Seongwonp/Simplelay/housing/README.md

# 키오스크 하우징 (2안 · 쐐기형 박스)

**10/23 실물 피드백:** 맞춤 시험편의 모니터 크기·두께는 맞지만 커넥터 간섭과 방향별 핀 끼움 차이가 있다. [수정·다음 출력 정리](PRINT-FEEDBACK-2026-10-23.md)를 먼저 읽는다. 새 [핀 공차 시험편 STL](stl/dowel_calibration.stl)은 기존 Ø3.8 핀으로 Ø4.0~4.4 수직·수평 구멍을 비교한다. 뒤쪽 고정은 별도 [패널 고리](stl/panel_clip.stl) 1개를 먼저 시험한다. 커넥터 간섭 위치 확인 전에는 대형 몸통 재출력을 보류한다.

15.8형 터치 패널, RPi5, DHT22 온습도 센서를 상자 하나에 넣는 3D 프린터 분할 출력용 모델이다. 구조와 근거는 2026-10-16 하우징 구조안(1안·2안 비교)을 따르고, 2026-10-18 [하우징 검토](../docs/archive/하우징-검토-2026-10-18.md)의 우선순위 1~11 중 실측 없이 할 수 있는 것을 반영했다.

- **모델:** [`simplelay_box.scad`](simplelay_box.scad). 무료 프로그램 OpenSCAD로 연다. 숫자를 바꾸면 전체가 다시 계산된다.
- **크기(1차안):** 폭 약 396 × 깊이 170 × 높이 약 260 mm. 앞면은 20° 뒤로 기울었다(10/18: 오른쪽 여유 `side_room` 8 → 16 mm라 폭이 8 mm 늘었다).
- **프린터 가정:** 220 × 220 × 250 mm. 모든 조각이 그 안에 들어간다. 가장 큰 조각은 198 × 170 × 130 mm다(렌더할 때 조각별 크기가 echo로 나온다). 메이커스페이스 프린터 기준으로는 **몸통·뒤판 8조각은 Bambu Lab A1(256³)에서만**, 작은 조각은 A1 mini(180³)에서도 뽑을 수 있다(아래 [어느 프린터로](#어느-프린터로)).
- **분할면 맞춤 핀(10/18):** 몸통 4조각과 뒤판 사이 분할면에 Ø4 구멍 + 출력 핀 Ø3.8 × 20. HW 담당이 같은 프린터로 레일 조각을 이을 때 쓴 방법이다 — [맞춤 핀](#분할면-맞춤-핀다월).

## 조각 (파일 위쪽 `part` 값을 바꿔 하나씩 렌더 F6 → STL 내보내기)

| `part` | 개수 | 내용 |
|---|---|---|
| `shell_LB`·`shell_RB`·`shell_LT`·`shell_RT` | 각 1 | 몸통 4조각(왼쪽·오른쪽 × 아래·위). 화면 창, 위판 배기 슬롯, 센서 칸, 버튼 구멍, 받침 턱·멈춤 턱·고리 받침, 뒤판 나사 받침, 이음 덧살, 분할면 맞춤 핀 구멍(덩어리)이 들어 있다. **위 조각(LT·RT)은 위판이 판에 닿게 뒤집힌 방향으로 나온다**(서포트 줄이기) |
| `back_LB`·`back_RB`·`back_LT`·`back_RT` | 각 1 | 뒤판 4조각. 몸통 뒤 테두리 안쪽에 끼운다. 아래 흡기 슬롯, 전원 입구, RPi5 고정 구멍(M2.5 — 모두 RT 조각)이 있다. **바깥면을 판에 대고 눕혀 나온다**(10/18 — LB·RB·LT 안쪽의 맞춤 핀 덩어리가 위로 선다, 높이 12.5) |
| `sensor_lid` | 1 | 센서 칸 뚜껑(뒤 가장자리 선 홈 6 × 3) |
| `panel_clip` | 4 | 패널 누름 L자 고리 — 경사면 안쪽 고리 받침(인서트)에 M3로 조인다 |
| `fit_test` | 1 | **먼저 뽑는 맞춤 시험 조각**(67 × 69 × 99, 약 1시간) — 앞판 왼쪽 아래 모서리(화면 창 모서리·받침 턱·멈춤 턱·센서 칸·플러그 여유). 실제 패널을 대 보고 확인한 뒤 큰 조각을 뽑는다 |
| `dowel_pin` | 16(+예비 4) | 분할면 맞춤 핀 Ø3.8 × 20, 양 끝 0.4 모따기. 몸통 12 + 뒤판 4 |
| `vesa_plate` | (선택) | VESA 75 × 75 누름판. `panel_hold = "vesa"`일 때만. 패널 뒤 구멍 위치·나사·상자에 잇는 방법이 실측 전이라 기본은 고리 |
| `splice` | (선택) | 옛 평판 보강판(접착). `seam = "splice"`일 때만 쓴다 |
| `assembly`·`cutaway` | — | 전체 조립 모습·안쪽 단면 확인용(출력하지 않음) |

## 준비물

| 무엇 | 개수 | 어디 |
|---|---|---|
| M3 열 인서트 | 16 | 뒤판 나사 받침 12 + 고리 받침 4 |
| M3 × 8 나사 | 16 | 뒤판 12 + 고리 4 |
| M3 × 12 볼트 + 너트 | 10 | 이음 덧살(바닥 3 · 앞 턱 1 · 위판 2 · 옆벽 2 × 2) |
| 고무발 Ø 12 | 4 | 바닥 네 모서리 홈(Ø 12 × 1) |
| 맞춤 핀 `dowel_pin`(출력) | 16 + 예비 4 | 몸통 분할면 12 + 뒤판 4 |
| 순간접착제(CA) | 조금 | 맞춤 핀을 한쪽 구멍에 고정, 경사면 띠 접착 |
| Ø4 드릴 날 | 1 | 핀이 빡빡하면 구멍을 손으로 다듬는다(가로로 누운 구멍은 위쪽이 조금 처진다) |
| 폼 테이프 0.5~1 mm | 조금 | 창 뒤(유리 가장자리), 고리와 패널 뒤 사이 |

## 조립 순서

1. 몸통 아래 두 조각(LB·RB)의 분할면 구멍에 맞춤 핀 3개를 꽂는다 — 핀을 LB 쪽 구멍에만 순간접착제로 붙이고 RB는 그냥 끼운다. 맞대고 덧살끼리 M3 볼트 + 너트로 조인다(바닥 3·앞 턱 1). 위 두 조각(LT·RT)도 같은 방법(핀 3, 위판 볼트 2). 그다음 아래 반쪽 위판 쪽 옆벽 구멍에 핀 6개(양쪽 3개씩)를 세워 꽂고 위 반쪽을 위에서 내려 끼운 뒤 옆벽 덧살 볼트(양쪽 2개씩)로 조인다. 경사면 띠(창 위·아래·좌·우)는 패널이 바로 붙어 덧살 자리가 없으니 접착한다 — 핀이 먼저 위치를 잡아 주므로 접착 전에 볼트까지 조여 맞춘 상태에서 붙인다.
2. 뒤판 나사 받침 12곳과 고리 받침 4곳에 M3 열 인서트를 넣는다(납땜인두로 눌러 넣는다).
3. 패널을 넣는다: **아래 모서리를 받침 턱(좌우 멈춤 턱 사이)에 먼저 걸고, 위쪽을 앞으로 세워** 경사면 안쪽에 붙인다. 뒤에서 곧장 밀어 넣지 않는다. 창 뒤에 얇은 폼을 두고, `panel_clip` 4개를 고리 받침에 M3로 조인다 — 빠지지 않을 만큼만(세게 누르면 가장자리 헛터치 우려).
4. 패널 왼쪽 옆면에 **세 가닥**을 꽂는다: 영상(HDMI — 패널 쪽 단자가 mini HDMI일 수 있음, 실측)·터치(RPi5 USB-A ↔ 패널 USB-C 데이터)·전원(PD 어댑터 → 패널 USB-C 전원). HDMI만 꽂으면 터치가 안 된다. 오른쪽 옆면 OSD 버튼은 여유가 16 mm라 손가락이 닿지 않는다 — 전원 연결 시 저절로 켜지는지 먼저 보고, 안 켜지면 누름 막대를 구멍에 넣는다.
5. DHT22를 앞 아래 센서 칸에 눕혀 넣고(격자 면이 앞 슬롯 쪽), 3선을 `sensor_lid` 뒤 선 홈으로 뺀다. 뚜껑은 앞쪽을 받침 턱 밑으로 밀어 넣은 뒤 뒤쪽을 내려 칸 안쪽 받침 턱에 얹는다. 칸은 옆·뒤 칸막이와 뚜껑으로 본체 안 공기와 나뉘고 앞 턱·바닥 슬롯으로 바깥 공기를 받는다(선 홈으로 본체 안과 조금 통한다). 패널을 넣기 전에 해도 된다(손이 더 잘 들어간다).
6. RPi5를 뒤판 RT 조각에 고정하고(M2.5, 스탠드오프 필요, 쿨러는 안쪽) 선을 연결한다. 뒤판 LB·RB·LT는 맞춤 핀 4개(LB–RB 2 · LB–LT 2)로 먼저 ㄱ자로 이어(핀은 LB 쪽에 접착) 한 덩어리로 뒤 테두리에 끼운다. 그다음 RT를 끼우고 뒤판 4조각을 M3 나사로 닫는다(조각마다 3개). RT 조각이 정비 문이라 RT와 맞닿는 이음에는 핀이 없다.
7. 바닥 네 모서리 홈에 고무발을 붙인다(바닥 슬롯으로 센서 칸에 공기가 들도록 바닥이 떠 있어야 한다).

## 분할면 맞춤 핀(다월)

**방법(출처):** HW 담당이 같은 메이커스페이스 프린터(Bambu Lab A1 / A1 mini)로 레일 조각을 이을 때 써서 맞은 방법을 그대로 쓴다 — 구멍 Ø4.0, 한쪽 깊이 10~11 mm, 출력 핀 Ø3.8 × 20 mm(지름 간격 0.2). 이 상자에서는 한쪽 깊이 `dowel_depth` = 10.5(양쪽 합 21 = 핀 20 + 1 mm 여유)로 했다. 핀은 **위치 맞춤만** 한다 — 조이는 힘은 덧살 볼트, 경사면 띠는 접착이 받는다.

**자리:** 벽(3 mm)은 Ø4 구멍에 너무 얇고, 이음 덧살은 분할면 한쪽 4 mm라 깊이 10.5가 안 나온다. 그래서 분할면을 걸치는 덩어리(단면 9 × 9, 분할면에 수직 길이 24)를 벽 안쪽에 덧붙이고 거기에 구멍을 냈다. 구멍은 분할면에 수직이고 양쪽 조각에 반씩(조각마다 Ø4 막힌 구멍, 깊이 10.5)이다. 구멍 둘레 살은 최소 1.2 mm(위판 덩어리 아래쪽), 나머지는 2.5 mm다.

| 이음 | 핀 | 자리 | 구멍 ~ 바깥면 |
|---|---|---|---|
| 세로 분할 아래(LB–RB) | 3 | 앞 턱 안쪽 z 24(창 아래 띠 바로 밑) · 바닥 y 55·115(덧살 볼트 25·85·145 사이) | 6 |
| 세로 분할 위(LT–RT) | 3 | 경사면 위 끝(창 위 띠 ~ 위판 모서리) · 위판 y 133·162(볼트 114·152 사이·뒤 테두리) | 경사면 6 · 위판 4.7 |
| 가로 분할 왼쪽(LB–LT) | 3 | 옆벽 안쪽 y 95·128·162(볼트 78·152 피함, 뒤판 받침 z 110·150 사이), 위아래 45° 모따기 | 6 |
| 가로 분할 오른쪽(RB–RT) | 3 | 왼쪽과 같은 자리 | 6 |
| 뒤판 LB–RB | 2 | 뒤판 안쪽 z 82·112(흡기 슬롯 z 20~70 위) | 6 |
| 뒤판 LB–LT | 2 | 뒤판 안쪽 x 60·140 | 6 |
| **합계** | **16** | 예비 4개를 더해 20개 출력 | |

**넣지 않은 곳과 까닭**

- **경사면 띠의 가로 분할(창 왼쪽·오른쪽):** 왼쪽 띠 안쪽은 플러그 여유(`plug_room`), 오른쪽 띠 안쪽은 OSD 버튼 구멍에서 패널 옆면까지 누름 막대가 지나는 길이다. 덩어리를 둘 수 없어 기존대로 접착한다. 그 대신 바로 뒤 옆벽 y 95에 핀이 있다.
- **창 왼쪽·오른쪽 모서리 근처:** 위와 같은 까닭으로 창 네 모서리에 바로 붙여 두지는 못했다. 창에 가장 가까운 핀은 세로 분할의 창 아래(앞 턱)·창 위(경사면 위 끝) 두 개다.
- **뒤판 RT와 맞닿는 이음(LT–RT · RB–RT):** 핀이 판과 나란히 누워 RT(정비 문)를 뒤로 뺄 수 없게 된다. RT는 뒤 테두리와 나사 3개로만 맞춘다.
- **위판 쪽 구멍 ~ 바깥면 4.7 mm(목표 6 미달):** 패널을 뒤에서 곧장 밀어 넣는 길(아래 [패널 넣는 길 다시 확인하기](#패널-넣는-길-다시-확인하기))에서 패널 위 앞 모서리가 z 249.8로 뒤까지 지나가므로 위판 덩어리를 그보다 0.5 위에 두었다. 위판 3 mm + 살 1.7 mm라 겉으로 드러나지는 않는다.

**출력:** 핀은 세워서(둥글게) 뽑는다. 몸통 세로 분할 구멍과 뒤판 구멍은 출력할 때 가로로 눕는 구멍이라 위쪽이 0.1~0.2 mm 처질 수 있다 — 핀이 안 들어가면 Ø4 드릴 날로 손으로 다듬는다. 큰 조각을 뽑기 전에 핀 몇 개와 구멍을 먼저 대 본다.

## 어느 프린터로

| 조각 | 출력 방향 크기(mm) | 220×220×250 | A1 (256³) | A1 mini (180³) |
|---|---|---|---|---|
| `shell_LB`·`shell_RB` | 198 × 170 × 130.1 | 안 | 안 | **초과** |
| `shell_LT`·`shell_RT` | 198 × 133.6 × 130.1 | 안 | 안 | **초과** |
| `back_LB`·`back_RB`·`back_LT` | 194.7 × 126.8 × 12.5 | 안 | 안 | **초과** |
| `back_RT` | 194.7 × 126.8 × 3 | 안 | 안 | **초과** |
| `fit_test` | 67 × 69 × 99 | 안 | 안 | 안 |
| `sensor_lid`·`panel_clip`·`splice`·`dowel_pin` | 59.4 × 54.4 × 2 이하 | 안 | 안 | 안 |

몸통·뒤판 8조각은 폭이 198·194.7이라 A1 mini에 안 들어간다(대각으로 눕혀도 안 됨). **큰 조각은 A1, 맞춤 시험 조각·뚜껑·고리·핀은 A1 mini**로 나눠 뽑으면 된다.

## 실측 뒤 고칠 숫자

| 값 | 지금 | 무엇을 재나 |
|---|---|---|
| `screen_up` | 10(추측) | 패널 아래 끝 → 표시 영역 아래 끝. 틀리면 키오스크 맨 아래 줄이 가려진다. 좌우 테두리도 재서 표시 영역이 가운데인지 본다 |
| `plug_room` | 20(추측) | 패널 왼쪽 옆면 세 플러그(영상·터치·전원)의 ㄱ자 몸체 길이 + 5. 포트 위치(옆면 아래에서 몇 mm)도 잰다 |
| `stop_zs`·`clip_zs` | 아래·위 끝 / 35·190 | 왼쪽 멈춤 턱·고리 받침이 포트·플러그를 피하는지(포트 위치 실측 뒤 옮긴다) |
| OSD 버튼 구멍 | 패널 높이 25% 지점, 60 mm | 패널 오른쪽 옆면 OSD 버튼의 위치와 길이, 저절로 켜지는지 |
| 스피커 그릴 | 없음 | 패널 스피커 구멍 위치(음성 안내가 패널 스피커로 나온다면 그 앞에 그릴) |
| `vesa_hole_d`·VESA 위치 | 4.5(M4 가정)·패널 가운데 가정 | VESA 구멍이 커버 없이 쓰이는지, 나사 규격 |
| `clip_step`·`clip_foam` | 0 · 1 | 고리 자리의 패널 뒤 두께(4.7 / 9.6) |
| `insert_d` | 4.0 | 산 열 인서트 데이터시트의 권장 구멍 지름·깊이 |
| `foot_d` | 12 | 산 고무발 지름 |
| `tilt` | 20 | 책상에서 터치하기 편한 기울기(실물로 결정) |
| `rpi_center` | 뒤판의 62% 지점 | 선 길이, 쿨러·스탠드오프 높이, 쿨러 바람 방향 |
| 센서 칸 | 60 × 55, 뚜껑 아래 높이 24 | DHT22 몸체(눕혀서)와 선. 상자 닫고 30분·60분 기준 온도계와 차이 |

## 렌더 확인(2026-10-18, OpenSCAD 2021.01)

- **조각 STL 13개를 다시 뽑았다**([`stl/`](stl/): 몸통 4 · 뒤판 4 · `sensor_lid` · `panel_clip` · `fit_test` · `splice` · `dowel_pin`). 맞춤 핀을 넣으며 같은 날 앞 STL을 덮어썼다.
  - 모든 조각이 한 덩어리다(CGAL `Volumes: 2`, `dowel_pin`은 CSG가 없어 따로 차 연산을 걸어 확인), 경고·오류 없음.
  - 모두 220 × 220 × 250 안이다: 몸통 198 × 170(위 조각 133.6) × 130.1, 뒤판 194.7 × 126.8 × 12.5(RT는 3), 뚜껑 59.4 × 54.4 × 2, 고리 19.3 × 10 × 3, `fit_test` 67 × 69 × 99, 핀 3.8 × 3.8 × 20. A1·A1 mini 구분은 위 [어느 프린터로](#어느-프린터로).
  - echo 확인: 뒤판 나사 LB/RB/LT/RT = 3/3/3/3, 받침 가장자리 ~ 분할선 최소 15 mm, 가운데·위 줄 받침 ~ 패널 옆 최소 4 mm(패널 폭 밖), RPi5 구멍 4개 RT 조각, 배기 28개 7,560 mm²(흡기 3,500 mm²), 센서 칸 앞 504 + 바닥 1,204 mm²(이전 앞 336). 맞춤 핀 세로 아래 3 · 위 3 · 가로 왼쪽 3 · 오른쪽 3 · 뒤판 4 = 16.
  - 맞춤 핀 구멍 둘레 살: 구멍마다 Ø(4 + 2 × 1.15) 둘레 원통 − 몸통(뒤판) = 비어 있음(구멍 둘레·바닥 1.15 mm 넘게 모두 살). 덩어리가 뒤판 받침·고리 받침 인서트 구멍, 덧살 볼트·너트 자리(Ø7), 배기 슬롯을 메우는지도 확인 — 비어 있음. 최종 자리 패널을 경사면 따라 1 mm 길게 해도 덩어리와 겹치지 않는다.
- **패널 넣는 길 간섭(검토 §3-3): 비어 있음.** 세워 넣기(받침 턱 모서리를 축으로 2°~60°)와 곧장 밀어 넣기(뒤로 0~120 mm) 둘 다 뒤판 받침·이음 덧살·고리 받침·맞춤 핀 덩어리와 겹치지 않는다. 최종 자리의 패널은 받침 턱 윗면과 면으로만 닿는다(겹침 부피 없음).
- 렌더 사진(10/18 맞춤 핀 반영): [정면](renders/front.png) · [단면(왼쪽 일부를 잘라 안쪽을 본 모습)](renders/cutaway.png) · [맞춤 시험 조각](renders/fit_test.png)
- 숫자를 고쳤으면 STL을 다시 뽑는다(`housing` 폴더에서).
  ```
  openscad -o stl/shell_LB.stl -D 'part="shell_LB"' simplelay_box.scad
  ```

### 패널 넣는 길 다시 확인하기

`housing` 폴더에 아래 내용으로 확인 파일을 임시로 만들어(저장소에 넣지 않는다) `openscad -o out.stl -D 'part="none"' 확인파일.scad`. "Current top level object is empty"가 나오면 간섭 없음.

```
include <simplelay_box.scad>
module pl() translate([panel_x0, wall, panel_up]) cube([panel_w, panel_t, panel_h]);
module rot(a) face_frame() translate([0, wall, panel_up]) rotate([-a, 0, 0]) translate([0, -wall, -panel_up]) pl();
intersection() {
    insert_obstacles();   // 뒤판 받침 · 이음 덧살 · 고리 받침 · 맞춤 핀 덩어리
    union() {
        for (a = [2 : 2 : 60]) rot(a);                                  // 아래 모서리를 받침 턱에 걸고 세우기
        for (d = [0 : 4 : 120]) translate([0, d, 0]) face_frame() pl(); // 뒤에서 곧장 밀어 넣기
    }
}
```

플러그 몸체는 이 확인에 들어 있지 않다. 플러그를 꽂은 채 세워 넣으려면 실측한 플러그 크기를 `pl()`에 더해 다시 돌린다(왼쪽 고리 받침·옆벽 덧살과 겹칠 수 있다).

**검증 수준:** OpenSCAD 렌더(형상, 한 덩어리, 조각 크기, 패널 넣는 길 간섭, 맞춤 핀 구멍 둘레 살)까지 확인했다. 맞춤 핀 치수는 HW 담당의 레일 출력에서 맞은 값이지만 이 상자 조각에서 핀이 맞는지는 아직 뽑아 보지 않았다. 슬라이서 오버행·서포트(앞 턱 핀 덩어리 아랫면 9.5 mm 오버행 포함), 3D 출력, 패널·RPi5·플러그 맞춤, 실물 조립, 열(RPi5 온도·센서 오차)은 아직 확인하지 않았다.
