Seongwonp/Simplelay/docs/실측-기록표.md

# 실측 기록표 (원가 · 설치 시간 · 대안 비교 · 성공률 · 정지 지연 · CT 조리 판정)

작성 2026-09-14. **빈 표와 측정 방법만 둔다.** 실측하지 않은 숫자는 채우지 않는다 —
발표·질의응답에 쓰는 숫자는 이 표에 기록된 측정에서만 가져온다.

측정 순서와 원시 데이터 수집 도구는 [하드웨어 연결 설계](하드웨어-연결-설계.md) §6을 따른다.

## 공통 규칙

- 칸마다 **측정일·측정자·조건**이 추적돼야 한다. 조건이 바뀌면 새 행으로 쓴다.
- 원시 데이터(CSV·영상)는 저장소에 올리지 않는다. 이 문서에는 **요약 수치와 원시 파일 이름**만 적는다.
  - 센서 원시값: `python -m rpi.bench.raw_recorder` → `data/bench/` (git 무시 경로)
  - 실행 이력: 서버의 실행 이력 CSV 내보내기(작업 ID·결과·버튼별 시도 수·정지 지연)
- 추정·조사값은 실측과 섞지 않는다. 쓸 때는 비고에 `추정` 또는 `조사(출처)`를 붙인다.
- 빈칸은 "아직 모름"이다. 0이나 "-"로 메우지 않는다.

---

## 1. 원가 (BOM)

> **2026-10-14: 현행 구성(ESP32 두 개·솔레노이드·콘센트 모듈) 기준의 BOM 표는 [제출 전 검증 과업](archive/제출전-검증-과업.md) §3-1에 적는다.**
> 아래 표는 9/14 구성(ESP32 브릿지·가전 노드 등) 기준의 당시 기록이라 채우지 않는다.

**측정 방법:** 실제 구매 영수증·주문 내역 기준 단가. 지급품·기존 보유품은 구분해 적고,
시연 1대 원가와 반복 제작 가정 원가를 따로 합산한다.

| 구분 | 품목 | 수량 | 단가(원) | 소계(원) | 조달 | 근거(영수증·주문) | 비고 |
|---|---|---|---|---|---|---|---|
| 연산 | RPi5 |  |  |  |  |  |  |
| 연산 | RPi4 |  |  |  |  |  |  |
| 통신 | ESP32 (브릿지) |  |  |  |  |  |  |
| 통신 | ESP32 (가전 노드) |  |  |  |  |  |  |
| 구동 | X/Y 모터 |  |  |  |  |  |  |
| 구동 | 모터 드라이버 |  |  |  |  |  |  |
| 구동 | 모터 제어 MCU |  |  |  |  |  |  |
| 구동 | Z축 누름 장치 |  |  |  |  |  |  |
| 구동 | 프레임·벨트·풀리 |  |  |  |  |  |  |
| 안전 | 홈·리밋 스위치 |  |  |  |  |  |  |
| 안전 | 비상정지 버튼·차단 회로 |  |  |  |  |  |  |
| 센서 | 전류 센서 + ADC |  |  |  |  |  |  |
| 센서 | 마이크 |  |  |  |  |  |  |
| 화면 | 15인치 터치 패널 |  |  |  |  |  |  |
| 화면 | 15인치 패널 전원(어댑터·케이블) |  |  |  |  |  | 별도 전원 필요 여부 확인 필요 |
| 전원 | 어댑터·강압·퓨즈 |  |  |  |  |  |  |
| 기타 | 하우징·배선 |  |  |  |  |  |  |

| 합계 | 금액(원) | 포함 범위 |
|---|---|---|
| 시연 1대 (지급품 포함) |  |  |
| 시연 1대 (지급품 제외) |  |  |
| 가전 1대 추가 시 증분 |  |  |

---

## 2. 설치 시간

**측정 방법:** 가전이 놓인 상태에서 스톱워치로 단계별 시간을 잰다. 팀원 설치와
**처음 해 보는 사람**의 설치를 따로 기록한다. 막힌 지점은 비고에 적는다.
단계 경계는 아래 정의를 따른다.

| 단계 | 시작 | 끝 |
|---|---|---|
| ① 부착 | 장치를 가전 앞에 놓기 시작 | 고정 완료 |
| ② 원점·홈 | 전원 인가 | 홈 완료 표시 |
| ③ 버튼 좌표 보정 | 보정 시작 | 보정 프로필 저장 |
| ④ 준비 확인 | 준비 판정 조회 | 조작 가능 표시 |
| ⑤ 첫 실행 | 첫 명령 | 첫 누름 확인(사람 판정) |

| 측정일 | 설치자(팀원/처음) | 가전 | ① | ② | ③ | ④ | ⑤ | 합계 | 비고 |
|---|---|---|---|---|---|---|---|---|---|
|  |  |  |  |  |  |  |  |  |  |

---

## 3. 대안 비교

**측정·조사 방법:** 같은 가전(구형 버튼식 전자레인지 기준)에 적용한다고 가정하고
항목별로 확인한다. 직접 해 본 것은 `실측`, 제품 사양·문서로 확인한 것은 `조사(출처)`로
구분한다. 확인 전 칸은 비워 둔다.

> 2026-10-14: 상용 제품 행은 **공개 사양(제품 페이지·설명서)에 적힌 기능만** `조사(출처, 확인 날짜)`로 채운다. 사양에 없다고 "기능 없음"으로 단정하지 않고 "확인하지 못함"으로 적는다.
> 우리 장치에서 동작 확인 기능을 끈 비교 조건 실험은 상용 제품 시험이 아니므로 이 표가 아니라 [제출 전 검증 과업](archive/제출전-검증-과업.md) §1에 적는다.
>
> **출처(2026-10-14 확인, 상용 제품 행은 모두 `조사`):**
> - S1 SwitchBot Bot 공식 제품 페이지 — <https://www.switch-bot.com/products/switchbot-bot>. 부착 방식(3M 스티커·공구 없음), 대상 스위치, 크기 43×37×24 mm·42 g, 배터리 최대 600일(일반 사용), 앱(블루투스 범위)·허브 경유 원격·음성 비서·앱 타이머, 가격 표시.
> - S2 SwitchBot 공식 API 문서(OpenWonderLabs/SwitchBotAPI) Bot — <https://github.com/OpenWonderLabs/SwitchBotAPI/blob/main/devices/others/bot.md>. 명령 `turnOn`·`turnOff`·`press`, 상태 `power`("ON/OFF state", 웹훅 설명에 스위치 모드에서만 유효), `deviceMode`(누름·스위치·사용자 정의).
> - S3 Adaprox Fingerbot Plus 공식 제품 페이지 — <https://www.adaprox.io/products/fingerbot-plus>. 호환 스위치, 누름 힘 10 N, 크기·무게, 블루투스/ZigBee(허브 필요), 앱·음성·터치·타이머.
> - SwitchBot 지원 문서(사용 설명서·누름 시간·모드 설명)는 이번 조회에서 열리지 않아(403) **확인하지 못함** — 누름 시간 설정 등은 표에 넣지 않았다. 설치 시간은 두 제품 모두 사양에서 찾지 못했다.

| 방식 | 구형 버튼 가전 적용 | 가전 개조 필요 | 여러 버튼 순서 조작 | 누름 확인(폐루프) | 설치 시간 | 원가 | 근거 |
|---|---|---|---|---|---|---|---|
| SimpleLay |  |  |  |  |  |  |  |
| IR 리모컨 학습기 |  |  |  |  |  |  |  |
| 스마트 플러그(전원 on/off) |  |  |  |  |  |  |  |
| 기성 단일 버튼 누름 장치 — SwitchBot Bot | 조사(S1): "대부분의 로커 스위치와 단방향 버튼"에 쓴다고 적힘. 우리 전자레인지 버튼에 맞는지는 확인하지 못함 | 조사(S1): 개조 없이 3M 스티커로 버튼 옆에 부착, 공구 없음 | 조사(S1·S2): 장치 하나가 버튼 하나를 누르는 구조. 한 장치로 여러 버튼 순서 조작은 확인하지 못함 | 조사(S2): 상태 `power`(ON/OFF)는 스위치 모드에서만 유효. 누름·가전 동작 확인 기능은 확인하지 못함 | 확인하지 못함 | 조사(S1): 1개 US$29.99(미국 공식 판매가 표시, 국내가 아님, 허브 별도) | S1·S2 |
| 기성 단일 버튼 누름 장치 — Adaprox Fingerbot Plus | 조사(S3): 로커·누름 버튼·토글 스위치 호환이라고 적힘 | 조사(S3): 부착형(42×34.5×34.5 mm, 36 g), 개조 언급 없음 | 확인하지 못함(장치 하나가 붙인 버튼을 누르는 구조) | 확인하지 못함(사양에 누름·상태 확인 언급 없음) | 확인하지 못함 | 확인하지 못함 | S3 |
| 스마트 가전으로 교체 |  |  |  |  |  |  |  |

---

## 4. 성공률

**측정 방법**

- 대상: 전자레인지 버튼 3개부터. 버튼마다 목표 반복 수를 정하고 시작 전에 적는다.
- **사람 판정이 기준이다.** 가전 표시창 변화·버튼음을 영상으로 남기고, 누름이 실제로
  들어갔는지 사람이 판정한다. 센서 판정은 사람 판정과 비교하는 대상이다.
- 실패 주입(리허설 기능)을 쓴 시도는 따로 표시하고 자연 성공률 합산에서 뺀다.
- mock 모션 실행은 기록하지 않는다(실행 이력의 실행 모드로 확인).

**시도 기록** (한 행 = 한 버튼 누름)

| 측정일 | 가전 | 버튼 | 시도 번호 | 실패 주입 | 첫 시도 누름(사람) | 최종 누름(사람) | 재시도 수 | 센서 판정 | 소요 시간(초) | 작업 ID | 원시 파일 | 비고 |
|---|---|---|---|---|---|---|---|---|---|---|---|---|
|  |  |  |  |  |  |  |  |  |  |  |  |  |

**요약** (정의를 바꾸지 않는다)

| 지표 | 정의 | 값 | 표본 수 |
|---|---|---|---|
| 첫 시도 성공률 | 재시도 없이 사람 판정 누름 / 전체 시도 |  |  |
| 최종 성공률 | 재시도 포함 사람 판정 누름 / 전체 시도 |  |  |
| 센서 판정 일치율 | 센서 판정 = 사람 판정 / 전체 시도 |  |  |
| 센서 오탐 | 센서 누름 · 사람 안 눌림 |  |  |
| 센서 미탐 | 센서 안 눌림 · 사람 누름 |  |  |
| 버튼당 시간 p50 / p95 | 명령 시작 ~ 버튼 확인 |  |  |

---

## 4-1. 판정·상태 기준값 (2026-09-15 추가 기능, 전부 추측)

**측정 방법:** 아래 값은 코드 기본값일 뿐 실측이 아니다. 하드웨어 연결 후 원시 데이터를
보고 정한다. 정하기 전까지 발표·문서에서 사실로 쓰지 않는다.

| 항목 | 현재 기본값(추측) | 정하는 방법 | 실측값 |
|---|---|---|---|
| L3 전력 상승 판정 — 최소 상승(W)·배율·유지 시간 | `rpi/verifier/power.py` PowerConfig | 가전 3종을 켜고 끄며 기준선과 상승 구간 기록 |  |
| L3 기준선 창(초) | 2.0 | 대기 전력이 안정되는 시간 관찰 |  |
| 좌표 보정 허용 오차 — RMS·한 점 | 1.0 mm · 2.0 mm | 기준점 촬영·검출 반복 오차 분포 |  |
| 공간 상태 거리 히스테리시스·체류 시간 | `rpi/services/presence_state.py` 기본값 | 레이더 부착 후 접근·이탈 반복 측정 |  |
| 노드 전원 상태 미감지 강등 시간 | 같은 파일 | 실사용 중 오작동 빈도로 조정 |  |

## 5. 정지 지연

정지는 세 시각으로 나눠 잰다. 명칭과 보장 범위는 [하드웨어 연결 설계](하드웨어-연결-설계.md) §5.

| 시각 | 뜻 | 측정 방법 |
|---|---|---|
| **t0 누름** | 사람이 정지 버튼을 누른 순간 | 영상 프레임(화면·버튼과 장치를 한 화면에) |
| **① 요청 접수** | 서버가 정지를 접수 | 실행 이력의 `stop_requested_at` |
| **② 루프 종료** | 실행 루프가 끝남 | 실행 이력의 종료 시각. `stop_latency_seconds` = ① → ② |
| **③ 물리 정지** | 모터가 실제로 멈춤 | 엔코더 속도 0 시각, 없으면 고속 촬영 프레임 |

- 영상과 서버 시각을 맞추려면 촬영 시작 때 화면에 서버 시각을 띄우거나 기록기의
  marker를 찍는다. 시각 맞춤 오차를 비고에 적는다.
- 정지 경로(키오스크·폰·물리 버튼)와 정지 시점(이동 중·누름 중·재시도 대기 중)을
  행마다 적는다. 경계에서만 반영되는 현재 구조에서는 시점에 따라 값이 크게 다를 수 있다.

| 측정일 | 경로 | 정지 시점 | t0 → ① (ms) | ① → ② (ms) | ② → ③ (ms) | t0 → ③ (ms) | 노드 미확인 | 작업 ID | 영상·원시 파일 | 비고 |
|---|---|---|---|---|---|---|---|---|---|---|
|  |  |  |  |  |  |  |  |  |  |  |

| 요약 | 경로 | 표본 수 | t0 → ③ p50 (ms) | t0 → ③ 최대 (ms) |
|---|---|---|---|---|
|  |  |  |  |  |

### 5-1. 모션 보드 정지 응답 — 시험대 실측(10/13~14)

**조건:** 벨트·솔레노이드를 달지 않은 시험대(모터 축·엔코더만). 위 표의 t0(사람이 누른 순간)·③(캐리지 물리 정지)는
아직 재지 않았다 — 아래는 **소프트웨어가 정지를 보낸 뒤** 모션 보드가 답한 시간과 엔코더로 멈춤을 확인한 시간이다.
원기록: [10/13 보드 날](devlog/devlog_2026-10-13-desktop-board.md) §2, [10/14 마감](devlog/devlog_2026-10-14-desktop-close.md).

| 구간 | 경로·조건 | 표본 | 값 |
|---|---|---|---|
| A. 보냄 → 모션 보드 응답(`mcu_ack`) | 개발자 경로, 5 mm 조그 시작 약 88 ms 뒤 정지 | n=10 | 중앙 **10.95 ms** |
| B. 보냄 → 멈춤 확인(`verified`, 엔코더 두 번) | 같은 조건 | n=10 | 중앙 **160 ms** |
| A | 폰 실행 상태 화면 정지(일반 실행 중) | 1 | 16.7 ms(화면 "모션 보드 응답 18 ms") |
| A | 폰 정지 — 이동 중(`move` 34 ms 뒤) | 1 | 10.1 ms, MCU 이동 `error: stopped` |
| A·B | 루틴 실제 경로 이동 중 정지(0.2 s 뒤, 10/14) | 1 | `verified`, 응답 18 ms, 누름 없음 |
| A·B | 누르는 도중 정지(`press_start` 70 ms 뒤, 10/14) | 1 | `verified`, 응답 15 ms |

- 화면의 ms는 기록 간격보다 0~1.3 ms 크다(측정 지점 차이).
- 이 값은 **정지까지 걸린 시간이 아니다.** 캐리지 물리 정지(③)는 벨트 장착 뒤 영상·엔코더로 위 표에 적는다(측정 필요).

## 6. CT 가열 판정 (전자레인지 가열 시작·가열 종료 감지, 2026-10-13 추가 — 종료 감지는 조리 완료가 아닐 수 있음)

[시연 계획 v4](본선-시연-계획-v4.md) 선행 조건 ②. 가열 종료 감지 → 공기청정기 자동 실행의 조건이 이 판정이라,
**가열이 아직 진행 중인데(전력 감소·팬만 도는 구간) 종료로 잡지 않는지**(B·D)가 핵심이다. 버튼 누름 완료는 가열 종료로 치지 않는다.
아직 한 번도 재지 않았다.

> **정책(10/14 사용자 확정, 3차 평가 L1):** 가열 종료가 감지되면 취소·문 열림이어도 제안·자동 실행이 일어날 수 있다 — 공기청정기 풍량 변경은 낮은 위험 동작이라 허용하고, 화면·문서에 '조리 완료가 아닐 수 있음'을 명시한다. 그래서 **C1·C2는 실패 판정이 아니라
> 가열 종료 감지·제안·자동 실행이 일어났는지와 그 지연을 기록**한다. 문구 정책이지 취소 판별이 생긴 것이 아니다.

> **지금 판정의 한계(2026-10-14 코드 확인):** `rpi/verifier/cycle_end.py`는 'CT 전력이 운전(≥ `run_min_w`)을 `min_run_s` 넘게
> 지난 뒤 대기(≤ `standby_max_w`)로 `settle_s` 머묾'만 본다. **취소 버튼이나 문 열림으로 가열이 끝나도 전력 모양이 같아서
> 정상 종료와 구분하지 못한다.** 그래서 화면·카드·기록은 '가열 종료 감지(조리 완료가 아닐 수 있음)'라고만 말한다.
> 아래 C1·C2에서 구분 근거(예: 종료음·남은 시간·문 스위치)를 찾기 전까지 이 표현을 올리지 않는다.

> **전자레인지 판정값(2026-11-02, 실제 1대 100 ms 기록, 220 V 가정 추정치):** 대기 0 W, 시작 순간 약 3,550 W, 가열 중 약 1,000 W,
> 종료 뒤 약 5초 안에 0 W, 문 여닫을 때 약 1초의 튐(최고 약 1,950 W 상당). 이 기록으로 **100 W 이상 5초 유지 = 가동,
> 15 W 이하 3초 유지 = 끝**으로 정했다(`min_run_s` 5·`settle_s` 3·`hold_run`·`max_gap_s` 1, 기록은 2026-11-02 devlog).
> 낮은 출력 가동(마그네트론이 쉬는 구간)과 다른 모델은 아직 재지 않았다.

시각은 영상(조작부·표시창·종료음이 함께 보이게)과 실행 이력·콘센트 모듈 원시 기록을 맞춰 적는다.

| 시각 | 뜻 | 측정 방법 |
|---|---|---|
| **실제 시작** | 마그네트론·조명·팬이 켜진 순간 | 영상 프레임 |
| **시작 판정** | 서버가 가열 시작(L3 `operation_confirmed`)을 낸 시각 | 실행 이력 |
| **실제 종료** | 표시창 0·종료음 | 영상 프레임·마이크 |
| **완료 판정** | 서버가 가열 종료(`heat_complete`)를 낸 시각 | 실행 이력 |

경우(각 3회 이상):

- **A 정상 짧은 가열** — 30초 가열 그대로 끝까지.
- **B 가열 중 전력 감소** — 출력 단계를 낮추거나 출력이 주기적으로 꺼졌다 켜지는 구간. 이 감소를 완료로 잡으면 실패.
- **C1 중간 취소(취소 버튼)** — 가열 중 취소 버튼. 정책상 **실패가 아니다** — 가열 종료 감지가 났는지, 카드·자동 실행이 일어났는지,
  취소 → 감지 → 실행까지의 지연을 기록한다. 지금 판정으로는 **정상 종료와 같게 나올 것으로 예상**(위 한계) — 구분 근거(취소 때와 정상 종료 때의
  전력·종료음 차이)가 보이면 함께 적는다. 화면·기록이 '조리 완료가 아닐 수 있음'을 밝혔는지도 본다.
- **C2 중간 문 열림** — 가열 중 문을 연다(가열이 멈추고 조명은 켜질 수 있다). C1과 같은 기록(실패 아님). 문을 연 채 둘 때와 바로 닫을 때를 나눠 적는다.
- **D 종료 후 팬 동작** — 가열이 끝난 뒤 냉각 팬만 도는 구간. 팬 전력을 가열로 보거나 팬이 멈출 때까지 완료가 끌려가는지 본다.

| 측정일 | 경우 | 회차 | 설정 시간(초) | 출력 단계 | CT 채널 | 대기 전력(W) | 가열 중 전력 범위(W) | 팬만 전력(W) | 실제 시작 | 시작 판정 | 실제 종료 | 완료 판정 | 판정 결과(가열 종료/없음/확인 불가) | 오판(B·D만) / 자동 실행 발생·지연(C1·C2) | 작업 ID | 원시 파일 | 비고 |
|---|---|---|---|---|---|---|---|---|---|---|---|---|---|---|---|---|---|
|  | A |  | 30 |  |  |  |  |  |  |  |  |  |  |  |  |  |  |
|  | B |  |  |  |  |  |  |  |  |  |  |  |  |  |  |  |  |
|  | C1 |  |  |  |  |  |  |  |  |  |  |  |  |  |  |  |  |
|  | C2 |  |  |  |  |  |  |  |  |  |  |  |  |  |  |  |  |
|  | D |  |  |  |  |  |  |  |  |  |  |  |  |  |  |  |  |

| 요약 | 값 | 표본 수 |
|---|---|---|
| 시작 판정 지연(실제 시작 → 시작 판정) p50 / 최대 |  |  |
| 완료 판정 지연(실제 종료 → 완료 판정) p50 / 최대 |  |  |
| B에서 가열 중인데 종료로 오판한 수(실패) |  |  |
| C1(취소 버튼): 가열 종료 감지·카드·자동 실행 발생 수 / 취소 → 실행 지연(기록, 실패 아님) |  |  |
| C2(문 열림): 가열 종료 감지·카드·자동 실행 발생 수 / 문 열림 → 실행 지연(기록, 실패 아님) |  |  |
| C1·C2와 정상 종료를 가를 근거(있으면 무엇, 없으면 '없음') |  |  |
| D에서 완료가 팬 정지까지 늦어진 수 |  |  |

B·D에서 오판이 하나라도 나오면 자동 실행 조건을 다시 설계한다(기준값 `SIMPLELAY_CYCLE_*` 조정만으로 끝내지 않고 조건 자체를 검토).
C1·C2의 발생은 정책상 허용이다 — 기록만 하고, 정책을 바꿀지는 사용자가 기록을 보고 정한다.
