Seongwonp/Simplelay/docs/reuse-boundary.md

# 재사용 경계 (Reuse Boundary)

> 목적: SimpleLay가 어디까지 기존 자산(Touch Bridge)을 재사용하고, 어디부터 본 대회를 위한
> 신규 구현인지를 **처음부터 명확히 기록**한다.
> 이 문서는 임베디드SW경진대회 개발완료보고서의 "기존 자산 vs 신규 구현" 구분 근거가 된다.

---

## 왜 이 문서가 필요한가

임베디드SW경진대회를 포함한 다수 공모전은 **다른 대회에서 이미 진행·수상한 유사 프로젝트의
재사용을 감점 또는 평가 제외** 대상으로 본다. Touch Bridge는 ICT 한이음 드림업 프로젝트이므로,
SimpleLay가 그 하드웨어를 공유한다면 **"무엇이 재사용이고 무엇이 신규인지"를 스스로 투명하게
구분**해 두는 것이 정당성을 지키는 방법이다.

핵심 입장 (2026-10-10 재정정, 팀원 확인):

> **구동 계층은 Touch Bridge와 공유한다.** CoreXY 갠트리(기구부)와 ESP32 모션 펌웨어는 팀원의 Touch Bridge와
> **같은 것**이다. 기구는 같은 CoreXY 갠트리이고(피니언/렉 레일을 버리고 CoreXY로 바꾼 사유·구조는
> [docs/actuator-design.md](actuator-design.md)), 모션 펌웨어 [`firmware-motion-corexy/`](../firmware-motion-corexy/)는
> 팀원의 **Touch Bridge CoreXY 펌웨어 v3**(2026-10-10 수령)을 옮겨 고친 것이다. 제어 핵심(PID·CoreXY 기구학·사다리꼴
> 궤적·스톨 원점 복귀·추종 오차 감시·솔레노이드 구동·단일 동작 큐)은 원작 그대로다
> ([devlog](devlog/devlog_2026-10-10-motion-firmware-merge.md)). 이전 판의 "CoreXY는 따로 설계했다", "기구 설계·펌웨어·코드는
> 공유하지 않는다/독립"이라는 문장은 **틀렸으므로 철회한다.**
>
> **두 프로젝트의 차이는 그 위 계층에 있다.** Touch Bridge는 폰 → ESP32(BLE)로 바로 명령해 누르고 끝난다.
> SimpleLay는 폰·키오스크 → RPi5 → RPi4 → ESP32(USB 시리얼 줄 단위 JSON)로 가며, 다음을 이 저장소에서 새로 만들었다.
> - 승인 결속(명령 지문) — 승인한 그 명령만 실행
> - L1~L3 층별 폐루프 확인과 재시도·안전 정지 정책
> - 사용 습관 기반 선제 제안
> - 키오스크·폰 제품 UI
> - ESP32 콘센트 모듈(CT 전력 확인·비상정지 래치)
> - 호스트 안전 규약(워치독·명령 기한·자동 재전송 금지·재누름 차단) — 펌웨어 쪽 규약 계층(`firmware-motion-corexy/src/host_protocol.*`) 포함
> - RPi4 운동학(`rpi/controller/kinematics.py`, 표준 CoreXY 식)·모션 어댑터(`rpi/controller/serial_motion.py`)·가짜 MCU
>
> 즉 선은 "누가 무엇을 판단하고 확인하느냐"에 긋는다. 누르는 몸(기구·모션 펌웨어)은 공유하고, 무엇을 누를지
> 승인받고 눌렸는지 확인하는 계층이 SimpleLay의 것이다. 참고 펌웨어 `firmware-motion/`(채택하지 않은 SimpleLay 작성
> 대안)은 규약 기준으로 남긴다. 원 프로젝트 전체와 대조하지 않았으므로 재사용 비율은 확정하지 않는다.

---

## 경계 표

| 구성요소 | 재사용 / 신규 | 출처 | 비고 |
| --- | --- | --- | --- |
| **CoreXY 갠트리 (기구부)** | **재사용(공유)** | Touch Bridge (팀원) | Touch Bridge와 같은 CoreXY 갠트리(팀원 확인 2026-10-10). 피니언/렉 레일을 버리고 CoreXY로 바꾼 사유·구조는 actuator-design.md |
| **모션 제어 펌웨어** (`firmware-motion-corexy/`) | **재사용(수정)** | Touch Bridge CoreXY 펌웨어 v3 (팀원 서예솔, 2026-10-10 수령) | 제어 핵심(PID·기구학·궤적·스톨 원점·추종 오차·솔레노이드 구동·단일 동작 큐)은 원작 그대로. BLE·앱 JSON v2·인증·G-code·이름을 빼고, RPi4 USB 시리얼 줄 단위 JSON 규약·호스트 워치독·명령 기한·알람 순서·원점 기준 버리기·솔레노이드 상한/냉각·MCU 태스크 워치독을 더함. 파일 머리말에 원작 표기. 시험대 빌드로 모터 축 구동·정지 실물 확인(10/12–14), 지정 좌표 이동 확인(11/2). 실제 버튼 누름 정확도·복귀는 개선 중 |
| 참고 모션 펌웨어 (`firmware-motion/`) | 신규(미채택) | SimpleLay | 규약 기준으로 먼저 작성한 대안 구현. 시연 펌웨어로 쓰지 않는다. 규약 계층(`protocol.cpp`)은 위 펌웨어로 옮겨 씀 |
| **Z축 버튼 누름** | **SwitchBot Bot (HW 담당 결정, 10/21~)** | Touch Bridge CoreXY 펌웨어 v3 + 팀원 BLE 클라이언트 | 처음에는 솔레노이드(SparkFun ROB-11015)였고 선택 빌드로 남아 있다. 현행 누름은 SwitchBot Bot을 BLE로 구동한다. 실제 버튼 누름 정확도는 개선 중 |
| ESP32 브릿지 (BLE ↔ Wi-Fi) — `firmware/` | **재사용(확장), 현행 경로 아님** | Touch Bridge | (2026-10-14 정정) 옛 설계의 폰↔RPi5 브릿지다. 현행 구성은 폰이 RPi5에 HTTP로 바로 붙고 BLE 브릿지를 쓰지 않는다 — `firmware/`는 예비 경로로만 남았다(README 폴더 표). 원 코드 비율은 확인하지 않았다 |
| Flutter 앱 골격 | **재사용(확장)** | Touch Bridge | SimpleLay 상태/검증 UI는 신규 |
| 의도 해석 외부 연동 | **재사용(확장), 선택 계층** | Touch Bridge (`prompts.py`) | (2026-10-14 정정) 원래 특정 모델 직접 연동이었고, 지금은 특정 벤더에 묶이지 않는 호환 엔드포인트 방식의 **선택 기능**이다. 기본 해석은 규칙 기반이고 v4 시연 흐름은 이 연동에 기대지 않는다. 습관 제안 연계는 신규 |
| **라즈베리파이 검증 모듈 (verifier)** | **★ 신규** | SimpleLay | 전류·전력(CT)·음향 판정 → 실행 검증. CT 가열 작동·종료 판정은 실물 확인(11/2–3, 사람이 시작한 1분 가열 4회 중 4회) |
| **폐루프 컨트롤러 (controller)** | **★ 신규** | SimpleLay | 명령 → 검증 → 실패 시 재시도 |
| **사용 로그·시간대 패턴 감지 (intent)** | **★ 신규** | SimpleLay | 설정형 임계값·시간대, 주입식 시계 |
| **선제 제안·1회 승인 게이트 (intent)** | **★ 신규** | SimpleLay | 승인 전 실행 금지, 승인 후 기존 폐루프 연계 |
| **콘센트 모듈 (`firmware-outlet/`, CT·릴레이·비상정지 래치)** | **★ 신규** | SimpleLay | (2026-10-14 정정 — 옛 줄 "전류·음향 센서 하드웨어 ★신규"를 대신함) 펌웨어·호스트 경로는 이 저장소에서 작성. CT 계측 모듈(ESP32 + DFRobot SEN0211)을 만들어 실제 전자레인지로 확인했다(10/30, 11/2–3). 릴레이·물리 비상정지 버튼과 L1 누름 전류 센서·마이크는 달지 않았다 |
| **RPi4 ↔ 액추에이터 폐루프 연동** | **★ 신규** | SimpleLay | 결과 피드백 기반 확인·안전 정지 (GRBL 아님 — 현재 기준: XY FIT0482 ×2, 모션 MCU는 ESP32 + `firmware-motion-corexy/`(위 재사용 줄), Z는 SwitchBot Bot). RPi4 쪽 어댑터·규약은 이 저장소에서 작성. 10/12–14 모터 축 실물 연결, 11/2 지정 좌표 이동 확인 |
| **자동 실행 허용 규칙·ThinQ 공식 SDK 연동** | **★ 신규** | SimpleLay | 10/13~16 작성. 가열 종료 사건 → 허용한 조건의 공기청정기 풍량 변경(모의 끝-끝), 정해진 시각 → 공기청정기 전원 켜기·끄기(10/16 실제 공기청정기로 22:00 카드 없이 켜기 `state_confirmed`) |
| **가전 등록·버튼맵 에디터 (app)** | **★ 신규** | SimpleLay | 사용자가 앱에서 새 가전을 직접 등록·조작 |

---

## 한 문장 설명 (심사·발표용)

> "SimpleLay의 구동부, 즉 CoreXY 갠트리와 ESP32 모션 펌웨어는 팀원의 Touch Bridge와 같은 것을 씁니다.
> SimpleLay가 새로 만든 것은 그 위 계층입니다. 승인한 명령만 실행하도록 묶고, 누름 장치 전류(L1)부터 대상 CT 전력(L3)까지
> 눌렸는지 확인해 재시도하거나 안전 정지하며, 사용 습관으로 먼저 제안합니다."
>
> 실물 검증 범위는 이 문장에 넣지 않고 [README](../README.md) 실측 결과 표를 따른다 — 11/3 기준 지정 좌표 이동과 CT 가열 종료 판정까지 실물, 실제 버튼 누름 정확도·복귀는 개선 중.

---

## 갱신 규칙

- 새 기능을 구현할 때마다 이 표에 **재사용/신규를 즉시 기록**한다.
- 재사용 자산을 SimpleLay에 맞게 수정한 경우, "재사용(확장)"으로 표기하고 무엇을 바꿨는지 남긴다.
- 개발완료보고서 작성 시 이 표를 그대로 근거 자료로 사용한다.
- 2026-10-10: 모션 제어 펌웨어를 팀원의 Touch Bridge CoreXY 펌웨어 v3에서 가져와 `firmware-motion-corexy/`로 옮기면서
  "기구·모션 구현은 독립" 주장을 철회했다. 같은 날 팀원 확인으로 CoreXY 갠트리도 Touch Bridge와 공유임을 확정해
  경계 표의 갠트리 줄을 재사용(공유)으로 고쳤다. 원작 코드의 라이선스·공개 범위는 팀원과 확인한다(제출 체크리스트 G6).
