Seongwonp/Simplelay/docs/하드웨어-복귀-날-절차.md

# 하드웨어 복귀 날 절차 — ESP32 모션 보드가 돌아오는 날 (2026-10-19 작성)

> **적용 범위:** 아래는 10/19 당시 배포·시험 절차다. 현재는 HW 담당 원본과 `touchbridge-v2` 어댑터를 먼저 대조하고 [10/28 복귀·연결 수리 계획](결선전-복귀결함과-첫연결-수리계획-2026-10-28.md)을 따른다. 아래 §1 펌웨어 업로드·§2 환경 되돌리기를 그대로 실행하지 않는다. HW 코드 수정·업로드는 HW 담당 범위이며, 현재 좌표·매핑·정지 정책을 과거 설정으로 덮어쓰지 않는다. 현장 배포 상태는 이 문서 작성 당시 상태와 다를 수 있다.

HW 담당이 모터·레일을 다시 고정했고, Z축은 스프링 복귀 의존성이 없는 SwitchBot Bot으로 정했다. ESP32 모션 보드가 돌아오면 이 문서를 **위에서 아래로** 따라간다. 솔레노이드 절은 되돌리기용 변형으로 남긴다.
지금 RPi4는 모의 모션이다(`SIMPLELAY_MOTION_MODE=mock`, `SIMPLELAY_MOTION_PORT` 줄 주석, 백업 `env.bak-20261016-no-esp32` — [10/16 devlog](devlog/devlog_2026-10-16-desktop-home.md)).

**규칙**

- 각 단계에서 이상하면 **멈추고 기록한 뒤** 다음으로 넘어가지 않는다. 앞 단계를 건너뛰고 뒤 단계(누름·리허설·촬영)를 하지 않는다.
- 사람 둘: 한 사람은 **전원 차단 담당**(모터와 선택한 Z 전원 차단 수단에 손), 한 사람은 기록 담당. 소프트웨어 정지가 안 먹으면 응답을 기다리지 않고 끊는다.
- 실제 가전 대신 **골판지 더미 패널**에서 시작하고, 전자레인지는 5단계 이후 사람 입회로만.
- 이 문서의 수치 칸 중 **실측하지 않은 값은 모두 `측정 필요`** 다. 설계값(펌웨어 `config.h`, 추측 상수)을 측정값으로 옮겨 적지 않는다.
- 원본 기록(시리얼 로그·엔코더·영상)은 저장소 밖에 두고, 문서에는 파일 이름만 적는다. 기기 주소·키·개인 PC 경로를 문서·커밋에 넣지 않는다.
- 기준 문서: [모션 펌웨어 README](../firmware-motion-corexy/README.md) · [솔레노이드 안전 전달표](솔레노이드-안전-전달표-2026-10-16.md) · [PS-1](안전계약-적용-보고-2026-10-15.md) §3 · [실측 기록표](실측-기록표.md) · [운영 런북](결선-운영-런북.md) · [시연 계획 v4](본선-시연-계획-v4.md) · [실물 장면 촬영 대본](촬영-대본-실물-장면.md).

## 순서 한눈에

| # | 단계 | 끝났다고 보는 조건 | 기록 위치 |
|---|---|---|---|
| 0 | HW 담당에게 받을 것 | 아래 표가 다 찼다(모르면 '모름'으로) | 이 문서 §0 표 |
| 0-1 | 배선 흔들기 점검 | 커넥터를 흔들어도 엔코더 계수가 끊기지 않는다 | 이 문서 §0-1 표 |
| 1 | 펌웨어 올리기 | `ready` 배너의 `fw`·`protocol`이 맞다 | §1 표 |
| 2 | RPi4 env 되돌리기·재시작 | RPi5 `/health/detail`의 `act_mode`가 `uart` | §2 |
| 3 | 원점·소프트 리밋 | 원점 복귀 성공, 리밋 밖 이동이 거절된다 | 실측 기록표 §4 앞 '기구' 메모 |
| 4 | mm 환산(기어비) 재측정 | 10 mm·50 mm 명령 대비 자로 잰 이동 오차 | 실측 기록표 |
| 5 | Z 단발 누름 | 선택한 솔레노이드 또는 SwitchBot 변형의 단발·정지·실패 시험 | 이 문서 §5 |
| 6 | 전자레인지 버튼 매핑·자리 확인 | 버튼마다 캐리지가 위에 서고 한 번씩 눌린다 | 실측 기록표 §4 |
| 7 | PS-1 정지 안전(S4·S5·엔코더 뽑기) | 정지 뒤 전송·수락 동작 0 | PS-1 §3-5 양식 → 실측 기록표 |
| 8 | 누름 성공률 n/N (N ≥ 30) | 버튼별 첫 시도·최종 성공률 | 실측 기록표 §4 |
| 9 | CT 콘센트 모듈(있으면 — 10/28 뒤, 결선 목표) | 시작·종료 판정 지연 | 실측 기록표 §6 |
| 10 | v4 시연 전체 리허설 ×10 | 표 10줄 | §10 표 → 런북 §6 |
| 11 | 실물 장면 촬영 | 촬영 대본 §0 선행 조건 통과 뒤 | 촬영 대본 |
| 12 | 되돌리기 | 언제든 모의로 돌아갈 수 있다 | §12 |

---

## 0. HW 담당에게 묻고 받을 것

**10/21 Z축은 SwitchBot Bot으로 변경됐다.** 모터 핀·기구는 그대로지만 **모터를 다시 달았으므로 방향·mm 환산은 새로 잰다**(§4).
아래는 확인만 받는다 — 바뀐 것이 있으면 그 줄을 고쳐 적고 §1에서 해당 빌드를 쓴다.

| 항목 | 저장소 기준(펌웨어 README·`config.h`) | HW 담당 답 |
|---|---|---|
| 펌웨어 변경 여부 | `esp32dev_switchbot` 선택 빌드 추가(10/21) | 확인 |
| 지금 보드에 올라간 펌웨어 | 10/15 HW 시험용 펌웨어 | 확인 |
| 모터 드라이버 핀(PWMA·AIN1·AIN2 / PWMB·BIN1·BIN2 / STBY) | 25·26·27 / 32·33·13 / 4 | 확인 |
| 엔코더 핀(A: A·B / B: A·B) | 16·17 / 18·19 | 확인 |
| 모터·엔코더 방향(`MOTOR_x_INVERT`·`ENC_x_INVERT`) | 원작 기본값 | 다시 단 모터 쪽이 바뀌었는지 **측정 필요**(§1-2) |
| 기어비·엔코더 분해능(`COUNTS_PER_REV`) | 28 × 50 = 1400(x4) | 모터 모델 그대로인지 확인 |
| 풀리 잇수·벨트 피치 | 20 · 2 mm | 확인 |
| PID 게인 | 원작 기본값 | 바꿨으면 값 |
| 솔레노이드 구동 핀 | GPIO23 | 확인 |
| 스위칭 소자 | N-MOSFET 로우사이드(부품명·정격) | 부품명 |
| 게이트 풀다운 저항, STBY 풀다운 | 외부 풀다운 필요 | 값·있음/없음 |
| 플라이백 다이오드 | 필요 | 부품명·극성 사진 |
| 누름 시간 | 펌웨어 상한: 구동 500 ms, 합계 800 ms, 냉각 최소 300 ms·통전의 3배 | 쓸 값 **측정 필요** |
| 솔레노이드 스프링 복귀형인지 | — | 예/아니오 |
| 전원 | 모터 VM 6 V(물리 E-STOP 경유), 솔레노이드 전원 | 어댑터 정격, 차단 스위치가 실제로 끊는 회로 |
| 리밋 스위치 사용 | `USE_LIMIT_SWITCHES=false`(스톨 원점) | 확인 |
| SwitchBot Bot | BLE press, notify `0x01`만 성공 | 전원·press 모드·장착 위치 확인 |

### 0-1. 배선 흔들기 점검 (첫 단계, 모터 전원 끈 채로)

10/14에 **B 드라이버 전원 선**과 **엔코더 A 단자**가 빠져 있었다([10/14 마감](devlog/devlog_2026-10-14-desktop-close.md) '보드' 절). 그래서 맨 먼저 본다.

1. 모터 전원(VM)을 끈다. 로직(USB)만 켠다. §1의 bring-up 빌드에서는 `P`로 엔코더 값을 본다(시연 빌드면 `status`의 `a`·`b`).
2. 모터 축(또는 캐리지)을 손으로 천천히 돌리며 `a`·`b`가 **끊김 없이** 바뀌는지 본다.
3. 손으로 돌리는 채로 커넥터를 하나씩 **살짝 흔든다**: 엔코더 6핀 두 개, 드라이버 전원 단자(VM·GND), 드라이버 로직 전원, ESP32 USB, 솔레노이드 단자.
   흔들 때 계수가 멈추거나 튀거나, 드라이버 전원 LED가 깜빡이면 그 커넥터를 고정한 뒤 다시 한다.
4. 다시 단 모터의 고정 나사가 조여 있는지, 풀리 고정 나사가 축의 평면 쪽에 물렸는지 손으로 확인한다.

| 커넥터 | 흔들 때 계수 끊김 | 전원 LED | 조치 | 판정 |
|---|---|---|---|---|
| 엔코더 A(모터 A) | 측정 필요 | — | | |
| 엔코더 B(모터 B) | 측정 필요 | — | | |
| 드라이버 A 전원 | — | 측정 필요 | | |
| 드라이버 B 전원 | — | 측정 필요 | | |
| ESP32 USB | 측정 필요 | — | | |
| 솔레노이드 단자 | — | — | | |

## 1. 펌웨어 올리기 (RPi4에서 esptool)

10/14와 같은 방식이다 — **USB를 옮기지 않고 RPi4에서 올린다.** 빌드는 PC에서 하고([펌웨어 README '빌드'](../firmware-motion-corexy/README.md)), 결과 바이너리만 RPi4로 옮긴다.

| 빌드 | 쓰는 때 | 배너 `fw` |
|---|---|---|
| `esp32dev_bringup` | §0-1·§1-2(방향·부호), 솔레노이드 `T` 단발 | `firmware-motion-corexy-bringup` |
| `esp32dev` | §2부터 전부(시연 보드) | `firmware-motion-corexy` |
| `esp32dev_switchbot` | §2부터 SwitchBot Bot을 Z로 쓸 때 | `firmware-motion-corexy` |
| `esp32dev_benchhome` | **쓰지 않는다** — `home`이 움직이지 않는 시험대 전용 | `firmware-motion-corexy-benchhome` |

1. 올리기 전 커밋 SHA를 적는다(`git rev-parse --short HEAD`). 바이너리는 그 커밋에서 빌드한다.
2. RPi4에서 실행기를 멈춘다 — 포트를 실행기가 잡고 있으면 올릴 수 없다: `docker stop simplelay-act`.
   (보드를 끌 때는 컨테이너를 멈추지 않는다는 규칙과 별개다. 이 단계가 끝나면 §2에서 다시 세운다.)
3. 장치 이름을 확인한다: `ls -l /dev/serial/by-id/`.
4. esptool로 올린다(업로드 속도는 `platformio.ini`와 같이 115200 — CH340 보드는 고속에서 실패했다):
   `esptool.py --chip esp32 --port /dev/serial/by-id/<장치> --baud 115200 write_flash <주소> <바이너리>`
   — 앱 영역만 올릴지, 부트로더·파티션까지 올릴지와 각 주소는 10/14에 쓴 명령과 같은지 **확인 필요**(그날 기록은 저장소 밖 작업 기록).
5. 리셋 뒤 배너를 본다. 시리얼 모니터 대신 같은 이미지로 일회용 컨테이너를 띄워 jog 도구를 쓴다
   (`docker run --rm -it --device <장치> simplelay-backend python -m rpi.tools.jog --port <장치> --baud 115200 -c status`; 실행기는 멈춘 상태).

| 날짜 | 커밋 SHA | 빌드 | `fw` | `protocol` | `z_mode` | `z_on_max_ms` | 판정 |
|---|---|---|---|---|---|---|---|
| | | | 기대: 위 표 | 기대: `line-json/v0` | 기대: 선택 빌드와 같음 | SwitchBot은 `null`, 솔레노이드는 800 | |

### 1-2. 방향·부호 (bring-up 빌드, 모터를 다시 달았으므로 필수)

[펌웨어 README '처음 켤 때 순서'](../firmware-motion-corexy/README.md) 1~5를 그대로 한다. 요점만:

- `M 0.3 0 500` → A 계수 **증가**, `M 0 0.3 500` → B 계수 증가. 아니면 `ENC_x_INVERT`.
- 벨트를 건 뒤 `M 0.3 0.3 300` → 캐리지 **+X(오른쪽)**, `M 0.3 -0.3 300` → **+Y**. 반대면 `MOTOR_x_INVERT`와 `ENC_x_INVERT`를 **같이** 바꾼다(하나만 바꾸면 폭주).
- 가운데에서 `Z` → `G 20 0` → `G 20 20` → `G 0 0`. 진동하면 `K`로 게인 조정 → 정한 값은 `config.h`에 옮겨 적는다(**펌웨어 변경이 생기면 커밋하고 시연 빌드를 다시 올린다**).
- 끝나면 선택한 시연 빌드(현재 `esp32dev_switchbot`)를 다시 올리고 배너를 다시 확인한다.

## 2. RPi4 env 되돌리기와 재시작

env는 `/mnt/rawdata/simplelay-act/env`(`deploy/run_act.sh`의 `DATA_DIR/env`).

1. **백업 먼저** — 이름 규칙 `env.bak-날짜-이유`: `cp env env.bak-YYYYMMDD-esp32-return`.
2. 두 줄을 되돌린다:
   - `SIMPLELAY_MOTION_MODE=mock` → `SIMPLELAY_MOTION_MODE=serial`
   - `#ESP32없음-20261016#SIMPLELAY_MOTION_PORT=…` → 앞의 주석 표시를 지운다. 값은 `/dev/serial/by-id/…` 경로를 쓴다(USB 재열거 뒤 다시 열기 — `run_act.sh`가 by-id면 `/dev`를 잇는다).
3. 기구 값이 [펌웨어 README 'RPi4 설정과 맞출 값'](../firmware-motion-corexy/README.md) 표와 같은지 본다(`R_OUT`·`DECODING_MULTIPLIER`·`PULLEY_TEETH`·`BELT_PITCH_MM`·`A_SIGN`·`B_SIGN`·`X/Y_MIN/MAX_MM`·`HOME_TIMEOUT_S` > 70·`BAUD=115200`). 솔레노이드는 `PRESS_MODE=duration`·`PRESS_DRIVE_MS`가 필요하고, SwitchBot은 누름 시간 env를 두지 않는다. 기구 값이 다르면 `move`가 `bad_args`로 거절된다.
4. `SIMPLELAY_MOTION_AUTO_HOME` 값을 확인해 적는다(아래 §3 원점 규칙).
5. 다시 세운다: `sh /mnt/rawdata/run_act.sh`. "장치가 없어 실행기를 세우지 않았어요"가 나오면 USB·경로를 고친다. `docker logs simplelay-act`로 시작 거절 이유(링크 키 등)를 본다.
6. RPi5에서 키를 넣어 `GET /health/detail`을 본다:

| 확인 | 기대 | 결과 |
|---|---|---|
| `act_mode` | `uart`(RPi4 실연결) — `local`이면 RPi5가 모의 | |
| `actuator_ready` | **원점 전에는 `false`가 정상**(아래 규칙) → §3 원점 뒤 `true` | |
| 폰·키오스크 화면 | 실물 실행에 '연습' 띠·배지 없음 | |
| 실행기 로그 | 모션 포트 열림, `ready` 수신 | |

**원점 규칙(10/19, 커밋 `d321218c`):** 실행기 시작·모션 포트 재연결 뒤에는 모션 보드가 `homed`라고 보고해도 **믿지 않는다** — 성공한 `home`을 한 번 해야 준비된다.
그사이 손으로 캐리지를 옮겼을 수 있기 때문이다. 그래서 재시작마다 §3의 원점 잡기를 다시 한다.

## 3. 원점과 소프트 리밋

1. 전원 차단 담당이 스위치에 손을 올린다. 캐리지를 가운데쯤에 둔다.
2. 원점 잡기 — 둘 중 하나:
   - 폰 **개발자 도구 '원점'**(`SIMPLELAY_DEV_MODE`·`SIMPLELAY_DEV_REAL_MOTION`이 켜져 있고 RPi4가 실물 링크일 때만 실제 장치. 화면에 '실제 장치'/'모의'가 보인다). 이 경로는 실행기 안에서 `home`을 하므로 위 원점 규칙을 푼다.
   - `SIMPLELAY_MOTION_AUTO_HOME=true`면 새로 승인된 첫 실행이 원점부터 잡는다.
   - (jog CLI의 `home`은 실행기를 멈춘 별도 프로세스라, 실행기를 다시 세우면 원점 규칙 때문에 다시 잡아야 한다.)
3. 원점 방향(좌하단, X-·Y- 벽)으로 가는지 눈으로 본다. 벽을 너무 세게 밀면 멈추고 `HOMING_PWM_LIMIT`·`STALL_ERR_MM`(펌웨어)을 낮춘다.
4. 소프트 리밋: 개발자 조그(한 번 최대 1 mm)로 `X_MIN_MM`·`Y_MIN_MM` 아래, `X_MAX_MM`·`Y_MAX_MM` 위로 보내 `soft_limit`으로 **움직이기 전에** 거절되는지 본다.
   `X_MIN_MM`·`Y_MIN_MM`은 3 이상 권장(0이면 벽을 민다). 실제 이동 가능 범위(자로)는 **측정 필요**.

| 항목 | 값 | 비고 |
|---|---|---|
| 원점 복귀 시간(s) | 측정 필요 | `HOME_MAX_MS` 70 s 설계값 |
| 원점 반복 오차(같은 자리 5회, mm) | 측정 필요 | |
| 실제 X·Y 이동 범위(mm) | 측정 필요 | env `X/Y_MAX_MM`에 반영 |
| 리밋 밖 거절 | 측정 필요 | `soft_limit`, `moved:false` |

## 4. mm 환산(기어비) 재측정

모터를 다시 달았으므로 10/14 이전 값을 쓰지 않는다. 설계 환산은 1400 카운트/회전(28 × 50 × 4 계산), 풀리 20잇 × 2 mm = 40 mm/회전 — **실제 기어비 50이 맞는지부터 측정 필요**.

1. 원점 뒤 캐리지에 바늘이나 펜 끝 같은 기준점을 붙이고, 프레임에 자(또는 모눈종이)를 고정한다.
2. 개발자 조그로 X +10 mm, 그다음 +50 mm(1 mm씩 반복 또는 jog CLI `goto`) → 자로 잰 실제 이동과 `status`의 `a`·`b` 계수를 적는다. Y도 같게. 각 3회.
3. 오차가 크면 `SIMPLELAY_MOTION_R_OUT`(카운트/회전)을 `명령 mm / 실제 mm` 비율로 고치고 **펌웨어 `COUNTS_PER_REV`도 같게** 맞춘다(둘이 다르면 `bad_args`). 고친 뒤 2를 다시 한다.
4. 결과는 [실측 기록표](실측-기록표.md)에 '기구 환산' 메모로 적고(§4 앞), RPi4 env를 바꿨으면 백업 이름 규칙을 지킨다.

| 축 | 명령(mm) | 회차 | 실제(mm) | 카운트 a | 카운트 b | 오차(mm) |
|---|---|---|---|---|---|---|
| X | 10 | 1~3 | 측정 필요 | | | |
| X | 50 | 1~3 | 측정 필요 | | | |
| Y | 10 | 1~3 | 측정 필요 | | | |
| Y | 50 | 1~3 | 측정 필요 | | | |

## 5. Z 단발 누름 (솔레노이드 / SwitchBot 중 하나)

실제로 올린 펌웨어 배너의 `z_mode`와 아래 변형이 같아야 한다. 다른 변형 절차를 섞지 않는다.

### 5-A. 솔레노이드 변형 (안전 먼저)

[솔레노이드 안전 전달표](솔레노이드-안전-전달표-2026-10-16.md) §2의 '전원 넣기 전 HW 확인'이 비어 있으면 **누름을 하지 않는다**.

1. 누를 곳 없이 공중에서 **단발 한 번**(bring-up 빌드 `T 100`, 또는 시연 빌드에서 개발자 도구 '누르기'). 냉각 시간 안의 연속 누름은 `z_cooldown`으로 거절되는 것이 정상이다.
2. 더미 패널 위로 옮겨 가장 짧은 시간부터 단발. 시간을 늘릴 때는 한 단계씩, 펌웨어 상한(구동 500 ms·합계 800 ms) 안에서.
3. 누름 유지 중 각각 한 번씩: **소프트웨어 정지**, **전원 차단(E-STOP)**, **ESP32 리셋**. 플런저가 풀리는 시간과 남은 누름을 본다.
4. 10회 반복 뒤 코일·MOSFET 온도를 손등이나 온도계로 본다(뜨거우면 중단).
5. 결과는 전달표 §3 기록 표에 적는다. 정한 누름 시간은 RPi4 `SIMPLELAY_MOTION_PRESS_DRIVE_MS`·`PRESS_DWELL_MS`에.

| 항목 | 값 |
|---|---|
| 정한 구동/유지 시간(ms) | 측정 필요 |
| 더미 패널에서 눌림 확인 최소 시간(ms) | 측정 필요 |
| OFF 요청 → 플런저 복귀(ms) | 측정 필요 |
| E-STOP → 복귀(ms) | 측정 필요 |
| ESP32 리셋 중 예기치 않은 누름 | 측정 필요 |
| 10회 뒤 온도 | 측정 필요 |

### 5-B. SwitchBot Bot 변형

1. `esp32dev_switchbot`을 올리고 `ready`·`status`가 `z_mode:"switchbot"`, `z_on_max_ms:null`인지 본다. 앱용 BLE 서버는 없고 호스트·정지는 계속 USB 줄 JSON이다.
2. 더미 패널에서 개발자 도구로 단발 한 번만 요청한다. MCU가 Bot notify `0x01`을 받은 때만 press reply가 `ok:true`여야 한다.
3. Bot을 꺼 두거나 범위 밖에 두어 연결 실패를 한 번 만든다. `switchbot_connect_failed`와 `press_outcome:"not_pressed"`인지 확인하고 자동 재누름이 없는지 본다.
4. write 뒤 notify를 받지 못하는 시험은 `switchbot_ack_timeout`과 `press_outcome:"unknown"`이어야 한다. 이 경우 실제로 눌렸을 수 있으므로 가전을 직접 확인하기 전 다시 누르지 않는다.
5. press 대기 중 소프트웨어 정지를 한 번 보낸다. XY 정지 응답은 즉시 와야 하며, BLE press를 이미 보냈다면 `switchbot_press_sent_cannot_recall`과 `unknown`으로 남아야 한다. 이미 보낸 Bot 명령은 회수할 수 없다.
6. Bot 응답 `0x02`·`0x03`·`0x05`·`0x06`·`0x07`·`0x09`를 성공으로 기록하지 않는지 가짜 MCU 회귀 시험 결과와 원시 줄 기록으로 확인한다.
7. 더미 패널에서 10회 단발 뒤 실제 눌림을 사람이 판정한다. 실제 가전 시험은 §6의 입회·빈 상태 가열 금지 규칙을 그대로 따른다.

| 항목 | 값 |
|---|---|
| 정상 notify `0x01` 단발 성공 | 측정 필요 |
| 연결 실패가 `not_pressed`로 보고됨 | 측정 필요 |
| ACK 시간 초과가 `unknown`으로 보고됨 | 측정 필요 |
| press 전송 뒤 stop의 회수 불가 보고 | 측정 필요 |
| 더미 패널 10회 성공 n/10 | 측정 필요 |

## 6. 전자레인지 버튼 매핑과 자리 확인

시연 가전은 **기본 가전 `microwave`(전자레인지)**, 시연 작업은 **'30초 → 시작'**(`BT-02` 30초 → `BT-05` 시작).
기본 버튼 목록은 `rpi/services/appliance_registry.py`의 `BUILTIN_MICROWAVE`(=[button-maps/microwave.json](button-maps/microwave.json), 4×3 격자 이름만 — **mm 좌표 없음**).

**지금 좌표가 정해지는 방식**

- 기본 가전에는 mm 좌표가 없다. 좌표 없이 누르려 하면 RPi4가 "좌표가 없어 누르지 않습니다 — 보정 먼저"로 거절한다.
- 폰에서 위치를 맞추면 RPi5가 기본 가전 위에 **보정 덮어쓰기**(DB의 `calibration:microwave`, 버튼 mm·판 번호)와 **정지·기다리는 자리**(`stop_park`)를 저장한다(`apply_calibration`). 기본 목록 자체는 바뀌지 않는다.
- 계산은 RPi5 `rpi/api/mapping_router.py`(`PUT /appliances/microwave/mapping`, 미리보기는 `…/mapping/preview`)와 `rpi/services/panel_mapping.py`. 사진 파일은 보내지 않고 **사진 크기와 짚은 좌표(px)만** 보낸다.
- 판(프레임) 크기는 요청값, 없으면 RPi5 env `SIMPLELAY_FRAME_W_MM`·`_H_MM`. 판 왼쪽 위와 갠트리 원점이 다르면 `SIMPLELAY_FRAME_ORIGIN_X_MM`·`_Y_MM`.
- 누름 장치가 어느 기본 가전 위에 있는지는 RPi5 env **`SIMPLELAY_GANTRY_APPLIANCES`**(기본 `microwave`). 여기 없는 기본 가전(인덕션)은 '설정이 필요해요'로 보이고 실행·자리 확인을 거절한다.
- 개발자 도구에는 지금 기본 가전도 보인다(조그·누르기로 버튼 자리를 직접 찾을 때 쓴다).
- 10/14 이전에 저장된 보정이 있어도 **모터를 다시 달고 §4 환산을 바꿨으면 그대로 믿지 않고 다시 맞춘다.**

**맞추는 순서(폰 '위치 맞추기' 5단계 — `app/lib/screens/add_appliance_wizard_screen.dart`)**

1. **조작부 사진** — 갠트리를 단 상태로 정면에서, 판 네 귀퉁이가 다 들어오게.
2. **버튼판 네 귀퉁이 고르기** — 왼쪽 위 → 오른쪽 위 → 오른쪽 아래 → 왼쪽 아래. 판 안쪽 가로·세로(mm)는 자로 재서 넣는다(**측정 필요**).
3. **버튼 고르고 이름 붙이기** — 최소 `30초`·`시작`·`취소`. 버튼 중심을 짚는다.
4. **정지 버튼과 기다리는 자리** — 정지 버튼은 `취소`(BT-06), 누름 횟수 기본 1. 기다리는 자리는 버튼을 가리지 않고 문 여닫이에 걸리지 않는 곳.
5. **자리 확인** — Z 누름 명령 없이 버튼 위를 한 번씩 지나간다(`POST /appliances/microwave/verify-pass`). 다른 실행 중이면 거절된다.
   '모든 위치에 도착했다고 응답했어요'는 **모션 보드 응답**이지 버튼 위였다는 증거가 아니다 — 사람이 눈으로 본다. 화면이 '연습으로만 자리 확인했어요'면 모의다.

**버튼마다 누름 확인(자리 확인 뒤)**

- 개발자 도구에서 그 버튼 자리로 간 뒤 '누르기' 한 번씩(30초·시작·취소 순서. 전자레인지는 **빈 상태 가열 금지** — 물컵을 넣고, 시작을 누른 뒤에는 바로 취소).
- 나중에 등록 가전에서 '자리 확인'만 다시 할 때는 가전 설정 카드의 **'자리 확인'** 버튼.

| 버튼 | 짚은 사진 px | 저장된 mm (x, y) | 자리 확인(눈) | 단발 누름(사람 판정) | 비고 |
|---|---|---|---|---|---|
| BT-02 30초 | | 측정 필요 | | | |
| BT-05 시작 | | 측정 필요 | | | |
| BT-06 취소(정지) | | 측정 필요 | | | |
| 기다리는 자리 | | 측정 필요 | — | — | |

같은 표의 결과를 [실측 기록표](실측-기록표.md) §4 시도 기록에도 옮긴다.

**버튼을 빗나갔을 때**

1. 몇 mm, 어느 방향인지 자로 잰다. 모든 버튼이 같은 방향으로 밀렸으면 판 원점(`SIMPLELAY_FRAME_ORIGIN_*`)이나 §4 환산 문제다 — 버튼 하나씩 고치지 말고 그쪽을 먼저.
2. 한두 버튼만이면 폰 '위치 맞추기'로 **다시 맞춘다**(사진을 다시 찍거나 같은 사진에서 버튼 점만 다시 짚기) → 자리 확인.
3. 개발자 조그(1 mm씩)로 실제 버튼 중심을 찾아 그 좌표를 기록하고, 위치 맞추기에서 그 자리에 오도록 다시 짚는다. 좌표를 손으로 DB에 넣지 않는다.
4. 가장자리를 스치는 정도면 재시도 오프셋 `SIMPLELAY_MOTION_RETRY_XY_OFFSETS_MM`(RPi4)이 자동 재시도 때 조금 옮겨 누른다 — **처음부터 빗나가는 것을 이것으로 덮지 않는다**. 토글 버튼(시작·취소)의 자동 재누름은 R1 정책 대상이다([안전 보고](안전계약-적용-보고-2026-10-15.md) §2-0).

## 7. PS-1 정지 안전 — S4·S5·엔코더 뽑기

[PS-1](안전계약-적용-보고-2026-10-15.md) §3을 따른다. 기록 양식은 §3-5(한 줄 = 한 회), 합격 기준은 §3-6. 모든 회차에 **같은 커밋·같은 펌웨어 SHA**.
RPi4·RPi5가 **같은 커밋**인지 먼저 확인한다(옛 RPi4면 정지 보고가 '보냄'에 머문다).

| 시험 | 주입 | 반복 | 볼 것 |
|---|---|---|---|
| S4 전송 시작 전 정지 | 승인 직후 0.2 s 안 정지 | 10 | 정지 뒤 호스트 전송 동작 줄 **0**, MCU 수락 동작 **0**(G2 수리 확인) |
| S5 실행 중 연결 끊김 | ① RPi4 Wi-Fi 끄기 ② 모션 USB 뽑기 | 각 5 | RPi4가 스스로 멈추는지("stopping by myself", 제한 3 s는 추측값), MCU 워치독 2 s(`host_timeout`), 화면 '미확인/끊김' — '완료·성공' 0회, 다시 이은 뒤 알림 한 건, 원점 다시 요구 |
| 엔코더 뽑기 | 이동 중 엔코더 커넥터 하나 뽑기 | 3 | `stall` 뒤 재시도 없이 정지, 정지 단계가 `verified`로 올라가지 **않음**(G11) |
| S1 이동 중 정지(캐리지) | 첫 이동 중간 | 10 | 정지 거리(mm) — 10/13~14 값은 모터 축이라 다시 잰다 |
| S2 누름 중 정지 | 선택한 Z 누름 응답 대기 중 | 10 | SwitchBot은 이미 보낸 press 회수 불가·결과 `unknown`, XY 정지는 즉시 응답 |
| S8 E-STOP vs 소프트 정지 | 같은 이동에서 두 방법 | 각 5 | 정지 거리 비교(E-STOP이 더 미끄러질 수 있음 — 추정) |

| 항목 | 값 |
|---|---|
| t2−t1(보냄 → 모션 보드 응답) 중앙/최대(ms) | 측정 필요 |
| t3−t1(보냄 → 엔코더 멈춤) 중앙/최대(ms) | 측정 필요 |
| 캐리지 정지 거리 중앙/최대(mm) | 측정 필요 |
| S5 끊김 → 스스로 멈춤(s) | 측정 필요 |

결과는 [실측 기록표](실측-기록표.md) §5(정지 지연)에 옮긴다. 실패 회는 숨기지 않고 G 번호와 함께 적는다.

## 8. 누름 성공률 n/N (N ≥ 30)

1. 버튼마다(`30초`·`시작`·`취소`) **N을 먼저 정해 적는다**(30 이상). 중간에 N을 바꾸지 않는다.
2. 한 회 = 앱에서 그 버튼 한 번 실행. 판정은 **사람**(표시창 변화·버튼음, 영상으로 남김). 첫 시도 눌림과 재시도 포함 최종 눌림을 따로.
3. 실패 주입(`POST /demo/inject-failure`)을 쓴 회는 표시하고 자연 성공률에서 뺀다. 모의 실행은 세지 않는다.
4. 기록 뽑기: RPi5 `GET /history.csv?limit=500`(허용 목록 열만 나간다 — 실행 모드·재시도·소요 시간·정지 지연). 원시 시리얼은 RPi4 `SIMPLELAY_MOTION_LOG_PATH`, 링크 기록은 RPi5 `SIMPLELAY_SESSION_LOG_PATH`를 켜 두고 저장소 밖에 보관.
5. CSV의 작업 ID와 사람 판정 줄을 맞춰 [실측 기록표](실측-기록표.md) §4 시도 기록·요약에 적는다.

| 버튼 | N | 첫 시도 성공 n/N | 최종 성공 n/N | 재시도 수 합 | 버튼당 시간 p50/p95(s) |
|---|---|---|---|---|---|
| 30초 | | 측정 필요 | 측정 필요 | | 측정 필요 |
| 시작 | | 측정 필요 | 측정 필요 | | 측정 필요 |
| 취소 | | 측정 필요 | 측정 필요 | | 측정 필요 |

## 9. CT 콘센트 모듈 (준비됐을 때만)

**10/19 사용자 결정:** 모션 보드가 돌아오면 §5~§8(실제 버튼 누름)을 먼저 하고, 이 단계는 10/28 제출 뒤로 미룬다. 10/28 영상은 CT 없이 찍는다([v4 §0-A](본선-시연-계획-v4.md), [실물 장면 대본](촬영-대본-실물-장면.md) §4-A). 결선(11/6) 전에 끝내는 것이 목표다.
만드는 방법·부품·펌웨어 핀 대응은 [콘센트 모듈 제작 안내](콘센트-모듈-제작-안내.md).

[콘센트 펌웨어](../firmware-outlet/README.md)는 컴파일까지만 확인했고 회로는 제작 중이다. 모듈이 없으면 이 단계를 건너뛰고 시연은 'CT 콘센트 모듈은 설계·펌웨어 완료, 실측 전'으로 말하고 가열 종료 장면은 연습으로 보인다.

0. **전자레인지 전원선은 자르거나 벗기지 않는다.** 전원선 안의 두 가닥을 함께 감싸면 전류가 서로 지워져 0에 가깝게 읽힌다 — CT는 한 가닥만 감싸야 한다. 방법은 둘이다. (가) 콘센트 모듈을 '중간 멀티탭'처럼 만들어 벽 콘센트 → 모듈 상자 → 상자 콘센트에 전자레인지 플러그를 그대로 꽂고, 선 가르기·CT·릴레이는 닫힌 상자 안에서만 한다(퓨즈, 릴레이·단자·선은 10 A 이상 권장 — 전자레인지 소비 전류는 제품 표기로 확인, 220 V 배선은 경험 있는 분 확인을 받는다). (나) 상자가 준비되기 전 측정은 시중 라인 스플리터(클램프 측정용 중간 연장선, 220 V 정격 확인)에 CT를 건다. CT 출력 형식(전압 출력형/전류 출력형 — 전류형은 부하 저항 필요)은 모델명으로 확인해 ESP32 입력 범위에 맞춘다.
1. 모듈 펌웨어의 핀·CT 보정·전압·역률·릴레이 극성은 전부 자리표시자다 — HW 담당과 실측해 채운 뒤 올린다.
2. RPi4 env 백업 → `SIMPLELAY_OUTLET_PORT`(by-id), 채널 설정, `SIMPLELAY_L3_MODE=real`(모듈이 없으면 실행기가 시작을 거절한다). 비상정지 래치가 풀려 있는지 확인.
3. [실측 기록표](실측-기록표.md) §6의 경우 A(정상 30초)·B(출력 감소)·C1(취소)·C2(문 열림)·D(팬만)를 각 3회 이상. 영상에 조작부·표시창·종료음이 같이 들어오게.
4. 종료 감지는 '가열 종료 감지(조리 완료가 아닐 수 있음)'로만 말한다.

| 항목 | 값 |
|---|---|
| 실제 시작 → 시작 판정 p50/최대(s) | 측정 필요 |
| 실제 종료 → 종료 판정 p50/최대(s) | 측정 필요 |
| B·D 오판 수 | 측정 필요 |

## 10. v4 시연 전체 리허설 ×10

[시연 계획 v4](본선-시연-계획-v4.md) 장면 ①~⑤를 끊지 않고 10번. 시작 전 매번: 허브 재시작 → `/health/detail` 준비 확인 → 원점 → 실행·정지 확인([런북](결선-운영-런북.md) §5-2). 준비 전에는 실행하지 않는다.
판정은 [런북](결선-운영-런북.md) §4의 장면별 진행/중단 기준. 실패하면 그 회를 그대로 적고 다음 회로(고친 뒤 회차 번호를 이어 쓴다).

| 회 | 날짜·시각 | 커밋/펌웨어 | ① 제안 거절 | ② 승인→누름→가열 시작→종료 감지→공기청정기 | ③ 같은 조건 재실행 | ④ 기록·자동 실행 끄기 | ⑤ 정지·일부 실패 | 걸린 곳 | 총 시간 |
|---|---|---|---|---|---|---|---|---|---|
| 1 | | | | | | | | | |
| 2 | | | | | | | | | |
| 3 | | | | | | | | | |
| 4 | | | | | | | | | |
| 5 | | | | | | | | | |
| 6 | | | | | | | | | |
| 7 | | | | | | | | | |
| 8 | | | | | | | | | |
| 9 | | | | | | | | | |
| 10 | | | | | | | | | |

요약(성공 회수 n/10, 장면별 실패 원인)을 [런북](결선-운영-런북.md) §6 리허설 기록에 한 줄로 옮긴다.

## 11. 실물 장면 촬영

[실물 장면 촬영 대본](촬영-대본-실물-장면.md) §0의 선행 조건(§3~§9가 이 문서와 대응)이 모두 통과한 뒤에만 찍는다. 10/28 영상(갈래 A, CT 없음)은 §3~§8까지, 결선 영상(갈래 B)은 §9까지. 측정이 먼저, 촬영이 나중이다.
자막의 숫자는 실측 기록표에서 가져오고 영상에서 따로 세지 않는다. '연습 띠 없음' 대조 컷과 기록 화면 동시 촬영은 대본 §2·§3대로.
노트북 화면 컷에 기기 주소·키·파일 경로가 보이면 그 컷은 쓰지 않는다.

## 12. 되돌리기 (언제든)

**모의로 되돌리기(RPi4)**

1. 지금 env를 `env.bak-YYYYMMDD-이유`로 백업.
2. `cp env.bak-20261016-no-esp32 env`(모의 모션: `SIMPLELAY_MOTION_MODE=mock`, 포트 줄 주석) — 또는 두 줄만 손으로 되돌린다. CT를 켰다면 `SIMPLELAY_L3_MODE`도 되돌린다.
3. `sh /mnt/rawdata/run_act.sh` → RPi5 `/health/detail` 확인. 화면에 '연습' 띠가 다시 보이는 것이 정상이다.

**이미지 되돌리기(RPi5·RPi4 둘 다 같은 태그로)**

- 직전 이미지 태그는 그날 배포 직전에 붙인 날짜 태그(10/19 기준 최신 `simplelay-backend:1019d`, 그 전 `1019c`·`1019b`·`1018c`). 새로 배포하기 전에 지금 이미지에 날짜 태그를 붙여 둔다.
- 실행 스크립트는 태그 없는 `simplelay-backend`를 쓴다: `docker tag simplelay-backend:<날짜 태그> simplelay-backend` → RPi5 `deploy/run_backend.sh`, RPi4 `run_act.sh`. 두 보드는 **같은 커밋**이어야 한다.

**펌웨어 되돌리기**

- 시연 빌드에 문제가 있으면 직전에 올렸던 바이너리(SHA 적어 둔 것)를 §1 방법으로 다시 올린다. 시험대 빌드(`benchhome`)는 시연 보드에 올리지 않는다.

**시연 중이면** 다시 시도하지 않고 전부 모의로 내린다([런북](결선-운영-런북.md) §5-4).

**끝낼 때:** 보드는 컨테이너를 멈추지 않고 `sync; poweroff`만. RPi4 재부팅 뒤에는 `systemctl start docker`가 필요하다. 평가 전에는 개발자 실물 조작 env를 끈다.
