Seongwonp/Simplelay/docs/인계-2026-10-18-노트북-검토.md

# 인계 2026-10-18 — 노트북 세션의 데스크톱 작업 검토

데스크톱 작업(`6859848`부터 10/18 15:30 `평가 16차`까지, 커밋 약 80개)을 노트북에서 읽고 시험한 결과다. **데스크톱 세션은 이 문서를 읽고 아래 '방향 조정'을 반영한다.** 이 문서는 새 파일이라 CLAUDE.md는 고치지 않았다(동시 작업 충돌 방지) — CLAUDE.md 현행화는 데스크톱에서 한다.

## 1. 품질 확인 (노트북, 그 시점 origin/main)

- 백엔드+rpi4 **3,555 통과**(exit 0), 키오스크 **1,035 통과**·골든 **76 통과**, 키오스크 analyze 1건(기존 info로 보임).
- 폰은 노트북 Flutter 캐시 문제(셰이더 형식 버전 불일치)로 이 PC에서 돌리지 못했다 — 데스크톱 결과 기준.
- 교수 의견(AI 느낌·엔지니어 말투) 대응 — 쉬운 말 사전, 폰·키오스크·서버 문구 통일, 글자·간격 토큰, 탭 4개 — 은 좋은 방향이다.

## 2. 방향 조정 (사용자 동의 10/18)

1. **UI 동결.** 80개 중 거의 전부가 '평가 N차' UI 수정(16차)이다. 같은 평가자 반복이라 그 평가자 취향에 맞춰지는 효과가 커서 90점 도달이 빨랐던 것으로 본다(사용자도 같은 판단). 이제부터 UI는 **실패널·실사용자 시험·처음 보는 평가자**(새 세션, 이전 평가 내역 없이)에서 나온 문제만 고친다.
2. **제출 문서 맞추기(최우선).** 이 80개 동안 `docs/submission/`·`README.md`·`docs/본선-시연-계획-v4.md` 변경이 0이다. 문구·화면이 많이 바뀌었으니 제출 초안의 화면 설명·그림 대응·검증 수준 표를 현재와 맞춘다.
   - README와 제출 초안이 서로 다르게 말하는 곳: 보드 배포됨(단 RPi4는 모의 모션), 실패널 설치, 07:00 자동 끄기 실물(`state_confirmed`), 시험 수.
   - 제출 초안 【기입】 약 41곳 목록화.
   - 촬영 목표 10/20, 제출 10/28 14:00.
3. **CLAUDE.md 현행화.** 머리 날짜 10/16, '노트북에서 다룬다(데스크톱 인계 없음)', 'R1 방향 미정'(1ed0c21로 끝남), '다음 보드 날' 10/14 기준, 미검증 줄의 'ThinQ를 RPi5 허브에서'·'키오스크 새 문구 실패널' 등 낡은 줄 정리. 집 사설 주소는 일반 표현으로(CLAUDE.md·10/16 desktop-home devlog).

## 3. 결선 전 보강 (우선순위 낮음)

- **정지 경로:** `rpi/api/service.py`의 정지 처리(10/18 기준 1283줄 근처) — `_stoppable_nodes()`가 예외를 내면 `_stop_sticky` 설정과 ThinQ 보내기 전 취소를 건너뛴다. 순서를 바꾸거나 try로 감싼다. 노드 컨트롤러 생성(약 230 ms) 동안 서비스 잠금을 쥐는 것도 같이 본다.
- **시각 규칙 자동 실행의 시계:** 벽시계만 믿는다(RPi5는 RTC 배터리 없음). 시계 동기 전에는 자동 실행 대신 카드로 묻거나, 문서에 조건을 적는다(추측 시나리오 — 인터넷 없이 부팅).
- 평가 전 끌 것: `/docs`·`/openapi.json`·`/redoc`, `SIMPLELAY_DEV_MODE`.
- R1의 시간 버튼(10초·30초·1분·5분)은 'idempotent'로 분류됐지만 누를 때마다 시간이 더해진다 — 문서에 솔직히 적혀 있다. 질의응답 "1분 버튼이 두 번 눌리면?" 답을 준비한다.

## 4. 하우징 (이번 커밋에 포함)

- [하우징 검토](하우징-검토-2026-10-18.md) §0의 #1~#11을 `housing/simplelay_box.scad`에 반영했다. 렌더·STL 12개(`sensor_lid` 새로)·사진 3장을 다시 만들었다. 자세한 것은 [하우징 README](../housing/README.md).
- **확인 수준:** OpenSCAD 2021.01 렌더 — 모든 조각 한 덩어리(`Volumes: 2`)·경고 없음·220 × 220 × 250 안, 패널 넣는 길 간섭 확인 "empty". 3D 출력·실물 맞춤·온도는 아직이다.
- 검토에 없던 수정: 뒤판이 몸통 뒤 테두리와 같은 자리를 차지해 끼울 수 없던 것(`back_gap`), 옆벽 받침 연결판이 바깥으로 1.5 mm 튀어나온 것.
- **실물에서 먼저 볼 것:** 왼쪽 멈춤 턱·고리 받침과 패널 포트·플러그 간섭(포트 실측 뒤 `stop_zs`·`clip_zs` 이동 후 간섭 확인 다시), 받침 턱 아래 오버행(슬라이서), 센서 칸 높이 24 mm(DHT22 눕혀야), 위 뒤판 조각의 안쪽 모서리 들뜸, 덧살 볼트 공구 여유, `screen_up`·`plug_room` 실측 → `fit_test` 먼저.

## 5. 이번 주 순서 제안

1. 제출 초안·README·CLAUDE.md 정합
2. 하드웨어 없이 찍을 수 있는 시연 장면(ThinQ·루틴·정지 화면) 촬영 준비
3. ESP32·솔레노이드가 오면 실제 누름·PS-1 정지 시험 영상
