Seongwonp/Simplelay/docs/하우징-검토-2026-10-18.md

# 키오스크 하우징 검토 (2026-10-18)

대상: [`housing/simplelay_box.scad`](../housing/simplelay_box.scad)(2안 · 쐐기형 박스, 10/16 커밋)와 [하우징 README](../housing/README.md), 렌더 사진 3장.
노트북에서 3D 모델을 다시 손볼 때 쓰는 **수정 기록**이다. scad 파일은 이 검토에서 고치지 않았다.

**확인 수준:** 코드 읽기 + 렌더 사진 + OpenSCAD 2021.01로 간섭만 따로 계산(아래 §3-3, 확인용 스크립트는 저장소에 넣지 않음). 3D 출력·실물 맞춤·온도는 확인하지 않았다.
무게·넘어짐·공기 흐름 숫자는 **모두 계산 추정**이고, 패널 테두리·포트·버튼 위치는 **실측 필요**다. 패널 값은 하드웨어 연결 설계 §0-1의 제품 사양표(2026-09-14 확인) 값을 쓴다. 제품 공개 사양을 웹에서 다시 찾지는 않았다(제품 이름을 공개 문서에 적지 않으므로 사양표 값을 기준으로 둔다).

줄 번호는 10/16 커밋 기준 `simplelay_box.scad` 줄이다.

---

## 0. 바로 고칠 것 (우선순위)

| # | 무엇 | 왜 | scad 위치 | 제안 값 | 실측 필요 |
|---|---|---|---|---|---|
| 1 | **패널 좌우 위치를 잡는 턱이 없다** | 패널은 받침 턱(83줄)에 올라앉고 고리로 눌릴 뿐, 좌우로 막는 것이 없다. 왼쪽에 플러그 여유 20 mm가 비어 있어 패널이 옆으로 밀리면 화면 창(73줄)과 표시 영역이 어긋난다 | 83줄 받침 턱 옆에 새로 | 패널 왼쪽·오른쪽 끝에 멈춤 턱(경사면 안쪽, 폭 3 × 높이 8 × 패널 두께만큼). 패널 폭 + 0.5 mm 간격 | 패널 실제 폭(사양 354) |
| 2 | **화면 창이 표시 영역과 똑같은 크기, 아래 위치는 추측** | 창 = 349.632 × 196.668(73~74줄)이라 좌우는 패널 자체 테두리 2.18 mm 위에 여유 0으로 걸친다. 출력 오차(±0.3 mm 안팎, 추정)나 1번 어긋남이 그대로 화면 가림이 된다. 세로는 `screen_up = 10`(25줄)이 추측이라 틀리면 키오스크 맨 아래 줄(세로는 1080 px를 꽉 채움)이 가려진다 | 25, 73~74줄 | 창 = 표시 영역 + 사방 0.5 mm. 창 바깥 모서리 45° × 2 mm 모따기(가장자리 터치 쉽게). `screen_up`은 실측값 | **패널 위·아래·좌·우 테두리 폭**(표시 영역이 가운데인지) |
| 3 | **뒤에서 곧장 밀어 넣으면 나사 받침 3개와 부딪힌다** | OpenSCAD 간섭 계산(§3-3): 패널을 최종 자리에서 뒤로 곧장 밀면 받침 `(split_x+10, H−12)`·`(W−12, H−12)`·`(W−12, split_z)`와 겹친다. 아래 모서리를 받침 턱에 걸고 세워 넣는 경로도 기울기 +40° 근처에서 `(W−12, split_z)`와 x 5.5 mm 겹친다 | 92~93줄 `boss_points`, 32줄 `side_room` | 오른쪽 받침이 패널 폭(x 23~377) 밖에 오도록 `side_room` 8 → 16(전체 폭 396, 반쪽 198 — 프린터 안). 위 가운데 받침은 x를 패널 밖으로 빼거나 없애고 다른 줄에 하나 더. 고친 뒤 §3-3 확인을 다시 돌린다 | 아니오(형상 문제) |
| 4 | **가운데 줄 나사 받침이 분할선 위에 있다** | `[12, split_z]`·`[W−12, split_z]`(93줄)가 몸통 위·아래 분할선(z 130.1)에 걸려 받침과 뒤판 구멍(122~123줄)이 반쪽씩 나뉜다. 그 결과 뒤판 RB·LT 조각은 **온전한 나사 1개 + 반쪽 구멍**으로만 붙는다 | 92~93줄 | 가운데 줄을 `split_z − 25` 정도로 내리고, 뒤판 4조각이 각각 온전한 나사 3개 이상이 되게 재배치(분할선에서 15 mm 이상) | 아니오 |
| 5 | **센서 칸은 '막힌 칸'이 아니다** | 칸막이는 옆·뒤 세 면뿐(85~87줄)이고 위(z 30)는 본체 안 공기와 통한다. 바로 위 5~8 mm에 패널 아래쪽(가장 두꺼운 9.6 mm 부분 — 회로가 있을 가능성, 추측)이 있다. 4줄 주석·README 조립 5단계의 '막힌 칸' 표현과 다르다 | 4, 50, 78, 85~87줄 | 칸 위에 뚜껑(선 지나갈 홈 3 × 6)을 달고, 앞 통풍 슬롯(78줄, 지금 6개 × 4 × 14 = 336 mm²)을 아래·옆으로 늘린다. 가능하면 센서를 상자 **밖**(앞 턱 아래 또는 왼쪽 옆면 바깥 주머니)으로 | 상자 닫고 30분 켠 뒤 기준 온도계와 차이 |
| 6 | **배기 슬롯이 패널 뒤 윗부분을 비우고, 이음선에 살 1.8 mm만 남긴다** | 위판 슬롯(76줄)은 y 108.8~153.8, x 135.8~255.8뿐이다. 패널 뒤 더운 공기는 경사면을 따라 위판 앞 모서리(y 84~108)로 모이는데 그곳에 구멍이 없다. 6번째 슬롯이 x 195.8에서 시작해 분할선(x 194)과 1.8 mm 거리 | 76줄 | 슬롯 시작 y = `top_front_y + 8`, x 범위를 패널 폭 전체로(분할선 ±10 mm는 비움). 배기 면적 2,700 → 5,000 mm² 이상(흡기 3,500보다 크게) | RPi5 온도·스로틀(§2) |
| 7 | **이음 보강판 나사를 받을 곳이 없다** | `splice`(137~143줄)는 평판에 d 3.2 구멍뿐. 몸통에는 받는 구멍이 없고 벽이 3 mm라 M3 자체 탭 나사는 바깥면을 뚫고 나온다. 사실상 접착만으로 붙는다. 평판이라 모서리(바닥↔옆벽)도 못 감싼다 | 137~143줄, 128~135줄 `quad` | 이음선 안쪽에 덧살(높이 6 × 두께 4, 분할면을 따라)을 붙이고 M3 볼트 + 너트로 덧살끼리 조인다(접착 없이 풀 수 있어 운반·수리에 유리). 또는 접착 + d 3 맞춤 핀 구멍 | 아니오 |
| 8 | **패널 누름 고리: 위치가 정해져 있지 않고, 접착하면 패널을 뺄 수 없다** | `panel_clip`(145~151줄)은 홈 10.2 mm짜리 U자 토막이라 패널 위쪽 얇은 부분(4.7 mm)에서는 5 mm 헐겁다. 어디에 붙일지 모델에 없다 | 145~151줄 | 패널 뒤 VESA 75 × 75 구멍(사양표)을 쓰는 누름판, 또는 경사면 안쪽 나사 받침에 조이는 L자 고리 + 1~2 mm 폼. 위치를 모델에 넣는다 | VESA 구멍이 커버 없이도 있는지·나사 규격 |
| 9 | **미끄럼 방지 발이 없다** | 위쪽 화면을 누를 때 PLA 바닥이 책상에서 밀린다(§3-2: 마찰계수 0.3 가정 시 약 7 N에서 밀림, 추정) | 58줄 바닥(새로) | 바닥 네 모서리 안쪽에 고무발 자리(Ø 12 × 깊이 1 mm 홈) | 사용할 고무발 지름 |
| 10 | **출력 방향: 위 조각은 위판이 천장이 된다** | `shell_LT/RT`(191~192줄)는 아래로 옮기기만 해서 STL 그대로 뽑으면 위판(86 × 194 mm)이 공중 천장이라 전부 서포트가 필요하다. 받침 턱(83줄) 아래면은 약 70° 오버행 | 83, 191~192줄 | 위 조각은 위판을 판에 대고 뒤집어 출력(`rotate([180,0,0])` 또는 슬라이서에서 뒤집기). 받침 턱 아래에 45° 받침살 | 아니오 |
| 11 | **열 인서트 구멍과 받침 지름** | 구멍 4.2(106줄)는 인서트 제품마다 권장값이 다르다. 받침 지름 9(103줄)면 구멍 둘레 살이 2.4 mm로 얇다 | 103, 106줄 | 산 인서트의 권장 구멍(대개 4.0~4.2 수준, 제품 확인)으로. 받침 지름 10 이상 | 인서트 제품 사양 |
| 12 | **포트 종류와 플러그 여유** | 사양표 '동봉 케이블 HDMI–mini HDMI'로 보아 패널 영상 입력이 mini HDMI일 수 있다(하드웨어 연결 설계 §0-1은 '표준 HDMI'로도 적음 — 서로 다름). 패널 옆면에는 영상·터치(USB-C 데이터)·전원(USB-C PD) **세 가닥**이 꽂히는데 README 4단계는 둘만 적는다 | 31줄 `plug_room` | 세 플러그의 실제 ㄱ자 몸체 길이 + 5 mm로 `plug_room` 결정 | **포트 종류·위치, 플러그 길이** |

1~4번은 출력 전에 고쳐야 다시 뽑지 않는다. 5·6번은 열 실측 뒤 다시 손볼 수 있지만 위판·센서 칸 조각이 바뀌므로 함께 고치는 편이 싸다. 2·12번은 `fit_test` 조각으로 실측한 다음 고친다.

---

## 1. 패널 맞춤·창·터치

**사양(제품 사양표, 2026-09-14 확인 — 실측 아님):** 외형 354 × 225 mm, 두께 4.7 / 9.6 mm(가장 두꺼운 곳), 표시 영역 349.632 × 196.668 mm, 1090 g(커버 포함), VESA 75 × 75. scad 20~24줄이 이 값과 같다.

- **좌우 테두리:** (354 − 349.632) / 2 = 2.18 mm. 패널 자체 테두리가 이만큼밖에 없어 창 테두리가 걸칠 자리도 2.18 mm다. 지금 창은 표시 영역과 정확히 같은 폭이라 걸침이 0이 아니라 **'표시 영역 경계와 딱 맞음'** 이다. 키오스크는 가로로 좌우 60 px(약 10.9 mm, 하드웨어 연결 설계 §0-1 계산)를 비워 두므로 가로 1~2 mm 가림은 화면 내용에는 큰 문제가 아니다. 문제는 세로다 — 세로는 1080 px를 꽉 채운다.
- **세로 테두리:** 225 − 196.668 = 28.33 mm를 위아래가 나눠 가진다. 두께가 아래쪽이 두꺼운 것으로 보아 아래 테두리가 더 넓을 수 있다(추측). `screen_up = 10`(25줄)이 틀리면 창이 그만큼 화면을 가리거나 패널 테두리를 드러낸다. 지금 값이면 창 위쪽에서 패널 위 끝까지 18.3 mm.
- **받침 턱:** 경사면 기준 z′ 6~10, 깊이 12.6 mm(83줄) — 패널 두께 9.6 + 3. 최종 자리에서 패널 아래면과 면 접촉만 하는 것을 OpenSCAD로 확인했다(겹침 부피 없음).
- **두께 차이:** 고리·받침이 모두 9.6 기준이다. 위쪽 4.7 mm 부분은 5 mm 떠 있어 누를 것이 없다 → 우선순위 8번.
- **터치 오작동:** 패널은 경사면 안쪽 면(y′ = 3)에 바로 붙고 창 테두리가 유리 가장자리를 직접 누른다. 고리로 세게 누르면 정전식 터치가 가장자리에서 헛터치할 수 있다(일반적 주의, 이 패널로 확인한 적 없음). 창 뒤에 0.5~1 mm 폼 테이프를 두고, 고리는 '빠지지 않을 만큼'만 누르게 한다. 키오스크를 상자에 넣은 뒤 **네 모서리·네 변 터치 좌표**를 다시 확인한다(실기기 확인 항목).
- **창 모서리 높이:** 벽 3 mm가 화면보다 3 mm 앞에 솟아 있어 맨 아래·맨 위 버튼을 누를 때 손가락이 턱에 걸린다. 바깥 모서리 모따기(우선순위 2번)로 줄인다.
- **OSD 버튼 구멍:** 오른쪽 옆벽 14 × 60(80줄), 높이는 패널 높이 25% 지점(추측). 패널 오른쪽 끝과 옆벽 안쪽 사이가 8 mm라 손가락이 버튼에 닿지 않는다(벽 3 + 틈 8). 패널이 전원 연결 시 저절로 켜지는지 먼저 확인하고, 안 켜지면 출력한 누름 막대(구멍에 끼우는 막대)를 둔다. **버튼 위치·저절로 켜짐 실측 필요.**
- **스피커:** 사양표에 스피커 2 W + 2 W가 있다. 키오스크 음성 안내가 패널 스피커로 나온다면 상자 안에 갇혀 작아진다. 스피커 구멍 위치를 재고 그 앞에 그릴을 낸다. **실측 필요.**

## 2. 열 (RPi5·패널·DHT22)

**모델의 공기 길:** 뒤판 아래 흡기 14개 × 5 × 50 = **3,500 mm²**(114줄, z 20~70) → 상자 안을 올라가 → 위판 배기 10개 × 6 × 45 = **2,700 mm²**(76줄). 센서 칸 앞 슬롯 336 mm²(78줄).

- **열원(추정):** 패널 소비전력 8.5 W(사양표). RPi5는 키오스크 부하에서 수 W~10 W 안팎(추정, 측정 필요 — 전력버짓 표). 합쳐 10~18 W가 상자 안에 갇힌다.
- **자연 대류 대략 계산(추정):** 흡기 중심(z 45)~배기(z 260) 굴뚝 높이 0.215 m, 흡·배기 직렬 유효 면적 약 2,140 mm², 유출계수 0.6 가정. 안팎 공기 온도차 10 K일 때 약 6 W만 내보낸다. 15 W를 공기로만 내보내려면 온도차가 **약 19 K**가 된다(벽으로 빠지는 열 무시). 실제로는 벽 방열이 있어 이보다 낮겠지만, 상자 안이 실내보다 10 K 이상 따뜻해질 수 있다고 보고 설계한다. **측정 필요.**
- **배기 위치:** 패널 뒤 공기는 경사면을 타고 위판 앞쪽 모서리(y 84~108)에 모이는데 배기 슬롯은 y 108.8부터 시작한다 → 우선순위 6번. 슬롯을 넓히면 배기가 흡기보다 커져 굴뚝 효과가 앞 센서 슬롯으로도 바깥 공기를 끌어들인다(센서에 유리 — 실측으로 확인).
- **RPi5 자리:** 중심 (240.6, 161.3)(47줄), 보드 z 118.6~203.6 — 상자 안에서 가장 더운 윗부분이다. 흡기 → RPi5 → 배기 길에는 있으므로 바람이 지나가긴 한다. 판정 기준: 상자를 닫고 키오스크를 30분 이상 켠 뒤 `vcgencmd measure_temp`와 `vcgencmd get_throttled`로 스로틀이 없는지(공개 문서 기준 RPi5는 80 °C 부근부터 속도를 낮춤). 스로틀이 생기면 RPi5를 흡기 쪽(아래)으로 내리거나 작은 팬을 배기 쪽에 단다.
- **쿨러 방향:** README는 '쿨러는 안쪽'. 쿨러가 바람을 내보내는 쪽이 위(배기 쪽)를 향하도록 보드를 돌려 단다. 쿨러 높이·바람 방향 **실측 필요**. 모델의 RPi5 상자(56 × 20 × 85, 163~164줄)는 스탠드오프를 포함하지 않은 대략값이다.
- **DHT22(실내 온습도 오차):** RPi5 백엔드가 읽는 실내 온습도 센서다(`SIMPLELAY_DHT22_GPIO`). 에어컨·제습기 제안의 주 조건이라(본선 실행 계획) 상자 열이 들어가면 '덥다' 제안이 잘못 뜰 수 있다. 지금 자리는 RPi5에서는 멀다(x 52~67 vs RPi5 x 212~269 — 좋음). 그러나 ① 칸 위가 본체 안과 통하고 ② 패널 두꺼운 아래쪽 바로 밑이다 → 우선순위 5번. 칸을 닫든 밖으로 빼든, **기준 온도계를 옆에 두고 상자 닫은 상태 30분·60분 값 차이**를 실측 기록표에 남긴 뒤에만 '실내 온도'라고 말한다.

## 3. 구조

### 3-1. 벽·분할·이음

- **벽 3 mm**(28줄): 전체 크기(388 × 170 × 260)에 비해 무난하다. 약한 곳은 창 둘레 띠다 — 오른쪽 띠 13.2 mm(벽 3 + 여유 8 + 패널 테두리 2.18), 왼쪽 25.2 mm, 아래 20 mm, 위 28.3 mm(경사면 따라).
- **분할**(42~43줄): x 194, z 130.1. 세로 분할은 창 위·아래 띠를, 가로 분할은 창 왼쪽·오른쪽 띠를 자른다. 가로 이음은 옆벽(분할 높이에서 길이 약 134 mm)이 힘을 받고, 세로 이음은 바닥·앞 턱·위판이 받는다. 경사면 띠 이음은 패널 뒤라 보강판을 댈 자리가 없다(패널이 경사면 안쪽에 바로 붙음) → 접착 + 옆 구조에 맡기고, 보강은 바닥·위판·옆벽·앞 턱에 한다.
- **보강판**(137~143줄): 우선순위 7번. 덧살 + 볼트·너트 방식이면 대회장에서 풀어 고칠 수 있다.
- **뒤판 4조각:** 조각끼리 서로 잇는 것이 없고 몸통 받침에만 나사로 붙는다. 현재 조각별 나사(우선순위 4번 반영 전): LB 2 + 반쪽, RB 1 + 반쪽, LT 1 + 반쪽, RT 2 + 반쪽. RPi5 구멍 4개는 모두 **RT 조각**에 있다(x 211.6~269.6, z 136.8~185.8) — RT 조각을 **정비 문**으로 쓰면 좋다(나사만 풀면 RPi5가 같이 나옴, 선 여유 필요). 뒤판은 한 장(194 × 260)으로 뽑을 수 없다(판 220 × 220, 높이 250 넘음) → 조각 이음에 3 mm 계단 겹침을 주는 것도 방법.

### 3-2. 무게중심·넘어짐·밀림 (계산 추정)

가정: 벽 면적 약 307,500 mm² × 3 mm = 922 cm³, PLA 1.24 g/cm³, 채움 70~90% → 상자 0.8~1.0 kg. 패널 1.09 kg(커버 포함 사양값), RPi5 0.1 kg. 전체 약 2.0~2.2 kg, 무게중심은 앞에서 약 80~84 mm, 높이 약 130 mm.

- **뒤로 넘어짐:** 창 맨 위를 화면에 수직으로 누르면 뒤 아래 모서리를 축으로 넘어간다. 약 **9~10 N**(약 1 kgf)에서 넘어지기 시작한다. 창 맨 아래를 누를 때는 170 N 이상이라 문제없다. 손가락 터치 힘이 보통 몇 N 이하(추정)라 2~3배 여유다. 넘어짐을 더 막으려면 뒤쪽 바닥을 10~20 mm 뒤로 늘리거나 바닥 뒤쪽에 무게를 둔다.
- **앞으로 넘어짐:** 무게중심이 바닥 안쪽이고 경사면이 뒤로 누워 있어 걱정 없다.
- **밀림:** 마찰계수 0.3(PLA↔책상, 추정)이면 위쪽을 약 7 N으로 밀 때 넘어지기 전에 미끄러진다. 고무발(0.6 가정)이면 16 N까지 버텨 넘어짐(9~10 N)이 먼저 온다 → 고무발은 꼭 단다(우선순위 9번).

### 3-3. 패널 넣는 길 (OpenSCAD 간섭 계산)

README 조립 3단계는 '패널을 뒤쪽에서 넣어'라고만 적는다. 원본 scad를 `include`해서 몸통과 패널 이동 궤적의 겹침을 계산했다.

- **곧장 밀어 넣기**(최종 자리에서 뒤로 120 mm 평행 이동한 궤적): 받침 `(204, 248.2)`·`(376, 248.2)`·`(376, 130.1)` 세 곳과 겹친다(겹친 범위 x 199.5~377, y 157~167, z 125.6~249.8). 패널 위 끝이 z 249.8까지 오는데 위 줄 받침은 z 243.7부터 있다.
- **아래 모서리를 받침 턱에 걸고 세우기**(경사를 20°에서 2°씩 최대 +60°까지 더 눕힌 자세들): 위 줄 받침과는 겹치지 않고, +40° 근처 한 자세에서만 `(376, 130.1)` 받침과 x 371.5~377(5.5 mm) 겹친다. 패널을 왼쪽(플러그 여유 쪽)으로 조금 비켜 세우면 지나갈 수도 있으나, 플러그를 꽂은 채면 여유가 없다.
- **결론:** `side_room`을 늘려 오른쪽 받침을 패널 폭 밖으로 빼면 '세우기' 경로가 깨끗해진다. README 3단계에 '아래 모서리를 받침 턱에 먼저 걸고 앞으로 세운다'를 적는다.
- **다시 확인하는 법:** 같은 폴더에 아래 내용의 확인 파일을 만들어 `openscad -o out.stl -D 'part="none"' 확인파일.scad`. "Current top level object is empty"가 나오면 간섭 없음.
  ```
  include <simplelay_box.scad>
  module pl() translate([panel_x0, wall, panel_up]) cube([panel_w, panel_t, panel_h]);
  module rot(a) face_frame() translate([0, wall, panel_up]) rotate([-a, 0, 0]) translate([0, -wall, -panel_up]) pl();
  intersection() { union() { for (p = boss_points()) boss(p); } union() { for (a = [2:2:60]) rot(a); } }
  ```

### 3-4. 나사 받침·열 인서트

- 받침 8곳, 지름 9 · 길이 10 · 구멍 4.2(97~107줄), 뒤판 구멍 3.4(123줄). M3 통과 구멍 3.4는 적절하다.
- 인서트 구멍은 산 제품의 권장 구멍 지름·깊이를 따른다(우선순위 11번). 인서트 바깥지름이 4.5~5 mm대(제품마다 다름)면 받침 지름 10 이상이 안전하다.
- 받침이 가까운 벽에 6 × 10 × 2 판으로 hull 연결된다(104줄). 가운데 줄은 옆벽으로 수평으로 뻗은 외팔이라 인서트를 인두로 누를 때 휠 수 있다 → 받침살을 삼각형으로 두껍게.
- RPi5 구멍 d 2.7, 간격 58 × 49(46줄)는 RPi5 고정 구멍 간격과 맞다. 보드 밑면 부품 때문에 스탠드오프(높이 실측)가 필요한데 모델에 없다.

## 4. 배선·정비

- **패널 쪽 세 가닥:** 영상(HDMI, 패널 쪽 단자 종류 확인 — 우선순위 12번)·터치(RPi5 USB-A ↔ 패널 USB-C 데이터)·전원(PD 어댑터 → 패널 USB-C 전원). 사양표상 HDMI만 꽂으면 터치가 안 된다. `plug_room = 20`(31줄)은 추측 — ㄱ자 플러그 몸체를 재서 정한다. 플러그를 꽂은 채 패널을 세워 넣어야 하므로(§3-3) 플러그가 뒤쪽으로 꺾이는 방향인지도 본다.
- **전원 입구:** 뒤판 오른쪽 아래 36 × 14(116줄), USB-C 두 가닥(RPi5 전원·패널 PD). 어댑터 두 개는 상자 **밖**에 둔다. 선을 당기면 RPi5·패널 단자가 바로 당겨지므로 입구 안쪽에 케이블 타이 고리(당김 방지)를 단다.
- **케이블 정리:** 시판 선(1 m 안팎)은 상자 안 거리(RPi5 → 패널 왼쪽 약 0.3 m, 추정)보다 길어 남는 선이 쌓인다. 짧은 선(0.3~0.5 m)을 쓰거나 바닥·옆벽에 타이 고리 3~4개를 둔다. 남는 선이 흡기 슬롯·RPi5 쿨러를 막지 않게 한다.
- **DHT22 선:** RPi5 GPIO에서 센서까지 직선 거리 약 0.3 m(추정). 칸 뚜껑에 선 홈(우선순위 5번).
- **RPi5 정비:** 보드가 뒤판에 평행하게 붙어 SD 카드·전원 버튼·USB·이더넷이 모두 보드 가장자리를 향한다 — 밖에서는 손이 닿지 않는다. 정비는 RT 뒤판 조각(정비 문)을 열어서 한다. 평소 켜고 끄기는 전원 입구에서 선을 뽑았다 꽂는 것으로 하고, 결선 전에 이 방식으로 키오스크가 자동으로 다시 뜨는지 확인한다(부팅 자동 실행은 실물 확인됨 — 상자 안에서 다시 확인).
- **뒤판 열기:** 나사 8개(인서트) — 운반 뒤 현장에서 열 수 있다. 1·4번을 고치면 뒤판 조각별로 따로 열 수 있다.

## 5. 출력성 (220 × 220 × 250 가정)

- **크기:** 조각 최대 194 × 170 × 130.1(scad echo로 확인). `side_room`을 16으로 늘려도 198 × 170 × 130 — 판 안에 든다.
- **아래 조각(LB·RB):** 바닥을 판에 댄다. 경사면은 수직에서 20° 기운 벽이라 서포트 없이 된다. 받침 턱(83줄) 아랫면이 수평에서 약 20°(오버행 70°)라 서포트가 생긴다 → 45° 받침살.
- **위 조각(LT·RT):** 지금 STL 방향(분할면이 판)으로 뽑으면 위판 전체가 천장이다 → **뒤집어서**(위판이 판, 분할면이 위) 뽑는다. 그러면 창 위쪽 띠도 위판에서 자라 올라가 서포트가 필요 없다. 배기 슬롯도 판에 붙어 깨끗하다.
- **나사 받침 구멍:** 수평 축 원통이라 구멍 위쪽이 살짝 처진다. d 4.2 정도는 대개 괜찮지만 인서트 넣기 전에 드릴로 다듬는다.
- **뒤판:** 눕혀 출력(154~156줄), 문제없음.
- **시간(추정, 슬라이서로 확인):** 몸통 한 조각이 10시간 안팎, 전체 40~70시간대가 될 수 있다. **하우징은 본선(11/6)에서만 보인다(사용자 결정 10/18)** — 10/28 제출 시연 영상은 하우징 없이 찍으므로 출력 마감은 11/6 설치 전이다. 그래도 **fit_test → 몸통 → 뒤판** 순서로 날짜를 거꾸로 계산해 둔다.
- **재료:** 상자 안이 따뜻해질 수 있어(§2) PLA는 패널 뒤·RPi5 근처에서 열 변형 여유가 크지 않다(PLA는 대개 50~60 °C 근처에서 물러짐 — 일반값). 온도 실측에서 상자 안이 45 °C를 넘으면 PETG를 검토한다.

## 6. 결선 시연 맥락

- **책상:** 150 × 55 cm 두 개. 상자 바닥 388 × 170 mm라 자리를 거의 안 차지한다. 갠트리·가전과 같은 책상이면 키오스크를 앞쪽 모서리에서 15 cm 이상 안쪽에 둔다(넘어짐·밀림).
- **설치 30분:** 상자는 한 덩어리로 옮기고 현장에서는 전원 두 가닥만 꽂는다. 패널·RPi5는 상자 안에 둔 채 운반한다. 현장 점검은 런북대로 허브 재시작 → 준비 확인 → 키오스크 터치 네 모서리.
- **운반 파손:** 약한 곳은 오른쪽 창 띠(13.2 mm)와 위판 슬롯 사이 살, 분할 이음. 상자를 스펀지로 감싸 상자째(박스에 넣어) 운반한다. 패널 유리는 벽보다 3 mm 안쪽이라 평면에 눌릴 때는 보호된다. 보강판을 볼트식으로 바꾸면(우선순위 7번) 현장에서 금 간 이음을 다시 조일 수 있다.
- **1~2 m 시야:** 화면 중심 높이는 책상 위 약 142 mm(계산). 1.5 m 떨어져 선 심사위원 눈은 화면에서 내려다보는 각이 25° 안팎(추정)이고 화면이 20° 위를 향하므로 거의 정면에 가깝다. 사양 시야각 170°. 시연장 조명 반사는 실물로 본다. 글자 크기(설계 20 px ≈ 8.2 mm)는 하드웨어 연결 설계 §0-1 계산을 따른다.
- **기울기 `tilt = 20`**(29줄): 앉아서 터치하기·서서 보기 둘 다 무난한 값이지만 실물로 정한다(README 표 그대로).

## 7. 상자에 들어가는 것 / 들어가지 않는 것

| 들어감 | 들어가지 않음(따로 둠) |
|---|---|
| 15.8형 터치 패널 | **RPi4 실행기** — 가전·갠트리 쪽에 둔다. RPi5와는 Wi-Fi 링크라 이 상자와 선이 없다 |
| RPi5 허브(+ 액티브 쿨러) | **ESP32 모션 보드** — CoreXY 갠트리 쪽, RPi4와 USB |
| DHT22 온습도 센서(앞 아래 칸 — 밖으로 빼는 안 검토, §2) | **ESP32 콘센트 모듈**(CT·릴레이·비상정지 래치) — 가전 전원 쪽. 상용 전원이 지나가므로 이 상자에 넣지 않는다 |
| 상자 안 선(영상·터치·센서) | 전원 어댑터 2개(RPi5·패널 PD), 모터·솔레노이드 전원, 폰 |

정하지 않은 것: 키오스크 쪽 **마이크**(음성 경로 미검증 — 키오스크에 마이크를 붙인다면 자리 필요), 상자에 **실물 정지 버튼**을 둘지(지금 정지는 화면·폰 버튼과 콘센트 모듈 래치). 둘 다 넣기로 하면 앞 턱이나 오른쪽 옆면에 자리를 낸다.

---

## 8. 노트북에서 3D 작업 순서 (체크리스트)

**A. 출력 전 실측 (패널·부품 손에 들고)**

- [ ] 패널 외형 폭·높이·두께(위·아래), 표시 영역의 위·아래·좌·우 테두리 폭 → `screen_up`, 창 위치
- [ ] 패널 포트 종류(영상 단자가 HDMI인지 mini HDMI인지)·위치(옆면 아래에서 몇 mm), 세 플러그의 ㄱ자 몸체 길이 → `plug_room`
- [ ] OSD 버튼 위치·길이, 전원 연결 시 저절로 켜지는지 → 80줄 버튼 구멍
- [ ] 스피커 구멍 위치, VESA 구멍이 커버 없이 쓰이는지·나사 규격 → 누름판
- [ ] RPi5 + 쿨러 + 스탠드오프 높이, 쿨러 바람 방향
- [ ] 산 열 인서트 규격(권장 구멍·길이), 고무발 지름

**B. scad 수정 (위 표 순서)**

- [ ] 1 패널 좌우 멈춤 턱 추가
- [ ] 2 창 = 표시 영역 + 사방 0.5, 바깥 모따기, `screen_up` 실측값
- [ ] 3·4 `side_room` 16, `boss_points` 재배치(분할선에서 15 mm 이상, 뒤판 조각마다 온전한 나사 3개 이상, 패널 폭 밖)
- [ ] 5 센서 칸 뚜껑·선 홈·통풍 슬롯 확장(또는 바깥 주머니)
- [ ] 6 배기 슬롯 앞으로·넓게, 분할선 ±10 mm 비움
- [ ] 7 이음 덧살 + M3 볼트·너트(또는 맞춤 핀)
- [ ] 8 누름판/고리 위치를 모델에 넣기(나사식)
- [ ] 9 바닥 고무발 자리
- [ ] 10 받침 턱 아래 45° 받침살, 위 조각 뒤집기(`rotate([180,0,0])`)
- [ ] 11 인서트 구멍·받침 지름
- [ ] 4줄 주석·README의 '막힌 칸' 표현을 실제 형상에 맞게 고치기, README 조립 3단계(세워 넣기)·4단계(세 가닥)

**C. 확인**

- [ ] `part="assembly"`로 전체 보기, `cutaway`로 안쪽 보기
- [ ] §3-3 간섭 확인 파일로 패널 넣는 길이 비었는지("empty")
- [ ] 조각별 크기가 220 × 220 × 250 안인지(echo), 한 덩어리인지(`Volumes: 2`)
- [ ] STL 10개 다시 뽑기(README 명령), 렌더 사진 갱신

**D. 출력·실물**

- [ ] `fit_test` 먼저 출력 → 실제 패널 대고 창 모서리·받침 턱·플러그 여유 확인 → 숫자 고치고 다시
- [ ] 몸통 4조각 → 뒤판 4조각 → 이음·인서트·패널·RPi5 조립
- [ ] 터치 네 모서리·네 변 좌표, 키오스크 맨 아래 줄 보이는지
- [ ] 상자 닫고 30분·60분: RPi5 온도·스로틀, 상자 안 온도, DHT22 vs 기준 온도계 → [실측 기록표](실측-기록표.md)에 조건과 함께
- [ ] 위쪽 화면 눌러 밀림·넘어짐 확인(고무발 단 뒤)
- [ ] 운반 상자에 넣어 옮겨 본 뒤 이음 점검

확인한 것과 확인하지 않은 것은 devlog에 나눠 적는다. 출력·실물 전에는 '하우징 완료'라고 쓰지 않는다.
