Seongwonp/Simplelay/docs/README.md

# docs — 문서 입구

SimpleLay 설계·시연·실측·제출 문서. 현재 확인 범위는 저장소 [README](../README.md)의 검증 수준 표에서 시작한다.
날짜가 붙은 계획·검토·인계는 작성 당시의 기록이며, 최상위에 있다는 이유만으로 현행 구현이나 배포 완료를 뜻하지 않는다. 날짜별 작업 기록은 [devlog/](devlog/), 지난 인계·폐기 문서는 [archive/](archive/)에 있다.

## 지금 볼 문서 (2026-10-28)

- [제출 시연 영상](https://www.youtube.com/watch?v=duf_ZUxTOUo) — 10/28 제출본. 이후 결선 리허설과 구분한다.
- [복귀 결함·첫 연결 수리 계획](archive/결선전-복귀결함과-첫연결-수리계획-2026-10-28.md) — 누름 뒤 좌표 초기화·복귀 차단·결과 표시의 원인 확인과 최소 수리 순서.
- [모션 진단·단독 누름 작업 기록](devlog/devlog_2026-10-28-motion-diagnostics.md) — 개발자 통신 기록, 좌표 응답 수리, 단독 누름, 다음 장치 점검 순서.
- [공개 점검 기록](공개-점검-2026-10-28.md) — 현재 텍스트의 점검 범위, 빌드 이름 예외와 과거 이력 등 미해결 항목.
- [개발 도구 사용 고지 초안](submission/개발도구-사용-고지-초안.md) — 코드·시험·문서에 사용한 도구와 미확인 사항.

## 처음 볼 문서

| 문서 | 내용 |
| --- | --- |
| [복귀 결함·첫 연결 수리 계획](archive/결선전-복귀결함과-첫연결-수리계획-2026-10-28.md) | 우선 작업: 누름 뒤 좌표·복귀·결과 표시, 첫 연결 안내. 기능 추가 없이 원인 확인 후 수리 |
| [UI 전면 재설계 계획 2026-10-23](archive/UI-전면-재설계-계획-2026-10-23.md) · [키오스크 시안 B](시안/키오스크-시안-2026-10-24.html) | 10/23~24 UI 방향·구현 기록. 현재는 새 개편보다 기존 흐름의 결함 수리가 우선 |
| [코드 구조](코드-구조.md) | 보드별 모듈 지도·안전 계약이 사는 곳·요청 흐름·보드 사이 규약·구조 부채(10/15 기준) |
| [본선 시연 계획 v4](본선-시연-계획-v4.md) | 결선 시연 기준 — 실제 성공한 장면과 검증 대기 장면을 나눠 적음 |
| [결선 전 SW 보완 피드백](결선전-SW-보완-피드백.md) | 결선 전 예외 처리·실물 통합 기록·자동 실행 상태·복구 UX 우선순위 |
| [UI 참고 자료와 적용 기준](UI-참고자료와-적용기준.md) | Material 3·Flutter·W3C·Apple 공식 UI 원칙과 SimpleLay 적용 체크리스트 |
| [UI 제품 앱·공개 레퍼런스](ui-product-app-references.md) | ThinQ·SmartThings·Toss·My Hyundai와 공개 UI·GitHub·Figma·Dribbble 참고 |
| [허브·가전 화면 레퍼런스 2026-10-18](archive/허브-화면-레퍼런스-2026-10-18.md) | 스탠바이미·화면 냉장고·Family Hub·Nest Hub·Echo Show·Apple 홈의 대기 화면·루틴·상태·접근성 조사와 키오스크·폰 바로 적용 목록 |
| [음성 의도 해석 조사 2026-10-19](음성-의도-해석-조사-2026-10-19.md) | 인터넷 없이 본체에서 음성 명령을 닫힌 동작 목록 중 하나·'모름'으로 해석 — 규칙·퍼지·임베딩·소형 LLM 비교, 확인 대화·안전 근거, 권하는 보강(별칭 사전·자모 퍼지 후보)과 시험 문장 20개 |
| [UI 개편안 2026-10-17](archive/UI-개편안-2026-10-17.md) | 당시 쉬운 말·화면 구조 검토. 이후 UI 결정은 10/23~24 계획·기록과 대조 |
| [하드웨어 방향 확정](하드웨어-방향-확정-2026-09-30.md) | 보드 역할·CoreXY·Z 누름·콘센트 모듈 결정과 이후 변경 |
| [재사용 경계](reuse-boundary.md) | 팀원 Touch Bridge에서 가져온 것(갠트리·모션 펌웨어)과 SimpleLay 신규의 경계 |
| [제출 전 검증 과업](archive/제출전-검증-과업.md) | 제출 전에 계획했던 비교·사용성·원가·설치 시간 과업. 실제 수행 여부는 결과 기록으로 확인 |
| [환경 변수](환경변수.md) | 코드가 읽는 `SIMPLELAY_*` 이름·보드·기본·읽는 곳(값은 적지 않음) |

예선·컨설팅 의견별 대응은 [전문가 의견 대응표](전문가의견-대응-2026-09-29.md) — 본문은 9/29 당시 기록이라 머리의 '현재 기준' 표부터 읽는다.

## 시연

| 문서 | 내용 |
| --- | --- |
| [본선 시연 계획 v4](본선-시연-계획-v4.md) | 10/26 개정안과 10/28 확인 범위. 제출 영상과 결선 리허설은 구분 |
| [결선 운영 런북](결선-운영-런북.md) | 결선 당일 설치·리허설·장애 대응·안전 체크리스트 |
| [촬영 대본 — 하드웨어 없이](archive/촬영-대본-2026-10-20-하드웨어-없이.md) | 10/20 당시 촬영안이며 최종 제출 영상 자체를 뜻하지 않음 |
| [하드웨어 복귀 날 절차](archive/하드웨어-복귀-날-절차.md) | 과거 펌웨어·환경 복원 절차 포함. 현재 원본·어댑터를 확인하고 10/28 수리 계획을 먼저 적용 |
| [촬영 대본 — 실물 장면](archive/촬영-대본-실물-장면.md) | 갈래 A(10/28 영상, CT 없음: 승인→누름→누름 장치 확인, 공기청정기는 따로) · 갈래 B(11/6 결선, CT 있으면: 승인→누름→CT→공기청정기) 원테이크, '연습 띠 없음'·기록 화면 동시 촬영 |
| [질의응답 대비](질의응답-대비.md) | 심사위원이 반드시 물을 질문(실물 성공 장면·재사용과 새로 만든 하드웨어·버튼 로봇·ThinQ ON·가열 종료 오판·빈 가열·정밀도·당사자 시험과 원가·설치 시간)의 1분 답변과 하면 안 되는 말 |
| [브라우저 시뮬레이터 실행](브라우저-시뮬레이터-실행.md) | 하드웨어 없이 노트북에서 모의 실행 |
| [장애 복구 결과표](장애-복구-결과표.md) | 끊김·재시작·정지 상황별 결과(모의) |
| [시연 v3 구현 갭](archive/시연-v3-구현-갭.md) | v3 기준으로 적은 남은 구현(기록, v3 본문은 [archive](archive/본선-시연-시나리오-v3.md)) |
| [A/B 비교 실험](AB-비교-실험.md) · [사용자 의견 계획](archive/사용자-의견-계획.md) | 비교 실험 설계 원본·개인정보 원칙과 동의서(제출 전 최소 과업은 [제출 전 검증 과업](archive/제출전-검증-과업.md)) |

## 하드웨어·실측

| 문서 | 내용 |
| --- | --- |
| [하드웨어 연결 설계](하드웨어-연결-설계.md) | 모션 어댑터 계약·센서 캡처·정지 명칭·수령 직후 검증 순서 |
| [protocol.md](protocol.md) | RPi5↔RPi4 줄 단위 JSON 규약·링크 인증 |
| [actuator-design.md](actuator-design.md) · [FIT0482 사양](FIT0482-사용자제공-사양.md) · [JMOD-MOTOR-1 제어 검토](JMOD-MOTOR-1-제어-검토.md) | 구동부(CoreXY) 기구·모터·드라이버 |
| [closed-loop-design.md](closed-loop-design.md) · [sensor-spec.md](sensor-spec.md) | 폐루프 확인(L1~L3) 설계·센서 명세 |
| [정지 확인 계획](archive/계획-정지-확인-2026-10-12.md) | 정지 단계(보냄·모션 보드 확인·멈춤 확인) |
| [실측 계획](archive/실측-계획-결선.md) · [실측 기록표](실측-기록표.md) | 결선 전 실측 항목과 기록 양식(CT 조리 판정 §6 포함) |
| [솔레노이드 안전 전달표](archive/솔레노이드-안전-전달표-2026-10-16.md) | HW 담당용: 코드 확인 사실·전원 투입 전 확인·미측정 기록 칸 |
| [콘센트 모듈 제작 안내](콘센트-모듈-제작-안내.md) | HW 담당용: 벽 콘센트 → 자른 1구 연장선 → 닫힌 상자(퓨즈·릴레이·CT 한 가닥·래치 비상정지·절연 5 V) → 상자 콘센트, 펌웨어 핀 대응·글 배선도·전등부터 시험·부품 표(10/28 뒤 결선 목표) |
| [전력버짓](전력버짓.md) | 전력 예산 |
| [하우징 검토](archive/하우징-검토-2026-10-18.md) | 과거 하우징 검토·모델([housing/](../housing/README.md)). 10/26 결정은 별도 하우징을 제작하지 않고 거치대 뒤에 보드를 부착하는 방식 |
| [button-maps/](button-maps/) | 가전별 버튼 격자(코드·시험이 읽음) |

## ThinQ

| 문서 | 내용 |
| --- | --- |
| [ThinQ 실물 확인 절차](ThinQ-실물-확인-절차.md) | 최초 노트북 확인과 이후 RPi5 기록을 구분. 실제 계정·기기 식별값은 저장소 밖 보관 |
| [키오스크 문구·화면 개선 계획](archive/키오스크-문구-개선-계획-2026-10-15.md) | 처음 쓰는 사람 검토 두 건 → 원칙·용어표·화면별 변경·열린 문제 R1(두 번 눌림). 구현 기록은 devlog 10/15 kiosk-wording |
| [안전 계약 적용 보고](안전계약-적용-보고-2026-10-15.md) | Touch Bridge 안전 계약 3종을 SimpleLay에 대 본 결과 — 빈칸 G1~G11, 공통 실물 정지 시험 PS-1, 재사용 경계 정정 제안 |
| [ThinQ 연동 검토](ThinQ-연동-검토-2026-09-22.md) · [U1-a 명령·결과·승인 계약](ThinQ-U1a-명령-결과-승인-계약-2026-09-22.md) | 연동 범위 검토와 명령 계약(9/22, 코드 주석이 근거로 인용) |

## 설계·화면

| 문서 | 내용 |
| --- | --- |
| [architecture.md](architecture.md) · [inference-boundary.md](inference-boundary.md) | 보드 책임과 추론 경계. 실제 어댑터·배포 판은 현재 설정과 대조하며 10/19 설계를 현장 완료 증거로 사용하지 않음 |
| [개발현황](개발현황.md) | 9/29 기준 기능 현황·환경 변수 기록(현재 기준 아님 — 검증 수준은 README 표) |
| [UI 확정](archive/UI-확정-2026-09-30.md) · [design-system.md](design-system.md) · [용어와 화면 문구](용어와-화면문구.md) | 이전 기준 포함. 10/23 재설계 승인과 충돌하면 이후 결정 우선. 말투는 [10/22 적용안](archive/한국어-UI-말투-조사와-적용안-2026-10-22.md) 참고 |
| [사용자 편의 가이드 체크리스트](사용자편의-가이드-체크리스트.md) | 접근성 기준(국가표준 매핑) |
| [앱 개선 백로그](archive/앱-개선-백로그.md) · [roadmap.md](roadmap.md) | 화면별 백로그·마일스톤 |
| [본선 실행 계획](archive/본선-실행계획-2026-09-30.md) | 결선 공식 일정(§0)·지도교수 미팅·배점 안내 |
| [design/](design/brand/README.md) · [ui-review/](ui-review/2026-10-12/README.md) | 브랜드 자산·UI 시안, 10/12 화면 지적 대응 캡처 |

## 제출 자료 (10/28 제출 완료 — 사용자 보고)

| 문서 | 내용 |
| --- | --- |
| [제출 체크리스트](submission/제출-체크리스트.md) | 제출물·마감·확인 항목 |
| [개발완료보고서 초안](submission/개발완료보고서-초안.md) · [작품소개서 초안](submission/작품소개서-초안.md) | 저장소의 작성용 초안. 저장소 밖 최종 제출 파일과 동일하다고 가정하지 않음 |
| [개발 도구 사용 고지 초안](submission/개발도구-사용-고지-초안.md) | AI 코딩 도구 사용 범위 고지 문안·사무국 질문 목록(규정 확인 뒤 확정) |
| [그림 대응표](submission/그림-대응표.md) · [피드백 전후](submission/피드백-전후.md) | 보고서 그림 근거·심사 의견 반영 전후 |
| [활용성 숫자 기록지](submission/활용성-숫자-기록지.md) | 원가 BOM·설치 시간·팀 밖 사용성 점검을 현장에서 채우는 빈 기록지(방법은 [제출 전 검증 과업](archive/제출전-검증-과업.md)) |
| [가산점 증거 대장](가산점-증거-대장.md) | 가산점 항목별 증거와 미측정 칸 |

## 작업 기록과 보관

- [devlog/](devlog/) — 날짜별 작업 기록 `devlog_YYYY-MM-DD*.md`. 무엇을 바꿨고 무엇을 어떤 수준으로 확인했는지(수정 전 실패 확인·시험 수·실물 여부)가 여기 있다. 10/27 노트북 인계는 [인계 문서](archive/인계-2026-10-27-노트북.md), 10/28 이후 우선 작업은 [복귀·연결 수리 계획](archive/결선전-복귀결함과-첫연결-수리계획-2026-10-28.md)을 따른다.
- [archive/](archive/) — 지난 인계, 폐기된 시연 시나리오(v1~v3), 이미 반영한 옛 평가·계획, 개편 전 캡처. 2026-10-13 정리 때 삭제하지 않고 `git mv`로 옮겼다(이력은 `git log --follow`). 현행 기준으로 읽지 않는다.
