Seongwonp/Simplelay/docs/ui-review/2026-10-12/README.md

# 실제 화면 캡처 — 2026-10-12 밤 (UI 지적 대응용)

"폰 UI가 AI 같다", "쓰기 불편하다"는 지적에 대응하려고, **고치기 전** 화면을 실제 기기 구성에서 캡처했다.

- 폰: 안드로이드 에뮬레이터, 앱 `bd09528`+`534558a` 빌드
- 연결: 실제 RPi5 백엔드(`3d26afc`), RPi4는 Wi-Fi 연결
- 키오스크: RPi5 실패널 화면 캡처
- 데이터: 그동안 시험하며 쌓인 가전·기록 그대로다. 가전 이름은 시험용이고 개인정보는 없다.
- 가린 곳: 설정 화면의 외부 가전 서비스 연결 줄은 저장소 규칙에 따라 회색으로 가렸다.

| 파일 | 화면 |
|---|---|
| p01-home / p02-home-bottom | 홈(위·아래) |
| p03-routines / p08-routines-suggest | 루틴(내 루틴·추천) |
| p09-routine-detail | 루틴 편집(아침 데우기) |
| p04-history | 기록 |
| p05-settings / p06-settings-bottom | 설정(위·아래) |
| p07-appliance-detail | 가전 상세(전자레인지) |
| p10-add-appliance | 가전 추가 1단계 |
| p11-voice | 음성 명령 |
| k01-idle | 키오스크 평소 화면 |

## 캡처를 보며 찾은 것 (근거가 화면에 있는 것만)

**바로 고칠 결함 (문구·노출)**

1. **내부 코드명이 사용자에게 보인다.** 루틴 목록에 `가전 알림 'wash_complete'이 오면`이 나온다(p03). 사람의 말로 바꾼다. 예: "세탁이 끝나면".
2. **시스템 용어가 그대로 보인다.** 기록에 "실행 환경 미확인", "확인 근거 없음", "모의 실행기 응답", "물리 버튼"이 나온다(p04). 사용자가 알 말로 바꾼다. 예: "눌렀는지 확인 못 했어요". 모의라는 표시는 유지하되 짧게 쓴다.
3. **기록의 같은 실패가 두 줄로 반복된다**(p04 오늘 21:28 두 건). 같은 일인지 확인하고, 반복이면 묶는다.

**구조 (AI 같다, 불편하다)**

4. **홈 첫 자리를 설정 독촉 카드가 차지한다**(p01). "설정이 남은 가전 5개 … 외 2개"가 크게 있고, 매일 쓰는 것(루틴 실행)은 홈에 없다. 홈 첫 자리에는 오늘 할 일(루틴·제안·지금 실행)을 둔다.
5. **"지금 확인할 제안이 없어요."가 맨 위 문장이다**(p01). 빈 상태를 첫 줄에 말하지 않는다.
6. **같은 모양의 타일이 반복된다**(p01 가전 7개가 같은 크기의 흰 카드). 위계가 없어 "템플릿처럼" 보인다. 자주 쓰는 가전이나 지금 동작 중인 가전에 위계를 준다.
7. **설정에 가전 목록이 두 번 나온다**(p05 "내 가전", p06 "가전마다 버튼을 눌러 줄 장치"). 한 목록으로 합치고 장치 연결은 가전 안으로 옮긴다.
8. **루틴 편집이 폼처럼 보인다**(p09). 언제·무엇을·그다음 칩과 긴 안내문, "단계나 실행 방식을 바꾸면 … 다시 확인해야 해요" 같은 시스템 문장이 있다. 문장을 한 줄로 줄이고, 지금 실행과 저장의 위계를 정리한다.
9. **가전 추가 1단계의 설명이 길다**(p10, 3줄). 사진 찍기 버튼 하나와 짧은 한 줄이면 된다. 칩 7개(전자레인지·에어컨…)는 사진을 찍은 뒤에 고르게 해도 된다.

**데이터 (코드가 아님, 캡처·시연 전에 정리)**

10. 전자레인지가 4개("전자레인지" ×2, "Phone-MW", "시험용 전자레인지")다(p01·k01). 시연용 데이터로 정리한다. 예: 주방 전자레인지, 세탁기, 인터폰.
11. 하단 탭에 **개발자** 탭이 보인다(p01). 시연이나 캡처 때는 끈다.

**잘 된 것 (유지)**

- 음성 명령 화면(p11)은 한 가지 일만 하고 예시가 짧다. 이 정도 밀도가 기준이다.
- 키오스크 평소 화면(k01)은 시계·날씨·가전만 있어 여백이 충분하다. 가전 이름이 잘리는 점("시험용 전자레…")은 데이터 정리(10)로 대부분 해결된다.

## 다음

[10/13 노트북 인계](../../archive/인계-2026-10-13-노트북.md) B절의 순서를 따른다. 1~3을 먼저 고치고(문구), 4~9는 하나씩 캡처 전후를 남기며 고친다.
