Seongwonp/Simplelay/docs/결선-운영-런북.md

# 결선 운영 런북 — 11/6 본선과 모든 리허설용

2026-10-28 운영 안내 갱신. 장면·대사는 [본선 시연 계획 v4](본선-시연-계획-v4.md), 복귀 결함과 설치 동선 수리는 [10/28 계획](archive/결선전-복귀결함과-첫연결-수리계획-2026-10-28.md)을 먼저 따른다. 아래 날짜별 측정과 과거 설치 절차는 현재 보드 구성·원본과 대조한다.

- **주 시연:** 사람 감지·음성 요청과 확인·실제 공기청정기 결과·습관 근거·맡기기·끄기를 중심으로 한다. 실제 버튼 누름은 복귀 수리와 리허설 통과 후 선택한다. 과거 CT 가열 종료 → 공기청정기 흐름을 현행 필수 장면으로 사용하지 않는다.
- **공기청정기 켜기 제안:** 사용자의 말에서 만든 제안과 센서 판독으로 만든 제안을 구분한다. 전자는 제출 영상에 포함됐고, 센서 판독은 클라우드 반영과 허브 판독 주기 때문에 지연될 수 있다([10/15 기록](devlog/devlog_2026-10-15-air-off-power.md) §0). 두 경로의 시간을 같은 수치로 설명하지 않는다.
- **일정:** [본선 실행 계획](archive/본선-실행계획-2026-09-30.md) §0. 서류 제출 10/28 14:00, 발표 11/6.
- **배포:** 작업 규칙과 [10/27 인계](archive/인계-2026-10-27-노트북.md)를 확인하고 RPi5·RPi4·폰·키오스크의 실제 설치 SHA를 각각 기록한다. 모션 보드 원본·프로토콜은 HW 담당에게 확인한다. 과거 기록을 근거로 임의의 펌웨어를 다시 올리거나 좌표·환경 설정을 덮어쓰지 않는다. HW 코드 변경·업로드는 HW 담당 범위다.
- **영상·제출:** 촬영 목록 §9, [제출 체크리스트](submission/제출-체크리스트.md). 서류 초안 본문은 별도 갱신 작업이다.

**검증 수준:** ThinQ는 노트북 최초 확인 이후 RPi5 실물 기록도 있다. 키오스크 역시 패널 설치 기록이 있으나 모든 실패·큰 글씨·접근성 상태를 실기기에서 확인한 것은 아니다. 현재 누름 뒤 복귀 결함과 CT 미검증이 남으며 [README 검증 표](../README.md#6-무엇이-실물이고-무엇이-아직인가)를 기준으로 확인한다. 과거 모터 축 응답 시간을 현재 기구의 정지 성능으로 사용하지 않는다.

**【HW 확인 필요】** 현재 누름 작동기는 SwitchBot Bot이며 원본 어댑터는 `touchbridge-v2`다. 누름·복귀·현재 기구 정지, CT 콘센트 모듈 회로·릴레이·비상정지의 실물 확인을 구분한다. [솔레노이드 안전 전달표](archive/솔레노이드-안전-전달표-2026-10-16.md)는 해당 작동기를 사용하는 경우의 참고 자료다.
**【미확인】** 표시는 코드는 있지만 실기기에서 아직 해 보지 않은 절차다.

---

## 0. 당일 시간표 (11/6 금, DMC타워 3층, B조)

| 시각 | 할 일 |
|---|---|
| 14:40 | 도착하고 출석 서명(설치 10분 전) |
| 14:50~15:20 | **설치 30분** — §3 체크리스트 |
| 15:20~15:40 | 대기. 5분 간격으로 §3-8 "직전 확인"을 다시 본다. 전원은 켜 둔다 |
| **15:40~16:00** | **평가** — 시연·발표 10분과 질의 10분 |
| 16:00~ | §7 철수 |

책상은 150×55cm 두 개다. v4 §6 기준으로 전자레인지·갠트리·콘센트 모듈·키오스크와 실제 공기청정기·폰 미러링 자리를 나누고 치수를 확인한다.

---

## 1. 챙길 것

### 1-1. 장비 목록

| 분류 | 항목 | 수량 | 비고 |
|---|---|---|---|
| 보드 | RPi5(서버·키오스크) | 1 | SD 카드 장착, 기기 env 파일 확인 |
| 보드 | RPi4(실행기, 안내문 예시의 RPi Zero 자리 — 확정) | 1 | SD 카드 장착 |
| 보드 | ESP32(콘센트 모듈: CT·릴레이·비상 버튼) | 1 | 【HW 대기】 펌웨어 컴파일까지, 플래시·회로 조립 전. 절연 케이스 |
| 센서 | 분할형 CT | 2 | 【HW 대기】 1개 보유, **2개째 구매 중**. 전자레인지(채널 0, 릴레이 뒤)와 세탁기(채널 1, 릴레이 없음)를 동시에 재기 위한 것. ch0 전자레인지·ch1 세탁기. 2채널 펌웨어는 컴파일·가짜 모듈 시험까지 확인했고 배선·보정은 미검증(§8 #3) |
| 센서 | 비상정지 버튼(NC 접점 가정) | 1 + 예비 | 【HW 대기】 발표자 손 닿는 곳(§1-3) |
| 보드 | ESP32 모션 보드 | 1 | 콘센트 모듈 보드와 별개. SimpleLay 모션 펌웨어·배선 라벨 확인 |
| 보드 전원 | RPi5 전용 USB-C 어댑터, RPi4 USB-C 어댑터 | 각 1 + 예비 1 | 저전력 경고가 나지 않는 정격으로 |
| 패널 | 15.8형 키오스크 패널 | 1 | 받침대 포함 |
| 패널 케이블 | **micro-HDMI ↔ HDMI**(RPi5 쪽은 micro-HDMI다) | 1 + 예비 1 | 영상과 음성 |
| 패널 케이블 | **USB-C 데이터 케이블**(패널 Type-C 데이터 포트 ↔ RPi5 USB) | 1 + 예비 1 | **터치가 이 선으로 간다. HDMI만 꽂으면 터치가 안 된다** |
| 패널 케이블 | **USB-C PD 어댑터와 케이블**(패널 전원) | 1 | 사양 8.5 W |
| 네트워크 | 전용 공유기(시연장 Wi-Fi를 믿지 않는다) | 1 | 미리 설정해 둔 것(§2) |
| 네트워크 | LAN 케이블 1~2 m | 4 | RPi5·RPi4·운영 노트북, 예비 1 |
| 네트워크 | 인터넷 회선(휴대폰 테더링 등) | 1 | v4 실제 ThinQ 제어와 날씨에 필요. 없으면 ThinQ는 명시한 모의 클라우드/녹화 영상으로 전환 |
| 전원 | 멀티탭(개별 스위치, 3 m 이상) | 2 | 가전 1, 보드 1로 나눈다. **갠트리 전원은 개별 스위치에** — 모션 이상 때 끄는 마지막 수단(§5-4) |
| 전원 | 연장선(3 m 이상) | 2 | 책상 두 개에 걸친 배치와 시연장 콘센트 위치가 미확인이라 넉넉히. 전자레인지는 연장선 정격을 확인한다 |
| 전원 | 갠트리 어댑터 | 1 + 예비 | 실제 모터·솔레노이드·드라이버 정격과 전원 구성을 HW 담당이 확인. 미확인 전압을 고정하지 않음 |
| 기구 | CoreXY 갠트리, Z 누름 장치 | 1 | 【HW 대기】 전자레인지용 1대를 먼저 마무리한다(10/6 결정). 운반 중 벨트 장력을 확인한다 |
| 가전 | 전자레인지(중고, 고정해 둔 것) | 1 | 햇반 실제 가열은 **§3-7 체크리스트를 모두 통과한 경우에만** 한다. 플러그는 콘센트 모듈(CT·릴레이)을 거친다. 안전 체크리스트 §3-7 |
| 가전 | 공기청정기 | 1 | v4 주 시연. 출발 전 켜짐·약풍 및 실제 클라우드 상태 확인 |
| 가전 | 인터폰·세탁기 조작부 모형 | 선택 | 보조 시연에만 사용. 모형·주입 표시, 주 시연 필수 아님 |
| 소모품 | 햇반 | 리허설 횟수 + 본선 2 + 예비 2 | 한 번 데운 것은 다시 쓰지 않는다. 포장 표기 시간을 확인해 둔다 |
| 소모품 | 내열 물컵 | 2 | 햇반 없이 리허설할 때 **빈 상태 가열을 막는 부하**. 물을 채워 넣는다 |
| 소모품 | 행주·키친타월, 내열 장갑 | 각 1 | 데운 햇반과 물컵을 꺼낼 때 |
| 고정 | 강력 양면테이프, 케이블 타이, 절연 테이프, 멀티 드라이버 | — | 지도교수 지적: 프레임이 흔들리면 기기가 넘어진다 |
| 노트북 | 운영 노트북(충전기 포함) | 1 | 상태 확인·SSH·백업 영상·독립 모의 서버. 모의 사건으로 실가전을 제어하지 않음 |
| 폰 | 시연 폰(릴리스 APK, 충전 100%) + 미러링 수단 | 1 | 개발자 모드 탭이 안 보이는지 확인 |
| 예비 | **SD 카드 예비 이미지**(RPi5용, RPi4용 각각) | 각 1 | §1-2 |
| 예비 | 백업 영상 파일(노트북 로컬과 USB 메모리) | 2부 | 시연 영상 URL과 같은 것 |
| 예비 | 인쇄물: 런북 §3·§4·§5, v4 §1·§8 | 1 | 최신 대사와 검증 수준으로 준비 |

### 1-2. 예비 SD 이미지

- 본선 1주 전(10/30 전후) 리허설을 통과한 상태로 RPi5·RPi4 SD 카드를 통째로 복제한다. 라벨에 날짜와 커밋을 적는다.
- 기기 env 파일(API 키 등 비밀)이 이미지에 들어 있다. **예비 SD는 저장소나 공용 저장소에 올리지 않는다.**
- 복제한 카드로 한 번 부팅해 §3-2~§3-4를 통과하는지 확인한다. 확인하지 않은 예비는 예비가 아니다.

### 1-3. 무대 배치 (150×55cm ×2)

리허설 때 실측해 이 칸에 그림을 붙인다. 【리허설 때 기입】

v4 §6 기준: 책상 1은 전자레인지·갠트리·콘센트 모듈·키오스크, 다른 자리는 공기청정기와 폰 미러링. 보조 모형은 주 시연 동선을 가리지 않게 둔다.

- 키오스크 패널은 관객 쪽으로 세운다. 패널 가장자리에 손이 닿지 않게 둔다(§5-1).
- 갠트리는 관객 쪽 3/4 각도로 둔다. Z 누름이 옆에서 보이게 한다.
- 콘센트 모듈 비상 버튼은 발표자 손이 닿는 곳에 둔다. 【HW 대기】 회로 미조립.
- 콘센트 모듈 릴레이 뒤에는 **전자레인지 플러그만** 둔다. 세탁기는 CT만 통과시키고 릴레이 뒤에 두지 않는다(10/6 결정 — 무대에서는 세탁기를 돌리지 않으므로 세탁기 CT 배선은 실측 때만).
- 전자레인지 주변(특히 환기구 쪽)에 케이블·종이를 두지 않는다. 문 앞에 햇반을 꺼낼 자리를 비워 둔다.
- 조작부 모형에는 "모형" 표시를 붙인다. 실제 공기청정기는 v4 ②③에서 쓴다. RPi5·대회장 인터넷 조건에서 확인 전에는 실물 장면 완료로 쓰지 않는다.

---

## 2. 네트워크 계획

시연장 Wi-Fi는 쓰지 않는다. 전용 공유기 하나에 모든 것을 붙이고 **고정 IP**를 준다. 공유기의 DHCP 예약으로 고정한다.

| 장치 | 연결 | 주소(예시 — 실제 값은 공유기 설정과 기기 env에만) | 쓰는 포트 |
|---|---|---|---|
| 전용 공유기 | — | `<GW>` (예: 192.168.50.1) | — |
| RPi5 | LAN | `<RPi5>` (예: .10) | 8000(백엔드) |
| RPi4 | Wi-Fi 또는 검증된 LAN | `<RPi4>` (예: .11) | 7000(실행기 링크, 허용 주소 제한) |
| 운영 노트북 | LAN | `<OPS>` (예: .20) | — |
| 시연 폰 | Wi-Fi | `<PHONE>` (예: .30) | — |
| ESP32 콘센트 모듈 | **RPi4 USB 시리얼**(네트워크 아님) | — | RPi4 env `SIMPLELAY_OUTLET_PORT`·`_BAUD`. 【HW 대기】 |

- **주소를 바꾸면 네 곳을 확인한다:** RPi5 링크 주소, RPi4 `SIMPLELAY_LINK_ALLOW_FROM`, 폰 허브 주소, 짝짓기 주소.
  1. RPi5 env의 `SIMPLELAY_UART_PORT=socket://<RPi4>:7000`(LAN 배선일 때만)
  2. 폰 허브 주소
  3. 여러 네트워크에 붙은 허브라면 `SIMPLELAY_PAIR_HOST=http://<RPi5>:8000`
- 집에서 쓰는 주소와 시연 주소가 다르면 리허설 한 번을 반드시 시연 주소로 한다.
- 현재 운영 경로는 RPi5↔RPi4 네트워크 링크다. 문서의 UART는 프로토콜 명칭이며 GPIO 직결 배포를 전제로 하지 않는다.
- 공유기 SSID와 비밀번호는 시연용으로 새로 만든다. 다른 사람의 단말이 붙지 않게 한다. `SIMPLELAY_ALLOW_UNAUTHENTICATED=1`은 시연에서 **절대 쓰지 않는다**(인증 정책).
- 실제 ThinQ에는 인터넷이 필요하다. PAT는 설치 때 허브의 저장소 밖 파일에 두고, 파일 경로·권한·컨테이너 전달과 시각 동기화를 확인한다. 인터넷이 없으면 로컬 폰↔허브 통신과 별개로 ThinQ가 실패할 수 있으므로 v4 §7 백업으로 전환한다.

---

## 3. 설치 30분 체크리스트 (순서대로)

운영 노트북에서 상태를 확인한다. 기기 셸에는 `curl`이 없을 수 있다(BusyBox). PowerShell 예시는 이렇다.

```powershell
$B = "http://<RPi5>:8000"; $H = @{ "X-API-Key" = "<키 — 기기 env에서 읽음, 문서에 적지 않음>" }
Invoke-RestMethod "$B/health/detail" -Headers $H   # 공개 /health는 ok·version만(2026-10-14)
```

### 3-1. 배치와 전원 (0~8분)

- [ ] 책상 두 개를 배치하고 가전·갠트리·패널을 고정한다(양면테이프).
- [ ] 멀티탭을 나눈다(가전용, 보드·패널용).
- [ ] 공유기 전원을 켜고, LAN을 RPi5·RPi4·노트북에 꽂는다.
- [ ] 패널 케이블 세 개를 꽂는다: micro-HDMI(영상), **USB-C 데이터(터치)**, PD(전원).
- [ ] RPi4 → RPi5 순서로 전원을 넣는다(§3-4 참고).

### 3-2. RPi5 백엔드 (8~12분)

RPi5는 전원만 넣으면 백엔드 컨테이너가 뜬다(`--restart always` — 10/18 아침 손으로 `docker stop` 해 둔 컨테이너가 재부팅 뒤 안 떠 키오스크가 안 나온 일 뒤로 always로 바꿈. 보드를 끌 때는 컨테이너를 멈추지 말고 `sync; poweroff`만).

- [ ] `GET /health/detail`(키 필요)에서 `ok: true`를 본다. `act_mode`는 등급별로 다르다.
  - 실물·부분 실물: `uart`
  - 전부 모의: 시뮬레이터 서버
- [ ] `GET /status`에서 `developer_mode: false`를 본다(시연 날 기본값, 실행계획 §3-8).
- [ ] 응답이 없으면 운영 노트북에서 SSH로 `docker ps`와 `docker logs --tail 50 simplelay-backend`를 본다.
  - 기동 로그의 "API 인증: …" 줄로 키가 설정됐는지 확인한다.
  - `qrcode` import 실패면 이미지가 낡은 것이다(`3528fc9` 이전). 이미지를 다시 만든다.
- [ ] **페이싱을 확인한다.** `deploy/run_backend.sh`는 이제 기기 env 파일(`/mnt/rawdata/simplelay/env`)의 `SIMPLELAY_DEMO_PACING`을 따르고, 없으면 **꺼짐**이다(2026-10-06 갭 S9). 스크립트 끝의 `== 시연 페이싱: on|off ==` 줄로 확인한다.
  - 실물·부분 실물: 페이싱은 꺼짐. 실제 가열 시간·CT 판정 지연은 실측 기준으로 대본에 반영한다.
  - 전부 모의 리허설(보드 백엔드로 모의 실행): RPi5에서 `echo 'SIMPLELAY_DEMO_PACING=1' >> /mnt/rawdata/simplelay/env` → `sh run_backend.sh`. 끝나면 그 줄을 지우고(`sed -i '/^SIMPLELAY_DEMO_PACING=/d' /mnt/rawdata/simplelay/env`) 다시 `sh run_backend.sh`. 버튼 사이 쉼은 `SIMPLELAY_DEMO_PACING_SECONDS`(기본 1.2).
  - 노트북 시뮬레이터(`rpi.simulator_main`)는 이 스크립트와 무관하다 — 셸에서 `SIMPLELAY_DEMO_PACING=1`을 직접 준다.
- [ ] **하루에 묻는 횟수 상한을 끈다(10/26 사용자 결정).** 상한(기본 3)이 켜져 있으면 시연 전에 이미 물은 카드 때문에 시연 카드가 안 뜰 수 있다. RPi5 env에 `SIMPLELAY_DAILY_ASK_LIMIT=off` 한 줄(백업 뒤) → `sh run_backend.sh`. 시연이 끝나면 줄을 지우고 다시 실행.

### 3-3. 키오스크 앱 (12~15분)

- [ ] 부팅 뒤 15초 안팎에 키오스크가 패널에 뜨는지 본다. 감시 컨테이너(`deploy/run_kiosk_watchdog.sh`)가 플랫폼 앱 관리자에게 상태를 묻고, 꺼져 있으면 시작한다.
- [ ] 뜨지 않으면 다음 순서로 원격 시작한다.
  1. 운영 노트북에서 RPi5에 SSH로 들어간다.
  2. 감시 로그를 본다: `docker logs --tail 20 simplelay-kiosk-watchdog`.
  3. 앱 관리자 호출이 실패하면 감시 컨테이너를 다시 시작한다: `docker restart simplelay-kiosk-watchdog`.
  4. 그래도 안 되면 플랫폼 앱 관리자의 시작 명령을 직접 보낸다. 명령과 앱 ID는 **비공개 로컬 메모**에 있다. 저장소에는 없다.
- [ ] 빌드 산출물과 실제 설치된 키오스크의 SHA·버전이 일치하는지 확인한다. 과거 설치 기록만으로 현재 변경까지 배포됐다고 판단하지 않는다.
- [ ] 화면 위쪽에 실행 환경 표시가 보이는지 확인한다. 모의면 "모의 실행 · 실제 조작 아님"이 보여야 한다. 모의 표시를 가리지 않는다.
- [ ] 터치를 확인한다. 화면 가운데 버튼 하나를 누른다. 반응이 없으면 USB-C 데이터 선부터 본다.
- [ ] 연결 아이콘 세 개(와이파이, 누름 장치, 플러그)의 상태를 본다. 콘센트 모듈이 없으면 플러그는 "설치 안 됨"이 정상이다. 【HW 대기】
- [ ] 화면 위쪽에 **비상정지 띠가 없는지** 본다. 있으면 §3-7의 래치 해제부터 한다.

### 3-4. RPi4 실행기와 RPi5→RPi4 연결 (15~19분)

- [ ] **RPi4는 루트 파일시스템이 읽기 전용이다.** 그래서 도커 자동 기동을 설정할 수 없다. 부팅 뒤 SSH로 `systemctl start docker`를 먼저 하고, `docker ps`에서 `simplelay-act`가 `Up`인지 본다.
  - 없으면 `sh <데이터 경로>/run_act.sh`를 실행한다(`deploy/run_act.sh`. LAN 배선이 기본이고, UART 선이면 `LINK=uart`).
- [ ] RPi5를 RPi4보다 먼저 띄웠다면 RPi4 연결이 엇갈릴 수 있다. 이때는 `simplelay-act`가 스스로 재시작한 뒤 RPi5 쪽 `docker restart simplelay-backend`를 한 번 더 한다(LAN 배포 로그 §3).
- [ ] **연결을 확인한다.**
  1. `GET /connections`의 누름 장치 항목이 정상(회색)인지 본다.
  2. `docker logs --tail 20 simplelay-act`에 연결 로그가 있는지 본다.
- [ ] **전부 모의·LAN 모의 모션:** 안전한 시험 가전으로 `POST /execute`를 한 번 한다.
  - `/status`가 `succeeded / success / mock / physical / reported`면 통과다(9/30 실기기 확인 형태).
- [ ] **부분 실물:** 【HW 대기】 실행 전에 확인할 것이 있다.
  - RPi4 env에 `SIMPLELAY_MOTION_MODE=serial`과 `SIMPLELAY_MOTION_PORT`가 있는지 본다.
  - **`SIMPLELAY_MOTION_PORT`는 `/dev/serial/by-id/usb-…-if00` 경로로 쓴다**(`ls -l /dev/serial/by-id/`로 ESP32 줄을 찾는다). `/dev/ttyACM0`처럼 쓰면 모터 전원을 넣을 때 저전압으로 USB가 다시 잡혀 `ttyACM1`이 되고, 실행기가 사라진 포트를 붙잡는다(10/13 보드 날 발견 1). 실행기는 끊긴 포트를 닫고 **같은 설정 경로로** 다시 열기 때문에(10/14), by-id여야 다시 붙는다. 시작 로그에 by-id 경고가 나오면 env를 고친다.
  - RPi4 전원(5 V 3 A)과 모터 전원이 분리돼 있는지 본다. 모터 배터리를 꽂을 때 `dmesg`에 `Undervoltage detected`가 나오면 전원부터 고친다.
  - 기구 값 `SIMPLELAY_MOTION_*`이 있는지 본다. 없으면 누름을 거절한다(시끄러운 실패).
  - 원점 복귀를 확인한다.
  - 원시 기록기 `SIMPLELAY_RECORDER_PATH`에 파일이 생기는지 본다.
- [ ] **콘센트 모듈(실물 등급):** 【HW 대기】 RPi4 env `SIMPLELAY_L3_MODE=real`·`SIMPLELAY_OUTLET_PORT`가 있는지, `docker logs`에 콘센트 `ready`가 있는지 본다. 릴레이 부팅 기본은 꺼짐이다 — `SIMPLELAY_OUTLET_RELAY_ON_START=1`이 아니면 사람이 켜고, **전자레인지 표시창이 켜졌는지 눈으로** 본다(콘센트 모듈 절차는 실제 배선 확인 후 진행).
- [ ] `GET /status`의 `estop_latched`가 `false`인지 본다. `null`이면 실행기가 래치를 보고하지 않는 것이다(옛 코드 — 재배포). `true`면 §3-7.

### 3-5. 폰 (19~22분)

- [ ] 릴리스 APK인지, 폰 "데모 모드"가 꺼졌는지 확인한다(실제 APK와 서버 모드를 함께 확인).
- [ ] 허브 연결과 API 키를 확인한다. 둘 중 한 방법을 쓴다.
  - **짝짓기:** 키오스크 설정 → 폰 연결하기. 5분짜리 6자리 코드와 QR이 뜬다. 폰 설정 → 허브 → 코드로 폰 연결하기 → 키오스크에서 승인한다. 【미확인】 QR 카메라 인식과 두 기기 LAN 연결은 실기기에서 확인하지 않았다.
  - **직접 입력:** 폰 설정 → 허브에서 주소 `http://<RPi5>:8000`과 키를 넣는다. 9/30 에뮬레이터에서 확인한 방법이다.
- [ ] 홈 상단 칩이 "허브 연결됨"이고 연결 경고가 없는지 본다. 401이면 키가 다른 것이다.
- [ ] 개발자 탭이 보이지 않는지 본다(`developer_mode: false`).

### 3-6. 등록 가전과 루틴 (22~24분)

v4는 실제 등록된 전자레인지와 공기청정기, 확인한 루틴·자동 규칙으로 진행한다. 이름만 보고 대상 ID를 추정하지 않는다.

- [ ] `GET /appliances`·`GET /routines`로 주 시연 전자레인지 ID와 '아침 데우기'의 대상·버튼 순서를 대조한다. 내장 `microwave`를 쓸지 등록 `home_mw`를 쓸지는 실제 보정·CT 결속과 맞춘다. 서로 대신 쓰지 않는다.
- [ ] `SIMPLELAY_LOCAL_APPLIANCES`, RPi4 `SIMPLELAY_OUTLET_CHANNELS`·`SIMPLELAY_OUTLET_PRESS_APPLIANCE`가 그 ID를 가리키는지 확인한다. [env 예시](../deploy/act-v3.env.example)는 형식 참고용이며 예전 시연의 ID를 그대로 복사하지 않는다.
  - 등록 ID가 `home_mw`·`washer`·`intercom`이고 CT 배선도 일치하는 설치의 예: `SIMPLELAY_OUTLET_CHANNELS=home_mw:0,washer:1`, `SIMPLELAY_OUTLET_PRESS_APPLIANCE=home_mw`, `SIMPLELAY_L3_NONE_TARGETS=intercom`. 인터폰은 CT 판정 없음으로 남긴다. 주 시연이 다른 ID를 쓰면 그 결속을 별도 확인한다.
- [ ] `GET /readiness/<실제 ID>`가 허용하는지, 아니면 `reasons`가 무엇인지 확인한다. CT·모션 보정 전에는 실물 실행하지 않는다.
- [ ] 주 시연 루틴과 공기청정기 자동 규칙의 조건·대상·값을 확인한다. ① 거절 장면 전 자동 규칙은 꺼져 있어야 한다. 중복 데이터는 ID·참조·보존 목록을 확인한 별도 승인 절차로만 정리한다.
- [ ] 시연 직전에는 루틴을 고치지 않는다. 떠 있는 카드와 현재 루틴 내용이 달라지면 승인이 거절될 수 있다.
- [ ] **ThinQ는 v4 ②③에 필요하다.** 실제 클라우드와 공기청정기는 10/15 노트북에서 확인했다. RPi5의 PAT 파일 권한·시각·인터넷·프로필을 [실물 절차](ThinQ-실물-확인-절차.md)로 확인한다. 전원 켜짐·약풍의 사전 상태를 직접 읽고, 이미 목표값이면 변경 명령 없이 상태 확인으로 표시되는 것을 구분한다.
- [ ] 모의 대안은 별도 시험 설정에서 `fake_cloud`/`mock` 표시를 확인한다. 모의 가열 사건으로 실가전을 제어하지 않는다. 공기청정기 켜기 제안은 보조 영상/모의로만 보인다.

### 3-7. 시연 데이터 정리, 래치 해제, 가열 안전 확인 (24~27분)

- [ ] `DELETE /demo/inject-failure` → `{"ok":true}`(남은 주입 제거, 모의 리허설에서 썼을 때만)
- [ ] **비상정지 래치.** `GET /status`의 `estop_latched`가 `false`. `true`면 콘센트 모듈 버튼이 풀렸는지 보고 `POST /stop/ack` → `ok true, latched false`. 버튼이 눌린 채면 `ok false`가 정상이다(자동 해제 없음). 모의 리허설에서 `POST /demo/outlet-estop`을 썼다면 `DELETE /demo/outlet-estop` 뒤 ack. 키오스크 띠·폰 배너가 사라졌는지 본다.
- [ ] `GET /wellness-pause` → `paused:false`. 아니면 `DELETE`
- [ ] `GET /presence` → 부재가 남아 있지 않은지 본다. 필요하면 `POST /presence {"present":true}`
- [ ] `GET /suggestions` → 앞 리허설의 카드가 남았으면 `POST /suggestions/<id>/reject {"mute":false}`로 치운다.
  - 주의: 치우는 것도 이벤트 기록에 남는다. 기록을 비우려면 시연 전용 DB로 시작한다. 방법은 【결정 대기 §8】
- [ ] `POST /demo/alert {"kind":"danger_sound","raised":false}` → 위험 경보 해제(모의·시뮬레이터 모드 전용, uart면 404)
- [ ] **전자레인지 가열 안전 체크리스트**(10/6 결정 — 실제로 데운다). 하나라도 못 채우면 ①은 가열하지 않고 **전원을 분리한 조작부·모형에서 누름만** 보인다(전원이 들어온 전자레인지에서 '시작'을 누르면 가열이 시작된다).
  1. **빈 상태 가열 금지.** 안에 새 햇반(또는 리허설이면 물을 채운 내열 컵)이 들어 있다. 빈 전자레인지로는 시작하지 않는다.
  2. **조리 시간 상한.** 등록한 '즉석밥' 메뉴의 조리 시간이 햇반 포장 표기 시간 안이다. 실제 시간은 리허설에서 재서 여기 적는다 【리허설 때 기입】. 그보다 오래 돌면 비상 버튼을 누른다. 소프트웨어가 가열 시간을 따로 끊는 기능은 없다.
  3. **비상정지 동작 확인.** 설치 때 한 번, 전자레인지를 돌리지 않은 상태에서 비상 버튼 → 릴레이 차단(표시창 꺼짐) → 래치(`estop_latched true`) → 버튼 풀고 `POST /stop/ack` → 릴레이를 다시 켜 표시창이 돌아오는지까지 해 본다(해제 뒤 릴레이를 켜는 실제 절차는 회로 조립 뒤 확인 【미확인】). 【HW 대기】 회로 미조립 — 회로가 없으면 가열하지 않는다.
  4. 문은 닫혀 있고, 환기구 주변이 비었고, 지난 햇반은 꺼냈다. 데운 뒤에는 내열 장갑으로 꺼낸다.
- [ ] 키오스크가 평소 화면으로 돌아왔는지 본다.

### 3-8. 직전 확인 (27~30분, 대기 중 5분마다 반복)

- [ ] `/health` ok, `/status`에 `running:false`가 보이고 마지막 결과가 이상하지 않다.
- [ ] 이번 판 전에 백엔드를 다시 켰다면 §5-2의 '재시작 → 준비 확인(`/health/detail`) → 실행·정지 확인'을 마쳤다. 준비 확인 전에는 실행을 시작하지 않는다.
- [ ] 키오스크가 평소 화면이다. 비상정지 띠가 없다. 연결 아이콘에 "!"가 없다(콘센트 모듈 없는 등급의 플러그 "설치 안 됨"은 예외).
- [ ] 전자레인지 안에 새 햇반이 있다(가열하는 등급일 때). 지난 판의 햇반이 남아 있지 않다.
- [ ] 폰 "허브 연결됨"
- [ ] 운영 노트북에 트윈(`/simulator/twin`, 전부 모의일 때)과 백업 영상이 열려 있다.
- [ ] 이번 판의 등급(실물/부분 실물/전부 모의)을 정하고 발표자에게 알린다. 마무리 문장의 대괄호를 그에 맞게 고른다.

---

## 4. 장면별 진행/중단 판정

장면별 검증 수준은 [v4](본선-시연-계획-v4.md) §2를 따른다. 실제 누름·CT·ThinQ를 한 흐름으로 확인하기 전에는 장면 전체를 실물 성공으로 말하지 않는다.

장면 ①~⑨의 진행 조건과 미충족 시 대체(실물/연출/녹화/말로만)는 [v4](본선-시연-계획-v4.md) §0 장면표를 따른다. 특히 ⑧(누름·가열)은 리허설 통과와 §3-7 가열 안전을 채운 때만 실물이고, 아니면 녹화로 대신하거나 뺀다. 버튼 완료로 가열 종료를 대신하지 않고, 모의 사건을 실가전에 보내지 않으며, 미확인 결과는 재전송하지 않는다.

- 설치 끝에 조건을 못 채우면 사전 녹화 또는 명확히 표시한 모의로 전환한다. 촬영한 실물 영상은 촬영 날짜·환경을, 모의는 모의를 표시한다.
- 물리 비상정지·정지 후 동작은 [안전 보고 §2-1](안전계약-적용-보고-2026-10-15.md)과 PS-1을 따른다. 모터 전원과 콘센트 릴레이 차단 범위를 혼동하지 않는다.
- 키오스크는 색뿐 아니라 결과 문장·근거·연습 표시를 실제 응답과 대조한다. 과거 색 규격을 최신 화면의 고정 기준으로 쓰지 않는다. 비상 hold는 팔의 취소 누름을 약속하지 않고 직접 확인을 안내한다. 설치된 ipk의 SHA와 실패·정지 화면은 리허설에서 확인한다.

---

## 5. 대체 스위치와 복구 절차

### 5-0. 대체 스위치

| 무엇을 | 어떻게 | 효과 |
|---|---|---|
| 물리 실행 → 모의 모션 | RPi4 env `SIMPLELAY_MOTION_MODE=mock` → `docker restart simplelay-act` | 갠트리가 움직이지 않고 실행기는 모의 결과를 보고한다. 화면 실행 환경 표시를 확인한다 |
| 전체 → 시뮬레이터 | 노트북: `SIMPLELAY_PRESENCE_GATING=true SIMPLELAY_LOCAL_APPLIANCES=home_mw,washer,intercom .venv/Scripts/python.exe -m rpi.simulator_main --host 0.0.0.0 --port 8775` (+ `SIMPLELAY_API_KEY`). ThinQ 모의 장면이면 `SIMPLELAY_THINQ_MODE=mock`도 | DB·센서·노드가 꺼진 독립 서버다. 트윈 `/simulator/twin`이 있다. v4에 필요한 가전·루틴·모의 공기청정기를 별도 준비한다 |
| 보조: 세탁 완료 주입 | 시뮬레이터의 `/demo/appliance-done` 사용 | 주 시연 밖. 주입 표시 유지, 실물 판정으로 말하지 않음 |
| 보조: 리허설 비상 버튼 | 모의 서버의 `/demo/outlet-estop`·해제 확인 | 실제 릴레이 차단 시험이 아님. 실제 장치 설정을 완화해 주입하지 않음 |
| 부재 철회 켜기 | `SIMPLELAY_PRESENCE_GATING=true` | 선택 보조 장면. 끝나면 `present:true` |
| ThinQ 장애 연출(모의 보조) | 모의 서버에서만 장애 주입하고 끝나면 정상으로 복원 | v4 ⑤는 사전 녹화·준비 기록 우선. 장애 주입을 실제 장애라고 말하지 않음 |
| 페이싱 | RPi5 env 파일에 `SIMPLELAY_DEMO_PACING=1` 넣기/지우기 → `sh run_backend.sh`(없으면 꺼짐, §3-2) | 실물에서 켜 두면 이중으로 느려진다 |

### 5-1. 가장자리 스와이프로 키오스크가 닫혔을 때

- **원인.** 창 관리자가 화면 가장자리에서 시작한 터치를 스와이프로 읽어 앱을 닫는다. 최신 화면은 가장자리 약 140/48px 여백을 유지한다([디자인 규격](archive/키오스크-디자인-규격-계획-2026-10-15.md) §4·§5). 실제 패널에서 확인해야 한다.
- **복구.**
  1. 감시 컨테이너가 확인 간격(`SIMPLELAY_KIOSK_CHECK_S`, 기본 10초) 안에 다시 시작한다. **10~15초 기다린다.** 그동안 발표자는 폰이나 트윈으로 말을 잇는다.
  2. 20초가 지나도 안 뜨면 §3-3의 원격 시작 순서를 따른다.
- **예방.** 패널 테두리를 손이 덜 닿게 두고, 발표자는 화면 가운데만 누른다.

### 5-2. 백엔드를 다시 시작할 때

1. RPi5에서 `docker restart simplelay-backend`를 하고 약 5초 기다린다.
2. 노트북에서 `/health`를 확인한다. `/health` 200은 **살아 있다는 것만**이다 — 준비 판정으로 쓰지 않는다.
   - **시연 전 점검 순서: 허브 재시작 → 준비 확인 → 실행·정지 확인.** 준비 확인은 `GET /health/detail`(키 필요)이 응답하고 `ok: true`, 실물·부분 실물 등급이면 `actuator_ready: true`(RPi4 링크 붙음)까지다. `/health/detail`은 재시작 직후 최초 초기화(제안·실행 서비스 생성, DB 읽기)가 끝나야 응답한다 — 늦으면 기다린다.
   - **초기화가 끝나기 전(위 준비 확인 전)에는 실행(제안 승인·루틴·자동 실행 허용)을 시작하지 않는다.** 그다음 안전한 실행 한 번 → 정지(키오스크 정지 또는 `POST /stop`) → `/status`의 `running: false`로 실행·정지를 확인한다. 소프트웨어 정지가 최초 초기화의 DB 대기에 막히지 않는 것은 개발 PC 시험 조건에서만 확인했다([기록](devlog/devlog_2026-10-14-startup-init.md)). 물리 비상정지가 최종 권한이다.
3. RPi4 실행기가 가상 시리얼 끊김으로 스스로 재시작한다(설계). 그 뒤 §3-4 연결 확인을 다시 한다. 엇갈리면 백엔드를 한 번 더 재시작한다.
4. **재시작하면 휘발성 상태가 사라진다.** 실패 주입, ThinQ 장애, 부재, 짝짓기 창, 노드 준비 상태가 모두 초기화된다. 비상정지 래치는 RPi4·콘센트 모듈 쪽에 남는다(재부팅에도 유지) — `/status.estop_latched`를 다시 본다. §3-6과 §3-7을 다시 한다.
5. 폰이 "허브에 닿지 않아요"면 앱을 다시 열고 연결 칩을 본다.

### 5-3. RPi4 연결이 끊겼을 때

- **증상.** 키오스크 누름 장치 아이콘에 "!"가 붙는다. 실행이 실패하거나 확인 불가로 끝난다. **결과를 잃으면 확인 불가로 두고 자동 재실행하지 않는다**(설계). 그대로 보여 주고 이유를 말한다.
- **복구.**
  1. LAN 케이블과 공유기 링크 LED를 본다.
  2. RPi4에 SSH로 들어가 `docker ps`를 본다. 도커가 없으면 `systemctl start docker`, 그다음 `run_act.sh`를 실행한다.
  3. 컨테이너가 떠 있으면 `docker restart simplelay-act`를 하고, RPi5 백엔드를 한 번 재시작한다.
  4. §3-4 연결 확인을 다시 한다.
- **2분 안에 안 되면** 전부 모의로 내린다(§4).
- **모션 보드(ESP32) USB만 끊겼을 때(10/14):** 폰·키오스크에 "누름 장치 연결이 끊겨 멈췄어요"·준비 안 됨이 뜬다. 실행기는 끊긴 포트를 닫고 0.5→1→2→4→8초 간격으로 **설정 경로**를 다시 연 뒤 연결을 확인한다 — 실행기를 다시 띄울 필요가 없다(`docker logs simplelay-act`에 `motion port reopened`·`reconnected`). 다시 붙어도 원점 전이면 누르지 않는다 — 원점 복귀를 한 번 한다. `SIMPLELAY_MOTION_PORT`가 `/dev/ttyACM0` 같은 이름이면 다시 붙지 않을 수 있다(§3-4).

### 5-4. 모션 이상 (탈조·벨트 헛돎·원점 상실·이상 소음) 【HW 대기】

1. **즉시 정지.** 키오스크 정지를 누르거나 `POST /stop`을 보낸다.
2. 움직임이 멈추지 않으면 **갠트리 전원 멀티탭 스위치를 끈다.**
   - 콘센트 모듈 비상 버튼의 릴레이는 **전자레인지 전원**을 끊는다. 갠트리 전원은 끊지 않는다. 게다가 회로는 아직 조립 전이다(펌웨어 컴파일까지).
   - `/stop` 응답의 ACK는 물리 정지의 증명이 아니다(증거 대장).
3. 화면의 정지 요청·응답·멈춤 확인 수준을 구분해 읽는다. MCU 확인을 실제 가전 정지 확인으로 말하지 않는다. hold의 일반 정지는 가전 취소 누름일 수 있지만 drive·비상정지는 추가 누름을 하지 않는다([안전 보고](안전계약-적용-보고-2026-10-15.md) §2-1).
4. 다시 하려면 갠트리 전원을 넣고, 원점 복귀를 한 뒤 시험 누름 1회를 한다. 시연 중이면 **다시 하지 않고** 전부 모의로 내린다. 하드웨어는 무대에 두고 "오늘은 모의로 보입니다"라고 먼저 말한다.
5. 벨트 헛돎은 엔코더 값과 실제 위치를 어긋나게 한다(10/5 메모). 리허설에서 누름 성공률을 실측해 진행 조건(§4)을 다시 정한다.

### 5-5. Wi-Fi가 끊겼을 때

- **폰만 끊긴 경우.** 키오스크만으로 진행하고, 루틴 '지금 실행'은 운영 노트북에서 `POST /routines/{id}/trigger`로 띄운다(화면에서 같은 승인 절차를 거침). 정지는 키오스크나 콘센트 모듈 버튼으로 한다.
- **공유기 전체가 죽은 경우.**
  1. 공유기 전원을 다시 넣는다(약 1~2분).
  2. 그동안 RPi5 키오스크는 같은 기기 루프백이라 계속 동작한다.
  3. RPi4 LAN 배선이면 실행 경로도 끊긴다. 실제 UART 선이면 실행 경로는 유지된다. 【HW 대기】
- **인터넷만 끊긴 경우.** 날씨 대체 문구와 별개로 v4 ThinQ 실제 제어도 실패할 수 있다. 재전송을 반복하지 않고 실제 결과를 보인 뒤, 사전 영상 또는 표시된 모의 클라우드 장면으로 전환한다. 인터넷 복구를 성공으로 대신하지 않는다.

#### 5-5-1. 재부팅 뒤 인터넷 안 될 때 (RPi5, 2026-10-26)

- **증상:** Wi-Fi는 붙었는데 날씨·ThinQ가 안 됨. `ip route`에 `default dev vethXXXX`·`default dev eth0` 줄이 보이고 `ip route get 8.8.8.8`이 wlan0이 아님(connman이 도커 가상 연결·유선 링크 로컬을 유선 서비스로 보고 기본 경로를 넣는다). 또는 경로는 맞는데 백엔드 컨테이너만 이름 풀이가 안 됨(보드 `/etc/resolv.conf`가 끊어진 링크).
- **자동 수리:** `deploy/run_netfix.sh`로 세운 `simplelay-netfix` 컨테이너(재시작 always)가 15초마다 보고, wlan0에 게이트웨이가 있는데 길이 wlan0이 아니면 wlan0 기본 경로만 metric 0으로 다시 넣고 로그 한 줄을 남긴다(`docker logs simplelay-netfix`). DNS는 `deploy/run_backend.sh`가 보드의 로컬 스텁(`--dns 127.0.0.53`)을 넘긴다 — 이 줄이 들어간 뒤 백엔드를 한 번 다시 세워야 적용된다.
- **손 명령(자동 수리가 없을 때):**
  1. `ip route get 8.8.8.8` → wlan0이 아니면 `ip route show dev wlan0`에서 `default via <게이트웨이>`를 보고 `ip route replace default via <게이트웨이> dev wlan0 metric 0`.
  2. **`default dev ...` 줄을 한꺼번에 지우지 않는다** — connman이 Wi-Fi를 끊었다. 끊겼으면 `connmanctl services`로 Wi-Fi 서비스 이름을 보고 `connmanctl connect <서비스>`.
  3. 백엔드 이름 풀이만 안 되면 `docker exec simplelay-backend sh -c 'echo nameserver 127.0.0.53 > /etc/resolv.conf'`(컨테이너를 다시 만들면 사라짐 — 근본 수리는 `run_backend.sh` 재실행).

### 5-6. 그 밖에

| 증상 | 확인 |
|---|---|
| 카드는 보이는데 "지금 실행"이 잠김, 승인하면 412 | `GET /readiness/<id>`의 `reasons`. "아직 기기와 연결되지 않았어요"면 `SIMPLELAY_LOCAL_APPLIANCES`(§3-6) |
| 모든 실행이 412 "비상정지가 걸려 있어요" | 래치가 남음. 버튼을 풀고 `POST /stop/ack`(§3-7) |
| 루틴 '지금 실행'이 409 | "꺼져 있는 루틴" → `enabled`. "자리에 안 계셔서" → `POST /presence {"present":true}` |
| 세탁 완료 알림이 여러 번 옴 | 루틴 중복 저장. `GET /routines`로 세어 지운다 |
| `/demo/appliance-done`이 404 | UART 서버에서 `SIMPLELAY_UART_REHEARSAL=1`을 안 켰거나 보드가 옛 코드다(409면 RPi4가 실물 모드). 세탁 알림 보조 장면은 표시된 모의 서버나 영상으로 대체한다(§4) |
| 첫 실행부터 재시도나 안전 정지 | 남은 실패 주입. `DELETE /demo/inject-failure` |
| 폰 401 | 키 불일치. §3-5 |
| 한글 본문 curl에서 422 | 파일 본문이나 PowerShell을 쓴다(UTF-8 JSON 파일을 명시해 전송) |

---

## 6. 리허설 기록

리허설마다 한 줄씩 남긴다. 원시 로그와 설정은 저장소에 넣지 않는다.

| 날짜 | 장소 | 등급 | 설치 소요 | 장면별 결과 ①~⑨ | 걸린 곳 | 이 문서에 고친 곳 |
|---|---|---|---|---|---|---|
| 【기입】 | | | | | | |

**목표.**
- 10/27까지 설치 30분 이내를 3회 연속 달성한다.
- 시연 주소(§2)로 1회 이상 리허설한다.
- 예비 SD로 1회 이상 리허설한다.

---

## 7. 철수와 종료

1. `DELETE /demo/inject-failure`, ThinQ 장애 `normal`(썼다면), `present:true`로 상태를 되돌리고, 비상정지 래치가 걸려 있으면 버튼을 풀고 `POST /stop/ack`. 다음 리허설에 남지 않게 한다.
2. 전자레인지 안의 햇반·물컵을 꺼내고(내열 장갑), 가전 멀티탭을 끈다.
3. 갠트리 전원 스위치를 끈다. Z가 올라간 상태인지 본다. 【HW 대기】
4. RPi4와 RPi5를 SSH로 `poweroff`해 정상 종료한다. SD 손상을 막으려고 **전원을 바로 뽑지 않는다.** LED가 꺼진 뒤 전원을 뺀다.
5. 패널과 공유기 전원을 끈다. 케이블은 묶어서 회수한다.
6. 가전·모형 고정 테이프를 떼고 운반한다(벨트 장력 확인).
7. 운영 노트북의 리허설 로그와 원시 기록은 로컬에만 둔다.

---

## 8. 결정·확인 대기 (v4 기준)

| 항목 | 다음 확인 |
| --- | --- |
| 실제 누름·CT | 원점·좌표·가열 상한·CT 종료 판정, §3-7 통과 전 가열 금지 |
| ThinQ | 노트북 실가전 확인과 RPi5 확인을 구분. 대회장과 같은 망·PAT·시각·호출 지연 확인 |
| 배포 | 두 보드·폰·키오스크 같은 SHA, 모션 ESP32 펌웨어 확인. 최신 안전 수리는 시험 조건만 |
| UI | 최신 패널·실폰·화면 읽기·큰 글자·실패 뒤 복귀 확인 |
| 자동 실행 | 허용 규칙·쉬기·조용한 시간·같은 사건 재실행 차단. 시연용 데이터 삭제는 별도 승인 |
| 켜기 제안 | 주 시연 제외 확정. 녹화/모의 보조. 클라우드 수 분 지연과 켜기 뒤 강풍 재알림 제한 명시 |
| 보조 모형·두 번째 CT | 세탁기·인터폰은 선택 보조. 실제 준비 상태를 확인해 반입 목록 확정 |
| 미결 안전 | R1·G6·G8, G5 재접속 지연과 PS-1 실물 시험. [안전 보고](안전계약-적용-보고-2026-10-15.md) 참조 |

---

## 9. 시연 영상 촬영 목록 — 사용 장면 중심 (2026-10-10)

외부 조언에 따라 다시 짰다. 화면이 예쁜지보다 아래 네 가지를 먼저 보인다.
1. 장치가 가전 어디에 붙는지
2. 사람이 폰·키오스크로 어떻게 쓰는지
3. 실패했을 때 어떻게 다시 하는지
4. 비상정지

목표 길이·촬영 마감·자막 규칙·점검은 [제출 체크리스트](submission/제출-체크리스트.md) §3에 있다. 이 절은 컷 목록만 다룬다.
장면 순서는 [v4](본선-시연-계획-v4.md) §0 장면표 ①~⑨(10/26 개정)를 따른다. 켜기 제안은 보조 영상/모의만 쓴다.

**찍는 원칙.**
- 한 컷에 한 가지만 설명한다. 손·화면·장치가 한 화면에 같이 보이게 찍는다(사람이 누르고 → 화면이 바뀌고 → 장치가 움직이는 순서).
- 장면마다 첫 자막으로 등급(실물/부분 실물/전부 모의)을 밝힌다. 모형이면 "모형"이라고 적는다.
- 주입한 것도 자막으로 밝힌다. 실패는 "일부러 넣은 실패", 세탁 완료는 "시연 주입"이다.
- 화면의 "모의" 표시를 가리지 않는다.
- 갠트리가 없으면 그 컷은 디지털 트윈과 "개념 모션" 자막으로 대신한다. 실물인 척하지 않는다.
- 가열은 §3-7 체크리스트를 통과했을 때만 찍는다. 회로가 없으면 전원을 분리한 조작부·모형에서 누름만 찍는다.
- 사람(가족·지인)을 찍으면 손과 화면만 찍는다. 얼굴이나 개인 물건이 나오면 그 컷은 쓰지 않는다.

| 컷 | 무엇을 보이나 | 핵심 표시·조건 |
| --- | --- | --- |
| 0~1 | 사용자 과업·장치 부착 위치 | 기구·콘센트 모듈의 실제 위치, 준비 안 됐으면 설계도 표시 |
| 2 | 폰 등록·루틴과 최신 승인 화면 | 사용자 확인 전 실행하지 않음. 실제 가전·모의 여부 표시 |
| 3 | v4 ①②: 거절 후 미실행 → 승인·실제 누름·CT 가열 종료 → 강풍·자동 허용 | 실제 누름·CT는 실측 뒤 촬영. 가열 종료가 조리 완료를 보장하지 않음 |
| 4 | v4 ③: 다음 사건에서 허용된 자동 실행 | 허용 조건과 사건이 실제인지 밝힘. 공기가 깨끗해졌다고 말하지 않음 |
| 5 | v4 ④: 기록·자동 실행 끄기 | 실제 기록의 확인 수준과 꺼짐 표시 |
| 6 | v4 ⑤: 일부 실패 기록/영상 | 미확인은 실패 단정·자동 재전송 없음 |
| 7 | 정지·비상정지 | 팔 정지와 가전 취소·릴레이 차단 구분. 해제 뒤 자동 재개 없음. 모의면 표시 |
| 8 | 선택 보조: 공기질 켜기·인터폰·세탁 알림 | 켜기는 녹화 또는 명시한 모의. 센서→클라우드 수 분 지연을 숨기지 않음 |
| 9 | 실측 그래프 | 아래 표, 실측 데이터만 |
| 10~11 | 한계·마무리 | ThinQ 노트북 확인/RPi5 미확인 등 촬영일 기준, 공개 링크 |

**컷 9 그래프 자리.** 측정 방법·횟수·합격선은 [실측 계획](archive/실측-계획-결선.md)(작성 중)을 따른다. 영상에는 실측 데이터로 만든 그림만 넣는다. "예시(합성 데이터)" 워터마크가 붙은 그림은 영상과 제출물에 쓰지 않는다. 실측 전이면 그 자리는 "측정 계획" 한 줄 화면으로 대신하고, 말로도 "아직 측정 전"이라고 한다.

| 자리 | 그래프 | 들어갈 곳 | 상태 |
|---|---|---|---|
| G1 | 목표 좌표 대비 실제 누른 위치 오차(버튼별 산점도) | 컷 9-1, 보고서 §6-3 | 【실측 후 삽입】 |
| G2 | 버튼별 누름 성공률(첫 시도·재시도 포함) | 컷 9-2, 보고서 §6-3 | 【실측 후 삽입】 |
| G3 | 정지 요청 → 모터 정지 지연 분포(요청·ACK·실제 정지 구분) | 컷 9-3(컷 7 뒤에 붙여도 된다), 보고서 §6-3 | 【실측 후 삽입】 |
| G4 | 전자레인지 1회 CT 전력 파형 위 "시작 확인" 판정 시점 | 컷 9-4(컷 3 뒤에 붙여도 된다), 보고서 §6-3 | 【실측 후 삽입】 |

---

## 10. 제출 초안을 로컬에서 PDF로 뽑기 (멘토 의견용)

`docs/submission/개발완료보고서-초안.md`·`작품소개서-초안.md`를 멘토에게 보낼 때 쓴다. 최종 제출 양식(한글/워드)은 따로 편집한다. 아래는 검토용 사본을 만드는 방법이다.

**PDF는 커밋하지 않는다.**
- 저장소 밖 폴더(예: 바탕화면)에 만든다.
- `rpi/tests/test_repo_guard.py`가 추적 중인 `.pdf`를 막는다.
- 보내기 전에 PDF를 열어 개인정보·내부 주소가 없는지 본다.

**방법 1 — VS Code(가장 쉬움).**
1. 초안 파일을 열고 미리보기(`Ctrl+Shift+V`)를 띄운다. 그림은 `img/` 상대 경로로 보인다.
2. 다음 중 하나로 PDF를 만든다.
   - 확장 "Markdown PDF"의 `Markdown PDF: Export (pdf)`를 실행한다. 출력 위치를 저장소 밖으로 바꾼다.
   - 미리보기를 브라우저로 열어 인쇄(`Ctrl+P`) → "PDF로 저장"을 고른다.

**방법 2 — pandoc.** pandoc과 PDF 엔진이 설치돼 있을 때 쓴다. 그림 경로 때문에 `docs/submission`에서 실행한다.

```powershell
cd docs\submission
pandoc 개발완료보고서-초안.md -o "$env:USERPROFILE\Desktop\개발완료보고서-초안.pdf" --pdf-engine=xelatex -V mainfont="Malgun Gothic" -V geometry:margin=20mm
pandoc 작품소개서-초안.md -o "$env:USERPROFILE\Desktop\작품소개서-초안.pdf" --pdf-engine=xelatex -V mainfont="Malgun Gothic" -V geometry:margin=20mm
```

- xelatex가 없으면 HTML로 뽑은 뒤 브라우저에서 PDF로 인쇄한다.
  - `pandoc 개발완료보고서-초안.md -s --resource-path=. -o "$env:USERPROFILE\Desktop\report.html"`
  - HTML을 저장소 밖에 만들면 그림 경로가 끊긴다. 그때는 `--embed-resources`(pandoc 3 이상)를 붙인다.
- SVG 그림은 PDF 엔진에 따라 빠질 수 있다. 빠졌으면 방법 1을 쓴다.
- 쪽수는 최종 양식에서 다시 확인한다. 검토용 PDF의 쪽수는 기준이 아니다.
# 시연 전 준비

키오스크 **메뉴 → 설정 → 준비 상태**에서 모두 확인하고, 필요하면 **새로고침**한다.
