Seongwonp/Simplelay/docs/본선-시연-계획-v4.md

# 본선 시연 계획 v4 — 생활 · 조율 · 책임 (2026-10-26 개정)

## 10/28 제출 후 확인

- [제출 영상](https://www.youtube.com/watch?v=duf_ZUxTOUo)은 3분 29초 소개·시연 편집본이다. 아래 10분 현장 장면표 전체를 리허설한 결과와 구분한다.
- 사용자는 실제 누름 뒤 좌표가 0,0이 되고 복귀하지 못하며 실패로 표시되는 결함을 보고했다. 물리 장면은 [복귀·첫 연결 수리 계획](archive/결선전-복귀결함과-첫연결-수리계획-2026-10-28.md)의 원인 확인·수리·반복 검증 뒤 채택한다. CT 계측은 실물 미검증이다.
- 언어 모델의 최신 기록은 [보드 평가 §13](발표/언어모델-평가-2026-10-26.md)을 따른다. 새 42문장 38/42, 목록 밖·부정 오수락 0/17, 애매한 말 오수락 1/5, 모델 호출 31건 중앙값 9.8초다. 전체 발화의 오수락 0건으로 말하지 않는다.
- 아래 10/26 상태 설명은 당시 기록이다. 제출 후 확인되지 않은 항목을 완료로 바꾸지 않으며, 장면의 실물·연출·모의 여부는 당일 조건으로 다시 판정한다.

> **이 문서가 본선 시연 운영 기준이다.** 장면 순서·시간·말은 [결선 발표 대본](발표/결선-발표-대본.md)이 정하고, 이 문서는 장면마다 **무엇이 실물이고 무엇이 연출·모의·연습인지**, 설치·리허설·대체 방법을 적는다.
> 방향은 팀 작업 규칙 '2026-10-25 사용자 확정': 중심은 사람을 이해해 일상을 자동화하는 것(LG 공감지능), 누름 장치는 버튼만 있는 옛 가전을 이 흐름에 넣는 **수단**이다.
> 2026-10-13~10-19 판(가열 종료 감지 → 공기청정기 '다음부터 자동으로', 다섯 장면)은 git 기록에 있다. 그 흐름은 이제 주 시연이 아니다 — §5에 남은 쓰임만 적는다. 더 옛 판은 [v3](archive/본선-시연-시나리오-v3.md).
>
> **지금 상태를 먼저 적는다(10/26):** 장면 단위로 결선 조건에서 처음부터 끝까지 리허설한 장면은 아직 없다.
> 실물로 확인한 조각: 본체 카메라 사람 있음/없음(부팅 자동 시작), 본체 안 언어 모델 말 알아듣기(고정 50문장+새 12문장으로 잼, 가운데값 약 10초·90%는 14초 안, 규칙 거르기 뒤 맞힘 77%·잘못 고름 6% — 규칙을 만든 문장 기준, 새 문장 12개는 4/5·0/7, 실행은 늘 '네'), 실제 공기청정기 켜기·바람 세기·상태 재조회, 정해진 시각 자동 켜기·끄기(10/16~17 각 1회), 15.8형 실패널 키오스크.
> 실제 사용 기록은 10/25부터 모으는 중이라 **실제 기록에서 습관 카드가 뜨는지는 결선 전 확인**이다. 누름 장치의 캐리지 이동·실제 버튼 누름, 콘센트 모듈 전력 판정은 아직이다.
>
> 일정: 서류 제출 10/28(수) 14:00, 발표 11/6(금) 평가 15:40~16:00(시연·발표 10분 + 질의 10분, 시연 중심) — [본선 실행 계획 §0](archive/본선-실행계획-2026-09-30.md).

## 0. 장면표 — 대본과 같은 순서 (9:30 + 여유 0:30)

표시: **실물** = 그날 실제 기록·실제 가전으로 / **연출** = 기능은 실물이지만 시연을 위해 조건을 맞춘 것 / **모의** = 모의 클라우드·모의 실행 / **연습** = 화면에 '연습'·'제안 · 시연 데이터' 표시가 붙는 장면 / **녹화** = 미리 찍은 영상. 실물이 아닌 장면은 **들어가기 전에 먼저 말한다**.

| # | 시각 | 장면 | 기둥 | 기본 | 안 되면 | 먼저 말할 것 |
|---|---|---|---|---|---|---|
| — | 0:00–1:20 | 문제·세 기둥(슬라이드 1·2) | — | — | — | — |
| ① | 1:20–1:50 | 다가가면 화면이 깸 | 조율·책임 | **실물**(본체 카메라). 자리 비움 시간을 시험값으로 줄여 두었으면 **연출** | 카메라가 안 잡으면 말로만, 키오스크 처음 화면에서 시작 | (시간을 줄였으면) "시연을 위해 기다리는 시간을 줄였습니다" |
| ② | 1:50–2:50 | "공기가 텁텁하네" → '공기청정기를 켤까요?' → '네' | 생활·책임 | **실물**(음성 입력 + 공기 불평 규칙, 실제 공기청정기). 이 문장은 언어 모델이 선택한 사례가 아님 | 인터넷·LG 연결이 안 되면 **모의** 클라우드. 요청을 이해하지 못하면 그대로 안내하고 다시 한 번만 | "오늘은 모의 클라우드입니다"(모의일 때) |
| ③ | 2:50–4:00 | 실제 기록에서 나온 습관 카드(쓴 날·'왜 지금' 칩) | 생활·조율 | **실물**(10/25부터 쌓은 기록, 결선장 시각에 맞는 습관이 있을 때) | 기록이 모자라거나 시각이 안 맞으면 '알게 된 것'의 '학습 중'·다른 시간대 습관을 보이고, 카드는 **연습**(`POST /demo/suggest`, '제안 · 시연 데이터' 표시) | "아직 학습 중입니다. 이 카드는 연습 화면입니다" |
| ④ | 4:00–4:50 | 맡기기 — 확인 칸(언제·무엇을·하지 않는 경우·끄는 곳)을 읽고 누름 | 책임 | **실물**(화면·저장). 맡긴 뒤 다음 날 알아서 하는 것은 시연 안에서 보이지 않는다 | ③이 연습이면 ④도 **연습** | (연습 카드면) "연습 카드로 맡기는 화면만 보여 드립니다" |
| ⑤ | 4:50–5:30 | 본체가 '알게 된 것' — 평소 시각·근거·상태, 숨기기 | 생활·책임 | **실물** 화면. 생활 요약 두 문장은 밤사이 검사를 통과한 것이 있을 때만 | 요약이 없으면 고정 문장 그대로, 읽지 않음 | — |
| ⑥ | 5:30–6:20 | '이미 했어요' → 그날 다시 묻지 않음 | 조율·책임 | **실물** 동작(카드가 있을 때) | 카드가 없으면 말로만 | 연속 두 번 거절·무반응 → 7일 쉼은 **재현하지 않고 말로만** |
| ⑦ | 6:20–6:35 | 환기 조언 — 말로 한 줄(카드가 떠 있으면 가리킴) | 조율 | 한 줄만 | 뺀다(대본 §2 자르는 순서 1번) | — |
| ⑧ | 6:35–6:50 | 열 나는 가전은 매번 '네' — 한 문장 | 책임 | 한 문장. 누름 성공 기록(20번 누름 n/N)이 생기고 리허설에서 통과했을 때만 실제로 눌러 보인다 | 뺀다 | — |
| ⑨ | 6:50–7:30 | 맡긴 자동 실행 끄기(폰 루틴 탭) · 사람 감지 카메라 끄기(키오스크 설정) | 책임 | **실물** | — | — |
| — | 7:30–8:50 | 한계와 다음 단계 · 맺음 | — | — | — | — |

시간이 밀리면 대본 §2 순서로 자른다(⑦ → ⑤ → ⑧). ②·③·④·⑨와 한계 슬라이드는 자르지 않는다.

## 1. 장면별 운영 메모

### ① 다가가면 화면이 깸

- 시작 전 키오스크가 자리 비움 시계 화면이어야 한다. 사람 감지는 '언제 말을 걸지'에만 쓴다 — 실행·승인의 근거가 아니다. 오래 비웠다 온 인사는 3시간이 넘어야 나와서 결선장에서는 보이지 않는다(말로만).
- 지금 RPi5 env에 촬영용 시험값(사람 감지 5·10·30초)이 있다. 결선 때 둘지 되돌릴지는 사용자 결정 — 둔다면 위 표대로 연출이라고 말한다.
- 심사위원이 카메라 앞을 지나가도 화면이 깬다. 관객 쪽을 덜 보도록 각도를 리허설에서 맞춘다.

### ② 말 알아듣기

- 키오스크 본체 마이크 또는 폰에서 말하고, 규칙이 먼저 처리한다. 규칙으로 처리하지 못한 표현만 본체 언어 모델이 정해진 동작 목록에서 고른다. 실행은 사람이 '네'를 눌러야 한다. 폰 음성 인식의 오프라인 여부를 본체 음성 인식과 동일하게 보장하지 않는다.
- 말로는 "모델까지 가면 약 10초, 실행은 늘 확인 뒤"까지만. 숫자는 질의에서 [보드 평가 §13](발표/언어모델-평가-2026-10-26.md)의 표본·규칙 포함 여부·애매한 발화 한계와 함께 설명한다. 모델 호출 시간은 녹음부터 가전 실행까지 걸린 전체 시간이 아니다.
- 공기청정기는 상태를 다시 읽어 바뀐 것을 확인한 뒤에만 '됐어요'다(§4). 장면 뒤 서예솔이 공기청정기를 꺼서 ③을 위해 되돌린다.

### ③④ 습관 카드와 맡기기

- 습관은 같은 시간대에 서로 다른 날 사흘 이상, 세 번 이상 쓴 실제 기록에서만 나온다. 평일·주말 습관은 그날 종류에만 묻는다. 가짜 기록으로 습관을 만들지 않는다.
- 연습 카드를 쓰면 화면의 '제안 · 시연 데이터' 표시를 가리지 않는다. 연습 카드를 맡겨 생긴 루틴은 시연 뒤 지운다(§9 절차).
- 맡기기 확인 칸은 화면 글자 그대로 읽는다. "자주 '네'를 눌러도 저절로 맡기지 않습니다"를 꼭 말한다.

### ⑥ 거절

- '이미 했어요'는 그날 다시 묻지 않고 거절로 세지 않는다. 연달아 두 번 거절하거나 답이 없으면 7일 쉰다. 아예 받지 않겠다고 하면 다시 묻지 않는다. 묻는 때에 아무도 없으면 평소 시각 +30분까지 기다렸다 한 번 묻고, 지나면 그날은 건너뛴다(거절로 세지 않음).
- 시연용으로 거절 기록을 미리 만들지 않는다.

### ⑧ 열 나는 가전

- 열 나는 가전(전자레인지·인덕션)은 맡길 수 없고 매번 '네' 확인이다. 화면 결과 글자를 그대로 읽는다 — 누름 장치가 눌렀다는 것과 가전이 가열했다는 것은 다르다.
- 누름 장치 설명은 서예솔이 한 줄로 끝낸다. 갠트리 기계는 같은 팀 HW 담당의 다른 프로젝트와 함께 쓴다([재사용 경계](reuse-boundary.md)) — 질의에서 물으면 자세히.
- 가열 여부·콘센트 모듈 갈래는 §5.

## 2. 실제로 확인한 것 / 아직인 것

### 2-1. 실물로 확인한 것

| 무엇 | 언제·어디서 | 쓰는 장면 | 근거 |
|---|---|---|---|
| 본체 카메라 사람 있음/없음, 부팅 자동 시작 | 10/25~26, RPi5 | ① | [10/26 devlog](devlog/devlog_2026-10-26-desktop-empathy.md) §1 |
| 본체 안 언어 모델 말 알아듣기, 인터넷 없이 — 고정 50문장+새 12문장으로 잼, 가운데값 약 10초·90%는 14초 안, 규칙 거르기 뒤 맞힘 77%·잘못 고름 6% — 규칙을 만든 문장 기준, 새 문장 12개는 4/5·0/7, 실행은 늘 '네' | 10/26, RPi5 | ② | 같은 devlog §2·§6 |
| 실제 공기청정기 찾기·추가·켜기·바람 세기·상태 재조회 | 10/15 노트북 허브, 10/16 RPi5 허브 | ② | [thinq-real](devlog/devlog_2026-10-15-thinq-real.md) · [desktop-home](devlog/devlog_2026-10-16-desktop-home.md) §4 |
| 정해진 시각 22:00 켜기·07:00 끄기를 카드 없이(상태 재조회 확인) | 10/16~17, RPi5 허브, 각 1회 | ④ 맡긴 뒤의 모습(말로) | 같은 기록 §14·§17 |
| 모터 축 구동·엔코더 계수, 정지 단계(보냄 → 모션 보드 응답 → 멈춤 확인) | 10/12~14, 시험대(벨트·솔레노이드 없이) | ⑧의 앞 단계 | [motion-bringup](devlog/devlog_2026-10-12-motion-bringup.md) · [desktop-close](devlog/devlog_2026-10-14-desktop-close.md) |
| 키오스크 15.8형 실패널 | 9/30~10/26 여러 차례 | 전 장면 | [10/18](devlog/devlog_2026-10-18-professor-ui.md) §5 · 10/26 devlog §1 |

### 2-2. 결선 전 확인할 것

| 장면 | 필요한 것 | 지금 |
|---|---|---|
| ③ | 실제 기록에서 습관 카드, 결선장 시각에 맞는 습관 | 10/25부터 기록 모으는 중 |
| ③ | LG 앱·리모컨으로 바꾼 공기청정기 전원이 직접 사용으로 남는지 | 시험(모의) 12건만, 실물 확인 전([기록](devlog/devlog_2026-10-26-thinq-manual-use.md)) |
| ④ | 습관 카드에서 맡긴 뒤 다음 날 알아서 하기 | 실물 확인 전 |
| ⑤ | 밤사이 생활 요약이 검사를 통과해 보이는지 | 배포, 실물 확인 전 |
| ⑦ | 여러 신호 제안·조언 카드가 실제 조건에서 뜨는지 | 배포, 실물 조건 미확인 |
| ⑧ | 캐리지 이동·원점·실제 버튼 누름 | 모터 B 엔코더 수리 뒤 [하드웨어 복귀 날 절차](archive/하드웨어-복귀-날-절차.md) |
| ②⑨ | 결선장 인터넷·LG 클라우드 | 미확인 — 여행용 공유기 + 핫스팟 |

## 3. 정지·실패 리허설 (주 시연 리허설마다 함께)

정지와 실패는 무대에서 처음 해 보는 장면이 되면 안 된다. 결과는 [실측 기록표](실측-기록표.md)에 적는다(값은 측정 뒤 기입).

| 리허설 | 방법 | 통과 기준 |
|---|---|---|
| 이동 중 정지(무대 기구) | 실행 직후 키오스크 정지. 폰 정지·`POST /stop`도 한 번씩 | 정지 화면의 말이 `/status` 정지 단계와 맞다(`verified`일 때만 '멈췄어요'). 정지 뒤 추가 누름 없음 |
| 쉬는 중 정지 | 움직이지 않을 때 정지 | `mcu_ack`는 보드 응답으로 표시하고 물리 멈춤 검증으로 부풀리지 않는다 |
| 물리 비상정지 | 런북 §3-7·안전 보고 PS-1 | 릴레이 차단·래치, `POST /stop/ack` 전에는 다시 실행되지 않음 |
| 누름 실패(모의 보드) | `POST /demo/inject-failure`(1회용) → 실행 → `DELETE /demo/inject-failure` | 재시도·안전 정지 화면, 남은 주입이 다음 판에 없다 |
| 공기청정기 결과 미확인 | 런북의 모의 서버 ThinQ 장애 주입, 끝나면 정상으로 | 결과를 확인하지 못했다고 안내하고 다시 보내지 않는다 |
| 언어 모델 응답 | ②의 문장과 해당 없는 문장 하나씩 | 고른 동작이 확인 카드로만 나오고, 해당 없으면 아무것도 실행하지 않는다. 걸린 시간 기록 |

주입·모의로 만든 실패는 무대에서 실제 장애라고 말하지 않는다.

## 4. 결과 문구 원칙

**결과 문구를 대본에 고정하지 않는다.** 그날 실제 얻은 근거대로 읽는다.

| 상황 | 표시(폰 결과 배지 — 근거 줄) |
|---|---|
| 보내기 전에 연결 불가 | '못 했어요' — '보내지 않았어요' |
| 접수됐지만 상태를 확인하지 못함 | 상태 미확인으로 안내하고 가전을 직접 확인하도록 설명. 성공·실패 어느 쪽으로도 단정하지 않음 |
| 상태 재조회로 바뀐 것을 확인 | '됐어요' — '상태를 확인했어요' |
| 보내기 전 조회에서 이미 그 설정 | '이미 그 설정이라 보내지 않았어요' |

- 미확인 안내는 ‘확인하지 못했어요’로 쓴다. 폰·키오스크의 실제 문장은 배포한 화면에서 확인하며 과거 대본의 문구를 그대로 요구하지 않는다.
- 확인하지 못하면 자동으로 다시 보내지 않는다. 서버가 보고하지 않은 성공을 말로 만들지 않는다.
- 정지는 실제 멈춤 근거가 있을 때만 확인했다고 말한다. 현재 `touchbridge-v2`의 보드 응답만으로 과거 엔코더 `verified` 측정을 재현했다고 주장하지 않는다. 정지 미확인은 그대로 안내하며 자동 복귀하지 않는다.
- 연습 표시(폰 배지 '연습', 키오스크 띠 '연습이에요. 실제 가전은 그대로예요', 카드 '제안 · 시연 데이터')를 가리지 않는다.

## 5. 장면 ⑧ — 누름 장치·콘센트 모듈 갈래

### 5-1. 갈래

| | **10/28 영상** | **11/6 결선(콘센트 모듈 준비됨)** | **11/6 결선(준비 안 됨)** |
|---|---|---|---|
| 누름 | 실제로 찍은 것만 | 리허설 통과 때 실물 | 리허설 통과 때 실물, 아니면 녹화·뺌 |
| 가열 | **하지 않는다**(전원 분리한 조작부에서 누름만) | [런북](결선-운영-런북.md) §3-7 체크리스트 통과 뒤 짧게(30초) | **하지 않는다** — 비상 차단 없이 가열 금지 |
| 가전 결과 | "가전이 가열했는지는 이 영상에서 확인하지 않습니다" 자막 | 전력으로 본 것만 말한다. 끝은 '가열 종료 감지(조리 완료가 아닐 수 있음)' | 누름 장치 쪽 확인까지만 |
| 콘센트 모듈을 말하는 문장 | "설계·펌웨어 완료, 회로 제작 중입니다." | "열 나는 가전은 실행 중 전력을 지켜봅니다. 자동 실행의 근거로는 쓰지 않습니다. 비상정지는 이 콘센트를 끊습니다." | "설계·펌웨어 완료, 실측 전입니다." |
| 대본 | [실물 장면 대본](archive/촬영-대본-실물-장면.md) · [하드웨어 없이 대본](archive/촬영-대본-2026-10-20-하드웨어-없이.md) | 결선 발표 대본 장면 ⑧ | 같음 |

- 콘센트 모듈 준비 여부는 결선 전 리허설([하드웨어 복귀 날 절차](archive/하드웨어-복귀-날-절차.md) §9·§10)에서 정한다. 판정 실측은 [실측 기록표](실측-기록표.md) §6, 제작은 [콘센트 모듈 제작 안내](콘센트-모듈-제작-안내.md).
- CT 판정은 취소·문 열림으로 끝난 것과 정상 종료를 **구분하지 못한다**(코드 확인). '조리 완료'라고 말하지 않는다.

### 5-2. 옛 주 시연(가열 종료 → 공기청정기 자동)의 남은 쓰임

- 10/13~19 판의 '가열 종료 감지 → 공기청정기 바람 세게 → 다음부터 자동으로'는 **주 시연에서 뺐다**. 규칙(`cook_done_air`)은 모의 끝-끝까지 구현·시험돼 있고([devlog](devlog/devlog_2026-10-13-auto-rule.md)), 결선 전 정리 때 '가열 종료 → 공기청정기' 규칙은 **꺼짐**으로 둔다.
- 질의에서 "옛 가전과 LG 가전을 잇는 장면은?"을 물으면 말로 설명하고, 콘센트 모듈이 준비됐으면 질의 시간에만 보인다. 준비 안 됐으면 **모의**(가열 종료 주입)로, '연습' 표시를 가리지 않고 보인다.

## 6. 무대 배치

- 책상 150×55cm ×2: 키오스크와 공기청정기를 관객이 함께 볼 수 있게, 전자레인지 + 누름 장치(+ 콘센트 모듈)는 다른 책상. 본체 카메라는 발표자가 다가가는 길을 보게.
- 키오스크 패널과 폰 화면(미러링)이 관객 쪽을 향하게. 기구 카메라는 조작부 근접.
- 여행용 공유기 + 핫스팟(LG 클라우드·날씨용), RPi5·RPi4 같은 망.
- 녹화 영상(⑧·백업)과 노트북 모의 서버를 1분 안에 전환할 수 있게.

## 7. 백업

| 상황 | 대신하는 것 |
|---|---|
| 실제 기록에서 습관 카드가 안 뜸 | '학습 중' 화면 + **연습** 카드, 먼저 말한다 |
| 언어 모델이 느리거나 안 됨 | 한 번 더 기다리고, 안 되면 규칙으로 알아듣는 말('공기청정기 켜줘')로 같은 확인 카드를 보인다 |
| 결선장 인터넷·LG 클라우드 불가 | **모의** 클라우드, "오늘은 모의 클라우드입니다" |
| 사람 감지가 안 잡힘 | 장면 ①을 말로, 카메라 끄기(⑨)는 설정 화면만 |
| 누름 장치가 안 됨 | 장면 ⑧을 **녹화**로 하거나 빼고 한 문장으로 |
| 시간 초과 | 대본 §2 순서로 자른다 |

## 8. 말해도 되는 문장 / 말하면 안 되는 문장

| ○ 말해도 된다 | ✕ 말하면 안 된다 |
|---|---|
| "실제로 쓴 기록에서 같은 시간대에 사흘 이상, 세 번 이상 되풀이한 일을 알아챕니다. 학습이 아니라 설명할 수 있는 규칙입니다." | "AI가 습관을 학습합니다" / "사람을 이해합니다" |
| "사람 감지는 언제 말을 걸지 고르는 데만 씁니다. 사진은 남기지 않습니다." | "사람이 있을 때만 움직입니다" |
| "자주 '네'를 눌러도 저절로 맡기지 않습니다. 사람이 확인 칸을 보고 눌러야 합니다." | "자주 승인하셔서 자동으로 바꿨습니다" |
| "열 나는 가전은 맡길 수 없고 매번 '네' 확인을 받습니다." | "알아서 요리를 시작합니다" |
| "연달아 두 번 거절하거나 답이 없으면 7일 쉬고, '이미 했어요'는 그날 다시 묻지 않습니다." | "거절하면 물러섭니다"(한 번 거절에 바로 물러서는 것처럼) |
| "모델까지 가면 약 10초, 실행은 늘 '네'입니다."(숫자는 질의에서 단서와 함께) | "8개 중 8개 정확합니다" / "정확도 100%" |
| "누름 장치가 눌렀다는 것까지 확인했습니다." | (전력 근거 없이) "가열을 확인했습니다" / "조리가 끝났습니다" |
| "기구와 모션 제어 핵심은 같은 팀 HW 담당의 다른 프로젝트와 함께 씁니다." | "기구까지 전부 이번에 새로 만들었습니다" |
| "멈춘 것을 엔코더로 봤을 때만 '멈췄어요'라고 합니다." | "정지 버튼을 누르면 무조건 멈춥니다" |
| "이 부분은 연출입니다 / 모의입니다 / 연습입니다." | 연습 화면을 가리키며 "이게 실제입니다" / 습관이 생기는 며칠을 10분 안에 재현하기 |

## 9. 깨끗한 시연 준비 점검표 (설치 14:50~15:20 마지막 10분)

> 심사위원이 보는 화면에는 오늘 보일 가전·규칙·기록만 있어야 한다. 설치 순서는 [결선 운영 런북](결선-운영-런북.md) §3. 한 사람이 읽고 다른 사람이 화면으로 확인한다.

**먼저 볼 셋**
- [ ] **습관 기록:** '알게 된 것'에서 실제 기록으로 생긴 습관과 결선장 시각에 맞는 것이 있는지 → 장면 ③을 실물로 할지 연습으로 할지 정한다.
- [ ] **카메라 켜짐:** 키오스크 설정 '사람 감지 카메라' 켜짐, 자리 비움 화면으로 들어가는지 한 번 본다.
- [ ] **자동 실행 꺼짐:** 장면 ④에서 맡길 루틴이 이미 맡겨진 채가 아니다. '가열 종료 → 공기청정기' 규칙 꺼짐.

**가전·규칙·기록**
- [ ] 가전 목록은 오늘 시연하는 것만 — 공기청정기, 전자레인지. 미설정·시험 가전이 없다. 연습 기기가 남아 있으면 '연습' 표시가 보이게 둔다.
- [ ] 개발자 모드 꺼짐. 개발자 모드를 끄면 내장 전자레인지가 목록에서 숨는 문제는 결정한 방식대로 확인.
- [ ] 시각 규칙(22:00 켜기·07:00 끄기)이 평가 시간에 울리지 않는다.
- [ ] **하루 묻는 횟수 상한 끔**(런북 — `SIMPLELAY_DAILY_ASK_LIMIT=off`, 백업 뒤). 시연 뒤 되돌린다.
- [ ] 기록 탭 맨 위가 오늘과 상관없는 연습·실패 기록이 아니다. 실물 근거 기록(`state_confirmed` 등)은 지우지 않는다.
- [ ] 조용한 시간·방해 금지가 평가 시간(15:40~16:00)에 걸려 있지 않다 — 걸리면 카드·자동 실행이 막힌다.

**연습 기록 지우기 — 팀 둘 다 승인 + DB 백업이 있을 때만.** 하나라도 빠지면 지우지 않고 "연습 기록입니다"라고 말한다.
1. 박성원·서예솔 둘 다 승인, 무엇을 지울지 말로 정한다. 실물 근거 기록은 지우지 않는다.
2. 본체 DB 백업을 먼저 — `simplelay-backup-YYYY-MM-DD-before-<이유>.db`, 크기가 0이 아닌지 확인.
3. 앱 화면의 삭제로 지운다. DB를 직접 고치지 않는다.
4. `/health/detail` 준비 확인 → 키오스크·폰 반영 확인.
5. 지운 것과 백업 이름을 그날 기록에 남긴다.

**날씨·시간·폰**
- [ ] 본체 시각이 맞다(RPi5는 RTC 배터리 없음 — 인터넷에 붙었는지, 아니면 노트북 시각으로).
- [ ] 날씨·바깥 공기가 대회장 기준 실제 값이거나, 없으면 대체 문구 그대로. 오래된 경보 알림은 닫는다(지우지 않는다).
- [ ] 시연 폰: 개인 알림 끔, 충전, 릴리스 APK, 미러링.
- [ ] 본체 env 개발자 실물 조작 끔, API 문서 페이지 닫힘(팀 작업 규칙 '평가 전에 끌 것').
- [ ] 마지막: 키오스크 첫 화면(또는 장면 ①을 위해 자리 비움 화면), 실행 중·정지 대기·비상 대기 표시 없음.

## 출처

- [결선 발표 대본](발표/결선-발표-대본.md) · [슬라이드 구성](발표/슬라이드-구성.md) · [공감지능 근거 자료](발표/공감지능-근거-자료-2026-10-25.md) · [질의응답 대비](질의응답-대비.md)
- [10/25 devlog](devlog/devlog_2026-10-25-presence-handover.md) · [10/26 devlog](devlog/devlog_2026-10-26-desktop-empathy.md) · [인계 2026-10-26 모터·매핑·촬영](archive/인계-2026-10-26-모터-매핑-촬영.md)
- 지난 판: [v3](archive/본선-시연-시나리오-v3.md) · [시연 v3 구현 갭](archive/시연-v3-구현-갭.md) · [전문가 의견 대응표](전문가의견-대응-2026-09-29.md)
- 하드웨어 근거: [motion-bringup](devlog/devlog_2026-10-12-motion-bringup.md) · [thinq-sdk](devlog/devlog_2026-10-13-thinq-sdk.md) · [outlet-module](devlog/devlog_2026-10-05-outlet-module.md) · [솔레노이드 안전 전달표](archive/솔레노이드-안전-전달표-2026-10-16.md)
