Seongwonp/Simplelay/docs/안전계약-적용-보고-2026-10-15.md

# Touch Bridge 안전 계약 → SimpleLay 적용 보고 (2026-10-15, 보고서 — 코드 수정 전)

같은 팀의 한이음 프로젝트 **Touch Bridge**(시각장애인용 가전 입력 대행)의 안전 계약 논문이 ACK 2026 포스터로 게재 확정됐다
(게재가, 심사 8점 — "안전 계약 구조화는 우수하나, 물리적 제어를 다루면서 실물 하드웨어 검증이 없다").
SimpleLay와 갠트리·모터·모션 펌웨어 제어 핵심을 같이 쓰므로, 세 계약을 SimpleLay 코드에 대 보고 두 프로젝트 공통의 첫 실물 정지 시험을 설계했다.

- 방법: SimpleLay 코드 읽기 + 저장소 밖 재현 스크립트 1회(실제 서비스 객체에 가짜 실행기). Touch Bridge 쪽은 문서·작업 기록·블로그를 읽기만 했다.
- **이 문서의 '빠짐·일부만' 판정은 코드·재현 기준이다. 실물로 확인한 정지는 모터 축 시험대(벨트·솔레노이드 없음)의 이동 중·누름 중 단일 정지뿐이다**
  ([10/13](devlog/devlog_2026-10-13-desktop-board.md) 10회, [10/14](devlog/devlog_2026-10-14-desktop-board.md)). 다단계 시퀀스 중간 정지·루틴 정지·Wi-Fi 끊김·보내기 전 정지는 **실물 미검증**이다.
- **배포 갱신(10/16 밤):** 아래 G1~G11·R1 수리는 모두 `845569e`에 들어 있고 RPi4·RPi5에 같은 이미지로 배포했다. 실물 확인(§3 PS-1)은 ESP32 모션 보드가 돌아온 뒤 한다(지금 RPi4는 모의 모션). 아래 '보드 미배포'는 작성 당시 기록이다.
- 코드 수정은 이 보고를 확인받은 뒤에 한다. **G2·G1·G11은 수리했다(10/15, 브랜치 `fix/g2-g1-g11`, 보드 미배포)** — [수리 devlog](devlog/devlog_2026-10-15-safety-g2-g1-g11.md), 아래 §2 표.
  **G3·G7도 수리했다(10/16, 브랜치 `fix/g3-g7`, 보드 미배포)** — [수리 devlog](devlog/devlog_2026-10-16-safety-g3-g7.md).

## 0. 요약

| 계약 | SimpleLay 상태 | 가장 큰 빈칸 |
|---|---|---|
| ① 확인 기반 피드백 | 정지 단계(보냄·모션 보드 응답·멈춤 확인)와 엄격한 짝짓기는 **이미 지킴** | 승인·루틴 경로에서 링크가 끊기면 **결과 안내 없이 조용히 끝남**(G1). 일부 화면 문구가 확인 없이 '멈췄어요/눌림 확인'을 씀(G6) |
| ② 정지 전파 | 정지 우선 경로·MCU 큐 비우기·정지 뒤 재홈/재누름 금지는 **이미 지킴**. 토큰 대신 **공유 플래그를 매번 다시 읽는 구조** | **접수 뒤·보내기 전 정지가 사라져 전 시퀀스가 실행되고 '성공'**(G2, 재현). 루틴 구간 사이 정지가 다음 구간으로 이어짐(G3) |
| ③ 보수적 해석 | 규칙은 전체 일치만(이미 지킴), 승인 카드가 많은 경로를 대신 막음 | **텍스트·홈 음성의 "멈춰"·"그만"이 전자레인지 '취소' 버튼 누름으로 해석됨**(G7) — 정지어 우선 판정이 서버에 없다 |

논문의 결함 유형 (a)누름 중 정지·(b)버튼 사이 정지·(c)전송 시작 전 정지·(d)실행 중 끊김이 SimpleLay에서도 **(a)는 실물로 막힘을 확인, (b)(c)(d)는 구조적 빈칸이 있음**(아래 G2·G3·G1·G5).

## 1. 계약별 대조

### 1-1. 계약 ① 확인 기반 피드백

| 하위 규칙 | 상태 | 근거 | 시험 |
|---|---|---|---|
| 정지 결과를 보냄/응답/확인으로 나눔 | 이미 지킴 | `rpi/controller/serial_motion.py:665-670`(sent<mcu_ack<verified), `rpi/services/stop_confirm.py:19-32`(모르는 값은 sent로 낮춤), `rpi/api/router.py:997-1001` | `test_stop_confirm.py` 14건, `test_stop_report_rpi5.py` — **실물 10/13·10/14** |
| 실행 결과를 수신/확인으로 나눔 | 일부만 | `rpi/commands/physical.py`(receipt_of·confirmation_of) | 직접 실행 경로에서 링크 끊김을 `failed`·"완료하지 못했어요"로 단정(`rpi/api/service.py:624, 652-654`) — 실제로는 RPi4가 다 눌렀을 수 있어 '미확인'이어야 함(G5) |
| '확인' = 제어기 응답(가전 완료 아님) | 이미 지킴 | `stop_confirm.py:4-6, 37-43` — 멈춤은 엔코더 확인(`verified`)일 때만 | 키오스크가 `mcu_ack`에 확인색 ✓(→ [키오스크 계획](archive/키오스크-문구-개선-계획-2026-10-15.md)에서 수정 예정) |
| 정지 응답은 정확한 형식만(TEMP_OK류 배제) | 이미 지킴 | MCU 응답은 보낸 정지 id·`ok:true`일 때만(`serial_motion.py:1160-1178`), 사건 줄은 확인으로 세지 않음(`:1201-1210, 1403-1414`), RPi5↔RPi4는 `stop_id` 짝·필드 허용 목록·서명 프레임(`rpi/services/act_client.py:892-896, 1088-1104, 852-858`) | `test_stop_confirm.py::test_ack_of_an_older_stop_does_not_confirm_a_newer_one` 외 4건 |
| 완료 문구는 확인됐을 때만 | 일부만 | 서버 문장은 보수적. 클라이언트: 폰 수동 조작이 `succeeded`만 보고 "눌림을 확인했어요"(`app/lib/screens/manual_control_screen.dart:114, 330`), "실행을 멈췄어요" 머리말이 `sent`에도 붙음(`app/lib/models/command_result.dart:224-225`, 키오스크 음성 `kiosk_screen.dart:1179-1180`) | 수동 조작 조건은 시험 없음 |
| 결과·실패·정지 안내가 늘 사용자에게 감 | **빠짐(경로별)** | G1(승인 경로 끊김 무음), 폰 실행 중 정지 결과가 다음 폴링에 덮임(`app/lib/providers/execution_status_provider.dart:250`), 키오스크 실행 화면 정지가 HTTP 실패·시간 초과를 삼킴(`rpi5-touchscreen-app/lib/services/kiosk_api_service.dart:778-780`) | 없음 |

### 1-2. 계약 ② 실행 토큰 기반 정지 전파

| 하위 규칙 | 상태 | 근거 | 시험 |
|---|---|---|---|
| 시작 토큰을 최하위 함수까지 인자로 | **빠짐(구조가 다름)** | 층마다 **공유 플래그를 다시 읽음**: RPi5 `_stop_requested_this_run`·`_stop_sticky`(`service.py:303`, `service_commands.py:170`), RPi4 `_stop_requested`(`rpi/controller/closed_loop.py:129`), 어댑터 `_stop`(`serial_motion.py:1009`). `_run_generation`은 정지 **보고**를 실행에 묶는 데만 씀 | — |
| 매 전송 전·매 대기 뒤 비교 | 일부만 | 버튼 전·재시도 경계·누름 직전(`closed_loop.py:220, 332, 350, 371`), 이동·누름 전(`serial_motion.py:959, 985`), 시나리오 단계 사이(`service_commands.py:384-400`), 루틴 구간 사이(`rpi/routines/runner.py:426, 434, 466`) | `test_closed_loop.py::test_emergency_stop_between_buttons` 외. 빈칸: RPi5 보내기 직전(G2), 어댑터 잠금 대기 뒤(G4, 10/16 실제 쓰기 잠금 안 재확인으로 수리·보드 미배포), 루틴 대기 뒤(G3) |
| 정지 뒤 남은 명령·복구 이동 미전송 | 일부만 | MCU `cmd_stop`이 큐를 비우고 진행 중 명령을 `stopped`로(`firmware-motion-corexy/src/main.cpp:615-635`), 정지 뒤 재홈·재누름 없음(`serial_motion.py:970-975, 1334`) | `test_serial_motion.py::test_uncertain_press_never_rehomes_or_represses_in_same_run`. **설계상 예외:** 정지 버튼 위 대기(hold) 중 정지는 '가전 정지 버튼 누름'이라는 이동·누름을 일으킨다(G10) |
| 정지는 일반 큐 우회·즉시 | 이미 지킴 | RPi5 정지 전용 실행기(`rpi/api/stop_lane.py:32-41`), abort는 대기 요청과 무관(`act_client.py:568-579`), 어댑터 정지는 동작 잠금을 거치지 않음(`serial_motion.py:1002-1031`), 펌웨어 stop은 큐 앞에서 처리 | `test_eval_recheck2_stop.py` 외 — 10/16 G9 수리: hold 해제 대기는 별도 task, 수신 루프 abort 지연 재현 후 제거(시험 조건만·보드 미배포) |
| 한 번 누름 정지 | 이미 지킴(화면 일부 빠짐) | 폰 `app_shell.dart:155-156`, 키오스크 `executing_view.dart:180-203` | 폰 수동 조작 화면·승인 요청 진행 중(최대 8 s)은 정지 버튼 없음 |
| 실행별 '정지 요청' 기록을 보내기 직전 확인 | 일부만 | RPi5 기록 있음(`service.py:1194-1212`), 시나리오 단계는 확인. **직접 실행 경로는 보내기 전 확인 안 함**(`service.py:866-870`). RPi4는 실행 시작 전 abort를 'idle'로 버림(`rpi4/services/act_executor.py:1080-1081`) | 로컬 폐루프만 시험 있음 |
| 사용자 정지와 끊김 구분 | 일부만 | 이력 `STOPPED_BY_USER`/`MOTION_ABORTED`(`service.py:788-802`), 직접 경로 끊김 문장 | 승인 경로는 끊김을 기록조차 안 함(G1) |
| 끊기면 제어기가 원점·누름 허가 해제 | 일부만 | MCU 호스트 워치독 2 s: 동작 중이면 알람+원점 버림(`main.cpp:482-485`), **쉬는 중이면 출력만 내리고 원점 유지**(`:491-492`). 누름은 위치 기준·허용 오차를 다시 봄(`:597-605`) | `test_serial_motion.py::test_timeout_sends_stop_and_requires_rehome`. Touch Bridge 규약 v2는 "끊기면 언제나 homed=false"로 더 엄격 |

### 1-3. 계약 ③ 보수적 명령 해석

| 하위 규칙 | 상태 | 근거 |
|---|---|---|
| 비상 정지어를 가장 먼저 | **빠짐(서버)** / 일부만(폰) | 서버 해석기에 정지어 단계가 없어 **"멈춰"·"그만"·"정지해줘"가 전자레인지 '취소' 버튼 누름**이 됨(`rpi/intent/rules.py:38, 71-76`) — 시험 `test_rules.py::test_default_aliases_resolve_to_canonical_sequence`가 이 동작을 **고정**. 폰 정지 듣기는 실행 중일 때만 `/stop`(`app/lib/providers/voice_stop_provider.dart:20-47`) |
| 부정문은 규칙으로 실행하지 않음 | 일부만(부수 효과) | 부정 처리 코드는 없고 규칙이 전체 일치라 걸러질 뿐. 벡터 검색(임계 0.75)·LLM에서는 실행될 수 있음(추정) |
| 규칙은 전체 일치, 나머지는 AI | 이미 지킴 | `rules.py:17, 92`, ThinQ 목적도 전체 일치 |
| 상한 초과는 줄이고 되묻기 | 빠짐(거절로 대체) | 범위 밖은 거절(`rpi/commands/args.py:36-44`) — 보수적이긴 함 |
| 인식 신뢰도 낮으면 확인 | 일부만 | 신뢰도는 안 쓰지만 들은 문장을 보여 주고 '이대로 실행'을 눌러야 보냄(`app/lib/screens/voice_screen.dart:141-149`) |
| AI 응답 검증 | 일부만 | LLM 출력 형식·어휘 검사(`rpi/intent/llm.py:20-38, 62-83`), 그러나 서버 실행용 LLM은 버튼 어휘 제약 없이 생성(`rpi/api/deps.py:203-205`) |

승인 카드는 '보여 준 명령 = 실행할 명령'만 보장한다. 해석이 맞는지는 보장하지 않으며, 카드를 거치지 않는 경로(`/execute`, `/execute-buttons`, `/thinq/command`, 허용된 자동 실행)가 있다.

## 2. 빈칸 — 안전 영향 순 (수리 후보 — G1·G2·G11·G3·G7·G5는 수리(커밋), G4·G9는 10/16 수리, G10은 동작 유지·문서화)

수리한 행의 '수리 방향' 칸 끝에 상태를 적었다. **수리(커밋)는 시험 조건(가짜 실행기·가짜 MCU)에서 확인한 것이고 실물 미검증이다** — RPi5·RPi4를 같은 커밋으로 다시 배포한 뒤 §3 PS-1(S4·S5·S6, 엔코더 선 뺀 정지)로 확인한다.

| # | 영향 | 논문 유형 | 내용 | 수리 방향(제안) |
|---|---|---|---|---|
| **G1** | 높음 | (d) + 거짓 성공 | 승인 카드·루틴·시나리오의 물리 단계에서 링크가 끊기면 예외가 로그로만 남고 **결과·이력·보호자 알림 없이 끝난다**. `/status`에는 이 job 번호에 **직전 실행의 결과**가 붙는다(`service_commands.py:371-377, 502-508`). 시연의 '첫 조리 승인'이 이 경로다. **재현함** | 물리 단계 예외를 '수신 불명·미확인' 결과로 바꿔 기록·안내·보호자 알림까지 보낸다 · **수리(커밋 `fbb8ea9`)** — 수신 unknown·`unconfirmed`·"연결이 끊겨 눌렸는지 확인하지 못했어요 …", 이력·보호자 알림·완료 이벤트·이 job의 `/status`, 남은 단계 미전송. 직접 경로도 같은 분류·문장(G5 문구 부분만) |
| **G2** | 높음 | (c) | 접수 뒤·보내기 전에 온 정지가 사라진다 — RPi5는 abort만 보내고 기록만 세우고, RPi4는 아직 쉬는 중이라 abort를 버리며, 뒤이어 온 실행 요청을 **전부 실행하고 '성공'**. **재현함**(정지 뒤 버튼 3개 전송, succeeded) | RPi5가 실행 요청을 보내기 직전에 정지 기록을 확인하고, RPi4는 실행 시작 전에 받은 abort를 다음 실행 요청과 짝지어 거절 · **수리(커밋 `01590aa`·`fdf0272`)** — RPi5 보내기 직전 확인 + 링크 이벤트 루프 안 재확인(`stopped`·`not_dispatched`), RPi4는 실행 표지 `run_ref`로 같은 실행의 execute를 누르지 않음(하위 호환 규약 확장) |
| **G3** | 중상 | (b) | 루틴 구간 사이 정지가 다음 구간으로 이어질 수 있다 — `/stop`이 루틴 취소를 맨 마지막에 세우고(`router.py:978-986`), 루틴은 대기 뒤 다시 보지 않으며(`runner.py:446-455`), 다음 실행 시작이 정지 기록을 지운다(`service.py:688-692`) | `/stop`에서 루틴 취소를 먼저, 대기 뒤 재확인, 실행 시작 리셋이 루틴 정지를 지우지 않게 · **수리(커밋 `fdc21f6`)** — `/stop` 맨 앞에서 루틴 정지 표시(메모리, 입출력 없음), 다른 명령을 기다린 뒤 재확인, 다음 구간의 실행 시작 게이트(서비스 잠금 안)에서 루틴 정지 표시를 보고 시작 거절. 구간 결과에 정지 표시가 있으면 버튼을 다 눌렀어도 루틴은 `stopped`·기존 정지 문장("…으로 남은 단계를 보내지 않았어요"). RPi4·규약 변경 없음 |
| **G4** | 중 | (a) | 정지 확인 뒤 동작/쓰기 잠금 대기 중 정지가 끝나도 home·move·press가 뒤늦게 전송됨 — 메모리 시리얼·가짜 MCU로 재현 | **수리(10/16, 작업 트리·보드 미배포):** 실제 쓰기 잠금 안에서 동작 전송 직전 정지 재확인. 정지 뒤 status는 유지. 수정 전 10건 실패, 정상 경로 1건 통과. MCU 유휴 원점 정책(G8)은 변경 없음. [기록](devlog/devlog_2026-10-16-safety-g4-g9-g10.md) |
| **G5** | 중 | (d) 변형 | Wi-Fi가 조용히 끊기면 RPi4가 남은 버튼을 계속 누를 수 있고(연결 감지까지 약 11 s 추정), RPi5는 '완료하지 못했어요'로 단정. **추정** | 실행 중 RPi5→RPi4 생존 신호, 끊기면 RPi4가 스스로 정지. RPi5 문구는 '미확인' · **수리(이번 커밋)** — RPi4가 `act_info.heartbeat_protocol`을 알리면 RPi5가 `execute`에 `heartbeat_s`(기본 1 s)를 싣고 결과까지 `heartbeat`를 보낸다(링크 이벤트 루프 작업 — 정지 경로·공용 스레드 풀과 무관). RPi4는 그 실행에서 인증된 줄이 `max(3 s, 주기×3)` 넘게 없으면 받은 정지와 같은 길(`request_stop` → MCU 정지, 재홈·재누름 없음)로 멈추고 `safety_stop`·`abort_reason: motion_link_lost`, 다시 이은 뒤 `act_info.last_link_stop` 한 번 → RPi5 보호자 알림. RPi5는 그 결과도 끊김과 같은 '눌렸는지 모름'(G1 문장), 링크 소켓에 `TCP_USER_TIMEOUT` 11 s. 주기·제한 시간은 추측값(측정 필요). 하위 호환이지만 **RPi4·RPi5 같은 커밋 배포** — [devlog](devlog/devlog_2026-10-16-safety-g5.md) |
| G6 | 중 | ① | 정지 결과가 사용자에게 가지 않는 화면(폰 실행 중 정지 결과, 키오스크 정지 실패, 폰 수동 조작 확인 문구) | 키오스크 계획과 묶어서 |
| **G7** | 중 | ③ | 텍스트·홈 음성 "멈춰"가 '취소' 버튼 누름. 쉬는 중이면 실제로 누른다 | 서버 해석 맨 앞에 정지어 판정 → `/stop` 의미로. 고정 시험 수정 · **수리(커밋 `fdc21f6`)** — `/execute`·`/execute-for-appliance`가 해석 전에 **발화 전체**가 정지어(폰 실행 중 음성 정지와 같은 목록·판정, `rpi/intent/stop_words.py`)인지 보고, 정지어면 `/stop`과 같은 일을 한 뒤 `status: "stopped"`+`stop`을 돌려준다(버튼 누름·새 job 없음). 서비스 목적 실행도 정지어를 거절(두 번째 방어), 규칙 별칭에서 정지어 삭제(벡터 예시에서도 빠짐). '취소'·'취소해줘'는 그대로 '취소' 버튼. 폰 홈 음성도 정지어면 `/execute` 대신 정지 버튼과 같은 정지를 보내고, 서버의 `stopped` 응답은 따라가지 않는다(devlog §3) |
| G8 | 낮음~중 | ② | 쉬는 중 끊김에 MCU 원점 유지, RPi4 재시작 뒤 그대로 믿음(추정) | 재시작 뒤 원점 재확인 요구 검토 |
| G9 | 중 | ② | 실제 수신 루프가 새 execute의 이전 hold 해제/join을 기다려 뒤의 abort 수신이 지연됨 — 실제 hold·어댑터·가짜 MCU로 재현 | **수리(10/16, 작업 트리·보드 미배포):** 준비부터 실행 자리를 예약하고 별도 task로 대기. 수신 루프는 정지를 계속 읽고, 준비 중 정지가 오면 새 실행은 버튼 0개 stopped. 중복 execute는 busy. [기록](devlog/devlog_2026-10-16-safety-g4-g9-g10.md) |
| G10 | 기록 | ② | 실행 중 정지는 구동부 중단, hold의 일반 정지는 가전 취소 버튼 누름, drive·비상정지는 누르지 않음 | **동작 유지·의미 문서화(10/16):** 아래 §2-1과 회귀 시험 6건. G4·G9 수리 전에도 6건 통과. 실물 판정 아님 |
| **G11** | 중상 | ① | **엔코더가 죽어도 '멈춤 확인(verified)'이 뜬다** — 10/13 발견 6: 엔코더 선 접촉 불량으로 0만 읽는 상태에서도 "멈춘 것을 확인"이 떴다. '값이 안 변함'만으로 멈춤을 판정하기 때문(하드웨어 검토 10/15 지적) | 정지 전 이동 구간에서 엔코더가 실제로 변했는지(살아 있음)를 확인한 경우에만 `verified`, 아니면 `mcu_ack`에 머문다. 엔코더 단선 감지 시 '확인 불가' · **수리(커밋 `5777350`)** — 이번 실행에 이동을 명령한 축마다 엔코더 값이 바뀐 것을 본 경우에만 `verified`, 아니면 `mcu_ack`+"엔코더 움직임을 확인할 수 없어 멈춤은 확인하지 못했어요". 이동 없는 쉬는 중 정지도 `mcu_ack`(결정) |

**수리 순서 제안:** G2·G1(시연 경로) → G3 → G7 → G4·G5 → 나머지. 각 수리는 **고치기 전 재현 시험이 실패하는 것을 먼저 확인**한다.

### 2-0. R1 — 버튼 성질별 자동 재누름 (2026-10-16)

**수리: `16ea5ac` 위 이번 작업 트리, 시험 조건만·보드 미배포.** [수리 기록](devlog/devlog_2026-10-16-r1-docs.md).

| 분류 | 내장 버튼 | 미확인 때 |
|---|---|---|
| toggle | 전자레인지 시작·취소, 인덕션 전원·시작·취소 | 첫 시도 뒤 L1 보정·L2 재입력 0회, 뒤 단계 중단·미확인 안내 |
| idempotent(재누름 허용) | 전자레인지 10초·30초·1분·5분 | 기존 폐루프 재시도 유지. 시간 누적 위험은 실측 전이며 무해함을 보장하지 않음 |
| unknown | 전자레인지 라면·해동·즉석밥·냉동식품, 나머지 인덕션 버튼, 성질 누락·잘못된 값 | toggle과 같음 |

공유 폐루프에서 L1·L2를 막고 서비스→링크→RPi4 실행기까지 선택 필드를 전달한다. 미확인은 실패 단정 없이 기록·상태·완료 이벤트로 전달한다.
RPi4·RPi5 **같은 커밋 배포 필수**([규약](protocol.md)). L2의 운영 센서 연결은 별도 미완료이며 이번 검증은 합성 L2 판정이다.
사람이 전체 순서를 새로 실행하면 앞에서 성공한 토글도 다시 누를 수 있다. 확인 창·재실행 동작은 이번 범위 밖이라 바꾸지 않았다.

### 2-1. G10 — 정지 대상과 실제 동작 (10/16)

| 상황 | 요청/사건 | 팔 동작 | 확인 범위·다음 행동 |
| --- | --- | --- | --- |
| 실행 중 | 일반 정지·drive 정지 | 진행 동작 중단, 남은 버튼 미전송. 가전 취소 버튼을 새로 누르지 않음 | sent/mcu_ack/verified는 구동부 근거. 가전 상태는 별도 확인 |
| 가전 정지 버튼 위 대기(hold) | 일반 정지 | 등록된 취소 버튼 횟수만큼 누르고 결과 관찰; 전력 하강 확인 시 보관 이동 | 이 경로는 '정지 뒤 이동·누름 없음' 계약의 의도된 예외. 연속 요청으로 누름 횟수를 더하지 않음 |
| hold | drive 정지 | 구동부 중단·잠금. 취소 누름·자동 보관 없음 | 가전을 직접 확인해야 함 |
| 실행/hold | 콘센트 모듈 비상정지 사건 | 구동부 정지·래치. 취소 누름 없음 | 콘센트 릴레이 차단과 모터 전원 차단은 별개. 실제 전원 차단 범위는 회로로 확인 |
| 다음 실행을 위해 hold를 해제하는 중 | 일반 정지·drive 정지 | 이전 hold의 구동부 정지, 대기 중 새 실행도 시작하지 않음 | 새 실행은 버튼 0개 stopped. 사람이 새로 요청하기 전 자동 재개 없음 |

근거: `rpi4/services/act_executor.py`의 `_abort`·`handle_outlet_estop`·`_prepare_and_execute`, `rpi4/services/stop_hold.py`의 `drive_stop`·`_run`.
시험: `rpi4/tests/test_safety_g10_stop_meaning.py`(6건, 기존 동작 고정), G9 준비 중 정지는 `test_safety_g9_hold_dispatch.py`.
G6·G8과 R1의 사람이 새로 실행하는 경로는 열려 있다. R1 자동 재누름은 아래 정책으로 수리했다(시험 조건만·보드 미배포). **RPi4 실행 코드가 바뀌므로 RPi5·RPi4 같은 커밋 배포 뒤 PS-1 확인 필요.**
솔레노이드 장착 전에는 [HW 전달표](archive/솔레노이드-안전-전달표-2026-10-16.md)를 먼저 확인한다.

## 3. 두 프로젝트 공통 첫 실물 정지 시험 (PS-1)

논문 결론의 향후 과제("실제 제어기에 같은 정지 시나리오를 주입하여 대기 명령의 폐기 여부와 모터 정지까지의 응답 시간을 측정")와 심사평의 '실물 미검증'에 바로 답하는 시험이다.
**같은 기계·같은 판정 기준, 전송 경로는 각자.**

### 3-1. 전제와 차이

| 항목 | SimpleLay | Touch Bridge |
|---|---|---|
| 전송 | 폰·키오스크 → RPi5(HTTP) → RPi4(Wi-Fi) → USB 시리얼, 줄 단위 JSON | 폰 → BLE → ESP32, 규약 v2 JSON(또는 레거시 G-code) |
| 펌웨어·보드 | `firmware-motion-corexy`(원작 제어 핵심 + SimpleLay 규약, BLE·v2 제거)를 올린 **SimpleLay용 ESP32** | 원작 펌웨어 v3를 올린 **Touch Bridge용 ESP32** — 갠트리·모터는 같은 1대이고 **ESP32만 프로젝트별로 다르다**(사용자 확인 10/15). 펌웨어를 바꿔 올릴 필요 없이 **보드만 바꿔 끼워** 같은 기계에서 두 시험을 한다 |
| 정지 응답 | 진행 중 명령 `{"id":n,"ok":false,"error":"stopped"}` + 정지 `{"id":s,"ok":true}` | 같은 commandId의 `STOPPED`(규약 v2: 1초 안) |
| 정지 뒤 원점 | 동작 중일 때만 버림 | 규약 v2: 언제나 버림 |
| 끊김 | 호스트 워치독 2 s(동작 중이면 원점 버림) | 규약 v2: homed=false(펌웨어 구현 여부 확인 필요) |

**안전 준비:** 벨트 장착 전에는 모터 축만(1단계), 장착 뒤 캐리지·솔레노이드(2단계). 실제 가전 대신 **골판지 더미 패널**. 손이 닿는 곳에 전원 차단(물리 E-STOP 또는 전원 스위치) — 소프트웨어 정지가 실패하면 바로 끊는다. 한 사람은 기록, 한 사람은 차단 담당.

### 3-2. 기록 장치

- **호스트 쪽 전송 기록:** SimpleLay는 RPi4 어댑터가 시리얼로 쓴 줄과 받은 줄을 시각과 함께 남긴다(세션 기록 `SIMPLELAY_SESSION_LOG_PATH` + 어댑터 송수신 기록). Touch Bridge는 앱의 BLE 쓰기 기록(논문의 가상 전송 계층 자리에 실제 전송 기록).
- **제어기 쪽 수신:** MCU가 정지 뒤 받아들인 동작 명령 수 — 정지 뒤 이동·누름 요청에 대한 MCU 응답(`ok`/거절)으로 센다. 가능하면 펌웨어 시험 빌드에 '받은 명령 카운터'를 상태에 싣는다(시험 전용, 결정 필요).
- **엔코더:** 위치 사건(a·b 카운트)을 10 Hz 이상으로 기록. **멈춤 = 0.1 s 간격 두 번 연속 a·b 변화 없음**(SimpleLay `verified`와 같은 정의).
- **영상:** 폰 카메라 고속 촬영(가능하면 240 fps)으로 갠트리와 화면을 한 프레임에. 사람이 정지 뒤 움직임 유무를 판정하는 근거.
- **시계:** 구간 시간은 **같은 기기 시계** 안에서만 잰다(RPi4: 정지 전송~MCU 응답~엔코더 정지). 폰·RPi5가 끼는 구간은 SimpleLay 시계 기준점(`clock_ref`)으로 환산하고 환산했다고 적는다.

### 3-3. 시각 정의

| 기호 | 뜻 | 측정 기기 |
|---|---|---|
| t0 | 사용자가 정지를 누름(앱·키오스크 기록) | 폰·키오스크 |
| t1 | 정지가 제어기로 나감(시리얼 쓰기 / BLE 쓰기) | RPi4 / 폰 |
| t2 | 제어기 정지 응답 받음 | RPi4 / 폰 |
| t3 | 엔코더 멈춤 첫 확인 시각 | RPi4(엔코더 사건) |
| t4 | 화면·음성에 결과 표시 | 폰·키오스크 |

보고 값: **응답 t2−t1**, **정지 시간 t3−t1**, **전체 t4−t0**(환산 표시), **정지 뒤 호스트 전송 줄 수**, **정지 뒤 MCU가 받아들인 동작 수**, **사람 관찰 정지 뒤 움직임**.

### 3-4. 시나리오

| # | 시나리오 | 논문 대응 | 주입 방법 | 반복 | 비고 |
|---|---|---|---|---|---|
| S1 | 이동 중 정지 | — | 버튼 3개 시퀀스, 첫 이동 중간 | 10 | SimpleLay 모터 축은 10/13 확인 — 캐리지로 다시 |
| S2 | 누름 중 정지 | (a) | 솔레노이드 켜진 동안(2단계) | 10 | 1단계는 누름 신호만 |
| S3 | 버튼 사이 대기 중 정지 | (b) | 첫 버튼 끝난 직후 대기 구간 | 10 | 다음 버튼 이동·누름 0이어야 |
| S4 | 전송 시작 전 정지 | (c) | 승인 직후 첫 명령이 나가기 전(SimpleLay: 승인 → 0.2 s 안 정지) | 10 | **SimpleLay 현재 코드는 실패 예상(G2)** — 수리 전 기준선으로 기록 |
| S5 | 실행 중 연결 끊김(정지 없음) | (d) | SimpleLay: RPi4 Wi-Fi 끄기 / USB 뽑기, Touch Bridge: BLE 끊기 | 5 | 제어기가 워치독 안에 멈추는지, 화면이 '미확인/끊김'인지. **G5 수리 뒤(시험 조건만):** RPi4가 마지막 줄 뒤 제한 시간(3 s, 추측값) 안에 스스로 멈추는지(실행기 로그 "stopping by myself"), 다시 이은 뒤 보호자 알림 한 건 — 끊김 뒤 남은 누름 수·멈출 때까지 시간을 잰다 |
| S6 | 루틴 구간 사이 정지 | (b) 변형 | SimpleLay 전용: 두 장치 루틴 첫 구간 끝 직후 | 5 | **실패 예상(G3)** → 10/16 수리(시험 조건만, 보드 미배포) — 배포 뒤 '다음 구간 전송 0·루틴 `stopped`' 확인 |
| S7 | 쉬는 중 정지 뒤 새 명령 | — | 정지 → 바로 이동 명령 | 5 | 원점 처리 차이(G4·G8) 관찰 |

**하드웨어 검토(10/15)로 더한 시나리오:**

| # | 시나리오 | 왜 |
|---|---|---|
| S0 | 보드 교체 직후 점검 — 축마다 방향, 10 mm 이동 카운트(보드별 환산 계수), 부팅·정지 직후 브레이크/풀림(손으로) | 핀·엔코더 배율·STBY 처리가 펌웨어마다 다를 수 있음 |
| S8 | **물리 E-STOP(전원 차단) vs 소프트웨어 정지의 정지 거리** | TB6612는 전원이 살아 있으면 쇼트 브레이크, 끊으면 브레이크 없이 미끄러질 수 있어 **최후 수단이 더 늦게 멈출 수 있음**(추정) |
| S9 | 원점 복귀(스톨 홈) 중 정지 | — |
| S10 | 큐가 찬 상태에서 정지 → 큐가 비워지는지(Touch Bridge 32칸) | 큐 크기 차이 |
| S11 | 연속 정지, 정지 직후 다시 실행 | — |

**측정 보강:** 엔코더 A/B를 **로직 분석기**에 분기해 두 보드에 같은 장비로(시험 대상 보드가 스스로 '멈춤'을 보고하는 것에 의존하지 않음 — G11). 정지를 받는 순간 ESP32가 **LED/GPIO 토글** → 240 fps 영상 한 프레임에 LED와 캐리지를 함께 찍어 같은 시계로 비교. 회차마다 **모터 전원 전압** 기록, 두 보드는 같은 날 같은 전원으로 연달아. 두 펌웨어의 PID·가속도 값 표를 결과에 같이 싣는다.

**합격 기준은 시간보다 정지 거리(mm)를 우선:** 예 — 정지 뒤 캐리지 이동 < 버튼 최소 간격의 절반, 정지 뒤 솔레노이드 작동 0회. 시간 기준은 캐리지를 단 상태 10회의 최대값에 여유를 두어 확정(규약 v2의 1 s는 위쪽 한계로만).

**순서:** 1단계(모터 축) S0·S1·S3·S4·S5·S7 → 벨트·솔레노이드 장착 뒤 2단계 전체 + S8~S11.

**솔레노이드 단 뒤 먼저 볼 것(공통 기구 — 한 번 재면 두 프로젝트 공통 사실):**
누름 유지 중 정지·전원 차단·ESP32 리셋(플래시·브라운아웃) 때 플런저가 풀리는 시간과 최대 켜짐 시간 — 최대 켜짐 시간이 가전의 '길게 누름' 기준보다 짧아야 한다. HW 확인: MOSFET 게이트 **풀다운 저항**, **플라이백 다이오드**, 솔레노이드가 **스프링 복귀형**인지, 솔레노이드 돌입 때 로직 전압 최소값(브라운아웃).
세로 설치 시 쉬는 중 출력 해제로 캐리지가 **중력으로 처지는지**도 실측(원점 유지 정책 G8과 연결). 각 시나리오는 **같은 펌웨어·같은 커밋**으로 묶어 실행하고 SHA를 적는다.

### 3-5. 기록 양식 (한 줄 = 한 회)

| 날짜·시각 | 프로젝트 | 커밋/펌웨어 | 시나리오·회차 | 주입 시점 | t2−t1(ms) | t3−t1(ms) | t4−t0(ms, 환산) | 정지 뒤 호스트 전송 줄 | 정지 뒤 MCU 수락 동작 | 영상상 정지 뒤 움직임 | 화면 문구 | 단계(sent/mcu_ack/verified) | 원점 상태 | 비고 |
|---|---|---|---|---|---|---|---|---|---|---|---|---|---|---|

원본 기록(시리얼·BLE·엔코더·영상)은 저장소 밖에 두고 파일 이름만 적는다. 기존 [실측 기록표](실측-기록표.md)에 PS-1 절로 옮긴다.

### 3-6. 합격 기준 (값은 실측 후 확정)

| 항목 | 기준 |
|---|---|
| 정지 뒤 호스트 전송 동작 줄 | **0** (모든 회) — 계약 정의 |
| 정지 뒤 MCU가 받아들인 동작 | **0** (모든 회) — 계약 정의 |
| 영상상 정지 뒤 새 움직임 | **0회** (감속 중 관성 이동은 별도 기록) |
| 정지 응답 t2−t1 | 중앙값 ≤ [실측 후 확정] ms, 최대 ≤ [실측 후 확정] ms (Touch Bridge 규약 v2 상한 1 s 참고) |
| 정지 시간 t3−t1 | 중앙값 ≤ [실측 후 확정] ms, 최대 ≤ [실측 후 확정] ms |
| 화면 문구 | 실제 단계와 **100% 일치**(보냄을 멈춤으로 말한 회 0) |
| 끊김(S5) | 제어기 스스로 멈춤 ≤ [실측 후 확정] s(워치독 2 s 설계값), 화면은 '미확인/끊김' — '완료·성공' 0회 |

**보고 방식:** 표는 회차 전부. 실패 회는 숨기지 않고 원인(G 번호)과 함께. "앱 쪽 0줄"과 "제어기 쪽 0줄"과 "영상상 정지"를 따로 말한다 — 논문이 구분한 것과 같다.

### 3-7. 논문·포스터에 쓸 때

**SimpleLay 실측 인용 범위(하드웨어 검토 10/15):** "같은 갠트리·모터·드라이버·엔코더를 쓰는 연계 프로젝트에서, 다른 ESP32·펌웨어로 모터 축 시험대(벨트·캐리지·솔레노이드 미장착)에서 이동 중 정지 10회 — 모션 보드 응답 6~18 ms, 정지 명령 → 엔코더 멈춤 확인 중앙값 약 160 ms"까지. 단서: 개발자 조그 경로·5 mm 이동 시작 88 ms 뒤 정지·무부하, 10/14은 시험대 빌드, 엔코더 판정은 단선 시 거짓 확인 가능(G11).
**쓰면 안 되는 말:** "Touch Bridge 정지가 실물 검증됨", "정지 후 0줄이 실물에서도 확인됨", "심사평 지적 해소", 조건 없는 "정지 응답 약 10 ms".

- 진행: 같은 갠트리에 **SimpleLay ESP32 → Touch Bridge ESP32 순서로 보드만 바꿔 끼우고** 같은 시나리오를 돈다. 보드를 바꿀 때마다 배선·엔코더 방향 확인(S0: 원점·짧은 이동 1회)부터.
- Touch Bridge 포스터에 쓰려면 **Touch Bridge 보드·펌웨어·앱 경로(BLE)로 잰 회차만** Touch Bridge 결과로 말할 수 있다. SimpleLay 경로 결과는 '같은 기계에서 다른 전송 경로' 결과로 따로 적는다.
- 포스터에 넣을 수 있는 최소 결과: S1·S3·S4를 Touch Bridge 경로로 각 10회 → 정지 뒤 수락 0·정지 시간 분포. 발표일 전에 못 하면 "계획"으로만 적는다.

## 4. 재사용 경계 대조 ([reuse-boundary](reuse-boundary.md)와 실제)

### 4-1. 실제로 같이 쓰는 것

| 항목 | 판정 | 근거 |
|---|---|---|
| 기구(CoreXY 프레임·레일·벨트) | **공유** — HW 담당(서예솔)이 Touch Bridge용으로 만든 것 | [10/12 수령 기록](devlog/devlog_2026-10-12-motion-bringup.md) "하드웨어(갠트리·모터·…·ESP32)를 받아", Touch Bridge 9/7 개발보고서에 이미 CoreXY·V홈 레일 |
| Z·누름 | 펌웨어는 솔레노이드(GPIO23). Touch Bridge 문서는 아직 '스위치봇' | Touch Bridge 규약 v2·계획 문서가 10/5 솔레노이드 전환 전 상태 |
| 모터·드라이버·엔코더 | **공유** | 같은 FIT0482×2, TB6612 |
| 모션 보드(ESP32) | **프로젝트별로 따로**(사용자 확인 10/15). 같은 계열 DevKit — 10/12 첫 보드 불량으로 팀원 보드로 교체한 기록이 있어, 지금 SimpleLay에 꽂힌 보드가 어느 것인지 라벨로 구분해 둔다 | 10/12 기록 |
| 펌웨어 제어 핵심 | **파생** — 원작에 STBY·원점 버리기·PWM 채널 고정·큐 32→4 등을 SimpleLay가 수정 | 펌웨어 각 파일 머리말 |
| 펌웨어 규약 계층(줄 단위 JSON) | **SimpleLay 전용** | `host_protocol.h:1-4` |
| 원작에서 뺀 것 | BLE, 규약 v2(commandId·positionToken), 인증, G-code, `!` 즉시 정지 | `main.cpp:19-24` |
| 통신 규약 | **별개**(의미만 일부 옮김: 1회용 위치 토큰 → 위치 기준·허용 오차 검사) | — |

### 4-2. 어긋나는 문장과 교체 제안 (적용하지 않음)

| # | 지금 | 문제 | 제안 문장 |
|---|---|---|---|
| B-1 | Touch Bridge 블로그 05: "CoreXY 기구… 엔코더 모션 펌웨어… SimpleLay에서 새로 설계했다" | 근거는 반대(펌웨어 출처, 10/10·10/12 수령, Touch Bridge 9/7 보고서). 단 "줄 단위 JSON 규약·좌표 변환은 SimpleLay 신규"는 맞음 | "CoreXY 갠트리(같은 기계 1대)와 ESP32 모션 펌웨어의 제어 핵심은 HW 담당이 Touch Bridge용으로 만든 것을 SimpleLay가 함께 쓴다. 모션 보드(ESP32)는 프로젝트마다 따로 둔다. SimpleLay가 새로 만든 것은 그 위의 줄 단위 JSON 모션 규약, RPi4 좌표 변환, 호스트 안전 규약이다." (그림에 '갠트리·모션 펌웨어 핵심 → 공유' 화살표 추가) |
| B-2 | 팀 작업 규칙·README·개발완료보고서·작품소개서·개발 도구 고지: "팀원(HW)의 이전 작품 Touch Bridge" | Touch Bridge는 10/30까지 **진행 중**이고 SW 담당도 같은 사람 — '팀원 혼자의 이전 작품'이 아님 | "갠트리와 모션 펌웨어의 제어 핵심은 같은 팀 HW 담당이 한이음 Touch Bridge(2026, 10월 말까지 진행)용으로 만든 것을 공유한다." |
| B-3 | reuse-boundary·펌웨어 README: "제어 핵심은 원작 그대로" | 실제로 PWM 채널 고정·큐 크기 32→4 등 수정 | "PID·기구학·궤적·스톨 원점·추종 오차 알고리즘은 원작 그대로이고, STBY 제어·원점 기준 버리기·PWM 채널 고정·큐 크기(32→4)는 SimpleLay가 고쳤다." `Tb6612Motor.h` 머리말 "원작 그대로" → "원작 기반 — 2026-10-12 PWM 채널 고정 수정" |
| B-4 | 펌웨어 README: "컴파일만 확인… 실물 검증 0건" | 10/12~14 실물 기록과 다름 | "10/12~14 시험대(벨트·솔레노이드 없음)에서 모터 축 개루프·폐루프 구동, 엔코더 계수, 정지를 실물로 확인했다. 캐리지 이동·스톨 원점·솔레노이드 누름은 아직 하지 않았다." |
| B-5 | [하드웨어 연결 설계](하드웨어-연결-설계.md): "모션 미착수", "모션 정지 명령 없음" | 9/13 상태 그대로 | 머리에 "9/13 기록 — 현재 기준은 protocol.md·devlog 10/13" 한 줄 |

### 4-3. 확인해 주셔야 할 것

1. ~~갠트리가 실물 1대인가 2대인가~~ → **답(10/15): 갠트리·모터는 같은 1대, ESP32만 프로젝트별로 다르다.** 그래서 4-2의 "공유" 문장은 '같은 기계를 함께 쓴다'로 쓰고, 모션 보드는 '각자'로 적는다.
2. 프레임·레일·풀리·벨트를 누가 만들었나(10/12 "모터 톱니를 벨트를 잘라 만들어서"의 작업자 포함).
3. Touch Bridge 최종 결과물(10/30)이 이 CoreXY·솔레노이드·펌웨어 v3를 쓰는가 — 쓰면 Touch Bridge 규약·계획 문서의 '스위치봇'도 갱신.
4. **대회 규정:** 진행 중인 다른 공모전(한이음) 결과물과 하드웨어·펌웨어를 공유하는 것을 어떻게 적을지, 게재 확정 논문을 관련 연구로 적어도 되는지.
5. 원작 공개·라이선스 동의(제출 체크리스트 G6), 원작 작성의 AI 사용 여부(개발 도구 고지).

## 5. 다음 단계 (확인 뒤)

1. §4-3 답 → §4-2 문장 적용(문서만, 한 커밋).
2. G2·G1 재현 시험 작성(수정 전 실패 확인) → 수리 → G3 → G7.
3. PS-1 1단계(모터 축)를 학교 보드 날에 — S4·S6은 수리 전 기준선, 수리 뒤 다시.
4. Touch Bridge 경로 PS-1은 Touch Bridge 펌웨어 확인 뒤 별도 일정.
