Seongwonp/Simplelay/docs/UX-문구-기준-2026-10-19.md

# UX 문구 기준과 화면 문구 점검 (2026-10-19)

> 이 문서는 조사와 점검만 담았다. 코드는 아직 바꾸지 않았다.
> 사용자 지적: 폰 앱(`app/lib`)과 키오스크(`rpi5-touchscreen-app/lib`)의 화면 문구 중에 영어를 그대로 옮긴 것 같은 어색한 말이 많다.
> 그래서 이 문서는 세 부분으로 나뉜다. ① 공개 자료 조사 ② SimpleLay 문구 기준 ③ 바꿀 문구 표와 '잠시 쉬기 → 방해 금지' 이름 바꾸기 목록.
> 함께 볼 문서: [화면 용어와 문구](용어와-화면문구.md), [UI 제품 앱·공개 레퍼런스](ui-product-app-references.md), [사용자 편의 가이드 체크리스트](사용자편의-가이드-체크리스트.md)(쉬운 용어 항목: "DND → 방해 금지 순화 점검"), [키오스크 문구 개선 계획](archive/키오스크-문구-개선-계획-2026-10-15.md).

> **2026-10-23 현행 적용:** 사용자 결정에 따라 미확인 결과는 ‘확인하지 못했어요’로 쓴다. 아래 과거 점검표의 ‘몰라요’·‘부탁이 닿다’ 수정 후보는 현행 지시가 아니다. [한국어 조사·적용안](archive/한국어-UI-말투-조사와-적용안-2026-10-22.md)과 [촬영 전 수정 기록](devlog/devlog_2026-10-23-ui-filming.md)을 우선한다.

## 1. 공개 자료 조사 (확인 2026-10-19)

인용은 짧게 줄였다. 원문을 직접 확인하지 못한 것은 **미확인**으로 적었다.

| 출처 | 날짜 | 이 문서에 가져온 점 |
|---|---|---|
| [앱인토스 UI/UX 가이드](https://developers-apps-in-toss.toss.im/design/consumer-ux-guide.md)(토스 공식 파트너 가이드) | 날짜 표기 없음 | 모든 문구에 해요체를 쓴다("상황, 맥락을 불문하고"). 되도록 능동문으로 쓴다(됐어요 → 했어요). 피동은 끝남·결과 설명·안심시킬 때만 쓴다. '되어요'는 '돼요'로 줄인다. 한자어 명사 나열은 동사로 푼다. 대화창 왼쪽 버튼은 '닫기'로 쓴다. '취소'는 하던 일이 취소되는 것으로 오해할 수 있다. 주 버튼은 다음에 무슨 일이 일어날지 알려야 한다. |
| [토스의 8가지 라이팅 원칙](https://toss.tech/article/8-writing-principles-of-toss) | 2022-11-15 | 다음 화면을 예상할 수 있는 문장, 군더더기·빈 문장 빼기, 소리 내어 읽기 쉬운 말, 강요하지 않고 제안하기, 누구나 아는 말 |
| [좋은 에러 메시지를 만드는 6가지 원칙](https://toss.tech/article/how-to-write-error-message) | 2022-09-21 | 사용자가 스스로 고치는 방법을 알려 준다. 제공자 말이 아니라 사용자 말로 쓴다. 고치는 비용을 줄인다(버튼 하나로). 부정적인 느낌을 줄인다(~해야 해요 → ~할 수 있어요). |
| [토스 UX 라이터 인터뷰](https://toss.im/tossfeed/article/uxwriter-interview) | 2021-02-18 | 한 사람이 말하는 것처럼 쓴다. 버튼 하나는 '~하기', 버튼 둘은 '취소' 대신 '닫기'·'다음에' |
| [Samsung Design System — UX Writing](https://developer.samsung.com/design-system/cs) | 날짜 없음 | 짧은 문장이 읽기 쉽다. 어려운 말은 읽기를 방해한다. 기기나 서비스가 아니라 사용자가 먼저다. 상황과 사용자 마음 상태에 맞춰 말투를 조절한다. 한국어 고유 규칙은 없다. |
| [KRDS 디자인 원칙](https://www.krds.go.kr/html/site/utility/utility_02.html) · [도움 패턴](https://www.krds.go.kr/html/site/global/global_02.html) | ©2023 · 2025-01-15 | 낯선 용어와 설명은 실수를 부른다. 사용자가 오류를 스스로 알아차리고 고칠 단서를 준다. 같은 버튼과 제목에는 늘 같은 말을 쓴다. 오류·확인 패턴의 본문은 열지 못했다(**미확인**). |
| 갤럭시 [방해 금지 모드 설정 방법](https://www.samsungsvc.co.kr/solution/40676)(삼성전자서비스) | 2025-01-01 | 메뉴 이름이 **'방해 금지'**(띄어 씀)다. 그림 설명 하나에는 '방해금지'로 붙여 쓰여 있다. |
| [iPhone 사용 설명서(한국어)](https://support.apple.com/ko-kr/guide/iphone/iphea1c2fe48/ios) | 확인 2026-10-19 | '집중 모드' 안의 **'방해금지'**(붙여 씀)다. 목차에서만 확인했다. |

- **이중 피동(~되어지다):** 국립국어원이 틀린 표현으로 본다는 내용은 2차 기사와 요약글에서만 확인했다(**원문 미확인**).
- **에 의해 → 으로:** 국립국어원 책자 『한눈에 알아보는 공공언어 바로 쓰기』(2014)를 인용한 2차 자료가 있다. 같은 자료는 이런 표현이 모두 번역투는 아니라고도 단서를 단다.
- **공개 문구 지침을 찾지 못한 곳:** LG ThinQ 앱, 카카오, SmartThings 한국어. 지침 문서 대신 실제 앱 화면을 보고 확인해야 한다(**미확인**).
- **빈 화면 문구:** 위 자료 어디에서도 직접 다룬 내용을 찾지 못했다. 아래 기준 R8은 오류 문구 원칙을 넓혀 적용한 것이다.

## 2. SimpleLay 문구 기준

조사 결과를 SimpleLay에 맞게 고쳐 적용한다. 주 사용자는 고령층과 저시력 사용자다. 실물 증거가 없으면 성공이라고 말하지 않는다는 안전 계약을 지킨다. 다른 회사 문구를 그대로 가져오지 않고 원칙만 따른다.

1. **R1 해요체 하나로.** 화면·소리·화면 읽기 모두 해요체로 쓴다. 합쇼체('~습니다'·'~되었습니다')는 개발자 화면에만 남긴다. 무거운 높임('~시겠어요')은 쓰지 않는다.
2. **R2 설명 문장의 상태는 동사로.** 본문·안내·소리에서는 '~하는 중', '~중입니다'를 '~하고 있어요'로 쓰고 명사로 끝내지 않는다('등록됨', '남음', '건너뜀' → '등록했어요', '남았어요', '건너뛰었어요'). 자리가 좁은 상태 표시(칩·배지·결과 머리·상태 띠·짧은 상태 이름)는 R2가 아니라 R12의 짧은 명사를 쓴다. 한 상태에는 자리마다 이름 하나만 둔다 — 상태 표시는 '멈추는 중', 그 아래 설명은 '멈추고 있어요'처럼 역할로 나누고, 같은 자리에서 두 꼴을 섞지 않는다.
3. **R3 번역투를 피한다.** '되어지다' 같은 이중 피동, '~의 ~의' 겹침, '것의', '해당', '진행', '수행', '시도', '~에 대해', '~를 통해', '~하게 돼요'를 피하고 그 자리에 무엇을 하는지 동사로 쓴다. 한자어 명사를 잇지 않는다('멈추기 실패', '실행 실패', '연결 확인 필요').
4. **R4 버튼은 짧은 동사.** '~하기'로 쓰고, 누르면 무엇이 일어나는지 이름만 보고 알 수 있어야 한다('허락' → '허락하기', '삭제' → '지우기'). 창을 닫기만 하는 버튼은 '닫기'다. '확인'은 뜻이 두 가지라 버튼 이름으로 쓰지 않는다(아래 R7).
5. **R5 오류 문구는 세 가지를 차례로.** 생긴 일 → 알면 이유 → 지금 할 일([화면 용어와 문구](용어와-화면문구.md)와 같다). '연결을 봐 주세요'만으로 끝내지 말고 무엇을 볼지 말한다(예: '폰과 본체가 같은 와이파이인지 보고 다시 눌러 주세요'). 이유를 모르면 짐작해서 쓰지 않는다.
6. **R6 미확인 결과는 '확인하지 못했어요'.** 눌렸는지, 켜졌는지, 정지가 전달됐는지 확인하지 못한 범위를 구체적으로 쓴다. 사용자 결정(2026-10-22)에 따른다. 반대로 모르는 것을 '했어요'·'실패했어요'로 바꾸지도 않는다. 가전 쪽 끝은 '가열 종료 감지'라고만 말하고 '조리 완료'로 쓰지 않는다. 응답이 온 것만으로 '멈춰요'·'눌렀어요'라고 단정하지 않는다('멈추라고 보내요'). 정지를 요청하는 말은 '정지'와 '멈추기'만 쓰고, 음성 듣기를 끝내는 일처럼 다른 동작에는 쓰지 않는다.
7. **R7 '확인'을 두 뜻으로 쓰지 않는다.** 본체가 확인한 결과는 '~한 걸 봤어요'·'~을 확인했어요'로 쓴다. 사용자가 할 일은 '~을 봐 주세요'로 쓰되, **무엇을 볼지 붙인다**('가전 화면이나 불빛이 바뀌었는지 봐 주세요', '가전이 아직 작동하고 있는지 봐 주세요', '휴대폰과 본체가 같은 와이파이인지 보고 다시 눌러 주세요'). '가전을 봐 주세요', '연결을 봐 주세요'만으로 끝내지 않는다. '확인 필요', '켜짐 확인'처럼 명사로 끝난 꼬리표는 결과인지 할 일인지 알 수 없다.
8. **R8 빈 화면은 이유와 다음 행동.** 왜 비었는지와 무엇을 하면 채워지는지를 한 줄씩 쓴다(예: '아직 등록한 가전이 없어요. 아래 \'가전 추가하기\'를 눌러 주세요').
9. **R9 같은 것은 같은 이름.** 폰·키오스크·소리·서버 문구가 같은 말을 쓴다. 이번에 하나로 정할 이름:

   | 정할 이름 | 지금 섞여 쓰이는 말 |
   |---|---|
   | 버튼판 | 조작부 |
   | 버튼 자리 맞추기 | 위치 맞추기 |
   | 새로 보기 | 새로고침·다시 받기·다시 불러오기 |
   | 지우기 | 삭제 |
   | 풀기 | 해제 |
   | 루틴 · 자동 실행 (2026-10-25 사용자 승인으로 바꿈 — 기능 이름은 이 둘만) | 자동으로 하기·자동 규칙·자동 루틴·저장된/저장한 동작 |
   | 와이파이 | Wi-Fi |
   | 말로 하기 | 음성 명령 |
   | 휴대폰(키오스크 쪽) | 폰 |
   | 지금 하기(제안 버튼) | 소리 안내의 '시작' |
   | 자동으로 할게요(맡긴 일을 약속하는 말) | 알아서 할게요·묻지 않고 할게요 |
   | 처음 화면(키오스크) | 홈 화면 |

   제안을 '알림'이라고 부르지 않는다. '보호자 알림'과 헷갈린다.
10. **R10 쉬운 말.** 모드, 세션, 카드, 탭, 코드, 학습, 경로, 초기화, 반영, 고대비, 파워, ms 같은 말은 풀어 쓴다. 다만 LG 앱이 가전 기능 이름으로 쓰는 말(예: '파워' 바람)은 처음 한 번 괄호에 함께 적어 LG 앱 화면과 맞춰 볼 수 있게 한다.
11. **R11 화면 읽기.** '1/3'은 '3장 중 1장'으로, '$n분 남음'은 '$n분 남았어요'로 소리 내어 자연스럽게 읽히게 쓴다.
12. **R12 상태 표시는 짧은 명사, 설명은 자연스러운 해요체.** 상태 표시(칩·배지·결과 머리·상태 띠·짧은 상태 이름)는 짧은 명사로 쓴다 — 완료 · 실패 · 멈춤 · 스스로 멈춤 · 확인 못 함 · 보냄 · 연결됨 · 끊김 · 준비 중 · 끝남. 설명 문장은 평소 말하듯 해요체로 쓴다. '됐어요', '안 돼요', '못 했어요'처럼 일상에서 쓰는 줄인 꼴은 써도 된다 — '되지 않았어요', '할 수 없어요'만 되풀이하면 관공서 말투가 된다. 다만 반말처럼 들리는 끝('됨', '함')은 설명 문장에 쓰지 않는다. 명사로 줄여도 증거 수준은 그대로다 — 초록 '완료'는 상태를 다시 읽거나 누름을 확인한 것에만 쓰고, '설정을 바꿨어요'도 상태를 확인한 곳에서만 쓴다(전 값을 모르면 '설정을 확인했어요'). 폰·키오스크·서버 문구가 같은 말을 쓴다.

## 3. 바꿀 문구 표

**표를 만든 방법:** `grep -n`으로 줄 번호를 확인했다(2026-10-19, `84dd837a` 기준).

**미리 알아 둘 것**
- **줄 번호가 밀린다.** 이후 커밋이 쌓이면 줄 번호가 달라지므로 실제로 고칠 때는 지금 문구로 다시 찾는다.
- **시험 기대값도 함께 고친다.** 문구를 바꾸면 시험의 기대 문자열과 골든 이미지도 바꿔야 한다.
- **우선순위:** **안전** = 정지·성공 의미에 닿는다 → **처음** = 처음 쓰는 사람이 보는 화면 → **일반**.
- **점검 범위:** 개발자 화면(`developer_*`)은 범위 밖이다. 남은 합쇼체 6건은 모두 개발자 화면에 있다.

### 3-1. 안전 의미에 닿는 것 (먼저)

| file:line | 지금 | 바꿀 말 | 이유 |
|---|---|---|---|
| app/lib/widgets/voice_stop_indicator.dart:102 | '멈춰'라고 말하면 멈춰요 | '멈춰'라고 말하면 정지를 보내요 | 근거 없이 멈춘다고 단정한다. 같은 위젯의 화면 읽기 라벨(87줄 '정지를 요청해요')과도 다르다(R6) |
| app/lib/screens/voice_screen.dart:843 | 음성 인식 정지 / 음성 명령 시작 | 듣기 멈추기 / 말하기 시작 | 듣기만 끝내는 동작이 가전 '정지'로 읽힌다(R6) |
| rpi5-touchscreen-app/lib/screens/kiosk_screen.dart:1603·1604 | …화면에서 시작을 눌러 주세요. | …화면에서 '지금 하기'를 눌러 주세요. | 화면 버튼 이름은 '지금 하기'(suggestion_view:409)다. 소리 안내의 '시작'은 가전의 '시작' 버튼과 겹친다(R9) |
| rpi5-touchscreen-app/lib/widgets/kiosk/hold_view.dart:190 | 작동 끝 | 기다림이 끝났어요 | 가전 작동이 끝났다는 뜻(조리 완료)으로 읽힌다. 실제로는 누름 장치의 정지 대기가 끝난 상태다 |
| rpi5-touchscreen-app/lib/widgets/kiosk/hold_view.dart:175 | 멈추기 실패 / 누름 장치 문제 | 정지가 안 닿았어요 / 누름 장치에 문제가 있어요 | 명사를 쌓았다. 본문 281줄 '정지가 닿지 않았어요'와 맞춘다. 멈췄는지는 단정하지 않는다 |
| rpi5-touchscreen-app/lib/widgets/kiosk/hold_view.dart:312-313 | 정지 버튼이 눌렸는지 확인이 안 됐어요 | 정지 버튼이 눌렸는지 몰라요 | R6. 뜻은 그대로다 |
| app/lib/screens/history_screen.dart:508·510·511·512·517·518 | 상태 확인 / 켜짐 확인 / 꺼짐 확인 / 바뀐 상태 확인 / 동작 확인 / 눌림 확인 | 상태를 봤어요 / 켜진 걸 봤어요 / 꺼진 걸 봤어요 / 바뀐 걸 봤어요 / 전기 쓰는 걸 봤어요 / 눌린 걸 봤어요 | 확인을 마친 결과 꼬리표인데 '확인하세요'(할 일)로도 읽힌다(R7) |
| app/lib/models/display_status.dart:478 · app/lib/screens/appliance_detail_screen.dart:458 | 화면에서 골라 누름 / 직접 누름 | 화면에서 직접 골랐어요 / 직접 고른 버튼 | 누가 시켰는지 알려 주는 표시인데 '눌렸다'는 결과로 읽힌다 |
| app/lib/models/command_result.dart:188 · rpi5-touchscreen-app/lib/widgets/kiosk/done_view.dart:1665 | …다시 시도하지 마세요. 같은 버튼을 또 누르게 돼요 | …다시 누르지 마세요. 같은 버튼이 한 번 더 눌려요 | '시도'와 '~하게 돼요'는 번역투다(R3). 같은 버튼을 두 번 누르는 위험(R1 빈칸)은 그대로 알린다 |
| app/lib/providers/execution_status_provider.dart:906 | 연습 연결이라 실제로 보낸 정지는 없어요. | 연습 연결이라 실제로는 정지를 보내지 않았어요. | 명사로 옮긴 번역투다. 사실은 그대로다 |
| rpi5-touchscreen-app/lib/models/estop.dart:83·87·89·91 | …돌려서 푼 뒤 다시 풀어 주세요 / 푸는 사이 다시 걸렸어요 / 본체에서 걸린 것을 찾지 못해… | …버튼을 돌려 올린 뒤 화면의 '풀기'를 다시 눌러 주세요 / 푸는 사이 비상 정지가 다시 걸렸어요… / 본체에 걸린 비상 정지가 없어 풀지 않았어요… | '풀다'가 빨간 버튼과 화면 버튼 둘 다를 가리킨다. 무엇이 걸렸는지도 빠져 있다 |
| app/lib/widgets/estop_banner.dart:94·108·120 | 해제하는 중… / 비상정지 해제 / 해제 | 풀고 있어요… / 비상정지 풀기 / 풀기 | `kEstopAckLabel` '봤어요, 풀기'와 맞춘다(R9) |
| rpi5-touchscreen-app/lib/widgets/kiosk/help_guide.dart:35 | …휴대폰 앱의 실행 화면에서도 정지를 누를 수 있어요. | …휴대폰 앱에서 정지를 누르거나 '멈춰'라고 말해도 돼요. | 정지어(G7)는 이미 배포됐는데 도움말에는 없다. 파일 머리말 20줄과도 맞지 않는다 |

### 3-2. 키오스크 사용 방법(도움말)과 첫 화면

| file:line | 지금 | 바꿀 말 | 이유 |
|---|---|---|---|
| rpi5-touchscreen-app/lib/widgets/kiosk/help_guide.dart:25 | …누르기 전에 물어봐요. 자동으로 하도록 허락한 일만 묻지 않아요. | …누르기 전에 먼저 물어봐요. '자동으로 하기'를 허락한 일만 묻지 않고 해요. | '~만 묻지 않아요'는 거꾸로 읽히기 쉽다. 화면에 나오는 기능 이름을 쓴다 |
| help_guide.dart:30 | …켜고 끌 수 있어요. 바뀌었는지는 가전을 보고 알려 주세요. | …켜고 끌 수 있어요. 본체가 바뀐 걸 보면 알려 드려요. 모를 때는 가전을 직접 봐 주세요. | 본체가 상태를 다시 읽어 확인한다(`state_confirmed`). 늘 사람이 봐야 하는 것처럼 읽히면 안 된다 |
| help_guide.dart:86·92 | 사용 방법 ${i+1}/${n} | 사용 방법 ${n}장 중 ${i+1}장 | 화면 읽기가 '/'를 이상하게 읽는다(R11) |
| rpi5-touchscreen-app/lib/widgets/kiosk/suggestion_view.dart:429 | 누르지 않으면 하지 않아요 | '지금 하기'를 누르지 않으면 아무것도 안 해요 | 무엇을 누르는지가 빠져 있다 |
| suggestion_view.dart:432 | 이 가전을 찾지 못해 할 수 없어요 | …할 수 없어요. 휴대폰 앱에서 가전을 봐 주세요 | 할 일이 없다(R5) |
| suggestion_view.dart:677 | 경로 모름 | 어떻게 할지 몰라요 | '경로'는 시스템이 쓰는 말이다(R10) |
| rpi5-touchscreen-app/lib/screens/kiosk_screen.dart:1888 | 가전이 아직 조작할 준비가 되지 않았어요. | 가전을 아직 쓸 수 없어요. 휴대폰 앱에서 가전 설정을 봐 주세요. | 번역투이고 할 일이 없다 |
| kiosk_screen.dart:1651 | $who. 아직 준비가 안 됐어요 | $who. 아직 쓸 수 없어요. 휴대폰 앱에서 봐 주세요 | R5 |
| kiosk_screen.dart:1782 | 가전을 바꾸지 못했어요. 화면을 봐 주세요. | 가전을 바꾸지 못했어요. 가전 연결을 봐 주세요. | 어느 '화면'인지 모호하다(done_view:1068과 맞춘다) |
| rpi5-touchscreen-app/lib/widgets/kiosk/status_band.dart:11 (done:529·1144, hold:182) | 확인 필요 | 봐 주세요 | R7 |
| rpi5-touchscreen-app/lib/widgets/kiosk/idle_top.dart:87 | 연결 확인 필요 $n | 연결 $n곳을 봐 주세요 | 명사를 쌓았다 |
| rpi5-touchscreen-app/lib/widgets/kiosk/idle_view.dart:1779 | 와이파이와 누름 장치 연결 상태 | 와이파이·누름 장치가 잘 연결됐는지 봐요 | 명사를 쌓았다 |
| rpi5-touchscreen-app/lib/widgets/kiosk/connection_status.dart:299 | 연결해 보는 중 | 연결해 보고 있어요 | R2 |
| rpi5-touchscreen-app/lib/widgets/kiosk/pairing_view.dart:151 | …폰 카메라로 QR을 열어 주세요. | …휴대폰 카메라로 이 QR 코드를 비춰 주세요. | QR은 '여는' 것이 아니다. '휴대폰'으로 맞춘다 |
| pairing_view.dart:72 | 연결 시간이 지났어요. 새 코드를 받아 주세요. | 연결할 수 있는 시간이 지났어요. '새 코드 받기'를 눌러 주세요. | 누를 버튼 이름을 쓴다 |
| pairing_view.dart:179 | 이 폰 연결을 닫았어요. | 이 휴대폰은 연결하지 않았어요. | '연결을 닫다'는 번역투다 |
| pairing_view.dart:145 · settings_overlay.dart:193 · idle_view.dart:1767 | 폰 연결하기 / 폰 연결 | 휴대폰 연결하기 | 키오스크에 '폰' 약 11곳, '휴대폰' 9곳이 섞여 있다(R9) |
| rpi5-touchscreen-app/lib/widgets/kiosk/settings_overlay.dart:275 · idle_view.dart:1767 | 고대비 | 또렷하게 보기 | 한자 전문어다. 부제는 이미 '더 또렷하게'로 풀어 썼다 |
| settings_overlay.dart:468 | 등록됨 | 등록했어요 | R2 |
| rpi5-touchscreen-app/lib/widgets/kiosk/past_result_line.dart:99 | 확인 | 닫기 | 하는 일은 닫기다(R4) |

### 3-3. 키오스크 실행·결과 화면

| file:line | 지금 | 바꿀 말 | 이유 |
|---|---|---|---|
| rpi5-touchscreen-app/lib/widgets/kiosk/executing_view.dart:177 | 준비 중 | 준비하고 있어요 | R2 |
| executing_view.dart:181·186 | 다시 누르는 연습 중 / 자리를 맞춰 다시 누르는 중 / 누르는 연습 중 | 연습으로 다시 누르고 있어요 / 자리를 맞춰 다시 누르고 있어요 / 연습으로 누르고 있어요 | 바로 옆 '누르고 있어요'(414)와 말투가 다르다 |
| executing_view.dart:205·440 | ${n}번째 시도 | ${n}번째 누르기 / ${n}번째로 누르고 있어요 | '시도'(R3). 바로 앞의 '몰라서'는 그대로 둔다 |
| executing_view.dart:408 | 다음 차례를 기다리는 중 | 다음 차례를 기다리고 있어요 | R2 |
| executing_view.dart:236·351 | 실행 중 | 하고 있어요 | '실행'은 시스템이 쓰는 말이다 |
| rpi5-touchscreen-app/lib/widgets/kiosk/appliance_strip.dart:656·659 | 바꾸는 중 / 작동 중 / 작동 중 아님 | 바꾸고 있어요 / 작동하고 있어요 / 지금 누르고 있지 않아요 | '~아님'은 영어식 부정 명사형이다. 가전이 꺼졌다고 단정하지 않는다 |
| rpi5-touchscreen-app/lib/widgets/kiosk/done_view.dart:1587·1588·1856·1857·1863·1864 | …바뀌었는지 확인 / 가족에게 물어보기 / …있는지 확인 / …손으로 누르기 / …다시 멈추기 | …봐 주세요 / 물어봐 주세요 / 눌러 주세요 / '다시 멈추기'를 눌러 주세요 | 같은 목록 안에 '봐 주세요'와 명사형이 섞여 있다. 명사형은 버튼 이름과 구별하기 어렵다 |
| done_view.dart:1032 | 연습 누르기를 끝내지 못했어요 | 연습으로 누르다가 끝내지 못했어요 | 명사를 이어 붙였다 |
| done_view.dart:1643·1798 | 가전이 설정이 안 바뀌었다고 알려 주셨어요 | 가전 설정이 안 바뀌었다고 알려 주셨어요 | 주어가 겹친다 |
| rpi5-touchscreen-app/lib/models/thinq_run.dart:232 · 183 · done_view.dart:1037 | $name에 전해졌는지 몰라요 / 연습이 전해졌는지 몰라요 | $name이(가) 받았는지 몰라요 / 연습 부탁이 닿았는지 몰라요 | command_result:140 '가전이 받았는지 몰라요'와 맞춘다. 모른다는 뜻은 그대로다 |
| rpi5-touchscreen-app/lib/models/command_result.dart:60-63 | 성공 / 실패 / 멈춤 / 스스로 멈춤 | 됐어요 / 못 했어요 / 멈췄어요 / 스스로 멈췄어요 | 바로 옆 '몰라요'(64)와 말투를 맞춘다 |
| rpi5-touchscreen-app/lib/services/kiosk_api_service.dart:191 | 제안한 실행 | 제안한 일 | R10 |
| rpi5-touchscreen-app/lib/widgets/kiosk/thinq_panel.dart:357·669 | 지금 상태를 보는 중… / 가전에 전하는 중… | 지금 상태를 보고 있어요 / 가전에 보내고 있어요 | R2. '보내다'로 맞춘다 |
| thinq_panel.dart:369 | 지금 상태를 못 봤어요. ${failure} | …뒤에 '본체 연결을 봐 주세요' 덧붙이기 | R5 |
| thinq_panel.dart:453 · models/thinq.dart:131 | 종합은 가전이 매긴 등급이에요 | 종합 등급은 공기청정기가 정한 거예요 | '종합은'이 혼자 떠 있다 |
| models/thinq.dart:102 | 실내 공기 종합 나쁨 | 실내 공기가 나빠요(종합) | 명사 네 개를 쌓았다 |
| models/thinq.dart:184·186·434 | 잘 때 모드 / 파워 / $name 모드 바꾸기 | 잘 때 운전 / 가장 세게(파워) / $name 운전 방식 바꾸기 | R10. LG 앱 이름은 괄호에 남긴다 |
| models/thinq.dart:197 | 오류 | 문제가 생겼어요. LG 앱에서 봐 주세요 | R5 |
| models/thinq.dart:403 | 본체가 이 화면을 받지 않았어요. 본체 설정을 봐 주세요. | 본체가 이 화면에서 바꾸지 못하게 막아 두었어요. 가족에게 본체 설정을 부탁해 주세요. | 뜻이 통하지 않는다. 고령 사용자가 직접 할 수 없는 일을 시킨다 |
| models/thinq.dart:408 | 본체가 지금은 이 조작을 받지 않았어요. | 지금은 바꿀 수 없어요. 잠시 뒤 다시 눌러 주세요. | R3·R5 |
| rpi5-touchscreen-app/lib/widgets/learning_status_dialog.dart:64·71·80·81 | 학습할 실제 사용 기록 / 가전 모름 / 습관 확인 / 습관을 알아가는 중 | 습관으로 기억할 사용 기록 / 어느 가전인지 몰라요 / 습관으로 기억했어요 / 습관을 알아 가고 있어요 | 학습(R10), 명사형(R2) |
| learning_status_dialog.dart:109 | 새로고침 | 새로 보기 | thinq_panel:502와 맞춘다(R9) |

### 3-4. 폰 앱 — 처음 연결·홈

| file:line | 지금 | 바꿀 말 | 이유 |
|---|---|---|---|
| app/lib/screens/onboarding_screen.dart:74 | SimpleLay에 오신 것을\n환영해요 | 반가워요.\nSimpleLay예요 | "Welcome to"를 그대로 옮겼다 |
| app/lib/screens/pairing_screen.dart:77 | 본체 화면의 QR 연결 주소를 봐 주세요. | 본체 연결용 QR이 아니에요. 본체 화면의 QR을 다시 찍어 주세요. | 무엇이 틀렸는지와 할 일이 없다 |
| pairing_screen.dart:96·264 | 여섯 자리 코드 | 여섯 자리 숫자 | R10 |
| pairing_screen.dart:252 | QR을 찍을 수 없나요? 주소와 6자리 코드 입력 | QR 없이 주소와 숫자로 연결하기 | 버튼이 질문과 명사로 되어 있다(R4) |
| pairing_screen.dart:232 | 본체 화면에서 설정, 폰 연결하기를 열어 주세요. | 본체 화면에서 '설정' → '휴대폰 연결하기'를 눌러 주세요. | 쉼표로는 메뉴 순서가 읽히지 않는다 |
| app/lib/screens/settings/hub_screen.dart:71 | 코드로 폰 연결하기 | QR로 폰 연결하기 | 실제로는 QR을 쓴다 |
| app/lib/screens/home_screen.dart:1933·1940 | 본체 찾는 중… / 같은 Wi-Fi인지 | 본체를 찾고 있어요 / 같은 와이파이인지 | R2·R9 |
| home_screen.dart:2026 | 연결 | 블루투스 켜기 | 버튼이 명사다(R4) |
| home_screen.dart:1711 | 알림과 기록이 멈췄어요 | 알림과 기록을 못 받고 있어요 | '멈췄어요'가 정지와 헷갈린다 |
| home_screen.dart:1431 | 작동 중 아님 (화면 읽기) | 지금 누르고 있지 않아요 | 키오스크와 같은 문제다 |
| home_screen.dart:1833·1835 | $h시간 $m분 남음 / $n분 남음 | …남았어요 | R2·R11 |
| home_screen.dart:1635 | 본체의 가전 목록을 불러오는 중이에요. | 본체에서 가전 목록을 불러오고 있어요. | R2 |
| home_screen.dart:1655 · add_appliance_wizard_screen.dart:50·843 · widgets/appliance_panel.dart:43 | 조작부 사진 | 버튼판 사진 | R9 |
| appliance_editor_screen.dart:626·778·779 · widgets/appliance_setup_card.dart:106 | 위치 맞추기 / 조작부 사진에서 버튼 위치를… | 버튼 자리 맞추기 / 버튼판 사진에서 버튼 자리를… | 가전 추가 마법사(696)는 이미 '버튼 자리 맞추기'다 |

### 3-5. 폰 앱 — 실행 상태·제안·루틴

| file:line | 지금 | 바꿀 말 | 이유 |
|---|---|---|---|
| app/lib/providers/execution_status_provider.dart:136·155·565·567·568·590·639·783 · screens/status_screen.dart:756·760·768 · screens/app_shell.dart:107 | 하는 중이에요 / 보내는 중이에요 / 다시 해 보는 중이에요 / $segment번째 차례를 하는 중이에요 / 누르는 중 | 하고 있어요 / 보내고 있어요 / 한 번 더 해 보고 있어요 / …하고 있어요 / 누르고 있어요 | R2(전역 59줄 중 첫 화면 위주) |
| execution_status_provider.dart:156 | 아까 보낸 것의 답을 기다리는 중이에요. | 아까 보낸 일의 답을 기다리고 있어요. | '것의'(R3) |
| execution_status_provider.dart:463·729·736 | 아까 맡긴 일을 다시 보는 중이에요… / 새로 보는 중이에요… | 아까 맡긴 일이 어떻게 됐는지 알아보고 있어요… / 다시 알아보고 있어요… | 무엇을 보는지 알 수 없다 |
| app/lib/screens/status_screen.dart:743 | $attempt번째 시도 | $attempt번째 누르기 | R3 |
| status_screen.dart:749 | 실행하면 여기서 진행을 볼 수 있어요. | 가전에 일을 시키면 여기서 어디까지 했는지 볼 수 있어요. | 빈 화면(R8), 실행·진행 |
| status_screen.dart:821·825 (command_result 183·259·260, display_status 673·727·828·848, history 147) | …확인이 필요해요 | …봐 주세요 | R7 |
| status_screen.dart:351 | 확인 | 닫기 | R4·R7 |
| app/lib/models/command_result.dart:172 | 멈춘 것을 확인했어요 (누름 장치 응답 $ackMs ms) | 멈춘 것을 확인했어요 (ms는 '자세히'로) | R10 |
| app/lib/screens/history_screen.dart:54·505 | 확인 필요 / 이미 그 상태 | 봐 주세요 / 이미 그 설정이었어요 | R2·R7 |
| app/lib/screens/care_events_screen.dart:231·236·241·252·257 | 위험 신호음 / 실행 실패 / 정지 / 루틴 멈춤 | 위험 소리 / 못 한 일 / 멈춘 일 / 멈춘 루틴 | 홈 요약(home 384~387)과 맞춘다. '정지' 하나만 있으면 버튼으로 읽힌다 |
| app/lib/screens/suggestion_screen.dart:86 | 쉬기를 본체에 알리지 못했어요. 연결을 봐 주세요. | '30분 동안 묻지 않기'를 본체에 알리지 못했어요. 다시 눌러 주세요. | 버튼 이름(647)과 다르다. **방해 금지와 다른 기능**(제안 하나 미루기)이라 '쉬기'를 쓰면 헷갈린다 |
| suggestion_screen.dart:285·394·895 | 이 알림을 찾을 수 없어요 / 연습용으로 만든 알림이에요 | 이 물음을 찾을 수 없어요. 홈으로 돌아가 주세요 / 연습용으로 만든 물음이에요 | 제안을 '알림'이라 부르면 보호자 알림과 헷갈린다(R9) |
| app/lib/widgets/routine_run.dart:41·76·75·70 | 카드를 만들지 못했어요. 연결을 봐 주세요 / 가전이 아직 준비되지 않았어요 / 목록을 새로 고쳐 주세요 | 물어보는 화면을 띄우지 못했어요. 본체 연결을 보고 다시 눌러 주세요 / …가전 화면에서 남은 설정을 봐 주세요 / 아래로 당겨 목록을 새로 봐 주세요 | '카드'(R10), 할 일이 없다(R5) |
| app/lib/screens/routine_editor_screen.dart:242·583 | 떠 있는 카드… / 떠 있던 카드도 내려가요 | 지금 물어보던 것… / 지금 물어보던 것도 사라져요 | R10 |
| app/lib/widgets/auto_rule_confirm_sheet.dart:18·52 | 이번에 실행하고\n다음부터 자동으로 할까요? / 루틴 탭에서… | 이번에 하고,\n다음부터는 묻지 않고 할까요? / 루틴 화면에서… | '자동'이 어디까지인지 모호하다. '탭' |
| app/lib/screens/routines_screen.dart:124·137·300·1346 | 자동 규칙 / 자동 루틴 | 자동으로 하기 | R9 |
| routines_screen.dart:140·682 | 시각 루틴의 자동은 '내 루틴' 줄의 '자동'을… / 다음 표지는…, 자동 표지는… | 정해진 시각 루틴은 '내 루틴'에서 '자동'을 눌러 켜고 꺼요 / '다음'은 곧 할 루틴, '자동'은 묻지 않고 하는 루틴이에요 | 조사가 줄줄이 이어진다. '표지'는 어려운 말이다 |
| routines_screen.dart:1010·1267·464 | 꺼 둠 / 허락 / 사용 기록으로 만든 루틴 초안 | 꺼짐 / 허락하기 / 자주 하신 일로 만든 루틴(아직 저장 안 했어요) | R9·R4·R10 |
| routine_editor_screen.dart:131·773 | 직접 실행으로 정하기 / 직접 실행 | 필요할 때 하기로 정하기 / 필요할 때 | routines 636과 맞춘다 |
| routines_screen.dart:614·616 · routine_editor_screen.dart:376 · widgets/thinq_state_card.dart:45·400·452·535·572 | 모드 / $name 조작 / LG 가전 조작 | 운전 방식 / $name 설정 바꾸기 / LG 가전 설정 바꾸기 | R10 |
| widgets/thinq_state_card.dart:313·330·338·350 | 지금은 이걸 바꿀 수 없어요 / 조용 / 파워 / 오류 | …가전이 켜져 있는지 보고 다시 해 주세요 / 조용히 / 가장 세게(파워) / 가전에 문제가 있어요. LG 앱에서 봐 주세요 | R5·R10 |
| widgets/thinq_state_card.dart:66 · thinq_discovered_section.dart:56·136 | 불러오는 중… / 찾는 중이에요… / 추가 중 | 불러오고 있어요… / 찾고 있어요… / 추가하고 있어요 | R2 |

### 3-6. 폰 앱 — 가전·설정·말로 하기

| file:line | 지금 | 바꿀 말 | 이유 |
|---|---|---|---|
| app/lib/screens/appliance_detail_screen.dart:203·204·217 | '이름' 삭제 / …함께 삭제돼요. 삭제할까요? / 삭제 | '이름'을 지울까요? / 등록한 버튼 자리와 사진도 함께 지워져요. / 지우기 | 같은 화면 92는 '지우기'다(R9). 지우면 되돌릴 수 없는 일이라 결과를 알려 준다 |
| appliance_detail_screen.dart:228·431 | …다시 시도할게요 / 오늘 사용 | …다음에 연결될 때 다시 지울게요 / 오늘 쓴 기록 | R3·R2 |
| app/lib/screens/appliance_editor_screen.dart:130·133·537 | 외부 인식 서비스 / …보내져요 | 인터넷 사진 읽기 서비스 / …보내요 | 전문 용어이고 피동형이다 |
| appliance_editor_screen.dart:739 · add_appliance_wizard_screen.dart:874 | 선택 / 방 (선택, 예: 주방) | 안 해도 돼요 / 방 (안 적어도 돼요, 예: 주방) | 'optional'을 그대로 옮겼다. '고르세요'로 읽힌다 |
| appliance_editor_screen.dart:235·515·545 | 버튼 수정 / 사진 제거 / 버튼 배치 | 버튼 고치기 / 사진 지우기 / 버튼 자리 | R9·R10 |
| app/lib/services/panel_scan_fill.dart:64·69 | '…'은(는) | 받침에 따라 조사를 고른다 | '(는)'은 기계가 붙인 표기로 보인다 |
| app/lib/screens/settings/appliance_section.dart:9 | 본체 화면에 반영하기 | 본체에도 똑같이 맞추기 | R10 |
| settings/connection_section.dart:19·266 · settings_screen.dart:353 | 확인하는 중이에요 / 기본값으로 초기화 | 알아보고 있어요 / 처음 값으로 되돌리기 | R2·R10 |
| settings_screen.dart:276 | (부제) 보기 | 자주 하신 일 | 뜻이 없는 부제다 |
| settings/node_section.dart:199·261 | 연결을 풀지 못했어요 / 연결됨 | …본체 연결을 보고 다시 눌러 주세요 / 연결됐어요 | R5·R2 |
| settings/notification_section.dart:336·372 · widgets/learning_status_dialog.dart:100 | 다시 받기 / 다시 불러오기 / 새로고침 | 새로 보기 | `kRefreshLabel`과 맞춘다(R9) |
| widgets/learning_status_dialog.dart:63·75 | 아직 학습할 실제 사용 기록이 없어요 / 습관을 알아가는 중 | 아직 알아 둘 사용 기록이 없어요 / 습관인지 보고 있어요 | R10·R2 |
| settings/nav_rows.dart:293 | 200%까지 화면이 잘리지 않게 만들었어요. | 200%까지 키워도 글자가 잘리지 않아요. | 개발자 입장에서 쓴 말투다 |
| settings/hub_screen.dart:214 | 현재 위치로 설정 | 지금 있는 곳으로 정하기 | R4 |
| app/lib/widgets/input_guard.dart:6·9 | 입력한 내용을 남겨 두세요 / 닫기 | 저장하지 않고 나갈까요? / 계속 고치기 | 제목과 버튼의 뜻이 엇갈린다 |
| app/lib/screens/voice_screen.dart:422·435·464·500·601 | 음성 명령 / 이대로 실행할까요? / 이대로 실행 | 말로 하기 / 이대로 할까요? / 이대로 하기 | 홈 입구(home 1131·1144)와 맞춘다 |
| voice_screen.dart:122·703 | 말을 알아듣지 못했어요. / 이 기기에서 음성 인식을 쓸 수 없어요 | …다시 말해 주세요. / 이 폰에서는 말로 하기를 쓸 수 없어요. 버튼으로 해 주세요 | R5 |
| app/lib/services/voice_service.dart:12·13·18·19 | …다시 시도해 주세요 / 네트워크 문제로 음성 인식이 중단됐어요 / 아직 준비 중이에요 / 중단됐어요 | …다시 말해 주세요 / 인터넷이 끊겨 말을 듣지 못했어요. 버튼으로 해 주세요 / 아직 들을 준비가 안 됐어요. 조금 뒤 다시 눌러 주세요 / 듣기가 끊겼어요. 다시 말해 주세요 | 시도·중단·네트워크(R3·R10) |
| app/lib/models/appliance.dart:417 · models/suggestion.dart:165 | 바람세기 | 바람 세기 | 다른 곳의 띄어쓰기와 맞춘다 |
| server: rpi/api/routines_router.py:122 | 조용한 시간이라 건너뜀 | 조용한 시간이라 건너뛰었어요 | R2(이름은 그대로) |

**일부러 그대로 둘 것:** '눌렸는지 몰라요', '됐는지 몰라요', '조리 완료가 아닐 수 있어요', '누름 장치가 눌렀어요'(command_result:132, 10/18 평가 뒤 정한 문구), '정지' 버튼, '다시 멈추기'.
위 표의 '바꿀 말' 가운데 성공을 새로 주장하는 것은 없다. '몰라요'도 모두 '몰라요'로 둔다.

## 4. '잠시 쉬기' → '방해 금지' (사용자 결정 10/19)

### 4-1. 정할 것

- **이름:** **방해 금지.** 갤럭시처럼 띄어 쓴다. iOS는 '방해금지'로 붙여 쓰지만 우리 사용자는 갤럭시가 많다고 보고 갤럭시 표기를 따른다.
- **설명:** 이름 아래에 늘 보이는 부제로 다음 문장을 쓴다.
  - '새 제안과 자동으로 하는 일을 잠시 쉬어요. 직접 누르기와 정지는 그대로 돼요.'
  - 업데이트 전에 켜 둔 방해 금지를 이어받은 경우(`suggestions_only`)에는 '새 제안만 쉬어요. 자동으로 하는 일은 그대로 해요'로 쓴다.
- **바꾸지 않는 것:** **조용한 시간**(매일 정한 시간대)은 이름을 그대로 둔다. 두 기능을 같은 칩이나 같은 문장에 묶지 않는다.
- **켜진 상태:** '쉬는 중' 대신 '방해 금지 켜짐'을 쓴다. 칩처럼 짧아야 하면 '방해 금지 · $n분 남았어요'로 쓴다.
- **끄는 버튼:** '그만 쉬기'·'쉬기 끝내기' 대신 **'방해 금지 끄기'**로 쓴다.
- **이력(주의):** 10/15에 '방해 금지'를 '잠시 쉬기'로 바꾼 적이 있다. 사람들이 '방해 금지'를 "제안만 멈춘다"는 뜻으로 오해했기 때문이다(근거: 키오스크 `dnd_overlay.dart` 머리 주석, `idle_view.dart:1084` 주석). 이번에 이름을 되돌리므로, **범위 문장(부제)을 빼거나 줄임표로 자르지 않는 것**을 조건으로 둔다. 실패널에서 부제가 잘리지 않는지 확인한다.
- **바꾸는 범위:** 서버 키(`suggestion_pause`)와 API 이름(`/dnd`)은 그대로 둔다. 화면에 보이는 말만 바꾼다.
- **다른 기능의 '쉬기'는 바꾸지 않는다:**
  - '집 비우는 날'의 안부 확인 쉬기: `care_events_screen.dart:83`, `notification_section.dart:239`
  - 제안 하나를 30분 미루기: `suggestion_screen.dart:86` — 3-5 표처럼 '30분 동안 묻지 않기'로 바꾼다
  - 서버 주석의 '쉬는 중'(누름 장치가 쉬고 있다는 뜻)

### 4-2. 화면에 보이는 곳 — 바꿀 대상

| file:line | 지금 | 바꿀 말 |
|---|---|---|
| app/lib/providers/rpi_api_provider.dart:397 | 잠시 쉬기를 보내지 못했어요. 연결을 확인하고 다시 눌러 주세요. | 방해 금지를 켜지 못했어요. 폰과 본체가 같은 와이파이인지 보고 다시 눌러 주세요. |
| rpi_api_provider.dart:398 | 그만 쉬기를 보내지 못했어요. … | 방해 금지를 끄지 못했어요. …(위와 같음) |
| app/lib/screens/home_screen.dart:1853 | 잠시 쉬는 중. …까지, … | 방해 금지 켜짐. …까지, …남았어요 |
| home_screen.dart:1864 | 그만 쉬기 | 방해 금지 끄기 |
| app/lib/screens/settings_screen.dart:233 | 잠시 쉬기 | 방해 금지 (부제: 위 범위 문장) |
| app/lib/screens/settings/notification_section.dart:31 | 잠시 쉬기 | 방해 금지 |
| notification_section.dart:57 | 그만 쉬기 | 방해 금지 끄기 |
| notification_section.dart:151 | 묻는 알림과 안내 소리만 쉬어요. 직접 하기와 정지는 그대로예요. | 서버 `scope` 문장을 그대로 쓰고, 기본 문장은 위 범위 문장으로 맞춘다 |
| app/lib/widgets/dnd_bottom_sheet.dart:101·114 | 잠시 쉬기 / 쉬는 중 | 방해 금지 / 켜져 있어요 |
| dnd_bottom_sheet.dart:190·191 | 그만 쉬기 / 지금은 쉬고 있지 않아요 | 방해 금지 끄기 / 지금은 방해 금지가 꺼져 있어요 |
| app/lib/widgets/learning_status_dialog.dart:78 | 잠시 쉬는 중이라 묻지 않아요. | 방해 금지가 켜져 있어 묻지 않아요. |
| rpi5-touchscreen-app/lib/screens/kiosk_screen.dart:46 | 잠시 쉬기를 보내지 못했어요. … | 방해 금지를 켜지 못했어요. … |
| rpi5-touchscreen-app/lib/widgets/kiosk/dnd_overlay.dart:70 | 잠시 쉬기 | 방해 금지 |
| dnd_overlay.dart:88·90·91 | 새 제안과 자동으로 하는 일을 잠시 쉬어요 / …까지 새 제안만 쉬어요… / …까지 새 제안과 자동으로 하는 일을 쉬어요 | 문장은 그대로 쓰고, 끝에 '직접 누르기와 정지는 그대로 돼요'를 더한다 |
| dnd_overlay.dart:126 | 쉬기 끝내기 | 방해 금지 끄기 |
| dnd_overlay.dart:110 | …조용한 시간이에요. 폰 설정에서 바꿔요 | …조용한 시간이에요. 휴대폰 앱 설정에서 바꿀 수 있어요 |
| rpi5-touchscreen-app/lib/widgets/kiosk/idle_top.dart:450 | 메뉴. 잠시 쉬기, 설정, 연결, 사용 방법 | 메뉴. 방해 금지, 설정, 연결, 사용 방법 |
| rpi5-touchscreen-app/lib/widgets/kiosk/idle_view.dart:1085 | 쉬는 중 (칩 제목, 조용한 시간이 아닐 때) | 방해 금지 |
| idle_view.dart:1092·1093 | 잠시 쉬는 중, $remaining 남음. 끝내려면 누르세요 / 잠시 쉬기 | 방해 금지 켜짐, $remaining 남았어요. 끄려면 누르세요 / 방해 금지 |
| idle_view.dart:1115 | 쉬기 (아이콘 아래 글자) | 방해 금지 (네 글자 — 실패널에서 폭 확인) |
| idle_view.dart:1736·1740·1756 | 쉬는 중이에요. … 남음 / 새 제안과 자동으로 하는 일을 잠시 쉬어요 / 잠시 쉬기 | 방해 금지 켜짐. … 남았어요 / (범위 문장) / 방해 금지 |
| rpi5-touchscreen-app/lib/widgets/kiosk/settings_overlay.dart:207 | 잠시 쉬기 | 방해 금지 |
| rpi5-touchscreen-app/lib/widgets/learning_status_dialog.dart:86 | 잠시 쉬는 중이에요. 새 제안을 쉬고 있어요. | 방해 금지가 켜져 있어요. 새 제안을 묻지 않아요. (자동으로 하는 일까지 쉬는지는 `scope`에 따라 말한다) |
| rpi/services/quiet_hours.py:32 `CARRIED_PAUSE_SCOPE_TEXT` | 업데이트 전에 켠 잠시 쉬기라… | 업데이트 전에 켠 방해 금지라… |
| rpi/routines/engine.py:662 | 지금은 제안을 쉬는 중이거나 이 제안을 그만 받기로 하셨어요 | 방해 금지나 조용한 시간이라 지금은 묻지 않아요. 또는 이 제안을 그만 받기로 하셨어요 |

- **이름만 바꾸는 범위 밖:**
  - `rpi/services/quiet_hours.py:30` `SCOPE_TEXT`는 두 기능이 함께 쓰는 문장이라 '쉬어요'를 그대로 둔다.
  - 위 표에 넣지 않은 '잠시 쉬기'·'쉬는 중'은 주석이나 docstring에만 있다. 두 에이전트 점검 목록 기준으로 폰 약 40곳, 키오스크 약 45곳, 서버 약 50곳이다. 화면에 보이지 않으므로 이번 이름 바꾸기에서 꼭 고치지 않아도 된다.
  - `docs/`의 '잠시 쉬기' 언급은 이름을 바꿀 때 `grep`으로 함께 고친다.

### 4-3. '조용한 시간'이 화면에 보이는 곳 (이름 그대로, 확인용)

- **폰**
  - `app/lib/models/quiet_hours.dart:50·78·88`
  - `models/routine.dart:441`
  - `screens/settings/notification_section.dart:109·112·130`
  - `screens/settings_screen.dart:240`
- **키오스크**
  - `rpi5-touchscreen-app/lib/models/ambient.dart:270·280`
  - `widgets/kiosk/dnd_overlay.dart:110`
  - `widgets/kiosk/idle_view.dart:1085·1090·1738`
- **서버**
  - `rpi/services/quiet_hours.py:29` `SKIP_REASON`
  - `rpi/routines/auto_rules.py:132·133`
  - `rpi/api/routines_router.py:122`

**주의:** `idle_view.dart:1090`(조용한 시간 화면 읽기 문장 '…일반 안내 소리를 쉬어요')도 '쉬어요'를 쓴다. 이름을 바꾼 뒤 두 기능의 문장이 다시 섞이지 않는지 같이 본다.

## 5. 점검 요약

- **바꿀 문구로 표시한 것:** 표의 줄 기준으로 약 120곳이다. 키오스크 약 55곳, 폰 약 65곳, 서버 2곳이다. 방해 금지 이름 바꾸기 대상은 따로 25곳이다(폰 11, 키오스크 12, 서버 2).
- **자주 나온 문제**
  1. **'~하는 중'처럼 명사로 끝나는 상태말:** 폰 59줄, 키오스크 약 20건.
  2. **'확인'을 두 가지 뜻으로 씀:** 확인 필요·켜짐 확인·확인이 필요해요 등 약 30곳. 결과인지 사용자가 할 일인지 구별되지 않는다.
  3. **같은 것을 다른 이름으로 부름:** 10쌍 이상(위 R9 목록).
  4. **할 일이 없는 오류 문구:** 키오스크 약 8건. 폰은 '연결을 봐 주세요'로만 끝나는 문구가 41줄이다.
  5. **번역투·전문어:** 시도·모드·카드·코드·학습·실행 등.
- **좋은 점:** 합쇼체와 '~되어지다'는 사용자 화면에 거의 없다. '몰라요'로 솔직하게 말하는 원칙도 대부분 지켜지고 있다.
- **고칠 순서(제안):** 3-1(안전) → 키오스크 도움말·첫 화면(3-2) → 방해 금지 이름 바꾸기(4) → R2(상태말)·R9(같은 이름)를 한 번에 일괄 수정 → 나머지.
