Seongwonp/Simplelay/docs/가산점-증거-대장.md

# 가산점 증거 대장

2026-10-01. 데스크톱 실측 전 빈 양식이다. **아래 행은 성공 증거가 아니다.**
기준은 [본선 실행계획 §6](archive/본선-실행계획-2026-09-30.md#6-결선-배점과-보드-역할-2026-09-30-부문-세부-안내사항-v6)에 정리한 공식 안내다.
완성도 60·독창성 20·활용성 20, 가산점은 각 5점·최대 10점이다.

| 공식 가산점 문구(실행계획 §6 기준) | 대응 증거 | 미결 조건 |
|---|---|---|
| (1) LG 제공 임베디드 SW 플랫폼 기반으로 하드웨어 3종 연동 | 보드별 앱 계정의 API 최소 호출 + 실제 시연 흐름에서 세 보드 연동 | **대체 근거(팀 확정, 2026-10-05):** 안내 예시의 RPi Zero 자리를 RPi4가 맡는다(역할 매핑은 아래). **실제 3종 연동 증거:** 현재 모의·미측정 — RPi5↔RPi4는 LAN 위 모의 모션까지, ESP32 콘센트 모듈은 펌웨어 컴파일까지이며 세 보드가 한 흐름에서 함께 동작한 기록은 없다. 남은 조건은 보드별 최소 호출과 실제 시연 연동 기록 |
| (2) 멀티모달 확장성: 음성·영상·조도 등 다중 센서를 융합해 상황 인지 정확도를 높인다 | 입력별 최소 호출 + 복수 입력이 하나의 상황 판단·제안에 기여하는 시연 | 센서가 존재하거나 API 한 번 성공한 것만으로 융합 효과를 입증하지 않음 |

보드 수를 늘린 것만으로 가산점 인정을 확정하지 않는다. 역할은 RPi5(해석·제안·키오스크),
RPi4(실행 관리·검증), ESP32(CT 전력·릴레이 비상정지), 모션 MCU(Uno 또는 ESP32 — 팀원 코드 수령 후 확정, CoreXY A/B·시간 기반 Z)로 구분한다.
API 최소 호출 성공과 실제 시연 사용은 **별개의 증거**다. root 호출 성공은 앱 계정 권한 증거가 아니다.

- **대체 근거(역할 매핑, 팀 확정):** 안내 예시의 RPi Zero 자리 = RPi4(실행 관리·검증·정지, RPi5에서 실행을 위임받고 모션 MCU·ESP32 콘센트 모듈과 연결). 이것은 보드 구성의 설명이지 연동 증거가 아니다.
- **실제 3종 연동 증거(현재 모의/미측정):** RPi5↔RPi4 LAN 통신과 폰(에뮬레이터)→RPi5→RPi4 실행은 **모의 모션**으로만 확인했다. ESP32 콘센트 모듈은 펌웨어 컴파일까지이고 실물 연결·CT 측정은 없다. 아래 표의 (1) 행이 채워지기 전에는 3종 연동을 확인했다고 쓰지 않는다.

## 실측 기록 — 실행 전 빈칸 유지

**2026-10-06 보드 점검(읽기 전용 기본 모드) 메모 — 위 표의 성공 증거가 아니다.**
- 점검은 RPi5 백엔드 컨테이너와 RPi4 실행기 컨테이너에서 돌렸다. 둘 다 실제로 root로 돈다. 이 결과는 앱 계정 권한 증거로 쓰지 않는다.
- 키오스크 앱 계정과 같은 UID로 다시 돌렸다.
  - 파이썬 모듈과 로컬 웹 호출은 앱 권한까지 성공했다.
  - 플랫폼 시스템 서비스 최소 호출은 접근 거절이었다. 실행한 프로세스에 앱 보안 레이블이 없었으니(`unconfined`) 실제 앱의 권한과 같은 조건이 아니다. 그래서 **앱 계정 권한은 미검증**으로 둔다.
- 플랫폼 기능 서비스(해석·제안, 음성, 영상 등)의 최소 호출은 이번 점검 대상이 아니었다. 계속 미측정이다.

**2026-10-07 보드 점검 메모(앱 계정 재실행) — 플랫폼 시스템 서비스 최소 호출 1건 성공, 조건부.**
- RPi5에서 키오스크 앱 계정과 같은 UID로 플랫폼 시스템 서비스(시간 정보) **읽기 메서드 1건을 호출했고 성공**했다(2026-10-07 12:22 UTC). 결과 파일은 로컬 비공개 사본에만 둔다.
  - 한계 ①: 호출한 프로세스의 보안 레이블은 실제 앱과 달랐다(`unconfined`). 확인 범위는 같은 UID의 별도 프로세스에서 특정 공개 읽기 메서드 호출 1건 성공(조건부)이며, 실제 앱 문맥 호출은 미검증이다.
  - 한계 ②: 앱 계정에 허용되지 않은 다른 시스템 서비스 2건은 접근 거절이었다(정상 동작).
- 앱을 다시 설치하면 앱 계정 UID가 바뀐다(10/7 확인). 점검 설정의 계정은 설치할 때마다 다시 확인한다.
- ~~RPi4에는 우리 앱이 설치되지 않았고 실행기는 root 컨테이너로 돈다. 그래서 RPi4 앱 계정 증거는 없다.~~ → **2026-10-08 갱신:** RPi4에도 우리 앱 패키지를 설치해 앱 계정을 만들고, 그 계정 UID로 같은 플랫폼 시스템 서비스 읽기 호출 1건을 성공시켰다(2026-10-08 05:56 UTC). 조건은 RPi5와 같다 — 보안 레이블은 실제 앱과 다르고, 이 메서드는 기본 정책이 모든 계정에 허용한다. 실행기 자체는 여전히 root 컨테이너로 돈다.
- 플랫폼 **음성 인식** 서비스는 앱이 쓸 수 있는 것을 찾지 못했다. 음성 "멈춰" 정지는 폰 음성 인식으로 정했다. 따라서 이 기능은 가산점 (1)·(2)의 플랫폼 증거가 아니다.
- 이 기록은 "같은 UID의 별도 프로세스에서 특정 공개 읽기 메서드 호출 1건 성공(조건부), 실제 앱 문맥 호출은 미검증"으로 한정한다. "플랫폼 기능을 시연 흐름에 썼다"는 증거가 아니다. 위 표의 (1) 행들은 여전히 미측정이다.

| 항목 | 근거 종류(API 최소 호출 성공 / 실제 시연 흐름에서 사용) | 보드 | 측정 시각 | 결과 파일(로컬 경로만, 내용 비공개) | 상태 |
|---|---|---|---|---|---|
| (1) 해석·제안 기능 서비스 | API 최소 호출 성공 | RPi5 | — | — | 미측정 |
| (1) 실행·검증 기능 서비스 | API 최소 호출 성공 | RPi4 | — | — | 미측정 |
| (1) 전력 계측·콘센트 통신 | API 최소 호출 성공 | ESP32 ↔ RPi4 | — | — | 미측정 |
| (1) 제안→승인→실행→CT 검증 | 실제 시연 흐름에서 사용 | RPi5 ↔ RPi4 ↔ ESP32 | — | — | 미시연 |
| (1) 모션 링크 status/ping/limits/stop | API 최소 호출 성공 | RPi4 ↔ 모션 MCU | — | — | 미측정 |
| (1) 승인한 좌표 이동·시간 기반 누름·검증 | 실제 시연 흐름에서 사용 | RPi4 ↔ 모션 MCU, ESP32 | — | — | 미시연 |
| (2) 음성 인식 서비스 | API 최소 호출 성공 | RPi5 | — | — | 미측정 |
| (2) 영상 입력 서비스 | API 최소 호출 성공 | RPi5 | — | — | 미측정 |
| (2) 조도·주변 상황 입력 | API 최소 호출 성공 | 담당 보드 확정 후 기록 | — | — | 미측정 |
| (2) 다중 입력 융합과 단일 입력 비교 | 실제 시연 흐름에서 사용 | RPi5, 입력 담당 보드 | — | — | 미시연 |
| (2) 불일치·센서 누락 시 사용자 확인 | 실제 시연 흐름에서 사용 | RPi5 ↔ RPi4 | — | — | 미시연 |
| (2) 세탁 완료: 전력+비프음 융합 vs 단일 입력(CT 전력 하강 + 마이크 종료음 → done_confirmed / *_only 비교, 10/6 결정 D2) | 실제 시연 흐름에서 사용 | ESP32 → RPi4 → RPi5 | — | — | 미측정(코드는 가짜 모듈·합성 음 시험까지, 무대는 "시연 주입") |

원본 대장은 비공개 로컬 사본으로 운영한다. 측정 시각은 UTC와 현지 offset을 함께 남기고,
결과 파일 칸에는 그 PC/보드의 로컬 경로만 쓴다. 원시 응답·설정·서비스 식별자·객체 경로·스크린샷을
이 공개 문서에 붙이지 않는다. 공개 반영 시에도 경로에 내부 식별자가 있으면 일반 자리표시자로 바꾼다.
상태는 미측정/실패/최소 호출 성공/시연 사용 확인으로 구분하고, 모의 결과에는 반드시 “모의”를 붙인다.
기록은 측정 시점의 사실이며 현재 readiness나 실행 허가에 재사용하지 않는다.

## 장애 극복·로컬 정지 — 플랫폼 기능과 독립된 별도 증거

아래 항목은 완성도·장애 극복의 근거다. 플랫폼 API 성공 건수에 합산하지 않는다.

| 항목 | 근거 종류(API 최소 호출 성공 / 실제 시연 흐름에서 사용) | 보드 | 측정 시각 | 결과 파일(로컬 경로만, 내용 비공개) | 상태 |
|---|---|---|---|---|---|
| 통신 단절 후 실행 실패·자동 재개 금지 | 실제 시연 흐름에서 사용 | RPi5 ↔ RPi4 | — | — | 미측정 |
| MCU 링크 두절·host watchdog·원점 무효화 | 실제 시연 흐름에서 사용 | RPi4 ↔ 모션 MCU | — | — | 미측정 |
| 서비스 재시작 후 재연결 시간·live 재점검 | 실제 시연 흐름에서 사용 | RPi5 / RPi4 | 2026-10-06 | 로컬 기록(비공개) | **모의 모션에서 확인** — RPi4 실행기 재시작 뒤 RPi5가 백엔드 재시작 없이 다시 붙고 다음 모의 실행 성공. 재연결 시간은 미측정 |
| 로컬 stop 명령 전달·출력 차단 시간 | API 최소 호출 성공 | RPi4 ↔ 모션 MCU | — | — | 미측정 |
| 플랫폼 서비스 없이 로컬 정지 유지 | 실제 시연 흐름에서 사용 | RPi4 ↔ 모션 MCU | — | — | 미측정 |
| 물리 비상정지·릴레이 차단·재부팅 중 출력 비활성 | 실제 시연 흐름에서 사용 | ESP32 / 모션 MCU | — | — | 미측정 |
| 과거 성공 기록만 남고 현재 연결 실패 시 실행 거절 | 실제 시연 흐름에서 사용 | RPi5 ↔ RPi4 | — | — | 미측정 |

정지 ACK는 물리 정지의 증명이 아니다. 로컬 비공개 기록에는 요청·ACK·PWM/STBY 또는 릴레이 변화·
실제 움직임 정지·안전 상태 복귀 시각을 구분한다. 재연결 성공도 이전 동작의 재개 권한이 아니다.

## 공감 로직 독립성

습관 학습, 제안 거절 처리, 제안 이유 설명, 사용자의 승인·정지·수정 권한은 플랫폼 추론 없이도 동작해야 한다.
플랫폼 추론은 선택적 보조이며 꺼짐·오류·응답 지연이 사용자 통제나 로컬 정지 경로를 막아서는 안 된다.

| 항목 | 근거 종류(API 최소 호출 성공 / 실제 시연 흐름에서 사용) | 보드 | 측정 시각 | 결과 파일(로컬 경로만, 내용 비공개) | 상태 |
|---|---|---|---|---|---|
| 추론 OFF에서 습관 기반 제안·이유 설명 | 실제 시연 흐름에서 사용 | RPi5 | — | — | 미시연 |
| 거절·잠시 쉬기·제안 수정 반영 | 실제 시연 흐름에서 사용 | RPi5 | — | — | 미시연 |
| 사용자 승인 전 실행 없음·정지 우선 | 실제 시연 흐름에서 사용 | RPi5 ↔ RPi4 ↔ 모션 MCU | — | — | 미시연 |
