Seongwonp/Simplelay/docs/질의응답-대비.md

# 결선 질의응답 대비 — 생활 · 조율 · 책임 (2026-10-26 개정)

결선 평가는 시연·발표 10분, 질의 10분이다. 이 문서는 **심사위원이 물을 질문**에 20초, 되물으면 1분 안에 답하는 기준이다.
발표의 중심은 [결선 발표 대본](발표/결선-발표-대본.md)의 세 기둥(생활 · 조율 · 책임)이고, 누름 장치는 버튼만 있는 옛 가전을 이 흐름에 넣는 **수단**이다. 질문도 그 순서로 묶었다.
질문 목록은 10/16·10/19 외부 평가가 꼽은 것에, 10/26 심사위원 관점 평가([10/26 devlog](devlog/devlog_2026-10-26-desktop-empathy.md) §7)의 공격받을 곳 다섯(타이머와 차이 · 누구의 습관 · 공기청정기 하나 · 거절 · 언어 모델 표본·속도)을 더했다. 근거는 [공감지능 근거 자료](발표/공감지능-근거-자료-2026-10-25.md).

**말할 때 쓰지 않는 말:** 팀 내부 점검 번호(G…·R…·PS-…)와 커밋 해시는 입으로 말하지 않는다. 심사위원에게는 **무엇이 되는지**로 말한다.

**원칙**
- 실측하지 않은 수치는 말하지 않는다. "측정 필요"라고 말하고, 실측표에 값이 생기면 그 값만 쓴다([실측 기록표](실측-기록표.md)). 숫자는 조건·표본과 함께("보드 실측 고정 50문장, 가운데값 10초").
- 상용 제품과는 **설계 차이**로만 비교한다. 성능·가격 우위를 주장하지 않는다. 상용품 기능은 공개 자료로만, 출처·확인 날짜와 함께.
- 모르는 것은 "아직 확인하지 않았습니다"라고 말한다. 확인하지 않은 것을 확인했다고 말하는 것이 가장 큰 감점이다.
- "AI가 학습한다", "사람을 이해한다"고 단정하지 않는다 — "실제로 쓴 기록을 세는 규칙"이다.

질문을 받으면 **20초 답을 먼저** 말하고(문장 4~5개 — 리허설에서 잰다), 되물으면 '되물으면'이나 아래 '질문별 1분 답변'으로 넘어간다.

## 1. 생활 — 일상을 알아채는가

**1-1. "같은 시각에 세 번 눌렀다고 습관이면, 타이머와 무엇이 다릅니까?"**
> "맡긴 뒤의 모습은 타이머와 비슷한 게 맞습니다. 다른 것은 거기까지 가는 길입니다. 타이머는 사람이 시각을 정해 넣지만, 저희는 실제로 쓴 기록에서 시각을 찾고, 바로 실행하지 않고 사람이 있을 때 평소 시각 10분 전에 묻습니다. 거절이 이어지면 쉬고, 사람이 확인 칸을 보고 맡겨야만 알아서 합니다."
- 되물으면: 시각이 가까운 것끼리 묶고 들쭉날쭉하면 '이맘때'로 조심스럽게 말한다. 실제로 '네'를 누른 시각 쪽으로 평소 시각을 조금씩(±30분 안) 옮긴다. 평일 습관은 평일에만 묻는다. 하루 묻는 횟수에 상한이 있다(기본 3). 맡긴 뒤에도 조용한 시간·비상정지 중엔 하지 않고, '알게 된 것'에서 보고 끈다.
- 인정할 것: 규칙 자체는 단순하다(학습 아님). "평일만인가요?"를 한 번 묻고 기억하는 것은 다음 단계.
- 하면 안 되는 말: "타이머와 완전히 다릅니다", "생활 패턴을 학습합니다".

**1-2. "누구의 습관입니까? 가족이 여럿이면요?"**
> "가구 단위입니다. 이 집에서 쓴 기록을 하나로 보고, 사람을 구분하지 않습니다 — 얼굴 식별은 일부러 하지 않습니다. 그래서 카드도 '누구 님의 습관'이 아니라 '이 집에서 이 시간대에 쓴 날'로 말합니다. 가족과 맞지 않으면 맡기지 않으면 되고, '알게 된 것'에서 숨길 수 있습니다."
- 인정할 것: 사람마다 다른 습관을 나눠 알지는 못한다. 부르는 이름(인사)은 폰에서 정한 한 이름뿐이다.
- 하면 안 되는 말: "누가 했는지 압니다", "가족 구성원별로 학습합니다".

**1-3. "결국 공기청정기 하나만 이해하는 것 아닙니까?"**
> "실제로 연결된 LG 가전이 공기청정기 하나라 실물 시연은 그것이 중심입니다. 습관 규칙은 공기청정기 전용이 아니라 직접 쓴 기록을 세는 공통 규칙이고, 버튼만 있는 전자레인지도 누름 장치로 같은 흐름에 들어옵니다. 또 실내·바깥 공기, 날씨, 방 밝기, 사람 있음을 엮어 제안하거나, 환기처럼 가전을 움직이지 않는 조언만 합니다. 두 번째 LG 기기는 다음 단계입니다."
- 되물으면: 불을 끄면 수면 모드, 오래 비웠다 돌아오면 공기, 황사 특보가 새로 나면 대비 — 카드 이유에 쓴 신호만 적고 늘 사람 확인. 없는 기기는 권하지 않는다(제습기가 없으면 에어컨 제습, 그것도 없으면 카드 없음). 이 제안들은 본체에 배포했고 **실물 조건에서는 아직 확인하지 않았다**.
- 하면 안 되는 말: "모든 가전을 이해합니다", 확인하지 않은 기기 연동.

**1-4. "언어 모델이 느리지 않습니까? 정확합니까?"**
> "정확하지 않습니다. 보드에서 인터넷 없이 고정 50문장으로 재 보니, 알아들어야 할 말 30개 중 16개를 맞혔고(돌려 말한 말은 20개 중 8개), 골라선 안 될 말 16개 중 9개에도 공기청정기 동작을 골랐습니다. 그래서 목록에 없는 기기('에어컨 켜 줘')·이미 한 일('방금 켰어')은 모델에 보내기 전에 규칙이 거르고, 모델이 말과 반대로 고르면 버리게 했습니다. 같은 50문장으로 다시 재니 30개 중 23개(77%)를 맞혔고(돌려 말한 말 20개 중 13개), 골라선 안 될 말 16개 중 1개(6%)에만 동작을 골랐습니다 — 다만 규칙을 만든 문장 기준이라 좋게 나오는 쪽이고, 새로 쓴 문장 12개에서는 4/5 맞힘·0/7 잘못 고름이었습니다. 모델까지 가면 가운데값 10초, 90%가 14초 안이고 그동안 '생각하고 있어요'가 뜹니다. 그래서 모델은 정해진 목록에서 고르기만 하고 실행하지 않습니다 — 고른 것은 질문으로만 보이고 사람이 '네'를 눌러야 실행되며, '켜지 마' 같은 말은 모델에 보내기 전에 규칙이 막습니다."
- 되물으면: 규칙으로 알아듣는 말('공기청정기 켜줘')은 기다림 없이 바로다. 공개 모델을 그대로 쓰고 학습하지 않았다. 본체 마이크로 음성 인식까지 하면 한 문장 15~19초라 음성 인식은 폰에서 한다(10/25 실측). 자세한 표와 틀린 문장은 [언어 모델 평가](발표/언어모델-평가-2026-10-26.md). 다음 단계는 새 문장을 더 늘려 다시 재는 것.
- 하면 안 되는 말: "8개 중 8개 정확", "정확도 100%", "잘 알아듣습니다", "빠릅니다".

**1-5. "AI는 어디에 썼습니까?"**
> "새로 학습한 모델은 없습니다. 공개 사전학습 모델 둘을 본체 안에서 그대로 씁니다 — 사람이 있는지 없는지만 보는 검출 모델, 돌려 말한 말을 정해진 동작 하나로 고르는 언어 모델입니다. 습관 판단은 학습이 아니라 실제 쓴 기록을 세는 규칙이고, 실행·승인·정지는 모두 정해진 규칙과 사람 확인입니다. 개발 과정에서 AI 개발 도구를 쓴 사실은 제출 서류에 밝혔습니다."
- 밤사이 생활 요약 두 문장도 본체 안 언어 모델이 만들지만, 검사(영어 금지·기록에 없는 숫자 금지·120자)를 통과한 것만 보이고 아니면 고정 문장이다.
- 플랫폼 AI 에이전트와는 무엇을 나누나: "사람 수만 플랫폼 AI 에이전트와 나눕니다 — 보드에서 동작을 확인했고, 화면에는 보이지 않습니다." 영상은 본체 밖으로 나가지 않는다.
- 왜 클라우드 언어 모델이 아닌가: 플랫폼 클라우드 에이전트는 결선장에서 접속되지 않았고(10/25 재시험), 집 안 말을 밖으로 보내지 않는 쪽이 맞다.

**1-6. "습관 카드가 실제 사용 기록으로 뜬 겁니까?"** (자세히 Q10)
> "10월 25일부터 매일 같은 시간대에 실제로 썼고, 카드에는 쓴 날이 그대로 나옵니다. 가짜 기록으로 습관을 만들지 않습니다. 기록이 모자라면 '학습 중'을 그대로 보이고, 카드는 연습이라고 먼저 말씀드렸습니다."

## 2. 조율 — 때와 기기를 맞추는가

**2-1. "거절하면 어떻게 됩니까?"**
> "연달아 두 번 거절하거나 답이 없으면 그 습관은 7일 쉽니다. '이미 했어요'는 거절로 세지 않고, 그날은 다시 묻지 않습니다. 아예 받지 않겠다고 하면 다시 묻지 않습니다. 물을 때 아무도 없으면 평소 시각 30분 뒤까지 기다렸다 한 번만 묻고, 그래도 없으면 그날은 건너뜁니다 — 거절로 세지 않습니다. 알아서 한 일은 5분 안에 '되돌리기'를 누르면 되돌리고, 그 일은 다시 묻습니다."
- 인정할 것: 한 번 거절로는 바로 물러서지 않는다. 거절 이유를 그 이상 알지는 못한다.
- 하면 안 되는 말: "거절하면 물러섭니다"(한 번에 물러서는 것처럼), "거절 이유를 이해합니다".

**2-2. "카메라가 집 안을 찍는 것 아닙니까? 사생활은요?"**
> "카메라는 사람이 있는지 없는지만 봅니다. 사진은 저장하지 않고, 본체 밖으로 보내지 않습니다. 이 판단은 말을 거는 때를 고르는 데에만 씁니다 — 자리를 비우면 화면을 쉬고, 다가가면 깨우고, 오래 비웠다 오면 인사합니다. 실행의 근거로는 쓰지 않고, 설정에서 끌 수 있습니다. 꺼도 집은 그대로 쓰입니다."
- 되물으면: 판단 결과 파일에는 사람 수만 남는다. 방 밝기도 같은 카메라로 16×12 흑백 한 장만 덮어써 평균만 본다(얼굴을 알아볼 수 없는 크기). 얼굴 식별·감정 추정은 하지 않는다.
- 하면 안 되는 말: "사람이 있을 때만 움직입니다", "누가 있는지 압니다".

**2-3. "상용 서비스도 습관 제안을 합니다. 차이가 뭡니까?"** (자세히 Q3)
> "상용 서비스는 앱 알림으로 제안합니다. 저희는 실제 기록에서 사흘 이상, 세 번 이상 되풀이한 것만, 집에 사람이 있을 때 묻고, 사람이 맡긴 것만 자동으로 합니다. 열 나는 가전은 맡길 수 없고, 판단은 집 안 본체에서 합니다. 버튼만 있는 옛 가전도 같은 흐름에 넣습니다. 성능 비교가 아니라 설계 차이로 말씀드립니다."
- **발표 전 재확인:** 상용 쪽 사실(예: 묻는 것이 기본이고 묻지 않고 하려면 따로 켜는 방식, 앱 탭에서 조용히 제안)은 공개 자료 기준이고 날짜를 다시 확인한다 — [외부 조사](발표/공감지능-외부조사-2026-10-26.md). 확인 전에는 제품 이름을 들어 단정하지 않는다.
- 인정할 것: 맡기는 구조(따로 허락해야 자동)는 상용 서비스와 비슷한 곳도 있다. 차이는 묻는 때·근거 표시·열 나는 가전·기기 안 판단·옛 가전이다.
- 하면 안 되는 말: "ThinQ보다 똑똑하다", 상용품 성능·정확도 비교.

**2-4. "인터넷·LG 클라우드가 끊기면요?"**
> "LG 가전 제어만 클라우드가 필요합니다. 습관 판단·사람 감지·말 알아듣기의 언어 모델, 버튼식 가전 누름·승인·정지는 집 안 본체와 실행기에서 돕니다. 클라우드가 안 되면 보내기 전이면 '못 했어요', 보냈는데 상태를 못 읽으면 '몰라요'로 말하고 다시 보내지 않습니다. 오늘 대회장 인터넷이 안 되면 '모의 클라우드입니다'라고 먼저 말씀드립니다."

## 3. 책임 — 맡긴 것만 하는가

**3-1. "전자레인지 같은 열 나는 가전도 자동으로 합니까?"**
> "하지 않습니다. 열 나는 가전은 맡길 수 없고, 매번 '네' 확인을 받습니다. 자주 승인해도 마찬가지입니다. 맡길 수 있는 것은 위험이 낮은 LG 가전 동작뿐입니다. 콘센트 전력은 자동 실행의 근거가 아니라, 실행 중에 지켜보고 비상정지로 끊는 안전장치로 씁니다."
- 인정할 것: 콘센트 모듈 회로는 제작 중이다(그날 사실대로). 열 안 나는 물리 가전(선풍기·가습기·조명) 맡기기는 아직 만들지 않았다.
- 하면 안 되는 말: "알아서 요리를 시작합니다", "사람이 있으면 자동으로 데웁니다".

**3-2. "자주 '네'를 누르면 알아서 맡겨집니까?"**
> "아닙니다. 사용자가 확인 칸 — 언제, 무엇을, 하지 않는 경우, 끄는 곳 — 을 보고 직접 눌러야 맡겨집니다. 맡긴 뒤에도 조용한 시간과 비상정지 중엔 하지 않고, 결과를 알리며, 언제든 끌 수 있습니다."

**3-3. "언어 모델이 잘못 알아들으면요?"**
> "목록 가운데 하나를 고를 뿐 실행하지 않습니다. 확인 카드에서 사람이 '네'를 눌러야 실행하고, 모르면 '잘 모르겠어요'로 아무것도 하지 않습니다."

**3-4. "비상정지는 무엇을 끊습니까?"** (자세히 Q5·짧은 질문 '물리 비상정지')
> "콘센트 모듈의 비상정지 버튼은 전자레인지 콘센트 릴레이를 끊고 래치합니다. 누름 장치 모터 전원은 이 버튼이 끊지 않습니다. 모터는 정지 명령으로 멈추고, 실행 중 생존 신호가 끊기면 실행기가 스스로 멈추며, 솔레노이드는 켜짐 시간 상한과 냉각을 펌웨어가 지킵니다."
- 그날 사실대로: 콘센트 모듈이 아직 없으면 "콘센트 비상정지는 제작 중이라 오늘은 가열하지 않습니다", 모터 전원 스위치를 달았으면 그 사실. 하면 안 되는 말: "비상정지를 누르면 전부 꺼집니다".

## 4. 수단 — 누름 장치와 하드웨어

**4-1. "Touch Bridge와 같은 기계 아닙니까?"** (자세히 Q1·Q7)
> "맞습니다. 갠트리·모터·드라이버·엔코더와 모션 펌웨어의 제어 핵심은 같은 팀 HW 담당이 Touch Bridge용으로 만든 기계 1대를 함께 씁니다. 모션 보드는 따로입니다. 이번 출품의 중심은 그 위의 생활·조율·책임 흐름 — 습관 알아채기, 묻는 때, 맡기기 — 이고, 누름 쪽에서는 승인 결속·결과 확인·정지 안전 계층과 콘센트 모듈이 새로 만든 것입니다. 경계는 처음부터 표로 밝혔습니다."

**4-2. "조작판마다 갠트리를 달면 너무 크지 않습니까? (확장성)"**
> "큽니다. 지금 갠트리는 버튼이 많은 조작판을 위한 시제품이라 상용 버튼 누름 장치보다 크고 설치도 어렵습니다. 대신 하나가 조작부의 여러 버튼을 순서대로 누릅니다. 핵심은 갠트리가 아니라 그 위의 흐름이라, 작동기는 갈아 끼우는 부품으로 설계했습니다 — 버튼 하나짜리는 작은 누름 장치, 다이얼은 돌리는 장치가 다음 단계입니다. 설치 시간은 아직 재지 않았습니다."
- 하면 안 되는 말: "작게 만들 수 있습니다"(설계 없음), 설치 몇 분(측정 전), 제조사와 협의했다.

**4-3. "CT로는 정상 완료와 취소·문 열림을 구분 못 하지 않습니까?"** (자세히 Q4)
> "구분 못 합니다. 그래서 '조리 완료'라고 하지 않고 '가열 종료 감지, 조리 완료가 아닐 수 있음'이라고만 말합니다. 그리고 지금은 그 신호를 자동 실행의 근거로 쓰지 않고, 열 나는 가전을 지켜보는 안전장치로만 씁니다. 구분할 근거(종료음·남은 시간 표시·문 스위치)는 측정으로 찾을 계획이고, 지금은 없습니다."

**4-4. "그냥 상용 버튼 누름 로봇을 사면 되지 않습니까?"** (자세히 Q2)
> "설치 간편함과 가격은 상용품이 낫습니다. 저희 이야기의 중심은 누르는 장치가 아니라, 버튼만 있는 가전의 사용도 기록하고 같은 습관·묻기·맡기기 흐름에 넣는 것입니다. 장치 쪽 설계 차이는 하나가 여러 버튼을 순서대로 누르고, 누른 결과를 보낸 길과 다른 근거로 확인한다는 것입니다. 상용품을 시험한 것은 아닙니다."

## 질문별 1분 답변

### Q0. "그래서 지금, 처음부터 끝까지 실물로 된 장면이 있습니까?" (가장 날카로운 질문)

**답(10/26 기준 — 그날 사실대로 바꾼다):** 결선 조건에서 처음부터 끝까지 리허설한 장면은 아직 없습니다. 실물인 부분을 나눠 말씀드리겠습니다.

- **실물로 됩니다:** 본체 카메라로 사람 있음/없음(부팅 때 자동 시작), 본체 안 언어 모델로 돌려 말한 말 알아듣기(인터넷 없이 가운데값 10초, 고정 50문장에서 모델만으로 맞힘 53%·잘못 고름 56%, 규칙 거르기를 더한 뒤 같은 문장 77%·6% — 그래도 늘 '네' 확인, [평가](발표/언어모델-평가-2026-10-26.md)), 실제 공기청정기 찾기·추가·켜기·바람 세기를 상태를 다시 읽어 확인, 정해진 시각에 카드 없이 켜고 끄기(밤 10시·다음 날 아침 7시, 각 1회), 모터 축 구동·엔코더 계수·정지 세 단계(시험대), 15.8형 패널 키오스크.
- **아직 아닙니다:** 실제 기록에서 습관 카드가 뜨는 것(10/25부터 기록 모으는 중), 습관 카드에서 맡긴 뒤 다음 날 알아서 하는 것, LG 앱으로 바꾼 것이 실제로 기록되는 것(시험만), 갠트리 캐리지 이동과 실제 버튼 누름, 콘센트 전력 판정.
- **그래서 어떻게 하나:** 준비되지 않은 장면은 시연에서 **먼저 "연습입니다 / 연출입니다 / 모의입니다"라고 말하고** 보여 드립니다.

**한 줄:** "측정 전인 것을 측정했다고 말하지 않겠습니다."
**근거:** [시연 계획 §0·§2](본선-시연-계획-v4.md), 개발완료보고서 '장면별 실물 / 모의' 표.
**하면 안 되는 말:** "거의 다 됐습니다", "되는데 오늘만 안 됩니다", 연습 화면을 가리키며 "이게 실제입니다".

### Q1. "갠트리와 모션 펌웨어는 팀원의 이전 작품(Touch Bridge) 것 아닙니까?"

**답:** 맞습니다. 누르는 몸(CoreXY 갠트리)과 모션 제어 핵심(PID·기구학·궤적)은 팀원의 이전 작품과 공유합니다. 보고서 첫머리에 재사용 경계를 표로 밝혔습니다. 이번 대회에서 새로 만든 것은 그 위 계층입니다.
- 직접 사용 기록 → 습관 알아채기 → 사람이 있을 때 묻기 → 맡기기 → 알아서 하고 알리기(본체), 사람 감지·말 알아듣기 연결(공개 모델, 학습 없음)
- 무엇을 누를지 **승인받은 그 명령만** 실행하는 승인 결속(명령 지문), 눌렸는지를 층별로 확인하고 모르면 다시 누르지 않는 정책
- RPi5 본체·RPi4 실행기·ESP32 모션의 3단 경로와 정지 확인 단계(보냄 → 모션 보드 응답 → 멈춤 확인)
- 콘센트 전력(CT)·릴레이·비상정지 모듈
- 키오스크 앱 전체, 폰 앱의 상태·승인·기록·루틴·LG 가전 화면(폰 앱 **골격**은 이전 작품을 확장했다 — 경계 표에 있다)

**"그럼 하드웨어는 뭘 만들었습니까?"로 되물으면**

| 함께 쓰는 하드웨어 | 이번에 만든 하드웨어 |
|---|---|
| CoreXY 갠트리 프레임·벨트·레일, XY 엔코더 모터 2개·드라이버·엔코더 — **기계 1대를 두 프로젝트가 함께 씁니다** | **ESP32 콘센트 모듈** — 콘센트 전력 계측, 전자레인지 릴레이, 비상정지 버튼과 걸림 회로(펌웨어·호스트 경로 완성, **회로는 제작 중**) |
| | **ESP32 모션 보드는 프로젝트마다 따로** 씁니다 |
| | 본체 거치(케이스 모양 패널 거치대 뒤에 RPi5·온습도 센서·웹캠 — 하우징은 만들지 않음, 10/26 결정) |

**한 줄:** "몸은 공유하고, 사람을 알아채고 묻고 맡기는 흐름을 새로 만들었습니다."
**근거:** [재사용 경계](reuse-boundary.md) 경계 표, 개발완료보고서 §3-1.
**하면 안 되는 말:** "기구는 따로 설계했다", "펌웨어는 독립"(10/10에 철회한 문장), "하드웨어도 전부 새로 만들었다".

### Q2. "SwitchBot 같은 버튼 누름 로봇 몇 개 사면 되지 않습니까?"

**답(설계 차이만):**
- 버튼 로봇은 **버튼 하나에 장치 하나**를 붙입니다. 저희 누름 장치는 **하나가 패널의 여러 버튼**을 순서대로 누릅니다(전자레인지 '30초 → 시작' 같은 순서).
- 버튼 로봇은 눌렀다는 사실까지입니다. 저희는 확인하지 못하면 같은 버튼을 다시 누르지 않게 만들었습니다(이중 조리 방지). 실제 버튼 누름은 리허설에서 통과했을 때만 보여 드립니다 — 누름 성공률은 아직 재지 않았습니다. 콘센트 전류로 가열 시작·끝을 확인하는 것은 다음 단계입니다.
- LG 가전과 오래된 버튼식 가전을 **같은 기록·습관·맡기기 흐름**으로 묶습니다. 열 나는 버튼식 가전은 매번 확인입니다.

**인정할 것:** 설치 간편함과 가격은 상용 버튼 로봇이 낫습니다. 저희 원가와 설치 시간은 아직 측정하지 않았습니다.
**하면 안 되는 말:** 가격·속도·정확도 비교 수치(실측·출처 없음).

### Q3. "LG ThinQ도 사용 패턴으로 추천합니다. 차이가 뭡니까?"

**답:** 스마트 가전끼리는 제조사 플랫폼이 이미 잘 합니다. 저희는 같은 공감지능 방향을 이렇게 설계했습니다.
- **먼저 묻고, 맡긴 것만:** 실제 기록에서 사흘 이상, 세 번 이상 되풀이한 것을, 사람이 있을 때 평소 시각 10분 전에 묻습니다. 자동은 사람이 확인 칸을 보고 맡긴 것만, 위험이 낮은 LG 가전 동작만 합니다.
- **근거를 보입니다:** 카드에 쓴 날과 '왜 지금' 신호를, '알게 된 것'에 본체가 아는 것을 그대로 보이고 숨길 수 있습니다.
- **기기 안에서:** 습관 판단·사람 감지·말 알아듣기는 집 안 본체에서 합니다.
- **그 바깥까지:** 통신이 없는 버튼식 가전도 누름 장치로 같은 흐름에 넣습니다. 열 나는 가전은 매번 확인입니다.

**발표 전 재확인:** LG 쪽 방식은 공개 자료 기준([외부 조사](발표/공감지능-외부조사-2026-10-26.md), [근거 자료 §2](발표/공감지능-근거-자료-2026-10-25.md)).
**하면 안 되는 말:** "ThinQ보다 똑똑하다", "AI가 학습한다".

### Q4. "CT로는 취소나 문 열림과 정상 종료를 구분 못 하는데, 그걸 '확인'이라 부릅니까?"

**답:** 구분하지 못합니다. 그래서 '조리 완료'라고 부르지 않고 **'가열 종료 감지(조리 완료가 아닐 수 있음)'**라고만 말합니다. '확인'이라는 말은 **누른 버튼에 가전이 반응했는지(가열 시작)**에만 씁니다.
지금 발표에서는 이 신호로 다른 가전을 자동으로 움직이지 않습니다 — 콘센트 전력은 열 나는 가전을 지켜보는 안전장치입니다. 예전 시연안의 '가열 종료 → 공기청정기' 규칙은 모의로만 만들어 두었고 꺼 둡니다.

**"오판하면 어떻게 됩니까?"로 이어지면**
- **잘못 잡으면 실패로 보는 두 경우:** 출력을 조절해 가열 중에 전력이 잠깐 내려가는 구간, 가열이 끝난 뒤 팬만 도는 구간. 측정에서 이것부터 봅니다.
- **구분 근거:** 종료음, 남은 시간 표시, 문 스위치를 후보로 두고 측정에서 찾습니다. 지금은 **없습니다.**

**인정할 것:** 판정 임계값과 오판 여부는 **모두 측정 전**이고, 콘센트 모듈 회로는 제작 중입니다.
**근거:** [실측 기록표](실측-기록표.md) §6, [시연 계획 §5](본선-시연-계획-v4.md).

### Q5. "전자레인지 빈 가열이나 오작동이 나면 누가 책임집니까?"

**답:** 그래서 **열 나는 가전은 맡길 수 없고, 매번 사람이 '네'를 눌러야 누릅니다.**
- 승인한 그 명령만 누릅니다(명령 지문이 다르면 거절).
- 눌렀는지 확인하지 못하면 다시 누르지 않고 사람에게 확인을 부탁합니다.
- 정지는 화면 어디서나 누를 수 있고, 모션 보드 응답과 멈춤 확인까지 단계로 보여 줍니다.
- 솔레노이드는 펌웨어가 한 번에 켜 둘 수 있는 시간과 냉각 시간을 제한합니다.
- 비상 차단이 준비되지 않았으면 시연에서 가열하지 않습니다.

**인정할 것:** 콘센트 차단 릴레이(비상정지 래치)는 펌웨어·호스트 경로까지 만들었고 회로는 제작 중입니다. 솔레노이드 차단 시간·발열은 측정 전입니다.
**근거:** [솔레노이드 안전 전달표](archive/솔레노이드-안전-전달표-2026-10-16.md), [정지 확인 단계 devlog](devlog/devlog_2026-10-13-stop-confirm.md).

### Q6. "버튼 위치가 1~2 mm 어긋나면 어떻게 됩니까? 성공률은요?"

**답:** 누름 성공률은 **아직 측정하지 않았습니다**. 측정 계획과 기록표는 준비돼 있습니다([실측 기록표](실측-기록표.md)).
- 확인하지 못하면 '확인 못 함'으로 끝내고 **다시 누르지 않습니다**. 잘못 눌러 두 번 동작하는 것보다 멈추는 것을 택했습니다.
- 버튼 좌표는 조작부 사진에서 가전마다 맞춥니다.
- 모터가 걸리면(스톨) 재시도 없이 멈추고 알립니다. 실물로 확인했습니다(10/12~14).

**하면 안 되는 말:** 정밀도·성공률 숫자(실측 전).

### Q7. "Touch Bridge는 지금도 진행 중인데, 같은 기계로 두 대회에 내는 것 아닙니까?"

**답:** 갠트리·모터·드라이버·엔코더는 같은 팀 HW 담당이 만든 **기계 1대를 두 프로젝트가 함께 씁니다.** 모션 보드(ESP32)는 프로젝트마다 따로입니다.
이 대회의 출품 대상은 사람을 알아채고 묻고 맡기는 흐름과, 그 위의 승인 결속·결과 확인·정지 계층·콘센트 모듈·키오스크이고, 경계 표로 처음부터 밝혔습니다.

**제출 전 할 일(미완):** 대회 규정의 재사용·중복 출품 조항을 확인하고, 애매하면 사무국에 문의해 답을 받아 둔다. 확인 전에는 "규정상 문제없다"고 단정하지 않는다.
**근거:** [재사용 경계](reuse-boundary.md).

### Q8. "폰 앱도 이전 작품 골격 아닙니까?"

**답:** 폰 앱 **골격**(프로젝트 구조·일부 화면 틀)은 이전 작품을 확장했습니다. 상태·승인·기록·루틴·LG 가전·말로 하기 화면과 키오스크 앱은 이번에 만들었습니다. "앱은 전부 새로 만들었다"고 말하지 않습니다.

### Q9. "갠트리를 조작부에 어떻게 붙입니까? 다른 전자레인지로 옮기면요?"

**답 방향:** 부착 방식(고정 위치·조작부만 덮는 범위), 문 여닫기와의 간섭, 다른 가전으로 옮길 때의 절차(조작부 사진을 찍고 버튼 자리를 맞춤)와 **걸린 시간**을 말한다.
**지금 상태:** 부착 구조는 HW 담당 작업 중이고, 설치 시간은 측정 전이다([실측 기록표](실측-기록표.md) §2). 측정 전에는 "몇 분이면 된다"고 말하지 않는다.

### Q10. "공감지능이라면서, 습관 제안이 실제 사용 기록으로 뜬 적이 있습니까?"

**답:** 10월 25일부터 매일 같은 시간대에 실제로 써서 기록을 모으고 있습니다. 가짜 기록으로 습관을 만들지 않습니다.
- 규칙: 같은 시간대에 서로 다른 날 사흘 이상, 세 번 이상 쓰면 습관 후보가 됩니다. 시각이 가까운 것끼리 묶고, 카드에 쓴 날과 '왜 지금' 신호를 그대로 보입니다. LG 앱·리모컨으로 공기청정기를 켜고 끈 것도 직접 사용으로 기록합니다(이것은 시험까지, 실물 확인 전).
- 결선 날 실제 카드가 떴으면 그 날짜와 쓴 날을 말한다. 안 떴으면 "아직 학습 중입니다"라고 말하고 '학습 중' 화면을 보인 뒤, 카드는 **연습**('제안 · 시연 데이터' 표시)으로 보인다.

**하면 안 되는 말:** 연습 카드를 실제 기록처럼 읽기, "며칠 만에 습관을 배웠습니다"(시연에서 재현하기).

### Q11. "고령자·저시력 당사자에게 시험해 봤습니까? 원가는요? 설치는 몇 분입니까?"

세 개가 한 질문으로 옵니다. **세 개 모두 아직 없습니다**(그날 사실대로). 없다고 말하고, 무엇을 어떻게 할지 말씀드립니다.

| 물음 | 지금 | 제출 전에 하는 것 |
|---|---|---|
| 당사자 시험 | **하지 않았습니다.** 고령자·시각장애인이 참여한 평가는 없습니다 | 팀 밖 **1~2명**에게 화면 과업(제안 이해·맡기기·거절·정지·끄기)을 도움 없이 해 보게 하고, 도움을 청한 지점과 고친 것을 적습니다. 이것은 **초기 사용성 점검**이고 당사자 평가도, 접근성 인증도 아닙니다 |
| 원가 | **측정 전.** 지급품과 구매품이 섞여 있어 숫자를 말할 수 없습니다 | 시연 1대 기준 **실제 구매가 BOM**(지급품 구분, 영수증 근거) |
| 설치 시간 | **측정 전** | 처음 붙이기·다시 붙이기·**처음 해 보는 사람** 각 1회를 재서 분으로 적습니다 |

**접근성에 대해 말할 수 있는 것:** 큰 글씨, 넓은 터치 영역, 한 행에 할 일 하나, 문구와 아이콘을 함께 쓰는 기준으로 만들었고, 큰 글꼴 2배에서도 승인 화면의 할 일이 첫 화면에 보이게 고쳤습니다.
**인정할 것:** 그것은 **기준을 참고해 만든 것**이고, 당사자가 써 본 결과가 아닙니다. 실제 화면 낭독(TalkBack)과 3 m 거리 가독성도 확인하지 않았습니다.
**하면 안 되는 말:** "고령자도 쉽게 쓸 수 있습니다", "접근성을 검증했습니다", "설치는 5분이면 됩니다", 원가 숫자.
**근거:** [제출 전 검증 과업](archive/제출전-검증-과업.md), [사용자 편의 기준](사용자편의-가이드-체크리스트.md).

## 짧은 질문

| 질문 | 답 |
|---|---|
| "집 밖에서는요?" | 지금은 집 안(같은 공유기)에서만 본체에 연결하고 본체를 인터넷에 열지 않습니다 — 집 안 기록·사람 감지 정보가 밖으로 나가지 않습니다. 밖에서 LG 가전은 LG 앱으로 그대로 조작됩니다. 원격 확장은 개인 VPN으로 낮은 위험 동작만 여는 계획이고 미구현입니다. |
| "음성은 왜 폰으로만요?" | 본체 마이크로 기기 안 음성 인식을 재 보니 정확한 모델은 한 문장 15~19초, 빠른 모델은 5개 중 2개만 맞았습니다(10/25). 그래서 음성 인식은 폰, 알아듣기는 본체 안 언어 모델로 나눴습니다. |
| "왜 라즈베리파이를 두 개 씁니까?" | ① **고장 격리** — 화면·판단(본체)과 모터·센서 실행(실행기)을 나눠, 한쪽이 멈춰도 다른 쪽이 정지하고 알린다(실행 중 생존 신호가 끊기면 실행기가 스스로 멈춘다). ② **배선 거리** — 실행기는 가전 앞, 본체는 사람 앞. ③ **확장** — 실행기만 다른 가전 앞에 하나 더 두는 구조. 양산이라면 실행기를 더 작은 보드로 바꿀 수 있다(검토 단계). |
| "안전 수리가 시연 빌드에 들어갔습니까?" | 들어갔습니다 — 정지 경계 보강과 같은 버튼 재누름 금지는 본체·실행기에 **같은 이미지로** 올렸습니다. 다만 **실제 모션 보드로 그 상황을 만들어 보는 시험은 아직**입니다. 시험 통과와 실물 확인을 섞어 말하지 않습니다. |
| "물리 비상정지는요?" | 소프트웨어 정지는 시험대에서 모션 보드 응답 중앙 약 11 ms, 엔코더 멈춤 확인 중앙 약 160 ms를 쟀습니다(n=10, 벨트 없는 시험대). 전원을 끊는 물리 스위치·콘센트 차단 회로는 아직 없습니다(그날 사실대로). |
| "누가 승인했는지 압니까?" | 모릅니다. 사람을 구분하지 않고 가구 단위로 기록만 말합니다(1-2). |
| "가전을 안 쓰면 이상 신호로 알립니까?" | 아닙니다. 안 쓴 것을 건강 이상으로 해석하지 않습니다 — 그 근거가 없습니다. |
