Seongwonp/Simplelay/docs/코드-구조.md

# 코드 구조

SimpleLay 코드가 **어느 보드에서 어떤 파일로 돌고**, 안전 약속이 **어느 함수에 있고 어느 시험이 지키는지**, 요청이 **어떤 순서로 지나가는지**를 한 장에 모은 문서다.
심사위원·팀원이 코드를 처음 열 때 읽는다.

## 현재 코드에서 먼저 볼 곳 (2026-10-28)

- 원본 모션 규약: `rpi/controller/touchbridge_motion.py`의 `TouchBridgeMotionClient`. `home()`의 현재 위치 원점 설정과 `move_to()`의 좌표 이동을 구분한다. 현장 빌드는 HW 담당 원본과 대조한다.
- 실행·결과: `rpi4/services/act_executor.py`의 `_execute_and_report()` → RPi5 결과 전달 → 폰·키오스크 표시. 누름 응답과 가전 반응·복귀 성공은 같은 근거가 아니다.
- 정지 대기·복귀: `rpi4/services/stop_hold.py`의 `StopHoldSession`. 모든 실행이 이 경로를 거친다고 가정하지 않는다.
- 본체에서 실행기 연결: `rpi/services/controller_factory.py`가 설정된 `SIMPLELAY_UART_PORT`를 사용한다. 가전 사진 매핑과 RPi4 설치 연결은 다른 단계다.
- 현재 결함과 실물 확인 순서는 [복귀·첫 연결 수리 계획](archive/결선전-복귀결함과-첫연결-수리계획-2026-10-28.md)을 따른다. 아래 모듈 지도·참조 횟수·줄 번호는 별도 날짜의 구조 기록이다.

## 0. 읽는 법

- **기준 커밋:** `55d2a06`(2026-10-15). 아래 `파일:줄`은 이 커밋 기준이다. 코드가 바뀌면 줄 번호는 어긋난다 — 함수 이름으로 다시 찾는다.
- **검증 수준:** 이 문서는 코드가 **어떻게 짜여 있는지**만 말한다. 무엇이 실물로 확인됐는지는 저장소 [README](../README.md)의 검증 수준 표가 기준이다.
  여기서 "실물"은 실제 보드·기기에서 본 것, "모의"는 가짜 장치·모의 클라우드·시험 코드로만 본 것이다.
- **폴더 이름의 역사:** `rpi/`는 보드 하나로 설계하던 시절의 이름이다. 지금 `rpi/`의 대부분은 **RPi5 허브**에서 돌지만,
  `rpi/controller`·`rpi/verifier`·`rpi/tools/fake_*`는 **RPi4 실행기도 import하는 공용 라이브러리**다 —
  `rpi4/` 운영 코드(시험 제외)가 `rpi.controller`를 25번, `rpi.verifier`를 29번 import한다(시험 포함 86·55번).
  그 밖에 `rpi.services.link_auth`·`demo_failure`·`act_client`, `rpi.tools.jog`·`fake_outlet`도 RPi4가 쓴다.
  모션 보드 어댑터(`rpi/controller/serial_motion.py`)와 센서 판정(`rpi/verifier/`)은 이름과 달리 **RPi4에서 돈다.**
- 환경 변수는 [환경 변수](환경변수.md), 시험 지도는 [rpi/tests/README](../rpi/tests/README.md), 배포는 [deploy/README](../deploy/README.md).

## 1. 모듈 지도

| 보드 | 폴더 | 진입점 | 핵심 파일 |
| --- | --- | --- | --- |
| **RPi5 허브** | [`rpi/`](../rpi/README.md) | `rpi/main.py`(FastAPI 앱 조립·기동·종료) | `rpi/api/deps.py`(싱글턴 조립) · 라우터 `rpi/api/router.py`·`thinq_router.py`·`routines_router.py`·`mapping_router.py`·`ambient_router.py`·`dev_router.py`·`pairing.py` · 서비스 `rpi/api/service.py`(`SimpleLayService`) + `rpi/api/service_commands.py`(`CommandExecutionMixin`) · 인증 `rpi/api/auth.py` · 정지 줄 `rpi/api/stop_lane.py` |
| **RPi4 실행기** | [`rpi4/`](../rpi4/README.md) | `rpi4/act_main.py`(`_run` — 실행기 조립) | `rpi4/services/act_executor.py`(프레임 처리) · `stop_hold.py`(가전 정지 버튼 위 대기) · `target_binding.py`(실행 대상 ↔ CT 채널) · `outlet_watch.py`(콘센트 모듈 감시) · `appliance_done_watch.py`(가열·세탁 끝 판정) |
| 공용(주로 RPi4) | `rpi/controller/` · `rpi/verifier/` · `rpi/tools/` | — | `closed_loop.py`(폐루프) · `serial_motion.py`(모션 보드 어댑터·`StopReport`) · `kinematics.py`(CoreXY) · `power_operation.py`(L3) · `verifier/outlet.py`(콘센트 링크) · `cycle_end.py`·`done_fusion.py`·`end_beep.py` · `tools/fake_mcu.py`·`fake_outlet.py` |
| 도메인(RPi5) | `rpi/commands/` · `rpi/intent/` · `rpi/routines/` · `rpi/scenarios/` · `rpi/services/thinq/` | — | 명령·승인 값 객체([commands](../rpi/commands/README.md)) · 해석·습관·제안(`intent/suggestions.py`·`patterns.py`·`rules.py`) · 루틴·자동 실행 허용 규칙([routines](../rpi/routines/README.md)) · 시나리오 정의·트리거 · ThinQ 실행기(`thinq/controller.py`) |
| 허브 서비스 | [`rpi/services/`](../rpi/services/README.md) | — | 링크 클라이언트 `act_client.py`·`act_client_controller.py`·`link_auth.py` · 정지 문장 `stop_confirm.py` · 제어권 `control_arbiter.py` · 공기질 `air_quality.py` · 날씨 `weather/` |
| 폰 | [`app/`](../app/README.md) | `app/lib/main.dart` | `lib/screens/`(홈·제안·상태·루틴·가전 추가·개발자 콘솔) · `lib/providers/`(`rpi_api_provider.dart`·`execution_status_provider.dart`) · `lib/services/rpi_api_service.dart` · `lib/models/command_result.dart` |
| 키오스크 | [`rpi5-touchscreen-app/`](../rpi5-touchscreen-app/README.md) | `lib/main.dart` | `lib/screens/kiosk_screen.dart`(화면 상태 전부) · `lib/widgets/kiosk/*_view.dart` · `lib/services/kiosk_api_service.dart`·`kiosk_event_stream.dart` · `lib/models/command_result.dart` |
| 공용 Dart | [`packages/`](../packages/README.md) | — | `routine_rehearsal/`(시뮬레이터 전용 루틴 리허설 화면) |
| ESP32 모션 | [`firmware-motion-corexy/`](../firmware-motion-corexy/README.md) | `src/main.cpp` | `src/host_protocol.cpp`(RPi4 줄 단위 JSON) — 제어 핵심은 Touch Bridge 원작([재사용 경계](reuse-boundary.md)) |
| ESP32 콘센트 | [`firmware-outlet/`](../firmware-outlet/README.md) | `src/main.cpp` | `src/ct.cpp`(CT 전력) · `outlet.cpp`(릴레이·비상정지 래치) · `protocol.cpp` |
| 배포 | [`deploy/`](../deploy/README.md) | `run_backend.sh` · `run_act.sh` | `build_on_device.sh` · `backend.Dockerfile` · `kiosk_watchdog.py` |
| **레거시(현행 아님)** | [`firmware/`](../firmware/README.md) · [`firmware-node/`](../firmware-node/README.md) · `rpi4/main.py` · [`rpi/touchscreen/`](../rpi/touchscreen/README.md) `index.html`·`kiosk.sh` · [`scripts/`](../scripts/README.md) systemd 파일 | — | 옛 BLE 브리지·가전별 노드 펌웨어, 옛 ESP32↔허브 UART 중계 진입점(`rpi4/main.py` — 이름과 달리 RPi5용, 현행 RPi4 진입점은 `act_main.py`), 옛 HTML 키오스크, 옛 systemd 배포. 시험이 참조해 남겨 둔다 |
| 미채택 참고 구현 | [`firmware-motion/`](../firmware-motion/README.md) | — | 펌웨어는 쓰지 않지만 **모션 규약 기준표 `protocol_table.json`이 여기 있다**(§4) |

## 2. 안전 계약이 사는 곳

| 계약 | 코드 | 시험 |
| --- | --- | --- |
| **승인 결속** — 사용자가 본 명령만 실행, 승인 뒤 다시 해석하지 않음 | `ApprovedCommand.matches`(`rpi/commands/models.py:340`) → `Command.same_content` · 지문 `fingerprint_of`(`rpi/commands/args.py:136`) · 명령 경로 대조 `CommandExecutionMixin._prepare`(`rpi/api/service_commands.py:244`)·`submit_approved`(`:305`) · 목적 경로 대조 `_check_approved`(`rpi/api/service.py:122`) · 1회용 승인 게이트 `ProactiveSuggestionService.approve`(`rpi/intent/suggestions.py:762`)·`approve_submit`(`:790`) · 루틴 승인 `Routine.steps_fingerprint`(`rpi/routines/model.py:330`) | `test_command_models.py` · `test_command_args.py` · `test_suggestion_lifecycle.py` · `test_suggestion_race.py` · `test_execution_target_gate.py` · `test_routines.py` |
| **확인 수준** — 받음과 확인을 나눔, 확인한 만큼만 말함 | 물리 `receipt_of`(`rpi/commands/physical.py:98`)·`confirmation_of`(`:109`) · ThinQ `ThinqController._execute`(`rpi/services/thinq/controller.py:308`) — 이미 목표값이면 보내지 않음(`:390`), 상태 재조회로 `state_confirmed` | `test_command_physical.py` · `test_thinq_u1.py` · `test_thinq_already_at_target.py` |
| **정지 3단계** — 보냄(`sent`) → 모션 보드 응답(`mcu_ack`) → 멈춤 확인(`verified`) | `StopReport`(`rpi/controller/serial_motion.py:683`, 단계 상수 `:665-670`) · `SerialMotionClient.request_stop`(`:1002`)·`confirm_stop`(`:1076`) · RPi5 읽기 `rpi/services/stop_confirm.py`(`read_stop_level :19`·`stop_level_confirmed :31`·`stop_sentence :35`) · 화면 문구 `app/lib/models/command_result.dart`·`rpi5-touchscreen-app/lib/models/command_result.dart` | `test_stop_confirm.py` · `test_stop_report_rpi5.py` · `rpi4/test_act_main_motion.py` · 두 앱의 `stop_level_test.dart` |
| **정지 전용 줄** — 공유 스레드 풀·DB 대기와 분리 | `run_on_stop_lane`(`rpi/api/stop_lane.py:37`)·`resolve_without_shared_pool`(`:44`) · `/stop` 라우터(`rpi/api/router.py:953`) | `test_eval_recheck_stop.py` · `test_eval_recheck2_stop.py` · `test_startup_init_stop.py` · `test_stop_endpoint.py` |
| **비상정지 래치** — 콘센트 모듈 버튼 → 모든 실행 거절, 사람이 확인해야 풀림 | RPi4 `ActExecutor.handle_outlet_estop`(`rpi4/services/act_executor.py:841`) · RPi5 `service.estop_status`·`_require_ready` · `/stop/ack`(`rpi/api/router.py:925`) | `test_estop_latch_api.py` · `test_thinq_estop_direct.py` · `rpi4/test_eval_fixes_outlet.py` · `rpi4/test_outlet_l3.py` |
| **제어권** — 일반 실행과 개발자 세션이 같은 기계를 동시에 잡지 않음 | `ControlArbiter`(`rpi/services/control_arbiter.py:54`) · 반환은 `DeveloperSessionManager._maybe_release_locked`(`rpi/services/developer_session.py:914`) 한 곳 | `test_control_arbiter.py` · `test_developer_session.py` |
| **링크 인증** — 짝 키 + 프레임마다 HMAC + 재전송 막기 | `rpi/services/link_auth.py`(`LinkSession.seal :131`·`accept :137`, RPi4 `ServerAuth.open :176`) · 키 없으면 기동 거절 | `rpi4/test_link_auth.py` · `rpi4/test_link_key_required.py` |
| **자동 실행 경계** — 허용한 낮은 위험 ThinQ 동작만, 같은 사건 한 번 | `rpi/routines/auto_rules.py`(`LOW_RISK_ACTIONS`·`AutoRuleEngine.on_appliance_done :666`·`_try_run :699`·`_submit :770`) | `test_auto_rules.py` · `test_auto_rule_boundary.py` · `test_auto_rule_e2e.py` · `test_auto_rule_eval4.py` |
| **준비 판정** — 등록됐다고 조작할 수 있는 것이 아님 | `readiness_view`(`rpi/api/readiness_view.py:14`) · `rpi/services/readiness.py` | `test_appliance_readiness.py` · `test_readiness_list_parity.py` |
| **API 인증** — 모든 경로가 키 검사, 의도적 공개만 예외 | `require_api_key`(`rpi/api/auth.py`) · 라우터 붙이기 `rpi/main.py:208` 이하 | `test_auth.py` · `test_loopback_origin.py` · `test_route_auth_coverage.py` |
| **비공개 자료 가드** — 플랫폼 고유 명칭·문서·비밀 파일 공개 차단 | — | `test_repo_guard.py` |

### '확인됨'의 수준이 두 곳에서 다르다 — 의도한 차이

| 어디 | '확인'으로 치는 단계 | 근거 |
| --- | --- | --- |
| 서버 `stop_level_confirmed`(`rpi/services/stop_confirm.py:31`) → `/stop` 응답 `stop_confirmed`(`rpi/api/router.py:1000`) | `mcu_ack` 이상 | 안전 계약 ①의 '확인' = **제어기(모션 보드) 응답**. 가전이 멈췄다는 뜻이 아니다 |
| 폰 `stopLevelConfirmed`(`app/lib/models/command_result.dart:204`) — 개발자 콘솔(`developer_console_screen.dart:394-405`)이 문제 표시에 씀 | `mcu_ack` 이상 | 개발자가 링크·보드 응답을 보는 화면이라 서버 정의를 따른다. 일반 화면은 단계별 문장만 쓴다 |
| 키오스크 `stopLevelConfirmed`(`rpi5-touchscreen-app/lib/models/command_result.dart:164`) → 완료 화면 ✓(`done_view.dart:210`) | **`verified`만** | [키오스크 문구 개선 계획](archive/키오스크-문구-개선-계획-2026-10-15.md) §2-1 — 매일 쓰는 사람에게 ✓와 "누름 장치가 멈췄어요"는 **엔코더로 멈춤을 확인했을 때만** 보인다. `mcu_ack`는 "정지 신호를 받았어요 — 멈췄는지는 확인 못 했어요"와 ? 아이콘 |

서버가 `stop_confirmed=true`를 줘도 키오스크는 `stop_level`을 다시 읽어 ✓를 정한다. 셋을 하나로 맞추지 않는 것은 **보는 사람이 다르기 때문**이다(개발자: 보드가 받았나 / 당사자: 멈췄나).
단, `verified`도 "값이 안 변함"으로 판정하므로 엔코더가 죽어 있으면 거짓 확인이 될 수 있다(G11, 아래).

### 열린 빈칸

[안전 계약 적용 보고](안전계약-적용-보고-2026-10-15.md) §2가 기준이다 — G1~G11과 키오스크 두 번 누름 **R1**.
**수리(시험 조건만, 보드 미배포):** **G1** 승인·루틴 경로 링크 끊김 → '눌렸는지 모름' 기록, **G2** 접수 뒤·보내기 전 정지, **G11** 죽은 엔코더의 '멈춤 확인'
([10/15 devlog](devlog/devlog_2026-10-15-safety-g2-g1-g11.md)), **G3** 루틴 구간 사이 정지(`/stop` 맨 앞 루틴 정지 표시·기다림 뒤 재확인·다음 구간 실행 시작 게이트),
**G7** 텍스트·홈 음성 "멈춰"가 '취소' 버튼 누름 → 해석 맨 앞 정지어 판정(`rpi/intent/stop_words.py`)으로 `/stop`의 뜻, 폰 홈 음성도 정지어면 정지를 보냄
([10/16 devlog](devlog/devlog_2026-10-16-safety-g3-g7.md)), **G5** 조용한 Wi-Fi 끊김 → 실행 중 RPi5→RPi4 생존 신호(`rpi/services/link_heartbeat.py`, 주기 1 s·제한 3 s 추측값),
끊기면 RPi4가 받은 정지와 같은 길로 스스로 멈추고(`ActExecutor.check_link_watchdog`) RPi5는 '눌렸는지 모름'으로 남김([G5 devlog](devlog/devlog_2026-10-16-safety-g5.md) — RPi4·RPi5 같은 커밋 배포 필수).
**10/16 추가 수리(시험 조건만·보드 미배포):** G4 실제 쓰기 잠금 안의 정지 재확인, G9 hold 해제 대기를 수신 루프 밖 실행 task로 옮김. G10은 정지 대상별 의미를 문서화하고 기존 동작 시험만 추가했다([기록](devlog/devlog_2026-10-16-safety-g4-g9-g10.md)). RPi4 실행 코드 변경이므로 RPi5·RPi4 같은 커밋 배포 필요.
**R1 자동 재누름 수리(10/16, 시험 조건만·보드 미배포):** 버튼 정의 `behavior` → 서비스 실행 스냅샷 → `execute.button_behaviors` → RPi4 공유 폐루프. toggle·unknown의 L1/L2 재누름을 막고 미확인으로 기록한다. idempotent만 기존 재시도를 유지한다([기록](devlog/devlog_2026-10-16-r1-docs.md), [규약](protocol.md)).
**남음:** G6·G8, R1 사람의 전체 재실행·버튼 분류 실측. G5 socat 재접속 지연·실물 PS-1도 별도 확인이 필요하다.
이 문서의 흐름 설명 일부는 수리 전 코드 기준이다.

## 3. 요청 흐름

`→`는 호출 순서, 괄호는 `파일:줄`. RPi5↔RPi4 사이는 줄 단위 JSON 프레임(서명됨, [protocol.md](protocol.md)).

### 3-1. 승인 → 실행 → RPi4 → 모션 보드

```text
[폰·키오스크] POST /suggestions/{id}/approve
 → router.approve_suggestion                        (rpi/api/router.py:1063)   스레드로 넘기고 job_id 즉시 반환
 → ProactiveSuggestionService.approve_submit        (rpi/intent/suggestions.py:790)
     _claim_for_approval: 대기 → 승인 1회용 게이트(두 번째 승인은 짐)
 → _approve_commands                                (rpi/intent/suggestions.py:575)   ApprovedCommand(보여 준 문장·만료) 만듦
 → SimpleLayService.submit_approved                 (rpi/api/service_commands.py:305)
 → _prepare                                         (rpi/api/service_commands.py:238)
     만료 확인, approved.matches(command) (:244) — 지문이 다르면 ApprovalMismatchError, 실행 안 함
 → _start_plan → _begin_run                         (service_commands.py:347 → rpi/api/service.py:662)
     실행 가능 확인·제어권 획득·job_id 기록 (service.py:695), 실행 스레드 시작
 → _run_plan → _run_physical_step → _run_buttons    (service_commands.py:379 → :497 → service.py:839)
 → ActClientController.execute                      (rpi/services/act_client_controller.py:85)
 → ActClient.execute → _send                        (rpi/services/act_client.py:465 → :969)   LinkSession.seal로 서명
 ══ Wi-Fi(TCP 7000 → 가상 시리얼) ══
 → ActExecutor.run_once → _authentic → _dispatch    (rpi4/services/act_executor.py:380 → :1227 → :466)
 → ActExecutor._on_execute                          (act_executor.py:499)
     바쁨·비상정지 래치·콘센트 끊김·모션 미준비면 거절, TargetBinder.bind (:524)로 CT 채널 결속
 → _execute_and_report → ClosedLoopController.execute   (act_executor.py:652 → rpi/controller/closed_loop.py:199)
 → SerialMotionClient.press                         (rpi/controller/serial_motion.py:957)
     정지·원점·범위 확인 → move → press, 요청 id 짝이 맞는 ok만 성공
 ══ USB 시리얼 ══ ESP32 모션(firmware-motion-corexy/src/host_protocol.cpp)
 ← result 프레임(서명) → ActClient._handle_line   (act_client.py:839, 결과 :909)   sequence_id 짝 확인
 ← command_result_from_execution                   (rpi/commands/physical.py:235)  receipt·confirmation
 ← _end_run: last_job_id = 이번 job                 (rpi/api/service.py:713)  → GET /status 로 클라이언트가 대조
```

### 3-2. 정지 (그리고 비상정지 래치)

```text
POST /stop → router.emergency_stop                  (rpi/api/router.py:953)
     자동 실행 세대 올림 → 정지 전용 줄에서 동시에: 서비스 정지 · 개발자 세션 정지 · 자동 실행 규칙 끄기 → 루틴 취소
 → SimpleLayService.emergency_stop_report           (rpi/api/service.py:1174)   정지 기록, request_stop, ThinQ 취소
 → ActClient.abort_with_report                      (rpi/services/act_client.py:585)   abort{stop_id}, 보고 1.5초 대기
 ══ RPi4 ══
 → ActExecutor._on_abort → _abort                   (rpi4/services/act_executor.py:1035 → :1049)   실행·개발자·가전 동작 중 대기 구분
 → ClosedLoopController.request_stop → SerialMotionClient.request_stop
                                                    (closed_loop.py:175 → serial_motion.py:1002)   stop 줄을 잠금 없이 바로 씀
 → SerialMotionClient.confirm_stop                  (serial_motion.py:1076)   ok 응답 = mcu_ack, 엔코더 두 번 같음 = verified
 ← stop_report{stop_id, stop_level, ack_ms}        → act_client.py:892 → stop_confirm.read_stop_level (:19)
 ← StopResponse.stop_confirmed = stop_level_confirmed (router.py:1000), /status의 last_stop_level

비상정지 래치: 콘센트 모듈 버튼(릴레이를 모듈이 직접 끊음)
 → RPi4 ActExecutor.handle_outlet_estop             (rpi4/services/act_executor.py:841)   래치·실행 중이면 정지·estop_state 프레임
 → RPi5 ActClient._note_estop → service.estop_status → 물리·ThinQ·자동 실행 모두 거절
 → POST /stop/ack → router.acknowledge_estop        (rpi/api/router.py:925) → ActClient.estop_ack (act_client.py:645)
 → RPi4 _on_estop_ack (act_executor.py:953)          버튼이 눌린 채면 풀지 않음, 그 사이 다시 걸리면 estop_retriggered
```

### 3-3. ThinQ 명령

```text
POST /thinq/command → thinq_router.thinq_command    (rpi/api/thinq_router.py:197)   Command.thinq 만들고 job_id 반환
 → SimpleLayService.submit_command → _prepare       (rpi/api/service_commands.py:291 → :238)
     ThinqController.readiness (rpi/services/thinq/controller.py:163), 비상정지 래치면 거절
 → _run_thinq_step                                   (service_commands.py:434)   실행 직전 래치 재확인(_with_estop_guard :422)
 → ThinqController.execute_command → _execute        (controller.py:290 → :308)
     프로필(쓸 수 있는 속성·값) → 상태 미리 읽기 → 이미 목표값이면 보내지 않음(:390)
     → client.post_control (:406) → 상태 재조회로 목표값 확인 → state_confirmed / 시간 안에 못 보면 unconfirmed
 → 클라이언트: sdk_client.py(공식 SDK) · mock_client.py(모의)
```

### 3-4. 자동 실행 규칙 (가열 종료 → 공기청정기)

```text
[RPi4] PowerCycleFeeder → ApplianceDoneWatch.feed_power   (rpi4/services/appliance_done_watch.py:200 → :125)
 → appliance_done 프레임(서명)                       (rpi4/services/act_executor.py:433)
 ══ RPi5 ══
 → ActClient._handle_line (appliance_done)           (rpi/services/act_client.py:947)
 → deps.receive_appliance_done                       (rpi/api/deps.py:240)   사건 시계로 허브 시각 부여·기록·루틴 엔진
 → AutoRuleEngine.on_appliance_done                  (rpi/routines/auto_rules.py:666)   같은 사건 한 번
 → _try_run                                          (auto_rules.py:699)   조용한 시간·신선도·허용 시점·지문·비상정지·실물/모의 확인
 → _submit                                           (auto_rules.py:770)   ApprovedCommand("auto-rule:…") + 전송 직전 재판정
 → SimpleLayService.submit_approved                  (rpi/api/service_commands.py:305) → 3-3의 ThinQ 경로
 같은 사건의 제안 카드: ScenarioEngine.on_appliance_done (rpi/scenarios/engine.py:76) → create_scenario_suggestion (rpi/intent/suggestions.py:480)
```

### 3-5. 제안 (습관·공기질)

```text
습관: rpi/main.py lifespan → _suggestion_refresh_loop (rpi/main.py:34, 60초마다, 이벤트 루프 밖 스레드)
 → ProactiveSuggestionService.create_suggestions     (rpi/intent/suggestions.py:271)
     PatternDetector.candidates (rpi/intent/patterns.py:34) → 조용한 시간·존재·숨김·이미 함·중복 확인 → 제안 생성(실행 없음)

공기질(10/15): start_air_quality_poller             (rpi/api/air_quality_wiring.py:114)   ThinQ 꺼져 있으면 띄우지 않음
 → AirQualityPoller → AirQualityMonitor.check_once   (rpi/services/air_quality.py:174)   실행 중·호출 한도면 건너뜀
 → ScenarioEngine.on_air_quality                     (rpi/scenarios/engine.py:106) → create_scenario_suggestion

GET /suggestions → svc.pending + 자동 실행 허용 제안  → 사용자가 승인하면 3-1(물리) 또는 3-3(ThinQ)
```

## 4. 보드 사이 규약

- **RPi5 ↔ RPi4:** [protocol.md](protocol.md)의 'UART 프로토콜 (RPi5 ↔ RPi4)' 절 — 링크 인증(10/12), RPi5 → RPi4(execute·abort·estop_ack·dev_motion 등), RPi4 → RPi5(result·stop_report·estop_state·appliance_done 등)와 '추가 프레임' 절.
  선은 Wi-Fi 위 TCP 7000이고 RPi4 컨테이너 안에서 가상 시리얼로 바뀐다([deploy/README](../deploy/README.md)).
- **RPi4 ↔ 모션 보드:** protocol.md '모션 MCU 링크' 절. **기준표는 미채택 폴더에 있는 [`firmware-motion/protocol_table.json`](../firmware-motion/protocol_table.json)이다** —
  어댑터·가짜 모션 보드·현행 펌웨어가 이 표를 따르는지 `test_motion_protocol_table.py`가 본다. 폴더를 옮기거나 지울 때 이 표를 먼저 옮긴다.
- **RPi4 ↔ 콘센트 모듈:** protocol.md '콘센트 모듈 링크' 절(컴파일·가짜 출력 수준).
- **가짜 장치:** `rpi/tools/fake_mcu.py`(모션 보드)·`rpi/tools/fake_outlet.py`(콘센트 모듈)·`rpi/tools/fake_thinq_cloud.py` — 하드웨어 없이 같은 규약으로 시험한다.
- **HTTP:** 폰·키오스크 ↔ RPi5. `/status`의 마지막 칸 필드·ThinQ 결과 네 경우는 protocol.md 뒤쪽 절.

## 5. 설정

모든 실기기 의존은 `SIMPLELAY_*` 환경 변수로 켜고, 기본은 모의다(개발 PC에서 전 기능이 돈다). 목록·기본·읽는 곳은 [환경 변수](환경변수.md).

## 6. 시험

영역별 시험 파일, 이력 이름 시험의 뜻, 부하에 민감한 시험은 [rpi/tests/README](../rpi/tests/README.md). 10/15 기준(골든 제외) 백엔드+RPi4 3,189 · 폰 886 · 키오스크 400.

## 7. 알려진 구조 부채와 결선 뒤 계획

| 부채 | 지금 | 결선 뒤 계획 |
| --- | --- | --- |
| 큰 라우터 | `rpi/api/router.py` 약 1,850줄(실행·상태·정지·제안·가전·설정·데모) | 영역별 라우터로 나눔(정지·상태는 따로) |
| 큰 모션 어댑터 | `rpi/controller/serial_motion.py` 약 1,540줄(전송·설정·정지 확인·누름) | 전송·설정·정지 확인 모듈로 나눔 |
| 서비스 mixin | `SimpleLayService(CommandExecutionMixin, …)` — 상태를 공유하는 두 파일 | mixin → 합성(명령 실행기를 별도 객체로) |
| 실행기 조립 | `rpi4/act_main.py` 약 1,120줄에 조립과 진입점이 섞임 | 조립(`build_*`)을 별도 모듈로 |
| 키오스크 화면 상태 | `kiosk_screen.dart` 약 1,650줄 | 상태·서버 대조를 `KioskController`로 분리 |
| Dart 모델 중복 | 폰·키오스크가 같은 서버 응답 모델(`command_result.dart` 등)을 따로 가짐 | 공용 모델 패키지(`packages/`) |
| 레거시 | `firmware/`·`firmware-node/`·`rpi4/main.py`·`rpi/touchscreen/index.html`·`scripts/` systemd 파일이 현행 폴더 옆에 있음 | 보관 폴더로 이동(시험 참조 정리 뒤, `protocol_table.json`은 먼저 옮김) |

**10/28 제출 전에는 하지 않는다.** 이유:

1. **시험이 조용히 약해진다.** 시험 다수가 모듈 속성을 직접 바꿔 끼운다(`monkeypatch.setattr(모듈, …)` 약 180곳). 코드를 다른 모듈로 옮기면 바꿔 끼운 자리가 실제 코드에서 쓰이지 않게 되는데도
   시험은 실패하지 않고 통과할 수 있다 — 안전 시험이 아무것도 지키지 않는 상태가 된다. 옮길 때마다 수정 전 실패 확인을 다시 해야 한다.
2. **열린 수리와 겹친다.** G1·G2·G11 수리가 `service.py`·`service_commands.py`·`act_client*`·`act_executor.py`·`serial_motion.py`를 고치는 중이다. 같은 파일을 동시에 나누면 충돌하고 수리 검증이 흐려진다.
3. **보드 배포와 맞물린다.** RPi5·RPi4는 같은 커밋으로 배포해야 한다. 구조 변경은 보드 날 검증을 한 번 더 요구한다.

그 대신 지금은 이 문서·패키지 README·[환경 변수](환경변수.md)·[시험 지도](../rpi/tests/README.md)로 구조를 드러내고, 새 경로의 인증 누락은 `test_route_auth_coverage.py`로 막는다.
