Seongwonp/Simplelay/docs/UI-남은-손볼점-2026-10-18.md

# UI 후속 점검 항목 (2026-10-18)

교수 의견을 참고한 내부 반복 검토 뒤에도 남은 항목이다. AI 도구가 제시한 90점대 참고 점수는 교수의 직접 채점이나 사용자 검증 결과가 아니다. 위험·실물 미확인·구조 부채를 결선(11/6) 전에 정리하려고 적었다.
평가 경과는 [10/18 devlog](devlog/devlog_2026-10-18-professor-ui.md)에 있다.

## 1. 결선 전에 꼭 할 것 (안전·정직)

| 무엇 | 왜 | 어떻게 확인 |
|---|---|---|
| 실제 버튼 누름·캐리지 이동을 실물로 | 화면이 아무리 좋아도 시연 핵심 장면(버튼 누름 장치(CoreXY 갠트리 + 솔레노이드)가 누름)이 아직 실물 성공 기록이 없다 | ESP32 모션 보드 복귀 → 솔레노이드·레일 장착 → 루틴 한 장면 실물 `verified` |
| '멈췄는지 몰라요' 화면의 다음 행동 | 15차에서 이 상태에 '누름 장치로 골라 누르기'가 권해지던 것을 찾았다(안전 계약과 어긋남). 비슷한 '모름' 상태가 다른 화면에도 있는지 한 번에 훑어야 한다 | 정지 미확인·눌렸는지 모름·LG 가전 확인 못 함 세 상태에서 '다시 누르게 하는 단추'가 없는지 시험으로 고정 |
| 같은 버튼 두 번 누름(R1) | 토글 버튼(켜기/끄기가 한 버튼)은 재시도하면 도로 꺼진다. 화면 안내만 더했고 정책은 그대로다 | 토글 버튼만 자동 재누름 금지안 결정 → 구현 → 실물 |
| 평가 전 끌 것 | 개발자 실물 조작 env, API 문서 페이지(`/docs`·`/openapi.json`·`/redoc`)가 키 없이 열린다 | CLAUDE.md '평가 전에 끌 것' 목록대로, 끈 뒤 키 없이 열리지 않는지 확인 |
| 시각 미동기 때 시각 루틴 보류 | RPi5는 RTC 배터리가 없어 인터넷 없이 켜면 시각이 멈춘다 — 22:00/07:00 자동 루틴이 엉뚱한 때 돌 수 있다 | 시각 동기 여부를 `/health/detail`에 싣고, 미확인이면 시각 루틴 보류 + 키오스크 표시 |

## 2. 실물로 아직 안 본 것 (시험·골든 조건만)

- 키오스크 새 화면들의 실패널 표시: 조용한 시간 어둡게(막 짙기 0.5는 추측), 고대비, 지난 일 한 줄, 복구 순서 안내, LG 가전 보내는 중·결과(폰에서 시작해 이어받은 실행은 실패널에서 봄, 키오스크에서 직접 시작한 실행은 못 봄).
- 1~2 m 거리 가독: 회색 굵은 '오늘은 건너뛰기', 예보 칸 둘째 줄 강수확률, 큰 글씨에서 시계 하한(44).
- 패널 마우스 화살표: 실행 옵션에 커서 숨김을 넣었지만 패널에 여전히 보인다 — 원격 시험 흔적이 화면 관리 쪽에 남은 것으로 보임. 재부팅 뒤 사라지는지 확인.
- 실폰: 에뮬레이터로만 봤다. 실제 폰 글꼴·노치·제스처 영역에서 홈·루틴 줄바꿈 확인.

## 3. 구조 부채 (평가가 다시 지적할 가능성)

- **결과 화면 틀:** 띠 → 큰 제목 → 부제 → 번호 안내가 같은 뜻을 되풀이하기 쉬운 틀이다. 15차까지 줄여 왔지만, 결과 종류(성공·확인 못 함·실패·멈춤·연습)마다 '한 번만 말한다'는 규칙을 표로 고정하는 편이 낫다.
- **자동 규칙과 루틴 연결:** 폰이 시각 규칙과 루틴을 이름·시각으로 잇는다. 서버 규칙 목록에 `routine_id`를 실으면 확실해진다(서버 수정).
- **기록의 출처:** '지금 하기'·'정해진 시각'·'폰에서'·'본체 화면에서'를 가를 필드가 기록에 없다. 지금은 '바로 실행'·'화면에서 골라 누름' 같은 중립어로 버틴다(서버에 `origin` 필드).
- **지난 일 한 줄은 키오스크 안 기억:** 키오스크를 재시작하면 사라진다. 서버에 '확인함' 상태를 두면 기기 사이에도 맞출 수 있다.
- **두 기기 낱말 표:** 본체·누름 장치·루틴·자동 루틴·확인 필요·버튼(단추 아님) 등 쓰는 말을 한 표로 두고 두 앱의 시험이 그 표를 읽게 하면 다음 개편 때 어긋나지 않는다.

## 4. 운영

- 재부팅 뒤 자동 기동: 컨테이너 재시작 정책을 `always`로 바꿨다(10/18). RPi4는 시스템 영역이 읽기 전용이라 도커 자동 시작을 켤 수 없다 — 재부팅 뒤 `systemctl start docker` 한 줄이 필요하다(런북).
- 보드 저장 공간: 빌드마다 이름 없는 이미지가 쌓여 RPi5가 100% 찼다(10/18). 배포 스크립트 끝에 이름 없는 이미지 정리를 넣는 것을 검토.
- 키오스크 설치 도구는 터미널(TTY)이 없으면 실패하고 옛 앱이 남는다 — 설치 응답의 성공 문구를 확인하는 절차를 런북에.

## 5. 하우징

본선(11/6)에서만 보인다(사용자 결정). 고칠 점은 [하우징 검토](하우징-검토-2026-10-18.md).

## 6. 별도 세션의 UI 검토 (10/18 16:00, 이전 점수·문서 없이 캡처만)

**내부 참고 점수: 폰 81 · 키오스크 87 · 종합 84.** AI 도구의 같은 세션 반복 검토(17차 92.25)보다 낮았다. 같은 기준으로 측정한 개선율이나 사용자 선호 차이가 아니며, 반복 검토가 특정 판단에 맞춰졌을 가능성을 보여 주는 참고 기록이다. 실제 사용성 판단은 사용자 과업으로 확인해야 한다.

- **좋은 점(평가자):** 확인 수준대로 나뉜 정직한 결과 문구, 실행 화면(누를 순서·버튼판·큰 정지), 다음 행동이 붙은 사람 말.
- **처음 보는 사람이 막히는 곳(효과 큰 순):**
  1. '오늘은 건너뛰기'가 단추로 안 보이고 상태 문구로 읽힌다 — **사용자 결정(작은 회색 굵은 글자)과 부딪힌다.** 모양은 두고, 실사용자 시험에서 같은 오해가 나오면 다시 정한다.
  2. 할 일이 끝났거나 팔이 제자리인데 큰 빨간 '정지'가 남아 무엇을 멈추는지 모른다(연습 마침·정지 미확인·제자리). 안전 규칙(정지 자리·이름 불변)과 같이 봐야 한다 — 대상 표기('누름 장치 멈추기') 정도가 후보.
  3. 큰 글씨에서 이유·행동 줄이 빠진다(제안 이유, 공기 할 일, 연습 대기 버튼판).
  4. 큰 글씨인데 상단 문제 칩 글자가 작다.
  5. '연결 확인 필요 1'의 숫자가 계기판 말 같다 — '해결 방법 보기'만 남기는 안.
  6. 지난 일 줄에 날짜가 없고 '확인' 단추 뜻이 애매하다 → '봤어요'/'닫기'.
  7. 알림 수가 홈(그 밖에 4건)·설정(7건)에서 다르게 보인다.
  8. 성공 제목 '가전이 켜졌어요'가 막연하다 → 가전 이름·실제 상태.
  9. 자동 규칙 탭이 비어 보이고 규칙이 어디서 생기는지 모른다 → 안내 한 줄, '바람 강으로'.
  10. '다시 눌러도 눌렸는지 몰라요' 어색, 본체가 끊겼는데 보호자 알림 '새 알림이 없어요'(모르는 상태를 없다고 함 — 정직성).
- **AI 느낌:** 문구보다 부품·배치 — 폰은 기본 부품(분할 탭·스위치·알약 단추) 그대로, 키오스크 처음 화면 카드 4장 + 날씨 4칸은 흔한 대시보드 틀, 버튼 누름 장치로 누르는 가전과 LG 가전이 겉모습으로 거의 구별 안 됨, 결과·대기 화면 가운데가 빔.
