Seongwonp/Simplelay/docs/UI-독립평가-2026-10-23.md

# 폰·키오스크 UI 검토 (2026-10-23)

검토 대상: `62d2feb2` 위의 [촬영 전 UI 수정](devlog/devlog_2026-10-23-ui-filming.md) 작업 트리. AI 도구의 별도 세션으로 폰과 키오스크를 읽기 전용 검토했다. 폰 골든 12장·키오스크 골든 15장을 열고 코드를 추적했다. 새 사용자 시험·실폰 조작·실패널·TalkBack 낭독·실제 하드웨어 시험을 한 것은 아니다. 아래 점수는 내부 검토의 주관적 참고값이며 공식 심사·사용성 측정값이 아니다.

사용자가 전달한 실제 사람의 ‘폰 앱이 너무 복잡하다’는 피드백을 검토의 출발점으로 삼았다. 그 피드백의 표본·과업·측정 시간은 확인하지 않았으며 정량 연구 결과로 쓰지 않는다.

## 검토 결과와 참고 점수

- **폰 73/100:** 미감은 일관되지만 처음 사용자가 실행할 곳·자동 실행을 끌 곳을 찾는 비용이 크다. 말투 개선만으로 복잡도가 해결된 것은 아니다.
- **키오스크 79/100:** 실행·결과·정지의 위계는 분명하다. 연습과 실제 문맥을 공유하는 안내, 관찰 질문의 중복이 남아 있다.
- ‘AI스럽다’는 인상은 디자인 판단이다. 새 장식보다 정보 우선순위·같은 상태의 설명 반복을 줄이는 편이 우선이다.

## 폰: 발견 사항

줄 번호는 평가 작업 트리 기준이다. 이미지와 코드에서 확인한 사실과 사용자 혼란의 추정을 구분했다.

| 심각도 | 파일:줄 / 골든 | 문제와 근거 | 최소 수정 방향 |
|---|---|---|---|
| MEDIUM | `app/lib/screens/home_screen.dart:167` / `home_full_light.png`, `home_full_large.png` | 환경·다음 예약·설정 안내·가전을 지나야 내 루틴이 나온다. 200%에서 첫 화면에 실행 루틴이 보이지 않는 것은 이미지 관찰. 원하는 실행보다 관리 정보가 우선한다는 것은 UX 판단. | 제안 우선은 유지. 제안이 없으면 루틴을 가전 목록 앞으로 두고 예약 강조를 낮추는 안 검토. 연결·실패 경고 우선순위 유지. |
| MEDIUM | `app/lib/screens/routines_screen.dart:121`, `:675`, `:1102` / `routines_light.png`, `routines_rules_light.png` | 내 루틴의 자동 실행과 별도 자동으로 하기의 차이를 설명문으로 배워야 한다. 범례·배지·스위치·켜짐·실행 단추가 누적된다. 실제 이해 실패를 측정하지는 않았다. | 4탭·데이터 구조 유지. 중복 범례부터 줄이기. 내부 구획 이름을 시각/직접 실행과 상황 조건으로 구분하는 안은 사용자 결정 후 적용. |
| MEDIUM | `app/lib/screens/appliance_detail_screen.dart:130` / `lt_detail_photo.png`, `detail_photo_dark.png` | 기본 크기에서도 ‘아직 루틴이 없/어요’가 갈라진다. 오른쪽 저장 단추가 제목 폭을 줄이는 현상은 이미지에서 확인. | 해당 카드의 제목 위·저장 단추 아래 배치. 큰 글씨일 때만 세로로 바꾸는 조건 재검토. |
| MEDIUM | `app/lib/screens/suggestion_screen.dart:403`, `:444`, `:628` / `suggestion_long_large.png` | 200%에서 긴 가전 이름·설명과 고정 하단의 같은 대상/버튼 수가 반복된다. 스크롤은 가능하므로 잘림 결함으로 단정하지 않는다. | 대상은 상단과 화면 읽기에 유지하며 하단 재확인 문구와 상단 조작 설명의 중복 축소. 승인·제한·모의 표시 유지. |
| MEDIUM | `app/lib/screens/history_screen.dart:54`, `:591` / `lt_history.png`, `history_large.png` | 긴 경고 본문과 ‘봐 주세요’ 칩이 같은 상태를 반복한다. 200%에서 첫 기록이 화면 대부분을 차지한다. | 짧은 상태명과 결과/다음 행동의 역할을 나눠 반복 축소. 미확인을 성공으로 바꾸지 않기. |
| LOW | `app/lib/screens/settings_screen.dart:114`, `:144` / `settings_large.png` | 공통 연결 실패와 각 행의 조회 실패가 연속된다. 상태는 정직하지만 메뉴보다 오류 문구의 비중이 커진다. | 공통 원인은 상단, 각 행은 제목/값 위계 조정. 값을 숨기거나 꺼짐으로 바꾸지 않기. |
| LOW | `app/lib/screens/appliance_detail_screen.dart:116`, `:187` / `lt_detail_photo.png` | 사진 조작과 버튼판 조작이 별도 경로다. 경로 존재는 코드 사실, 혼란은 추정. | 사진을 주 경로, 버튼판은 보조 영역으로 두는 안 검토. 접근성 대체 경로 삭제 금지. |

## 키오스크: 발견 사항

아래 파일은 `rpi5-touchscreen-app/` 기준이다.

| 심각도 | 파일:줄 / 골든 | 문제와 근거 | 최소 수정 방향 |
|---|---|---|---|
| MEDIUM | `lib/models/estop.dart:123`, `lib/widgets/kiosk/estop_banner.dart:60` / `hold_estop_confirm.png` | 연습 비상정지 본문은 실제 가전을 조작하지 않았다고 고쳤지만 상단 해제 확인에는 여전히 ‘가전 전원은 직접 켜 주세요’가 남는다. 이미지·코드 확인. | 상단 공통 안내도 연습/실제로 구분. 해제·정지 정책은 그대로. 이번 본문 수리만으로 전체 문맥 수리가 끝났다고 하지 않기. |
| MEDIUM | `lib/widgets/kiosk/done_view.dart:432`, `:740` / `kiosk15_done.png`, `done_large.png` | 전자레인지에 ‘가전이 움직이는지’라 하고 아래에서 다시 화면·불빛·소리를 묻는다. 관찰 대상이 모호하다는 것은 UX 판단이며 실사용 시험은 아님. | 실제로 확인할 대상에 맞는 질문 하나로 정리. 가열/켜짐을 코드가 확인했다고 새로 주장하지 않기. |
| LOW | `lib/widgets/kiosk/hold_view.dart:245` / `kiosk15_hold_estop.png` | 직접 취소·해제 절차에 정지 재사용 설명까지 누적된다. | 지금 행동 우선. 정지 재사용 설명을 해제 안내에 모으는 안 검토. |
| LOW | `lib/widgets/kiosk/appliance_strip.dart:450`, `:502` / `kiosk15_idle.png` | 흐린 꺼짐 타일도 누를 수 있다. 비활성으로 오해할 가능성은 추정. 밝기 규칙은 기존 사용자 결정. | 임의 색 변경 대신 실제 첫 사용자에게 선택 가능한지 확인. |
| LOW | `lib/widgets/kiosk/suggestion_view.dart:431` / `suggestion_long_large.png` | 큰 질문·선택지에 미실행 안내·닫힘 시간·연장이 함께 보인다. 잘림은 보이지 않지만 정보가 분산된다는 판단. | 정책·버튼 유지하며 하단 반복 설명만 축소 검토. |

이번 시각·코드 검토에서는 새 HIGH 실행 결함을 확정하지 못했다. 실행 안전에 HIGH가 없다는 보증이 아니다.

## 촬영 전 우선순위

1. 연습 비상 해제의 상단 전원 지시를 문맥에 맞추기. 실제/연습 위젯과 골든으로 고정.
2. 폰 상세 카드의 기본 글씨 줄바꿈 수리. 작은 변경으로 관찰 가능한 결함을 해소.
3. 홈에서 실행할 루틴을 빨리 찾도록 정보 순서 조정안을 확인. 제안 우선·경고·4탭은 유지.
4. 루틴의 오늘만 건너뛰기와 앞으로 자동 실행 끄기를 팀 밖 한 사람이 설명 없이 찾는지 확인. 실패하면 구획 이름/중복 표시부터 조정.
5. 실패널과 실폰에서 제안 → 실행 → 결과 미확인 → 정지 → 비상 해제를 촬영 거리·큰 글씨로 확인.

이 문서는 당시의 검토 기록이다. 위 발견 사항의 추가 수리를 완료했다는 보고가 아니다. 새 기능·팔레트 전면 교체·4탭 개편은 권고하지 않는다.

후속 조사: [국내 앱 7개 비교와 적용안](국내앱-UI-비교와-SimpleLay-적용안-2026-10-23.md). 실제 공개 화면에서 관찰한 구성, 가져오지 않을 부분, 처음 사용자 과업을 구분했다.
