Seongwonp/Simplelay/docs/고도화-계획-2026-10-26.md

# 고도화 계획 (2026-10-26)

> 기준: [CLAUDE.md](../CLAUDE.md) 10/25 방향 — 공감지능·일상 자동화가 먼저, 하드웨어는 수단. 실제 기록만 쓴다.
> 근거: [외부 조사](발표/공감지능-외부조사-2026-10-26.md) §5 고도화 후보.
> 작업 방식: AI 도구의 별도 세션에서 구현하고, 통합 세션에서 검토·커밋·배포한다. 아래 점수는 내부 검토 참고값이며 공식 심사 결과가 아니다. 이 문서는 10/26 당시 계획이다.

## 1. 일정 (10/26 오후 재검토 뒤 조정)

> 내부 검토 참고값: 78점(책임 24·조율 20·생활 18·증거 16). 검토 의견은 기능 추가보다 **실물 증거와 문서·코드 일치**를 우선하자는 것이었다. 수치는 당시 판단 기록으로 보존한다.

### 끝난 것 (10/26)

LG 앱·리모컨 조작 기록, 평일·주말 버그, 발표 문서 세 기둥, 플랫폼 AI 에이전트에 사람 수(보드에서 확인), 언어 모델 50+12문장 평가와 규칙 보강(예시 문장은 효과 없어 넣지 않음), 되돌리기 5분·미루기·7일 쉼(모의 시험), 확인 카드 동안 메뉴바 숨김, 재부팅 뒤 인터넷 자동 복구(재부팅 시험 통과), 제출 영상 콘티.

### 10/28 14시 제출까지 — 증거 만들기

| 순서 | 할 일 | 노력 | 상태 |
|---|---|---|---|
| A | 문서 과장·낡은 문장 정리, README를 세 기둥으로 | S | 진행 중 |
| B | 시연 문장이 매번 같게(언어 모델 결정적 설정) + 시연 문장 20번 반복 실측 | S | 진행 중 |
| C | **실물 한 바퀴:** 공기청정기 자동 실행(2분 뒤) → 실행됨 → '되돌리기' → 상태 다시 읽기. 그리고 LG 앱으로 켜서 직접 사용 기록이 실제로 생기는지 | S~M | 사람 있을 때 |
| D | **실제 기록에서 나온 습관 카드 찍기:** 실제 기록에 이미 3일 넘은 습관이 있다(밤 10시쯤 켜기 3일, 점심 1시쯤 켜기 3일). 카드가 뜨는 때를 계산해 영상에 담는다 | S | 확인 중 |
| E | 영상 촬영(콘티대로) → 편집 → 제출 | M | 10/27~28 |

### 11/6 결선까지

| 순서 | 할 일 | 노력 |
|---|---|---|
| F | 누름 장치: 납땜 → Z→G → 매핑 → **20번 눌러 n/N 기록**. 못 채우면 장면 ⑧은 한 문장으로 | L |
| G | 결선 시각(15:40) 습관: 매일 15:50쯤 실제 사용 → 11/6에 그 시각 카드 | S(매일) |
| H | 팀 밖 1~2명 사용 시험(카드 이해·맡기기·거절·멈추기·카메라 끄기), 막힌 곳 기록 | S |
| I | 자동 실행 직후 사람이 반대로 바꾸면(LG 앱 등) '거절'로 센다 — 지금은 '우리 변경'으로 보고 버림 | M |
| J | 결선장 네트워크에서 재부팅 리허설, 시연 전 점검표(하루 묻는 상한·자동 실행 상태) | S |
| K | §2 동의 기반 플랫폼 기능(비전 → 집의 기억 → 화자 구분), 여력 있을 때만 | M~L |
| L | 언어 모델 LoRA 미세조정(데스크톱 RTX 3050 QLoRA → GGUF), 규칙으로도 모자랄 때만, 평가 세트와 분리 | L |
| M | 열 안 나는 가전 맡기기(CT 상태 + 사람 있음 + 사용자 허락), CT 연결 | M |
| N | 키오스크 🎤 말하기 단추(누르고 말하기 → 본체 음성 인식 한국어 → 지금 '말 알아듣기'로). 여력 있을 때만. **'레이야' 부르기(웨이크워드)는 결선 뒤** — 감지 모델·지연(음성 인식+언어 모델 약 15초)·결선장 소음 위험 | M |

**발표에서 뺄 것:** 플랫폼 AI 에이전트 연동은 질의응답에서만, 조언 장면은 한 줄, CT·콘센트는 '다음 단계' 한 줄.

## 2. 동의 기반 플랫폼 기능 (사용자 동의 10/26)

플랫폼 기능 가운데 카메라·목소리를 다루는 것은 **사용자 동의**를 받고 앱 단위로 써야 한다.
그래서 동의는 **키오스크 앱**이 받고, 백엔드는 결과만 쓴다. (세부 확인 내용은 저장소 밖에 둔다.)

### 2-0. 공통: 동의 흐름 (먼저, S)

1. 키오스크 설정에 **'본체 AI 기능' 화면**을 둔다. 기능마다 무엇을 보고·무엇을 남기지 않는지 한 줄, 켜기 단추.
2. 켜기를 누르면 키오스크가 플랫폼 동의 창을 띄우고, 결과를 받는다.
3. 동의 결과를 백엔드 설정에 적는다(기능별 켜짐/꺼짐, 동의한 때). 끄면 바로 멈추고 저장한 것을 지운다.
4. **먼저 확인할 것:** 키오스크 앱 이름으로 동의 요청이 실제로 되는지 한 번 시험(새 키오스크 설치 필요).
   안 되면 이 절 전체를 '앞으로 할 일'로 돌리고 지금 방식(우리 사람 감지, 카메라 끄기 단추)을 유지한다.

### 2-1. 플랫폼 비전으로 사람 감지 (M)

- 지금: 우리 감지기가 본체 온디바이스 AI 추론 위에서 사람 수를 센다.
- 바꿀 것: 동의를 받으면 **플랫폼 비전 기능**으로 사람 수를 받는다. 얼굴은 쓰지 않고 **있음/없음·사람 수만** 쓴다.
- 안 되면 지금 감지기로 돌아간다(같은 `presence_cam.json` 모양).

### 2-2. 목소리로 '누구의 습관인가' (M~L, 11/6엔 시범만)

- 심사 공격 '누구의 습관인가'의 답. 지금은 가구 단위로만 답한다.
- 하는 것: 동의한 가족만 키오스크에서 **목소리를 한 번 등록**(문장 3개). 키오스크에서 말로 시킬 때 등록된 목소리면 사용 기록에 그 사람을 붙인다.
- 습관은 사람별로 따로 센다. 모르는 목소리·등록 안 한 사람은 지금처럼 가구 기록.
- 남기지 않는 것: 녹음 원본(등록 때 특징값만 본체에 저장, 지우기 단추).
- 말 알아듣기는 지금처럼 **폰 글자**로 하고, 키오스크 마이크는 누가 말했는지 구분에만 쓴다.
- 11/6: 두 사람 등록 → "성원님 습관 / 예솔님 습관"이 나뉘어 보이는 것까지만. 안 되면 '앞으로 할 일'.

### 2-3. '집의 기억' (M)

- 하는 것: 매일 밤 만든 생활 요약 문장과 맡긴 습관·거절 기록을 본체 안 검색 저장소에 넣는다.
- 쓰는 곳: 폰에서 "지난주에 공기청정기 언제 켰지?", "왜 이걸 물어봐?" 같은 질문에 본체 안에서 찾아 근거와 함께 답한다.
- 개인 정보: 사용 기록 문장만(사진·목소리 없음), 본체 밖으로 안 나감, '알게 된 것'에서 지우면 같이 지운다.
- 동의: 사용 기록은 이미 본체 안에 있으므로 별도 동의 없이 설정에서 끄기 단추만.

## 3. 맡기기 신뢰 강화 (외부 조사 §5)

| 순서 | 할 일 | 노력 |
|---|---|---|
| 1 | 자동 실행 뒤 몇 분 '되돌리기' — 누르면 원래대로 + 그 습관 맡기기 끔 | S — **10/26 시험 조건 완료**(5분, [devlog](devlog/devlog_2026-10-26-trust.md)) |
| 2 | 연속 2번 거절·무반응이면 그 습관 7일 쉼 | S — **10/26 시험 조건 완료** |
| 3 | 최근 14일로 평소 시각 다시 계산, 계속 안 쓰면 '확인 필요' | S~M |
| 4 | 평소 시각 10분 전에 아무도 없으면 +30분까지 기다렸다 한 번 묻기 | S — **10/26 시험 조건 완료** |
| 5 | 위험도 높은 가전은 근거 날 수를 더 요구 | S |
| 6 | 여러 사람 충돌(같은 가전 켜고 끄기 반복) — 2-2가 되면 사람별로, 아니면 '앞으로 할 일' | — |

## 4. 하지 않는 것

- 플랫폼 알림을 백엔드에서 바로 띄우기 — 키오스크 화면 안 알림으로 대신한다.
- 얼굴 인식, 사람 이름을 카메라로 알아내기.
- 플랫폼 기기 연동(Matter 등) — 아직 쓸 수 있는 통로가 없다.
