Seongwonp/Simplelay/docs/제출전-검증-과업.md

# 제출 전 검증 과업 — 비교 · 사용자 · 원가와 설치 시간 (2026-10-14)

10/28(수) 14:00 서류 제출 전에 **실제로 수행할 최소 과업**으로 정한 당시 계획이다. AI 도구로 진행한 심사 관점 내부 검토(10/14, 저장소 밖 로컬 메모)에서
지적된 공백은 "상용 버튼 푸셔와 무엇이 다른지를 보인 숫자", "누가 써 봤는지", "원가·설치 시간"이었다. 계획표만으로는 증거가 되지 않으므로
과업마다 횟수·지표·하드웨어 전제·담당·목표일을 정한다.

- 결과는 이 문서 끝 §4 표와 [실측 기록표](실측-기록표.md)에 적고, 제출 서류([개발완료보고서](submission/개발완료보고서-초안.md) §5,
  [작품소개서](submission/작품소개서-초안.md) 2쪽)의 【기입】 칸으로 옮긴다.
- **수행하지 못한 과업은 결과 칸을 비워 두고 "수행하지 못함 — 이유"로 적는다.** 모의로 대신 채우지 않는다.
- 담당: **HW** = 서예솔(갠트리·솔레노이드·콘센트 모듈 회로·배선), **SW** = 박성원(보드 배포·설정·기록 도구·화면). 목표일은 팀이 확정한다.

## 검증 과업 우선순위 (10/16 당시 계획)

당시 내부 참고 점수는 하드웨어 완성을 가정한 80점, 목표 85점이었다. 소프트웨어 상한 81~82라는 의견과 아래 예상 가점도 AI 도구의 추정이며 공식 배점·수상 예측·성능 측정이 아니다. 점수 상승을 보장하는 계획으로 읽지 않고, 실제 증거를 확보할 과업 순서로 사용한다.

| 순서 | 할 일 | 예상 | 어디에 적나 |
|---|---|---|---|
| 1 | **장면 ②③ 실물 처음부터 끝까지 1회** — '30초 데우기'(30초 → 시작) 실제 누름 → CT 가열 시작·종료 → 공기청정기 카드/자동 실행, **30초 영상** | +2 | README 사진·영상 칸, 보고서 §6, [시연 계획 v4](본선-시연-계획-v4.md) |
| 2 | 누름 성공률 버튼 3개 × n≥10(가능하면 n≥20), 첫 시도/재시도 구분 | +1 | [실측 기록표](실측-기록표.md) §4 |
| 3 | CT A·B·D 각 3회(정상·가열 중 전력 감소·종료 뒤 팬), C1·C2 발생 여부 | +0.5 | 실측 기록표 §6 |
| 4 | 캐리지 이동 중 물리 정지 지연(t0→③), PS-1 S4·S5·엔코더 뽑기 | +0.5 | 실측 기록표 §5, [안전 계약 보고](안전계약-적용-보고-2026-10-15.md) §3 |
| 5 | 대회 규정의 재사용·중복 출품 조항 확인 → 애매하면 사무국 문의(같은 기계 공유) | 감점 방지 | [질의응답 대비](질의응답-대비.md) Q7 |
| 6 | 원가 BOM·설치 시간 1회, 팀 밖 1~2명 사용성 | +0.5~1 | 이 문서 §2·§3·§4 |
| 7 | 손 닿는 물리 전원 차단 스위치 | 질의 방어 | 하드웨어 연결 설계 |
| 8 | 평가 전에 끌 것: `SIMPLELAY_DEV_MODE`(폰 '개발자' 탭)·`/docs`·`/openapi.json`·`/redoc` | 감점 방지 | [결선 운영 런북](결선-운영-런북.md) |

## 0. 공통 전제 — 하드웨어 준비 순서

과업 (a)·(c)는 아래 H1~H3이 끝나야 시작할 수 있다. (b)는 하드웨어 없이 모의 화면으로 한다.

| # | 전제 | 지금(10/14) | 담당 | 목표일 |
|---|---|---|---|---|
| H1 | 벨트·레일 조정 → 캐리지 이동 → `G` 폐루프 → `H` 원점 | 모터 축 구동·정지만 확인(벨트 없음) | HW(조립) · SW(시험 명령·기록) | 10/16 |
| H2 | 솔레노이드로 전자레인지 버튼 실제 누름(30초·시작) | 누름 **신호**만 확인(솔레노이드 없음) | HW | 10/17 |
| H3 | 콘센트 모듈 회로(CT ch0) 배선 → 전자레인지 가열 시작·종료 판정 실측([실측 기록표](실측-기록표.md) §6 A·B·D) | 판정 코드·가짜 모듈 시험만, 회로 미제작 | HW(회로) · SW(기록·판정 확인) | 10/18 |
| H4 | (선택) L1 누름 전류 센서(ADS1115) 배선 | 미배선 — 없으면 RPi4 L1은 모의 판정기라 **SimpleLay의 누름 확인은 L3(CT)만으로 동작한다** | HW | 미정 |

- H4가 없으면 아래 (a)의 SimpleLay 군은 "누름 확인(L1) 없이 가열 확인(L3)만"이다. 결과표와 서류에 그대로 적는다.
- L2(가전 수락음)는 RPi4 운영 경로에 연결되지 않았다. 어느 과업에서도 L2를 켰다고 말하지 않는다.
- 전자레인지 가열은 [결선 운영 런북](결선-운영-런북.md) §3-7 안전 체크리스트(빈 상태 가열 금지·시간 상한·사람 입회)를 통과했을 때만 한다.

## 1. (a) 비교 과업 — 사람 / 동작 확인 기능을 끈 비교 조건 / SimpleLay

**질문:** 같은 장치에서 **동작 확인 기능을 끈 비교 조건**(누르기만 하고 눌림·가열을 확인하지 않음)과 SimpleLay는 **실패가 끼었을 때** 무엇이 다른가 —
잘못된 상태로 끝나는 횟수와, 사용자가 그 사실을 알게 되는 시간. 정상 조건에서 셋이 비슷한 것은 예상 범위다.
설계 원본은 [A/B 비교 실험](AB-비교-실험.md)이고, 여기서는 제출 전에 끝낼 수 있는 최소 횟수로 줄였다.

> **상용 제품 실험이 아니다.** ②는 상용 버튼 푸셔를 사서 시험한 것이 아니라 **우리 장치에서 확인 기능만 끈 조건**이다.
> 그래서 이 결과로 "상용 제품보다 낫다"고 말하지 않는다. 상용품과의 비교는 두 가지로 나눠 적는다.
> - **기능 비교(조사):** 공개 사양(제조사 제품 페이지·설명서)에 적힌 기능만, 출처와 확인 날짜를 붙여 표로 적는다([실측 기록표](실측-기록표.md) §3, `조사(출처)`). 사양에 없는 기능을 "없다"고 단정하지 않는다.
> - **비교 조건 실험(실측):** 이 절의 ①②③. "확인을 끄면 실패를 언제·어떻게 알게 되는가"만 보여 준다.

**과업:** 전자레인지 "30초 → 시작"(30초 버튼 다음 시작 버튼 — 시연 '30초 데우기'와 같은 과업, 10/18 결정). 셋 모두 같은 전자레인지·같은 내용물(물을 채운 내열 컵 또는 즉석밥 — 빈 상태 가열 금지)·같은 위치에서 한다.

### 1-1. 조건표 — 반복 수·성공 기준·오류 검출 기준 (먼저 확정, 2026-10-14)

총 횟수보다 이 표가 먼저다. **성공 여부(정답)는 SimpleLay의 판정으로 정하지 않는다** — 영상 또는 별도 관찰 기록지에 **사람이** 적은 판정이 정답이고,
SimpleLay·비교 조건의 화면 보고는 그 정답과 맞춰 보는 대상이다.

| 조건 | 넣는 방법 | 반복 ① 사람 / ② 비교 조건 / ③ SimpleLay | 정답(사람 판정으로 기대하는 것) | 과업 성공 기준(사람·영상) | 오류 검출 기준(시스템 보고) |
|---|---|---|---|---|---|
| C0 정상 | 없음 | 5 / 5 / 5 | 가열 중 | 명령(①은 첫 손 접촉) 뒤 **30초 안에** 30초 설정으로 가열 시작 — 회전판·램프·표시창 카운트다운 중 둘 이상이 영상에 보임 | 해당 없음(오류 없음). 시스템이 실패·확인 못 함을 보이면 **오경보**로 센다 |
| C1 누름이 안 들어감 | "시작" 좌표를 버튼 가장자리 밖으로 옮김(실제로 안 눌리는 거리를 C0 보정 뒤 먼저 확인해 기록) | — / 5 / 5 | 가열 안 됨 | 같은 기준으로 판정 → 정답은 "실패" | **검출** = 과업 끝 보고(또는 그 뒤 60초 안)에 폰·키오스크가 실패·"확인하지 못했어요"를 보임. **놓침** = 성공처럼 보이거나 "보냈어요"만 보이고 60초 안에 실패 알림 없음 |
| C3a 문 열림 — **시작 전** | 과업 시작 전에 문을 살짝 열어 둠(버튼은 눌리지만 가전이 시작을 거부) | 5 / 5 / 5 | 가열 안 됨 | 위와 같음 → 정답은 "실패" | C1과 같음 |
| C3b 문 열림 — **가열 중** (선택) | C0처럼 시작해 가열 시작을 사람이 확인한 뒤 10초에 문을 엶(가전이 가열을 멈춤) | — / 3 / 3 | 가열이 시작됐다가 중단 | 시작은 성공, **중단 시각**을 영상 시각으로 기록 | **검출** = 중단 뒤 60초 안에 '가열 종료 감지(조리 완료가 아닐 수 있음)'·중단 알림을 보임. **놓침** = 알림 없음. '조리 완료'라고 보이면 **잘못된 보고**로 따로 센다 |

- 필수 합계 ① 10 · ② 15 · ③ 15 = **40회**, 선택 C3b ② 3 · ③ 3. C3a와 C3b는 다른 조건이다 — 결과를 합치지 않는다.
- **조건 순서:** ②↔③ 전환은 RPi4 재시작이 필요해(1-3) 군 단위 블록으로 하고(② → ③ → ② → ③ 식으로 번갈아), 블록 안에서 조건 순서를 섞는다. 실제 순서를 기록한다. 매번 가전을 대기 상태로 되돌린다.
- C1은 H4(L1)가 없으면 ③도 누름 실패를 직접 보지 못하고 L3(가열 없음)로만 알아챈다 — 그렇게 나오면 그대로 적는다.
- C3b를 ③에서 하려면 RPi4에 가열 종료 감지(`SIMPLELAY_DONE_WATCH=microwave:outlet`)가 켜져 있어야 한다. 기준값(`SIMPLELAY_CYCLE_*`)은 측정 전이라 C3b 결과는 "초기 설정값 기준"으로 적는다.
- 시간이 남으면 [A/B 비교 실험](AB-비교-실험.md)의 C2(누름 시간 부족)와 조건별 10회로 늘린다.

### 1-2. 정답 기록 — 영상 또는 관찰 기록지(사람)

- 모든 회차를 **전자레인지 표시창·회전판이 보이게** 영상으로 남긴다(손·장치만, 얼굴 없음). 영상이 없거나 끊긴 회차는 관찰자 1명이 아래 기록지에 그 자리에서 적고 "영상 없음"으로 표시한다.
- 관찰자는 그 회차의 군·조건을 알아도 되지만 **시스템 화면을 보고 판정하지 않는다**(가전만 보고 적은 뒤 화면 보고를 옮겨 적는다).
- 시각은 영상 시각과 실행 기록(`/status`·RPi4 기록기) 시각을 회차 시작 때 한 번 맞춘다(화면 시계 촬영).

| 회차 | 순서 | 군 | 조건 | 사람 판정(가열 중/안 됨/중단) | 판정 근거(영상 파일·시각 또는 관찰자) | 시스템이 보인 문구 | 알림 시각 | 사람이 실패를 안 시각 | 비고 |
|---|---|---|---|---|---|---|---|---|---|
|  |  |  |  |  |  |  |  |  |  |

### 1-3. ② 동작 확인 기능을 끈 비교 조건 — 설정만 바꾼다 (코드로 확인, 코드 수정 없음)

**결론: 분리 가능.** RPi4 실행기의 동작 확인(L3 전력 판정·가열 종료 감지)은 env로 끌 수 있고, 비상정지·걸림 감지·이동 한계·호스트 워치독은 그 env를 읽지 않는다(2026-10-14 `rpi4/act_main.py`·`rpi4/services/target_binding.py`·`rpi/controller/power_operation.py`·`rpi/controller/serial_motion.py`·`rpi/controller/kinematics.py`를 읽고 확인, 실물 미검증).

| RPi4 env | ③ SimpleLay | ② 비교 조건 | 바꾸면 꺼지는 것 |
|---|---|---|---|
| `SIMPLELAY_L3_MODE` | `real` | **`off`** | L3 판정기 없음 → 결과의 `operation_confirmed`가 null(판정 안 함), 실패·재전송 판단에 전력을 쓰지 않음 |
| `SIMPLELAY_DONE_WATCH` | `microwave:outlet`(C3b를 할 때) | **비움** | 가열 종료 감지(`appliance_done`) 없음 |
| `SIMPLELAY_SENSORS_ENABLED` | H4 있으면 `true`, 없으면 `false` | `false` | L1은 모의 판정기(`MockVerifier`, 늘 통과·재시도 없음). **H4가 없으면 ③도 `false`** — 이때 L1 기록은 근거가 아니므로 지표에 쓰지 않는다 |
| `SIMPLELAY_OUTLET_PORT`·`_BAUD`·`_CHANNELS`, `SIMPLELAY_MOTION_*`, `SIMPLELAY_MOTION_HEARTBEAT_MS` | 그대로 | **그대로(바꾸지 않음)** | — |

코드 근거(바꾸지 않아도 남는 안전 기능):
- **비상정지:** 콘센트 모듈 링크는 `SIMPLELAY_OUTLET_PORT`만 보고 연다(`_build_outlet`). 모션이 `serial`이면 L3가 꺼져도 전자레인지 CT 채널의 소비자가 남아(`_press_reads_outlet`) 링크·릴레이·채널 검사가 그대로이고, 링크가 있으면 비상정지 래치(`_wire_outlet_estop` → `handle_outlet_estop`, 해제는 RPi5 `POST /stop/ack`)가 L3 모드와 무관하게 연결된다. RPi5의 정지 버튼·`/stop` 경로도 이 env를 읽지 않는다.
- **정지 확인:** L3가 `off`여도 대상의 CT 채널 결속은 유지된다(`TargetBinder._build`가 `off`에서도 채널을 넘김) — 정지 보고 단계(보냄 → 모션 보드 응답 → 멈춤 확인)는 모션 어댑터를 읽는다.
- **걸림 감지:** 모션 MCU의 `alarm`(stall·limit 등)을 `MotionAlarm`으로 받아 재시도 없이 멈춘다(`serial_motion.py`). L3·센서 env와 무관.
- **이동 한계:** XY 소프트 리밋(`kinematics.check_soft_limits`, `SIMPLELAY_MOTION_*`의 `x/y_min/max_mm` 필수)과 펌웨어 쪽 한계. L3·센서 env와 무관.
- `SIMPLELAY_L3_MODE`·`SIMPLELAY_SENSORS_ENABLED`·`SIMPLELAY_DONE_WATCH`를 읽는 곳은 위 검증·기록 경로, 화면용 상태(RPi5 `ambient_router`·`connections`), PC 시뮬레이터뿐이다(`git grep`으로 확인).

절차와 주의:
1. ③ 설정의 RPi4 env 파일을 백업하고, ②로 바꿀 때 위 표의 굵은 칸만 고친 뒤 RPi4 실행기를 재시작한다(env는 시작 때 읽는다). 바꾼 줄과 시각을 기록한다.
2. **측정 전 1회:** ②에서 비상정지 버튼 → 모터 멈춤 → `/stop/ack` 해제, 그리고 걸림 알람(엔코더 선 빼기, 10/14와 같은 방법)이 그대로인지 확인하고 기록한다. 하나라도 다르면 ②를 하지 않고 "분리 불가 — 보고"로 바꾼다.
3. ②의 폰·키오스크는 `operation_confirmed` null을 '동작 확인 모름'처럼 보일 수 있다. 그 문구를 측정 전에 한 번 보고 적되, **지표는 화면이 아니라 1-2의 사람 판정과 실행 기록으로만 센다.**
4. 끝나면 백업으로 되돌리고 되돌린 것을 기록한다. RPi5 `SIMPLELAY_ROUTINE_DONE_SENSORS`는 루틴 끝 기다림에만 쓰이므로 이 단순 실행 비교에서는 바꾸지 않는다.

- (참고) [A/B 비교 실험](AB-비교-실험.md) §7의 비교 실험 모드(env 두 개 게이트·배지·성공률 집계 제외)는 동결 중이라 만들지 않는다. 위 설정 전환으로 충분하다.

**지표(정의는 [A/B 비교 실험](AB-비교-실험.md) §5와 같다).**

| 지표 | 정의 |
|---|---|
| 과업 성공 | 1-2의 사람 판정으로 30초 설정 가열 중(C3b는 시작 성공) |
| 잘못된 상태로 끝남 | 사람 판정은 "가열 안 됨·중단·다른 모드"인데 시스템(①은 사람)은 끝났다고 했고 60초 안에 실패 알림이 없음 |
| 오류 검출 | 1-1의 오류 검출 기준을 만족한 회차 수 / 실패 조건 회차 수. 오경보(정답 성공인데 실패 보고)는 따로 센다 |
| 알아챈 시간 | 과업 끝 → 사용자가 실패를 안 순간(초). 알림이 있으면 알림 시각, 없으면 사람이 가전을 보고 안 시각. 60초 안에 모르면 "모름(>60 s)" |
| 소요 시간 | 명령 → 시스템 종료 보고(①은 첫 손 접촉 → 마지막 손 뗌) |

**하드웨어 전제:** H1·H2·H3 필수, H4 선택. **담당:** HW — 갠트리 고정·C1 좌표·C3 문 조건 준비, ① 수행자 / SW — ②·③ 설정 전환과 되돌림, 실행 기록 내보내기, 시각 맞춤, 기록표.
**목표일:** 10/19~10/21(10/20 영상 촬영 때 C1·C3 장면을 함께 찍는다).

**말해도 되는 것(결과가 생긴 뒤):** "같은 장치에서 동작 확인 기능을 끈 비교 조건과 비교했더니, 실패 조건 N회 중 잘못된 상태로 끝난 것이 ② a회·③ b회였습니다."
**말하면 안 되는 것:** "상용 제품보다 정확합니다", "상용 버튼 푸셔는 실패를 모릅니다"(상용 제품을 시험하지 않았다 — ②는 우리 장치의 비교 조건이다).

## 2. (b) 초기 사용성 점검 — 팀 밖 1~2명

**질문:** 팀 밖의 사람이 **도움 없이** 제안을 이해하고, 승인·거절하고, 실행을 멈추고, 제안을 잠시 쉬게 할 수 있는가.
가능하면 고령 가족 1명을 포함한다. 결과는 익명 요약만 저장소에 넣는다.

> **이름은 '초기 사용성 점검'이다.** 사용자 평가·접근성 검증이 아니다. 고령자·시각장애인이 참여하지 않았다면
> 그 사용자를 위한 접근성을 검증했다고 말하지 않는다. 참여했더라도 1~2명의 결과로 일반화하지 않는다.

- **개인정보:** [사용자 의견 계획](사용자-의견-계획.md) §1 원칙을 그대로 따른다 — 이름·연락처·나이·장애 정보·얼굴·음성 원본·동의서는 저장소에 넣지 않는다.
  참여자는 `U1`·`U2`, 특성은 "70대" 같은 넓은 범주로만. 동의는 같은 문서 §3 동의서로 받는다.
- **역할 구분:** 가전 등록(사진·모서리·버튼 위치)은 설치자·보호자의 일로 보고 **이 과업에서 빼고**, 일상 사용 화면만 본다.
- **화면:** 모의 서버(실제 가전은 움직이지 않음) + 폰 앱 + 키오스크(15.8형 패널, 없으면 노트북 브라우저). "모의" 표시를 가리지 않는다.

| # | 과업(진행자가 그대로 읽음) | 성공 기준 | 보는 것 |
|---|---|---|---|
| U-1 제안 이해 | "화면에 뜬 카드를 읽고, 이 기계가 무엇을 하려는지 말씀해 주세요." | 대상 가전과 동작을 맞게 말함 | 카드 문장·글자 크기를 이해하는지 |
| U-2 승인 | "이 일을 하도록 허락해 주세요." | 승인해 실행 완료 화면을 봄 | 승인 전에 누를 순서를 읽는지 |
| U-3 거절 | "다음 카드는 이번에는 하지 않겠다고 해 주세요." | **'이번엔 안 할게요'**로 넘김 | 승인과 거절을 헷갈리지 않는지 |
| U-4 정지 | "실행 중에 멈추고 싶어졌습니다. 멈춰 보세요." | 정지를 요청하고 멈춘 결과 문장을 봄 | 정지 버튼을 바로 찾는지 |
| U-5 잠시 쉬기 | "한동안 제안을 받고 싶지 않습니다. 잠시 쉬게 해 주세요." | **'잠시 쉬기'**(지금부터 정한 시간)를 켜고 남은 시간을 확인, 다시 풀 수 있음. 매일 정한 시간대의 **'조용한 시간'**과는 다른 기능이다 | 설정 위치를 찾는지·풀 수 있는지 |

**기록 항목(참여자·과업마다 한 줄, 익명):**

| 참여자 | 과업 | 도움 없이 완료(예/아니오/도움 받아) | 잘못 누른 횟수 | 도움을 요청한 지점(화면·문구) | 소요 시간 | 한 줄 의견 |
|---|---|---|---|---|---|---|
| U1 | U-1 |  |  |  |  |  |

- 참여자 특성은 "팀 밖 성인", "70대" 같은 넓은 범주로만 적는다. 이름·연락처·장애 정보·얼굴·음성 원본은 어디에도 남기지 않는다.
- 한 과업이 5분을 넘으면 도움을 주고 "도움 받아"로 센다. 진행자는 버튼 이름·위치를 알려 주지 않는다. 10초 넘게 멈춘 곳은 도움 요청 지점 칸에 함께 적는다.
- 막힌 곳은 [사용자 의견 계획](사용자-의견-계획.md) §7 표로 "발견 → 조치 → 다시 확인"까지 잇는다. 고치지 않기로 한 것도 이유를 적는다.
- **결과를 일반화하지 않는다.** 서류·발표 문장은 "초기 사용성 점검으로 팀 밖 N명이 모의 화면 과업 5개 중 k개를 도움 없이 끝냈고, 막힌 곳 j개를 고쳤습니다"까지.

**하드웨어 전제:** 없음(모의 서버). 키오스크 실패널이 있으면 쓴다. **담당:** SW — 모의 서버·폰·키오스크 준비와 참여자마다 상태 초기화 / 팀 — 모집·진행(진행자 1, 기록자 1).
**목표일:** 10/17~10/19(주말). 고친 것은 10/22까지 반영하고 한 명이라도 다시 확인한다.

## 3. (c) 원가(BOM)와 설치 시간

### 3-1. 원가 — 실제 구매가로만

시연 1대(전자레인지 조작부 하나) 기준. 금액은 **영수증·주문 내역**으로만 채우고, 지급품·기존 보유품은 조달 칸에 구분한다.
조사가(쇼핑몰 표시가)를 쓰면 비고에 `조사(날짜)`를 붙이고 실제 구매가와 섞어 합산하지 않는다. 빈칸은 "아직 모름"이다.

| 구분 | 품목 | 수량 | 실제 구매가(원) | 조달(구매/지급/보유) | 근거(영수증·주문) | 비고 |
|---|---|---|---|---|---|---|
| 허브 | RPi5 + 전원·저장장치 | 1 |  |  |  | 허브·키오스크 |
| 실행기 | RPi4 + 전원·저장장치 | 1 |  |  |  | 계획서 RPi Zero 자리 |
| 화면 | 15.8형 터치 패널 + 케이블·PD 전원 | 1 |  |  |  |  |
| 모션 | ESP32(모션) | 1 |  |  |  |  |
| 모션 | FIT0482 엔코더 모터 | 2 |  |  |  |  |
| 모션 | 모터 드라이버(JMOD-MOTOR-1) | 1 |  |  |  |  |
| 모션 | 프레임·레일(3D 출력)·베어링·2GT 벨트·풀리 | 1식 |  |  |  | 출력 재료비 포함 여부 비고 |
| 누름 | 솔레노이드 + MOSFET·다이오드 | 1식 |  |  |  |  |
| 콘센트 | ESP32(콘센트 모듈) | 1 |  |  |  |  |
| 콘센트 | CT 센서 + ADS1115 | 1~2 |  |  |  | 시연은 ch0만 |
| 콘센트 | 릴레이·비상정지 버튼·퓨즈·콘센트 함 | 1식 |  |  |  | 회로 제작 뒤 확정 |
| 전원 | 12 V 어댑터·감압 모듈·배선 | 1식 |  |  |  |  |
| (선택) | L1 전류 센서 배선 | 1식 |  |  |  | H4를 할 때만 |

| 합계 | 금액(원) | 포함 범위 |
|---|---|---|
| 시연 1대(지급품 포함) |  |  |
| 시연 1대(지급품 제외) |  |  |
| 조작부 하나 더 붙일 때 늘어나는 것 |  | 갠트리·누름·(CT 채널) — 허브·화면은 공유 |

- 공기청정기(ThinQ 가전)는 시연 대상 가전이라 원가에 넣지 않고 따로 적는다.
- **담당:** HW — 부품 영수증·주문 내역 모으기 / SW — 표 정리. **목표일:** 10/22.

### 3-2. 설치 시간 — 처음 해 보는 사람 포함

단계 정의는 [실측 기록표](실측-기록표.md) §2(① 부착 → ② 원점 → ③ 버튼 좌표 보정 → ④ 준비 확인 → ⑤ 첫 누름 확인)를 그대로 쓴다.

| 회차 | 설치자 | 하는 일 | 기록 |
|---|---|---|---|
| 1 | 팀원(HW) | 전자레인지에 처음 붙이기 | 단계별 시간·막힌 곳 |
| 2 | 팀원(HW) | 떼었다 다시 붙이기(재부착) | 단계별 시간 + 재부착 뒤 버튼 위치 오차(30초·시작, mm 또는 "눌림/안 눌림") |
| 3 | **처음 해 보는 사람**(팀 밖 또는 SW 담당) | 안내 문서·폰 가전 추가 5단계만 보고 설치 | 단계별 시간·도움 요청 횟수·막힌 곳 |

- 스톱워치와 영상(손·장치만)으로 잰다. 3회차 참여자가 팀 밖이면 §2와 같은 개인정보 원칙을 따른다.
- **하드웨어 전제:** H1·H2(③⑤ 단계), 콘센트 모듈 없이도 ①~④는 잴 수 있다. **담당:** HW — 부착 기구·1·2회차 / SW — 폰 보정 단계·시간 기록·3회차 진행. **목표일:** 10/22.
- 결과는 [실측 기록표](실측-기록표.md) §2 표에 적는다. 1회의 기록을 "누구나 N분"으로 일반화하지 않는다.

## 4. 결과 요약(제출 서류로 옮길 칸)

| 과업 | 수행일 | 표본 | 결과 | 근거(기록 위치) |
|---|---|---|---|---|
| (a) 비교 — 실패 조건에서 잘못된 상태로 끝남·오류 검출 ② / ③ |  | 실패 조건 C1·C3a ②10·③10 (C3b 선택 ②3·③3 따로) | 【기입】 |  |
| (a) 비교 — 알아챈 시간 p50 ② / ③ |  |  | 【기입】 |  |
| (a) 비교 — 정상 조건 성공 ① / ② / ③ |  | 각 5 | 【기입】 |  |
| (b) 초기 사용성 점검 — 도움 없이 끝낸 과업 수 · 잘못 누른 횟수 |  | N명 × 5과업 | 【기입】 |  |
| (b) 초기 사용성 점검 — 도움 요청 지점 / 고친 것 |  |  | 【기입】 |  |
| (c) 원가 — 시연 1대(지급품 포함/제외) |  |  | 【기입】 |  |
| (c) 설치 시간 — 처음 / 재부착 / 처음 해 보는 사람 |  | 3회 | 【기입】 |  |

- 모의로 돌린 행은 이 표에 넣지 않는다(형식 확인용 모의 실행은 [A/B 비교 실험](AB-비교-실험.md) §6처럼 `모의`로 따로 둔다).
- 이 표가 비어 있는 상태로 제출하게 되면, 서류에는 "제출 전 수행 계획"과 "수행하지 못한 이유"를 적고 발표에서는 결선 당일까지의 결과를 말로 덧붙인다.

## 5. 서류 【기입】 칸 일정표 (2026-10-14, 일정 관리용)

[개발완료보고서](submission/개발완료보고서-초안.md)·[작품소개서](submission/작품소개서-초안.md)의 【기입】 칸을 모두 적고, 각각을 닫을 과업·담당·목표일을 붙였다.
목표일은 위 H1~H3·(a)~(c)의 목표일에서 가져온 **제안**이고 팀이 확정한다. 닫지 못한 칸은 서류에서 문장째 지우고 이 표에 "수행하지 못함 — 이유"를 적는다.

| # | 서류·위치 | 【기입】 칸 | 닫을 과업 | 담당 | 목표일 | 결과·상태 |
|---|---|---|---|---|---|---|
| K1 | 보고서 §5-2 잰 값과 잴 값 | 캐리지 이동·원점 | §0 H1(벨트·레일 → `G` 폐루프 → `H` 원점) | HW(조립) · SW(시험 명령·기록) | 10/16 |  |
| K2 | 보고서 §5-2 잰 값과 잴 값 | 솔레노이드 실제 누름 — 첫 시도 성공률 · 재시도 포함 | §0 H2 + [실측 기록표](실측-기록표.md) §4 성공률(사람 판정) | HW(솔레노이드) · SW(기록) | 10/17~18 |  |
| K3 | 보고서 §5-2 잰 값과 잴 값 | CT 가열 판정 — 시작 판정 지연 · 종료 판정 지연 · B·D 오판 | §0 H3 + [실측 기록표](실측-기록표.md) §6 A·B·C1·C2·D | HW(회로) · SW(판정 확인) | 10/18~19 |  |
| K4 | 보고서 §5-2 잰 값과 잴 값 | 캐리지 이동 중 정지(보냄 → 멈춤 확인) | H1 뒤 이동 중 정지 실측(모터 축 10/13 방식을 캐리지로) | SW · HW | 10/17 |  |
| K5 | 보고서 §5-2 잰 값과 잴 값 | ThinQ 공기청정기 실가전(핫스팟 조건 왕복 지연) | [ThinQ 실물 확인 절차](ThinQ-실물-확인-절차.md) | SW | 가전 도착 다음 날(도착일 팀 확정) | **일부 닫음(10/15):** 실가전 찾기·추가·상태·풍량 변경 `state_confirmed`(집 Wi-Fi, 허브는 노트북, [기록](devlog/devlog_2026-10-15-thinq-real.md)). 남은 것: 핫스팟 조건 왕복 지연 측정, RPi5 허브에서 |
| K6 | 보고서 §5-3 비교 조건 실험 · 소개서 2쪽 | 잘못된 상태로 끝남 ②/③ · 알아챈 시간 p50 ②/③ · 정상 조건 성공 ①/②/③ | §1(1-1 조건표·1-2 사람 판정 기록·1-3 ② 설정) | HW(C1·C3 준비·① 수행) · SW(②③ 전환·기록) | 10/19~21(10/20 영상 촬영과 함께) |  |
| K7 | 보고서 초기 사용성 점검 · 소개서 2쪽 | 도움 없이 완료 · 잘못 누른 횟수 · 도움 요청 지점과 고친 것 | §2 | 팀(모집·진행) · SW(모의 서버·초기화) | 10/17~19, 고친 것 10/22 |  |
| K8 | 보고서 원가 · 소개서 2쪽 | 시연 1대 실제 구매가(원) | §3-1 | HW(영수증) · SW(표) | 10/22 |  |
| K9 | 보고서 설치 시간 · 소개서 2쪽 | 처음 붙이기·재부착·처음 해 보는 사람 / 처음 해 보는 사람 설치 시간(분) | §3-2 | HW(1·2회차) · SW(3회차 진행) | 10/22 |  |
| K10 | 소개서 2쪽 '되는 것 / 아직인 것' | 캐리지·실제 누름·CT 판정·ThinQ 실가전 결과 한 줄 | K1~K5 요약 | SW | 10/23 |  |
| K11 | 두 서류 전체 | 남은 【기입】 정리(채우거나 문장째 지움)·숫자 대조 | K1~K10 결과를 서류로 옮기고 이 표·§4와 맞춤 | SW · 팀 검토 | 10/26 |  |

- 같은 서류의 【확인】 칸(개발 도구 사용 고지: 규정 조항, 원작 펌웨어 AI 사용 여부, 보드 명령 입회 여부)은 실측이 아니라 사람 확인이다 — 담당 **사용자(팀장 확인 포함)**, 목표일 10/21(제안). [고지 초안](submission/개발도구-사용-고지-초안.md) §3.
- 저장소 점검 칸(제출 체크리스트 G1~G11의 【기입】)은 서류 칸이 아니라 공개 저장소 점검이다 — 담당 SW, 목표일 10/27(제출 커밋 고정 전). [제출 체크리스트](submission/제출-체크리스트.md).
- 제출: 10/28(수) 14:00 구글폼, 제출은 사용자가 한다.
