Seongwonp/Simplelay/docs/인계-2026-10-26-노트북.md

# 인계 2026-10-26 노트북 — 공감지능 고도화 이어 하기

데스크톱(10/25 밤~10/26)에서 한 일과 노트북에서 이어 할 것. 자세한 기록은 [10/26 devlog](devlog/devlog_2026-10-26-desktop-empathy.md), 발표 근거는 [공감지능 근거 자료](발표/공감지능-근거-자료-2026-10-25.md)·[외부 조사](발표/공감지능-외부조사-2026-10-26.md). 모터·매핑·촬영은 [10/26 인계](인계-2026-10-26-모터-매핑-촬영.md).

## 1. 지금 보드에 올라가 있는 것 (RPi5 = main `803aa9cd` 이후, 키오스크·폰 에뮬레이터 같은 판)

- **말 알아듣기:** 폰 '말로 하기' → 기존 규칙이 모르면 본체 안 언어 모델(LG 공개 모델 2.4B, 부팅 자동 시작 `deploy/run_llm.sh`)이 정해진 동작 중 하나만 고름 → "공기청정기를 켤까요?" → 사람 '네'. 모델까지 가면 가운데값 약 10초·90%는 14초 안([평가](발표/언어모델-평가-2026-10-26.md)). 폰에서 말한 카드는 키오스크에도 60초 함께 뜸(먼저 정한 쪽만 실행).
- **습관 판단:** 시각이 가까운 것끼리 묶기, '오후 10시쯤'/'이맘때', 평일/주말·공휴일(천문연) 스스로 판단, 두 번 연속 거절·무반응 → 7일 쉼(10/26 저녁 변경, 예전 3일·하루 건너뜀), 아무도 없으면 +30분까지 기다렸다 한 번, '이미 했어요', 하루 묻는 횟수 상한 3.
- **알게 된 것 화면(폰·키오스크):** 습관별 평소 시각·근거·상태, 숨기기/다시 보이기, 밤 3시 언어 모델 생활 요약(검사 통과만).
- **여러 신호 제안·조언:** 불 끄면 수면 모드, 돌아왔을 때 공기, 황사 특보 대비, 환기 권유·창문 닫기 조언('알겠어요/괜찮아요', 가전 안 움직임). 없는 기기는 권하지 않음(에어컨 카드 문제 수리). 카드마다 '왜 지금' 칩(집에 계심·평소 오후 10시쯤·최근 28일 중 5일·평일 습관…). 읽어 주는 말은 이유+질문.
- **공공 데이터:** 기상청 예보(+바깥 습도)·특보, 에어코리아(가까운 측정소 실시간·예보), 천문연 공휴일·해 뜨고 짐, 생활기상지수 자외선. 모두 같은 공공데이터포털 키, 활용신청 완료.
- **사람 감지·방 밝기:** 부팅 자동 시작(`deploy/run_presence.sh`), 10분 쉬기/1시간 자리 비움(시험값 되돌림), 인사는 3시간+ 비웠을 때만 + 날씨 한 줄. 키오스크 화면 '밝게/어둡게/자동'(방 밝기, 불 끈 방 실측 4·모니터 빛 100~120·불 켬 130~170).
- RPi5 env 추가: `SIMPLELAY_LLM_URL`, `SIMPLELAY_ROOM_LIGHT_FILE`(백업 `env.bak-20261026-*`). RPi4는 꺼 둠 — 다음 배포 때 **같은 이미지**.

## 2. 정해 줄 것 / 남은 것

- 시연 날 묻는 횟수 상한 끄기 → [결선 운영 런북](결선-운영-런북.md) §3-2에 적음.
- 환기 기준값(실내 습도 70%·바깥과 10%p·3도·바깥 10도 이상)과 경기·강원 권역 나눔은 추측 — 실측으로 맞출 것.
- 심사위원 관점 평가(68점) 이후 반영: 신호 칩·거절 세분·평일 판단·상한·물러서기·바깥 공기·조언. **다시 평가 받기**가 다음 할 일.
- 남은 고도화 후보: LG 앱으로 직접 바꾼 상태 변화도 습관에 넣기, 연달아 하는 일 묶기, 발표 자료의 과장 표현 정리(devlog §7).

## 3. 크레딧 절약 규칙 (같은 계정 — 노트북에서도 그대로)

- 메인 세션은 **판단·검토·커밋·배포만**. 구현은 서브에이전트(Opus), 자료조사는 서브에이전트(Sonnet). 에이전트끼리는 **영어**, 보고는 결과만 짧게.
- 서브에이전트 지시문은 한 번에 자세히(파일·계약·게이트·금지 사항) — 다시 묻는 왕복을 줄인다. 서로 다른 폴더만 건드리는 일만 동시에.
- 기다리는 동안 상태를 들여다보지 않는다(끝나면 알림). 배포는 묶어서 한 번에.
- 큰 출력 금지: 시험은 `| tail -1`(단, analyze·시험 게이트는 실제 'All tests passed'·error 0을 확인), 로그는 grep으로 필요한 줄만.
- **Codex CLI(사용자 크레딧이 남아 있을 때):** `codex exec -m gpt-5.6-sol -s workspace-write`(격리 모드, 0.164 이상), 보드 접속이 필요하면 `-c sandbox_workspace_write.network_access=true`, 백그라운드면 **표준 입력을 닫는다**(`< /dev/null` — 안 그러면 입력을 기다리며 멈춘다). 격리를 끄는 `danger-full-access`는 우리 쪽 안전 설정이 막는다 — 필요하면 사용자가 Codex 데스크톱에서 직접.

## 4. 키오스크 빌드·확인 (노트북에도 빌드 환경이 있다고 함)

- 키오스크 설치 파일은 **저장소 밖 로컬 빌드 환경(도커)**에서 만든다 — 명령은 그 PC의 로컬 메모를 따른다(플랫폼 이름을 저장소에 쓰지 않는다).
- **빌드 도구는 실패해도 성공처럼 끝난다.** 빌드 뒤 로그에 'Build error'가 없는지, 설치 파일 시각이 방금인지 꼭 본다. 보드 빌드 환경 Flutter가 옛 판이라 새 API(예: `Switch.activeThumbColor`)는 거기서만 깨진다 — `WidgetStateProperty` 쓰기.
- **키오스크 화면 캡처:** `ssh root@<RPi5 주소> "sh /mnt/rawdata/simplelay/capture.sh" > panel.png` — 설치 뒤 꼭 캡처로 확인(노란 밑줄, 잘림, 옛 판이 그대로인지).
- 화면 선을 뺐다 꽂으면 키오스크가 화면에 안 나오고 HDMI 소리도 사라질 수 있다 — 앱 다시 시작, 안 되면 화면 선을 꽂은 채 재부팅.
- RPi5 공간이 좁다(언어 모델 1.6GB). 배포 때 `docker image prune -f`, 옛 날짜 태그 이미지는 바로 전 판만 남긴다.
