Seongwonp/Simplelay/docs/국내앱-UI-비교와-SimpleLay-적용안-2026-10-23.md

# 국내 앱 UI 비교와 SimpleLay 적용안

확인일: 2026-10-23. 대상: 폰·키오스크 정보 구조와 조작의 발견 가능성. 코드 수정 없이 조사했다.

## 먼저 적용할 결론

1. 홈에서는 관리 정보보다 지금 실행할 일을 먼저 찾게 한다. 실행 중 정지·차단 경고·제안의 우선순위는 유지한다.
2. 루틴은 설명문을 늘리기보다 실행·편집·자동 실행 설정의 차이를 배치와 행동 이름으로 드러낸다.
3. 같은 상태를 긴 본문·칩·보조 줄에서 반복하지 않는다. 미확인이라는 사실과 다음 행동은 남긴다.
4. 누르는 곳과 읽기만 하는 상태 표시를 구별한다. 작은 ‘편집’ 글씨나 버튼처럼 보이는 상태 칩을 피한다.
5. 아래 앱의 겉모양을 복제하지 말고, 팀 밖 사람이 설명 없이 과업을 끝내는지 확인한 뒤 적용한다.

## 조사 범위와 한계

- 국내에서 서비스하는 실제 앱 7개를 조사했다. 공공 가이드·논문 대신 운영사의 공개 안내, 앱스토어 공개 화면, 실무자의 사용자 관찰을 중심으로 봤다.
- **공개 화면을 브라우저에서 확인한 것과 설치된 앱을 직접 사용한 것은 다르다.** 로그인·송금·주문·기기 제어는 하지 않았다. 앱스토어 화면은 홍보용 예시이며 최신 배포 앱 전체를 대표하지 않는다.
- KB 자료는 2023년, ThinQ 개편 자료는 2025년 자료다. 현재 화면과 완전히 같다고 주장하지 않는다. SmartThings는 공식 기능 설명만 확인했으므로 세부 화면 배치를 관찰했다고 쓰지 않는다.
- ‘쉬워 보임’, ‘복잡해 보임’은 디자인 판단이다. 유명 앱이라는 이유로 고령자·저시력 사용자에게 쉽다고 결론 내리지 않는다. 시각장애인의 화면 읽기 경험은 이미지로 검증할 수 없다.
- SimpleLay의 현재 문제 근거는 [독립 UI 평가](UI-독립평가-2026-10-23.md)다. 아래 제안은 추가 수리를 마쳤다는 보고가 아니다.

## 실제 앱별 관찰과 가져올 것

| 앱·확인 자료 | 확인한 구성 | 가져올 원칙과 SimpleLay 적용 | 가져오지 않을 것 |
|---|---|---|---|
| **LG ThinQ** — [공식 홈 개편 안내](https://www.lge.co.kr/support/software-SW20250311463001), [공식 홈 이미지](https://static.lge.co.kr/kr/support/images/software/ThinQ/Notice/0311_tab/tab1.png), 2025-03-07 | 공개 이미지에서 집 지도, 즐겨 찾는 제품, 스마트 루틴과 하단 홈·디바이스 구획을 확인. 안내는 자주 쓰는 제품과 전체 기기 관리를 구분한다. | 일상 사용과 등록·관리를 나눈다. 우리 홈에서도 설정 안내·전체 가전보다 현재 제안과 실행할 루틴을 먼저 보이는 안을 검토한다. | 큰 집 지도, 서비스 모음, 작은 아이콘 전원 조작을 복제하지 않는다. 즐겨찾기 기능 신설도 이번 범위가 아니다. |
| **토스** — [한국 앱스토어 공개 화면](https://apps.apple.com/kr/app/토스/id839333328) | 공개 홈 예시에서 계좌 정보와 해당 계좌의 ‘송금’ 행동을 같은 행에서 찾을 수 있다. 서비스별 묶음이 나뉜다. | 루틴 행도 이름·조건과 해당 루틴의 ‘실행하기’를 연결한다. 편집은 구별되는 보조 행동으로 둔다. | 금융·쇼핑 서비스가 이어지는 슈퍼앱 구성, 작은 글씨·빽빽한 행을 복제하지 않는다. 토스 전체가 단순하다는 뜻이 아니다. |
| **당근** — [한국 앱스토어 공개 화면](https://apps.apple.com/kr/app/당근/id1018769995), [공식 서비스 설명](https://about.daangn.com/service/) | 앱스토어 홈 예시에서 사진·제목·가격 중심 세로 목록과 눈에 띄는 ‘+ 글쓰기’를 확인했다. 주변 서비스는 다른 구획에 있다. | 목록의 정보와 핵심 행동을 구별한다. 우리 루틴 목록은 행마다 같은 배지·범례·설명을 쌓기보다 이름·조건·실행을 우선한다. | 주황색 버튼이나 떠 있는 추가 버튼을 그대로 도입하지 않는다. 우리 앱의 주 과업은 글쓰기나 추가가 아니라 기존 루틴 실행이다. |
| **카카오 T** — [공식 활용 가이드](https://www.kakaomobility.com/kakaot/index.html), [공식 이동수단 비교 이미지](https://t1.kakaocdn.net/kakaomobility/company_website/contents/alpha/10-home-sub-7.png) | 공식 안내는 홈에서 목적지 입력으로 출발하도록 설명한다. 직접 연 이미지는 홈 전체가 아닌 이동수단 비교 화면이며, 같은 목적지에 시간·비용·수단을 묶어 보여 준다. | 시스템 기능 이름보다 사용자 목적을 앞세운다. ‘아침 데우기’ 아래 실행할 가전·동작을 붙여, 내부 제어 방식부터 배우지 않아도 되게 한다. | 새 검색창·교통수단식 아이콘 격자를 만들지 않는다. 화면 이미지에서 보이지 않은 호출 완료 흐름까지 평가하지 않는다. |
| **KB스타뱅킹 간편홈** — [공식 개편 안내](https://obank.kbstar.com/quics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), [공식 간편홈 이미지](https://oimg1.kbstar.com/img/ocommon/news/2023/0724_home_04.jpg), 2023-07-26 | 대표 계좌와 ‘이체’를 위에 두고, 아래에 자주 찾는 메뉴를 세로 행으로 배치한 공개 화면을 확인했다. 명칭은 ‘간편홈’이다. | 자주 하는 과업을 위로 올리고 설명보다 행동 이름을 쓴다. 키오스크도 현재 질문·선택·필요한 다음 행동을 먼저 보인다. | 간편 모드 전환이나 별도 홈을 새로 만들지 않는다. 메뉴 수를 줄인 것만으로 사용성이 검증됐다고 말하지 않는다. |
| **배달의민족** — [운영사 앱 광고·서비스 영역 안내](https://ceo.baemin.com/guide/12983) | 공개 홈 이미지에서 위치·검색, 쿠폰 안내, 음식배달·픽업 등 서비스 구획, 음식 분류를 확인했다. 안내는 첫 탭이 사용자별로 달라질 수 있다고 명시한다. | 사용자의 목적별 구획을 구별하는 방식만 참고한다. 우리 루틴도 직접 실행과 조건 자동 실행의 차이를 내부 구현 용어 없이 보여야 한다. | 쿠폰 배너·다수 분류·가로로 넘기는 서비스 메뉴는 우리 홈에 부적합하다. 이 앱은 ‘따라 하면 쉬운 UI’가 아니라 복잡성을 경계할 비교 사례이기도 하다. |
| **SmartThings** — [국내 공식 앱 안내](https://www.samsung.com/sec/smartthings/app/) | 공식 설명에서 집 상황과 추천을 다루는 홈 인사이트, 직접 조작인 빠른 리모컨, 자동화 루틴을 구분한다. 상세 화면의 시각적 배치는 이번 조사에서 검증하지 않았다. | 상태 보기·지금 직접 실행·앞으로의 자동 실행 허용을 다른 의도로 다룬다. 같은 ‘켜짐’ 표현만으로 이 세 가지를 설명하지 않는다. | 지도·새 센서 추론·새 자동화 기능을 추가하지 않는다. 운영사의 AI 소개를 우리 개인화 성능 근거로 인용하지 않는다. |

## 실제 국내 서비스의 사용자 관찰도 함께 볼 것

[토스: 시니어 사용자가 어려워하는 UX 5가지](https://toss.tech/article/senior-usability-research), 박서현, 2024-12-23.

운영사 UX 리서처가 대면 사용성 점검에서 관찰한 사례다. 글씨·화살표를 누를 수 있는지 모르는 경우, 태그를 버튼으로 오인하는 경우, 예시 내용을 실제 정보로 받아들이는 경우, 설명을 질문으로 읽는 경우, 아래 내용이 있다는 것을 모르고 스크롤하지 않는 경우를 다룬다. 글의 ‘시니어’는 50대 이상이며, 이를 우리 대상 사용자 전체의 결과로 일반화하지 않는다.

SimpleLay에 적용할 판단:

- ‘봐 주세요’ 칩이 행동이면 실제 버튼이어야 하고, 상태면 버튼처럼 보이지 않아야 한다.
- 화면 아래에 루틴이 있다는 사실을 모른다면 스크롤 기능이 있어도 충분하지 않다. 홈의 순서를 먼저 고친다.
- 연습 화면은 실제 실행과 구분되게 표시한다. 예시 가전과 실제 등록 가전도 혼동시키지 않는다.
- 실제 승인 질문은 유지한다. 도움말 진입점까지 질문형으로 만들 필요는 없다. ‘근거 전체 보기’처럼 행동을 명시한다.

## SimpleLay 화면별 최소 적용안

관련 줄 번호는 [독립 UI 평가](UI-독립평가-2026-10-23.md)의 평가 시점 기준이다. 변경 직전 다시 확인한다.

| 우선순위·화면 | 구체적인 배치·문구 방향 | 근거 사례 | 관련 코드 | 확인할 것 |
|---|---|---|---|---|
| 1 · 폰 홈 | 실행 중 상태·정지는 최우선. 평상시 제안이 있으면 먼저, 없으면 기존 실행 가능 루틴을 가전 목록보다 앞에 둔다. 환경·예약·설정 안내의 반복을 줄인다. 새 추천 순위는 만들지 않는다. | ThinQ의 사용/관리 구분, KB의 대표 과업 우선 | `app/lib/screens/home_screen.dart` | 일반 높이와 200%에서 실행할 루틴을 찾는가. 연결 실패·차단 경고가 밀리지 않는가. |
| 2 · 폰 루틴 | 이름 → 조건 → 해당 루틴 실행 순서. 편집은 보조 행동. 범례·배지·스위치 옆 같은 뜻의 문구가 겹치는지 정리한다. 내부 구획 이름 변경은 먼저 이해도를 확인한다. | 토스의 대상/행동 연결, 당근의 목록 위계 | `app/lib/screens/routines_screen.dart` | ‘오늘만 실행하지 않기’와 ‘앞으로 자동 실행 끄기’를 구별하는가. 두 개념을 합치지 않는다. |
| 3 · 가전 상세 | 빈 루틴 안내와 저장 버튼을 세로로 배치해 ‘없/어요’ 줄바꿈을 없앤다. 사진 조작을 주 경로, 버튼판을 보조로 구분하되 접근성 대체 경로는 유지한다. | KB의 세로 메뉴, 토스 관찰의 클릭 가능성 | `app/lib/screens/appliance_detail_screen.dart` | 200%에서 이름·실행·저장이 읽히고, 보조 경로도 찾을 수 있는가. |
| 4 · 승인·기록 | 같은 대상·실행 설명의 반복을 줄인다. 기록은 무엇을 함 → 결과 → 필요한 다음 행동. ‘확인하지 못했어요’를 실패나 성공으로 바꾸지 않는다. | 토스의 정보 묶음, 카카오 T의 목적 중심 묶음 | `app/lib/screens/suggestion_screen.dart`, `app/lib/screens/history_screen.dart` | 사용자에게 ‘실제로 됐다는 뜻인가요?’를 물어 확인 수준을 오해하지 않는지 본다. |
| 5 · 키오스크 결과·비상 안내 | 지금 해야 할 행동 하나를 먼저 보여 준다. 본문과 상단 공통 띠 모두 연습/실제를 구분한다. 전자레인지에 모호한 ‘움직이는지’ 대신 실제 확인 대상에 맞는 문구를 쓴다. | KB의 과업 우선, 토스의 예시/실제 혼동 관찰 | `rpi5-touchscreen-app/lib/widgets/kiosk/done_view.dart`, `estop_banner.dart`, `hold_view.dart` | 촬영 거리에서 결과와 다음 행동을 읽는가. 실제 결과를 확인했다고 과장하지 않는가. |
| 6 · 폰 설정 | 공통 연결 문제와 각 메뉴의 같은 오류 설명이 반복되지 않도록 위계를 정리한다. 모르는 값을 ‘꺼짐’으로 바꾸지는 않는다. | ThinQ의 관리 분리 | `app/lib/screens/settings_screen.dart` | 공통 오류가 있어도 설정 메뉴를 찾는가. 인증 실패와 미설정을 혼동하지 않는가. |

위 내용은 정보 구조·배치·문구 정리다. 4탭과 기존 팔레트, 승인·정지 정책을 유지한다. 새 즐겨찾기·검색·간편 모드·푸시·알람은 추가하지 않는다. 승인이나 중요한 제한을 ‘더 보기’에 숨겨 탭 수만 줄이지 않는다.

## 앱을 참고한 뒤 실제 사람에게 확인할 최소 과업

팀 밖 처음 쓰는 사람 3~5명의 짧은 점검을 권한다. 가능하면 고령 사용자를 포함하되, 이 인원으로 전체 사용자에 대한 성능을 주장하지 않는다. 먼저 정답 경로나 메뉴 이름을 알려 주지 않는다.

| 과업으로 말할 것 | 기록할 관찰 | 통과 판단 방향 |
|---|---|---|
| ‘즉석밥을 데우려고 해요. 시작해 주세요.’ | 첫 누름, 되돌아감, 도움 요청, 승인 대상 설명 | 스스로 루틴을 찾아 무엇이 실행되는지 설명하고 승인하는가. |
| ‘방금 시작한 작업을 멈추고 싶어요.’ | 정지 위치 발견, 잘못 누름, 정지 결과 해석 | 정지를 찾고 ‘요청’과 ‘멈춤 확인’을 구별하는가. 모의로만 진행하며 실제 시간 보장은 별도다. |
| ‘오늘은 하지 않고 싶어요. 내일부터는 계속되면 좋겠어요.’ / 별도로 ‘앞으로도 자동으로 하지 않았으면 해요.’ | 두 과업에서 고른 조작, 범위에 대한 설명 | 일시 건너뛰기와 자동 실행 끄기를 혼동하지 않는가. 실제 제공되는 경로로 점검하고 없는 기능은 만들지 않는다. |
| ‘어제 한 일이 제대로 됐는지 알아봐 주세요.’ | 기록 찾기, 결과 읽기, 미확인 해석 | 버튼 조작과 실제 가전 반응을 구별하는가. |

처음 시도 뒤에만 ‘무엇을 누를 수 있다고 생각했나요?’, ‘이 결과가 무슨 뜻인가요?’를 묻는다. 전후 비교 시 과업·데이터·화면 크기를 맞추고 학습 효과를 기록한다. 팀원이 설명해서 성공한 경우를 독립 성공으로 세지 않는다.

골든은 배치 회귀를 잡는 도구다. 위 과업 성공·실폰 터치·TalkBack 낭독·실패널 가독성을 대신하지 않는다. 키오스크는 별도로 실제 촬영 거리에서 관찰한다.

## 출처와 확인 수준 목록

1. [LG ThinQ 홈 개편 공지](https://www.lge.co.kr/support/software-SW20250311463001) — 안내와 [홈 공개 이미지](https://static.lge.co.kr/kr/support/images/software/ThinQ/Notice/0311_tab/tab1.png) 확인.
2. [토스 한국 앱스토어](https://apps.apple.com/kr/app/토스/id839333328) — 공개 스크린샷 확인. 설치 앱 사용 아님.
3. [당근 한국 앱스토어](https://apps.apple.com/kr/app/당근/id1018769995) — 공개 스크린샷 확인. [당근 서비스 소개](https://about.daangn.com/service/)는 서비스 설명 보조 자료이며 생활 사진을 앱 화면으로 판정하지 않았다.
4. [카카오 T 활용 가이드](https://www.kakaomobility.com/kakaot/index.html) — 설명과 [이동수단 비교 공개 이미지](https://t1.kakaocdn.net/kakaomobility/company_website/contents/alpha/10-home-sub-7.png) 확인.
5. [KB스타뱅킹 홈 개편 안내](https://obank.kbstar.com/quics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) — 2023년 자료. [간편홈 공개 이미지](https://oimg1.kbstar.com/img/ocommon/news/2023/0724_home_04.jpg) 확인.
6. [배달의민족 앱 광고·서비스 영역 안내](https://ceo.baemin.com/guide/12983) — 운영사 설명과 페이지의 공개 홈 이미지 확인.
7. [SmartThings 국내 공식 앱 안내](https://www.samsung.com/sec/smartthings/app/) — 기능 구분 설명 확인. 세부 화면의 직접 시각 검토는 하지 않음. [국내 서비스 소개](https://www.samsung.com/sec/smartthings/)는 보조 설명.
8. [토스: 시니어 사용자가 어려워하는 UX 5가지](https://toss.tech/article/senior-usability-research) — 운영사 실무 관찰, 2024-12-23. 학술 논문·우리 사용자 시험 결과가 아님.

본문의 각 앱 사실은 해당 출처 범위로 제한했다. SimpleLay 적용안과 우선순위는 이 조사와 기존 독립 평가를 바탕으로 한 설계 판단이며 사용자 검증 결과가 아니다.
