Seongwonp/Simplelay/docs/UI-마감-수정계획-2026-10-22.md

# 폰·키오스크 UI 마감 수정 계획 (2026-10-22)

상태: **계획만 작성. 화면·코드 변경 및 구현 시험은 아직 하지 않았다.** 시험 종료 후 이 문서의 1단계부터 이어서 작업한다.

**2026-10-23 재개:** 아래는 최초 계획이다. 기록 조회 상태 구분, 실제 가전 안내, 자동 조건과 시각 루틴 위치 안내, 미확인 말투 정리를 구현 중이다. 실행·정지·안전 정책은 변경하지 않는다. [실제 변경·시험·미검증 범위](devlog/devlog_2026-10-23-ui-filming.md)를 함께 본다. 실패널·실폰·사용자 과업을 완료했다는 뜻은 아니다.

말투 작업은 [한국어 UI 말투 조사와 적용안](한국어-UI-말투-조사와-적용안-2026-10-22.md)을 함께 전달한다. 한국어 공식 실무 자료 4건과 국내 논문 3편, 실제 문자열별 교체 후보, 기존 말투 정책과 충돌하는 부분을 구분해 정리했다. 논문은 공개 초록 범위이며 본문 검토로 주장하지 않는다.

## 1. 목표와 판단 범위

- 기준 트리: `adcbfbf2`. 작업을 재개할 때 HEAD와 미커밋 변경을 확인하고, 아래 파일·문구가 그대로인지 다시 찾는다. 줄 번호는 기준 트리에서 확인한 위치이며 이후 달라질 수 있다.
- 목표: 처음 쓰는 사람이 **어디를 눌러야 하는지, 무엇이 자동인지, 무엇을 확인했는지** 혼동하지 않게 한다. 팔레트 전면 교체·4탭 변경·새 기능 추가는 하지 않는다.
- 제출 마감: **10/28 14:00**. 하드웨어 통합·실제 누름·시연 촬영 시간을 먼저 확보한다. UI는 아래 필수 항목을 작게 고친 뒤 사용자 확인으로 마감한다.
- 이번 평가는 10/19~20 저장소 캡처와 최신 골든 18장, 관련 코드에 근거한다. 폰 캡처는 실제 허브에 연결한 **에뮬레이터**이고, 키오스크 캡처는 실제 패널에서 얻은 화면이다. 이번 검토자가 직접 터치·거리별 가독·TalkBack 낭독을 시험한 것은 아니다.
- 폰 78점·키오스크 84점은 화면 검토자의 주관적 평가다. 전체 작품 점수나 사용자 시험 결과로 인용하지 않는다. ‘AI스럽다’는 인상의 원인은 확정된 사실이 아니라 **설명 중복·조작 위계 혼동이 남았다는 디자인 판단**이다.

## 2. 작업 시작 전 읽기

1. [작업 규칙](../CLAUDE.md): 현재 상태·검증 한계·수정 전 실패 확인·검사 게이트.
2. [UX 문구 기준](UX-문구-기준-2026-10-19.md): 특히 R6(모르는 사실), R7(확인 의미), R9(같은 이름), R12(상태와 설명 말투).
3. [결선 전 SW 보완 기준](결선전-SW-보완-피드백.md), [UI 적용 기준](UI-참고자료와-적용기준.md), [사용자 편의 체크리스트](사용자편의-가이드-체크리스트.md).
4. [키오스크 디자인 규격](키오스크-디자인-규격-계획-2026-10-15.md), [남은 UI 문제](UI-남은-손볼점-2026-10-18.md), [제품 레퍼런스](ui-product-app-references.md).
5. [시연 v4](본선-시연-계획-v4.md), [제출 그림 대응표](submission/그림-대응표.md): 모의·실물·에뮬레이터·골든을 혼동하지 않는다.

## 3. 우선순위와 구현안

### 1단계 — 기록 없음과 조회 실패 구분 (필수, S~M)

**확인한 사실:** 가전 상세의 `_TodayUse`는 `historyProvider.valueOrNull ?? []`로 로딩·오류를 빈 목록과 합친다. 빈 목록에는 ‘오늘은 아직 사용하지 않았어요’라고 표시한다. 가전 자체에서 직접 한 조작까지 추적한다는 근거도 없다.

- 코드: [appliance_detail_screen.dart](../app/lib/screens/appliance_detail_screen.dart), 기준 418·434~435줄.
- 시험: [appliance_detail_test.dart](../app/test/screens/appliance_detail_test.dart).
- 변경: 로딩 / 조회 실패 / 정상 조회했지만 해당 기록 없음 / 기록 있음의 네 상태를 나눈다. 재조회 중에는 이전 기록이 유효한지와 최신 조회 실패 여부를 구분하고, 오류를 ‘사용 없음’으로 바꾸지 않는다.
- 문구 후보: 로딩 ‘기록을 불러오고 있어요’, 오류 ‘기록을 불러오지 못했어요’, 정상 빈 목록 ‘오늘 SimpleLay에 남은 기록이 없어요’. 최신 제품 용어와 길이를 확인해 확정한다.
- ‘새로 보기’가 필요하면 기존 조회 갱신 경로를 사용한다. 서버 계약·기록 보관 범위는 바꾸지 않는다.
- **수정 전 실패 확인:** 조회 오류·로딩에서 ‘오늘은 아직 사용하지 않았어요’가 나오지 않아야 한다는 위젯 시험을 먼저 쓴다. 현재 코드에서 실패함을 기록한 뒤 수정한다.
- 완료 조건: 네 상태가 구별되고 가전별 필터가 유지된다. SimpleLay 밖의 조작을 ‘안 했다’고 단정하지 않는다.

### 2단계 — 키오스크에서 화면 그림과 실제 가전 구분 (필수, M)

**확인한 사실:** 정지 미확인 골든은 ‘취소 버튼을 손으로 눌러 주세요’ 옆에 실제 조작부와 닮은 노란 취소 칸을 보여 준다. 캡션은 ‘직접 누를 버튼이에요’다. 사용자가 그 그림을 누를 수 있다고 생각할 가능성은 **사용성 추정**이며 아직 사람에게 시험하지 않았다.

- 코드: [hold_view.dart](../rpi5-touchscreen-app/lib/widgets/kiosk/hold_view.dart), 기준 221·418줄. 공통 그림은 [panel_picture.dart](../rpi5-touchscreen-app/lib/widgets/kiosk/panel_picture.dart).
- 시험 출발점: [kiosk_redesign_panel_test.dart](../rpi5-touchscreen-app/test/kiosk_redesign_panel_test.dart). 기존 hold·비상정지 시험도 찾아 관련 경우를 추가한다.
- 변경: 사람이 취소를 눌러야 하는 상태에만 ‘실제 전자레인지에서 취소를 눌러 주세요’처럼 **대상과 장소**를 명시한다. 이름을 코드에 고정하지 않고 현재 대상 가전 이름·실제 취소 버튼 이름으로 만든다. 버튼 정보가 없으면 이름을 지어내지 않는다.
- 그림은 위치 설명용으로 유지하되 실제 화면 조작과 시각적으로 구분한다. 캡션·비대화형 Semantics를 우선 확인하고, 터치 가능한 단추처럼 보이는 강조는 골든과 사용자 확인으로 조정한다.
- **정지 버튼의 자리·크기·처리 경로는 유지한다.** 미확인 상태에서 정지를 숨기거나 비활성화하지 않는다. 서버가 모르는 정지 결과를 화면만으로 성공 처리하지 않는다.
- **수정 전 실패 확인:** 해당 상태에서 ‘실제 가전’ 안내가 있고 버튼판의 각 칸이 실행 가능한 버튼으로 접근성 트리에 노출되지 않는지 시험한다. 기존에 만족하는 조건은 ‘기존 통과’, 새 안내가 없어 실패하는 조건은 ‘수정 전 실패’로 구분한다.
- 완료 조건: 정지 미확인·비상정지·일반 실행·연습 각각에서 안내가 실제 동작과 맞는다. 1~2m 거리와 큰 글씨에서도 핵심 행동·정지가 보인다.

### 3단계 — 루틴에서 자동 실행을 찾는 비용 줄이기 (필수 검토, M)

**확인한 사실:** ‘내 루틴’ 안의 시각 루틴에도 자동 스위치가 있고 별도 ‘자동으로 하기’ 탭도 있다. 후자는 독립 규칙 목록이다. 둘의 차이를 사용자가 이해할지는 **미검증**이다.

- 코드: [routines_screen.dart](../app/lib/screens/routines_screen.dart), 기준 118~147·677~678줄. 다음 회차 조작은 [skip_next_control.dart](../app/lib/widgets/skip_next_control.dart).
- 시험: [routines_screen_test.dart](../app/test/screens/routines_screen_test.dart), [skip_next_test.dart](../app/test/screens/skip_next_test.dart).
- 먼저 팀 밖 사람에게 ‘매일 저녁 켜지는 공기청정기를 오늘만 건너뛰기’와 ‘계속 자동으로 켜지지 않게 하기’를 시킨다. 서로 다른 동작임을 이해하는지 기록한다.
- 최소 변경안: 현재 목록·분류·서버 연결은 유지한다. 시각 루틴과 상황 조건 규칙이 어느 목록에 있는지 **각 목록에서 짧게 설명**한다. 범례를 더 늘리는 해결은 피한다.
- 행은 ‘이름 → 언제 → 자동 여부 → 지금 하기’ 순서로 읽히게 한다. 같은 정보를 배지·스위치·범례가 반복하는 곳만 줄인다. ‘다음’은 다음 예정 표시라는 뜻을 보존한다.
- ‘자동’ 스위치와 루틴 전체 켜기 스위치가 같은 역할처럼 읽히지 않도록 실제 스위치 대상에 맞는 화면 읽기 이름을 유지한다.
- 탭 이름 변경·자동 목록 통합은 **사용자 결정이 필요한 후속안**이다. 이번 승인으로 구조 개편까지 확정된 것은 아니다. 짧은 안내로 혼동이 풀리면 현 구조를 유지한다.
- 회귀 시험: 예약·자동 켜짐·자동 꺼짐·오늘만 건너뜀·연결 실패·독립 규칙 없음·큰 글씨. 실행은 기존 승인 경로를 거치고, 표시 정리로 API 호출 수가 늘지 않는다.
- 완료 조건: 네 과업 중 ‘자동 실행 끄기’를 설명 없이 찾고, ‘오늘만 건너뛰기’와 구분한다. 사람 시험 전에는 성공으로 적지 않는다.

### 4단계 — 문구 중복 정리 (여유 있을 때, S)

| 현재/문제 | 수정 방향 | 코드 |
|---|---|---|
| ‘LG 가전이라 누를 버튼이 없어요’ | 실제 가전에 버튼이 없다는 뜻으로 읽힐 수 있다. ‘누름 장치 없이 여기서 조작해요’ 계열로 기능을 설명한다. 같은 안내가 수동 화면에도 있는지 확인한다. | [가전 상세](../app/lib/screens/appliance_detail_screen.dart), 기준 108줄 · [수동 조작](../app/lib/screens/manual_control_screen.dart), 기준 332줄 |
| ‘바뀐 걸 봤어요’ 반복 | 기존 결과별 데이터 매핑을 유지하고 실제 속성·값을 아는 경우에만 짧게 표현한다. 전 값을 모르면 ‘바꿨어요’로 올리지 않는다. | [폰 결과 표시](../app/lib/models/display_status.dart) · [키오스크 결과](../rpi5-touchscreen-app/lib/models/thinq_run.dart) |
| ‘오늘은 건너뛰기’가 상태 문구처럼 보임 | 기존 사용자 결정은 작은 회색 글자다. 우선 누르는 자리·화면 읽기·사용자 발견 여부를 확인한다. 테두리·밑줄 등 시각 변경은 사용자와 결정한다. | [대기 화면](../rpi5-touchscreen-app/lib/widgets/kiosk/idle_view.dart), 기준 952줄 |
| 제목·띠·부제가 같은 결과 반복 | 결과 한 줄과 다음 행동 한 줄을 우선한다. 확인 수준·모의 표시는 빼지 않는다. | [결과 화면](../rpi5-touchscreen-app/lib/widgets/kiosk/done_view.dart) |

이전 구두 평가의 ‘버튼 눌림 미확인’은 **짧은 상태 배지의 후보**다. 일반 설명 문장 전체를 기술 명사로 바꾸는 지시가 아니다. 기존 R12와 맞춰 설명은 자연스러운 해요체로 유지한다. **사용자 결정(2026-10-22): 미확인 결과의 ‘몰라요’는 ‘확인하지 못했어요’로 바꾼다.** 폰·키오스크·음성 안내·화면 읽기를 함께 점검하며, 기존 문구 기준 R6보다 이 결정을 우선한다. 미확인을 ‘실패’로 바꾸지는 않는다. 승인·정지·모의·실제 구분은 문구 간소화보다 우선한다.

### 5단계 — 대기 화면의 날씨·시계 비중 (이번에는 보류)

큰 시계·날씨를 일괄 축소하지 않는다. 대기 중 생활 정보가 중심인 것은 제품 선택으로 성립한다. 제안·실행·위험이 생기면 그 과업이 우선하고, 자동 실행 결과 한 줄이 정지나 주요 안내를 가리지 않는지만 확인한다. 캡처의 빈 공간 자체를 결함으로 간주해 카드를 추가하지 않는다.

## 4. 검증 순서와 실제 사용자 과업

### 코드·화면 검사

1. 관련 시험을 먼저 추가하고 수정 전 실패를 확인한다. 이미 통과하는 경우는 결함을 발견했다고 쓰지 않는다. 실패 확인을 위해 사용자 변경을 지우거나 stash하지 않는다.
2. 폰 **360×780dp**, 글씨 1.0·2.0에서 홈·루틴·가전 상세·승인·결과를 확인한다. 큰 글씨에서 세로 스크롤은 허용하되 고정 영역이 본문·행동 버튼을 가리면 안 된다.
3. 키오스크 기준 해상도와 큰 글씨 골든에서 정지 미확인·비상정지·실행·연습·결과를 확인한다. 정지 위치와 크기를 바꾸지 않는다.
4. TalkBack은 읽는 이름·순서·선택 상태·실행 중 정지·화면 닫은 뒤 초점을 실제로 확인한다. Semantics 위젯 시험 통과를 실제 낭독 확인으로 적지 않는다.
5. 폰 조작 대상은 **48dp 이상**을 기준으로 확인한다. 키오스크는 실제 패널의 물리적 크기와 1~2m 가독을 별도로 확인한다. 폰 dp와 키오스크 캔버스 픽셀을 같은 기준으로 취급하지 않는다.
6. 변경한 골든은 **눈으로 먼저 확인한 뒤** 갱신한다. 화면 읽기·동작 시험과 골든 비교는 서로 대신하지 않는다.

### 팀 밖 사람에게 시킬 네 과업

| 과업 | 성공 기준 | 기록할 것 |
|---|---|---|
| ‘30초 데우기’를 실행해 보세요 | 홈/루틴 → 승인 → 실행을 찾는다. 시험은 안전한 모의 환경 또는 준비된 감독 환경에서 한다. | 첫 선택·도움 횟수·잘못 누른 곳·완료 시간 |
| 실행 도중 멈춰 보세요 | 정지를 찾고 정지 요청과 확인 결과를 구분한다. | 정지 발견 시간·누른 위치·결과 해석 |
| 저녁 공기청정기가 계속 자동으로 켜지지 않게 해 보세요 | 자동 실행을 끈다. 오늘 한 번만 건너뛰기와 구별한다. | 탭 왕복·스위치 선택·설명 필요 여부 |
| 어제 실패한 실행을 찾아 무슨 일이었는지 알려 주세요 | 해당 기록과 다음 행동을 이해한다. | 오해한 단어·성공/미확인 혼동·도움 여부 |

- 처음 1~2명은 **형성적 사용성 점검**이다. 고령자·시각장애인 전체의 사용성 검증이나 통계적 성능 비교로 주장하지 않는다.
- 가능한 경우 ‘실제 가전에서 취소를 누르세요’ 화면도 별도 보여 주고 **화면과 실제 가전 중 어디를 누를지** 물어본다. 화면의 버튼판을 누르면 혼동 사례로 기록한다.
- 목표는 도움 없이 핵심 과업을 끝내고 위험한 대상을 혼동하지 않는 것이다. 참가자가 막힌 곳을 먼저 고치고 주관적 점수를 반복해서 올리는 작업은 멈춘다.

### 구현 뒤 실행할 검사 (아직 미실행)

- 폰 수정 시: `app/`에서 `flutter test --exclude-tags screenshot`, `flutter analyze`(error·warning 0), 골든 비교.
- 키오스크 수정 시: `rpi5-touchscreen-app/`에서 같은 검사. 변경 골든 갱신 후 다시 비교한다.
- 루트: `rpi/tests/test_repo_guard.py`, `rpi/tests/test_doc_links.py`. Windows는 `PYTHONUTF8=1`, ASCII 임시 경로를 사용한다.
- 서버 계약을 바꾸지 않는 범위다. 서버 변경이 필요하면 UI 작업에 섞지 말고 이유·범위를 먼저 보고한다.
- 작업 기록에는 수정 전 실패, 최종 통과 수(골든 포함 여부), 종료 코드, 직접 연 화면, 미검증 항목을 구분한다. 배포 후 실제 빌드 SHA를 기록한다.

## 5. 참고 링크와 적용할 부분

외부 지침은 설계 참고이며 접근성 인증이나 사용성 성능의 증거가 아니다. 확인일 2026-10-22.

| 자료 | 이번에 참고할 부분 |
|---|---|
| [Android: 접근성 있는 앱 만들기](https://developer.android.com/guide/topics/ui/accessibility/views/apps-views) | 조작 대상의 최소 48×48dp 권장. 작은 편집·더 보기·건너뛰기에서 실제 포커스/터치 영역 확인 |
| [WCAG 2.2: Target Size (Minimum)](https://www.w3.org/WAI/WCAG22/Understanding/target-size-minimum) | 웹 기준 최소 24×24 CSS px와 예외·간격 규칙. Android 48dp와 같은 수치라고 혼동하지 않기 |
| [WCAG 2.2: Status Messages](https://www.w3.org/WAI/WCAG22/Understanding/status-messages.html) | 상태 변화를 시각 표시뿐 아니라 보조기술에도 전달하는 원칙. Flutter Semantics·실제 낭독 점검에 참고 |
| [Apple HIG: Writing](https://developer.apple.com/design/human-interface-guidelines/writing) | 중요한 정보 우선, 쉬운 말, 행동을 예상할 수 있는 버튼, 여러 단계에서 일관된 표현 |
| [Apple HIG: Design principles](https://developer.apple.com/design/human-interface-guidelines/design-principles/) | 짧은 표현·명확한 위계·알아볼 수 있는 조작 요소. 정보를 숨기는 것과 단순화를 혼동하지 않기 |
| [기존 한국어 문구 조사](UX-문구-기준-2026-10-19.md) | 토스·국내 디자인 지침 링크. 기존 제품 말투와 충돌하지 않게 적용 |
| [허브 화면 레퍼런스](허브-화면-레퍼런스-2026-10-18.md) | 대기 화면의 시계·생활 정보와 적극적인 조작 화면을 나누는 이유 |

## 6. 재개할 때 전달할 지시문

> 이 문서와 최신 CLAUDE.md를 먼저 읽고 현재 HEAD·작업 트리를 확인한다. 1단계(기록 로딩/실패/없음 구분) → 2단계(실제 가전 버튼 안내) → 3단계(루틴 자동 실행 발견성)의 순서로 작게 진행한다. 코드 변경은 이번 문서 작성에 포함되지 않았다. 수정 전 실패 확인 뒤 구현하고, 기존 승인·정지·자동 실행 정책과 팔레트·4탭을 유지한다. 탭 이름 변경과 ‘오늘은 건너뛰기’의 시각 변경은 기존 사용자 결정을 확인한 뒤 제안한다. 범위를 넓히지 말고 하드웨어·촬영 시간을 우선한다. 커밋·push 여부는 재개 시 사용자 지시를 따른다.
