Seongwonp/Simplelay/docs/환경변수.md

# 환경 변수 (`SIMPLELAY_*`)

코드가 읽는 `SIMPLELAY_*` 환경 변수의 **이름·보드·기본·읽는 곳** 목록이다(2026-10-15, 기준 커밋 `55d2a06`).
**값은 적지 않는다** — 키·토큰·주소 같은 실제 값은 보드의 env 파일(저장소 밖)에만 둔다.

- **세는 법:** `rpi/`·`rpi4/`·`deploy/`의 추적 중인 코드(시험 제외)에서 이름을 모았다. 구체 이름 **192개**(기준 커밋 189개 + 10/15 저녁
  `SIMPLELAY_THINQ_MOCK_AIR_SENSOR_ALWAYS` + 10/16 G5 생존 신호 `SIMPLELAY_LINK_HEARTBEAT_S`·`SIMPLELAY_LINK_HEARTBEAT_TIMEOUT_S`) + 이름을 조립하는 형식 4개
  (`SIMPLELAY_CYCLE_<가전>_<항목>` 등). 그중 **52개**는 이 문서 말고는 어떤 추적 문서(md)에도 이름이 나오지 않는다(표의 '다른 문서' 칸 **없음**).
  대부분 센서 판정 기준값·모션 기구값·D-Bus 이름·키오스크 감시처럼 코드 머리말에만 설명이 있는 것이다.
- **보드:** RPi5 = 허브 백엔드(`rpi/main.py`), RPi4 = 실행기(`rpi4/act_main.py`), 양쪽 = 두 보드 env에 같이 둔다.
  `rpi/controller`·`rpi/verifier`의 값은 폴더가 `rpi/`여도 **RPi4 실행기가 읽는다**([코드 구조](코드-구조.md) §0).
- **기본:** 코드에 적힌 기본값. `—`는 고정 기본이 없다는 뜻이다 — 비우면 그 기능이 꺼지거나(모의·기록 안 함), 실물 경로가 필요한 값이면
  그 동작을 거절한다(예: 모션 기구값은 전부 `None`으로 시작해 실측 전에는 이동·누름을 거절). 정확한 처리는 '읽는 곳'의 코드를 본다.
- **읽는 곳:** 값을 읽는 줄 또는 이름 상수를 정의한 줄(`파일:줄`, 기준 커밋). 줄 번호는 코드가 바뀌면 어긋난다 — 이름으로 다시 찾는다.
- **배포:** env 파일 위치·백업 규칙은 [deploy/README](../deploy/README.md)와 [결선 운영 런북](결선-운영-런북.md).
  운영 주의(키 없음 → LAN 401, 링크 키 없음 → 기동 거절, `SIMPLELAY_L3_MODE=real`은 콘센트 모듈 필요)는 작업 규칙 문서와 같다.
- **측정 필요:** 센서 판정 기준(§ 센서 판정 기준)과 모션 기구값의 기본은 **설계 초기값**이고 실측값이 아니다.

이 표는 손으로 만든 목록이라 코드와 어긋날 수 있다. 다시 만들 때는 `rpi/`·`rpi4/`·`deploy/`에서
`SIMPLELAY_[A-Z0-9_]+`를 찾아 시험 폴더를 빼고 대조한다.

### 인증·폰 연결·화면 출처

| 변수 | 보드 | 기본 | 읽는 곳 | 다른 문서 |
| --- | --- | --- | --- | --- |
| `SIMPLELAY_API_KEY` | RPi5 | 없음 → 루프백만 | `rpi/api/auth.py:48` | 있음 |
| `SIMPLELAY_ALLOW_UNAUTHENTICATED` | RPi5 | 꺼짐 | `rpi/api/auth.py:49` | 있음 |
| `SIMPLELAY_KIOSK_ORIGINS` | RPi5 | localhost·127.0.0.1·[::1]의 8000 | `rpi/api/auth.py:62` | 있음 |
| `SIMPLELAY_PAIR_HOST` | RPi5 | — | `rpi/api/pairing.py:36` | 있음 |
| `SIMPLELAY_KIOSK_WEB_DIR` | RPi5 | 저장소 옆 kiosk-web/ | `rpi/main.py:240` | **없음** |

### 개발자 API(/dev)

| 변수 | 보드 | 기본 | 읽는 곳 | 다른 문서 |
| --- | --- | --- | --- | --- |
| `SIMPLELAY_DEV_MODE` | RPi5 | 꺼짐(/dev 전부 404) | `rpi/api/deps.py:553` | 있음 |
| `SIMPLELAY_DEV_TOKEN` | RPi5 | 없음 → 닫힘 | `rpi/api/dev_router.py:71` | 있음 |
| `SIMPLELAY_DEV_REAL_MOTION` | RPi5 | 꺼짐(모의) | `rpi/services/dev_real_motion.py:34` | 있음 |
| `SIMPLELAY_DEV_REAL_MAX_STEP_MM` | RPi5 | 1 | `rpi/services/dev_real_motion.py:35` | 있음 |

### RPi5↔RPi4 링크·세션 기록·사건 시계

| 변수 | 보드 | 기본 | 읽는 곳 | 다른 문서 |
| --- | --- | --- | --- | --- |
| `SIMPLELAY_ACT_MODE` | RPi5 | local | `rpi/services/controller_factory.py:48` | 있음 |
| `SIMPLELAY_UART_PORT` | 양쪽 | /dev/ttyAMA0 | `rpi/services/controller_factory.py:53` | 있음 |
| `SIMPLELAY_UART_BAUD` | 양쪽 | 115200 | `rpi/services/controller_factory.py:54` | 있음 |
| `SIMPLELAY_UART_BASE_TIMEOUT` | RPi5 | 30 | `rpi/services/act_client.py:136` | 있음 |
| `SIMPLELAY_UART_PER_BUTTON_TIMEOUT` | RPi5 | 6 | `rpi/services/act_client.py:107` | **없음** |
| `SIMPLELAY_UART_REHEARSAL` | RPi5 | — | `rpi/api/router.py:1659` | 있음 |
| `SIMPLELAY_LINK_KEY` | 양쪽 | 없음 → uart 허브·실행기 기동 거절 | `rpi/services/link_auth.py:36` | 있음 |
| `SIMPLELAY_LINK_AUTH` | 양쪽 | 켬(off_for_mock은 모의 전용) | `rpi/services/link_auth.py:56` | 있음 |
| `SIMPLELAY_LINK_ALLOW_FROM` | RPi4 | — | `deploy/run_act.sh:69` | 있음 |
| `SIMPLELAY_LINK_HEARTBEAT_S` | RPi5 | 1(0.2~5, 끌 수 없음 — 추측값, 측정 필요) | `rpi/services/link_heartbeat.py:32` | 있음 |
| `SIMPLELAY_LINK_HEARTBEAT_TIMEOUT_S` | RPi4 | 3(1~30, 적어도 주기×3 — 추측값, 측정 필요) | `rpi/services/link_heartbeat.py:36` | 있음 |
| `SIMPLELAY_ACT_DEVICES` | RPi4 | — | `deploy/run_act.sh:48` | 있음 |
| `SIMPLELAY_SESSION_LOG_PATH` | RPi5 | 없음 → 기록 안 함 | `rpi/services/link_tap.py:43` | 있음 |
| `SIMPLELAY_SESSION_LOG_MAX_BYTES` | RPi5 | 20 MiB | `rpi/services/link_tap.py:44` | 있음 |
| `SIMPLELAY_SESSION_LOG_BACKUPS` | RPi5 | 5 | `rpi/services/link_tap.py:45` | 있음 |
| `SIMPLELAY_TWIN_REPLAY_DIR` | RPi5 | — | `rpi/services/link_tap.py:46` | 있음 |
| `SIMPLELAY_EVENT_CLOCK_REF_MAX_AGE_S` | RPi5 | 600 | `rpi/services/event_clock.py:50` | 있음 |
| `SIMPLELAY_EVENT_CLOCK_DRIFT_PPM` | RPi5 | 500 | `rpi/services/event_clock.py:51` | 있음 |
| `SIMPLELAY_EVENT_CLOCK_MAX_UNCERTAINTY_S` | RPi5 | 1 | `rpi/services/event_clock.py:52` | 있음 |
| `SIMPLELAY_EVENT_CLOCK_REFRESH_S` | RPi5 | 60 | `rpi/services/event_clock.py:53` | 있음 |

### 허브 저장·실행 일반

| 변수 | 보드 | 기본 | 읽는 곳 | 다른 문서 |
| --- | --- | --- | --- | --- |
| `SIMPLELAY_DB_PATH` | RPi5 | 없음 → 메모리(배포는 /data 아래) | `rpi/api/deps.py:177` | 있음 |
| `SIMPLELAY_LOCAL_APPLIANCES` | RPi5 | — | `rpi/api/deps.py:518` | 있음 |
| `SIMPLELAY_DEMO_PACING` | RPi5 | 꺼짐 | `rpi/services/controller_factory.py:71` | 있음 |
| `SIMPLELAY_DEMO_PACING_SECONDS` | RPi5 | 1.2 | `rpi/services/controller_factory.py:74` | 있음 |
| `SIMPLELAY_PAUSE_CARRYOVER_UNTIL` | RPi5 | — | `rpi/api/deps.py:859` | **없음** |
| `SIMPLELAY_PRESENCE_GATING` | RPi5 | 꺼짐 | `rpi/api/deps.py:751` | 있음 |
| `SIMPLELAY_V2_SCENARIOS` | RPi5 | — | `rpi/scenarios/catalog.py:160` | 있음 |
| `SIMPLELAY_GPIO_ENABLED` | RPi5 | false | `rpi/api/config.py:48` | 있음 |
| `SIMPLELAY_DHT22_GPIO` | RPi5 | 4 | `rpi/api/config.py:43` | **없음** |
| `SIMPLELAY_HOME_X_GPIO` | RPi5 | 17 | `rpi/api/config.py:44` | **없음** |
| `SIMPLELAY_HOME_Y_GPIO` | RPi5 | 27 | `rpi/api/config.py:45` | **없음** |
| `SIMPLELAY_HOME_Z_GPIO` | RPi5 | — | `rpi/api/config.py:46` | **없음** |
| `SIMPLELAY_PROBE_HISTORY_DIR` | RPi5 | — | `rpi/services/probe_history.py:10` | 있음 |

### 루틴·자동 실행

| 변수 | 보드 | 기본 | 읽는 곳 | 다른 문서 |
| --- | --- | --- | --- | --- |
| `SIMPLELAY_ROUTINE_DONE_SENSORS` | RPi5 | — | `rpi/routines/runner.py:63` | 있음 |
| `SIMPLELAY_ROUTINE_DONE_TIMEOUT_S` | RPi5 | 가전별(전자레인지 900·세탁기 10800·그 밖 1200) | `rpi/routines/runner.py:65` | 있음 |
| `SIMPLELAY_ROUTINE_DONE_TIMEOUT_<가전>_S` (형식) | RPi5 | 가전별 기본 | `rpi/routines/runner.py:85` | 있음 |
| `SIMPLELAY_AUTO_RULE_MAX_EVENT_AGE_S` | RPi5 | 120 | `rpi/routines/auto_rules.py:64` | 있음 |

### 가전 추가(사진 매핑)·사진 인식

| 변수 | 보드 | 기본 | 읽는 곳 | 다른 문서 |
| --- | --- | --- | --- | --- |
| `SIMPLELAY_FRAME_W_MM` | RPi5 | — | `rpi/services/panel_mapping.py:79` | 있음 |
| `SIMPLELAY_FRAME_H_MM` | RPi5 | — | `rpi/services/panel_mapping.py:79` | **없음** |
| `SIMPLELAY_FRAME_ORIGIN_X_MM` | RPi5 | 0 | `rpi/services/panel_mapping.py:75` | 있음 |
| `SIMPLELAY_FRAME_ORIGIN_Y_MM` | RPi5 | 0 | `rpi/services/panel_mapping.py:76` | **없음** |
| `SIMPLELAY_VISION_BASE_URL` | RPi5 | — | `rpi/api/deps.py:481` | 있음 |
| `SIMPLELAY_VISION_API_KEY` | RPi5 | — | `rpi/api/deps.py:482` | **없음** |
| `SIMPLELAY_VISION_MODEL` | RPi5 | — | `rpi/api/deps.py:483` | **없음** |
| `SIMPLELAY_VISION_TIMEOUT_SECONDS` | RPi5 | 60 | `rpi/api/deps.py:487` | 있음 |
| `SIMPLELAY_VISION_MAX_PER_HOUR` | RPi5 | — | `rpi/api/router.py:660` | 있음 |

### ThinQ·공기질 제안

| 변수 | 보드 | 기본 | 읽는 곳 | 다른 문서 |
| --- | --- | --- | --- | --- |
| `SIMPLELAY_THINQ_MODE` | RPi5 | off | `rpi/services/thinq/config.py:37` | 있음 |
| `SIMPLELAY_THINQ_PAT` | RPi5 | — | `rpi/services/thinq/config.py:38` | 있음 |
| `SIMPLELAY_THINQ_PAT_FILE` | RPi5 | — | `rpi/services/thinq/config.py:39` | 있음 |
| `SIMPLELAY_THINQ_CLIENT_ID` | RPi5 | — | `rpi/services/thinq/config.py:40` | **없음** |
| `SIMPLELAY_THINQ_CLIENT_ID_FILE` | RPi5 | 홈 폴더 .simplelay/thinq_client_id | `rpi/services/thinq/config.py:41` | 있음 |
| `SIMPLELAY_THINQ_COUNTRY` | RPi5 | KR | `rpi/services/thinq/config.py:42` | 있음 |
| `SIMPLELAY_THINQ_CONFIRM_SECONDS` | RPi5 | 3 | `rpi/services/thinq/config.py:43` | 있음 |
| `SIMPLELAY_THINQ_FAKE_CLOUD_URL` | RPi5 | — | `rpi/services/thinq/config.py:44` | 있음 |
| `SIMPLELAY_THINQ_MAX_CALLS_PER_MINUTE` | RPi5 | 30 | `rpi/services/thinq/config.py:45` | 있음 |
| `SIMPLELAY_THINQ_DEVICE_AIR_PURIFIER` | RPi5 | — | `rpi/services/thinq/config.py:46` | 있음 |
| `SIMPLELAY_THINQ_DEVICE_WASHER` | RPi5 | — | `rpi/services/thinq/config.py:46` | 있음 |
| `SIMPLELAY_THINQ_DEVICE_<기기>` (형식) | RPi5 | — | `rpi/services/thinq/config.py:46` | 있음 |
| `SIMPLELAY_AIR_POLL_SECONDS` | RPi5 | 120(최소 60) | `rpi/services/air_quality.py:59` | 있음 |
| `SIMPLELAY_THINQ_MOCK_AIR_SENSOR_ALWAYS` | RPi5 | 꺼짐(모의 공기청정기 센서는 켜져 있을 때만 — ThinQ 앱 공기질 센서 '운전 중에만' 흉내). 켜면 꺼져 있어도 실림('항상' 흉내), mock 모드만 | `rpi/services/thinq/mock_client.py:78` | 있음 |

### 날씨(평소 화면)

| 변수 | 보드 | 기본 | 읽는 곳 | 다른 문서 |
| --- | --- | --- | --- | --- |
| `SIMPLELAY_WEATHER_MODE` | RPi5 | off | `rpi/services/weather/config.py:75` | 있음 |
| `SIMPLELAY_KMA_SERVICE_KEY` | RPi5 | — | `rpi/services/weather/config.py:79` | 있음 |
| `SIMPLELAY_WEATHER_NX` | RPi5 | — | `rpi/services/weather/config.py:81` | 있음 |
| `SIMPLELAY_WEATHER_NY` | RPi5 | — | `rpi/services/weather/config.py:81` | 있음 |
| `SIMPLELAY_WEATHER_LAT` | RPi5 | — | `rpi/services/weather/config.py:83` | 있음 |
| `SIMPLELAY_WEATHER_LON` | RPi5 | — | `rpi/services/weather/config.py:84` | 있음 |
| `SIMPLELAY_WEATHER_STALE_HOURS` | RPi5 | 6 | `rpi/services/weather/config.py:107` | 있음 |
| `SIMPLELAY_WEATHER_RETRY_MINUTES` | RPi5 | 10 | `rpi/services/weather/config.py:108` | 있음 |
| `SIMPLELAY_WEATHER_TIMEOUT_SECONDS` | RPi5 | 5 | `rpi/services/weather/config.py:109` | 있음 |
| `SIMPLELAY_WEATHER_HEAT_C` | RPi5 | 33 | `rpi/services/weather/config.py:110` | 있음 |
| `SIMPLELAY_WEATHER_COLD_C` | RPi5 | -5 | `rpi/services/weather/config.py:111` | 있음 |
| `SIMPLELAY_WEATHER_RAIN_POP` | RPi5 | 60 | `rpi/services/weather/config.py:112` | 있음 |
| `SIMPLELAY_WEATHER_TIP_HOURS` | RPi5 | 12 | `rpi/services/weather/config.py:113` | 있음 |

### 의도 해석 계층(D-Bus·LLM·유사도)·예비 노드 경로

| 변수 | 보드 | 기본 | 읽는 곳 | 다른 문서 |
| --- | --- | --- | --- | --- |
| `SIMPLELAY_LLM_MODE` | RPi5 | — | `rpi/api/deps.py:113` | 있음 |
| `SIMPLELAY_LLM_BASE_URL` | RPi5 | — | `rpi/api/deps.py:117` | 있음 |
| `SIMPLELAY_LLM_API_KEY` | RPi5 | — | `rpi/api/deps.py:123` | **없음** |
| `SIMPLELAY_LLM_MODEL` | RPi5 | — | `rpi/api/deps.py:124` | **없음** |
| `SIMPLELAY_DBUS_TRANSPORT` | RPi5 | — | `rpi/api/deps.py:69` | 있음 |
| `SIMPLELAY_DBUS_CLI` | RPi5 | — | `rpi/dbus_env.py:18` | 있음 |
| `SIMPLELAY_DBUS_AGENT_SERVICE` | RPi5 | — | `rpi/dbus_env.py:20` | **없음** |
| `SIMPLELAY_DBUS_VECTORDB_SERVICE` | RPi5 | — | `rpi/dbus_env.py:21` | **없음** |
| `SIMPLELAY_DBUS_PERIPHERAL_SERVICE` | RPi5 | — | `rpi/dbus_env.py:22` | **없음** |
| `SIMPLELAY_VECTORDB_SEED` | RPi5 | — | `rpi/main.py:65` | 있음 |
| `SIMPLELAY_NODE_TRANSPORT` | RPi5 | — | `rpi/api/deps.py:330` | 있음 |
| `SIMPLELAY_GATEWAY_PORT` | RPi5 | — | `rpi/api/deps.py:331` | 있음 |
| `SIMPLELAY_GATEWAY_BAUD` | RPi5 | — | `rpi/api/deps.py:332` | **없음** |

### 키오스크 감시(deploy/kiosk_watchdog.py)

| 변수 | 보드 | 기본 | 읽는 곳 | 다른 문서 |
| --- | --- | --- | --- | --- |
| `SIMPLELAY_KIOSK_BUS_NAME` | RPi5 | — | `deploy/kiosk_watchdog.py:48` | **없음** |
| `SIMPLELAY_KIOSK_BUS_PATH` | RPi5 | — | `deploy/kiosk_watchdog.py:49` | **없음** |
| `SIMPLELAY_KIOSK_BUS_IFACE` | RPi5 | — | `deploy/kiosk_watchdog.py:50` | **없음** |
| `SIMPLELAY_KIOSK_APP_ID` | RPi5 | — | `deploy/kiosk_watchdog.py:51` | **없음** |
| `SIMPLELAY_KIOSK_CHECK_S` | RPi5 | 10 | `deploy/kiosk_watchdog.py:52` | 있음 |
| `SIMPLELAY_KIOSK_START_DELAY_S` | RPi5 | 15 | `deploy/kiosk_watchdog.py:53` | **없음** |

### 모션 보드(rpi/controller — RPi4 실행기·조그 도구가 읽음)

| 변수 | 보드 | 기본 | 읽는 곳 | 다른 문서 |
| --- | --- | --- | --- | --- |
| `SIMPLELAY_MOTION_MODE` | RPi4 | mock | `rpi4/act_main.py:351` | 있음 |
| `SIMPLELAY_MOTION_PROTOCOL` | RPi4 | line-json/v0 | `rpi4/act_main.py` | [Touch Bridge 연결](../rpi4/README.md) |
| `SIMPLELAY_TOUCHBRIDGE_TOLERANCE_MM` | RPi4 | 0.7 | `rpi/controller/touchbridge_motion.py` | [Touch Bridge 연결](../rpi4/README.md) |
| `SIMPLELAY_MOTION_PORT` | RPi4 | — | `rpi4/act_main.py:370` | 있음 |
| `SIMPLELAY_MOTION_BAUD` | RPi4 | — | `rpi4/act_main.py:371` | 있음 |
| `SIMPLELAY_MOTION_LOG_PATH` | RPi4 | — | `rpi4/act_main.py:311` | 있음 |
| `SIMPLELAY_MOTION_AUTO_HOME` | RPi4 | 꺼짐 | `rpi/controller/serial_motion.py:454` | 있음 |
| `SIMPLELAY_MOTION_HEARTBEAT_MS` | RPi4 | 500 | `rpi/controller/serial_motion.py:455` | 있음 |
| `SIMPLELAY_MOTION_CONNECT_TIMEOUT_S` | RPi4 | 5 | `rpi/controller/serial_motion.py:456` | 있음 |
| `SIMPLELAY_MOTION_STATUS_TIMEOUT_S` | RPi4 | — | `rpi/controller/serial_motion.py:450` | 있음 |
| `SIMPLELAY_MOTION_HOME_TIMEOUT_S` | RPi4 | — | `rpi/controller/serial_motion.py:451` | 있음 |
| `SIMPLELAY_MOTION_MOVE_TIMEOUT_S` | RPi4 | — | `rpi/controller/serial_motion.py:452` | **없음** |
| `SIMPLELAY_MOTION_PRESS_TIMEOUT_S` | RPi4 | — | `rpi/controller/serial_motion.py:453` | **없음** |
| `SIMPLELAY_MOTION_POSITION_TOLERANCE_COUNTS` | RPi4 | — | `rpi/controller/serial_motion.py:457` | 있음 |
| `SIMPLELAY_MOTION_PRESS_MODE` | RPi4 | — | `rpi/controller/serial_motion.py:441` | 있음 |
| `SIMPLELAY_MOTION_PRESS_DEPTH_COUNTS` | RPi4 | — | `rpi/controller/serial_motion.py:442` | 있음 |
| `SIMPLELAY_MOTION_PRESS_DEPTH_STEP_COUNTS` | RPi4 | — | `rpi/controller/serial_motion.py:443` | **없음** |
| `SIMPLELAY_MOTION_PRESS_DEPTH_MAX_COUNTS` | RPi4 | — | `rpi/controller/serial_motion.py:444` | **없음** |
| `SIMPLELAY_MOTION_PRESS_DRIVE_MS` | RPi4 | — | `rpi/controller/serial_motion.py:445` | 있음 |
| `SIMPLELAY_MOTION_PRESS_DRIVE_STEP_MS` | RPi4 | — | `rpi/controller/serial_motion.py:446` | **없음** |
| `SIMPLELAY_MOTION_PRESS_DRIVE_MAX_MS` | RPi4 | — | `rpi/controller/serial_motion.py:447` | **없음** |
| `SIMPLELAY_MOTION_PRESS_DWELL_MS` | RPi4 | — | `rpi/controller/serial_motion.py:448` | 있음 |
| `SIMPLELAY_MOTION_RETRY_XY_OFFSETS_MM` | RPi4 | — | `rpi/controller/serial_motion.py:449` | 있음 |
| `SIMPLELAY_MOTION_Z_COOLDOWN_BACKOFF_MS` | RPi4 | — | `rpi/controller/serial_motion.py:458` | 있음 |
| `SIMPLELAY_MOTION_R_OUT` | RPi4 | — | `rpi/controller/kinematics.py:56` | 있음 |
| `SIMPLELAY_MOTION_PULLEY_TEETH` | RPi4 | — | `rpi/controller/kinematics.py:57` | 있음 |
| `SIMPLELAY_MOTION_BELT_PITCH_MM` | RPi4 | — | `rpi/controller/kinematics.py:58` | 있음 |
| `SIMPLELAY_MOTION_X_MIN_MM` | RPi4 | — | `rpi/controller/kinematics.py:59` | 있음 |
| `SIMPLELAY_MOTION_X_MAX_MM` | RPi4 | — | `rpi/controller/kinematics.py:60` | **없음** |
| `SIMPLELAY_MOTION_Y_MIN_MM` | RPi4 | — | `rpi/controller/kinematics.py:61` | **없음** |
| `SIMPLELAY_MOTION_Y_MAX_MM` | RPi4 | — | `rpi/controller/kinematics.py:62` | **없음** |
| `SIMPLELAY_MOTION_A_SIGN` | RPi4 | — | `rpi/controller/kinematics.py:63` | 있음 |
| `SIMPLELAY_MOTION_B_SIGN` | RPi4 | — | `rpi/controller/kinematics.py:64` | **없음** |
| `SIMPLELAY_MOTION_DECODING_MULTIPLIER` | RPi4 | — | `rpi/controller/kinematics.py:65` | 있음 |
| `SIMPLELAY_MOTION_MAX_RPM` | RPi4 | — | `rpi/controller/kinematics.py:66` | **없음** |
| `SIMPLELAY_MOTION_STOP_MODE` | RPi4 | — | `rpi/controller/kinematics.py:67` | **없음** |

### 콘센트 모듈·L3 전력 확인

| 변수 | 보드 | 기본 | 읽는 곳 | 다른 문서 |
| --- | --- | --- | --- | --- |
| `SIMPLELAY_L3_MODE` | 양쪽 | off | `rpi4/act_main.py:490 · rpi/api/ambient_router.py:270` | 있음 |
| `SIMPLELAY_L3_MOCK_OUTCOME` | RPi4 | confirmed | `rpi/controller/power_operation.py:349` | 있음 |
| `SIMPLELAY_L3_NONE_TARGETS` | RPi4 | — | `rpi4/services/target_binding.py:33` | 있음 |
| `SIMPLELAY_OUTLET_PORT` | RPi4 | — | `rpi4/act_main.py:552` | 있음 |
| `SIMPLELAY_OUTLET_BAUD` | RPi4 | — | `rpi4/act_main.py:575` | 있음 |
| `SIMPLELAY_OUTLET_CHANNELS` | RPi4 | — | `rpi/verifier/outlet.py:87` | 있음 |
| `SIMPLELAY_OUTLET_PRESS_APPLIANCE` | RPi4 | 코드 상수 | `rpi4/act_main.py:524` | 있음 |
| `SIMPLELAY_OUTLET_RELAY_ON_START` | RPi4 | — | `rpi4/act_main.py:595` | 있음 |
| `SIMPLELAY_OUTLET_STALE_MS` | RPi4 | 1000 | `rpi/verifier/outlet.py:282` | 있음 |
| `SIMPLELAY_OUTLET_HEARTBEAT_MS` | RPi4 | 1000 | `rpi/verifier/outlet.py:293` | 있음 |
| `SIMPLELAY_OUTLET_OFFLINE_MS` | RPi4 | 3000 | `rpi/verifier/outlet.py:283` | 있음 |
| `SIMPLELAY_OUTLET_STATUS_POLL_MS` | RPi4 | 2000 | `rpi/verifier/outlet.py:296` | 있음 |
| `SIMPLELAY_OUTLET_MIN_SAMPLES` | RPi4 | 20 | `rpi/verifier/outlet.py:284` | 있음 |
| `SIMPLELAY_OUTLET_MAX_ERR_RATIO` | RPi4 | 0.1 | `rpi/verifier/outlet.py:285` | 있음 |
| `SIMPLELAY_FAKE_OUTLET_RELAY_CH` | RPi4 | 0 | `rpi4/act_main.py:568` | 있음 |
| `SIMPLELAY_FAKE_OUTLET_CHANNELS` | RPi4 | 대응의 가장 큰 채널 + 1 | `rpi4/act_main.py:567` | **없음** |

### 실행기 동작·정지 대기

| 변수 | 보드 | 기본 | 읽는 곳 | 다른 문서 |
| --- | --- | --- | --- | --- |
| `SIMPLELAY_ACT_PROGRESS` | RPi4 | 켬('0'이면 끔) | `rpi4/services/act_executor.py:114` | 있음 |
| `SIMPLELAY_SENSORS_ENABLED` | RPi4 | 꺼짐(모의 검증기) | `rpi4/act_main.py:163` | 있음 |
| `SIMPLELAY_DANGER_SOUND_ENABLED` | RPi4 | 꺼짐 | `rpi4/act_main.py:1000` | 있음 |
| `SIMPLELAY_DONE_WATCH` | RPi4 | — | `rpi4/act_main.py:501` | 있음 |
| `SIMPLELAY_HOLD_STOP_CONFIRM_S` | RPi4 | 5 | `rpi4/services/stop_hold.py:257` | 있음 |
| `SIMPLELAY_HOLD_PRESS_GAP_S` | RPi4 | 0.6 | `rpi4/services/stop_hold.py:259` | 있음 |
| `SIMPLELAY_HOLD_MAX_S` | RPi4 | 1800 | `rpi4/services/stop_hold.py:258` | 있음 |
| `SIMPLELAY_HOLD_MOCK_STOP` | RPi4 | honor | `rpi4/services/stop_hold.py:278` | 있음 |
| `SIMPLELAY_HOLD_MOCK_RUN_S` | RPi4 | 30 | `rpi/services/simulator_controller.py:153` | 있음 |

### 센서 판정 기준(전부 측정 필요)·기록

| 변수 | 보드 | 기본 | 읽는 곳 | 다른 문서 |
| --- | --- | --- | --- | --- |
| `SIMPLELAY_CURRENT_ZERO_V` | RPi4 | 2.5 | `rpi/verifier/config.py:84` | 있음 |
| `SIMPLELAY_CURRENT_ADC_GAIN` | RPi4 | 2 | `rpi/verifier/config.py:85` | 있음 |
| `SIMPLELAY_RECORDER_PATH` | RPi4 | — | `rpi4/act_main.py:443` | 있음 |
| `SIMPLELAY_RECORDER_PRE_S` | RPi4 | — | `rpi4/act_main.py:450` | 있음 |
| `SIMPLELAY_RECORDER_POST_S` | RPi4 | — | `rpi4/act_main.py:451` | 있음 |
| `SIMPLELAY_RECORDER_ADC_GAIN` | RPi4 | — | `rpi4/act_main.py:458` | 있음 |
| `SIMPLELAY_RECORDER_ADC_CHANNEL` | RPi4 | 0 | `rpi4/act_main.py:452` | 있음 |
| `SIMPLELAY_RECORDER_AUDIO` | RPi4 | — | `rpi4/act_main.py:460` | 있음 |
| `SIMPLELAY_CYCLE_RUN_MIN_W` | RPi4 | 100.0 | `rpi/verifier/cycle_end.py:38` | 있음 |
| `SIMPLELAY_CYCLE_MIN_RUN_S` | RPi4 | 300.0 | `rpi/verifier/cycle_end.py:39` | **없음** |
| `SIMPLELAY_CYCLE_STANDBY_MAX_W` | RPi4 | 15.0 | `rpi/verifier/cycle_end.py:40` | 있음 |
| `SIMPLELAY_CYCLE_SETTLE_S` | RPi4 | 180.0 | `rpi/verifier/cycle_end.py:41` | **없음** |
| `SIMPLELAY_CYCLE_MAX_GAP_S` | RPi4 | 5.0 | `rpi/verifier/cycle_end.py:42` | **없음** |
| `SIMPLELAY_CYCLE_<가전>_<항목>` (형식) | RPi4 | 가전별 설계 초기값 | `rpi/verifier/cycle_end.py:88` | 있음 |
| `SIMPLELAY_BEEP_FREQ_LOW_HZ` | RPi4 | 1800 | `rpi/verifier/end_beep.py:29` | 있음 |
| `SIMPLELAY_BEEP_FREQ_HIGH_HZ` | RPi4 | 4200 | `rpi/verifier/end_beep.py:30` | **없음** |
| `SIMPLELAY_BEEP_BAND_THRESHOLD` | RPi4 | 0.35 | `rpi/verifier/end_beep.py:31` | **없음** |
| `SIMPLELAY_BEEP_MIN_COUNT` | RPi4 | 3 | `rpi/verifier/end_beep.py:32` | 있음 |
| `SIMPLELAY_BEEP_MAX_COUNT` | RPi4 | 12 | `rpi/verifier/end_beep.py:33` | **없음** |
| `SIMPLELAY_BEEP_MIN_PERIOD_S` | RPi4 | 0.2 | `rpi/verifier/end_beep.py:34` | **없음** |
| `SIMPLELAY_BEEP_MAX_PERIOD_S` | RPi4 | 1.5 | `rpi/verifier/end_beep.py:35` | **없음** |
| `SIMPLELAY_BEEP_SILENCE_S` | RPi4 | 3.0 | `rpi/verifier/end_beep.py:36` | **없음** |
| `SIMPLELAY_BEEP_MAX_REL_STDDEV` | RPi4 | 0.25 | `rpi/verifier/end_beep.py:37` | **없음** |
| `SIMPLELAY_DONE_FUSION_WINDOW_S` | RPi4 | 120.0 | `rpi/verifier/done_fusion.py:51` | 있음 |
| `SIMPLELAY_DONE_FUSION_WAIT_S` | RPi4 | 300.0 | `rpi/verifier/done_fusion.py:52` | 있음 |
| `SIMPLELAY_DONE_COOLDOWN_S` | RPi4 | 900.0 | `rpi/verifier/done_fusion.py:53` | 있음 |
| `SIMPLELAY_DONE_<가전>_<항목>` (형식) | RPi4 | 가전별 설계 초기값 | `rpi/verifier/done_fusion.py:92` | 있음 |
| `SIMPLELAY_TAIL_OFF_MAX_W` | RPi4 | 30.0 | `rpi/verifier/power_tail.py:38` | 있음 |
| `SIMPLELAY_TAIL_OFF_CONFIRM_S` | RPi4 | 2.0 | `rpi/verifier/power_tail.py:39` | **없음** |
| `SIMPLELAY_TAIL_BAND_W` | RPi4 | 5.0 | `rpi/verifier/power_tail.py:40` | **없음** |
| `SIMPLELAY_TAIL_BAND_RATIO` | RPi4 | 0.5 | `rpi/verifier/power_tail.py:41` | **없음** |
| `SIMPLELAY_TAIL_SETTLE_S` | RPi4 | 3.0 | `rpi/verifier/power_tail.py:42` | **없음** |
| `SIMPLELAY_TAIL_MAX_WAIT_S` | RPi4 | 120.0 | `rpi/verifier/power_tail.py:43` | **없음** |
| `SIMPLELAY_TAIL_MAX_RUN_S` | RPi4 | 3600.0 | `rpi/verifier/power_tail.py:44` | **없음** |

### 점검 도구(rpi/tools/board_probe)

| 변수 | 보드 | 기본 | 읽는 곳 | 다른 문서 |
| --- | --- | --- | --- | --- |
| `SIMPLELAY_PROBE_CONFIG` | 개발 PC·보드 | — | `rpi/tools/board_probe/__main__.py:17` | 있음 |
| `SIMPLELAY_PROBE_OUT` | 개발 PC·보드 | 홈 폴더 simplelay-probe | `rpi/tools/board_probe/__main__.py:16` | 있음 |

## 이 목록에 넣지 않은 것

- 시험 코드만 읽는 이름, 펌웨어 빌드 비밀(`firmware-node/secrets.ini`, 추적 안 함).
- 컨테이너 안에서만 쓰는 비-`SIMPLELAY_` 변수(예: `deploy/run_act.sh`의 `LINK_ALLOW_FROM` — `SIMPLELAY_LINK_ALLOW_FROM`에서 옮겨 담는다).
- 폰·키오스크 앱 설정(앱 안 저장소에 둔다 — 허브 주소·API 키는 폰 연결(`/pair`)로 받는다).
