Seongwonp/Simplelay/docs/촬영-대본-실물-장면.md

# 촬영 대본 — 실물 장면 (ESP32 모션 보드가 돌아온 뒤 · 콘센트 모듈은 갈래 B)

실물 장면을 **끊지 않고 한 번에** 찍는 대본이다. 10/19 사용자 결정으로 두 갈래로 나눈다([v4 §0-A](본선-시연-계획-v4.md)).

| 갈래 | 언제 | 실물 장면 | 결과 확인 |
|---|---|---|---|
| **A. 10/28 영상 (CT 없음)** | 모션 보드 복귀·누름 측정 뒤, 10/27까지 | 승인 → 갠트리 이동 → 솔레노이드 '30초 → 시작' 누름 → 누름 장치 확인. 공기청정기는 **따로 승인한 명령 또는 시각 루틴** | 누름 장치 쪽(엔코더·누름 응답) + 실제 공기청정기 상태 재조회(LG 클라우드) |
| **B. 11/6 결선 (CT 있으면)** | 콘센트 모듈 완성·CT 실측 뒤 | 승인 → 누름 → CT 가열 시작·종료 감지 → 공기청정기 | 위 + CT 전력 |

갈래 A에서는 '가열 종료 감지(조리 완료가 아닐 수 있음)'를 쓰지 않는다 — 가열 종료를 보이지 않기 때문이다. CT를 말할 때는 "CT 콘센트 모듈은 설계·펌웨어 완료, 회로 제작 중입니다"만 말한다.
하드웨어 없이 먼저 찍는 장면은 [10/20 대본](촬영-대본-2026-10-20-하드웨어-없이.md)에 있다. 컷 목록 기준은 [운영 런북 §9](결선-운영-런북.md), 자막·점검 규칙은 [제출 체크리스트 §3](submission/제출-체크리스트.md), 말하면 안 되는 문장은 [v4 §8](본선-시연-계획-v4.md)이다.

## 0. 찍기 전에 끝나 있어야 하는 것

**이 순서를 건너뛰고 찍지 않는다.** 촬영은 측정이 아니다 — 측정이 먼저다.

| # | 선행 조건 | 어디에 적나 |
|---|---|---|
| 1 | 벨트·레일 조정, 폐루프 이동과 원점이 된다 | [실측 기록표](실측-기록표.md) §4 |
| 2 | 솔레노이드 안전 조건 확인(켜짐 상한·냉각·발열) | [솔레노이드 안전 전달표](솔레노이드-안전-전달표-2026-10-16.md) |
| 3 | **버튼별 누름 성공률 측정**(첫 시도·재시도 포함, n/N) | 실측 기록표 §4 |
| 4 | **(갈래 B만)** 콘센트 모듈 회로 제작([제작 안내](콘센트-모듈-제작-안내.md)), CT 보정, 가열 시작·종료 판정 측정(정상·출력 감소·취소·문 열림·팬만) | 실측 기록표 §6 |
| 5 | 캐리지가 움직이는 중·누르는 중의 정지를 실제 모션 보드로 확인 | 실측 기록표, 정지 거리·시간 |
| 6 | **(갈래 B만)** 전자레인지 가열 안전 체크리스트 통과(빈 상태 가열 금지·짧은 시간·사람 입회·비상정지 확인). 갈래 A는 가열하지 않는다 — **전자레인지 플러그를 뽑은 채** 조작부만 누른다(콘센트 모듈 비상 차단이 없으면 가열 금지) | [런북 §3-7](결선-운영-런북.md) |

측정값이 나오면 그 값을 [개발완료보고서](submission/개발완료보고서-초안.md) §5-2와 [체크리스트 §5-1](submission/제출-체크리스트.md)의 칸에 먼저 적는다. **영상 자막의 숫자는 그 표에서 가져온다 — 영상에서 센 횟수를 따로 쓰지 않는다.**

## 1. 무대와 카메라

책상 150×55cm 두 개를 결선과 같게 놓고 찍는다(그래야 결선 당일 배치를 그대로 쓸 수 있다).

```
[책상 1] 전자레인지 + 갠트리(조작부 위) (+ 콘센트 모듈: 갈래 B)  [책상 2] 키오스크 패널 + 폰
                     ▲                                              ▲
                  카메라 1 (삼각대, 비스듬히)                    카메라 2 (삼각대, 정면)
                  — 손·조작부·갠트리·전자레인지 창                — 키오스크 화면 전체 + 폰
                                      공기청정기는 두 책상 사이, 카메라 1 프레임 끝에 들어오게
```

| 카메라 | 프레임에 반드시 들어올 것 | 비고 |
|---|---|---|
| 1 (주) | 사람 손 → 갠트리 → 전자레인지 조작부 → (프레임 끝) 공기청정기 | 갠트리가 움직이는 것과 버튼이 눌리는 것이 **같은 화면**에 보여야 한다. 손만 보이게(얼굴 금지) |
| 2 (보조) | 키오스크 화면 **전체**(위쪽 띠 자리까지) + 폰 화면 | 화면 위쪽을 자르지 않는다 — 띠가 없다는 것을 보이려면 띠 자리가 프레임에 있어야 한다 |

둘을 같은 시각에 돌리고 편집에서 분할 화면으로 붙인다. **시각을 맞추는 방법:** 녹화를 시작한 뒤 두 카메라가 모두 보이는 곳에서 손뼉을 한 번 친다(소리로 맞춘다).
그게 어려우면 키오스크의 큰 시계를 두 카메라에 모두 한 번 담는다.

## 2. '연습 띠 없음'을 보이는 방법

연습(모의) 실행이면 키오스크 위에 **'연습이에요. 실제 가전은 그대로예요'** 띠가 뜨고, 폰 기록에는 **'연습'** 배지가 붙는다.
실물 실행에서는 이것이 **없다.** 그 '없음'을 영상으로 증명하려면 이렇게 찍는다.

1. **대조 컷을 먼저 찍는다.** 같은 자리·같은 각도에서 **연습으로 한 번** 실행해 띠가 있는 화면을 3초 담는다. 자막 `연습일 때 — 띠가 있다`.
2. 이어서 **실물로 실행**하고 같은 각도에서 같은 자리를 3초 담는다. 자막 `실물일 때 — 띠가 없다`. 편집에서 두 컷을 나란히 붙인다.
3. 실행을 시작하기 전에 **화면 위쪽을 1~2초 멈춰 보인다.** 손이 띠 자리를 가리지 않게 한다.
4. 폰 기록 탭에서 그 줄에 **'연습' 배지가 없고** 결과 배지만 있는 것을 담는다.

띠가 없는 것을 말로만 "실물입니다"라고 하지 않는다 — 대조 컷이 근거다.

## 3. 로그 화면을 함께 찍는 방법

누름 성공률·판정 시각을 뒤에서 셀 수 있게, 화면 결과와 기록을 **같은 녹화 안에** 남긴다.

| 어떻게 | 무엇이 보이나 | 주의 |
|---|---|---|
| 폰 **기록 탭**을 카메라 2 프레임 안에 둔 채 실행 | 실행이 끝나는 대로 줄이 쌓인다. 결과 배지와 근거 줄이 사람이 읽을 수 있게 남는다 | 이것이 **기본**이다. 사람이 보는 말 그대로라서 자막과 어긋나지 않는다 |
| 노트북에 실행 기록 내보내기 화면을 띄워 보조 컷으로 | 누름 성공 n/N을 셀 수 있는 원자료 | **촬영 전에 화면을 점검한다** — 기기 주소·키·파일 경로가 보이면 그 컷은 쓰지 않는다. 가릴 수 없으면 찍지 않고 수치만 자막으로 쓴다 |
| (갈래 B만) 콘센트 모듈 CT 파형을 볼 화면 | 가열 시작·종료 판정 시점 | 실측 데이터로 만든 그림만 쓴다. 합성 파형은 영상·제출물에 넣지 않는다. 갈래 A 영상에는 넣지 않는다 |

원자료는 영상 밖에 따로 보관하고, 영상에는 **표와 같은 숫자**만 자막으로 넣는다.

## 4. 연속 한 번(원테이크) 대본

### 4-A. 10/28 영상 — CT 없음 (갈래 A)

길이는 약 1분. **전자레인지 플러그는 뽑혀 있다**(가열하지 않는다). 공기청정기는 누름과 **잇지 않고** 따로 보인다.
화면 글자는 촬영 전에 그날 빌드에서 확인해 아래 빈칸을 채운다 — CT 없이 끝난 누름 결과 문구는 아직 실물로 본 적이 없다(코드에는 '버튼은 다 눌렀어요. 가전이 움직였는지는 몰라요' 계열이 있다).

| 시각 | 카메라 | 무엇을 한다 / 무엇이 보이나 | 화면 글자(그대로) | 말할 것 |
|---|---|---|---|---|
| 0:00 | 2 | 녹화 시작. 키오스크 처음 화면과 띠 자리, 폰 기록 탭 | — | "지금부터 끊지 않고 한 번에 보여 드립니다." |
| 0:05 | 2 | 루틴 '30초 데우기' 호출 또는 제안 카드. 누를 순서가 보인다 | 거절 쪽 **'이번엔 안 할게요'** | "할 일과 누를 순서를 먼저 보여 주고, 승인해야 누릅니다." |
| 0:12 | 2 | 승인(손가락이 화면에 닿는 것이 보이게) | — | "승인했습니다." |
| 0:15 | 1 | **갠트리가 움직인다** — 첫 버튼 자리로 | (카메라 2: 버튼판과 누를 순서) | "승인한 그 명령인지 본체가 다시 대조한 다음에 움직입니다." |
| 0:22 | 1 | **솔레노이드가 '30초'를 누른다** | — | (말하지 않는다 — 소리와 움직임) |
| 0:26 | 1 | '시작'을 누른다 | — | "두 버튼을 순서대로 눌렀습니다. 버튼 하나에 장치 하나를 붙이는 방식이 아닙니다." |
| 0:32 | 2 | **누름 장치 확인** 결과 화면 | 【촬영 전 그날 화면에서 옮김】 | "누름 장치가 눌렀다는 것까지 확인했습니다. 오늘은 전자레인지 전원을 뺐습니다 — 가열 확인용 CT 콘센트 모듈은 설계·펌웨어 완료, 회로 제작 중입니다." |
| 0:40 | 2 | 폰 기록 탭의 그 줄 | 결과 배지·근거 줄 그대로 | "기록에도 확인한 만큼만 남습니다." |

이어서 **공기청정기 컷(따로 승인한 명령)** — 같은 녹화 안에서 해도 되지만 전자레인지와 잇는 말은 하지 않는다.

| 시각 | 카메라 | 무엇을 한다 | 화면 글자(그대로) | 말할 것 |
|---|---|---|---|---|
| +0:00 | 2 | LG 가전 공기청정기 '바람 세게'를 승인(카드 또는 직접 조작) | **'바람을 세게 바꾸고 있어요'** | "LG 가전도 같은 승인 흐름을 거칩니다." |
| +0:08 | 1+2 | **실제 공기청정기 바람이 세진다.** 화면은 상태를 다시 읽어 확인 | 확인된 결과 화면 | "상태를 다시 읽어 바뀐 것을 본 다음에만 됐다고 말합니다. 공기가 깨끗해졌다는 뜻은 아닙니다." |

'카드 없이 자동으로'는 [하드웨어 없이 대본](촬영-대본-2026-10-20-하드웨어-없이.md) 장면 A(시각 규칙으로 실제 공기청정기 켜기)를 쓴다. 가열 종료 → 공기청정기 카드·자동 허용 흐름을 넣고 싶으면 **연습(가열 종료 주입)** 으로 찍고 띠·자막 `연습 — 가열 종료를 일부러 넣음`을 가리지 않는다.

### 4-B. 11/6 결선 — CT 있으면 (갈래 B)

한 번에 가는 것이 핵심이다. 중간에 끊으면 "편집으로 이어 붙인 것 아닌가"를 묻게 된다. 길이는 약 1분 30초~2분.
**화면 글자는 2026-10-19 코드 기준이다.** 촬영 전에 `git log --oneline -- app rpi5-touchscreen-app`로 '문구' 커밋을 보고, 바뀌었으면 화면에 보이는 글자를 따라 읽는다.

| 시각 | 카메라 | 무엇을 한다 / 무엇이 보이나 | 화면 글자(그대로) | 말할 것 |
|---|---|---|---|---|
| 0:00 | 2 | 녹화 시작. 키오스크 처음 화면과 띠 자리를 보인다. 폰 기록 탭도 한 번 | — | "지금부터 끊지 않고 한 번에 보여 드립니다." |
| 0:05 | 2 | 제안 카드 또는 루틴 호출. 누를 순서가 보인다 | 거절 쪽 **'이번엔 안 할게요'** | "할 일과 누를 순서를 먼저 보여 주고, 승인해야 누릅니다." |
| 0:12 | 2 | 승인한다(손가락이 화면에 닿는 것이 보이게) | — | "승인했습니다." |
| 0:15 | 1 | **갠트리가 움직인다.** 조작부 위에서 첫 버튼 자리로 | (카메라 2: 버튼판과 누를 순서) | "승인한 그 명령인지 본체가 다시 대조한 다음에 움직입니다." |
| 0:22 | 1 | **솔레노이드가 첫 버튼('30초')을 누른다.** 누르는 순간이 보이게 | — | (말하지 않는다 — 소리와 움직임을 들려준다) |
| 0:26 | 1 | 두 번째 버튼('시작')을 누른다 | — | "두 버튼을 순서대로 눌렀습니다. 버튼 하나에 장치 하나를 붙이는 방식이 아닙니다." |
| 0:32 | 2 | **CT가 가열 시작을 잡는다** | 결과 근거 줄 **'전기를 쓰기 시작한 걸 확인했어요'** | "버튼을 눌렀다는 것과 가전이 실제로 움직였다는 것은 다릅니다. 콘센트 전력으로 확인했습니다." |
| 0:36 | 1 | 전자레인지 창 안에서 돌아가는 것 | — | "30초만 돌립니다." |
| 1:05 | 2 | **가열 종료를 감지한다** | 카드 근거 **'전자레인지가 멈춘 것 같아요. 조리 완료가 아닐 수 있어요.'** | "가열이 끝난 것을 전력으로 감지했습니다. 취소나 문 열림으로 끝난 것과는 **아직 구분하지 못합니다.**" |
| 1:10 | 2 | 공기청정기 카드가 뜬다 | 카드 **'공기청정기 바람을 세게 할까요?'** | "이 신호로 하는 일은 공기청정기 바람 세기 하나입니다." |
| 1:16 | 2 | '다음부터도 자동으로' → 확인 시트 | 시트 설명 **'가전이 전기를 덜 쓰면 가열이 끝났다고 봐요. 요리가 다 된 건 아닐 수 있어요.'** → **'허락하고 이번에도 하기'** | "조건과 동작을 보여 주고, 사용자가 허락할 때만 다음부터 자동으로 합니다." |
| 1:24 | 1+2 | **실제 공기청정기 바람이 세진다.** 화면은 상태를 다시 읽어 확인 | 확인된 결과 화면 | "상태를 다시 읽어 바뀐 것을 본 다음에만 됐다고 말합니다. 공기가 깨끗해졌다는 뜻은 아닙니다." |
| 1:32 | 2 | 녹화를 멈추지 않고 폰 기록 탭을 보인다 | 두 가전의 결과 줄 | "두 가전의 결과가 기록에 각각 남습니다." |

끝낸 뒤 **같은 녹화 안에서** 자동 실행을 끄는 것까지 이어 가면 좋다(루틴 탭 '자동 규칙'). 그러면 "끌 수 있다"는 말에 근거가 붙는다.

### 두 번째 테이크 — 같은 조건에서 다시 (추가 승인 없이, 갈래 B만)

1. 공기청정기를 약풍으로 되돌린다(이 준비 동작도 화면에 보인다).
2. 조리를 **다시 승인한다** — 버튼 누름은 매번 승인이다.
3. 가열 종료 감지 → **추가 승인 없이** 바람이 세진다. 이때 카메라 2가 **카드가 뜨지 않는 것**을 담아야 한다("카드 없이 바뀌었다"가 근거다).
4. 말할 것: "두 번째에는 묻지 않았습니다. 처음에 허락한 조건이기 때문입니다. 버튼 누름은 여전히 매번 승인합니다."

## 5. 정지·실패 장면 (실물로 다시 찍는다)

하드웨어 없이 찍은 연습 정지 컷을 실물 컷으로 바꿔 넣는다.

| 컷 | 무엇이 보이나 | 화면 글자(그대로) | 말할 것 |
|---|---|---|---|
| S-1 | 갠트리가 **움직이는 중에** 정지를 누른다. 손·화면·갠트리가 한 컷에 | 정지 결과 **'누름 장치가 멈췄어요'** | "엔코더로 멈춘 것을 본 때만 멈췄다고 말합니다." |
| S-2 | 멈춘 것을 확인하지 못한 경우(일으킬 수 있으면) | **'누름 장치가 멈췄는지 몰라요'** + 단추 **'다시 멈추기'** | "확인하지 못하면 모른다고 말하고, 다시 멈출 수 있게 둡니다." |
| S-3 | 누름을 확인하지 못해 멈춘 경우 | **'눌렸는지 몰라서 멈췄어요.'** | "눌렸는지 모르면 자동으로 다시 누르지 않습니다. 두 번 눌려 두 번 조리되는 것이 더 위험합니다." |
| S-4 | **(갈래 B만 — 콘센트 모듈이 있어야 한다)** 콘센트 모듈 비상정지 버튼을 누른다 | 비상 화면 | "비상 버튼은 본체를 기다리지 않고 전자레인지 전원을 끊고 걸어 둡니다. 사람이 확인해야 풀립니다." |
| S-5 | (카메라를 보고) 경계 | — | "콘센트 릴레이는 전자레인지 전원만 끊습니다. 갠트리의 마지막 수단은 따로 둔 모터 전원 스위치입니다." |

S-2는 일부러 만들기 어렵다. **만들 수 없으면 찍지 않고 넘긴다** — 연습 화면을 실물인 척 쓰지 않는다.

## 6. 실패했을 때

실물 촬영은 한 번에 되지 않을 수 있다. 미리 정해 둔다.

- **누름이 실패한 테이크도 버리지 않는다.** 실패를 그대로 보이고 화면이 '눌렸는지 몰라요'로 끝나는 것을 쓰면 더 설득력 있다. 자막 `실제 실패 — 일부러 넣은 것이 아님`.
- 다만 **성공한 테이크만 모아 붙여 성공률이 높은 것처럼 보이게 하지 않는다.** 자막의 성공률은 측정표의 n/N이고, 영상의 그 한 번은 예시라고 적는다.
- 전자레인지가 뜨거워지면 식을 때까지 쉰다. 솔레노이드도 연속으로 누르지 않는다(켜짐 상한·냉각).
- 한 시간 안에 원테이크가 되지 않으면 그날은 **컷을 나눠서** 찍고, "한 번에 가는 영상"은 다음 날로 넘긴다. 억지로 이어 붙이지 않는다.

## 7. 찍은 뒤

- [ ] 원본을 노트북과 USB 두 곳에 복사한다.
- [ ] 테이크마다 **빌드(커밋)와 모션 펌웨어 판**을 적는다. 뒤에 "어느 빌드로 찍었나"를 물으면 답해야 한다.
- [ ] 자막의 숫자가 실측 기록표의 값과 같은지 한 줄씩 대조한다.
- [ ] 자막의 검증 수준이 [개발완료보고서](submission/개발완료보고서-초안.md) §5-1 '장면별 실물 / 모의' 표와 같은지 대조하고, **이 촬영으로 실물이 된 칸은 그 표와 [README](../README.md) 검증 수준 표를 함께 고친다.**
- [ ] 화면에 내부 주소·키·기기 식별 정보가 찍힌 컷은 버린다.
