Seongwonp/Simplelay/docs/인계-2026-10-19-병행-작업.md

# 인계 2026-10-19 — 두 세션 병행 작업 나눔

결선(11/6)·서류 제출(10/28 14:00)까지 두 Claude 세션이 같은 저장소에서 동시에 일한다. **서로 같은 파일을 고치지 않는 것**이 첫째 규칙이다.
기준 평가: [심사위원 시각 평가](인계-2026-10-18-심사위원-평가.md), 10/19 결선 채점표 평가(54/110 — 실물 누름·CT가 갈림길), [정합 점검](submission/정합-점검-2026-10-18.md).

## 공통 규칙

- 시작 전 `git pull --rebase`, 커밋은 `git commit -- <자기 영역 경로>`만, push 전 `git pull --rebase`. 강제 푸시·`git stash` 금지.
- CLAUDE.md 규칙을 따른다(비공개 자료·플랫폼 고유 명칭·사설 IP·로컬 경로 금지, 커밋 메시지에 도구 이름·공동 작성자 줄 없음, 실측 전 수치는 '미측정').
- **새 기능 추가 금지(10/19 사용자 결정)** — 있는 기능의 사용성·정직성·완성도만.
- 커밋 전 `rpi/tests/test_repo_guard.py`·`rpi/tests/test_doc_links.py`.

## 세션 A (데스크톱, 보드·코드)

영역: `app/`, `rpi5-touchscreen-app/`, `rpi/`, `rpi4/`, `deploy/`, 보드 배포, `docs/devlog/`, `CLAUDE.md`, `docs/inference-boundary.md`.

1. 화면 수정 5개(채점표 평가 §4): 폰 실행 화면 버튼 이름 누락, LG 가전 정지 문구 정직하게, '눌렀어요, 확인 중이에요'는 모든 버튼 뒤에만, 건너뛰기 표시 한 줄, 처음 화면 '가전 N대'·실내 온습도 정리.
2. 음성 명령 고도화(규칙 계층): 말 다듬기·같은 뜻 사전·'혹시 이것인가요?' 후보, 못 알아들으면 동작 버튼과 '이렇게 말해 보세요' — [음성 의도 해석 조사](음성-의도-해석-조사-2026-10-19.md) 권고.
3. 시연 근거 화면: 전력(W)·감지 시각을 결과 화면 근거 줄에(실측 근거 있을 때만), 실행 로그 내보내기(누름 성공률 n/N 집계용).
4. 실물 시험 지원: ESP32·솔레노이드·콘센트 모듈이 오면 env 되돌리기, 펌웨어 올리기, PS-1·누름 성공률·CT 실측.

## 세션 B (두 번째 계정, 문서·발표)

영역: `docs/submission/`, `README.md`, `docs/본선-시연-계획-v4.md`, `docs/질의응답-대비.md`, 새로 만드는 발표·촬영 문서. **코드·`docs/devlog/`·`CLAUDE.md`는 고치지 않는다.**

1. **제출 문서 다이어트:** 보고서·소개서 본문에서 내부 용어(G1~G11·PS-1·R1·커밋 SHA)를 빼고 '장면별 실물/모의' 표 하나로. 부록은 GitHub 쪽 근거로만. 소개서 책자 2쪽은 '되는 것 / 아직인 것' 두 열.
2. **낡은 그림 정리:** `docs/submission/img/fig-concept.svg`('모션 MCU 미정'·'스위치봇') `fig-demo-scenes.svg`(v3) — 본문에서 쓰지 않으면 대응표에서 '쓰지 않음'으로, 필요하면 지금 구성으로 새로 그림(손으로 쓴 SVG, 흑백 인쇄 가능).
3. **재사용 경계 한 표:** 이번 대회에서 새로 만든 것(솔레노이드 Z·콘센트 모듈·안전 계층·승인 결속·확인 단계·앱 두 개) vs 함께 쓰는 것(갠트리·모터·드라이버·엔코더·모션 제어 원작) — [재사용 경계](reuse-boundary.md)를 근거로, 사진 자리 표시.
4. **촬영 대본(10/20 목표, 하드웨어 없이 찍을 장면부터):** 실제 공기청정기 시각 자동 실행(22:00·07:00 기록), LG 가전 실행 화면, 건너뛰기, 정지·실패 화면, 연습 장면 — 장면별 컷·화면·말·필요 장비(캠코더·삼각대).
5. **실물 장면 대본(ESP32 복귀 뒤):** 승인 → 갠트리 이동 → 솔레노이드 누름 → CT 시작·종료 감지 → 공기청정기, 한 번에 찍는 연속 영상 구성과 '연습 띠 없음'·로그 화면 동시 촬영 방법.
6. **질의응답 대비 갱신:** 채점표 평가 §5 다섯 질문(실물 성공 장면, Touch Bridge와 새로 만든 HW, 가열 종료 오판, 당사자 시험·원가·설치 시간, 스위치봇 비교)의 답 초안 — 확인된 사실과 미측정을 구분.
7. **활용성 숫자 준비:** BOM 원가표 틀(부품·수량·단가 출처), 설치 시간 측정 절차, 팀 밖 1~2명 사용성 점검 절차(과업 3개·관찰 기록지) — 값은 비워 두고 '측정 뒤 기입'.

## 서로 넘길 것

- 세션 A가 화면 문구를 바꾸면 커밋 메시지에 '문구'라고 적는다 — 세션 B는 `git log --oneline -- app rpi5-touchscreen-app`로 보고 문서의 화면 인용을 맞춘다.
- 세션 B가 문서에서 '화면이 이렇게 말해야 한다'를 찾으면 이 파일 끝 '요청' 절에 한 줄 적고 커밋한다(세션 A가 읽는다).

## 세션 B 진행 (2026-10-19)

1~7번을 끝냈다. 새로 만든 것: [촬영 대본 — 하드웨어 없이](촬영-대본-2026-10-20-하드웨어-없이.md) · [촬영 대본 — 실물 장면](촬영-대본-실물-장면.md) · [활용성 숫자 기록지](submission/활용성-숫자-기록지.md) · `submission/img/fig-demo-scenes-v4.svg`(보고서 그림 4).
고친 것: 보고서·소개서 본문에서 내부 점검 번호·커밋 해시를 빼고 **보고서 §3-3 '장면별 실물 / 모의' 표**와 **소개서 2쪽 '되는 것 / 아직인 것'** 두 열로 모았다. 보고서에 **§2-4 함께 쓰는 것 / 새로 만든 것** 표를 넣었다.
질의응답에 **Q0(실물로 성공한 장면이 있나)**·**Q11(당사자 시험·원가·설치 시간)**을 넣고, 입으로 말하는 답에서 내부 번호·해시를 뺐다.

## 요청 (세션 B → A)

**ㄱ. 보고서 §8에 적은 '남은 정지 경계 두 가지'가 맞는지 코드로 확인해 주세요.** 안전 계약 적용 보고 §2를 근거로 이렇게 풀어 적었다 —
① 일부 화면이 정지 결과를 사용자에게 제대로 돌려주지 않는 것, ② 실행기를 다시 켠 뒤 모션 보드의 원점을 다시 확인하지 않고 그대로 믿는 것.
①은 10/16~18 키오스크·폰 문구 작업으로 이미 일부 고쳐졌을 수 있다. 고쳐진 범위가 있으면 알려 주면 보고서 §6-2·§8을 그에 맞게 고친다.

**ㄴ. 폰과 키오스크가 같은 상황을 다르게 말한다 — 의도한 것인지 알려 주세요.** ThinQ 명령을 보냈지만 상태를 확인하지 못한 경우:
- 폰 `app/lib/models/command_result.dart` — '보냈지만 설정이 바뀌었는지 몰라요. **집에서 가전을 확인해야 해요.**'
- 키오스크 `rpi5-touchscreen-app/lib/models/command_result.dart` — '보냈지만 **됐는지** 몰라요. **가전을 봐 주세요.**'

폰은 집 밖에서 볼 수 있으니 '집에서', 키오스크는 집 안이니 '봐 주세요'가 맞는 것으로 보여 **문서에는 둘을 그대로 적고 다르다는 것을 밝혔다**([v4 §4](본선-시연-계획-v4.md)).
의도한 구분이면 그대로 두고, 아니면 한쪽으로 맞춰 주면 문서를 따라 고친다.

→ **답(사용자 결정 2026-10-19): 의도한 구분이다. 둘 다 그대로 둔다.** 폰은 집 밖에서 볼 수 있으므로 '집에서 가전을 확인해야 해요', 키오스크는 집 안이므로 '가전을 봐 주세요'. 문서도 두 문구를 그대로 인용하고 다르다는 것을 밝힌 채 둔다.

**ㄷ. 화면 문구를 고치면 커밋 메시지에 '문구'를 적어 주세요(공통 규칙 그대로).** 아래 문서들이 **2026-10-19 코드의 화면 글자를 그대로 인용**하고 있어서, 바뀌면 함께 고쳐야 한다.
- 촬영 대본 둘(장면마다 '화면 글자(그대로)' 칸) · 활용성 숫자 기록지 §3의 성공 기준 · [v4 §4](본선-시연-계획-v4.md) · 보고서 §3-2·§4-2
- 특히 세션 A 1번의 다섯 가지(폰 실행 화면 버튼 이름, LG 가전 정지 문구, '눌렀어요, 확인 중이에요', 건너뛰기 한 줄, 처음 화면 '가전 N대'·실내 온습도)는 **촬영 전에** 끝나면 좋겠다 — 10/20 촬영이 그 화면을 찍는다.

**ㄹ. 제출 직전 시험 수를 한 커밋에서 다시 세어 알려 주세요.** 지금 서류 네 곳에 **2026-10-18 오후** 수가 적혀 있다(백엔드+RPi4 3,565 · 폰 1,177 · 키오스크 1,046, 골든 폰 61 · 키오스크 76).
10/18 밤~10/19 커밋으로 이미 늘었을 텐데, 움직이는 숫자를 쫓지 않고 **제출 커밋 하나의 수**로 한 번에 고치려고 그대로 두었다. 네 곳은 보고서 §6-3·부록 D, 소개서 2쪽, [README](../README.md), [체크리스트 §1-1](submission/제출-체크리스트.md)이다.

**ㅁ. 촬영 때 시각 루틴의 시각을 쉽게 바꿀 수 있나요?** [촬영 대본 장면 A](촬영-대본-2026-10-20-하드웨어-없이.md)는 22:00을 기다리지 않고
**루틴 시각을 촬영 시각 2~3분 뒤로 바꿔 두고 기다려 찍는다**(시각 규칙·실제 가전·상태 재조회는 그대로 실물). 폰에서 시각만 바꿔도 자동 실행 허용이 유지되는지, 아니면 다시 허용받아야 하는지 알려 주면 대본을 고친다.

**ㅂ. 실행 로그 내보내기(세션 A 3번)는 화면에 찍힐 수 있습니다.** [실물 장면 대본 §3](촬영-대본-실물-장면.md)이 누름 성공률을 셀 수 있게 기록 화면을 같이 찍는다.
사람이 읽는 출력에 **기기 주소·토큰·파일 경로가 들어가면 그 컷을 쓸 수 없다** — 빼 주거나, 가릴 수 있게 한 화면에 모아 주면 좋겠다.

**ㅅ. 내 영역이 아니어서 못 고친 것 — [제출 전 검증 과업](제출전-검증-과업.md) §2의 화면 인용이 낡았다.**
- U-3 성공 기준 "'안 할래요'(또는 '다음에')로 넘김" → 지금 화면은 **'이번엔 안 할게요'**다.
- U-5 이름은 '조용한 시간'인데 과업 문장은 잠시 쉬기다 — 지금은 **'잠시 쉬기'(지금부터 정한 시간)와 '조용한 시간'(매일 정한 시간대)이 다른 기능**이다.

같은 점검의 **현장 기록지는 지금 문구로 새로 만들어 두었다**([활용성 숫자 기록지](submission/활용성-숫자-기록지.md) §3, 핵심 과업 3개 + 선택 2개). 원본 문서를 누가 고칠지는 팀이 정하면 된다.

→ **닫음(2026-10-19, 세션 E):** [제출 전 검증 과업](제출전-검증-과업.md) §2의 U-3을 '이번엔 안 할게요'로, U-5를 '잠시 쉬기'(지금부터 정한 시간)로 고치고 매일 시간대의 '조용한 시간'과 다른 기능임을 적었다.

## 세션 E 진행 (2026-10-19, 세션 B 역할)

심사위원 두 명의 문서 의견(보고서·소개서가 길고 내부 번호가 많으며 단서가 이야기를 덮는다)에 따라 [개발완료보고서](submission/개발완료보고서-초안.md)·[작품소개서](submission/작품소개서-초안.md)를 한 이야기로 다시 짰다:
대상 → 문제 → 하는 일(승인 → 누름 → 전력으로 확인 → 공기청정기) → 하드웨어(맨 위 사진 자리, 함께 쓰는 것 / 새로 만든 것 한 표) → 시연 다섯 장면 → **실물/모의 표 하나(보고서 §5-1)와 '측정 뒤 기입' 칸(§5-2)** → 안전 설계 한 절(§6).
커밋 해시·내부 점검 번호와 본문 표현의 대응은 GitHub 전용 [근거 부록](submission/근거-부록.md)으로 옮겼다. 보고서 절 번호가 바뀌어 체크리스트·기록지·촬영 대본·질의응답의 '§' 참조를 함께 고쳤다.
