Seongwonp/Simplelay/docs/음성-의도-해석-조사-2026-10-19.md

# 음성 의도 해석 조사 (2026-10-19)

**질문:** 폰 음성 → RPi5 본체가 '가전이 할 수 있는 동작 목록' 중 하나로 해석 → 확인 카드 → 실행. 지금 해석은 **정확 비교 + 띄어쓰기·끝 문장부호 무시**(`rpi/services/thinq/bindings.py`의 `command_for_purpose`, 10/19 실기기에서 '공기 청정기 켜 줘'가 거절되던 것을 고친 단계)다.
이것을 **인터넷 없이 본체 안에서, 새 AI 시스템 없이(지도교수 방침 'AI 고도화 금지', 사용자 결정 '기존 기능 고도화만')** 무엇으로, 얼마나 가볍게 보강할 수 있는지 웹 자료로 조사했다.

**전제(바꾸지 않는 것):** 해석 결과는 **닫힌 목록(가전별 등록 동작 수~수십 개) 중 하나 또는 '모름'**. 목록 밖 짐작 금지, 실행 전 사람 확인 필수. 외부 클라우드 해석은 기본 꺼짐 선택지로만.

**읽는 법:** 모든 출처는 2026-10-19 확인. 수치는 출처가 잰 조건의 값이며 SimpleLay 본체에서 잰 값이 아니다 — 본체 값은 모두 `추측/측정 필요`. 상용 비서는 공개 설계 지침만 인용하고 성능 비교는 하지 않는다. 본체 사양은 RPi5(Cortex-A76 4코어 2.4 GHz, RAM 1~16 GB 판매)이며 **우리 보드의 RAM 용량은 확인 필요**([Raspberry Pi 5 제품 페이지](https://www.raspberrypi.com/products/raspberry-pi-5/)).

---

## 1. 닫힌 명령 집합 의도 분류 — 가벼운 방법 비교

| 방법 | 정확도 경향 | RPi급 CPU 지연 | 메모리 | 오프라인 | 설명 가능성 | '모름' 처리 |
| --- | --- | --- | --- | --- | --- | --- |
| A. 규칙 + 정규화 + 별칭(동의어) 사전 | 사전에 있는 말은 확실, 없는 말은 전부 실패 | 마이크로초 수준(추측/측정 필요) | 무시할 수준 | 예 | 가장 높음 — "'공청기'는 '공기청정기'의 별칭" | 일치 없으면 그대로 '모름' |
| B. 퍼지 문자열 매칭(편집 거리, 한글 자모 분해) | 오타·STT 한두 글자 오류에 강함, 뜻이 다른 비슷한 말(켜/꺼)에 위험 | 수십 개 후보면 밀리초 미만(추측/측정 필요) | 수 MB 미만 | 예 | 높음 — 점수와 가장 가까운 후보를 보여 줄 수 있음 | 점수 하한(cutoff) 미만이면 '모름' |
| C. 문장 임베딩 최근접(다국어 소형 모델, ONNX/CPU) | 바꿔 말하기에 강함, 짧은 반대말 구분은 약할 수 있음 | 출처 측정: 인텔 노트북 CPU에서 문장당 약 49 ms — RPi5는 측정 필요 | 모델 약 1.2억 매개변수, int8 ONNX 있음(파일 수백 MB급, 추측/측정 필요) | 예 | 중간 — 유사도 값만 설명 근거 | 유사도 하한 + 1·2위 차이로 '모름' |
| D. 소형 분류기(few-shot, 예: 임베딩 + 분류 머리) | 예문 몇 개로도 쓸 만하다는 보고 | C와 비슷 | C와 비슷 | 예 | 낮음~중간 | 확률 하한(보정 필요) |
| E. 소형 LLM + 선택지 제한 문법(llama.cpp GBNF) | 문맥 이해 가장 넓음, 근거 설명 어려움 | 출처 측정: RPi5에서 1~1.5B 4비트 모델 생성 약 10~11.5 토큰/초(프롬프트 처리 별도) | 1.4~2.4 GB RAM | 예 | 낮음 | 문법에 '모름' 선택지를 넣어야 함, 확률 보정 어려움 |

근거:
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
