Seongwonp/Simplelay/docs/UI-개편안-2026-10-17.md

# UI 개편안 — 쉬운 말과 화면 구조 (2026-10-17)

지도교수 의견: "UI 구조가 별로고 AI가 만든 느낌이 난다. 말투가 엔지니어 설명 같다 — 전문용어를 모르는 사람은 어떻게 하나."
폰 문구·키오스크/서버 문구·화면 구조를 따로 감사한 결과를 한 장으로 묶었다(감사 원문은 저장소 밖 작업 기록).
기준 문서: [UI 제품 앱·공개 레퍼런스](ui-product-app-references.md), [UI 참고 자료와 적용 기준](UI-참고자료와-적용기준.md), [결선 전 SW 보완 피드백](결선전-SW-보완-피드백.md).

## 1. 왜 그렇게 보이나 (감사 요약)

**말투**
- 한 물건을 여러 이름으로 부른다. 본체 = 허브·서버·키오스크·SimpleLay 본체·기기, 누름 장치 = 작은 팔·작은 팔 장치·누름 장치·모션 보드·모터 보드·구동 장치·노드, 쉬기 = 방해 금지·제안 잠시 쉬기·조용한 시간.
  앱이 스스로 "키오스크에서는 'SimpleLay 본체'라고 불러요"라고 해명하는 것이 그 증거다.
- 문장이 **결과가 아니라 판정 근거**를 설명한다 — 전력, 상태 재조회, 접수, 변경 명령, 모션 보드 응답, mA·dB·ms.
- 방어 문장을 겹친다 — "~않아요. ~않아요. ~않아요.", '—'·'·'·괄호로 이어 붙인 문장(폰만 대시 36개·가운뎃점 약 50개), 같은 경고("다시 시도하지 마세요")가 한 화면에 2~3번.
- 평가 지적을 **문장을 더해서** 고쳐 왔다 — 화면이 읽는 문서가 됐다(조용한 시간 설명 6줄, 공기 줄 '종합은 가전이 매긴 등급').

**구조·디자인**
- 모든 화면이 '제목 + 회색 설명 + 테두리 버튼' 한 가지 문법이다. 그림·숫자·배지 대신 문장이 정보를 나른다.
- 스마트홈의 중심인 **가전 상태가 화면 맨 위에 없다**(공기청정기 카드에 켜짐/꺼짐도 공기질도 없다).
- 같은 모양 버튼이 반복된다(홈 '실행하기' 4개, 루틴 '편집/실행하기' 6쌍, 행마다 '지우기').
- 토큰은 있는데 코드가 따르지 않는다 — 폰 글자 크기 15종(11~34), 간격 14종. 아이콘은 Material 기본 혼용(루틴 개념에 아이콘 3개).
- 키오스크 제안·실행·결과의 배치가 모두 다르다. 이 제품만의 그림인 '실제 가전 버튼판'이 실행 중 화면에만 나온다.

## 2. 말투 규칙

1. **한 화면 = 결과 한 줄 + 할 일 한 줄.** 근거·원리 설명은 '자세히'로 접는다.
2. **사람이 주어, 가전이 주어.** 시스템 내부(본체가 보냈다, 상태를 다시 읽었다)를 말하지 않는다.
3. **세 가지 결과 말로 끝낸다:** 됐어요 · 몰라요(봐 주세요) · 못 했어요. 확인 못 한 것을 됐다고 하지 않는다(안전 계약 유지).
4. '—', 괄호, 가운뎃점으로 문장을 잇지 않는다. 두 문장이면 마침표.
5. 같은 경고는 화면에 한 번. "~않아요"를 두 번 넘게 잇지 않는다.
6. 숫자·단위(mA, dB, ms, %, IP, 포트, HTTP 코드, 예외 원문)는 일반 화면에 내지 않는다.
7. 해요체, 짧게. 한 줄에 들어가면 한 줄.
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
