Seongwonp/Simplelay/docs/design/brand/simplelay-wordmark-dark-on-light.png

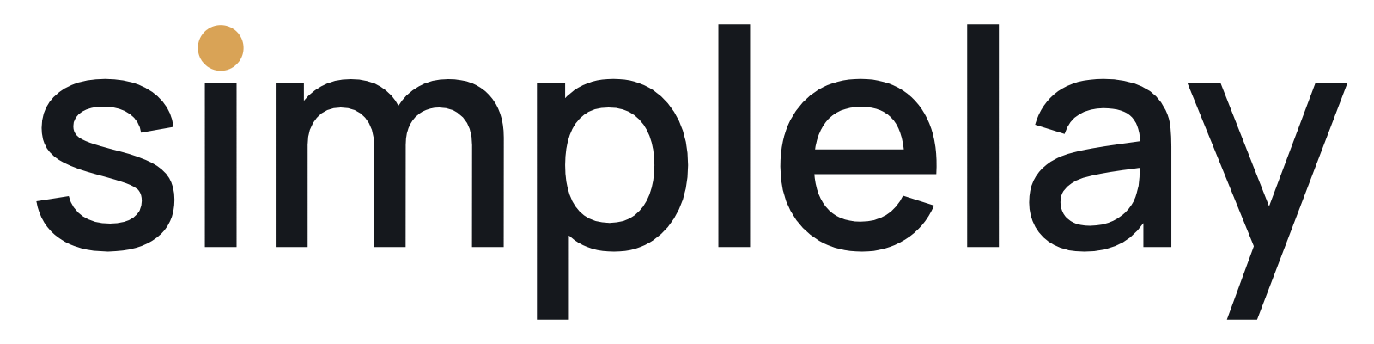
docs/design/brand/simplelay-wordmark-dark-on-light.png
