Seongwonp/Simplelay/docs/design/brand/simplelay-wordmark-light-on-dark.png

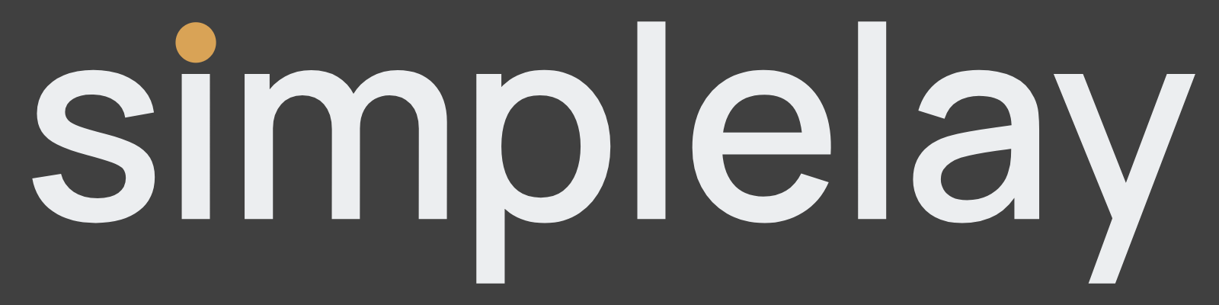
docs/design/brand/simplelay-wordmark-light-on-dark.png
