Seongwonp/Simplelay/docs/screenshots/app_home.png

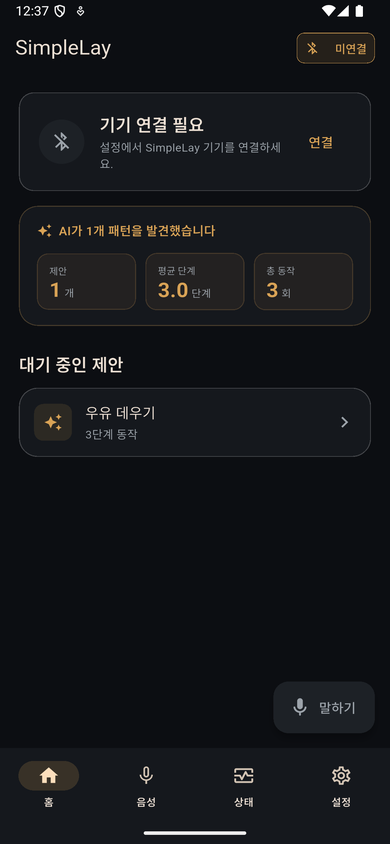
docs/screenshots/app_home.png
