Seongwonp/Simplelay/docs/screenshots/app_home_empty.png

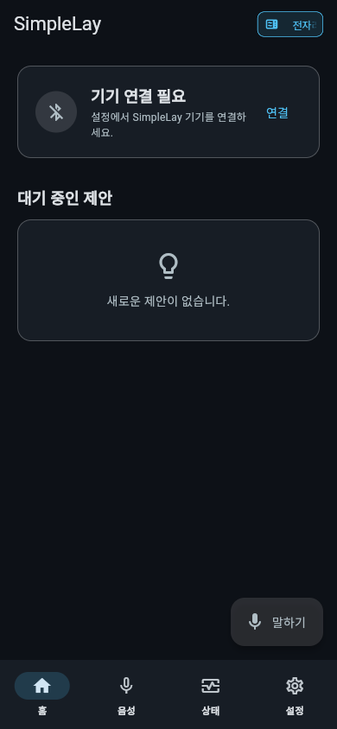
docs/screenshots/app_home_empty.png
