Seongwonp/Simplelay/docs/screenshots/app_home_light.png

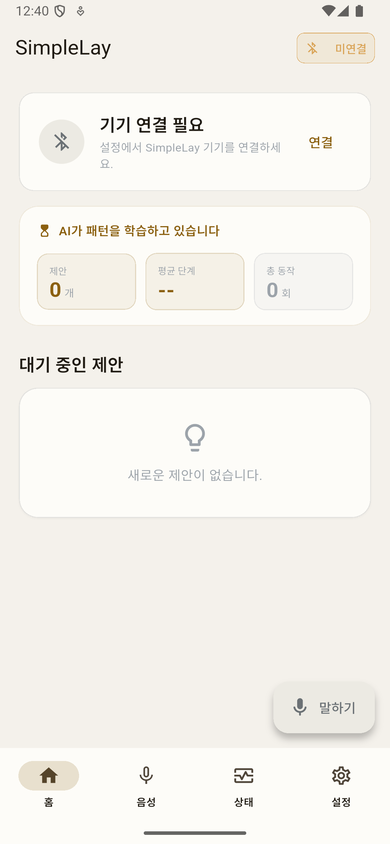
docs/screenshots/app_home_light.png
