Seongwonp/Simplelay/docs/screenshots/app_settings.png

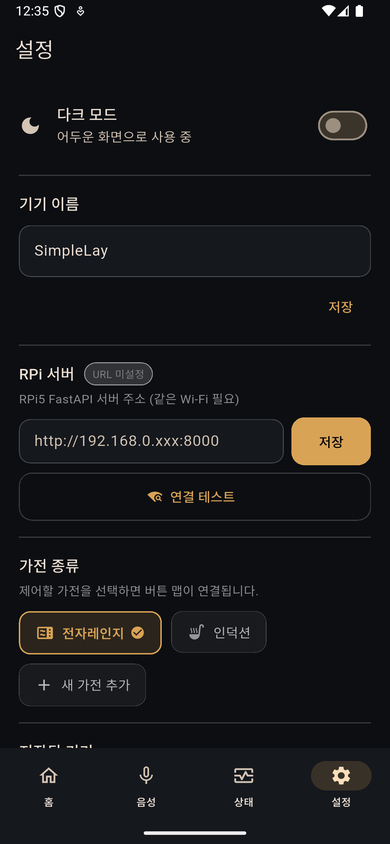
docs/screenshots/app_settings.png
