Seongwonp/Simplelay/docs/screenshots/app_status.png

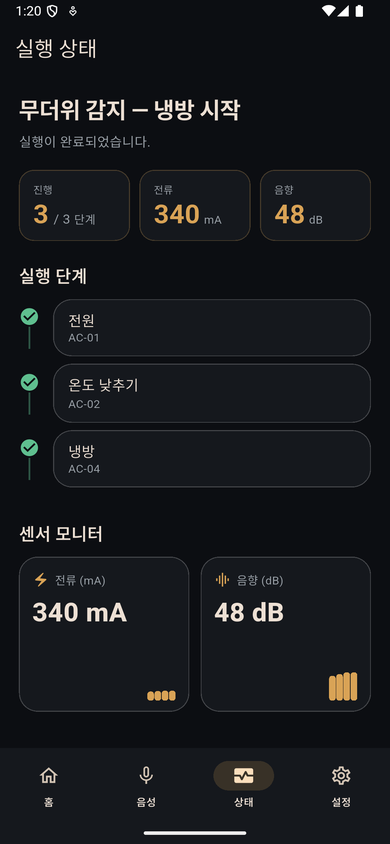
docs/screenshots/app_status.png
