Seongwonp/Simplelay/docs/screenshots/app_suggestion.png

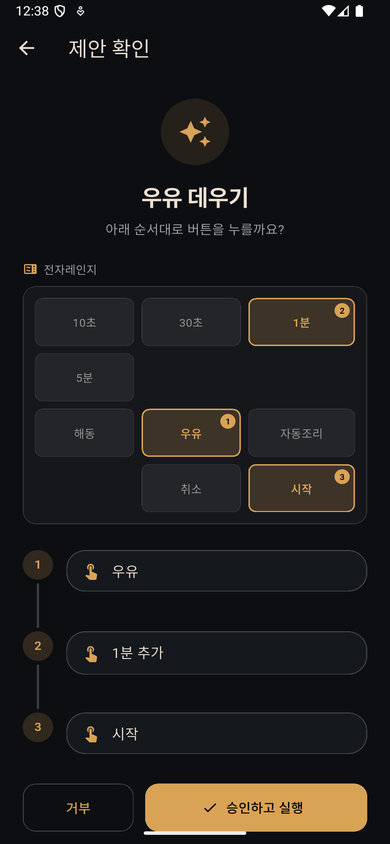
docs/screenshots/app_suggestion.png
