Seongwonp/Simplelay/docs/screenshots/touchscreen_done.png

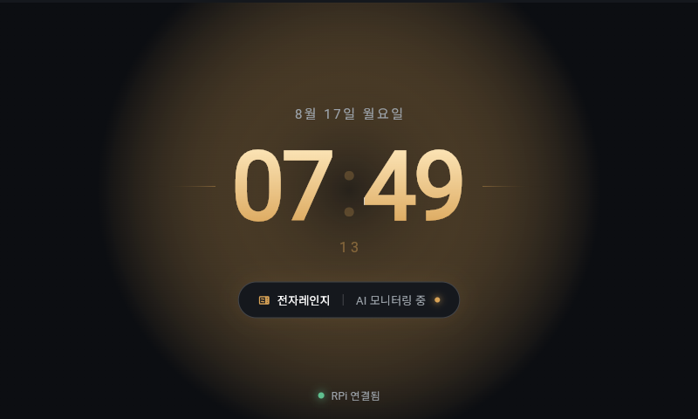
docs/screenshots/touchscreen_done.png
