Seongwonp/Simplelay/docs/screenshots/touchscreen_executing.png

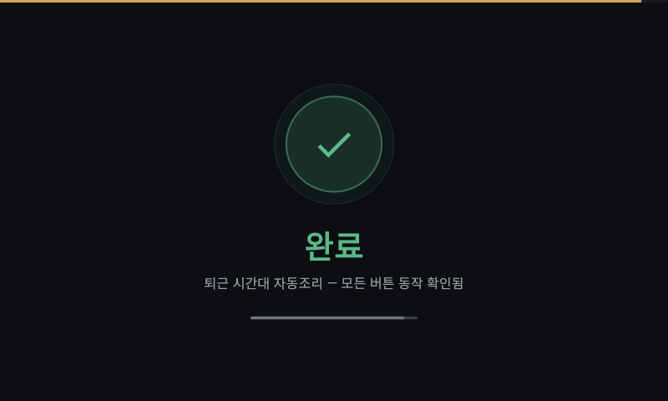
docs/screenshots/touchscreen_executing.png
