Seongwonp/Simplelay/docs/screenshots/touchscreen_idle.png

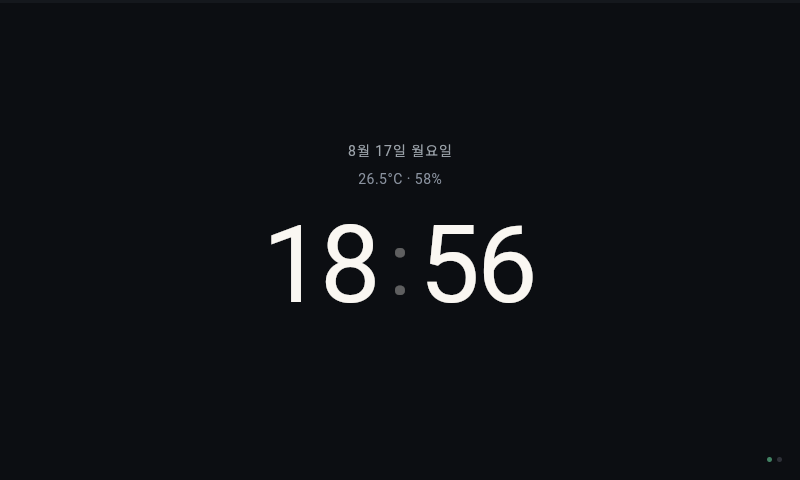
docs/screenshots/touchscreen_idle.png
