Seongwonp/Simplelay/docs/screenshots/touchscreen_suggestion.png

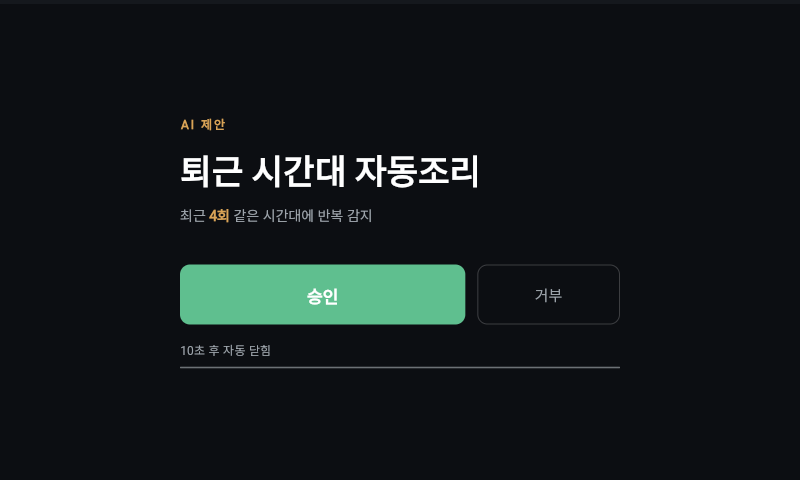
docs/screenshots/touchscreen_suggestion.png
