Seongwonp/Simplelay/docs/submission/img/kiosk-air-suggestion-real-2026-10-20.png

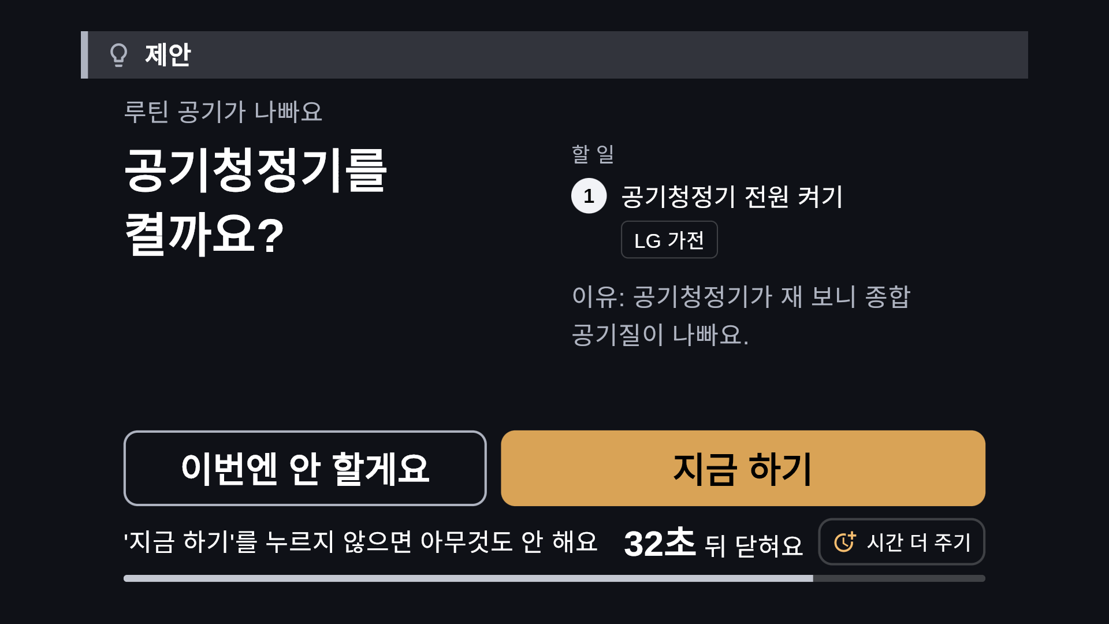
docs/submission/img/kiosk-air-suggestion-real-2026-10-20.png
