Seongwonp/Simplelay/docs/submission/img/kiosk-appliance-actions-render-2026-10-24.png

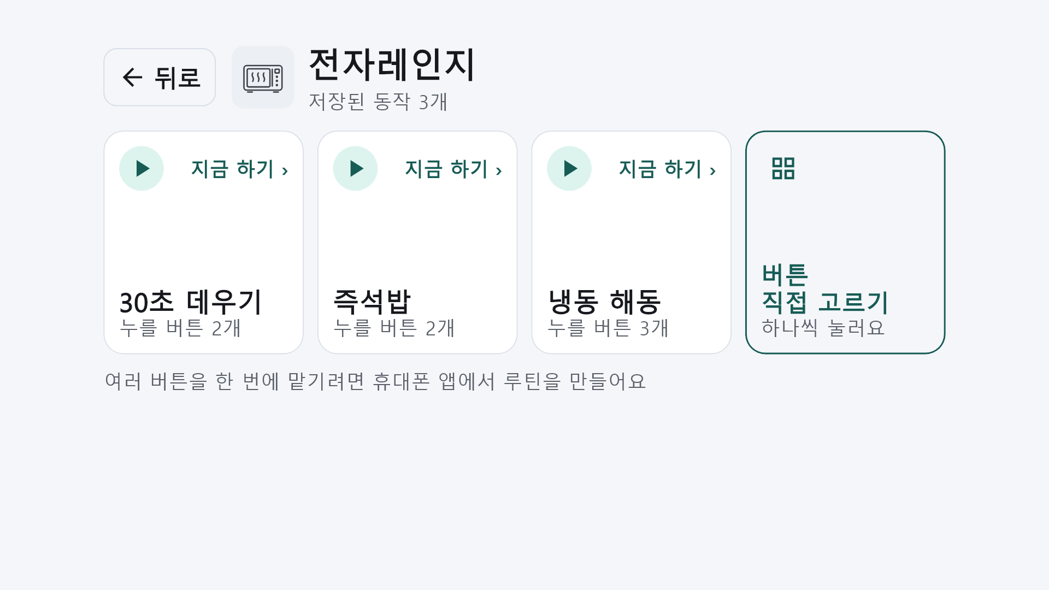
docs/submission/img/kiosk-appliance-actions-render-2026-10-24.png
