Seongwonp/Simplelay/docs/submission/img/kiosk-appliance-buttons-render-2026-10-24.png

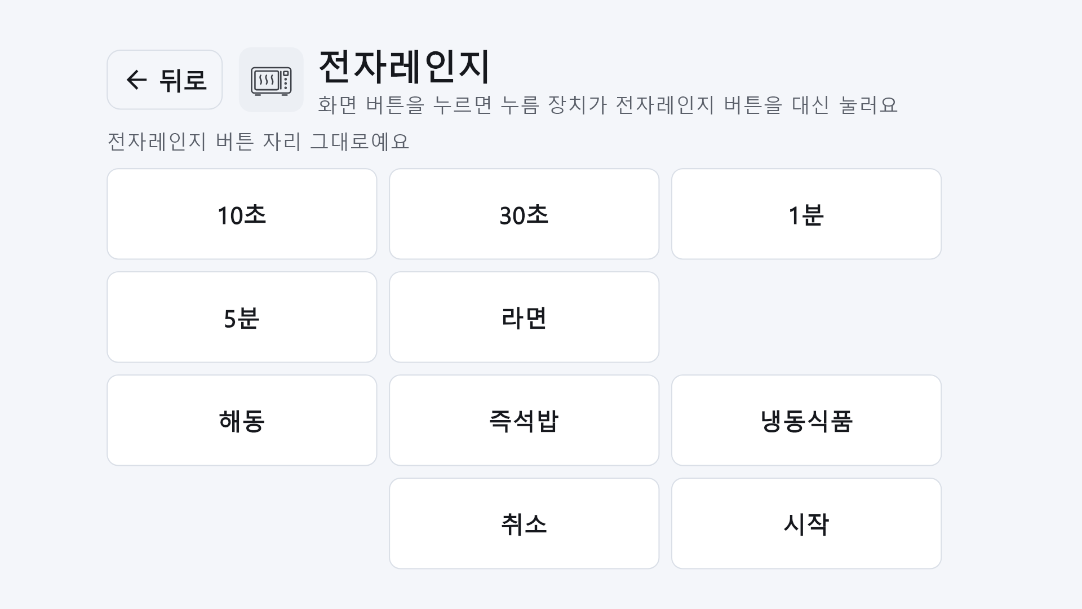
docs/submission/img/kiosk-appliance-buttons-render-2026-10-24.png
