Seongwonp/Simplelay/docs/submission/img/kiosk-approve-card-real-panel-2026-10-20.png

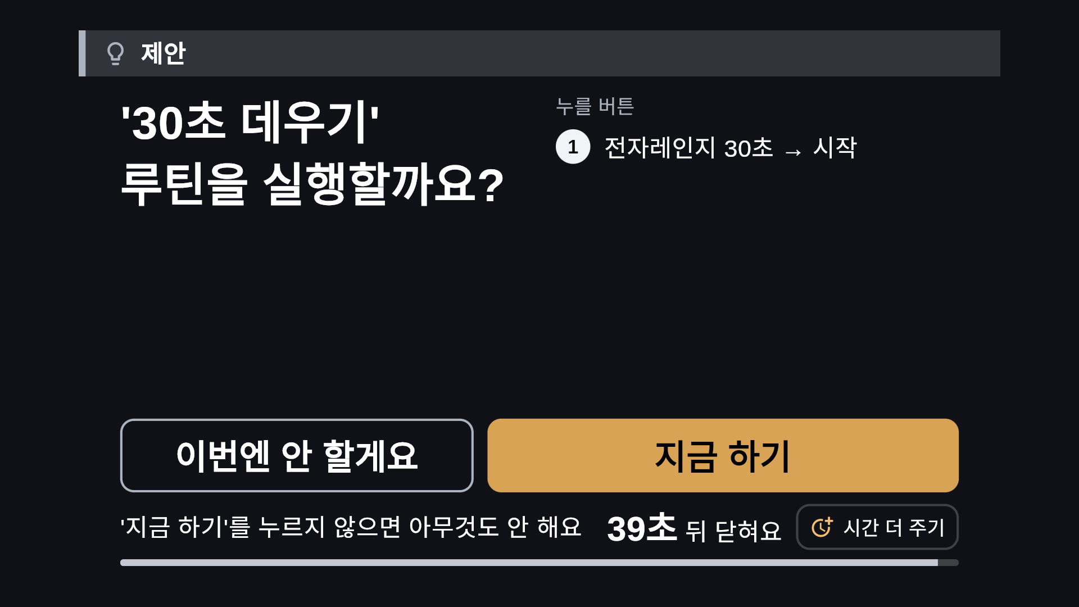
docs/submission/img/kiosk-approve-card-real-panel-2026-10-20.png
