Seongwonp/Simplelay/docs/submission/img/kiosk-approve-card-render-2026-10-24.png

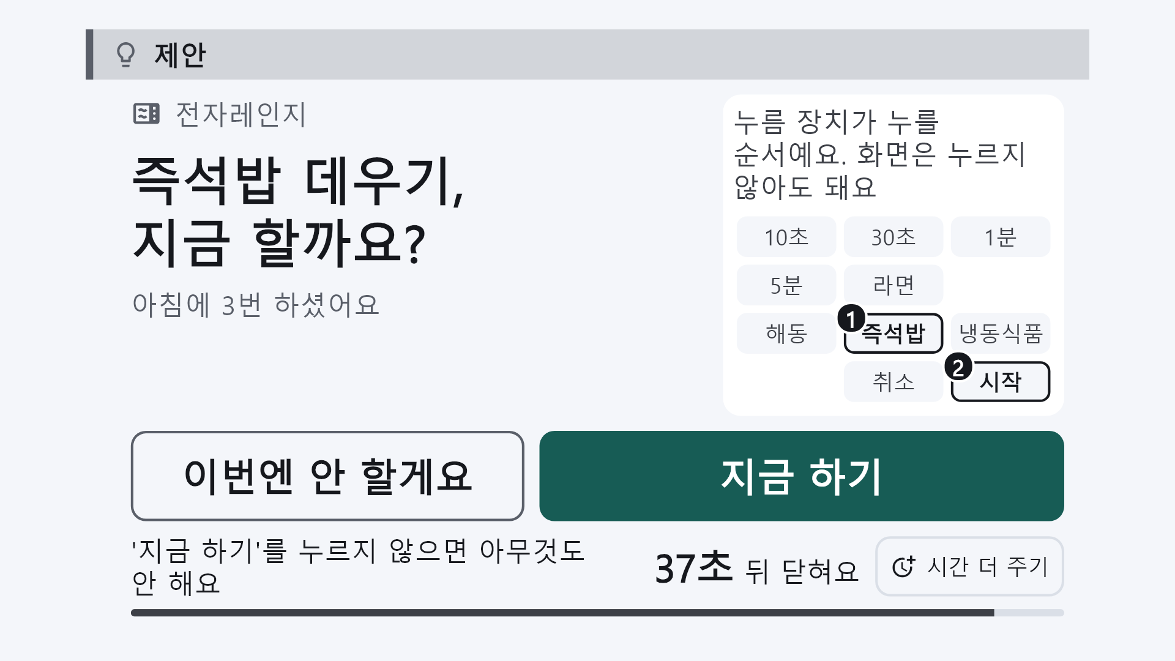
docs/submission/img/kiosk-approve-card-render-2026-10-24.png
