Seongwonp/Simplelay/docs/submission/img/kiosk-done-continue-render-2026-10-24.png

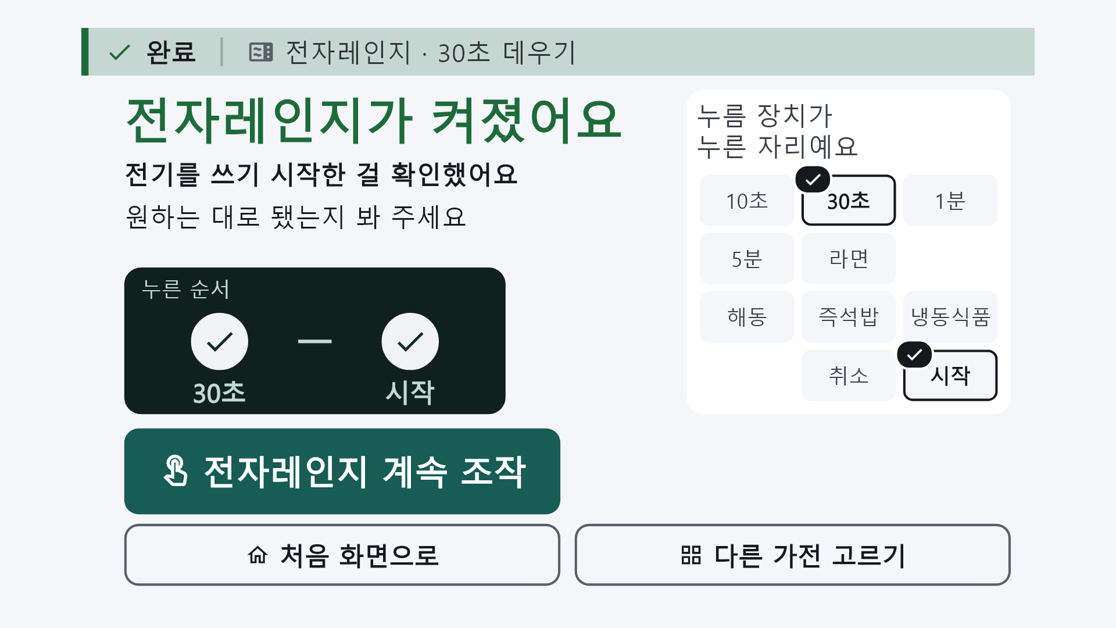
docs/submission/img/kiosk-done-continue-render-2026-10-24.png
