Seongwonp/Simplelay/docs/submission/img/kiosk-done-mock.png

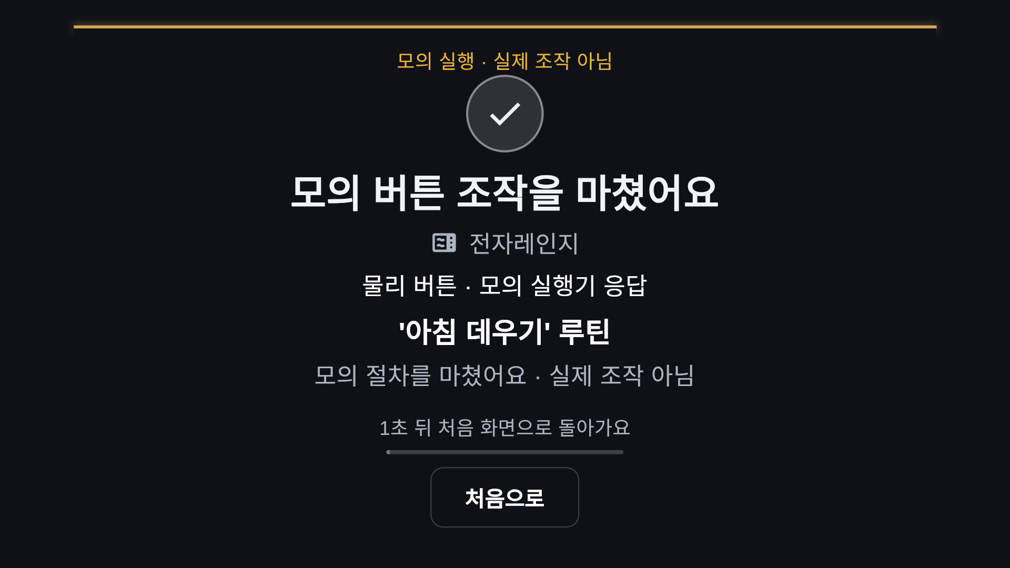
docs/submission/img/kiosk-done-mock.png
