Seongwonp/Simplelay/docs/submission/img/kiosk-estop-rehearsal.png

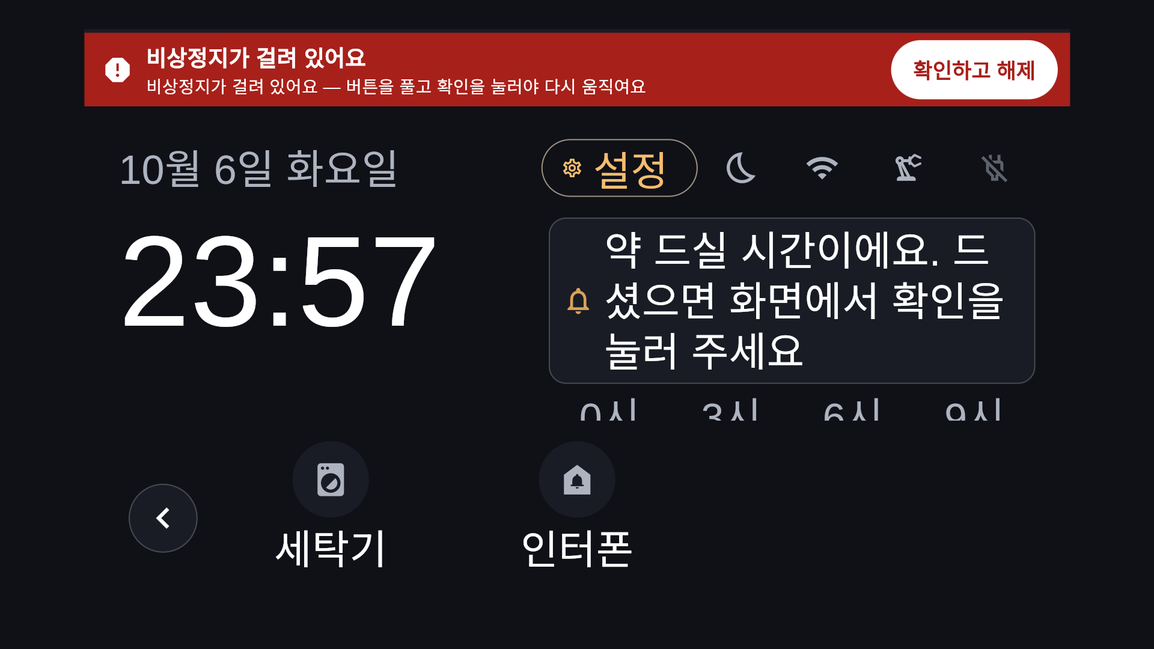
docs/submission/img/kiosk-estop-rehearsal.png
