Seongwonp/Simplelay/docs/submission/img/kiosk-idle-dark-render-2026-10-24.png

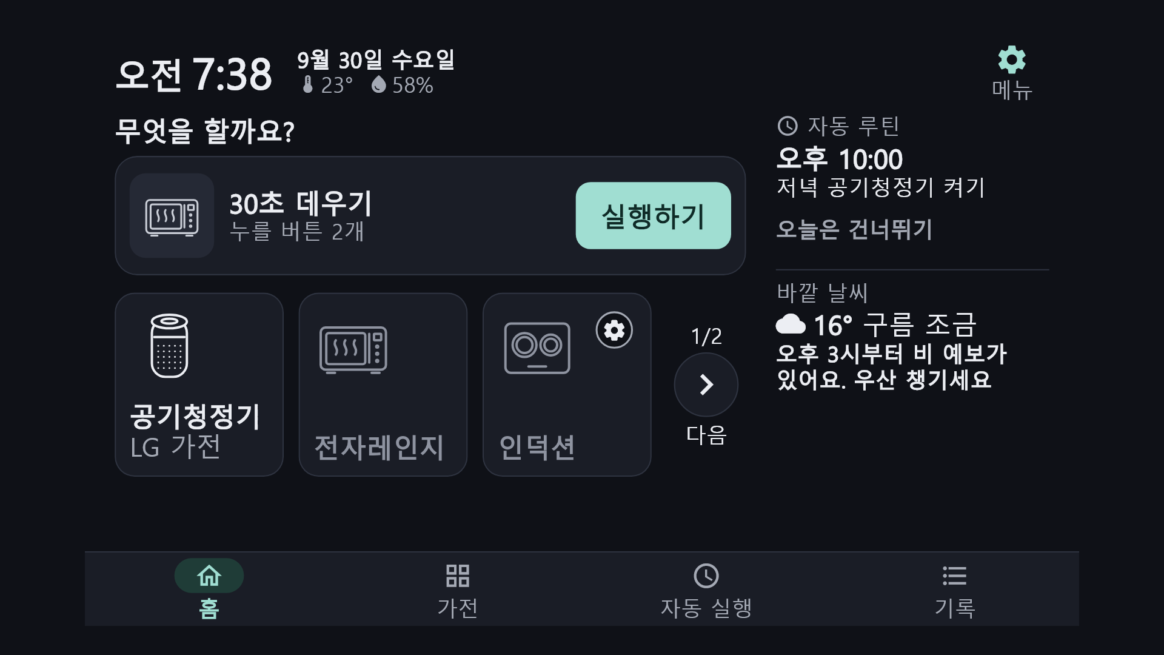
docs/submission/img/kiosk-idle-dark-render-2026-10-24.png
