Seongwonp/Simplelay/docs/submission/img/kiosk-idle-real-panel-2026-10-19.png

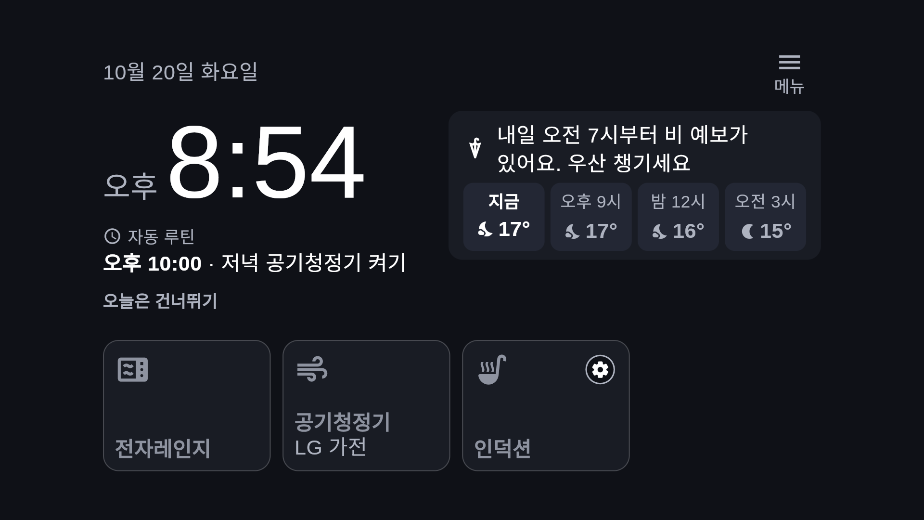
docs/submission/img/kiosk-idle-real-panel-2026-10-19.png
