Seongwonp/Simplelay/docs/submission/img/kiosk-idle-real-panel-2026-10-24.png

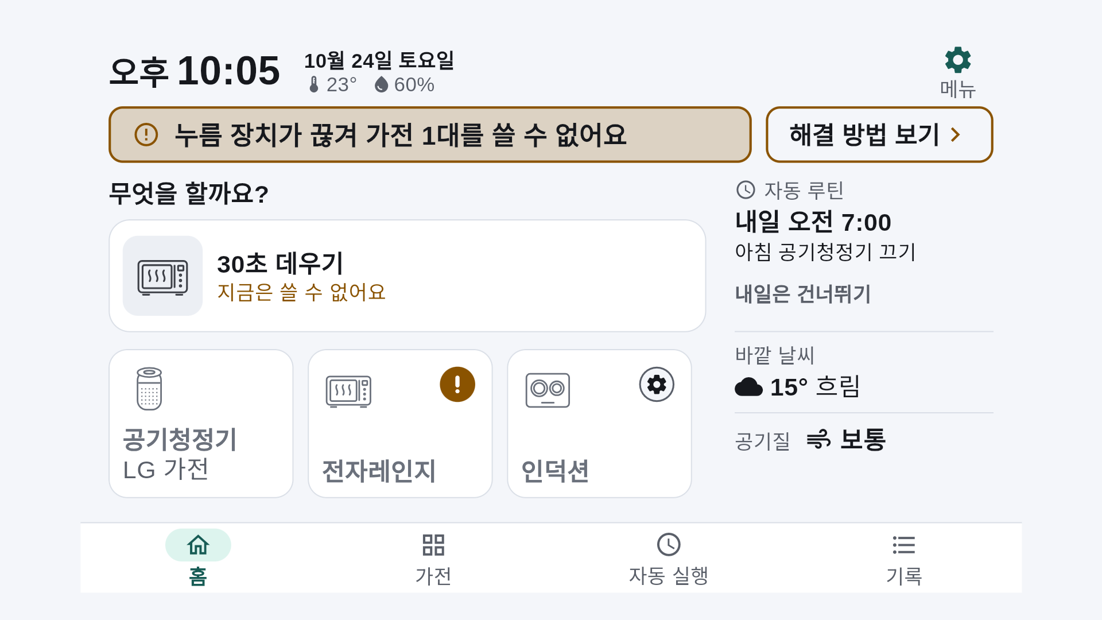
docs/submission/img/kiosk-idle-real-panel-2026-10-24.png
