Seongwonp/Simplelay/docs/submission/img/kiosk-idle.png

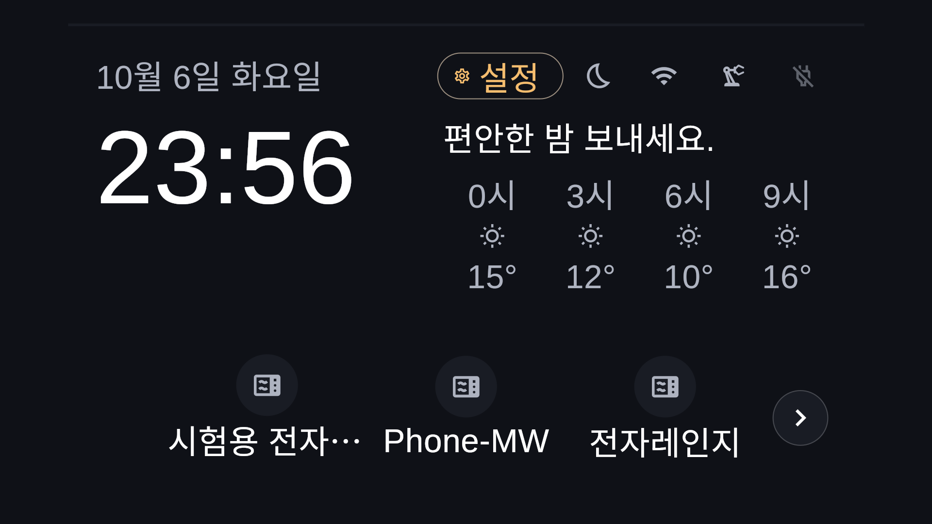
docs/submission/img/kiosk-idle.png
