Seongwonp/Simplelay/docs/submission/img/kiosk-my-appliances.png

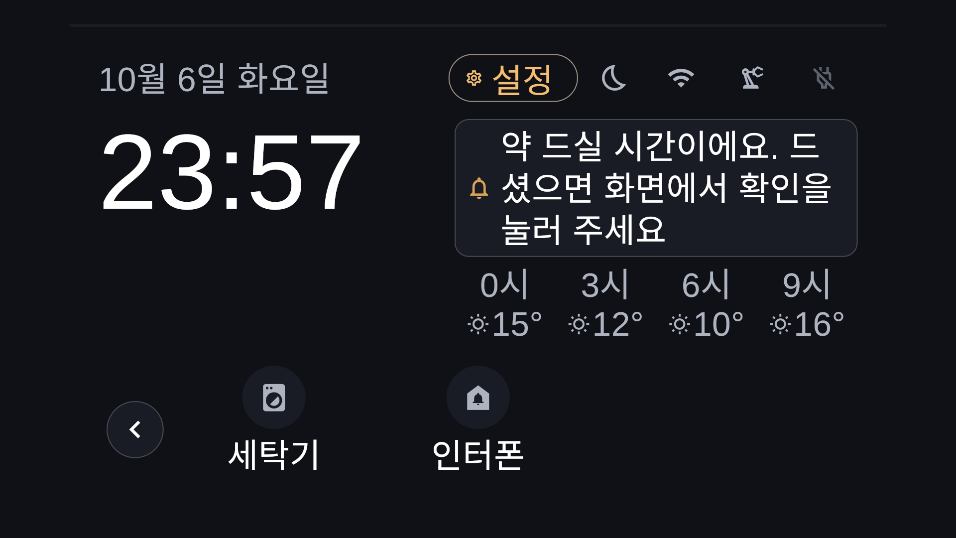
docs/submission/img/kiosk-my-appliances.png
