Seongwonp/Simplelay/docs/submission/img/kiosk-routine-card.png

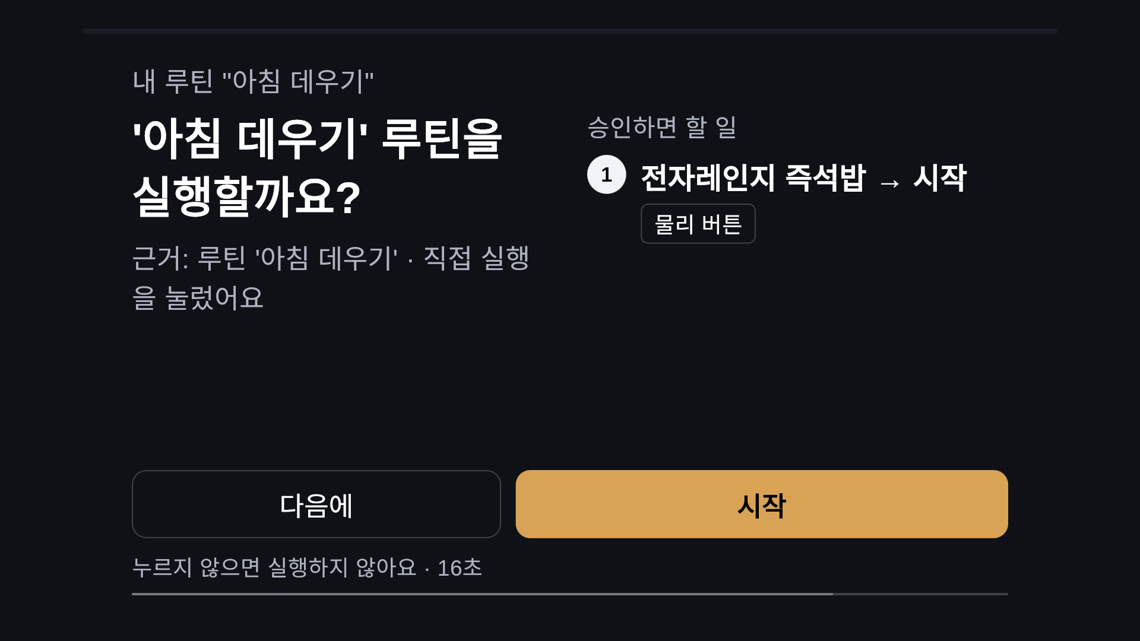
docs/submission/img/kiosk-routine-card.png
