Seongwonp/Simplelay/docs/submission/img/kiosk-running-real-panel-2026-10-20.png

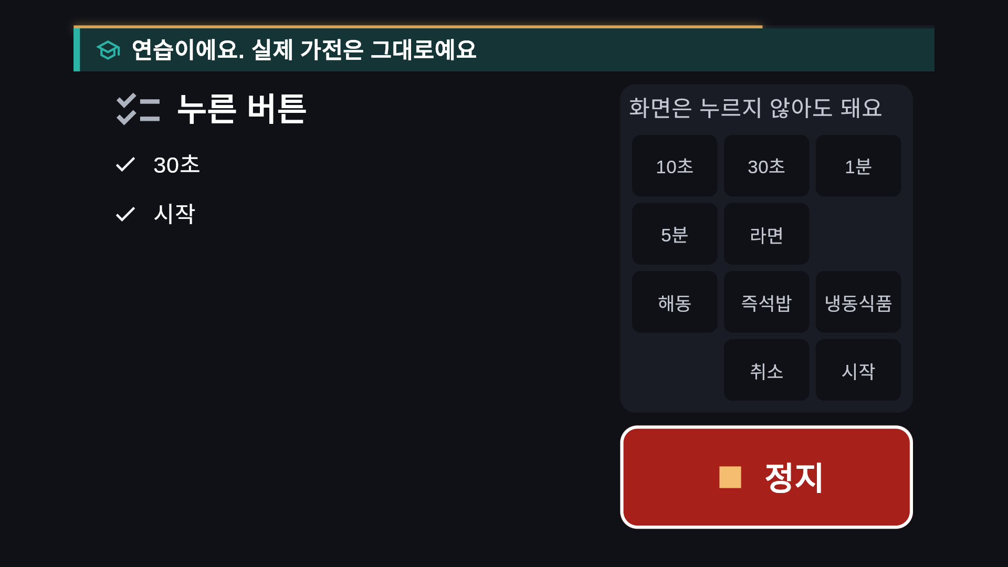
docs/submission/img/kiosk-running-real-panel-2026-10-20.png
