Seongwonp/Simplelay/docs/submission/img/kiosk-thinq-airquality-real-2026-10-20.png

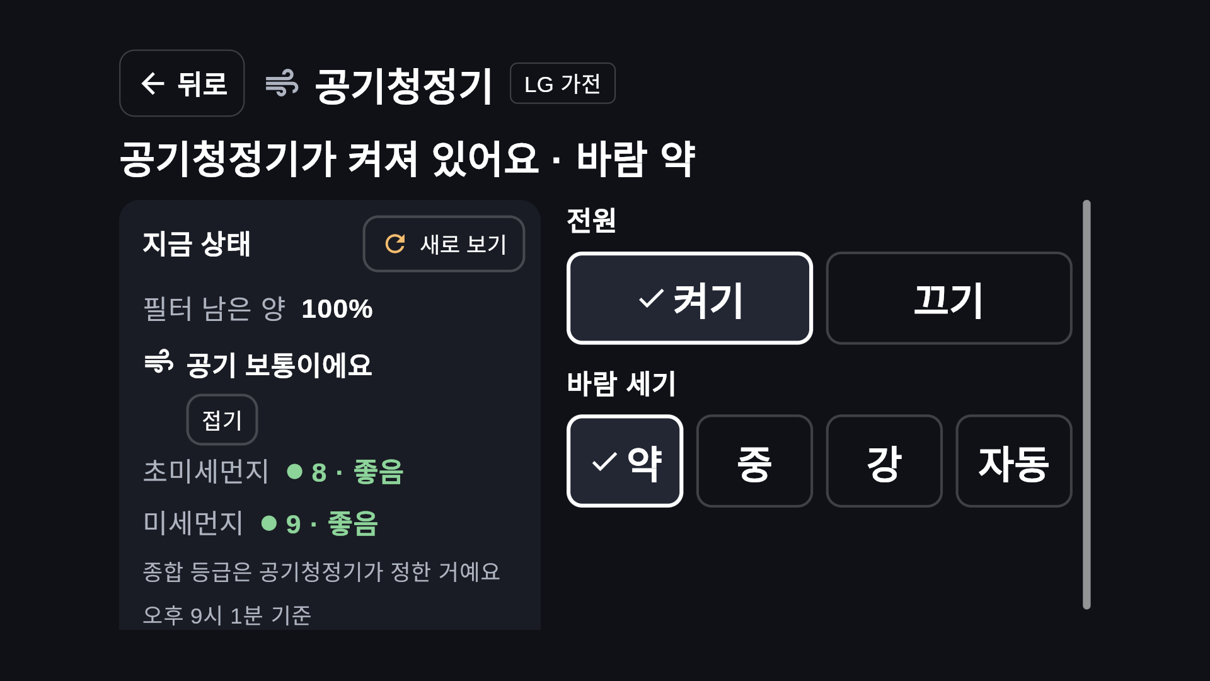
docs/submission/img/kiosk-thinq-airquality-real-2026-10-20.png
