Seongwonp/Simplelay/docs/submission/img/kiosk-thinq-detail-render-2026-10-24.png

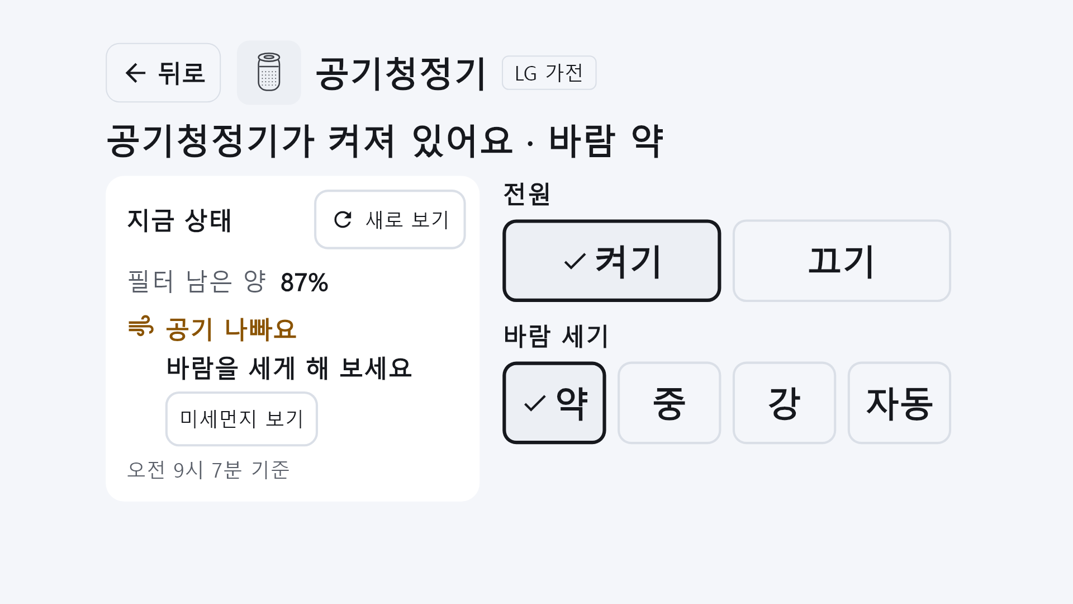
docs/submission/img/kiosk-thinq-detail-render-2026-10-24.png
