Seongwonp/Simplelay/docs/submission/img/kiosk-thinq-done-real-2026-10-20.png

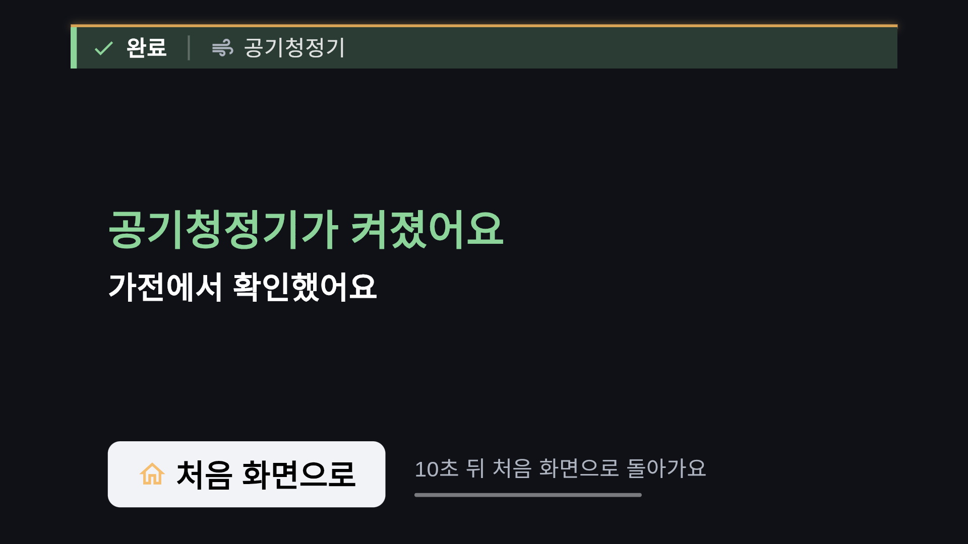
docs/submission/img/kiosk-thinq-done-real-2026-10-20.png
