Seongwonp/Simplelay/docs/submission/img/kiosk-wash-done-injected.png

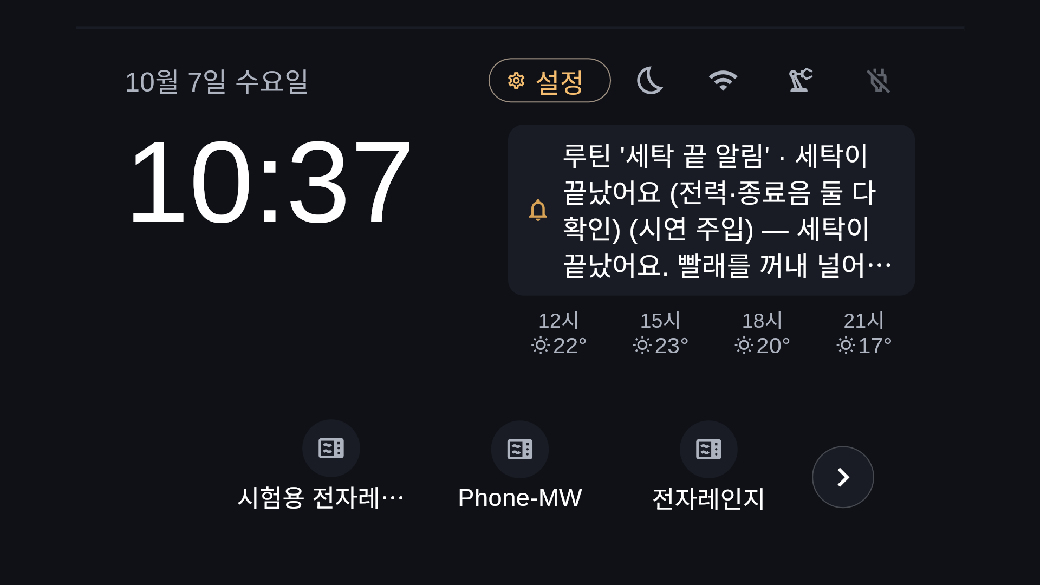
docs/submission/img/kiosk-wash-done-injected.png
