Seongwonp/Simplelay/docs/submission/img/phone-add-appliance-2026-10-24.png

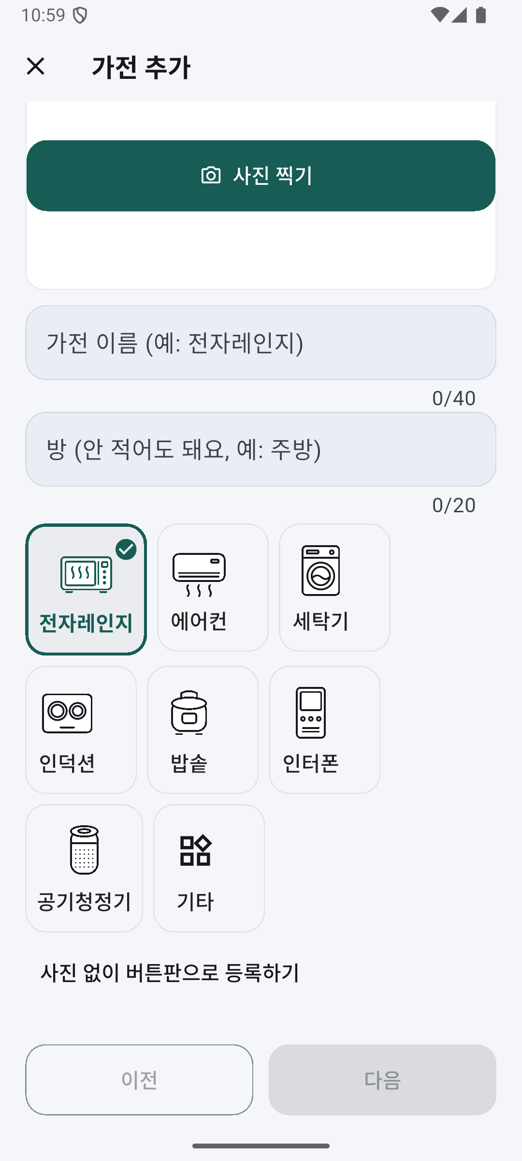
docs/submission/img/phone-add-appliance-2026-10-24.png
