Seongwonp/Simplelay/docs/submission/img/phone-add-appliance.png

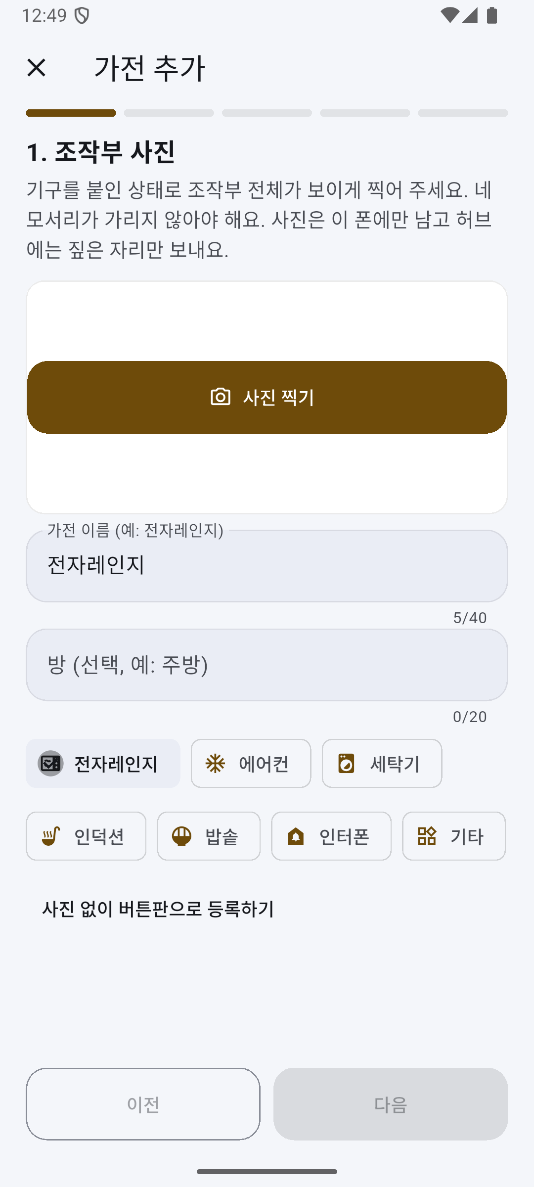
docs/submission/img/phone-add-appliance.png
