Seongwonp/Simplelay/docs/submission/img/phone-air-suggestion-real-2026-10-20.png

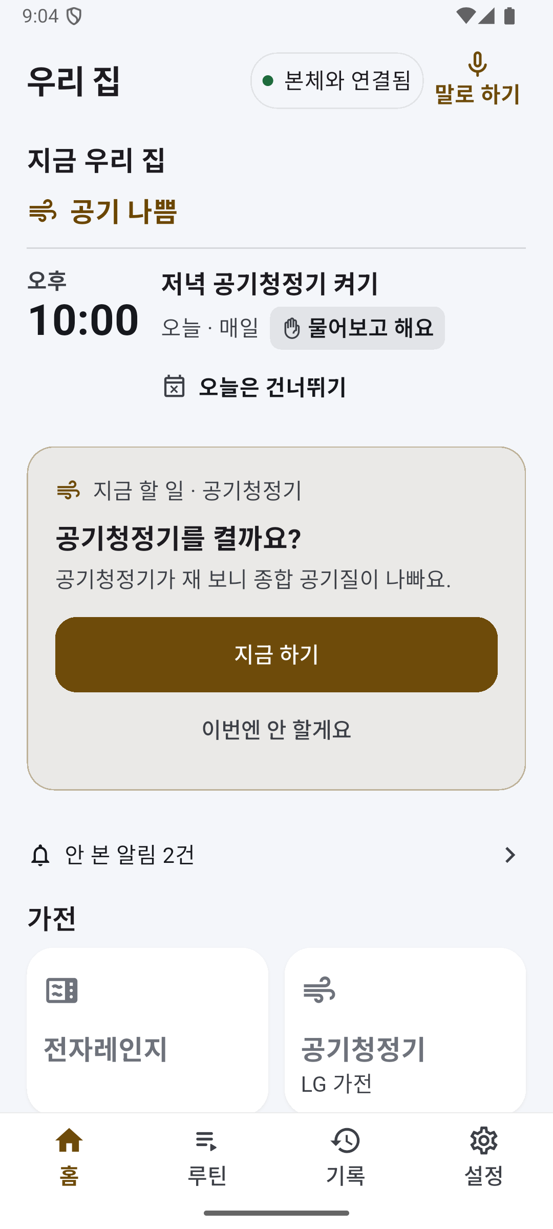
docs/submission/img/phone-air-suggestion-real-2026-10-20.png
