Seongwonp/Simplelay/docs/submission/img/phone-approve-blocked-2026-10-24.png

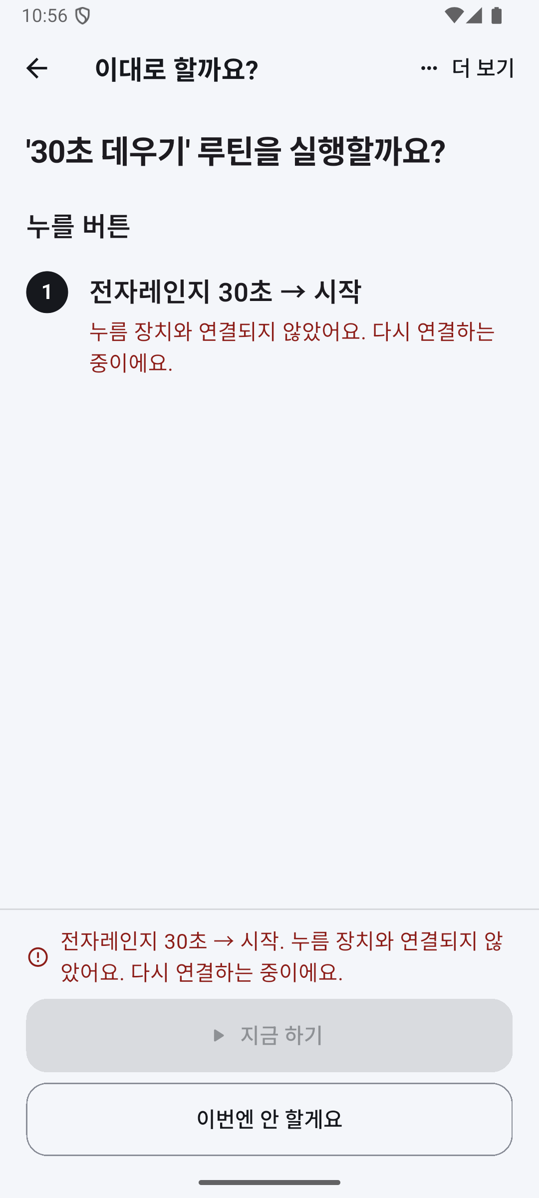
docs/submission/img/phone-approve-blocked-2026-10-24.png
