Seongwonp/Simplelay/docs/submission/img/phone-approve-confirm.png

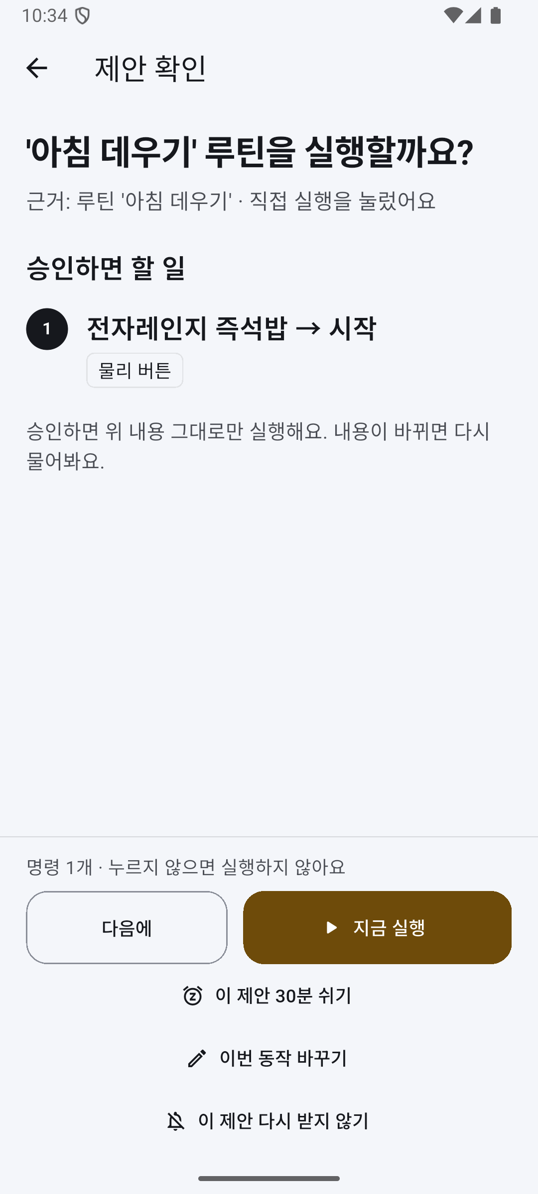
docs/submission/img/phone-approve-confirm.png
