Seongwonp/Simplelay/docs/submission/img/phone-approve-real-hub-2026-10-20.png

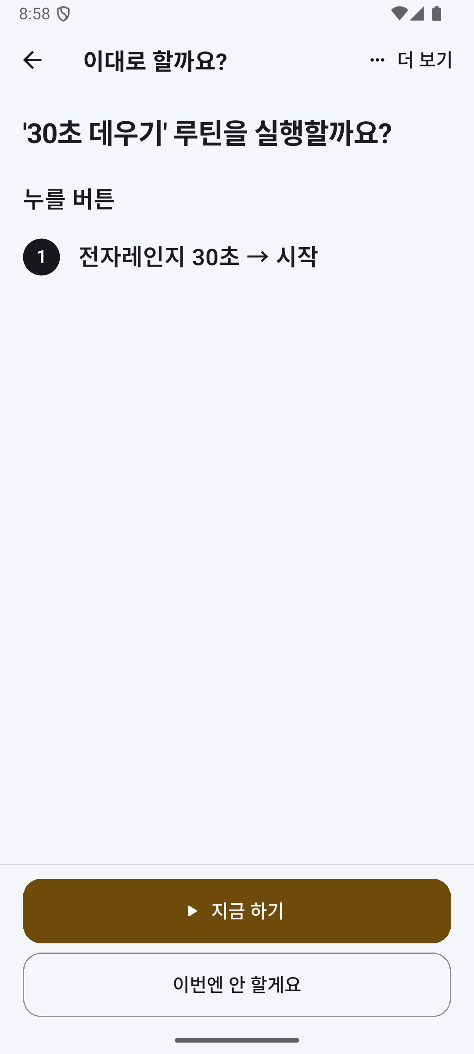
docs/submission/img/phone-approve-real-hub-2026-10-20.png
