Seongwonp/Simplelay/docs/submission/img/phone-auto-run-2026-10-24.png

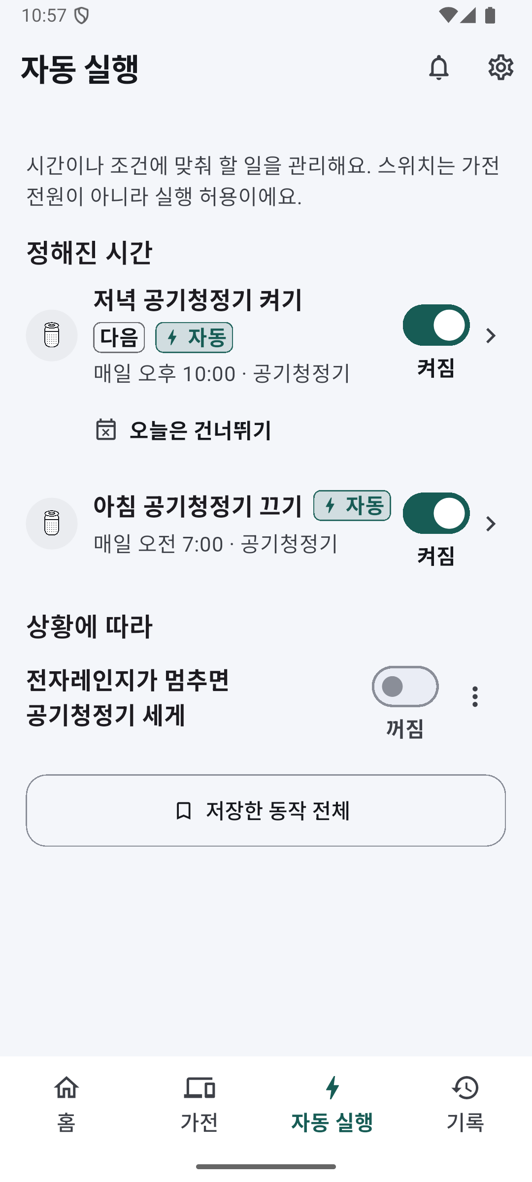
docs/submission/img/phone-auto-run-2026-10-24.png
