Seongwonp/Simplelay/docs/submission/img/phone-estop-refused.png

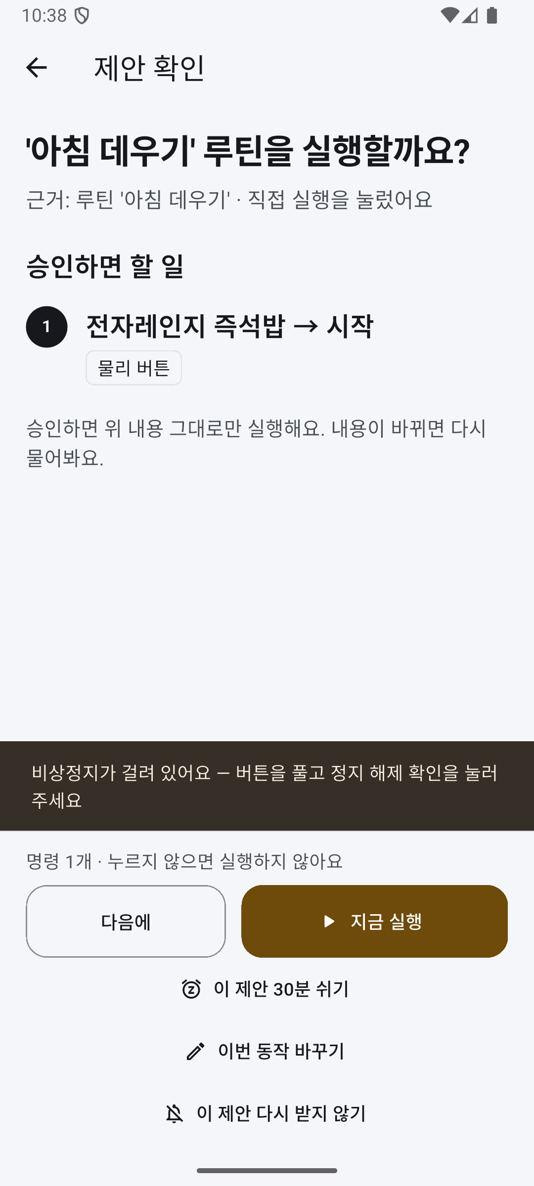
docs/submission/img/phone-estop-refused.png
