Seongwonp/Simplelay/docs/submission/img/phone-estop-rehearsal.png

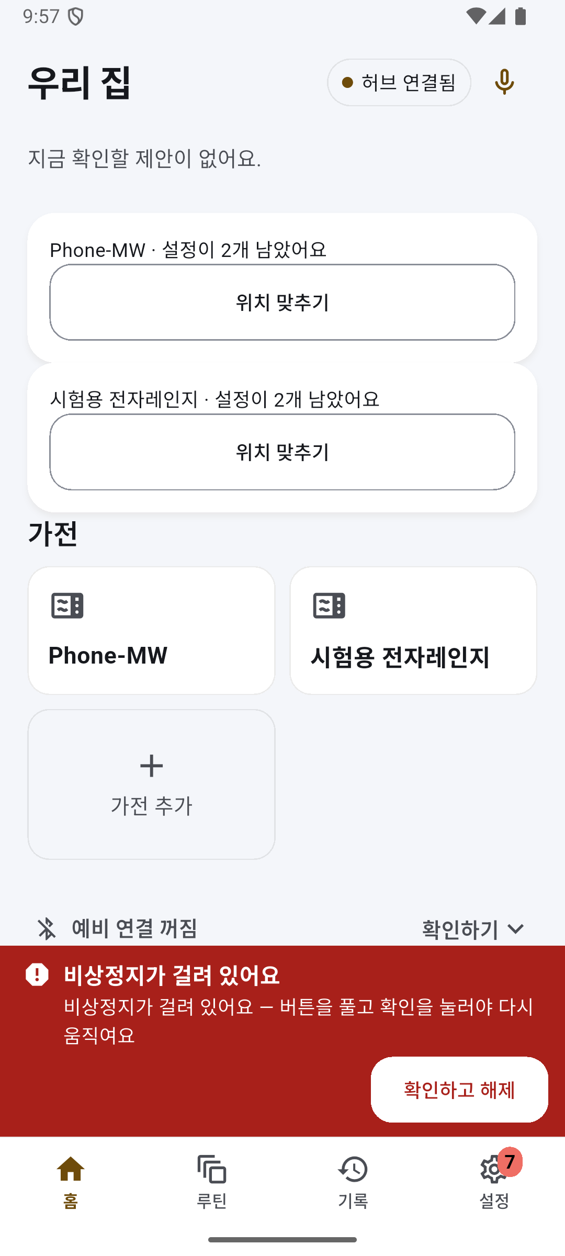
docs/submission/img/phone-estop-rehearsal.png
