Seongwonp/Simplelay/docs/submission/img/phone-home-dark-2026-10-24.png

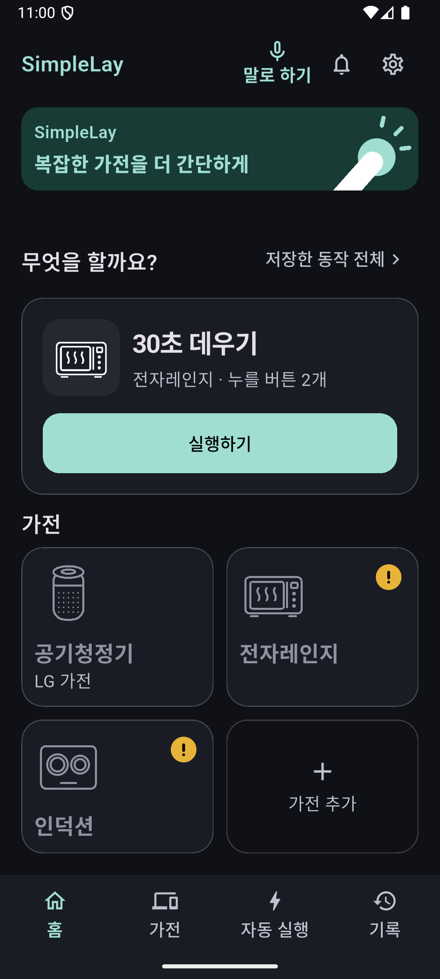
docs/submission/img/phone-home-dark-2026-10-24.png
