Seongwonp/Simplelay/docs/submission/img/phone-home-large-text-2026-10-24.png

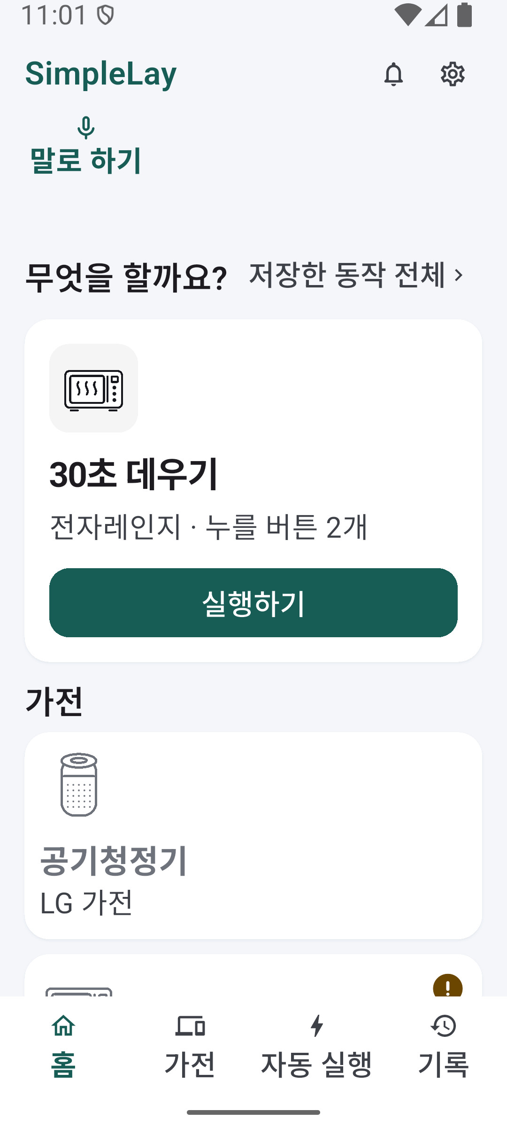
docs/submission/img/phone-home-large-text-2026-10-24.png
