Seongwonp/Simplelay/docs/submission/img/phone-home.png

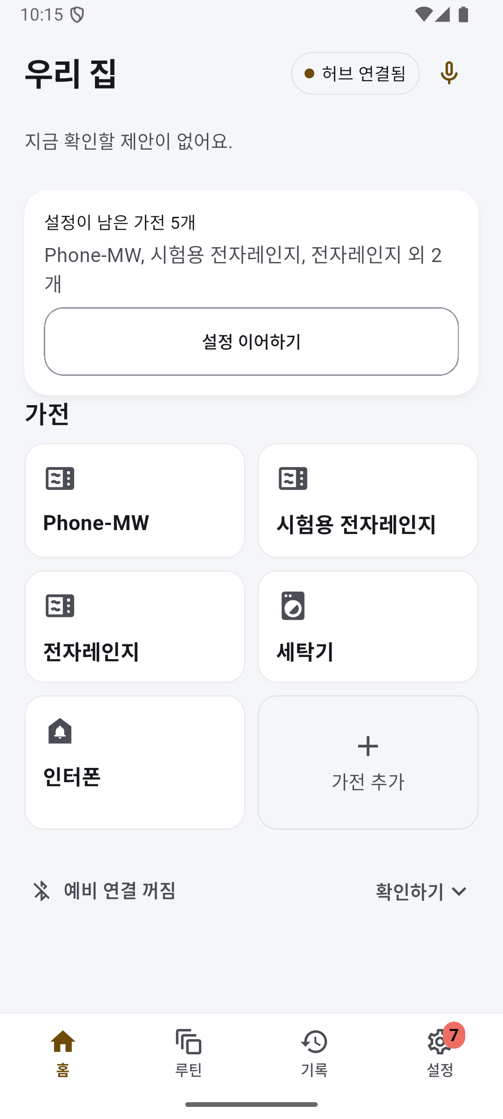
docs/submission/img/phone-home.png
