Seongwonp/Simplelay/docs/submission/img/phone-microwave-detail-2026-10-24.png

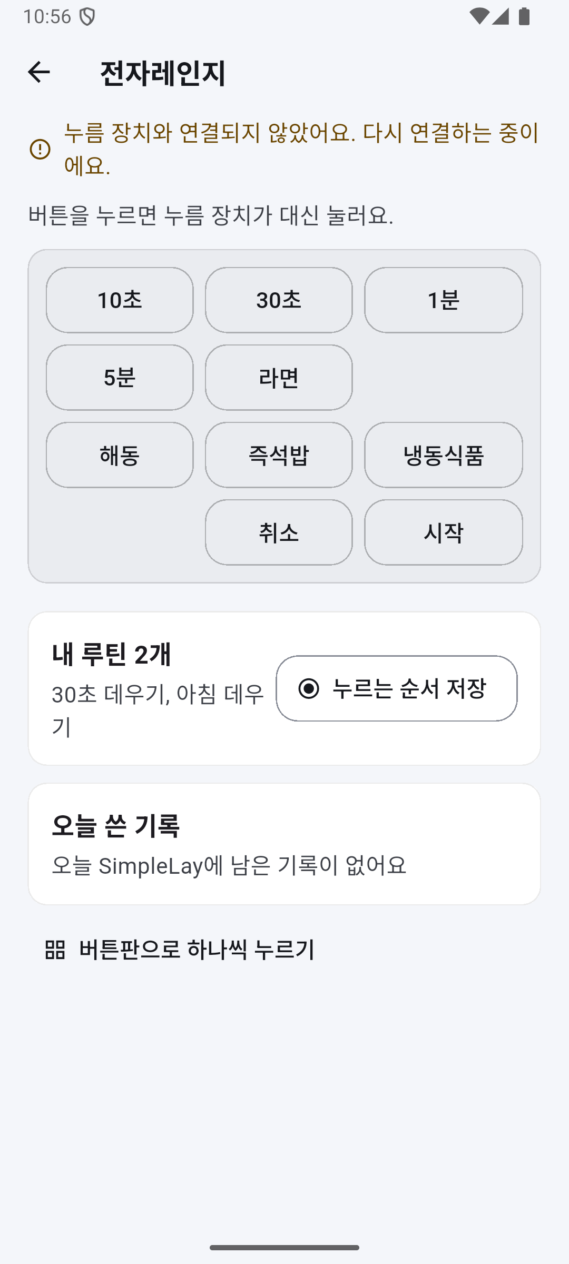
docs/submission/img/phone-microwave-detail-2026-10-24.png
