Seongwonp/Simplelay/docs/submission/img/phone-routine-editor-2026-10-24.png

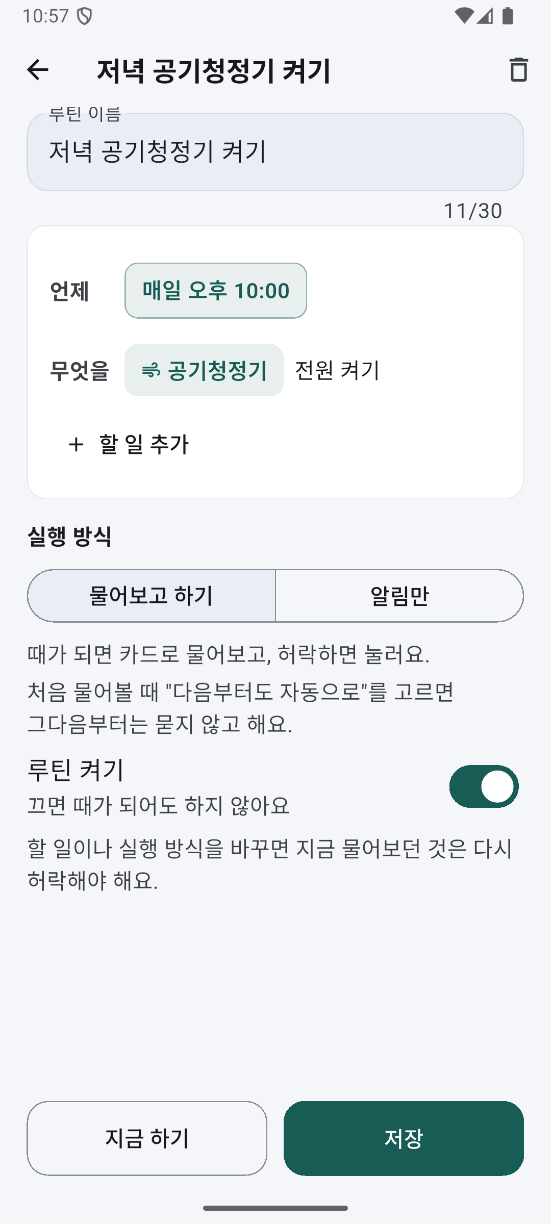
docs/submission/img/phone-routine-editor-2026-10-24.png
