Seongwonp/Simplelay/docs/submission/img/phone-routine-record.png

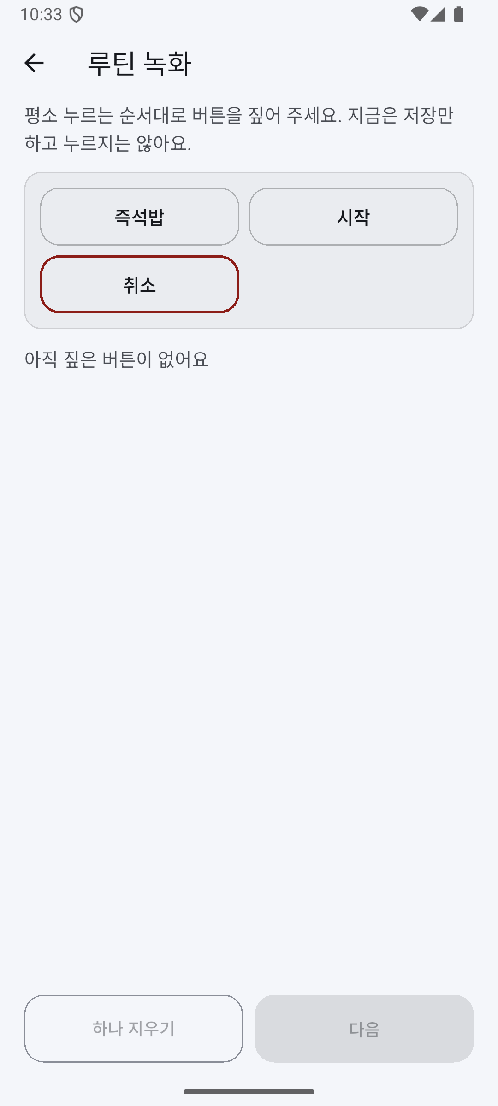
docs/submission/img/phone-routine-record.png
