Seongwonp/Simplelay/docs/submission/img/phone-routine-recorded.png

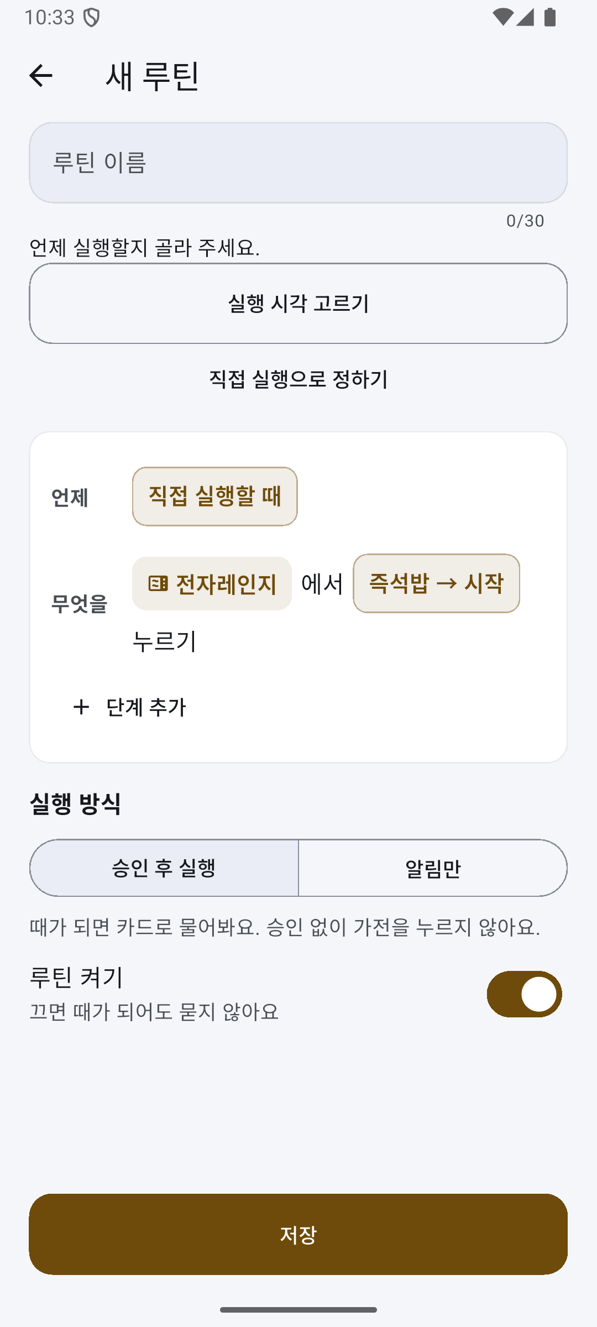
docs/submission/img/phone-routine-recorded.png
