Seongwonp/Simplelay/docs/submission/img/phone-routines-2026-10-24.png

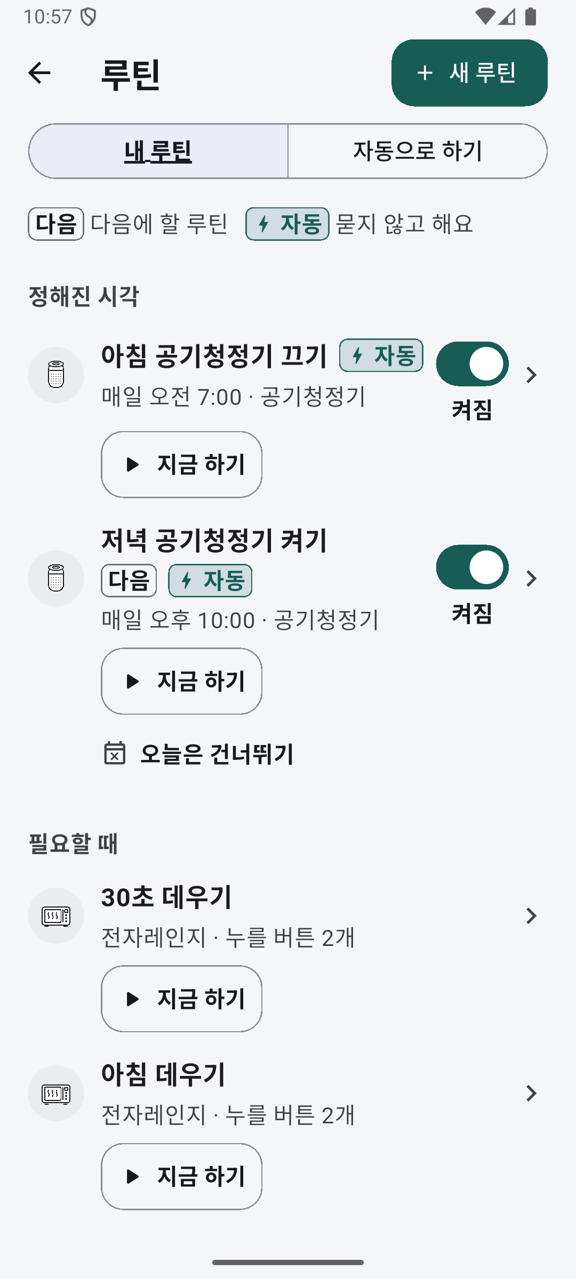
docs/submission/img/phone-routines-2026-10-24.png
