Seongwonp/Simplelay/docs/submission/img/phone-routines-real-hub-2026-10-19.png

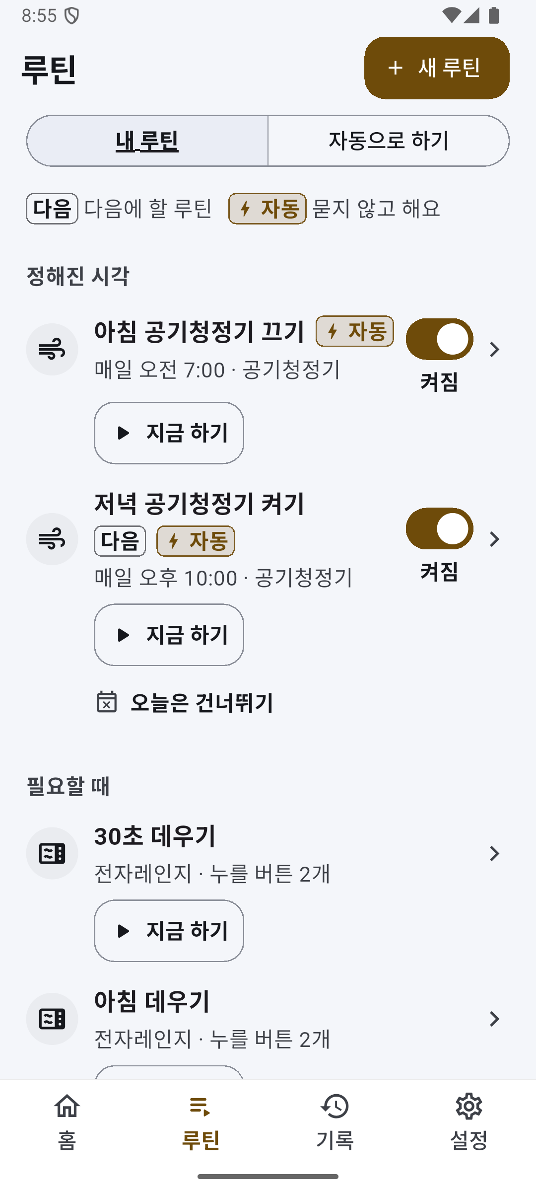
docs/submission/img/phone-routines-real-hub-2026-10-19.png
