Seongwonp/Simplelay/docs/submission/img/phone-routines.png

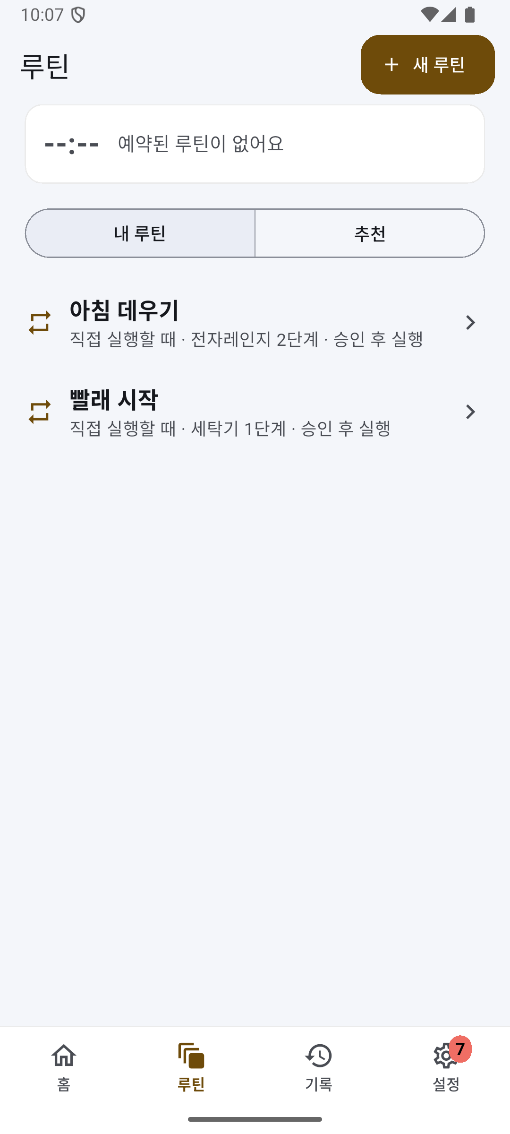
docs/submission/img/phone-routines.png
