Seongwonp/Simplelay/docs/submission/img/phone-run-confirm-2026-10-24.png

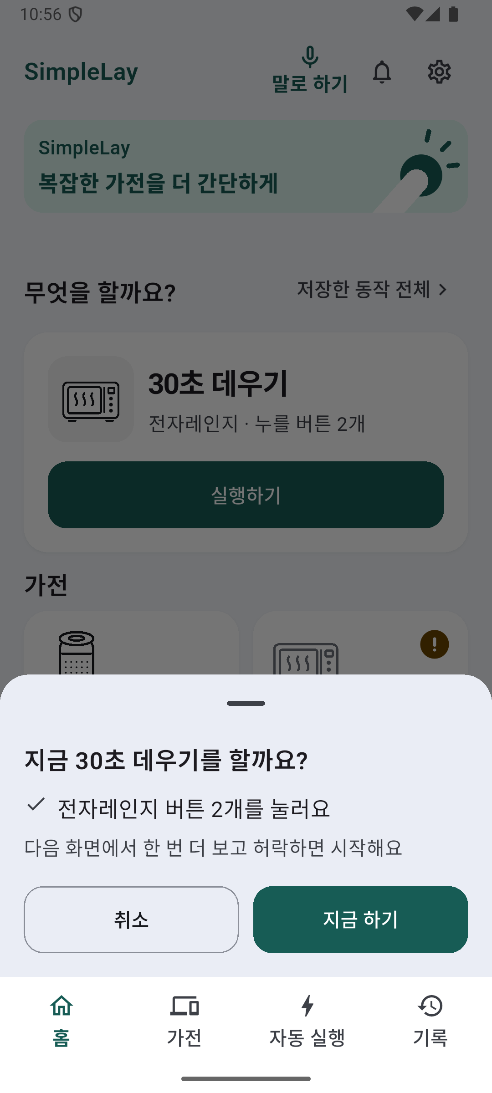
docs/submission/img/phone-run-confirm-2026-10-24.png
