Seongwonp/Simplelay/docs/submission/img/phone-run-confirm-real-hub-2026-10-20.png

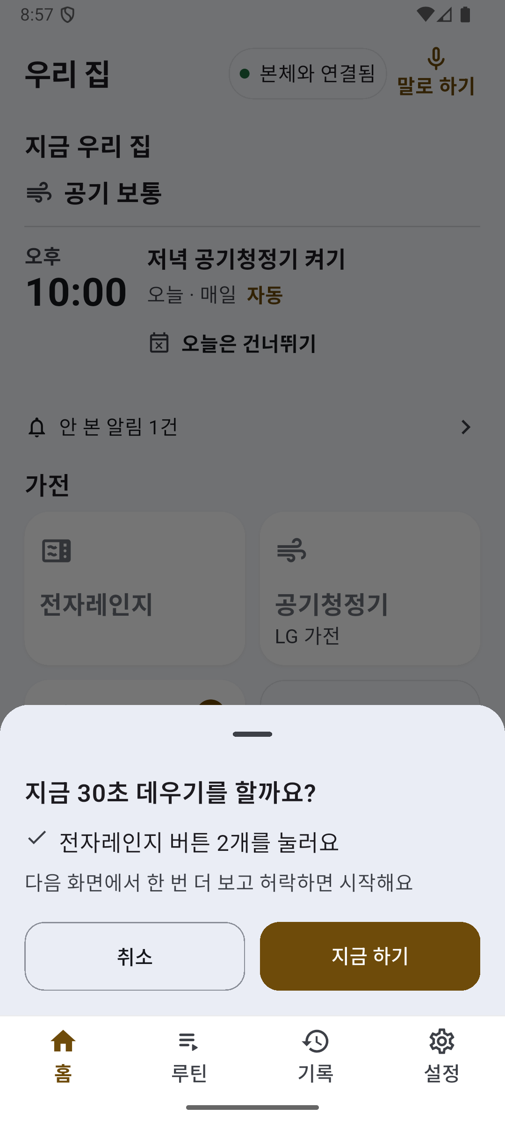
docs/submission/img/phone-run-confirm-real-hub-2026-10-20.png
