Seongwonp/Simplelay/docs/submission/img/phone-settings-2026-10-24.png

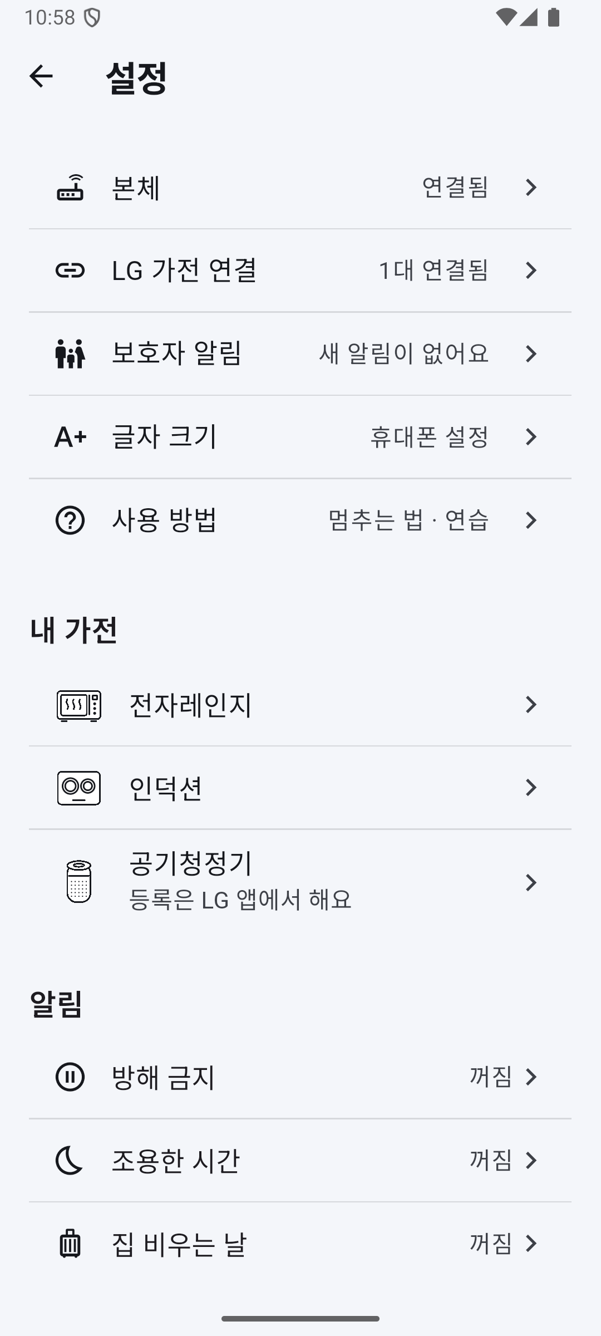
docs/submission/img/phone-settings-2026-10-24.png
