Seongwonp/Simplelay/docs/submission/img/phone-thinq-airquality-real-2026-10-20.png

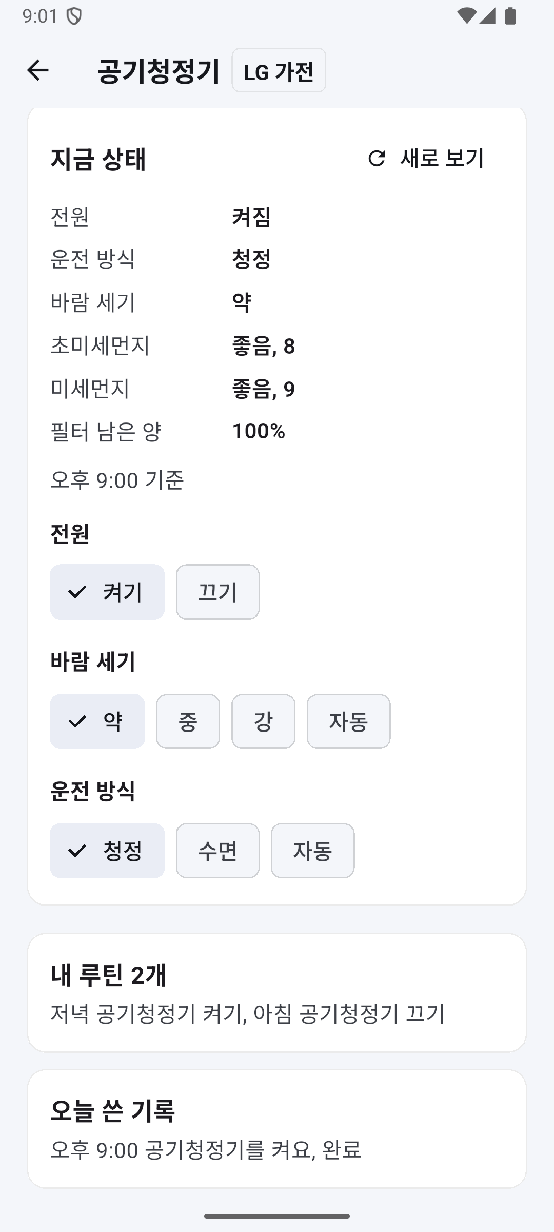
docs/submission/img/phone-thinq-airquality-real-2026-10-20.png
