Seongwonp/Simplelay/docs/submission/img/phone-thinq-confirm-2026-10-24.png

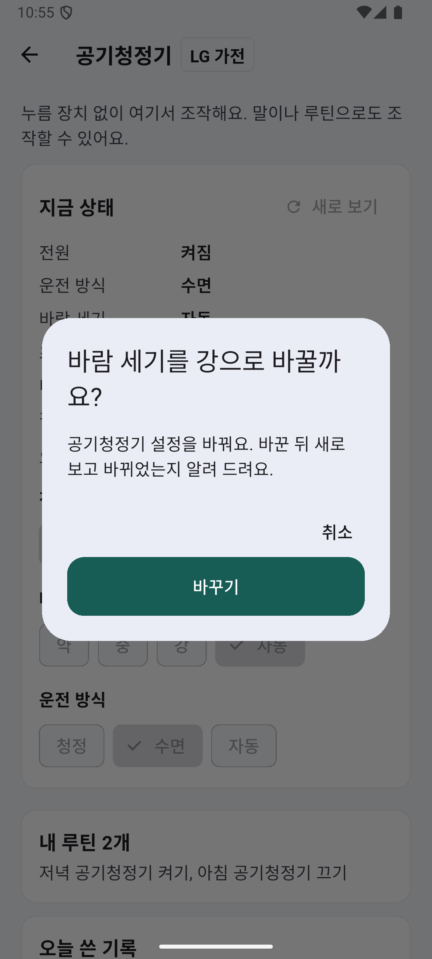
docs/submission/img/phone-thinq-confirm-2026-10-24.png
