Seongwonp/Simplelay/docs/submission/img/phone-thinq-confirm-real-2026-10-20.png

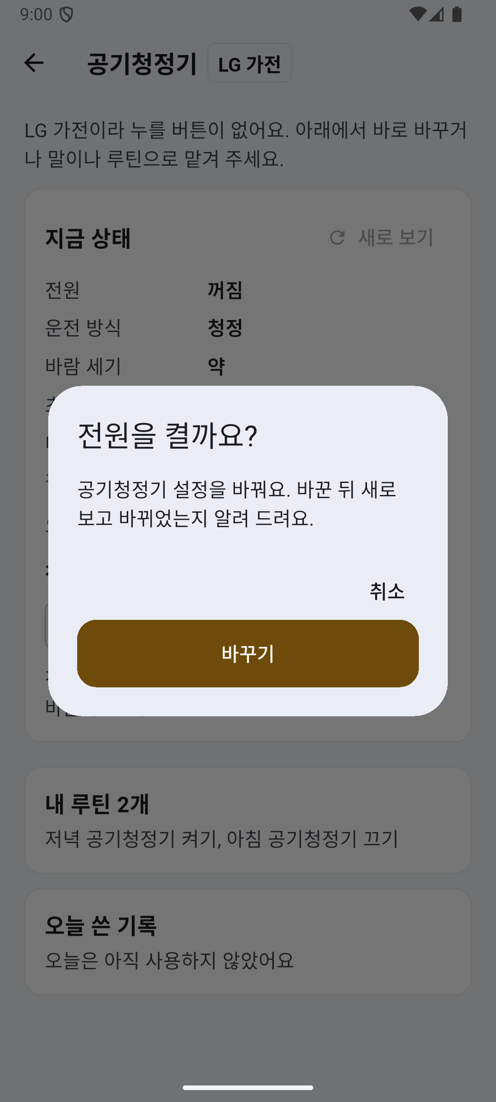
docs/submission/img/phone-thinq-confirm-real-2026-10-20.png
