Seongwonp/Simplelay/docs/submission/img/phone-thinq-done-real-2026-10-20.png

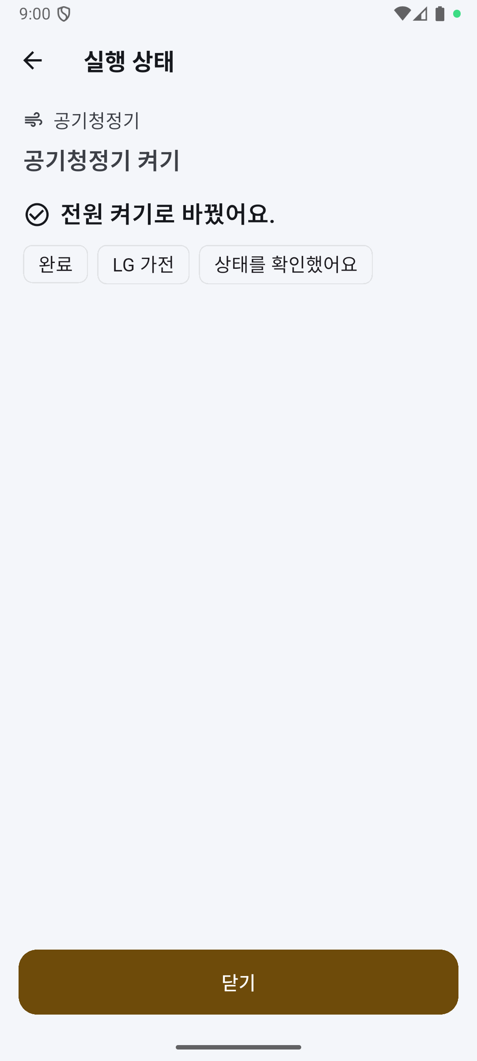
docs/submission/img/phone-thinq-done-real-2026-10-20.png
