Seongwonp/Simplelay/docs/submission/img/phone-thinq-state-2026-10-24.png

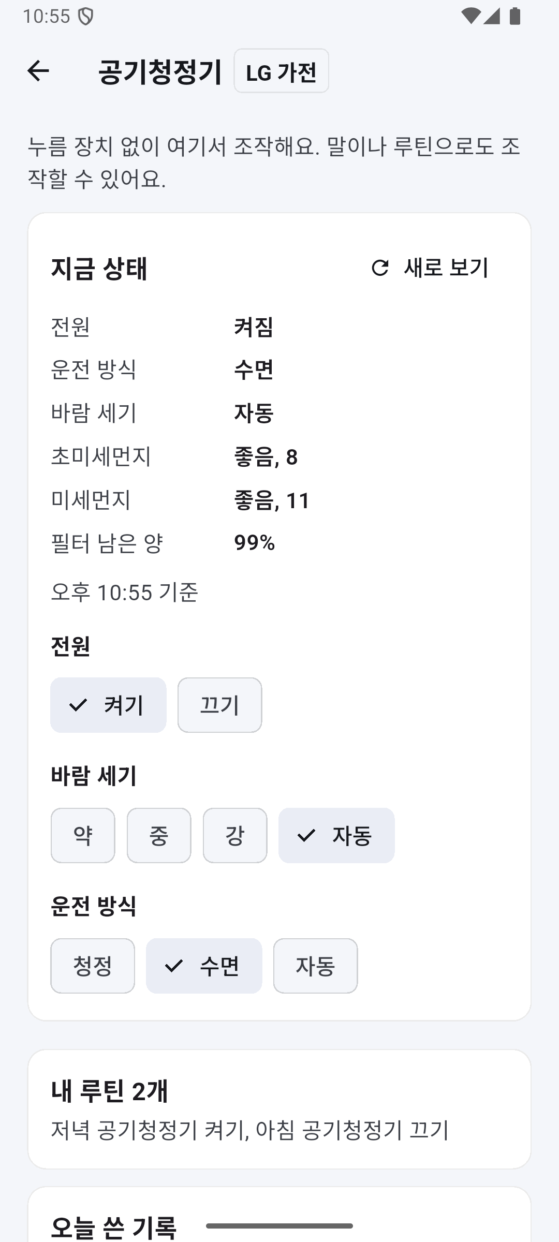
docs/submission/img/phone-thinq-state-2026-10-24.png
