Seongwonp/Simplelay/docs/ui-review/2026-10-12/k01-idle.png

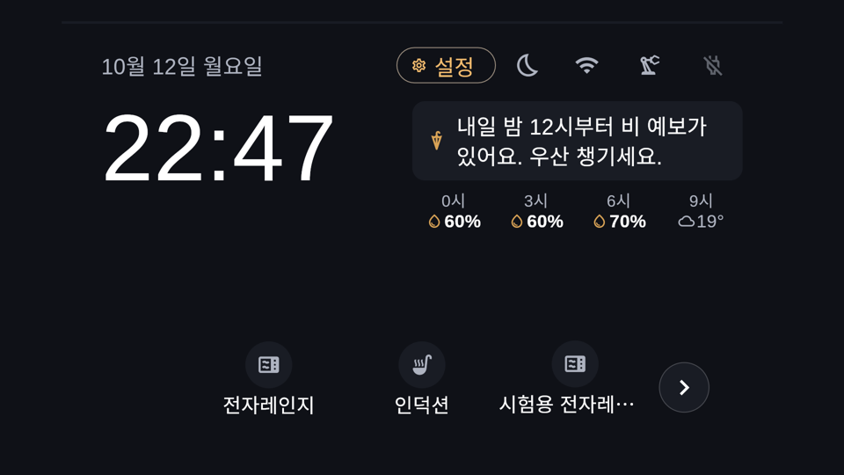
docs/ui-review/2026-10-12/k01-idle.png
