Seongwonp/Simplelay/docs/ui-review/2026-10-12/p01-home.png

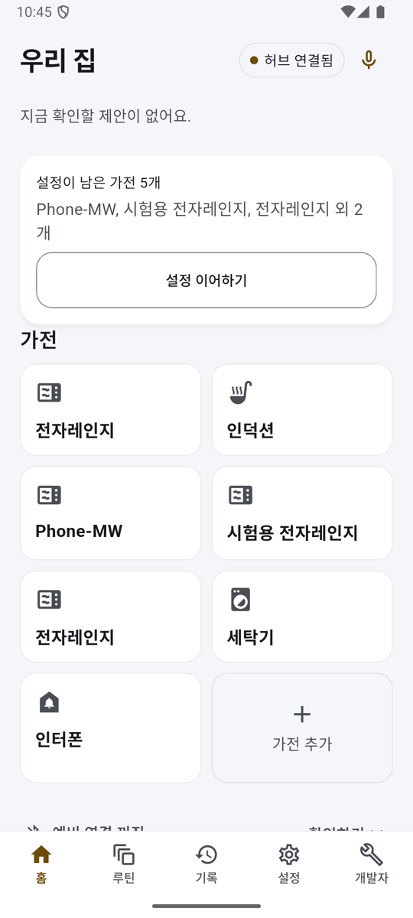
docs/ui-review/2026-10-12/p01-home.png
