Seongwonp/Simplelay/docs/ui-review/2026-10-12/p02-home-bottom.png

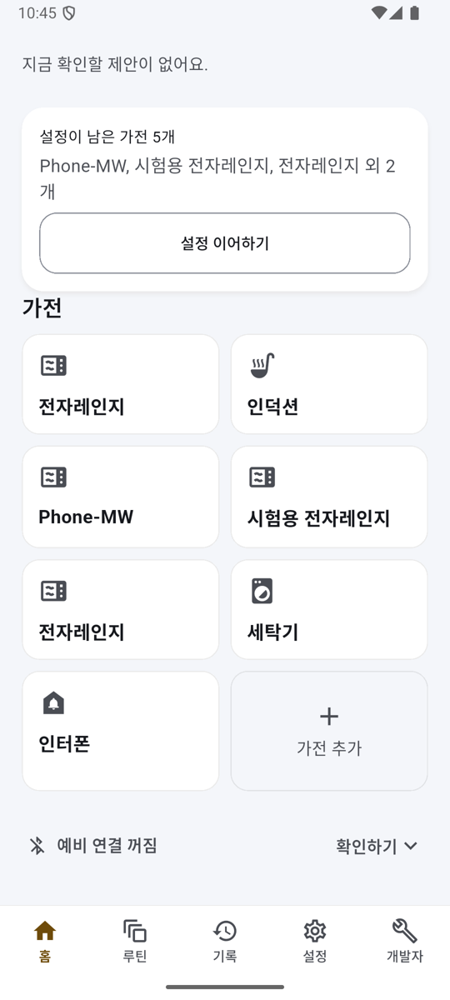
docs/ui-review/2026-10-12/p02-home-bottom.png
