Seongwonp/Simplelay/docs/ui-review/2026-10-12/p03-routines.png

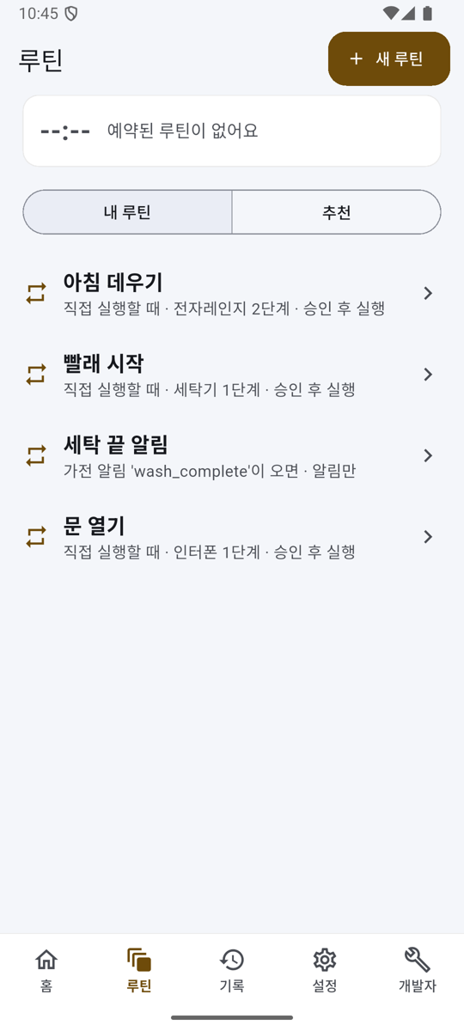
docs/ui-review/2026-10-12/p03-routines.png
