Seongwonp/Simplelay/docs/ui-review/2026-10-12/p05-settings.png

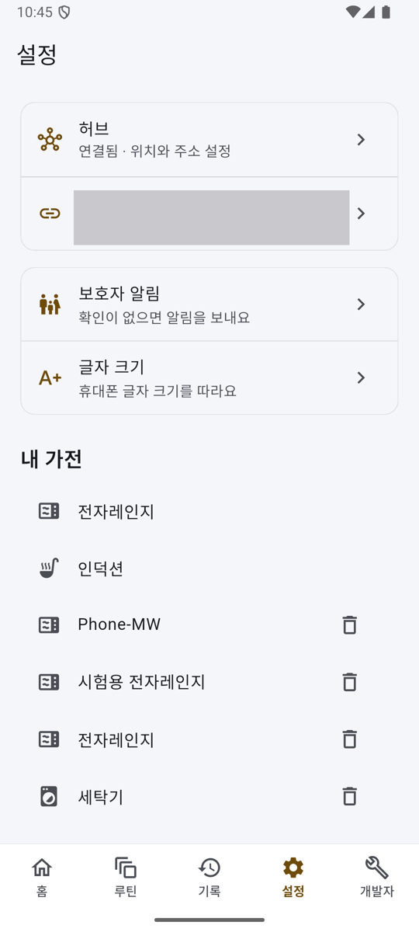
docs/ui-review/2026-10-12/p05-settings.png
