Seongwonp/Simplelay/docs/ui-review/2026-10-12/p06-settings-bottom.png

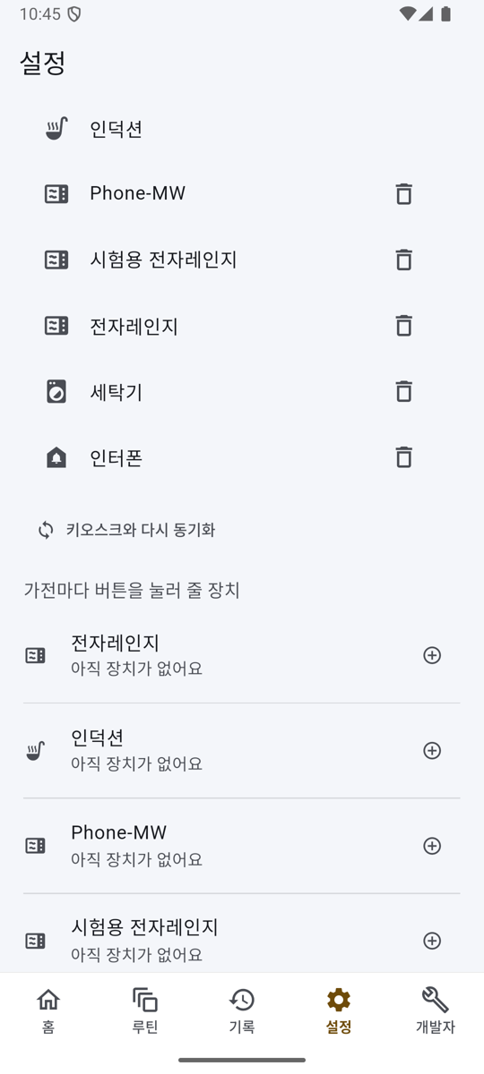
docs/ui-review/2026-10-12/p06-settings-bottom.png
