Seongwonp/Simplelay/docs/ui-review/2026-10-12/p07-appliance-detail.png

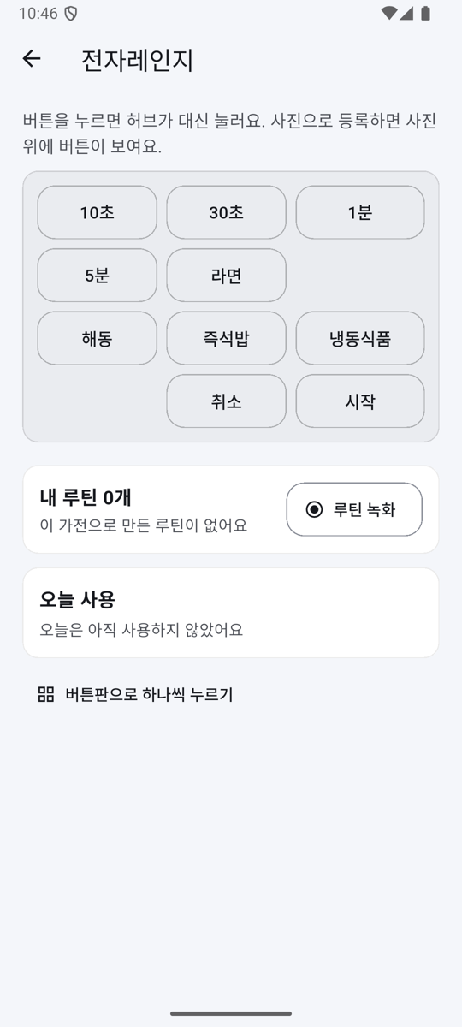
docs/ui-review/2026-10-12/p07-appliance-detail.png
