Seongwonp/Simplelay/docs/ui-review/2026-10-12/p08-routines-suggest.png

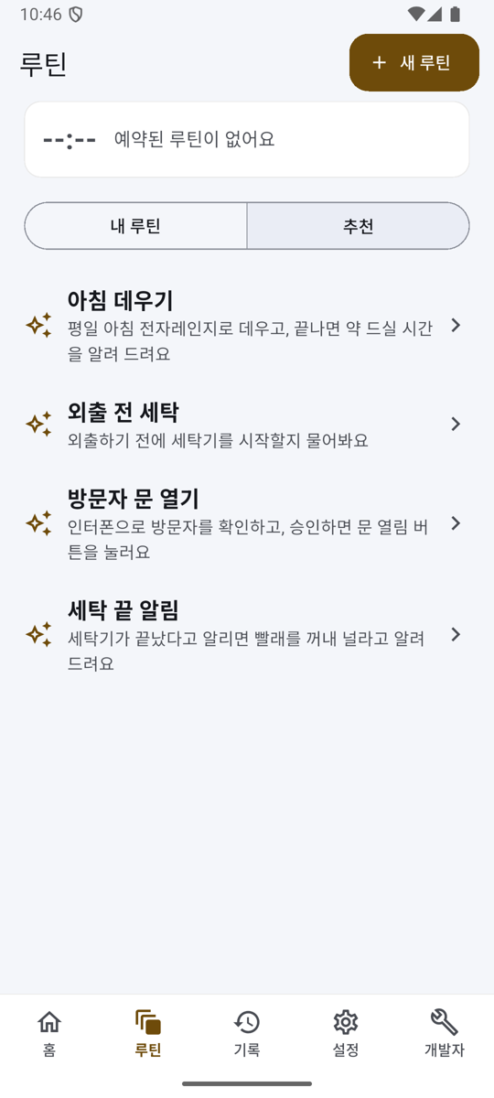
docs/ui-review/2026-10-12/p08-routines-suggest.png
