Seongwonp/Simplelay/docs/ui-review/2026-10-12/p09-routine-detail.png

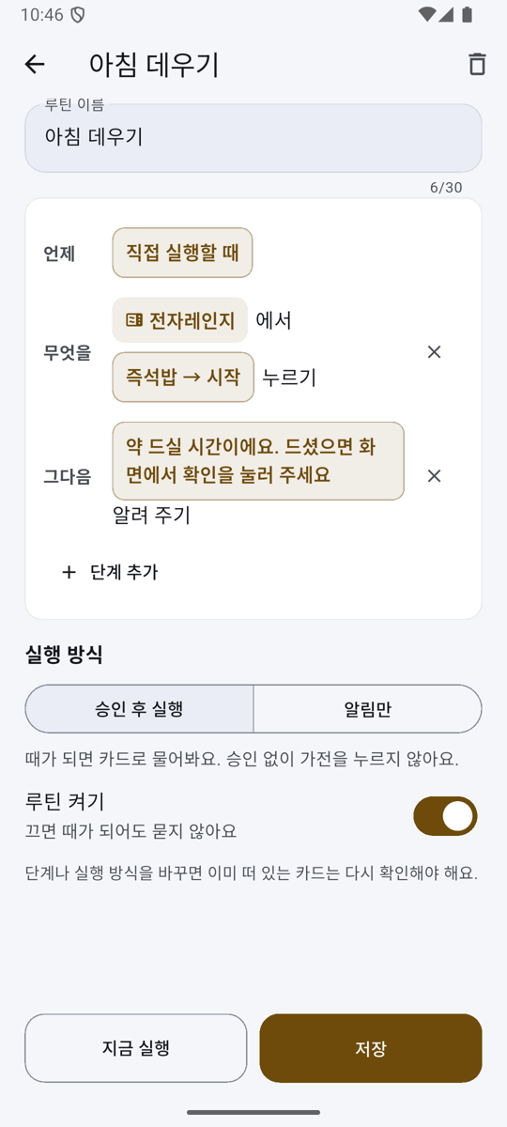
docs/ui-review/2026-10-12/p09-routine-detail.png
