Seongwonp/Simplelay/docs/ui-review/2026-10-12/p11-voice.png

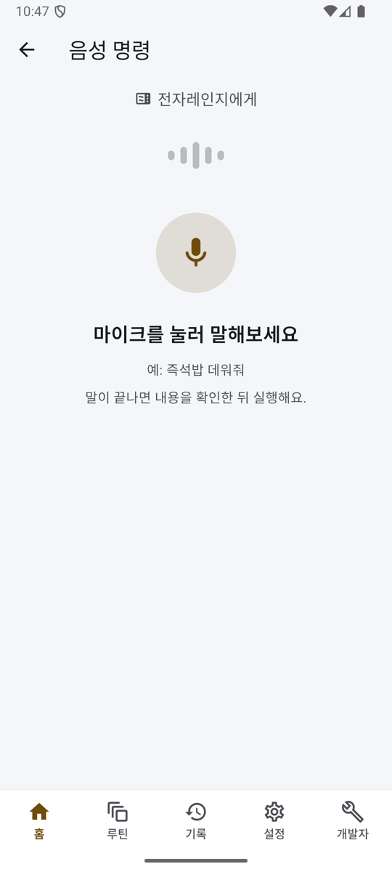
docs/ui-review/2026-10-12/p11-voice.png
