Seongwonp/Simplelay/docs/ui-review/2026-10-13/k02-kiosk-run-stop-sequence.png

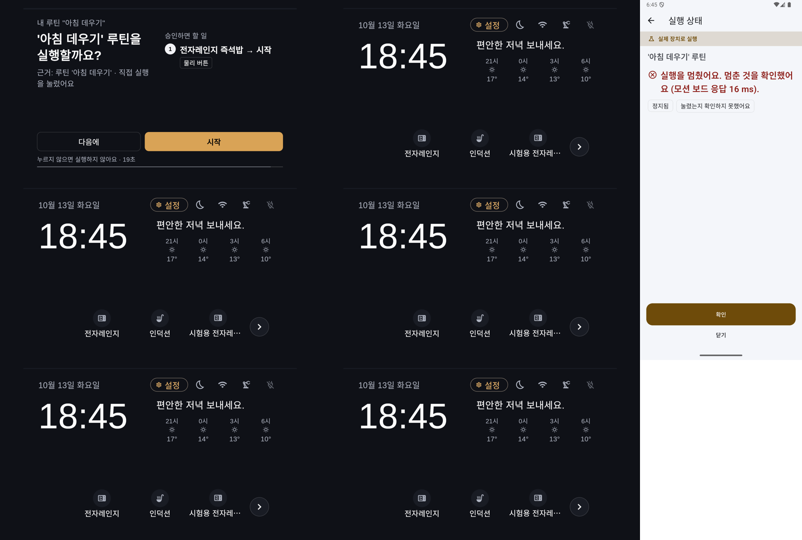
docs/ui-review/2026-10-13/k02-kiosk-run-stop-sequence.png
