Seongwonp/Simplelay/docs/ui-review/2026-10-13/p02-home-bottom.png

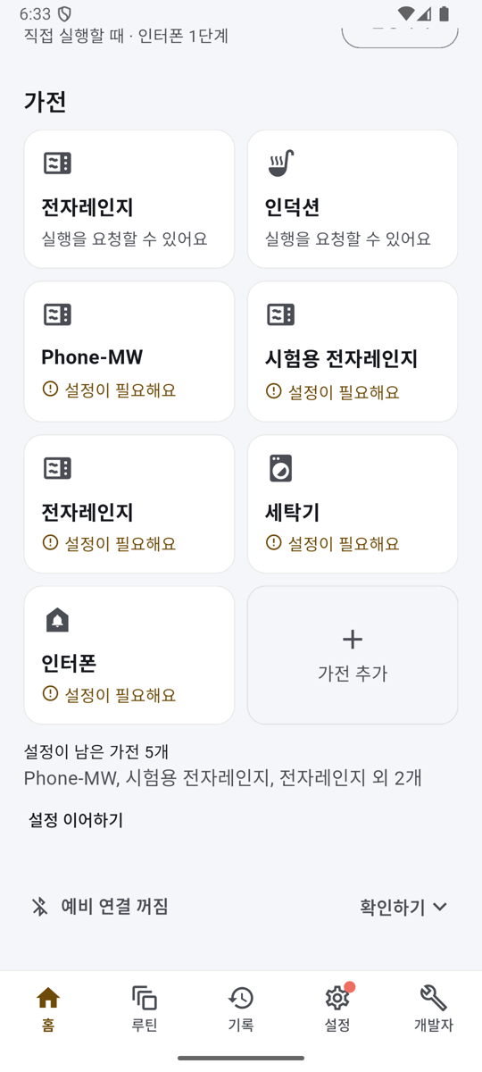
docs/ui-review/2026-10-13/p02-home-bottom.png
