Seongwonp/Simplelay/docs/ui-review/2026-10-13/p03-routines.png

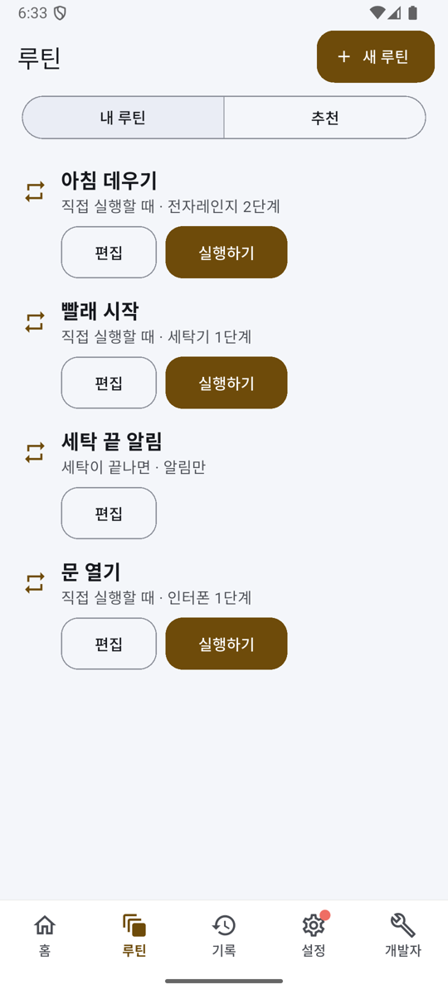
docs/ui-review/2026-10-13/p03-routines.png
