Seongwonp/Simplelay/docs/ui-review/2026-10-13/p05-settings.png

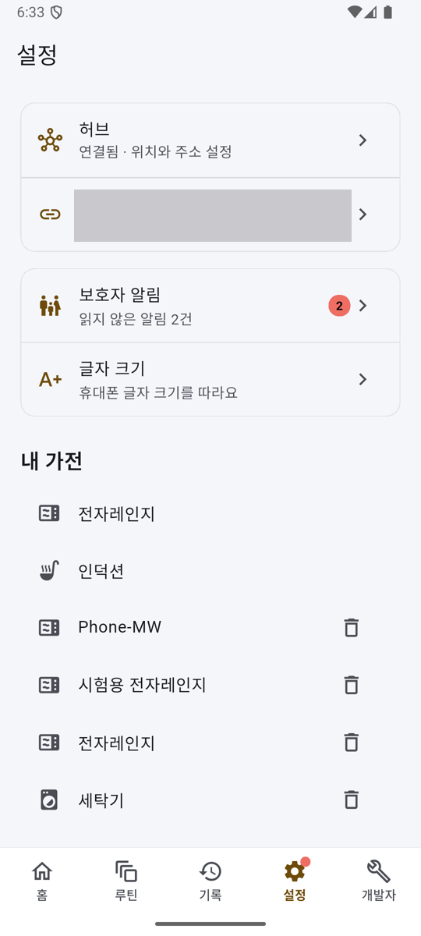
docs/ui-review/2026-10-13/p05-settings.png
