Seongwonp/Simplelay/docs/ui-review/2026-10-13/p12-status-stopped.png

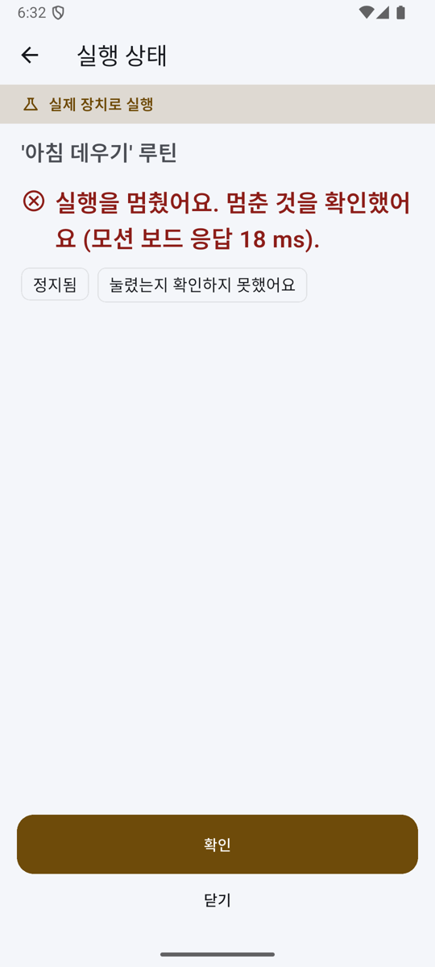
docs/ui-review/2026-10-13/p12-status-stopped.png
