Seongwonp/Simplelay/docs/ui-review/2026-10-13/s01-dev-idle-stop.png

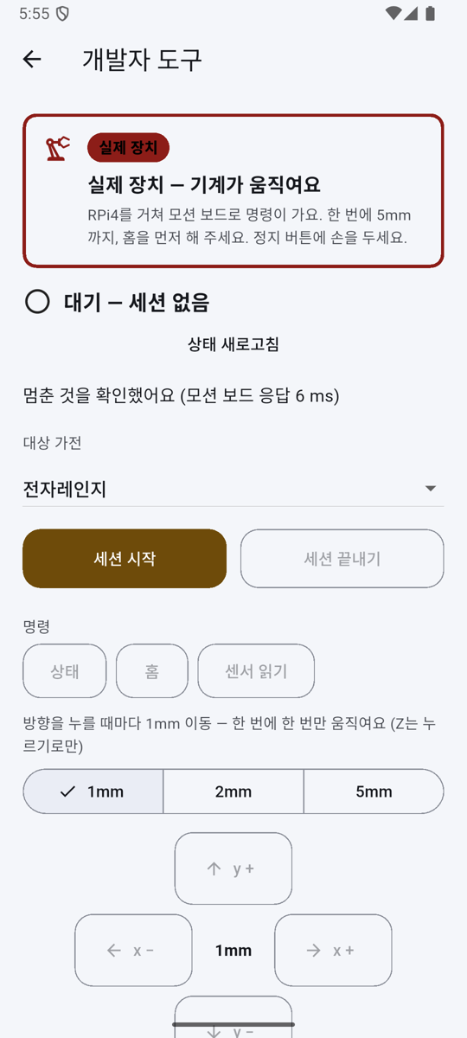
docs/ui-review/2026-10-13/s01-dev-idle-stop.png
