Seongwonp/Simplelay/docs/ui-review/2026-10-13/s02-dev-usb-lost.png

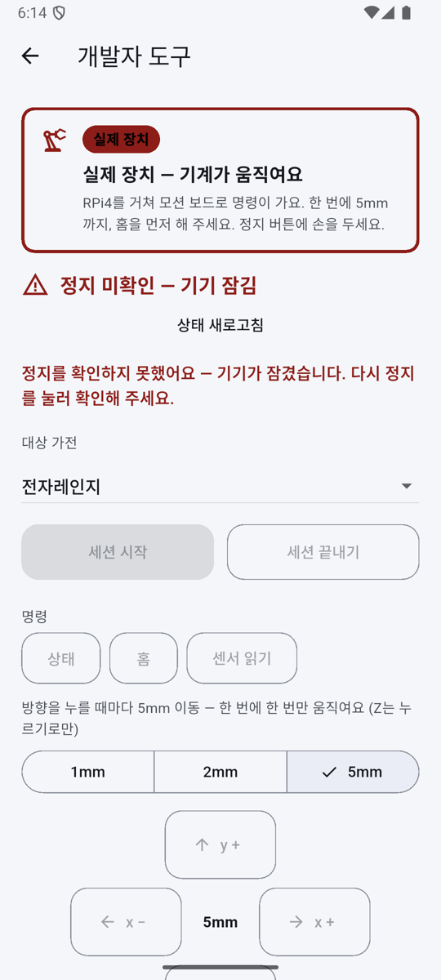
docs/ui-review/2026-10-13/s02-dev-usb-lost.png
