Seongwonp/Simplelay/docs/ui-review/2026-10-13/s05-dev-double-stop.png

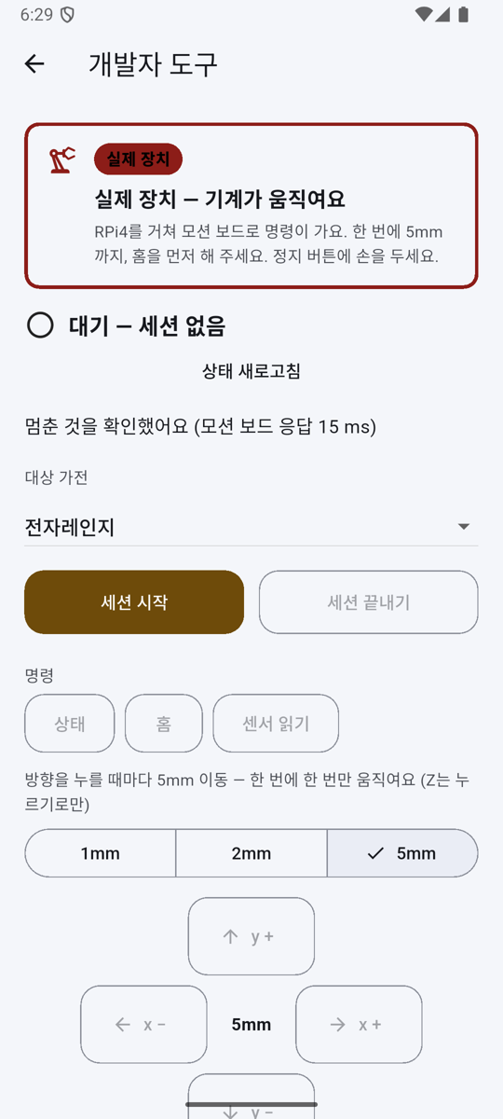
docs/ui-review/2026-10-13/s05-dev-double-stop.png
