Seongwonp/Simplelay/docs/ui-review/2026-10-13/x01-font2-home.png

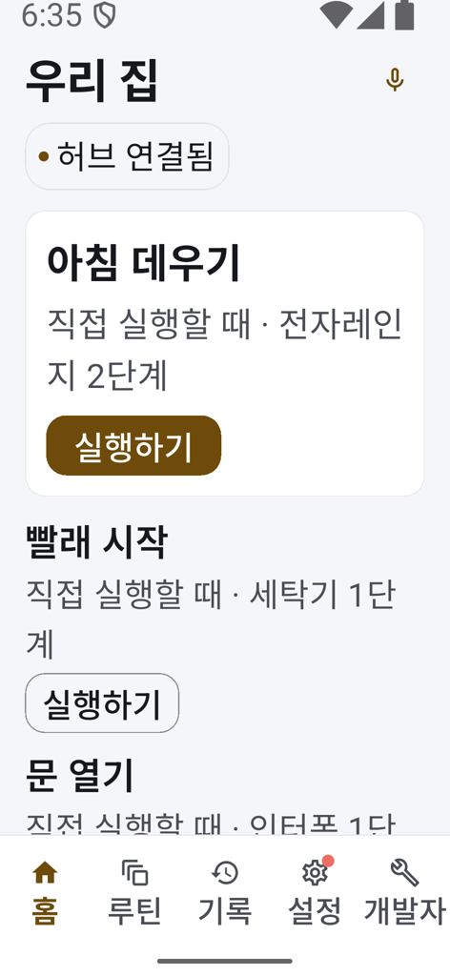
docs/ui-review/2026-10-13/x01-font2-home.png
