Seongwonp/Simplelay/docs/ui-review/2026-10-13/x02-font2-routines.png

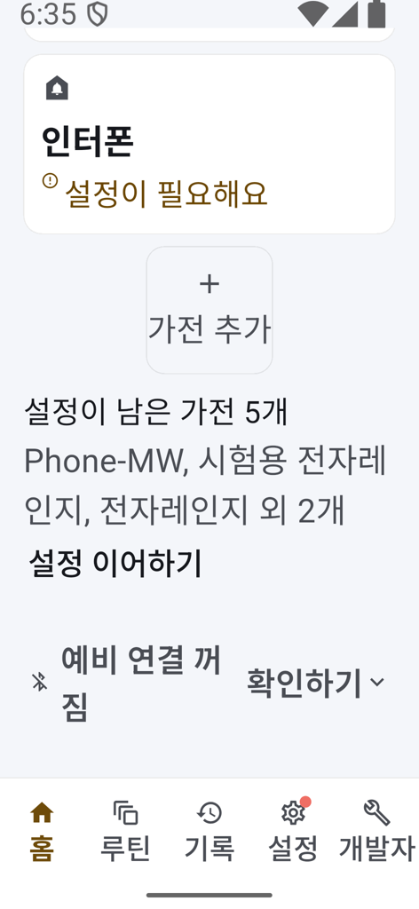
docs/ui-review/2026-10-13/x02-font2-routines.png
