Seongwonp/Simplelay/docs/ui-review/2026-10-13/x04-font2-approve.png

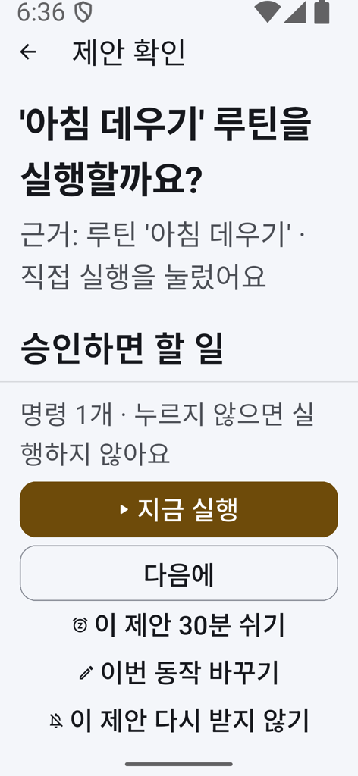
docs/ui-review/2026-10-13/x04-font2-approve.png
