Seongwonp/Simplelay/docs/ui-review/2026-10-14/k01-stall-kiosk-and-phone.png

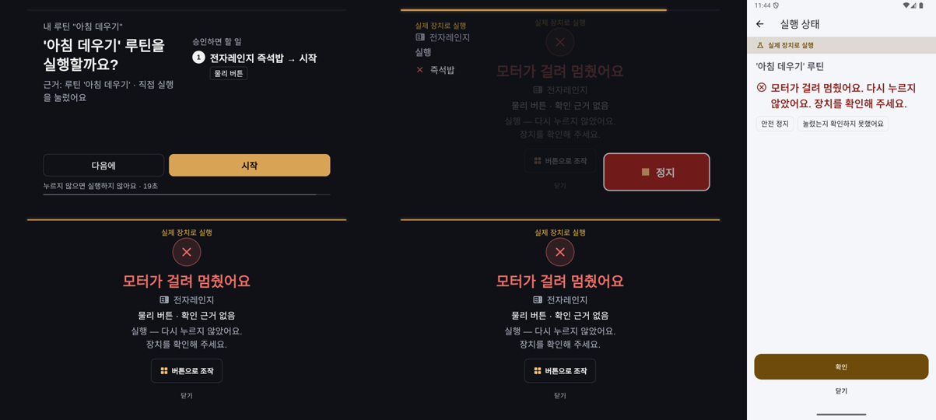
docs/ui-review/2026-10-14/k01-stall-kiosk-and-phone.png
