Seongwonp/Simplelay/docs/ui-review/2026-10-14/k02-short-run-stop-kiosk.png

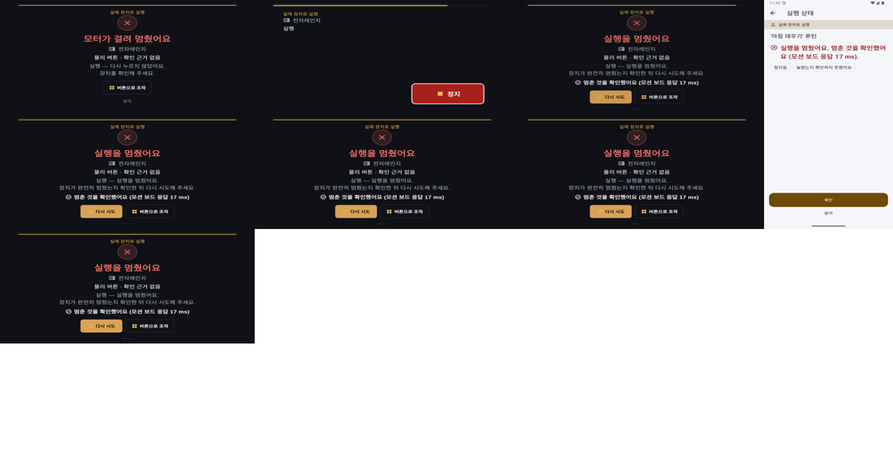
docs/ui-review/2026-10-14/k02-short-run-stop-kiosk.png
