Seongwonp/Simplelay/docs/ui-review/2026-10-14/p01-auto-offer.png

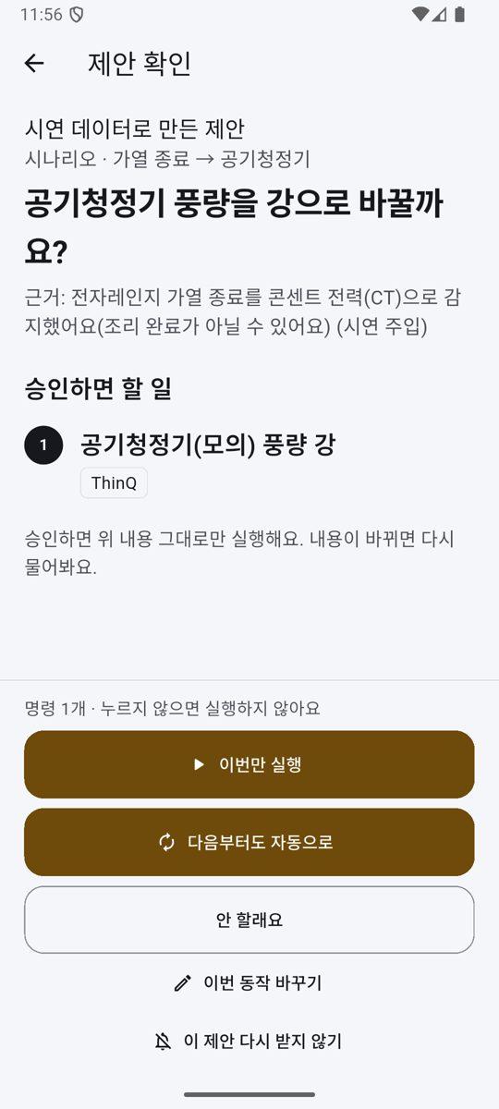
docs/ui-review/2026-10-14/p01-auto-offer.png
