Seongwonp/Simplelay/docs/ui-review/2026-10-14/p02-auto-allow-sheet.png

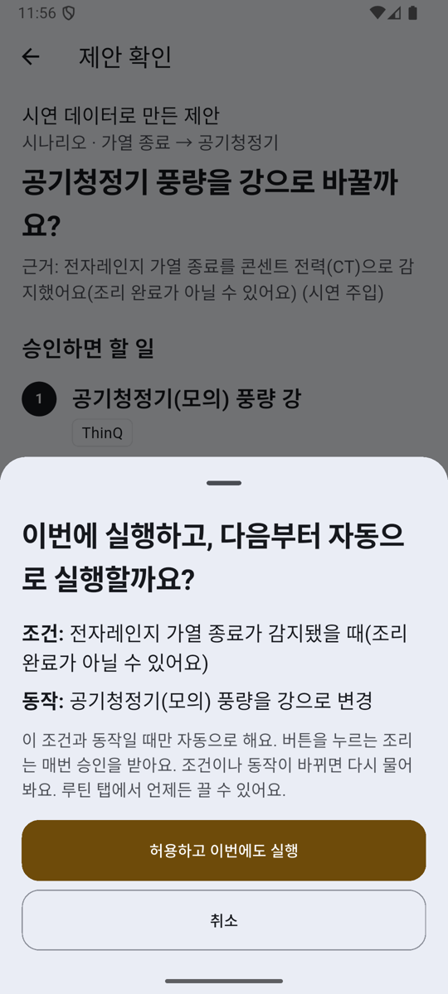
docs/ui-review/2026-10-14/p02-auto-allow-sheet.png
