Seongwonp/Simplelay/docs/ui-review/2026-10-14/x01-font2-home-approve.png

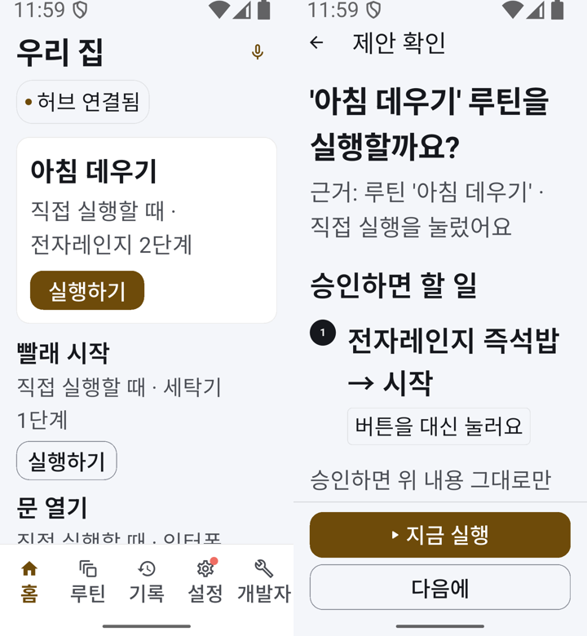
docs/ui-review/2026-10-14/x01-font2-home-approve.png
