Seongwonp/Simplelay/housing/renders/cutaway.png

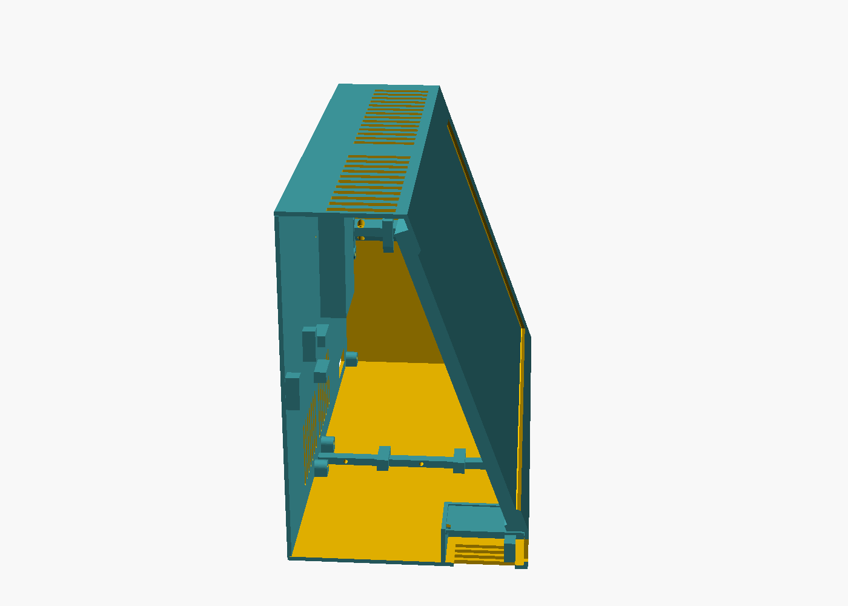
housing/renders/cutaway.png
