Seongwonp/Simplelay/housing/renders/front.png

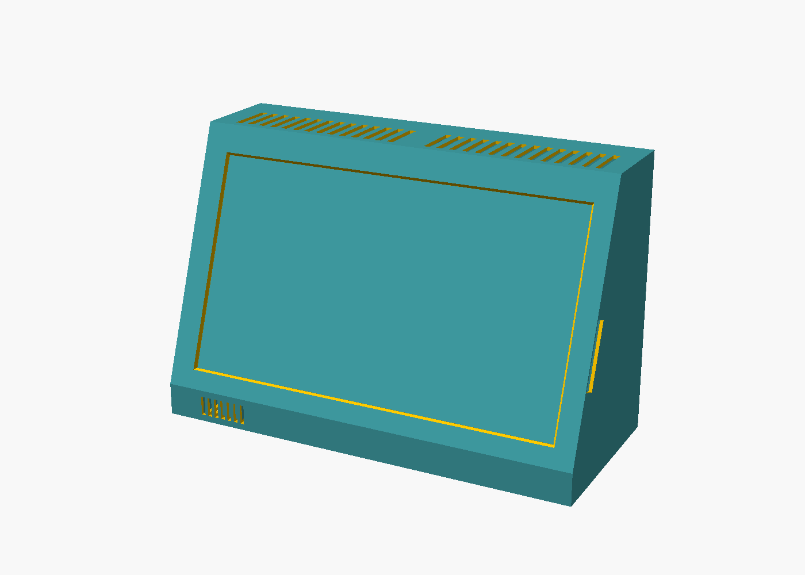
housing/renders/front.png
