Seongwonp/Simplelay/rpi5-touchscreen-app/test/goldens/kiosk15_done_reported.png

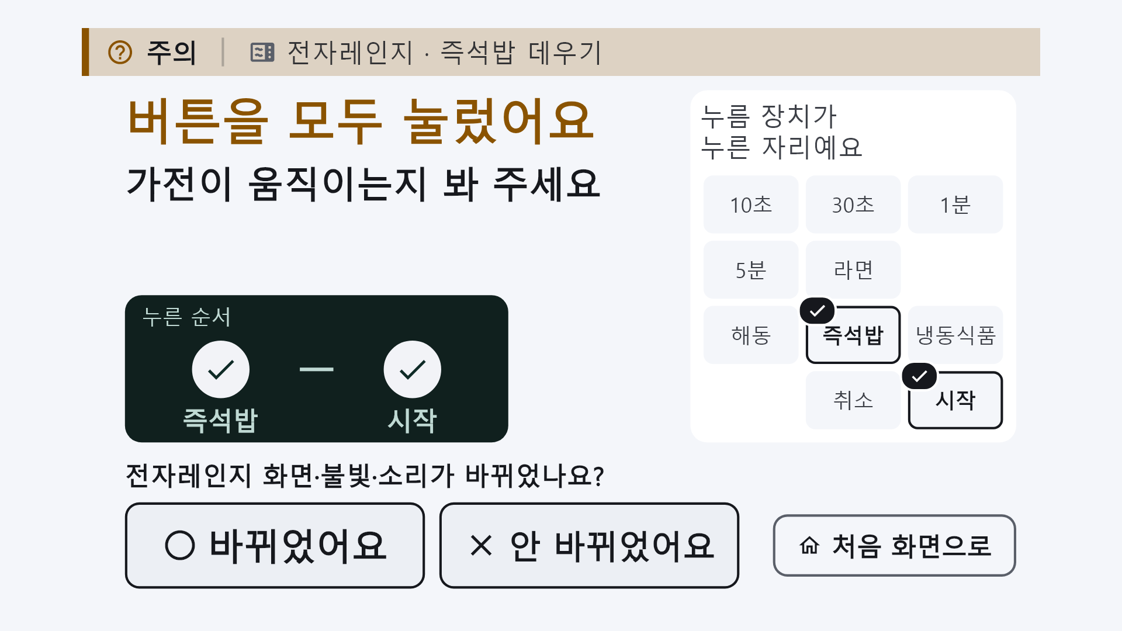
rpi5-touchscreen-app/test/goldens/kiosk15_done_reported.png
