Seongwonp/Simplelay/housing/print-order-r2/02_panel_clip.stl

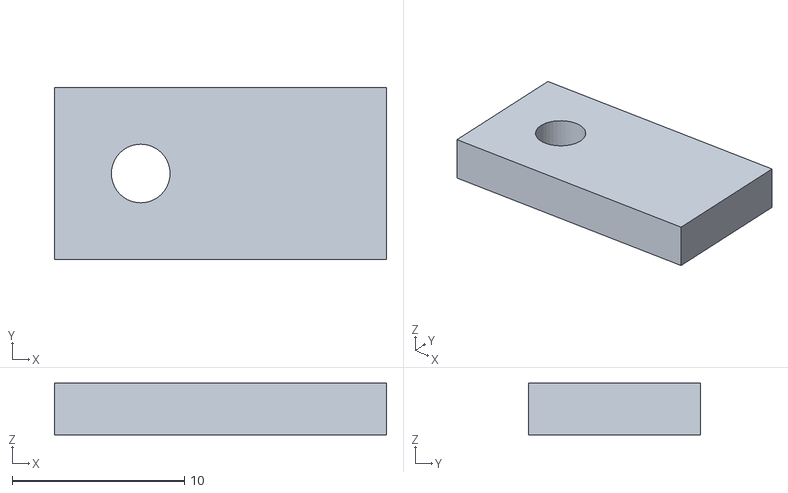
[picture p104: CAD file, 2026-10-23]
housing/print-order-r2/02_panel_clip.stl
19.2 x 10.0 x 3.00
