Seongwonp/Simplelay/housing/print-school-r2/sensor_lid.stl

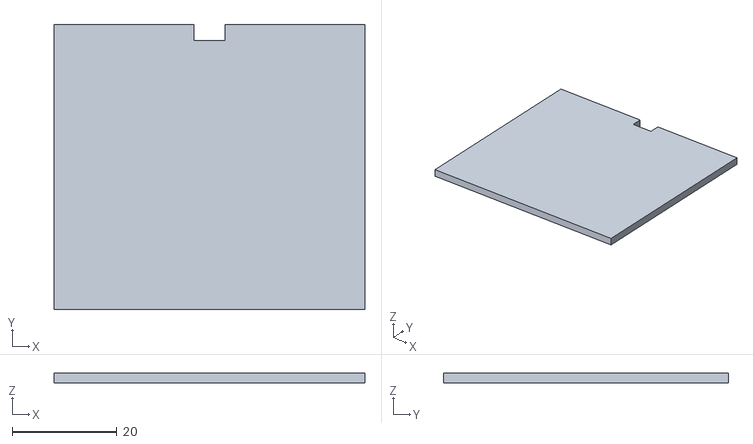
[picture p105: CAD file, 2026-10-24]
housing/print-school-r2/sensor_lid.stl
59.4 x 54.4 x 2.00
