Seongwonp/Simplelay/housing/print-school-r2/test/dowel_calibration.stl

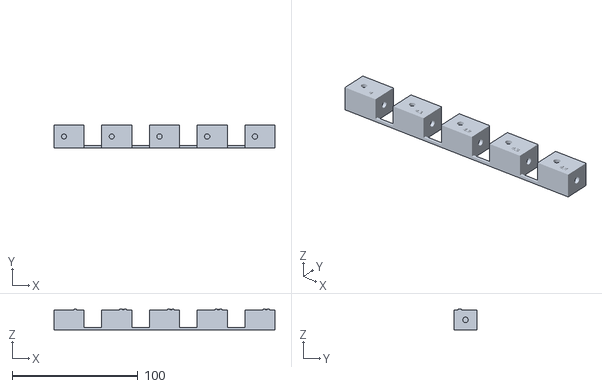
[picture p106: CAD file, 2026-10-24]
housing/print-school-r2/test/dowel_calibration.stl
176.0 x 18.0 x 16.6
