Seongwonp/Simplelay/housing/stl/vendor_shell_left_r2.stl

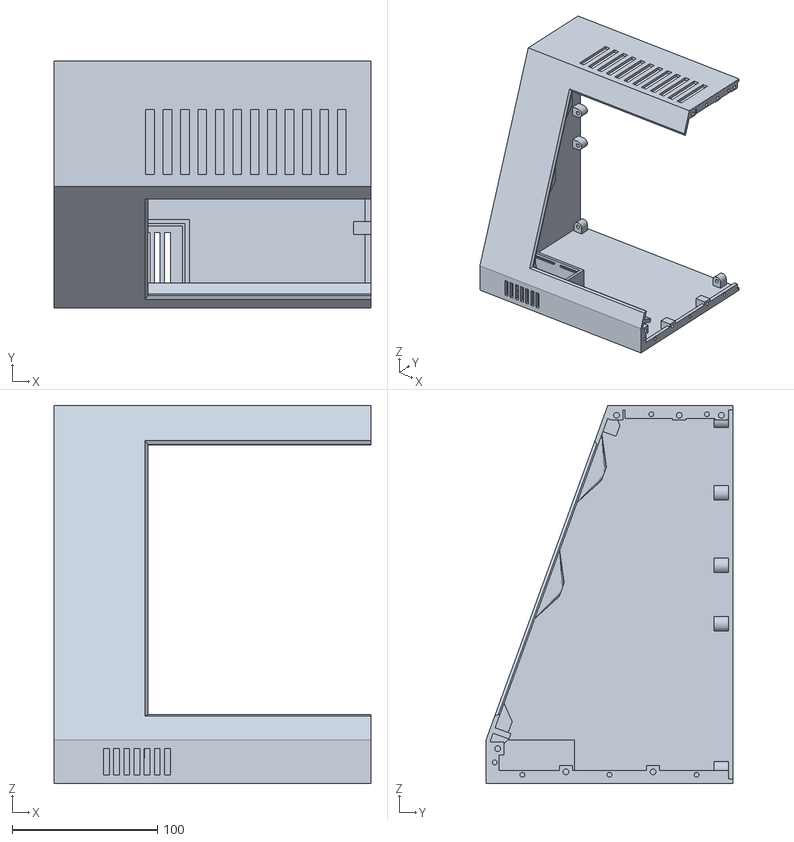
[picture p107: CAD file, 2026-10-23]
housing/stl/vendor_shell_left_r2.stl
218.0 x 170.0 x 260.2
