Seongwonp/Simplelay/housing/print-school-r2/dowel_pin.stl

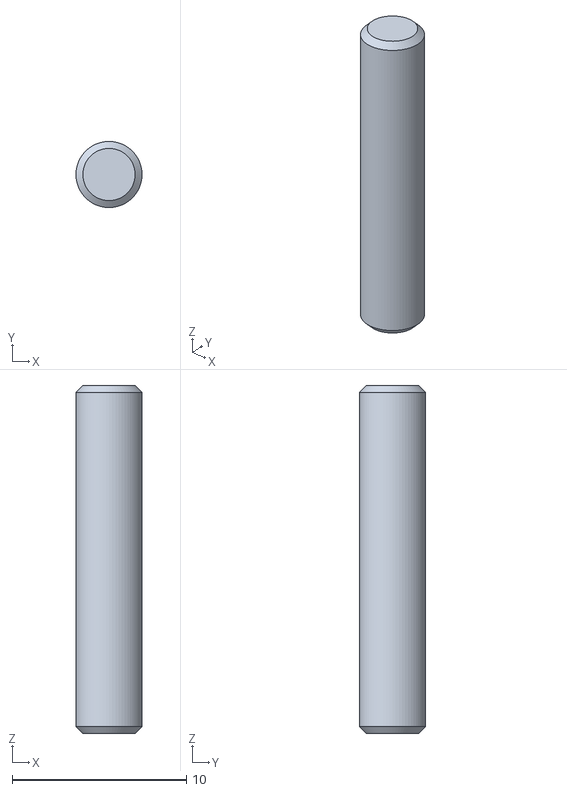
[picture p108: CAD file, 2026-10-24]
housing/print-school-r2/dowel_pin.stl
3.80 x 3.80 x 20.0
