Seongwonp/Simplelay/housing/print-school-r2/test/fit_test_r2.stl

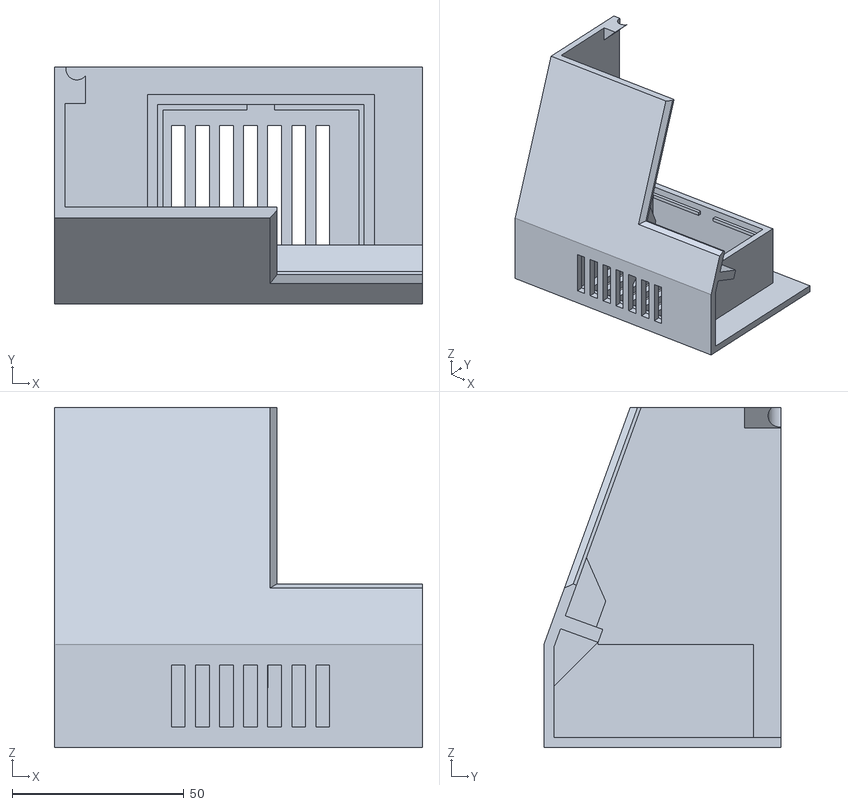
[picture p109: CAD file, 2026-10-24]
housing/print-school-r2/test/fit_test_r2.stl
107.0 x 69.0 x 99.0
