Seongwonp/Simplelay/housing/print-school-r2/rpi5_case_tray.stl

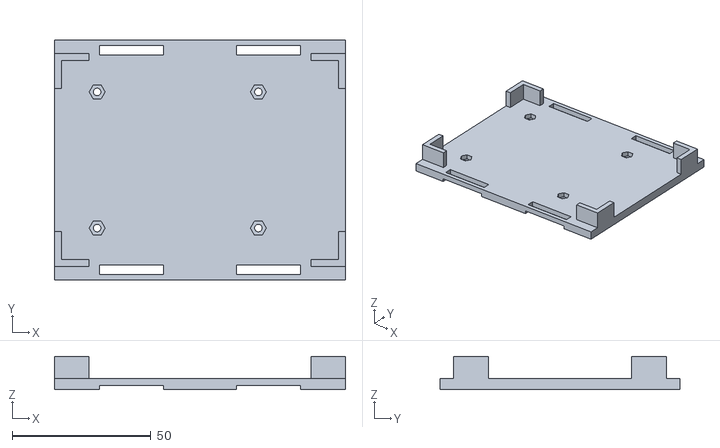
[picture p110: CAD file, 2026-10-24]
housing/print-school-r2/rpi5_case_tray.stl
104.7 x 86.5 x 12.0
