Seongwonp/Simplelay/housing/stl/splice.stl

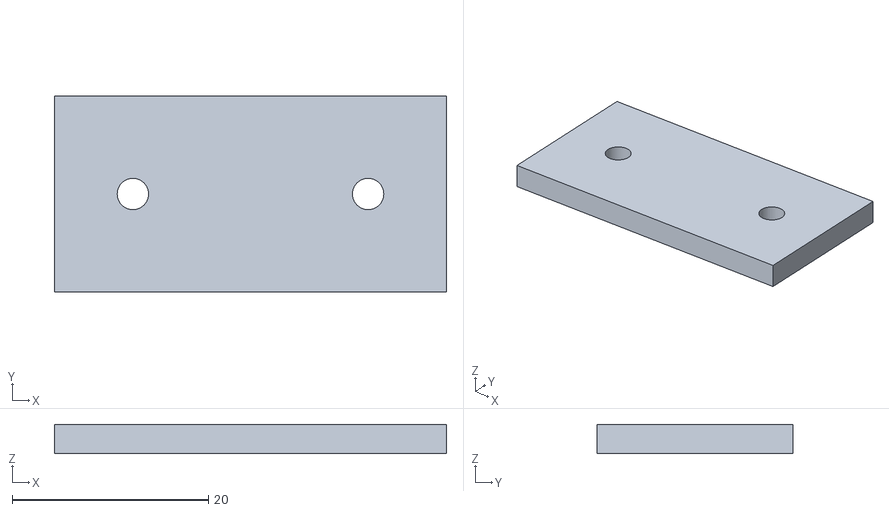
[picture p111: CAD file, 2026-10-18]
housing/stl/splice.stl
40.0 x 20.0 x 3.00
