Seongwonp/Simplelay/housing/print-school-r2/shell_RB.stl

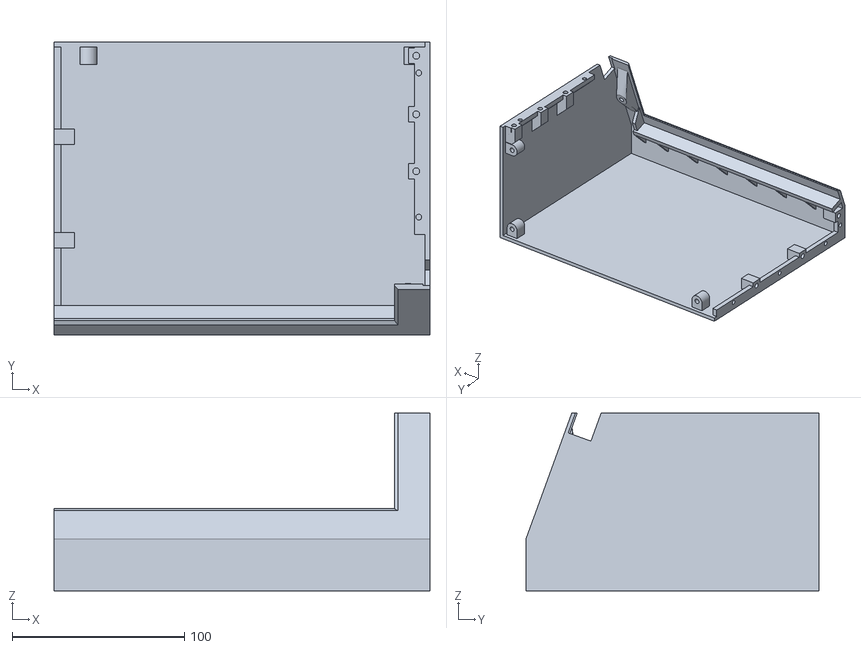
[picture p112: CAD file, 2026-10-24]
housing/print-school-r2/shell_RB.stl
218.0 x 170.0 x 103.0
