Seongwonp/Simplelay/housing/print-school-r2/back_LB.stl

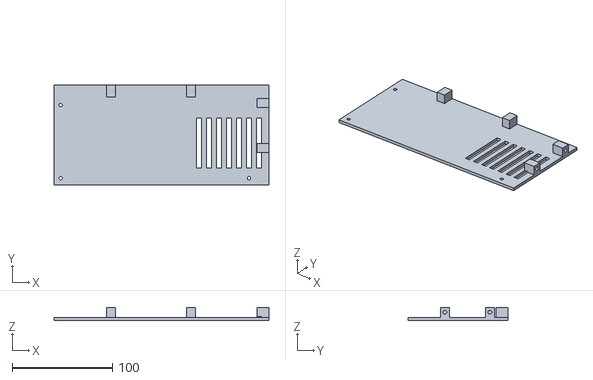
[picture p114: CAD file, 2026-10-24]
housing/print-school-r2/back_LB.stl
214.7 x 99.7 x 12.5
