Seongwonp/Simplelay/housing/print-school-r2/back_RB.stl

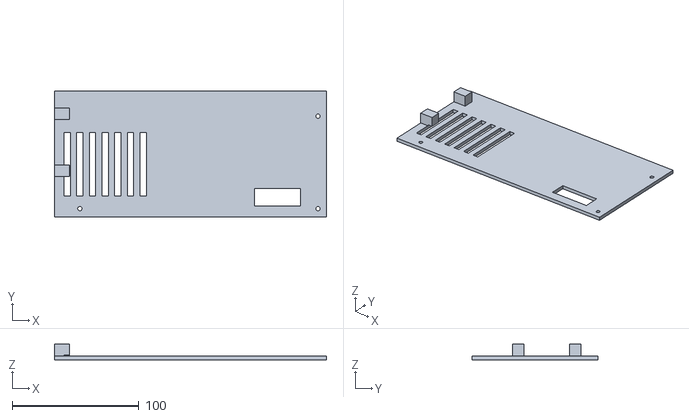
[picture p115: CAD file, 2026-10-24]
housing/print-school-r2/back_RB.stl
214.7 x 99.7 x 12.5
