Seongwonp/Simplelay/housing/print-school-r2/back_LT.stl

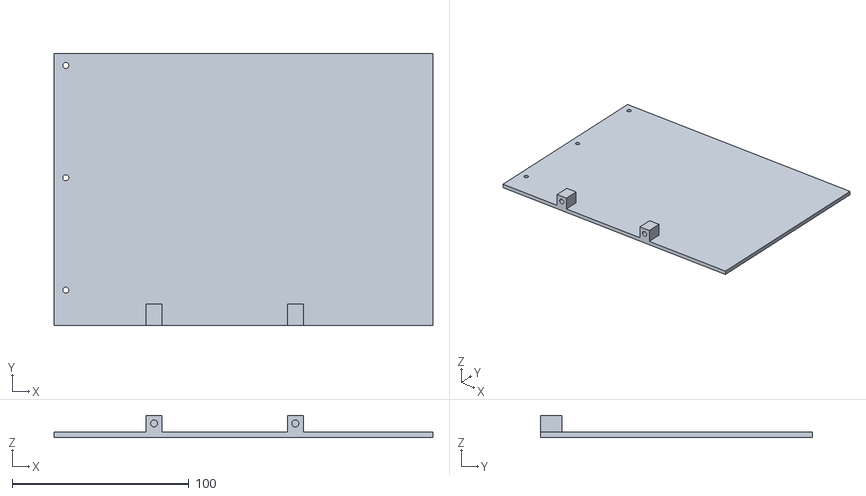
[picture p116: CAD file, 2026-10-24]
housing/print-school-r2/back_LT.stl
214.7 x 153.9 x 12.5
