Seongwonp/Simplelay/housing/stl/fit_test.stl

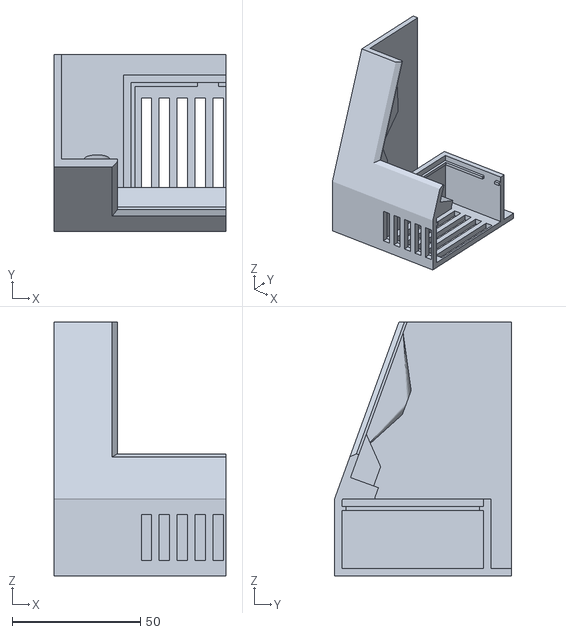
[picture p117: CAD file, 2026-10-18]
housing/stl/fit_test.stl
67.0 x 69.0 x 99.0
