Seongwonp/Simplelay/housing/print-school-r2/back_RT.stl

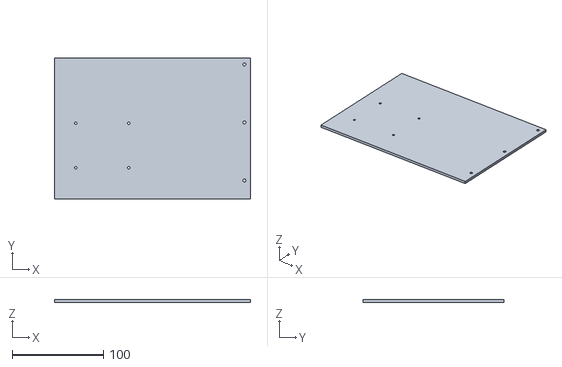
[picture p118: CAD file, 2026-10-24]
housing/print-school-r2/back_RT.stl
214.7 x 153.9 x 3.00
