Seongwonp/Simplelay/housing/print-school-r2/shell_LB.stl

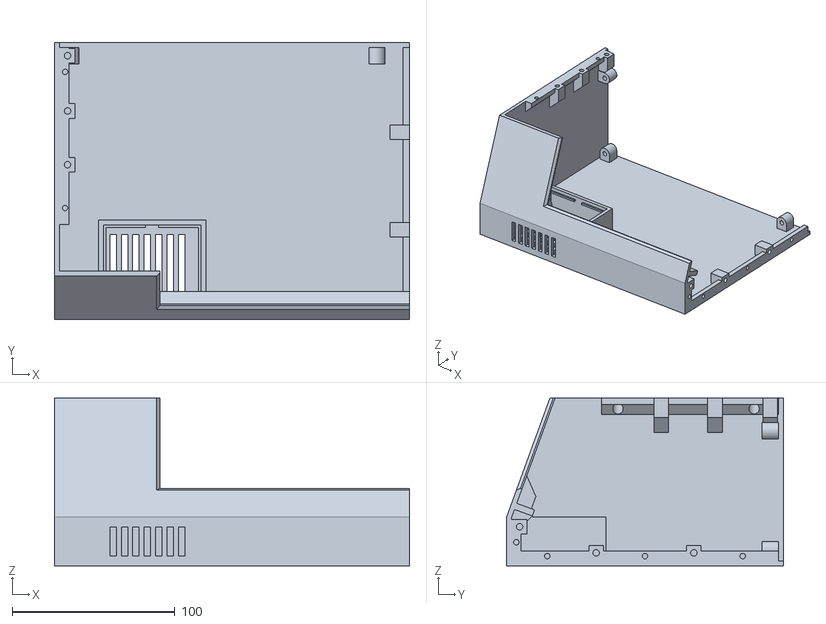
[picture p119: CAD file, 2026-10-24]
housing/print-school-r2/shell_LB.stl
218.0 x 170.0 x 103.0
