Seongwonp/Simplelay/housing/print-school-r2/shell_LT.stl

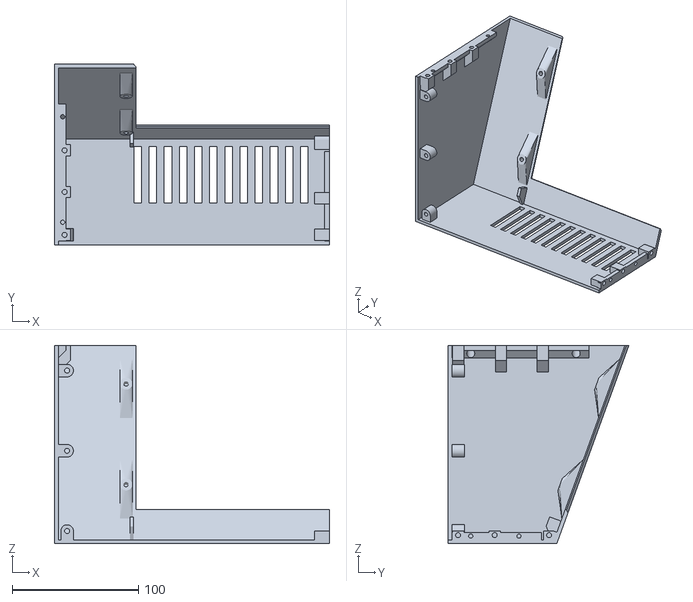
[picture p120: CAD file, 2026-10-24]
housing/print-school-r2/shell_LT.stl
218.0 x 143.4 x 157.2
