Seongwonp/Simplelay/(list of files, cad)

Other CAD files:
housing/print-school-r2/test/panel_clip_x1.stl
housing/stl/panel_clip.stl
housing/stl/back_LB.stl
housing/stl/back_LT.stl
housing/stl/back_RB.stl
housing/stl/back_RT.stl
housing/stl/sensor_lid.stl
housing/stl/shell_LB.stl
housing/stl/shell_LT.stl
housing/stl/shell_RB.stl
housing/stl/shell_RT.stl
