Seongwonp/Simplelay/housing/print-school-r2/README.md

# 학교 FDM(Bambu Lab A1)용 R2 하우징 — 위·아래 분할

업체용 R2 왼쪽 몸통(218 × 170 × 260)은 A1(256 mm)에 어느 방향으로도 들어가지 않는다.
이 묶음은 **같은 R2 치수**(전체 폭 436, 왼쪽 포트 여유 60, 왼쪽 고리 받침 105·190)를 유지하고
몸통을 다시 위·아래로 나눈 판이다. 원본은 [`../school-a1-r2.scad`](../school-a1-r2.scad)이며,
[`../simplelay_box.scad`](../simplelay_box.scad)를 같은 폴더에 두고 연다.

## 출력 목록

| 파일 | 개수 | 크기(mm) | 비고 |
|---|---|---|---|
| `shell_LB.stl`·`shell_RB.stl` | 각 1 | 218 × 170 × 103 | 몸통 아래 좌·우 |
| `shell_LT.stl`·`shell_RT.stl` | 각 1 | 218 × 170 × 157.2 | 몸통 위 좌·우, 위판이 판에 닿게 뒤집힌 방향 |
| `back_LB`·`back_RB`·`back_LT`·`back_RT` | 각 1 | 최대 214.7 × 153.9 × 12.5 | 뒤판, 바깥면을 판에 |
| `sensor_lid.stl` | 1 | 59.4 × 54.4 × 2 | 센서 칸 뚜껑 |
| `panel_clip.stl` | 4 | 19.25 × 10 × 3 | 모니터 뒤 고정 고리 |
| `dowel_pin.stl` | 16 + 예비 4 | Ø3.8 × 20 | 분할면 맞춤 핀 |
| `rpi5_case_tray.stl` | 1 | 104.7 × 86.5 × 12 | **새 부품** — RPi5 정품 케이스 받침(아래 절) |

모니터 받침은 따로 뽑지 않는다. 패널 아래 끝을 거는 **받침 턱·좌우 멈춤 턱·45° 받침살**이 몸통 아래 조각
(`shell_LB`·`shell_RB`)에 붙어 있고, 뒤쪽은 `panel_clip` 4개가 잡는다.

## 출력 순서

1. **시험 출력(`test/`, 합쳐 약 2~3시간):** `fit_test_r2.stl`(앞 왼쪽 아래 모서리 — 창·받침 턱·멈춤 턱·포트 여유 60),
   `dowel_calibration.stl`(핀 구멍 Ø4.0~4.4 수직·수평), `panel_clip_x1.stl`(고리 1개), `rpi5_case_tray.stl`.
   실제 모니터·핀·RPi5 케이스·플러그로 맞춰 본다.
2. 시험 결과로 필요한 값만 고친다(핀 구멍 지름, `clip_step`, `tray_fit`, `case_*`). 원본은 `../school-a1-r2.scad`.
3. **완성본:** 몸통 4 → 뒤판 4 → 작은 부품. 큰 조각은 각 수 시간 이상 걸린다.

## RPi5 정품 케이스 받침

- 뒤판 RT 안쪽 면에 붙는다. 뒤판의 기존 M2.5 구멍 4개(58 × 49)를 그대로 쓰므로 **뒤판은 바꾸지 않았다.**
  바깥에서 M2.5 × 8 나사를 넣고, 받침 윗면의 육각 홈에 M2.5 너트 4개를 끼워 조인다.
- 케이스(정품 외형 약 98.5 × 70.3 × 33 — 제조사 참고 치수, 실측 필요)는 네 모서리 턱(높이 8, 길이 10)이 자리를 잡는다.
  턱을 짧게 해 긴 변의 USB-C·micro HDMI를 막지 않게 했다. 뒤판이 세워져 있어 케이스가 미끄러지지 않도록
  **찍찍이 끈(폭 20, 약 30 cm) 2줄**을 끈 구멍으로 넣어 받침 아래 홈을 지나 케이스 위로 감는다.
- 받침 중심은 RPi 구멍 중심보다 8 mm 오른쪽(뒤판 RT 가장자리 여유 7.7 mm). 케이스와 둘레 10 mm 케이블 여유가
  몸통(경사면·고리 받침·위판)과 겹치지 않는 것을 CAD 교집합으로 확인했다(빈 결과).
- **미검증:** 실제 케이스 크기·바닥 고무발 유무, 포트 높이(턱 8 mm 아래인지), 케이블 굽힘, 케이스 팬 공기 흐름.

모든 조각이 A1(256³)에 들어간다(A1 mini 180³에는 몸통·뒤판이 안 들어간다). 배율 100%, 자동 축소 금지.

## 업체용 R2와 다른 점

- **가로 분할 높이 z = 103**(기본은 높이의 절반 약 130). 기본 높이는 R2에서 옮긴 왼쪽 아래 고리 받침(세계 z 약 110~161)을
  가로질러 나사 받침이 두 조각으로 갈라진다. 오른쪽 아래 고리 받침(약 44~95)과 사이로 내렸다. 최소 여유 6.9 mm.
- 뒤판 세로 이음 핀 높이를 [82, 112] → [40, 85]로 내려 아래 조각 안에 두었다(분할면까지 6 mm).
- 위·아래 이음(옆벽 덧살 볼트·맞춤 핀)은 기본 설계를 그대로 쓴다. 조립 순서는 [하우징 README](../README.md)와 같다.

## 준비물(추가분)

| 무엇 | 개수 |
|---|---|
| M2.5 × 8 나사 + 너트 | 4 (케이스 받침) |
| 찍찍이 끈 폭 20 mm | 약 30 cm × 2 |
| 나머지(M3 인서트·나사·볼트, 고무발, 폼 테이프) | [하우징 README](../README.md) 준비물 표 |

## 확인한 것 / 안 한 것

- OpenSCAD 렌더: 몸통·뒤판 8조각 모두 Simple = yes. 원본의 assert(고리 받침·뒤판 핀이 분할면에 걸치지 않음,
  RPi5 구멍 4개가 RT 조각, 뒤판 나사 받침 분할선에서 15 mm 이상, 8조각이 A1 안)를 통과.
- **미검증(실물 전):** 핀 끼움 공차(Ø4 구멍/Ø3.8 핀 방향별 차이 — [공차 시험편](../stl/dowel_calibration.stl) 먼저 권장),
  실제 플러그 크기 대비 포트 여유 60 mm, 고리 두께(`clip_step`), 화면 창 위치(`screen_up` 추측),
  RPi5 케이스 받침의 실물 맞춤(위 절), 출력 시간·서포트.
- 경사면의 가로 이음은 화면 창 좌우 띠를 지나므로 기본 설계처럼 접착한다.
