Seongwonp/Simplelay/app/test/goldens/lt_manual.png

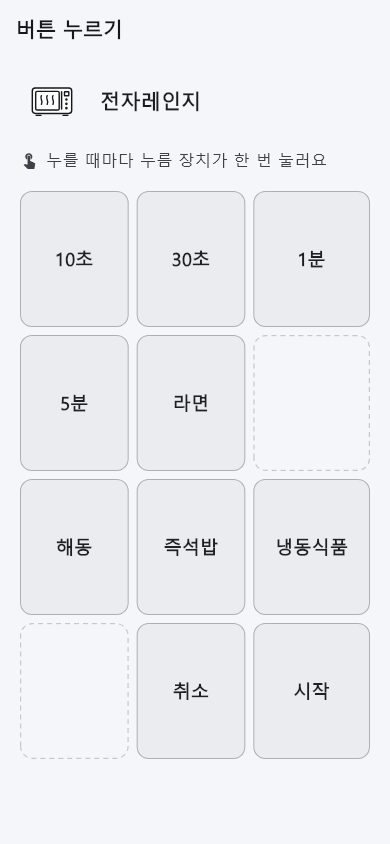
app/test/goldens/lt_manual.png
