Seongwonp/Simplelay/app/test/goldens/lt_manual_not_ready.png

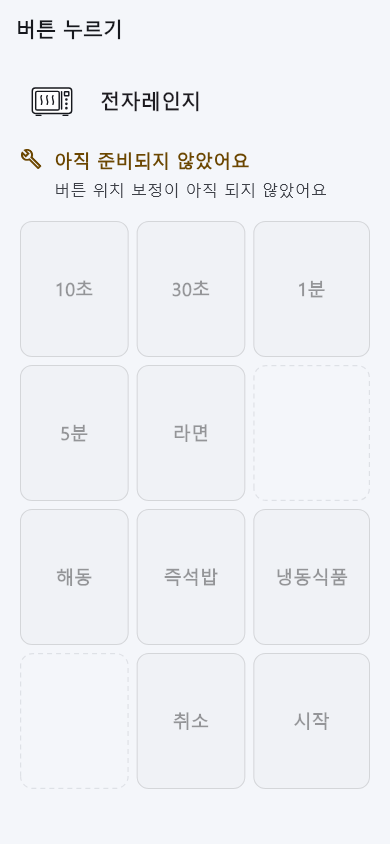
app/test/goldens/lt_manual_not_ready.png
