Seongwonp/Simplelay/app/test/goldens/manual_large.png

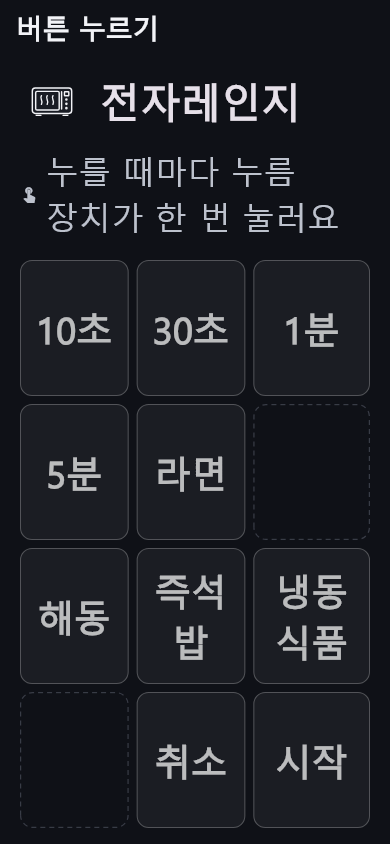
app/test/goldens/manual_large.png
