Seongwonp/Simplelay/housing/print-order-r2/preview_interior.png

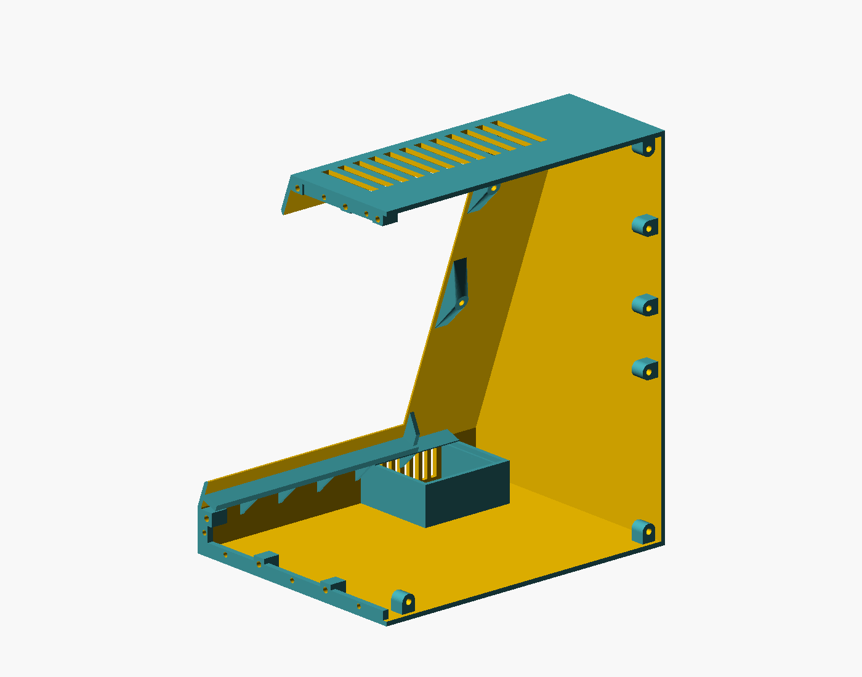
housing/print-order-r2/preview_interior.png
