Seongwonp/Simplelay/housing/print-school-r2/preview_assembly.png

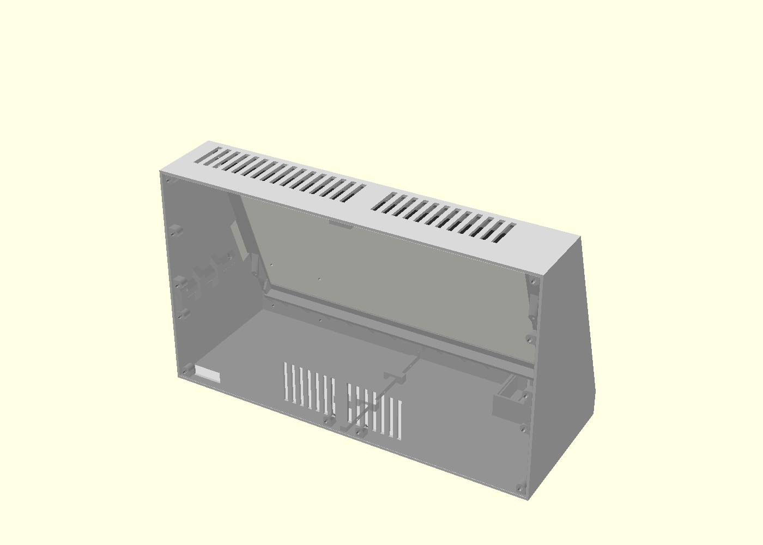
housing/print-school-r2/preview_assembly.png
