Seongwonp/Simplelay/housing/print-school-r2/preview_shell_LB.png

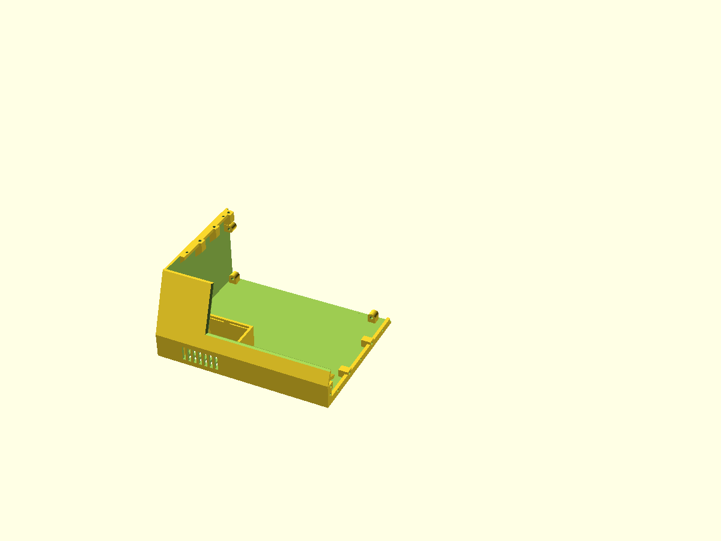
housing/print-school-r2/preview_shell_LB.png
