Seongwonp/Simplelay/housing/print-school-r2/preview_tray_part.png

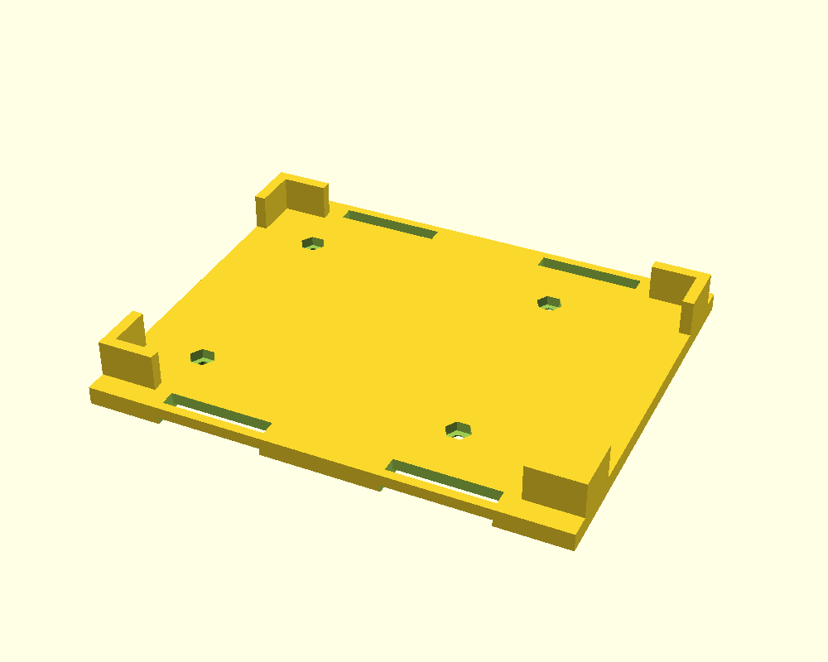
housing/print-school-r2/preview_tray_part.png
