Seongwonp/Simplelay/rpi5-touchscreen-app/test/goldens/manual.png

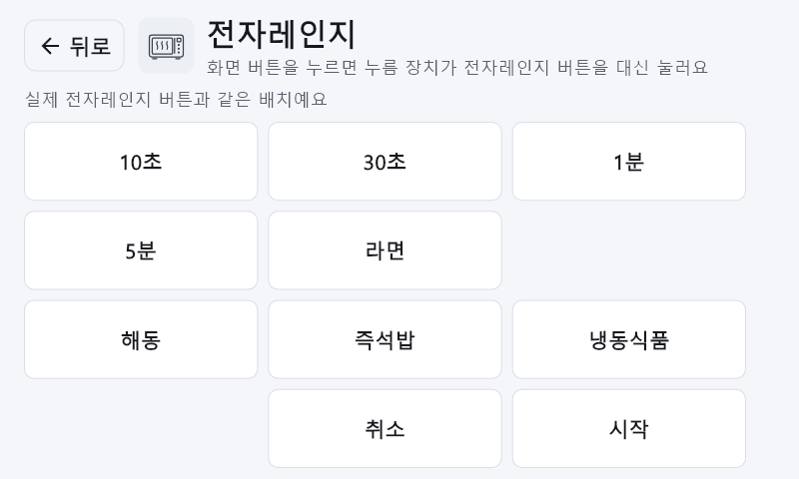
rpi5-touchscreen-app/test/goldens/manual.png
