Seongwonp/Simplelay/rpi5-touchscreen-app/test/goldens/manual_large.png

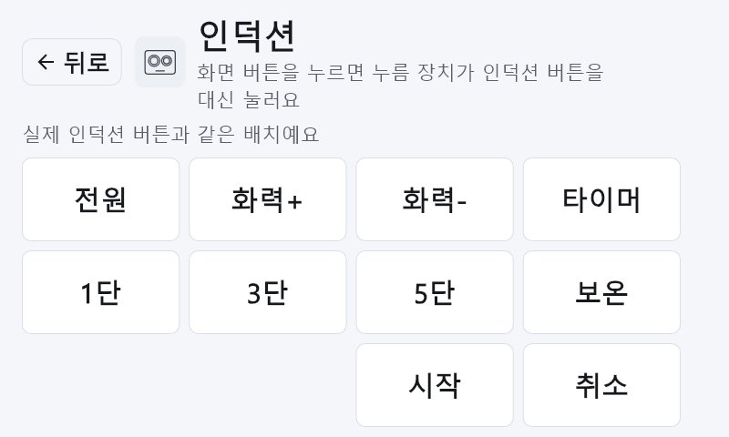
rpi5-touchscreen-app/test/goldens/manual_large.png
