Seongwonp/Simplelay/rpi5-touchscreen-app/test/goldens/manual_not_ready.png

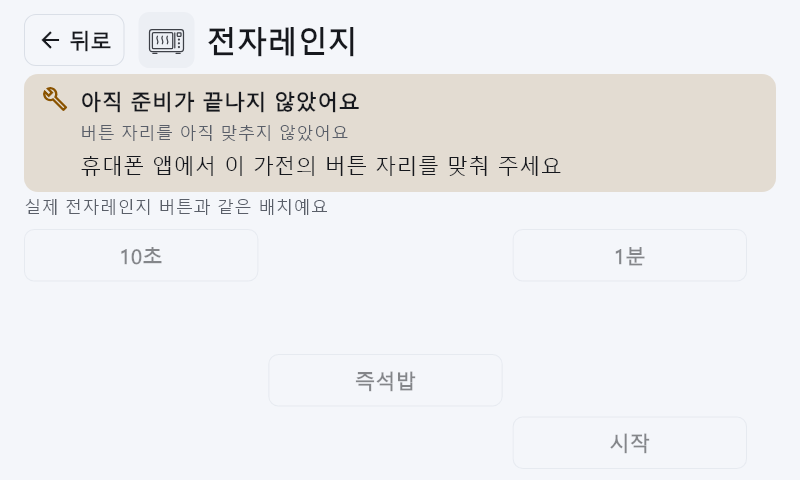
rpi5-touchscreen-app/test/goldens/manual_not_ready.png
