Seongwonp/Simplelay/app/test/goldens/detail_photo_dark.png

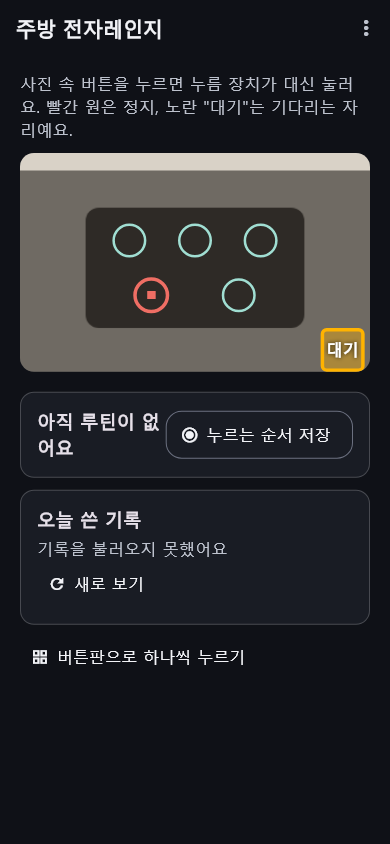
app/test/goldens/detail_photo_dark.png
