Seongwonp/Simplelay/app/test/goldens/editor_large.png

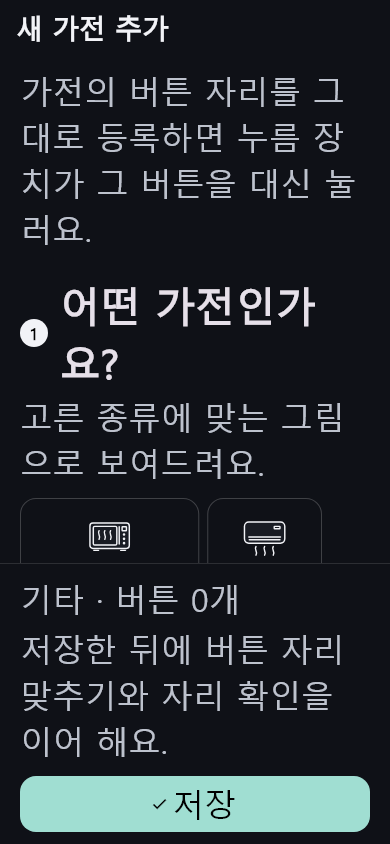
app/test/goldens/editor_large.png
