Seongwonp/Simplelay/app/test/goldens/help_large.png

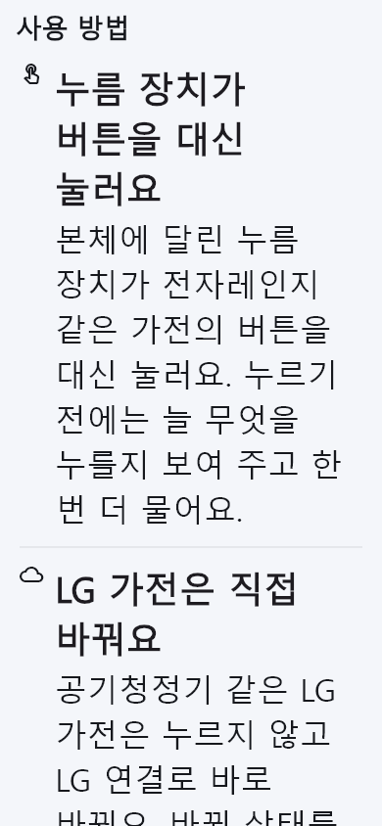
app/test/goldens/help_large.png
