Seongwonp/Simplelay/app/test/goldens/home_dark.png

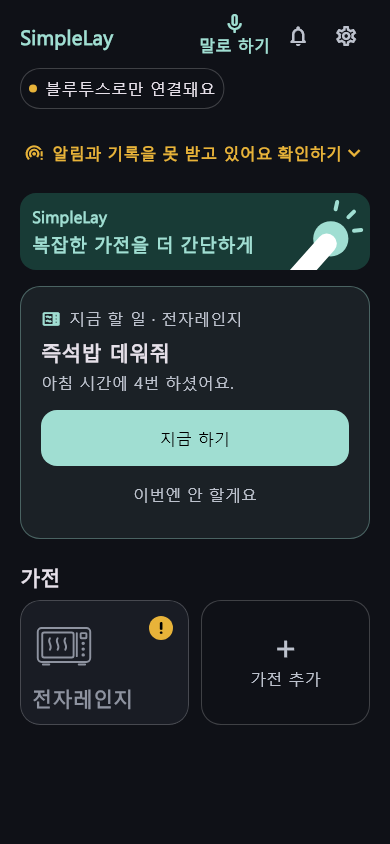
app/test/goldens/home_dark.png
