Seongwonp/Simplelay/app/test/goldens/home_demo.png

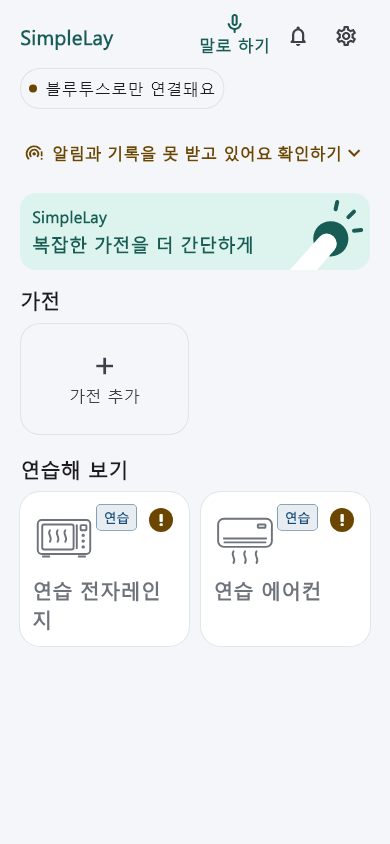
app/test/goldens/home_demo.png
