Seongwonp/Simplelay/app/test/goldens/home_empty.png

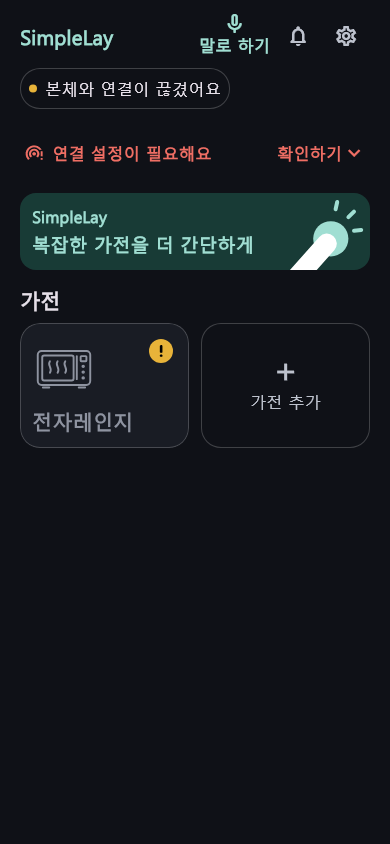
app/test/goldens/home_empty.png
