Seongwonp/Simplelay/app/test/goldens/home_full_dark.png

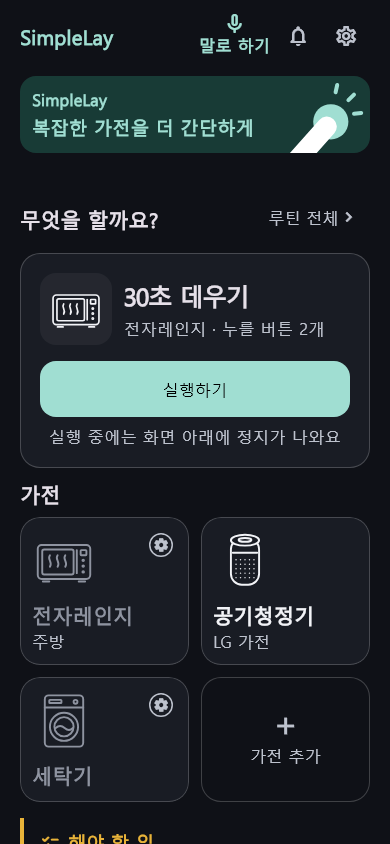
app/test/goldens/home_full_dark.png
