Seongwonp/Simplelay/app/test/goldens/home_full_large.png

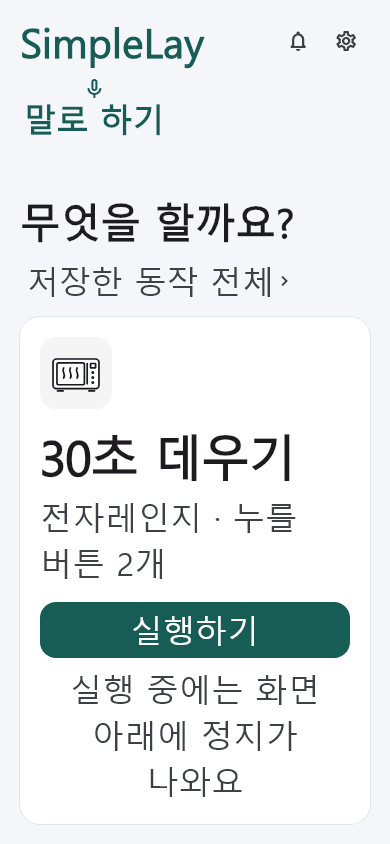
app/test/goldens/home_full_large.png
