Seongwonp/Simplelay/app/test/goldens/home_full_light.png

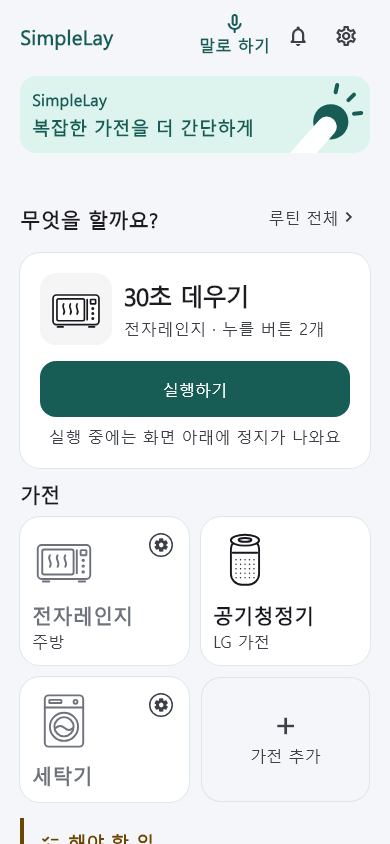
app/test/goldens/home_full_light.png
