Seongwonp/Simplelay/app/test/goldens/home_large.png

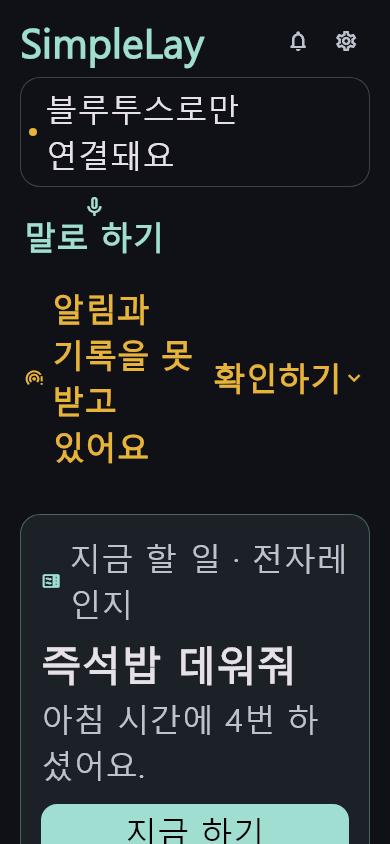
app/test/goldens/home_large.png
