Seongwonp/Simplelay/app/test/goldens/home_light.png

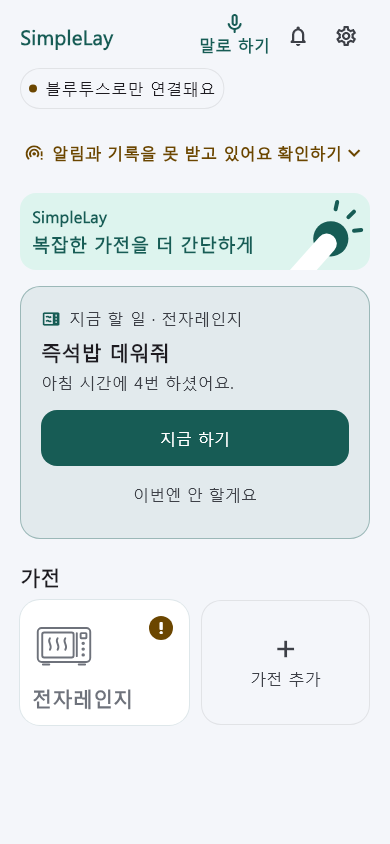
app/test/goldens/home_light.png
