Seongwonp/Simplelay/app/test/goldens/home_no_appliance.png

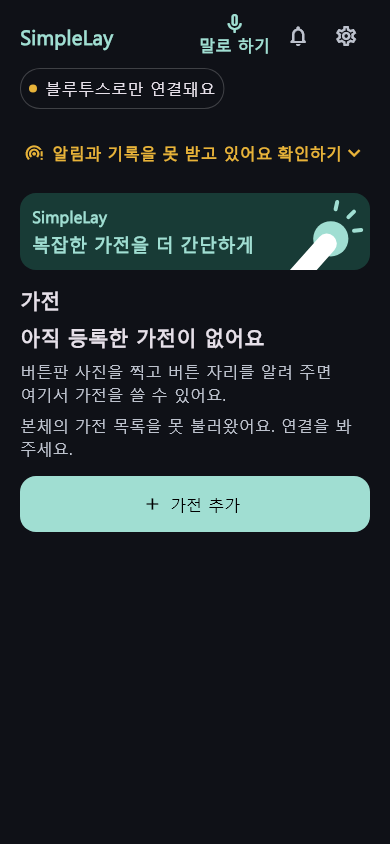
app/test/goldens/home_no_appliance.png
