Seongwonp/Simplelay/app/test/goldens/home_no_appliance_large.png

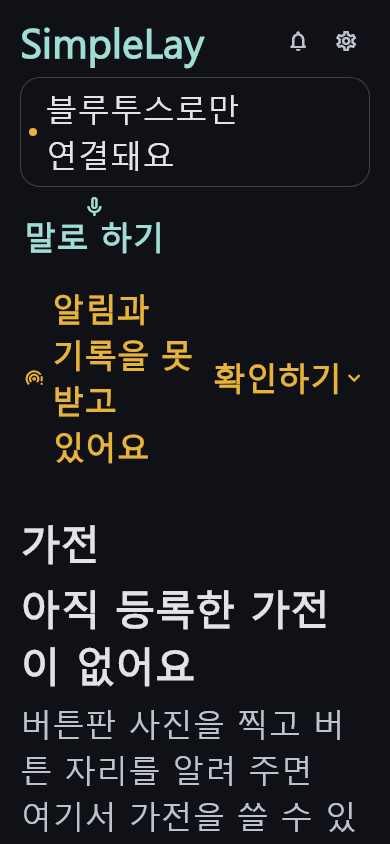
app/test/goldens/home_no_appliance_large.png
