Seongwonp/Simplelay/app/test/goldens/home_photo_dark.png

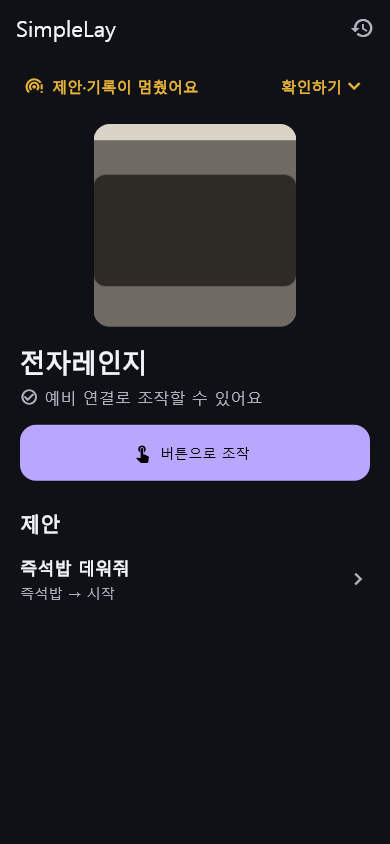
app/test/goldens/home_photo_dark.png
