Seongwonp/Simplelay/app/test/goldens/home_two_appliances.png

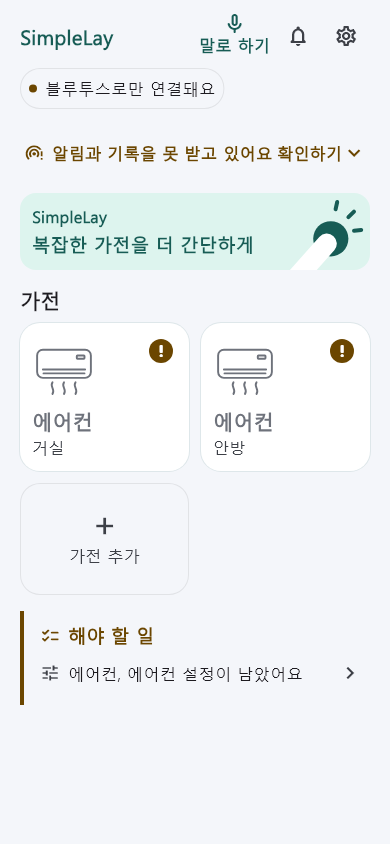
app/test/goldens/home_two_appliances.png
