Seongwonp/Simplelay/app/test/goldens/home_unknown_category.png

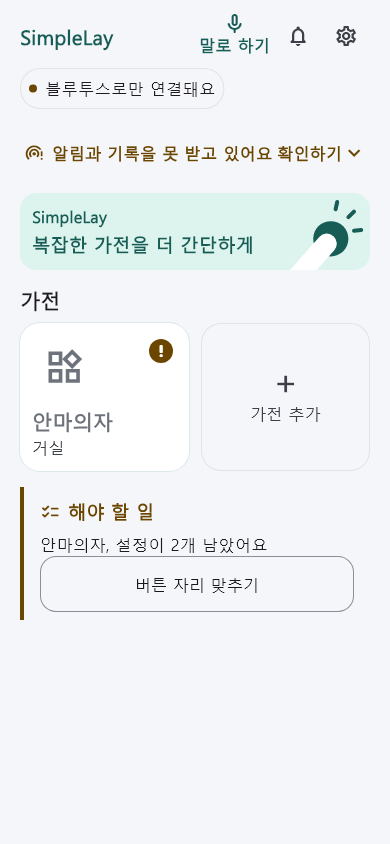
app/test/goldens/home_unknown_category.png
