Seongwonp/Simplelay/app/test/goldens/learning_1.0.png

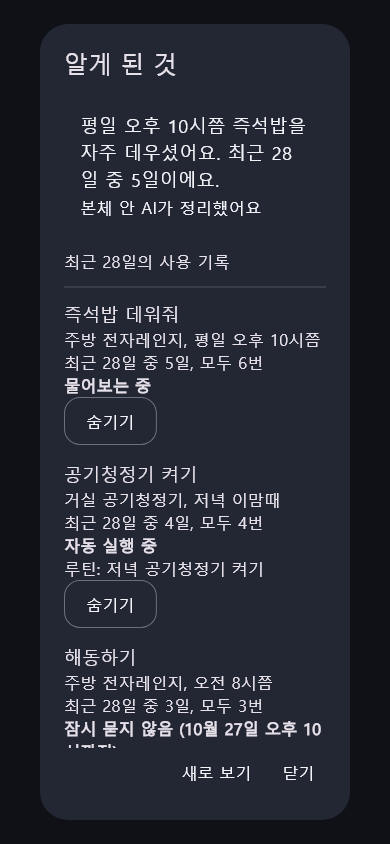
app/test/goldens/learning_1.0.png
