Seongwonp/Simplelay/app/test/goldens/learning_1.6.png

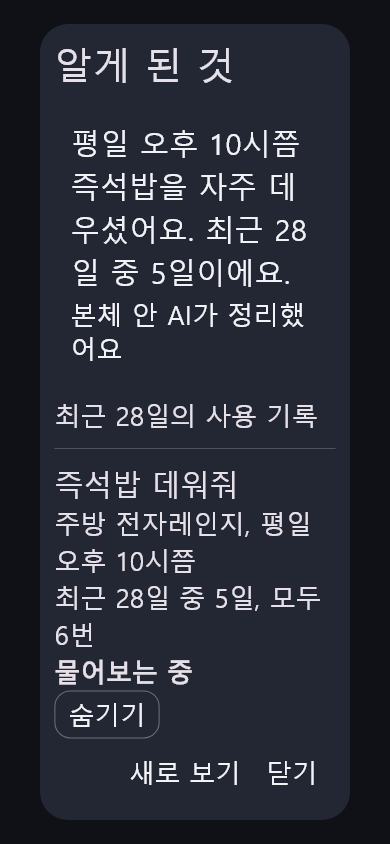
app/test/goldens/learning_1.6.png
