Seongwonp/Simplelay/app/test/goldens/lt_detail_photo.png

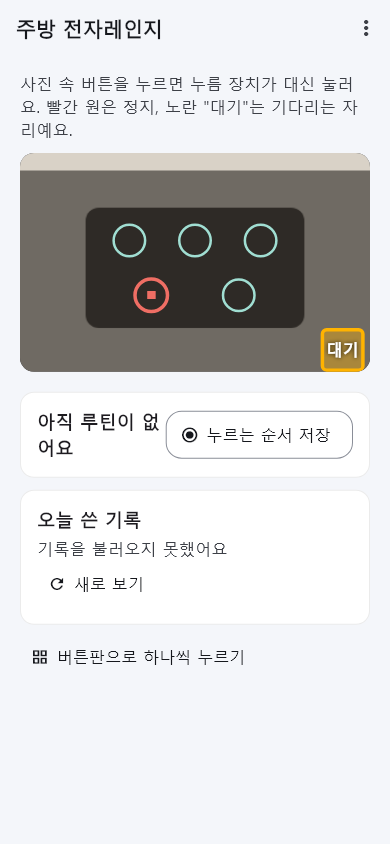
app/test/goldens/lt_detail_photo.png
