Seongwonp/Simplelay/app/test/goldens/lt_editor.png

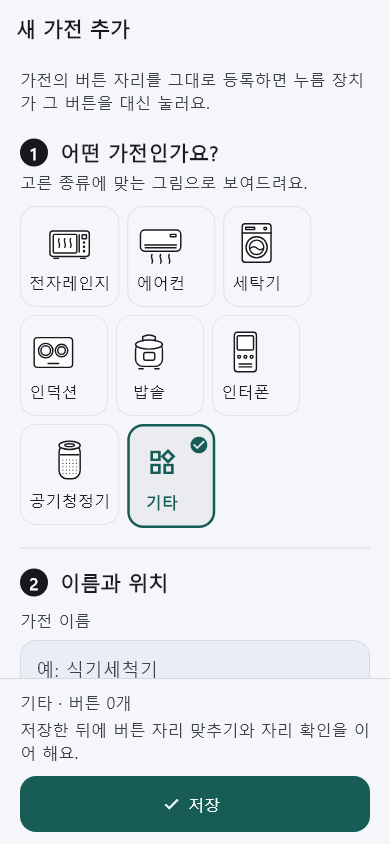
app/test/goldens/lt_editor.png
