Seongwonp/Simplelay/app/test/goldens/lt_help.png

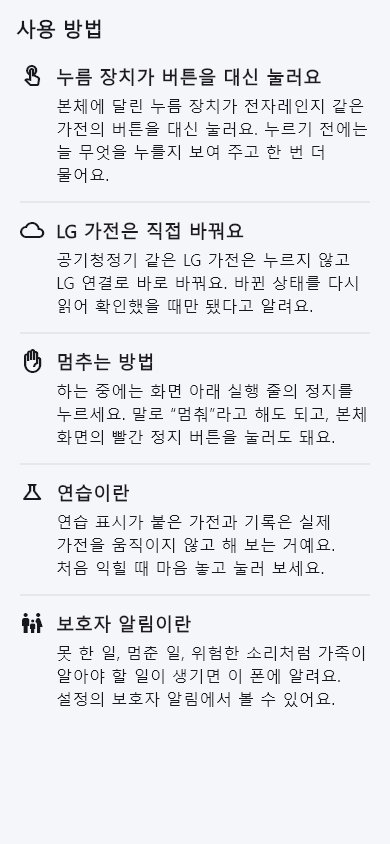
app/test/goldens/lt_help.png
