Seongwonp/Simplelay/app/test/goldens/lt_home_empty.png

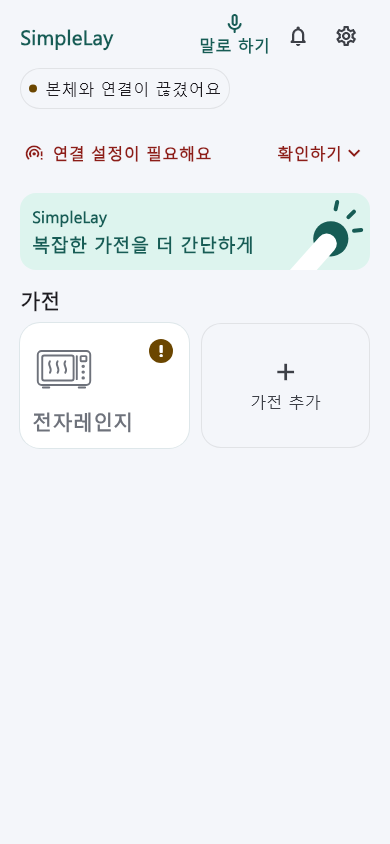
app/test/goldens/lt_home_empty.png
