Seongwonp/Simplelay/app/test/goldens/lt_home_no_appliance.png

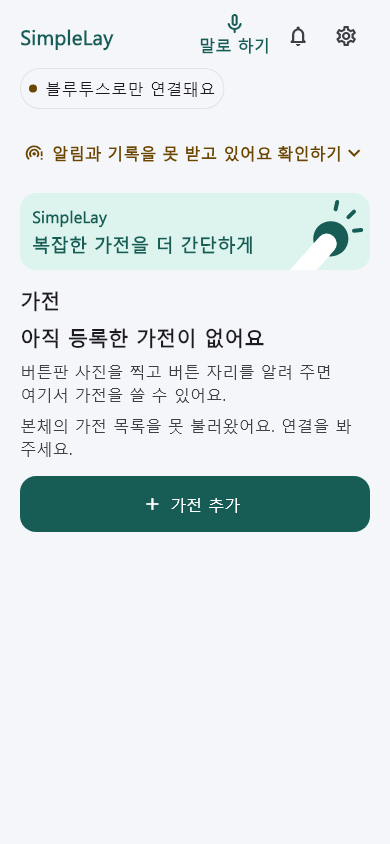
app/test/goldens/lt_home_no_appliance.png
