Seongwonp/Simplelay/app/test/goldens/lt_home_photo.png

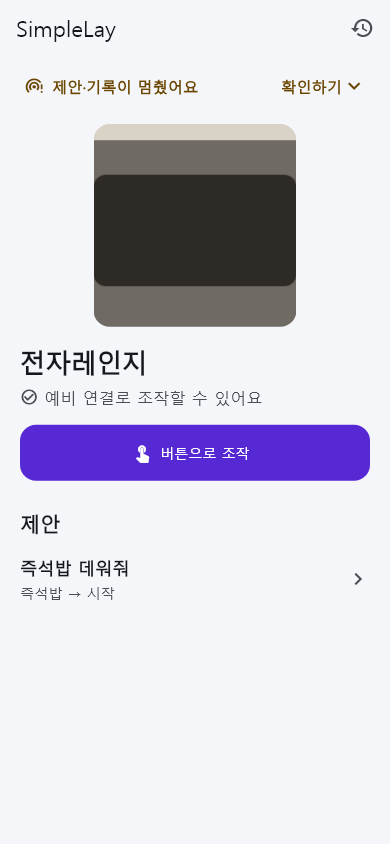
app/test/goldens/lt_home_photo.png
