Seongwonp/Simplelay/app/test/goldens/lt_home_practice_washer.png

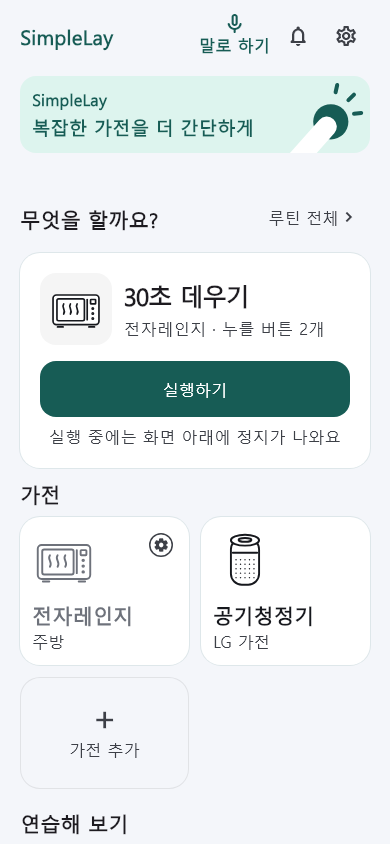
app/test/goldens/lt_home_practice_washer.png
