Seongwonp/Simplelay/app/test/goldens/lt_routine_confirm.png

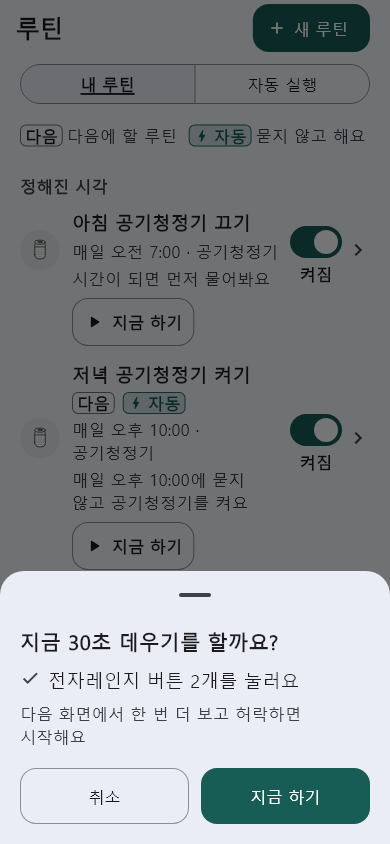
app/test/goldens/lt_routine_confirm.png
