Seongwonp/Simplelay/app/test/goldens/lt_routine_editor.png

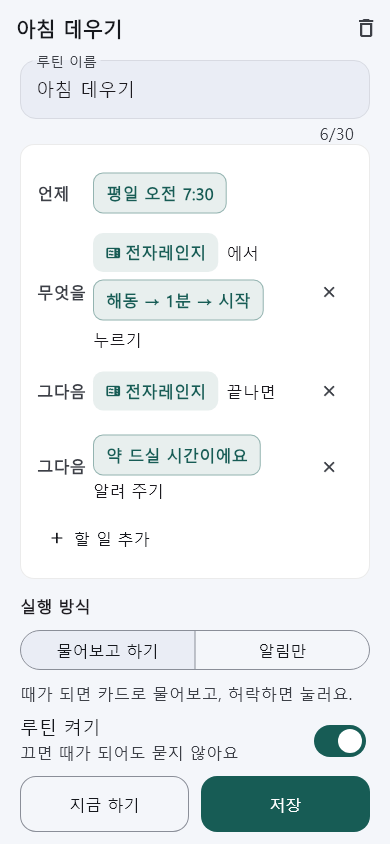
app/test/goldens/lt_routine_editor.png
