Seongwonp/Simplelay/app/test/goldens/lt_settings.png

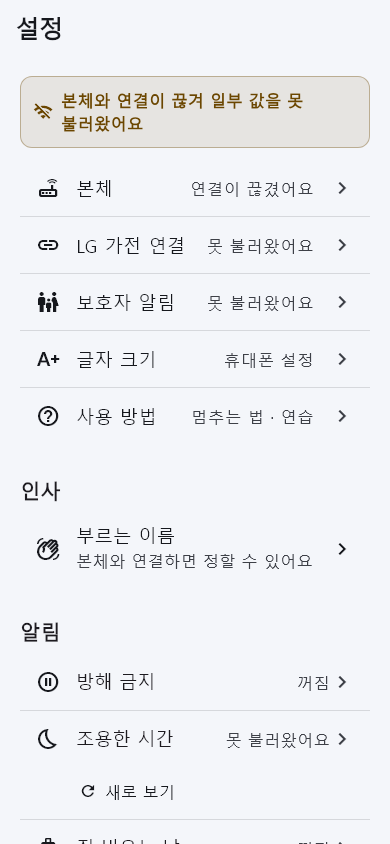
app/test/goldens/lt_settings.png
