Seongwonp/Simplelay/app/test/goldens/lt_status.png

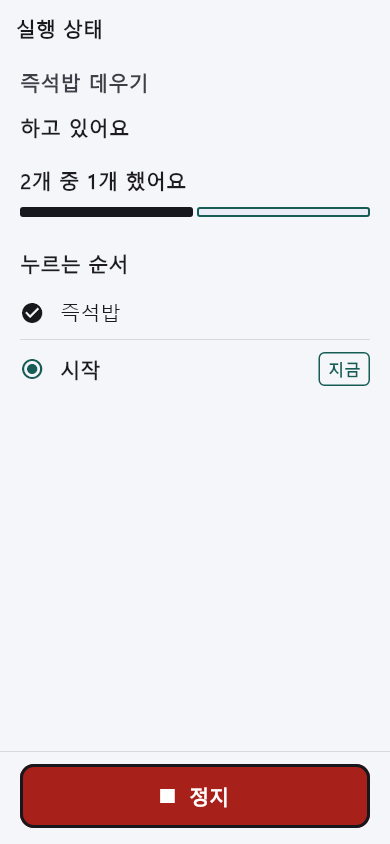
app/test/goldens/lt_status.png
