Seongwonp/Simplelay/app/test/goldens/lt_status_closed_loop.png

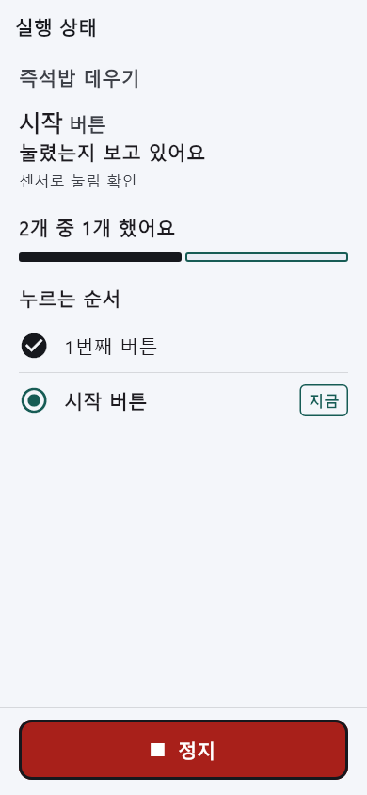
app/test/goldens/lt_status_closed_loop.png
