Seongwonp/Simplelay/app/test/goldens/lt_status_completed.png

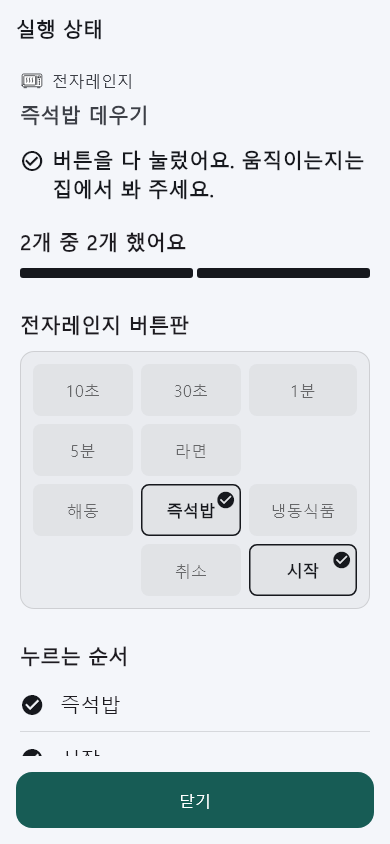
app/test/goldens/lt_status_completed.png
