Seongwonp/Simplelay/app/test/goldens/lt_status_retrying.png

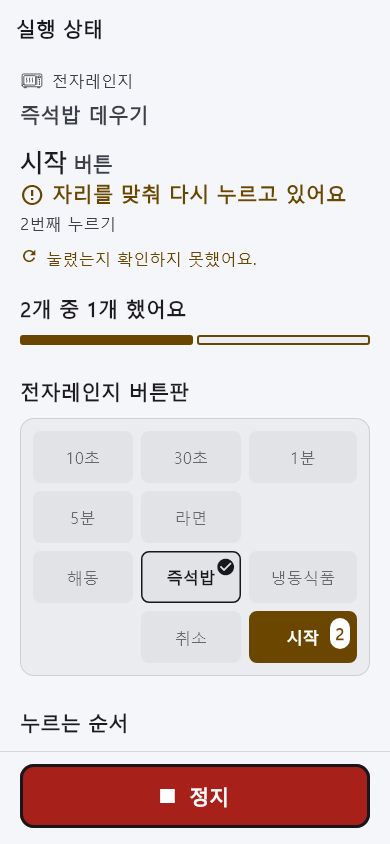
app/test/goldens/lt_status_retrying.png
