Seongwonp/Simplelay/app/test/goldens/lt_status_unknown.png

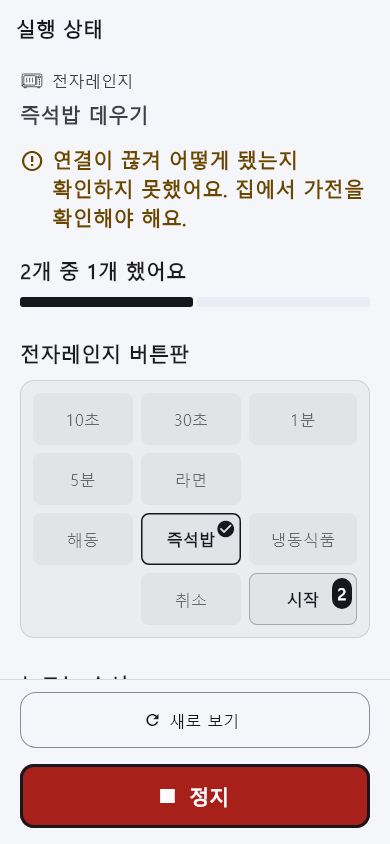
app/test/goldens/lt_status_unknown.png
