Seongwonp/Simplelay/app/test/goldens/lt_suggestion.png

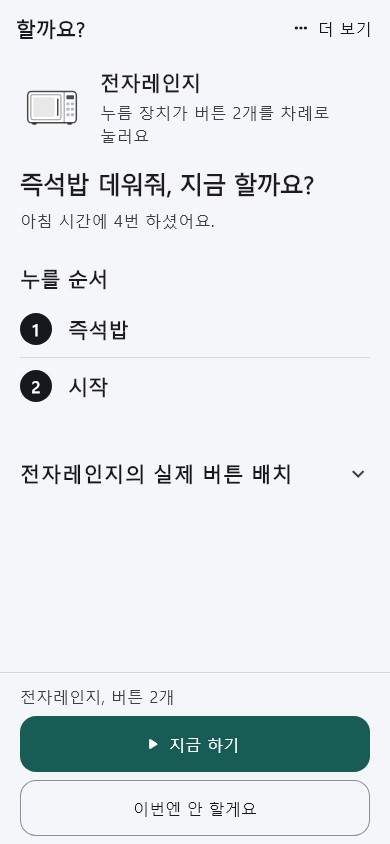
app/test/goldens/lt_suggestion.png
