Seongwonp/Simplelay/app/test/goldens/lt_thinq_washer_practice.png

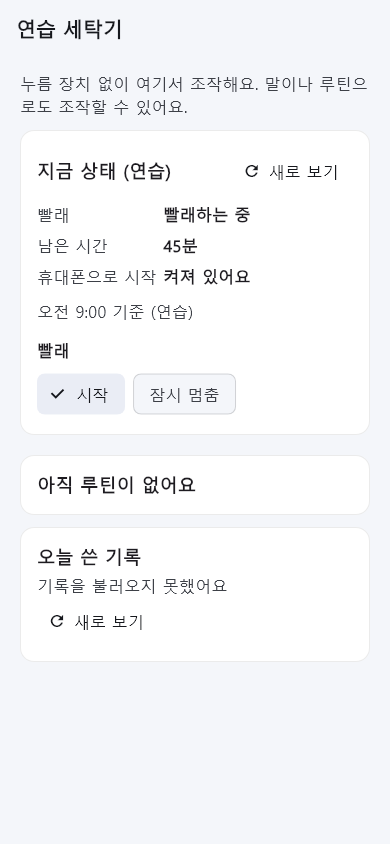
app/test/goldens/lt_thinq_washer_practice.png
