Seongwonp/Simplelay/app/test/goldens/lt_voice_confirm.png

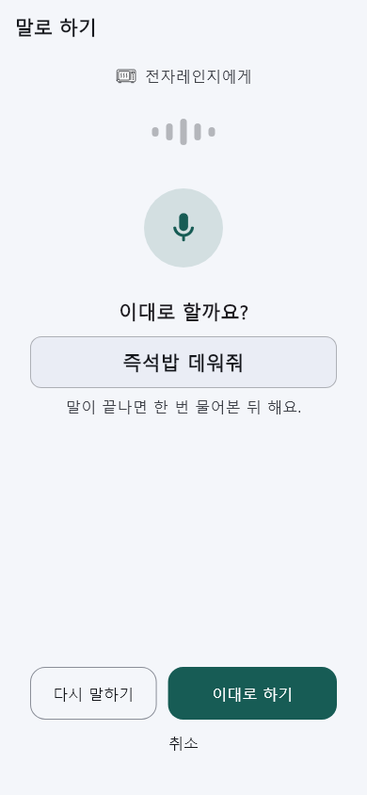
app/test/goldens/lt_voice_confirm.png
