Seongwonp/Simplelay/app/test/goldens/lt_voice_idle.png

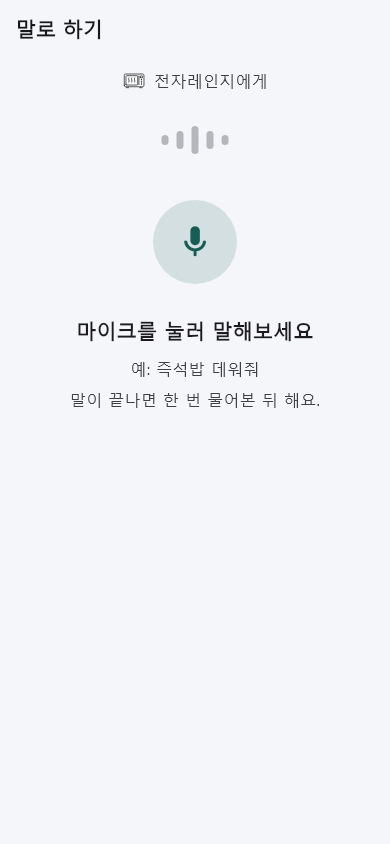
app/test/goldens/lt_voice_idle.png
