Seongwonp/Simplelay/app/test/goldens/lt_voice_listening.png

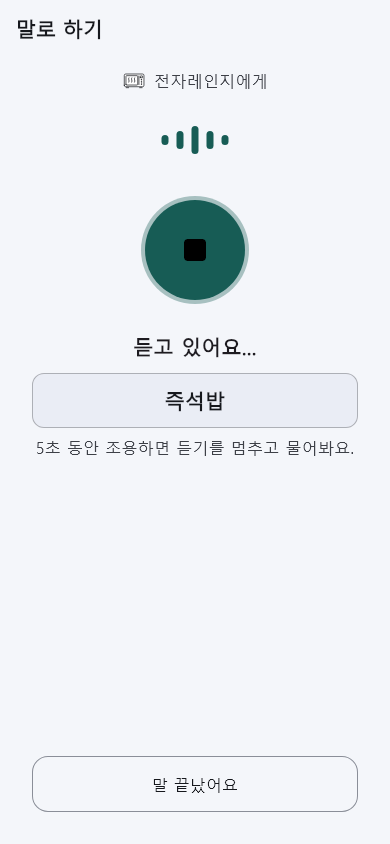
app/test/goldens/lt_voice_listening.png
