Seongwonp/Simplelay/app/test/goldens/lt_voice_unavailable.png

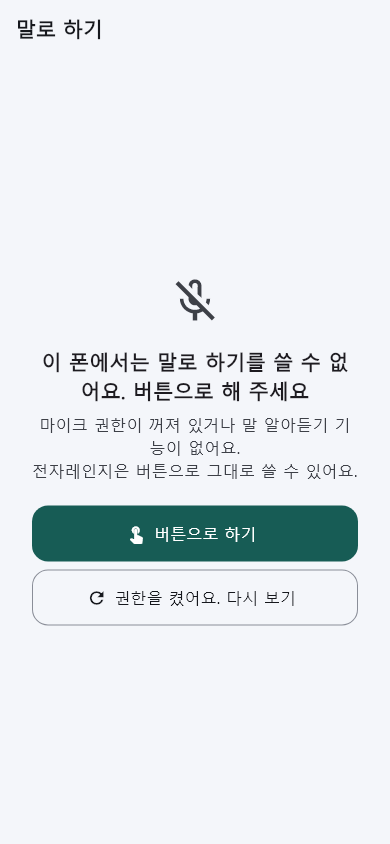
app/test/goldens/lt_voice_unavailable.png
