Seongwonp/Simplelay/app/test/goldens/routines_large.png

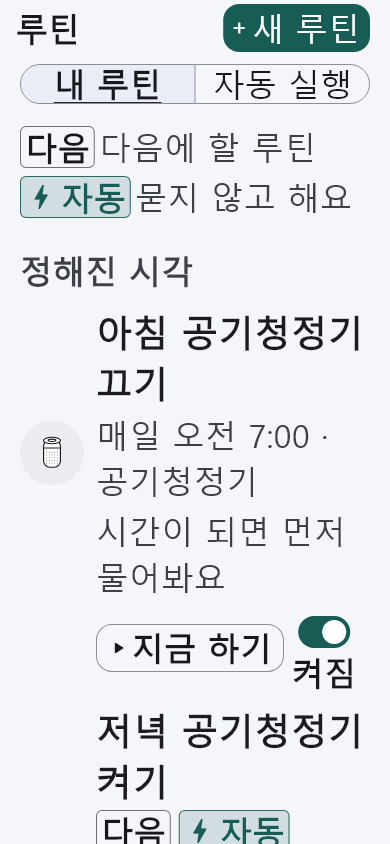
app/test/goldens/routines_large.png
