Seongwonp/Simplelay/app/test/goldens/routines_light.png

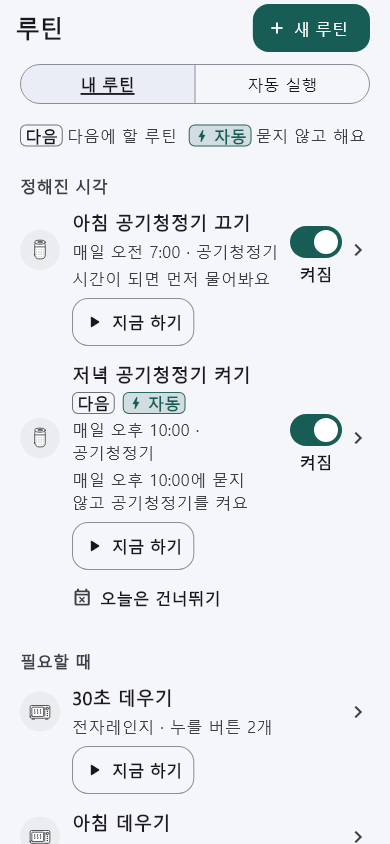
app/test/goldens/routines_light.png
