Seongwonp/Simplelay/app/test/goldens/routines_rules_light.png

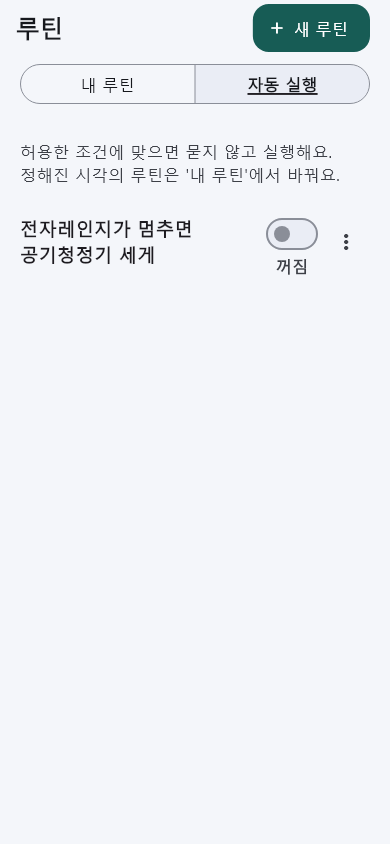
app/test/goldens/routines_rules_light.png
