Seongwonp/Simplelay/app/test/goldens/settings.png

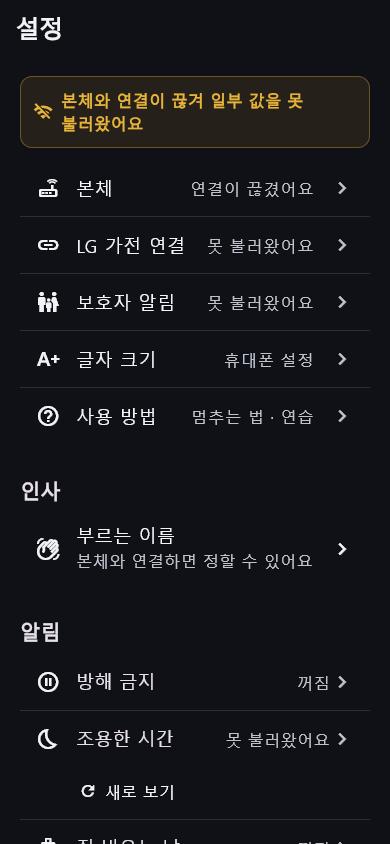
app/test/goldens/settings.png
