Seongwonp/Simplelay/app/test/goldens/settings_large.png

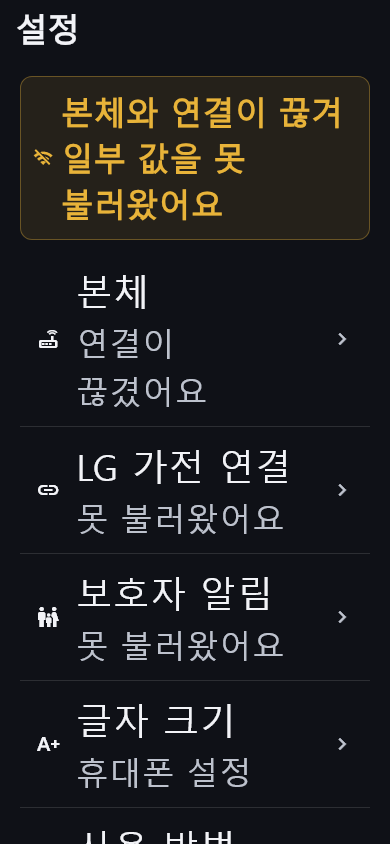
app/test/goldens/settings_large.png
