Seongwonp/Simplelay/app/test/goldens/shell_dark.png

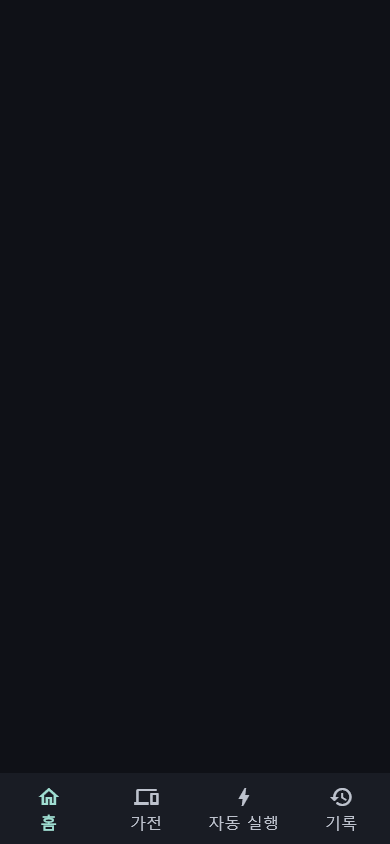
app/test/goldens/shell_dark.png
