Seongwonp/Simplelay/app/test/goldens/shell_estop.png

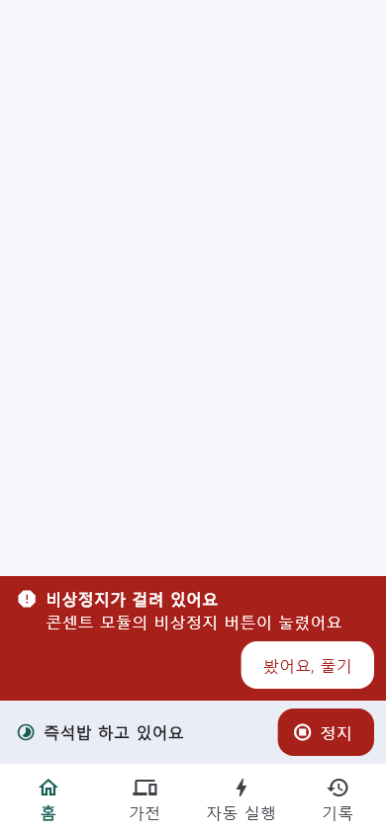
app/test/goldens/shell_estop.png
