Seongwonp/Simplelay/app/test/goldens/shell_light.png

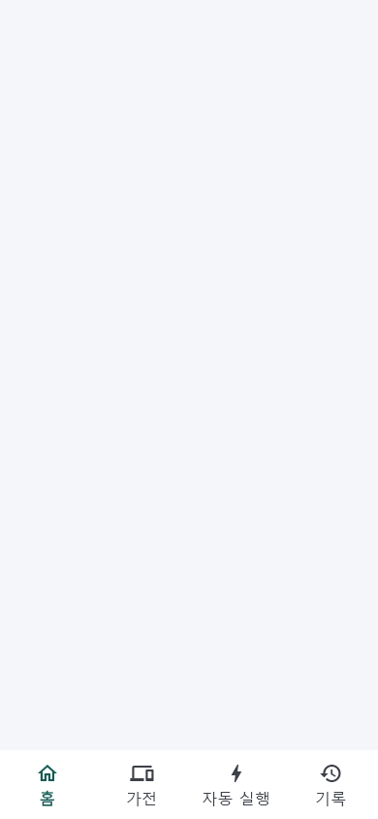
app/test/goldens/shell_light.png
