Seongwonp/Simplelay/app/test/goldens/status.png

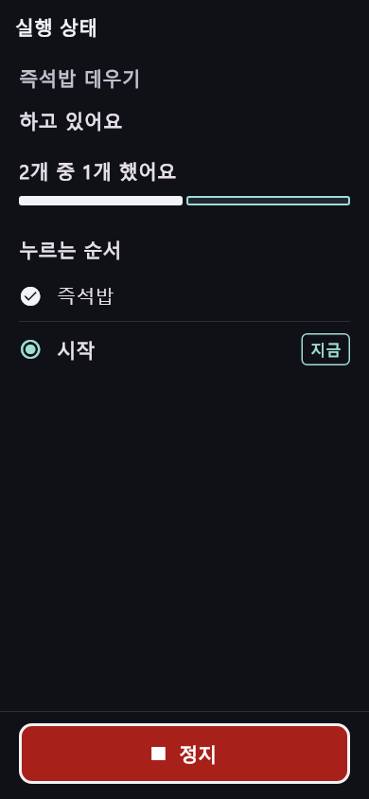
app/test/goldens/status.png
