Seongwonp/Simplelay/app/test/goldens/status_closed_loop.png

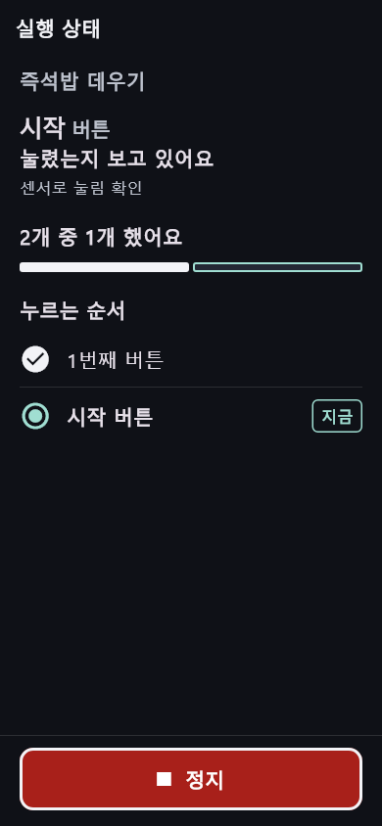
app/test/goldens/status_closed_loop.png
