Seongwonp/Simplelay/app/test/goldens/status_large.png

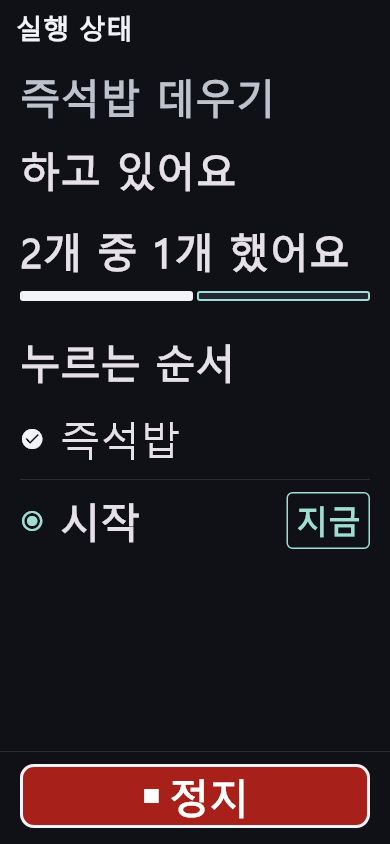
app/test/goldens/status_large.png
