Seongwonp/Simplelay/app/test/goldens/status_unknown_large.png

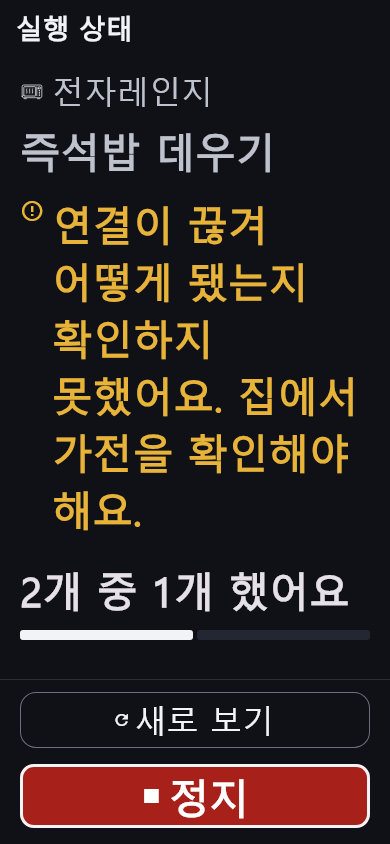
app/test/goldens/status_unknown_large.png
