Seongwonp/Simplelay/app/test/goldens/submission_status_done.png

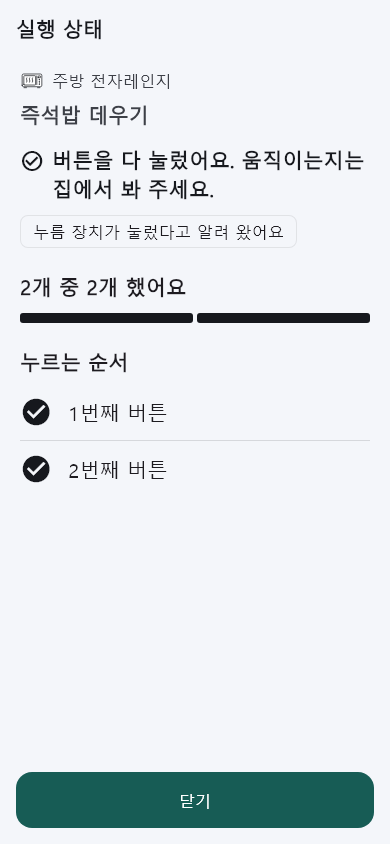
app/test/goldens/submission_status_done.png
