Seongwonp/Simplelay/app/test/goldens/submission_status_running.png

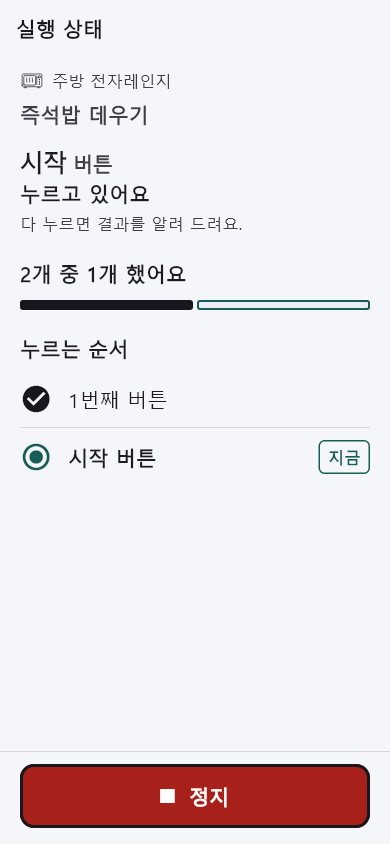
app/test/goldens/submission_status_running.png
