Seongwonp/Simplelay/app/test/goldens/suggestion.png

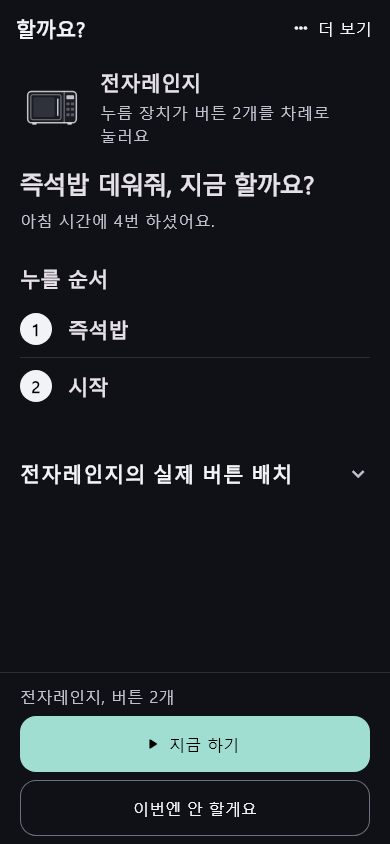
app/test/goldens/suggestion.png
