Seongwonp/Simplelay/app/test/goldens/suggestion_large.png

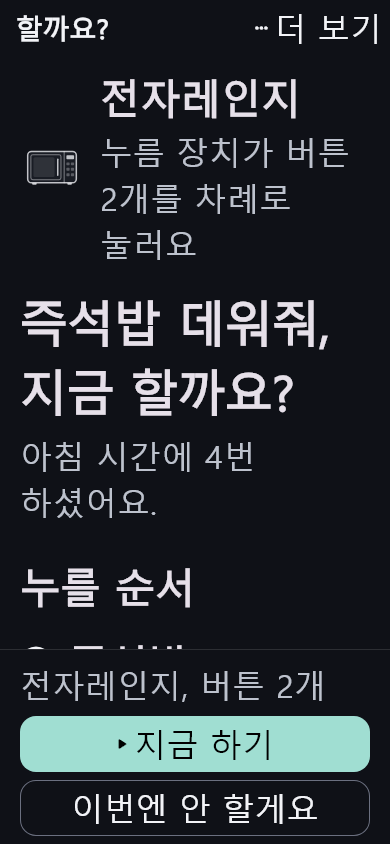
app/test/goldens/suggestion_large.png
