Seongwonp/Simplelay/app/test/goldens/suggestion_long.png

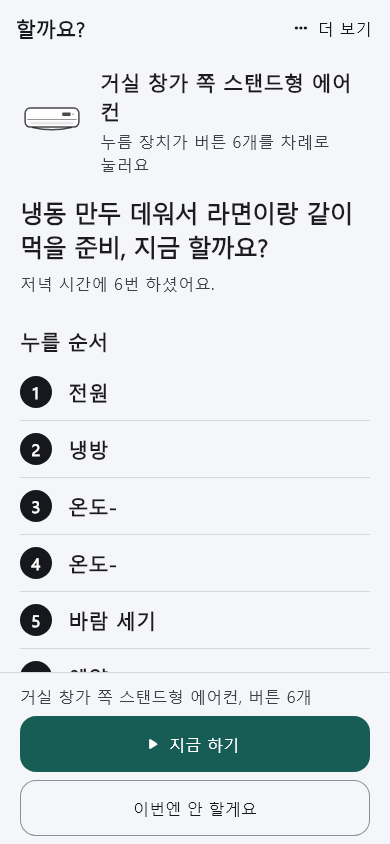
app/test/goldens/suggestion_long.png
