Seongwonp/Simplelay/app/test/goldens/suggestion_long_large.png

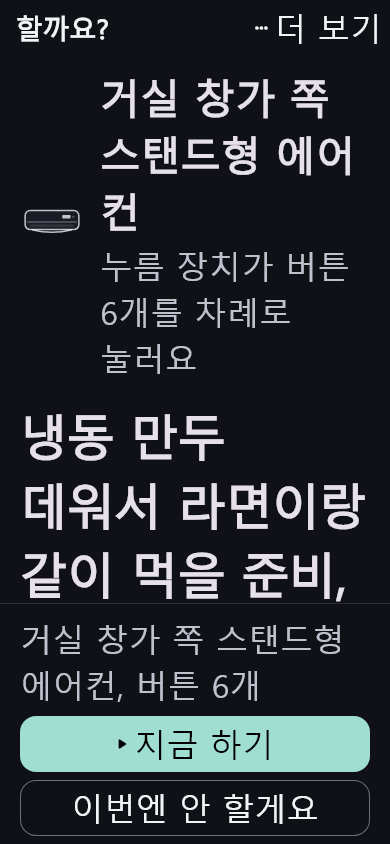
app/test/goldens/suggestion_long_large.png
