Seongwonp/Simplelay/app/test/goldens/task_appliances_dark.png

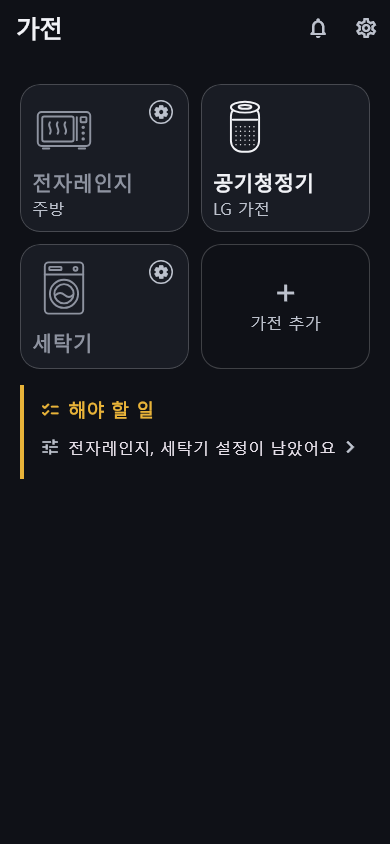
app/test/goldens/task_appliances_dark.png
