Seongwonp/Simplelay/app/test/goldens/task_appliances_large.png

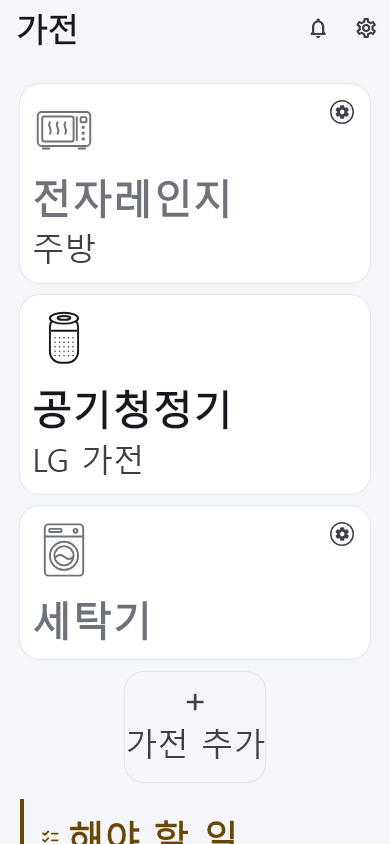
app/test/goldens/task_appliances_large.png
