Seongwonp/Simplelay/app/test/goldens/task_appliances_light.png

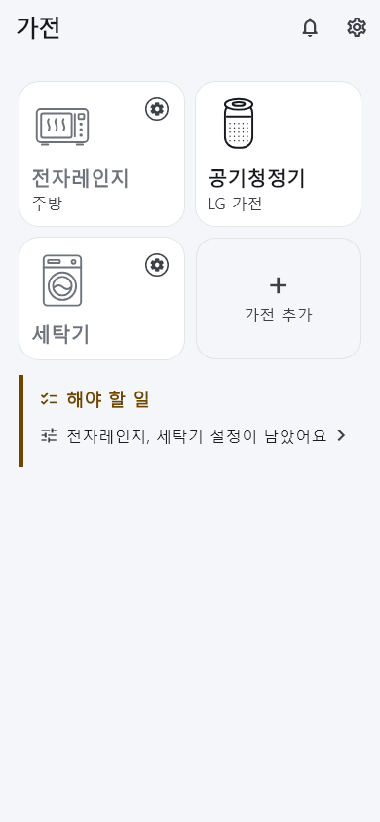
app/test/goldens/task_appliances_light.png
