Seongwonp/Simplelay/app/test/goldens/task_automation_dark.png

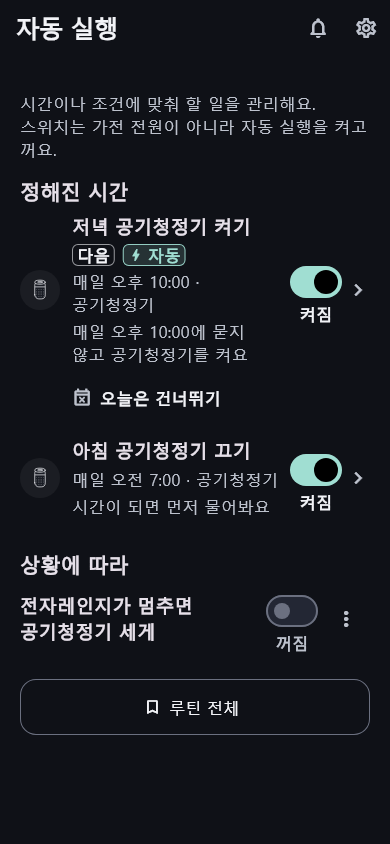
app/test/goldens/task_automation_dark.png
