Seongwonp/Simplelay/app/test/goldens/task_automation_large.png

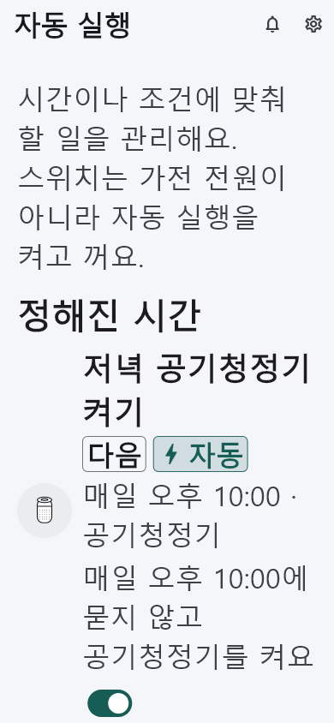
app/test/goldens/task_automation_large.png
