Seongwonp/Simplelay/app/test/goldens/task_automation_light.png

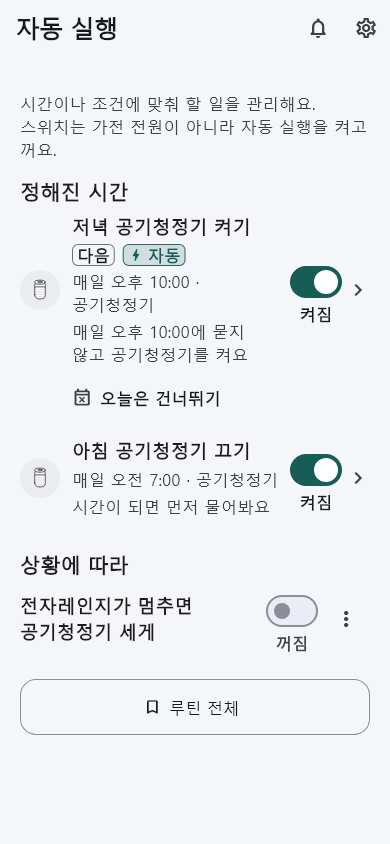
app/test/goldens/task_automation_light.png
