Seongwonp/Simplelay/app/test/goldens/task_home_light.png

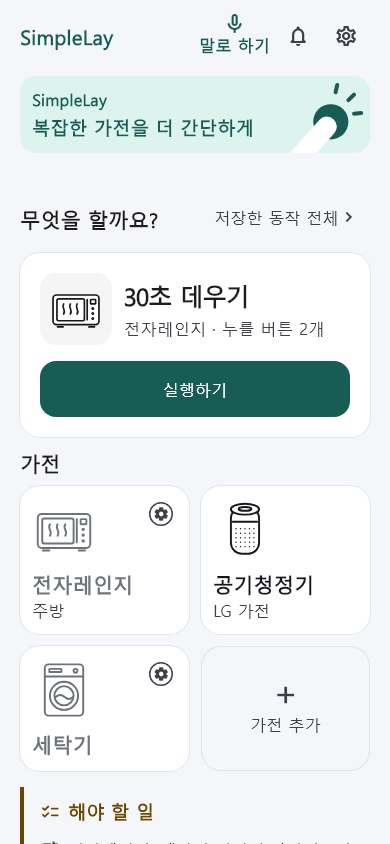
app/test/goldens/task_home_light.png
