Seongwonp/Simplelay/app/test/goldens/voice_confirm_large.png

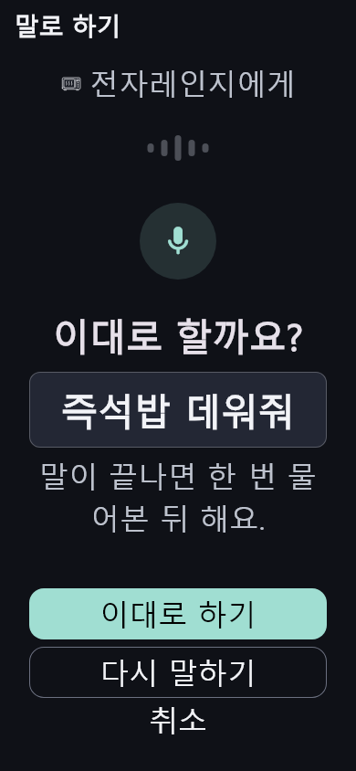
app/test/goldens/voice_confirm_large.png
