Seongwonp/Simplelay/app/test/goldens/voice_idle.png

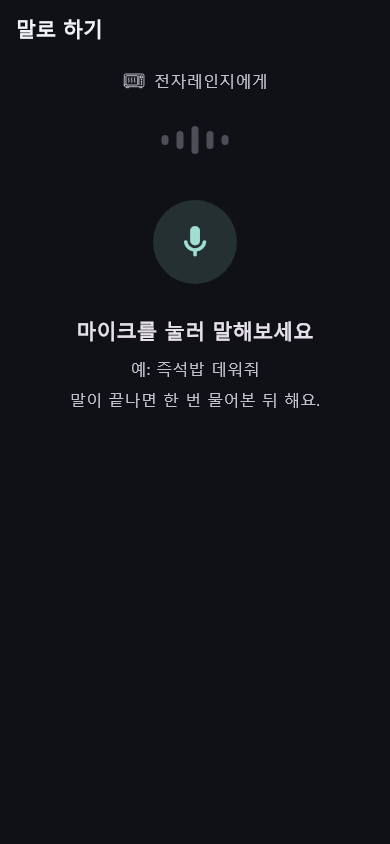
app/test/goldens/voice_idle.png
