Seongwonp/Simplelay/docs/submission/img/phone-result-practice-real-hub-2026-10-20.png

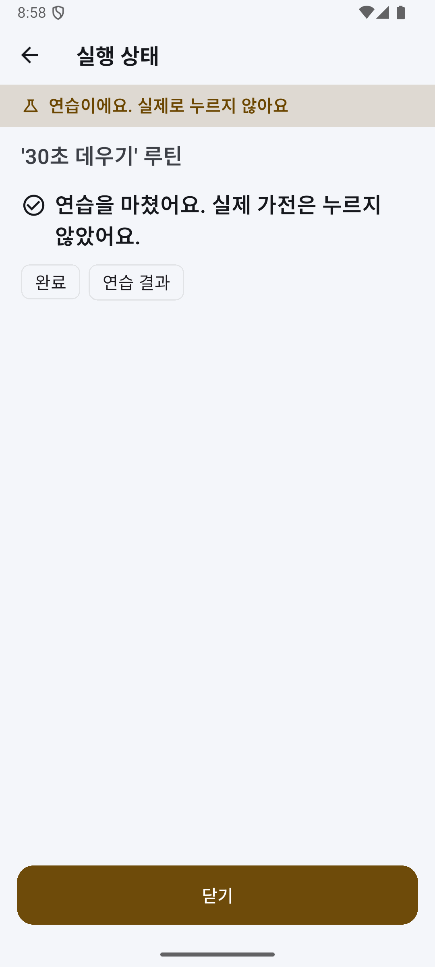
docs/submission/img/phone-result-practice-real-hub-2026-10-20.png
