Seongwonp/Simplelay/docs/submission/img/phone-result-retry-success.png

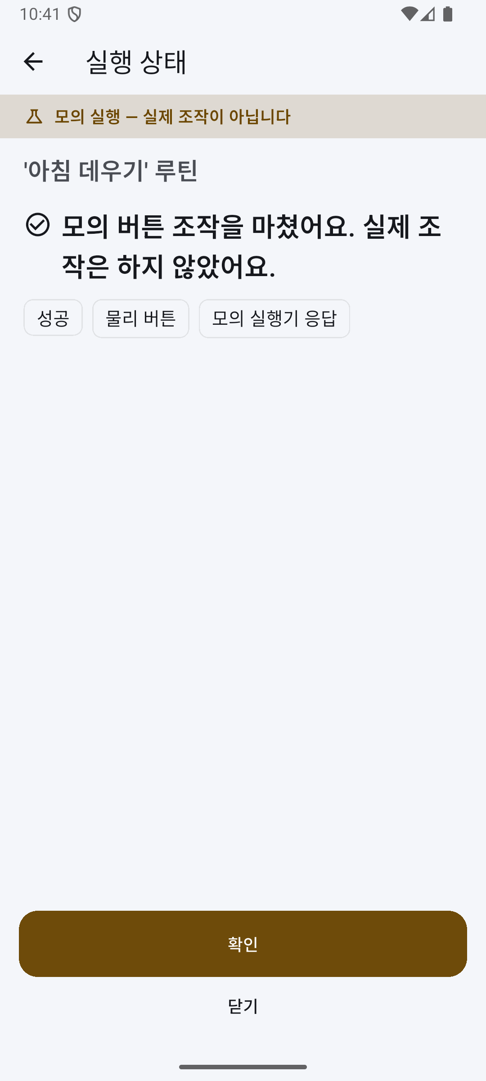
docs/submission/img/phone-result-retry-success.png
