Seongwonp/Simplelay/docs/submission/img/phone-result-safety-stop.png

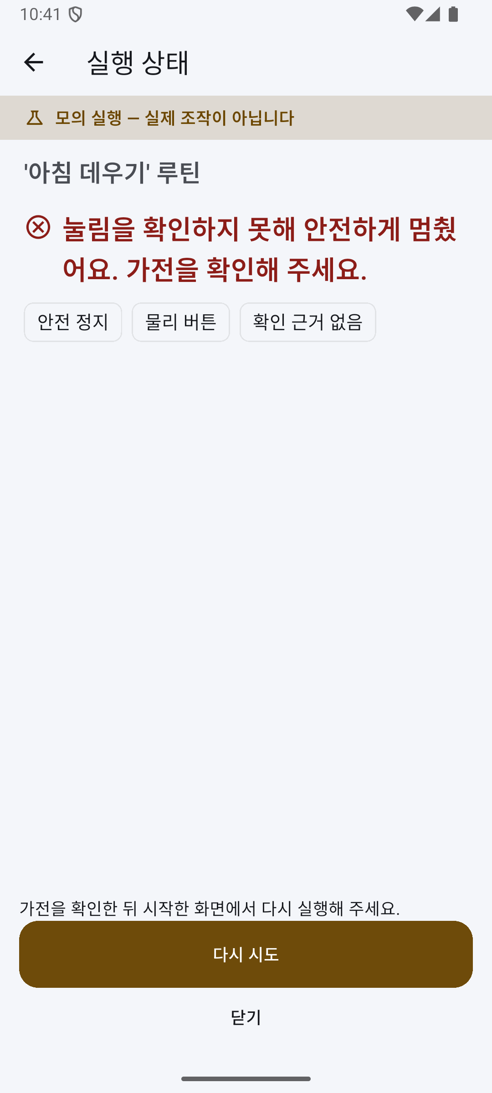
docs/submission/img/phone-result-safety-stop.png
