Seongwonp/Simplelay/docs/ui-review/2026-10-13/k01-kiosk-result-after-stall.png

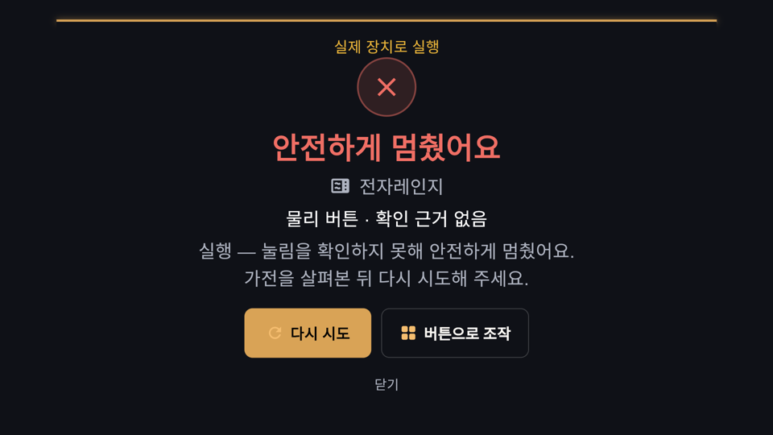
docs/ui-review/2026-10-13/k01-kiosk-result-after-stall.png
