Seongwonp/Simplelay/housing/renders/fit_test.png

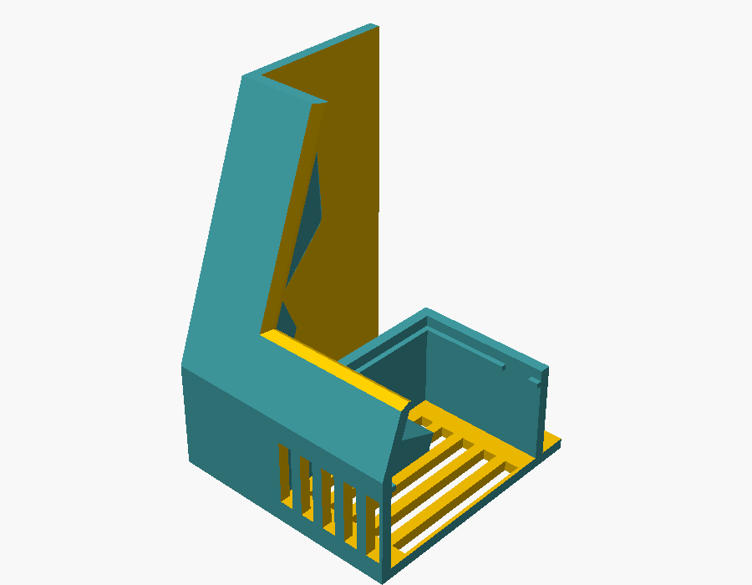
housing/renders/fit_test.png
