Seongwonp/Simplelay/rpi5-touchscreen-app/test/goldens/appliance_select.png

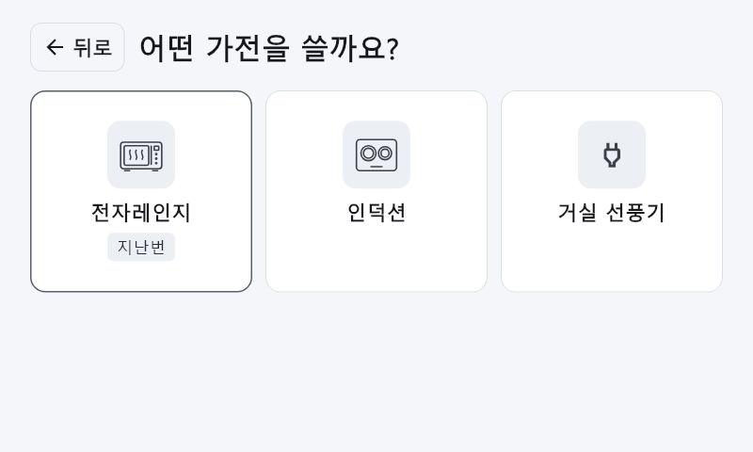
rpi5-touchscreen-app/test/goldens/appliance_select.png
