Seongwonp/Simplelay/rpi5-touchscreen-app/test/goldens/connection_modal.png

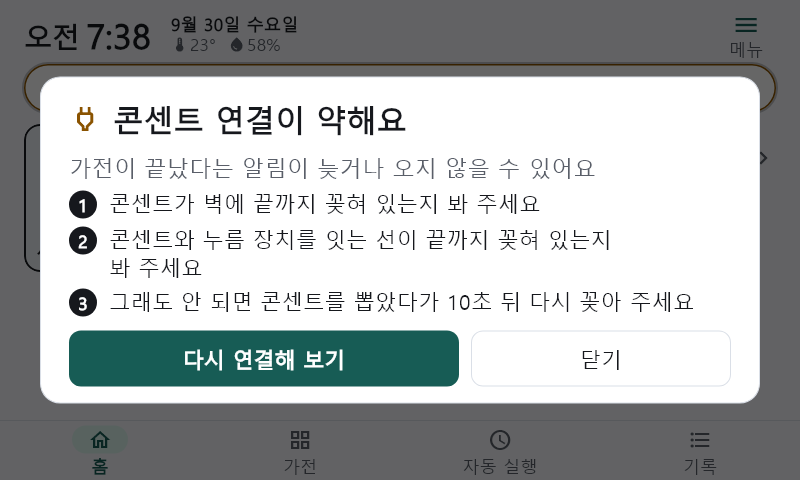
rpi5-touchscreen-app/test/goldens/connection_modal.png
