Seongwonp/Simplelay/rpi5-touchscreen-app/test/goldens/connection_modal_large.png

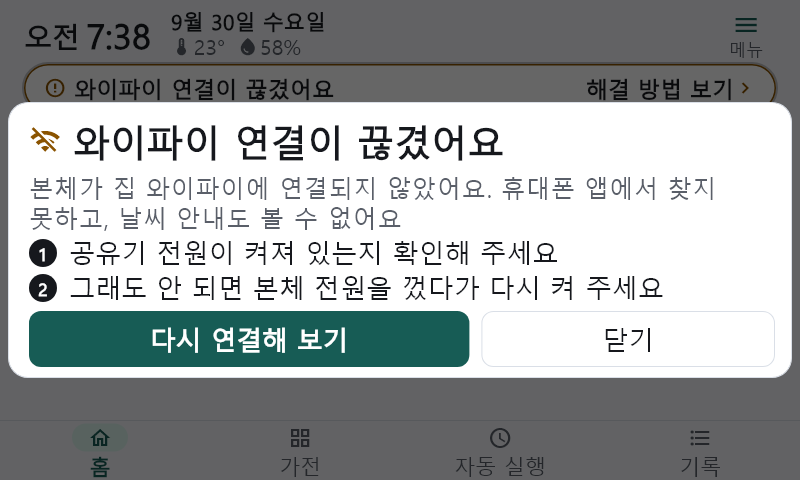
rpi5-touchscreen-app/test/goldens/connection_modal_large.png
