Seongwonp/Simplelay/rpi5-touchscreen-app/test/goldens/dnd_large.png

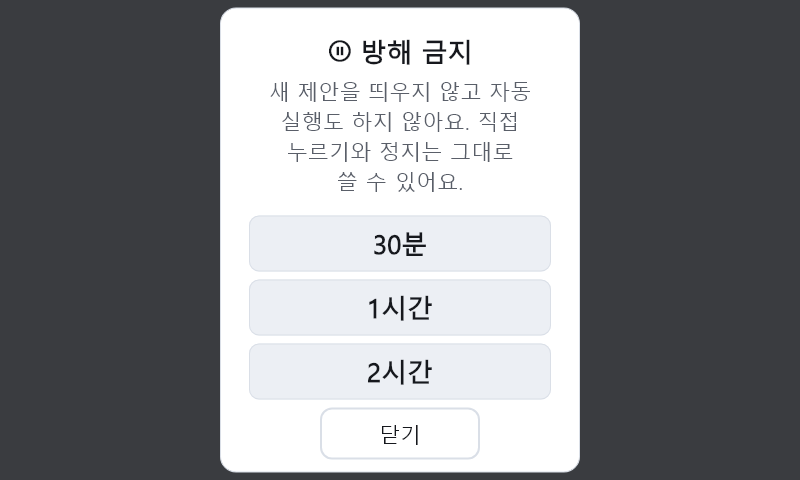
rpi5-touchscreen-app/test/goldens/dnd_large.png
