Seongwonp/Simplelay/rpi5-touchscreen-app/test/goldens/done.png

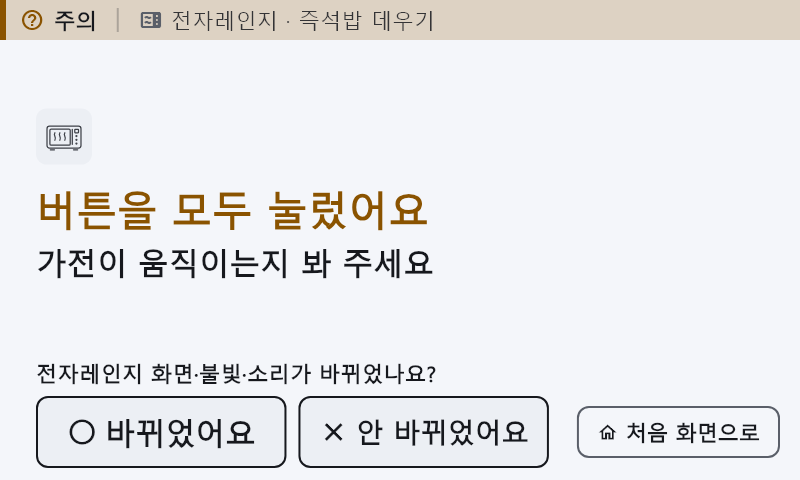
rpi5-touchscreen-app/test/goldens/done.png
