Seongwonp/Simplelay/rpi5-touchscreen-app/test/goldens/done_failed.png

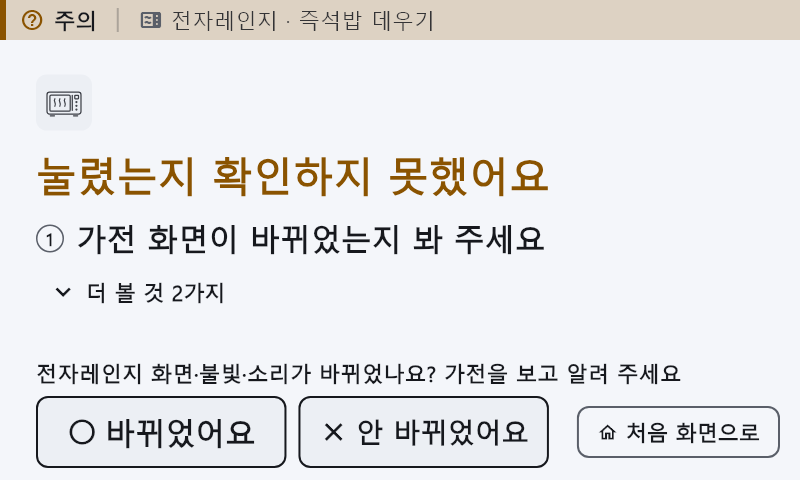
rpi5-touchscreen-app/test/goldens/done_failed.png
