Seongwonp/Simplelay/rpi5-touchscreen-app/test/goldens/done_large.png

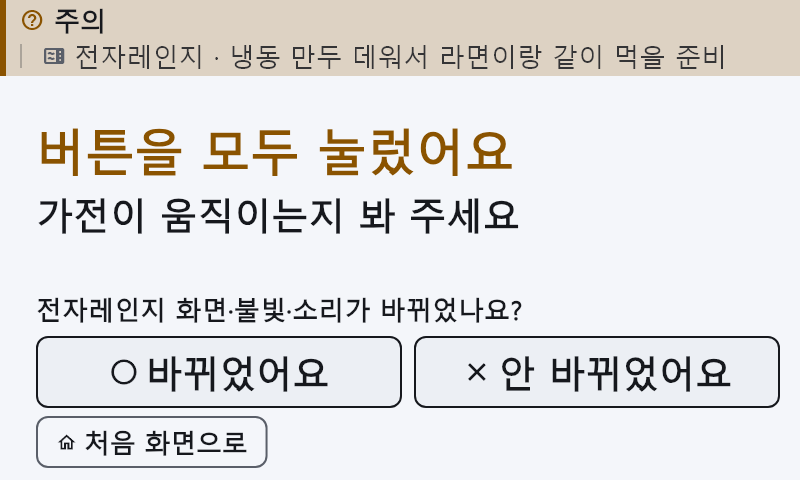
rpi5-touchscreen-app/test/goldens/done_large.png
