Seongwonp/Simplelay/rpi5-touchscreen-app/test/goldens/done_power.png

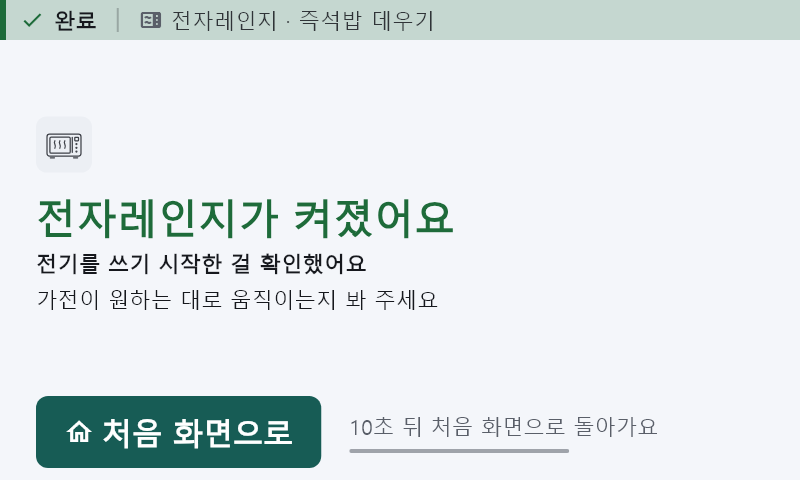
rpi5-touchscreen-app/test/goldens/done_power.png
