Seongwonp/Simplelay/rpi5-touchscreen-app/test/goldens/done_user_stop.png

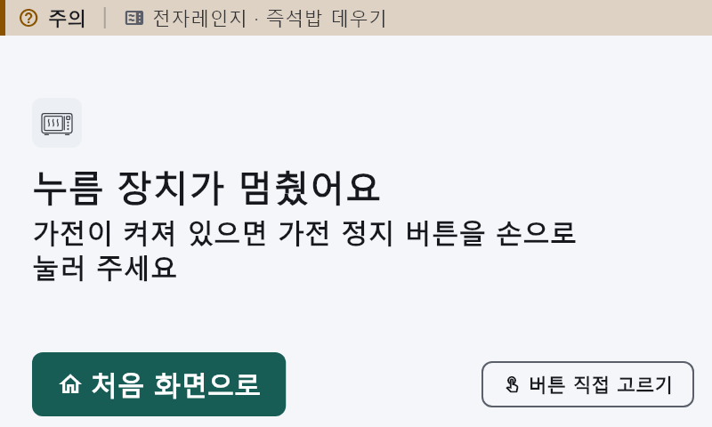
rpi5-touchscreen-app/test/goldens/done_user_stop.png
