Seongwonp/Simplelay/rpi5-touchscreen-app/test/goldens/done_user_stop_large.png

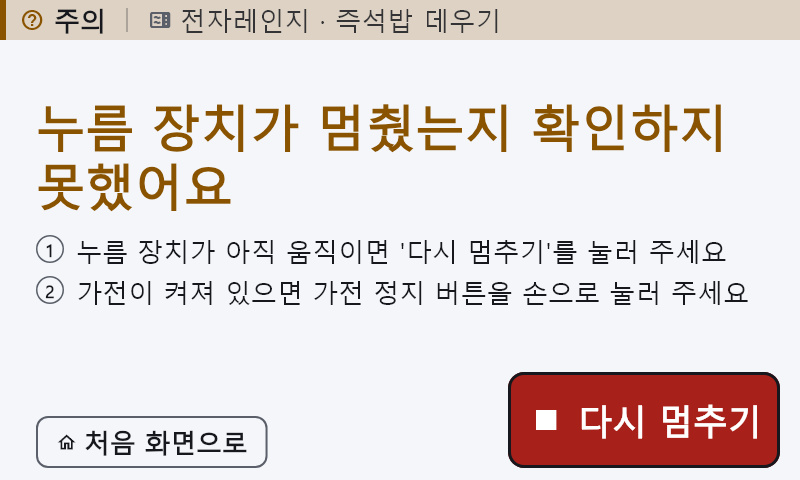
rpi5-touchscreen-app/test/goldens/done_user_stop_large.png
