Seongwonp/Simplelay/rpi5-touchscreen-app/test/goldens/executing.png

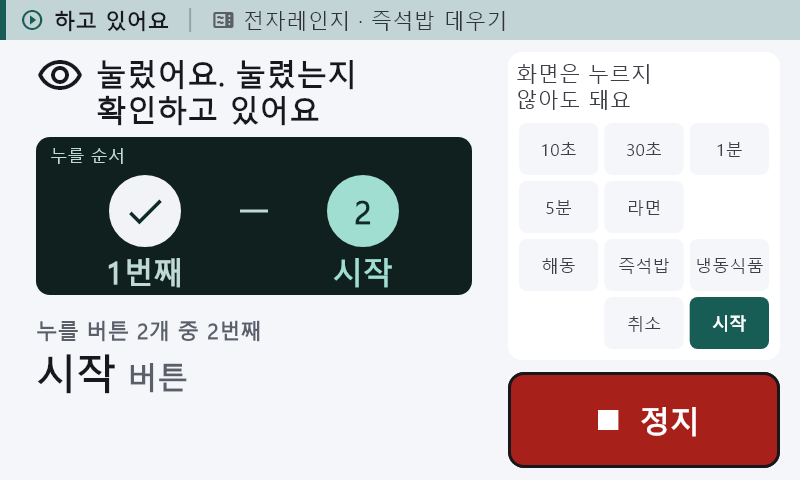
rpi5-touchscreen-app/test/goldens/executing.png
