Seongwonp/Simplelay/rpi5-touchscreen-app/test/goldens/executing_large.png

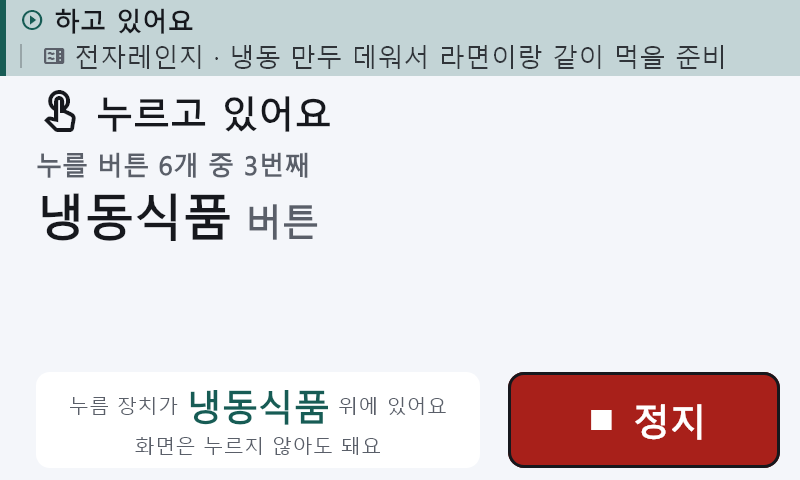
rpi5-touchscreen-app/test/goldens/executing_large.png
