Seongwonp/Simplelay/rpi5-touchscreen-app/test/goldens/executing_retry.png

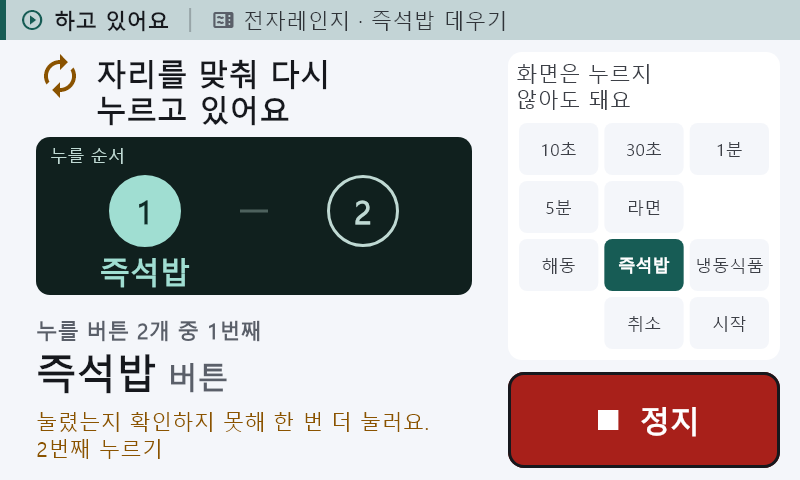
rpi5-touchscreen-app/test/goldens/executing_retry.png
