Seongwonp/Simplelay/rpi5-touchscreen-app/test/goldens/hold.png

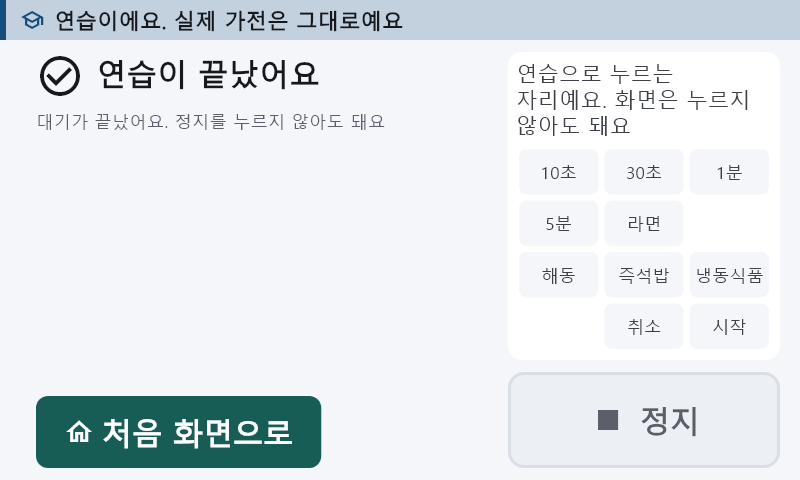
rpi5-touchscreen-app/test/goldens/hold.png
