Seongwonp/Simplelay/rpi5-touchscreen-app/test/goldens/hold_estop.png

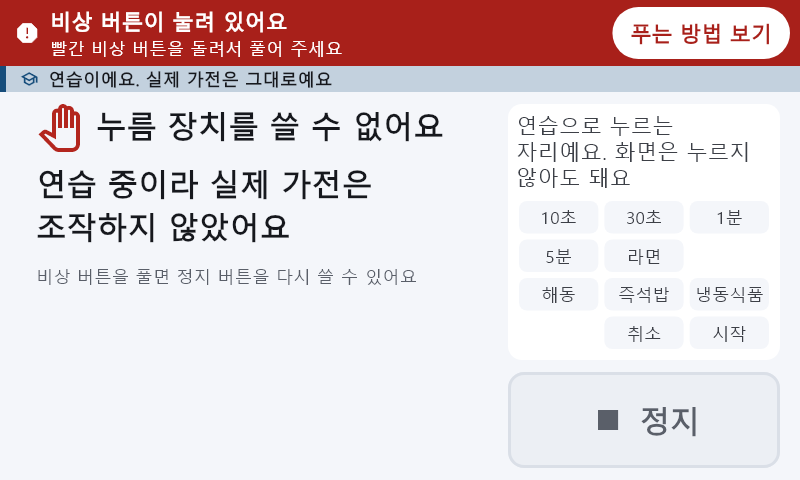
rpi5-touchscreen-app/test/goldens/hold_estop.png
