Seongwonp/Simplelay/rpi5-touchscreen-app/test/goldens/hold_estop_confirm.png

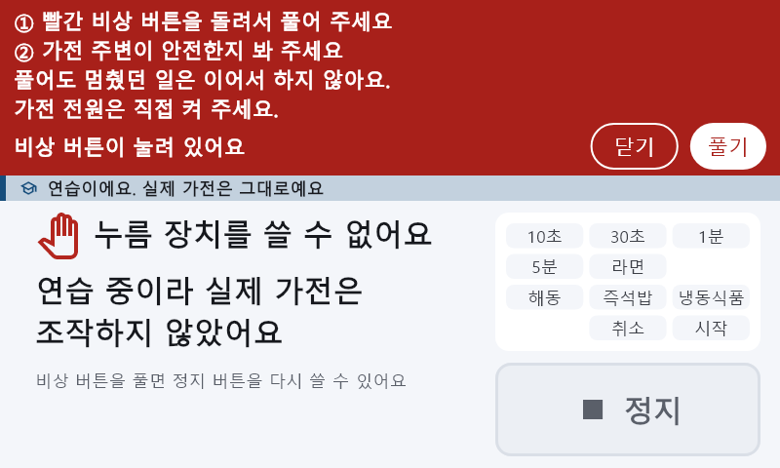
rpi5-touchscreen-app/test/goldens/hold_estop_confirm.png
