Seongwonp/Simplelay/rpi5-touchscreen-app/test/goldens/hold_large.png

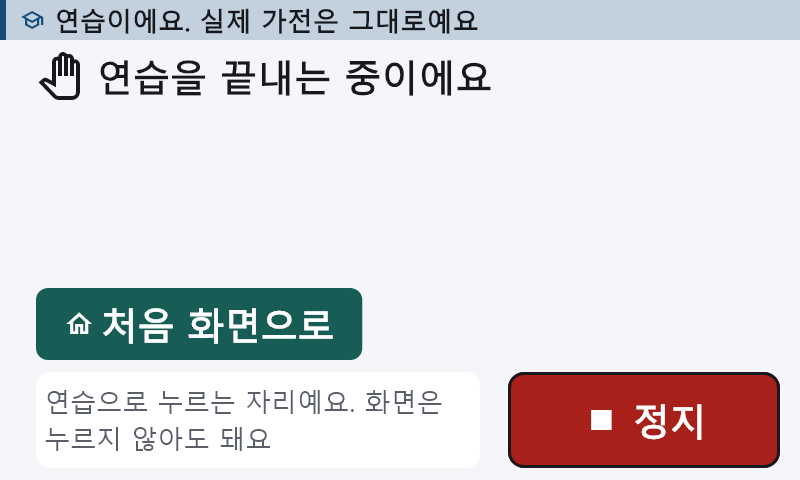
rpi5-touchscreen-app/test/goldens/hold_large.png
