Seongwonp/Simplelay/rpi5-touchscreen-app/test/goldens/hold_unconfirmed.png

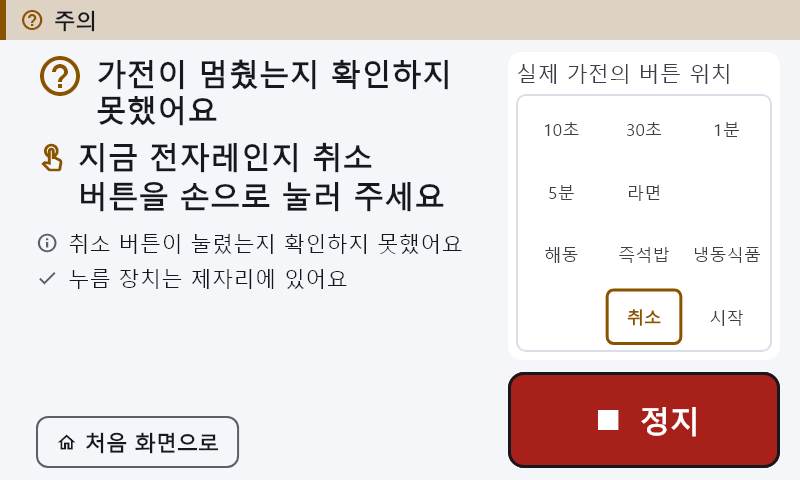
rpi5-touchscreen-app/test/goldens/hold_unconfirmed.png
