Seongwonp/Simplelay/rpi5-touchscreen-app/test/goldens/idle.png

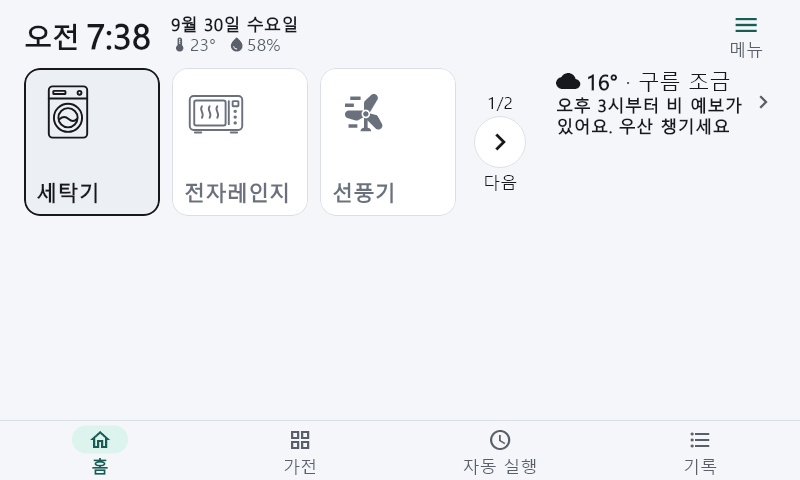
rpi5-touchscreen-app/test/goldens/idle.png
