Seongwonp/Simplelay/rpi5-touchscreen-app/test/goldens/idle_air_large.png

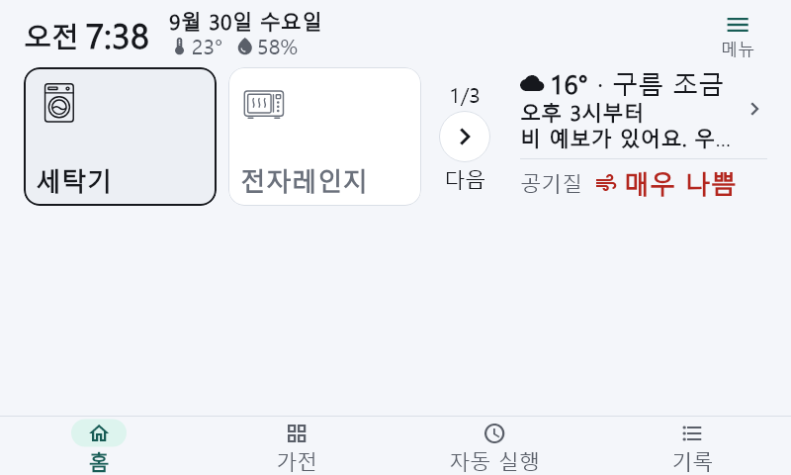
rpi5-touchscreen-app/test/goldens/idle_air_large.png
