Seongwonp/Simplelay/rpi5-touchscreen-app/test/goldens/idle_disconnected.png

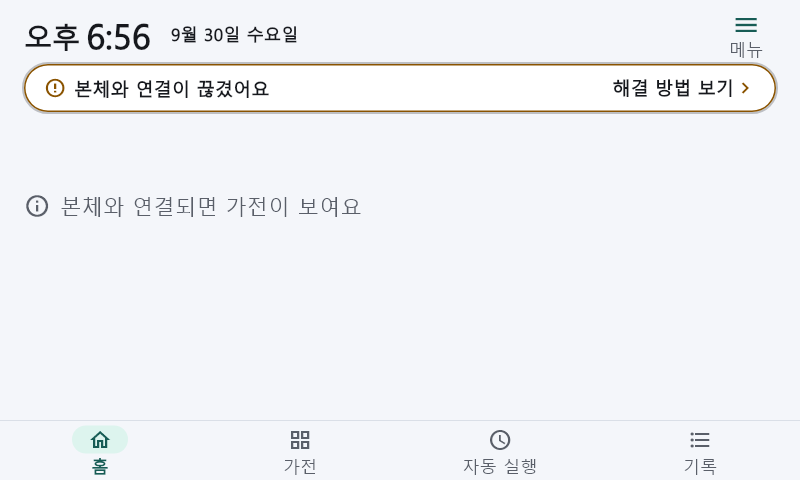
rpi5-touchscreen-app/test/goldens/idle_disconnected.png
