Seongwonp/Simplelay/rpi5-touchscreen-app/test/goldens/idle_empty.png

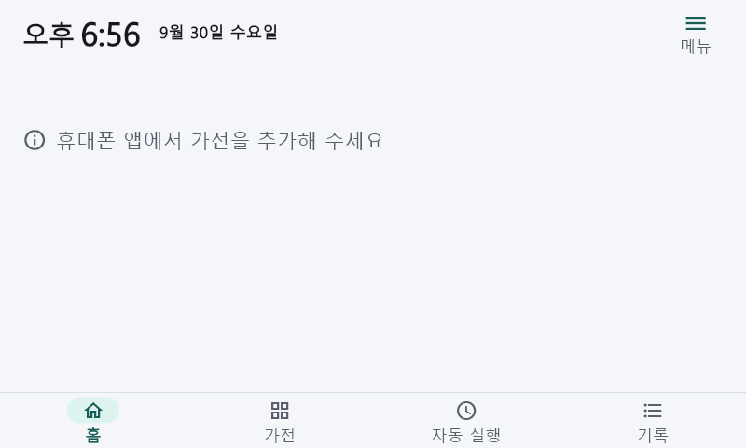
rpi5-touchscreen-app/test/goldens/idle_empty.png
