Seongwonp/Simplelay/rpi5-touchscreen-app/test/goldens/idle_not_ready.png

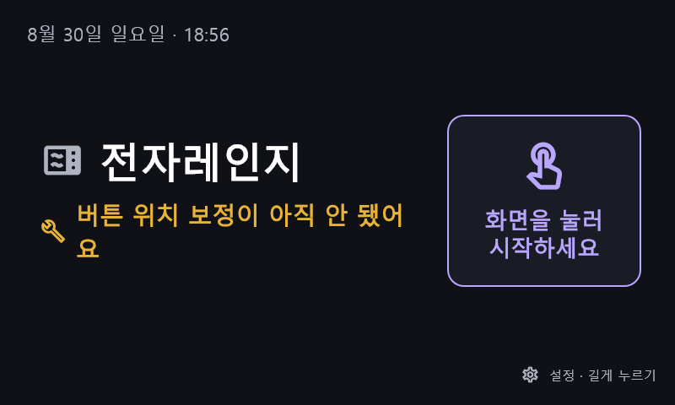
rpi5-touchscreen-app/test/goldens/idle_not_ready.png
