Seongwonp/Simplelay/rpi5-touchscreen-app/test/goldens/kiosk15_appliance_select.png

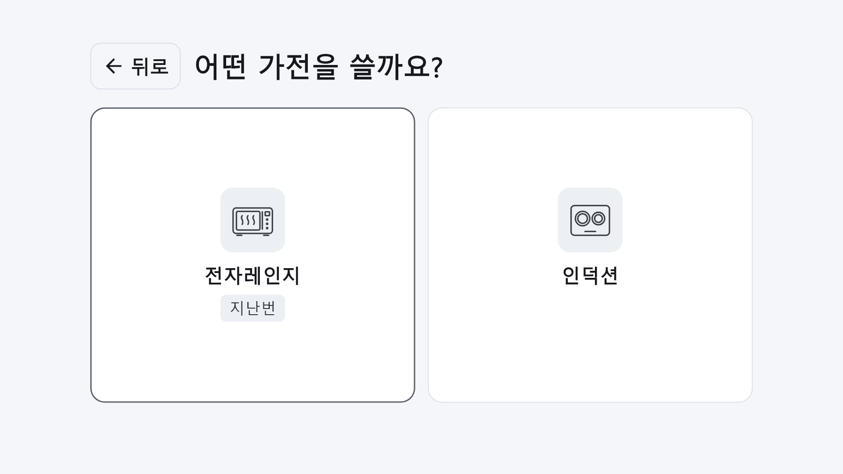
rpi5-touchscreen-app/test/goldens/kiosk15_appliance_select.png
