Seongwonp/Simplelay/rpi5-touchscreen-app/test/goldens/kiosk15_connection_modal.png

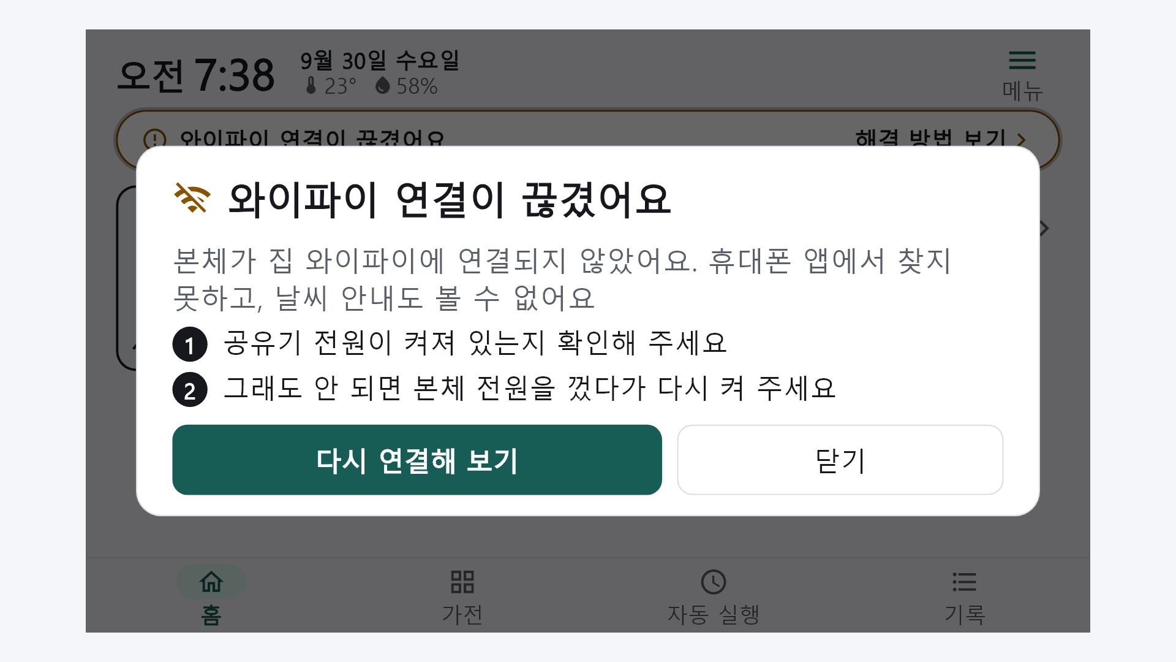
rpi5-touchscreen-app/test/goldens/kiosk15_connection_modal.png
