Seongwonp/Simplelay/rpi5-touchscreen-app/test/goldens/kiosk15_danger.png

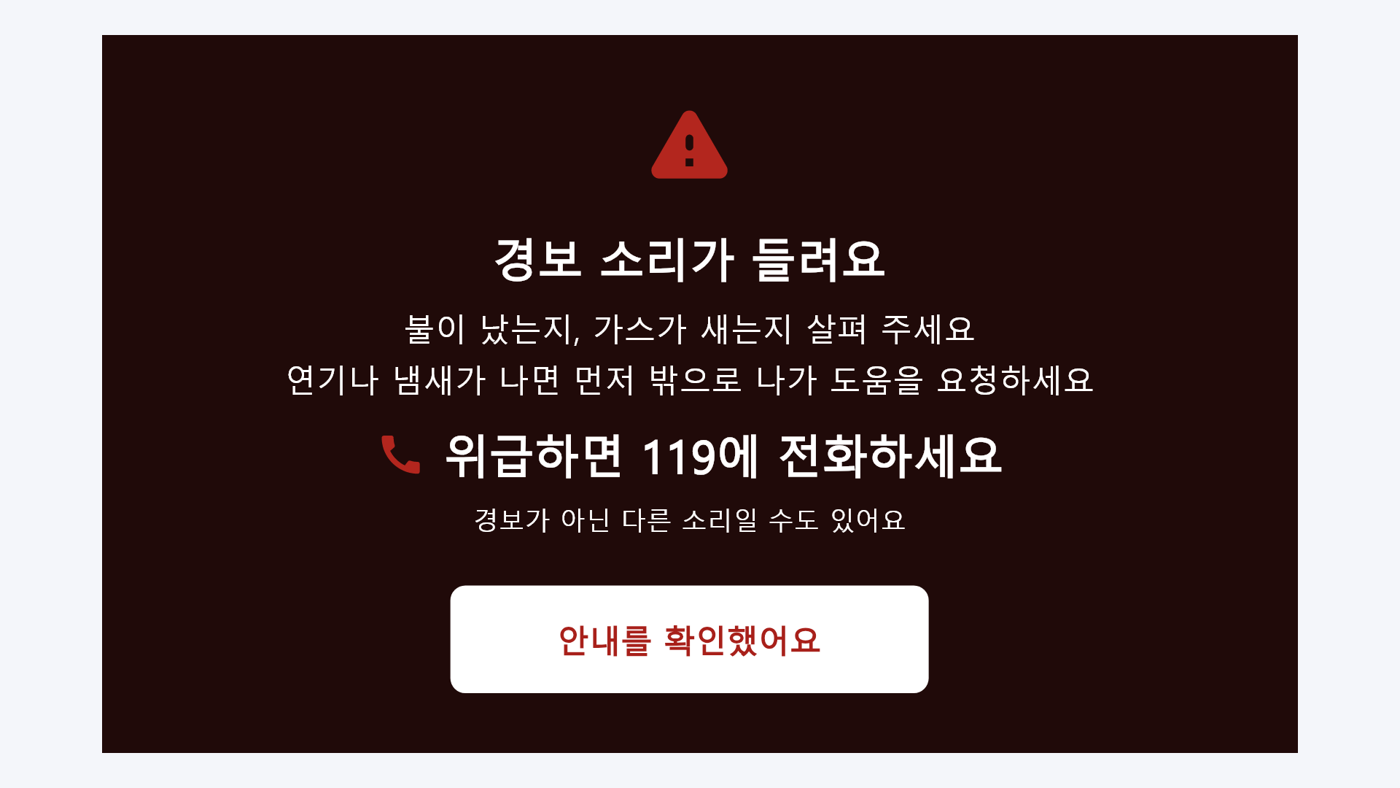
rpi5-touchscreen-app/test/goldens/kiosk15_danger.png
