Seongwonp/Simplelay/rpi5-touchscreen-app/test/goldens/kiosk15_dnd.png

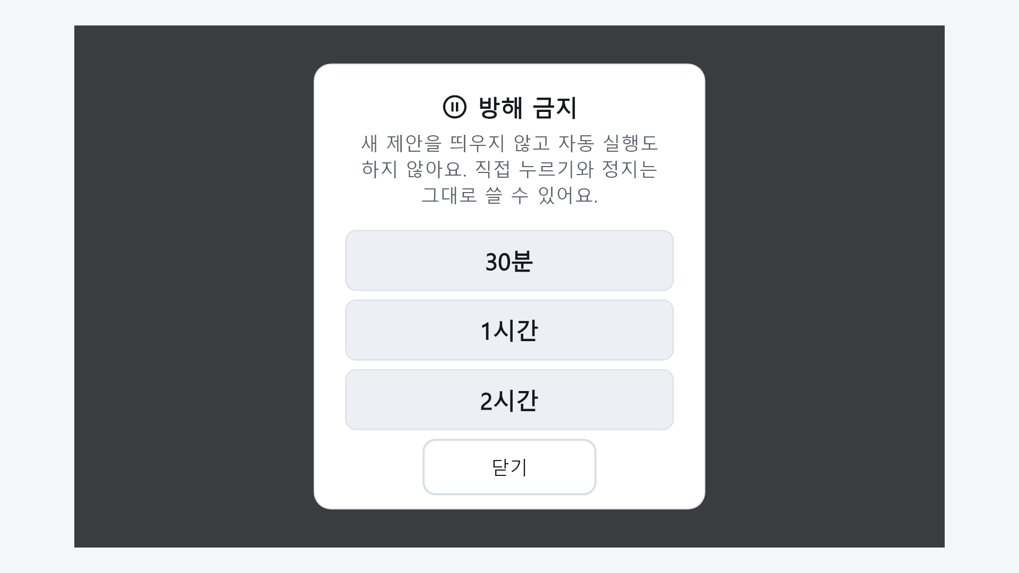
rpi5-touchscreen-app/test/goldens/kiosk15_dnd.png
