Seongwonp/Simplelay/rpi5-touchscreen-app/test/goldens/kiosk15_done.png

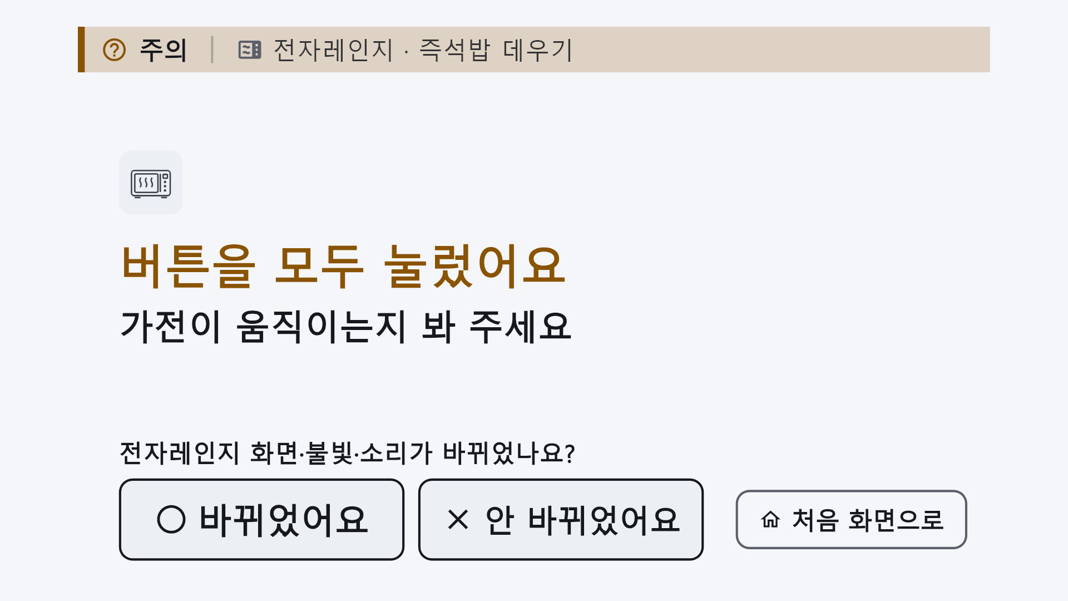
rpi5-touchscreen-app/test/goldens/kiosk15_done.png
