Seongwonp/Simplelay/rpi5-touchscreen-app/test/goldens/kiosk15_done_check_no.png

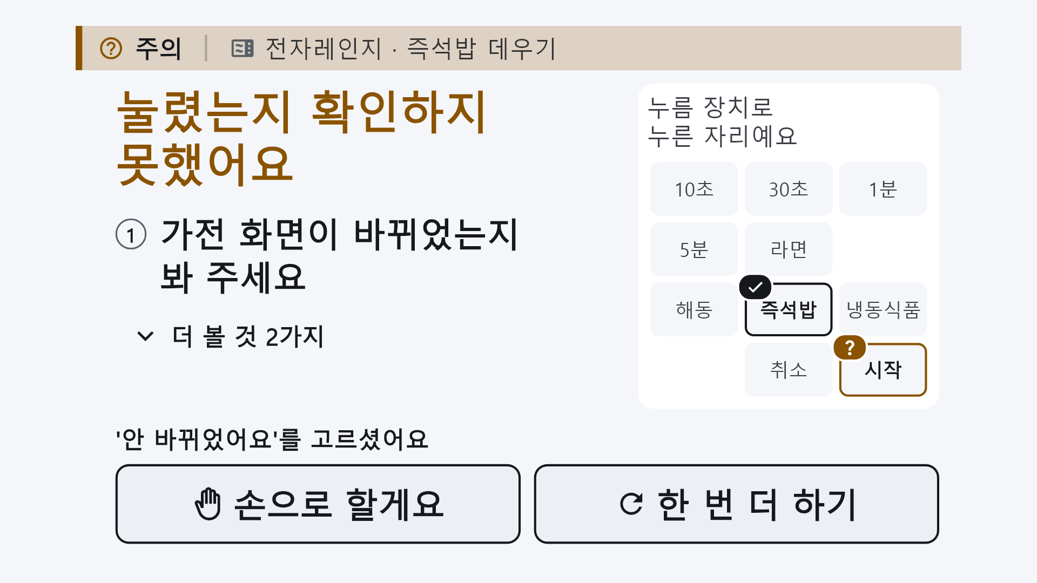
rpi5-touchscreen-app/test/goldens/kiosk15_done_check_no.png
