Seongwonp/Simplelay/rpi5-touchscreen-app/test/goldens/kiosk15_done_continue.png

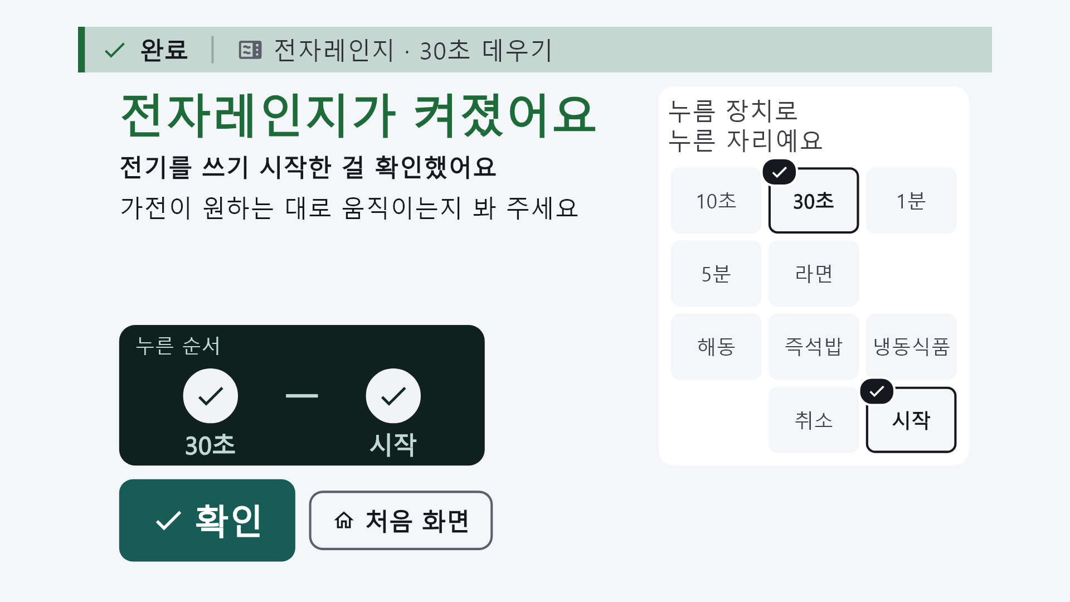
rpi5-touchscreen-app/test/goldens/kiosk15_done_continue.png
