Seongwonp/Simplelay/rpi5-touchscreen-app/test/goldens/kiosk15_done_failed.png

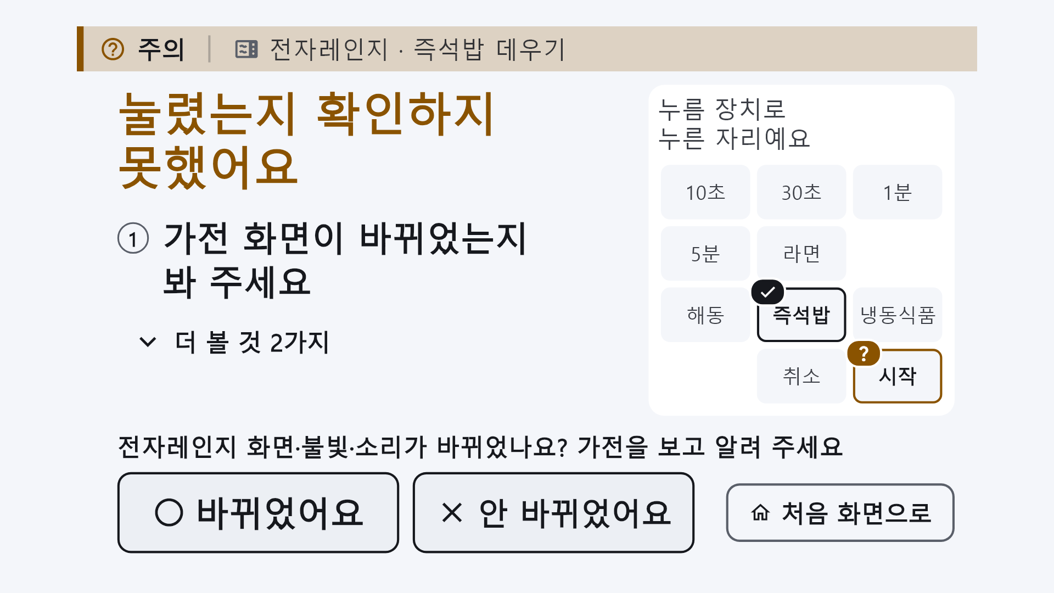
rpi5-touchscreen-app/test/goldens/kiosk15_done_failed.png
