Seongwonp/Simplelay/rpi5-touchscreen-app/test/goldens/kiosk15_done_failed_practice.png

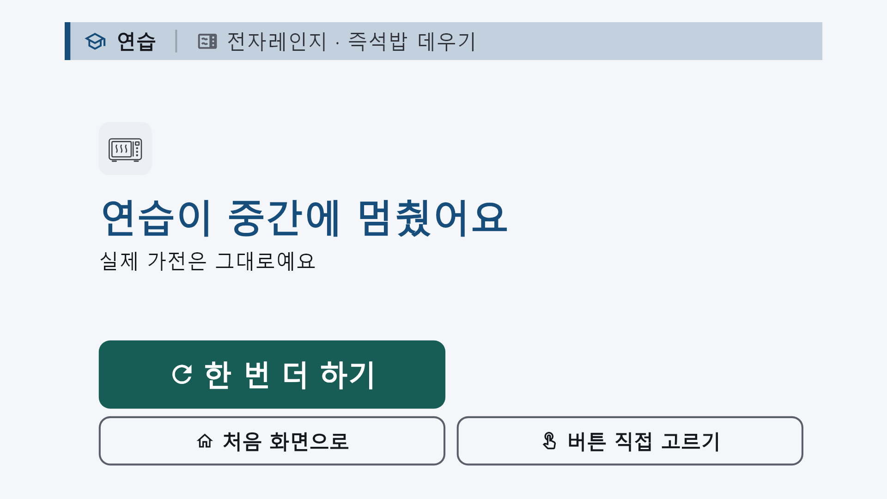
rpi5-touchscreen-app/test/goldens/kiosk15_done_failed_practice.png
