Seongwonp/Simplelay/rpi5-touchscreen-app/test/goldens/kiosk15_done_stop_pending.png

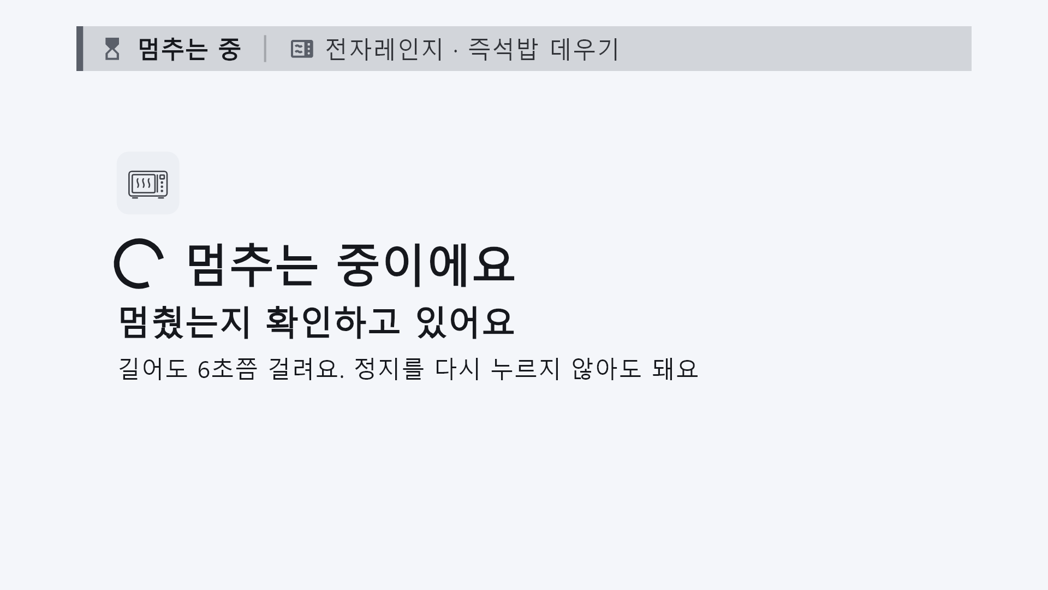
rpi5-touchscreen-app/test/goldens/kiosk15_done_stop_pending.png
