Seongwonp/Simplelay/rpi5-touchscreen-app/test/goldens/kiosk15_done_user_stop.png

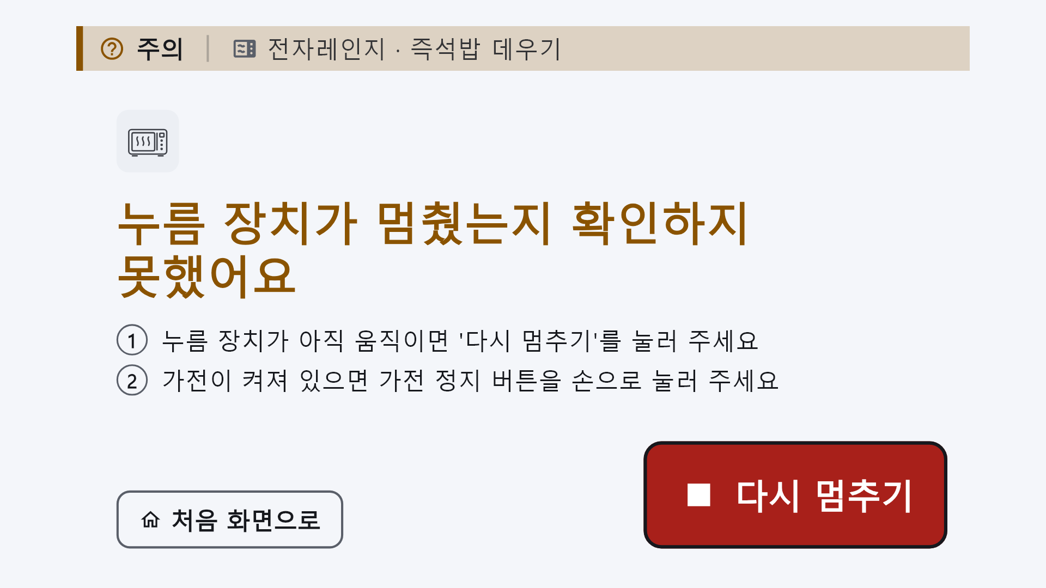
rpi5-touchscreen-app/test/goldens/kiosk15_done_user_stop.png
