Seongwonp/Simplelay/rpi5-touchscreen-app/test/goldens/kiosk15_done_verified.png

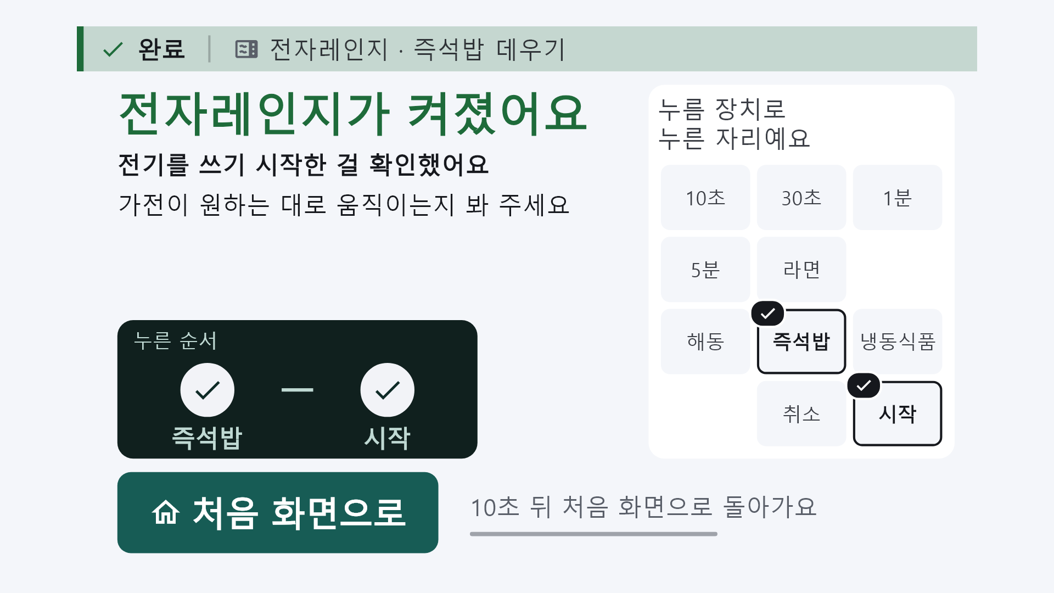
rpi5-touchscreen-app/test/goldens/kiosk15_done_verified.png
