Seongwonp/Simplelay/rpi5-touchscreen-app/test/goldens/kiosk15_executing.png

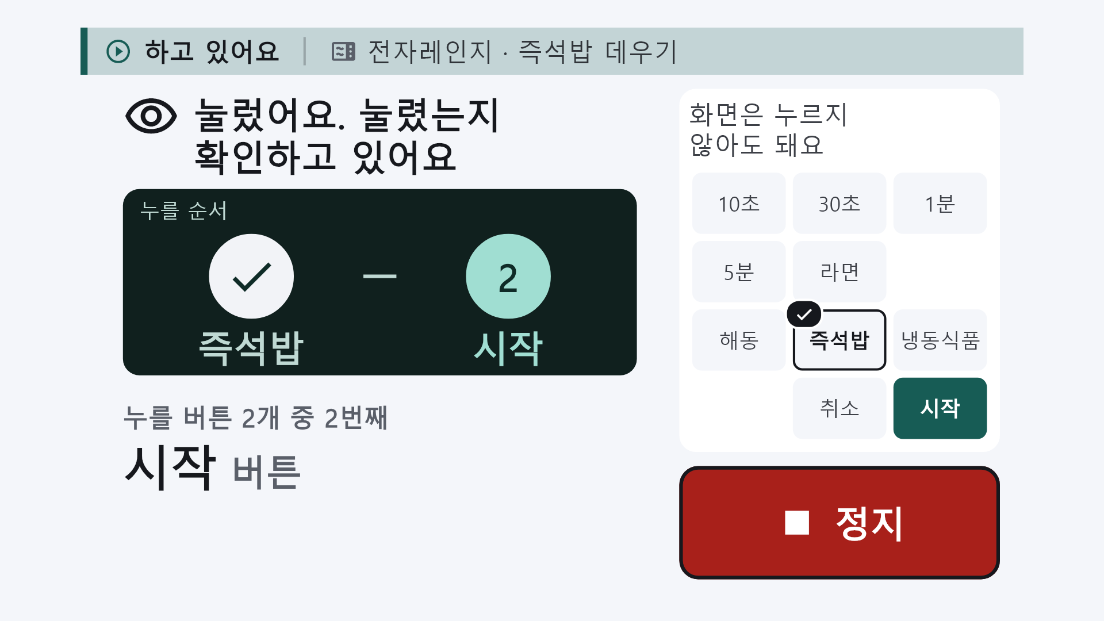
rpi5-touchscreen-app/test/goldens/kiosk15_executing.png
