Seongwonp/Simplelay/rpi5-touchscreen-app/test/goldens/kiosk15_executing_practice.png

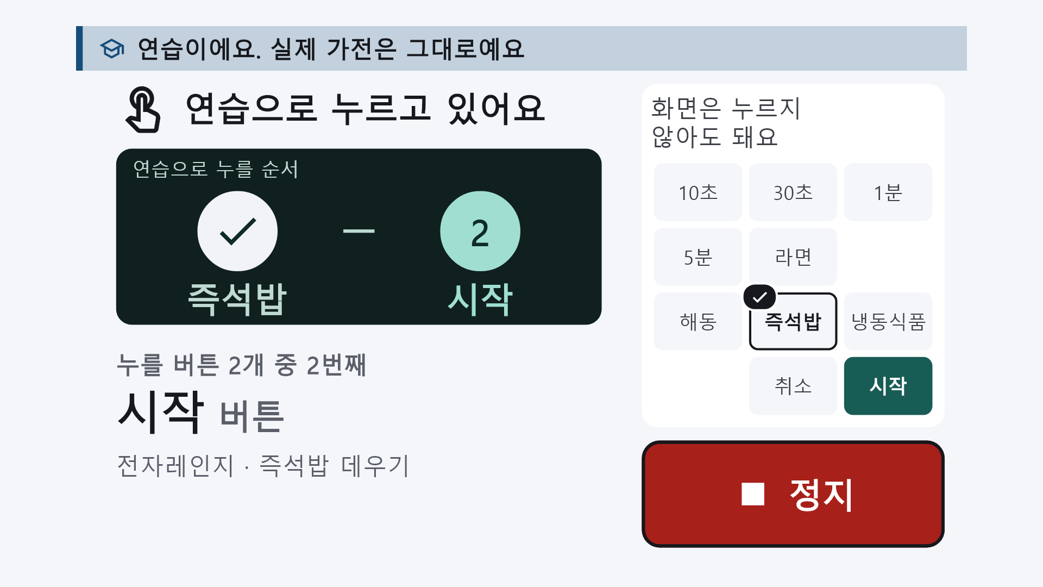
rpi5-touchscreen-app/test/goldens/kiosk15_executing_practice.png
