Seongwonp/Simplelay/rpi5-touchscreen-app/test/goldens/kiosk15_hold.png

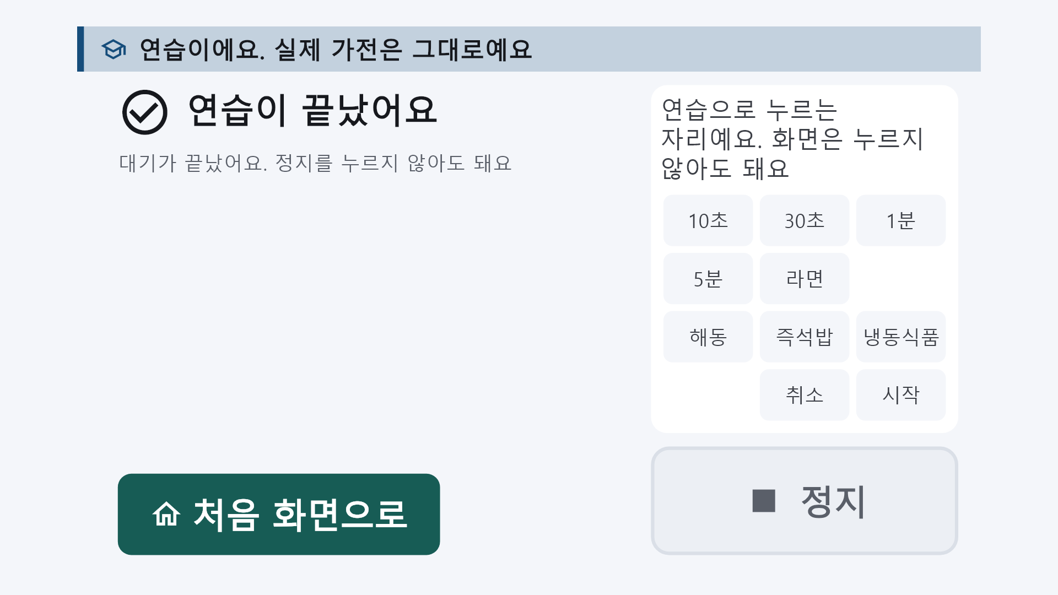
rpi5-touchscreen-app/test/goldens/kiosk15_hold.png
