Seongwonp/Simplelay/rpi5-touchscreen-app/test/goldens/kiosk15_hold_unconfirmed.png

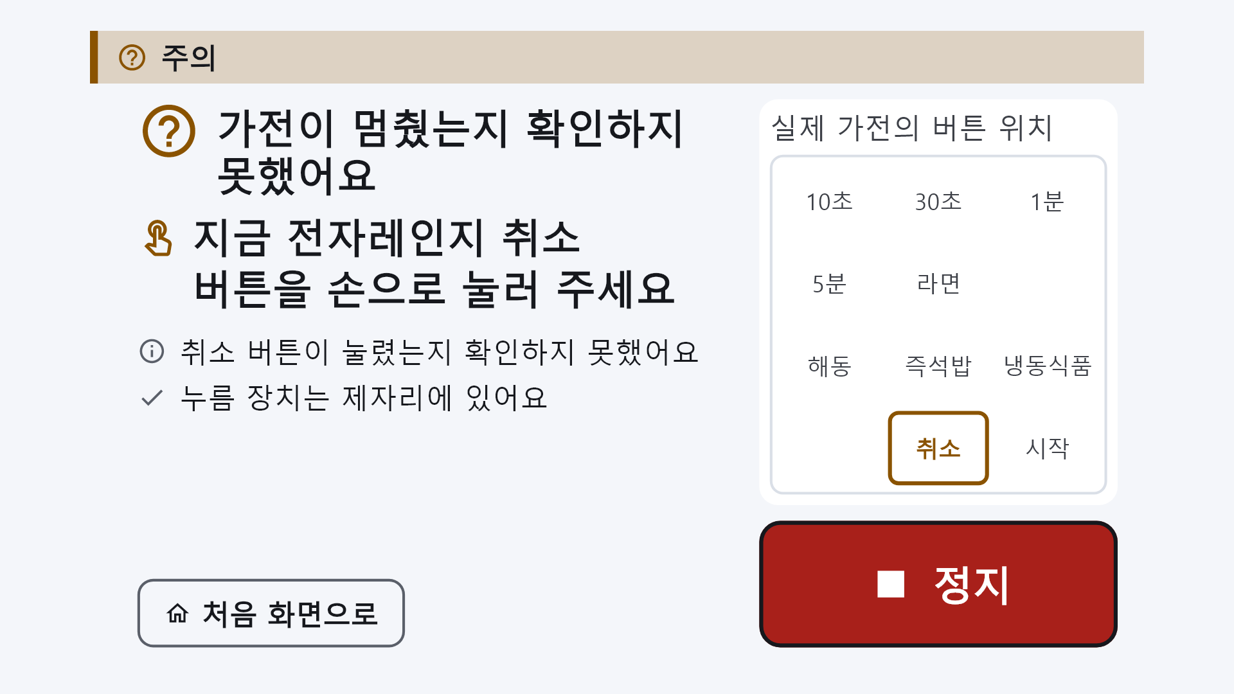
rpi5-touchscreen-app/test/goldens/kiosk15_hold_unconfirmed.png
