Seongwonp/Simplelay/rpi5-touchscreen-app/test/goldens/kiosk15_idle.png

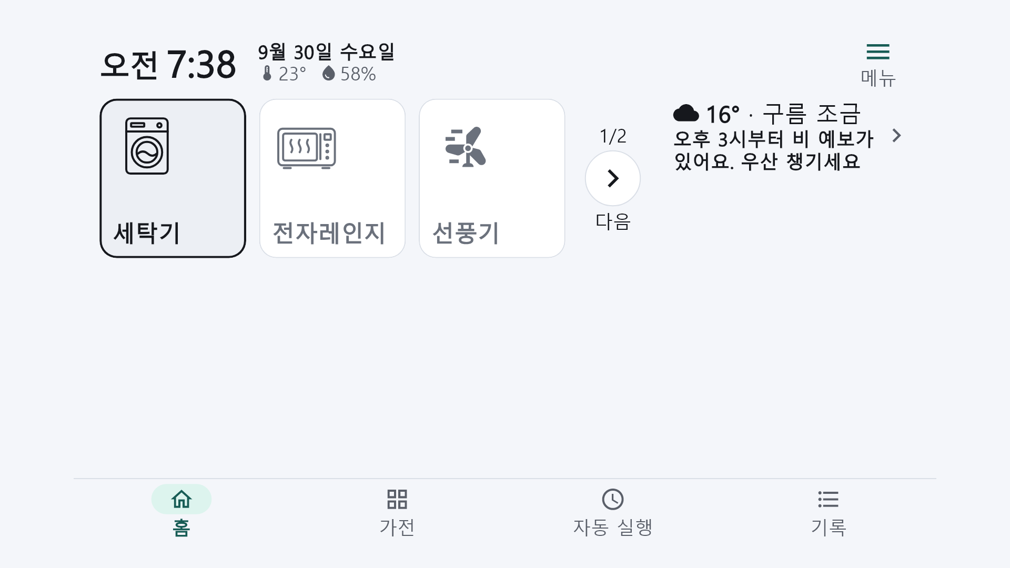
rpi5-touchscreen-app/test/goldens/kiosk15_idle.png
