Seongwonp/Simplelay/rpi5-touchscreen-app/test/goldens/kiosk15_idle_estop.png

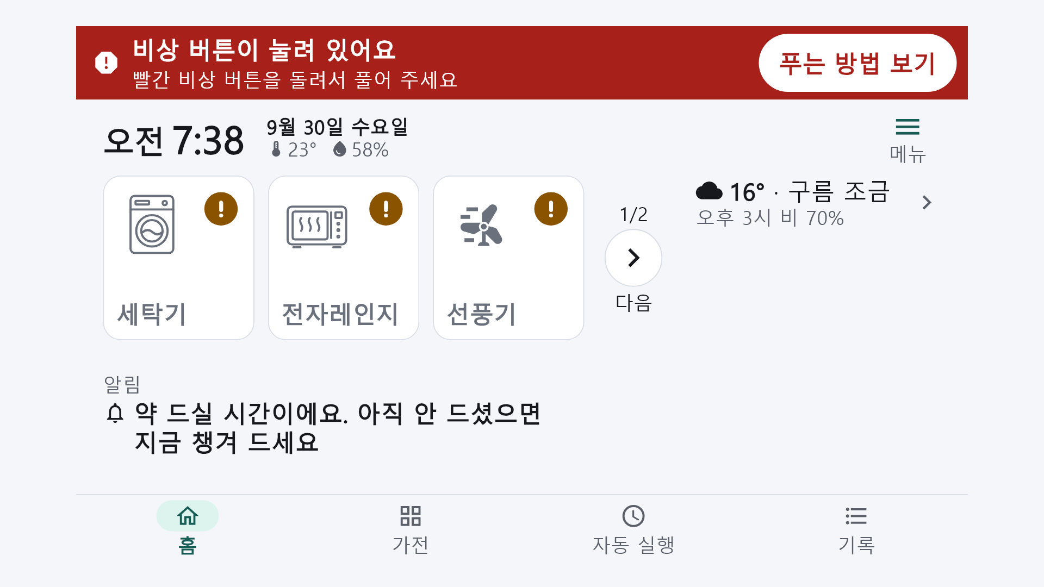
rpi5-touchscreen-app/test/goldens/kiosk15_idle_estop.png
