Seongwonp/Simplelay/rpi5-touchscreen-app/test/goldens/kiosk15_idle_featured.png

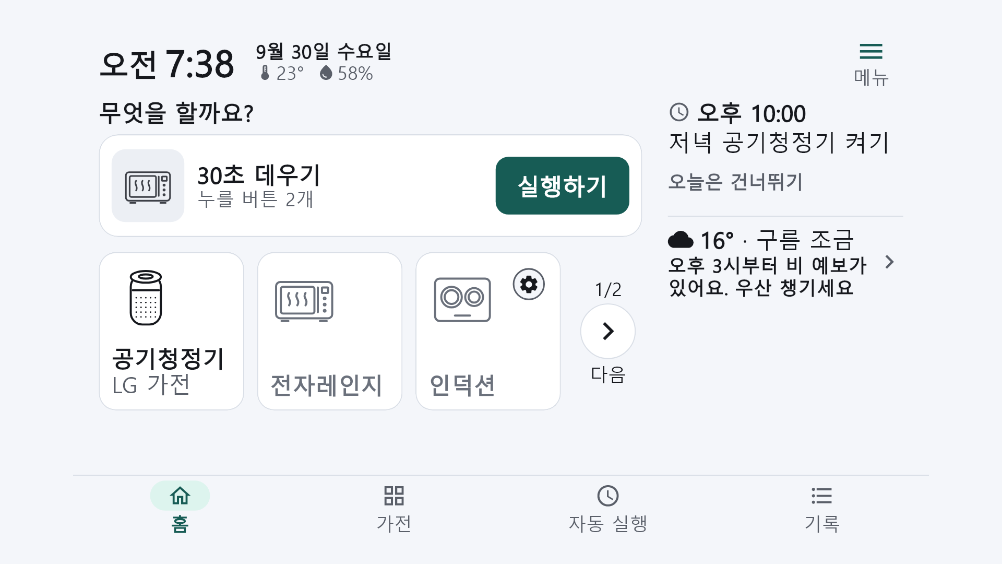
rpi5-touchscreen-app/test/goldens/kiosk15_idle_featured.png
