Seongwonp/Simplelay/rpi5-touchscreen-app/test/goldens/kiosk15_idle_next.png

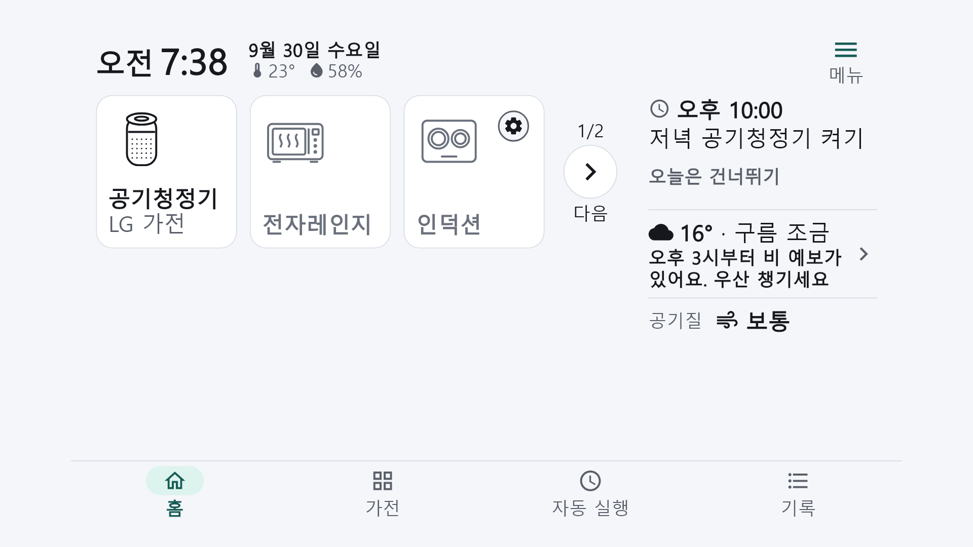
rpi5-touchscreen-app/test/goldens/kiosk15_idle_next.png
