Seongwonp/Simplelay/rpi5-touchscreen-app/test/goldens/kiosk15_idle_practice_washer.png

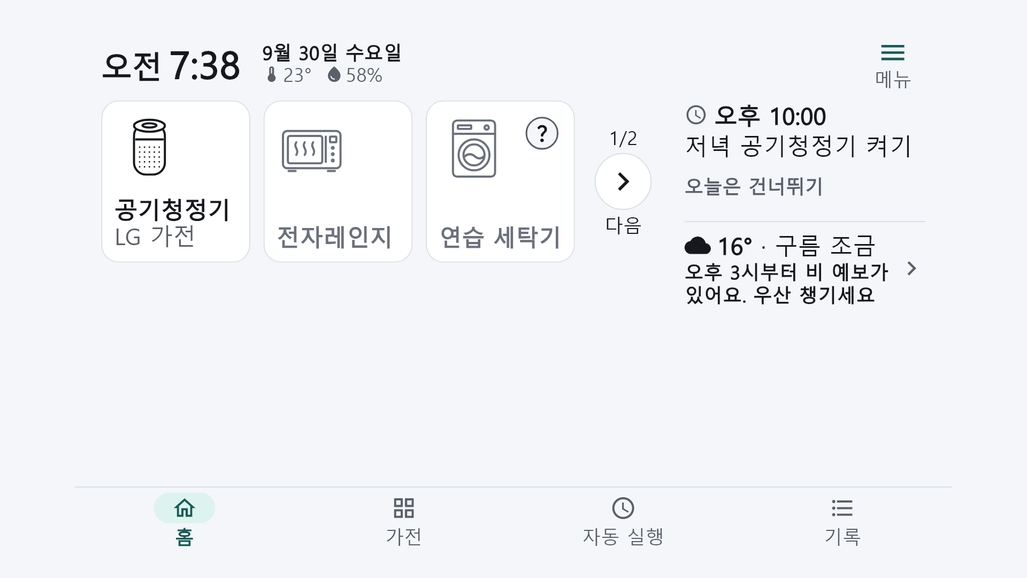
rpi5-touchscreen-app/test/goldens/kiosk15_idle_practice_washer.png
