Seongwonp/Simplelay/rpi5-touchscreen-app/test/goldens/kiosk15_idle_quiet.png

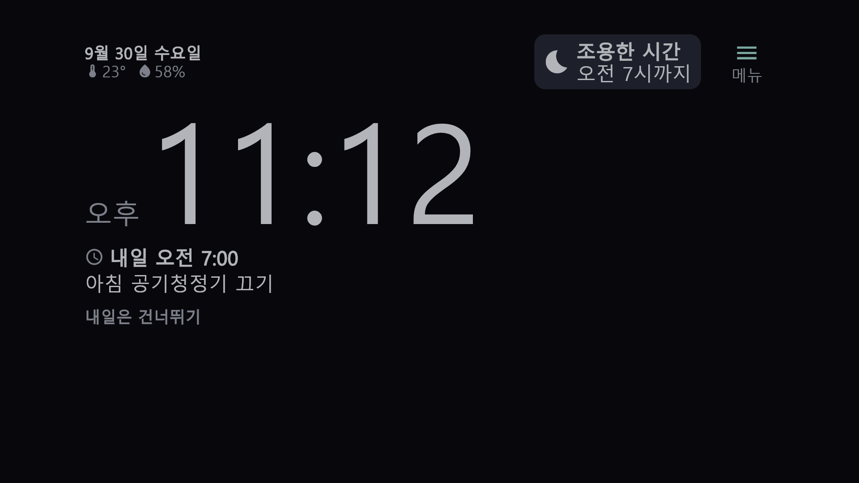
rpi5-touchscreen-app/test/goldens/kiosk15_idle_quiet.png
