Seongwonp/Simplelay/rpi5-touchscreen-app/test/goldens/kiosk15_my_appliance.png

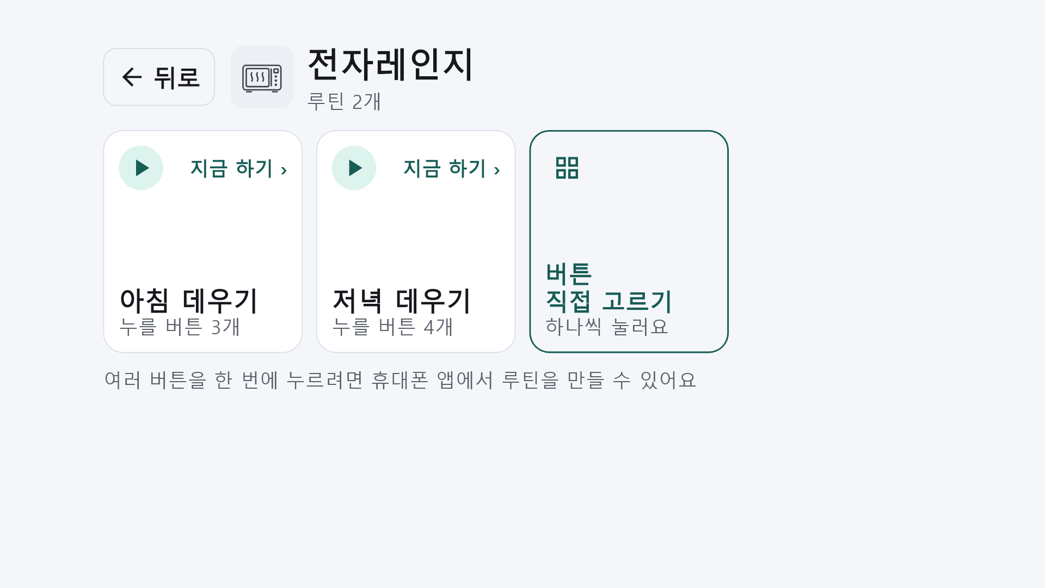
rpi5-touchscreen-app/test/goldens/kiosk15_my_appliance.png
