Seongwonp/Simplelay/rpi5-touchscreen-app/test/goldens/kiosk15_tab_auto.png

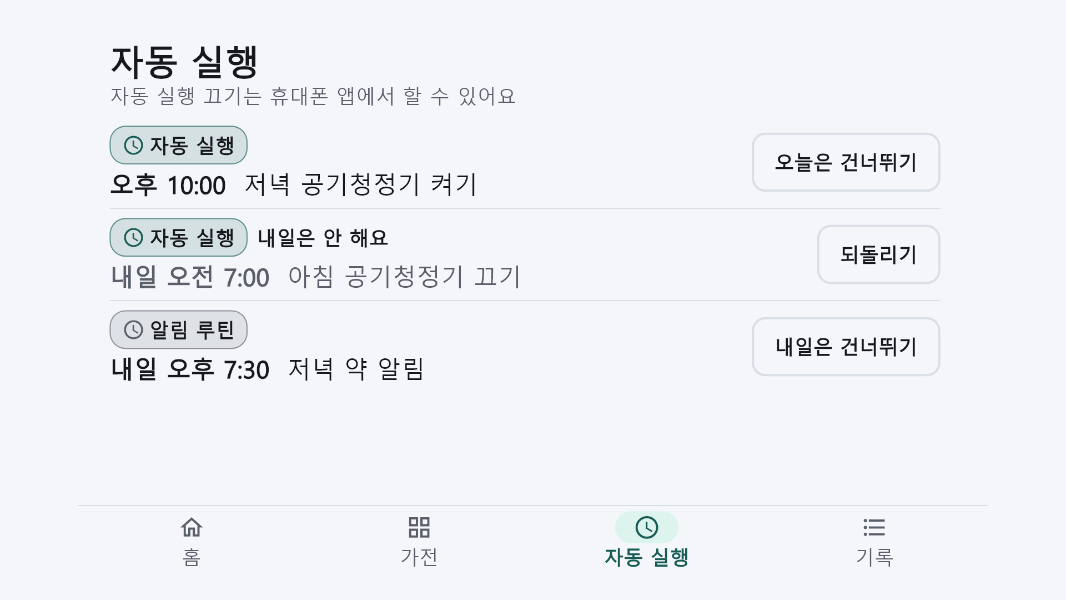
rpi5-touchscreen-app/test/goldens/kiosk15_tab_auto.png
