Seongwonp/Simplelay/rpi5-touchscreen-app/test/goldens/kiosk15_thinq_detail.png

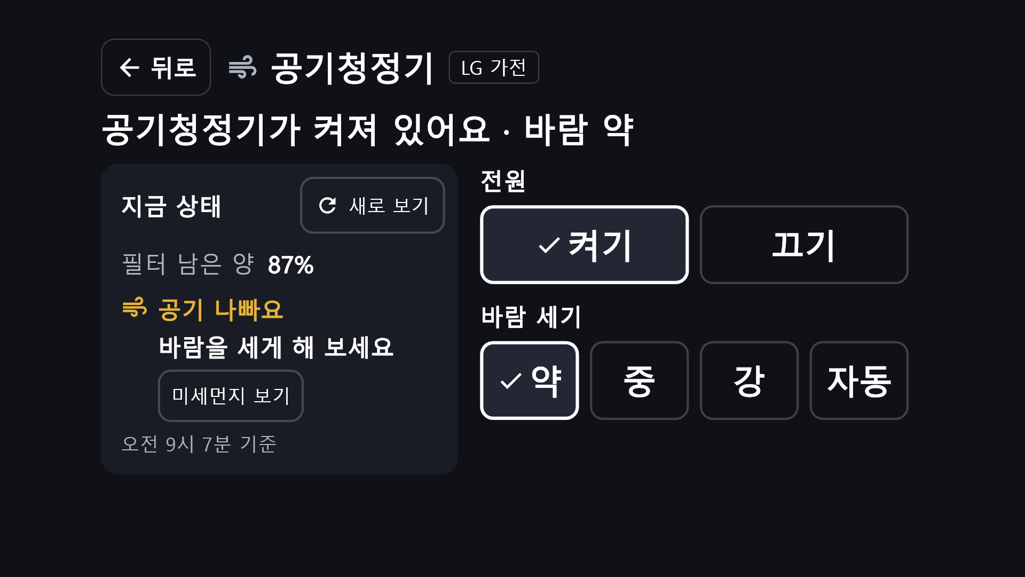
rpi5-touchscreen-app/test/goldens/kiosk15_thinq_detail.png
