Seongwonp/Simplelay/rpi5-touchscreen-app/test/goldens/kiosk15_thinq_result.png

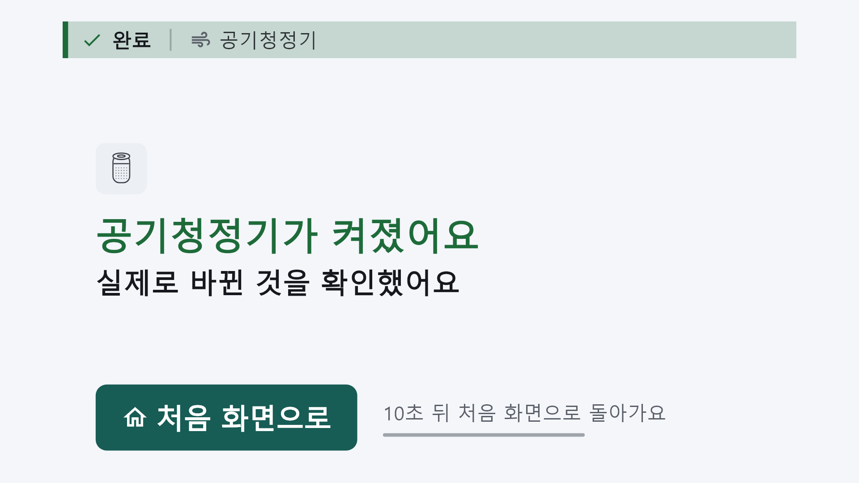
rpi5-touchscreen-app/test/goldens/kiosk15_thinq_result.png
