Seongwonp/Simplelay/rpi5-touchscreen-app/test/goldens/kiosk15_thinq_result_unconfirmed.png

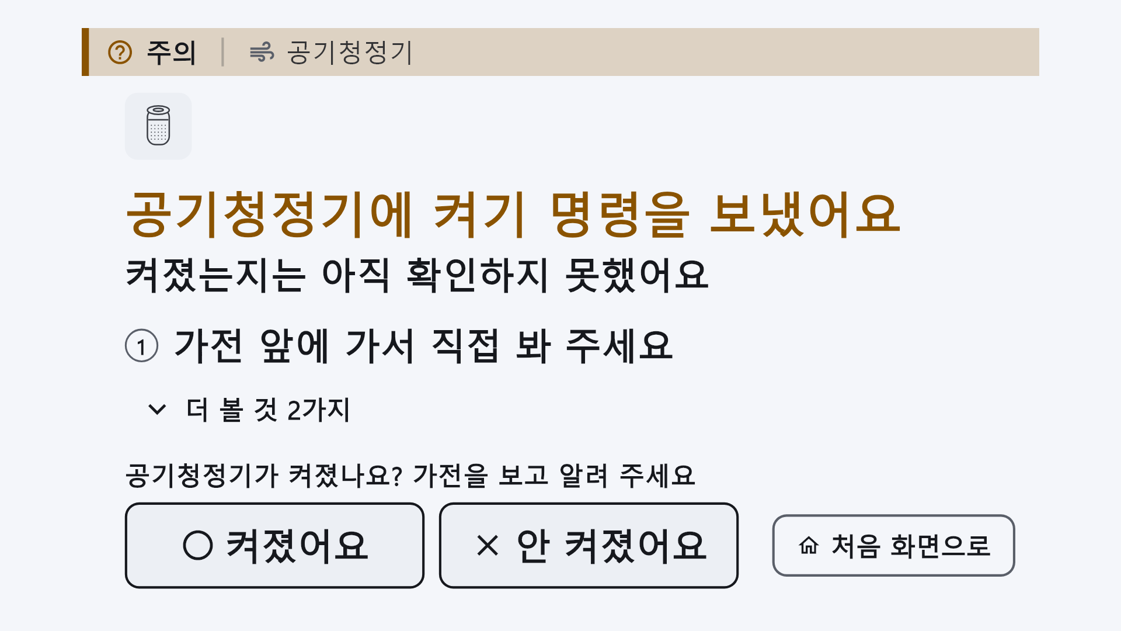
rpi5-touchscreen-app/test/goldens/kiosk15_thinq_result_unconfirmed.png
