Seongwonp/Simplelay/rpi5-touchscreen-app/test/goldens/kiosk15_thinq_sending.png

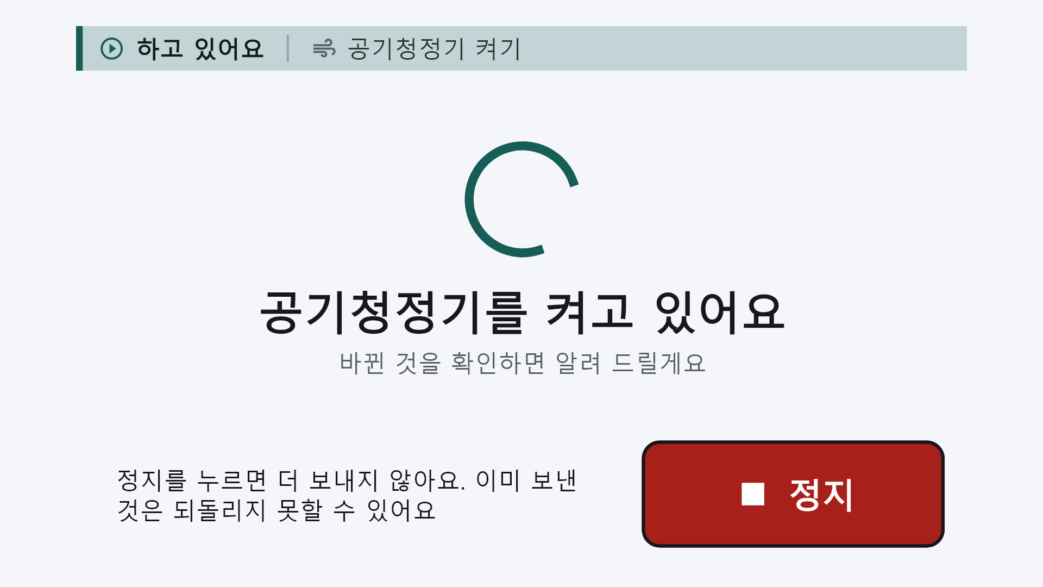
rpi5-touchscreen-app/test/goldens/kiosk15_thinq_sending.png
