Seongwonp/Simplelay/rpi5-touchscreen-app/test/goldens/kiosk15_thinq_washer_practice.png

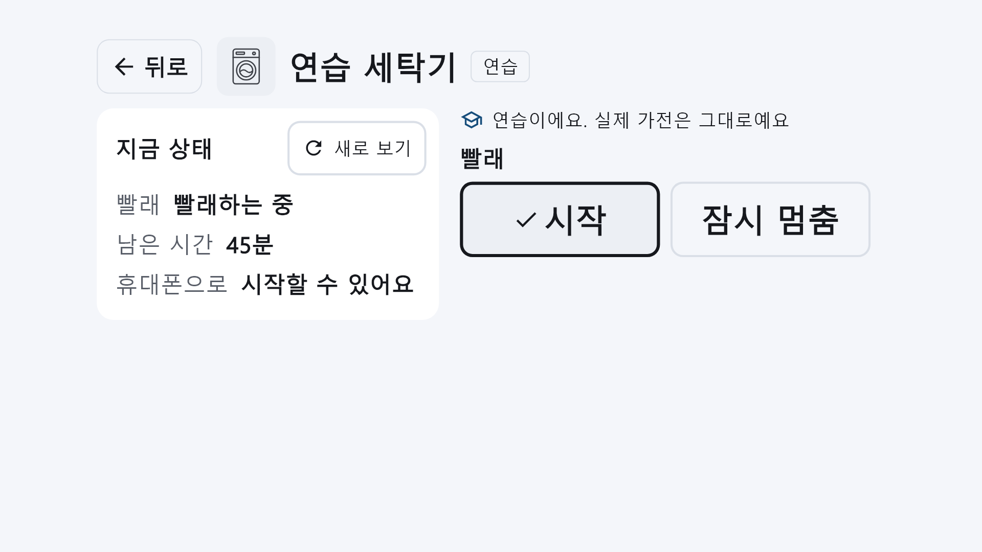
rpi5-touchscreen-app/test/goldens/kiosk15_thinq_washer_practice.png
