Seongwonp/Simplelay/rpi5-touchscreen-app/test/goldens/learning_1.6.png

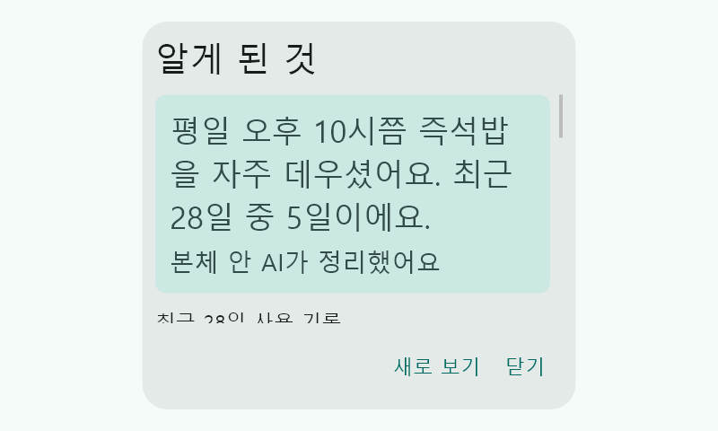
rpi5-touchscreen-app/test/goldens/learning_1.6.png
