Seongwonp/Simplelay/rpi5-touchscreen-app/test/goldens/my_appliance.png

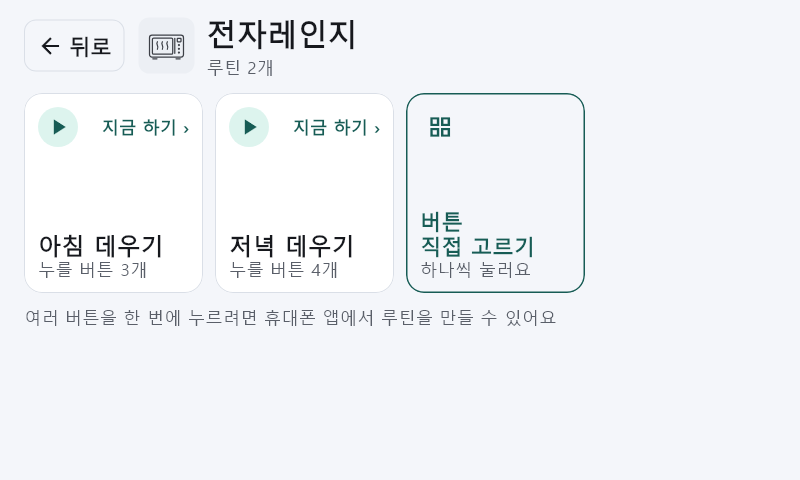
rpi5-touchscreen-app/test/goldens/my_appliance.png
