Seongwonp/Simplelay/rpi5-touchscreen-app/test/goldens/provenance_done_1.0.png

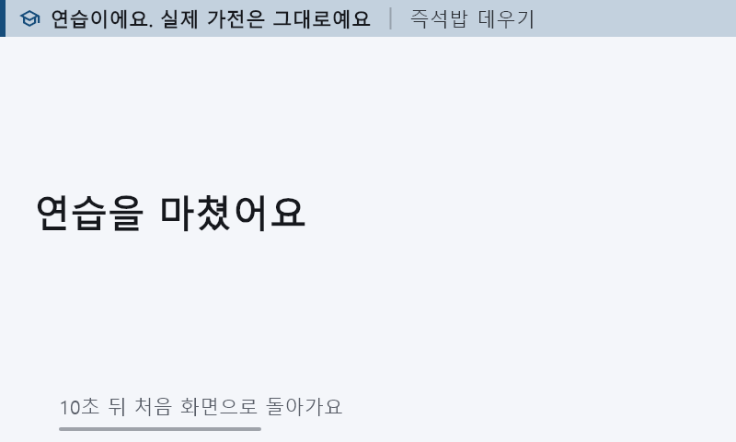
rpi5-touchscreen-app/test/goldens/provenance_done_1.0.png
