Seongwonp/Simplelay/rpi5-touchscreen-app/test/goldens/provenance_done_1.6.png

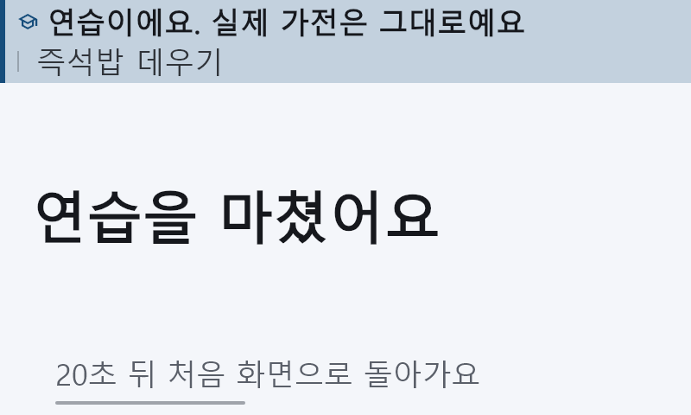
rpi5-touchscreen-app/test/goldens/provenance_done_1.6.png
