Seongwonp/Simplelay/rpi5-touchscreen-app/test/goldens/provenance_running_1.0.png

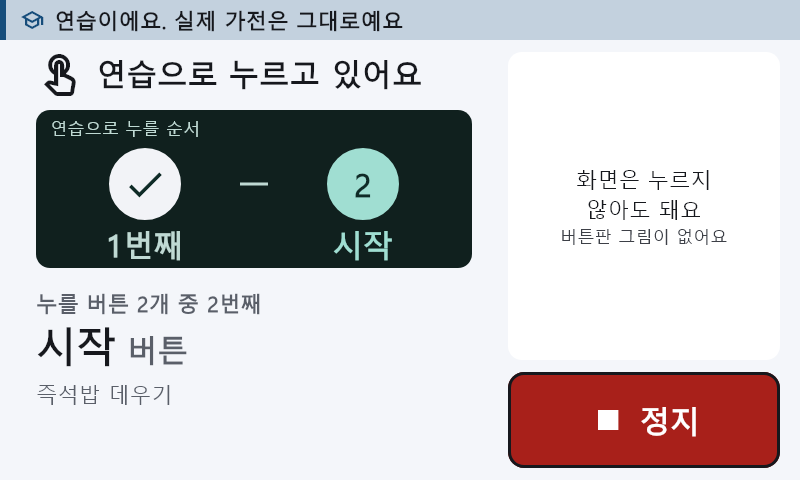
rpi5-touchscreen-app/test/goldens/provenance_running_1.0.png
