Seongwonp/Simplelay/rpi5-touchscreen-app/test/goldens/provenance_running_1.6.png

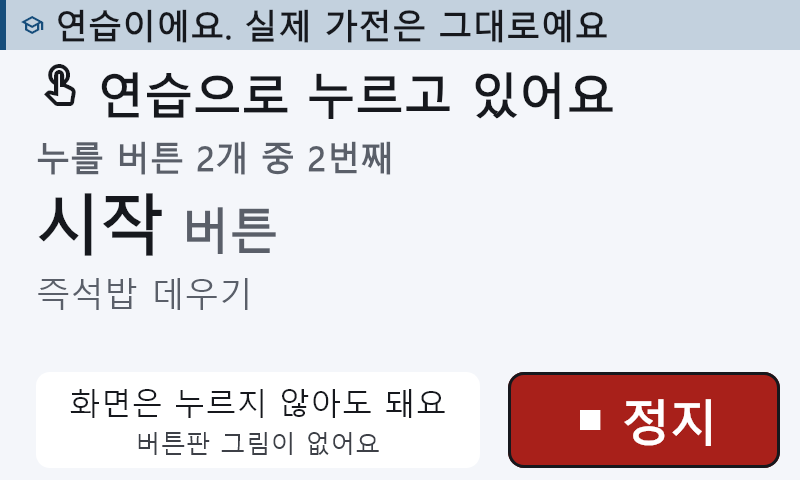
rpi5-touchscreen-app/test/goldens/provenance_running_1.6.png
