Seongwonp/Simplelay/rpi5-touchscreen-app/test/goldens/suggestion.png

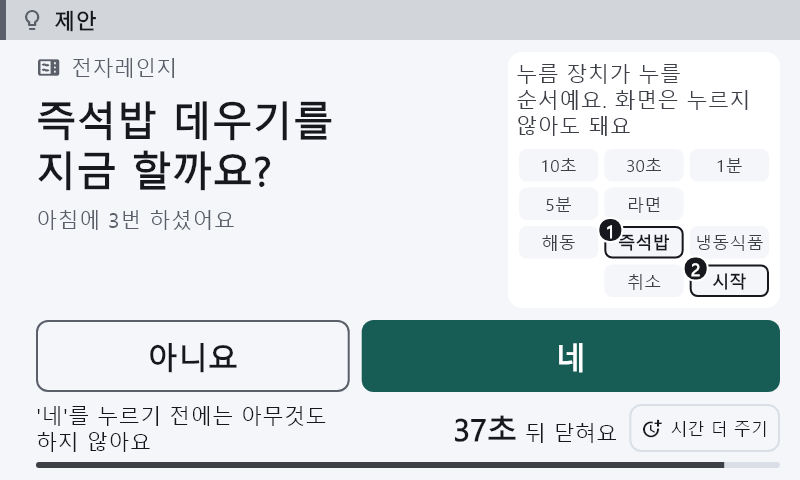
rpi5-touchscreen-app/test/goldens/suggestion.png
