Seongwonp/Simplelay/rpi5-touchscreen-app/test/goldens/suggestion_large.png

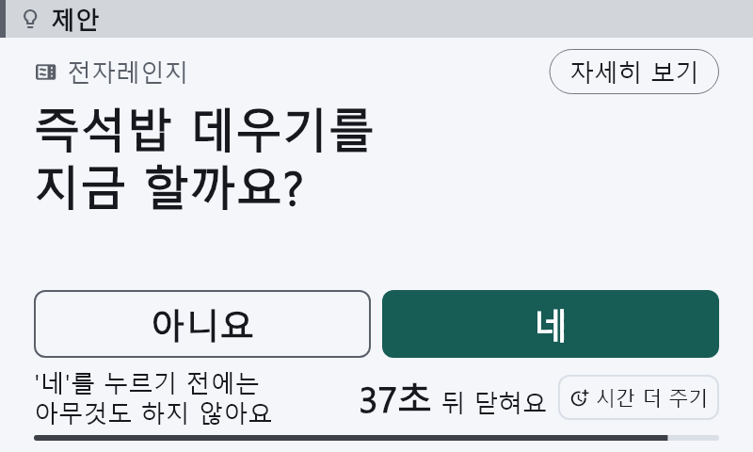
rpi5-touchscreen-app/test/goldens/suggestion_large.png
