Seongwonp/Simplelay/rpi5-touchscreen-app/test/goldens/suggestion_long_large.png

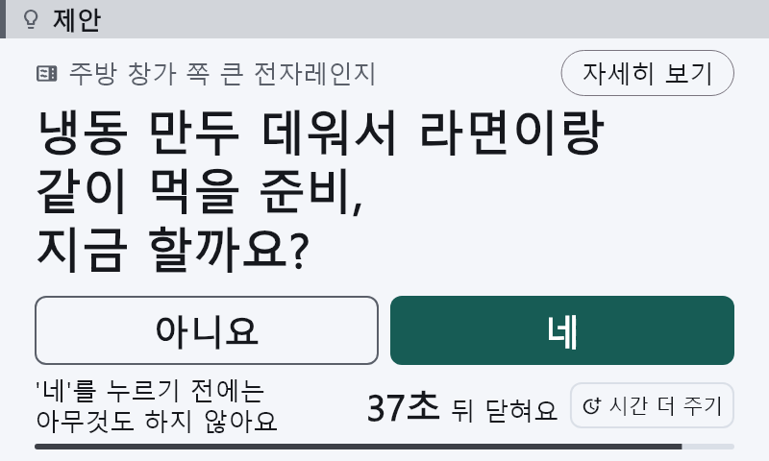
rpi5-touchscreen-app/test/goldens/suggestion_long_large.png
