Seongwonp/Simplelay/rpi5-touchscreen-app/test/goldens/thinq_detail_large.png

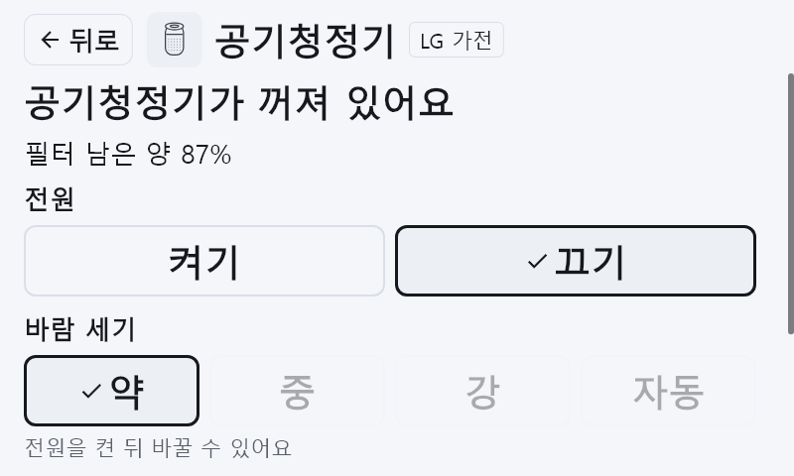
rpi5-touchscreen-app/test/goldens/thinq_detail_large.png
