Seongwonp/Simplelay/rpi5-touchscreen-app/test/goldens/thinq_result_large.png

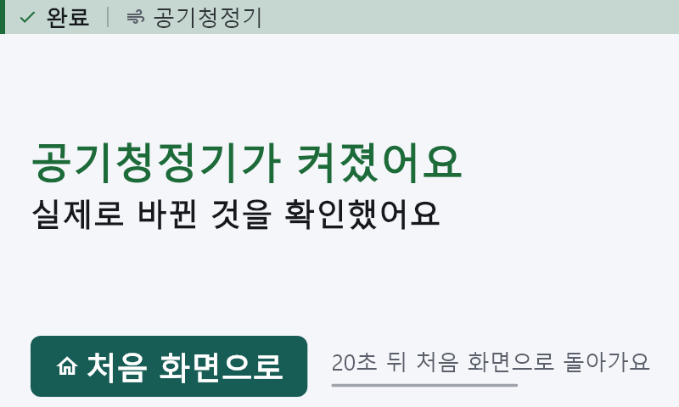
rpi5-touchscreen-app/test/goldens/thinq_result_large.png
