Seongwonp/Simplelay/rpi5-touchscreen-app/test/goldens/thinq_sending_large.png

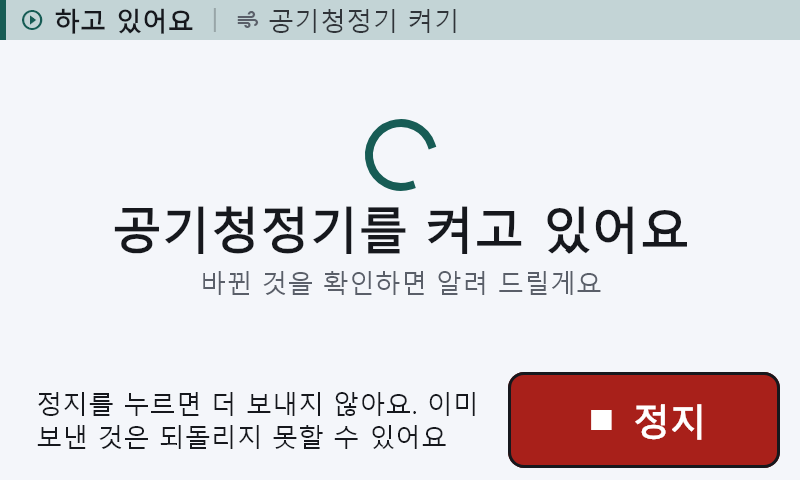
rpi5-touchscreen-app/test/goldens/thinq_sending_large.png
