Seongwonp/Simplelay/docs/devlog_2026-10-08-eval64-fix.md

# 2026-10-08 평가 결함 수리

Python·배포 설정·공개 문서만 변경했다. 아래 시험은 가짜 장치·합성 입력이며 실물 성능 증거가 아니다.

| 항목 | 수정 | 수정 전 실패를 실제 실행해 확인한 결과 |
|---|---|---|
| 1 기록기 | 관측 훅을 내부 모션 어댑터에 전달, 기존 어댑터도 지원 | 실제 모션 어댑터·Fake MCU·기록기 조합에서 관측 순서 3건 실패. 기록기 없음은 통과 |
| 2 ADC | join 후 생존, 마지막 표본 나이, 최소 표본 수, 관측 구간 공백 검사. 한계값은 CurrentSensorConfig, 실측 필요 | 생존·오래된 표본·부족·중간 공백 4건 실패. 별도로 운영 생성 경로+기록기에서 두 표본 뒤 ADC 읽기를 막으면 옛 코드가 succeeded를 반환함을 확인 |
| 3 UART | 쓰기·drain 오류도 링크 해제·래치 모름·동일 백오프 재연결. 실행 재전송 없음 | EOF 없는 쓰기·drain 고장 2건에서 link_up이 True로 남음 |
| 4 L3 | 관측 중 밀린 표본을 순서대로 판정, 다음 누름 전 누적 표본 처리. 버퍼 유실은 읽기 실패 | SerialPowerSensor로 0.2초 지연 통과, 4.5초 지연은 1,200W를 보고도 시간 초과 실패 |
| 5 프로토콜 | 광고 버전이 2 미만·잘못된 형식이면 실행 전 execute_protocol_v2_required. 운영 hello 경로는 광고 전에도 거절 | 버전 0·1·None·문자열 4건에서 실행이 전송되고 시간 초과 |
| 6 시연 결속 | home_mw:0,washer:1 및 intercom 판정 없음. 릴레이·기록기 대상은 SIMPLELAY_OUTLET_PRESS_APPLIANCE로 지정(미설정 기본값 유지). 시나리오·런북·env 예시 반영 | 기존 시나리오·런북의 결속 거절 및 env 예시 부재 확인. 추가 운영 생성 시험에서 내장 microwave 고정으로 기동 거절도 재현 후 수리. 수정 후 기동·준비 상태·세 대상 결속 통과 |
| 7 배포 | RPi4와 공용인 backend 이미지에 ADS1115·Blinka 의존성. 센서 활성화 기본값 유지 | 이미지 의존성 검사 실패 |
| 8 문구 | 기존 자산 일부 재사용, 기구·모션 범위 독립성, MCU·Z 미정·XY ×2, 조건부 호출 증거, L1/L3, 소프트웨어 정지·음성 범위, 관측 구간 갱신 | 문서 회귀 9건 실패 |

## 검증

- 항목별 수정 전 실패를 확인한 뒤 수정했다. 기대한 회귀 실패와 별도로 L3 시험 속성 이름 오타를 고쳐 실제 시간 초과를 재현했다.
- Windows 시계 해상도로 흔들린 UART 백오프 검사는 고해상도 시계·충분한 간격으로 조정했다. 기존 짧은 ADC 시험도 최소 표본 수를 확보하도록 관측 시간을 늘렸다.
- 첫 전체 시험: 2,532 통과·1 실패. 기존 정지 대기 시험의 6초 한도 중 단조 시계가 약 960초 뛰었다. 코드 변경 없이 해당 시험만 재실행해 통과했다.
- 두 번째 전체 시험 2,533 통과 후 v3 기동 경로 보완을 추가했다. **최종 전체 시험 2,534 통과**(저장소 가드 포함, 98.82초). `PYTHONUTF8=1`, `.venv/Scripts/python.exe -m pytest -q rpi rpi4 --basetemp C:\Temp\pt-f5-35c9a1`. 기존 라이브러리 폐기 예정·캐시 권한 경고 3건.

## 남은 것

- 실제 ADC·CT·모션·정지 지연 측정, 분압·gain·영점 및 수집 신선도/공백/개수 한계값 보정, MCU 실제 Z 시각 정렬.
- Docker 엔진이 실행 중이지 않아 이미지 빌드는 미검증. 장치 전달·권한 및 실보드 import/기동 확인 필요.
- Dart는 변경·실행하지 않았다. 음성 HTTP 실패 처리 등 앱 수리는 데스크톱 몫이다. 실폰·실물 검증은 하지 않았다.
