Seongwonp/Simplelay/docs/devlog_2026-08-29.md

# 개발 로그 — 2026-08-29

## ESP-NOW 전송 구현 + 교차 리뷰 치명 5건 수리

본선 데모용 ESP-NOW를 노드·게이트웨이·RPi5 세 쪽에 구현하고, 곧바로 교차 리뷰를
받아 치명 5건을 수리했다. 백엔드 테스트 **490 → 527**.

리뷰 결론이 정확했다: **"단편화 알고리즘보다 앞뒤 연결부에서 먼저 깨질 가능성이
크다."** 실제로 조각 분할·재조립 자체보다 그 바깥이 문제였다.

### 왜 게이트웨이가 필요했나

ESP-NOW는 ESP32 라디오끼리만 통한다. RPi5에는 그 라디오가 없다. 문서에는
"ESP-NOW (무선, RPi5 ↔ 노드의 ESP32)"라고 적혀 있었는데 **물리적으로 성립하지 않는
문장**이었다. 실제 경로는 이렇게 된다:

```
RPi5 --UART--> 게이트웨이 ESP32 --ESP-NOW--> 노드 ESP32 --UART--> RPi4
```

전용 보드를 추가하지 않고 **폰 BLE 폴백 브릿지가 겸하기로** 했다(팀 결정). 처음엔
"데모 조건에서 BLE와 ESP-NOW가 겹친다"고 반대했는데, 전용 공유기를 지참하는 계획이라
BLE 폴백은 그것마저 실패했을 때의 2차 방어다 — 겹칠 확률이 낮다는 지적이 맞았다.
되돌릴 수 있게 `ESPNOW_GATEWAY_ENABLED` 하나로 분리했다.

---

## 수리한 것

### 치명 — 한글을 글자 수로 세어 버퍼가 3배 모자랐다

`버튼 20개 × 라벨 40자 = 800`이라고 근거를 적어놓고 **바이트로 취급**했다. 한글은
UTF-8 3바이트라 실제 최악값은 약 2,500바이트다. 512바이트 UART와 1,280바이트 재조립
버퍼를 모두 넘긴다 — **분할·재조립을 만든 이유였던 그 요청이 정작 UART에서 먼저
잘리고 있었다.**

- `MAX_EXECUTE_PAYLOAD_BYTES`를 스키마에 단일 기준값으로 두고 **직렬화 바이트로** 검증
- 펌웨어 버퍼 4곳(양쪽 UART·양쪽 재조립)을 그 값에 맞춤
- 예산이 파이썬 1 + 펌웨어 4로 흩어져 있고 언어가 달라 상수를 공유할 수 없어서,
  **그 관계 자체를 회귀 테스트로 고정**했다(버퍼를 되돌리면 실패하는 것을 확인)

UART가 잘림을 조용히 넘기던 두 지점도 함께 막았다. 송신은 `measureJson()`으로 먼저 재고
안 들어가면 **자르지 않고 보내지 않으며** 실패를 반환한다(잘린 JSON은 받는 쪽이 버릴
뿐이라 "보낸 쪽은 성공으로 아는데 받는 쪽은 아무것도 못 받는" 상태가 된다). 수신은
overflow 상태를 두어 개행까지 통째로 버린다 — 잘린 JSON이 우연히 유효해 보이는 것이
최악이다.

### 치명 — 실행 중 긴급 정지가 자기 락에 막혀 있었다

`execute()`가 응답 대기 내내 락을 쥐고 `request_stop()`이 같은 락을 요구해서,
**실행 중에는 정지가 아예 나가지 않았다.** 실행이 끝나거나 타임아웃된 뒤에야 전송된다.
화면은 정지됐다는데 실물은 계속 누르는, 이 프로젝트에서 가장 위험한 실패 모드다.

정지를 확실히 보내려고 여기저기 배선해놓고 정작 그 정지를 자기 락으로 막고 있었다.
쓰기 락(한 줄 쓰는 동안만)과 실행 락(응답 대기 직렬화)을 분리하고, 정지는 실행 락을
건드리지 않게 했다.

기존 테스트가 못 잡은 이유도 같은 계열이다 — execute가 타임아웃으로 락을 놓은 *뒤에*
`node_stop`이 기록됐는지만 봤다. "정지가 언젠가 나갔다"는 확인했지만 "실행 중에
나갔다"는 확인하지 않았다. 실제 스레드로 실행을 띄우고 그 도중에 정지를 거는 테스트를
추가했다.

### 치명 — 신규 전송이 프로덕션에 배선돼 있지 않았다

`get_node_registry()`가 기본 HTTP 컨트롤러를 그대로 써서, 펌웨어에서 ESP-NOW를 켜고
MAC을 등록해도 RPi5는 그 MAC을 HTTP 주소로 취급했다. **단위 테스트에만 존재하고
프로덕션 요청은 지나가지 않는 상태.** `SIMPLELAY_NODE_TRANSPORT`로 명시 선택하게 했다
(주소 모양으로 자동 감지하지 않는다 — 오타 하나가 조용히 다른 전송을 타면 시연장에서
원인을 좁힐 수 없다).

### 중요 — 정지 플래그가 소거되지 않아 abort 무한 반복

`poll()`이 플래그를 보고 콜백만 부르고 지우지 않아서, 실행 중이 아닐 때 정지 프레임이
한 번 오면 매 loop마다 UART로 abort를 계속 보냈다. 확인과 소거를 하나의 연산으로 합쳤다.

정지 하나를 두고 **한쪽(실행 중)에서는 아예 안 나가고 다른 쪽(유휴)에서는 무한히
나가는** 두 결함이 동시에 있었다.

### 중요 — 게이트웨이가 pending을 전송 뒤에 세움

노드가 아주 빨리 응답하면 마지막 조각을 보내는 사이에 답이 도착하고, 수신 콜백이
`_pending == false`를 보고 그것을 버린 뒤 타임아웃까지 기다렸다. pending을 먼저 세우고
전송 실패 시 되돌린다.

---

## 이번에도 이음매였다

8/26에 "각 계층은 테스트되는데 둘을 잇는 경로를 지나는 테스트가 없다"는 교훈을 적었는데,
같은 패턴이 다시 나왔다.

- **테스트가 데이터 손실을 정답으로 고정**했다. 공유 UART에서 남의 줄을 "무시한다"고
  검증한 테스트가, 실은 그 줄을 **소비하고 버리는** 동작을 명세로 굳힌 것이었다
- **정지 테스트가 시점을 확인하지 않았다.** 결과만 보고 타이밍을 안 봤다
- **전송 배선이 없는데 단위 테스트는 전부 통과**했다. 조립 지점을 지나는 테스트가 없었다

테스트 개수(527개)는 정확성의 근거가 아니다. 이번 리뷰 프롬프트에 "테스트 통과 개수는
믿지 말고 조각 사이를 봐달라"고 적어 보낸 것이 그대로 값어치를 했다.

---

## 이어서 수리 — #4 공유 UART 디멀티플렉서, #6 요청↔응답 상관관계

보류했던 둘을 마저 했다. 두 지적이 사실은 **같은 결함의 양쪽 끝**이었다: 응답이 어느
요청의 것인지 아무도 확인하지 않는다는 것.

### #4 — 리더 스레드가 UART를 단독 소유

실행 대기 루프가 포트를 직접 읽으며 자기 것이 아닌 줄을 "건너뛰었다". 건너뛴 게 아니라
**소비하고 버린** 것이라, 게이트웨이가 BLE 브릿지를 겸하는 이상 실행 중에 도착한
제안·센서 줄이 그대로 사라졌다.

리더 스레드 하나가 모든 줄을 읽어 `sequence_id`로 대기 중인 실행에 전달하고, 임자 없는
줄은 `on_unclaimed_line` 콜백으로 넘긴다. 실행 락(`_exec_lock`)은 아예 없앴다 — 대기자
등록으로 동시성이 안전해졌고, 앱 수준 실행 락이 이미 겹침을 막으므로, 락을 남겨두면
정지가 다시 막히는 결함을 되살릴 여지만 생긴다.

부수로 **테스트의 가짜 포트를 요청-응답식으로 바꿨다.** 응답을 미리 큐에 넣어두는 방식은
리더가 대기자 등록 전에 읽어버려 실제와 다른 순서를 검증한다. 기본 타임아웃(30초+)을
그대로 쓰던 케이스도 짧게 잡아 **155초 → 5초**.

> 로드맵의 "UART 포트 공유"(두 프로세스가 같은 포트를 연다)는 별개다. 확인해보니
> `rpi4/main.py`는 배포 대상이 아니라(systemd 유닛은 `simplelay`·`simplelay-kiosk` 둘뿐)
> 프로세스 간 충돌은 **잠재 상태**다. 실기기 배선 때 다시 본다.

### #6 — rid로 상관관계 확인 (ACK·재전송은 의도적으로 제외)

게이트웨이는 발신 MAC과 "대기 중인가"만 보고 응답을 받아들였다. 포기한 요청의 지연
응답이 다음 요청의 결과로 둔갑할 수 있고, 그러면 **실패한 실행이 성공으로 보고된다** —
물리 버튼을 누르는 시스템에서 가장 나쁜 오보다.

- 실행 요청에 `rid`(= RPi5의 `sequence_id`)를 싣고, 노드가 모든 응답에 되돌려준다
- 대기 중인 rid와 다른 응답은 버리되 **대기는 유지**한다 — 진짜 답이 아직 올 수 있고,
  안 오면 마감이 알아서 실패로 끝낸다
- 요청 JSON 자체를 못 읽어 rid를 되돌릴 방법이 없는 오류 응답만 예외로 받는다
- 재조립 타임아웃은 이제 **곧바로 위로 실패를 올린다**. 노드는 재전송하지 않으니 남은
  마감까지 기다려봐야 얻을 게 없고, RPi5가 그만큼 빨리 정지를 보낸다

**ACK·재전송은 넣지 않기로 했다.** ESP-NOW가 링크 계층에서 이미 재시도하고, 그 위에
응용 계층 재전송을 얹으면 "같은 버튼을 두 번 누르는" 위험이 생긴다. 유실은 위층
타임아웃이 오류로 알려주고 정지까지 보내지만, **중복 실행은 아무도 모른다.** 유실률이
실측에서 문제가 되면 노드에 멱등성 키(rid 기반 중복 무시)를 먼저 넣고 나서 볼 것 —
근거는 `firmware/src/espnow_gateway.h` 주석에 남겼다.

백엔드 테스트 **527 → 529**.

---

## 마무리 — #5 동기화, #9 HTTP 정지 정책, #10 늦은 조각

리뷰 지적을 전부 닫았다. 백엔드 테스트 **529 → 540**.

### #9 — 정지를 생략하는 규칙을 뒤집었다

예전 규칙은 "400/500은 실행이 시작되지 않았으니 정지 불필요"였다. 그건 **노드 펌웨어가
지금 그렇게 짜여 있다는 것에 기댄 추론**이다 — 중간에 낀 프록시나 그 주소의 다른 기기가
답했거나, 펌웨어가 나중에 바뀌면 성립하지 않는다.

이제 정지를 생략하는 경우는 하나뿐이고, 그 근거는 자기충족적이다:
**요청이 닿지 못했다면 정지도 닿지 못한다.** 연결이 성립하지 않은 예외(ConnectError·
ConnectTimeout·PoolTimeout 등)에서만 생략하고 나머지는 전부 보낸다. 죽은 노드에 정지를
쏘느라 실패마다 2초를 더 붙잡을 이유가 없다는 실용적 이득도 같은 방향이다.

가장 큰 구멍은 **요청을 보낸 뒤 연결이 끊기는 갈래**였다(ReadError·WriteError·
RemoteProtocolError). 타임아웃과 완전히 같은 상황인데 정지를 보내지 않아서, 시연장
Wi-Fi가 한 번 끊기면 "화면은 실패, 실물은 계속 누름"이 그대로 재현된다.

200인데 본문이 JSON이 아니거나 객체가 아닌 경우도 막았다. 그전에는 raw
`JSONDecodeError`/`AttributeError`가 새어 나가 전송 문제처럼 보였다.

> 불필요한 정지가 무해하다는 근거는 확인하고 갔다 — rpi4 `act_executor`의
> "abort received while idle — nothing to cancel". 여기에 래치가 있었다면 이 규칙
> 자체가 다음 실행을 죽이는 결함이 된다.

### #5 — `volatile` 하나로 표현하던 코어 경계

수신 콜백은 **Wi-Fi 태스크**, `poll()`/dispatch는 **Arduino loop 태스크**에서 돈다.
ESP32는 듀얼코어라 둘이 다른 코어에서 동시에 돌 수 있는데 `volatile`은 원자성도 메모리
순서도 주지 않는다.

더 큰 문제는 **소유 구간**이었다. `_dispatchReady()`가 맨 앞에서 버퍼를 "비었다"고
표시한 뒤 실행 핸들러를 부르는데, 그 핸들러는 RPi4 응답을 최대 26초 기다린다. 그동안
수신부는 `_buffer`를 자유롭게 덮어썼고, **ArduinoJson은 비-const 버퍼를 zero-copy로
참조**한다 — 지금 누르고 있는 버튼 라벨이 실행 도중에 바뀔 수 있었다.

`RxState`(Idle/Assembling/Ready/Dispatching) + `portMUX` 스핀락으로 "지금 누가 버퍼를
만질 차례인가"를 명시했다. 처리가 완전히 끝나야 Idle로 돌아가고 그 전까지 수신부는 새
프레임을 버린다. **정지 프레임은 재조립을 거치지 않고 `_handleFrame` 맨 앞에서
처리**되므로 실행 중에도 그대로 통한다 — 이 구조에서 가장 중요한 성질이라 README
확인 항목의 1순위로 올렸다.

`takeStopRequest()`도 atomic exchange로 바꿨다. 읽고-쓰는 사이에 수신 콜백이 새 정지를
세우면 그 정지가 지워져 사라진다 — **놓친 긴급 정지**다. 8/29 오전에 "한쪽에서는 아예
안 나가고 다른 쪽에서는 무한히 나간다"고 적었던 그 정지 플래그에, 세 번째 결함이 더
있었던 셈이다.

### #10 — 늦은 조각이 진행 중인 재조립을 뒤엎던 문제

세 갈래로 나뉘어 있었다.

- **다른 msgId가 진행 중인 재조립을 뺏었다.** 두 메시지가 섞이면 서로를 계속 밀어내서
  둘 다 완성되지 못하고 타임아웃까지 갔다. 이제 시작한 메시지를 끝까지 붙든다
- **완성 판정에 프레임이 들고 온 `fragCount`를 썼다.** `fragCount=1`이라고 주장하는 옛
  프레임 하나가 10조각짜리 메시지를 "다 왔다"고 만들어 잘린 JSON을 처리하게 할 수
  있었다. 저장된 `_fragCount`로 판정한다
- **방금 끝낸 메시지의 뒤늦은 조각**이 새 재조립을 시작하면, 정작 진짜 새 메시지가
  "다른 msgId"로 밀려 버려진다 — 첫 번째 규칙의 뒷면이라 3초간 무시한다

버퍼를 벗어나는 조각도 이제 그 조각만 버린다(예전에는 재조립 전체를 리셋해서 엉뚱한
프레임 하나가 진행 중인 정상 메시지를 통째로 없앨 수 있었다).

---

## 남은 것

리뷰 지적은 전부 닫혔다. 남은 것은 **검증**이다.

- **펌웨어는 여전히 컴파일조차 못 해봤다.** 이 환경에 PlatformIO도 C++ 컴파일러도
  없다. 오늘 하루에만 펌웨어를 세 번 크게 고쳤고(버퍼 예산·rid 상관관계·동시성),
  지금 이 프로젝트에서 **가장 큰 미검증 표면**이다. 괄호 균형과 헤더 선언 대조는
  스크립트로 확인했지만 그 이상은 실기기 몫이다
- 확인 항목은 양쪽 README에 적어뒀다. 1순위는 **"실행이 블로킹하는 동안에도 정지가
  통하는가"** — 상태 기계가 정지까지 막으면 그게 가장 위험한 실패 모드다
- UART 포트 공유(두 프로세스가 같은 포트를 연다)는 `rpi4/main.py`가 배포 대상이 아니라
  잠재 상태다. 실기기 배선 때 다시 본다

## 여전히 미검증

실기기 확인 항목은 양쪽 README에 있고, 그중 핵심은 **BLE와 ESP-NOW가 실제로 동시에
도는지**(겸용의 유일한 진짜 위험)와 **조각 분할 왕복**, 그리고 **실행 중 정지**다.

---

# 2차 교차 리뷰 — 수리가 만든 결함

1차 수리 결과물(`30e2579..HEAD`)을 다시 리뷰받았다. **지적 7건이 전부 사실이었고,
그중 둘은 치명**이다. 백엔드 테스트 **540 → 549**.

리뷰 결론이 또 같았다: *"단편화 알고리즘보다 앞뒤 연결부에서 먼저 깨진다."* 이번에도
재조립 자체가 아니라 **정지 전달 순서, UART 소비자 배선, 메시지 수명 경계**였다.

## 내가 틀렸던 것 — ArduinoJson v7은 zero-copy가 아니다

1차 수리의 핵심 근거가 틀렸다. v6는 `char*` 입력에서 문자열을 버퍼에 남기고 포인터만
저장했지만, **v7은 그 모드를 없애고 문서 안으로 복사한다**(공식 문서로 확인). "실행
핸들러가 26초 블로킹하는 동안 버퍼를 지켜야 한다"는 근거가 성립하지 않았다.

상태 기계는 그대로 뒀다. 다만 진짜 이유로 주석을 고쳤다 — **이미 늦은 요청을 실행하지
않기 위해서**다. 실행 중에 새 요청을 받아 두면 위층이 포기한 뒤에 물리 버튼이 눌린다.
전보다 나은 근거다.

## 치명 1 — 승인 후 시작 전에 온 정지가 사라졌다

**오늘만 네 번째 정지 결함이다.**

마지막 조각이 도착해 Ready가 된 직후 정지 프레임이 오면, `poll()`이 그 정지를 먼저 꺼내
abort를 보내고(그런데 RPi4는 아직 유휴라 무시) 곧바로 실행을 시작했다. 화면은 정지인데
실물이 **그때부터** 눌리기 시작한다.

실행 도중의 정지는 대기 루프가 잡고, 유휴 중의 정지는 `_onStop`이 처리한다. 남은 구멍이
정확히 "승인과 시작 사이"였다 — 두 처리기 어느 쪽도 자기 구간이 아니라고 본 틈.

판정을 dispatch 안으로 옮겼다. `poll()` 시점에는 이 요청이 어느 rid인지 아직 모르므로
거기서 소비하면 대상 확인 자체가 불가능하다.

## 치명 2 — 하드웨어 비상정지가 소프트웨어 정지에 연결돼 있지 않았다

게이트웨이 보드의 **물리 E-STOP 버튼**은 UART로 `abort`를 보낸다. RPi5에는 그 줄을 읽는
코드가 **아예 없었다.**

1차 수리에서 "임자 없는 줄을 버리지 말고 콜백으로 넘긴다"고 해놓고, 정작
`_get_gateway_link()`는 콜백 없이 링크를 만들었다. 기본 동작은 debug 로그. 리더가 이미
소비했으므로 다른 누구도 받을 수 없다 — **이름만 바뀐 폐기**였다.

> 그리고 그걸 **테스트가 가려줬다.** 링크 단위 테스트는 `on_unclaimed_line=seen.append`를
> 직접 주입해서 검증한다. 프로덕션의 `None` 경로는 지나가지 않는다. 1차 리뷰에서 "테스트가
> 데이터 손실을 정답으로 고정했다"고 적었는데, 그 수리가 **같은 모양의 새 구멍**을 만든
> 셈이다. 이번엔 배선을 지나는 테스트를 넣고, 배선을 지우면 실제로 실패하는 것까지
> 확인했다.

## 나머지

- **리더 스레드가 죽으면 아무도 몰랐다.** 포트 예외는 로그만 남기고 스레드가 사라져서,
  대기 중인 실행은 마감(30초+)까지 매달리고 이후 모든 실행이 응답을 읽을 사람 없이 같은
  타임아웃을 반복했다. 게다가 `_route()`가 read loop의 try 밖이라 노드가 보낸
  `retry:"bad"` 한 줄로도 같은 상태가 됐다. 종료 상태를 두고 대기자 전부에 즉시 실패를
  알린다
- **last-done 필터가 MAC을 안 봤다.** 노드마다 송신 카운터를 1부터 시작하므로, 노드 A의
  첫 응답을 처리한 직후 3초 안에 온 노드 B의 첫 응답(역시 msgId=1)이 "이미 처리함"으로
  버려졌다. 여러 노드 구성에서 바로 터진다
- **식별자 없는 오류 응답을 현재 요청에 귀속했다.** 포기한 A의 늦은 파싱 오류가 대기 중인
  B의 실패로 둔갑하고, B의 진짜 응답은 그 뒤 버려졌다. 예외를 없앴다 — 요청 JSON은
  게이트웨이가 직접 만든 것이라 정상 운용에서 파싱 실패가 나올 이유가 없다
- **정지가 어느 실행을 취소하는지 밝히지 않았다.** 이제 rid를 싣는다. 사용자 긴급 정지만
  대상을 비워 무조건 멈춘다
- **조각 송신이 전달 완료와 무관했다.** `esp_now_send`는 큐에 넣기만 하는데 고정 2ms
  지연으로 띄우고 있었다. 송신 콜백 기반으로 바꿨다 — 부수 효과로 노드 전원이 꺼져 있는
  것을 25초 기다리지 않고 즉시 안다

## 이번 회차의 교훈

1차 리뷰에서 "이음매를 봐달라"고 했고 그게 값어치를 했다. 2차에서 나온 치명 둘 다
**1차 수리가 만든 것**이다 — 하나는 정지 처리기 사이의 새 틈, 하나는 콜백을 만들어놓고
프로덕션에 붙이지 않은 것.

수리는 새 이음매를 만든다. 그래서 "고쳤다"와 "그 경로가 프로덕션에서 실제로 지나간다"는
매번 따로 확인해야 한다.

## 그리고 드디어 컴파일했다

PlatformIO를 설치해 두 펌웨어를 처음으로 빌드했다. **양쪽 SUCCESS, 우리 소스 경고 0건.**

> 설치가 한 번 막혔다. `install.platformio.org`에 A/AAAA 레코드가 아예 없다 --
> 네트워크 문제로 보였지만 그 호스트가 죽은 것이었다. PyPI로 받았고, PlatformIO Core는
> Python 3.14를 아직 지원하지 않아 3.11 전용 venv를 썼다. 명령은 README에 적어뒀다.

첫 컴파일에서 오류 2종이 나왔고 **둘 다 오늘 고친 부분이 아니라 원래 있던 것**이다:

- `min(ESPNOW_MAX_PAYLOAD_BYTES, len - offset)` — 앞은 int 상수식, 뒤는 size_t라
  코어 3.x가 쓰는 `std::min`이 템플릿 인자를 추론하지 못한다. Arduino의 `min` 매크로가
  살아있던 시절 코드를 그대로 옮겨온 자리다. **양쪽 펌웨어에 똑같이 있었다**
- `doc["buttons"].as<JsonArray>()` — `onRpiMessage`가 받는 문서가 const라 가변
  `JsonArray`를 꺼낼 수 없다

둘 다 리뷰 두 번과 자체 정적 검사(괄호 균형·헤더 선언 대조·멤버 사용)를 전부 통과한
것들이다. 타입 오류는 그런 검사로는 안 잡힌다 -- **컴파일 없이 리뷰만 반복한 대가**였다.
설치가 10분이었는데 그걸 미룬 채 펌웨어를 다섯 번 고쳤다.

덤으로 README의 미해결 항목 하나가 닫혔다: 플랫폼은 **espressif32@7.0.1 =
Arduino-ESP32 코어 3.x**다. 수신 콜백은 `recv_info`를 받는 3.x 분기를 탄다.

## 여전히 미검증

컴파일이 되는 것과 도는 것은 다르다. 크로스코어 동기화·정지 전달 순서·조각 왕복은
전부 **실기기에서만** 확인된다. 확인 항목은 양쪽 README에 있고, 1순위는 여전히
"실행이 블로킹하는 동안에도 정지가 통하는가"다.
