Seongwonp/Simplelay/docs/devlog_2026-09-14u.md

# 개발 로그 — 2026-09-14 (15.8형 패널 사양 수령 · 15인치 테스트 확장)

기준 HEAD: `354dab6` → `1c4a415`(+ 이 기록).
패널의 **제품 사양표와 사용설명서**를 받아, 전날 보류했던 작업을 조건대로 열었다.
신규 기능·레이아웃 변경은 없다. 사양표 사진·설명서 원본은 저장소에 넣지 않았고
값만 옮겼다(제조사·호환 기기 명칭 제외).

## 사양으로 확정된 것

| 항목 | 값 | 비고 |
|---|---|---|
| 패널 | 15.8형 IPS, 표시 영역 349.632 x 196.668 mm, 픽셀 0.1821 mm | |
| 해상도 | 1920x1080 @60Hz, 16:9 | 픽셀 크기 x 화소 수 = 표시 영역 → 기본 해상도 |
| 터치 | 10점 | |
| 전원 | Type-C PD 전원 포트, 사양표 5 V 3 A / 9 V 2.2 A / 12 V 1.67 A, 소비전력 8.5 W | 설명서는 5~20 V 사용 가능 — 표기 차이 |
| 밝기·시야각 | 250 cd/m², 170°/170° | |
| 음성 | 스피커 2 W + 2 W, 3.5 mm 잭 | |
| 거치 | 1090 g, VESA 75 x 75 | |

코드의 1920x1080 가정은 사양과 맞았다. 이전 주석의 PPI 147은 15.0형 계산이었고
15.8형은 약 139.5다.

## 사용설명서에서 나온 연결 제약 (중요)

- **HDMI만 연결하면 터치가 되지 않는다.** 터치는 호스트 USB ↔ 모니터 Type-C **데이터**
  포트로 연결해야 한다.
- Type-C 포트가 둘이다: **PD 전원 포트**(영상·터치 없음)와 **데이터 포트**(영상·음성·터치).
  RPi5 USB-C는 영상을 내보내지 못하므로 영상은 HDMI로만 받는다.
- 동봉 HDMI 케이블은 **HDMI–mini HDMI**라 RPi5(micro-HDMI)에 맞지 않는다.
- 전원이 약하면 화면이 깜박이거나 꺼진다.

RPi5 연결 설계안: micro-HDMI↔HDMI(영상·음성) / USB-A↔Type-C 데이터(터치) / 제조사 PD
어댑터↔Type-C 전원. 데이터 포트 연결이 RPi5 쪽 전원에 주는 영향은 측정 필요.

## 커밋

| 커밋 | 내용 |
|---|---|
| `30d0800` | 15인치 테스트 확장. `kiosk_15inch_test` — 선택·실행·완료(성공/확인 못 함)·수동·방해 금지·경보가 글씨 1.0/1.22배에서 넘치지 않고 2.25배로 채움, 확대된 화면 좌표로 긴급 정지·카드·버튼 칸·왼쪽 위 돌아가기·처음으로·방해 금지·경보 확인이 닿음. 골든 6장 추가. 테스트 이름·주석을 사양 기준으로, PPI 정정 |
| `1c4a415` | 설계 §0-1(사양·설명서·실기기 구분, 연결 설계안, 설계 1 px ≈ 0.41 mm), 전력버짓 §2-3(사양 8.5 W와 실측 분리, PD 전용), 배포 체크리스트(케이블 세 가닥, 터치 불량 시 HDMI만 연결했는지, 음성 출력, 30분 이상 구동), 키오스크 README, 백로그 B6 |

## 검증

- 15인치 테스트가 헛돌지 않는지: `KioskCanvas`의 확대를 끄는 변형(`BoxFit.scaleDown`)에서
  15건 실패를 확인하고 되돌렸다.
- 키오스크: `flutter analyze` error·warning 0(기존 info 1), 테스트 **110** 통과(골든 제외,
  90 + 15인치 20), 골든 **26장** 갱신 없이 비교 통과. 기존 골든 20장은 해시가 그대로다.
- 백엔드·폰: 변경 없음, 재실행하지 않았다(직전 968 · 340).
- 새 골든 중 실행·수동·방해 금지·경보는 이미지를 직접 봤다 — 정지 버튼은 오른쪽 아래,
  돌아가기는 왼쪽 위에 그대로 확대되고 좌우 60 px 여백이 배경색으로 채워진다.

## 실기기로만 확인할 수 있는 것

RPi5 실제 출력 모드, 터치 인식(USB 연결)·실제 좌표·가장자리, 1.5~2 m 가독성, 큰 글씨,
밝기, 화면 포함 실제 전력과 PD 구성, 음성 안내의 HDMI 출력, 30분 이상 구동 중 깜박임.

## 다음

**micro-HDMI–HDMI 케이블부터 준비한다.** 그 뒤 체크리스트 1-2 순서로 실기기 확인.
배율·여백은 실물을 본 뒤 필요할 때만 고친다.
