Seongwonp/Simplelay/docs/devlog_2026-08-22.md

# 개발 로그 — 2026-08-22

## 오늘 한 일 — W3 소프트웨어 항목 선행 완료 (본가 체류, 실기기 없음)

라즈베리파이가 없는 상황이라 W3 중 실기기가 필요 없는 작업을 전부 앞당겨 완료. 커밋 5개:

| 커밋 | 내용 |
|---|---|
| `feat(intent)` | 규칙 7종 + 별칭 21종 + 발화 정규화(공백·문장부호 무시) — "우유 데워줘" 문자열 1개 의존 탈출. 테스트 13케이스 |
| `feat(rpi)` 영속화+배선 | SimpleLayDb(SQLite)·SqliteUsageLog·NodeRegistry(store) — 재시작에도 사용 이력·노드 등록 유지(SIMPLELAY_DB_PATH 게이트, systemd에 경로 추가). 3계층 의도해석(벡터DB→규칙→LLM)을 deps에 실배선 |
| `feat(security)` | SIMPLELAY_API_KEY 인증(상수시간 비교, 루프백 면제, /health 개방) + 폰 앱 키 설정·X-API-Key 헤더. 테스트 9개 |
| `fix(app)` BLE | 도달 불가였던 BLE 폴백을 실동작화(서버 무응답 → ESP32 릴레이 전송 + 안내) + 저장 기기 재연결 수리(실제 스캔 후 연결) |
| `fix(rpi)` | /sensors에 mocked 플래그 — mock 26.5°C를 실측인 척 반환하던 문제 |

검증: pytest **359** · flutter test **112** · analyze 신규 이슈 0.

## 실기기 체크리스트 (본가 복귀 후 몰아서)

- [ ] 릴리즈 APK 폰 설치 → RPi5 실행 확인 (mDNS 자동 해석 검증 포함)
- [ ] `sudo ./scripts/setup_rpi.sh` → 부팅 시 키오스크 자동 실행 + SQLite 영속화 확인
- [ ] Flutter(elinux) 키오스크 빌드 시도 → 성공 시 kiosk 유닛 ExecStart 교체
- [ ] ESP32 firmware-node 플래시 + HTTP↔UART 실통신 / DHT22·홈스위치 GPIO
- [ ] act_main.py SensorVerifier·DangerSoundMonitor 주입(코드 조립은 다음 코드 세션 가능, 캘리브레이션은 센서 필요)

## 남은 W3 코드 작업 (다음 세션)

- act_main.py에 SensorVerifier + DangerSoundMonitor 주입 (env 게이트로 mock 폴백 유지)

---

## (추가 세션) W3 코드 작업 완결 — act_main 배선

- `feat(rpi4)`: SIMPLELAY_SENSORS_ENABLED → SensorVerifier(전류+음향 퓨전), SIMPLELAY_DANGER_SOUND_ENABLED → DangerSoundMonitor 상시 태스크. 기본은 mock 유지(offline-first).
- **UART abort → `request_stop()` 배선** — "협조적 취소 훅 없음"이라 로그만 남기던 자리에 W0에서 만든 훅을 연결. 긴급 정지가 폰/키오스크 → RPi5 → UART → RPi4 폐루프까지 끝단 완결.
- pytest 360 passed. **이로써 W3 코드 항목 전부 완료** — 남은 W3는 실기기 검증뿐.

## 사용자 편의(UX) 방향 점검 메모

실패 시 친절함(에러 문구·자동 폴백·주소 입력)은 확보. 다음 보강 대상(LG OT 스크립트 확인 후 우선순위 확정):
- TTS 음성 안내 (W7 → 앞당길 후보 1순위, 타깃 사용자 직결)
- 터치 피드백/햅틱, 히트박스 확대, 큰 글씨 모드
- Semantics(스크린리더)

---

## (저녁 세션) LG OT·교수미팅 분석 + SW 선행 스프린트 계획 + S1 완료

- **두 스크립트 분석 완료** → 상세는 dev-docs 로컬 전용 문서(git 제외). 핵심: 심사 키워드 3종(공감지능·공간이해/초개인화·추론 경계), 스토리 리프레임 필요, 치명 리스크(플랫폼 이미지의 Python 구동 여부 — Slack 선질문 권장), RPi4 카메라 활용 검토, 협회 1차 방문 앞당김
- **SW 선행 스프린트 S1~S6 수립** (결선로드맵.md) — 실기기 없는 기간의 실행 축. 소화 후 LG 기술 평가 세션(데스크탑) → 실기기 검증일 순서
- **S1 리허설 실패 주입 완료** `feat(rpi)`: `POST /demo/inject-failure {button_index, attempts}` — 다음 실행의 지정 버튼 검증을 강제 실패. attempts 1~2 = 재시도 후 성공 장면, 3+ = 안전 정지 장면. verifier 래퍼(mock/실센서 공용), 1회용 자동 해제, DELETE로 해제. 테스트 10개, 전체 370 passed
- 데모 절차 메모: 무장 → 실행 → 키오스크에서 "시도 2회" 표시와 함께 성공. UART 모드는 RPi4 쪽 배선 필요(모듈 docstring에 명시)

### S2 TTS 음성 안내 완료 (커밋 2개)

- **키오스크**: espeak-ng 프로세스 호출(flutter_tts elinux 미지원 → CLI 직행, 러너 주입으로 테스트). 발화 3지점 — 제안 도착("우유 데워줘, 지금 실행할까요? 화면에서 승인해 주세요") / 완료·실패(서버 유실은 별도 문장) / 위험 경보(엣지 1회, DND보다 우선). 설정 오버레이 토글(세션 한정, 기본 켜짐). setup_rpi.sh에 espeak-ng 추가
- **폰**: flutter_tts(ko-KR), 실행 완료/실패/중단/무응답을 전이 시점 1회 발화(HTTP·BLE·타임아웃 3경로), 설정 '일반'에 토글(prefs, 기본 켜짐)
- 원칙: 음성은 보조 채널 — 어떤 실패도 기능을 막지 않음(전부 삼킴)
- 검증: 키오스크 9개 + 폰 114개 테스트 전부 통과. **espeak-ng 한국어 음질·볼륨은 실기기 확인 항목**(대안: pico2wave)
