Seongwonp/Simplelay/docs/devlog_2026-08-21.md

# 개발 로그 — 2026-08-21

## 오늘 한 일

### 1. 개발 PC 툴체인 구축 (처음으로 로컬 검증 가능해짐)

어제까지 이 PC에는 Python도 Flutter도 없어서 테스트를 돌릴 수 없었다. 오늘 전부 구축:

| 도구 | 버전 | 위치 |
|---|---|---|
| Python | 3.12.10 (winget) | 프로젝트 `.venv` (fastapi·uvicorn·pydantic·numpy·pytest·httpx) |
| Flutter | 3.47.1 stable | `<local-path>` (OneDrive 밖 — 동기화 금지) |
| OpenJDK | 17.0.20 (winget) | `C:\Program Files\Microsoft\jdk-17.0.20.8-hotspot` |
| Android SDK | cmdline-tools + platform-tools | `%LOCALAPPDATA%\Android\Sdk` (라이선스 수락 완료) |

**주의:** 리포 경로에 한글(OneDrive)이 있으면 Dart analysis server가 크래시한다.
`C:\dev-simplelay` → 리포로 가는 **정션(junction)** 을 만들어 우회했다.
Flutter 명령은 반드시 `C:\dev-simplelay` 경로에서 실행할 것.

```
flutter/pytest 실행법 (PowerShell — &&는 5.1에서 안 됨, ;로 연결):
  cd C:\dev-simplelay ; .\.venv\Scripts\python.exe -m pytest
  cd C:\dev-simplelay\app ; flutter test
```

### 2. W0 잔여 검증 완료

- 백엔드 pytest **336개 전부 통과** (어제 추가한 긴급 정지·제안 테스트 포함)

### 3. W1 — 비동기 job 모델 전환 (로드맵의 가장 레버리지 큰 수리) ✅

동기 블로킹 실행(실기기 30초+ vs 클라이언트 타임아웃 4~8초)의 구조적 파탄을 해소.

**백엔드** (`feat(rpi): 실행을 비동기 job 모델로 전환`):
- 실행 엔드포인트 4종(execute·execute-buttons·execute-for-appliance·approve)이
  의도 해석만 동기로 끝내고 물리 실행은 백그라운드 스레드로 제출 → `job_id` 즉시 반환
- `/status`에 `job_id`·`last_job_id`·`total_steps` 추가 — job_id 대조로 완료 판정
  (stale-result 레이스 원천 차단), total_steps로 실제 진행률 표시
- 실행 가드 check-and-set을 `threading.Lock`으로 원자화 (TOCTOU 제거)
- 백그라운드 예외는 `ExecutionStatus.FAILED`로 노출, 동기 메서드는 하위호환 유지

**폰 앱** (`feat(app+kiosk): 클라이언트를 job 모델로 전환`):
- `ExecutionStatusNotifier.beginHttpJob`: 1초 주기 /status 폴링 — **HTTP 실행 시
  상태 화면이 '영원히 대기 중'이던 치명 이슈 ⑦ 해소.** 재진입 가드, 30초 무응답 탈출
- 긴급 정지: HTTP 추적 중엔 서버 /stop 호출 후 폴링이 safety_stopped를 받아 표시
- 음성 화면: 접수 후 상태 화면 자동 이동, 에러를 사용자 언어로(422/409/503 구분)
- 디버그 가짜 센서 주입을 BLE 출처로 한정 — HTTP 실경로를 가짜 데이터가 못 덮게

**키오스크**:
- idle에서도 /status 폴링 — **폰이 시작한 실행을 키오스크가 이어받아 표시** (동기화 달성)
- 완료 판정 job_id 대조, 진행바 실데이터(completed/total), 30초 무응답 '서버 응답 없음' 탈출,
  폴링 오버랩 가드, 접수 실패 시 즉시 실패 화면(고착 제거), 정지는 실제 종료 확인 후 표시

### 4. Flutter 3.47 정합 수리

- `_SettingCard`: ListTile을 색 있는 DecoratedBox로 감싸면 3.4x부터 assertion —
  배경색을 Material로 이동 (설정 테스트 11개가 이것으로 깨졌었음)
- 제안 화면 `context.mounted` 가드, voice 테스트 타이머 정리 pump

### 5. 검증 결과

| 스위트 | 결과 |
|---|---|
| 백엔드 pytest | **336 passed** |
| 폰 앱 flutter test | **105 passed** (job 계약으로 갱신 포함) |
| 폰 앱 flutter analyze | 신규 이슈 0 (기존 info 6건 잔존) |
| 키오스크 analyze + test | **클린 + 통과** |
| 릴리즈 APK 빌드 | **성공** — `app/build/app/outputs/flutter-apk/app-release.apk` (52.0MB) |

## 다음 (W2, 9/1~)

키오스크 실기기 확정 — Flutter 키오스크 ipk 빌드 → RPi5 첫 구동, setup_rpi.sh 배포 일원화,
mDNS 의존 제거. 상세는 결선로드맵.md W2.

## 메모

- **릴리즈 APK 빌드 성공** (INTERNET 권한 수정 반영된 첫 릴리즈 빌드). 남은 건 폰에 설치해
  RPi5(또는 로컬 uvicorn `python -m rpi.main`)에 실제 HTTP 실행을 확인하는 것 — W0 완료 기준의
  마지막 조각. 참고: 현재 debug 서명이라 정식 배포 시 서명 키는 추후 결정
- 데모 트리거: `POST /demo/suggest` (body 없이 호출하면 "우유 데워줘" 제안 즉시 생성)
