Seongwonp/Simplelay/docs/devlog/devlog_2026-10-14-desktop-board.md

# 2026-10-14 데스크톱 — 다음 보드 날(인계 §8) 실행: 같은 커밋 배포, 걸림·짧은 정지·재열거·자동 실행 실물 확인

[인계 §8](../archive/인계-2026-10-13-데스크톱.md)의 순서대로 진행했다. 구성:
- 보드: RPi5, RPi4(Wi-Fi), ESP32(RPi4 USB, 시험대 펌웨어 `esp32dev_benchhome`), 모터 배터리
- **벨트·솔레노이드가 없어 모터 축과 누름 신호까지만 확인했다. 캐리지 이동과 실제 버튼 누름은 여전히 미검증이다.**

## 1. 같은 커밋 4종 배포 (`568f995`)

| 대상 | 커밋 | 확인 |
|---|---|---|
| RPi5 백엔드 | `568f995` | 이미지 `9f8b4136` |
| RPi4 실행기 | 같은 이미지 | `9f8b4136`, 페어링 키 "new session" |
| 폰 APK | `568f995` | 에뮬레이터 설치 |
| 키오스크 ipk | `568f995` | 실패널 `arc install` 성공(빌드 컨테이너가 다시 쓴 `pubspec.lock`은 되돌림) |

- 배포 뒤 `ce37b81`(run_act.sh)을 RPi4에 올렸다. 이 커밋은 배포 스크립트만 바꿨고 이미지는 그대로다.
- `d6b6041`(골든)은 시험 이미지만 바꿨다.

## 2. 실물 확인 (인계 §8 항목별)

| § | 항목 | 결과 |
|---|---|---|
| 1 | M1 시계 기준점 | 링크 기록(`SIMPLELAY_SESSION_LOG_PATH`를 켬)에 `clock_probe`→`clock_ref`가 **60 s마다** 오갔다. 왕복 5.6·24.8·6.3·9.2 ms |
| 1 | M1 자동 실행(두 보드 근거) | 설정: RPi4 리허설(모의 모션·콘센트 없음), RPi5 `SIMPLELAY_UART_REHEARSAL=1`·`SIMPLELAY_THINQ_MODE=mock`. 가열 종료 주입 → 카드 → 폰 "다음부터도 자동으로" → 확인 시트 → 규칙 생성(첫 실행은 모의 상태 확인 '성공'). 두 번째 주입 → 자동 실행 **`sent`**("허용한 조건이라 승인 없이 보냈어요"). 주입 응답 **`injected_in: rpi4_uart`**, 같은 때 링크 기록에 `clock_ref`가 있었다. 끝난 뒤 두 보드 설정을 원래대로 되돌렸다 |
| 2 | 걸림 알람 | 모터 A 엔코더 C1을 빼고 실행. 이동 **1회** 뒤 0.36 s에 `stall` → 정지 → 실행 끝(`retry: 0`). 재이동·재누름 없음. `/status`는 `last_abort_reason=motion_alarm: stall`, `last_retry_count=0`, 즉석밥 `attempts 1`. 폰은 "모터가 걸려 멈췄어요. 다시 누르지 않았어요. 장치를 확인해 주세요."(칩 '안전 정지'), 키오스크는 같은 문장에 '다시 시도' 없음(k01). 10/13 결함(걸림이 '눌림 확인 실패·3회'로 보임)이 실물에서 고쳐진 것을 확인했다 |
| 3 | 키오스크 짧은 실행·정지 | 키오스크를 걸림 결과 화면에 둔 채 폰에서 실행하고, 약 0.5 s 뒤 정지했다. 정지는 **누르는 도중**(`press_start` 뒤)에 들어갔고 누름은 `stopped`로 끝났다. 정지 응답은 15.3 ms. 키오스크는 결과 화면 → 실행 중(정지 버튼) → "실행을 멈췄어요"로 이어졌고, 정지 줄 **"멈춘 것을 확인했어요 (모션 보드 응답 17 ms)"**가 실패널에 처음 보였다(k02). 폰도 17 ms |
| 3 | 자동 실행 한 줄(C2) | 키오스크 평소 화면 위에 한 줄이 떴고, 실행 중 화면에는 그려지지 않았다(k03). **문구는 아래 발견 1** |
| 4 | USB 재열거 | 처음에는 다시 열기가 실패했다(발견 2 → `ce37b81`로 고침). 고친 뒤: USB를 뽑았다 꽂음(ttyACM1→0) → `motion port lost` → `motion port reopened` → MCU `ready` → `reconnected after port loss: homed=False`. **실행기를 재시작하지 않았다.** 끊김 순간의 정지는 '확인 못 함'(잠금)이었고, 다시 정지하자 `verified` 18 ms로 풀렸다. 오늘 `Undervoltage` 0건 |
| 5 | 폰 골든 10장 | 렌더를 눈으로 보고 갱신했다(`d6b6041`). '연결을 확인해 / 주세요', 큰 글씨 승인 화면 고정 영역 축소. 재비교 55 통과. 이 데스크톱 Flutter는 `C:\flutter\flutter`라 경로 문제가 없었다 |
| 6 | 데이터 정리 | 목록을 만들어 사용자 확인을 기다린다(아래 4절) |
| 7 | 큰 글꼴·낭독 | 360×780 dp·글꼴 2.0: 홈 "세탁기 / 1단계", 승인 화면에서 할 일이 첫 화면에 보임(x01). 접근성 트리: 루틴마다 '이름·설명 → 그 루틴의 실행하기'로 따로 읽힘. **실제 TalkBack 제스처 낭독은 여전히 미확인**(adb 스와이프가 제스처로 인식되지 않음) |

## 3. 고친 것

| 커밋 | 내용 |
|---|---|
| `ce37b81` | **by-id 포트를 `--device`로 넘기면 재열거 뒤 다시 열 수 없던 결함.** `--device`는 컨테이너를 띄운 순간의 장치 번호(166:0)에 고정된다. 그래서 by-id·by-path 경로면 `-v /dev:/dev`와 `--device-cgroup-rule`(ttyACM 166·ttyUSB 188)로 넘긴다. 시험 1건(수정 전 실패 확인) |
| `d6b6041` | 폰 골든 10장 갱신(눈 검토 뒤) |

## 4. 데이터 정리 후보 (사용자 확인 대기)

- **지울 후보:** 가전 `test_microwave`(시험용 전자레인지), `custom_1790777692424`(Phone-MW), 자동 실행 규칙 `ar-75b4bbcbf9`(오늘 리허설로 만듦, 지금은 꺼짐)
- **유지:**
  - 내장 `microwave`: v4 시나리오가 이 ID를 기다린다.
  - `induction`
  - 서버 설정 `home_mw`·`washer`·`intercom`
  - 루틴 4개
  - `home_mw`의 버튼 위치(10/13 시험용 좌표지만 인계 규칙상 보정은 건드리지 않는다)

## 5. 발견

1. **[중간] 키오스크 자동 실행 한 줄이 결과를 단정한다.** 서버 기록은 `unconfirmed`("명령을 보냈지만 바뀐 것을 확인하지 못했어요")인데, 키오스크는 "마지막 작업이 끝까지 되지 않았어요"라고 보였다. 실패로 단정하지 말고 '확인하지 못했어요'로 맞춘다.
2. **[높음, 고침] 재열거 뒤 다시 열기가 컨테이너에서 막힘.** `ce37b81`.
3. [낮음] 모의 공기청정기가 이미 '강'일 때 '강'으로 바꾸라는 자동 실행은 '바뀐 것을 확인하지 못함'으로 남는다. 이미 목표값이면 "이미 강이에요" 같은 구분이 필요한지 정한다.
4. [낮음] 걸림 결과 문장 아래 '물리 버튼 · 확인 근거 없음' 줄은 여전히 시스템 용어다(키오스크).
5. [낮음] 긴 제안 큰 글씨 골든에서 가전 이름이 '에어 / 컨'으로 갈린다.
6. [운영] RPi4 케이스 팬이 GPIO 5V에 안 꽂혀 돌지 않았다. 핀 4(5V)·6(GND)에 다시 꽂았다. 온도 50.1 ℃ → 43~45 ℃. 5V 핀이라 OS를 꺼도 어댑터가 꽂혀 있으면 돈다.
7. [운영] 전원 구성 권고(사용자 질문):
   - 12 V 어댑터 하나 → 5.1 V 5 A 감압(RPi4)과 6 V 감압(모터)으로 나눈다.
   - 솔레노이드는 12 V를 직접 쓴다.
   - GND는 한 점에 묶고, 비상정지는 모터·솔레노이드 줄에만 둔다.
   - 결선에서는 멀티탭에 어댑터 두 개를 쓰는 편이 가장 안전하다. 솔레노이드 전압과 모터 전류는 HW 담당에게 확인한다.

## 6. 보드 상태

- RPi4 env는 실제 모션(serial, by-id)이다. 리허설 중 백업은 `env.bak-20261014-real`이다.
- RPi5 env에 `SIMPLELAY_SESSION_LOG_PATH=/data/session-link-20261013.jsonl`(링크 기록)을 남겼다. 리허설·ThinQ 모의 줄은 지웠고, 백업은 `env.bak-20261014`이다.
- RPi4 `run_act.sh`는 `ce37b81` 판이다(/dev 연결).

캡처: [ui-review/2026-10-14](../ui-review/2026-10-14/)
