Seongwonp/Simplelay/docs/devlog/devlog_2026-10-29-motion-bringup-verification.md

# 실물 모션 조그 및 누름 인터록 검증

날짜: 2026-10-29. 시작 기준: `7e60fb59`. 실물 하드웨어(RPi5·RPi4·ESP32 CoreXY 모션 보드) 연동 시험이다.

## 검증 내용

1. **링크 및 통신 연동:**
   - 핫스팟 서브넷(172.20.10.0/28)에서 RPi5 본체(172.20.10.6:8000), RPi4 액추에이터(172.20.10.7), ESP32 시리얼(ttyACM0) 상호 인증 연결 수립.
   - `actuator_ready: true`, 실물 모션 어댑터 정상 인식 확인.

2. **$Y$축 미세 조그 및 원점 복귀:**
   - 명시적 원점 확정(`Z` set_origin) 후 `jog y + 5` 전송.
   - 목표 `(0.0, 5.0)`에 대해 실제 도달 `(-0.03, 4.94)` (오차 0.06mm, 소요 587ms) 확인. `state: COMPLETED`.
   - 복귀 `jog y - 5` 전송. 목표 `(0.0, 0.0)`에 대해 실제 도달 `(0.0, 0.0)` (소요 314ms) 확인. `state: COMPLETED`.

3. **$X$축 조그 및 정착 타임아웃 분석:**
   - `jog x + 5` 전송: 목표 `(5.0, 0.0)`에 대해 실제 도달 `(4.94, -0.03)` 확인. `state: COMPLETED`.
   - `jog x - 5` 복귀 전송: 캐리지가 물리적으로 시작 위치(중앙 원점) 근처로 복귀 완료.
   - 복귀 직후 1.25초 경과 시점에 ESP32 펌웨어의 `FAULT_SETTLE`(`SETTLE_TIMEOUT_S = 1.0s`) 발생으로 `state: ERROR_POSITION` 송출 확인.
   - RPi5 호스트 어댑터가 이를 감지하여 `_homed = False`, `_origin_unverified = True`로 전환하고 모터를 브레이크하여 미검증 좌표 누름 방지 인터록 정상 작동 확인.

4. **$Z$축 단독 누름(`press_here`) 실물 구동:**
   - 재설정 후 `jog y + 3`으로 위치 토큰(`positionToken`) 정상 획득.
   - `press_here` 명령 전송 $\rightarrow$ `state: PRESSING` 진입.
   - 솔레노이드 누름 핀의 물리적 1회 구동(타격 및 복귀) 확인.
