Seongwonp/Simplelay/docs/devlog/devlog_2026-10-21-motion-return.md

# devlog 2026-10-21 — 레일 작업 끝난 모션 하드웨어 복귀, 첫 구동

## 1. 받은 상태

- **기계:** HW 담당이 레일 작업을 마친 갠트리와 ESP32 모션 보드를 가져왔다. 같은 보드라 by-id 경로가 그대로다.
- **펌웨어:** ESP32에는 우리 `firmware-motion-corexy`가 아니라 **Touch Bridge CoreXY v4 펌웨어**가 올라가 있다.
  - Z 작동기는 SwitchBot Bot(BLE)이다. 배너에 `Z actuator: SwitchBot Bot …`가 찍힌다.
  - 명령은 `G x y [f]`·`GT`·`T [ms]`·`H`·`S/!`·`Z`·`P`·`M a b [ms]`·`K`와 G-code(`G0/G1`·`$H`·`STOP`·`BTN_n`·`SET_GRID`)다.
  - 우리 RPi4 어댑터는 `line-json/v0`를 쓰므로 지금은 서로 말이 통하지 않는다. `status`가 `ERR UNKNOWN` 뒤 시간 초과로 끝났다.
- **RPi4:** 그래서 모의 모션(`SIMPLELAY_MOTION_MODE=mock`)을 그대로 둔다. env는 바꾸지 않았다.

## 2. Z축 선택(진행 중 — HW 담당)

- **솔레노이드의 문제:** 뒤로 튀어나오지 않는 구조다. 끝까지 클릭하면 솔레노이드 힘이 아니라 스프링 장력으로 누르게 된다.
- **후보:** ① 솔레노이드 ② SwitchBot Bot(BLE 제어). HW 담당이 BLE 제어를 확인하는 중이고, 수정한 ESP32 코드를 다음 날 보내기로 했다. RPi4 쪽 작업은 그 코드를 받은 뒤 명령 형식을 맞춰서 한다(두 번 일하지 않게).
- **SwitchBot을 쓸 때의 정직성:** '눌렀다'는 신호가 BLE 응답뿐이다. 버튼이 실제로 눌렸는지는 가전 쪽 확인(CT·가전 상태)으로만 말한다.

## 3. 첫 구동(Touch Bridge 펌웨어 `M` 명령, 시간 기준 PWM)

- **전원:** 배터리를 연결하기 전에는 `OK`만 오고 엔코더가 그대로였다(모터 전원 없음).
- **배터리 연결 뒤:**

| 명령 | 엔코더(A, B) | 펌웨어 위치(mm) |
|---|---|---|
| 시작 | (2, 20) | (0.3, −0.3) |
| `M 0.5 0.5 500` | (927, 834) | (25.2, 1.3) |
| `M -0.5 -0.5 500` | (41, 273) | (4.5, −3.3) |

- **결과:** 두 모터와 엔코더는 양방향으로 돈다. 같은 힘·시간인데 가는 길 약 25 mm, 오는 길 약 20.7 mm였고, A·B 계수 차이로 Y가 약 4.6 mm 틀어졌다. 시간 기준 PWM이라 생기는 차이로 본다(추측/측정 필요). 위치 제어(`G`)로 보는 것이 다음이다.
- **아직 안 한 것:** 원점(`H`), `G` 위치 제어, 자로 잰 mm 환산. 실제 이동 거리는 자로 재지 않았다(측정 필요).
- **도구:** 실행기를 멈추고 같은 이미지에 pyserial을 쓰는 일회용 스크립트로 한 줄씩 보냈다(저장소 밖). 끝나면 실행기를 다시 세웠다.

## 4. 같은 날 앞선 작업(10/20 밤)

- 온습도 DHT22를 RPi5 GPIO17에 연결했다. lgpio 엣지 방식으로 읽는다(`2089f499`).
- 키오스크 날짜 옆에 실측 온습도를 띄운다(`ce789b0a`).
- 실보드 화면 캡처 20장을 남겼다.

## 5. SwitchBot Z 선택 확정과 우리 안전 규약 이식

- HW 담당이 Z축을 SwitchBot Bot으로 정했다. 솔레노이드는 스프링 장력 의존 때문에 기본 대안으로만 남긴다.
- `firmware-motion-corexy`에 BLE 클라이언트 전용 선택 빌드를 더했다. 호스트 링크와 정지는 계속 USB `line-json/v0`이고,
  BLE 연결·쓰기·notify 대기는 별도 저우선순위 작업에서 처리해 CoreXY 제어와 정지를 막지 않는다.
- Bot notify 첫 바이트 `0x01`만 성공이다. 연결 실패는 `not_pressed`, write 뒤 ACK 시간 초과와 알 수 없는 상태는
  `unknown`으로 보고한다. 전송 뒤 정지는 기다림을 끝내지만 이미 보낸 press를 회수했다고 말하지 않는다.
- RPi4 어댑터는 배너의 `z_mode:"switchbot"`을 받아 시간 기반 누름 env 없이 `mode:"switchbot"`을 보내며,
  실패 결과를 같은 실행에서 자동 재누름하지 않는다. 가짜 MCU도 Bot 상태 코드·연결 실패·ACK 시간 초과·전송 뒤 정지를 흉내 낸다.
- 수정 전 회귀 시험은 7건 실패했고, 펌웨어 정적 계약 시험은 3건 실패했다. 수정 뒤 백엔드 전체 시험은
  3,679건 통과·60건 건너뜀, 문서 링크 2건과 저장소 보호 6건도 통과했다.
- 펌웨어 네 빌드가 모두 성공했다. RAM/flash 바이트는 기본 28,320/298,295, SwitchBot 47,188/1,117,742,
  bring-up 28,320/307,399, bench-home 28,320/298,207이다. 실제 Bot 누름·캐리지 이동은 아직 측정 필요다.
