Seongwonp/Simplelay/docs/devlog_2026-10-13-phone-ui.md

# 2026-10-13 폰 UI B안 — "AI 같다·불편하다" 대응 (노트북, 정지 확인 A 뒤)

근거: 저장소 밖 조사·검토 보고서(폰 UI B안 검토 §3 타일 매핑·§4 홈 선택 규칙·§5 기록 문구), [ui-review/2026-10-12](ui-review/2026-10-12/README.md),
[인계 2026-10-13 노트북](인계-2026-10-13-노트북.md) B절. 정지 문구·계약은 [A 작업](devlog_2026-10-13-stop-confirm.md)을 그대로 썼다.
키오스크·팔레트·4탭은 바꾸지 않았다. 시작 HEAD `9686264`.

## 무엇을

| 단계 | 커밋 | 내용 |
|---|---|---|
| 0 서버 | `c2e71e4` | 가전 목록과 `GET /readiness/{id}`가 한 함수(`rpi/api/readiness_view.py`)로 state·can_execute·reasons를 낸다. 순서는 실행 경로와 같다(ThinQ → 서버 구성 실행기 → 노드 → 로컬 갠트리(걸림 확인) → 없음). 모의·로컬 정상 경로는 그대로 실행된다. |
| 1 판단 함수 | `4ac9917` | `app/lib/models/display_status.dart` — 타일 상태(버튼 조작 중/모의 버튼 조작 중/실행을 확인하고 있어요/실행을 기다리고 있어요, 허브 장애 우선, 설정이 필요해요, 준비가 필요해요+서버 이유, 실행을 요청할 수 있어요, 미확인·상충은 긍정 안 함), 기록 제목(purpose → 이름+버튼 라벨 → 실행 기록), 결과·다음 행동(executionMode·route·receipt·termination·confirmation별). 과거 operationConfirmed를 지금의 운전으로 쓰지 않는다. |
| 2 기록 | `63e49bc` | 날짜 → 제목 → 결과 → 시각 → 모의 여부 → 다음 행동 → 보조 정보(버튼별 결과·직접 조작 유지). "실행 환경 미확인"·"확인 근거 없음"·"모의 실행기 응답"·"물리 버튼"을 앞에 내지 않는다. "연습(모의) · 실제로 누르지 않았어요"는 mock 기록에만. jobId가 다르면 같은 시각도 두 행. |
| 3 루틴 | `1acc219` | 행마다 편집/실행하기(둘 다 48 이상, Wrap으로 큰 글씨에서 줄바꿈, 실행 탭이 편집을 열지 않음). 실행은 편집기 '지금 실행'과 같은 `widgets/routine_run.dart`(triggerRoutine → 제안 새로 고침 → 승인 화면), 누르는 중 다른 탭 무시, 409·404는 행 아래 사람 말로. 부제는 '승인 후 실행' 반복만 빼고 조건·대상·알림만·꺼짐 유지, wash_complete → "세탁이 끝나면". 예약 칸은 예약이 있을 때만. 추천 진입 유지. |
| 4 홈 | `e5ecbd2` | 제안이 있으면 제안이 큰 자리(현행). 없으면 서버가 준 루틴 순서의 첫 적격 루틴(id·템플릿 아님·켜짐·승인·가전 조작 단계)이 큰 카드, 나머지 적격 루틴은 간결한 행(4개까지, 넘으면 루틴 탭으로). 이름 하드코딩·"추천/자주" 없음. 빈 제안 문장 제거. 설정 독촉 카드는 가전 목록 아래 작은 안내(설정 이어하기 유지). 타일은 1단계 문구, Semantics 이름에 상태 포함. 루틴 0개(가전 있음)는 "새 루틴 만들기" 하나, 조회 실패는 "루틴을 불러오지 못했어요", 가전 0개·허브 실패는 기존 안내, 실행 중 정지 줄은 그대로. |
| 5 배지 | `82cc8bf` | 설정 탭은 숫자 대신 점. 접근성 이름 "설정, 읽지 않은 알림 N건" 유지, 설정 안 건수 유지, 조회 실패는 탭·설정 안에서 0건과 다르게 말한다. 실행하기 접근성 이름에 루틴 이름(3·4단계에 포함). |
| 6 | — | **하지 않았다**(설정의 가전 목록 중복 합치기, 가전 추가 1단계 사진 먼저). 남은 일. |

## 수정 전 실패 확인

- 0단계: 새 `rpi/tests/test_readiness_list_parity.py` 5건 중 3건이 라우터 수정 전 실패 — 로컬 내장 가전 `/readiness`가 `disconnected`인데 can_execute=true, 끊긴 노드가 붙은 내장 가전이 can_execute=true·빈 사유, 비상정지 걸림인데 `/readiness`는 사유 없음. 정상 경로 2건(노드 미확인 커스텀, 준비 완료 노드)은 수정 전에도 통과(보존 시험).
- 1단계: 새 순수 함수라 수정 전에는 컴파일 실패. 옛 동작과의 차이는 2·4단계 화면 시험이 옛 화면에서 실패하는 것으로 확인했다.
- 2단계: 옛 기록 화면에서 7건 실패(시각적 배치 순서 — Text의 Y좌표 비교이고 낭독 순서는 아니다, 빈 purpose 제목, 모의 표시, 시스템 용어 등). 단 "jobId가 다르면 두 행"은 옛 화면도 두 행을 그렸고 행 키(`history-<jobId>`)가 없어서 실패한 것이다.
- 3단계: 옛 루틴 화면에서 새 시험·바뀐 시험 12건 실패.
- 4단계: 새 홈 시험 7건이 옛 홈에서 모두 실패.
- 5단계: 새 배지 시험 5건 중 3건이 옛 코드에서 실패(숫자 표시, 실패 시 접근성 이름, 설정 안 실패 문구). 나머지 2건(0건이면 점 없음, 설정 안 건수)은 보존 시험.

## 시험 수

- 백엔드+rpi4: **2,715 통과**(2,710 + 5), 12 skipped. `PYTHONUTF8=1`, `--basetemp` ASCII. 서버 변경은 0단계뿐이다.
- 폰(골든 제외): **646 중 618 통과, 28 실패.** 실패 28건은 시작 HEAD `9686264`에서 뽑은 목록과 **이름까지 같다**(새 실패 0). 원인은 이 노트북 Flutter의 `ink_sparkle.frag` 판 불일치. 새 시험 파일 중 홈 시험은 테마를 `InkRipple`로 두어 이 문제를 피했다. `flutter analyze` error·warning 0(기존 info 4).
- 골든: 이 노트북에서 원래부터 깨진다(`screenshot_test.dart` setUpAll이 데스크톱 폰트 경로를 읽음). **갱신하지 않았다.** 홈·기록·루틴·탭바 화면이 바뀌었으므로 **데스크톱에서 골든 갱신과 다시 비교가 필요하다.**
- 키오스크: 바꾸지 않았다(재실행 안 함, 직전 262).

## 미검증

- 실제 폰 크기·200% 확대(위젯 시험의 200% 한 장면 말고는)·TalkBack 낭독 순서·전후 캡처는 데스크톱 날에 한다.
- "홈부터 실행 2회" 과업 탭 수, 설정 독촉을 아래로 내린 뒤의 발견성은 사용자 시험 전이다.
- 타일 상태는 이 폰이 추적하는 자기 job만 안다(다른 폰·키오스크 실행은 모른다) — 이번 범위의 새 기능으로 넣지 않았다.

## 남은 것·판단할 것

1. 6단계(설정 가전 목록 중복 합치기, 가전 추가 사진 먼저)는 하지 않았다.
2. (당시 기록 — 아래 '추가' 절 `2635fe5`·`bfcf52f`에서 처리) 위치를 맞췄지만 실제 확인 주행 전인 가전은 타일이 "실행을 요청할 수 있어요"이고 아래 설정 안내에만 남는다 — 타일에도 표시할지 정해야 한다.
3. 설정 탭 점은 설정 탭에만 있다(다른 탭 일관 표시는 정하지 않았다).
4. 데스크톱에서 폰 골든 갱신·비교, 에뮬레이터 캡처(전후)·TalkBack.

## 추가: 홈 가전 타일 '확인 주행' 보조 줄 (남은 것 2번, 표시만)

시작 HEAD `5feb11c`. 실행을 새로 막는 규칙은 넣지 않았다. 서버·키오스크·rpi는 바꾸지 않았다.

**조회 결과 구분.** 옛 `setupPassProvider`는 조회 실패도 `null`로 돌려 '안 함'과 '모름'이 같았다. 이제
`VerifyPassLookup`(`app/lib/models/hub.dart`) 세 가지로 돌려준다 — 결과 있음(found, pass 객체) /
서버가 기록 없음을 명시(noRecord) / 모름(unknown: 로딩·일반 404·다른 상태 코드·응답 해석 실패·예외·허브 없음).
조회는 `lookupVerifyPass`(`app/lib/widgets/appliance_setup_card.dart`).

- **서버가 '기록 없음'을 구분해 주는가:** 부분적으로. `GET /appliances/{id}/verify-pass`는 기록이 없을 때
  `404` + detail `"확인 주행 기록이 없어요"`를 보낸다(`rpi/api/mapping_router.py`). 별도 필드는 없다. 이 문장과
  정확히 같은 404만 noRecord로 보고, 그 밖의 404(옛 서버의 `Not Found` 등)는 모름이다. 서버 수정은 하지 않았다.
- **주의:** 서버는 확인 주행을 **메모리에만** 둔다(`rpi/services/verify_pass.py`). 그래서 '기록 없음'은 '이 서버가
  켜진 뒤 기록 없음'이고, 재시작 전에 했던 확인 주행도 "확인 주행 기록이 없어요"로 보인다. 설정 안내 카드도 같은 기준
  (기록 없으면 남은 설정 1개)이라 서로 어긋나지는 않는다. 기록을 남기려면 서버 저장이 필요하다(남은 일).
- detail 문장 일치는 문구가 바뀌면 조용히 모름으로 떨어진다(안전한 쪽). 서버 문장을 바꿀 때 함께 고쳐야 한다.

**표시 규칙**(`verifyPassTileNote`, `app/lib/models/display_status.dart`, 상태 줄과 별개의 보조 줄):

| 근거 | 보조 줄 |
|---|---|
| 실제(real) 확인 주행 완료 | 없음 |
| 모의 확인 주행 완료 | 모의 주행만 확인했어요 |
| 실제 확인 주행 실패 | 확인 주행을 마치지 못했어요 |
| 서버가 기록 없음을 명시 | 확인 주행 기록이 없어요 |
| 조회 실패·로딩·근거 불명 | 확인 주행 여부를 확인하지 못했어요 |

- 근거 불명에 넣은 것(판단): 진행 중(running), `execution_mode`가 없는 완료·실패(원격 주행이 모드를 말하기 전), 모의 실패.
  모의 실패는 실제로 움직인 근거도 실패한 근거도 아니므로 '마치지 못했어요'로 말하지 않았다.
- 붙이지 않는 타일: 확인 주행 개념이 없는 가전(서버 내장·ThinQ·데모), 위치 미설정("설정이 필요해요"),
  허브가 연결 상태가 아님(닿지 않음·키 필요·미설정·**확인 중** 포함), 가전 목록 조회 실패(상태 줄이 "연결을 확인해 주세요").
  확인 중을 뺀 것은 상태 줄이 이미 "확인하는 중이에요"라 '확인하지 못했어요'를 겹쳐 말하지 않기 위해서다.
  가전 목록 로딩 중(상태 줄 "확인하는 중이에요")은 허브 장애가 아니라 규칙대로 붙인다.
- 보조 줄을 붙일 타일만 확인 주행을 묻는다 — 위치 미설정 가전에 요청이 늘지 않는다(기존 시험 `verifyCalls` 유지).
- 타일 Semantics 이름에 보조 줄을 넣었다(`excludeSemantics`라 Text만으로는 안 읽힌다).

**수정 전 실패 확인.** 새 순수 함수·조회 시험(`test/models/verify_pass_note_test.dart` 15건)은 수정 전 컴파일 실패.
새 화면 시험(`test/screens/home_verify_note_test.dart` 6건)은 수정 전 4건 실패(보조 줄·접근성 이름·200% 화면), 2건은 보존 시험
(위치 미설정·허브 장애 타일에 보조 줄 없음)이라 수정 전에도 통과. 200% 시험은 360×780·`TextScaler.linear(2.0)`에서
넘침 없음, 보조 줄 타일과 가전 추가·실행하기가 겹치지 않음, 각 버튼 가운데 hitTest가 그 버튼에 닿음을 본다.
`ux_input_test.dart`의 provider 재정의만 새 형식으로 바꿨다.

**시험 수.** 폰(골든 제외) **667 중 639 통과, 28 실패**(646 + 새 21). 실패 28건은 수정 전 목록과 **이름·오류 첫 줄 원문이 모두 같다**
(전부 `Exception: Asset 'shaders/ink_sparkle.frag' manifest could not be decoded: INVALID_ARGUMENT:`, 이 노트북 셰이더 판 불일치).
`flutter analyze` error·warning 0(기존 info 4). 골든은 갱신하지 않았다 — 홈 타일이 바뀌었으니 데스크톱에서 갱신·비교가 필요하다.
백엔드·키오스크는 바꾸지 않아 재실행하지 않았다.

**남은 것.** 서버의 확인 주행 기록 저장(재시작하면 기록이 사라져 "확인 주행 기록이 없어요"로 보인다 — '확인 주행 전'(단정) 문구는 아래 `bfcf52f`에서 고쳤다), 기록 없음을 문장 대신 필드로 알리는 규약,
데스크톱 골든 갱신·TalkBack 낭독 확인.

### 문구 조정(같은 날, `bfcf52f`)

- 서버는 확인 주행을 메모리에만 두어 재시작하면 기록이 사라진다. 그래서 '확인 주행 전이에요'(안 했다고 단정)를 **'확인 주행 기록이 없어요'**(서버가 말한 사실 그대로)로 바꿨다. 분기 조건(정확한 서버 문장의 404만)은 그대로다.

## 추가 2: 외부 검토(폰 UI 구현) MEDIUM 4건 수리

근거: 저장소 밖 검토 보고서(폰 UI 구현 검토, 판정 '고칠 것 있음', HIGH 0·MEDIUM 4·LOW 2). 시작 HEAD `3a814ba`.
건마다 시험을 먼저 쓰고 수정 전 실패를 본 뒤 고쳤다. 서버(rpi/)는 바꾸지 않았다.

### M2 — 확인 주행 응답의 state 누락을 실패로 단정 (고침)

- 재현: `VerifyPass.fromJson`이 state가 없으면 `'failed'`를 넣었다. `GET /verify-pass`가 200 + `{"execution_mode":"real"}`이면
  found/failed/real → "확인 주행을 마치지 못했어요". 서버가 실패를 말한 것이 아니라 근거가 빠진 응답이다.
- 시험(`test/models/verify_pass_note_test.dart` +2): state 없음·null·`paused`·빈 문자열 → unknown과 "확인 주행 여부를 확인하지 못했어요",
  숫자 state(형 오류) → unknown, 모델이 state 누락을 `failed`로 읽지 않음. **수정 전 2건 실패**(found로 분류, `'failed'`).
- 수정: 누락 시 `unknown`(`VerifyPass.unknownState`), `lookupVerifyPass`는 state가 running·done·failed가 아니면 unknown.
  마법사의 폴링 종료(`!running`)는 그대로다.

### M4 — 설정 카드가 모의 실패·진행 중에도 '모의 주행을 확인했어요' (고침)

- 재현: `ApplianceSetupCard`가 `pass.isMock`만 보고 "모의 주행을 확인했어요. 실제 위치는 확인이 필요해요."를 붙였다.
  failed/mock·running/mock이면 같은 홈의 타일은 "확인 주행 여부를 확인하지 못했어요", 카드는 "확인했어요"였다.
- 시험(`test/screens/home_verify_note_test.dart` +3, 실제 HomeScreen): 모의 실패·모의 진행 중이면 화면 어디에도 "주행을 확인했어요"가 없고
  설정 카드에 타일과 같은 "확인 주행 여부를 확인하지 못했어요"가 있다(**수정 전 2건 실패**). done/mock은 카드 문구 유지(보존 시험, 수정 전에도 통과).
- 수정: 카드 문구는 done/mock에만. 위치를 맞춘 가전의 카드는 그 밖의 경우 타일과 같은 판단 함수(`verifyPassLookupNote`,
  `display_status.dart`로 분리)의 문장을 붙인다(기록 없음·마치지 못함·모름). 타일 함수는 이 함수를 그대로 부른다.

### M3 — 재연결 뒤 확인 주행 결과가 갱신되지 않음 (고침)

- 재현: `setupPassProvider`는 API 서비스만 들었다. 홈(설정 섹션)이 계속 구독하니 autoDispose되지 않고, 허브가 끊겼다 붙어도
  다시 묻지 않았다. 읽는 쪽은 `valueOrNull`이라 다시 묻는 중에도 예전 값을 썼다.
- 시험(새 `test/screens/home_freshness_test.dart` M3 3건, 실제 HomeScreen·연결 상태를 바꾸는 가짜 연결·응답을 바꾸는 가짜 허브):
  ① done/real(보조 줄·설정 카드 없음) → 끊김 → 서버가 "기록 없음" 404 → 재연결 → "확인 주행 기록이 없어요"와 설정 카드,
  ② 첫 조회 500(모름) → 재연결 → done/real이면 보조 줄·카드가 사라짐, ③ 재연결 뒤 응답이 오기 전에는 예전 done/real 대신 "확인하지 못했어요".
  **수정 전 3건 모두 실패**(다시 묻지 않음, verify 호출 수 그대로).
- 수정: provider가 "허브 연결됨" 여부를 듣고 연결이 아닐 때는 묻지 않고 모름, 다시 연결되면 새로 묻는다. 읽는 쪽은
  `setupPassLookupOf`(로딩·다시 묻는 중·오류는 모름)로 읽는다 — 홈 타일·설정 카드·설정 섹션 모두.
- 한계: 폰이 끊김을 보지 못할 만큼 짧은 서버 재시작은 여전히 모른다(연결 상태 말고 알릴 신호가 없다). 확인 주행 기록의 서버 저장은 남은 일 그대로.

### M1 — 상태가 바뀌어도 타일이 예전 '실행을 요청할 수 있어요'를 유지 (고침, 범위 한정)

- 재현: 가전 목록(준비 판정 포함)은 처음·서비스 변경·허브 재연결 때만 다시 받았다. 허브 연결을 유지한 채 로컬 갠트리에
  비상정지가 걸리면 `/status` 배너는 바뀌어도 타일은 옛 operable/true로 "실행을 요청할 수 있어요"였다. 서버 실행 거절(412)은 그대로라
  실제 실행 허용 결함은 아니고 표시 최신성 문제다.
- 시험(`test/screens/home_freshness_test.dart` M1 1건, 실제 HomeScreen·가짜 허브의 `/status`·`/appliances`): 로컬 가전 a·서버 구성 모의 가전 m이
  모두 실행 가능 → 연결 유지, 걸림 발생(목록 응답 2초 지연) → 다시 받는 동안 a에 예전 긍정 없음 → a "준비가 필요해요"+서버 사유,
  m은 그대로 "실행을 요청할 수 있어요"(폰이 일괄로 막지 않음) → 풀림 → a 다시 실행 가능. **수정 전 실패**(걸림 뒤에도 a가 긍정).
- 수정: `/status`의 로컬 실행 대상 신호(`estop_latched` 원래 값·`actuator_link_up`)를 `HubStatus.localGate`로 읽고 걸림 조회(`EstopState.localGate`,
  조회 실패·해제 직후에도 마지막 값 유지)에 담는다. 홈이 이 값의 **변화**를 들으면 가전 목록을 다시 받는다(받는 동안 loading → "확인하는 중이에요").
  어느 가전이 막히는지는 서버 `readiness_view`가 정한다. 서버는 바꾸지 않았다(이미 `/status`에 두 값이 있다).
- 처음엔 가전 목록 notifier가 듣게 했으나, 그러면 걸림 조회(5초 주기 타이머)가 모든 화면 시험에서 생겨 다른 화면 시험 23건이
  '남은 타이머'로 실패했다 — 홈에서 듣는 것으로 바꿨다(실제 앱에서는 AppShell의 비상정지 배너가 이미 이 provider를 띄운다).
- **남은 한계:** 원격 노드(ESP32 노드 등)의 준비 변화는 `/status`에 신호가 없어 연결이 유지되는 한 다시 받지 않는다(재연결·걸림/링크 변화 때만).
  주기적 목록 재조회는 이번 범위에서 넣지 않았다. 서버의 실행 거절은 그대로 최종 방어다.
- M3 커밋에 남은 시험 파일의 쓰지 않는 import(analyze warning 1)를 이 커밋에서 지웠다.

### LOW·문서 (고침)

- L1: 시험 이름을 실제 assertion에 맞춰 좁혔다 — 기록 "한 건의 시각적 배치 순서 …(낭독 순서 아님)"(`history_screen_test.dart`),
  홈 "설정 안내는 가전 목록 아래 배치(크기는 보지 않음) …"(`home_routines_test.dart`). 낭독 순서는 인계 §4 TalkBack 미검증 항목으로 남긴다.
- L2: 이 devlog 앞부분 '남은 것 2'를 당시 기록으로 표시(`2635fe5`·`bfcf52f`에서 처리), 보조 줄 절의 '확인 주행 전 오표시'를 현재 상태(기록 없음 표시, 저장은 남은 일)로,
  문구 조정 절에 `bfcf52f`를 적었다. 인계에는 `bfcf52f`와 이번 수리 커밋, 홈 360×780 시험의 범위(홈 일부 장면), 28건 비교 범위·위치를 적었다.

### 시험 수·재검증 한계

- 폰(골든 제외), 이 노트북·Flutter 3.41.6:
  - 정션 작업 폴더(`C:\dev-simplelay`): 수정 전 `3a814ba` **667 중 639 통과·28 실패**, 수리 후 **676 중 648 통과·28 실패**(+9: M2 2·M4 3·M3 3·M1 1).
    28건은 수정 전후 **이름과 오류 첫 줄 원문이 모두 같다**(전부 `Exception: Asset 'shaders/ink_sparkle.frag' manifest could not be decoded: INVALID_ARGUMENT:`).
    비교 범위는 이름·첫 줄까지이며 오류 전문·후속 assertion까지 같다는 뜻은 아니다. 목록 원본(JSON 결과)은 저장소 밖 임시 폴더에만 있다.
  - 같은 노트북의 ASCII 경로 worktree(`git worktree`, 작업 뒤 제거): `3a814ba` **667/667 통과**, 수리 후 **676/676 통과**. 28건 실패는 정션 폴더에서만
    난다 — 오류 둘째 줄이 "Unsupported runtime stages format version. Expected 1, got 2"라 그 폴더의 옛 빌드 산출물로 추정한다(지우거나 확인하지 않았다).
  - `flutter analyze` error·warning 0(기존 info 4). 골든은 갱신·실행하지 않았다.
- 백엔드+rpi4 2,715·키오스크 262는 **이전 개발자 기록**이다. 이번 수리는 서버·키오스크를 바꾸지 않아 다시 돌리지 않았고, 외부 검토도
  환경 문제(httpx 없음)로 재실행하지 못했다 — 이 두 수치는 이번에 재확인한 값이 아니다. 데스크톱에서 다시 돌려 적는다(인계 §1).
- 서버 `test_readiness_list_parity.py`의 첫 로컬 정상 시험은 완료 대기 뒤 완료 여부를 assert하지 않는다(검토 지적) — "실행 접수 보존"까지만 입증한다. 이번에는 서버를 바꾸지 않아 손대지 않았다.

### 남은 것(이번 수리 뒤)

- 원격 노드 준비 변화의 최신성(M1 한계), 폰이 끊김을 보지 못한 짧은 서버 재시작(M3 한계), 확인 주행 기록의 서버 저장.
- 인계 §1~§5(데스크톱 전체 시험·골든 눈 검토·일반 폰 높이 200%·TalkBack·전후 캡처), §6 보드 날 배포·정지 실물 확인, B 6단계.

## 에뮬레이터 확인(10/13)

노트북 에뮬레이터 + 모의 서버에서 B안 화면을 직접 써 봤다. 시작 HEAD `c2cebea`.

**확인한 것**

- 홈 '허브 연결됨' 콜드 스타트 수리(`c2cebea`) — 앱을 다시 열어도 '허브 확인 중'에 머물지 않는다.
- 200% 글자 크기에서 홈·루틴 행이 줄바꿈되고 버튼이 겹치지 않는다(눈으로 확인). **정정(외부 평가 72점 L2):** 당시 "캡처 없음"이라 적었으나
  저장소 밖 캡처 폴더의 `5-홈-200.png`·`6-루틴-200.png`가 이 확인의 캡처다 — 에뮬레이터 시스템 글꼴 크기 2.0, 앱은 `c2cebea` 빌드.
  이 캡처에서 숫자 '3'과 '단계'가 다른 줄로 떨어진 것은 아래 '외부 평가 72점 수리' L3에서 고쳤다.
- uiautomator 덤프의 노드 순서: 우리 집/허브 연결됨 → 말로 조작하기 → 아침 데우기 카드 →
  '아침 데우기 실행하기' → 가전 → '전자레인지, 실행을 요청할 수 있어요' … → 탭 '설정, 읽지 않은 알림 1건'.
  접근성 트리 순서일 뿐 **실제 TalkBack 낭독은 아니다**(TalkBack 확인은 남은 일).

**찾은 결함과 처리**

| # | 결함 | 처리 |
|---|---|---|
| 1 | 홈 '실행하기' → 승인 '지금 실행' → 실행 상태 '확인'이 이미 처리된 승인 화면("제안을 찾을 수 없어요.")으로 돌아가 갇힘 | `ecb90e9` — 승인 화면을 실행 상태 화면으로 바꿔 끼운다(`pushReplacement`). 홈·루틴 목록·편집기 '지금 실행'은 모두 `runRoutineNow`로 들어오므로 같은 수리로 출발한 곳에 돌아간다. 새 시험 2건(홈·루틴 목록 출발), 수정 전 2건 실패 — **대역 상태 화면 경로의 실패**다. 실제 StatusScreen 복귀 시험은 `d0f73ff`(아래 L1). |
| 2 | 실행이 끝난 뒤 기록 탭이 "아직 실행 기록이 없어요"(당겨야 보임) | `12f5b0f` — 기록 탭은 IndexedStack에 남아 처음 받은 목록을 썼다. AppShell이 실행 종료(완료·실패·확인 못 함)와 기록 탭 진입 때 기록을 다시 받는다(받는 동안 이전 목록 유지). 허브 연결이 없으면 '기록 없음' 대신 "기록을 불러오지 못했어요"(조회 오류는 이미 그렇게 말하고 있었다). 새 시험 3건, 수정 전 3건 실패. |
| 3 | 승인 화면 칩 "물리 버튼", 실행 상태 칩 "물리 버튼"·"모의 실행기 응답" | `cb6b80a` — 물리 경로는 "버튼을 대신 눌러요"(승인 화면·단계 줄). 실행 상태 결과 칩의 물리 경로는 결과 문장("버튼 조작을 마쳤어요"·"누름 장치가 응답했어요")과 겹쳐 뺐고 ThinQ 칩은 남겼다. 모의 보고는 "연습(모의) 결과", 근거 없음은 "눌렸는지 확인하지 못했어요"(모의면 앞에 "연습(모의) ·"). 모의 눌림·동작 확인, 실제 확인 수준 문구는 그대로. 정지 문구는 건드리지 않았다. 새 시험 6건 중 5건 수정 전 실패(ThinQ 칩 유지는 보존 시험), 기존 시험 기대 문구 3곳 갱신. |
| 4 | 첫 실행 직후 실행 상태 화면 위로 마이크 권한(음성 '멈춰')이 갑자기 뜸 | **`3bdcd11`에서 처리(아래 M3, 권한이 이미 있을 때만 듣는다).** 당시 기록: **남은 일(판단: 이번 범위 밖).** 권한 요청은 실행이 시작되는 순간 `VoiceStopController._start` → `initialize()`에서 난다. 결과를 가리지 않게 하려면 실행 전에 미리 묻는 자리(설정의 음성 정지 켜기, 또는 첫 '지금 실행' 전 설명 한 줄)나, 권한이 이미 있을 때만 듣고 없으면 묻지 않는 규칙이 필요한데 둘 다 새 화면·새 동작이라 정하지 않았다. 모의 실행은 짧아 대화상자가 결과를 가리기 쉽다. |

**시험 수(ASCII 경로 임시 worktree, Flutter `C:\src\flutter`)**: 폰(골든 제외) **688 통과**, 실패 0. `flutter analyze`
error·warning 0(기존 info 4). 골든은 갱신·실행하지 않았다 — 실행 상태·승인 화면 칩 문구가 바뀌었으니 데스크톱에서 갱신·비교가 필요하다.
백엔드·키오스크는 바꾸지 않아 재실행하지 않았다.

**한계**: 모의 서버라 세탁기·인터폰이 없어 그 화면·기록은 보지 못했다. 에뮬레이터 시간대가 UTC라 기록의 날짜 구획·시각은
실제(한국 시간)와 다르게 보였다(앱 결함 아님). 실폰·TalkBack 낭독은 미확인.

## 외부 평가(폰 UI·정지 확인, 72점) 수리 — 10/13 데스크톱

근거: 저장소 밖 외부 평가(72/100, HIGH 1·MEDIUM 5·LOW 3). 시작 HEAD `d228f9d`. 건마다 시험을 먼저 쓰고 수정 전 실패를 본 뒤
고쳤다. 정지 보고 결속(H1)·늦은 단계(M1)는 [정지 확인 devlog](devlog_2026-10-13-stop-confirm.md) 끝 절. 평가를 반박한 항목은 없다.

| 항목 | 커밋 | 처리 |
|---|---|---|
| H1 정지 보고 실행 결속 | `03ee1ae` | 정지 확인 devlog 참조(서버·폰) |
| M1 결과 먼저·단계 나중 | `29448a5` | 정지 확인 devlog 참조(폰·키오스크) |
| M5 실물 모션+모의 L3 | `32207d0` | 아래 |
| M4 실패를 '시작 못 함'+재시도로 단정 | `e3001d5`·`d471025` | 아래 |
| M2 같은 주소·키 허브 재시작 | `b6d1634` | 아래 |
| M3 실행 중 마이크 권한 창 | `3bdcd11` | 아래(결정 근거) |
| L1 복귀 시험의 대역 | `d0f73ff` | 아래 |
| L3 '단계' 말·줄바꿈 | `99adfcf` | 아래 |
| L2 ack_ms 문구·문서 | `c3ae6c9`·이 문서 커밋 | 아래, 정지 확인 devlog |

### M5 — 실물 모션 + 모의 L3를 "가전 동작도 확인했어요"로 (고침)

- 재현: `operationSentence`가 실행 모드가 mock이 아니면 L3 true를 모두 "가전 동작도 확인했어요"로 말했다. RPi4는 L3 입력의 mock 여부를
  모션 모드와 따로 보고한다(`L3_MODE=mock`). 같은 화면 아래 줄은 "모의 판정 — 실제 동작 근거는 아니에요"라 서로 모순이었고, 기존
  `operation_confirmed_test` 첫 시험이 바로 이 모순을 기대하고 있었다.
- 규칙(폰 실행 상태 화면·키오스크 완료 화면·키오스크 동작 중 화면): **출처 real만** "가전 동작도 확인했어요"(확인 아이콘·색),
  출처 mock이면 "가전 동작은 모의로 판정했어요 · 실제 확인 아님", 출처를 모르면 "가전 동작 판정의 근거를 몰라요 · 가전을 확인해 주세요",
  모의 실행이면 종전 "모의 동작 판정 · 실제 가전 아님". 키오스크 동작 중 화면은 출처를 모르는 true를 확인으로 말하던 것도 고쳤다.
- 시험: 기존 기대 문구를 정직한 규칙으로 고치고 출처(real·mock·모름) × 모션 모드(real·unknown·mock) 교차 9건(폰·키오스크 각각),
  키오스크 동작 중 화면 4건. 수정 전 폰 8건·키오스크 10건 실패.

### M4 — 실패한 실행을 "실행을 시작하지 못했어요"+다시 시도로 단정 (고침)

- 재현: `finishedMessage(failed)`가 receipt를 보지 않고 늘 "실행을 시작하지 못했어요. … 다시 시도해 주세요."였다. 접수된 뒤 일부 버튼을
  누르고 실패한 실행도 같은 문장이라, 이미 한 조작을 되풀이하게 할 수 있다. 실행 상태 화면 아래 버튼도 실패면 늘 '다시 시도'였다.
- 규칙: 미전송 근거(`receipt=not_dispatched`)가 있을 때만 "누름 장치에 보내지 못했어요. 연결 상태를 확인하고 다시 시도해 주세요."
  (ThinQ는 "명령을 보내지 않았어요. …")와 '다시 시도' 버튼. 접수됨·원인 불명은 기록 화면(`display_status.dart`)과 같은 근거 수준으로
  "끝까지 실행하지 못했어요. 가전 상태를 확인해 주세요."(ThinQ는 "가전이 명령을 실행하지 않았어요. …"), 버튼은 '확인'. 안전 정지는 종전대로.
- 시험: `failed_message_test.dart` 6건(접수 뒤 부분 실행을 실제 provider·가짜 /status로 1건 포함), `ux_result_test.dart` +4.
  수정 전 6건·3건 실패. BLE 실패·옛 서버 실패의 기존 기대 문구 2곳을 새 규칙으로 고쳤다. 골든 `status_failed` 장면 문장도 바꿨다(이미지는 데스크톱 갱신).

### M2 — 같은 주소·키로 허브가 꺼졌다 켜져도 연결 상태가 그대로 (고침)

- 재현: `RpiConnectionNotifier`는 처음·주소/키 변화·사용자 확인 때만 판정했다. 주기 `/status` 실패도 연결 상태를 바꾸지 않아, 허브가
  꺼졌다 켜져도 '연결됨'에 머물고 연결을 듣는 확인 주행 조회가 다시 묻지 않았다. 앞 절 M3 시험은 가짜 연결을 직접 바꿔 이 배선을 보지 못했다.
- 수정: 기존 5초 `/status` 조회(`estopProvider`, AppShell 배너가 늘 띄운다)의 통신 결과를 `reportHubPoll`로 넘긴다 — **연속 2번** 닿지 않으면
  '닿지 않음', 다시 닿으면 '연결됨'. 허브가 오류 코드·해석 불가로 답한 것은 닿은 것, 키 거절(401)은 연결 판정(`check`)에 맡긴다.
  확인 중·미설정·키 필요 상태는 건드리지 않는다. 새 화면·새 주기 조회 없음.
- 시험: `connection_poll_test.dart` 3건 — 실제 연결 provider·실제 걸림 조회·가짜 HTTP로 켜짐 → 꺼짐(닿지 않음, 확인 주행 모름) → 켜짐(연결됨,
  확인 주행 재조회), 한 번 실패는 그대로, 500은 닿지 않음 아님. 수정 전 첫 시험 실패(기한 초과). 고정 연결 대역(`FixedRpiConnection`)은
  주기 결과로 바뀌지 않게 했다.
- 한계: 폰이 실패를 두 번 보기 전에 돌아오는 짧은 재시작(약 10초 미만)은 여전히 모른다. 앱 복귀(resume) 때 재확인은 넣지 않았다(주기 조회가
  앱이 살아 있는 동안 돈다). 확인 주행 기록의 서버 저장은 남은 일 그대로.

### M3 — 첫 실행 중 마이크 권한 창이 실행·정지 화면을 가림 (고침, 기본 규칙)

- 결정(팀 결정 전 기본 규칙): **실행 중에는 OS 권한 창을 띄우지 않는다.** 실행 중 '멈춰' 듣기는 마이크 권한이 **이미** 있을 때만
  (`SpeechToText.hasPermission` — 묻지 않는 확인) 엔진을 열고, 없으면 그 실행은 조용히 건너뛴다. 화면 정지 버튼은 그대로다.
- 근거: ① 고령·저시력 사용자에게 실행 중 새 결정을 요구하지 않는다. ② 권한 창이 떠 있는 동안 앱의 정지 버튼에 손이 닿지 않는다 —
  정지 접근이 음성 정지보다 우선이다. ③ 권한 요청 자리는 이미 있다: '말로 조작하기' 화면의 마이크 버튼이 누를 때 `initialize()`로
  묻는다(`voice_screen.dart` `_toggle`). 거기서 허용하면 다음 실행부터 음성 정지가 듣는다. ④ 새 화면·설정(실행 전 안내, 설정 토글)은
  팀 결정 사항이라 넣지 않았다. 대가: 마이크 버튼을 한 번도 누르지 않은 사용자는 음성 정지를 못 쓴다 — 화면 정지·키오스크 정지는 그대로.
- 시험: `voice_stop_test.dart` 권한 3건 — 미허용(엔진 초기화 0회, 화면 정지 호출은 그대로), 거부 후 실행을 거듭해도 다시 묻지 않음,
  나중에 허용하면 다음 실행부터 듣고 "멈춰"가 정지로 간다. 수정 전 3건 실패. 실기기에서 권한 창이 실제로 뜨지 않는지는 미확인(에뮬레이터 날).

### L1 — 복귀 시험의 상태 화면이 대역 (고침)

- `run_return_origin_test.dart`에 실제 `StatusScreen`과 앱 라우터를 쓰는 6건을 더했다 — 홈·루틴 목록 출발 × 완료 뒤 '확인'·'닫기'·
  안드로이드 뒤로가기(`handlePopRoute`). 승인 화면을 바꿔 끼우지 않던 옛 동작(`push`)으로 되돌리면 6건 모두 실패한다. 위 표 1번의
  "수정 전 2건 실패"는 대역 경로 시험의 실패다. 편집기 출발은 같은 `runRoutineNow`라 따로 시험하지 않았다.

### L3 — '단계' 말의 혼동·숫자와 단위의 줄바꿈 (고침)

- 홈·루틴 목록 "전자레인지 3단계"는 루틴 단계 수, 실행 상태 화면 진행은 이 실행의 조작 진행(서버 `total_steps`)이다. 실행 화면 진행을
  "총 N단계 중 K단계" → **"조작 N개 중 K개"**로 바꿨다(낭독 이름은 "조작 N개 중 K개 마침"). 루틴 쪽은 그대로 '단계'.
- 숫자와 단위 사이에 단어 결합 문자(U+2060)를 넣었다. `step_wording_test.dart`가 TextPainter로 폭 600→60을 줄여 가며 숫자와 단위가 같은 줄인지
  본다 — 결합 문자가 없으면 폭 530에서 나뉨을 확인했다. 기존 기대 문구 7곳을 고쳤다. 실기기 200% 캡처는 다시 찍지 않았다(데스크톱 날).

### 시험 수(ASCII 경로 임시 worktree `C:\sl-test2`, Flutter `C:\src\flutter`)

- 폰(골든 제외) **729 통과**(688 → +41), 실패 0. `flutter analyze` error·warning 0(기존 info 4).
- 키오스크(골든 제외) **278 통과**(262 → +16), 실패 0. `flutter analyze` error·warning 0(기존 info 1).
- 백엔드+rpi4 **2,721 통과**, 10 skipped(`PYTHONUTF8=1`, `--basetemp C:\pt_tmp\…`). 첫 전체 실행에서 `test_outlet_protocol.py::test_sensor_reads_each_sample_in_order`가
  1번 실패했고 단독 3회·다음 전체 실행에서는 통과했다(부하 중 시간 의존으로 추정, 이번 변경과 무관한 콘센트 경로).
- 골든은 실행·갱신하지 않았다. 바뀌는 장면(데스크톱에서 눈 검토 뒤 갱신): 폰 `status_failed`(문장·버튼), 실행 상태 진행 줄이 있는 장면("조작 N개 중 K개"),
  루틴 부제가 보이는 홈·루틴 장면(결합 문자 — 보이는 글자는 같아야 한다). 키오스크 동작 중 장면은 모의/모의라 문구가 같다.

### 남은 것

- 키오스크 정지 줄의 "멈춘 것을 확인했어요 (n ms)"는 폰처럼 "모션 보드 응답 n ms"로 밝히지 않았다(키오스크 수정 범위 밖) — 다음에 맞춘다.
- M2 한계(짧은 재시작), 확인 주행 기록 서버 저장, 원격 노드 준비 변화 최신성, 실기기 권한 창·TalkBack·200% 재캡처, 골든 갱신, 보드 날 정지 실측.
