Seongwonp/Simplelay/docs/devlog_2026-09-13j.md

# 개발 로그 — 2026-09-13 (개발자 모드 Phase 1 · B10 · B11)

기준 HEAD: `d8a9714` → `e81e3e8`.
Phase 0 계약을 실행기에 연결하기 전에, 교차 리뷰가 지적한 **연결 방식 자체의
위험 4가지**를 먼저 보완했다. 전부 코드 대조로 실결함(설계 공백) 확인 —
오탐 없음. "Phase 0가 안전하니 연결만 하면 된다"는 낙관이 맞았다면 생겼을
결함들이다.

**검증**(이 기기, 세션 끝): 백엔드 **878** 통과 · 키오스크 **90** 통과(골든
20장 별도, 이번 변경은 골든이 찍는 상태의 픽셀을 바꾸지 않는 조건 분기라
갱신 없음) · 폰은 이번에 **건드리지 않았다**(마지막 확인 308). 키오스크
`flutter analyze` error·warning 0(기존 info 1건, exit 1은 baseline과 같다).

커밋: `32b8a29` (제어권 중재자) · `cc76714` (정지 경로 재작업) ·
`88d5349` (서버 배선) · `421c870` (B10 서버) · `effa323` (0초 duration) ·
`e81e3e8` (키오스크 B10·B11).

---

## Phase 1 — 연결 전에 보완한 계약 4가지

1. **락 역전 교착 (조회 → 획득).** Phase 0는 개발자 세션이 자기 락 안에서
   `execution_busy()`를, 실행기가 자기 락 안에서 `blocks_execution()`을
   부르는 구조였다 — 그대로 연결하면 두 락을 반대 순서로 잡는다.
   `ControlArbiter`(rpi/services/control_arbiter.py) 하나에서 확인과 점유를
   원자화했다. 중재자 락은 항상 최내곽(leaf)이고 콜백을 밖으로 부르지
   않으므로 역전이 불가능하다. 경합 테스트: 8스레드×200회 동시 보유 0,
   시작 경합 50회 반복 단독 승자.
2. **정지가 명령 처리를 기다리던 구조.** `submit()`이 상태 락을 잡은 채
   어댑터를 불렀다 — 즉시 반환하는 mock에서는 안 드러난다. **블로킹되는
   fake 어댑터**로 재현 테스트를 먼저 쓰고, 어댑터 모션 호출을 락 밖으로
   뺐다. 단순히 밖으로 옮기면 "정지 뒤에 늦은 명령이 나가는" 구멍이
   생기므로 epoch(정지마다 증가)로 감지해 즉시 재정지한다
   (`stop_after_late_command` — 어댑터 명령 흐름에서 그 명령보다 뒤라
   최종 상태는 멈춤). 어댑터 계약에 "stop은 병행 호출 가능"을 명시했다
   (실물 GRBL의 realtime stop 바이트가 이 성질이다).
3. **정지 실패 = 세션 폐기 ≠ 장치 사용 가능.** `adapter.stop()` 실패 시
   세션은 닫되 중재자에 fault(`stop_unconfirmed:*`)를 걸어 새 실행·새
   세션을 전부 409로 거절한다. 복구는 명시적 — **이후 긴급 정지가 실제로
   확인되면**(성공한 stop) 푼다. 세션 없이 실패한 정지는 잠그지 않는다
   (유휴 어댑터 단절로 시스템 전체가 잠기면 안 된다).
4. **만료·감시·배선 완성.** heartbeat 만료를 단조 시계로 판정(벽시계를
   하루 앞뒤로 틀어도 TTL 불변, 테스트로 고정), 자체 watchdog 스레드(외부
   tick 의존 제거), `close()`가 lifespan 종료 절차에서 감시 중지+열린 세션
   정지. `SIMPLELAY_DEV_MODE` 기본 OFF, 어댑터는 **무조건 mock**(실물은
   `allow_real_adapter=True` 명시 필요 — H 주차에 연다), 대상 검증을
   레지스트리에 배선(등록 가전만 세션, 등록 버튼만 press). `/stop`과
   게이트웨이 물리 E-STOP이 개발자 세션도 함께 멈춘다(개발자 쪽 정지
   실패는 fault로 잠근 뒤 삼켜 일반 정지 응답을 막지 않는다).

## B10·B11 (교차 리뷰 권고 수용)

- **B10**: 대상 없는 제안은 승인 자체를 409로 거절(카드는 pending 유지),
  `/demo/suggest`는 대상 기본값 microwave(등록 안 된 대상 404), 키오스크는
  실행 버튼을 잠그고 이유를 말한다. 리뷰 지적대로 실행 버튼이 대상 유무와
  무관하게 활성이었다.
- **B11**: `listAppliances()` 실패(null)/빈 목록([]) 분리 — 마지막 가전을
  폰에서 지워 빈 목록이 와도 이제 사실로 반영된다(선택 화면 빈 상태 +
  GridView 0열 크래시 수리). 리뷰 지적대로 `list.isEmpty` 조기 반환이
  조작판을 남겼다.
- **B12**: 키오스크 STT는 **보류 확정** — 백로그에 결정 기록.

## 지나가다 잡은 결함

`timedelta(0)`은 falsy다 — mock 실행이 시계 한 틱 안에 끝나면 0.0초
duration이 `/history`와 history.csv에서 결측(None/"")으로 둔갑했다
(`effa323`). 이번 세션 전체 실행에서 실제로 간헐 재현됐던 플레이크의
원인. 실측 표본에서 0초와 결측은 다른 데이터다.

## 완료의 경계

- **개발자 모드 API 경로·폰 화면 진입은 이번 단계에 없다.** API를 열 때는
  화면에서 숨기는 것이 아니라 **명시적 접근 제한이 선행 조건**이다(다음
  단계 Phase 2). 폰 진입 자리는 `settings/developer_section.dart` 그대로.
- 노드-가전 **대응** 검증은 "가전이 레지스트리에 있는가"까지다 — 노드 id가
  그 가전의 실제 노드인지는 실물 노드 프로토콜이 정해지는 H 주차에.
- jog 상한 5mm·heartbeat TTL 2초는 여전히 하드웨어 확인 전 임시값.
- fault는 메모리에만 산다 — 서버 재시작이 곧 해제다. mock 전용 단계라
  수용했고, 실물 어댑터를 열 때 영속화 여부를 다시 정한다.
- 긴급 정지의 **실제 기계 정지 지연**은 여전히 실기기 몫.

## 다음

**개발자 모드 Phase 2** — API 경로 + 명시적 접근 제한 + 폰
`developer_section` 진입(하드웨어가 오면 이보다 H0~H1이 먼저다).
B12는 보류 확정. H1은 하드웨어 대기.
