Seongwonp/Simplelay/docs/devlog_2026-09-13k.md

# 개발 로그 — 2026-09-13 (Phase 1.1 — 안전 경합 마감)

기준 HEAD: `dee5fb9` → `948cd00`.
Phase 1([j](devlog_2026-09-13j.md)) 직후의 재교차 확인이 남은 경합 3건을
지적했다. 전부 코드 대조로 실결함 확인(오탐 없음) — **"안전 기반 완성"이라던
직전 로그의 선언이 성급했다.** Phase 2는 이걸 닫은 다음이다.

**검증**(이 기기, 세션 끝): 백엔드 **882** 통과(+4). 폰·키오스크는 이번에
건드리지 않았다(직전 확인 308·90).

커밋: `948cd00`.

---

## 고친 것 3건

1. **정지 성공 ≠ 제어권 반납.** 이전 구현은 `adapter.stop()`이 성공하면
   즉시 DEVELOPER 제어권을 반납했다 — 그 순간 어댑터 안에서 이전 `press`가
   아직 진행 중일 수 있고, 새 일반 실행이 제어권을 얻은 뒤 그 press가
   늦게 동작하면 두 주체의 명령이 섞인다. 중재자는 소유권 중복을 막을 뿐
   **이미 진행 중인 호출을 없애 주지 않는다.** 이제 진행 중 명령이 있으면
   정지는 즉시 나가되 반납은 미룬다(stopping 상태 — holder가 DEVELOPER로
   남아 새 실행·새 세션이 409). 그 명령이 끝나는 지점(settle)이 재정지를
   확인한 **뒤에야** 반납한다.
2. **어댑터 예외도 settle을 지난다.** `_dispatch()` 예외는 inflight 정리·
   재정지 검사를 전부 건너뛰고 그대로 올라갔다 — "명령은 전달됐는데 응답
   대기 중 통신 예외"면 동작 여부 불명인데 정리가 빠졌다. 이제 정상
   반환·예외가 같은 종착점을 지난다: 예외로 끝난 명령은 정지로 정리하고
   (확인되면 세션 유지·재시도 가능), 그 정지도 실패하면 세션 폐기 + fault.
3. **start/close 원자화.** `_closed` 검사가 락 밖이라 close() 완료 직후의
   start()가 감시자 없는 세션을 만들 수 있었다. 종료 표시와 세션 생성
   판정을 같은 상태 락으로 직렬화했다. 경합 50회 반복 테스트.

## 테스트가 실제로 보장하는 범위 (문구 정정)

직전 로그의 "정지 후 다시 움직이지 않음"은 과했다. 정확히는:

- **mock 어댑터의 호출 순서 기준**으로, 정지와 경합한 명령이 있어도 어댑터에
  마지막으로 닿는 호출은 항상 stop이고(stop → 늦은 명령 → 재정지), 그
  재정지가 확인되기 전에는 어느 주체도 제어권을 얻지 못한다.
- 기존 지연 fake는 press를 **기록한 뒤** 기다려서 "정지 뒤 전달"을 재현하지
  못했다 — 전달 **직전에** 멈추는 `_GatedPressAdapter`를 추가해 그 경합을
  실제 호출 순서로 검증한다.
- **실물 기계가 그 순서대로 멈추는지는 여전히 어댑터 계약이다**: stop은
  병행 호출 가능해야 하고(GRBL realtime stop 바이트), 명령 스트림에서 stop
  뒤의 상태가 '정지'여야 한다. 이 두 성질의 실측 확인은 H 주차 몫이다.

## 다음

**개발자 모드 Phase 2** — API 경로 + 명시적 접근 제한 + 폰 진입.
하드웨어가 오면 H0~H1이 먼저다.
