Seongwonp/Simplelay/docs/devlog_2026-09-13o.md

# 개발 로그 — 2026-09-13 (Phase 1.5 — 반환의 원자화)

기준 HEAD: `654abf0` → `da39458`.
1.4가 "조건을 바꾸는 쓰기"를 원자화했는데, 재교차 확인이 **반환 그 자체**에
같은 종류의 마지막 경합을 짚었다. 실결함 확인(오탐 없음).

**검증**(이 기기, 세션 끝): 백엔드 **891** 통과(+1). 폰·키오스크 변경 없음
(직전 확인 308·90).

커밋: `da39458`.

---

## 결함과 수리

`_maybe_release_locked()`는 락 안에서 판정하고, 실제 `arbiter.release()`는
락을 놓은 뒤 호출했다. 판정~반환 사이에 새 긴급 정지가 예약되면 과거
판정대로 반환해, 정지 진행 중 새 실행이 제어권을 얻을 수 있었다.

수리: 판정·상태 갱신·중재자 반환을 `_maybe_release_locked()` 한 임계구역
에서 끝낸다. 중재자 락은 콜백 없는 최내곽(leaf)이라 기존 **개발자 락 →
중재자 락** 순서 그대로 안전하다(start()의 acquire와 같은 순서). 어댑터
호출은 계속 락 밖이다. 호출부 3곳의 락 밖 release도 제거했다 — 락 밖
이중 release는 그 사이 새로 열린 세션의 제어권을 벗겨낼 수 있었다.

## 이 세션의 테스트가 확인한 범위

- 반환 실행 지점을 게이트로 멈춘 중재자로 "판정 완료 → 반환 실행 중 →
  새 긴급 정지 시도"를 재현: 새 정지는 반환이 끝날 때까지 예약조차 못
  하고(같은 개발자 락), 반환 → 새 정지 순으로 직렬화된다.
- 역방향(정지가 먼저 예약되면 반환 보류)은 1.4의 예약 테스트가 덮는다.

**전체 안전성 검증이 아니다** — 1.1~1.5의 테스트는 각 리뷰가 지목했거나
재현한 인터리빙 조합을 mock 어댑터 기준으로 덮는다(미검증 범위는
devlog n 참조: 인터리빙 전반·실물 어댑터 계약·프로세스 경계).

## 반납 불변식 (1.1~1.5 누적, 현재 계약)

세션이 닫힌 뒤 제어권이 나가는 유일한 경로는 `_maybe_release_locked()`
이고, 그 임계구역 안에서 ① 빚 존재 ② 명령+정리 완료 ③ 진행·예약 중
정지 0건 ④ 정지 확인(또는 fault 차단) — 네 조건의 판정과 반환이 함께
일어난다. 조건을 바꾸는 쓰기(세션 무효화+정지 예약, fault 세대
비교+해제)도 각자 한 임계구역이다.

## 다음

**개발자 모드 Phase 2** — 설계 준비 가능. API를 여는 구현은 명시적 접근
제한과 함께. 하드웨어가 오면 H0~H1이 먼저다. mock·API 비노출 유지.
