Seongwonp/Simplelay/docs/devlog_2026-09-15x.md

# 개발 로그 — 2026-09-15 (폰 편집기: 사진으로 버튼 채우기) + 다음 세션 인계

기준 HEAD: `c096e29` → `c03d0de`(+ 이 기록).
서버 초안 API([w](devlog_2026-09-15w.md))를 폰 가전 편집기에 연결했다. 팀 결정에 따른
**UI 동결 예외**이며, 이 기능 외의 새 화면·기능은 계속 동결이다.

## 동작

1. 편집기 3단계에서 사진을 찍으면 "사진으로 버튼 채우기"가 나온다. 누르기 전에 "사진이 서버를
   거쳐 인식 서비스로 보내진다"고 적어 둔다 — 사진이 기기 밖으로 나가는 유일한 경로다.
2. 이미 적어 둔 버튼이 있으면 바꿀지 먼저 묻는다. 취소하면 요청을 보내지 않는다.
3. 응답 초안으로 행·열과 격자를 채우고, 결과 창에서 **이름을 읽지 못한 버튼**과 **넣지 않은 항목**을
   이유와 함께 보여 준다. 저장은 기존대로 사람이 확인한 뒤 누른다.
4. 실패는 서버 문장을 그대로 보여 준다(꺼져 있음·크레딧·사진 형식·구버전 서버 404·연결 실패·75초 초과).
   격자는 건드리지 않는다.

## 설계 결정

- **다이얼은 넣지 않는다.** 앱 가전 정의(`ApplianceButton`)에 돌리는 조작이 없어서, 넣으면
  누르는 버튼으로 등록돼 실제로 다이얼을 누르게 된다.
- **앱 격자 상한(6x6)을 넘는 초안은 잘라 넣지 않고 거절**한다(서버 상한은 8x8). 일부만 넣으면
  사진과 어긋난 배치가 저장될 수 있다.
- 요청 중에는 다시 찍기·제거·재요청을 막는다 — 중간에 사진이 바뀌면 다른 사진의 결과가 들어간다.
- 사진은 긴 변 2048px로 찍는다(글씨 판독엔 충분, 업로드 수 MB 방지). 서버 오류 문장은
  `bodyBytes`를 UTF-8로 직접 푼다 — charset 없는 JSON을 `res.body`로 풀면 한글이 깨진다.
- 파일 읽기는 `PhotoService.readBytes`로 뺐다. 위젯 테스트의 가짜 시계에서 실제 파일 입출력은 끝나지 않는다.

## 커밋

| 커밋 | 내용 |
|---|---|
| `c03d0de` | `RpiApiService.scanPanel`·`PanelScanDraft`, `panel_scan_fill.dart`(초안 → 격자 순수 함수), `PhotoService.readBytes`·촬영 크기 상한, 편집기 버튼·확인·결과·오류 창, 테스트 14 |

## 검증

- 폰 `flutter test --exclude-tags screenshot` **354 통과**(340 + 14: 초안→격자 4 · API 5 · 편집기 5).
- `flutter analyze` error·warning 0(기존 info 5).
- 골든(폰 51장)은 **재실행하지 않았다.** 사진을 찍은 뒤에만 보이는 요소라 기존 골든 구도에는 없을 것으로
  보지만 확인은 안 했다.
- 백엔드·키오스크: 이번 변경 없음(직전 1,220 · 110).
- 실제 폰·실제 서버·실제 인식 서비스로는 **확인하지 않았다**(크레딧 소진, [w](devlog_2026-09-15w.md)).

## 다음 세션 인계 (데스크톱 등)

1. `git pull` 후 이 로그와 CLAUDE.md 상단 "이어서 할 때"를 먼저 읽는다.
2. **10/1 이후** 인식 서비스 크레딧이 갱신되면 `scripts/vision_gateway_probe.py`로 실제 조작부 사진을
   확인한다(사진 입력 지원·좌표 축 순서·정확도·소요 시간). 키는 환경 변수로만.
3. 확인 결과로 필요하면 프롬프트·파서(`rpi/vision/`)만 조정하고, 폰에서 실기기로 한 번 돌린다.
4. 하드웨어가 오면 H0~H1이 먼저. 기준점(사진 좌표 ↔ 갠트리 mm) 얻는 방식을 정한 뒤 `reference_points`로 mm까지 연결.
5. 9/22 컨설팅 발표 자료는 저장소 밖 로컬 폴더에만 있다(커밋 금지).
