Seongwonp/Simplelay/docs/devlog_2026-09-17ac.md

# 개발 로그 — 2026-09-17 (9/16 작업 냉정 평가 → 수리 1단계, 나머지 인계)

기준 HEAD: `0b74fe3` → `c88e041`(+ 이 기록). **작업 중간에 노트북을 꺼서 데스크톱에서 이어간다.**
이어서 할 사람은 맨 아래 "남은 계획"부터 본다.

## 평가 (9/16 23커밋, 0381cad..0b74fe3)

테스트를 직접 다시 돌리고, 서버·화면 교차 리뷰를 따로 받은 뒤, 중요한 지적은 코드로 재현했다.

- **수치는 기록과 같았다.** 백엔드 1,241 · 폰 368 · 키오스크 117(골든 제외), analyze error·warning 0.
- **잘 된 것:** 보정 게이트(요청은 더 엄격하게만), 사진 인식 호출 상한·응답 1 MB 상한, 사진 전송 동의(매번),
  폰 버튼판(id 기준, "1·3", 실패 후 지어내지 않음).

**재현으로 확인한 문제**

| # | 문제 | 확인 방법 | 상태 |
|---|---|---|---|
| 1 | L3 5초 제한이 **누르기 전**부터 흘러, 누르는 데 몇 초 걸리면 정상 가동도 안전 정지 | 누름 6초 + 0.5초 뒤 1,200W 파형 → "확인되지 않음" | **수리 `c88e041`** |
| 2 | 로그 y "L3 대기 중 정지 수리" 테스트가 그 코드에 닿지 않음 | 판정 대기 정지 확인을 끈 변형에서도 통과 | **수리 `c88e041`** (테스트 재작성, 변형 실패 확인) |
| 3 | 로그 ab "이름이 정확히 한 번일 때만" 키오스크 테스트가 없음 | `hits.length == 1` → `isNotEmpty` 변형에서 117개 전부 통과 | 남음(2단계) |
| 4 | 대표 시연 문장 "우유 데워줘" = 해동→**시간 90초**→시작, 전자레인지 버튼맵에 "시간 90초" 없음. 키오스크 골든 입력은 '1분'으로 바뀌어 가려짐 | 규칙·버튼맵·골든 diff 대조 | 남음(3단계) |
| 5 | 홈이 "확인 중"을 끊김으로 봐 앱 시작마다 빨간 "연결 설정이 필요해요"가 맨 위에 잠깐 뜸 | `serverDown = !rpiOnline` | 남음(4단계) |

리뷰 지적 중 **직접 확인 안 한 것**(5단계에서 확인부터): 폰 버튼판 순서 배지 200% 글씨 잘림, 키오스크의
누를 수 없는 버튼판이 수동 조작 버튼과 똑같이 생김, 사진 인식 상한 0 → 기본 20, 연결 실패도 상한에서 차감
(로그 z "나간 요청만 센다"와 다름).

**과정:** 로그 aa는 "문구만" 예외였는데 같은 밤 ab에서 전역 테마·일러스트·키오스크 배치까지 넓어졌다(팀 확인).
19:19~19:56 사이 8커밋이라 "변경마다 수정 전 실패 확인" 주장이 두 곳(#2, #3)에서 사실이 아니었다.

## 1단계 — L3 수리 (`c88e041`, 푸시됨)

- 컨트롤러가 **누르기 직전마다** `note_press(button, press_number)`로 L3 검증기에 알린다.
  검증기는 샘플을 이어 넣고 **마지막 단계의 첫 누름** 시각을 기준으로 삼는다(L1 재시도는 첫 누름 기준 유지).
- 판정기: 읽지 못한 공백 뒤에는 **마지막 대기 구간**을 기준선으로 유지(끊김 없이 읽을 때 동작은 같음).
- 마지막 단계를 누르기 전부터 전력이 올라 있으면 실패(사람이 먼저 돌린 가전을 우리 결과로 치지 않음).
- 정지로 중단한 판정(`OPERATION_STOPPED_DETAIL`)만 정지로 처리 — 늦게 온 정지가 L3 실패 알림을 삼키지 않음.
- 센서를 못 읽으면(관측 시작·누름 직전·판정 중) 더 누르지 않고 안전 정지·알림.

**검증:** 수정 전 소스에서 새 테스트 7건 실패 → 수정 후 백엔드 **1,250** 통과.
결함을 되살린 변형 7종(대기 중 정지 제거, 재시도마다 기준 이동, 누르기 전 동작 판정 제거, 기준 시각 미이동,
공백 기준선 제거, 정지 플래그로 판단, 관측 실패 삼킴) **모두 실패 확인**.
테스트는 누름·재시도 대기마다 센서 시계가 흐르는 조각(`_ClockedGrbl`·`_ClockedSensor`)을 쓴다 —
`MockPowerSensor`는 누르는 동안 시각이 멈춰 1번 결함을 못 봤다.

**한계:** 검증기를 컨트롤러 없이 단독으로 부르면(note_press 없음) 기준 시각은 여전히 관측 끝이다(주석에 적음).
`PowerOperationVerifier`는 아직 실행 경로에 연결되지 않았다(실물 CT 드라이버 없음).

## 결정 사항 (사용자)

- 9/16 전역 테마·가전 일러스트 커밋: **유지**(실폰에서 확인만 따로).
- 5단계(작은 것들): **이번에 같이**.
- "우유 데워줘": 사용자가 "실제 사용과 멀고 데모 티가 난다, 즉석밥 같은 게 맞지 않나"고 물었고,
  **규칙·별칭을 삭제하고 대표 문장을 '즉석밥 데워줘'(즉석밥→시작, 실제 버튼)로 통일**하자고 제안했다.
  **최종 확인은 아직 못 받았다 — 이어서 시작할 때 한 번 확인한다.**

## 남은 계획 (순서대로, 단계마다 실패 테스트 먼저 → 수정 전 실패 확인 → 커밋)

**2단계 — 키오스크 이름 일치 테스트**
- `rpi5-touchscreen-app/test/executing_view_test.dart`에 같은 라벨이 두 번 있는 가전(`ApplianceMap(id,name,category,rows,cols,buttons)`)
  으로 `'지금 누르는 버튼'`이 없음을 확인하는 테스트 추가.
- `lib/widgets/kiosk/executing_view.dart:59`를 `hits.isNotEmpty`로 바꾼 변형에서 실패 확인 후 원복.
- 로그 y·ab의 "모두 실패 확인" 주장 정정은 이 로그로 갈음(과거 로그는 고쳐 쓰지 않음).

**3단계 — "우유 데워줘" 정리 (확인 후)**
- 보호 테스트 먼저: "전자레인지 규칙의 모든 버튼 이름이 내장 전자레인지 버튼맵(`rpi/services/appliance_registry.py`)에 있다"
  (에어컨 규칙은 서버 내장 가전이 아니라 제외) → 지금 실패해야 함.
- 제품 코드의 '우유': `rpi/intent/rules.py`(규칙·별칭), `rpi/api/router.py` 데모 보호자 알림 문구 3줄,
  주석 2곳(`app/lib/screens/home_screen.dart:428`, `voice_screen.dart:339`), `rpi/intent/vectordb_seed.py` 주석.
- `rpi/touchscreen/index.html`(옛 HTML 키오스크, '우유' 버튼 있음)은 **아직 쓰이는지 먼저 확인** → 안 쓰이면 정리 여부를 사용자에게.
- 테스트·골든: `git grep -c "우유"` 기준 약 250곳(대부분 rpi/tests). 규칙 결과를 기대하는 테스트는 즉석밥 기준으로,
  키오스크 `screenshot_test.dart`의 '1분' 입력은 실제 순서로 되돌리고 **골든 재생성 후 이미지 직접 확인**.
  `app/test/providers/suggestion_provider_test.dart`의 "버튼맵에 없는 라벨" 케이스는 의도된 불일치 테스트라 유지.
- 로컬 컨설팅 발표 자료(저장소 밖)의 키오스크 캡처 K2·K3에 "우유 데워줘"가 찍혀 있음 — 골든 재생성 후 이미지 교체.

**4단계 — 홈 "확인 중"** (`app/lib/screens/home_screen.dart:53`, `:498`)
- 테스트 먼저: `checking`·시작 직후 `unconfigured`는 맨 위 경고 없이 조용히 "연결을 확인하고 있어요",
  `unreachable`만 지금처럼 맨 위 경고.
- 기존 `app/test/screens/home_screen_test.dart`는 기본 상태(unconfigured)를 끊김으로 쓰므로 `unreachable`을 명시하도록 수정.
- 홈 골든이 바뀌면 재생성·확인.

**5단계 — 작은 것들**
- `SIMPLELAY_VISION_MAX_PER_HOUR=0` → 사진 인식 끔(지금은 기본 20), 음수·비정상 값 처리 테스트.
- 로그 z "나간 요청만 센다" → "보낸 시도(연결 실패 포함)를 센다"로 정정(새 로그에).
- 폰 `app/lib/widgets/button_map_grid.dart` `_Badge`(높이 20 고정) 200% 글씨 잘림 — 테스트로 확인 후 사실이면 수정.

**6단계 — 마무리**
- 백엔드 · 폰 · 키오스크 테스트, 두 앱 analyze, **두 앱 골든**, 새 리뷰어 교차 리뷰, 개발현황·CLAUDE.md 갱신, 푸시.

## 이어서 할 때 명령

```
git pull
.\.venv\Scripts\python.exe -m pytest -q
flutter test --exclude-tags screenshot        # app/, rpi5-touchscreen-app/ 각각
flutter test --tags screenshot                # 골든 비교(갱신은 --update-goldens 후 이미지 직접 확인)
```
