Seongwonp/Simplelay/docs/devlog_2026-10-06-desktop-s11-deploy.md

# 2026-10-06 데스크톱 — 노트북 인계 실행(M3·S11·보드 배포·보드 점검)

[노트북 인계 10/6](인계-2026-10-06-노트북.md)의 순서대로 진행했다. 모든 실행은 **모의 모션**이다. 모터·센서 실물 확인은 여전히 0건이다.

## 1. M3 — 전부 모의 등급의 정지 대기·보관 (`682715b`)

- 시뮬레이터에서 정지 버튼이 등록된 가전이면, 빠진 mm를 모의 위치로 채운 `hold` 계획을 보낸다. 상세는 [M3 devlog](devlog_2026-10-06-m3-hold-sim.md)에 있다.
- 정지 뒤 가전 상태는 '모름'으로 둔다. 그래서 결과는 `requested_unconfirmed`를 넘지 않는다.
- UART·실물 경로와 기본값은 바꾸지 않았다.
- 시험 6건은 수정 전 코드에서 6건 모두 실패하는 것을 확인했다.

## 2. S11 — 실제 15.8형 패널 화면 확인 (`66990be`, 키오스크 1.8.0)

- **방법:** RPi5 패널 화면을 캡처했다. 터치는 손 대신 터치스크린 입력 장치에 탭 이벤트를 주입했다. 사람 손 터치와 실폰은 여전히 미확인이다.
- **확인한 화면:**
  - 루틴 카드: "'아침 데우기' 루틴을 실행할까요?", 누를 순서 "전자레인지 즉석밥 → 시작", 물리 버튼 표시, 카운트다운
  - 다음에 → 평소 화면으로 복귀
  - 시작 터치 → 동작 중 → 완료
  - 폰(에뮬레이터) 기록 탭: "재시도 1회 후 성공"
- **발견해서 고친 것:**
  - 완료 화면과 동작 중 화면이 카드의 **질문**을 되풀이했다. 이제 "'아침 데우기' 루틴"으로 보인다.
  - 모의 실행인데 큰 제목이 "버튼 조작을 마쳤어요", 설명이 "누름 장치의 응답을 받았어요"였다. 이제 "모의 버튼 조작을 마쳤어요"와 "모의 실행기 응답"이다.
  - 폰 기록의 모의 행도 같은 기준으로 맞췄다.
- **설계상 그대로 둔 것:** API(폰)로 승인한 실행은 키오스크가 동작 중·완료로 따라가지 않는다. 키오스크는 자기가 시작한 작업만 따라간다.

## 3. 보드 배포

- `682715b` 기준 `git archive`로 RPi5 백엔드를 빌드했다.
- 같은 이미지를 RPi4 실행기에 적재했다. RPi5의 ssh 클라이언트가 RPi4 호스트 키 질문에서 멈춰서, 데스크톱을 거쳐 파이프로 옮겼다.
- 모의 왕복 결과: `succeeded · mock · reported`.
- **발견:** RPi4 실행기를 재시작하면 RPi5 백엔드의 `socket://` 시리얼이 끊긴 뒤 다시 붙지 않는다. 그래서 다음 실행이 실패하고, 백엔드를 재시작해야 했다. 수리는 이어서 한다.

## 4. 보드 점검(board_probe, 읽기 전용 기본 모드) (`7d8f053`)

- 설정과 원시 결과는 저장소 밖 로컬 폴더에만 둔다. 커밋하지 않는다.
- 실행 위치는 RPi5 백엔드 컨테이너와 RPi4 실행기 컨테이너다.
- **발견해서 고친 것:** D-Bus 자동 기동 금지 플래그의 이름이 틀려서(`NO_AUTO_START` → 실제는 `NO_AUTOSTART`) D-Bus 점검이 전부 미측정이었다. 테스트의 가짜 플래그도 같은 틀린 이름이라 결함이 가려져 있었다. 실제 라이브러리의 이름을 확인하는 시험을 더했다.
- **수리 뒤 결과:**
  - 측정됨: 서비스 존재·introspection, 파이썬 모듈 import, 웹 `/health`·`/status`
  - RPi4: 모듈 import, `socat`, 가상 시리얼 노드 존재
- **미확인으로 남은 것:**
  - "앱 권한" 칸은 **실패**로 나온다. root 실행은 앱 권한으로 인정하지 않는 설계 때문이다.
  - 한 서비스의 최소 호출은 내 로컬 설정이 인터페이스를 잘못 지정해 실패했다(코드 결함 아님).
  - UART를 실제로 열어 보지는 않았다(기본 모드는 열지 않는다).

## 5. 시험 (`7d8f053` 기준, 데스크톱 직접 실행)

| 대상 | 결과 |
|---|---|
| 백엔드+rpi4 | 2,422 통과(골든 없음). 셸 로캘이 cp949이면 배포 스크립트 시험 2건이 디코딩 오류로 실패하므로 `PYTHONUTF8=1`로 실행한다 |
| 폰 | 538 통과(골든 제외), 골든 55장 비교 통과 |
| 키오스크 | 246 통과(골든 제외), 골든 41장 비교 통과 |
| analyze | error·warning 0(info 폰 4·키오스크 1) |

## 6. 평가

- Copilot CLI(읽기 전용)가 매긴 점수는 **68/100**이다.
- 지적 사항:
  - HIGH: 모의 결과에서도 "가전 동작도 확인했어요"가 보인다.
  - HIGH: UART 링크가 재연결되지 않는다.
  - MEDIUM: 모의 결과에서 `state_confirmed`가 모의보다 먼저 처리된다. 모의 보관 위치 보정이 범위·간격을 검사하지 않는다.
  - LOW: 연속 실행 때 상태가 누수되는지 보는 시험이 없다. `dbus_fast`가 없으면 플래그 시험이 skip된다.
- 수리는 다음 커밋들에서 한다.

## 7. 평가 수리와 재배포

- `fbb626b`: 모의 결과에서 operation_confirmed는 "모의 동작 판정 · 실제 가전 아님", state_confirmed는 "모의 상태 확인"으로 보인다(키오스크·폰). 키오스크 **1.8.1**을 설치했고 패널에서 완료 화면을 다시 확인했다. 새 시험 5건은 수정 전에 실패했다.
- `9b0cf4d`: UART 링크가 끊기면 대기 요청을 즉시 실패시키고 래치를 '확인하는 중'으로 되돌린 뒤, 백오프로 다시 연다. hello 응답을 받은 뒤에만 실행을 연다([devlog](devlog_2026-10-06-uart-reconnect.md)).
  - 모의 보관 위치는 범위·간격 검사를 거친다.
  - 연속 실행 누수 시험을 더했다. 누수는 없었다.
- **보드 확인:** RPi5·RPi4에 재배포한 뒤 RPi4 실행기만 재시작했다. 백엔드는 `link down`을 기록한 뒤 스스로 다시 붙었다. 다음 모의 실행은 백엔드 재시작 없이 `succeeded`였다.
  - 한계: USB 시리얼을 뽑는 시험과 반쯤 열린 소켓 감지는 미확인이다.
  - 한계: 첫 연결이 실패하면 예전처럼 기동이 실패한다.
- **시험(`9b0cf4d`):**
  - 백엔드+rpi4: 2,435 통과
  - 폰: 541 통과(골든 제외), 골든 55장 통과
  - 키오스크: 250 통과(골든 제외), 골든 41장 통과
  - analyze: error·warning 0
- **남은 LOW:** `dbus_fast`가 없는 환경에서는 플래그 시험이 skip된다. 개발 `.venv`와 배포 이미지에는 `dbus_fast`가 있다.

## 다음

- 이어서 H0~H1: 실물 버튼 한 번 누름. 이번에도 여전히 0건이다.
