Seongwonp/Simplelay/docs/devlog_2026-10-06-submission-docs.md

# 2026-10-06 제출 문서 정리

## 작업 1: 시연 v3 정합성

런북의 장비·판정표·미결 1, 작품소개서, 보고서, 영상 컷을 시연 v3와 대조했다. 이미 반영된 여섯 장면은 유지하고 CT 2채널의 구현 수준, 세탁 시작과 완료 판정의 차이, 가열 허용 조건과 비상정지 확인 해제를 보완했다. S12를 [닫음 10/6]으로 표시했다.

문서의 정합성을 닫은 것이며 모터·센서 실물 검증은 여전히 0건이다. 코드·테스트는 수정하지 않았다.

## 작업 2: 보고서·소개서 본문

작품소개서는 나눔명조 11pt 기준 2쪽 편집용으로 압축하고 쪽 나눔 위치를 표시했다. 개발완료보고서는 20쪽 이하 목표의 구성·기능·시연·안전·검증·개발 과정·한계를 본문으로 작성했다. 사진과 화면은 그림 자리표시자로 남겼고 실측 없는 성능·임계값·전류값은 채우지 않았다.

보고 수치는 지정 기준 백엔드+rpi4 2,377·폰 537·키오스크 242, 골든 별도 폰 55·키오스크 41로 맞췄다. 후속 로그의 백엔드 2,415건과 다른 검증 시점임을 명시했다. 제출 체크리스트도 본문 작성 상태와 같은 수치로 맞췄다.

검증: 작업 1 뒤 저장소 보호 검사 5건 통과. 작업 2 뒤에도 지정 명령으로 5건 통과했다. 캐시 디렉터리 쓰기 권한 경고 1건은 있었으나 검사 실패는 없었다. 전체 소프트웨어 시험은 재실행하지 않았다. 최종 한글·워드/PDF 편집과 쪽수 확인, 실측, 그림 촬영은 남았다.
