Seongwonp/Simplelay/docs/devlog_2026-09-28-digital-twin.md

# 2026-09-28 — 브라우저 디지털 트윈(개념 모션) 화면

> **개념 모션 · 실제 동역학 아님.** 이 화면은 모의 실행기(`SimulatorController`)가 기록한 누름을 따라 CoreXY 캐리지를 그려 줄 뿐이다. 실제 모터·센서·벨트·속도를 재현하거나 검증하지 않는다. 커밋·푸시는 하지 않았다.

## 무엇을 보여 주나

`GET /simulator/twin` — 이전 팀 프로젝트(TouchBridge 시뮬레이션)의 **표현 방식**(가전 본체 + 조작부 버튼판 + XY 레일 + 캐리지 + 누를 때 초록으로 바뀌는 누름봉 + 단계 목록 + 기록 + 확인/취소)을 빌려, 이 저장소의 바닐라 HTML/SVG로 다시 만들었다. React·npm은 쓰지 않았다.

- **가전과 버튼맵**: `GET /appliances`의 버튼맵을 그대로 그린다. 내장 전자레인지는 편집기 격자 칸(`x`,`y`, `rows`·`cols`)만 있고 mm 좌표가 없으므로 화면에 "편집기 격자 칸 배치 · 실제 mm 좌표 아님(보정 전)"이라고 적는다. 모든 버튼에 `x_mm`·`y_mm`가 있을 때만 mm를 정규화해 쓰고, 좌표가 전혀 없으면 "임시 배치"로 표시한다.
- **CoreXY**: 모터 A/B는 프레임 아래에 고정. 이번 이동의 ΔA/ΔB와 원점 기준 누적 A/B를 숫자로 보인다(ΔA=ΔX+ΔY, ΔB=ΔX−ΔY, 조작부 범위 0~1 상대 단위). 벨트 경로·모터 회전 각도는 정지·보관 화면과 같은 개념도다.
- **Z 누름 모터**: 이동 → Z 누름 → Z 복귀를 버튼마다 반복한다. 옆 Z 막대는 가상의 전체 스트로크다.
- **원점 복귀**: 새 실행을 볼 때마다 Z를 먼저 올리고 원점(0,0)으로 가는 개념 모션부터 재생한다. **서버가 원점 복귀를 보고한 것이 아니다.**
- **정지**: 화면의 정지 버튼은 캐리지를 그 자리에 즉시 고정하고 기존 `POST /stop`을 부른다. 다른 창에서 보낸 중단(abort 프레임)을 봐도 고정한다. 이미 기록된 누름은 기록 창에 남는다.
- **실행 환경**: `/status`의 `execution_mode`(끝난 뒤에는 `last_execution_mode`)와 통신 방식(`in_memory`)을 위에 표시한다.

## 무엇을 주장하지 않나

- **결과를 만들지 않는다.** 애니메이션이 끝나도 성공·실패가 생기지 않는다. 결과는 RPi4 → RPi5 `result` 프레임(`success`, `retry`)이 있을 때만 적는다. 현행 통신은 시퀀스 전체의 성공 여부 하나뿐이라 **버튼별 성공은 표시하지 않고** 버튼별 "누름 기록 N회(재시도 포함)"만 적는다.
- 누름 기록은 모의 실행기 내부 관측(`act_local.presses`)이다. 허브가 받은 결과와 다른 층의 근거다.
- 같은 이름이 연달아 오는 시퀀스(예: 10초 → 10초)는 재시도와 다음 단계를 구분할 근거가 없어 "구분 불가"로 표시한다.
- 모션은 기록을 뒤따라 재생하므로 서버 보고가 먼저 도착할 수 있다. 재생 시간은 화면 속도이며 장치 속도·정지 지연이 아니다.
- 정지 요청이 마지막 버튼 뒤에 도착하면 서버는 성공을 보고할 수 있다(실제로 확인). 화면은 서버 보고를 그대로 적는다.
- 정지 버튼 대기·가전 종료 확인·보관 이동은 [정지·보관 모의 동작](정지-보관-모의동작-2026-09-27.md) 화면이 담당한다. 이 화면은 그 상태 기계를 복제하지 않고 링크만 둔다.

## 미리보기 모드

"미리보기(서버 호출 없음)"를 고르면 선택한 시퀀스(가전 버튼맵에 있는 이름만)를 원점 복귀부터 재생한다. `/execute-buttons`를 부르지 않고 결과도 만들지 않으며, 화면에 "미리보기 · 서버 실행 아님"이라고 크게 표시한다. 미리보기 중에 서버에서 모의 실행이 시작되면 실행 따라가기로 자동 전환한다.

## 구현

| 파일 | 내용 |
|---|---|
| `rpi/touchscreen/twin.html` | 화면(SVG `#twinCanvas`, 단계 목록, 서버 보고, 기록, 확인/취소) |
| `rpi/touchscreen/twin-motion.js` | 순수 모듈: CoreXY 변환·역변환, 버튼맵 배치, 시간 기반 모션 엔진(원점·이동·누름·복귀, 정지 시 고정), 서버 추종기(새 누름 기록만 반영, 반복 조회 무시, 끝난 실행은 다시 재생하지 않음) |
| `rpi/services/twin_view.py` | 읽기 전용 요약: 마지막 execute 프레임, 같은 sequence_id의 result, abort 여부, 누름 기록의 단계 대응. 새 실행 시작 전 남아 있는 이전 누름 기록은 붙이지 않는다 |
| `rpi/api/simulator_router.py` | `GET /simulator/twin`, `GET /simulator/twin/state`, `GET /simulator/twin-motion.js` — 기존 `require_simulator` 가드(SimulatorController가 아니면 404) |

## 실행

```powershell
.venv\Scripts\python.exe -m rpi.simulator_main --port 8765
```

브라우저에서 http://127.0.0.1:8765/simulator/twin. "이 시퀀스로 모의 실행" → 확인 후 시작. 재시도는 `/simulator` 패널의 실패 주입(2회 실패 후 성공 · 3회 실패 안전 중단)으로 확인한다.

## 검증

- JS: `node --test rpi/tests/*.test.cjs` **12건 통과**(기존 CoreXY 미리보기 4 + 트윈 8: CoreXY 변환·역변환, 격자/mm/임시 배치, 원점→이동→누름→복귀 순서와 누적 A/B, 이동 중 정지 고정, 움직임 줄이기, 완료 시 결과 미생성·반복 조회 무시, 서버 abort 고정·끝난 실행 재생 안 함, 버튼맵에 없는 이름 보고).
- Python: `rpi/tests/test_twin_view.py` **7건 통과**(요약 규칙, 라우트 3종 제공, 비시뮬레이터 404, 실제 SimulatorController로 2회 재시도 성공과 실행 중 정지).
- 변형 확인: 이전 누름 기록 차단을 없애면 Python 1건, 추종기가 반복 조회마다 다시 넣게 바꾸면 JS 1건이 실패하는 것을 확인하고 원복했다.
- 백엔드 전체: **1,651 통과**, 실패 1(`dbus_fast` 미설치), 오류 41(임시 폴더 `PermissionError`) — 둘 다 이 PC 환경 문제로 이번 변경과 무관.
- 서버: `python -m rpi.simulator_main --port 8771`에서 `curl`로 `/simulator/twin` 200·`twinCanvas` 포함, 스크립트 200 확인. 내장 브라우저로 실행 따라가기(성공, 2회 실패 주입 뒤 정지 → `success=false` 보고와 캐리지 고정), 미리보기(서버 작업 번호 변화 없음)를 확인했다. 확인 후 서버를 종료했다.
- 내장 브라우저 창이 `requestAnimationFrame`을 멈추는 경우가 있어 100ms 간격 보조 그리기를 넣었다(시간 기반이라 위치는 같다).

## 남은 것

- 실제 mm 좌표·보정 결과가 들어오면 같은 화면이 mm 배치로 바뀌지만, 축척·원점은 여전히 개념이다. 실제 트윈에는 모션 MCU의 위치 보고가 필요하다.
- 통신에 버튼별 결과·진행 이벤트가 없어 모션은 누름 기록 폴링(400ms)에 기댄다.
- 실제 모터 방향·풀리 반경·RPM·Z 스트로크는 하드웨어 실측 후에 정한다.
