Seongwonp/Simplelay/docs/devlog_2026-09-17ad.md

# 개발 로그 — 2026-09-17 (로그 ac 남은 계획 2~6단계)

기준 HEAD: `adcee70` → `8e38001`(+ 이 기록). 데스크톱에서 이어갔다.
[로그 ac](devlog_2026-09-17ac.md)의 "남은 계획"을 순서대로 끝냈다.
3단계("우유 데워줘" 정리)는 시작 전에 사용자 확인을 받았다.

## 커밋

| 단계 | 커밋 | 내용 |
|---|---|---|
| 2 | `175d1a8` | 키오스크: 같은 이름 버튼이 둘인 가전에서 버튼판이 자리를 가리키지 않음을 테스트로 고정 |
| 3 | `3a4a80e` | '우유 데워줘' 규칙·별칭 4개 삭제, 대표 명령을 '즉석밥 데워줘'(즉석밥 → 시작)로 통일 |
| 4 | `4377f3c` | 폰 홈: 서버 확인 중(checking·unconfigured)을 끊김으로 보지 않음 |
| 5 | `c7182e2` | 사진 인식 시간당 상한 `0` = 끔(503). 음수·잘못된 값만 기본값 20 |
| 5 | `bec163d` | 폰 버튼판 순서 배지가 200% 글씨에서 숫자를 자르지 않게 |
| 5 | `8e38001` | 키오스크 실행 화면 버튼판: 지금 칸만 면을 채우고 나머지는 옅은 윤곽만 |

## 단계별 기록

**2단계**
- 새 테스트는 `hits.length == 1` → `hits.isNotEmpty` 변형에서 실패하고 원래 코드에서 통과한다.
- 로그 ab의 "이름 매칭을 느슨하게 한 변형에서 실패 확인" 주장은 다음과 같이 정정한다. 당시 변형(`isNotEmpty ? first : 첫 버튼`)은 이름이 없는 경우만 잡았고, 이름이 겹치는 경우는 이번에 처음 고정했다.

**3단계**
- **보호 테스트:** "전자레인지 규칙의 모든 버튼 이름이 내장 전자레인지 버튼판에 있다"(에어컨 규칙 제외). 수정 전 규칙에서 `{'우유 데워줘': ['시간 90초']}`로 실패하는 것을 확인했다.
- **옛 HTML 키오스크(`rpi/touchscreen/index.html`):** `/ui`로 아직 서비스되고 있어 지우지 않았다. 자리표시 문구와 버튼맵만 내장 전자레인지와 맞췄다('우유'·'자동조리' → '즉석밥'·'냉동식품', '라면' 추가).
- **테스트:** 문장은 '즉석밥 데워줘'로 바꿨다. 버튼이 3개에서 2개로 줄며 기대값이 두 곳 바뀌었다(노드 요청 타임아웃 48초 → 42초, 결과 버튼 3개 → 2개). '버튼맵에 없는 라벨'을 일부러 쓰는 케이스 2곳은 유지했다.
- **골든:** 두 앱 모두 규칙과 같은 실제 순서로 바꿨다.
  - 키오스크 실행 입력은 '1분'에서 '시작'·'즉석밥'으로 바꿨다. 로그 ab에서 버튼판이 보이게 하려고 '1분'으로 바꾼 것이 원래 불일치를 가리고 있었다.
  - 폰 골든의 '즉석밥 → 1분 → 시작' 예시도 '즉석밥 → 시작'으로 맞췄다.
  - 갱신한 이미지는 직접 확인했다.
- **문서:** README·아키텍처·폐루프 설계·추론 경계·프로토콜·데모 시나리오·개발현황의 예시를 바꿨다. 규칙·별칭 개수도 실제 값(10종·33종)으로 고쳤다. 원래도 7종·21종으로 오래된 값이었다. 지난 devlog와 결선로드맵의 완료 체크 항목은 당시 기록이라 그대로 뒀다.

**4단계**
- 주소는 불러온 뒤 항상 기본값이 들어가므로, `unconfigured`는 앱 시작 직후에만 나오는 상태다. 설정에서 주소를 지워도 기본값으로 바뀐다(리뷰에서도 확인).
- 확인 중에는 맨 위 경고를 띄우지 않는다. 가전 상태 줄은 '연결을 확인하고 있어요'로 나오고, 예비 연결이 꺼졌으면 아래에 조용히 알린다.
- 테스트 도우미 `FixedRpiConnection`은 `check()`를 막아 상태가 스스로 바뀌지 않게 한다. 새 테스트 3건은 수정 전 코드에서 실패했다.
- 홈 골든은 `unreachable`로 고정해 기존 화면을 그대로 비교한다.

**5단계**
- **호출 상한 0:** 인식 서비스로 보내지 않고 503을 돌려준다. 수정 전 코드와 "0을 기본값으로" 되돌린 변형에서 테스트 실패를 확인했다.
- **로그 z 정정:** 로그 z는 상한이 인식 서비스로 "나간 요청"을 센다고 적었다. 실제로는 **보내려 한 시도**(연결 실패 포함)를 센다. 코드 주석과 개발현황 설정 표도 맞췄다.
- **배지 잘림:** 테스트로 먼저 확인했다. 200% 글씨에서 숫자 높이는 34인데 배지는 20이었다. 최소 20x20만 두고 글자에 맞춰 늘어나게 했다. 보통 크기에서는 골든 변화가 없다.
- **키오스크 버튼판 칸:** 골든으로 보니 수동 조작 칸과 같은 면색·테두리였다. 테스트는 수정 전 코드에서 실패했다.

## 검증 (이 기기)

| 대상 | 결과 |
|---|---|
| 백엔드 | **1,252** 통과(+ rpi4 59) |
| 폰 | **372** 통과(골든 제외) · 골든 **51장** 비교 통과 · `analyze` error·warning 0(기존 info 5) |
| 키오스크 | **119** 통과(골든 제외) · 골든 **26장** 비교 통과 · `analyze` error·warning 0(기존 info 1) |

- **변경마다 실패 확인:** 새 테스트는 수정 전 코드나 결함을 되살린 변형에서 실패하는 것을 커밋 전에 확인했다.
- **교차 리뷰:** Copilot CLI로 `adcee70..HEAD`를 읽기 전용으로 리뷰받았다. 결함은 없었다. 확인한 항목은 남은 '우유'·'시간 90초' 의존, `unconfigured`가 생기는 경로, 상한 0의 409·429 순서, 헛도는 테스트다. 리뷰 전후로 저장소 변경이 없는 것도 확인했다.

## 남은 것

- **컨설팅 캡처:** 저장소 밖 로컬 컨설팅 자료(zip·pptx)의 키오스크 캡처 K2·K3에는 여전히 "우유 데워줘"가 찍혀 있다. 교체하려면 자료를 다시 묶어야 해서 사용자 결정을 기다린다.
- **폰 홈 제안 행 이름:** 제안 행의 단계 미리보기가 전역 표 이름을 써서, BT-03이 버튼 라벨 '1분'이 아니라 '1분 추가'로 보인다. 대상 가전의 라벨을 쓰도록 맞출지는 다음에 본다.
- **실물 확인:** 하드웨어 도착 후 실물로 확인할 것들은 로그 ab "남은 것"과 같다.

## 후속 — Copilot 전체 평가와 두 가지 정리

2~6단계를 끝낸 뒤 Copilot CLI에게 프로젝트 전체를 읽기 전용으로 냉정하게 평가받았다.

**평가:** 종합 4.5/10. 가장 낮은 항목은 실제 하드웨어 통합(1/10)과 시연 재현성(3/10)이다.
mock 위의 계약·테스트는 정리돼 있지만, 결선의 핵심인 실제로 누르고 센서로 확인하는 폐루프는
실물이 하나도 검증되지 않았다는 판단이다.

**평가가 짚은 위험**
- 모션·안전 장치가 mock으로 고정돼 있다.
- 센서 임계값이 추정치다.
- 긴급 정지가 협조적 정지에 그친다.
- 보정 mm와 공간 상태 머신이 실행 경로에 연결돼 있지 않다.
- 6주 남은 일정에 비해 기능 폭이 넓다.

위 위험은 CLAUDE.md·개발현황에 이미 적힌 한계와 같다. 하드웨어가 와야 닫히는 일이라
H0~H1부터 사용자와 함께 한다.

지금 할 수 있는 두 가지는 바로 고쳤다.

| 커밋 | 내용 |
|---|---|
| `0e3c36a` | 긴급 정지 뒤 화면이 장치가 멈췄다고 단정하지 않는다. 키오스크는 '안전하게 멈췄어요' → '실행을 멈췄어요. 장치가 완전히 멈췄는지 확인한 뒤 다시 시도해 주세요', 폰은 safety_stopped에 확인 안내를 붙였다. 테스트 2건은 수정 전 코드에서 실패했다. |
| (이 기록) | 개발현황 표에 읽는 법을 적었다. 긴급 정지·위험소리·배포·모션 어댑터·L1~L3·CT 판정기·공간 상태 행의 ✅ 옆에는 '협조적 정지', '가짜 입력', '실행 경로 미연결', '호출 코드 없음'을 명시했다. |

**검증:** 폰 **373** · 키오스크 **120**(골든 제외) 통과, 골든 51·26 비교 통과, analyze error·warning 0.
백엔드는 이 후속에서 바뀌지 않았다(1,252).

**다음:** 하드웨어 도착 후 H0~H1([하드웨어 연결 설계](하드웨어-연결-설계.md) §6).
그 전에는 새 기능을 만들지 않는다.
