Seongwonp/Simplelay/docs/devlog_2026-09-16ab.md

# 개발 로그 — 2026-09-16 밤 (화면 개선 2~5순위)

기준 HEAD: `643aee7` → `096de7f`(+ 이 기록).

[로그 aa](devlog_2026-09-16aa.md)의 "남은 것"을 팀(박성원·서예솔)이 열었다. 15인치 키오스크의
배치 변경도 이때 함께 허용했다. 원칙은 두 가지다.

- **정보를 늘리지 않는다.** 빈 자리에는 이미 있는 것을 보이게 둔다.
- **보라는 주 행동·지금 진행 중·선택된 것에만 쓴다.**

## 커밋

| 커밋 | 순위 | 내용 |
|---|---|---|
| `8ec043e` | 1 | 폰 실행 상태 화면에 대상 가전의 버튼판. 끝난 버튼은 체크, 지금 버튼은 채운 면, 남은 버튼은 테두리와 번호. 제안 화면과 공용 위젯(`ButtonMapGrid`) |
| `7ad150f` | 2 | 폰 보라 축소. 테마의 글자·테두리·보조 면을 중립색으로, 테두리·글자 버튼을 무채색으로. 순서 번호·안내 아이콘·진행 막대의 끝난 칸도 무채색 |
| `eac116c` | 3 | 사진 없는 가전 그림 6종을 옅은 선에서 무채색 평면 일러스트로 |
| `6bfb0c8` | 4 | 키오스크 대기 화면: 오른쪽 시작 판, 5px 상태 점 제거, '설정 · 길게 누르기' |
| `498fe38` | 4 | 키오스크 실행 화면: 오른쪽에 버튼판(지금 누르는 버튼), 긴급 정지를 짙은 빨강(#A8201A)과 흰 글자로 |
| `096de7f` | 4 | 키오스크 제안 질문을 뜻 단위 두 줄로, 정보용 보라를 무채색으로 |

## 판단 기록

- **폰 버튼판**
  - 대상 가전을 모르면 그리지 않는다.
  - 실패·확인 불가 상태에는 '지금' 버튼을 그리지 않는다. 서버가 어느 버튼에서 실패했는지 말해 주지 않기 때문이다.
  - 같은 버튼을 두 번 누르면 순서 번호를 '1·3'처럼 둘 다 적고, 남은 차례가 있으면 끝난 것으로 그리지 않는다.
- **키오스크 버튼판**
  - 서버가 버튼 **이름**만 준다. 대상 가전에서 그 이름이 정확히 한 번 나올 때만 자리를 가리킨다.
  - 끝난 버튼은 표시하지 않는다. 키오스크는 단계 ID 목록을 받지 않아서 알 수 없다.
- **칸 높이**
  - 폰 버튼판 칸 높이를 52px 고정에서 글자에 맞춰 늘어나게 바꿨다. 200% 글씨에서 '냉동식품'이 잘리던 문제는 제안 화면에도 있었다.
  - 이 결함은 Stack이 넘쳐도 오류를 내지 않아 레이아웃 테스트가 못 잡았다. 처음 쓴 테스트도 글자 상자가 칸 제약으로 잘린 크기로 보고돼 헛돌았다. 실제 글자 높이(`textSize`)와 비교하도록 고친 뒤, 수정 전 코드에서 실패하는 것을 확인했다.
- **한글 줄바꿈**
  - 한글은 글자 단위로 줄이 바뀐다. 키오스크의 '시 / 작하세요', '할까 / 요?' 끊김은 폭 조정이 아니라 뜻의 경계에서 직접 나눠 고쳤다.
  - 낭독(TTS·Semantics) 문구는 한 줄 그대로 뒀다.
- **긴급 정지 색**
  - 대비 목표 7:1을 유지하려고 흰 글자 기준 7.3:1인 짙은 빨강을 골랐다. 어두운 바탕과의 경계는 흰 외곽선 3px이 맡는다.
  - 폰 실행 화면의 정지 버튼은 이번에 바꾸지 않았다(연한 빨강·검정 글자 유지). 맞출지는 다음에 정한다.
- **그대로 둔 것**
  - 팔레트 값(#5729D4/#B9A6FF)과 800x480 캔버스 확대 방식은 바꾸지 않았다.

## 검증 (이 기기)

| 대상 | 결과 |
|---|---|
| 폰 | **368** 통과(골든 제외, 359 + 9) · 골든 **51장** 비교 통과 · `analyze` error·warning 0(기존 info 5) |
| 키오스크 | **115** 통과(골든 제외, 110 + 5) · 골든 **26장** 비교 통과 · `analyze` error·warning 0(기존 info 1) |
| 백엔드 | 변경 없음(직전 1,241) |

**실패 확인**

- **새 테스트:** 모두 수정 전 코드에서 실패하는 것을 확인했다.
- **"지어내지 않는다" 종류:** 조건을 느슨하게 만든 변형(중복·활성 조건 제거, 이름 매칭 완화)에서 실패하는 것을 확인했다.
- **스타일 커밋:** 2·3순위와 키오스크 보라 축소는 동작이 아니라 모양 변경이라, 골든을 갱신한 뒤 직접 열어 보고 재비교했다.
- **가전 그림:** 골든에 없는 세탁기·인덕션·밥솥은 임시로 6종을 렌더해 다크·라이트를 확인했고, 임시 파일은 지웠다.

## 후속 (같은 밤)

위 "남은 것" 셋을 이어서 처리했다.

| 커밋 | 내용 |
|---|---|
| `b312f26` | 폰 실행 화면 긴급 정지를 키오스크와 같은 짙은 빨강(`AppColors.stop`)과 흰 글자로. 두 테마 모두 같은 면 |
| `e21953a` | 키오스크 수동 조작 칸을 남는 자리만큼 키움(하한 124x66, 상한 200x96, 넉넉하면 글자 24). 재시도 중 진행 막대의 지금 칸을 주의색으로 |

**검증:** 폰 **368** · 키오스크 **117**(골든 제외) 통과. 골든 폰 51장·키오스크 26장 비교 통과,
`analyze` error·warning 0. 새·보강 테스트 3건은 수정 전 코드나 색을 되돌린 변형에서 실패하는 것을 확인했다.

## 남은 것

- 실폰·실제 15인치 패널에서 버튼판 크기, 긴급 정지 색, 수동 조작 칸 크기가 어떻게 보이는지 확인해야 한다.
  칸 상한(200x96)은 추측값이라 실물을 보고 조정한다.
