Seongwonp/Simplelay/docs/devlog_2026-09-16aa.md

# 개발 로그 — 2026-09-16 밤 (화면 평가와 1순위 수리)

기준 HEAD: `e9494ae` → `1a05f59`(+ 이 기록).

## 무엇을 했나

폰·키오스크 화면을 골든 캡처로 두 번 따로 평가했다. 하나는 이 세션, 하나는 Copilot CLI이고,
서로의 의견을 보지 않은 상태에서 받았다. 두 평가가 1순위로 같이 꼽은 **문구·상태 표시 정리**만
팀(박성원·서예솔) 확인을 받아 결함 수리로 진행했다. 화면 구성·색·레이아웃은 바꾸지 않았다.

## 평가 요지

같은 결론이 두 번 나온 것:

- 흐름·안전 설계(실행 전 확인, 실제 버튼 배치 위의 순서 표시, 긴급 정지 고정, 버튼별 실행 기록)와
  대비·큰 글씨는 상용 앱 수준이거나 그 이상이다.
- 겉모습은 시연용 프로토타입 인상이다. 근거는 다음과 같다.
  - Material 3 기본에 가까운 보라(`#5729D4`/`#B9A6FF`)를 강조할 수 있는 곳마다 쓴다.
  - 가운데 마이크가 튀어나온 5칸 탭바가 템플릿에서 흔한 모양이다.
  - 화면 아래쪽 절반이 비어 있다.
  - 가전 그림이 임시 그림처럼 보인다.
- 키오스크는 800x480 설계 캔버스를 그대로 확대(`kiosk_canvas.dart`)해서, 15인치에서 오른쪽이 빈다.

Copilot 자체 점수는 폰 6/10, 키오스크 5/10이다. 주관 점수라 근거로 쓰지 않는다.

## 고친 것 (평가 1순위)

| 커밋 | 내용 |
|---|---|
| `d20123d` | 키오스크 문구를 해요체로 통일 — 대기 '조작할 수 있어요', 위험 경보 화면·음성, 실행 실패 음성, 설정 설명 |
| `1a05f59` | 폰 홈 연결 경고를 정도에 따라 자리 잡음 + 폰 문구 해요체 통일 |

홈 연결 표시는 네 가지 상태로 나눴다. 전에는 서버가 끊기고 예비 연결로만 닿는 상태에서
"조작 가능"과 빨간 "연결 설정이 필요해요"가 한 화면에 함께 떴다.

| 서버 | 예비 연결 | 가전 상태 줄 | 연결 줄 |
|---|---|---|---|
| 됨 | 됨 | 조작할 수 있어요 | 없음 |
| 됨 | 꺼짐 | 조작할 수 있어요 | 아래, 보조색 '예비 연결 꺼짐' |
| 끊김 | 됨 | 예비 연결로 조작할 수 있어요 | **맨 위**, 주의색 '제안·기록이 멈췄어요' |
| 끊김 | 꺼짐 | 기기와 연결되면 조작할 수 있어요 | **맨 위**, 경고색 '연결 설정이 필요해요' |

의도적으로 남긴 것이 둘 있다.

- 개발자 모드 화면·서버 오류 문장의 합쇼체는 그대로 뒀다. 개발자 모드는 동결이다.
- 온보딩 '환영합니다'는 굳은 인사말이라 그대로 뒀다.

## 검증 (이 기기)

| 대상 | 결과 |
|---|---|
| 폰 | **359** 통과(골든 제외, 355 + 홈 연결 4) · 골든 **51장** 비교 통과(16장 갱신) · `analyze` error·warning 0(기존 info 5) |
| 키오스크 | **110** 통과(골든 제외) · 골든 **26장** 비교 통과(4장 갱신) · `analyze` error·warning 0(기존 info 1) |
| 백엔드 | 변경 없음, 재실행 안 함(직전 1,241) |

- **실패 확인:** 새 홈 테스트 4건은 수정 전 코드에서 4건 모두 실패했다. 경고를 아래로 되돌린
  변형에서는 자리 테스트가 실패했다.
- **골든 확인:** 갱신한 골든은 직접 열어 봤다. 주의 문구가 두 줄로 꺾여 '제안·기록이 멈췄어요'로
  줄였다. 200% 큰 글씨에서는 두 줄로 나오고 잘리지 않는다.
- **Copilot 리뷰:** 변경 리뷰는 결함 없음이었다(읽기 전용, 리뷰 전후 저장소 변경 없음 확인).

## 남은 것 (팀 결정 필요, 효과 대비 비용 순)

1. 실행 상태 화면에 실제 버튼 배치와 지금 누르는 버튼 표시 — 제안 화면 부품 재사용. 시연 효과가 가장 크다.
2. 보라 사용처를 주 행동·선택에만 줄이기(전면 팔레트 변경보다 안전). CLAUDE.md "팔레트를 임의로
   전면 변경하지 않는다"와 함께 판단한다.
3. 가전 그림을 일관된 아이콘 세트나 실제 사진으로.
4. 키오스크: 상태 점(설계 5px)을 글자 배지로, 설정 진입(2초 길게 누르기) 안내, 긴급 정지 색 강화,
   15인치 전용 배치. **마지막 항목은 "15인치라고 레이아웃을 바꾸지 않는다"(설계 문서 §0-1)와
   정면으로 부딪히므로 규칙부터 정한다.**

평가는 테스트 캡처(맑은 고딕 로딩) 기준이다. 실제 폰 글꼴·애니메이션·햅틱은 보지 않았다.
