Seongwonp/Simplelay/docs/devlog_2026-09-16y.md

# 개발 로그 — 2026-09-16 (9/15 기능 교차 리뷰와 수리)

기준 HEAD: `5549e5c` → `88b7b3b`(+ 이 기록).
데스크톱에서 9/15 작업을 받아 **평가부터 했다.** 기록된 수치는 실제와 맞았고
(백엔드 1,220 · 폰 354 · 키오스크 110), 미확인으로 남아 있던 폰 골든 51장도 돌려
통과를 확인했다. 그 뒤 교차 리뷰에서 나온 결함을 고쳤다.

## 고친 것

| 커밋 | 내용 |
|---|---|
| `0265d5f` | 보정 저장 게이트 — 요청이 오차 상한을 올리지 못하게(서버 값이 상한, 요청은 더 엄격하게만), 잉여 기준점이 없으면 거절, 대상 좌표가 한 점이면 500 대신 422 |
| `0887303` | L3 기준선을 첫 누름 **전부터** 수집(`begin_observation`), 판정 대기 중 정지 관측(`set_stop_check`), 관측 상태는 판정 뒤 비움 |
| `30aec60` | 사진을 보내기 전 **항상** 동의 창, 안내 문구에 '인터넷의 외부 인식 서비스' 명시 |
| `88b7b3b` | 기준선 수집 중에도 정지 관측, 오차 임계값 0을 기본값으로 갈아끼우지 않고 거절 |

왜 위험했나.

- 보정: `max_rms_mm`을 크게 보내면 오차가 수백 mm인 변환도 통과해 **버튼 좌표로 저장**됐다.
  affine 3점처럼 최소 개수만 주면 잔차가 항상 0이라, 기준점 하나를 잘못 찍어도 통과했다.
  실행 코드가 아직 이 mm를 읽지 않아 물리 사고로는 이어지지 않았지만, 저장은 남는다.
- L3: 전력 판정의 기준선은 '상승 직전 대기 구간'인데 어댑터가 **누른 뒤** 첫 샘플을 읽었다.
  실기기 센서는 과거 샘플을 주지 않으므로 조작 전 구간이 비고, 실제로 가전이 돌아도
  '기준선 없음'으로 실패한다. L3는 재시도가 없는 층이라 곧바로 안전 정지와 사람 호출이 된다.
- 사진: 확인 창이 '적어 둔 버튼이 있을 때'만 떠서, 새 가전에서는 **탭 한 번에 사진이 전송**됐다.

## Copilot CLI 교차 리뷰

세 커밋을 올린 뒤 `copilot -p ... --allow-all-tools --silent`로 읽기 전용 리뷰를 받았다.
두 건이 유효해 `88b7b3b`로 고쳤다(기준선 수집 중 정지 미관측, `or` 기본값으로 0이 조용히 완화).
보정 게이트와 앱 동의 흐름에는 추가 결함이 없다고 봤다.

## 문서 정정

코드와 어긋난 곳을 고쳤다.

- 하드웨어 연결 설계 §1: "보정값을 저장하는 곳은 없다 — 확인", "RPi5는 mm를 모른다"가
  9/15부터 거짓이었다. 저장이 생겼다는 사실과 게이트, **아직 이 좌표를 읽는 실행 코드가 없다**는
  경계를 적었다. 어댑터가 서버 값을 쓸지는 결정 필요로 남겼다.
- 결선로드맵: "카메라 버튼 자동 인식은 결선 이후 과제로 보류"를 현재 상태(초안까지 열림,
  실제 응답 미확인)로 고치고, 리스크 표의 컷 라인도 사진 인식 기준으로 바꿨다.
- 개발현황: 머리말 날짜, 개요의 폐루프 문장에 '모의 구동 위에서만'을 덧붙이고, 기능 행 3개와
  검증 수치를 갱신했다.
- 실측 기록표 §4-1: 9/15에 생긴 추측 수치(전력 판정 임계·기준선 창·보정 허용 오차·거리
  히스테리시스·미감지 강등)를 측정 항목으로 넣었다.
- CLAUDE.md "이어서 할 때": 동결 상태를 한 줄로 정리(9/15 예외가 전부이고 후속 UI도 동결),
  열린 일마다 **합격 기준**과 실패 시 처리를 적고, 자주 쓰는 명령을 옮겨 왔다.

## 검증 (이 기기)

| 대상 | 결과 |
|---|---|
| 백엔드 | **1,230** 통과 (1,220 + 회귀 10) |
| 폰 | **355** 통과(골든 제외) · 골든 **51장** 갱신 없이 통과 |
| 키오스크 | **110** 통과(골든 제외) |
| analyze | 폰·키오스크 error·warning 0(기존 info 5·1) |

모든 수리는 수정 전 코드에서 회귀 테스트가 실패하는 것을 확인한 뒤 커밋했다.

## 남은 것 (이번에 안 고침)

- 내장 가전 보정은 판 번호 충돌 검사를 건너뛴다 — 폰 2대가 조용히 서로 덮을 수 있다.
- 사진 인식 응답 본문 크기 제한이 없고, 호출 총량 상한도 없다(API 키가 기본 꺼짐이라
  같은 망에서 크레딧을 소진시킬 수 있다).
- 공간 상태 머신의 `begin_execution`/`end_execution`은 호출자가 없다. "AT_DEVICE에서만
  전원을 켠다"는 아직 코드가 강제하지 않는 문서상의 계약이다.
- 저장된 버튼 mm를 읽는 실행 코드가 없다. 손으로 넣은 좌표와 보정 유래 좌표를 구분하는
  장치도 아직 없다.

## 다음

CLAUDE.md "이어서 할 때"의 열린 일 순서를 따른다. 하드웨어가 오면 H0~H1이 먼저다.
