Seongwonp/Simplelay/docs/devlog_2026-09-15w.md

# 개발 로그 — 2026-09-15 (조작부 사진 → 버튼맵 초안, 서버)

기준 HEAD: `04854f7` → `2fc8b3f`(+ 이 기록).
팀 결정으로 **카메라 버튼 배치 인식**을 시작했다. 인식은 학교에서 제공하는 OpenAI 호환 LLM
게이트웨이를 쓰고, 설치 때 한 번만 쓰는 **선택 기능(기본 꺼짐)**으로 둔다
(docs/inference-boundary.md §4). 이번 범위는 서버와 확인 스크립트까지다.

## 게이트웨이 확인에서 알게 된 것

- 파이썬 기본 User-Agent(`Python-urllib`)는 앞단 방화벽이 **403 · error code 1010**으로 막는다.
  User-Agent를 지정하면 401(키 없음)로 게이트웨이까지 닿는다 — 키 없이 두 요청을 비교해 확인.
  같은 문제가 기존 의도 해석 HTTP 클라이언트에도 있어 함께 고쳤다.
- 키 인증·모델 목록 조회는 성공. 사진 요청은 **402(이번 달 크레딧 소진)** 로 거절됐다.
  크레딧 조회 API 기준 월 한도를 넘겨 남은 양이 0이고, 갱신일은 **2026-10-01**이다.
- 그래서 **실제 모델이 사진 입력을 받는지, 좌표 축 순서가 요청대로인지, 정확도는 어떤지 모른다.**

## 커밋

| 커밋 | 내용 |
|---|---|
| `f3f44fc` | 의도 해석 HTTP 클라이언트에 User-Agent 명시. 회귀 테스트는 수정 전 코드에서 실패 확인 |
| `c8d8768` | `rpi/vision/` — 인식 응답 검증(코드 블록·설명 제거, 틀린 종류·좌표는 고치지 않고 이유와 함께 제외, 겹친 검출 제거, 50개 초과 거절), 격자 초안(행·열 묶기, 8x8 초과 거절, 같은 칸 충돌 설명), 임시 이름·중복 라벨 처리, 기준점 → mm(기존 보정 검증 재사용, 프레임 밖 거절). OpenAI 호환 클라이언트(사진 무저장, 키는 오류·repr에 없음, HTTP 오류를 사용자 문장으로) |
| `2fc8b3f` | `POST /panel-scan` — 셋(주소·키·모델) 다 있어야 켜짐, 초안만 반환, 사진 형식은 머리 바이트로 판별·8MB 상한, 동시 1건(409), 크레딧·한도·연결 503 / 인증·서비스 오류 502, 기준점 주면 mm·보정 결과. `scripts/vision_gateway_probe.py`는 서버와 같은 요청·변환으로 실제 게이트웨이를 확인(키는 환경 변수로만) |

## 검증

- 백엔드 **1,220 통과**(전체). 이번 추가분 72: 초안 변환 24 · 클라이언트 22 · API 25(가짜 인식 서비스, 크레딧 0) ·
  User-Agent 회귀 1.
- 폰·키오스크 변경 없음, 재실행하지 않았다(직전 340 · 110).
- 확인 스크립트: 도움말·환경 변수 없을 때 안내(종료 코드 2)만 확인. 실제 사진 요청은 크레딧 때문에 못 했다.

## 완료의 경계

- **실제 인식 서비스 응답으로 검증하지 않았다.** 모델이 `[x_min, y_min, x_max, y_max]`가 아닌
  순서(y 먼저)로 주면 격자가 틀어진다 — 코드는 뒤집힌 좌표를 버리지만 축이 바뀐 좌표는
  구별하지 못한다. 10/1 이후 스크립트 출력의 격자를 사진과 눈으로 대조한다.
- 폰 편집기에서 이 API를 부르는 화면은 없다.
- 기준점(사진 좌표 ↔ 갠트리 mm)을 **어떻게 얻을지**는 정하지 않았다(프레임 모서리 표식 등, 하드웨어와 함께).
- 지도교수 방침("AI 고도화 금지")과의 관계는 팀이 확인한다 — 코드는 선택·기본 꺼짐으로 둔다.

## 다음

1. 10/1 크레딧 갱신 후 `vision_gateway_probe.py`로 실제 조작부 사진 확인(사진 입력·축 순서·정확도·소요 시간).
2. 폰 가전 편집기에 "사진으로 버튼 채우기" 연결 — 초안을 격자에 채우고 사람이 고친 뒤 저장.
3. 하드웨어가 오면 기준점 획득 방식 결정 → `reference_points`로 mm까지 연결.
