Seongwonp/Simplelay/docs/devlog_2026-09-15v.md

# 개발 로그 — 2026-09-15 (컨설팅 준비: 폐루프 층별 검증·전력 판정·버튼맵·좌표 보정·공간 상태)

기준 HEAD: `05331cc` → `b831fbe`(+ 이 기록).
9/22 전문가 컨설팅 준비로 **동결 예외**를 열었다. 범위는 팀 발표에서 설명하는 기능 중
**하드웨어 없이 모의 입력으로 검증할 수 있는 부분**뿐이다. 화면(UI) 변경은 없고,
개발자 모드 동결(Phase 2.1, mock 전용)도 그대로다. 발표 자료는 저장소 밖에서 만들었고
커밋하지 않았다.

## 커밋

| 커밋 | 내용 |
|---|---|
| `3ebe24d` | 폐루프 L1~L3 층별 검증·복구. L1(눌림) 실패는 위치·깊이 보정 후 재시도(버튼당 최대 3회), L2(가전 수용) 실패는 같은 입력 1회 재입력, L3(실제 동작) 실패는 자동 재시도 없이 안전 정지. 층 판정기는 선택 — 없으면 L1만 동작 |
| `1405f63` | CT 전력 파형 L3 판정기(샘플 열 입력)와 컨트롤러 연결 어댑터. 기준선(중앙값) 대비 상승·배율·유지 시간으로 작동, 저전력 유지로 완료 |
| `a43e4e2` | 버튼맵 확장 — 누름/다이얼 종류, 딸깍 수, 누름 시간, mm 좌표, 목적별 시퀀스(`"라벨"`·`"라벨:+N"`), 보정 버전. 등록 시 실행 가능성 검증, 폰 편집 저장 시 같은 칸 버튼의 mm 보존 |
| `b268acb` | 좌표 보정 변환 — 기준점 쌍으로 아핀(3점 이상)·원근(4점 이상, 정규화 DLT) 적합, 한 점·평균제곱근 오차 거절(문제 기준점 번호 포함), 행렬 기반 버전 |
| `e02bd0c` | 공간·노드 전원 상태 머신 IDLE→ROOM_PRESENT→APPROACHING→AT_DEVICE. 진입·이탈 거리 히스테리시스, 체류 조건, 미감지 강등, 실행 중 강등 보류, 귀가 신호(노드는 깨우지 않고 추천만 미리 계산) |
| `b831fbe` | API — `PUT /appliances/{id}/calibration`(검증 실패·프레임 밖·없는 버튼 422, 판 번호 충돌 409, 실패 시 저장 없음, 내장 가전 보정값은 재시작 뒤 유지), `POST /presence/distance`·`POST /presence/arriving`·`GET /presence/state`(전이와 동작 어휘만 돌려주고 실행은 노드 몫) |

## 검증

- 백엔드: `.\.venv\Scripts\python.exe -m pytest` **1,148 통과**(`b831fbe` 직전 전체 실행).
  저장소 가드 테스트는 stage 후 다시 돌려 통과.
- 폰·키오스크: 변경 없음, 재실행하지 않았다(직전 340 · 110, 골든 제외).
- 신규 기능이라 "수정 전 코드에서 실패" 확인 조건은 해당하지 않는다. 결함 수정이 아니다.

## 완료의 경계 (중요)

모두 **모의 입력 수준**이다. 발표·문서에서 "실기기 동작"으로 쓰지 않는다.

- 거리·시간·전력·오차 허용치 등 **모든 수치는 추측/측정 필요**.
- RPi4 원격 실행 결과(UART)에는 아직 층(L1~L3) 정보가 실리지 않는다.
- 전류·CT 입력부(ADC) 드라이버가 없다 — 판정기는 샘플 열을 받는다.
- 레이더 드라이버·폰 지오펜싱이 없다. 공간 상태는 관측 API로만 움직이며, 제안 보류 게이트와
  구동부 전원에는 **연결하지 않았다**. 기존 `/presence`(존재 보고·제안 보류)와는 별개다.
- 좌표 보정은 기준점 좌표를 받은 뒤의 계산·검증·저장까지다. 원점 복귀, 조작부 촬영,
  기준점 검출, 렌즈 왜곡 보정은 없다.
- 다이얼 단계는 구동부 연동 전까지 실행을 거절한다.
- 카메라 버튼 인식·설명서 파싱·모션 펌웨어·Z축 누름은 설계 단계다(코드 없음).

## 다음

하드웨어가 오면 **H0~H1(실제 한 가전 폐루프)** 이 먼저라는 순서는 바뀌지 않는다.
그 과정에서 원시 기록으로 전력·전류 임계값을 정하고, 레이더 원시 거리 기록을 모은 뒤에
공간 상태 입력을 연결한다. 동결은 이 예외 범위를 끝으로 다시 닫는다.
