Seongwonp/Simplelay/docs/devlog_2026-09-14t.md

# 개발 로그 — 2026-09-14 (키오스크 패널 7인치 → 15인치)

기준 HEAD: `a62c97f` → `c9ddc14`(+ 이 기록).
**결정: 키오스크 터치 패널을 7인치에서 15인치로 바꾼다.** 멀리서 보는 고령 사용자와
심사위원에게 가독성이 유리하다. 신규 기능은 추가하지 않았고, 패널 변경에 따른 계약과
문서만 정리했다. 과거 devlog는 당시 기록이라 고치지 않았다.

## 코드가 이미 가진 것과, 그 가정

키오스크는 800x480 고정 설계 캔버스를 화면에 맞춰 비율 확대하는 `KioskCanvas`,
15인치 위젯 테스트 1건(확대 후 터치 좌표 포함), 15인치 골든 2장(대기·제안)을 이미
갖고 있다(`09cb76c`, 9/8). 그래서 전면 재설계는 필요 없다.

다만 이 준비는 **1920x1080 가정** 위에 있다. 근거는 9/8 코드 주석·devlog의 서술뿐이고
저장소에 패널 사양표나 실측 기록은 없다. 이번 정리에서 사양을 받지 못했으므로
**모든 패널 사양을 `확인 필요`로 두었다.**

| 항목 | 상태 |
|---|---|
| 해상도·화면 비율 | 코드 가정 1920x1080 · 실제 확인 필요 |
| HDMI 연결 · 터치 인터페이스(USB HID) | 확인 필요 |
| 전원 입력 · 최대 소비전력 | 확인 필요 |
| 가로 방향 고정 · 표시 영역·베젤 · 동시 터치 수 | 확인 필요 |

1920x1080이 맞다면 배율 2.25, 그려지는 폭 1800, 좌우 여백 각 60px이다(계산).

## 커밋

| 커밋 | 내용 |
|---|---|
| `abe3977` | 전력버짓 — 7" 5 V/0.5 A 가정 제거. §2-3에 15인치 전압·대기/최대 전류·RPi5와 전원 공유 가능 여부를 측정 항목으로. 로직 합계를 화면 제외 약 14 W로 다시 더함(이전 16.5 W는 7" 포함). 전용 어댑터면 '콘센트 1개' 전제가 깨질 수 있음 명시 |
| `986a0a1` | 배포 체크리스트 — 패널 사양, 기본 해상도, 방향, 전체 화면, 부팅 자동실행, 터치 인식·좌표, 가장자리 터치, 큰 글씨, 1.5~2m 가독성, 밝기, 장시간 구동 |
| `47bc444` | 하드웨어 연결 설계 §0-1(가정과 실제 사양 구분) · H0 단계. '전용 7인치 미검증' → '15인치 터치 패널 실기기 미검증'을 README·결선로드맵·개발현황·키오스크 README·데모 시나리오·사용자편의 체크리스트에. 실측 기록표 BOM·백로그 B6 |
| `c9ddc14` | `KioskCanvas`·15인치 테스트 주석의 '받았다/지급받은 패널(1920x1080)'을 가정으로 표기. 주석만 변경 |

## 하지 않은 것

- **15인치 테스트 범위 보강(대기·선택·제안·실행·완료·수동·오버레이).** 조건이
  "실제 해상도가 1920x1080으로 확인된 경우"인데 확인되지 않았다. 기존 800x480 회귀
  테스트와 15인치 테스트·골든은 그대로 둔다.
- 15인치라는 이유로 정보를 늘리거나 레이아웃을 바꾸지 않았다. 너무 크거나 비어
  보이는지는 실물을 보고 판단한다(B6).

## 검증

- 키오스크: `flutter analyze` error·warning 0(기존 info 1), 테스트 **90** 통과(골든 제외),
  골든 **20장** 갱신 없이 비교 통과, 골든 파일 변경 0.
- 백엔드·폰: 코드 변경이 없어 재실행하지 않았다(직전 968 · 340).
- 문서 커밋마다 `test_repo_guard.py`와 stage 목록을 확인했다.

## 다음

패널의 **정확한 해상도와 전원 사양**부터 받는다.
- 1920x1080이 맞으면 소프트웨어 변경은 작다 — 그때 15인치 테스트 범위를 넓힌다.
- 핵심 검증은 전력(RPi5와 공유 가능 여부)·거치·실물 가독성이다(체크리스트 1-2, 전력버짓 §2-3).
