Seongwonp/Simplelay/docs/devlog_2026-09-13m.md

# 개발 로그 — 2026-09-13 (Phase 1.3 — 반납 판정 단일화)

기준 HEAD: `db653e3` → `a076b25`.
1.1(진행 중 명령), 1.2(그 명령의 안전 정리)에 이어 재교차 확인이 같은
뿌리의 세 번째 경합을 찾았다: **별도로 진행 중인 긴급 정지**를 반납
조건에 포함하지 못했다. 실결함 확인(오탐 없음). 리뷰의 진단이 정확했다 —
문제는 하나였고("누가 마지막으로 끝났는가"로 반납을 정하고 있었다),
조건문을 하나씩 덧대는 방식이 매번 다음 구멍을 남겼다.

**검증**(이 기기, 세션 끝): 백엔드 **888** 통과(+3). 폰·키오스크 변경 없음
(직전 확인 308·90).

커밋: `a076b25`.

---

## 결함

정상 완료 경로: stale=False 판정 → 락 해제 → `_finish_settle()`이 위임된
반납 소비. 그 사이에 긴급 정지가 들어오면 — 세션을 닫고 반납을
위임(`_release_pending`)한 뒤 어댑터 stop에서 **응답 대기 중**인 채로 —
settle이 위임을 발견해 정지 확인 전에 제어권을 내줬다. 위임 표시는
"반납 부탁"이지 "정지 확인"이 아니었다. 새 실행이 시작된 뒤 그 정지가
늦게 실패할 수 있는 창이다.

## 수리 — 상태 전이 정리 (리뷰 권고 방식)

반납 판정을 `_maybe_release_locked()` **한곳**으로 모았다. 네 조건이 모두
충족될 때만 반납한다:

1. 세션이 닫혀 돌려줄 빚이 있다(`_release_owed`)
2. 그 세대의 명령 + 안전 정리가 끝났다(`_inflight`)
3. **응답 대기 중인 정지 요청이 없다**(`_stops_inflight` — 요청됨 ≠ 확인됨)
4. 빚이 생긴 뒤 정지가 확인됐다(`_stop_confirmed_since_owed`) — 미확인이면
   fault가 신규 획득을 차단하고 있을 때만

모든 완료 지점(`_send_stop` 성공/실패, settle 출구)이 이 판정을 지나므로,
어느 쪽이 마지막에 끝나든 조건 미달이면 stopping 상태가 유지된다.

**fault 해제의 세대 제한**: `ControlArbiter.fault_seq`(trip마다 증가)를
정지 시작 시점에 캡처해, 오래 걸린 정지의 성공 응답이 그 사이 걸린 **새**
fault를 해제하지 못한다. 해제 경로는 여전히 긴급 정지 확인 하나뿐.

## 검증 방식

리뷰 스크립트 그대로: 정상 완료 판정 직후를 테스트 이음새로 멈추고 →
긴급 정지 진입·응답 지연(게이트) → 정상 완료 재개 → 새 실행 시도 →
정지의 성공/실패 각각. 성공이면 확인 **뒤에야** 반납, 실패면 새 실행이
돌고 있는 게 아니라 아무도 못 얻은 채 fault 잠금(+ 긴급 정지 확인으로
복구). 오래된 정지의 성공이 새 fault를 보존하는 것(세대 대조)도 고정.

## 다음

**개발자 모드 Phase 2** — API 경로 + 명시적 접근 제한 + 폰 진입.
하드웨어가 오면 H0~H1이 먼저다. mock·API 비노출은 그대로다.
