Seongwonp/Simplelay/docs/devlog_2026-09-13i.md

# 개발 로그 — 2026-09-13 (D4 키오스크 5상태 · D5 감사 · 개발자 모드 Phase 0)

기준 HEAD: `e5e88e5` → `0f863e3`.
D6(설정 분할, [h](devlog_2026-09-13h.md)) 뒤에 계획 순서대로 **키오스크를
폰과 같은 제품의 화면으로** 맞췄다. 그다음 접근성 감사로 실제 결함 두 개를
고치고, 하드웨어 전에 굳혀야 할 개발자 모드 **안전 계약**만 백엔드에 넣었다.

**검증**(이 기기, 세션 끝): 백엔드 **847** 통과 · 키오스크 **86** 통과(골든
**20장** 별도, 갱신 없이 비교 통과) · 폰 **308** 통과(골든 51장 별도, sha256이
D6 baseline과 동일 — 폰은 이번에 건드리지 않았다). 폰·키오스크 `flutter analyze`
error·warning 0(기존 info만 있어 exit code 1은 baseline과 같다).

커밋: `7804939` (대기) · `4efc692` (제안) · `38119c9` (실행) · `f785490` (완료) ·
`c7ef207` (수동) · `d836efc` (D5 오버레이) · `bb713b3` (시계 고정) · `0f863e3` (Phase 0).

---

## D4 — 키오스크 5상태

폰에서 정한 규칙을 7인치·1.5~2m 거리 조건으로 옮겼다. 팔레트·테마는 그대로다.
공용 부품은 네 상태가 같은 뜻으로 쓰는 **대상 가전 한 줄**(`KioskTargetLine`)
하나만 만들었다.

- **대기**: 108px 시계 대신 가전 이름(48px) · 조작 가능 여부(모양+문장, 폰 홈과
  같은 말) · '화면을 눌러 시작하세요'. 시각·날짜·온습도는 위쪽 보조 한 줄.
  키오스크에는 음성 입력이 없어 '말하거나'를 쓰지 않는다(백로그 B12).
  가전 이름은 **서버 목록에서 확인된 가전일 때만** 말한다 — 내장 폴백일 때
  설치한 적 없는 전자레인지를 세우지 않는다.
- **제안**: 서버가 주던 `appliance_id`를 받지 않고 있었다. 이제 제안 **자신의**
  대상을 말하고, 모르면 대상 줄을 그리지 않는다(지금 고른 가전으로 메우지
  않음). 왼쪽 질문, 오른쪽 번호 붙은 '누를 순서'. 다섯 단계 이상은 세로 목록이
  잘려 뒤쪽이 사라져서 옆으로 흘린다(골든에서 잡음).
- **실행**: 오른쪽 지표 칸(버튼 눌림 확인됨·시도 횟수)을 걷고, 지금 누르는 버튼
  (52px) → 상태 구절(누르는 중 / 눌림 확인 중 / 보정 후 다시 시도 중). 진행은
  서버 단계 수로만 '총 N단계 중 K단계' — **위쪽 막대의 9초짜리 시간 채움 타이머를
  없앴다**(남은 시간을 아는 척하는 가짜 진행). 긴급 정지만 오른쪽에 떨어뜨리고
  정지 기호·3px 외곽선·104px. 대상은 job의 `appliance_id`(`KioskStatus`가 받는다).
- **완료**: 대상 · 한 일 · '버튼 눌림을 모두 확인했어요' · '잠시 후 처음 화면으로
  돌아가요' · '처음으로'. 음성 안내 '완료되었습니다'가 조리·세탁이 끝났다고
  들려서 화면과 같은 '버튼 조작을 마쳤어요'로 바꿨다.
- **수동**: 가전 이름 30px 흰색, 버튼 칸 124x66·라벨 20px, 칸마다 스크린리더
  라벨. 준비 안 됨 안내와 큰 글씨가 겹쳐도 넘치지 않게 스크롤.

키오스크 큰 글씨 상한은 설계상 1.22배라 200% 골든은 해당 없다(1.22 골든으로 대신).

## D5 — 접근성 감사에서 찾은 결함

- 방해 금지: 선택지 46px, '취소'는 13px 글자 하나(버튼 아님) → 56px 버튼, 48px
  TextButton.
- 위험 신호음 경보: liveRegion이 없어 스크린리더가 알리지 않았다 → 모양은 그대로,
  liveRegion 컨테이너.
- 폰·키오스크 용어 대조: 상태·행동 문구 일치. 키오스크 쪽 '자동 보정 중'·
  '완료되었습니다'를 폰 표현으로 맞췄다.
- 사진 깨짐 폴백은 폰 테스트가 이미 덮는다(키오스크는 사진을 쓰지 않는다).

## 개발자 모드 Phase 0 — 계약만

`rpi/services/developer_session.py`. **API 경로·화면 진입·실제 모션 어댑터는
없다.** 계획서 3.4 안전 불변식을 테스트 48건이 못 박는다:

- 허용 목록(status·home·sensor read·stop·jog·press) 밖은 거절하고 어댑터에
  닿지 않는다 — 셸 문자·제어 문자·여분 토큰·범위 밖 이동량 포함.
- 제어권 하나. 일반 실행 중에는 세션을 열지 않고, 세션 중 실행이 시작되면 명령을
  받지 않는다. `blocks_execution()`이 실행기에 알릴 자리(연결은 다음 단계).
- heartbeat가 끊기면 정지 후 세션 종료. 정지 요청이 실패해도 제어권은 남기지 않는다.
- 긴급 정지·stop은 세션·대상 검증보다 먼저 항상 닿는다.
- 매 명령마다 대상 가전 확인, 보정 전 press 차단, jog는 0.3s TTL로만.
- jog 상한 5mm는 **하드웨어 확인 전 임시값**이다(H3·H4에서 정한다).

## 과정

- 백엔드 전체를 돌리자 `test_readiness_invalidation.py` 13개가 깨져 있었다.
  판정 시각은 고정했는데 레지스트리가 실제 시계라 TTL이 날짜를 탔다 —
  `test_appliance_readiness.py`에서 이미 한 번 고친 결함을 이 파일에 다시 넣었던
  것이다(`bb713b3`, 테스트만). 날짜가 넘어가기 전까지 초록이라 알아채지 못했다.
- 키오스크 커밋마다 analyze error·warning 개수와 테스트 exit code를 실제 값으로
  확인한 뒤에만 커밋했다. 흑백 변환본은 `dev-docs/bw-kiosk`(비추적)에만 둔다.

## 하드웨어·실기기로만 확인할 수 있는 것

- 1.5~2m 거리 가독성, 15인치 패널 실제 확대 모습(B6)
- 긴급 정지 실제 정지 지연, heartbeat 끊김 시 기계 정지(Phase 0는 계약·mock까지)
- TalkBack 실제 완주

## 결정이 필요한 것 (백로그)

B10 대상 모르는 제안의 키오스크 실행 차단 · B11 키오스크 0대 내장 폴백 ·
B12 키오스크 음성 입력 부재.

## 다음

개발자 모드 Phase 1 — `DeveloperSessionManager`를 실행기의 실행 가드와 긴급 정지
경로에 연결(mock 전용, env 게이트, 일반 사용자 비노출). H1은 하드웨어 대기.
