Seongwonp/Simplelay/docs/devlog_2026-09-13h.md

# 개발 로그 — 2026-09-13 (D6 설정 화면 분할)

기준 HEAD: `5a82826` → `301061c`.
D1~D3 폰 화면 마감은 `5a82826`로 닫았다. D6은 **개발자 모드 구현에 필요한
경계만** 좁게 정리했다 — 설정 화면 하나. 홈·제안·실행 상태·음성·이력은
D1~D3에서 디자인과 골든을 확정했으므로 다시 건드리지 않았다.

**검증**: 폰 **308** 통과(골든 **51장** 별도). 골든은 `--update-goldens`
없이 비교해 51장 모두 통과했고, 51장의 sha256이 작업 전 baseline과 **전부
같다**(골든 변화 0). `flutter analyze` error·warning 0(기존 info는 그대로라
exit code 1은 baseline과 같다). 백엔드·키오스크는 건드리지 않았다.

커밋: `9314d6c` (행·구획 제목) · `55f1c6c` (화면·소리) · `7345459` (데모·개발자 도구 자리) ·
`c832c2f` (연결) · `07a02a2` (알림·제안) · `cb6863a` (제어 가전) · `301061c` (가전마다 장치).

---

## 결과

`app/lib/screens/settings_screen.dart` 1,535줄 → **172줄**. 남은 것은 화면
조립(구획 순서, 고급 설정 펼침, 주소 입력 컨트롤러 수명)뿐이다.

| 파일 | 줄 | 담은 것 |
|---|---|---|
| `settings/settings_row.dart` | 35 | 구획 제목, 행+구분선(`_SettingCard`) |
| `settings/appliance_section.dart` | 270 | 제어 가전 선택, 키오스크 재동기화, 삭제 확인, 0대 줄 |
| `settings/node_section.dart` | 363 | 가전마다 장치 목록, 등록·해제 시트 |
| `settings/connection_section.dart` | 377 | 조작 기기 상태, 예비 연결(블루투스), 고급 주소·API 키, 주변 기기 스캔 |
| `settings/notification_section.dart` | 241 | 제안 잠시 쉬기, 안부 확인 쉬기, 다시 추천 안 함 목록 |
| `settings/accessibility_section.dart` | 40 | 음성 안내, 테마 |
| `settings/developer_section.dart` | 74 | 데모 모드, 시뮬레이션 — **개발자 도구가 들어갈 자리** |

## 왜 `part of`인가

구획 위젯이 전부 private(`_ApplianceSection` 등)이고 서로를 부른다
(`_SettingCard`, `_SectionHeader`). 별도 라이브러리로 떼면 이름을 공개로 바꾸고
import를 나눠야 하는데, 그건 이동이 아니라 변경이다. `part`는 같은 라이브러리라
**private 이름·import·provider를 읽는 시점이 원래 파일에 있을 때와 똑같다.**
테스트도 한 줄 고치지 않았다.

## 하지 않은 것과 이유

- **가전 추가 화면은 나누지 않았다.** 네 단계가 `build` 하나 안에서 같은 상태를
  공유하는 인라인 코드라, 파일로 나누려면 단계별 위젯 경계를 새로 만들어야 한다.
  그건 이동이 아니다.
- **"앱 정보" 구획은 없다.** 지금 설정 화면에 그런 항목이 없어서 옮길 것도 없다.
  새로 만들지 않았다(문구·레이아웃 변경 금지).
- **공용 위젯 추출 안 함.** 대상 머리·주/부 행동 쌍은 여러 화면에 있지만, 뽑으려면
  확정된 화면 여러 개를 동시에 고쳐야 한다.
- **줄 수 기준은 쓰지 않았다.** 계획서의 "화면 파일 400줄 이하"는 완료 조건에서
  뺐다. 상태·행동·테스트 경계가 있는 곳만 나눴다(`connection_section`이 377줄인
  이유: 스캔 결과 연결과 고급 주소 저장은 같은 연결 경로를 다룬다).

## 과정

- 옮길 때마다 원문을 읽어 그대로 복사하고(범위 잘라내기 스크립트 없음),
  `flutter analyze` error·warning 개수와 설정 테스트 exit code를 확인한 뒤에만
  커밋했다. 7번 모두 첫 시도에 통과했다.
- 블록을 뺀 자리에 빈 줄이 하나 남는 경우는 `dart format` 전후 `diff`로
  **빈 줄 한 줄만** 바뀌는 것을 확인했다.

## 다음

**D4 키오스크 5상태**(대기·제안·실행·완료·수동) — 폰과 같은 단어·상태 모양.
그다음 개발자 모드 mock(T1~T6)은 `settings/developer_section.dart`에서 진입한다.
H1은 하드웨어 대기.
