Seongwonp/Simplelay/docs/devlog_2026-09-10f.md

# 개발 로그 — 2026-09-10 (다중 가전 제품 계약 · 시작 화면)

기준 HEAD: `e2e8aa1` → `0e3667b`.
디자인 개편(홈 재구성 `c213fef`~`39b757a`) 중에 **설계 위쪽의 문제**가 드러났다:
코드가 `가전 템플릿`과 `사용자가 실제로 설치한 가전`을 같은 목록으로 다루고,
선택값이 없으면 전자레인지로 채웠다. 그래서 아무것도 등록하지 않은 사람에게도
전자레인지가 서 있었고, SimpleLay가 "전자레인지 데모 앱"으로 보였다.
디자인을 더 하기 전에 이 계약부터 고쳤다.

**검증**: 백엔드 **799** · 폰 **295**(골든 제외, 골든 31장 별도) · 키오스크 **56**(골든 제외).
폰·키오스크 `flutter analyze` 신규 경고 0.

커밋: `c94f42f` (백엔드·키오스크 category) · `c855bcf` (템플릿/설치 분리) ·
`0496b30` (데모 표본 분리) · `d780b21` (가전 추가 흐름) · `cd0505d` (시작 화면) ·
`7ab68a1` (종류별 실루엣·골든) · `0e3667b` (실행 상태의 대상 가전).
앞선 readiness 안전 수정: `30c675e` 등(devlog 별도 없음, 커밋 본문 참조).

---

## 계약

- `category`는 종류의 **유일한 진실원천**. 6종(`microwave`·`air_conditioner`·
  `washing_machine`·`induction`·`rice_cooker`·`other`). 아이콘은 파생이고 저장하지
  않는다(코드포인트를 저장하면 릴리즈 빌드의 아이콘 트리셰이킹이 깨진다).
  종류가 없는 예전 데이터는 **명시적인 표로만** 되살리고(`microwave`/`induction`/
  `aircon`), `custom`은 표에 없어 `other`다 — 이름으로 추측하지 않는다.
- `kAppliances` → `kApplianceTemplates`. 템플릿은 고를 수 있는 종류의 예시지
  소유한 가전이 아니다. 설치 목록은 `installedAppliancesProvider`(사용자가 등록한
  것만). 같은 종류를 여러 대 등록할 수 있다(거실/안방 에어컨).
- 선택 가전은 `ApplianceMap?`. **없음은 예외가 아니라 정상 제품 상태**다.
  화면마다 다르게 처리한다 — 홈은 0대를 시작점으로 보여주고, 음성은 마이크를
  내주지 않고, 수동 조작은 빈 조작판 대신 추가 안내, 설정은 "고를 것 없음"만.
- 제안은 자기 `appliance_id`로 대상을 조회한다. 못 찾으면 실행을 막는다.
  실행 상태는 `/status`가 새로 주는 `appliance_id`/`last_appliance_id`(job의
  대상)로 버튼 이름을 읽는다. 대상을 모르면 코드를 그대로 두고 지어내지 않는다.
- 지운 가전을 고르고 있었으면 **내가 가진 것 안에서만** 다시 고른다. 남은 것이
  없으면 null이지 템플릿이 아니다. 설치 목록이 바뀌면 선택도 같이 맞춘다
  (`_watchInstalled`).
- 데모 표본은 **설정에서 명시적으로 켠 데모 세션**에서만 선다(`kDebugMode` 아님).
  `isDemo`와 이름 앞 '데모'를 둘 다 두고, 기기에 저장하지 않는다.
- 시작 결정은 `startupRouteProvider` 하나가 내린다. 시작 화면은 준비가 끝날
  때까지만 서 있고 **한 번만** 옮겨간다. 억지 지연 없음. 안드로이드 네이티브
  스플래시 바탕을 앱 팔레트와 같은 값으로 맞췄다.

## 하다가 찾은 결함

- **켜자마자 가전을 추가하면 사라진다** — 저장소를 읽는 중에 목록을 고치면
  뒤늦게 끝난 `_load()`가 덮어썼다. `add/replace/remove`가 읽기를 먼저 기다린다.
  수정 전으로 되돌려 회귀 테스트가 실제로 빨개지는 것을 확인했다.
- **에어컨을 등록해도 홈에 전자레인지 실루엣** — 실루엣이 종류를 따라가게 했다.
  여전히 선으로만 그린 도면이다(제품 그림을 흉내내면 사진이 있다고 오해한다).
- 이 세션에 "결함을 정답으로 고정한 재현 테스트"를 한 번 더 썼다(`ea92f02`).
  뒤집어 **목표 계약**으로 바꾸고, 빨간 상태로는 main에 올리지 않았다.

## 완료의 경계

- 위치(`location`)는 **폰에만** 남는다 — 서버 payload는 따로 조립하고 싣지 않는다.
- 키오스크는 아직 "저장된 가전 id가 목록에 없으면 기본 가전으로 폴백한다"
  (`kiosk_phase_test`). 폰과 같은 계약 공백이지만 이번 범위 밖이라 두었다.
- 실루엣·시작 화면 전환은 골든까지다. 실기기에서 바탕색이 안 튀는지는 미확인.

## 다음

로컬 계획 문서(`dev-docs/`, 비추적)의 순서를 따른다: 폰 제안 확인(D1) →
폰 실행 상태(D2) → 폰 나머지 화면 → 키오스크 5상태 → 개발자 모드 mock.
하드웨어가 오면 UI를 멈추고 H0부터.
