Seongwonp/Simplelay/docs/devlog_2026-09-09e.md

# 개발 로그 — 2026-09-09 (F5 안부 확인 쉬기 · 파형 · 정지 지연)

기준 HEAD: `e41a380` → `e60b756`.
하드웨어가 아직 없어 계획 문서에서 **F5**와 백로그 **A2의 파형 항목**을 골랐고,
이어서 하드웨어 없이도 되는 **H1 준비**(정지 지연 계측)와 공개 리포 가드를 손봤다.

**검증**: 백엔드 **767** · 폰 **270**(골든 12 포함) · 키오스크 **58**.
폰·키오스크 `flutter analyze` 신규 경고 0.

커밋: `759018e` (F5) · `ab31bc7` (파형) · `5a802df` (F5 마감 감사) ·
`48379c1` (파형 성능) · `674362f` (마이그레이션 테스트) · `1681548` (리포 가드) ·
`ab59cef` (정지 지연) · `e60b756` (예외 경로의 종료 사유).

---

## F5 — 안부 확인을 며칠 쉰다

### 문제

안부 신호는 "평소 그 시간대에 쓰던 가전이 오늘 조용하다"를 알린다. 그런데
**집을 비운 것을 아는 날**에도 그대로 울린다 — 여행, 입원, 자녀 집에 며칠.

    보호자가 이미 아는 일로 알림을 받는다
    → 그런 알림이 며칠 이어진다
    → 정작 진짜 신호가 왔을 때 무시하게 된다

안부 기능이 스스로를 무디게 만든다. 알림을 늘리는 게 아니라 **가짜 알림을
줄이는** 것이 이 기능의 값이다.

### 제안 DND와 합치지 않은 이유

DND는 "지금 말 걸지 마"(분 단위), 이건 "며칠간 조용한 게 정상이다"(날짜)다.
하나로 묶으면 방해 금지 30분이 안부 확인까지 꺼버리거나, 여행 일주일이
제안까지 막는다. 서로 다른 질문에 대한 답이라 저장소도 화면도 따로 뒀다.

### 규칙은 최소로

- 종료 날짜까지(**그날 포함** — "오늘까지 여행"이 자연스러운 말이다) 쉰다.
- **무기한은 없다.** 꺼둔 것을 잊으면 안부 기능이 있는 채로 없는 것과 같아진다.
- 쉬는 동안에도 **실행 실패·위험소리·긴급정지는 그대로 간다.** 사람이 집을
  비웠다는 것은 조용한 것이 정상이라는 뜻이지, 가전이 고장 나도 된다는 뜻이
  아니다. 게이트를 `RoutineQuietChecker.check()` 안에만 두어 다른 알림 경로가
  이 게이트를 지나지 않게 했다.

`GET/POST/DELETE /wellness-pause` · 설정의 "안부 확인 쉬기" 한 줄.

---

## 마감 감사 4건

F5를 커밋한 뒤 계약을 다시 훑어 네 군데를 고쳤다(`5a802df`). 넷 다 **화면은
정상으로 보이면서** 기능을 무력화하는 종류다.

### ① 상한이 화면에만 있었다

"무기한은 두지 않는다"는 규칙을 지키고 있던 것은 폰의 날짜 선택기(90일)뿐
이었다. 키오스크나 직접 호출은 2099년까지 쉬게 만들 수 있었고, 그건 곧
무기한이다. **규칙이 화면에 있으면 규칙이 아니다** — R2에서 "배너만 바꿔
전송 차단을 대신하지 않는다"고 했던 것과 같은 자리다.

`WellnessPause.MAX_DAYS = 90`으로 계약에 옮기고 서버가 422로 거절한다.

### ② 재시작하면 쉬는 상태가 사라졌다

메모리에만 있었다. 여행 이틀째의 재부팅 한 번으로 남은 닷새 동안 알림이 다시
온다 — **이 기능이 없애려던 바로 그 상황이다.**

`settings` 테이블(신규, `CREATE TABLE IF NOT EXISTS`)에 종료 날짜를 남긴다.
값을 못 읽으면 쉬지 않는 쪽으로 떨어진다 — 손상된 값 때문에 안부 확인이 영영
꺼져 있는 것보다 낫다. DB가 없는 개발 PC·테스트는 종전대로 메모리.

> F1의 readiness registry를 메모리 전용으로 둔 것과 **반대 방향의 판단**이다.
> 거기서는 재시작 = "다시 확인해야 함"이 안전한 쪽이었다. 여기서는 재시작이
> 기능을 꺼버리는 쪽이라 남겨야 한다. "메모리 전용"이 그 자체로 원칙인 건
> 아니고, 잃었을 때 어느 쪽으로 틀리는지가 기준이다.

### ③ 끝난 일시 중지의 날짜를 그대로 내보냈다

`GET /wellness-pause`가 `paused=false`와 함께 **지난 날짜**를 줬다. 폰은
`until != null`만 보고 판단해서, 이미 풀린 뒤에도 "7월 23일까지 쉬어요"라고
말했다 — 서버는 이미 안부 신호를 다시 보내고 있는데.

서버는 쉬는 중일 때만 날짜를 주고, 폰도 `paused`를 근거로 삼는다. 둘 다
고쳤다 — 어느 한쪽만으로도 막히지만, 계약을 읽는 쪽이 추측하지 않는 편이 맞다.

### ④ 알림함이 쉬는 중이라고 말하지 않았다

쉬는 동안 알림함은 "아직 알림이 없어요"였다. 조용한 알림함이 "정말 아무 일
없었다"로 읽히는데 사실은 보호자가 직접 꺼둔 것이다. **R4에서 없앤 바로 그
오해**(통신이 끊겨 못 받은 것을 "아무 일 없다"로 읽는 것)를 F5가 다른 문으로
다시 들여놓은 셈이다.

배너 한 줄로 남은 기간과 "실행 실패·위험 신호음은 그대로"를 함께 말한다.

---

## 음성 파형 — 정해진 애니메이션을 걷어냈다

백로그 A2의 항목. `_WaveBar`가 `AnimationController.repeat(reverse: true)`로
막대를 흔들고 있었다. **마이크가 아무것도 못 듣고 있어도 똑같이 춤을 췄다.**

인식이 안 될 때 사용자가 판단해야 하는 것은 "더 크게 말할까 / 마이크가 죽었나"
인데, 화면이 그 근거를 지우고 "잘 듣고 있다"는 인상만 남겼다. R5(추천 근거의
"최근")·A1(연결 문구의 "AI 추론 준비 완료")과 같은 종류의 과장이다.

`speech_to_text`의 `onSoundLevelChange`를 `VoiceService.listen`에 통과시키고
막대 높이를 거기에 걸었다.

- 음량 단위는 플랫폼마다 다르다(안드로이드 RMS / iOS dB). **상대적인 크기로만**
  쓰고 정확한 수치인 척하지 않는다.
- **값이 안 오면 흔들지 않는다.** 음량을 주지 않는 플랫폼에서는 최소 높이로
  가만히 있는다 — 모르는 것을 그럴듯하게 그리지 않는다. 대신 "듣는 중"은
  색으로 남는다.
- 세션 세대 검사를 `onResult`와 똑같이 걸었다. 끝난 세션의 늦은 음량 콜백이
  다음 화면의 파형을 흔들면 안 된다.

성능(`48379c1`): 음량은 말하는 내내 초당 십수 번 온다. `setState`로 받으면
그때마다 화면 전체가 다시 그려져 **정작 말하고 있는 순간에** 버벅인다.
`ValueNotifier` + `ValueListenableBuilder`로 다시 그릴 범위를 막대 다섯 개로
좁혔다.

---

## 공개 리포 가드의 구멍 둘

`test_repo_guard.py`는 추적 중인 파일의 **내용**에서 벤더 명칭을 찾는다.
두 가지가 그물을 통과하고 있었다.

1. **파일 이름은 검사하지 않았다.** 내용이 깨끗해도 이름으로 샌다.
2. **바이너리는 조용히 건너뛴다**(`UnicodeDecodeError` → `[]`). 그래서 발표
   자료·제공 문서 한 장이 통째로 추적돼도 가드는 아무 말도 하지 않는다.

`.gitignore`는 **이미 추적 중인 파일을 지켜주지 않으므로**, 무시 목록이 아니라
`git ls-files`(실제로 공개되는 것)를 기준으로 본다. 문서·키 확장자
(`.pptx`·`.pdf`·`.docx`·`.env`·`.pem` …)가 새로 추적되면 실패한다.

규칙보다 먼저 들어와 있던 파일 하나는 예외 목록에 적었다. **적혀 있다고
안전해진 것이 아니다** — 이미 커밋 이력에 있고 `.gitignore`로 되돌릴 수 없다.
가드는 새로 늘어나는 것만 막는다. 이력에서 지우는 것은 되돌릴 수 없는 작업이라
사용자가 결정한다. 목록이 부풀어 굳지 않도록 오래된 항목을 잡는 검사도
`_MIGRATION_DEBT`와 같은 방식으로 뒀다.

---

## 정지 지연 — 설명은 있었고 열은 없었다 (H1 준비)

`history_csv`의 설명은 "정지 지연을 뽑을 수 있다"고 말했다. 그런데 **뺄 수 있는
열이 없었다.** 시작·종료 시각만으로는 "전체 얼마나 걸렸나"까지가 한계다.
H1이 요구하는 다섯 지표 중 하나가 통째로 빠져 있던 셈이다.

`stop_requested_at`(긴급 정지를 **접수한** 시각)을 이력에 남기고, CSV에
`stop_requested_at`·`stop_latency_seconds` 두 열을 냈다.

- 정지로 끝난 실행에만 남긴다. 정지를 눌렀지만 실행이 이미 성공으로 끝났다면
  지연을 잰 것이 아니므로 비운다 — **빈 칸과 0초는 다른 뜻이다.**
- 연타하면 **첫** 요청을 남긴다. 뒤로 밀리면 지연이 실제보다 짧게 기록된다.
- 정지 뒤 컨트롤러가 예외로 끝나는 경로(`e60b756`)는 정지 여부를 소진하지
  않아서 '재시도 소진'으로 기록됐다. **오히려 진짜 하드웨어 장애일수록 이
  경로로 끝난다** — 놓치면 안 되는 표본에서 종료 사유가 틀리고 있었다.

### 이 숫자를 어떻게 읽어야 하나

| | 어디서 나오나 |
|---|---|
| ① 소프트웨어 정지 접수 | CSV `stop_requested_at` |
| ② 실행 루프 종료 | CSV `stop_latency_seconds` (② − ①) |
| ③ **물리 동작 중단** | **아직 없다** — 눈·영상으로 재고 따로 적는다 |

③이 없는 것은 장치가 스스로 보고해야 알 수 있기 때문이다. `stop_latency_seconds`
하나를 "물리 정지 지연"으로 발표하면 사실이 아닌 말을 하게 된다 — 모터가 실제로
서는 시간은 그 뒤에 더 붙는다. 코드 주석·CSV 설명·배포 체크리스트·데모
시나리오 네 곳에 같은 경계를 박았다.

---

## 고정한 계약

백엔드(`test_wellness_pause.py`, 23개):

1. 쉬지 않으면 종전대로 안부 신호가 나간다
2. 종료 날짜 당일도 쉰다 / 다음 날 스스로 풀린다 / 해제하면 즉시 재개
3. 쉬는 중에도 실패·위험소리는 저장소에 그대로 쌓인다
4. 지난 날짜와 상한(90일) 초과를 거절한다 — 서버가
5. 쉬는 상태가 저장소에 기록되고, 새 프로세스가 그것을 읽는다
6. 끝난 일시 중지는 HTTP 응답에서 날짜를 주지 않는다
7. 이미 이력이 쌓인 DB에 `settings` 테이블이 생겨도 옛 기록이 남는다

실험 기록(`test_experiment_record.py`, 27개):

8. 정지로 끝난 실행에만 접수 시각이 남고, 정상 종료에는 빈 칸이다
9. 앞 실행의 접수 시각이 다음 실행에 따라붙지 않는다
10. 연타해도 기준점이 뒤로 밀리지 않는다
11. 멈춘 뒤 예외로 끝나도 '사용자 정지'다

공개 리포(`test_repo_guard.py`, 5개):

12. 파일 **이름**의 벤더 명칭 / 문서·비밀 파일이 새로 추적되는 것

폰:

13. 쉬는 중이면 알림함이 그 사실과 "실패·위험 신호음은 그대로"를 말한다
14. `paused=false`면 날짜가 와도 "쉬는 중"으로 표시하지 않는다
15. 음량이 오기 전에는 파형이 흔들리지 않는다
16. 음량이 크면 커지고 잦아들면 내려간다 / 듣기를 마치면 남지 않는다

## 곁가지

- `speech_to_text`의 `onSoundLevelChange`는 `listen()`의 **최상위 이름 인자**다
  (`SpeechListenOptions` 안이 아니다). 7.x에서 deprecated 목록에도 없다.
- Dart에서 상위 메서드를 재정의하려면 **이름 인자를 전부 선언**해야 한다.
  `listen`에 인자를 하나 더하니 테스트 대역(`_FakeVoiceService`)이 먼저
  깨졌다 — 그 대역으로 음량을 흘려 넣어 파형 테스트를 만들었다.

## 완료의 경계

- **F5는 소프트웨어 계약까지.** 실기기에서 며칠짜리 일시 중지가 실제로
  경계 날짜를 넘어가는 것은 시간이 필요해 확인하지 않았다.
- **파형은 개발 PC 기준.** 음량 값의 실제 범위는 안드로이드 실기기에서 확인해야
  한다 — `/10` 정규화가 너무 둔하거나 너무 예민할 수 있다. 그때 고칠 것은
  상수 하나다(`_WaveVisualizer._scale`).
- **H1은 여전히 미착수.** `rpi4/act_main.py`의 모션 구현은 `MockGrblClient`다.
- **F1의 실제 readiness probe·F2의 폰 2대 검증도 하드웨어 대기.**
- **물리 정지 시각은 여전히 없다.** 장치가 스스로 보고해야 한다 —
  CSV의 정지 지연은 소프트웨어 구간까지다.

## 다음

- 하드웨어가 오면 **H1** — 실제 probe·모션 통합.
- 그전까지 남은 것: D1~D6(화면 인상, **팀과 함께 정한다**) · F3 가전 상세
  (D4와 겹친다) · B4 골든 허용 오차(반복되면) · B5 온디바이스 계층(HW 뒤).
