Seongwonp/Simplelay/docs/devlog_2026-09-09.md

# 개발 로그 — 2026-09-09

[앱 개선 백로그](앱-개선-백로그.md)에서 B1(가장 큰 잔여) → A3·A5 → 그 뒤로
**"판단이 필요 없는 것"** 을 골라 이어서 처리했다. A1·A2(화면 인상 개편)는
취향 판단이 섞여 있어 일부러 남겼다 — 문구 과장 정정처럼 사실 관계가 분명한
부분만 손댔다.

---

## B1. 사용 이력이 '어떤 가전에서' 했는지까지 기록 (`31ef267`)

제안↔가전 결합(9/8, `0b87bd3`)으로 환경 제안은 대상을 들고 다니게 됐지만,
**사용 이력에 가전이 없어** 패턴 제안은 여전히 대상을 몰랐다. 화면은 현재 선택
가전으로 폴백해 그렸다 — 가전 한 대만 쓸 때는 대개 맞지만, 전자레인지와 에어컨을
함께 쓰기 시작하면 "저녁마다 하던 그것"이 엉뚱한 가전의 버튼 지도를 달고 나온다.

사슬 전체를 이었다: **실행 → 이력 → 패턴 후보 → 제안 → 승인 실행 대상.**

- `UsageRecord.appliance_id` 추가, 동기·비동기(job 스레드) 두 경로에서 기록
- SQLite `usage_log`에 열 추가 + **기존 DB용 ALTER 마이그레이션**.
  `CREATE TABLE IF NOT EXISTS`는 기존 테이블을 손대지 않으므로, 마이그레이션이
  없으면 실기기에 이미 깔린 DB는 열자마자 깨진다. 파일을 지우게 하면 그동안
  쌓인 학습 이력이 날아간다.
- `PatternDetector`가 목적별 **가장 최근** 실행 가전을 후보에 싣는다.
  최빈값이 아니라 최신인 이유: 같은 루틴을 다른 가전으로 옮겨 쓰기 시작했다면
  사용자가 뜻하는 대상은 최신 쪽이다. 실패한 실행은 횟수에서 빠지므로 대상
  추정에서도 뺀다.
- 가전 없이 쌓인 옛 기록만 있으면 `None` — **대상을 지어내지 않는다.**
  그때만 클라이언트가 현재 선택 가전으로 폴백한다.
- `POST /demo/suggest`도 `appliance_id`를 받는다 → 가전 여러 대를 번갈아
  보여주는 연출이 가능해졌다.

목적 없는 버튼 직접 실행은 종전대로 학습에서 제외한다(패턴 제안은 되풀이 가능한
'말'을 전제로 한다).

## A3. 왜 추천했는지, '안 받기'가 무엇을 약속하는지 (`99ca843`)

서버는 `time_band`·`occurrences`를 주는데 앱이 옮기며 **버리고 있었다.**

- **"최근 저녁 시간에 4번 하셨어요."** 한 문장으로 표시.
- **데모 제안은 일부러 비운다.** 데모 트리거는 패턴 감지를 우회하려고 횟수를
  지어내는데, 그 숫자를 "이만큼 하셨어요"로 보여주면 화면이 사실이 아닌 말을
  하게 된다. 리뷰가 안티패턴으로 지목한 "앱에서 못 받는 데이터를 데모 값으로
  보충"과 같은 부류다.
- '다시 받지 않기'를 **영구 억제를 실제로 지킬 수 있는 제안에만** 내건다.
  BLE 경로에서는 '이번만 넘기기'와 똑같은 `approved: false` 메시지라, 버튼이
  있으면 지키지 못할 약속이 된다.
- 억제 직후 **"앞으로 표시하지 않아요 · 되돌리기"**. 설정 화면까지 찾아
  들어가야 되돌릴 수 있으면 되돌릴 수 있는 게 아니다.
- 억제 목록의 **불러오는 중 / 조회 실패 / 없음**을 구분. 셋을 빈 목록으로
  뭉개면, 조회가 실패한 화면이 "억제한 게 없다"고 단언한다.

### 키오스크도 같은 문장으로 (`536678e`)

키오스크는 "이 시간대에 3번 하셨어요."라고 했는데 **무슨 시간대인지 알려주지
않았고**, 데모 제안에서도 그대로 나왔다. `occurrences` 기본값이 1이라 횟수를
모르는 제안이 "1번 하셨어요"라고 말하기까지 했다. 폰과 같은 규칙으로 맞췄다.

## A5. 실제 위젯의 색 대비 (`99ca843`)

리뷰가 짚은 3건을 재현해 보니 **원인이 하나**였다: 강조색을 면으로 쓸 때 얹는
글자색이 모드와 무관하게 검정 고정. 다크 모드의 강조색(골드 `#D9A356`, 브릭
레드 `#D9605C`)은 밝아서 검정이 맞지만, 라이트 모드 전용 변형(`#8B6010`,
`#B93A34`)은 어두워서 흰색이 맞다.

`context.appOnAccent`(다크=검정 / 라이트=흰색) 토큰으로 통일했다. 테마가 이미
`onPrimary`에 같은 규칙을 쓰고 있었는데 위젯들만 안 따르고 있었다.

| 위치 | 전 | 후 |
|---|---|---|
| 제안 지도 순서 배지 | 3.78:1 | 9.32 / 5.56 |
| 홈 알림 개수 배지 | 3.63:1 | 5.78 / 5.65 |
| 홈 주요 실행 버튼 | 3.78:1 | 9.32 / 5.56 |
| 첫 실행 시작 버튼·스피너 | 4.93:1 | 9.32 / 5.56 |
| 설정 억제 빈 상태 | 2.38:1 | 8.22 / 7.44 |
| 제안 단계 타임라인 순서 원 | 4.23:1 | 9.32 / 5.56 |

마지막 둘은 조사하다 나온 것이다. 타임라인 원은 18% 틴트 위에 같은 강조색
숫자를 얹는 구조라, 틴트를 옅게 해도 강조색 자신이 상한(5.41:1)이라 여유가
없었다 — 면을 채우고 대비색을 얹는 쪽으로 바꿨다.

`test/theme/contrast_test.dart`에 **실제 위젯 조합** 그룹을 추가하고, 예전 값도
"이렇게 하면 미달"로 함께 박아 회귀를 막는다. (기존 그룹은 토큰 쌍만 봤다 —
팔레트는 통과하는데 위젯은 떨어지는 상황이 실제로 그래서 생겼다.)

## B7. 가짜 센서 주입을 명시적 데모 세션으로 (`1b7f8b3`)

데모 실행 흐름(가짜 센서·가짜 성공)이 `kDebugMode`에만 걸려 있었다. **실기기에
물린 디버그 빌드에서도 섞인다** — 실제로는 버튼이 안 눌린 실행이 화면에서
성공으로 끝날 수 있다. 폐루프의 존재 이유가 "눌림을 확인했는가"인데, 그 확인을
화면이 위조하게 되는 셈이라 위험도가 크다.

- `demoModeProvider`: 기본 꺼짐. `--dart-define=SIMPLELAY_DEMO=true`로 기본값을
  켜거나 설정에서 토글(기기에 저장). 백엔드 `SIMPLELAY_*` env 게이트와 같은 규칙.
- 데모 섹션을 디버그 빌드 조건 → **고급 설정**으로. 결선 리허설은 릴리즈 APK로
  하는데 디버그에만 있으면 정작 필요한 곳에서 못 켠다.
- 켜져 있는 동안 실행 화면 상단에 **"데모 모드 — 실제 조작이 아닙니다"** 를
  계속 표시(스크린리더에도 알린다).

## B3 + A1 문구. 실패한 자리에 다음 할 일 (`0dc88a4`)

- 음성 인식이 실패하면 스낵바만 뜨고 몇 초 뒤 사라졌다. 화면에는 "마이크를 눌러
  말해보세요"만 남아, 사용자가 할 수 있는 일이 같은 시도의 반복뿐이었다.
  홈에서는 이미 두 경로를 항상 보이게 했는데(`d696325`) 정작 실패하는 화면이
  그 규칙을 안 따르고 있었다 → 실패 사유를 화면에 남기고 **"버튼으로 조작 ·
  다시 말하기"** 를 함께 둔다. 듣기를 끝냈는데 인식이 빈 경우도 같은 실패다.
- 홈 연결 카드가 `/ping` 응답만 보고 **"AI 추론 · 제안 · 실행 준비 완료"** 를
  선언했다. 확인한 것은 서버 연결뿐이고 추론 계층은 아직 켜지 않았다
  ([inference-boundary](inference-boundary.md)) → **"기기와 연결됐어요 / 말이나
  버튼으로 조작할 수 있어요"**.

## A4 일부. 맡긴 작업을 잃지 않기 (`370183e`, `34268ee`)

**진행 중 job 보존** — 실행은 수 초~수십 초 걸리고 그 사이 앱이 내려갈 수 있다
(사용자가 홈으로 나가거나 OS가 정리). job_id를 잃으면 물리 조작은 계속되는데
화면은 "실행한 적 없음"으로 돌아온다. 가전 앞에 서 있는 사람에게 가장 나쁜
상태다.

- 실행 시작 시 job_id·이름을 기기에 남기고, **결말이 나면** 지운다.
  '확인 불가'는 아직 결말이 아니므로 남긴다 — 앱을 다시 열면 또 확인해야 한다.
- 앱 시작 시 남은 job을 되읽어 폴링을 이어붙인다. 서버 주소는 기기에서 비동기로
  읽히므로 준비되는 시점을 기다렸다 붙는다.
- 추적기를 **앱 시작부터** 살려둔다. 상태 화면을 열어야 만들어지면 앱을 다시 연
  사용자는 홈에서 아무 흔적도 못 본다.

**실패한 이력의 단계별 확인 결과** — 폐루프는 버튼마다 눌림을 확인하고 필요하면
다시 누른다. 그 기록이 이미 `/history`에 들어 있는데 화면은 결과 한 줄만
보여줬다. 끝이 안 좋았던 실행에만 단계를 펴고(확인됨 / N번 만에 확인 / 확인
못 함) 아래에 '버튼으로 직접 조작'을 둔다. 성공한 이력은 그대로 한 줄이다 —
전부 펼치면 목록이 다시 개발 도구처럼 보인다.

'눌렀지만 확인 못 함'과 '아예 못 누름'을 가를 재료는 아직 없어서, 확인 여부까지만
말한다.

---

## 곁가지로 잡은 것 — `pip install -e .` 가 통째로 실패하고 있었다 (`2eb5207`)

리포 루트 `.venv`를 다시 만들다 드러났다. `pyproject.toml`에서 `dependencies`가
`[project]` 안의 배열이 아니라 **`[project.dependencies]` 테이블로 감싸여 있어**
setuptools가 `must be array`로 거절한다.

`scripts/setup_rpi.sh:89`가 `pip install -e "$REPO_DIR"` 로 기기를 세팅하므로,
**실기기 초기 설치 경로가 막혀 있었다.** 개발 PC에서는 시스템 파이썬에 이미 깔린
패키지로 테스트가 돌아 드러나지 않았다.

- `dependencies`를 `[project]` 안으로
- 패키지 지정이 `[tool.poetry]`에 있었다(빌드 백엔드는 setuptools) →
  `[tool.setuptools.packages.find]`. 리포 루트에 `app/`·`docs/` 등 비-파이썬
  최상위 디렉터리가 많아 자동 탐색은 실패한다
- `test` extra에 `dbus-fast` 추가 — D-Bus 인코딩 테스트가 실제 `Variant` 타입을
  쓰는데, 깨끗한 venv에서는 그 테스트만 조용히 실패했다

검증: 새 venv에 `pip install -e ".[test]"` 후 652개 통과.

---

## 검증

- 백엔드 **652** (+12) · 폰 **200** (+24) · 키오스크 **52** — 전부 통과
- `flutter analyze` 경고 0 (남은 5건은 전부 info, 대부분 외부 패키지 deprecation)
- 골든 8장 갱신(폰 5 · 키오스크 3). 제안 골든은 **실기기에서 실제로 오는 서버
  제안**으로 픽스처를 바꿨다 — 근거 문장과 '다시 받지 않기'가 그 경로에서만
  나오므로, 골든이 화면 검토에 쓸모가 있으려면 그쪽을 찍어야 한다

## 남긴 것 · 다음

[앱 개선 백로그](앱-개선-백로그.md)의 C절을 갱신했다. 요약하면:

1. **HW 브링업**이 여전히 1순위(지도교수 방침 + 차별점)
2. **A1 + A2**(화면 인상) — 혼자 하지 말 것. 취향 판단이 섞여 있어 스크린샷을
   놓고 같이 봐야 한다
3. A4 잔여(알림함 조회 실패 구분) · B2(가전 삭제 분리)
4. B5 온디바이스 계층 활성화는 HW가 굳은 뒤 — 어려운 것 두 개를 동시에
   디버깅하지 않는다

---

## 추가 세션 — 교차 평가 보존 · 장기 계획 · 데스크탑 인계

기준 HEAD: `810c8c0`. 사용자 요청에 따라 평가와 장기 계획을
[교차평가-후속개발계획-2026-09-09.md](교차평가-후속개발계획-2026-09-09.md)에 작성했다.

- 주관적 평가: SW 구조 8/10, 실행 안전성 6.5/10, 폰 디자인 7/10,
  키오스크 디자인 8/10, 시연 준비도 6.5/10, 종합 7/10. 실기기 검증 점수가 아니다.
- 우선 후속 작업: R1 제안 승인까지 대상 검증 통합, R2 실제/모의 실행 의미 일치,
  R3 다중 폰 동기화의 무차별 삭제 제거, R4 알림 조회 상태 구분, R5 추천 근거 정합.
- D1~D6 화면 개선, H1 물리 폐루프·실측, H2 기존 모듈 기능 검증,
  G0~G7 단계별 일정과 완료 기준을 정리했다. 새 AI 고도화는 범위 밖이다.
- `CLAUDE.md`에 읽는 순서·다음 작업 ID·검증 기록 해석을 추가했다.
  기존 결선로드맵·앱 개선 백로그에는 새 계획 링크를 연결하고 과거 완료 기록을 보존했다.
- **구현 코드 변경 없음. 평가에 기록한 결함은 미수정 상태다.**

검증 기록 구분:

- 직전 교차 평가에서 폰 골든 제외 **188개 통과**, 골든 12개 포함 총 200개와 구분.
- 백엔드는 시스템 Python의 pytest 부재로 미실행. 키오스크는 잠금 버전 패키지 복구 후
  `build/unit_test_assets` 접근 오류로 중단. 앞 절의 652/52 통과는 기존 개발 세션 기록이다.
- 이번 문서 세션은 내부 링크·diff·Git 변경 파일 범위 확인으로 검증한다. 테스트 재실행 대상인
  구현 변경은 없으며, 비공개 자료·PDF·PPTX는 읽거나 공개 문서에 포함하지 않았다.

다음 작업: 데스크탑에서 최신 main·로컬 변경을 확인한 뒤 **R1 재현/회귀 테스트부터** 시작.
현재 HEAD에 후속 수정이 있으면 재검증하고 이미 완료한 구현을 반복하지 않는다.

### 공개 인계 문구 점검

- 사용자 승인에 따라 이번 인계의 비공개 자료 경로·특정 제공자·연동 세부 언급을 일반화했다.
- `CLAUDE.md`의 보호 규칙은 구체적 경로 대신 사용자 지정 범위 확인·자동 탐색 금지·로컬 전용 원칙으로 정리했다.
- 공개 전 수정 내용이 중간 커밋에 남지 않도록 아직 공유하지 않은 문서 커밋에 함께 반영한다. 이미 공유된 이력은 변경하지 않는다.
- 이번 변경은 공개 인계 문서에 한정한다. 저장소 전체의 과거 공개 이력이나 기밀 여부를 감사했다는 의미는 아니다.
