Seongwonp/Simplelay/docs/devlog_2026-08-30.md

# 개발 로그 — 2026-08-30

## 펌웨어 첫 컴파일, 그리고 디자인 개편

두 가지를 했다. 오전에 PlatformIO를 설치해 펌웨어를 **처음으로 컴파일**했고, 오후에는
화면 디자인 교차 리뷰를 받아 개편했다. 두 작업의 교훈이 같다.

---

## 1. 펌웨어 — 설치 10분을 미루고 다섯 번 고쳤다

`install.platformio.org`에 A/AAAA 레코드가 없어 공식 설치 절차가 막혀 있었다(네트워크
문제로 보였지만 그 호스트가 죽은 것이었다). PyPI로 받고 Python 3.11 전용 venv를 썼다.

첫 빌드에서 오류 2종이 나왔고 **둘 다 그날 고친 부분이 아니라 원래 있던 것**이다:

- `min(ESPNOW_MAX_PAYLOAD_BYTES, len - offset)` — int 상수식과 size_t라 코어 3.x의
  `std::min`이 인자를 추론하지 못한다. Arduino `min` 매크로 시절 코드를 옮겨온 자리로,
  **양쪽 펌웨어에 똑같이** 있었다
- `doc["buttons"].as<JsonArray>()` — const 문서에서 가변 배열을 꺼낼 수 없다

둘 다 교차 리뷰 두 번과 자체 정적 검사(괄호 균형·헤더 선언 대조)를 전부 통과한
것들이다. 타입 오류는 그런 검사로 안 잡힌다.

덤: 플랫폼은 **espressif32@7.0.1 = Arduino-ESP32 코어 3.x**. README의 미해결 항목이던
"어느 코어로 빌드되는가"의 답이고, 수신 콜백은 `recv_info` 분기를 탄다.

---

## 2. 디자인 — "AI가 만든 티"를 지우기

교차 리뷰를 받았고 지적이 대체로 정확했다. 대비 계산 세 건은 소수점까지 일치했다.

### 접근성 — 가장 중요한 버튼이 가장 안 보였다

| | 전 | 후 |
|---|---|---|
| 키오스크 제안 승인 (초록+흰 글자) | 2.25:1 | 9.34:1 |
| 폰 긴급 정지 (빨강+흰 글자) | 3.63:1 | 5.78:1 |
| 라이트 모드 캡션 | 2.48:1 | 6.36:1 |
| 라이트 모드 앰버(상태) | 1.82:1 | 5.26:1 |
| 라이트 모드 그린(상태) | 2.19:1 | 5.80:1 |

**색이 아니라 글자색을 고쳤다.** `danger`를 어둡게 하면 다크 배경 위 '글자'로 쓰는
자리가 5.31 → 3.9로 같이 깨진다 — 한 색이 면과 글자 두 역할을 겸할 수 없다. 골드 버튼이
이미 검정 글자를 쓰고 있었고 나머지 색만 그 규칙을 안 따르고 있어서, `onAccent`로
규칙을 명시했다.

캡션 쪽은 얄궂었다. `app_colors.dart`에 "하드코딩하면 크림 배경에서 안 보인다(수동 조작
그리드가 깨졌던 원인)"는 주석이 **이미 있는데**, `AppText.caption` 자신이 다크용 회색을
상수로 물고 있었다. 한 번 겪고 토큰까지 만들어놓고 타이포 토큰이 그 규칙을 어긴 것이다.

### 카피 — 제품이 자기 자랑을 하고 있었다

핵심은 사용자가 판단할 것이 "AI가 뭘 제안했나"가 아니라 **"내 가전의 어떤 버튼을
대신 눌러줄 것인가, 맡길 것인가"**라는 점이다.

- 홈의 "AI가 N개 패턴을 발견했습니다" + KPI 3칸 카드를 통째로 삭제했다. 사용자가 그걸로
  할 판단이 없었고, 덤으로 **라벨/값 불일치 버그**도 사라졌다 — '총 동작 N회'로 표시하던
  값은 실제로는 대기 중 제안들의 단계 수 합계였다
- 제목을 `{사용자가 했던 말}, 지금 할까요?`로. `purpose`는 제품이 지어낸 문구가 아니라
  본인이 예전에 한 말 그대로다
- '승인/거부' → '지금 실행 / 나중에'. 결재가 아니라 시킬지 정하는 일이다
- 키오스크에 **눌릴 버튼 순서**를 추가했다. steps는 원래 모델에 있었는데 화면에 안 쓰고
  있었다 — 제품의 차별점이 가장 잘 드러나는 화면에서 그게 빠져 있었다
- '3단계 동작' → '우유 → 1분 추가 → 시작'. 몇 번 움직이는지가 아니라 무엇을 누르는지가
  판단에 필요하다
- '완료' → '버튼 조작을 마쳤어요'. 가장 큰 글자가 '완료'면 조리나 냉방 자체가 끝났다고
  읽힌다. 이 시스템이 끝낸 것은 버튼 조작이다
- '검증 신뢰도 93%' → '버튼 눌림: 확인됨' + 근거는 그 아래. 93%가 충분한 값인지 사용자는
  알 수 없다
- 대기 화면에 '화면을 눌러 가전 조작' 한 줄. 화면 전체가 눌리는데 시계만 보여서는 알
  방법이 없었다 — 여백이 아니라 **발견 가능성**이 문제였다

---

## 3. 그리고 눈으로 봤더니

디자인을 잔뜩 바꿔놓고 **한 번도 화면을 보지 않았다**는 것을 깨달았다. 이 프로젝트에서
반복해 겪은 실패 모드를 그대로 하고 있었던 것이다.

키오스크는 웹 지원이 없고 백엔드에 CORS가 없어 브라우저로는 못 띄운다. 그래서 두 앱에
**골든 스크린샷 테스트**를 넣었다 — 한글 폰트를 실어 실제 글자로 렌더하고, 큰 글씨와
라이트 모드도 함께 찍는다.

그러자 위젯 테스트가 **전부 통과하는 상태에서** 결함 세 건이 나왔다:

- **200% 확대에서 홈 화면이 읽을 수 없었다.** 상태 카드가 `Row[아이콘, Expanded(텍스트),
  버튼, 버튼]`이라 확대하면 버튼이 폭을 다 가져가고 텍스트가 한 글자씩 세로로 쪼개졌다
  ("RPi 서버 미설정"이 여섯 줄). 오버플로가 아니라 **압축**이라 레이아웃 테스트가 못 잡는다
- **키오스크 '지금은 안 함'이 큰 글씨에서 잘렸다.** 고정 높이 버튼 안의 글자 잘림도
  오버플로가 아니다
- **실행 화면 근거 줄이 말줄임으로 사라졌다.** 수치를 근거로 남긴 의미가 없어진다

한 곳만 고치고 넘어가지 않으려고 나머지 화면(제안·실행·설정·수동 조작)도 200%로 찍어
봤다. **홈만 무너졌고 넷은 정상**이었다.

> 부수 소득: 교차 리뷰의 "설정 첫 화면이 설치 도구 같다"는 지적은 **낡은 스크린샷 기준**
> 이었다. 실제 화면은 이미 일반 → 제어 가전 → 연결 → 노드로 나뉘어 있다. 리뷰를 그대로
> 실행했으면 멀쩡한 것을 바꿀 뻔했다.

`docs/screenshots`의 PNG는 개편 이전 캡처라 그 사실을 README로 남겼다.

---

## 오늘의 교훈

오전과 오후가 같은 이야기다.

**컴파일하지 않은 코드는 리뷰를 몇 번 받아도 컴파일되지 않는다. 보지 않은 화면은 테스트가
몇 개 통과해도 읽히지 않는다.** 둘 다 도구를 갖추는 데 10~20분이면 됐는데, 그걸 미룬 채
각각 다섯 번, 네 번씩 고쳤다.

테스트는 "내가 확인하기로 한 것"만 확인한다. 확인 수단 자체를 먼저 갖추는 편이 빠르다.

---

## 남은 것 (판단이 필요해 손대지 않음)

- **폰 본문 15 → 18, 키오스크 22~24** (리뷰 권고). 앱 전체 느낌이 바뀌는 변경이라
  결정이 필요하다. 200% 확대가 이제 정상이라 급하지는 않다
- **고령자 대상 7:1 강화 대비.** 현재 캡션 6.36:1로 AA는 통과. 7:1로 가려면 회색을 더
  진하게 해야 하고 앱 전체 인상이 바뀐다
- **말하기 FAB → 하단 큰 버튼** (리뷰 권고). 주 행동 접근성은 좋아지지만 구조 변경이다
- **제안 화면의 버튼맵 접기** (리뷰 권고). 확대 렌더로 보니 버튼맵이 잘 재배치되고
  제품 차별점을 잘 보여준다 — 중복이라 접을지는 취향 판단이라 남겨둔다

## 검증 상태

폰 151 · 키오스크 39 · 백엔드 549 통과. analyze 신규 오류 0(기존 info 4건).
펌웨어 양쪽 컴파일 성공, 경고 0건 — **실기기 동작은 여전히 미검증**이다.
