Seongwonp/Simplelay/docs/devlog_2026-08-23.md

# 개발 로그 — 2026-08-23

## S3 접근성·터치 편의 패스 완료 (커밋 2개)

**키오스크**: 뒤로가기 히트박스 16→52px+잉크, 버튼 셀 InkWell 눌림 피드백, **큰 글씨 모드**(설정 토글, 1.22배 — 800x480 안전 상한), 설정 오버레이 스크롤화(오버플로 원천 차단)

**폰**: 수동 조작 셀 InkWell+햅틱, 마이크 버튼 Semantics+햅틱, 커스텀 가전 삭제 확인 다이얼로그+히트박스 확대, FAB BLE 의존 모순 수리, 상태 화면 연결선 버그, 제안 폴링 재진입 가드, analyze 경고 1건 해소

검증: 키오스크 9 + 폰 114 테스트 전부 통과. 다음: 사용자 친화(접근성) 가이드라인 리서치 → S4 실행 히스토리

## 사용자 편의(접근성) 가이드 리서치 완료

공인 표준 4종(KS X 3253 모바일 앱 접근성 19항목 / KS X 9211 무인정보단말기 / 고령층 친화 디지털 접근성 표준 키오스크 가이드 / WCAG 2.2·Material 터치 타깃)을 조사해 **[사용자편의-가이드-체크리스트.md](사용자편의-가이드-체크리스트.md)** 작성 — 항목별 적용됨✅/할 것⬜ 매핑. S2·S3 작업 대부분이 표준 요구와 정합함을 확인(음성 안내=KS X 9211 1차 요구, 터치 타깃=WCAG AAA 지향, 큰 글씨=고령층 표준). 잔여 ⬜는 실기기 항목(TalkBack 완주, 14pt 실측)과 저비용 점검(용어 순화, Semantics 확대). 협회 자문 때 지참용.

## S4 실행 히스토리 완료 (커밋 2개)

- 백엔드: job_history(SQLite/인메모리 게이트) + GET /history — 버튼별 시도 횟수·retry_count 기록, 실패 주입과 연동 검증. pytest **379**
- 폰: /history 타임라인 — **"재시도 N회 후 성공" 배지**(폐루프 증거 가시화), 홈 AppBar 진입. flutter test **117**
- 발표 활용: 실기기 검증 기간의 성공률·재시도 통계를 이 테이블에서 추출

다음: S5 SSE 푸시(경보 채널 우선) → S6 공간 맥락 스캐폴딩+문서

## S5 SSE 푸시 완료

- `GET /events` (의존성 추가 없음, 변화만 푸시+keepalive, 제너레이터 분리 단위테스트 4개) — pytest **383**
- 키오스크 KioskEventStream(백오프 재접속, 파서 순수 분리) — 경보 3초→즉시, 폰 발 실행 감지 2초→즉시. 폴링은 폴백으로 유지, 엣지 판정 단일화로 중복 공급에도 1회 발화. flutter test **11**
- 배운 것: TestClient는 무한 SSE 스트림 종료에서 hang → 스트림 로직을 콜러블 주입 제너레이터로 분리해 테스트

남은 것: S6 공간 맥락 스캐폴딩 + 문서(개발현황 재작성·데모 시나리오 v1)

## S6 완료 — SW 선행 스프린트 전체 종료 🎉

- **presence 스캐폴딩**: PresenceStore(TTL 60초, unknown 허용 정책) + POST/GET /presence + 부재 중 자동 제안 보류(SIMPLELAY_PRESENCE_GATING 게이트, 데모 트리거는 비대상). 실기기 날엔 RPi4 카메라 감지기가 POST만 하면 공간 맥락 완성. 테스트 9개, pytest **391**
- **개발현황.md 전면 재작성** — "코드 완료 vs 실기기 검증" 구분 표기 원칙
- **데모시나리오.md v1** — 5장면 전부 리허설 API로 재현 가능 + 실패 대응 카드

### S1~S6 최종 집계 (8/22~8/23)
실패 주입·TTS(양쪽)·접근성 패스·큰 글씨·실행 히스토리(+타임라인)·SSE 즉시 푸시·presence 게이트·문서 3종. 테스트: 백엔드 391 / 폰 117 / 키오스크 11 — 전부 통과.

**다음: 데스크탑에서 LG 기술 자료 평가 세션** (자료는 데스크탑에만 있음 — 로컬 전용, git 금지) → 이후 실기기 검증일.
