Seongwonp/Simplelay/docs/devlog_2026-08-20.md

# 개발 로그 — 2026-08-20

## 오늘 한 일

### 1. 전체 코드 리뷰 + 결선 로드맵 수립

리뷰 3트랙(폰 앱 / 키오스크 / 백엔드) 정밀 분석 결과:
- 평점: 폰 앱 6.5 / 키오스크 6.0 / 백엔드 6.0 (10점 만점) — 설계·테스트 품질은 상위권,
  실기기·릴리즈 조합 미검증이 감점 요인
- **치명 이슈 8건** 식별 (릴리즈 네트워킹 전멸, mDNS 미해석, /stop no-op, 제안 생성 데드코드,
  키오스크 배포 이원화, 실행 모델 타임아웃 불일치, 폰 상태화면 BLE-only, BLE 데모 래치)
- 10주 계획을 [결선로드맵.md](결선로드맵.md)로 확정 — W0(긴급 수리)부터 시작

### 2. W0 긴급 수리 — 5건 완료 (커밋 6개)

| 커밋 | 내용 |
|---|---|
| `docs(로드맵)` | 결선 10주 실행 계획 문서 추가 |
| `fix(app)` 매니페스트 | main AndroidManifest에 INTERNET 권한 + cleartext 허용 — 릴리즈 APK에서 RPi HTTP 통신이 전멸하던 치명 결함. 디버그는 Flutter 툴 자동 주입으로 가려져 있었음 |
| `fix(app)` BLE | ① `connect()`에 `_isSimulated = false` — 시뮬레이션 1회 후 실기기 전송이 조용히 무시되던 래치 버그 ② connectionState 구독 필드 보관·정리(재연결 누적/dispose 누수) ③ scan 타임아웃 콜백의 closed-controller StateError 방지 |
| `feat(rpi)` 긴급 정지 | `/stop` no-op → 실구현. ClosedLoopController에 threading.Event 기반 협조적 취소(버튼 사이 + 재시도 경계에서 확인, SAFETY_STOPPED 종료). UART 모드는 RPi4에 abort 전송. 로컬 + 등록된 전체 노드에 정지 전파. 응답에 `was_running` 추가(정지됨 vs 실행 없음 구분). 테스트 7개 |
| `feat(rpi)` 제안 배선 | `create_suggestions()`가 프로덕션 호출자 0곳(공감지능 데드코드)이던 문제 — lifespan 60초 주기 패턴 감지 루프 + 시연용 `POST /demo/suggest`(패턴 우회 즉시 생성, 멱등, DND 시 409). reject를 서비스 메서드로 이동(라우터의 private 접근 계층 위반 제거). 테스트 5개 |
| `fix(kiosk+app)` | 키오스크 `_finishExecuting` phase 가드(정지 후 지연 응답이 idle을 완료 화면으로 점프시키던 레이스). 폰 앱 제안 승인·거부 예외를 사용자 언어 스낵바로 표면화(409 별도 안내) |

### 3. 검증 상태 ⚠

이 작업 기기에는 Flutter SDK·Python 툴체인이 없어 **테스트를 로컬 실행하지 못했다.**
개발 환경에서 다음을 돌려서 확인 필요:

```
pytest rpi/tests               # 신규 12개 포함 전체
cd app && flutter analyze && flutter test
cd rpi5-touchscreen-app && flutter analyze
```

## W0 남은 항목 (사람 손 필요)

- [ ] **릴리즈 APK 실기기 리허설 1회** — `flutter build apk --release` 후 폰에 설치,
  RPi5(또는 로컬 uvicorn)에 실제 HTTP 실행이 되는지 확인. 이번 매니페스트 수정의 검증이자
  이후 매주 반복할 리허설의 시작
- [ ] 위 테스트 스위트 실행 + 실패 시 수리

## 다음 (W1, 8/25~)

Job 모델 전환 — `/execute` 즉시 job_id 반환 + 백그라운드 실행 + `/status` 폴링 통일.
폰·키오스크 상태 동기화와 타임아웃 불일치가 이 한 방에 풀린다. 상세는 결선로드맵.md W1.

## 메모

- LG 기술 자료는 도착 시 git 밖 로컬 전용 폴더에서만 분석 (.gitignore의 기존 관례 유지)
- 커밋 관례: 단계마다 1커밋, 한국어 conventional commit
