Seongwonp/Simplelay/docs/devlog/devlog_2026-09-16z.md

# 개발 로그 — 2026-09-16 밤 (남은 결함 수리)

기준 HEAD: `18e0327` → `6bf0027`(+ 이 기록).
동결 기간이라 새 기능 없이, [로그 y](devlog_2026-09-16y.md) "남은 것"의 결함만 고쳤다.
모두 백엔드이고, 수리마다 수정 전 코드나 결함을 되살린 변형에서 회귀 테스트가 실패하는 것을
확인한 뒤 커밋했다.

## 고친 것

| 커밋 | 결함 | 수리 |
|---|---|---|
| `0c96ab5` | 내장 가전(전자레인지 등) 보정은 판 번호 검사를 건너뛰고 응답 판 번호가 늘 0 — 폰 두 대가 서로의 좌표를 조용히 덮음 | 내장 가전 보정에도 판 번호를 두고 저장마다 올림, 다르면 409. 보정 기록에 함께 저장해 재시작 뒤 유지(판 번호 없는 옛 기록은 1판) |
| `b0cf624` | 사진 인식 응답을 통째로 읽어, 게이트웨이가 폭주하면 거대한 본문이 서버 메모리로 들어옴 | 응답 1 MB 상한, 넘으면 502 |
| `86beef4` | 동시 1건 게이트만 있고 총량 제한이 없어, API 키가 꺼진 기본 구성에서 같은 망 누구든 공유 크레딧을 소진시킬 수 있음 | 나간 요청을 한 시간 창으로 세고 상한(기본 20, `SIMPLELAY_VISION_MAX_PER_HOUR`)을 넘으면 요청을 보내지 않고 429. 실패한 요청도 셈 |
| `6bf0027` | (Copilot 지적) 상한을 둘 때 `read(limit+1)`을 한 번만 불러, 부분 읽기에서 정상 응답이 잘릴 수 있음 | EOF까지 나눠 읽고 누적 크기로만 상한 판단 |

## Copilot CLI 교차 리뷰

앞의 세 커밋을 올린 뒤 읽기 전용 리뷰를 받았다. 판 번호 수리와 호출 상한에는 결함이 없다고
봤고(바쁨 409·사진 검증 422는 상한을 쓰지 않음, 확인과 예약 사이에 await 없음), 응답 읽기
한 건을 지적해 `6bf0027`로 고쳤다. 리뷰 뒤 저장소 변경이 없는 것을 확인했다.

## 검증 (이 기기)

| 대상 | 결과 |
|---|---|
| 백엔드 | **1,241** 통과 (1,230 + 회귀 11) |
| 폰·키오스크 | 이번 변경 없음, 재실행하지 않음(직전 355 · 110, 폰 골든 51장) |

폰은 200이 아닌 응답의 서버 문장을 그대로 보여 주므로, 새 429 안내("한 시간에 N번까지예요")도
별도 앱 수정 없이 사용자에게 보인다.

## 아직 남은 것

- 공간 상태 머신의 `begin_execution`/`end_execution` 호출자가 없다. "AT_DEVICE에서만 전원을
  켠다"는 아직 문서상의 계약이다 — 구동부 전원 제어가 생길 때(하드웨어 도착 후) 연결한다.
- 저장된 버튼 mm를 읽는 실행 코드가 없다. 손으로 넣은 좌표와 보정 유래 좌표를 구분하는
  장치도 그때 함께 정한다(하드웨어 연결 설계 §1 "결정 필요").
- 호출 상한은 프로세스 안 상태라 워커가 여럿이면 워커마다 센다(서버는 단일 워커 전제).

둘 다 실물 없이 만들면 추측 설계가 되므로 이번에는 손대지 않았다.

## 다음

팀 작업 규칙 "이어서 할 때"의 열린 일 순서. 하드웨어가 오면 H0~H1이 먼저다.
