Seongwonp/Simplelay/docs/devlog/devlog_2026-10-13-auto-rule.md

# 2026-10-13 — 조리 완료 → 공기청정기 자동 실행 허용 규칙 (데스크톱)

사용자 승인(10/13): [시연 v4](../본선-시연-계획-v4.md) 선행 조건 ④. 전자레인지 조리 완료(확인된 사건) → ThinQ 공기청정기
풍량 변경 **하나만** 자동으로 해도 되게 사용자가 고르는 규칙. 그 밖으로 넓히지 않았다.

> **검증 수준: 모의 끝-끝까지.** 모의 완료 사건(리허설 주입, source=injected) → 자동 실행 규칙 → 공식 SDK → 저장소 안 모의
> ThinQ 클라우드 공기청정기 → 상태 재조회 → 기록까지 시험으로 돌렸다. **실제 CT 조리 판정·실가전·실제 ThinQ 클라우드는
> 한 번도 쓰지 않았다.** 조리 완료 판정 기준값(`SIMPLELAY_CYCLE_*`, 전자레인지 설계 초기값)은 측정 필요 —
> [실측 기록표](../실측-기록표.md) §6.

## 1. 커밋

| 커밋 | 내용 |
|---|---|
| `805e4d6` | v4 기본 시나리오 `cook_done_air`(조리 완료 → 공기청정기 강풍 카드). 트리거는 RPi4 `appliance_done`(전자레인지 `heat_complete`, 입력에 CT 전력 `power`)뿐 — 버튼 누름 완료·종료음만은 카드 없음. 완료 기록에 RPi4 시각(`at_s`·`t_monotonic_ns`) 보존, RPi5 모의 주입도 보낸 시각을 싣는다. `cycle_end.py` 전자레인지 기준값 주석을 실측 기록표 §6에 연결 |
| `a5badc0` | 서버 규칙: `rpi/routines/auto_rules.py`(모델·저장·엔진), `POST /suggestions/{id}/approve-and-allow`, `GET/PUT/DELETE /routines/auto-rules[/{id}]`, `POST /routines/auto-rules/{id}/enable`, `GET /routines/auto-rules/runs`, `/suggestions`의 `auto_rule_offer`, `/stop`·게이트웨이 비상정지 연결. 서버 시험 23 + 모의 클라우드 끝-끝 2 |
| `9d15b25` | 폰: 카드 세 갈래와 조건·동작 확인 시트, 루틴 목록의 자동 실행 줄. 위젯 시험 9 |
| (이 커밋) | 이 기록, v4 문서 상태, 팀 작업 규칙 한 줄 |

키오스크는 바꾸지 않았다(자동 실행 job은 키오스크가 시작한 job이 아니라 남의 실행으로 보이고, 결과 문구는 기존 ThinQ 표시 그대로). 키오스크 시험 278 통과로 깨지지 않음만 확인.

## 2. 흐름

1. RPi4가 전자레인지 CT 채널 사이클 끝을 보내면(`appliance_done`, `heat_complete`) 서버는 같은 사건인지·규칙이 있는지 본다.
2. 켜진 규칙이 없으면 카드 "공기청정기 강풍으로 바꿀까요?"(근거: 콘센트 전력으로 확인, 모의면 '(시연 주입)'·'(모의 입력)').
3. 폰 카드: **[이번만 실행] [다음부터도 자동으로] [안 할래요]**. 두 번째는 아래에서 올라오는 시트(새 화면 아님):
   "이번에 실행하고, 다음부터 자동으로 실행할까요? / 조건: 전자레인지 조리 완료가 확인됐을 때 / 동작: <공기청정기 이름> 풍량을 강으로 변경
   / [허용하고 이번에도 실행] [취소]". 허용하면 카드가 보여 준 내용의 지문을 실어 이번 실행(종전 승인 경로)과 규칙 저장을 한 번에 한다.
   빈 루틴 폼은 없다 — 카드 내용이 그대로 규칙이다.
4. 다음 조리 완료가 오면 승인 없이 그 동작 하나를 보낸다. 결과 알림은 장치별로 확인된 것만: "데우기가 끝났어요 (콘센트 전력으로 확인)",
   "<공기청정기> 풍량을 바꿨어요 (상태 재조회로 확인)", 미확인이면 "명령을 보냈지만 바뀐 것을 확인하지 못했어요 — 자동으로 다시 보내지 않아요".
   모의면 "— 모의 실행 · 실제 조작 아님". 공기 상태(깨끗함)는 말하지 않는다.
5. 루틴 탭 '내 루틴' 위에 규칙 줄: 조건·동작·'자동 실행 켜짐/꺼짐'·꺼진 이유·마지막 결과, [자동 실행 끄기]/[다시 허용](확인 시트)·
   [설정값 바꾸기](바꾸면 꺼지고 바뀐 내용으로 다시 허용을 묻는다)·[지우기].

## 3. 필수 조건과 강제 자리

| # | 조건 | 강제 |
|---|---|---|
| 1 | 낮은 위험 ThinQ 동작만 | `LOW_RISK_ACTIONS`(공기청정기 풍량·운전 모드·전원 **켜기**만). 물리 누름이 섞인 카드는 `auto_rule_offer`가 null(폰 버튼 없음)이고 `approve-and-allow`는 422. 규칙 수정은 설정값만(버튼·단계 넣기 422), 저장된 규칙도 실행 직전 다시 판정 |
| 2 | 모의 사건 → 모의 ThinQ만 | 대상 실행 환경이 real이면 사건 출처가 `real`일 때만 보낸다. 모의·주입 사건은 막고 이유를 기록. 실행 환경을 모르면 막음. real 조립 경로(시험 안에서만 모의 클라우드로 돌린 SDK)로 주입 사건 → 제어 0건 확인 |
| 3 | 같은 사건 1회·오래된 사건 제외·미확인 재전송 없음 | 사건 키 = 가전·이벤트·출처·RPi4 끝 시각(`at_s`), 처리한 키를 남김(DB 있으면 재시작 뒤에도). RPi4 시각이 없으면 막음, 나이(보낸 시각 − 끝 시각) > `SIMPLELAY_AUTO_RULE_MAX_EVENT_AGE_S`(기본 120초, **측정 필요**) 또는 허용하기 전에 끝난 조리면 막음. 재시도 코드 없음 — 미확인 뒤 같은 사건 재수신도 0건 추가 |
| 4 | 허용은 조건·대상·속성·값에 묶임 | 지문 = 시나리오·조건 가전·이벤트·근거(CT 끝)·대상 가전·대상 기기 키(기기 ID 해시)·종류·동작·속성·값. 확인 시트가 본 지문과 서버 지문이 다르면 409(저장·실행 둘 다 안 함). 값을 바꾸면 꺼지고 새 지문으로만 다시 켜짐(옛 지문 409). 대상 기기가 없어지거나 다른 기기로 바뀌면 실행 시점에 꺼짐 + "다시 허용이 필요해요" + 카드 다시 제안 |
| 5 | 비상정지 | `/stop` 맨 앞에서 세대를 올리고(입출력 없음 — 모션 정지를 늦추지 않음) 켜진 규칙을 모두 끔. 실행 게이트(`approval_guard`, 서비스 락 안)가 세대를 다시 봐 판단은 끝났지만 아직 보내지 않은 자동 실행을 막음. RPi4 콘센트 비상정지 걸림이면 막음. 기록 문장: "이미 ThinQ 클라우드로 보낸 명령은 취소되지 않아요(공기청정기를 되돌리거나 끄지 않아요)" — 취소·꺼짐을 주장하지 않음 |
| 6 | 조리 완료 근거 = CT 종료 판정 | 자동 실행·카드 모두 `appliance_done`(입력에 `power`)에서만. 실행 끝(버튼 누름 완료) 이벤트는 이 경로에 오지 않는다(시험: 전자레인지 누름 성공 → 카드·자동 실행 0) |

## 4. 검증

- 새 시험: 서버 **33**(카드 8, 규칙 23, 모의 클라우드 끝-끝 2), 폰 위젯 **9**.
- **수정 전 실패 확인:** 카드 시험은 HEAD 코드에서 4건 실패(나머지 4건은 '카드 없음' 쪽이라 원래 통과), 규칙 시험은 규칙 모듈·배선을 빼고 23건 전부 실패,
  끝-끝 2건 실패, 폰 시험은 HEAD `lib`에서 8건 실패(허용 내용 없는 카드 1건은 원래 통과).
- 전체: 백엔드+rpi4 **2,853 통과·12 건너뜀**(SDK 설치, 원격 f729d09 위로 rebase한 뒤 다시 실행), 폰 **755**(`--exclude-tags screenshot`, ASCII 임시 worktree), 키오스크 **278**,
  폰 `analyze` error·warning 0(기존 info 4), repo guard·문서 링크 시험 통과. 골든 미실행·미갱신.
- 기존 시험 수정 1곳: `test_demo_v3_gaps.py`의 기본 카탈로그 기대값 `[]` → `["cook_done_air"]`(v2 셋은 여전히 없음).
- 실제 ThinQ 클라우드 호출 **0건**, 실가전 **0대**, 실제 CT 판정 **0회**.

## 5. 남은 것

1. 실제 CT 조리 판정 실측(실측 기록표 §6 — 정상·가열 중 전력 감소·중간 취소·종료 후 팬). B·C에서 오판이 나오면 자동 실행 조건을 다시 설계한다.
2. 실가전(공기청정기) 도착 뒤 real 모드에서 같은 흐름 1회: 카드 → 허용 → 실물 CT 완료 사건(source=real) → 자동 강풍 → 상태 재조회.
3. 사건 나이 상한(120초)·완료 판정 지연은 실측으로 정한다.
4. 키오스크는 자동 실행 결과를 따로 알리지 않는다(남의 실행으로 감지만). 필요하면 시연 전에 정한다.
5. 같은 조건에 규칙은 하나(같은 조건·대상·동작이면 새 허용이 바꾼다). 다른 조건·가전으로 넓히지 않았다.
