Seongwonp/Simplelay/docs/devlog/devlog_2026-10-14-already-at-target.md

# 2026-10-14 — ThinQ '이미 목표값' 수리: 확인한 사실만큼 네 경우로 말하기 (데스크톱, 10/15 동결 전 결함 수리)

[보드 날 발견 3](devlog_2026-10-14-desktop-board.md)(§5 3번): 공기청정기가 이미 강풍인데 강풍으로 제어하면(반복 시연에서 흔함) 결과가
'바뀐 것을 확인하지 못함(unconfirmed)'으로 남았다. 실행기는 보내기 전 상태를 이미 읽고 있었지만, 같은 값이어도 보낸 뒤 '확인 불가'로 끝냈다.
새 기능이 아니라 결과 판정·문구 수리다. 팔레트·탭·새 화면은 바꾸지 않았다.

> **검증 수준: 모의 클라이언트·모의 ThinQ 클라우드(공식 SDK 경유)·위젯 시험까지.** 실제 클라우드·실가전·실패널·실폰으로는 확인하지 않았다.
> 실물 확인 항목은 [ThinQ 실물 확인 절차 §5-1](../ThinQ-실물-확인-절차.md).

## 1. 커밋

| 커밋 | 내용 |
|---|---|
| `4f495dc` | **서버** — 실행기·값 객체·자동 실행 결과·기록 구분(`dispatch`)·설정 이름(`setting_phrase`)·문장 모듈(`rpi/services/thinq/wording.py`) |
| `ef9bbc0` | 시험 하나의 문구 기대 수정 — `test_auto_rule_eval4.py`의 재시작 경계 시험이 **HEAD(`da852e6`)에서도 실패**하고 있었다(`7828856`에서 사유 문장이 '다시 켜지기 전'으로 바뀜). 판정은 그대로 |
| `c4c1ae1` | **폰** — 실행 상태·확인 칩·기록·단계 줄 문구 |
| `1191f2c` | **키오스크** — 자동 실행 한 줄·완료 화면·확인 칩·음성 안내 문구 |
| (이 커밋) | 문서 — 이 기록, [protocol](../protocol.md)('ThinQ 결과의 네 경우'), [ThinQ 실물 확인 절차](../ThinQ-실물-확인-절차.md) §4-2·§5·§5-1, 팀 작업 규칙 한 줄 |

## 2. 동작 — 네 경우 (제어 요청 횟수와 문장)

| 경우 | status / receipt / confirmation | 제어 요청 | 서버 문장(`last_detail`) |
|---|---|---|---|
| 보내기 전부터 목표값 | `succeeded / not_dispatched / already_at_target` | **0회** | 이미 강풍으로 설정돼 있어요. 변경 명령을 보내지 않았어요. |
| 보내기 전 다른 값 → 보낸 뒤 목표값 | `succeeded / accepted / state_confirmed` | 1회 | 강풍으로 바꿨어요. |
| 보내기 전 조회 실패·값 없음 → 보낸 뒤 목표값 | `succeeded / accepted / state_confirmed_unknown_before`(새 값) | 최대 1회 | 강풍으로 설정된 것을 확인했어요. ('바꿨어요' 금지 — 원래 강풍이었을 수 있다) |
| 보낸 뒤 상태 확인 실패 | `unconfirmed / accepted / none` | 1회, **추가 전송 0회** | 명령을 보냈어요 — 설정이 바뀌었는지 확인하지 못했어요. 자동으로 다시 보내지 않아요 |

- 설정 이름은 `ThinqCapability.setting_phrase` — 풍량은 '강풍'·'약풍', 그 밖은 속성 이름을 붙인다('풍량 중'·'운전 모드 청정'·'운전 시작').
  자동 실행은 job을 만들 때의 사본(`value_phrase`)을 쓴다.
- **보내기 전 조회 실패의 동작이 바뀌었다:** 종전에는 조회 예외(오프라인 제외)면 '상태를 읽지 못해 보내지 않았어요'였다. 이제 원격 제어 확인이
  필요 없는 동작(공기청정기)은 **1회 보내고** 재조회로 판정한다. 세탁기 시작·일시정지(원격 제어 허용을 먼저 봐야 함)와 오프라인은 종전대로 보내지 않는다.
- 값 객체가 조합을 강제한다: `already_at_target`은 `succeeded`+`not_dispatched`만, `state_confirmed_unknown_before`는 `succeeded`+`accepted`만,
  둘 다 물리 경로 불가. `not_dispatched`의 성공은 `already_at_target`뿐.

### 정지·철회·전송권과의 순서

- '이미 목표값'도 **정지(미전송 취소) → 전송 직전 재판정(규칙 켜짐·지문·대상·사건 나이·정지 세대) → 전송권 확인**을 모두 지난 뒤에만 나온다.
  어느 하나에 걸리면 `failed / not_dispatched / none`이고 자동 실행은 `outcome: blocked`로 기록된다(성공 기록 없음).
- 보내지 않으므로 전송권 확인은 `commit(will_send=False)` — 검사만 하고 '전송 개시'로 표시하지 않는다. 그 뒤의 끄기·삭제가 '이미 보내기 시작했어요'(in_flight)로 알리지 않는다.
- 같은 사건 1회: 사건 키는 받을 때 처리 표시된다. 이미 목표값으로 끝난 사건을 다시 받아도 `duplicate`(시험).

### 기록 구분 `dispatch`

`/history`·`/routines/auto-rules/runs`·`last_auto_run`에 `dispatch`: `sent`(명령을 보낸 실행) · `state_only`(상태만 확인 — 이미 목표값) ·
`not_sent` · `unknown`. receipt·confirmation에서 유도한다(DB 열 추가 없음). 자동 실행 기록의 `reason`도 이미 목표값이면
'이미 목표 설정이라 변경 명령을 보내지 않았어요 — 이 사건은 처리했어요'로 바꿔, 제출 때의 '승인 없이 보냈어요'를 남기지 않는다.

### 집계·연쇄

- 사용 기록(제안 집계)은 세 성공을 모두 성공으로 센다(`Confirmation.reached_target`).
- 루틴 다음 단계의 '시작 확인'과 `after_done` 깨우기는 **종전대로 `state_confirmed`만**(`confirms_appliance` 그대로) — 이미 목표값·전 값 모름으로 다음 가전을 깨우지 않는다.

## 3. 실제 표시 문구 (폰·키오스크)

| 경우 | 폰 실행 상태(큰 문장) | 폰 확인 칩 / 기록 | 키오스크 자동 실행 한 줄 | 키오스크 완료 화면 |
|---|---|---|---|---|
| 이미 목표값(실제) | 이미 강풍으로 설정돼 있어요. 변경 명령을 보내지 않았어요. | '이미 그 설정이라 보내지 않음' / '이미 그 설정이라 변경 명령을 보내지 않았어요'(성공) | 공기청정기는 이미 강풍으로 설정돼 있어요. 변경 명령을 보내지 않았어요 | '이미 그 설정이에요' + 서버 문장 |
| 이미 목표값(모의) | 모의 · 이미 강풍으로 설정돼 있어요. 변경 명령을 보내지 않았어요. 실제 가전은 조작하지 않았어요. | '모의 · 이미 그 설정이라 보내지 않음' / '연습 · 이미 그 설정이라 변경 명령을 보내지 않았어요' | … 보내지 않았어요 · 연습 모드 | '연습 · 이미 그 설정이에요' + 서버 문장(머리 '연습 모드' 유지) |
| 바꿈(실제) | 강풍으로 바꿨어요. | '상태 확인됨' / '강풍으로 바꿨어요' | 공기청정기를 강풍으로 바꿨어요(옛 서버: 공기청정기 풍량을 강으로 바꿨어요) | 가전 상태를 확인했어요 + 강풍으로 바꿨어요. |
| 전 값 모름(실제) | 강풍으로 설정된 것을 확인했어요. | '설정된 것 확인됨' / '강풍으로 설정된 것을 확인했어요' | 공기청정기가 강풍으로 설정된 것을 확인했어요 | 가전 상태를 확인했어요 + 강풍으로 설정된 것을 확인했어요. |
| 미확인 | 명령을 보냈지만 설정이 바뀌었는지 확인하지 못했어요. 가전을 직접 확인해 주세요. | '접수됨' / '보냈지만 설정이 바뀌었는지 확인하지 못했어요' | 공기청정기 설정이 바뀌었는지 확인하지 못했어요 | (종전) 확인 못 함 화면 |

- 모의 표시는 그대로 남는다: 폰 '모의 · …'·'연습 · …', 키오스크 ' · 연습 모드'·'연습 · …', 서버 알림 ' — 모의 실행 · 실제 조작 아님'.
- 모의 '바꿈'은 폰·키오스크 모두 종전 연습 문장('모의 ThinQ 명령을 보내고 모의 상태를 확인했어요…')을 유지했다.
- 서버 자동 실행 알림(폰 루틴 목록 '최근 실행' 줄·알림함): '공기청정기(모의 클라우드)는 이미 강풍으로 설정돼 있어요. 변경 명령을 보내지 않았어요 — 모의 실행 · 실제 조작 아님',
  '…를 강풍으로 바꿨어요 (상태 재조회로 확인)', '…가 강풍으로 설정된 것을 확인했어요 (보내기 전 값은 읽지 못했어요)', '… 설정이 바뀌었는지 확인하지 못했어요 — 자동으로 다시 보내지 않아요…'.

## 4. 시험

- **수정 전 실패 확인:** 새 서버 시험 초안(이미 목표값·정지·재판정·끝-끝 2건, 9건)을 HEAD 코드에서 돌려 6건 실패(행동 실패)·3건 통과(종전에도 지키던 정지·조회 실패 경계)를 봤다.
  네 경우로 넓힌 최종 시험 파일은 HEAD에서 `wording` 모듈이 없어 수집 단계에서 실패한다. 폰·키오스크 새 시험은 HEAD에서 컴파일 실패(새 인자)였고,
  컴파일되는 부분만 떼어 HEAD에서 돌려 폰 4건·키오스크 2건 모두 행동 실패를 확인했다(기록·단계 줄·실행 상태·자동 실행 한 줄·확인 칩).
- 서버 새 시험 `rpi/tests/test_thinq_already_at_target.py` 20건: 값 객체 조합, 네 경우의 제어 요청 횟수·문장(이미 목표값 0회, 바꿈 1회, 조회 실패 최대 1회,
  재조회도 실패하면 추가 전송 0회), 세탁기는 조회 실패 시 보내지 않음, 정지가 먼저, 재판정·전송권이 먼저(`will_send=False`), 모의 클라우드 끝-끝 3건
  (자동 실행: 이미 강풍 → 제어 요청 0회·`state_only`·모의 표시·같은 사건 `duplicate`·약풍 뒤 새 사건은 1회 '바꿨어요' / 승인 카드 재승인: 0회 /
  **꺼진 규칙 + 이미 강풍 → `blocked` 기록, 성공 기록 없음, 0회**).
- 종전 시험 중 옛 계약을 고정하던 것은 새 계약으로 고쳤다: 같은 값 재명령(`test_thinq_u1`)·이미 진행 중인 세탁기 시작(`test_thinq_profile_gate`)·
  자동 실행 두 건(약풍으로 되돌린 뒤 실행하도록)·'풍량을 바꿨어요' 문구 기대 4곳·폰 미확인 문구 기대 2곳.
- 결과(골든 제외): **백엔드+rpi4 2,969 통과**(13 건너뜀) · **폰 793 통과** · **키오스크 318 통과**. `flutter analyze` error·warning 0(폰 info 4·키오스크 info 1, 모두 기존 파일).
  Flutter는 ASCII 임시 worktree(`C:\sl-test10`)에서 돌리고 지웠다.
- 골든(비교만, 갱신 없음): **폰 55·키오스크 44 모두 통과 — 바뀐 장면 없음.** 임시 worktree에서만 시험 파일의 아이콘 글꼴 경로(`C:\flutter\flutter` 하드코딩)를
  이 데스크톱 경로로 바꿔 돌렸다(저장소 파일은 그대로).
- 저장소 가드·문서 링크 시험 통과(문서 커밋 전 재실행).

## 5. 남은 것

- **실제 클라우드·실가전:** 이미 강풍에서의 제어 요청 0회, 약풍→강풍 '바꿨어요', 실제 SDK의 조회 실패 형태(예외 종류)에서 1회 전송 — [절차 §5-1](../ThinQ-실물-확인-절차.md).
- 실제 클라우드에서 보내기 전 조회가 실패하는 빈도가 높으면 '설정된 것을 확인했어요'가 자주 나올 수 있다 — 실측 뒤 판단.
- 옛 폰·키오스크(이 커밋 전 빌드)는 `already_at_target`을 '보내지 않음' 칩·'명령을 보내지 않았어요' 기록으로 보일 수 있다 — **다음 배포 때 RPi5·폰·키오스크 같은 커밋.**
- 실패널·실폰에서 문장 길이(큰 글씨 줄바꿈)는 보지 않았다(골든은 기존 장면만 — 이미 목표값 장면 골든은 새 화면 금지에 따라 만들지 않았다).
