Seongwonp/Simplelay/docs/devlog/devlog_2026-10-14-eval3-fix.md

# 2026-10-14 — 3차 외부 평가(80점) 수리: 자동 실행 경계 H1·H2, 사건 신선도·결과 사본·ID 노출·습관 단정, 정책·문서 (데스크톱)

외부 3차 평가(저장소 밖, `cc14c76` 기준, 80/100 — HIGH 2·MEDIUM 4·LOW 3)의 9건을 고쳤다. 평가가 틀렸다고 본 항목은 없다.
**재현·수정 전 실패 범위는 §2 상세표 그대로다:** 코드 결함 6건(H1·H2·M1·M2·M3·M4)은 시험 먼저(실제 API·ThinQ controller·공식 SDK·저장소 안 모의 클라우드 배선)
→ 수정 전 실패 확인 → 구현 → 1커밋으로 했다. 다만 M1 링크 시험(`rpi4/tests/test_clock_ref.py`)은 새 규약이라 수정 전에 돌리지 않았고, 119초 경계·조회 대기 중 정지 시험은
수정 전에도 통과하는 회귀 방지용이다. L1~L3은 문서·주석·시험명 변경이라 재현·수정 전 실패의 대상이 아니다.
(4차 평가 L-N1로 이 도입부를 상세표 범위에 맞춰 고쳤다 — 처음 문장은 '9건 각각 직접 재현·수정 전 실패'로 과했다.)

> **검증 수준: 모의 클라우드·가짜 링크·위젯 시험까지.** 보드·실물 CT·ThinQ 실가전·실패널·실폰으로는 하나도 확인하지 않았다.
> M1은 **RPi4·RPi5가 같은 커밋**이어야 자동 실행이 돈다(옛 RPi4면 신선도 근거가 없어 늘 보류) — [인계](../archive/인계-2026-10-13-데스크톱.md) §8.

## 1. 커밋

| 커밋 | 항목 | 내용 |
|---|---|---|
| `8756f4b` | H1 | 자동 실행 재판정(`dispatch_guard`)을 ThinQ controller가 프로필·상태 조회를 **마친 뒤 전송 직전**에 대상 바인딩과 함께 다시 부른다. 규칙 지문·정지 세대·대상 기기 키 결속. controller 잠금 밖에서 부르므로 정지(`request_stop`)가 기다리지 않는다 |
| `9337875` | H2 | 허용 요청 시작 때의 정지 세대를 저장 단계까지 넘기고 저장 앞뒤로 대조한다. 규칙마다 '허용된 세대'(메모리)를 두어, 정지 뒤 다시 허용받지 않은 규칙은 저장된 '켜짐'이어도 쓰지 않는다. approve-and-allow 응답은 이번 실행(`job_id`)과 `auto_allow: {ok, reason}`을 나눠 주고, 폰은 실패 문장을 따로 알린다 |
| `32d7c4f` | M1 | 사건 신선도 기준점 규약(`clock_probe`/`clock_ref`, `act_info.clock_protocol: 1`), 프레임에 `clock_id`, RPi5가 받는 순간 끝 시각을 자기 단조 시계로 옮김(`rpi/services/event_clock.py`). 근거 없으면 보류, 전송 직전 나이 재확인 |
| `1ff2ac3` | M2 | job을 만들 때 대상 이름·설정 이름·값 이름·동작·값·동작 문장의 사본을 결과 기록에 넣고, 결과가 와도 지금 규칙으로 덮지 않는다 |
| `9a4507e` | M3 | `/thinq/devices`(기기 목록·등록 가전)·`/thinq/events`·`/demo/thinq/event`·`/demo/thinq/fault` 응답에서 원문 기기 ID를 빼고 `key`(`device_key`)·가전 ID |
| `5a54f6b` | M4 | 카드 질문 "공기청정기 풍량을 강으로 바꿀까요?", 근거는 가열 종료 감지 문장뿐. 같은 제안을 승인한 기록(제안 기록 최근 200건)이 있을 때만 "최근 기록에서 이 제안을 N번 승인하셨어요" |
| `b3fba33` | L1 | 정책 하나로(아래 §3), 코드 주석·v4·실측 기록표 §6 C1/C2·README 검증 표(날짜·빌드별)·인계 §6/§8 구분 |
| `750c243` | L2 | ThinQ 실물 확인 절차 — `unconfirmed`는 receipt·confirmation 함께 기록, accepted/none '접수 확인, 결과 미확인' · unknown/none '접수 여부 미확인' |
| `e693e26` | L3 | 시험명 두 개를 검사 범위로, `/status` `last_job_id`·`last_auto_run` 규약(마지막 1건·첫 조회 제외·비영속)을 [protocol](../protocol.md)에, 10/14 devlog 도입부 '수정 전 실패' 문장을 상세표 기준으로 |
| (이 커밋) | 문서 | 이 기록, 인계 §8, 팀 작업 규칙 한 줄, README 링크 |

## 2. 항목별 — 재현·수정 전 실패·고친 것

| # | 재현(시험) | 수정 전 | 고친 뒤 |
|---|---|---|---|
| H1 | `test_auto_rule_boundary.py` — 허용·약풍 → 모의 가열 종료 → controller의 `get_status`/`get_profile`(SDK) 앞에 문을 세우고 그사이 API로 끄기·값 변경+다시 허용·삭제 → 문 열기 | 6건 모두 모의 클라우드 POST 1건(HIGH)이 나감 | POST 0건, 기록 `blocked`·`not_dispatched`. 조회 대기 중 `/stop`은 문이 닫힌 채 5초 안에 끝나고 POST 0건(이 시험은 기존 controller 취소로 수정 전에도 통과 — 회귀 방지용) |
| H2 | approve-and-allow가 이번 실행을 제출한 뒤·규칙 저장 전에 실제 `POST /stop` 완료 / 목록 '다시 허용' 처리 중 정지 / 규칙 저장 DB 쓰기를 붙잡은 채 정지 | 3건 모두 늦은 저장이 규칙을 `enabled=true`로 켬(다시 허용은 200) | 규칙 꺼짐 유지, 응답 `auto_allow.ok=false`(다시 허용은 409 "…전체 정지가 들어와…"), 다음 사건 POST 0건. **물리 정지(서비스 정지 보고)는 규칙 저장의 DB 대기 중에 끝난다**(시험). 폰 위젯 시험 1건(HEAD lib에서 실패) |
| M1 | 허브 가짜 단조 시계 + 링크 기준점(허브 10,000초 ↔ RPi4 500초). RPi4가 끝을 본 즉시 낸 프레임(예전 나이 0초)을 늦게 전달 | 301초 늦은 첫 도착·허용 60초 전 사건·121초·전송 대기 중 100→130초·다른 세션 시계·링크 끊김 6건 모두 보냄 | 6건 막음(오래된 / 허용하기 전 / 지나 보내지 않았어요 / 근거가 없어). 119초는 보냄(경계 시험, 수정 전에도 통과) |
| M1 링크 | `rpi4/tests/test_clock_ref.py` — 실제 ActClient ↔ ActExecutor(키 있음·없음) | 새 규약이라 수정 전 실행 안 함 | `clock_probe`→`clock_ref`로 기준점, RPi4 프레임 끝 시각을 옮긴 값이 실제(같은 프로세스) 이하·0.5 s 안, 옛 RPi4(`clock_protocol` 0)는 탐침 없음·근거 없음, 링크 끊기면 기준점 버림 |
| M2 | 모의 클라우드에 HIGH를 보낸 직후·확인 전에 규칙 LOW 편집 / 삭제 / 대상 이름 변경 | 3건: 값 이름 '약' / 이름·값 None / 새 이름 '안방 공기청정기' | 기록·알림·`last_auto_run` 모두 '공기청정기(모의 클라우드) · 풍량 · 강' |
| M3 | 모의 클라우드: 발견 추가 뒤 `/thinq/devices`·발견·상태·준비·가전·이벤트·제안·`/status`·자동 실행·명령(정상·오프라인·잘못된 값)·추가/제거 오류·`/history`·알림함 + DEBUG 로그 / 모의: 이벤트·장애 주입 | 4건(새 2 + 장애 응답 형태 기존 2) — `/thinq/devices`에 원문 ID | 응답·오류·DEBUG 로그 어디에도 원문 ID 없음. 소비자 확인: 폰은 `appliances[].appliance_id`·이름·준비 상태만 읽고, 키오스크·스크립트는 이 API를 쓰지 않는다 |
| M4 | 빈 이력의 첫 가열 종료 카드 / 한 번 승인한 뒤 다음 카드 | 3건(질문 기대값 포함) | 첫 카드에 '식사·두시곤·습관·자주' 없음, 승인 1번 뒤에는 "최근 기록에서 이 제안을 1번 승인하셨어요" |
| L1~L3 | 문서·주석·시험명 | — | 동작 변화 없음. 폰 자동 실행 시험의 조건 문장 픽스처를 지금 서버 문장으로 |

기존 시험 수정: `rpi4/tests/test_act_progress.py`·`test_simulator.py`(연결 알림에 `clock_probe`·`clock_ref`를 더해 실행 흐름 비교에서 뺌),
`rpi4/tests/test_link_auth.py`(연결 알림의 마지막 `clock_ref`까지 받은 뒤 프레임 수를 셈), `rpi/tests/test_thinq_g3_g6.py`(장애 주입 응답이
`device_id` 대신 `appliance_id`·`device_key`), `rpi/tests/test_cook_done_card.py`(카드 질문), `app/test/screens/auto_rule_test.dart`(조건 문장 픽스처).

## 3. 정책(L1, 사용자 확정)

**가열 종료가 감지되면 취소·문 열림이어도 제안·자동 실행이 일어날 수 있다 — 공기청정기 풍량 변경은 낮은 위험 동작이라 허용하고,
화면·문서에 '조리 완료가 아닐 수 있음'을 명시한다.** 코드 동작은 이미 이랬고(취소 판별 없음), 이번에 바꾼 것은 주석·문서·합격 기준이다.
실측 기록표 §6의 C1(취소 버튼)·C2(문 열림)는 실패가 아니라 **발생 여부·지연 기록**이고, 실패는 B(가열 중 전력 감소)·D(종료 후 팬)다.
문구를 바꿨다고 취소 판별이 생긴 것은 아니다.

## 4. M1 신선도 설계

- **서로 다른 장치의 monotonic을 그대로 비교하지 않는다.** RPi4 프레임의 `at_s`·`t_monotonic_ns`는 RPi4 프로세스 시계이고 `clock_id`가 그 시계를 가리킨다.
- 링크 세션마다 RPi5가 `clock_probe {probe}`를 보내기 **직전** 자기 단조 시각 L0을 적고, RPi4가 `clock_ref {probe, clock_id, t_monotonic_ns: R}`로 곧바로 답한다.
  RPi4 시각 x는 RPi5 시각 `L0 + (x − R)`로 옮긴다. R을 읽은 실제 순간은 L0 이후이므로 옮긴 값은 실제보다 이르거나 같다 → 나이는 최대 왕복 시간만큼 **길게** 잡힌다(보수적).
- RPi5는 프레임을 **받는 순간** 끝 시각을 옮겨 `event_end_mono_s`로 둔다. 나이 = 지금 − 그 값 — RPi4가 낸 뒤 링크·버퍼에서 늦어진 시간까지 센다.
  허용 전 사건 판정도 이 나이로 한다. 판단 때와 **ThinQ 전송 직전**(H1 재판정 안) 두 번 본다(상한 `SIMPLELAY_AUTO_RULE_MAX_EVENT_AGE_S`, 기본 120초, 측정 필요).
- **근거가 없으면 보류가 기본:** 기준점 없음(옛 RPi4·아직 답 없음), 프레임 `clock_id`가 지금 세션 것이 아님(RPi4 재시작), 링크 끊김(기준점 버림), 1초 넘게 미래.
  RPi5 모의 주입은 RPi5 자기 시계 식별자를 실어 같은 시계로 본다.
- 드리프트(수 ppm)는 120초 상한에 비해 무시했다 — 측정한 값이 아니다. 두 보드 사이 실제 왕복·지연은 재지 않았다.

## 5. 검증

- 백엔드+rpi4 **2,911 통과·12 건너뜀**(시작 2,882), 폰 **769**(`--exclude-tags screenshot`, 시작 768), 키오스크 **287**(변화 없음),
  `analyze` error·warning 0(기존 info 4·1), repo guard·문서 링크 시험 통과. Flutter는 ASCII 임시 worktree(`C:\sl-test8`, 끝나고 제거)에서 돌렸다.
- 실제 ThinQ 클라우드 호출 0건, 실가전 0대, 실제 CT 판정 0회, 보드 배포 없음.

### 골든 — 바뀐 장면(갱신하지 않음)

이번 작업으로 **새로 바뀐 장면은 없다.** 폰은 10/14 수리 때와 같은 10장이 같은 차이로 남아 있다(`home_dark`·`home_light`·`home_empty`·`lt_home_empty`·
`home_unknown_category` 0.18%, `home_two_appliances`·`home_demo` 0.36%, `home_large` 0.44%, `suggestion_large` 15.70%, `suggestion_long_large` 17.69%).
키오스크 42장 통과. 아이콘 글꼴 경로는 임시 worktree에서만 `C:\src\flutter`로 바꿔 비교했다(저장소는 그대로).

## 6. 남은 것

- **배포:** M1 규약(`clock_protocol`)·H2 응답(`auto_allow`)·M3 응답 모양 때문에 RPi4·RPi5·폰·키오스크를 같은 커밋으로. 옛 RPi4면 자동 실행이 늘 '근거가 없어' 보류다.
- **`/stop` HTTP 응답은 규칙 끄기의 DB 저장을 기다린다.** 물리 정지와 메모리 판정(세대)은 기다리지 않지만, DB 쓰기가 멈추면 응답이 늦는다 — 응답과 저장을 떼는 것은 이번 범위 밖.
- 실측: 두 보드 사이 `clock_probe` 왕복 시간, 가열 종료 → 자동 실행 지연(실측 기록표 §6), C1·C2 발생 기록, 사건 나이 상한 120초.
- M4의 근거 문장은 '이 제안을 승인한 횟수'(제안 기록 최근 200건, DB 있으면 영속)다 — 자연 습관 학습(28일·3일 반복)과는 다른 집계이고, 카드도 그렇게만 말한다.
- 골든 10장 눈 검토 뒤 갱신, 실폰 TalkBack·200%, CoreXY 실제 누름·CT·AS186HWWA 실물 — [인계](../archive/인계-2026-10-13-데스크톱.md) §8.
