Seongwonp/Simplelay/docs/devlog/devlog_2026-10-14-eval4-fix.md

# 2026-10-14 — 4차 외부 평가(84점) 수리: 정지 경로의 간접 DB 대기·전송과 철회의 직렬화·시각 기준점 경계 (데스크톱)

외부 4차 평가(저장소 밖, `7085c8e` 기준, 84/100 — HIGH 2·MEDIUM 3·LOW 1)의 6건을 우선순위(H-N2 → M-N3 → H-N1 → M-N1 → M-N2 → L-N1)대로 고쳤다.
평가가 틀렸다고 본 항목은 없다. **재현·수정 전 실패의 범위는 §2 상세표 그대로다** — 코드 결함 5건은 새 시험을 먼저 쓰고 수정 전 코드(구현 파일만
되돌린 상태)에서 실패를 확인한 뒤 구현했다. L-N1은 문서 변경이라 재현·수정 전 실패의 대상이 아니다.

> **검증 수준: 모의 클라우드·가짜 링크·가짜 시계·위젯 시험까지.** 보드·실물 CT·ThinQ 실가전·실패널·실폰으로는 하나도 확인하지 않았다.
> DB 대기·네트워크 대기·벽시계 보정·시계 드리프트·프로세스 재시작은 모두 시험이 만든 합성 조건이다.

## 1. 커밋

| 커밋 | 항목 | 내용 |
|---|---|---|
| `8f3ece7` | H-N2 | 규칙 저장소를 **불변 사본 교체**로: `get`·`list`는 잠금 없이 지금 사본을 읽고, 메모리 바꾸기(`put`·`remove`)는 짧은 메모리 잠금, DB 쓰기(`flush`)는 따로 잠금을 잡고 그때의 가장 새 사본을 쓴다. 실행 게이트(서비스 잠금 안)가 다른 요청의 DB 쓰기에 묶이지 않는다 |
| `a67d531` | M-N3 | 비상정지의 규칙 끄기는 메모리에서 바로, DB 쓰기·알림함 기록은 뒤에서(3회 재시도). 규칙 저장 **세션 표시**(`auto_rules_session`)로 재시작 뒤 철회 보장(§3). 폰: 같은 job 결과가 이미 왔으면 `/stop` 실패가 문장을 덮지 않고, 시간 초과는 '응답을 받지 못했어요 — 확인하고 있어요'로 미전송과 구분 |
| `7eb7a00` | H-N1 | **공통 전송권**: 최종 재판정(`dispatch_guard`)이 전송권 확인(`commit`)을 돌려주고 ThinQ controller가 POST 바로 앞(정지 확인과 같은 잠금 안)에서 부른다. 끄기·값 바꾸기·삭제·비상정지의 규칙 끄기는 같은 메모리 잠금(`_send_lock`) 안에서 메모리를 바꾼다. 전송 개시 뒤의 철회 응답에는 `in_flight_notice` |
| `293ea73` | M-N1 | 시각 기준점 유효 기간(기본 600초)·상대 드리프트 상한(기본 500ppm)×기준점-사건 간격만큼 나이를 길게·불확실성 한계(기본 1초) 넘으면 보류·연결 유지 중 주기 재탐침(기본 60초) |
| `fa41456` | M-N2 | 허용 전후를 **허브 단조 시계 축**에서: 이 프로세스에서 허용했으면 그 순간, DB에서 불러온 허용이면 이 프로세스(사건 시계)가 시작한 순간이 경계. 벽시계(UTC) 비교 제거 |
| `8b3c365` | L-N1 | v4 제목·실측표 §6 제목 '가열 종료 감지', README G3 행(시료 `4819401`·개발자 `/dev/stop`·n=10, 최종 배포 `1bba354`와 분리), 3차 devlog 도입부 정정, 인계 §8 UART 리허설 확인 조건 |
| (이 커밋) | 문서 | 이 기록, 인계 §8, 팀 작업 규칙 한 줄 |

## 2. 항목별 — 재현·수정 전 실패·고친 것

새 시험은 거의 `rpi/tests/test_auto_rule_eval4.py`(실제 API·서비스·ThinQ controller·공식 SDK → 저장소 안 모의 클라우드), 시계 계산은
`rpi/tests/test_event_clock_bounds.py`, 링크 재탐침은 `rpi4/tests/test_clock_ref.py`(실제 ActClient ↔ ActExecutor), 폰은
`app/test/providers/stop_report_binding_test.dart`(실제 ExecutionStatusNotifier·RpiApiService).

| # | 재현(시험) | 수정 전 | 고친 뒤 |
|---|---|---|---|
| H-N2 | 허용·약풍 → ① 자동 실행을 판단 뒤·제출 직전에 세움 ② 다른 요청(다시 허용)의 규칙 저장이 DB 쓰기에서 멈춤 ③ 자동 실행을 놓아 시작 게이트가 서비스 잠금 안에서 규칙을 읽음 ④ `POST /stop` — 로컬 컨트롤러 `request_stop` 호출 시각을 잰다 | 3초 안에 `request_stop`이 불리지 않음(DB를 놓을 때까지 대기) | **3.8~6.9 ms**(4회 실행, `perf_counter`, DB 쓰기는 멈춘 채 — Windows 개발 PC 기준, 보드 실측 아님). 상한 `STOP_CALL_BOUND_S`=0.5초로 고정 |
| M-N3 서버 | 허용 뒤 규칙 DB 쓰기를 멈춘 채 `POST /stop` | 응답이 DB 쓰기를 기다림(시험 기한 4.5초 넘김) | **5.3 ms**에 200(상한 1.5초), 목록은 바로 '꺼짐', DB 쓰기는 놓인 뒤 '꺼짐'으로 끝남 |
| M-N3 재시작 | 정지의 규칙 끄기 DB 쓰기가 멈춘 채 '프로세스가 죽음'(새 프로세스 세션으로 같은 DB 다시 열기) / 깨끗한 종료 뒤 재시작 / 종료 때 쓰기 멈춤 | DB의 '켜짐'이 그대로 살아남(다음 가열 종료에 제어) · 종료 함수 없음 | 재시작은 규칙을 끈 채 시작("허브가 정상 종료되지 않아…"), POST 0건 · 깨끗한 종료면 켜진 채 · 종료 때 쓰기가 멈추면 표시를 닫지 않아 다음 기동이 끔 |
| M-N3 폰 | ① 실행 중 정지 → `/status`가 같은 job의 정지 완료(멈춤 확인 9 ms)를 먼저 줌 → `/stop` HTTP `TimeoutException` 나중 ② 결과 없이 `/stop` 시간 초과 | ① "정지 요청을 보내지 못했어요"로 덮음 ② 같은 문장(미전송 단정) | ① 확인한 정지 문장 유지, `true` ② "정지 요청의 응답을 받지 못했어요. 멈췄는지 확인하고 있어요 — 멈추지 않으면 다시 눌러 주세요", `false`(다시 보내도 안전). 그 밖의 오류는 종전 문장. HEAD `lib`에서 2건 실패 확인 |
| H-N1 | 허용·약풍 → 모의 가열 종료 → controller의 최종 재판정이 통과로 **돌아온 직후** API로 끄기 / 값 변경 / 삭제(응답 200 완료) → controller가 POST 시도 | 3건 모두 모의 클라우드 POST 1건 | POST 0건, 기록 `blocked`·`not_dispatched`, 끄기 응답에 '이미 보내는 중' 없음 |
| H-N1 반대 순서 | POST 진행 중(전송 개시 뒤) 끄기 / 삭제 | 응답에 알림 없음(`in_flight_notice` 없음) | POST 1건, 응답 `in_flight_notice`: "자동 실행 명령을 이미 보내기 시작했어요 — 그 명령은 취소되지 않아요(공기청정기를 되돌리거나 끄지 않아요). 다음부터는 보내지 않아요", 다음 사건 POST 0건 |
| M-N1 | 허브 가짜 단조 시계 + 기준점(허브 10,000초 ↔ RPi4 500초). ① RPi4가 400ppm 빠름, 기준점 뒤 300초에 끝난 가열이 실제 120.05초 뒤 도착 ② 기준점을 잡고 700초 동안 재탐침 없음, 갓 끝난(5초) 사건 → 새 기준점 뒤 사건 ③ 실제 링크에서 주기 재탐침 | ① 119.93초로 계산해 보냄 ② 보냄 ③ 탐침 1회뿐 | ① '오래된'으로 막음 ② 보류('근거가 없어') → 재탐침 뒤 보냄 ③ 간격마다 `clock_probe`, 끊기면 멈춤 |
| M-N1 계산 | `EventClock` 단위: 유효 기간 경계(599/601초)·드리프트 ±450·±10·0ppm × 기준점 경과 130·350·595초에서 옮긴 끝 시각 ≤ 실제·평가 재현값(10ppm 빠름·하루 유지)·불확실성 한계·환경 변수 | 새 설정 인자가 없어 전부 실패(의미상 실패는 양의 드리프트 쪽 — ①이 실제 경로로 확인) | 통과. 평가 재현값은 기준점이 낡아 보류 |
| M-N2 | 허용(허브 10,100초) 뒤 허브 벽시계만 ① +60초(허용 30초 전에 끝난 가열) ② −60초(허용 30초 뒤에 끝난 가열) / ③ 같은 DB로 다시 열고 새 사건 시계(10,500초 시작): 재시작 전(10,490초)·뒤(10,510초)에 끝난 가열 | ① 보냄 ② '허용하기 전'으로 막음 ③ 재시작 전 사건을 '허용하기 전'으로(재시작을 구분 못 함) | ① 막음 ② 보냄 ③ "허브가 다시 시작되기 전에 끝난 가열이라…" 보류, 뒤 사건은 보냄 |
| L-N1 | 문서 | — | 표제·G3 행·3차 도입부·인계 UART 확인 조건 |

기존 시험 수정 1곳: `test_auto_rule_boundary.py::test_event_from_before_the_allowance_delivered_late_is_not_run` — 허용 시각을 벽시계가 아니라 허브 가짜
단조 시계(10,160초)로 정하게 했다(M-N2로 허용 경계가 그 축으로 옮겨 감). 판정 대상(허용 60초 전 가열은 막음)은 같다.

## 3. 설계와 경계

### H-N2 — 정지 경로가 기다리는 것

- 서비스 잠금 안의 실행 게이트는 **메모리 사본만** 읽는다. 사본은 통째로 바꿔 끼우므로(파이썬 속성 읽기 한 번) 읽기에 잠금이 없다.
- 규칙 DB 쓰기는 `_persist_lock` 안에서만, 그 잠금을 잡은 채 다른 잠금을 기다리지 않는다(메모리 잠금은 사본·판 번호를 읽는 순간만).
  늦게 끝난 쓰기가 새 상태를 옛 상태로 덮지 않게 늘 그때의 가장 새 사본을 쓰고 판 번호로 건너뛴다.
- 서비스의 다른 DB 사용(실행 기록 등)이 멈추는 경우는 이번 범위 밖이다 — 이번에 고친 것은 '규칙 저장소 잠금 → 서비스 잠금 → 정지' 사슬이다.

### M-N3 — 응답과 영속화, 내구성 경계

- `/stop`의 규칙 끄기: 세대 올림(`halt`, 이미 있음) → 메모리에서 끔(목록·판정 즉시 '꺼짐') → 응답. DB 쓰기·알림함 기록은 뒤의 스레드(실패하면 1초 간격 3회).
- **세션 표시** `auto_rules_session = {"open", "session"}`: 규칙 저장소를 열 때 지난 표시가 **열린 채 다른 프로세스 것**이면(정상 종료가 아님) 켜진 규칙을
  끈 채 시작하고(이유 "허브가 정상 종료되지 않아(전원 끊김·강제 종료 등) 자동 실행을 멈췄어요 — 다시 켜려면…") 표시를 이 프로세스 것으로 연다.
  서버 종료(`main.py` lifespan)는 남은 규칙 쓰기를 5초 안에 마쳤을 때만 표시를 닫는다.
- **보장하는 것:** 정지 뒤 규칙 끄기가 DB에 닿기 전에 프로세스가 죽거나(전원·강제 종료), DB 쓰기가 끝내 실패·지연되면, 다음 기동은 규칙을 꺼진 채 시작한다.
- **대가(정직하게):** 정지가 없었어도 **비정상 종료 뒤에는 늘** 자동 실행이 꺼진 채 시작한다(다시 허용 필요). `sudo reboot`·`systemctl restart`처럼
  lifespan 종료를 거치면 유지된다. 시연 중 전원을 뽑아 다시 켰다면 루틴 탭에서 '다시 허용'이 필요하다.
- **보장하지 않는 것:** 표시가 아예 없던 DB(이 커밋 전에 만든 DB의 첫 기동)는 지난 종료를 모르므로 그대로 믿는다. 같은 프로세스 안에서 엔진을 다시 만드는 경우(시험)는
  재시작으로 보지 않는다. 세션 표시 쓰기 자체가 실패하면 기록만 남긴다(다음 기동은 앞 표시를 본다).
- 폰: `/stop` 응답 실패는 '정지가 안 갔다'가 아니다. 같은 job 결과를 이미 받았으면 그 문장을 지키고, 시간 초과는 '전달 여부 모름'으로 말한다. 정지 판정은 종전대로
  `/status` 폴링이 한다. 키오스크는 `/stop` 응답으로 완료 화면을 만들지 않아 바꾸지 않았다.

### H-N1 — 전송권

- 순서: 최종 재판정(조회를 마친 뒤, 메모리) → controller 잠금 안에서 정지 취소 확인 → **전송권 확인**(`_send_lock` 안에서 재판정을 한 번 더 하고 `_sending`에 표시) → `dispatched` → POST.
- 철회(끄기·값 바꾸기·삭제·비상정지의 규칙 끄기)는 같은 `_send_lock` 안에서 메모리를 바꾼다. 그래서 '재판정 반환 → 철회 완료 → POST 시도'면 전송권 확인에서 걸리고,
  '전송권 확인 → 철회'면 철회가 `_sending`을 보고 '이미 보내기 시작함'을 응답한다. 둘 사이 다른 상태는 없다.
- 잠금은 메모리 판정 동안만(입출력·네트워크 없음). POST·확인 조회 동안 잡지 않는다. 정지(`request_stop`)는 controller 잠금을 잠깐 기다릴 수 있지만 그 안의 일은 메모리 판정뿐이다.
  > **범위 주석(2026-10-14 HIGH 재확인):** 이 문장은 당시 **규칙 저장소 경로**에만 맞았다. 뒤에 붙은 조용한 시간 판정(`QuietHours.settings`)이 DB 저장 동안
  > 잡힌 잠금을 기다려, 시작 게이트·전송권 확인 안에서 정지가 800 ms 넘게 막혔다(H-R1). 조용한 시간·잠시 쉬기·완료 기록·노드 목록을 불변 사본 읽기로 바꾼 뒤의
  > 현재 범위와 남은 예외는 [재확인 수리](devlog_2026-10-14-eval-recheck-fix.md) §3을 본다.
- `_sending`은 job이 끝나면(완료 이벤트) 지운다. 전송을 시작한 명령은 되돌리지 않는다 — 공기청정기를 원래대로 돌리거나 끄지 않는다.
- 폰은 `in_flight_notice`를 아직 화면에 띄우지 않는다(서버 응답까지). 실행 결과는 종전대로 기록·알림함에 남는다.

### M-N1 — 기준점 유효 기간·드리프트

- 옮긴 끝 시각 = `L0 + (x − R) − 드리프트 상한 × |x − R|`. 기준점 나이(`지금 − L0`)가 유효 기간을 넘거나, 불확실성(`상한 × |x − R|`)이 한계를 넘으면 None(보류).
- 상대 드리프트가 상한 안이면 나이를 실제보다 짧게 잡지 않는다(왕복 지연은 종전대로 나이를 길게 하는 쪽). 상한 500ppm은 리눅스 NTP 최대 보정 속도 수준의 **설계값**이다 — 두 보드
  사이 실제 드리프트·왕복은 아직 재지 않았다. 기본값에서 최대 불확실성은 600초 × 500ppm = 0.3초.
- 환경 변수: `SIMPLELAY_EVENT_CLOCK_REF_MAX_AGE_S`(600)·`SIMPLELAY_EVENT_CLOCK_DRIFT_PPM`(500)·`SIMPLELAY_EVENT_CLOCK_MAX_UNCERTAINTY_S`(1)·`SIMPLELAY_EVENT_CLOCK_REFRESH_S`(60). 잘못된 값이면 기동 거절.
- 전송 직전 재검사는 여전히 **나이 재검사**다 — 받은 뒤 링크가 끊기거나 기준점이 바뀌어도 받을 때 옮긴 값을 계속 쓴다('받은 당시 기준점으로 확인한 과거 사실은 유효').
  전송 때도 지금 링크·기준점이 유효해야 한다는 더 강한 정책은 택하지 않았다.

### M-N2 — 허용 경계

- 같은 프로세스: 허용 순간의 허브 단조 시각(메모리)과 사건 끝 시각(같은 축)을 비교. 벽시계 보정과 무관하다.
- 재시작 뒤 DB에서 불러온 허용: 이 프로세스의 사건 시계가 시작한 순간(`main.py` lifespan에서 만든다)이 경계 — 그 전에 끝난 가열은 허용 뒤의 사건인지 단정하지 않고 보류.
  재시작 뒤에 끝난 가열은 저장된 허용으로 보낸다. `allowed_at`(벽시계)은 표시용으로만 남는다.

## 4. 검증

- 백엔드+rpi4 **2,945 통과·12 건너뜀**(시작 2,911, 새 시험 34), 폰 **771**(`--exclude-tags screenshot`, 시작 769), 키오스크 **287**(변화 없음),
  `analyze` error·warning 0(기존 info 4·1), repo guard·문서 링크 시험 통과.
  Flutter는 ASCII 임시 worktree(`C:\sl-test9`, 끝나고 제거)에서 돌렸다.
- 실제 ThinQ 클라우드 호출 0건, 실가전 0대, 실제 CT 판정 0회, 보드 배포 없음.

### 골든 — 바뀐 장면(갱신하지 않음)

이번 작업으로 **새로 바뀐 장면은 없다.** 폰은 10/14 수리 때와 같은 10장이 같은 차이로 남아 있다(`home_dark`·`home_light`·`home_empty`·`lt_home_empty`·
`home_unknown_category` 0.18%, `home_two_appliances`·`home_demo` 0.36%, `home_large` 0.44%, `suggestion_large` 15.70%, `suggestion_long_large` 17.69%).
키오스크는 코드 변경이 없어 골든을 다시 돌리지 않았다. 아이콘 글꼴 경로는 임시 worktree에서만 `C:\src\flutter`로 바꿔 비교했다(저장소는 그대로).

## 5. 남은 것

- **배포:** M-N1 재탐침·M-N3 세션 표시·H-N1 응답 필드 때문에 RPi4·RPi5·폰·키오스크를 같은 커밋으로. 배포 직후 첫 기동은 표시가 없어 규칙을 그대로 믿는다(§3).
- 실측: 두 보드 사이 `clock_probe` 왕복·상대 드리프트(ppm)·기준점 유효 기간·재탐침 간격, 가열 종료 → 자동 실행 지연, 사건 나이 상한 120초.
- 폰이 `in_flight_notice`를 보이지 않는다. 비정상 종료 뒤 '다시 허용'이 필요하다는 것을 시연 런북에 넣을지 정한다.
- 서비스의 다른 DB 쓰기(실행 기록 등)가 멈췄을 때 정지 경로 영향은 이번 범위 밖.
- 골든 10장 눈 검토 뒤 갱신, 실폰 TalkBack·200%, CoreXY 실제 누름·CT·AS186HWWA 실물 — [인계](../archive/인계-2026-10-13-데스크톱.md) §8.
