Seongwonp/Simplelay/docs/devlog/devlog_2026-10-14-fixes.md

# 2026-10-14 — 자동 실행 경계 보강, 보드 날 발견 1~5·7 수리 (데스크톱)

[10/13 보드 날 기록](devlog_2026-10-13-desktop-board.md)의 발견 1~8과 [자동 실행 규칙 기록](devlog_2026-10-13-auto-rule.md)의 경계를 사용자가 정한 순서(A → B → C → D → E → F)로 고쳤다.
각 건은 원인 코드 확인 → 시험 먼저 → 구현 → 1커밋이다. **수정 전 실패 확인의 범위는 §2 A표와 §5 상세대로다**(3차 평가 L3로 좁힘):
A2·A5·C·E·F는 수정 전 코드에서 시험이 실패했고, A1·A3·A4는 기존 코드로 통과해 보호 장치를 끈 변형에서만 실패를 봤고,
B·D는 수집·컴파일 실패(새 예외·필드가 없어서)였다 — 수집 실패는 옛 경로에서 결함 행동을 재현한 증거가 아니다.

> **검증 수준: 가짜 MCU·가짜 시리얼·모의 ThinQ·위젯 시험까지.** 보드·실물 모터·실패널·실폰으로는 이번에 하나도 확인하지 않았다.
> B·C·D는 **RPi4·RPi5·폰·키오스크를 같은 커밋으로 함께 배포**해야 화면에 보인다(아래 §4, [인계](../archive/인계-2026-10-13-데스크톱.md) §8).

## 1. 커밋

| 커밋 | 항목 | 내용 |
|---|---|---|
| `0f9b655` | A1~A4 | 자동 실행 게이트가 '판단 때 지문'과 같은지까지 본다. ThinQ 단계를 보내기 직전에 한 번 더 확인(`dispatch_guard`)하고, 걸리면 `not_dispatched`로 남기고 기록을 '막힘'으로 고친다 |
| `c38c5c7` | A5 | CT 끝 사건을 '조리 완료'로 말하지 않는다 — '가열 종료 감지(조리 완료가 아닐 수 있음)'. 실측 기록표 §6 C를 C1 취소 버튼·C2 문 열림으로 나눔, v4 문서 표현 기준 |
| `7e420f5` | B(발견 2) | 모션 걸림·재시작·기한 초과·준비 안 됨·시리얼 끊김은 재시도 없이 멈추고 원인(`abort_reason`)과 실제 시도 수를 싣는다. 폰·키오스크 "모터가 걸려 멈췄어요" 계열, 다시 시도 권하지 않음 |
| `38ac2b2` | C·C2(발견 3) | 키오스크가 서버 `last_job_id` 변화로 짧은 실행·정지를 잡고, 실패 화면에서도 다음 실행을 이어 보인다. `/status` `last_auto_run`과 키오스크 자동 실행 결과 한 줄 |
| `c15a816` | D(발견 1) | 모션 포트 EIO·사라짐이면 닫고 설정 경로로 다시 연다(백오프·감시 스레드). 런북에 by-id |
| `7737b59` | E(발견 4·5) | 큰 글꼴 승인 화면 고정 영역을 실행·다음에로 줄임, 홈 루틴마다 접근성 노드, 제안 카드 버튼 이름에 대상 |
| `4eeed8e` | F(발견 7) | 홈 루틴 줄·가전 타일 상태 줄 낱말 중간 줄바꿈 막기(U+2060) |
| (이 커밋) | 문서 | 이 기록, 인계 '다음 보드 날' 절, 팀 작업 규칙 한 줄 |

## 2. A — 자동 실행 규칙 경계

| # | 지시 | 기존 시험 | 이번 |
|---|---|---|---|
| A1 | '허용하고 이번에도 실행'은 이 사건 1회, 규칙은 다음 사건부터. 같은 사건을 두 경로가 각각 실행하지 않음 | **없음**(허용 시 1회 실행만 봤고, 같은 사건 재수신은 안 봤다) | **추가**. 기존 코드로 통과 — 처리 키(`SeenEvents`)를 끄는 변형에서 실패 확인 |
| A2 | 실행 대기 중 끄기·설정 변경 → 보내기 직전 재검사 | 비상정지 사이 끼어들기만 있었다 | **추가 3건 + 수정.** 대기 중 끄기는 기존 게이트로 막혔다. **값을 바꾸고 다시 허용하면 판단 때의 옛 값(강)이 나가는 결함**과 **시작 게이트 뒤·전송 전에 끄면 그대로 나가는 결함**이 있었다(2건 실패 확인 후 수정) |
| A3 | 같은 사건 동시 2회 → 실제 제어 1회(가짜 클라우드 요청 수) | 순차 재수신만 있었다 | **추가**(모의 ThinQ 클라우드, Barrier로 동시 도착). 기존 코드로 통과 — 처리 키 변형에서 실패 확인. 둘째는 '실행 중이라 못 보냄'이 아니라 `duplicate`로 걸러져야 통과 |
| A4 | 재시작·재연결 뒤 이전 사건 재수신 → 재실행 없음(처리 키 영속) | **없음** | **추가**(DB 파일로 재시작, 같은 사건 재수신 → 모의 클라우드 제어 0건, 새 사건은 실행). 처리 키 영속을 끄는 변형에서 실패 확인 |
| A5 | '실제 CT 사건 = 정상 조리 완료' 보장 금지 | — | `cycle_end.py`는 '운전 뒤 대기로 settle_s 머묾'만 본다 — **취소·문 열림으로 끝난 가열과 구분하지 못한다**(코드 확인). 카드 근거·시나리오 이름("가열 종료 → 공기청정기")·조건("전자레인지 가열 종료가 감지됐을 때(조리 완료가 아닐 수 있어요)")·결과 알림·막힘 이유를 낮췄다. 실측 기록표 §6에 C1 취소 버튼·C2 문 열림·구분 근거 칸, v4 문서 표현 기준. 문구 시험 6건 수정 전 실패 확인 |

## 3. B~F

- **B 발견 2 [높음] 모션 걸림 → '눌림 확인 실패'로 보고.** 원인은 `ClosedLoopController`가 어댑터 오류를 전부 재시도 오류로 보고 `continue`한 것. 이제 `motion_abort_reason`(모션 오류가 스스로 밝힘: `motion_alarm: stall`·`motion_reset`·`motion_timeout`·`motion_not_ready`·`motion_position_mismatch`, 시리얼 `OSError`는 `motion_link_error`)이 있으면 즉시 안전 정지하고 결과에 원인·실제 시도 수(1)를 싣는다. 사용자 정지 중이면 종전 정지 경로. RPi4 결과 프레임 `abort_reason`(없으면 필드 없음 — 옛 RPi5 호환) → RPi5 `/status` `last_abort_reason`·`/history` `abort_reason`(종료 사유 `motion_aborted`, DB 열 추가). 폰 상태·기록과 키오스크 완료 화면은 "모터가 걸려 멈췄어요. 다시 누르지 않았어요. 장치를 확인해 주세요." 계열이고 **다시 시도 버튼을 내걸지 않는다**(시험). 원점 전·재시작 뒤 누름 거절은 `MotionNotReady`(MotionRefused 하위)로 나눴다 — jog 도구 표시는 종전 '거절 MotionRefused'.
- **C 발견 3 [중간] 키오스크가 이전 결과 화면에 머물고 0.45 s 실행·정지를 놓침.** 평소 화면은 `running`이 보일 때만 이어받았고, 완료 화면은 서버를 보지 않았다. 이제 서버 `last_job_id`가 반영한 값과 다르면(켜기 전 결과 제외) 그 결과를 완료 화면으로 띄우고, 완료 화면에서도 2초마다 새 실행·새 결과를 본다.
  - C2: `/status` `last_auto_run`(마지막 자동 실행 결과: 대상·설정·값·확인 수준·실행 환경)을 더했다. 키오스크는 새 job일 때 한 번, **평소·완료 화면 위에 줄을 더하는 띠**로만 알린다(실행·동작 중 화면에서는 그리지 않음 — 정지 버튼·실행 상태를 가리지 않는다). 확인됨 "공기청정기 풍량을 강으로 바꿨어요", 미확인 "공기청정기 설정이 바뀌었는지 확인하지 못했어요", 모의면 같은 줄에 " · 모의 실행(실제 조작 아님)". 자동 실행 job은 완료 화면 대신 이 한 줄로만 알린다.
- **D 발견 1 [높음] RPi4가 USB 재열거 뒤 죽은 포트를 붙잡음.** `ReopeningLineTransport`가 쓰기·읽기 `OSError`에서 포트를 닫고 끊김으로 표시한 뒤 예외를 올린다. 끊긴 동안은 죽은 포트에 쓰지 않고 바로 오류다. `MotionLinkWatch`(RPi4 실행기 감시 스레드)가 **설정 경로 그대로** 0.5→1→2→4→8초 백오프로 다시 열고 `connect()`까지 한다. 그동안 `not_ready_reason()` → execute `motion_not_ready`. 다시 붙어도 이번 실행의 자동 재홈·재누름 차단은 그대로(사람의 다음 요청에서만 풀림). 시작 때 포트를 못 열면 종전대로 기동 실패. `SIMPLELAY_MOTION_PORT`가 `/dev/serial/by-id/`가 아니면 시작 로그 경고, 런북 §3-4·§5-3.
- **E 발견 4·5 [중간] 접근성.** 글꼴 1.5배 이상이면 승인 화면 고정 영역에 실행(·다음부터도 자동으로)·다음에만 두고, 안내 줄·30분 쉬기·바꾸기·다시 받지 않기는 본문 끝으로. 360×780·2.0에서 고정 영역 35% 미만(시험, 시험 글꼴에서 약 16%). 홈 루틴 큰 카드·행마다 이름·부제를 제 Semantics 노드로, 제안 카드 버튼 이름 "아침 데우기 실행하기"·"아침 데우기 다음에".
- **F 발견 7 [낮음] 줄바꿈.** `keepWordsTogether` — 같은 낱말 안 한글·숫자 사이에 U+2060(기존 숫자·단위 방식 확장). 홈 루틴 부제·가전 타일 상태 줄에만(접근성 이름은 원문). 골든에서 "연결을 확인해 / 주세요"로 낱말 경계에서 꺾이고 글자 사이 폭은 그대로인 것을 확대해 봤다.
- **발견 8 [낮음] 조그 중 정지 2회**(사용자 정지 + 조그 실패 뒤 어댑터 정지): 둘 다 확인돼 해가 없어 **기록만** 남긴다. 고치지 않았다.

## 4. 함께 배포해야 하는 것

| 항목 | RPi4 | RPi5 | 폰 | 키오스크 |
|---|---|---|---|---|
| B 모션 중단 원인 | 결과 프레임 `abort_reason` | `last_abort_reason`·기록 열 | 문장·다시 시도 없음 | 문장·다시 시도 없음 |
| C 짧은 실행·C2 자동 실행 알림 | — | `last_auto_run` | — | 결과 잡기·한 줄 알림 |
| D 포트 다시 열기 | 실행기 | — | — | — |
| A 자동 실행 경계·문구 | — | 서버 | (서버 문장) | — |
| E·F | — | — | 화면 | — |

옛 RPi5는 `abort_reason`을 무시하고(종전 문장), 옛 키오스크는 `last_auto_run`을 무시한다. 섞어 배포하면 원인이 화면에 안 나온다.

## 5. 검증

- 수정 전 실패: A2 2건, A5 6건, B 백엔드·RPi4(새 예외·필드 없음으로 수집 실패)·폰·키오스크(HEAD lib로 컴파일 실패), C 키오스크 행동 시험 3건(짧은 실행·실패 화면 머묾 2) + C2 서버 1건, D 수집 실패, E 4건, F 홈 렌더 1건. A1·A3·A4는 기존 코드가 이미 지켜서 통과 — 보호 장치를 끈 변형에서 실패를 확인했다.
- 전체: 백엔드+rpi4 **2,882 통과·12 건너뜀**(시작 2,853), 폰 **768**(`--exclude-tags screenshot`, 시작 755), 키오스크 **287**(시작 278), `analyze` error·warning 0(기존 info 4·1), repo guard·문서 링크 시험 통과. Flutter는 ASCII 임시 worktree(`C:\sl-test7`)에서 돌렸다.
- 기존 시험 수정: 자동 실행 문구 기대값(test_auto_rules·e2e·cook_done_card), 키오스크 정지 후속 조회 상한 시험 `≤3` → `≤3+5`(완료 화면 평소 조회 5번을 더함 — 1초마다 끝없이 도는 후속 조회는 여전히 걸린다), 타일 상태 글을 그대로 찾던 폰 시험 5곳(결합 문자를 넣은 글로 비교), RPi4 모션 시험 픽스처에 감시 스레드 정리.

### 골든 — 바뀐 장면(갱신하지 않음, 데스크톱에서 눈 검토 뒤 갱신)

`screenshot_test.dart`가 아이콘 글꼴을 `C:\flutter\flutter\...`로 고정해 읽는데 이 데스크톱에는 그 경로가 없다(지금 Flutter는 `C:\src\flutter`). 임시 worktree에서만 경로를 바꿔 비교했고 저장소는 고치지 않았다. 같은 방법으로 시작 커밋 `51b3437`은 폰 55·키오스크 42 모두 통과 → 아래 차이는 이번 작업 때문이다.

| 골든 | 차이 | 까닭 |
|---|---|---|
| `home_dark` · `home_light` · `home_empty` · `lt_home_empty` · `home_unknown_category` | 0.18% | 타일 상태 줄 "연결을 확인해 / 주세요"(F) |
| `home_two_appliances` · `home_demo` | 0.36% | 같은 까닭, 타일 2장 |
| `home_large` | 0.44% | 같은 까닭(200%) |
| `suggestion_large` · `suggestion_long_large` | 15.7% · 17.7% | 큰 글씨 승인 화면 고정 영역이 실행·다음에만(E) |

키오스크 골든 42장은 바뀌지 않았다(자동 실행 한 줄·모션 문장 장면은 골든에 없다).

## 6. 남은 것

- 전부 실물 미검증: 걸림 알람 실물 재현, USB 재열거 재현, 키오스크 짧은 실행·정지와 자동 실행 한 줄의 실패널 확인, 큰 글꼴 승인 화면의 실폰·TalkBack 낭독 — [인계](../archive/인계-2026-10-13-데스크톱.md) §8 '다음 보드 날'.
- 실제 CT 판정이 취소·문 열림을 가를 근거(실측 기록표 §6 C1·C2). 근거가 없으면 '가열 종료 감지'에서 올리지 않는다.
- 골든 10장 갱신(눈 검토 뒤), `screenshot_test.dart`의 Flutter 경로 고정 해소(기기마다 다름).
- 서버 DB 시연 데이터 정리는 이번 범위 밖(보드 작업).
