Seongwonp/Simplelay/docs/devlog/devlog_2026-10-14-public-docs.md

# 2026-10-14 데스크톱 — 공개 문서 정리: 작업 규칙 문서·로컬 경로·저장소 가드·비교 과업 조건표·도구 사용 고지·상용품 근거

사용자가 승인한 문서 정리 작업이다. 앱(`app/`)·키오스크(`rpi5-touchscreen-app/`) 코드는 다른 작업이 고치고 있어 건드리지 않았다.
비공개 자료 폴더와 PDF·PPTX·HWP·DOCX는 열지 않았다. **이력 재작성·강제 푸시는 하지 않았다**(§2는 점검 결과만).

## 1. 정리 내역

### 1-1. 작업 규칙 문서(팀 작업 규칙)

- **현재 상태와 지난 기록을 나눴다.** 첫 절을 "현재 상태(2026-10-14)"로 다시 썼다 — 최신 인계, 결선 일정, 시연 v4, 하드웨어 구성(ESP32 모션·솔레노이드 Z·RPi4 Wi-Fi·ESP32 콘센트 모듈), 검증 수준, 동결, 다음 보드 날, 배포 주의, 현재 시험 수, 10/10~10/14 devlog 목록.
- **낡은 검증 줄을 고쳤다.** "모터·센서 실물 검증 0건"(10/5 줄) 대신 확인 범위를 정확히 적었다:
  모터 축 구동·엔코더 계수, 정지 확인 단계(보냄 → 모션 보드 응답 → 멈춤 확인), 걸림 알람 뒤 재시도 없이 멈춤, 모션 USB 재열거 뒤 다시 열기, 누름 제어 신호까지 실물(벨트·솔레노이드 없이, 10/12~14).
  **캐리지 이동·원점, 실제 버튼 누름, CT 가열 판정, ThinQ 실제 클라우드·실가전 연동, 실폰은 미검증.** "모션 MCU 미정·Z 미정"(9/30·10/5 줄)도 지난 기록으로 옮겼다.
- **비공개 플랫폼 명칭 제거:** 아키텍처 절의 키오스크 구조 설명에 있던 플랫폼 이름을 "임베디드 리눅스용 Flutter 크로스빌드 구조"로 바꿨다.
- **개인 로컬 경로 제거:** 노트북 Flutter 설치 경로(사용자 폴더 경로)를 "기기마다 설치 위치를 먼저 확인하고 전체 경로로"로 바꿨다. 정션 경로 `C:\dev-simplelay`는 개인 경로가 아닌 권장 위치라 남겼다.
- **커밋 규칙:** "도구 관련 문구 절대 금지"를 **커밋 표기 정책**(커밋 메시지에 도구 이름·공동 작성자 줄을 넣지 않음)으로만 적고, **대회 개발 도구 사용 고지와는 별개이며 사용 사실은 고지 초안에 따라 서류·README에 사실대로 적는다**고 한 줄 명시했다. `git commit -- <경로>`, push 전 `git pull --rebase`, 강제 푸시 금지(사용자 승인 건 제외)를 함께 적었다.
- **남긴 일반 규칙:** '최신 검증 기록을 해석하는 법' 절의 일반 규칙(실패 확인 게이트·analyze 게이트·골든 포함 명시·시계 고정·`runAsync`·골든 네모 아이콘)은 새 '시험·커밋 게이트' 절로 옮겨 남겼다.

### 1-2. 팀 작업 규칙에서 뺀 것과 옮긴 곳

전부 **지우지 않고** [작업 규칙 지난 기록](../archive/작업규칙-지난-기록-2026-10-14.md)으로 문장 그대로 옮겼다(평가 점수·실패 기록 포함, 링크만 폴더 위치에 맞춤).

| 뺀 것(팀 작업 규칙 옛 위치) | 옮긴 곳 |
|---|---|
| '현재 기준' 절의 날짜별 줄 29개(9/21~10/14 — 옛 인계 요약, 10/8·10/13·10/14 외부 평가 점수 72·84·80·84점과 수리 내역, 10/5~10/8 배포·시험 수, 예선·심사 관점 평가 52·59·62·64·68점, 10/7 pptx 이력 제거 경위, 9/30 하드웨어 수령·LAN 포트 예시, 동결 정책) | 지난 기록 §1 |
| 9/14~9/17 시작점·동결 문단, 장기 계획(Phase 0~2.1), 일정 줄 | 지난 기록 §2 |
| '이어서 할 때(9/15)' 절(Copilot 4.5/10 평가, 인식 서비스 탐침 명령·합격 기준, 열린 일 5건) | 지난 기록 §3 |
| '다음 작업 순서(9/13)' 절 | 지난 기록 §4 |
| '최신 검증 기록' 절의 날짜별 시험 수(9/13~9/17) | 지난 기록 §5 |
| 옛 커밋 규칙 문구 | 지난 기록 §6 |

### 1-3. 저장소 밖 로컬 경로(추적 문서)

| 문서 | 바꾼 곳 | 바꾼 표현 |
|---|---|---|
| [인계 2026-10-13 데스크톱](../archive/인계-2026-10-13-데스크톱.md) | 4곳(외부 검토 원문, 평가 원문 2개, 에뮬레이터 캡처 폴더) | "저장소 밖 로컬 작업 기록 폴더의 `<파일 이름>`" |
| [데스크톱 인계 2026-09-22(보관)](../archive/데스크톱-인계-2026-09-22.md) | 2곳(발표 PPT, 녹음) | "저장소 밖 로컬 작업 기록 폴더(PPTX, 커밋 금지)", "저장소 밖 로컬 폴더(음성 파일, 커밋 금지)" — 녹음 파일 이름도 지움 |
| [devlog 2026-08-21](devlog_2026-08-21.md) | 1곳(Flutter 설치 경로) | "사용자 폴더 아래 `flutter`" (지시 범위 밖이지만 같은 종류라 함께 고침) |

정리 뒤 추적 파일에서 개인 PC 경로(`<드라이브>:\Users\…`)는 0건이다(`git grep`). `/home/pi/…`는 보드 안 배포 경로라 그대로 둔다.

### 1-4. 그 밖의 문서

- [인계 2026-10-13 데스크톱](../archive/인계-2026-10-13-데스크톱.md) §8에 10번 추가(조정자 요청): 다음 배포 때 UI 정리분(`0437c8e` 이후)을 일반 글자·글꼴 200%·실제 TalkBack·실제 키오스크 패널에서 확인하고 빌드 SHA 기록. 확인 항목 — 승인 화면 '더 보기'(이름·초점 복귀), 키오스크 근거 줄(제한·모의 표시 안 잘림), 결과 화면 큰 체크(확인 수준·'이미 목표값' 제목). 골든·시험 통과는 구현 확인이고 '쓰기 편해졌다'는 초기 사용성 점검 뒤에만.
- [제출 전 검증 과업](../archive/제출전-검증-과업.md) §1 조건표·§5 【기입】 일정표, [개발 도구 사용 고지 초안](../submission/개발도구-사용-고지-초안.md), README·서류의 상용품 칸 — §3~§5.

## 2. 공개 이력 점검 결과 (보고만 — 수정하지 않음)

**기준:** `rpi/tests/test_repo_guard.py`의 금지어 7개(가드 목록 순서로 ①~⑦, 여기에도 낱말을 적지 않는다 — 적으면 이 문서가 가드에 걸린다).
①플랫폼 AI 서비스 이름 ②플랫폼 버스 제어 명령 이름 ③플랫폼 이름(무관한 선형대수 라이브러리 이름은 빼고 셈) ④⑤플랫폼 네임스페이스(점·슬래시 형태) ⑥⑦플랫폼 OS 판 이름·플랫폼 언어 모델 이름.
**방법:** 스크래치 스크립트로 `git log <범위> -p -U0`를 훑어, 금지어가 든 줄을 더하거나 뺀 커밋과 그 파일을 셌다(대소문자 무시, 파일 이름은 `diff --git` 줄로 따로). 로컬 경로는 `<드라이브>:\Users\` 형태. 출력은 집계만 남겼다.

### 2-1. 원격 main 이력(`origin/main`, 공개, 732커밋)

| 항목 | 커밋 수 | 파일 수 | 나타난 기간 |
|---|---|---|---|
| ① 내용 | 12 | 16 | 08-17 ~ 08-26 |
| ② 내용 | 9 | 13 | 08-16 ~ 08-26 |
| ③ 내용 | 19 | 20 | 08-15 ~ 09-30 |
| ④~⑦ 내용 | 0 | 0 | — |
| ① 파일 이름 | 4 | 2 | — |
| ② 파일 이름 | 3 | 2 | — |
| ③ 파일 이름 | 11 | 14 | 전부 키오스크 플랫폼 디렉터리(지금도 가드 허용 목록, 빌드 도구가 정한 이름) |
| **금지어 합계(중복 제거)** | **32** | **41** | 그중 지금 허용 목록 밖 파일 **24개** |
| 개인 로컬 경로 | 7 | 5 | 08-21 ~ 10-14 |

- **허용 목록 밖 24개 파일(이력 속 경로):** 팀 작업 규칙, 옛 devlog 2개(`docs/devlog_2026-08-26.md`, `docs/devlog_2026-09-30-lan-deploy.md` — 지금은 `docs/devlog/`), `docs/inference-boundary.md`, `docs/roadmap.md`, `docs/개발현황.md`, `docs/결선로드맵.md`(지금 보관), `docs/하드웨어-방향-확정-2026-09-30.md`, `rpi/api/deps.py`, `rpi/controller/` 4개(README·`__init__`·D-Bus GPIO 어댑터, ②가 이름에 든 GPIO 어댑터), `rpi/intent/` 4개(`__init__`·D-Bus 에이전트·벡터 DB 의도, ①이 이름에 든 의도 어댑터), `rpi/tests/` 7개(가드 자신의 옛 판 포함).
  대부분 8월 중순~말에 들어왔다가 8/26 정리 때 지워졌고, 이름에 금지어가 든 4개 파일은 지금 추적되지 않는다. 9/30 이후 새로 들어온 것은 팀 작업 규칙의 ③(이번에 고침)뿐이다.
- **개인 로컬 경로 5개 파일(이력 속 경로):** 팀 작업 규칙, `docs/devlog_2026-08-21.md`, `docs/데스크톱-인계-2026-09-22.md`(지금 보관), `docs/인계-2026-10-13-데스크톱.md`, `docs/전문가의견-대응-2026-09-29.md`. 현재 트리에서는 이번 정리로 모두 지웠지만 **옛 커밋에는 남는다**(사용자 이름이 든 Windows 경로 포함).
- **문서 파일(.pptx·.pdf·.hwp·.docx):** `origin/main` 이력에서 이 확장자를 건드린 커밋 0건(`git log origin/main -- '*.pptx' …`, 10/7 제거 결과와 일치). 로컬 전용 참조에는 3커밋(아래 2-2).

### 2-2. 원격에 없는 로컬 참조(이 PC만, 공개 아님)

| 참조 | `origin/main`에 없는 커밋 | 비고 |
|---|---|---|
| `backup-before-rewrite-1007` | 507 | 10/7 이력 재작성 전 백업 — **pptx가 든 옛 이력** |
| `u1a-command-contract` | 368 | 옛 기능 브랜치(재작성 전 이력 기반) |
| `origin/agent/simplelay-flutter-app`(원격 추적 참조) | 0 | 원격에는 이 브랜치가 이미 없다(`git ls-remote`). 오래된 추적 참조 |

로컬 전용 이력에서 금지어는 28커밋·27파일, 개인 로컬 경로는 5커밋·4파일. **이 브랜치들을 원격에 push하면 다시 공개된다** — push하지 않는다.

### 2-3. 원격 참조

- `git ls-remote origin`: `refs/heads/main`, `refs/pull/1/head`(`6d8432f`). PR #1 head는 지금 `origin/main`의 조상이라 그 내용은 2-1에 포함된다.
- GitHub은 PR 참조·캐시된 뷰를 저장소 소유자가 지울 수 없다. 10/7 재작성 전 사본이 GitHub 쪽에 남았는지는 이 점검으로 알 수 없다 — **언급만 한다**(GitHub 지원 요청 여부는 사용자 결정, [제출 체크리스트](../submission/제출-체크리스트.md) G2).

### 2-4. 사용자가 결정할 것

1. 공개 이력의 금지어 32커밋·개인 경로 7커밋을 그대로 둘지, 이력을 다시 쓸지(재작성은 강제 푸시·다른 클론 재설정·PR 참조 문제가 따른다).
2. 로컬 백업 브랜치 2개(`backup-before-rewrite-1007`·`u1a-command-contract`)를 남길지(남기면 push 금지를 계속 지킨다).
3. GitHub 지원 요청(PR 참조·캐시 사본) 여부.

## 3. 저장소 가드 보완

- **결함:** `_ALLOWED_ALWAYS`에 팀 작업 규칙이 있어, 팀 작업 규칙에 플랫폼 이름(③)이 그대로 남아도 가드가 통과했다.
- **수정:** 허용 목록에서 팀 작업 규칙을 뺐고(근거 주석), `_NEVER_ALLOWED = ("팀 작업 규칙", "README.md")`와 시험 `test_rule_and_entry_documents_are_not_exempt`를 더했다 — 같은 이름이 허용 목록에 다시 들어오면 실패한다.
- **수정 전 실패 확인:** 허용 목록만 고치고 팀 작업 규칙을 정리하기 전에 돌려 `test_no_new_vendor_terms_in_tracked_files`가 `팀 작업 규칙: [③]`로 **실패**했다(1 failed, 5 passed). 새 시험은 HEAD의 옛 가드 모듈로 `_is_allowed_always("팀 작업 규칙") == True`를 확인해 옛 목록에서 실패함을 확인했다.
- **정리 뒤:** 가드 전부 통과(§6).

## 4. 비교 과업 조건표와 조건 ② 분리

[제출 전 검증 과업](../archive/제출전-검증-과업.md) §1을 다시 썼다.
- **1-1 조건표(먼저 확정):** C0 정상 ①5·②5·③5 / C1 누름 안 들어감 ②5·③5 / **C3a 문 열림 — 시작 전** ①5·②5·③5 / **C3b 문 열림 — 가열 중**(선택) ②3·③3. 필수 40회 + 선택 6회. 조건마다 정답(사람 판정 기대)·과업 성공 기준(30초 안 가열 시작, 영상의 회전판·램프·카운트다운 중 둘 이상)·오류 검출 기준(60초 안 실패·확인 못 함 알림 = 검출, 아니면 놓침, 정답 성공인데 실패 보고 = 오경보, C3b에서 '조리 완료'로 보이면 잘못된 보고).
- **1-2 정답 기록:** 성공 여부는 SimpleLay 판정이 아니라 **영상 또는 관찰 기록지(사람)**. 관찰자는 시스템 화면을 보고 판정하지 않는다.
- **1-3 ② 설정 — 분리 가능(코드 수정 없음):** RPi4 `SIMPLELAY_L3_MODE` real→**off**, `SIMPLELAY_DONE_WATCH` **비움**, `SIMPLELAY_SENSORS_ENABLED`는 ②에서 false(H4 없으면 ③도 false). `SIMPLELAY_OUTLET_*`·`SIMPLELAY_MOTION_*`는 그대로.
  코드 확인: 콘센트 링크는 `SIMPLELAY_OUTLET_PORT`만 보고 열고(`rpi4/act_main.py` `_build_outlet`), 모션이 serial이면 L3가 꺼져도 전자레인지 채널 소비자가 남으며(`_press_reads_outlet`), 비상정지 래치는 링크가 있으면 연결된다(`_wire_outlet_estop`). L3 off에서도 CT 채널 결속은 남는다(`rpi4/services/target_binding.py` `_build`). 걸림은 MCU `alarm` → `MotionAlarm`(`rpi/controller/serial_motion.py`), 이동 한계는 `kinematics.check_soft_limits` — 둘 다 이 env를 읽지 않는다. 측정 전 1회 비상정지·걸림을 ②에서 다시 확인하고, 다르면 "분리 불가 — 보고"로 바꾸게 적었다. **실물 미검증.**

## 5. 도구 사용 고지 초안·상용품 근거·【기입】 일정표

- **고지 초안:** 커밋 표기 정책과 대회 도구 사용 고지를 별개로 적는 머리 문단을 넣고, 배포·측정을 **도구가 실행한 부분**(시험·빌드·보드 배포 명령·기록에서 수치 뽑기)과 **사람이 설치·관찰·판정한 부분**(물리 작업, Wi-Fi 비밀번호 입력, 모터 회전·방향 육안 확인, 진행 순서·삭제 결정)으로 나눈 표를 devlog 근거로 넣었다. 원작 펌웨어(Touch Bridge, 팀원 B 작성)의 AI 사용 여부는 **"B 확인 전 미확인"**. 주어가 불분명한 것(입회·승인 여부, 골든 렌더를 본 주체, 물리 작업을 한 팀원 이름)은 【확인】으로 남겼다. §4 점검 결과 머리에 10/14 처리 내역을 적었다.
- **상용품 근거(2026-10-14 확인, 공식 자료만):** SwitchBot Bot 공식 제품 페이지(<https://www.switch-bot.com/products/switchbot-bot>), SwitchBot 공식 API 문서 Bot 항목(<https://github.com/OpenWonderLabs/SwitchBotAPI/blob/main/devices/others/bot.md>), Adaprox Fingerbot Plus 공식 제품 페이지(<https://www.adaprox.io/products/fingerbot-plus>). SwitchBot 지원 문서(support.switch-bot.com)는 조회가 막혀(403) 쓰지 않았다.
  README 차이 표·[실측 기록표](../실측-기록표.md) §3·[작품소개서](../submission/작품소개서-초안.md)·[개발완료보고서](../submission/개발완료보고서-초안.md) 표의 상용품 칸을 채웠다. 사양에서 찾지 못한 기능(여러 버튼 순서 조작, 누름·가전 동작 확인, 정지, ThinQ와 한 흐름, 사용 기록 기반 제안, 설치 시간)은 **"확인하지 못함"**으로 적었고, 성능 우위 주장은 없다(설계 차이만).
- **【기입】 일정표:** [제출 전 검증 과업](../archive/제출전-검증-과업.md) §5 — 서류의 【기입】 칸 K1~K11과 닫을 과업·담당·목표일(제안), 【확인】·체크리스트 칸은 따로.

## 6. 검증

`$env:PYTHONUTF8=1`, 리포 `.venv`, `--basetemp C:\pt_tmp\<고유>`.

- 수정 전: `rpi/tests/test_repo_guard.py` — 1 failed(팀 작업 규칙 ③), 5 passed.
- 정리 뒤: 같은 시각 다른 작업이 `rpi/`·`docs/protocol.md`를 고치고 있어(아직 없는 devlog를 링크해 링크 시험이 깨진 상태), **HEAD(`82e0dc9`)에서 만든 별도 작업 트리에 이 작업의 파일만 얹어** 돌렸다.

| 시험 | 결과 |
|---|---|
| `rpi/tests/test_repo_guard.py` + `rpi/tests/test_doc_links.py` | **8 passed**(가드 6 — 새 시험 1 포함, 링크 2) |
| 백엔드+rpi4 전체 | **2,976 passed**, 10 skipped(골든 없음). 첫 실행(`-x`)에서 `test_sensor_verifier.py::…verification_result_invariant` 1건이 실패로 멈췄으나 그 파일만 다시 돌리면 48 passed, 전체 재실행도 통과 — 이 작업과 무관한 간헐 실패로 보고 기록만 남긴다 |
