Seongwonp/Simplelay/docs/devlog/devlog_2026-10-16-safety-g4-g9-g10.md

# G4·G9 정지 경계 수리 / G10 의미 고정 (2026-10-16)

기준: `main`의 `fc650ee` 위 작업 트리. 커밋·push·브랜치·stash 없음. 팀 작업 규칙·폰·키오스크·펌웨어·제출 초안 본문은 변경하지 않았다.
**검증 수준: 메모리 링크·가짜 MCU·모의 검증기를 쓴 시험 조건만. 보드 미배포, 실제 기구·누름·CT 미검증.**

## 1. 항목별 결과

| 항목 | 재현 / 변경 | 확인 범위 |
| --- | --- | --- |
| G4 | 동작 확인 이후 동작 잠금 대기 / 송신 함수 진입 직전 / 실제 쓰기 잠금 대기를 멈춰 두고, 별도 스레드의 `request_stop()` 완료 후 진행하면 옛 home·move가 stop 뒤에 전송됐다. 실제 쓰기 잠금 안에서 home·move·press의 정지 플래그를 다시 검사한다 | 공개 home·move_to·press 진입점 × 3경계 9건, 이동 뒤 Z 전송 직전 1건, 정지 뒤 상태 조회 및 명시적 재준비 1건 |
| G9 | 실제 `ActExecutor.run()` 수신 루프에 execute→abort를 넣었다. 이전 hold의 이동 응답을 지연시키면 hold 해제/join 때문에 abort가 늦어졌다. 준비부터 실행 자리를 예약하고 대기를 실행 task로 옮겼다 | appliance/drive abort가 join 3초를 기다리지 않고 MCU에 도착. 대기 중 정지 뒤 새 버튼 0개. 중복 execute는 busy, 준비와 실행을 같은 task로 기다리고 종료 상태 정리 |
| G10 | 실행 중 / hold 중 / 비상정지의 기존 동작을 유지했다. [안전 보고](../안전계약-적용-보고-2026-10-15.md) §2-1에 표로 분리 | 실행 중 정지는 구동부 중단. hold 일반 정지는 등록된 취소 누름 후 보관. drive·비상정지는 추가 누름·보관 이동 없음. 6건은 수정 전에도 통과 |

G9의 비상정지 호출은 콘센트 콜백 진입점으로 직접 넣었다. **기존 코드에서도 그 구동부 정지 요청은 지연되지 않았고, 최종 비상정지 회귀 시험은 수정 전에도 통과한다.** 기존 `error / estop_latched` 응답을 유지한다. 일반 abort 수신 지연 재현과 섞지 않는다.

G4는 정지 줄이 쓰인 뒤 옛 동작 줄이 이어지는 순서를 차단한다. 이미 쓰기 경계에 진입한 전송을 취소하거나, 막힌 transport 쓰기를 선점하는 기능은 아니다. G9도 shutdown·운영체제·스레드 풀의 모든 지연을 없앴다는 뜻은 아니다. 0.8초는 개발 PC 시험의 관측 한도이며 실물 정지 성능 수치가 아니다.

## 2. 수정 전 실패 확인

시험을 먼저 작성한 뒤 원래 코드에서 재현했다. 확장한 시험까지 마지막에 다시 확인하려고 두 구현 파일만 `git show HEAD:<파일>`의 내용으로 잠시 복원해 실행했으며, `finally`에서 작업 내용의 바이트 일치를 확인하고 돌려놓았다. reset·stash는 쓰지 않았다.

| 시험 파일 | 수정 전 | 수정 후 개별 묶음 |
| --- | --- | --- |
| `rpi/tests/test_safety_g4_dispatch.py` | 10 실패·1 통과 | 11 통과 |
| `rpi4/tests/test_safety_g9_hold_dispatch.py` | 4 실패·1 통과 | 5 통과 |
| `rpi4/tests/test_safety_g10_stop_meaning.py` | 6 통과(기존 동작) | 6 통과 |
| 합계 | **14 실패·8 통과, pytest 종료 1** | **22 통과, 종료 0** |

초기 G4는 9 실패·1 통과를 확인한 후 수정했고, 기존 serial_motion 시험과 47건 통과했다. 초기 G9는 appliance/drive 수신 경합 2건 실패 후 수정했고, 기존 act_hold·act_executor와 41건 통과했다. 위 표는 Z 경계·준비 중 중복 실행·비상정지·G10까지 추가한 최종 새 시험 기준이다.

환경 제한에서 asyncio 로컬 소켓 초기화가 멈춘 실행은 중단했다. 로컬 시험 권한으로 다시 실행한 결과만 위 통과·실패 수에 넣었다. 서버·실기기·실제 클라우드는 사용하지 않았다.

## 3. 문서와 HW 전달

- [솔레노이드 안전 전달표](../archive/솔레노이드-안전-전달표-2026-10-16.md): 부팅 OFF·통전 상한·워치독 등 소스 근거와 풀다운·플라이백·스프링·브라운아웃·처짐·전원 순서의 미측정 칸을 분리했다. **850 ms는 소프트웨어 기준이며 물리 차단 보장이 아니다.**
- [런북](../결선-운영-런북.md)과 [v4](../본선-시연-계획-v4.md): 실제 공기청정기·인터넷 필요, 노트북 확인/RPi5 미확인, 최신 키오스크 확인 수준을 맞췄다. 공기청정기 켜기 제안은 클라우드 지연 때문에 주 시연에서 빼고 녹화 또는 명시한 모의 보조로 한정했다.
- [제출 체크리스트](../submission/제출-체크리스트.md)의 옛 v3 촬영 순서·미결 표를 갱신했다. 초안 본문은 이번 범위 밖이다.
- [코드 구조](../코드-구조.md)의 열린 빈칸을 갱신했다. R1·G6·G8은 손대지 않았고 G5 재접속 지연·PS-1은 실물 확인이 남았다.

## 4. 최종 검증

- 첫 전체 실행: **3,314 통과·25 건너뜀·2 실패, 종료 1**(335.46 s). 기존 런북 결속 예시 검사와 hold 해제 중 비상정지 응답 검사가 실패했다.
- 런북에 실제 등록 ID와 배선이 일치할 때만 쓰는 예시를 복구했다. G9 준비 중 비상정지를 일반 `stopped`로 바꾸던 회귀는 기존 `error / estop_latched` 우선으로 복구했다. 기존 시험 기대값은 바꾸지 않았다.
- 관련 기존 시험 + 새 시험: **58 통과, 종료 0**(11.92 s).
- 최종 새 시험을 원래 구현으로 다시 실행: 위 §2의 **14 실패·8 통과, 종료 1**(4.40 s), 구현 파일 복원 바이트 일치 확인. 초기 확장 시험에서는 15 실패·7 통과였으나, 잘못 바꿨던 비상정지 응답 기대를 원래 계약으로 바로잡은 최종 수는 14/8이다.
- 최종 전체 재실행: **3,316 통과·25 건너뜀·실패 0, 종료 0**(286.44 s). 건너뜀은 `sh` 부재의 배포 스크립트 15건, `matplotlib` 부재의 그림 10건이다. 이 25건을 검증 완료로 세지 않는다. 의존성 폐기 예정 경고 2건은 남았다.
- 실행 명령: `python -m pytest -q -rs -p no:cacheprovider --basetemp <ASCII 고유 경로>` (`PYTHONUTF8=1`, 저장소 가상환경). 기본 testpaths의 `rpi/tests`·`rpi4/tests` 전체, 골든 제외.
- 저장소 가드·문서 링크 별도 확인: **8 통과, 종료 0**. `git diff --check` 종료 0, 실제 staged diff 없음. 최종 브랜치 `main`, HEAD `fc650ee` 유지.

골든·Flutter 시험은 변경 범위가 아니며 실행하지 않았다. 새 회귀 22건은 위젯·골든을 포함하지 않는다.

변경 파일(13개, 새 파일 5개는 `git add -N`만):

```text
rpi/controller/serial_motion.py
rpi4/services/act_executor.py
rpi/tests/test_safety_g4_dispatch.py (새 파일)
rpi4/tests/test_safety_g9_hold_dispatch.py (새 파일)
rpi4/tests/test_safety_g10_stop_meaning.py (새 파일)
docs/솔레노이드-안전-전달표-2026-10-16.md (새 파일)
docs/devlog/devlog_2026-10-16-safety-g4-g9-g10.md (새 파일)
docs/README.md
docs/안전계약-적용-보고-2026-10-15.md
docs/코드-구조.md
docs/결선-운영-런북.md
docs/본선-시연-계획-v4.md
docs/submission/제출-체크리스트.md
```

## 5. 배포와 남은 확인

`rpi/controller/serial_motion.py`는 RPi4에서도 쓰는 모션 어댑터이며 `rpi4/services/act_executor.py`도 바뀌었다. **RPi4 재배포 필요. RPi5·RPi4는 검토 후 같은 커밋으로 배포하고 설치 SHA를 기록한다.** 메시지 형식은 바꾸지 않았지만 옛 RPi4에는 G4·G9 결함이 남는다.

보드 날에는 실제 hold 이동 중 새 실행→정지, 잠금 대기 뒤 잔여 이동·누름 없음, 일반 hold 취소와 drive/비상정지의 차이를 확인한다. 신호·모터 축·캐리지·버튼·CT 중 어디까지 관측했는지 따로 남긴다. 솔레노이드·벨트 장착 후 PS-1을 진행하기 전 안전 전달표부터 채운다. 평가 설정 변경·실물 조작·자동 재누름 정책 변경은 이번에 하지 않았다.
