Seongwonp/Simplelay/docs/devlog/devlog_2026-10-23-ui-next-plans.md

# 다음 UI 작업 계획 저장

2026-10-23. 사용자 요청으로 오늘은 구현을 중단하고 내일 이어갈 계획만 작성했다.

- [가전 그림 통일](../archive/가전-그림-통일-실행계획-2026-10-23.md): 기기 추가부터 전 화면 통일, 현재 등록 기기에 한정하지 않는 후보 종류 카탈로그, 표시/실제 제어 지원 분리, 호환성과 검증 순서.
- [키오스크 전면 재설계](../archive/키오스크-전면-재설계-실행계획-2026-10-23.md): 폰의 승인 스타일 기반 넓은 화면, 조작 후 같은 가전 계속하기, 화면/상태 구조화, 공식·개인·커뮤니티 참고 링크 10개와 적용/제외 판단.
- 팀 작업 규칙에 다음 시작 문서 링크 추가. 문서 상대 링크 시험 2건 통과. 이 단계에서는 앱/HW 코드 변경·보드 UI 배포 없음.
- 사용자의 종료 요청으로 SSH에서 각 모델을 확인한 뒤 RPi4·RPi5에 정상 종료 명령을 보냈다. 주소·접속 정보는 공개 문서에 기록하지 않는다. 전원 케이블을 물리적으로 분리한 것은 아니다.
- 로컬 문서 커밋만 수행하며 원격 push는 하지 않는다.
