Seongwonp/Simplelay/docs/devlog/devlog_2026-10-13-phone-ui.md

# 2026-10-13 폰 UI B안 — "AI 같다·불편하다" 대응 (노트북, 정지 확인 A 뒤)

근거: 저장소 밖 조사·검토 보고서(폰 UI B안 검토 §3 타일 매핑·§4 홈 선택 규칙·§5 기록 문구), [ui-review/2026-10-12](../ui-review/2026-10-12/README.md),
[인계 2026-10-13 노트북](../archive/인계-2026-10-13-노트북.md) B절. 정지 문구·계약은 [A 작업](devlog_2026-10-13-stop-confirm.md)을 그대로 썼다.
키오스크·팔레트·4탭은 바꾸지 않았다. 시작 HEAD `9686264`.

## 무엇을

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

## 수정 전 실패 확인

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

## 시험 수

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

## 미검증

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

## 남은 것·판단할 것

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

## 추가: 홈 가전 타일 '확인 주행' 보조 줄 (남은 것 2번, 표시만)

시작 HEAD `5feb11c`. 실행을 새로 막는 규칙은 넣지 않았다. 서버·키오스크·rpi는 바꾸지 않았다.

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

**표시 규칙**(`verifyPassTileNote`, `app/lib/models/display_status.dart`, 상태 줄과 별개의 보조 줄):

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

### 문구 조정(같은 날, `bfcf52f`)

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

## 추가 2: 외부 검토(폰 UI 구현) MEDIUM 4건 수리

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

### M2 — 확인 주행 응답의 state 누락을 실패로 단정 (고침)

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

### M4 — 설정 카드가 모의 실패·진행 중에도 '모의 주행을 확인했어요' (고침)

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

### M3 — 재연결 뒤 확인 주행 결과가 갱신되지 않음 (고침)

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

### M1 — 상태가 바뀌어도 타일이 예전 '실행을 요청할 수 있어요'를 유지 (고침, 범위 한정)

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

### LOW·문서 (고침)

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

### 시험 수·재검증 한계

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

### 남은 것(이번 수리 뒤)

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

## 에뮬레이터 확인(10/13)

노트북 에뮬레이터 + 모의 서버에서 B안 화면을 직접 써 봤다. 시작 HEAD `c2cebea`.

**확인한 것**

- 홈 '허브 연결됨' 콜드 스타트 수리(`c2cebea`) — 앱을 다시 열어도 '허브 확인 중'에 머물지 않는다.
- 200% 글자 크기에서 홈·루틴 행이 줄바꿈되고 버튼이 겹치지 않는다(눈으로 확인). **정정(외부 평가 72점 L2):** 당시 "캡처 없음"이라 적었으나
  저장소 밖 캡처 폴더의 `5-홈-200.png`·`6-루틴-200.png`가 이 확인의 캡처다 — 에뮬레이터 시스템 글꼴 크기 2.0, 앱은 `c2cebea` 빌드.
  이 캡처에서 숫자 '3'과 '단계'가 다른 줄로 떨어진 것은 아래 '외부 평가 72점 수리' L3에서 고쳤다. 고친 뒤 화면은 `370083c` 빌드의 캡처 21·22
  (시스템 글꼴 2.0, 모의 서버 — 에뮬레이터 정적 화면, 실기기·낭독 아님, [인계](../archive/인계-2026-10-13-데스크톱.md) §0).
- uiautomator 덤프의 노드 순서: 우리 집/허브 연결됨 → 말로 조작하기 → 아침 데우기 카드 →
  '아침 데우기 실행하기' → 가전 → '전자레인지, 실행을 요청할 수 있어요' … → 탭 '설정, 읽지 않은 알림 1건'.
  접근성 트리 순서일 뿐 **실제 TalkBack 낭독은 아니다**(TalkBack 확인은 남은 일).

**찾은 결함과 처리**

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

## 외부 평가(폰 UI·정지 확인, 72점) 수리 — 10/13 데스크톱

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

### M5 — 실물 모션 + 모의 L3를 "가전 동작도 확인했어요"로 (고침)

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

### M4 — 실패한 실행을 "실행을 시작하지 못했어요"+다시 시도로 단정 (고침)

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

### M2 — 같은 주소·키로 허브가 꺼졌다 켜져도 연결 상태가 그대로 (고침)

- 재현: `RpiConnectionNotifier`는 처음·주소/키 변화·사용자 확인 때만 판정했다. 주기 `/status` 실패도 연결 상태를 바꾸지 않아, 허브가
  꺼졌다 켜져도 '연결됨'에 머물고 연결을 듣는 확인 주행 조회가 다시 묻지 않았다. 앞 절 M3 시험은 가짜 연결을 직접 바꿔 이 배선을 보지 못했다.
- 수정: 기존 5초 `/status` 조회(`estopProvider`, AppShell 배너가 늘 띄운다)의 통신 결과를 `reportHubPoll`로 넘긴다 — **연속 2번** 닿지 않으면
  '닿지 않음', 다시 닿으면 '연결됨'. 허브가 오류 코드·해석 불가로 답한 것은 닿은 것, 키 거절(401)은 연결 판정(`check`)에 맡긴다.
  (정정, 2차 평가 L-N1: 당시 '해석 불가'는 FormatException만이었다 — 200 + 필드 타입 오류(TypeError)는 끊김으로 셌다. `079b5b1`에서 고침)
  확인 중·미설정·키 필요 상태는 건드리지 않는다. 새 화면·새 주기 조회 없음.
- 시험: `connection_poll_test.dart` 3건 — 실제 연결 provider·실제 걸림 조회·가짜 HTTP로 켜짐 → 꺼짐(닿지 않음, 확인 주행 모름) → 켜짐(연결됨,
  확인 주행 재조회), 한 번 실패는 그대로, 500은 닿지 않음 아님. 수정 전 첫 시험 실패(기한 초과). 고정 연결 대역(`FixedRpiConnection`)은
  주기 결과로 바뀌지 않게 했다. (정정, 2차 평가: 시험 주기는 100 ms다 — 실제 5초 타이머·요청 timeout·inFlight를 넣은 허브 재시작 실측이 아니고,
  실제 네트워크에서 '연속 2번' 정책의 오탐률도 재지 않았다)
- 한계: 폰이 실패를 두 번 보기 전에 돌아오는 짧은 재시작은 여전히 모른다(정정: '약 10초'는 조회 위상·timeout에 따라 달라지는 설명값이지 경계 시간 보장이 아니다). 앱 복귀(resume) 때 재확인은 넣지 않았다(주기 조회가
  앱이 살아 있는 동안 돈다). 확인 주행 기록의 서버 저장은 남은 일 그대로.

### M3 — 첫 실행 중 마이크 권한 창이 실행·정지 화면을 가림 (고침, 기본 규칙)

- 결정(팀 결정 전 기본 규칙): **실행 중에는 OS 권한 창을 띄우지 않는다.** 실행 중 '멈춰' 듣기는 마이크 권한이 **이미** 있을 때만
  (`SpeechToText.hasPermission` — 묻지 않는 확인) 엔진을 열고, 없으면 그 실행은 조용히 건너뛴다. 화면 정지 버튼은 그대로다.
- 근거: ① 고령·저시력 사용자에게 실행 중 새 결정을 요구하지 않는다. ② 권한 창이 떠 있는 동안 앱의 정지 버튼에 손이 닿지 않는다 —
  정지 접근이 음성 정지보다 우선이다. ③ 권한 요청 자리는 이미 있다: '말로 조작하기' 화면의 마이크 버튼이 누를 때 `initialize()`로
  묻는다(`voice_screen.dart` `_toggle`). 거기서 허용하면 다음 실행부터 음성 정지가 듣는다. ④ 새 화면·설정(실행 전 안내, 설정 토글)은
  팀 결정 사항이라 넣지 않았다. 대가: 마이크 버튼을 한 번도 누르지 않은 사용자는 음성 정지를 못 쓴다 — 화면 정지·키오스크 정지는 그대로.
- 시험: `voice_stop_test.dart` 권한 3건 — 미허용(엔진 초기화 0회, 화면 정지 호출은 그대로), 거부 후 실행을 거듭해도 다시 묻지 않음,
  나중에 허용하면 다음 실행부터 듣고 "멈춰"가 정지로 간다. 수정 전 3건 실패. 실기기에서 권한 창이 실제로 뜨지 않는지는 미확인(에뮬레이터 날).
  (정정, 2차 평가: `VoiceService`는 한 번 초기화되면 그 프로세스에서 권한 검사를 생략한다(`voice_service.dart` 초기화 캐시) — 같은 프로세스에서
  권한을 회수한 경우까지 매번 OS 권한을 다시 확인한다고 말하지 않는다. 캡처 18은 그 모의 실행에서 권한 창이 없었다는 근거까지다.)

### L1 — 복귀 시험의 상태 화면이 대역 (고침)

- `run_return_origin_test.dart`에 실제 `StatusScreen`과 앱 라우터를 쓰는 6건을 더했다 — 홈·루틴 목록 출발 × 완료 뒤 '확인'·'닫기'·
  안드로이드 뒤로가기(`handlePopRoute`). 승인 화면을 바꿔 끼우지 않던 옛 동작(`push`)으로 되돌리면 6건 모두 실패한다. 위 표 1번의
  "수정 전 2건 실패"는 대역 경로 시험의 실패다. 편집기 출발은 같은 `runRoutineNow`라 따로 시험하지 않았다.
  (정정, 2차 평가: 출발 화면은 대역이고 라우터는 시험용이다 — 앱 전체 라우팅을 모두 통과했다는 뜻이 아니다. 캡처 19가 홈 복귀 장면을 보완한다.)

### L3 — '단계' 말의 혼동·숫자와 단위의 줄바꿈 (고침)

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

### 시험 수(ASCII 경로 임시 worktree `C:\sl-test2`, Flutter `C:\src\flutter`)

- 폰(골든 제외) **729 통과**(688 → +41), 실패 0. `flutter analyze` error·warning 0(기존 info 4).
- 키오스크(골든 제외) **278 통과**(262 → +16), 실패 0. `flutter analyze` error·warning 0(기존 info 1).
- 백엔드+rpi4 **2,721 통과**, 10 skipped(`PYTHONUTF8=1`, `--basetemp C:\pt_tmp\…`). 첫 전체 실행에서 `test_outlet_protocol.py::test_sensor_reads_each_sample_in_order`가
  1번 실패했고 단독 3회·다음 전체 실행에서는 통과했다(부하 중 시간 의존으로 추정 — 원인을 규명한 것은 아니다, 이번 변경과 무관한 콘센트 경로).
- 골든은 실행·갱신하지 않았다. 바뀌는 장면(데스크톱에서 눈 검토 뒤 갱신): 폰 `status_failed`(문장·버튼), 실행 상태 진행 줄이 있는 장면("조작 N개 중 K개"),
  루틴 부제가 보이는 홈·루틴 장면(결합 문자 — 보이는 글자는 같아야 한다). 키오스크 동작 중 장면은 모의/모의라 문구가 같다.

### 남은 것

- 키오스크 정지 줄의 "멈춘 것을 확인했어요 (n ms)"는 폰처럼 "모션 보드 응답 n ms"로 밝히지 않았다(키오스크 수정 범위 밖) — 다음에 맞춘다.
  (2차 평가 수리 `4852abf`에서 맞췄다 — [정지 확인 devlog](devlog_2026-10-13-stop-confirm.md) 끝 절)
- M2 한계(짧은 재시작), 확인 주행 기록 서버 저장, 원격 노드 준비 변화 최신성, 실기기 권한 창·TalkBack·200% 재캡처, 골든 갱신, 보드 날 정지 실측.
