Seongwonp/Simplelay/docs/devlog/devlog_2026-10-14-close-4-5.md

# 2026-10-14 데스크톱 — 4·5번 마감 확인(시험 보강·잠시 쉬기 끝 시각 표시·경보 추천표·배포 인계)

앞선 기록: [습관 제안 → 루틴 초안(4번)](devlog_2026-10-14-habit-routine.md) · [조용한 시간(5번)](devlog_2026-10-14-quiet-hours.md) · [공개 문서 정리](devlog_2026-10-14-public-docs.md).
**기능 추가 없음.** 마감 확인·시험 보강·문서만 했다. 코드 수정은 사용자가 요청한 '잠시 쉬기 끝 시각 표시' 최소 추가 하나(폰 두 줄·키오스크 한 줄)뿐이다.

> **검증 수준: 모의까지.** 모의 ThinQ·저장소 안 모의 클라우드·리허설 주입 사건·위젯 시험. 실가전·실제 CT 판정·실패널·실폰은 쓰지 않았다.

## 1. 마감 확인 A1~A5

'시험'은 이번에 시험으로 확인한 것, '정책'은 문서에만 적은 것이다.

| 건 | 확인한 코드·기존 시험 | 결과 | 시험 추가 | 수정 전 실패 확인 | 구분 |
|---|---|---|---|---|---|
| A1 조용한 시간 직전 제안이 시작 뒤 뒤늦게 나오지 않음 | 서버 `ProactiveSuggestionService._withdrawal_reason`(조용하면 떠 있던 카드 내림, `user_started` 제외)·`pending()`. 폰은 `/suggestions` 5초 폴링으로 목록을 **통째로 바꾸고**(쌓지 않음) 제안을 팝업·소리로 알리지 않는다(홈 카드뿐). 키오스크는 평소 화면에서만 `/suggestions`를 새로 받아 띄우고, 떠 있던 카드는 서버 목록에서 빠지면 내린다. 기존 시험 `test_quiet_drops_pending_cards…`는 시간대를 **켜는** 경우만 봤다 | 결함 없음 | 서버 2(시계가 21:59 → 22:00:05 → 다음 날 07:00:30으로 **넘어가는** 경우 목록·승인·끝난 뒤 모두 없음 / 대조: 사용자가 직접 찾은 루틴 '지금 실행'은 그 시간에도 카드), 폰 1(서버가 내린 카드는 다음 폴링에 폰 목록에서도 빠짐), 키오스크 2(떠 있던 카드가 내려간 뒤 끝난 뒤에도 다시 뜨거나 낭독되지 않음 / 조용한 시간에도 내 가전에서 직접 누른 루틴은 카드로 감) | 서버 '넘어가는 경우'는 카드 내림을 끈 변형에서 실패. 폰·키오스크 3건은 HEAD에서 원래 통과(현재 동작 고정) | 시험 |
| A2 전송권 경계에서 조용한 시간·잠시 쉬기 | `AutoRuleEngine._submit`의 `guard`(조용한 시간 검사 포함)를 시작 게이트·전송 직전 재검사·**전송권 `commit`**(실행기가 POST 바로 앞에서 `_send_lock` 안에서 부름) 세 곳이 모두 부른다. 기존 시험은 실행 게이트 전에 켜는 경우만 | 결함 없음 | 2(매개 2: 매일 시간대·잠시 쉬기) — 최종 재판정이 통과로 돌아온 **직후, POST 전**에 켬 → 모의 클라우드 POST 0건, 기록 `blocked`·`not_dispatched`·"조용한 시간이라 자동 실행하지 않았어요" | `guard` 안의 조용한 시간 검사만 끈 변형에서 2건 실패 | 시험 |
| A3 건너뛴 사건을 재시작 뒤 다시 받아도 재실행 없음 | `SeenEvents`(DB 설정 키에 처리 키 영속)가 `_try_run`보다 먼저 거른다 — 조용한 시간에 건너뛴 사건도 처리 키가 남는다. 기존 시험은 '보낸 사건'의 재시작만 봤다 | 결함 없음 | 1 — 조용한 시간에 `blocked` → 같은 DB로 재시작(조용한 시간 설정도 남음) → 조용한 시간 끔 → 같은 사건 재수신 = `duplicate`, POST 0건, `sent` 0건 | 처리 키 저장을 끈 변형에서 실패 | 시험 |
| A4 루틴 초안 중복이 대상 가전 ID까지 판단 | `candidate_key`(가전 ID+버튼 순서)·`_existing_same`(장치 명령 열의 대상 ID+버튼). 기존 시험은 같은 가전만 봤다 | 결함 없음 | 1 — 두 번째 전자레인지(등록 기능으로 같은 버튼 이름)를 등록 → 초안 2개(키 다름) → 작은방에 같은 순서 루틴이 있어도 부엌 초안은 보이고 저장 201, 작은방 초안만 409 | 키·중복 비교에서 가전 ID를 뺀 변형에서 실패 | 시험 |
| A5 잠시 쉬기 의미 변경의 적용 방식 + 끝 시각 표시 | 잠시 쉬기(`_dnd_until`)는 **서버 메모리에만** 있다(DB 없음). 폰·키오스크는 서버 `/health`의 `dnd_until`을 그대로 보인다(기기에 따로 저장하지 않음). 표시: 폰 홈 배너는 남은 시간만, 설정 줄·키오스크 방해 금지 창은 끝 시각 없음, 키오스크 위 줄 칩은 남은 시간 | 결함 아님. 끝 시각 표시가 없어 최소 추가(§2) | 서버 1(업데이트 = 재시작 뒤 잠시 쉬기는 남지 않고 매일 시간대 설정은 남음), 폰 2(홈 배너·설정 줄 끝 시각), 키오스크 1(방해 금지 창 끝 시각) | 서버 1건은 현재 동작 고정(원래 통과). 표시 3건은 HEAD `lib`에서 실패 | 시험(표시·재시작) + 정책(적용 방식) |

## 2. 잠시 쉬기 적용 방식 — **'새로 켤 때부터 적용'**(추가 코드 없음)

- 업데이트 배포는 서버를 다시 띄운다. 잠시 쉬기는 서버 메모리에만 있으므로 **업데이트 전에 켜 둔 잠시 쉬기(옛 의미: 제안만 쉼)는 재시작과 함께 끝난다** — 새 의미(자동 실행도 쉼)로 조용히 이어지는 경우가 생기지 않는다(시험 `test_pause_set_before_an_update_does_not_survive_the_restart`).
- 업데이트 뒤 새로 켜는 잠시 쉬기는 켜는 화면에 이미 새 범위가 적혀 있다(폰 "몇 시간 동안 새 제안과 자동 실행을 쉬어요", 키오스크 "새 제안과 자동 실행을 잠시 쉬어요").
- '기존 활성 잠시 쉬기를 끝까지 두고 안내'안은 잠시 쉬기를 영속하는 새 저장과 이행 표시가 필요해 더 복잡하고, 지금은 이어질 상태 자체가 없다 — 고르지 않았다.
- 남는 점(종전과 같음): 배포·정전·재시작이면 사용자가 켠 잠시 쉬기도 끝난다. 화면은 서버 상태를 다시 받아 '꺼짐'으로 보인다(거짓 '쉬는 중' 없음). 매일 조용한 시간 설정은 DB에 남는다.

**끝 시각 표시(최소 추가, UI 동결의 사용자 요청 예외):**

| 자리 | 전 | 후 |
|---|---|---|
| 폰 홈 배너 | 방해 금지 중 · 1시간 20분 남음 | 방해 금지 중 · **23:30까지** · 1시간 20분 남음 |
| 폰 설정 '제안 잠시 쉬기' 줄(켜졌을 때) | 지금은 새 제안과 자동 실행을 쉬어요 | **23:30까지** 새 제안과 자동 실행을 쉬어요 |
| 키오스크 방해 금지 창(켜졌을 때) | 새 제안과 자동 실행을 쉬고 있어요 | **23:30까지** 새 제안과 자동 실행을 쉬고 있어요 |
| 키오스크 위 줄 칩 | 방해 금지 / 1시간 20분 | 그대로(칩 너비 고정 — 바꾸지 않음) |

시각은 그 기기의 현지 시각(서버는 오프셋 붙은 ISO 시각을 준다). 골든 장면은 모두 잠시 쉬기 꺼짐 상태라 바뀐 장면이 없다(§5).

## 3. 경보 정책 추천표

[조용한 시간 기록](devlog_2026-10-14-quiet-hours.md) §3 표를 추천안으로 갱신했다(사건별 현재 코드 상태 값 대응 포함). **아직 사용자 확정 전이고 코드는 바꾸지 않았다.** 요지: 실제 위험(`estop_latched`·위험 신호음 `active`) → 조용한 시간에도 짧은 경고음+화면 / 걸림(`last_abort_reason="motion_alarm: stall"`) → 짧은 안내 뒤 화면 유지, 반복 없음 / 사용자 정지 확인(`stopped`+`mcu_ack`·`verified`) → 화면 중심 / 결과 모름(`unconfirmed`·`Receipt.UNKNOWN`) → 화면 '확인 못 함' / 정지 뒤 멈춤 모름(`last_stop_level="sent"`) → 일반 결과 모름과 분리한 주의 안내.

## 4. 배포 인계

[인계](../archive/인계-2026-10-13-데스크톱.md) §8에 11번을 더했다 — 4종 실제 배포 SHA 표(확인 방법 포함), RPi4 변경 여부, 호환 기준.

- **RPi4는 마지막 배포(`568f995` 이미지 + `ce37b81` `run_act.sh`) 뒤 동작이 바뀌지 않았다.** `git diff 568f995 HEAD`에서 `rpi4/`·`deploy/`·`pyproject.toml` 차이는 `ce37b81`뿐(이미 RPi4에 올림). RPi4 실행기(`rpi4.act_main`)가 불러오는 저장소 모듈 69개 중 바뀐 것은 공용 모델 4개(`rpi/commands/models.py` — 클라우드 경로 전용 확인 값, `rpi/intent/models.py`·`patterns.py`·`suggestions.py` — 백엔드 제안·조용한 시간)뿐이고 누름·정지·링크·시계 경로는 그대로다(가져오기 목록과 변경 파일을 맞춰 봄).
- 호환 기준: `act_info`의 `execute_protocol` 2 · `stop_report_protocol` 1 · `clock_protocol` 1 · `dev_motion_protocol` 2(RPi5는 1 이상 요구) · 같은 `SIMPLELAY_LINK_KEY`.
- 이미지는 RPi5와 같은 백엔드 이미지라 규칙대로 같은 커밋으로 함께 올리고 SHA를 적는다.

## 5. 시험

`$env:PYTHONUTF8=1`, 리포 `.venv`, `--basetemp C:\pt_tmp\<고유>`. 폰·키오스크는 ASCII 임시 worktree(HEAD + 이 변경)에서.

- **수정 전 실패 확인:** 서버 새 시험은 변형(카드 내림 끔·`guard`의 조용한 시간 검사 끔·처리 키 저장 끔·중복 판단에서 가전 ID 뺌)을 **소스를 고치지 않는 스크래치 pytest 플러그인**으로 걸어 각각 실패를 확인했다(A1 1·A2 2·A3 1·A4 1). 폰·키오스크 표시 시험 3건은 HEAD `lib`에서 실패(글자 없음), A1 폰·키오스크 3건은 원래 통과(현재 동작 고정).
- **전체:** 백엔드+rpi4 **3,006 통과·13 건너뜀**(2,999에서 +7: 새 파일 6·초안 중복 1. 첫 전체 실행에서는 이 기록이 아직 추적되지 않아 문서 링크 시험 1건만 실패했고, 추적한 뒤 다시 돌려 통과), 폰 **817**(`--exclude-tags screenshot`, 814에서 +3), 키오스크 **339**(336에서 +3), analyze error·warning 0(기존 info 폰 4·키오스크 1).
- **골든:** 폰 **55**·키오스크 **44** 비교 통과(갱신 없음 — 바뀐 장면 없음, 골든 장면은 모두 잠시 쉬기 꺼짐). 골든 시험의 아이콘 글꼴 경로가 다른 PC 설치 위치로 고정돼 있어, 임시 worktree 안에서만 이 PC의 Flutter 경로로 바꿔 돌렸다(커밋하지 않음).
- `rpi/tests/test_repo_guard.py`·`rpi/tests/test_doc_links.py` 통과(전체 실행에 포함).
- **환경 메모:** 이 PC에서 `flutter test`가 "Could not prepare isolate"로 멈췄다 — 임시 폴더(`TEMP`·`TMP`)가 사용자 폴더(비ASCII) 아래라서였다. `TEMP`·`TMP`를 ASCII 경로로 두면 돈다.

## 6. 공개 이력 점검

[공개 문서 정리](devlog_2026-10-14-public-docs.md) §2의 점검을 원격 참조별·정리 방법별로 넓힌 보고를 **저장소 밖 로컬 작업 기록 폴더**에 두었다(이력·원격·공개 상태는 바꾸지 않음). 요지: 원격 공개 참조는 `main`과 PR #1 참조(main의 조상)뿐, 태그·다른 브랜치 없음. 공개 이력의 금지어는 33커밋·41파일(①②③만, ④~⑦ 0), 개인 로컬 경로 8커밋·7파일, 문서 파일 0. 로컬 백업 브랜치 2개(pptx 포함)는 공개되지 않았고 push하지 않는다. 정리 방법(재작성·새 저장소·비공개 전환+새 저장소·유지)과 SHA 추적·push 방지 방법은 그 보고에 있고, 결정은 사용자 몫이다.

## 7. 미검증·남은 것

- 실폰·실패널에서 끝 시각 줄을 보지 않았다(글꼴 200%에서 홈 배너 줄바꿈 포함).
- 경보 추천표는 사용자 확정 전 — 확정되면 키오스크 낭독 자리만 고친다.
- 루틴 초안 목록은 잠시 쉬기 중에만 비고 매일 조용한 시간에는 보인다(4번 구현 그대로 — 사용자가 루틴 탭을 직접 열어야 보이고 팝업·소리가 없는 경로). 맞출지는 사용자 결정.
- 옛 BLE 예비 경로(`firmware/`)의 제안 메시지는 서버 판정을 거치지 않지만 현행 구성에는 없다.
