Seongwonp/Simplelay/docs/devlog/devlog_2026-10-15-kiosk-wording.md

# 2026-10-15 키오스크 문구·화면 개선 (키오스크 0~3단계 + 폰 안 A)

근거: [키오스크 문구·화면 개선 계획](../archive/키오스크-문구-개선-계획-2026-10-15.md)(§0 원칙, §1 용어표, §2~§5, §8 안 A, §9 시험, §10 순서, §11 결정).
작업 브랜치 `feat/routine-thinq-step`(별도 작업 트리). 서버·RPi4 문장(§6)은 같은 시각 다른 작업이 main에서 고쳤다(`2bc87e5`, B11 `2ab4360`).
**모두 위젯·골든 시험 수준이다. 실패널(15.8형) 눈 확인과 처음 쓰는 사람 재평가는 아직 하지 않았다.**

## 커밋

| 단계 | 커밋 | 내용 |
|---|---|---|
| 0 | `1663482` | 골든 아이콘 글꼴 경로(B6) + 지금 코드 기준선 |
| 1 | `acfb32b` | 완료·동작 중·비상 버튼 화면 + B2·B7·B9 |
| 2 | `7703852` | 실행·연습 화면 + B1 + 실행 이름 2줄 |
| 3 | `6eac28f` | 쉬운 말(§4) + B3·B4·B5·B8·B10, 생활 습관, 제안 근거 대체문 |
| 4 | `8073438` | 폰 안 A — 결과·정지 문장, '연습' 통일, 이름 이어 주기 |

## 0단계 — 골든 글꼴 경로(B6)·기준선

- 골든 시험 셋(키오스크 `screenshot_test`·`learning_screenshot_test`·`provenance_screenshot_test`)이 같은 도우미
  `test/support/golden_fonts.dart`로 아이콘 글꼴을 싣는다: `FLUTTER_ROOT` → 시험 실행 파일(flutter_tester)이 놓인 SDK.
  둘 다 없으면 네모 아이콘을 조용히 찍지 않고 실패한다. (폰 골든 시험도 4단계에서 같은 도우미로 바꿨다.)
- 기준선: 문구를 바꾸기 전에 44장을 다시 찍었다. 바뀐 것은 아이콘이 빠져 있던 `provenance_*` 4장뿐이고 40장은 같은 그림이었다.

## 1단계 — 완료·동작 중·비상 버튼

| 화면·조건 | 전 | 후 |
|---|---|---|
| 완료·성공·실제 | 버튼 조작을 마쳤어요 / 누름 장치가 다 눌렀다고 알려 왔어요 | **버튼을 다 눌렀어요** / 가전이 움직이는지는 직접 봐 주세요 |
| 완료·성공·실제·전력 확인 | 버튼 조작을 마쳤어요 + 가전 동작도 확인했어요 | **버튼을 다 눌렀어요** / {가전}의 전력 사용이 늘었어요. 원하는 동작인지는 직접 봐 주세요 |
| 완료·성공·환경 모름 | 끝났다는 보고를 받았어요 | **작은 팔이 다 눌렀다고 알려 왔어요** / 가전이 실제로 움직이는지는 직접 봐 주세요 |
| 완료·성공·연습 | 연습으로 버튼 조작을 마쳤어요 + 작은 칩 '연습 모드' | 맨 위 띠 '연습 중 · 실제 가전은 누르지 않아요' + **연습을 마쳤어요** / 실제 가전은 누르지 않았어요 |
| 완료·실패(눌림 미확인) | 버튼 조작을 확인하지 못했어요 · 금색 '다시 시도' 맨 앞 · 흐린 '닫기' | **가전을 먼저 봐 주세요**(가장 큰 글자) / 버튼이 눌렸는지 확인하지 못했어요. 이미 켜졌다면 다시 시도하지 마세요(한 번 더 눌려 꺼질 수 있어요) · `처음 화면으로`(채움) · `다시 시도`(테두리) · `화면으로 조작하기`(글자, 20px·밝게) |
| 안전 정지 | 안전하게 멈췄어요 | **눌림을 확인하지 못해 멈췄어요** / 가전을 먼저 봐 주세요 + 같은 당부 |
| 접수 불명(ThinQ) | 받았는지 확인이 필요해요 | **명령이 닿았는지 몰라요 — 가전을 먼저 봐 주세요** |
| 사용자 정지 verified | 실행을 멈췄어요 + ✓ 멈춘 것을 확인했어요 | **작은 팔이 멈췄어요** / 가전이 이미 켜졌다면 가전의 정지·취소 버튼을 직접 눌러 주세요 (✓) |
| 사용자 정지 mcu_ack | 실행을 멈췄어요 + ✓ 정지 신호가 전달됐어요 | **작은 팔이 정지 신호를 받았어요 — 멈췄는지는 확인 못 했어요** / 가전을 직접 봐 주세요 (?) |
| 사용자 정지 sent | 실행을 멈췄어요 + 정지 명령을 보냈어요 — 기계를 봐 주세요 | **멈추라고 보냈어요 — 멈췄는지 아직 몰라요** / 가전을 직접 봐 주세요 (?) |
| 사용자 정지 단계 모름 | 실행을 멈췄어요 | **정지 요청으로 실행이 끝났어요** / 작은 팔과 가전이 멈췄는지 직접 봐 주세요 (계획에 없던 칸 — 서버가 말한 사실까지) |
| 모션 중단 | 모터가 걸려 멈췄어요 등 | 작은 팔이 걸려 멈췄어요 등 — 주어만 '작은 팔' |
| 동작 중·전력 확인 | {가전} 동작 중 | **{가전}이 돌아가고 있어요** |
| 동작 중·미확인 | {가전} 동작 중 | **작은 팔이 {가전} 옆에서 기다리고 있어요** |
| 동작 중·연습 | {가전} 동작 중 + 칩 '연습 모드' | 맨 위 띠 + **{가전} 연습 중**, '연습으로 N개를 짚었어요' |
| 안내 줄 | 정지 버튼(취소) 위에서 기다리고 있어요(금색) | 정지를 누르면 작은 팔이 '취소' 버튼을 대신 눌러요(흰색) |
| 정지 확인 못 함 | 정지 버튼을 눌렀지만… / 가전을 직접 확인해 주세요 | 제목 '작은 팔이 대신 눌렀지만 멈췄는지 확인하지 못했어요', 정지 단추 바로 위 가장 큰 글자 **지금 {가전}의 '{취소}' 버튼을 직접 눌러 주세요**, 단추 이름 **다시 정지 시도**(자리·크기·색 그대로, 글자만 맞춰 줄어듦) |
| 정지 확인 | 가전이 멈췄어요 | {가전}이 멈춘 것을 전력으로 확인했어요 |
| 이동 | 보관 위치로 이동하고 있어요/했어요 | 작은 팔이 제자리로 돌아가고 있어요/돌아갔어요 |
| 근거 줄·연습 | 연습용 전력 값이에요 | 연습용 값이에요 — 실제로 잰 값이 아니에요 |
| 비상 걸림 중 제목 | {가전} 동작 중 | 비상 버튼이 눌려 있어요 · 가전이 멈췄는지는 직접 봐 주세요 |
| 버튼판 그림 | 칸이 채워진 버튼 모양 | 선만 그린 칸 + '작은 팔이 누르는 자리예요 · 화면은 누르지 않아도 돼요' |
| 비상 띠 제목 | 비상정지가 걸려 있어요 | **비상 버튼이 눌려 있어요**(재부팅 걸림은 **가전 콘센트 전원이 꺼져 있어요**) |
| 비상 띠 단추 | 확인하고 해제 → 해제 | **풀기 안내** → ① 빨간 비상 버튼을 돌려서 풀어 주세요 ② 가전 주변이 안전한지 봐 주세요 / 해제해도 멈췄던 작업은 다시 시작하지 않아요. 가전 전원은 따로 켜야 해요 → `취소`/**`해제하기`** (재부팅 걸림: '해제하면 가전 콘센트 전원이 다시 켜져요') |
| 해제 결과 | 비상정지를 해제했어요. 가전 전원은 따로 켜야 해요. | 해제했어요. 멈췄던 작업은 다시 시작하지 않아요. 가전 전원은 따로 켜야 해요.(재부팅 걸림: 해제했어요. 가전 콘센트 전원을 다시 켰어요.) |

- **B2:** 다시 보낼 요청이 없으면(폰이 시작한 실행·이어받은 실행·놓친 결과) `다시 시도`를 그리지 않고, 그 당부 문장도 쓰지 않는다.
- **B7:** 행동 단추를 스크롤 밖 아래에 고정 — 1.6배 글자에서도 `처음 화면으로`가 화면 안.
- **B9:** 동작 중 왼쪽 안내·정지 결과 칸이 넘치면 스크롤 막대가 늘 보인다(`KioskScrollArea`, 막대 색 지정). 왼쪽 안내 글자 33 → 28.
- 비상 띠는 **모든 화면**에 보인다. 제안·수동 조작 화면에서도 걸림을 따라가도록 /status를 함께 읽는다(완료 화면은 이미 읽던 조회에 붙였다).
  잠시 쉬기·위험 신호음·연결·설정 창은 띠 **아래** 자리에 뜬다. 서버 문장이 띠 제목을 되풀이하면(RPi4 `비상 버튼이 눌려 있어요 — 풀고 …`) 머리를 뗀다.
- 자동 실행 허용 규칙이 해제로 꺼진다고는 어디에도 쓰지 않았다(계획 원칙 0-6). '두 번 누르지 않아요'는 금지어 시험이 막는다.
- 음성 안내도 같은 제목 규칙(정지 단계별·안전 정지·성공).

## 2단계 — 실행·연습

| 지금 | 후 |
|---|---|
| 총 2단계 중 0단계(B1 — 끝낸 수를 썼다) | **누를 버튼 2개 중 1번째**(끝낸 수 + 1), 끝나면 '2개 모두 눌렀어요', 단계 수 모르면 '버튼 N개를 눌렀어요'. 스크린리더도 같은 번호 |
| 눌림 확인 중 | 제대로 눌렸는지 확인하는 중 |
| 보정 후 다시 시도 중 · 눌림이 확인되지 않아 자리를 맞추고 다시 눌러요 | **자리를 맞춰 다시 누르는 중** · 눌렸는지 확인되지 않아 한 번 더 눌러요 |
| 전류 +14mA · 소리 +9dB · 센서 93% · 2번째 시도 | 버튼을 누른 뒤 가전 반응을 보고 있어요 · 2번째 시도(숫자 없음) |
| 실행 이름 1줄 말줄임 | 2줄까지 |
| 지금 누르는 버튼(그림 위) | 작은 팔이 누르는 자리예요 · 화면은 누르지 않아도 돼요 |
| 칩 '연습 모드' | 맨 위 띠, '짚는 중' · '짚을 버튼 N개 중 K번째' · 연습 확인 칩 '연습 결과' |

- 큰 글씨에서 진행 막대가 넘치면 스크롤 막대가 보인다. 골든 `provenance_running`의 시험 입력 '모의 검증'은 화면에 나오지 않는 값이라 뺐다.

## 3단계 — 쉬운 말

| 화면 | 전 | 후 |
|---|---|---|
| 용어 | 허브 / 누름 장치 / 플러그 | SimpleLay 본체 / 작은 팔 장치 / 가전 콘센트 장치 |
| 연결 창 | 다시 연결하기, 글자 33·높이 420(B4 잘림) | **다시 확인하기**, 글자 24·화면 높이 안에서 스크롤 + 막대, 'SimpleLay 본체: 부엌에 둔, 이 화면이 달린 상자예요'(본체가 처음 나오는 곳) |
| 제안 | 다음에 · 누를 순서 · N초 | 이번엔 안 할게요 · 작은 팔이 누를 순서 · N초 뒤 닫혀요 |
| 제안 근거 대체문(서버 문장이 없을 때) | 아침 시간에 3번 하셨어요. | 아침에 자주 하셔서 여쭤봐요 · 3번 하신 기록이 있어요 ('최근' 없음) |
| 내 루틴(B3) | 아침 데우기 · 3단계 | 버튼 3번 · 가전 설정 N번(ThinQ 단계) · 알림만 |
| 내 루틴 | 새 루틴은 폰 앱에서 녹화해요 | 새 루틴은 휴대폰 SimpleLay 앱에서 만들어요 |
| 수동 조작(B10) | 버튼을 누르면 허브가 대신 눌러요(이름 옆 1줄 말줄임) | 이름 아래 줄: 화면의 버튼을 누르면 작은 팔이 {가전} 버튼을 대신 눌러요(2줄 허용) |
| 준비 안 됨 | 사유만 | 사유 + 할 일 한 줄(연결 → 처음 화면 위쪽 연결 표시 · 모터·센서 → 기다리기·작은 팔 장치 다시 켜기 · 자리·오래됨 → 휴대폰 앱에서 버튼 자리 맞추기) |
| 평소·빈 줄(B5) | + 아이콘, 앱에서 가전을 추가해 주세요 | 안내 아이콘, 휴대폰 SimpleLay 앱에서 가전을 추가해 주세요 / SimpleLay 본체와 연결되면 가전이 보여요 |
| 가전 줄 넘김 | `>` | `>` + '다음 1/2' |
| 방해 금지 칩(B8) | 방해 금지 / 1시간 30분(큰 글씨에서 안 커짐) | **제안 쉬는 중 / 1시간 30분 남음**(같이 커짐) |
| 방해 금지 창 | 방해 금지 / 방해 금지 해제 | **제안 잠시 쉬기**(범위 줄은 늘) / **다시 제안 받기** |
| 생활 습관 | 2일 사용 · 5회 / 추천 숨김 | 최근 28일 중 2일, 모두 5번 / 이 제안은 보이지 않게 해 뒀어요 · 글자 20~22 |
| 그 밖 | 저장 실패 안내·폰 연결 오류의 '허브', 제안 거절 실패 문장 | 'SimpleLay 본체', "'이번엔 안 할게요'를 보내지 못했어요" |

- 제안 화면 왼쪽도 넘치면 스크롤 막대. 골든은 막대가 나타난 뒤(한 프레임 더)의 그림을 찍는다.
- 시험 고정값의 옛 서버 문장은 지금 서버 문장으로 바꿨다(연결 항목·`버튼 자리를 아직 맞추지 않았어요`·비상 걸림 상세).
- 보류: 평소 화면 위 아이콘 아래 글자(설정·쉬기·연결) — 배치가 바뀌므로 계획 §4대로 이번에는 하지 않았다.

## 4단계 — 폰 안 A

| 전 | 후 |
|---|---|
| 실행을 멈췄어요. 정지 명령을 보냈어요 — 멈췄는지 기계를 봐 주세요. | 멈추라고 보냈어요. 멈췄는지 아직 몰라요. 가전을 직접 봐 주세요. |
| 실행을 멈췄어요. 정지 신호가 전달됐어요. | 누름 장치가 정지 신호를 받았어요. 멈췄는지는 확인 못 했어요. 가전을 직접 봐 주세요. |
| 실행을 멈췄어요. 멈춘 것을 확인했어요. | 누름 장치가 멈췄어요. 가전이 이미 켜졌다면 가전의 정지·취소 버튼을 직접 눌러 주세요. |
| 실행을 멈췄어요. 장치가 멈췄는지 확인해 주세요. | 정지 요청으로 실행이 끝났어요. 누름 장치와 가전이 멈췄는지 직접 봐 주세요. |
| 누름 장치가 응답했어요. 켜졌는지 가전을 확인해 주세요.(실제) | 버튼을 다 눌렀어요. 가전이 움직이는지는 직접 봐 주세요. |
| 모의 버튼 조작을 마쳤어요. | 연습을 마쳤어요. 실제 가전은 누르지 않았어요. |
| 눌림을 확인하지 못해 안전하게 멈췄어요. 가전을 확인해 주세요. | 눌림을 확인하지 못해 멈췄어요. 가전을 먼저 봐 주세요. 이미 켜졌다면 다시 시도하지 마세요(…) |
| 확인 칩 '켜진 것을 확인했어요' | 전력 사용이 늘었어요 |
| 수동 조작 "'X' 눌림을 확인했어요"(성공으로 끝나기만 하면) | 실제 실행에서 눌림·동작 확인 때만. 연습 "'X' 연습으로 눌렀어요 · 실제 가전은 누르지 않았어요", 그 밖 "'X' 누름 장치가 눌렀다고 알려 왔어요 · 가전은 직접 봐 주세요", 실패 "… 눌림을 확인하지 못했어요 — 가전을 먼저 봐 주세요" |
| 사용자에게 보이는 '모의'(상태 타일·칩·ThinQ 카드·가전 설정·생활 습관 등) | '연습'(개발자 도구·개발자 설정·내부 오류 문장·개발 빌드 전용 단추는 그대로) |
| 설정 '허브' 줄 | + "키오스크에서는 'SimpleLay 본체'라고 불러요" |
| 방해 금지 창 | + "키오스크의 '제안 잠시 쉬기'와 같아요" |

- 폰은 이름 바꾸기를 하지 않는 안 A라서 주어는 **누름 장치**로 뒀다(키오스크는 '작은 팔'). 개발자 도구의 정지 단계 문장(ms 포함)과
  `stopLevelConfirmed`(개발자 콘솔에서만 씀)는 그대로다.

## 버그 상태

| # | 상태 |
|---|---|
| B1 실행 '0단계' | 고침(2단계) — 화면·스크린리더 |
| B2 다시 보낼 요청 없는데 다시 시도 | 고침(1단계) |
| B3 루틴 'N단계'가 버튼 수 | 고침(3단계) — '버튼 N번'·'가전 설정 N번'·'알림만' |
| B4 연결 창 잘림·스크롤 표시 없음 | 고침(3단계) |
| B5 누를 수 없는 안내에 '+' | 고침(3단계) |
| B6 골든 글꼴 고정 경로 | 고침(0단계, 폰은 4단계) |
| B7 큰 글자 완료 화면 단추 화면 밖 | 고침(1단계) |
| B8 방해 금지 칩 큰 글자 | 고침(3단계) |
| B9 hold_large 잘림·스크롤 표시 없음 | 고침(1단계) — 막대 표시 + 글자 28 |
| B10 수동 조작 1줄 말줄임 | 고침(3단계) |
| B11 재부팅 걸림 뒤 콘센트 전원 재켜짐 | 이 작업 범위 밖 — main `2ab4360`(서버 작업) |
| B12 제안 근거 숫자 불일치 | 키오스크 대체문만 고침. 서버 문장은 main `2bc87e5`('…자주 하셔서 여쭤봐요 · 최근 N일 중 …') |
| **R1 같은 버튼을 한 번 더 누를 수 있다** | **열린 문제 — 해결하지 않았다.** 문구는 '이미 켜졌다면 다시 시도하지 마세요'와 '한 번 더 눌러요'(안전하다고 말하지 않음)까지. 자동 재시도는 여전히 전류 변화(L1)만 보고 다시 누르고, `다시 시도`도 상태 확인 없이 같은 순서를 보낸다. 동작 개선 후보는 계획 §5-1 |

## 시험

- **실패 확인(수정 전 코드):** `git stash` 없이 lib 폴더만 앞 커밋으로 바꿔 끼운 복사본에서 돌렸다.
  - 1단계 `kiosk_wording_test` 19건 → 수정 전 19건 모두 실패
  - 2단계 10건 → 10건 실패
  - 3단계 14건 → 14건 실패
  - 4단계 폰 `wording_plan_a_test` 11건 → 11건 실패. 수동 조작 결과 3건 중 2건 실패, 실제 눌림 확인 경우 1건은 예전과 같은 문장이라 통과(유지 확인용)
- 바뀐 문구로 깨진 기존 시험은 새 문구로 고쳤다(완료·정지 단계·비상 띠·동작 중·실행·제안·연결·잠시 쉬기·생활 습관·폰 결과 문장 등).
- **수(골든 제외):** 키오스크 357 → 376 → 386 → **400**. 폰 872 → **886**.
- **골든(따로):** 키오스크 44 → **52장** 모두 통과(재생성 뒤 비교). 폰 **55장** 통과(바뀐 4장만 재생성).
- `flutter analyze`: 키오스크 오류·경고 0(기존 info 1), 폰 오류·경고 0(기존 info 4). 저장소 가드·문서 링크 시험 통과.
- 키오스크 큰 글씨 모드는 **1.22배**다(`kiosk_screen`). '1.6배' 확인은 `provenance_*_1.6`·`learning_1.6` 골든과 `kiosk_wording_test`(B7·연습 띠)로 했다.

## 다시 찍은 골든

- 1단계: done, done_failed, done_large, done_user_stop, done_user_stop_large, hold, hold_estop, hold_large, hold_unconfirmed,
  kiosk15_done, kiosk15_hold, kiosk15_idle_estop, provenance_done_1.0·1.6 / 새로: done_power, hold_estop_confirm,
  kiosk15_done_failed, kiosk15_done_user_stop, kiosk15_hold_unconfirmed
- 2단계: executing, executing_large, executing_retry, kiosk15_executing, provenance_running_1.0·1.6
- 3단계: connection_modal, dnd_large, done, done_large, done_power, executing_large, hold_estop_confirm, hold_large, idle,
  idle_disconnected, idle_dnd, idle_empty, idle_large, kiosk15_dnd, kiosk15_done, kiosk15_idle, kiosk15_idle_estop, kiosk15_manual,
  kiosk15_my_appliance, kiosk15_suggestion, learning_1.0·1.6, manual, manual_large, manual_not_ready, my_appliance, suggestion,
  suggestion_large, suggestion_long_large / 새로: connection_modal_large, kiosk15_connection_modal, kiosk15_idle_dnd
  (스크롤 막대가 보이도록 골든을 한 프레임 더 그린 뒤 찍게 바꿔, 막대가 있는 화면은 다시 찍혔다)
- 폰(4단계): settings, settings_large, lt_settings(10/15 앞선 문구 변경분 포함), lt_status_completed
- 여러 장을 직접 열어 800×480·1920×1080·큰 글씨에서 잘림·겹침을 봤다: done_failed, done_large, hold_large, hold_estop_confirm,
  kiosk15_hold_unconfirmed, kiosk15_done_user_stop, kiosk15_idle_estop, executing_large, executing_retry, kiosk15_executing,
  provenance_done_1.6, provenance_running_1.6, connection_modal_large, idle_large, manual_large, manual_not_ready,
  suggestion_long_large, dnd_large, kiosk15_idle_dnd, learning_1.6, 폰 settings_large·lt_status_completed.
  남은 모양 문제: hold_large(큰 글씨·연습)는 왼쪽 안내가 여전히 길어 스크롤해야 끝까지 보인다(막대는 보인다).

### 처음 쓰는 사람 재검토용 15.8형 골든(kiosk15_*)

다시 찍음: `kiosk15_done.png`, `kiosk15_hold.png`, `kiosk15_idle_estop.png`, `kiosk15_executing.png`, `kiosk15_dnd.png`,
`kiosk15_idle.png`, `kiosk15_manual.png`, `kiosk15_my_appliance.png`, `kiosk15_suggestion.png`
새로: `kiosk15_done_failed.png`, `kiosk15_done_user_stop.png`, `kiosk15_hold_unconfirmed.png`, `kiosk15_connection_modal.png`, `kiosk15_idle_dnd.png`
그대로: `kiosk15_appliance_select.png`, `kiosk15_danger.png`

## 서버·RPi4 쪽에 남은 문장 (키오스크가 그대로 보이는 것)

main `2bc87e5`가 §6 대부분을 고쳤다. 아직 남은 것:

- 리허설 주입 비상 걸림 상세 — `rpi/api/router.py`의 '(시연: 모의 콘센트 모듈 비상 버튼이에요 …)', '(시연 주입: RPi4 가짜 콘센트 모듈 비상 버튼이에요 …)'.
  시연 리허설 때 띠 상세 줄에 보인다('가전 콘센트 장치'·'연습'으로).
- `rpi4/services/act_executor.py` '모션 보드에 정지를 보내지 못했어요 — 물리 비상정지를 눌러 주세요'(작은 팔 장치·빨간 비상 버튼으로).
- `rpi/commands/physical.py` '작은 팔이 눌림을 확인하지 못해 안전하게 멈췄다고 알려 왔어요 …' — 키오스크 제목에서 뺀 '안전하게'가 실패 화면 작은 글씨에 남는다.
- `rpi4/services/stop_hold.py` 대기 상세 "작은 팔이 '취소' 버튼 위에서 기다리는 중이에요"는 키오스크의 새 안내 줄
  "정지를 누르면 작은 팔이 '취소' 버튼을 대신 눌러요"와 같은 자리에 겹쳐 보인다(키오스크가 대기 중에는 상세를 숨기는 것도 방법).

## 계획과 다르게 한 것(코드 사실에 맞춤)

- **재부팅 걸림**(서버 상세에 '다시 켜져'): 비상 버튼이 눌린 것이 아니라 제목을 '가전 콘센트 전원이 꺼져 있어요'로, 안내에 빨간 버튼 풀기를 넣지 않았다.
- **확인 창**은 대화창이 아니라 띠 안에서 펼친다(종전 구조) — 펼친 동안에도 정지 단추가 가려지지 않는다.
- 성공 제목 '버튼을 다 눌렀어요 — 가전이 움직이는지는 직접 봐 주세요'는 제목 + 바로 아래 같은 크기 계열 한 줄로 나눴다.
- 동작 중 '확인 못 함'의 가장 큰 할 일은 정지 단추 바로 위 칸(33)에 두고, 제목(26)은 무슨 일이 있었는지를 말한다.
- '{가전}이 멈춘 것을 확인했어요(전력)' → '{가전}이 멈춘 것을 전력으로 확인했어요'.
- 연습 대기 화면 제목은 띠가 '연습 중 · 실제 가전은 누르지 않아요'를 말하므로 '{가전} 연습 중'.
- 물리 성공에서는 같은 말을 되풀이하던 확인 칩(버튼을 눌렀어요·작은 팔이 응답했어요·연습 결과)을 뺐다. 눌림 미확인('눌렸는지 확인 못 했어요')만 남는다.
- 사용자 정지 단계 모름 칸, 루틴 '가전 설정 N번', 수동 조작 결과(폰)의 확인 근거 읽기는 계획 표에 없던 것을 같은 원칙으로 채웠다.
- 폰 정지·결과 문장의 주어는 '누름 장치'(안 A: 폰 이름 바꾸기 없음).

## 확인하지 않은 것

- 실패널(15.8형)에서 눈으로 — 학교 RPi5 배포 때.
- 처음 쓰는 사람의 재평가(계획 §9-6) — 위 kiosk15_* 목록으로 다시 받는다.
- 실물: 정지 단계·비상 걸림·재부팅 걸림 문장이 실제 서버 값과 함께 어떻게 보이는지(이번에는 시험 고정값으로만 봤다).
