Seongwonp/Simplelay/docs/devlog/devlog_2026-10-15-server-wording.md

# 2026-10-15 서버·RPi4 화면 문장 용어 통일(§6) + B11 재부팅 걸림 뒤 비상 버튼

근거: [키오스크 문구·화면 개선 계획](../archive/키오스크-문구-개선-계획-2026-10-15.md) §0 원칙·§1 용어표·§6 서버 문장·§5 B11.
키오스크(`rpi5-touchscreen-app/`)·폰(`app/`)은 다른 작업이 맡는다. 이 기록은 서버(`rpi/`)·RPi4(`rpi4/`)만 다룬다.
**문장만 바꿨다** — 판정·재시도·코드 값(`reason`·`hold_state`·`stop_outcome` 등)·필드 이름은 그대로다(B11 수리는 별도 커밋).

## 1. B11 — 재부팅 걸림 뒤 비상 버튼이 이어지면 해제 확인이 콘센트 전원을 다시 켰다 (커밋 `2ab4360`)

- 의심(계획 §5): 콘센트 모듈 재부팅으로 `power_lost`(해제 확인 뒤 릴레이 다시 켜기)가 선 뒤 비상 버튼이 눌리면 `power_lost`가 남아,
  사람이 비상 버튼을 풀고 해제하면 릴레이가 다시 켜진다. 비상 버튼으로 꺼진 전원은 켜지 않는 규칙(protocol.md)과 어긋난다.
- **재현됨.** 가짜 콘센트 모듈로 릴레이 켬 → `reboot()`(재부팅 걸림, `outlet_reboot`) → `press_estop()` → 버튼 풂 → `estop_ack`:
  수정 전 코드에서 `fake.relay_on`이 **True**(다시 켜짐). estop 이벤트를 잃고 주기 `status`로만 걸림을 안 경우는 실행기 걸림 원인이
  `outlet_reboot`로 남아 화면 문장도 '다시 켜져'(해제하면 켜짐)로 남았다.
- 수리(최소):
  - `rpi/verifier/outlet.py` — `estop` 이벤트, 또는 `ready`·`status`가 걸림(`estop:true`)을 보고하면 `power_lost`와 `relay_expected_on`을 지운다.
  - `rpi4/services/act_executor.py` — `handle_outlet_estop`: 재부팅 걸림 위에 온 모듈 보고(ready·status)는 '같은 걸림 재확인'으로 버리지 않고
    새 비상 버튼 걸림으로 원인(`estop_source`)을 바꾼다. 그 밖의 재확인 무시 규칙은 그대로.
- 시험 `rpi4/tests/test_eval_fixes_outlet.py` +3: 이벤트 경로·status 보고 경로(둘 다 해제 뒤 릴레이 꺼짐·`power_lost` 지워짐·'다시 켜져' 문장 없음),
  재부팅 걸림 단독은 종전대로 해제 뒤 다시 켬(회귀). 수정 전 코드: **2 실패**(릴레이 켜짐 / 원인 그대로), 실행기 수정만 빼면 status 경로 1 실패.
- 미검증: 실물 콘센트 모듈(회로 미제작) — 가짜 모듈로만 확인.

## 2. 서버·RPi4 문장 (커밋: 이 기록과 같은 커밋)

| 위치 | 전 | 후 |
|---|---|---|
| `rpi/services/connections.py` 연결 창 | 허브 · 누름 장치 · 플러그 | SimpleLay 본체 · 작은 팔 장치 · 가전 콘센트 장치 (제목·설명·해결 방법 전부) |
| 〃 해결 방법 | 잠시 뒤 '다시 연결하기'를 눌러 주세요. | 잠시 뒤 '다시 확인하기'를 눌러 주세요. (키오스크 단추 이름 변경과 맞춤) |
| 〃 | 누름 장치와 허브를 잇는 선이 끝까지 꽂혀 … | 작은 팔 장치에 꽂힌 선(전원·연결)이 끝까지 꽂혀 … (RPi4는 Wi-Fi라 '허브와 잇는 선'은 사실이 아님) |
| 〃 | 플러그를 허브와 가까운 콘센트로 옮겨 주세요. | 가전 콘센트 장치와 작은 팔 장치를 잇는 선이 끝까지 꽂혀 … (모듈은 RPi4에 USB로 붙음) |
| 〃 연습 | 지금은 연습용 누름 장치로 동작해요. / 연습용 플러그 값 | 연습 중이에요 · 실제 가전은 누르지 않아요. / 연습 중이라 실제로 잰 전력 값이 아니에요. |
| `rpi4/services/stop_hold.py` `hold_detail` | 정지됨 — 정지 버튼을 누른 뒤 전력이 떨어진 것을 확인했어요 | 가전이 멈춘 것을 확인했어요 — 작은 팔이 정지 버튼을 누른 뒤 가전 전력이 떨어졌어요 |
| 〃 | 정지됨(모의) — … 모의 가전이 꺼졌어요 | 연습 결과 — 작은 팔이 정지 버튼을 짚은 뒤 연습용 가전이 꺼졌어요(실제 가전 아님) |
| 〃 | 정지 요청함·미확인 — 정지 버튼을 N번 눌렀지만 … | 가전이 멈췄는지 확인하지 못했어요 — 작은 팔이 정지 버튼을 N번 눌렀지만 가전 전력이 떨어진 것을 확인하지 못했어요. … |
| 〃 | 구동부 이상으로 … / 구동부를 멈췄어요 — … | 작은 팔에 이상이 생겨 … / 작은 팔을 멈췄어요 — … |
| 〃 | 가전이 끝나 / 가전이 멈춰 / 최대 대기 시간이 지나 보관 위치로 이동했어요(가전 종료는 미확인) | 가전 전력이 떨어져 / 가전이 멈춰 / 최대 대기 시간이 지나 **작은 팔이 제자리로 돌아갔어요**(가전이 끝났는지는 확인하지 못했어요) |
| 〃 진행 문장 | 보관 위치로 이동하는 중이에요 · '취소' 위에서 Z를 올린 채 기다리는 중이에요 · 정지 버튼 '취소'을 N번 누르는 중이에요 | 작은 팔이 제자리로 돌아가는 중이에요 · 작은 팔이 '취소' 버튼 위에서 기다리는 중이에요 · 작은 팔이 정지 버튼 '취소'을 N번 누르는 중이에요 |
| `rpi4/services/act_executor.py` 해제 결과 | 비상정지 버튼이 아직 눌려 있어요 — 버튼을 풀고 다시 확인해 주세요 | 빨간 비상 버튼이 아직 눌려 있어요 — 돌려서 푼 뒤 다시 눌러 주세요 |
| 〃 | 콘센트 모듈이 답하지 않아 비상정지를 풀지 못했어요 / 확인하는 사이 비상정지가 다시 걸렸어요 | 가전 콘센트 장치가 답하지 않아 비상 버튼 걸림을 풀지 못했어요 / 해제하는 사이 비상 버튼이 다시 눌렸어요 |
| 〃 `estop_detail` | 비상정지가 걸려 있어요 — 버튼을 풀고 확인을 눌러야 다시 움직여요 | 비상 버튼이 눌려 있어요 — 풀고 '해제하기'를 눌러야 다시 쓸 수 있어요 |
| 〃 + `rpi/verifier/outlet.py` + `rpi4/act_main.py` 재부팅 걸림 | 콘센트 모듈이 다시 켜져 전원이 꺼져 있어요 — 확인 후 켜 주세요 | 가전 콘센트 장치가 다시 켜져 가전 전원이 꺼져 있어요 — 해제하면 전원을 다시 켜요 ('다시 켜져'는 RPi5 `estop_block_reason`이 읽는 표시라 유지, 두 보드 문장 동일 — 시험으로 고정) |
| 〃 실행 거절 | 정지 버튼을 누르거나 보관 위치로 이동하는 중이에요 · 정지 버튼 위 대기를 하지 않아요 · 정지 버튼 위에서 기다리는 중이에요 | 작은 팔이 … 제자리로 돌아가는 중이에요 · 작은 팔이 정지 버튼 위에서 기다리지 않아요 · 작은 팔이 정지 버튼 위에서 기다리는 중이에요 |
| `rpi/verifier/outlet.py` 실행 전 확인 | 콘센트 모듈 포트를 다시 여는 중이에요(USB 연결 확인) · 콘센트 모듈이 N초째 … | 가전 콘센트 장치와 다시 연결하는 중이에요(USB 선 확인) · 가전 콘센트 장치가 N초째 … |
| `rpi/api/service.py` 실행 막힘 사유 | 비상정지가 걸려 있어요 — 버튼을 풀고 정지 해제 확인을 눌러 주세요 | 비상 버튼이 눌려 있어요 — 빨간 비상 버튼을 풀고 해제해 주세요 (폰 '확인하고 해제'·키오스크 '해제하기' 어느 쪽에도 맞게) |
| 〃 | 비상정지 상태를 확인하는 중이에요 — RPi4 응답을 기다려요 / 누름 장치 연결 안 됨 — 다시 연결하는 중이에요 | 비상 버튼 상태를 확인하는 중이에요 — 작은 팔 장치의 답을 기다려요 / 작은 팔 장치와 연결되지 않았어요 — 다시 연결하는 중이에요 |
| `rpi/services/readiness.py` | 버튼 좌표를 아직 맞추지 않았어요 | 버튼 자리를 아직 맞추지 않았어요 |
| `rpi/api/router.py` `/stop/ack` 504 | RPi4가 비상정지 해제 확인에 답하지 않았어요 | 작은 팔 장치가 해제 확인에 답하지 않았어요 |
| `rpi/commands/physical.py` `last_detail` | 실행기가 완료를 보고했어요 (이쪽 센서 근거 없음, 가전 동작은 확인하지 않음) | 작은 팔이 다 눌렀다고 알려 왔어요(가전 동작은 확인하지 않았어요) |
| 〃 | 실행기가 버튼 눌림과 가전 동작(L3 전력)을 확인했다고 보고했어요 / 버튼 눌림과 가전 동작을 확인했어요 | 작은 팔이 다 눌렀고, 가전 전력이 바뀐 것도 확인했다고 알려 왔어요 / 버튼 눌림과 가전 전력 변화를 확인했어요 (확인한 것은 전력 변화 — 원칙 0-1) |
| 〃 | 실행기가 … 보고했어요 (… L3: 사유) · (모의 전력 판정은 통과 — …) · 정지 요청으로 / 확인 실패로 안전 정지 / 실패를 보고 (멈춘 버튼·눌림 개수는 보고되지 않음) | 작은 팔(장치)이 … 알려 왔어요 (전력 확인: 사유) · (연습용 전력 값이라 …) · 정지 요청으로 멈췄다고 / 눌림을 확인하지 못해 안전하게 멈췄다고 / 실패를 알려 왔어요 (어느 버튼에서 멈췄는지·몇 개 눌렀는지는 알려 오지 않았어요) |
| 〃 | 실행기 응답이 없어 눌렸는지 알 수 없어요 · 버튼은 모두 눌렸지만 실행을 멈췄어요 | 작은 팔 장치의 응답이 없어 … · 버튼은 모두 눌렸지만 작은 팔을 멈췄어요 |
| `rpi/services/act_client.py` 걸림 기본 문장 | 비상정지가 걸려 있어요 | 비상 버튼이 눌려 있어요 |
| `rpi/routines/runner.py` | 비상정지가 걸려 남은 단계를 보내지 않았어요(해제 확인 뒤에도 이어서 하지 않아요) | 비상 버튼이 눌려 남은 단계를 보내지 않았어요(해제한 뒤에도 이어서 하지 않아요) |
| `rpi/api/service_commands.py` ThinQ 거절 | 비상정지가 걸려 있어 보내지 않았어요 — 버튼을 풀고 정지 해제 확인을 누른 뒤 다시 해 주세요 | 비상 버튼이 눌려 있어 보내지 않았어요 — 빨간 비상 버튼을 풀고 해제한 뒤 다시 해 주세요 |
| `rpi/intent/suggestions.py` 습관 제안 근거 | 최근 28일 동안 아침 시간에 2일 사용하셨어요. | 아침에 자주 하셔서 여쭤봐요 · 최근 28일 중 2일 사용 (루틴 이름 질문 "평소처럼 '…' 할까요? "는 앞에 그대로) |

`docs/protocol.md`의 재부팅 걸림 문장·412 사유도 새 문장으로 고치고 B11 규칙을 적었다.

## 3. 일부러 남긴 문장 (이유)

- **폰 전용 화면**(계획 §8 안 A — 이름 바꾸기는 키오스크 먼저, 폰은 다음): `rpi/api/pairing.py`(허브 화면·허브 키), `rpi/routines/auto_rules.py`
  (허브가 갑자기 꺼져… · 비상정지가 걸려 있어 자동 실행하지 않았어요 — 저장된 이유 문장을 옮기는 표가 있어 함께 바꿔야 함),
  `rpi/api/mapping_router.py:230`, `rpi/api/router.py:776`(사진 매핑 '기준점 보정'), `rpi/services/stop_park.py`(폰에서 정하는 '보관 위치' 설정 검사·안내),
  `rpi/services/panel_mapping.py`·`rpi4/services/stop_hold.py` 확인 주행 결과(“Z를 올린 채 도착 …” — 폰 가전 추가 ⑤ 단계).
- **준비 안 됨 사유 나머지**(`readiness.py` 기기와 연결되지 않았어요·모터·센서·확인한 지 오래돼…, `service.py:164, 1089`): 계획 §6은 '좌표 → 자리'만 바꾸고 할 일 한 줄은 키오스크가 붙인다 —
  키오스크가 이 문장으로 할 일을 고를 수 있어 그대로 둔다.
- **화면이 쓰지 않는 문장:** `/stop/ack` 409 "이 실행기는 비상정지 걸림을 보고하지 않아요"(폰·키오스크는 상태 코드로 자기 문장을 씀),
  `stop_detail`("RPi4가 정지 확인 단계를 …" — 클라이언트가 읽지 않음), `REHEARSAL_REFUSED_DETAIL`·`/demo/*` 리허설 문장(운영자용).
- **개발자·로그 전용:** `dev_real_motion.py`(비상정지가 걸려 있어요 — …), `developer_session.py`·`closed_loop.py`·`serial_motion.py`(보정·좌표), 로그·주석·독스트링.
- **물리 결과의 층 표기** "'시작'에서 실패했어요 (L1, 2회 시도, …)"·"(가전 동작은 확인하지 않음)"(센서 확인 경로)는 이번 범위 밖(용어표 대상 아님).
- `operation_detail`("L3 판정 불가 — …")은 판정 사유 원문이라 그대로.

## 4. 시험

- 기대 문구를 바꾼 기존 시험 16개 파일(29개 시험) + 새 `rpi/tests/test_server_wording.py` 8개(옛 말·내부 말이 연결 창·정지 대기·비상 버튼 문장에 없음,
  재부팅 걸림 문장 두 보드 동일·'다시 켜져' 유지, 자리 맞추기 사유).
- **실패 확인:** 문장 소스 13개를 `2ab4360` 판으로 잠시 되돌려(파일 복사, 끝난 뒤 복원·일치 확인) 바뀐 시험만 돌림 → **37 실패 · 290 통과**(기존 29 + 새 8).
- 전체: 백엔드+rpi4 **3,189 통과**, 10 건너뜀(골든 없음) — B11 +3, 문장 +8. 한 번은 `test_air_quality_suggestion.py::test_stop_is_not_delayed_by_a_stalled_air_quality_read`가
  시간 경계로 실패했다가 다시 돌리면 통과(문장과 무관, 정지 진입 지연 상한 시험 — 기계 부하 때 흔들림).
  커밋 전 마지막 전체 실행은 3,188 통과·1 실패(`test_sensor_window.py::test_first_run_with_default_config_succeeds_on_first_press`,
  다른 작업의 flutter 시험과 동시 실행 중) — 이 파일만 세 번 다시 돌려 14/14 통과, 바꾼 파일과 무관한 시간 의존 흔들림으로 본다.
- `rpi/tests/test_repo_guard.py`·`rpi/tests/test_doc_links.py` 통과.

## 5. 배포·남은 일

- **RPi4 재배포 필요(같은 커밋 규칙):** `rpi4/services/stop_hold.py`·`act_executor.py`·`rpi/verifier/outlet.py`(RPi4에서 돎) 문장과 B11 수리는
  RPi4가 만든다. RPi5만 새 판이면 정지 대기·비상 버튼 문장이 옛 말로 남고 B11 수리도 들어가지 않는다 — 학교 배포 때 RPi4·RPi5를 이 커밋으로 함께.
- 키오스크와 맞출 것: 연결 창 해결 방법이 이제 '다시 확인하기'를 말한다(키오스크 단추 이름 변경과 함께 나가야 한다. 키오스크 쪽 대체 문장
  `lib/models/ambient.dart`의 '다시 연결하기'도 같이). 재부팅 걸림 구분은 여전히 `estop_detail`의 '다시 켜져'.
- 작업 중 사고(기록): 실패 확인에 `git stash`를 썼다가 다른 작업 트리의 stash와 엇갈려(stash는 작업 트리끼리 공유) 서로의 변경이 바뀌어 들어갔다.
  조정자가 복구했고, 문장 소스는 같은 편집 스크립트로 다시 만든 뒤 원래 차이와 줄 단위로 같음을 확인했다. 앞으로 실패 확인은 파일 복사로만 한다.
