Seongwonp/Simplelay/docs/devlog/devlog_2026-10-16-kiosk-design.md

# 2026-10-16 키오스크 시각 디자인 규격 적용 (순서 1·2 + 상태 띠)

근거: [키오스크 디자인 규격 계획](../archive/키오스크-디자인-규격-계획-2026-10-15.md)(§1 규격, §3 순서, §4 결정, §5 구현 기록)과
[문구 개선 계획](../archive/키오스크-문구-개선-계획-2026-10-15.md)(문구는 그대로 두고 배치만 바꿈). 작업 브랜치 `feat/kiosk-design`(별도 작업 트리, main `1d18733`에서).
**검증 수준: 골든·위젯 시험까지. 실패널(15.8형)에는 설치하지 않았고, 처음 쓰는 사람 재평가도 아직이다.** 동작·서버 규약은 바꾸지 않았다.

## 디자인 토큰 (`lib/theme/kiosk_tokens.dart`, 색은 `kiosk_colors.dart`)

수치는 800×480 설계 캔버스 단위다. 15.8형에서는 2.05배(가장자리 여백 좌우 140·위아래 48px은 §4 결정대로 그대로).

| 토큰 | 값(캔버스) | 1920×1080 | 규격 |
|---|---|---|---|
| `KioskType.key` / `status` / `body` / `caption` | 40 / 30 / 21 / 17 | 82 / 61.5 / 43 / 35px | 80~96 / 56~64 / 40~44 / 32~36 |
| `KioskSizes.stopWidth`×`stopHeight` | 272×96 | 약 558×197px | 560×200 |
| `stopRight` / `stopBottom` | 20 / 12 | 화면 끝에서 약 181 / 73px | 64 이상 |
| `stopGap` | 28 | 57px | 옆 48px 안 다른 조작 없음 |
| `bandHeight` | 40 | 82px | 48~88 |
| `primaryButton` / `secondaryButton` | 72 / 52 | 148 / 107px | 144~152 / 96~112 |
| `resultIcon` / `resultMaxWidth` | 88 / 660 | 180 / 1,353px | 200 / 1,100~1,400 |
| `KioskColors.practice` | `#2BB3A6` 청록 | — | 연습 전용 |
| `KioskColors.panelText` | 흰색 50% | — | 설명 그림 글자 |

공통 위젯: `run_frame.dart`(실행 계열 틀 `KioskRunFrame` · 상태 영역 `KioskStatusHeader` · 정지 단추 `KioskStopButton` · 설명 그림
`KioskPanelPicture`), `status_band.dart`(상태 띠 `KioskStatusBand`), `kiosk_text.dart`(어절 단위 줄바꿈 `KioskText`).
`practice_band.dart`는 문장 상수만 남겼다(앰버 띠 위젯은 상태 띠의 청록 연습 칸으로 바뀜).

## 화면별 변경

| 화면 | 전 | 후 |
|---|---|---|
| 실행 | 정지 폭 약 550px·흰 테두리·■, 오른쪽 300 칸. '시작' 52·상태 32. 연습은 앰버 띠 | 위 띠 '실행 중'(중립)/청록 연습 띠. 왼쪽 위 상태 아이콘+제목(30), 그 아래 가전·목적·'시작'(40)·진행. 정지는 세 화면 공통 자리 |
| 정지 대기 | 정지 폭 약 690px·테두리 없음·◉, 제목 26, 정지 결과 줄(33)이 정지 단추 바로 위 | 위 띠 '정지 대기'(중립)/연습 청록. 정지 단추 공통(■·흰 테두리·같은 자리). 정지 결과 줄('멈추라고 보냈어요' 등)은 상태 영역 바로 아래 첫 블록(30). 설명 줄 21 |
| 정지 미확인 | 앰버 제목·앰버 지시문(오른쪽 아래)·빨강 단추가 서로 다툼, 시선이 좌상→우하 | 앰버 띠 '확인 필요' + 상태 '? 멈췄는지 확인하지 못했어요' → 바로 아래 할 일 "지금 {가전}의 '{취소}' 버튼을 직접 눌러 주세요"(30, 흰 굵은 글자, 앰버 아이콘) → 작게 '작은 팔이 정지 버튼을 대신 눌렀어요'·'작은 팔이 제자리로 돌아갔어요' → '처음 화면으로'(테두리 보조). 단추 '다시 정지 시도'는 자리·크기 그대로 |
| 장치 문제·비상 버튼 걸림(정지 대기) | 제목 색만 | 빨강 띠('장치 문제' / '정지 대기') + 상태 아이콘 |
| 제안 | 띠 없음, 질문 36, 단추 글자 26, '근거 전체 보기' 글자 단추 | 위 띠 '제안'(중립), 질문 40, 단추 글자 30, '이번엔 안 할게요'는 테두리 보조 모양(높이는 72 그대로), '근거 전체 보기'는 작은 테두리 단추 |
| 결과 성공 | 아이콘 72, 제목 36, 아래 글 26, '처음 화면으로' 테두리 | 띠 '결과'(중립)/연습 청록, 아이콘 88, 제목 40(폭 660·2줄 허용), 할 일 줄 30, 자동 복귀 안내 옆에 **앰버 채움** '처음 화면으로' |
| 결과 실패·사용자 정지 | 처음 화면으로(채움, 사용자 정지만 회색 채움) · 다시 시도(테두리) · 화면으로 조작하기(글자) | 빨강 '실패'(서버 무응답은 '확인 불가')·앰버 '확인 필요' 띠. **처음 화면으로는 늘 앰버 채움**, 다시 시도·화면으로 조작하기는 테두리 보조(높이 52) |
| 버튼판 그림(실행·정지 대기) | 실행은 선 칸·채움 칸, 정지 대기는 선 칸·빨강 테두리 '취소'·앰버 테두리 작은 팔 | 같은 위젯: 카드·칸 테두리 없음, 어두운 평면, 글자 50% 회색, 지금 누르는(작은 팔이 기다리는) 칸만 앰버 채움. 안내 글은 3줄까지 |
| 평소 | 동작 중 가전 앰버 아이콘·앰버 면·앰버 호, 제안 쉬는 중 칩 앰버 채움, 비 예보·안내 아이콘 앰버 | 중립(흰 아이콘·회색 면·흰 호, 회색 칩), 앰버는 '확인 필요'에만. 일반 상태 띠 없음 |
| 수동 조작 | 뒤로 ‹(arrow_back_ios_new) | ←(가전 선택 화면과 같은 아이콘) |
| 비상 버튼 띠 | 모든 화면(10/15) | 그대로 — 시험으로 모든 화면(평소·설정·제안·실행·결과·수동 조작·정지 대기)에서 다시 확인 |

- **줄바꿈:** 한글이 글자마다 줄을 바꿔 "멈/췄는지", "주세/요", "요)."가 생겼다. `KioskText`가 그리는 글에만 U+2060(보이지 않는 단어 잇기)을
  낱말 안에 넣고, 화면 읽기(`TextSpan.semanticsLabel`)·글 찾기는 원문으로 둔다. 문단 끝 한 글자 낱말('중')은 줄 바꾸지 않는 띄어쓰기로 앞 낱말에 묶는다.
  적용: 상태 제목, 정지 대기 줄, 결과 제목·할 일·설명, 실행 목적, 버튼판 안내, 제안 질문·근거·'이번엔 안 할게요', 평소 안내 카드.
- **문구:** 바꾸지 않았다. 정지 미확인만 문구 개선 계획의 한 문장('작은 팔이 대신 눌렀지만 멈췄는지 확인하지 못했어요')을 상태 제목
  '멈췄는지 확인하지 못했어요'와 아래 작은 줄 '작은 팔이 정지 버튼을 대신 눌렀어요'(연습: '연습으로 정지 버튼을 짚었어요')로 나눠 배치했다
  (규격 §1-2 "상태 설명은 그 아래 작게"). 음성 안내 문장은 그대로다. 띠의 짧은 이름(제안·실행 중·정지 대기·정지 대기 끝·결과·확인 필요·
  실패·확인 불가·장치 문제·정지 요청 실패)은 새로 붙인 범주 이름이다.

## 시험

- **새 시험:** `test/kiosk_design_test.dart` 66건, `test/kiosk_text_test.dart` 3건.
  - 정지: 실행·정지 대기·정지 미확인(+연습 둘)의 정지 영역이 같은 사각형·같은 아이콘(■)·같은 테두리, 1920×1080에서 폭 520~600·높이
    180~220·오른쪽·아래 여백 64 이상, '정지'와 '다시 정지 시도' 글자 크기 같음. 평소·제안·결과 성공/실패·수동 조작·가전 선택에는 정지 없음.
  - 연습: 실행·정지 대기·결과·정지 미확인·결과 실패(연습)에 청록 아이콘+연습 아이콘+'연습 중', 앰버 글자 아님. 실제 실행엔 없음.
  - 상태 띠: 14가지 상태별 색(아이콘 색상 hue로 판정), 띠 면 불투명도 0.4 이하(채운 단추처럼 보이지 않게), 제안·실행·정지 대기·정지
    미확인·결과 성공/실패에서 같은 위치·높이(48~88px), 실행 계열 상태 영역이 같은 왼쪽 위 자리, 평소·수동 조작·가전 선택에는 띠 없음.
  - 결과 단추: 성공·실패·사용자 정지 모두 '처음 화면으로' = 앰버 채움 단추 하나, 글자만 있는 단추 없음, 다시 시도·화면으로 조작하기 = 테두리.
  - 비상 버튼 띠: `KioskScreen`으로 평소·설정·제안·실행·결과·수동 조작·정지 대기에서 띠가 보이고 가려지지 않음, 정지 단추도 닿음.
  - 어절 단위 줄바꿈: 맑은 고딕으로 7개 화면 × (1920×1080·800×480) × (1.0·1.22배) — 여러 줄 한글 문장의 둘째 줄부터 줄 머리 앞이 띄어쓰기인지.
- **실패 확인(수정 전 코드):** `git stash` 없이 `lib`를 저장소 밖에 복사해 두고 `HEAD` 판으로 되돌린 뒤 새 시험을 돌렸다(그 뒤 복사본으로 복원, 차이 없음 확인).
  `kiosk_design_test` 66건 중 **43건 실패·23건 통과**.
  - 실패: 정지 영역 2(공통 자리·글자 크기 — 공통 정지 영역이 없음), 연습 5(앰버), 상태 띠 16(띠 없음), 결과 단추 4(성공은 테두리·사용자 정지는
    회색 채움·'화면으로 조작하기'는 글자 단추), 줄바꿈 16(예: "작은 팔이 대신 눌렀지만 멈/췄는지", "주세/요", "(…있어/요).", "확인하는 중"의 '는/중').
  - 통과(이미 맞던 결정 — 유지 확인용): 비상 띠 모든 화면 1(10/15에 이미 고침), 정지 없는 화면 6, 연습 띠 없는 실제 실행 1, 띠 없는 화면 3,
    줄바꿈 12(결과 성공 4·제안 4 등 그 조건에서 원래 낱말 가운데서 안 끊기던 것).
  - `kiosk_text_test` 3건은 새 도우미 시험이라 수정 전 코드에서는 컴파일되지 않는다(실패 확인 대신 위 줄바꿈 16건이 같은 결함을 본다).
- **바뀐 규격으로 고친 기존 시험:** 결과 제목 글자 크기 36 → `KioskType.key`, '화면으로 조작하기' `TextButton` → `OutlinedButton`,
  버튼판 다른 칸 '투명' → '테두리 없음·어두운 평면·50% 회색 글자', 지금 칸 = 앰버, 정지 미확인 제목 문장, 제안 '근거 전체 보기'를 누르기 전
  스크롤(띠 때문에 800×480·시험 글꼴에서 왼쪽 칸 아래로 내려감), B9 시험에 서버 상세 한 줄을 더해 계속 '넘치는 경우'를 본다(본문 21로 안 넘치게 됐다).
- **수(골든 제외):** 키오스크 400 → **469** 모두 통과(`flutter test --exclude-tags screenshot`).
- **골든(따로):** 52 → **55장**(새로 `kiosk15_executing_practice`·`kiosk15_hold_estop`·`kiosk15_done_failed_practice`). 43장 다시 찍음, 그대로 9장
  (`appliance_select`·`dnd_large`·`idle_disconnected`·`idle_empty`·`kiosk15_appliance_select`·`kiosk15_danger`·`kiosk15_dnd`·`learning_1.0`·`learning_1.6`
  — 상태 띠·색 역할·정지 단추가 닿지 않는 화면). 다시 찍은 뒤 비교 모드로 55장 통과.
- `flutter analyze`: 오류·경고 0(기존 info 1 — 설정 화면 `activeColor`).
- 저장소 가드·문서 링크 시험 8건 통과 — 커밋 전이라 새 파일을 추적 대상으로 넣은 임시 색인으로 돌렸다(진짜 색인은 건드리지 않음).
  새 파일 없이 돌리면 이 devlog로 가는 링크가 '추적 안 됨'으로 실패한다(커밋 때 함께 넣으면 해결).

## 직접 열어 본 골든

`kiosk15_executing`, `kiosk15_executing_practice`, `kiosk15_hold`(연습), `kiosk15_hold_unconfirmed`, `kiosk15_hold_estop`, `kiosk15_suggestion`,
`kiosk15_done`, `kiosk15_done_failed`, `kiosk15_done_failed_practice`, `kiosk15_done_user_stop`, `kiosk15_idle`, `kiosk15_idle_estop`,
`hold_large`, `executing_large`, `suggestion_long_large`, `done_large`, `done_user_stop_large`, `hold_estop_confirm`, `provenance_running_1.6`.

- 정지 단추는 세 화면에서 같은 자리·크기·■·흰 테두리로 보였다. '다시 정지 시도'는 글자가 단추 폭에 맞춰 조금 줄어 오른쪽 테두리에 가깝다.
- 띠: 중립 회색·청록 연습·앰버 확인 필요·빨강 실패가 한눈에 갈린다. 연습 결과 실패는 빨강 띠 안에 청록 연습 칸이 함께 보인다.
  비상 버튼 걸림 정지 대기는 위 비상 띠(진한 빨강) + 상태 띠(옅은 빨강 '정지 대기') + 제목이 쌓여 위쪽이 무겁다.
- 줄바꿈: "멈/췄는지", "주세/요", "요)." 같은 낱말 가운데 끊김이 사라졌다(보이지 않는 문자가 네모로 찍히지 않음).
- **아쉬운 점(남김):** 큰 글씨(1.22배, 800×480) `suggestion_long_large`는 질문이 스크롤 아래로 이어지고(막대 보임), `done_user_stop_large`는
  단추가 두 줄이 되어 할 일 줄이 스크롤 아래에 걸린다, `hold_estop_confirm`(800×480)은 버튼판 그림이 아주 작아진다 — 규격 §3 순서 3
  '큰 글자 1열 배치'에서 고칠 것. 15.8형 보통 글씨 골든에서는 잘림이 없었다. 평소 화면의 비 예보 아이콘이 흰색이 되어 강조가 약해졌다
  (물방울 모양·굵은 % 글자로만 구분).

## 남은 것

1. 규격 §3 순서 3 — 큰 글자 1열 배치(§1-8). 이번 범위 밖(위 큰 글씨 골든 세 장이 근거).
2. 수동 조작 '시작'만 앰버 테두리(§1-6 뒷부분), `learning` 창 공통 팔레트·평소 가전 행 카드(§1-7) — 하지 않았다.
3. 실패널 1.5 m·3 m 사진(조명 반사 포함)으로 토큰 값 조정 — 학교 RPi5 배포 때. 키오스크 ipk 다시 만들어 설치 필요.
4. 같은 평가 재요청 — 세 질문("지금 뭐가 움직여 / 멈춘 건 뭐야 / 이제 뭘 해야 해")과 3초 상태 구분으로 기록. 보낼 골든은 계획 §5 목록.
