Seongwonp/Simplelay/docs/devlog/devlog_2026-10-16-kiosk-large.md

# 2026-10-16 키오스크 큰 글자 1열 배치 (디자인 규격 순서 3)

근거: [키오스크 디자인 규격 계획](../archive/키오스크-디자인-규격-계획-2026-10-15.md) §1-8·§4 결정, 구현 기록 §5-1. 앞 단계는
[디자인 규격 1·2단계 devlog](devlog_2026-10-16-kiosk-design.md). 작업 브랜치 `feat/kiosk-large`(별도 작업 트리, main `eee9933`에서).
**검증 수준: 골든·위젯 시험까지. 실패널(15.8형)에는 설치하지 않았다.** 동작·서버 규약·문구는 바꾸지 않았다.

## 결정 그대로

큰 글씨(1.22배)에서는 가로 2열 배치를 세로 1열로 바꾼다 — 문장을 한 줄에 억지로 넣지 않고 글은 여러 줄로 둔다. 정지 단추는 같은 자리·크기.
판정은 `KioskLayout.isLarge`(`lib/theme/kiosk_tokens.dart`, 평소 화면 `idle_view`와 같은 기준: 글자 배율 1.05배 초과).

## 화면별 변경

| 화면 | 전 | 후 |
|---|---|---|
| 실행·정지 대기·정지 미확인(`run_frame.dart`) | 큰 글씨에서도 왼쪽 글 칸(약 444) + 오른쪽 그림·정지 칸, 그림 안내 글이 3줄로 늘어남 | 상태 영역·할 일이 폭 전체(약 744). 버튼판 그림은 정지 단추 왼쪽 한 줄(높이 96) — 작은 칸 그림 + 옆 안내 글. 정지 단추 자리·크기 그대로 |
| 제안(`suggestion_view.dart`) | 질문(왼쪽 5/9) \| 순서(오른쪽 4/9), 긴 질문이 왼쪽 칸 스크롤 아래로 | 질문이 폭 전체로 여러 줄, 그 아래 같은 스크롤에 '작은 팔이 누를 순서'·순서(번호를 붙여 옆으로 흘림) |
| 결과(`done_view.dart`) | 결과 원 88, 단추 세 개가 두 줄로 접혀 할 일 줄을 스크롤 아래로 밀어냄 | 결과 원 56, 보조 단추(다시 시도·화면으로 조작하기)는 할 일 아래 같은 흐름, '처음 화면으로'(앰버 채움)만 아래 고정 |
| 비상 버튼 띠 아래 상태 띠(`status_band.dart`·`estop_banner.dart`) | 진한 빨강 비상 띠 + 높이 40 상태 띠 + 상태 제목이 쌓여 위가 무거움 | 비상 띠가 있으면(`KioskEstopScope`) 상태 띠를 26으로 얇게, 글자 보조 크기 — 비상 띠는 그대로, 상태 띠의 아이콘·색·글자도 그대로(보통·큰 글씨 모두) |
| 버튼판 그림 높이가 낮을 때 | 높이 110 이상이면 안내 글 2줄 + 칸 → 비상 버튼 풀기 안내 중 칸 높이 약 20 | 높이 200 미만이면 안내 글을 접고 칸에 자리 — `hold_estop_confirm` 칸 약 30 |
| 정지 단추 '다시 정지 시도' | ■+글을 한 줄로 줄여 넣어(FittedBox) 글·아이콘이 작아지고 오른쪽 테두리에 붙음 | 같은 아이콘 크기·같은 글자 크기로 ■ 옆에 어절 두 줄('다시 정지 / 시도'), 안쪽 여백 18. 단추 크기 그대로 |

`KioskText`에 `textWidthBasis`를 더했다(여러 줄 글을 아이콘 옆에 붙여 가운데 둘 때).

## 시험

- **새 시험:** `test/kiosk_large_layout_test.dart` 22건(맑은 고딕으로 잼, 없으면 건너뜀).
  - 실행·정지 대기·정지 미확인 × 800×480·1920×1080: 큰 글씨면 상태 영역이 정지 칸 왼쪽 끝을 넘어 이어지고(1열) 버튼판 그림은 정지 단추와
    같은 줄·왼쪽(6), 보통 글씨는 지금처럼 2열(6), 정지 단추가 세 화면 × 두 배율에서 같은 사각형(1).
  - 긴 제안: 질문·시작·이번엔 안 할게요가 스크롤 없이 보이고 순서가 남는다(2). 사용자 정지(멈췄는지 모름): 할 일 줄·처음 화면으로가 스크롤
    없이 보이고 다시 시도·화면으로 조작하기가 있다(2).
  - 비상 버튼 띠: 상태 띠가 보통 높이의 0.8배 미만, 비상 띠 바로 아래, 비상 띠는 닿고, 띠의 '정지 대기' 글·아이콘이 남는다(2). 풀기 안내 중
    지금 칸 높이 28 이상(1).
  - '다시 정지 시도': 1.0·1.22배에서 ■ 크기가 '정지'와 같고 글이 단추 좌우 끝에서 32px 이상 떨어진다(2).
- **실패 확인(수정 전 코드):** `git stash` 없이 `lib`를 저장소 밖에 복사해 두고 `HEAD` 판으로 되돌린 뒤 새 시험을 돌렸다(그 뒤 복사본으로 복원,
  `diff -r` 차이 없음). **22건 중 15건 실패·7건 통과.** 실패: 1열 6, 제안 2, 결과 2, 얇은 띠 2, 풀기 안내 칸 1, '다시 정지 시도' 2.
  통과(유지 확인용): 보통 글씨 2열 6, 정지 단추 같은 자리 1(정지 단추는 원래 오른쪽·아래 기준이라 큰 글씨에서도 같았다).
- **고친 기존 시험:** `kiosk_phase_test` '저장된 설정 복원'의 `failToManual` — 큰 글씨에서 '화면으로 조작하기'가 할 일 아래 스크롤 흐름에
  있어 `ensureVisible` 뒤 누른다(시험 글꼴은 글자가 넓어 화면 아래로 갔다).
- **수(골든 제외):** 키오스크 469 → **491** 모두 통과(`flutter test --exclude-tags screenshot`).
- **골든(따로):** 55장 그대로(새 장 없음), 20장 다시 찍음 — `done_large`·`done_user_stop_large`·`executing`·`executing_large`·`executing_retry`·
  `hold`·`hold_estop`·`hold_estop_confirm`·`hold_large`·`hold_unconfirmed`·`kiosk15_executing`·`kiosk15_executing_practice`·`kiosk15_hold`·
  `kiosk15_hold_estop`·`kiosk15_hold_unconfirmed`·`provenance_done_1.6`·`provenance_running_1.0`·`provenance_running_1.6`·`suggestion_large`·
  `suggestion_long_large`(보통 글씨 실행 계열은 정지 단추 글 배치가 바뀌어 다시 찍힘). 다시 찍은 뒤 비교 모드로 55장 통과.
- `flutter analyze`: 오류·경고 0(기존 info 1 — 설정 화면 `activeColor`).

## 직접 열어 본 골든

`hold_large`, `executing_large`, `suggestion_large`, `suggestion_long_large`, `done_large`, `done_user_stop_large`, `provenance_running_1.6`,
`hold_estop`, `hold_estop_confirm`, `hold_unconfirmed`, `executing`, `kiosk15_hold_estop`, `kiosk15_hold_unconfirmed`.

- 큰 글씨 실행 계열: 상태 제목·할 일이 한두 줄로 넓게 읽히고, 정지 단추는 보통 글씨와 같은 자리. 줄인 버튼판은 칸 글자가 아주 작지만
  지금 칸(앰버)은 보인다 — 같은 버튼 이름은 할 일 문장이 큰 글자로 말한다.
- `suggestion_long_large`: 질문 세 줄이 다 보인다. `done_user_stop_large`: 제목·가전·할 일·보조 단추·처음 화면으로가 한 화면에 보인다.
- `hold_estop_confirm`·`hold_estop`·`kiosk15_hold_estop`: 상태 띠가 얇아져 위가 가벼워졌고 비상 띠·'정지 대기'·연습 표시는 그대로 보인다.
  풀기 안내 중 버튼판 칸이 커졌다(대신 그림 위 안내 글은 접힘).
- '다시 정지 시도'는 ■ 옆 두 줄('다시 정지 / 시도')로 테두리에서 떨어졌다. 두 줄의 길이가 고르지 않다(어절 단위 줄바꿈 그대로).
- **아쉬운 점(남김):** `executing_large`는 진행 막대가, `suggestion_large`는 '작은 팔이 누를 순서' 제목이 스크롤 경계에 걸려 반쯤 보인다(막대가
  더 있음을 알린다). 상태 띠의 얇은 모양은 비상 띠가 있을 때만이라 §4 '모든 화면 같은 높이'의 예외다.

## 남은 것

1. 실패널 1.5 m·3 m 사진으로 큰 글씨 화면도 확인 — 키오스크 ipk 다시 만들어 설치 필요(1·2단계와 함께).
2. 큰 글씨 결과 실패에서 글이 길면 보조 단추가 스크롤 아래로 갈 수 있다 — 실패널 글꼴로 확인.
3. 수동 조작 '시작'만 앰버 테두리, `learning` 창 공통 팔레트, 평소 가전 행 카드(§1-6·§1-7) — 이번에도 하지 않았다.
