Seongwonp/Simplelay/docs/devlog/devlog_2026-10-18-professor-ui.md

# 2026-10-18 밤샘 — 교수 의견 대응 UI 개편과 반복 평가

## 0. 계기

10/17 밤 지도교수 의견은 네 가지였다. UI 구조가 별로이고, AI가 만든 느낌이 강하고, 디자인이 부족하고, 말투가 엔지니어 설명 같다는 것이다("전문용어 모르는 사람은 어떻게 하냐").
계획은 [UI 개편안](../archive/UI-개편안-2026-10-17.md)에 적었다. 정한 순서는 쉬운 말 사전 → 말투 규칙 → 구조 → 디자인 토큰이다.

사용자가 정한 것:
- 기기 이름은 **본체**, 누르는 장치는 **작은 팔**, **루틴**은 그대로 둔다.
- 범위는 말투·구조·디자인 전부다.
- 고치고 다시 평가받는 일을 90점이 될 때까지 되풀이한다.

## 1. 평가 방법

- 교수 기준 100점: 쉬운 말 20, 말투 15, 구조 20, 디자인 20, 접근성 10, 안전·정직 15.
- 매 차수 새 평가자가 캡처만 보고 냉정하게 채점했다. 캡처는 실제 폰(에뮬레이터), 폰 골든, 실제 15.8형 패널, 키오스크 골든이다.
- 점수는 평가자 한 명의 판단이다. 외부 심사 점수가 아니다.

| 차수 | 폰 | 키오스크 | 종합 | 이번 차수 핵심 수리 |
|---|---|---|---|---|
| 출발 | 54 | 63 | 58 | — |
| 2 | 63 | 70 | 66 | 쉬운 말 사전 적용(서버·폰·키오스크), 토큰·아이콘 하나로, 행마다 버튼 하나 |
| 3 | 74 | 79 | 76 | 홈 재구성, 탭 넷(홈·루틴·기록·설정), 키오스크 상태 칩 하나 + 큰 타일 |
| 4 | 79 | 80 | 79 | 줄바꿈 사고 없애기, 개발자 시점 문장 걷어내기, '전기 플러그' |
| 5 | 80 | 82 | 81 | 기록 배지 넷, 가전 타일 상태 띠·가전별 아이콘, 같은 말 두 번 없애기 |
| 6 | 83 | 83 | 83 | 키오스크 타일 상태 띠, '자리 확인'·'가전 다시 불러오기', 대비 강화 |
| 7 | 86 | 88 | 87 | '지금 하기' 자리 통일, 띠 문장형, 누를 순서 표시, 연결 끊김 때 '모두 정상' 안 나오게 |
| 8 | 87.5 | 89.5 | 88.5 | 정지 결과 두 제목, 루틴 줄 ⋮ 없앰, 시각 오전/오후 통일, '즉석밥 데우기, 지금 할까요?' |
| **9** | **89** | **91** | **90.0** | 목표 도달 — 여기서 멈춤 |

9차는 보드 전원을 끈 뒤라 8차 수리분을 골든으로만 봤다(실제 폰·패널 캡처는 8차 수리 전 것). 실기기 재확인은 다음 보드 날.

## 2. 찾아서 고친 실제 결함

UI 평가 중에 잡은 것이다. 문구 결함이 아니라 동작 결함이다.

- **키오스크 상태 칩:** 본체 연결 상태를 보지 않았다. 그래서 본체에 닿지 않아도 지난번 연결 목록대로 '모두 정상'이 나올 수 있었다. 이제 칩·연결 목록 창·연결 창이 같은 표시용 목록을 쓴다(`1c4258e`).
- **폰 시각:** 에뮬레이터 시간대가 UTC라 루틴 시각이 9시간 밀려 보였다. 본체 시각 기준(`hubWallClock`)으로 고쳤다(`63d317a`). 평가 캡처용 에뮬레이터는 한국 시간대로 맞췄다.
- **키오스크 결과 화면 정지 제목:** 정지 확인 기한이 지나 `stop_level=sent`로 확정된 것을 결과 화면이 '멈추는 중이에요'로 그렸다(끝났는데 진행 중처럼 보임). 결과 화면 제목은 '작은 팔이 멈췄어요'(verified)와 '작은 팔이 멈췄는지 몰라요'(그 밖) 둘로만 쓴다. 보고를 기다리는 동안(최대 약 5초)만 '멈추는 중이에요'를 띄우고 단추를 숨긴다(`b9b1e83`).
- **시험:** 조용한 시간 복원 시험이 01:00~01:30 고정이라 그 시각에 돌리면 깨졌다. 12시간 뒤 시간대를 쓰도록 고쳤다(`c3eca02`).

## 3. 배포

- 실제 패널 키오스크와 에뮬레이터 폰에 7차까지 올렸다. 키오스크는 `1c4258e`, 폰은 `f19f739`다.
- 8차 수리: 10/18 오전 백엔드(RPi5·RPi4, `02db959`, 되돌리기 `simplelay-backend:1018b`)와 폰 APK에 올림. 키오스크는 날씨·LG 가전 실행 화면 작업과 함께 올린다.
- 보드 재부팅 뒤 키오스크가 안 뜬 일(10/18 아침): 끌 때 컨테이너를 `docker stop`으로 멈춰 unless-stopped가 다시 올리지 않았다. 다음부터는 `sync; poweroff`만 한다.
- 키오스크 설치 도구는 터미널(TTY)이 없으면 설치에 실패하고 옛 앱이 그대로 남는다. 7차 첫 캡처에서 이 문제가 나왔다. 설치 응답에 성공 문구가 있는지 꼭 확인한다.
- 5시 10분쯤 RPi4·RPi5를 안전하게 껐다(컨테이너 멈춤 → 디스크 쓰기 → 전원 끄기, ping으로 꺼짐 확인).

## 4. 남은 것

- 9차 평가 남은 감점(다음에 할 것):
  - 폰 홈 전자레인지 칸의 '자리 확인을 했는지 몰라요'와 '준비됐어요'가 어긋난다.
  - 키오스크 연습 대기 화면 문구가 어긋난다.
  - 설정의 '확인 못 했어요'·'연결됐는지 몰라요'에 까닭이 없다.
  - 루틴 편집 '그다음' 줄이 한 글자만 줄바꿈된다.
  - 기록 '봐 주세요'에 까닭 한 줄이 없다.
  - 정지 대기 띠와 제목이 같은 말을 되풀이한다.
  - 큰 글씨 결과 화면 단추 순서가 기본 화면과 다르다.
  - 마침표 규칙이 섞여 있다.
- 시험 수(10/18, 골든 제외): 폰 1,063 · 키오스크 759(골든 폰 61·키오스크 65). 백엔드는 이번 밤 서버 수정 뒤 전체를 다시 돌리지 않았다(바뀐 시험 파일 두 개만 34건 통과).

- 8차 수리의 실제 패널·폰 확인은 보드를 다시 켠 뒤에 한다(지금은 골든·시험 조건만).
- 서버 기록에 루틴 출처 필드가 없다. 그래서 '지금 하기'와 '정해진 시각 카드를 허락함'을 화면에서 가르지 못한다.
- 같은 버튼 두 번 누름(R1)은 화면 안내만 더했다. 재시도 정책 자체는 그대로다.

## 5. 오후 — 사용자 요청 기능과 깐깐한 평가 (10/18 낮)

### 사용자 결정·요청으로 들어간 것

- **처음 화면 개편(키오스크):** 공기 줄은 나쁠 때만, 시계 아래 '자동 루틴 / 오후 10:00 · 이름' 한 줄 + 작은 회색 굵은 '오늘은 건너뛰기'(사용자가 이 모양으로 정함), 지금 날씨는 예보 칸 맨 앞 '지금'. 모두 정상이면 상태 표시를 숨기고 문제 있을 때만 '연결 확인 필요 N'.
- **다음 한 번 건너뛰기(서버+폰+키오스크):** `POST /routines/next/skip`·`/unskip`(`f37d82e5`), 회차 하나만 건너뛰고 기록에 남김, 재시작 뒤 유지. 실제 본체에서 폰으로 건너뛰기→되돌리기 확인(오늘 22:00 회차는 원래대로).
- **LG 가전 실행 화면(키오스크):** 버튼판 대신 '공기청정기를 켜고 있어요' + 기다림 → 결과. 체크는 본체가 상태를 확인했을 때만, 확인 못 하면 '켜 달라고 했어요 / 켜졌는지는 아직 몰라요'(자동으로 닫지 않음 — 사용자 결정). 폰에서 시작한 실행을 키오스크가 이어받아도 같은 화면(실패널에서 공기청정기 실제 켜기로 확인).
- **조용한 시간 어둡게·고대비·지난 일 한 줄·복구 순서 안내(키오스크):** 어둡게는 매일 조용한 시간에만(잠시 쉬기 제외), 실행·정지·결과·제안·비상 화면은 어둡게 하지 않음. 막 짙기 0.5는 추측(실패널 측정 필요).
- **지금 날씨(서버):** `/ambient`에 `now` 칸 — 응답 모델이 걸러 내던 결함을 찾아 고침, 지금 칸과 안내 문장이 같은 '지금'을 쓰게(강수형태 있을 때만 비 아이콘).

### 안전 쪽에서 찾은 것

- 정지 미확인 결과에 '작은 팔로 골라 누르기'가 권해지던 것 → 그 상태에서는 '다시 멈추기'(같은 `/stop`)와 번호 안내. 큰 글씨 포함 모든 조합에서 '다시 멈추기'가 화면 안에 보이는지 시험 고정.
- 작은 팔이 제자리로 돌아간 것이 확인되면(`parked`) 주 안내를 '취소 버튼을 손으로 눌러 주세요'로.

### 운영

- 보드 재부팅 뒤 키오스크가 안 뜬 원인(수동 `docker stop` + unless-stopped) → 재시작 정책 `always`(스크립트·RPi5·RPi4 컨테이너). RPi4는 시스템 영역이 읽기 전용이라 도커 자동 시작을 켤 수 없음 — 재부팅 뒤 `systemctl start docker` 한 줄(런북).
- RPi5 저장 공간 100%(이름 없는 옛 빌드 이미지) → 이름 없는 이미지만 정리, 배포 때마다 정리.
- 키오스크 실행 옵션에 커서 숨김을 넣었지만 패널 화살표는 남음(화면 관리 쪽 흔적으로 추정 — 재부팅 뒤 확인).

### 평가 경과(목표 97, 13차부터 'AI 느낌' 점검, 15차부터 결선 심사 기준으로 더 깐깐하게)

| 차수 | 폰 | 키오스크 | 종합 | 비고 |
|---|---|---|---|---|
| 10 | 89 | 90 | 89.5 | 실기기 최신 |
| 11 | 90 | 91 | 90.5 | |
| 12 | 91 | 92 | 91.5 | |
| 13 | 92.5 | 93 | 92.75 | |
| 14 | 92 | 93.5 | 92.75 | 97 기준·AI 느낌 점검 |
| 15 | 91.5 | 93 | 92.25 | 더 깐깐하게 |
| 16 | 90.5 | 92.5 | 91.5 | |
| 17 | 91 | 93.5 | 92.25 | |

97은 이번 세션에 닿지 못했다. 같은 평가자를 되풀이하면 그 평가자 취향에 맞춰지는 효과가 있어(노트북 세션 검토와 같은 판단), 반복 평가는 17차에서 멈추고 이후 UI는 실패널·실사용자·처음 보는 평가자에서 나온 문제만 고친다([노트북 검토 인계](../archive/인계-2026-10-18-노트북-검토.md) §2).
점수와 별개로 남은 것은 [손볼 점](../archive/UI-남은-손볼점-2026-10-18.md), 하우징은 [하우징 검토](../archive/하우징-검토-2026-10-18.md)(노트북에서 #1~#11 반영 `1e450778`), 상용 허브 화면 조사는 [허브 화면 레퍼런스](../archive/허브-화면-레퍼런스-2026-10-18.md).

### 시험 수(10/18 오후, 골든 제외)

백엔드+rpi4 3,565 · 폰 1,177 · 키오스크 1,046(골든 폰 61·키오스크 76).
