Seongwonp/Simplelay/docs/devlog/devlog_2026-10-19-core-review-loop.md

# devlog 2026-10-19 오후 — 핵심 로직 검토·수리 반복, 발표 준비

**목표(사용자):** 오늘 중요 로직은 완벽하게. 새 기능 없이 다듬기만.
**검토 방법:** AI 도구(Codex)의 읽기 전용 검토와 계획을 바탕으로 별도 로컬·원격 세션에서 수정했다. 통합 세션은 합치기와 보드 배포를 맡았다. 아래 참고 점수·수상 전망은 공식 심사 결과가 아니며, 시험·배포 사실과 구분한다.

- **수리 원칙:** 검토 지적은 모두 고치기 전에 시험으로 재현했다(실패 먼저). 재현되지 않은 것은 건너뛰었다.
- **합치기:** 원격 세션의 수리는 브랜치로 받아 main에 체리픽했다. 브랜치 삭제는 사용자가 마지막에 한다.

## 1. 검토 다섯 바퀴(핵심 로직)

| 바퀴 | 범위 | 고친 것(요약) |
|---|---|---|
| 1 | 실행·정지 경로 | 정지 뒤 LG 가전 명령이 나가던 틈, RPi5가 다시 붙은 뒤 RPi4가 버려진 실행을 계속 누르던 것(실행 순번이 맞는 생존 신호만 인정), 사용 기록 저장 오류가 '연결 끊김'으로 기록되던 것, 정지 뒤 '준비됨'인데 실행이 막히던 것(다음 승인 실행에서 원점 먼저), RPi4가 누르기 전에 거절한 것을 '연결 끊김'으로 알리던 것 |
| 1 | 루틴·제안·등록부 | 승인 카드를 그때의 가전 판·LG 기기에 묶기, 자동 규칙 비교 저장, 루틴이 자기 실행을 기다리기, 시각 회차 예약·되돌리기, 건너뛰기 정리를 시계 점프에 안전하게, 기본 가전 보정 원자 저장, 삭제 뒤 정리 실패 시 500을 내지 않기 |
| 2 | 전체 | 정지 대기 중 늦게 온 'ok'를 거절, 대상 없는 실행의 좌표 정규화, 여러 단계 실행의 정지 결과 공개, LG 결속 경합, 루틴 정지 소유권, CT 표본 끊김을 가열로 세지 않기(끊김 기준 0.5 s는 추측/측정 필요), 자리 확인을 제어권 중재자 안에서 하고 생존 신호를 감시 |
| 3 | 앱 핵심 | 키오스크(승인 중 정지, `/stop` 오류 확인, 두 번 누름), 폰(블루투스 정지, 동기화 중 유실, 덮어쓰기, PUT 판 번호, 시간 초과를 '모름'으로), 루틴 정지를 서버 잠금 안에서 원자적으로 |
| 4 | 응답 유실 | 승인 재요청에 같은 실행 번호를 돌려주기, 실행 시작 실패 시 되돌리기, 앞 안내는 실행 접수 뒤에, `/acks` 저장 실패를 `persisted:false`로 알리기, 폰·키오스크 응답 유실 처리, RPi4 재시작 뒤 원점을 믿지 않기 |
| 5 | 내 실행 찾기 | 선택 필드 `client_request_id`(같은 요청 번호 = 같은 실행, 다시 실행하지 않음), `GET /jobs/by-request/{id}`, `GET /jobs/{job_id}`(최근 64건), 폰·키오스크가 이것으로 자기 실행을 추적(옛 본체는 종전 방식) |

**첫 사용 관점의 과업 경로 검토(AI 도구 사용):** 기기 추가·연결·조용한 시간·음성·자동 실행 허락 문구를 다듬었다. 실제 사용자 시험은 아니다. 아래는 고치지 않았다.

- **새 기능이라 뺀 것:** 화면 읽기로 사진 위 귀퉁이를 고르는 입력, 키오스크에서 여러 버튼을 한 번에 고르는 판. 키오스크에는 대신 '루틴으로 한 번에' 안내를 넣었다.
- **사용자 결정을 따른 것:** '기록 보기'를 열면 본 것으로 치는 동작은 오늘 아침 결정대로 그대로 둔다.

## 2. 실보드

- **배포:** RPi5·RPi4·키오스크·폰을 여러 번 같은 커밋으로 맞췄다. 되돌리기 태그는 `simplelay-backend:1019b`~`1019e`다.
- **점검(모션 모의):** 승인 → RPi4 실행 → 결과까지 정상이다. 실행 중 정지는 확인하지 못했다. 모의 누름이 0.3 s 안에 끝나서 정지가 닿기 전에 실행이 끝난다(하드웨어 필요).
- **주의:** 점검용 `/stop`이 설계대로 자동 실행 규칙을 끈다('비상정지로 자동으로 하기를 껐어요'). 꺼진 공기청정기 시각 규칙 두 개(22:00 켜기·07:00 끄기)는 다시 허용했고, 오늘 밤 건너뛰기는 유지했다. **실보드 점검에서 `/stop`을 쓰면 자동 규칙 상태를 꼭 확인한다.**
- **데이터 정리(사용자 승인):** 연습 세탁기를 env에서 끄고(백업 `env.bak-20261019-remove-practice`), 시험용 TestOven을 지웠다. 지운 세탁기·인터폰에 묶인 루틴 세 개도 지웠다(DB 백업 `simplelay-backup-2026-10-19-before-routine-cleanup.db`).

## 3. 내부 검토의 참고 점수(하드웨어 완성 가정)

| 검토 조건·도구 | 참고 점수 | 당시 수상 전망 추정(공식 결과 아님) |
|---|---|---|
| AI 도구 Claude | 78 | 동상 |
| Codex(GPT-6.1, 사용 금지 전) | 84 | 은상 |
| Codex 5.6 | 85 | 금상 문턱 |
| AI 도구 Codex 5.6, 심사 기준을 참고한 조건 | 82 | 은상 |

- **실제 심사위원 조건:** 10분 시연과 책자만 보고, 함께 쓰는 하드웨어는 깎고, 무대에서 안 보이는 코드 품질은 쳐 주지 않는다.
- **남은 점수:** 대부분 발표(세 가지 주장·증거 한 장·함께 쓴 것 대 새로 만든 것)와 실물 증거에 있다. 그래서 [발표 대본·슬라이드 구성](../발표/결선-발표-대본.md)과 질의응답 답을 만들었다.

## 4. 하드웨어 소식과 결정(사용자)

- **보드 상태:**
  - 모터 문제는 배선 접촉 불량과 헐렁한 모터 고정이었고 둘 다 고쳤다. 펌웨어는 바꾸지 않는다.
  - 솔레노이드를 작업한 뒤 ESP32 모션 보드를 받는다. 그날 할 일은 [하드웨어 복귀 날 절차](../archive/하드웨어-복귀-날-절차.md)를 따른다.
- **부품:** 온습도 모듈(맨 센서는 풀업 저항이 없어 쓸 수 없음), CT, 오디오잭을 주문했다. 하우징은 결선 때만 보인다.
- **CT 일정:** 실제 누름이 먼저다. CT 콘센트 모듈은 10/28 서류·영상에서 빼고, 10/28~11/6에 완성하는 것을 목표로 한다. 전자레인지 전원선은 자르지 않는다. [콘센트 모듈 제작 안내](../콘센트-모듈-제작-안내.md)를 따른다.

## 5. 시험 수(골든 제외)

| 대상 | 통과 | 골든 |
|---|---|---|
| 백엔드+rpi4 | 3,844 | — |
| 폰 | 1,395 | 69 |
| 키오스크 | 1,201 | 83 |

## 6. 남은 결정

- **개발자 모드:** 끄면 내장 전자레인지가 '내 가전' 목록에서 숨는다. 시연 전에 정해야 한다.
- **고지 초안:** AI 개발 도구 사용 고지 초안의 【확인】 항목.
- **비상정지:** 갠트리 모터 전원도 함께 끊을지(HW 담당에게 물을 것).

## 7. 밤 추가분

**검토 6·7바퀴(회귀·시연 위험).** 수리끼리 부딪쳐 생긴 문제를 고쳤다.
- 늦은 응답이 새 실행을 덮던 것, 다시 확인할 때 남의 실행을 잡던 것, 중복 누름 잠금, 페어링 멈춤, 방해 금지 요청 실패를 성공처럼 보이던 것.
- 서버: 승인+자동 허락에도 요청 번호 멱등.
- 7바퀴: 여러 단계 루틴을 첫 구간 끝에서 '완료'로 보이던 것 — `GET /jobs/{root}`가 루틴 전체 수명을 나타내고, `/status`에 `routine_run_id`·`routine_segment`를 싣는다. 폰·키오스크는 중간에 넘겨받아도 루틴 끝까지 '실행 중'. 페어링 키 재수령(`POST /pair/ack`), LG 직접 조작 요청 번호.

**문구(사용자 결정).**
- '잠시 쉬기' → '방해 금지'. 범위 부제는 항상 보이게 하고, 키오스크는 메뉴 한 곳에만 둔다.
- 토스·삼성·KRDS를 조사해 [UX 문구 기준](../UX-문구-기준-2026-10-19.md)을 만들고, 번역투 약 120줄을 고쳤다.
- 상태 표시는 명사형(완료·실패·멈춤·연결됨·끝남), '됐어요'·'못 써요' 같은 줄인 말끝은 쓰지 않는다(R12).
- 키오스크 도움말을 처음 쓰는 어르신 기준으로 다시 썼다.

**마지막 평가(이전 점수 모름).**

| 조건 | Codex | Claude |
|---|---|---|
| 하드웨어 가정 | 84 | 74 |
| 실물 | 60 | 58 |

공통 과제:
- 실물 누름 n≥20
- CT 측정(정상·취소·문 열림 각 3회 이상)
- 사진·영상
- 무대에서 실패 장면 하나('모름'·다시 누르지 않음)
- 책자에 남은 내부 기호 걷어내기(다음 작업)

**정리.**
- 원격 작업 브랜치 16개는 사용자가 삭제했다.
- C 드라이브 임시 폴더를 정리했다(약 1.3 GB). `C:\pt_ah`는 안전 확인 때문에 사용자가 지운다.
- RPi4·RPi5는 `sync; poweroff`로 껐고, 에뮬레이터도 껐다.
- 시험 수(골든 제외): 백엔드+rpi4 3,865 · 폰 1,425 · 키오스크 1,220.
