Seongwonp/Simplelay/docs/devlog/devlog_2026-10-23-domestic-app-ui.md

# 2026-10-23 국내 앱 UI 조사

- 사용자 요청: 공공 지침·논문을 넘어 실제 국내 앱을 조사하고 SimpleLay 사용성을 높일 근거를 찾기.
- 결과: [국내 앱 7개 비교와 적용안](../archive/국내앱-UI-비교와-SimpleLay-적용안-2026-10-23.md). ThinQ·토스·당근·카카오 T·KB스타뱅킹·배달의민족·SmartThings를 비교했다. 확인한 출처 링크를 모두 연결했다.
- 공개 스크린샷·공식 안내를 확인한 범위다. 설치 앱을 직접 사용하거나 사용자 점검을 한 것은 아니다. SmartThings는 설명만 확인한 한계를 별도로 적었다.
- 적용안: 홈의 현재 과업 우선, 루틴 행의 실행/편집 구별, 반복 상태 안내 축소, 키오스크의 연습/실제 문맥 일치. 기존 4탭·팔레트·실행 정책 변경과 새 기능은 제안 범위 밖이다.
- 코드·펌웨어·안전 정책 변경 없음. 문서 조사에는 수정 전 실패 확인 대상인 동작 변경이 없다. 실폰·실패널·TalkBack 미검증.
- 저장소 가드·문서 링크 검사: 8개 통과, 종료 코드 0. 문서만 변경했으므로 Flutter·백엔드 전체 시험은 실행하지 않았다.
