Seongwonp/Simplelay/docs/devlog/devlog_2026-10-23-ui-filming.md

# 촬영 전 폰·키오스크 문구 정리 (2026-10-23)

기준 HEAD: `62d2feb2`. main 작업 폴더에서 수정했다. 구현 중 커밋·push·브랜치·stash는 하지 않았고, 10/23 사용자 후속 승인으로 현재 UI 변경과 평가 기록을 커밋·push 대상으로 확정했다. 보드 미접속·미배포. 실제 이동 범위·좌표 측정은 하드웨어 도착 후 별도로 한다. 펌웨어·안전 제한·정지 처리·재시도 정책·서버 응답 필드는 변경하지 않는다. 서버·실행기의 변경은 안내 문자열이다.

## 읽은 자료와 적용 범위

- [말투 조사](../archive/한국어-UI-말투-조사와-적용안-2026-10-22.md) D1~D3 웹 본문, D4 국립국어원 공개 원문 첫째 마당 8~16쪽을 확인했다. D4 전체 153쪽을 통독한 것은 아니다. 정확한 용어, 모호한 지시 방지, 적절한 정보량을 적용한다.
- P1·P3 KCI 공개 초록과 P2 기존 공개 초록·연구실 소개를 확인했다. P2 KCI 직접 접속 및 P2·P3 발행처 PDF는 접속 실패했다. 논문 전문의 실험 문항·효과 크기는 인용하지 않는다.
- 기존 UX 문구 기준·UI 적용 기준·사용자 편의 체크리스트·제품 레퍼런스 문서를 읽었다. 연결된 공식 접근성·상태 안내·루틴 설명 자료도 확인했다. 동적 페이지로 본문이 반환되지 않은 자료와 상품 갤러리·프로토타입은 사용성 검증 근거로 사용하지 않는다.
- ‘확인하지 못했어요’는 논문에서 도출한 정답이 아니라 사용자가 확정한 말투다. 기존 R6에 현행 기준을 반영하고 과거 표는 이력으로 남겼다.

## 변경

| 항목 | 변경과 유지한 의미 |
|---|---|
| 가전 상세 오늘 기록 | 로딩·조회 실패·정상 빈 목록 분리. 실패에는 48dp 이상 새로 보기. 빈 목록은 실제 미사용이 아닌 ‘오늘 SimpleLay에 남은 기록이 없어요’. |
| 실제 가전 안내 | 정지 미확인·비상정지의 위치 그림에 ‘실제 가전에서 눌러 주세요’. 화면 정지 단추 자리·크기·처리 유지. 그림은 실행 가능한 버튼이 아니다. |
| 미확인 말투 | 폰·키오스크·서버 결과·실행기 안내의 ‘몰라요/몰라서’를 확인하지 못한 대상으로 구체화. 성공·실패·미확인 값은 유지. 음성/화면 읽기에 쓰는 문자열도 같은 기준. |
| 관찰자·의인화 표현 | ‘연습 부탁이 닿았는지’ → ‘연습 요청의 접수 여부를 확인하지 못했어요’. ‘바뀐 걸 봤어요’ 배지 → ‘설정 확인’. 전 값을 모르는 결과를 ‘바꿨어요’로 올리지 않는다. |
| 연결 가전 | ‘LG 가전이라 누를 버튼이 없어요’ → ‘누름 장치 없이 여기서 조작해요’. 실제 제품에 버튼이 없다고 말하지 않는다. |
| 자동 실행 목록 | 허용한 조건에 맞을 때 묻지 않고 실행한다는 안내와, 정해진 시각의 루틴은 ‘내 루틴’에서 바꾼다는 위치 안내. 목록·분류·스위치·API 호출·승인 동작 유지. |

기존에 저장된 기록의 원문은 이 작업으로 일괄 수정하지 않는다. 새 안내와 새 결과 문자열이 적용되며, 배포 전 과거 기록도 별도로 확인해야 한다.

## 수정 전 실패와 시험

- 가전 상세 새 위젯 시험 2건: 로딩/503을 미사용으로 표시하던 기존 코드에서 실패. 상태 분리 후 관련 15건 통과. 새로 보기는 조회만 하며 실행 요청 없음.
- 키오스크 실제 위치 안내 시험 1건: 기존 캡션에서 실패. 그림 안 실행 단추 없음과 별도 화면 정지 호출 유지도 확인.
- 미확인 문구 기존 기대값을 바꿔 먼저 돌린 키오스크 관련 시험에서 5건 실패(새 위치 안내 1건 포함). 구현 후 재확인. 문자열 갱신 시험을 새로운 안전 경합 시험으로 세지 않는다.
- 자동 목록 안내 기대값 2건을 먼저 바꿔 기존 화면에서 실패 확인. 과거 ‘한 문장’·특정 단어·고정 줄끝 검사 중 새 문구와 충돌한 기대만 수정했고, 조건·위치 의미 및 낱말 단위 줄바꿈 검사는 유지했다.
- 백엔드 전체(RPi4 포함): 3,888 통과, 28 건너뜀, 종료 0. 이후 추가한 서버 문구 정리분은 아래 22건 재확인에 포함했다. 전송·재시도 로직은 바꾸지 않았다.
- 최종 비골든 시험: 폰 1,430건, 키오스크 1,227건 통과(각 종료 0). 이후 폰 재시도 설명의 중복을 줄인 변경은 해당 상태 화면 25건을 재실행해 통과했다.
- 저장소 가드·문서 링크 및 추가 문구 관련 루틴 시험 22건 통과, 종료 0.
- 재시도 안내는 제목에서 이미 자리를 맞춰 다시 누른다고 말하므로 보조 줄에는 ‘눌렸는지 확인하지 못했어요.’만 남겼다. 기존 긴 문구에서 새 기대 1건 실패를 확인한 뒤 수정했고, 진행 표시와 문구가 겹치지 않는 골든을 다시 열었다.
- 정적 분석: 폰 error/warning 0, 기존 info 4. 키오스크 error/warning 0, 기존 info 1. ‘진단 0건’이라고 표현하지 않는다.

## 눈으로 확인한 골든과 남은 확인

골든 갱신 시험: 폰 69건, 키오스크 85건 통과. 실제 패널 사진이 아닌 합성 입력의 위젯 렌더다. 말투 변경 후 200%의 미확인 결과·기록 화면과 정지 영역을 확인했다.

직접 연 변경 PNG: 폰 `detail_photo_dark`, `history_dark`, `history_large`, `lt_detail_photo`, `lt_history`, `lt_status_unknown`, `lt_thinq_washer_practice`, `status_unknown_large`, `routines_rules_light`, `lt_status_retrying`; 키오스크 `done_failed`, `done_user_stop_large`, `hold_estop`, `hold_unconfirmed`, `kiosk15_done_check_no`, `kiosk15_done_failed`, `kiosk15_done_user_stop`, `kiosk15_hold_estop`, `kiosk15_hold_unconfirmed`, `kiosk15_idle_past`, `kiosk15_thinq_result_unconfirmed`, `executing_retry`.

- 폰 골든 일부 앱바 제목이 사각형으로 렌더되는 시험 설정 문제를 확인했다. 본문에만 한글 글꼴을 주던 시험 테마에서 앱바 제목에도 같은 글꼴을 지정했다. 제품 테마·실폰 글꼴 동작을 바꾼 것은 아니다. 수정한 폰 골든 45장을 비교용 모음 이미지 4장으로 열어 제목이 읽히는지 확인했다. 실폰 글꼴·실패널 검증은 별도다.
- 긴 문구는 줄 수가 늘었다. 열린 골든에서 정지 영역은 남지만 거리별 가독·사용자 이해를 시험한 것은 아니다.
- 후속 키오스크 점검에서 연습+비상정지의 실제 가전 취소 지시를 수정했다. 아래 후속 절 참고. 실제 비상 버튼의 상태·해제 절차와 버튼 비활성 동작은 그대로다.
- 실폰·TalkBack 실제 낭독·실패널 1~2m 가독·팀 밖 사용자 과업은 미실시. ‘자동 끄기’와 ‘오늘만 건너뛰기’의 사용자 구별도 미검증이다.
- 일요일 촬영 전: 같은 코드 배포, 실제 허브 기록 조회, 모의/실제 결과, 긴 이름·큰 글씨, 하드웨어 보정 후 실제 조작 순서로 확인한다. 이번 UI 수리는 실제 버튼 누름·CT 판정·기구 안전을 검증한 것이 아니다.

## 키오스크 후속 수정 (사용자 승인)

- 정지 요청의 실패 표시는 통신 예외·거절 등 여러 경우를 포함한다. 응답 유실만으로 미전송을 단정하지 않도록 ‘정지가 닿지 않았어요’를 ‘정지 요청 결과를 확인하지 못했어요’로 바꿨다. 실행·대기·결과 화면에 같은 기준을 적용했다. 정지 재요청·직접 확인 안내와 호출 동작은 유지한다.
- 연습 요청 결과는 ‘접수 여부’ 대신 ‘연습 요청이 전달됐는지 확인하지 못했어요’로 풀었다. 전달 또는 성공을 새로 주장하지 않는다.
- 연습 중 비상정지는 ‘연습 중이라 실제 가전은 조작하지 않았어요’라고 표시하고, 실제 가전 취소 칸 강조와 직접 누르라는 캡션을 제거했다. 실제 모드의 취소 안내는 유지한다. 비상정지의 화면 정지 버튼은 기존대로 비활성이고 자리·크기도 유지한다.
- 수정 전: 연습 비상정지·연습 요청 안내의 새 위젯 시험 2건 실패. 기존 결과 화면의 정지 재요청 안내 기대값을 바꾼 시험 1건도 실패했다. 실패 로그를 확인한 뒤 제품 코드를 고쳤다.
- 최종 키오스크 비골든 1,229건·골든 85건 통과(각 종료 0). 분석은 error/warning 0·기존 info 1(종료 1). 저장소 가드·문서 링크 8건 통과(종료 0). 서버·폰·펌웨어는 이번 후속에서 수정하지 않았다.
- 변경된 연습 비상정지 `hold_estop`와 해제 확인 `hold_estop_confirm`, 실제 모드 `kiosk15_hold_estop`를 직접 열어 비교했다. 연습에는 취소 칸 강조가 없고, 실제 모드의 직접 취소 안내와 정지 버튼 비활성은 유지된다. 실패널 미설치.

## 별도 UI 검토와 커밋 전 확인

폰·키오스크를 AI 도구의 별도 세션에서 읽기 전용 검토했다. [UI 검토 상세](../archive/UI-독립평가-2026-10-23.md): 폰 73/100, 키오스크 79/100(내부 주관적 참고값). 실제 사람의 폰 복잡도 지적과 같은 방향의 구조 문제가 나왔으며, 단순히 문구를 고쳐 모두 해결됐다고 주장하지 않는다. 검토에서 새로 찾은 항목은 추가 수정하지 않고 다음 검토 대상으로 남긴다.

커밋 전 골든은 갱신 없이 폰 69건·키오스크 85건 비교 통과(종료 0). 실제 배포·실물 검증은 하지 않았다.

최종 커밋 전 백엔드 전체(RPi4 포함) 재검사: 3,888 통과·28 건너뜀·기존 경고 2, 종료 0. 문구 변경을 포함한 최종 코드에서 다시 실행했다.
