Seongwonp/Simplelay/docs/devlog/devlog_2026-10-26-desktop-empathy.md

# 2026-10-26 (데스크톱, 10/25 밤~) — 용어 통일·사람 감지 자동 시작·온디바이스 LLM 시험·고도화 착수

10/26 인계([인계 2026-10-26](../archive/인계-2026-10-26-모터-매핑-촬영.md)) §4 데스크톱 할 일과, 사용자와 정한 '공감지능 고도화' 방향의 첫날 기록.

## 1. 한 일

| 묶음 | 내용 | 커밋 |
|---|---|---|
| 용어 통일(사용자 승인) | 기능 이름은 '루틴'·'자동 실행' 둘만. 폰 자동 실행 스위치는 루틴마다 하나 + 실제 동작 한 줄. 폰 정지 줄 "다른 곳에서 시작한 동작 진행 중". 누름 장치 없음 문장을 서버·폰·키오스크가 같은 글자로 | `9d078ce7` |
| 사람 감지 부팅 자동 시작 | 재시작 정책 always 컨테이너가 nsenter로 호스트에서 감지 스크립트 실행(시스템 영역 읽기 전용). 실물: 1명 → `present` | `fed1a4db` |
| 키오스크 실패널 점검 | 빌드 환경 Flutter에 없는 속성 때문에 키오스크 빌드가 **조용히 실패**해 옛 판이 올라가 있었다(빌드 도구가 실패에도 0 반환) → 로그·ipk 시각 확인을 배포 절차에 넣음. 휴대폰 연결 화면 글 잘림, 골든 7장 | `c7a105df` `4e7c95a5` |
| 자리 비움 화면 | 까만 화면 → 짙은 회색 시계·날짜(가장자리까지 같은 색, 뒤 화면 Offstage), 안내 글 없음(사용자: 보여 주기식 금지) | `4e7c95a5` `d3b3b792` `bfe91ae4` 외 |
| 인사 | 3시간 넘게 안 보이다 돌아왔을 때만. 문장은 '다녀오셨어요' + 때에 맞는 한마디. 인사 뒤에 날씨 한 줄(특보 안내 → 예보 안내)을 소리로 이어 읽음, 화면 알약은 인사만 | `c65f6ff2` `50e628cf` `1ebc905e` |
| 기상특보 구역 표 | `.gitignore`(data/)에 걸려 배포되지 않았다 → `rpi/services/weather/warn_zones.json` | `e981ca3f` |
| 온디바이스 LLM 자동 시작 | 플랫폼 기기 안 언어 모델 서버를 부팅 때 띄움(`deploy/run_llm.sh`, 루프백 전용) | `a672b245` |

## 2. 온디바이스 LLM 실측(10/25 밤, RPi5, 인터넷 없이)

플랫폼 클라우드 AI 에이전트는 다시 시험해도 LG 사내 클라우드 접속 오류(8초 만에 실패) — 결선 데모에 쓰지 않는다. 대신 플랫폼에 들어 있는 **기기 안 언어 모델 서버**(llama.cpp 방식)에 LG 공개 언어 모델을 올렸다(공개 모델 그대로 — 학습 없음).

| 모델 | 말 알아듣기(정해진 동작 목록에서 번호 고르기) | 문장 만들기 | 속도 |
|---|---|---|---|
| 1.2B(Q4) | 한국어 지시 6개 중 2개 | 반말·엉뚱한 문장 | 3~5초 |
| 2.4B(Q4), 한국어 지시 | 6개 중 5개 | 지어낸 내용 섞임 | 6초 / 30~44초 |
| **2.4B(Q4), 영어 지시 + 동작 설명** | **8개 중 8개**("공기가 텁텁하네"·"방이 너무 답답해" → 공기청정기 켜기, "우유 조금만 데워 줘" → 30초 데우기, "오늘 날씨 어때" → 해당 없음) | 꽤 자연스러우나 영어 단어 섞임 | 6~8초 / 24~33초 |

결론: **말 알아듣기는 실전에 쓴다**(정해진 목록 중 하나만, 실행은 늘 사람 '네'). 문장 만들기는 실시간에 쓰지 않고 밤사이 미리 만들어 검사(영어·기록에 없는 숫자면 버림)한 것만 보인다. 표본 8~11개 — 정확도는 측정 필요.

## 3. 방 밝기(자동 다크 모드 준비)

같은 웹캠 영상을 둘로 나눠 16×12 흑백 한 장만 덮어써(얼굴을 알아볼 수 없는 크기) 평균 밝기를 잰다. 실측(1회): 불 켬 130~170, 불 끔(모니터 빛 있음) 100~120 — 카메라 자동 노출이 차이를 줄인다. 30초 평균 + 기준선 두 개(115/135)안, 웹캠이 모니터를 등지게 두면 차이가 커진다. 값은 추측/측정 필요. 기본값 '자동'으로 설정 3단(밝게/어둡게/자동)은 아직 미구현.

## 4. 사용자 결정(10/26)

- 프로젝트 목적 재확인: **LG 공감지능 — 사용자를 이해해 일상을 자동화**. 하드웨어는 옛 가전을 이 흐름에 넣는 수단. 화면·말은 실제 제품처럼(보여 주기식 금지).
- 하우징은 만들지 않는다 — 케이스형 거치대 뒤에 RPi5·온습도 센서·웹캠.
- 자동 다크 모드는 해 지는 시각이 아니라 **실제 방 밝기(웹캠)**로(집 안은 밤에도 불을 켠다).

## 5. 별도 작업 폴더에서 진행 중 (AI 도구 사용)

1. 말 알아듣기: `POST /intent/understand` + 폰 '생각하고 있어요…' → 확인 '아니요/네'(브랜치 `codex-llm-intent`).
2. 습관 판단 개선: 고정 시간대 대신 시각이 가까운 것끼리 묶기(45분, 자정 넘김), 퍼짐(30분 이내면 '오후 10시쯤', 아니면 '이맘때'), 거절 두 번이면 3일 쉼, 실제 승인 시각 쪽으로 ±30분 옮김(브랜치 `codex-habit`).
결과는 검토·수정 뒤 main에 합친다. 남은 순서: 키오스크 말 알아듣기, 밤사이 생활 요약('알게 된 것' 화면), 자동 다크 모드, 사람 감지 시험값 되돌리기.

## 6. 밤사이 구현·검토·배포(10/26 새벽, AI 도구의 별도 세션 사용)

| 묶음 | 내용 | 커밋 |
|---|---|---|
| 습관 판단 | 시각이 45분 안으로 가까운 것끼리 묶기(자정 넘김), 퍼짐 30분 이내면 '오후 10시쯤', 아니면 '이맘때', 두 번 연속 거절 → 3일 쉼, 실제 승인 시각 쪽으로 ±30분 | `a07cac08` |
| 말 알아듣기 | `POST /intent/understand` — 정해진 동작 목록 중 하나만 고르고 실행하지 않음, 폰 '생각하고 있어요…' → '아니요/네'. 지시문을 짧은 영어 한 줄로 줄여 보드 실측 16~17초 → 8~12초, 질문 '공기청정기를 켤까요?' | `5d440ec6` `cbd52103` |
| 폰 말로 하기 | 아래 탭 이동, 생각하는 동안 한 상태만, '아니요 \| 네' 나란히, 홈에서 열면 가전을 정하지 않음 | `f074a0c9` |
| 알게 된 것 | 습관별 평소 시각·근거·상태(자동 실행 중·숨김·잠시 묻지 않음·물어보는 중), 숨기기/다시 보이기. 밤 3시 본체 안 언어 모델이 생활 요약 두 문장 — 검사(영문 금지·기록에 없는 숫자 금지·120자) 통과만, 아니면 고정 틀. 요청 경로는 저장된 글만 읽음 | `6029080e` `410c4277` `ca3b5a9d` |
| 방 밝기 · 자동 화면 | 웹캠 16×12 흑백 한 장 30초 평균, 기준선 115/135. 키오스크 설정 '밝게/어둡게/자동'(기본 자동). 실측: 불 끈 방 **4**, 모니터 빛만 100~120, 불 켬 130~170 | `7c8af943` 외 |
| 폰 음성 → 키오스크 카드 | 알아들은 제안을 60초 동안 함께 보여 줌, 먼저 '네/아니요'를 정한 쪽만(서버는 실행하지 않음) | `7c8af943` 외 |

배포: RPi5 백엔드(env `SIMPLELAY_LLM_URL`·`SIMPLELAY_ROOM_LIGHT_FILE` 추가, 백업 `env.bak-20261026-llm`·`-light`), 키오스크(빌드 로그 확인), 폰 에뮬레이터. RPi5 공간: 안 쓰는 1.2B 모델·옛 이미지 정리(빌드가 공간 부족으로 한 번 실패).
Codex 샌드박스: Windows 격리 실행은 0.164.0에서 됨, 네트워크는 `-c sandbox_workspace_write.network_access=true`. 백그라운드 실행은 표준 입력을 닫아야 한다(`< /dev/null`, 안 그러면 입력을 기다리며 멈춤).

**사용자 확인 필요:** 사람 감지 시험값(5·10·30초) 되돌릴지, 폰 문구 '본체 화면에서 이미 정했어요'(폰에서 '키오스크' 낱말 금지), 키오스크 '네'가 네트워크 실패면 아무것도 실행하지 않음(중복 실행 방지 쪽).
**남은 고도화:** 3번 여러 신호를 엮은 제안(습도·공기질·날씨·사람), 연달아 하는 일 묶기, LG 앱 직접 조작 반영. RPi4는 꺼 둠(다음 배포 때 같은 이미지).

## 7. 여러 신호 제안(배포) · 심사위원 관점 평가(10/26 아침)

- **여러 신호 제안** `fdd208ee`: 불 끄면 수면 모드(사람 있음·방 어두워짐 2분+·21~02시·공기청정기 켜짐·수면 아님), 돌아왔을 때 공기(3시간+ 귀가 10분 안·공기청정기 꺼짐·실내 공기 보통 이하 또는 황사 특보), 황사 특보 대비(특보가 새로 나고 사람 있음). 카드 이유에 쓴 신호만 적고 늘 사람 확인. 시험 4,162 통과, RPi5 배포. 실물 미확인. 남은 질문: 보통 등급에서도 켤지(기존 켜기 카드는 나쁨), 다른 카드가 떠 있으면 막을지, 허브 재시작 때 이미 걸린 황사 특보를 새 것으로 볼지.
- **평가 에이전트(심사위원 관점, 코드·문서 읽기만): 68/100** — 책임 22/25, 조율 17/25, 생활 15/25, 실물 증거 14/25.
  - 공격받을 곳: ① 습관 = 같은 시각 세 번(타이머와 무엇이 다른가 — `day_kind`가 표시만 하고 묻는 때에 안 쓰임), ② 누구의 습관인가(사람 구분 없음), ③ 공기청정기 하나만 이해, ④ 거절 한 번은 아무 변화 없음·이유를 모름('이미 했어요' 없음), ⑤ 언어 모델 표본 8문장·8~12초.
  - 추천(10일, 학습 없음): ① 카드마다 '왜 지금' 신호 칩(S) ② 거절 이유 세 갈래 — 지금은 아니에요/이미 했어요/이제 묻지 마세요(S~M) ③ 평일/주말을 묻는 때에 반영 + "평일만인가요?" 한 번 확인(S) ④ LG 앱으로 바꾼 상태 변화도 직접 사용으로 기록(M) ⑤ 두 번째 기기·연달아 하는 일 묶기(M).
  - 과장 위험(발표 자료에서 고칠 것): '거절하면 물러선다'(연속 두 번일 때만), '열 안 나는 물리 가전 맡기기'(미구현), '8개 중 8개'(시험 8문장이라고), 밝기 기준값(1회 측정), README 습관 제안 '모의(합성 이력)'와 발표의 '실제 학습' 맞추기, 평일 구분 주장 금지, 귀가 제안은 '공기청정기 귀가 제안'으로.
