Seongwonp/Simplelay/docs/devlog/devlog_2026-11-03-ct-repeat-deck.md

# 2026-11-03 — CT 반복 측정·실제 기록 확인·발표 웹 슬라이드

## 1. CT 가열 종료 판정 반복 (실물)

사람이 전자레인지를 손으로 1분씩 돌리고, 허브 사용 기록(`usage_log`, `source=observed_power`)에 남은 판정 작동 시간을 읽었다.

| 시각 | 판정 작동 시간 (설정 60초) |
|---|---|
| 11/2 14:49 | 60.7초 |
| 11/3 14:13 | 60.7초 |
| 11/3 14:16 | 60.6초 |
| 11/3 14:18 | 60.6초 |

- 1분 가열 4회 시험에서 4회 모두 판정했다. 판정 작동 시간은 60.6~60.7초다.
- 판정 기준: 100 W 이상 5초 유지 → 작동, 15 W 이하 3초 → 가열 종료(`rpi/verifier/cycle_end.py`).
- 전력은 220 V 가정 추정치이고 전력계와 대조하지 않았다. '가열 종료'까지만 판정하며 조리 완료를 뜻하지 않는다.
- 11/2 측정에서 시작 순간 센서 출력은 약 2,300 mV(약 3,550 W 순간 추정, 돌입 전류)였다. 클램프가 돌아가 있던 측정은 제외했다.
- 이 시험 동안 모션 ESP32가 빠져 있어 RPi4 env를 모의 모션으로 바꿨다(백업 `env.bak-20261103-no-motion`, `SIMPLELAY_MOTION_MODE=mock`, `SIMPLELAY_MOTION_PORT` 주석). 이 상태에서 키오스크 연결 화면은 누름 장치를 '연결됨'으로 보인다 — 모션 보드가 돌아오면 두 줄을 되돌린다.

## 1-2. 실제 버튼 누름 (팀 확인)

- 폰 앱 개발자 모드에서 보낸 누름 명령(본체 → RPi4 → 모션 보드 → SwitchBot Bot)으로 전자레인지 버튼을 눌러, 표시창이 10:00에서 20:00으로 바뀌는 것을 영상으로 남겼다.
- 레일 고정 전 같은 방식으로 20번 중 10번 성공. 실패는 X축이 헐렁해 누를 때 장치가 들리는 것이 원인으로 보인다(팀 관찰). 레일을 고정한 뒤 같은 버튼·같은 방식으로 다시 잰다.
- 일반 실행 경로(승인 → 실행)로 누른 기록은 아직 없다.

## 2. 실제 기록 확인 (허브 DB)

- 공기청정기 실제 사용 기록에서 잡힌 습관 3개: 켜기 낮 12시 59분쯤(10/18·10/23·10/25, 4번, 11/5 12:49까지 쉼), 켜기 평일 밤 10시 4분쯤(10/16·10/20·10/22, 5번), 끄기 밤 9시 52분쯤(6일, 9번).
- 제안과 대답(10/16 이후, 연습 제외): 공기질 나쁨 → 켜기 '네' 4번·'아니요' 6번·응답 없이 닫힘 3번, 강풍 '네' 1번, 귀가 켜 두기 '네' 1번. 공기질 쪽 자동 실행 규칙은 없다 — '네'가 쌓여도 저절로 맡기지 않았다.
- 10/28 밤에 불을 끄자 수면 모드 제안(00:30:42, `suggestion_events` created) → '네'(00:30:59, submitted) → LG 상태 다시 읽어 확인(00:31:01, `job_history` `state_confirmed`, "운전 모드 수면으로 바꿨어요").
- 자동 실행 규칙(`auto_rules`)은 3개 모두 꺼져 있다(가열 종료 → 강풍 1개, 시각 루틴 2개). 공기질 제안에서 만들어진 규칙은 없다. 정해진 시각 자동 켜기·끄기는 10/16~17에 실물로 돌렸던 기록이 따로 있다.
- 오후 3~4시대 공기청정기 기록은 없다. 결선 습관 장면은 11/5 점심 실제 카드를 캡처해 쓰기로 했다(가짜 기록을 만들지 않는다).

## 3. 키오스크

- 제안 카드 신호 칩 잘림·'시간 더 주기'가 늘 100초가 되던 것 수리(`17aaa55b`), 실패널 설치·화면 확인.
- 처음 화면 다음 루틴을 시각과 할 일만 보이게 단순화(`d01c1cff`), 설치 전.
- 꺼진 공기청정기에 '전자레인지가 멈추면 공기청정기 세게' 카드가 뜨고 그 카드 위쪽 글이 잘리는 것을 실물에서 발견 — 수리 중.

### 배포(11/3 저녁)

- RPi5·RPi4 백엔드를 `c3aa2407` 기준 코드로 올렸다(꺼진 공기청정기 가열 종료 제안, 모의 모션 연습 모드 표시 포함). 키오스크도 같은 기준으로 설치했다(제안 카드 잘림·시간 더 주기·다음 루틴 단순화).
- `/connections`에서 누름 장치가 `warn` "누름 장치가 연습 모드예요"로 나오는 것을 실물에서 확인했다(RPi4 모의 모션 상태).

## 3-2. 모션 보드 재연결·원점 (저녁, 실물)

- 선 정리 뒤 모션 ESP32를 RPi4에 다시 꽂고 실제 모션으로 되돌렸다(백업 `env.bak-20261103-before-real`).
- 벽에 부딪혀 원점 잡기(JSON `home`): 두 번 모두 시작 2.2초 뒤 보드가 `ERROR_POSITION`. 원본 스케치 흐름상 X·Y 벽을 찾은 뒤 3 mm 물러나는 이동의 정착 판정에서 난 것으로 보인다(캐리지가 이미 좌하단 근처였다). 정지는 모션 보드가 확인(15–19 ms).
- 지금 자리를 원점으로(`Z`): 성공(`homed=true`, 0,0). 그 뒤 0.5 mm 조그도 `ERROR_POSITION`이라 위치 확인을 받지 못해 '여기서 누르기'가 거절됐다.
- 정착 시간·허용 오차는 HW 담당 펌웨어 값이라 손대지 않았다.
- 학교 방 밝기(카메라 평균 117)가 문턱 사이라 키오스크가 어두운 화면에 머물렀다 — RPi5 env 문턱을 80/100으로 낮췄다(백업 `env.bak-20261103-light-school`). 집·결선장에서는 불을 껐을 때 값이 80 아래로 내려가는지 다시 본다.

## 3-3. 개발자 모드 보드 명령 바로 보내기

- 조정 중 위치 확인·원점 확인 관문 없이 원본 텍스트 명령을 보내고 보드 답을 보도록 `raw <명령>`을 더했다.
  허용: `T [ms]`·`Z`·`H`·`S`·`!`·`P`·`?`·`$$`·`STOP`·`G x y [f]`·`GT x y [f]`·`M a b ms`(출력 ±1, 2000 ms 이하). 키 재설정·PID 값·버튼 격자 명령은 뺐다(`rpi/controller/touchbridge_raw.py`).
- RPi4 env `SIMPLELAY_DEV_RAW_MOTION=1`일 때만 보낸다(기본 꺼짐). 개발자 조작 규약 4 — RPi4·RPi5 같은 커밋 배포 필요.
- 보낸 뒤에는 위치 토큰을 지우고 보드 상태를 다시 읽는다. 정지는 이 경로와 상관없이 JSON `stop`으로 간다.
- 결선 전에 개발자 모드와 함께 끈다.

## 4. 발표 웹 슬라이드

- 결선 발표용 웹 슬라이드(16:9 무대 화면, 발표자 창, 본체 값 읽기 전용 프록시)를 만들었다. 발표 자료는 저장소 밖 로컬 폴더에서 관리한다.
- 전자레인지 실시간 전력을 주는 GET 경로가 아직 없어 그 장은 11/2·11/3 실측 장면으로 대신한다.
- 실제 본체 연결로는 아직 확인하지 않았다.

## 5. 폰 앱 문구 수정

- 데스크톱 에뮬레이터와 연습용 본체로 홈·가전·가전 추가·자동 실행·기록·알림·설정·제안·결과 화면을 돌며 문구를 다시 봤다.
- 결과를 확인하지 못했을 때의 할 일을 구체적으로: "집에서 가전을 확인해야 해요" → "집에서 가전 화면이나 불빛이 바뀌었는지 봐 주세요"(키오스크와 같은 말).
- 연결 실패: "연결을 봐 주세요" → "휴대폰과 본체가 같은 네트워크에 연결됐는지 봐 주세요". 핫스팟을 써도 맞도록 '와이파이' 대신 '네트워크'. 누름 장치·전기 플러그 쪽 실패는 "본체와 누름 장치가 연결됐는지". 가전 타일의 짧은 표시는 그대로 뒀다.
- 자동 실행 끄는 곳은 키오스크와 같은 문장 "휴대폰 앱의 '자동 실행'에서 언제든 끌 수 있어요". 직접 조작 결과는 '완료·실패'. '폰'은 '휴대폰'으로 통일.
- 연습 실행의 진행 줄에 '연습'을 붙였다("연습 2개 중 2개 했어요"). 제안 화면 제목은 '할까요?' 대신 할 일 이름, 이름이 길거나 문장이면 '지금 할 일'.
- 빈 화면에 다음 할 일(새로 보기·다시 찾기·다시 열기), 블루투스 안내가 낱말 중간에서 꺾이던 것과 찾는 곳을 바로 아래 '주변 블루투스 기기'로 고쳤다.
- 루틴 줄의 '자동' 표시는 줄 높이·한 덩어리 줄바꿈 시험과 앞선 결정(탭 이름만 '자동 실행') 때문에 그대로 뒀다. 서버 문장을 판별하는 '갠트리'·'진행 중'·'풍량' 비교 문자열도 화면 글이 아니라 손대지 않았다.
- 폰 시험 1,565개 통과(골든 제외), analyze 오류·경고 0.
