Seongwonp/Simplelay/docs/devlog/devlog_2026-10-31-pairing-qr.md

# 폰 연결: 앱 안 QR 찍기 (2026-10-31)

시연에서 "카메라 앱을 따로 열거나 주소를 적어야 한다"는 실제 불만이 나와, 사용자 승인으로 `mobile_scanner` 7.2.0(고정)을 폰 앱에 넣었다.

## 바뀐 동작

- 연결 화면의 기본 동작은 큰 'QR 찍기' 버튼. 앱 안 전체 화면 스캐너가 열리고, 맞는 `simplelay://pair` QR을 읽으면 스캐너를 닫고 바로 기존 연결 요청으로 간다.
- 다른 QR은 쉬운 말로 거절하고 계속 찍는다. 카메라 권한 거절·카메라 없음은 쉬운 말과 함께 코드 입력으로 넘어간다.
- 수동 경로는 '코드로 연결하기' 뒤에 접어 두고, 처음에는 여섯 자리 숫자만 묻는다. 저장된 주소(없으면 `simplelay.local`)로 본체를 찾지 못했을 때만 주소 칸을 보인다.
- 안내 문구에서 '휴대폰 카메라로 찍기'를 뺐다. iOS 카메라 사용 설명에 QR 연결을 더했다.

## 유지한 것

본체 화면의 허락, 두 화면 글자 대조, 허락 전 키 저장 금지, 받았음 알림, 딥링크 진입은 그대로다. QR 판단은 `app/lib/services/pairing_qr.dart` 한곳으로 모아 스캐너와 코드 칸이 같은 규칙을 쓴다. QR로 들어온 주소에 대한 허용 범위는 기존 딥링크와 같다.

## 검증

- 위젯 시험: 가짜 카메라 경계(`qrCameraViewProvider`)로 맞는 QR·다른 QR·권한 거절·카메라 없음·뒤로 나가기·코드 경로·주소 공개 조건을 확인했다. 결함을 되살린 변형 7개에서 각각 실패를 확인했다.
- 릴리즈 APK 빌드는 컴파일 확인일 뿐이다.
- **미검증:** 실폰·에뮬레이터 카메라 미리 보기와 실제 QR 인식, 실제 권한 거절 화면, 카메라 없는 기기의 오류 값, 앱 전환 뒤 카메라 재시작, 실제 mDNS 찾기, iOS 빌드.
