Seongwonp/Simplelay/docs/devlog/devlog_2026-10-14-ui-tidy.md

# 2026-10-14 데스크톱 — UI 정리(10/15 UI 동결 전): 동시 선택지·확인 수준 아이콘·'예시 루틴'

외부 UI 의견 세 건(사용자 승인)을 반영했다. 새 기능은 아니다. 정보의 우선순위와 동시에 보이는 선택지 수만 고쳤다. 팔레트와 탭 구조는 바꾸지 않았고, 모의 표시와 정지 접근성도 그대로 두었다. 백엔드(`rpi/`)는 바꾸지 않았다. 템플릿 설명의 '추천'은 docstring에만 남아 화면에 나오지 않는다.

이어지는 기록: [재평가 수리 마무리](devlog_2026-10-14-eval-fix.md).

## 커밋

| 커밋 | 내용 |
|---|---|
| `27c6675` | **폰 제안 확인**: 아래 고정 영역에는 '지금 실행'과 '다음에'만 둔다. '이 제안 30분 쉬기'·'이번 동작 바꾸기'·'이 제안 다시 받지 않기'는 앱바의 **'더 보기'**로 옮겼다(누르면 아래에서 목록이 올라오고, 고르면 목록을 닫은 뒤 실행한다). 기본 글씨와 큰 글씨 모두 같다. '실제 버튼 배치' 지도는 접어 두고 제목만 보인다. 펼치면 지도가 나온다. 자동 실행 카드의 세 갈래(이번만 실행·다음부터도 자동으로·안 할래요)는 고정 영역에 그대로 남는다. '다음부터도 자동으로'는 '더 보기'에 넣지 않았다 |
| `82e0dc9` | **키오스크 결과**: 큰 체크와 성공색은 확인한 성공에만 쓴다. 실제 ThinQ 상태 재조회(바꿈·이미 목표값)와 실측(L3 출처 real) 동작 확인이 여기에 든다. 누름 장치 보고만 받은 경우, 실행 환경을 모르는 경우, 연습인 경우, 모의 L3인 경우의 성공은 중립 아이콘(i)과 흰 글자로 보인다. **키오스크 제안**: 질문은 36으로 가장 크게 그대로 둔다. 선택 버튼은 글자 26, 최소 높이 72로 키웠다(전에는 22·64). 버튼 순서와 할 일은 20으로 줄여 보조로 둔다(전에는 24). 근거는 두 줄까지 보이고 넘치면 말줄임으로 자른다. 버튼 순서(다음에·시작)는 그대로다 |
| `bd8bbb9` | **폰 루틴 탭**: '추천'을 '예시 루틴'으로 바꿨다. 빈 목록 문장 두 개와 템플릿 행 낭독('예시 루틴 · 이름. 설명. 고쳐서 저장하면 내 루틴이 돼요', 누르면 편집)도 같은 이름으로 맞췄다. 관련 주석 3줄도 고쳤다 |

## 화면에 계속 보이는 것(펼치지 않아도)

- 폰 제안: 대상 가전(사진·이름·'데모' 표시), 질문, 근거 한 줄, '누를 순서'의 번호와 버튼 이름, 막힌 이유(빨간 줄, 실행 비활성), 고정 영역의 '전자레인지 · 버튼 n개'. 시나리오 카드는 '할 일'·'누를 버튼' 목록, ThinQ 경로 칩, 준비 안 됨 사유, '시연 데이터로 만든 제안'
- 키오스크 결과: 문장, 대상 줄, 확인 방법 한 줄, 판정 줄, 연습 모드 표시는 전과 같다. 아이콘과 색만 확인 수준에 맞췄다

## 시험

- 새로 쓰거나 고친 시험이 수정 전 코드에서 실패하는 것을 먼저 확인했다(폰 10건: 선택지 수·더 보기·지도 접힘·큰 글씨, 키오스크 7건: 아이콘·색 대응·글자 위계·근거 두 줄, 루틴 4건). 수정 전에도 통과하던 확인 수준 '강함' 3건은 회귀 방지로 둔다.
- 폰: **801 통과**(골든 제외, 793에서 +8). 골든 **55** 비교 통과(갱신 후 재비교).
- 키오스크: **328 통과**(골든 제외, 318에서 +10). 골든 **44** 비교 통과(갱신 후 재비교).
- analyze: 두 앱 모두 error·warning 0(기존 info 4·1).
- 시험은 ASCII 임시 worktree에서 돌렸다. 아이콘 글꼴 경로만 임시로 이 PC의 SDK 경로로 바꿔 비교했고, 저장소의 경로는 그대로 두었다.
- 백엔드는 바뀌지 않아 다시 돌리지 않았다.

## 골든 갱신 장면(렌더를 이미지로 직접 확인)

- 폰 5장:
  - `suggestion` / `lt_suggestion`: 앱바 '더 보기', 고정 영역에 두 버튼, 지도 접힘
  - `suggestion_large`: 앱바 '더 보기'만 추가
  - `suggestion_long`: 6단계, 지도 접힘
  - `suggestion_long_large`: 앱바만 바뀜
- 키오스크 9장:
  - `done` / `done_large` / `kiosk15_done`: 실행 환경을 모르는 성공이라 체크 → (i), 초록 → 흰색
  - `provenance_done_1.0` / `provenance_done_1.6`: 연습 성공이라 중립
  - `suggestion` / `suggestion_large` / `suggestion_long_large` / `kiosk15_suggestion`: 버튼이 커지고 순서 글자가 작아짐
  - 처음 키운 값(28·76)에서는 `suggestion_long_large`의 근거 줄이 버튼에 가려 잘렸다. 26·72로 줄인 뒤 다시 확인했다

## 미검증

- 실폰과 실패널(15.8형)에서 보지 않았다. 판단 근거는 위젯 시험과 골든뿐이다.
- '더 보기' 목록(아래에서 올라오는 시트)은 골든에 없다. 시험으로 항목과 동작만 확인했다.
- TalkBack 제스처 낭독은 확인하지 않았다(낭독 이름은 시험으로만 확인).
- 키오스크와 APK는 다시 배포하지 않았다. **다음 보드 날에 다른 변경과 같은 커밋으로 함께 배포한다.**
