Seongwonp/Simplelay/docs/devlog/devlog_2026-10-16-desktop-home.md

# 2026-10-16 데스크톱(집) — 보드 다시 세팅, 노드 등록 시 정지 지연 수리, RPi5 허브 ThinQ 실제 제어

학교(노트북)에서 쓰던 보드를 집으로 가져와 데스크톱에서 다시 세팅했다. 노트북 커밋 53개(`155705c..1ed0c21`)를 받은 상태에서 시작했다.

## 1. 보드 세팅

| 항목 | 내용 |
|---|---|
| 주소 | RPi5 유선 `192.168.0.178`. RPi4 유선 `192.168.0.81`, Wi-Fi `192.168.0.82`(집 Wi-Fi에 자동으로 붙었다) |
| 링크 주소 | 학교 핫스팟 주소였다 → RPi5 `SIMPLELAY_UART_PORT=socket://192.168.0.82:7000`, RPi4 `SIMPLELAY_LINK_ALLOW_FROM=192.168.0.178`. 백업 `env.bak-20261016-home` |
| 모션 | **ESP32는 HW 담당이 솔레노이드·레일 작업으로 가져갔다.** RPi4 `SIMPLELAY_MOTION_MODE=mock`, `SIMPLELAY_MOTION_PORT` 줄은 주석(`#ESP32없음-20261016#`) — `run_act.sh`는 그 줄이 있으면 장치 없음으로 시작을 거절한다. 백업 `env.bak-20261016-no-esp32`. **ESP32가 돌아오면 두 줄을 되돌리고, 노트북 HW 시험용 펌웨어를 시험대 빌드로 다시 올린다**(10/14 방식, RPi4에서 esptool) |
| ThinQ | 사용자가 PAT를 RPi5 `/mnt/rawdata/simplelay/thinq/thinq_pat`에 직접 넣었다(클립보드 → ssh, 값은 채팅·로그에 없음). 윈도우 줄 끝 CR만 지웠다. env에 `SIMPLELAY_THINQ_MODE=real`·`SIMPLELAY_THINQ_COUNTRY=KR`(백업 `env.bak-20261016-thinq`) |

## 2. 배포 — 4종 같은 커밋 `ffe7540`

| 대상 | 확인 |
|---|---|
| RPi5 백엔드 | 이미지 `5049f1a1a513`(되돌리기 `simplelay-backend:1015`) |
| RPi4 실행기 | 같은 이미지, `run_act.sh`는 HEAD 판, `link auth: new session`, `motion=mock rehearsal=ON` |
| 키오스크 ipk | 실패널 설치 성공(빌드 컨테이너가 다시 쓴 `pubspec.lock`은 되돌림) |
| 폰 APK | 에뮬레이터(x86_64, split-per-abi) |

배포 전 시험(`ffe7540`, 데스크톱):
- 백엔드+rpi4 **3,375 통과**
- 폰 **893**·키오스크 **503**(골든 제외) 통과, 골든 폰 55·키오스크 57 통과
- analyze error·warning 0

## 3. 노드 등록 시 정지 지연 수리 (`6d0dd6e`·`ffe7540`)

배포 전 전체 시험에서 정지 시간 시험이 가끔 실패했다(기준 0.5 s). 원인은 둘이었다.

1. **실제 결함(서버):**
   - 노드 레지스트리는 처음 쓰는 노드의 컨트롤러(HTTP 클라이언트)를 `get()`에서 만든다.
   - 정지 경로가 서비스 잠금 안에서 **노드 목록을 먼저 모은 뒤** 모터 `request_stop`을 불렀다.
   - 그래서 노드를 등록만 하고 아직 쓰지 않았으면, 그 생성 시간만큼 모터 정지가 늦었다(데스크톱 약 230 ms, 라즈베리파이는 더 느릴 수 있음).
   - 수리: 같은 잠금 안에서 모터 정지를 먼저 부르고, 노드 목록은 그 뒤에 모은다. 노드에도 정지는 그대로 간다.
   - 새 시험: 노드 컨트롤러 생성을 0.4 s로 늦추면 수정 전 **675 ms**에 실패한다. 수정 뒤에는 0.02 ms다.
   - 노드 저장이 멈춘 동안의 정지(H-R2 node): **232~594 ms → 2.7~4.4 ms**.
2. **시험 측정 문제:**
   - 정지 시험들이 시간을 재기 시작한 **뒤에** `httpx.Client()`를 만들었다. Windows 데스크톱에서는 그 생성에 약 230 ms(인증서 묶음 로딩)가 걸린다.
   - 그래서 같은 시험이 노트북 12 ms·데스크톱 240 ms로 갈렸다.
   - 정지 요청 클라이언트를 측정 전에 만들도록 4개 파일 7곳을 고쳤다.
   - 정지 시험 4파일 94개가 3회 연속 통과했다.

## 4. RPi5 허브에서 ThinQ 실제 제어 (실물)

1. **발견:** `GET /thinq/discovered`에서 공기청정기(`DEVICE_AIR_PURIFIER`, 별칭 '공기청정기', 모델 `AIR_0B5001_WW`), 막힘 없음.
2. **추가:** 앱 설정 → LG ThinQ 연결 → '추가'. 폰 홈에 'ThinQ' 표시 타일이 생겼고, 키오스크 가전 목록(3쪽)에도 1분 갱신으로 들어왔다(사용자 확인).
3. **상태 읽기:** 전원 꺼짐·운전 자동·풍량 자동·PM2.5 8 좋음·PM10 8 좋음·필터 100%.
4. **제어 1회:** '켜기' → 확인 창("허브가 ThinQ로 공기청정기에 보내요. 바뀌었는지는 상태를 다시 읽어 확인해요") → '바꾸기'.
   - 결과: "전원 켜기로 바뀌었어요", 칩 '성공'·'ThinQ'·**'상태 확인됨'**.
   - **사용자가 공기청정기가 실제로 켜진 것을 확인했다.**

**검증 수준:** RPi5 허브 → 실제 ThinQ 클라우드 → 실가전 전원 켜기 1회와 상태 재조회까지. 풍량·운전 모드, '이미 목표값', 키오스크에서의 조작, 자동 실행 규칙(가열 종료 → 강풍)은 아직이다.

## 5. 남은 것

- 풍량 '강' 1회와 이미 목표값일 때 다시 보내지 않는지(절차 §5-1).
- 키오스크에서 공기청정기 조작, v4 장면(가열 종료 주입 → 강풍 카드 → '다음부터도 자동으로').
- ESP32 복귀 뒤: RPi4 env 두 줄 되돌리기, 시험대 펌웨어 다시 올리기, 솔레노이드·레일 장착 뒤 실제 누름.
- 시험용 가전 정리(사용자 결정).
- 평가 전: RPi5 env의 개발자 실물 조작 끄기.

## 6. 시각 루틴 — 컨테이너 시간대 결함 수리(`c9c15d6`)와 실물 확인

- "금 19:35 공기청정기 끄기"(승인 방식) 루틴을 만들었는데 19:35에 카드가 뜨지 않았다.
- **원인:** 백엔드 컨테이너가 UTC로 돌아 서버는 그때를 10:35로 봤다. 루틴 시각·조용한 시간(22:00~07:00)이 한국 시각보다 9시간 늦게 맞는다. 시험은 시계를 고정해 이 차이를 보지 못했다.
- **수리:** `run_backend.sh`가 호스트 시간대(못 읽으면 Asia/Seoul)를 `-e TZ`로 넘긴다. env 파일에 `TZ=` 줄이 있으면 그 값을 따른다. 시험 2건을 추가했다(수정 전 실패 확인).
- **실물:** 루틴 시각을 19:41로 옮겼다. **19:41에 키오스크에 카드가 떴고, 사용자가 확인을 누르자 공기청정기가 꺼졌다.** 기록은 `succeeded`·`state_confirmed`다.
- **설계 확인(사용자 질문):** 시각 루틴은 그 시각에 **승인 카드**를 띄운다. 승인 없이 저절로 실행되는 것은 사용자가 허용한 사건 규칙(가열 종료 → 강풍)뿐이다. 조용한 시간에는 새 카드가 뜨지 않는다. 취침 23:00 켜기·기상 07:00 끄기는 아래 '남은 것'의 정책 결정이 필요하다.

## 7. 시각 루틴 '다음부터도 자동으로'와 ThinQ 사용 → 초안(`e0a6a34`·`6bc5ac0`)

- **서버:** 낮은 위험 ThinQ 한 단계짜리 시각 루틴 카드에 허용 제안을 붙였다. 허용 뒤 그 시각에는 기존 자동 실행 경로(조용한 시간·비상정지·지문·전송권·같은 회차 1회 영속·나이 상한·허용/재시작 경계)로 카드 없이 보낸다.
- **ThinQ 초안:** `/thinq/command`가 사용 기록을 남긴다. 반복하면 시각이 든 루틴 초안이 나온다. 실제 실행·직접 사용만 근거로 센다.
- **폰:** 확인 시트가 서버 `caveat` 문장을 따른다.
- **시험:** 새로 36건(서버)·2건(폰).
- **실물:**
  - 20:30 카드에 허용 제안 → 시트(시각 문장) → 허용 → 이번 실행(실제 공기청정기 켜짐, `state_confirmed`) → 규칙 '자동 실행 켜짐'.
  - **첫 자동 실행은 다음 날 20:30(미확인).**

## 8. 키오스크 — 켜진 ThinQ 가전을 앞에 초록 '켜짐'으로(`64d2ef9`, 사용자 요청)

- 서버가 전원 상태를 기억한다(`GET /thinq/power`, 클라우드를 부르지 않음, 600초 넘으면 버림). 키오스크는 10초마다 읽는다.
- **실물:** 실제 공기청정기가 켜진 상태에서 키오스크 가전 줄 첫 자리에 '공기청정기 · 켜짐'(초록)이 떴다.

## 9. 리허설(v4, 연습 모드 — 모의 모션·모의 ThinQ·가열 종료 주입)

RPi5 env를 잠시 리허설로 바꿨다(`SIMPLELAY_UART_REHEARSAL=1`·`THINQ_MODE=mock`·페이싱). 끝난 뒤 백업으로 되돌렸다.

| 장면 | 결과 |
|---|---|
| ① 제안 거절 | '다음에' → 실행 없음, 카드 0 |
| ② 첫 조리 승인 → 자동 허용 | 즉석밥 2단계 연습 `success`(폰·키오스크 "연습을 마쳤어요 · 실제 가전은 누르지 않았어요") → 가열 종료 주입(`rpi4_uart`) → 공기청정기 강풍 카드("조리 완료가 아닐 수 있어요") → '다음부터도 자동으로' → 연습 상태 확인 '강풍으로 바꿨어요' |
| ③ 같은 조건 다시 | 약풍으로 되돌림 → 두 번째 조리 → 주입 → **카드 없이** 자동 실행 `sent·succeeded·state_confirmed`, 키오스크 위 줄 "자동 실행 · 공기청정기(모의)를 강풍으로 바꿨어요 · 연습 모드" |
| ④ 기록 → 끄기 | 기록에 자동 실행·조리 결과, 루틴 목록 '자동 실행 끄기' → '직접 자동 실행을 껐어요' |
| ⑤ 일부 실패 | 녹화·기록으로 하는 장면이라 이번에 안 함 |

**리허설에서 찾은 것**
1. **[높음, 고침 `955730a`·`3e93a07`] 배포할 때마다 허용한 자동 실행이 꺼졌다.**
   - 원인 1: `run_backend.sh`가 `docker rm -f`로 바로 죽였다.
   - 원인 2: `docker stop`을 보내도 uvicorn이 'Waiting for connections to close'에서 키오스크·폰 연결 유지를 기다리다 15초에 강제로 죽었다. 그래서 정상 종료 표시를 남기지 못했다.
   - 수리: stop을 먼저 보내고, uvicorn에 `--timeout-graceful-shutdown 5`를 준다.
   - 실물: 허용 → 다시 배포(12초) 뒤에도 '자동 실행 켜짐'.
2. **[중간, 남음] 시각 루틴 카드가 재시작 뒤 같은 회차에 다시 뜬다.** 회차 기억이 메모리뿐이고(10분 창), 승인으로 처리한 회차라 SeenEvents에도 없다. 누르면 두 번 실행된다.
3. **[중간, 남음] 기록의 가전 이름이 지금 이름으로 바뀐다.** 모의 모드로 바꾸자 20:31 실제 실행이 '공기청정기(모의)'로 보였다.
4. [낮음] 키오스크 승인 카드 근거 줄이 아래에서 잘린다(공기청정기 강풍 카드).
5. [낮음] 폰 카드 "이 제안을 1번 승인하셨어요"가 누가 했는지 단정한다.
6. [낮음] ThinQ 연습 실행 중 키오스크 띠가 "실제 가전은 **누르지** 않아요"다(버튼 문장).
7. [낮음] 폰 홈은 제안 카드를 한 번에 하나만 보여 다른 제안이 가려진다.

## 10. 외부 시각 평가(Opus — Fable 사용량 소진으로 대체)

- **점수:** 폰 68 · 키오스크 55 · 오늘 시연 기준 출품작 51. 하드웨어 완성(실제 누름·CT·하우징) 시 약 74.
- **유의:** 키오스크 캡처 k02~k05는 10/14 화면이다. 키오스크 점수의 일부는 옛 화면 기준이다.
- **평가가 짚은 상위 개선**
  - 시연 데이터 정리(시험 가전·'시험 저녁 끄기'·알림 16건)
  - 과장·모순 문구 수리
  - 실제 버튼 누름 영상(10/28 서류 필수)
  - 루틴 목록 위 카드의 '승인 후 실행' ↔ '자동 실행 켜짐' 모순
  - '다음부터도 자동으로' 버튼의 무게(보조 버튼으로)
  - 시연 시간(30초 가열 2회)
  - 질의 대비(재사용 경계·SwitchBot·ThinQ ON 비교·빈 가열 안전)
- 원문은 저장소 밖 작업 기록(스크래치패드)에 있다.

## 11. 남은 결함 수리(밤)

리허설에서 찾은 결함 2~6을 고쳤다. 모두 수정 전 코드에서 시험이 실패하는 것을 확인한 뒤 커밋했다.

| 결함 | 수리 | 커밋 |
|---|---|---|
| 2. 재시작 뒤 같은 시각 카드가 다시 뜸 | '이미 띄운 회차'를 DB 설정 한 칸(`routine_time_fired`)에 저장 | `d746dcd` |
| 3. 기록 이름이 지금 이름으로 바뀜 | `job_history.appliance_name` 열 — 실행할 때 이름. 폰 기록 화면이 먼저 쓴다(옛 기록은 지금 목록) | `d746dcd`·`866ac92` |
| 4. 키오스크 승인 카드 근거 줄 잘림 | 시나리오 카드의 근거를 오른쪽 칸('할 일' 아래)으로. **실패널에서 확인**(연습 모드로 잠시 바꿔 카드를 띄우고 캡처, env 복원) | `13ae421` |
| 5. "이 제안을 N번 승인하셨어요" 단정 | "최근 기록: 이 제안 승인 N번" | `78bc13c` |
| 6. ThinQ 연습에 "누르지 않아요" 띠 | "연습 중 · 실제 가전에는 보내지 않아요"(골든 11장 갱신) | `c4d1c1d` |

## 12. 내부 UI 검토 후 화면 수리(하드웨어 완성 가정)

이하 점수·목표는 AI 도구의 당시 내부 검토 참고값이다. 공식 심사·실사용자 평가가 아니며, 실제 시험·배포 기록과 구분한다.

사용자가 목표를 정했다 — **하드웨어가 완성됐다고 가정한 냉정한 심사위원 평가에서 85점 이상**(지난 평가 74).

| 지적 | 수리 | 커밋 |
|---|---|---|
| p02 '다음 실행'이 '승인 후 실행'(아래는 '자동 실행 켜짐'), 날짜 없음 | `/routines/next`가 `auto`·`day_label`(오늘·내일·요일)을 준다. 폰 "내일 · 매일 20:30 · 자동 실행" | `2665878` |
| p05 '다음부터도 자동으로'가 실행과 같은 무게 | 외곽선 보조 버튼 | `2665878` |
| p06 시트 제목 '자동으/로' 끊김, 본문 길고 '허브 시계' 내부 설명 | 제목 줄을 직접 나눔, 본문 한 문장, 서버 시각 단서 한 문장 | `2665878` |
| p02 '지우기'·p09 '빼기' 글자 버튼 | 테두리 버튼 | `2665878`·`85b6289` |
| p03 연습 기록에 성공 체크 | 연습 성공은 중립 아이콘 | `85b6289` |
| p08 한 단계 ThinQ에 진행 막대·'할 일'·'확인'+'닫기' | 한 단계면 막대·목록 없음, 성공 뒤 '확인' 하나('닫기'는 다시 시도할 때만) | `85b6289` |
| p09 모델 코드 노출 | 숨김(종류가 이름과 같으면 줄 생략) | `85b6289` |
| k01 가운데 빈 공간·공기청정기 상태 없음 | 대기 화면 '실내 공기 {등급}' 줄, 공기청정기 상세에 지금 상태·전원·풍량 조작(사용자 요청, 에이전트 구현) | `dfc2c40`·`64f402e` |

**실물:** 실제 공기청정기로 대기 화면에 "실내 공기 보통 · 초미세먼지 8 · 공기청정기 켜짐"이 떴다(`GET /thinq/air` grade=NORMAL은 가전이 매긴 종합 등급, PM2.5 등급은 GOOD). 키오스크 상세의 실제 조작은 아직 누르지 않았다.

## 13. 보드 상태(마감)

- RPi5 백엔드·RPi4 실행기: `c4d1c1d`(같은 이미지). 키오스크: `13ae421`(그 뒤 커밋은 키오스크만). 폰 APK: `6bc5ac0`(이후 폰 수리는 아직 APK로 안 만듦).
- RPi5는 ThinQ 실제 모드다.
- 자동 실행 규칙: '저녁 공기청정기 켜기' **켜짐**(매일 20:30), '가열 종료 → 공기청정기' 꺼짐.
- 시험 수(골든 제외): 백엔드+rpi4 3,449 · 폰 896 · 키오스크 536(골든 키오스크 61).

## 14. 밤 — 시각 자동 실행 실물, 85점 목표 2차 평가와 수리(사용자 취침 중 진행)

**사용자 요청:** 켜기를 22:00, 끄기를 다음 날 07:00으로. 하드웨어 완성 가정 냉정 평가 85점까지 유지보수를 반복.

**실물**
- '저녁 공기청정기 켜기'를 22:00으로 옮기고 카드에서 다시 허용했다(루틴을 바꾸면 허용이 풀리는 설계). 21:52에 공기청정기를 끈 뒤,
  **22:00:05 카드 없이 자동으로 보내 실제로 켜졌다**(`sent → succeeded · state_confirmed`, 2.3초, 알림 "루틴 '저녁 공기청정기 켜기' 시각(22:00)이라 승인 없이 보냈어요").
- 07:00 끄기: 서버 안전 표가 공기청정기 '전원 끄기'를 자동 실행 대상에서 빼 두었다(10/13 설계). 요청에 맞춰 **시각 규칙에서만** 끄기를 허용했다(`845569e`, 사건 규칙은 켜기만 그대로).
  배포 뒤 '아침 공기청정기 끄기'(매일 07:00)를 허용했다. 허용할 때 '이번에도 실행'으로 한 번 꺼져, 바로 다시 켰다(22:04).
- 22:00 실행이 배포 전이었고, 배포(`845569e`) 뒤에도 규칙이 켜진 채 유지됐다(정상 종료).
- 이 데스크톱에서 07:10까지 1분마다 허브 상태를 저장소 밖 로컬 기록 파일에 남긴다(git 제외 폴더).

**시연 데이터 정리(사용자 승인, DB 백업 뒤):** 시험용 전자레인지·Phone-MW·중복 전자레인지(`home_mw`) 삭제, '아침 데우기'를 `microwave`로 옮김, '시험 저녁 끄기' 삭제. 폰 기기 안 가전 목록도 같이 지웠다. 보호자 알림을 열어 읽음 처리.

**2차 내부 검토(AI 모델 Opus, 하드웨어 완성 가정):** 참고 점수 폰 75(+7) · 키오스크 70(+15) · 출품작 **77**(+3). 실측 수치 0·장면 단위 실물 0·문서 간 자동 실행 범위 모순을 지적했다. 점수 차이는 사용성 개선율이 아니다. 원문은 저장소 밖 작업 기록.

**수리(모두 수정 전 실패 확인 뒤 커밋)**

| 지적 | 수리 | 커밋 |
|---|---|---|
| 폰 가전 타일에 상태 없음 | 켜진 ThinQ 가전 타일에 초록 '켜짐'(`/thinq/power` 15초) | `03cfcd7` |
| 자동 실행 범위 문서 모순, README 그림 '모의 클라우드까지' | 한 문장으로 통일(가열 종료 → 풍량, 시각 → 전원 켜기·끄기), 실측표 §5-1 정지 응답 시험대 실측(n=10 중앙 10.95 ms·160 ms) | `214a989` |
| k02 큰 질문의 '[시연 데이터]', 할 일의 '(모의)' | 위 띠 '제안 · 시연 데이터'로, '(모의)' 반복 제거 | `7ddf5c5` |
| k06 띠·제목·본문 수준 불일치 | 전력 확인 결과 제목 '전력 변화 확인' | `7ddf5c5` |
| p01 첫 카드가 설정 안 된 세탁기 루틴 | 큰 카드는 설정이 필요한 가전의 루틴을 건너뜀 | `a2c5c24` |
| k01 종합 '보통'과 초미세먼지 8 모순처럼, '·' 줄 끝 매달림, 다음 루틴 없음 | '초미세먼지 8 좋음'(가전 등급), 항목별 줄바꿈, '다음 루틴 · 내일 07:00 아침 공기청정기 끄기 · 자동 실행'(어절 줄바꿈) — **실패널 확인** | `06f8f26`·`891c3ee` |
| k05 큰 '시작'의 뜻 | '지금 누르는 버튼'(연습은 '지금 차례인 버튼') 이름표 | `b6d7728` |
| k04 연습 실패에 이유 없음 | 이유 한 줄(눌림 확인 못 함 등) | `dd7550d` |
| p03 기록 제목 형식 섞임 | 제목은 한 일, 출처(자동 실행·루틴)는 시각 줄 | `e6a88b4` |
| 질의 4문항 | Q7~Q10(같은 기계 공유·중복 출품 규정 확인은 미완, 앱 골격, 부착·이전 설치, 습관 제안이 시연 기록뿐) | `ce3458e` |

**고치지 않은 것(이유)**
- k07 '다시 시도'에 확인 단계가 없다는 지적: 이미 확인 창이 있다(`_confirmRetry` "가전 상태를 확인했나요?"). 평가가 잘못 읽었다.
- k08 '다시 / 정지 시도' 줄바꿈: 디자인 규격에서 정한 줄바꿈이고 시험 5곳이 지킨다. 점수 영향이 작아 둔다.
- p04 "키오스크에서는 'SimpleLay 본체'라고 불러요": 문구 A안 결정. '키오스크와 다시 동기화'는 보내지 못한 변경이 있을 때만 뜬다.
- 폰 '개발자' 탭: 서버 `SIMPLELAY_DEV_MODE`일 때만 보인다 — 런북 '평가 전에 끌 것'. 모터 조이스틱 시험에 아직 쓴다.
- 실행 결과 줄표 문장(—): 여러 화면이 쓰는 머리 형식이라 둔다.

**시험 수(골든 제외):** 백엔드+rpi4 3,450 · 폰 902 · 키오스크 542(골든 폰 55·키오스크 61).

## 15. 3차 내부 검토(참고 점수 79)와 수리

**3차 평가(Opus, 하드웨어 완성 가정):** 출품작 **79**(+2) · 폰 78 · 키오스크 76. "소프트웨어만으로는 81~82점이 상한, 85점은 장면 ②③ 실물 성공·영상, 성공률·정지·CT 최소 표본, 대회 규정 확인이 있어야 한다."

| 지적 | 수리 | 커밋 |
|---|---|---|
| README 【기입】·옛 시험 수·자동 실행 범위, 10/16 실물 줄 없음 | 사실로 갱신, RPi5 허브 시각 자동 실행 실물 줄 추가 | `e402475` |
| 대본 "안 할래요" ↔ 키오스크 "이번엔 안 할게요", 30초 가열과 '즉석밥' 예시 불일치 | 대본을 화면 글자대로, 허브에 시연 루틴 '30초 데우기'(30초 → 시작) 추가 | `e402475` |
| 설정이 필요한 가전의 루틴에 '실행하기'가 살아 있음(홈 행·루틴 탭) | 버튼을 끄고 이유 한 줄 | `2c71b44` |
| 루틴 탭에서 자동 실행 규칙과 루틴이 머리말 없이 섞임 | '자동 실행 규칙'·'내 루틴 목록' 머리말 | `2c71b44` |
| k06 띠 '가전 상태 확인'이 한 단계 강함, k05 '지금 누르는' 시제, k01 '보통' 밑 '좋음' | 띠 '전력 확인', 이름표 '이번 버튼', '실내 공기 종합 보통' — **실패널 확인** | `a3637f6` |
| 안전 수리 '보드 미배포' 문구 | G1~G11·R1이 `845569e`에 들어 있어 RPi4·RPi5 배포 상태로 갱신(실물 PS-1은 ESP32 복귀 뒤) | `41eb6a8` |
| 질의(라즈베리파이 두 개·시연 빌드 안전 수리·물리 비상정지) | 짧은 답 보강 | `41eb6a8` |

**두는 것:** 키오스크 위 아이콘 이름표(66×64 칸, 늘리면 위 줄이 넘침 — 읽는 이름과 누르면 설명 창은 있음), 보고서 【기입】 14곳(하드웨어 실측 뒤 채울 자리).

## 16. 4차 내부 검토(참고 점수 80)와 수리

**4차 평가:** 출품작 **80**(+1) · 폰 79 · 키오스크 77. "점수를 막는 것은 이제 화면이 아니라 증거(장면 실물 성공·영상·성공률·CT 표본·규정 확인). 소프트웨어 상한 81~82."

| 지적 | 수리 | 커밋 |
|---|---|---|
| 키오스크가 '눌렸는지 모름'을 빨간 '실패'·X로 | 앰버 '확인 필요'·물음표(실행되지 않음만 빨강) | `d8d3940` |
| 정지 확인 못 함 화면 "정지 버튼을 대신 눌렀어요" ↔ 위 줄 '취소' | 실제 버튼 이름으로 | `d8d3940` |
| 밤 예보(0시·3시) 맑음에 해 아이콘 | 19~5시는 달 아이콘 | `d8d3940` |
| 폰 큰 카드가 이미 저절로 도는 시각 루틴, 설정 필요 행이 위에 | 직접 실행 루틴 먼저, 설정 필요 행은 맨 아래 | `6255eda` |

**두는 것:** 기록 제목의 발화형("켜줘")·동작형("전원 켜기") 차이(서버 목적 문장 그대로 — 바꾸면 사용자 표현을 지어낸다), 루틴 탭 설정 필요 문구 색(빨강, 기존 오류 줄 재사용), 폰 '내 가전'에 ThinQ 가전이 없는 것(ThinQ 연결 화면에 있음).

**85점까지:** 소프트웨어로 남은 몫은 거의 없다. 남은 5점은 ① 장면 ②③ 실물 성공·30초 영상, ② 누름 성공률 n≥20·CT B·D·물리 정지 지연, ③ 대회 규정(중복 출품) 사무국 확인, 실제 사용 기록 제안 1장, 원가·설치 시간·팀 밖 사용자 1~2명.

## 17. 10/17 07:00 — 시각 자동 끄기 실물

- '아침 공기청정기 끄기'(매일 07:00)가 **07:00:05에 카드 없이 자동으로 보내져** 실제 공기청정기가 꺼졌다 — `sent → succeeded · state_confirmed`, 2.7 s, 기록 "자동 실행 · 공기청정기 전원 끄기"·가전 이름 '공기청정기'.
- 밤새 기록(1분 간격, 저장소 밖 로컬 파일): 22:04~06:59 서버 정상·전원 켜짐 유지, 07:00:20부터 전원 꺼짐. 밤사이 서버 끊김·재시작 없음.
- 이로써 밤에 켜고(22:00) 아침에 끄는(07:00) 시각 자동 실행을 실제 가전으로 한 바퀴 확인했다(RPi5 허브, 백엔드 `845569e`).
