Seongwonp/Simplelay/docs/devlog/devlog_2026-10-17-ui-eval.md

# 2026-10-17 — UI·디자인·편의성 검토와 수리 계획

당시 사용자 요청은 하드웨어와 별도로 UI·디자인·사용 편의를 반복 검토하는 것이었다. AI 도구 내부 참고 점수 90을 목표로 삼았으며, 아래 수치는 공식 심사·사용자 과업 결과나 사용성 개선율이 아니다. 지적·수정·시험 기록과 구분해 보존한다.

## 1. 평가(Opus, UI·UX·접근성 심사위원 관점)

배점: 정보 구조 15 · 시각 디자인 20 · 문구 15 · 접근성 20 · 상호작용·오류 방지 15 · 맥락 적합성 15.

| 항목 | 폰 | 키오스크 |
|---|---|---|
| 정보 구조 | 11 | 12 |
| 시각 디자인 | 15 | 16 |
| 문구 | 11 | 12 |
| 접근성 | 15 | 15 |
| 상호작용·오류 방지 | 12 | 13 |
| 맥락 적합성 | 11 | 12 |
| **합계** | **75** | **80** |

**제품 UI 종합 78.** 강점: 확인 수준을 정직하게 나눔(전력 변화 확인·확인 필요·연습 띠), 늘 같은 자리의 큰 정지, 실제 버튼판 모양 조작 화면. 원문은 저장소 밖 작업 기록.

## 2. 수리 계획 (영향 큰 순, 상태는 진행하며 채운다)

| # | 무엇 | 화면 | 상태 |
|---|---|---|---|
| A | 한국어 단어 중간 줄바꿈 제거(홈·루틴 경고, 폰 상태 화면 큰 문장, 키오스크 안내 카드) | p01·p02b·status·k 안내 | 완료 `f60bad6` — 키오스크 '비 / 예보가'는 낱말 사이라 결함 아님 |
| B | '확인을 눌러 주세요' 안내에 누를 버튼이 없음 → 문구를 할 수 있는 일로 바꿈(템플릿·허브의 기존 루틴) | k 안내 카드 | 완료 `e73cfd5`, 허브 '아침 데우기' 문구도 갱신 |
| C | 큰 글씨 실행 화면 글자 잘림 | k-large-executing | 완료 `e6660b5` — 원인은 스크롤 막대가 글자 위에 겹친 것, 막대 자리 14px 비움 |
| E | 키오스크 승인 주 버튼 '시작' → 가전 버튼 '시작'과 겹침 → '지금 실행'(폰과 같은 말) | k 제안 | 완료 `e6660b5` |
| F | 결과 화면 10초 자동 닫힘 — 만지면 멈춤, 큰 글씨면 더 길게 | k 결과 | 완료 `e6660b5` — 만지면 멈추고 '자동으로 닫지 않아요'(큰 글씨 연장은 만지면 멈춤으로 대신) |
| H | '설정이 필요해요' 색 통일(앰버) — 루틴 탭은 빨강이었다 | p02b | 완료 `086e286` |
| J | 폰 탭 제목 굵기 통일 | p02·p03·p04 | 완료 `086e286`, 앱바 제목도 `ae0903a` |
| K | 기록 둘째 줄 중복('이미 그 설정이라…' 두 번), '이미 목표값'은 중립 아이콘 | p03 | 완료 `086e286` |
| L | 꺼진 '실행하기' 대신 '설정하기'(가전 상세로 바로) | p01 | 완료 — 홈 `086e286`, 루틴 탭 `ae0903a` |
| N | 키오스크 '잠시 쉬기' 시트 — 실제 효과를 제목에, '취소' 테두리 버튼 | k-dnd | 완료 `ebe4997`(폰 '쉬기'·'시간 고르기'도 `1790438`) |
| G | 키오스크 위 아이콘 뜻(글자) | k00 | 배치 여유 확인 뒤 |
| O | 대기 화면 가전 줄 가운데·아래 여백 | k00 | 배치 여유 확인 뒤 |

**사용자 결정이 필요한 것(이번에는 하지 않음)**
- D. 장치 이름 통일('허브' ↔ 'SimpleLay 본체') — 문구 A안 결정을 바꾸는 일이라 사용자에게 묻는다.
- I. 루틴 탭에서 시각 규칙과 루틴을 한 줄로 합치기 — 정보 구조를 바꾸는 큰 변경.
- M. '다시 / 정지 시도' 줄바꿈 — 디자인 규격 결정.

## 3. 진행 중 추가로 찾은 것(사용자 질문·실패널)

- **날씨 안내가 뜨면 오른쪽 칸이 밀려 다음 루틴 줄이 잘림(사용자 질문):** 시험으로 재현(800×480 캔버스 = 실패널 배율). 다음 루틴 높이를 먼저 잡고 예보를 접게, 큰 글씨는 짧은 문장('다음 22:00 … · 자동'), 그래도 없으면 숨김 — `e6660b5`. **실패널 확인**: 4줄 안내 + 다음 루틴 — 예보가 접혀 다 보임.
- **키오스크 안내 카드에 기록 형식 문장**("루틴 '세탁 끝 알림' · 직접 실행을 눌렀어요 — …", 실패널에서 발견): 안내 문장만 보이게(폰 알림함은 전체 유지) — `9d89e88`. **실패널 확인**: "세탁이 끝났어요. 빨래를 꺼내 널어 주세요", 예보는 한 줄 모양으로 함께 들어감.
- 보드: RPi5·RPi4·키오스크 = `9d89e88`(10/17 아침).

## 4. 2차 평가 — 종합 83(폰 80 · 키오스크 86)

1차 수리(A~F·H·J·K·L·N) 뒤 같은 틀로 다시 받음. 남은 높은 항목과 수리:

| 지적 | 수리 |
|---|---|
| 키오스크 연결 창이 좁아 스크롤해야 다 보임 | 창 넓히고 어절 줄바꿈 — `79101a7` |
| '다시 시도' 경고가 특정 가전에만 맞는 말 | "가전이 이미 움직이고 있으면 다시 시도하지 마세요(같은 버튼을 한 번 더 누르게 돼요)" — 폰·키오스크 같은 말 |
| 큰 글씨 ThinQ 상세에서 조작이 아래로 밀림 | 큰 글씨면 조작을 먼저 — `79101a7` |
| 다음 루틴 줄에 시각·이름이 한 줄로 몰림 | 두 줄(시각 / 이름·자동) — `79101a7` |
| 거절 문구가 폰·키오스크에서 다름, 좁은 폰에서 버튼 글자 끊김 | 둘 다 '이번엔 안 할게요', 제안 버튼은 늘 세로(주 행동 위) — `ae0903a` |
| 루틴 탭에서 설정 필요 루틴이 위에 섞임, 할 일이 없음 | 아래로 보내고 '설정하기' — `ae0903a` |
| 허브 연결됨 점이 주 행동 갈색과 같음 | 중립색 — `5d66d5b` |
| 설정 '내 가전'에 ThinQ 가전이 빠져 홈과 개수가 다름 | 모두 보이고 지울 수 없는 줄은 이유(부제)·화살표 — `ae0903a` |
| '동기화' 같은 개발 말 | '키오스크에 다시 보내기' — `ae0903a` |
| 키오스크 질문이 루틴 이름을 되풀이(실패널) | 이미 말하면 위 줄 숨김 — `3637cfd` |

보드: 키오스크 = `ae0903a`(실패널 설치), 폰 에뮬레이터 = `ae0903a` APK, 백엔드 RPi5·RPi4 = `9d89e88`(이후 백엔드 변경 없음).
시험(골든 제외): 백엔드+rpi4 3,453 · 폰 910 · 키오스크 553, 골든 폰 55 · 키오스크 61.

3차 평가는 실기기 화면(폰 에뮬레이터 실허브 데이터·15.8형 실패널 캡처)과 골든으로 받는다.

## 5. 3차 평가 — 종합 86.5(폰 84 · 키오스크 89)

실기기 화면(폰 에뮬레이터 실허브 데이터, 15.8형 실패널 캡처)과 골든으로 받음. 남은 감점과 수리:

| 지적 | 수리 | 커밋 |
|---|---|---|
| 키오스크 위쪽 아이콘에 글자가 없어 1~2 m에서 뜻을 모름 | 아이콘 아래 짧은 이름(설정·제안 쉬기·와이파이·작은 팔·콘센트), 큰 글씨에서도 붙지 않게 칸 74 | `ed746d0` |
| 큰 글씨 실행 화면 마지막 줄이 스크롤 아래에서 잘림 | 큰 글씨면 목적 1줄, 위 상태와 같은 말인 확인 문장은 뺌 | `ed746d0` |
| 큰 글씨 연결 창 셋째 할 일이 스크롤해야 보임 | 큰 글씨면 창을 넓히고 줄 간격·여백을 줄임 | `ed746d0` |
| 큰 글씨 제안 '이번엔 안 / 할게요' 두 줄·옆 단추와 높이 다름 | 두 단추 같은 높이, 큰 글씨면 반반 | `ed746d0` |
| '알려 / 왔어요'·'봐 / 주세요'처럼 끝의 짧은 말 묶음이 갈라짐 | 끝의 짧은 두 낱말(앞 2자 이하 + 끝 3자 이하)을 줄 바꾸지 않는 띄어쓰기로 묶음 | `ed746d0` |
| 연습 화면 '연습용 값이에요 — 실제로 잰 값이 아니에요' | '연습이라 실제 전력은 재지 않아요' | `ed746d0` |
| ThinQ 상세 '지금 상태 (연습)'이 '다시 읽기'에 닿음, '업데이트' | 제목은 '지금 상태'(연습은 띠·시각 줄이 말함), 'HH:MM에 읽음'(폰도) | `ed746d0`·`6bb77ba` |
| 다시 시도 경고의 긴 괄호 문장('한 / 번 더') | "…다시 시도하지 마세요. 같은 버튼을 또 누르게 돼요"(폰·키오스크) | `ed746d0`·`6bb77ba` |
| 폰 루틴 탭 모든 줄이 채운 '실행하기' — 위계가 흐려짐 | 홈과 같은 테두리 버튼 | `6bb77ba` |
| 설정 부제 '쉬 / 어요'·'정상 / 인', 12pt 고정 | 어절 줄바꿈(화면 읽기는 원문), 설정·잠시 쉬기의 12pt → 14pt | `6bb77ba` |
| '세기 바꾸기'·'센서 기록 보기'·'업데이트 전에 켠 설정' | '풍량 바꾸기'·'전류·소리 기록 보기'·'예전에 켠 설정' | `6bb77ba` |
| 홈 큰 카드가 왜 맨 위인지 없음 | '바로 실행할 수 있는 루틴' 한 줄 | `e2b5897` |
| 내 가전에서 지울 수 있는 줄은 휴지통만 — 눌러지는 줄과 섞임 | 휴지통 옆에도 화살표 | `e2b5897` |

일부러 두지 않은 것: 키오스크 가전 줄 왼쪽 빈자리는 숨긴 '이전' 화살표 자리(넘길 때 줄이 흔들리지 않게).
설치: 키오스크 실패널 `6bb77ba`(실패널 캡처로 위쪽 이름 확인), 폰 에뮬레이터 `e2b5897` APK. 백엔드는 이번에 바뀐 것 없음.
시험(골든 제외): 폰 911 · 키오스크 565, 골든 폰 55 · 키오스크 61. 수정 전 실패 확인은 파일을 저장소 밖에 복사해 두고 옛 판으로 되돌려 돌렸다(키오스크 8건·폰 9건·폰 2건 실패 → 복원).

## 6. 4차 평가 — 종합 87.75(폰 85.5 · 키오스크 90)

| 지적 | 수리 | 커밋 |
|---|---|---|
| 기록 줄에 출처가 없는 줄('22:04'만) | 늘 출처 — 자동 실행·루틴·직접 실행(서버 기록에 말·승인·화면 구분이 없어 사람이 시작한 것은 '직접 실행'으로 묶음, 지어내지 않음) | `14a4c4d` |
| 키오스크 '종합 보통'인데 보이는 값은 '좋음'뿐 | 미세먼지 등급도 싣고, 종합이 보이는 먼지 등급보다 나쁘면 '종합은 가전이 매긴 등급'(이유를 지어내지 않고 출처만) | `ea7a929`·`8d8bc57`·`79d8fcd`·`15c869a` |
| 큰 글씨 결과 화면은 스크롤이 생기는데 10초 자동 복귀 | 큰 글씨면 20초(글자·실제 전환 같은 값) | `ea7a929` |
| 끝줄 외톨이 낱말('쉬어요'·'누르게 돼요.'·'쓸 / 수 없어요') | 끝 두 낱말 합 6자 이하면 묶고, 그 앞 한 글자 낱말도 함께 | `ea7a929` |
| 제안 근거 '여쭤봐요 · / 기록 3번' | 한 문장 '아침에 3번 하셔서 여쭤봐요' | `ea7a929` |
| 키오스크 뒤로 화살표가 회색·작음 | 공용 뒤로 단추(흰 화살표 + '뒤로' + 테두리, 88×52 이상) | `ea7a929` |
| 비상 중 회색 정지 단추가 눌릴 것처럼 보임 | 못 누를 때는 흐린 테두리, 본문에 '비상 버튼을 풀기 전에는 정지 단추를 쓸 수 없어요'(이름·자리는 디자인 규격상 유지) | `ea7a929` |
| '제안 쉬는 중' 칩이 켜지면 설정이 밀림 | 칩을 맨 앞(날짜 쪽)으로 — 설정·연결 아이콘 자리 고정(설정이 구석이 아니어야 한다는 기존 시험 유지) | `ea7a929` |
| 폰 내 가전: 설정 필요 안내 없음, 지우기·화살표가 붙음 | '설정이 필요해요 · 눌러서 버튼 자리 맞추기', 사이 16 | `14a4c4d` |

하지 않음: 폰 홈 ThinQ 카드 '꺼짐'(다른 가전도 평소엔 상태를 쓰지 않는 규칙 — 문제 상태와 '켜짐'만), 홈 큰 카드 빈자리 채우기.

**실패널에서 잡은 것:** 공기 줄을 넷으로 늘리자 실패널에서 셋째 줄이 잘리고 넷째 줄('공기청정기 꺼짐')이 스크롤 아래로 숨었다.
맑은 고딕 배치 시험으로 재현한 뒤 세 줄로 줄였는데, 값을 넣은 줄('미세먼지 8 · 초미세먼지 8 좋음')은 실패널 글꼴이 더 넓어 끝 글자가 또 잘렸다
— 시험 글꼴(맑은 고딕)과 실패널 글꼴의 폭 차이. 값 없이 '미세·초미세먼지 모두 좋음'으로 줄여 실패널 캡처로 확인했다(값은 ThinQ 상세).
**교훈:** 키오스크 글 폭은 시험 통과만으로 끝내지 않고 실패널 캡처로 확인한다.

설치: 키오스크 실패널 `15c869a`, 폰 에뮬레이터 `14a4c4d`. 시험(골든 제외): 폰 911 · 키오스크 572, 골든 폰 55 · 키오스크 61.
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
