Seongwonp/Simplelay/docs/devlog/devlog_2026-10-24-kiosk-redesign-eval.md

# 2026-10-24 — 키오스크 개편·연속 조작·첫 사용 관점 점검·코드 검토 (데스크톱)

작업 방식(사용자 지시): AI 도구의 별도 세션으로 구현과 첫 사용 관점 검토를 나누고 통합 세션에서 판단·커밋·배포했다. 실제 처음 사용자에게 수행한 시험은 아니다. 아래 점수는 도구의 내부 참고값이다.

## 1. 한 일

| 묶음 | 커밋 | 내용 |
|---|---|---|
| 가전 그림 통일 1단계 | `733cdac8` | 폰 기기 추가·편집 종류 고르기를 그림 카드로, 나머지 화면도 같은 가전 그림 |
| 연속 조작(R7) | `e5a41f3c` | 키오스크에서 직접 고른 가전의 결과 뒤 '‹가전› 계속 조작'·'다른 가전 고르기'. 처음 화면 자동 복귀 없음, 명령을 다시 보내지 않음. 스스로 뜬 제안·이어받은 실행은 종전 |
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
