Seongwonp/Simplelay/app/test/goldens/history_dark.png

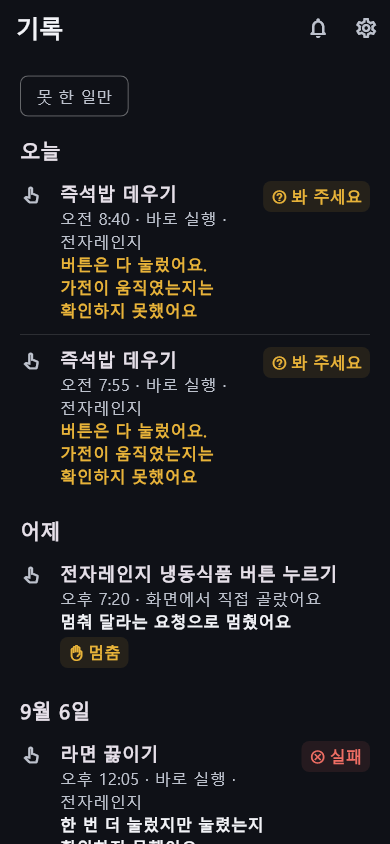
app/test/goldens/history_dark.png
