Seongwonp/Simplelay/app/test/goldens/history_large.png

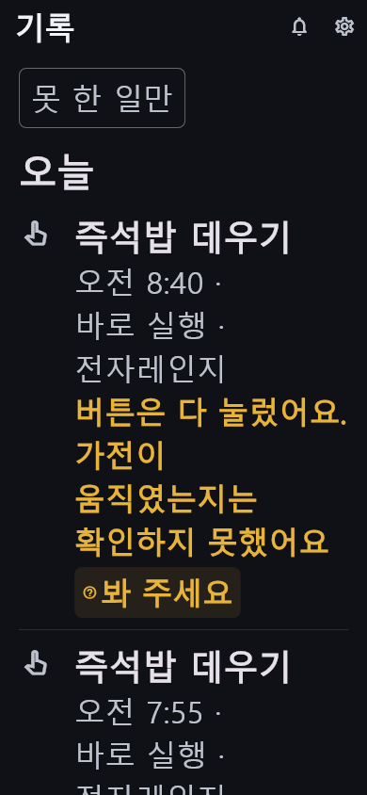
app/test/goldens/history_large.png
