Seongwonp/Simplelay/app/test/goldens/lt_history.png

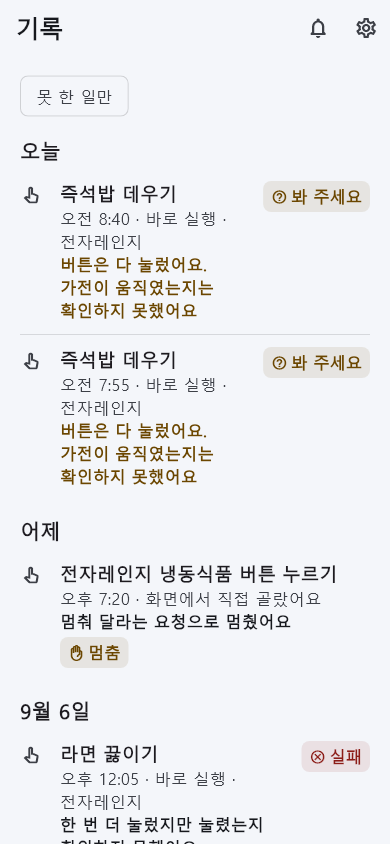
app/test/goldens/lt_history.png
