Seongwonp/Simplelay/app/test/goldens/lt_history_empty.png

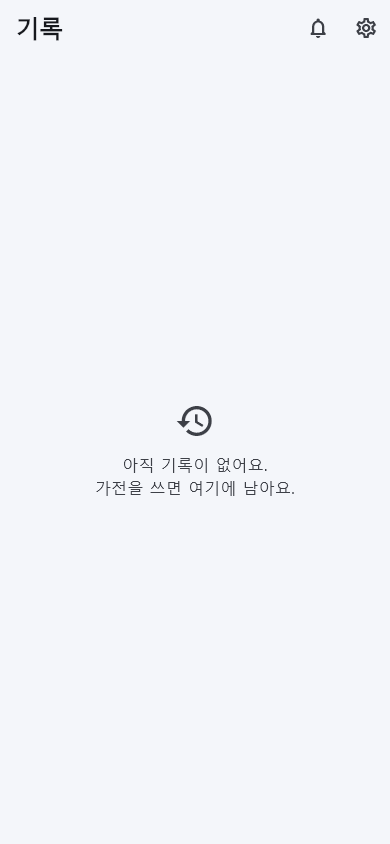
app/test/goldens/lt_history_empty.png
