Seongwonp/Simplelay/docs/submission/img/phone-history-mock.png

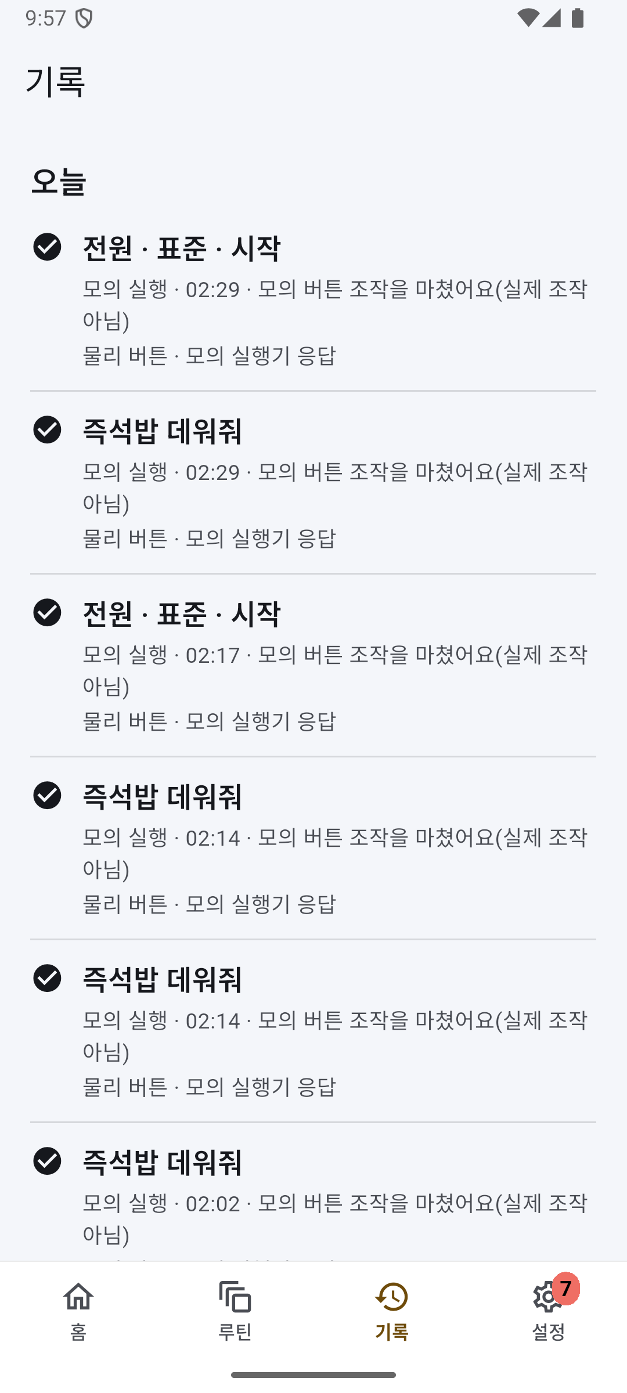
docs/submission/img/phone-history-mock.png
