Seongwonp/Simplelay/docs/submission/img/phone-history-retry-stop.png

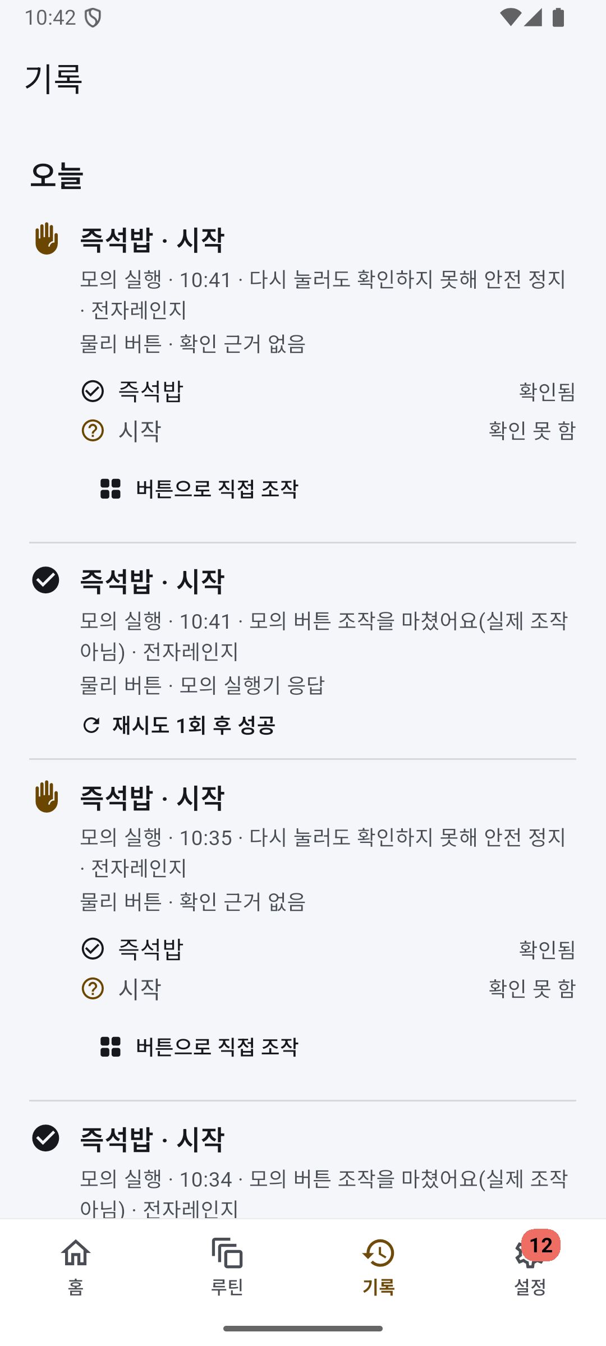
docs/submission/img/phone-history-retry-stop.png
