Seongwonp/Simplelay/docs/ui-review/2026-10-12/p04-history.png

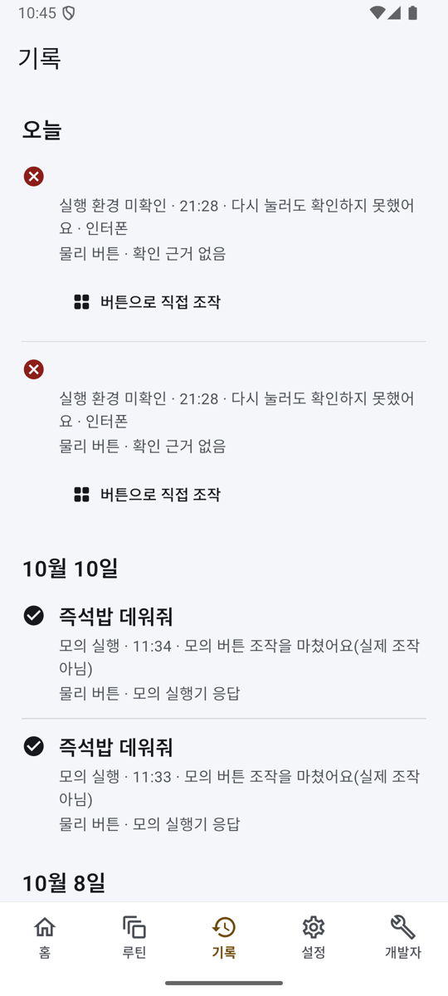
docs/ui-review/2026-10-12/p04-history.png
