Seongwonp/Simplelay/docs/ui-review/2026-10-13/p04-history.png

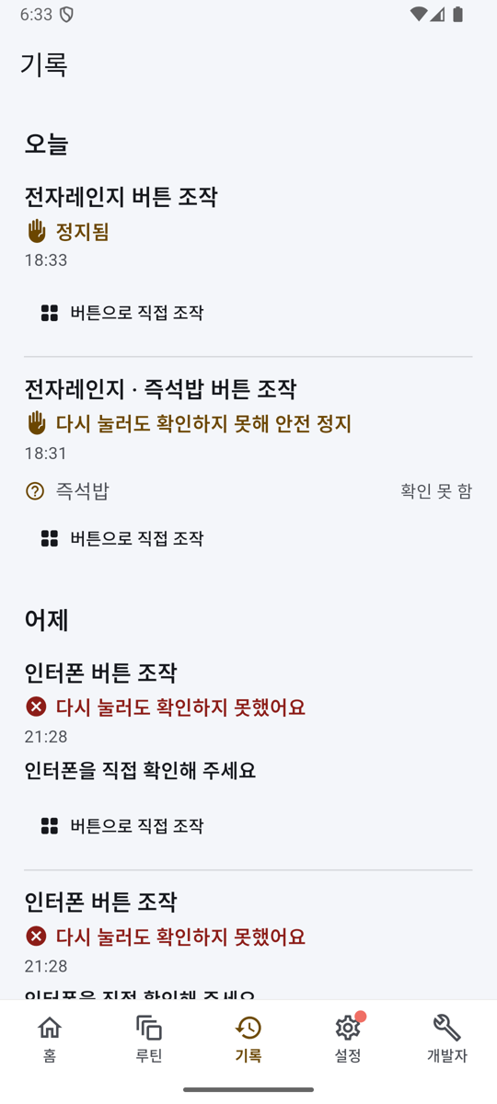
docs/ui-review/2026-10-13/p04-history.png
