Seongwonp/Simplelay/docs/ui-review/2026-10-13/x03-font2-history.png

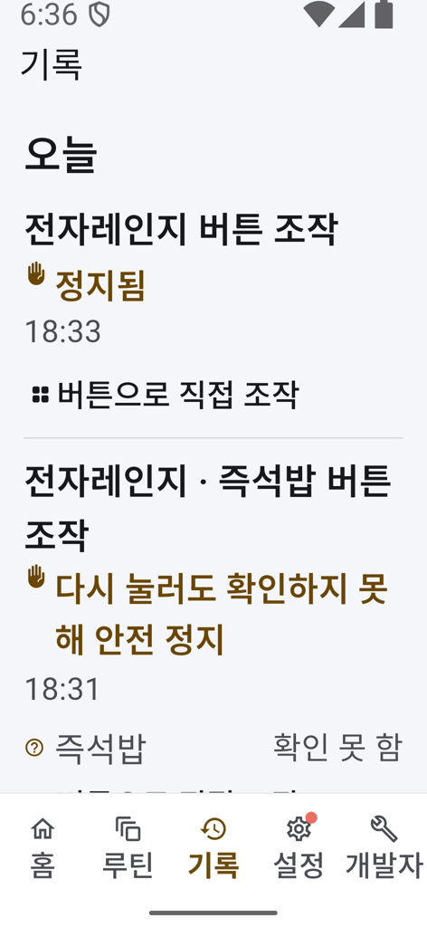
docs/ui-review/2026-10-13/x03-font2-history.png
