Seongwonp/Simplelay/rpi5-touchscreen-app/test/goldens/kiosk15_idle_problem.png

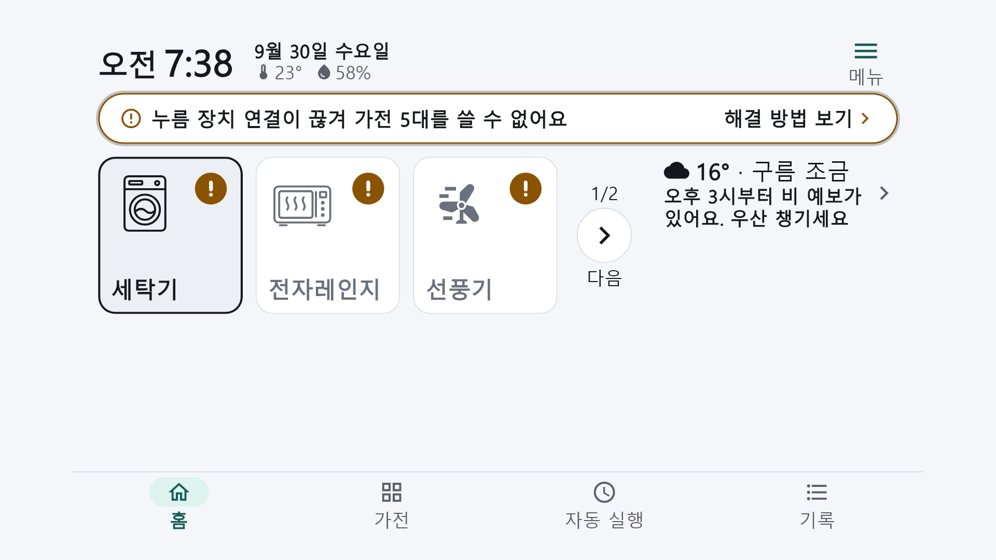
rpi5-touchscreen-app/test/goldens/kiosk15_idle_problem.png
