Seongwonp/Simplelay/rpi5-touchscreen-app/test/goldens/kiosk15_tab_history.png

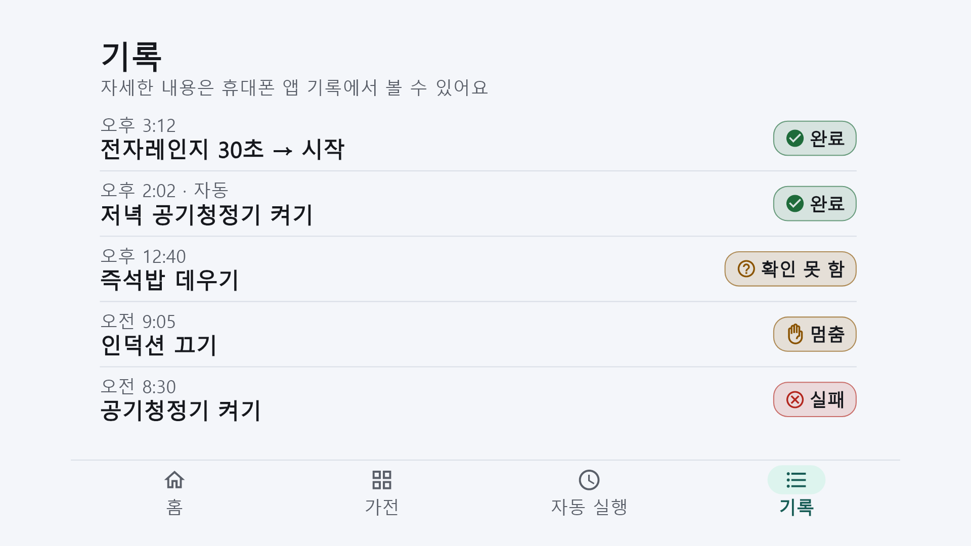
rpi5-touchscreen-app/test/goldens/kiosk15_tab_history.png
