Seongwonp/Simplelay/rpi4/act_main.py

"""RPi4 entry point — opens a UART serial connection to RPi5 and runs ActExecutor.

This is the actual "Act" board per docs/protocol.md: it receives an
already-resolved button sequence from RPi5 and runs it through the closed
loop. It does not talk to ESP32 and does not resolve intent — that is
main.py/UartBridge's job, which (despite living in this package) actually
runs on RPi5. See the note at the top of main.py.

Environment variables:
  SIMPLELAY_UART_PORT             serial device path  (default: /dev/ttyAMA0)
  SIMPLELAY_UART_BAUD             baud rate           (default: 115200)
  SIMPLELAY_LINK_KEY              RPi5↔RPi4 링크 짝 키(2026-10-12, 16자 이상 — 짧으면 시작 거절). RPi5와 같은 값.
                                  있으면 서명된 hello로 세션을 열고 프레임마다 HMAC·seq를 확인한다(docs/protocol.md
                                  "링크 인증"). **없으면 시리얼을 열기 전에 시작을 거절한다**(2026-10-14 보안 점검). 한쪽만 있으면
                                  링크가 안 열린다
  SIMPLELAY_LINK_AUTH             "off_for_mock"이면 키 없이 연다 — 모의 구성 전용. 모션 serial·실물 콘센트 모듈·L3 real·
                                  실센서 중 하나라도 켜져 있으면 시작을 거절한다(_link_real_paths)
  SIMPLELAY_SENSORS_ENABLED       "true" → SensorVerifier (ADS1115 전류 +
                                  마이크 음향 퓨전 검증). 기본 false = mock —
                                  센서 하드웨어 없이도 실행 경로가 살아있어야
                                  하므로 (SIMPLELAY_GPIO_ENABLED와 같은 관례).
                                  켤 때 전류 설정 모순(영전류 전압이 ADC 범위 밖 등)이면 시작을 거절한다
                                  — 기본 2.5 V·gain 2(±2.048 V)는 거절된다(2026-10-07 평가 M2)
  SIMPLELAY_CURRENT_ZERO_V        ADC 입력에서 본 영전류 전압(V, 기본 2.5). 실측 필요
  SIMPLELAY_CURRENT_ADC_GAIN      ADS1115 gain(2/3·1·2·4·8·16, 기본 2). 실측 필요
  SIMPLELAY_L3_NONE_TARGETS       L3 real에서 전력 판정을 하지 않을 대상 가전(쉼표 목록, 예: intercom).
                                  CT 채널 없는 대상은 실행 전 거절(target_unbound)인데, 여기 적은 대상만
                                  판정 없이(operation_confirmed=null) 실행한다(2026-10-07 평가 H3)
  SIMPLELAY_DANGER_SOUND_ENABLED  "true" → 위험소리(경보음) 상시 감지 태스크
                                  가동, 감지 시 RPi5로 alert 자체발신
  SIMPLELAY_MOTION_MODE           "mock"(기본) | "serial". serial이면 선택한 모션 프로토콜
  SIMPLELAY_MOTION_PROTOCOL       "line-json/v0"(기본) | "touchbridge-v2"(HW 담당 원본)
                                  모션 MCU 어댑터(rpi/controller/serial_motion.py,
                                  **실물 미검증**)를 쓴다
  SIMPLELAY_MOTION_PORT           serial 모드의 MCU 시리얼 장치 경로 (기본값 없음)
  SIMPLELAY_MOTION_BAUD           serial 모드의 보드레이트 (기본값 없음 — MCU 펌웨어가 정한다)
  SIMPLELAY_MOTION_*              기구·누름·타임아웃 값. 전부 기본 없음, 비어 있으면
                                  누름을 거절한다(serial_motion.MOTION_ENV_NAMES,
                                  kinematics.ENV_NAMES)
                                  시작 때 MCU가 status에 답하지 않으면(포트 열기로 리셋·부팅 중·케이블)
                                  배경에서 1→2→4…30 s 간격으로 연결을 다시 시도한다. 연결 확인 전의
                                  execute는 ``{"type":"error","reason":"motion_not_ready","detail":…}``로
                                  바로 거절한다(누름을 시도하지 않는다).
  SIMPLELAY_KIT_ID                누름 장치 세트 ID를 직접 정한다(없으면 데이터 폴더의 kit_id를 쓰고, 없으면 한 번 만든다).
  SIMPLELAY_ACT_DATA_DIR          세트 ID를 둘 데이터 폴더(기본 /data — 재시작·이미지 교체에도 남는 곳).
  SIMPLELAY_MOTION_HEARTBEAT_MS   "off"면 시작 때 경고 — 2 s 넘는 동작은 MCU 워치독에 끊긴다
                                  (serial 모드면 RPi5 개발자 조작(dev_motion 프레임, 2026-10-10)도 같은 어댑터로 받고
                                  act_info.dev_motion_protocol로 알린다 — RPi5가 SIMPLELAY_DEV_REAL_MOTION=1일 때만 보낸다.
                                  조그 한 번 10 mm 울타리·원점 전 거절·시간 누름 800 ms 상한·bring-up 펌웨어 거절)
  SIMPLELAY_RECORDER_PATH         설정하면 누름 주변 원시 기록기를 켠다(기본 꺼짐).
                                  .csv면 CSV, 그 밖은 JSONL로 **이어 쓴다**. 누름 호출
                                  앞뒤(press_start/press_end)와 모션 MCU 이벤트(mcu_*)를
                                  같은 시각축에 찍는다(rpi/verifier/recorder.py)
  SIMPLELAY_RECORDER_PRE_S        창 모드: press_start 전 보존(초). POST_S와 함께 준다.
  SIMPLELAY_RECORDER_POST_S       비우면 전부 기록(파일이 계속 커진다) — 창 길이는 측정 필요
  SIMPLELAY_RECORDER_ADC_GAIN     전류(ADS1115) gain. 없으면 전류는 합성(mock_current)
  SIMPLELAY_RECORDER_ADC_CHANNEL  ADS1115 채널 0~3 (기본 0)
  SIMPLELAY_RECORDER_AUDIO        "true"면 마이크를 연다. 아니면 합성(mock_audio)
  (전력은 콘센트 모듈이 있으면 그 스트림, 없으면 합성 mock_power. 합성 입력은 시작 로그에 경고로 남는다)
  SIMPLELAY_L3_MODE               L3(가전 동작) 검증기. "off"(기본) = 없음 → 결과 프레임의
                                  operation_confirmed는 null. "mock" = MockPowerSensor 합성
                                  파형으로 판정(operation_source=mock, 실제 근거 아님).
                                  "real" = 콘센트 모듈 전력 스트림으로 판정. SIMPLELAY_OUTLET_PORT가
                                  없으면 **시작을 거절**(실물 미검증 — 2026-10-05 가짜 출력으로만 시험)
  SIMPLELAY_OUTLET_PORT           콘센트 모듈(ESP32 CT·릴레이, firmware-outlet) USB 시리얼 장치. 기본 없음.
                                  "fake"면 가짜 출력(rpi/tools/fake_outlet.py) — 판정은 모의로 표시
  SIMPLELAY_OUTLET_BAUD           콘센트 모듈 보드레이트(fake가 아니면 필수, 펌웨어 HOST_SERIAL_BAUD와 같게)
  SIMPLELAY_OUTLET_CHANNELS       CT 채널 → 가전(2026-10-06 두 번째 CT, 예: microwave:0,washer:1). 비우면 모든 가전이
                                  채널 0(CT 하나 시절과 같다) — **전력을 읽는 가전이 둘 이상이면 시작을 거절한다**
                                  (2026-10-06 평가 A1: L3·기록기·실물 모션의 정지 확인은 microwave, 세탁 끝 관찰은 그 가전).
                                  주면 이름이 빠진 가전도 거절한다. 릴레이는 하나이고 전자레인지 채널만 끊는다(세탁기는
                                  릴레이를 거치지 않게 배선) — 모듈이 알린 relay_ch가 microwave 채널과 다르거나, 대응한
                                  채널이 모듈에 없으면 시작을 거절하고(평가 A2), 실행 중 바뀌면 execute를 outlet_offline으로 거절
  SIMPLELAY_FAKE_OUTLET_RELAY_CH  fake 모듈의 릴레이 채널(기본 0 = 펌웨어 OUTLET_RELAY_CH 기본). 대응에서 베끼지 않는다
  SIMPLELAY_FAKE_OUTLET_CHANNELS  fake 모듈의 CT 채널 수(기본 = 대응의 가장 큰 채널 + 1)
  SIMPLELAY_OUTLET_RELAY_ON_START "1"이면 연결 뒤 relay_on을 보낸다. 기본은 보내지 않는다 — 모듈 부팅 기본이
                                  릴레이 꺼짐(fail-safe)이라, 켜기는 사람이 정한 설정으로만. 모듈이 비상정지
                                  걸림을 보고하거나(ready·status estop) 상태를 확인하지 못하면 보내지 않는다.
                                  켜 둔 뒤 모듈이 재부팅해 꺼지면 **다시 켜지 않고** 걸림(source=outlet_reboot,
                                  "가전 콘센트 장치가 다시 켜져 가전 전원이 꺼져 있어요 — 해제하면 전원을 다시 켜요")으로 두며,
                                  RPi5 POST /stop/ack(estop_ack) 뒤에만 켠다(2026-10-06 평가 A4)
  SIMPLELAY_OUTLET_STALE_MS       전력 샘플 끊김 판단(기본 1000). 넘으면 L3는 '센서를 읽지 못함'으로 안전 정지
  SIMPLELAY_OUTLET_HEARTBEAT_MS   모듈로 ping 간격(기본 1000, 0/off = 끔)
  SIMPLELAY_OUTLET_STATUS_POLL_MS 모듈 status 조회 간격(기본 2000, 0/off = 끔) — 응답의 estop을 반영한다
  SIMPLELAY_OUTLET_OFFLINE_MS     어떤 줄도 이만큼 못 받으면 모듈 무응답(기본 3000) — 그동안 execute는
                                  ``outlet_offline``으로 거절(비상정지를 볼 수 없으므로). 포트 오류면 backoff로 다시 연다
  SIMPLELAY_OUTLET_MIN_SAMPLES    power 줄 창 샘플 수 하한(기본 20, 측정 필요) — 미달 줄은 버린다
  SIMPLELAY_OUTLET_MAX_ERR_RATIO  power 줄 판독 실패 비율 상한(기본 0.1, 측정 필요)
  (비상정지 걸림: 모듈 estop을 받으면 RPi4가 걸린 채로 있고, RPi5 POST /stop/ack → estop_ack로만 풀린다)
  SIMPLELAY_TAIL_*                잔여 전류 꼬리 기준(rpi/verifier/power_tail.py TAIL_ENV_NAMES, 전부 측정 필요).
                                  L3 확인 뒤 progress {phase:"power_tail"}와 기록기 power_tail 행으로 남긴다
  SIMPLELAY_DONE_WATCH            가전 끝 관찰(2026-10-06, 실물 미검증) — ``<가전 ID>:outlet[,mic][;…]``
                                  (예: washer:outlet,mic;microwave:outlet). 가전마다 그 CT 채널을 읽는다(OUTLET_CHANNELS).
                                  outlet = 콘센트 모듈 CT 전력 하강(SIMPLELAY_OUTLET_PORT 필수), mic = 종료음(마이크, 한 가전만).
                                  끝 이벤트: 세탁기 wash_complete · 전자레인지 heat_complete(RPi5 wait_until_done이 기다린다).
                                  가전별 기준은 SIMPLELAY_CYCLE_<가전>_<항목>(예: SIMPLELAY_CYCLE_MICROWAVE_SETTLE_S)이 이긴다.
                                  둘이 SIMPLELAY_DONE_FUSION_WINDOW_S 안에서 맞으면 done_confirmed, 하나면 *_only로
                                  ``appliance_done`` 프레임을 RPi5에 보낸다. 릴레이 명령은 보내지 않는다(CT 계측만).
                                  기준값 SIMPLELAY_CYCLE_*·SIMPLELAY_BEEP_*·SIMPLELAY_DONE_FUSION_*·_COOLDOWN_S 전부 측정 필요
  SIMPLELAY_L3_MOCK_OUTCOME       mock 모드의 합성 결과 "confirmed"(기본) | "unconfirmed"
  SIMPLELAY_MOTION_LOG_PATH       설정하면 모션 MCU와 주고받은 **원시 줄**을 이어 쓴다(기본 꺼짐).
                                  형식은 `python -m rpi.tools.jog --log`와 같고(보냄 ``>>``,
                                  받음 ``<<``) 두 번째 칸이 ``mono_ns=<monotonic ns>``다. 실행마다
                                  ``## job_start {"sequence_id":…}`` / ``## job_end …`` 줄을 찍는다.
                                  원시 기록기(SIMPLELAY_RECORDER_PATH)에도 같은 순간 ``job_start``·
                                  ``job_end`` 이벤트(note에 sequence_id)를 찍어 둘을 이을 수 있다.
  SIMPLELAY_ACT_PROGRESS          "0"이면 누름마다의 progress 프레임을 보내지 않는다(기본 보냄).
  SIMPLELAY_HOLD_STOP_CONFIRM_S   정지 버튼을 누른 뒤 전력 하강을 기다리는 시간(기본 5, 설계 초기값)
  SIMPLELAY_HOLD_MAX_S            정지 버튼 위 최대 대기(기본 1800, 설계 초기값)
  SIMPLELAY_HOLD_PRESS_GAP_S      정지 버튼 연속 누름 간격(기본 0.6, 설계 초기값)
  SIMPLELAY_HOLD_MOCK_RUN_S       mock 모션일 때 모의 가전 동작 시간(기본 30)
  SIMPLELAY_HOLD_MOCK_STOP        honor(기본) | ignore — 모의 가전이 정지 버튼에 반응하는지
                                  (정지 대기·보관·확인 주행: rpi4/services/stop_hold.py, 실물 미검증.
                                  serial 모드는 전력 리더가 없어 정지 판정이 늘 '미확인'이다)

Usage:
  python -m rpi4.act_main
"""

from __future__ import annotations

import asyncio
import contextlib
import logging
import os
import sys
import threading
from collections.abc import Callable
from typing import TYPE_CHECKING, TextIO

from rpi.controller import ClosedLoopController
from rpi.controller.mock import MockAlertSink, MockGrblClient, MockSafetyController
from rpi.controller.ports import GrblClient, SafetyController
from rpi.services.demo_failure import DemoFailureState, FailureInjectionVerifier
from rpi.verifier import MockVerifier, Verifier

from .services.act_executor import ActExecutor

if TYPE_CHECKING:
    from rpi.tools.jog import LineLog
    from rpi.verifier.recorder import LiveRecorder

SERIAL_PORT = os.getenv("SIMPLELAY_UART_PORT", "/dev/ttyAMA0")
BAUD_RATE = int(os.getenv("SIMPLELAY_UART_BAUD", "115200"))


def _flag(name: str) -> bool:
    return os.getenv(name, "false").strip().lower() == "true"

logging.basicConfig(
    level=logging.INFO,
    format="%(asctime)s [%(levelname)s] %(name)s: %(message)s",
    datefmt="%H:%M:%S",
    stream=sys.stdout,
)
log = logging.getLogger(__name__)


def _build_verifier() -> Verifier:
    """SIMPLELAY_SENSORS_ENABLED=true면 실제 센서 퓨전 검증, 아니면 mock.

    SensorVerifier의 하드웨어 리더(Ads1115Reader·SounddeviceReader)는 생성
    시점에 장치를 연다 — 센서가 없는 보드에서 기본값이 mock이어야 실행
    경로 자체가 죽지 않는다.
    """
    if _flag("SIMPLELAY_SENSORS_ENABLED"):
        from rpi.verifier import SensorConfig, SensorVerifier
        from rpi.verifier.config import check_current_sensor_config, current_sensor_config_from_env

        # 장치를 열기 전에 ADC 범위를 벗어난 설정을 거절한다.
        # 기본값(2.5 V·gain 2)은 이 검사에 걸린다 — 분압 회로 확인 뒤 env로 맞춘다(실측 필요).
        current = current_sensor_config_from_env()
        check_current_sensor_config(current)
        log.info("SensorVerifier active — ADS1115 current + microphone fusion "
                 "(zero=%s V, gain=%s — 실측 필요)", current.zero_current_voltage, current.ads_gain)
        return SensorVerifier(SensorConfig(current=current))
    log.info("MockVerifier active (set SIMPLELAY_SENSORS_ENABLED=true for real sensors)")
    return MockVerifier(outcomes=[True] * 1000)


def _open_motion_transport(port: str, baud: int):
    """실기기 시리얼 전송. 테스트는 이 함수를 바꿔 끼운다."""
    from rpi.controller.serial_motion import PySerialLineTransport

    return PySerialLineTransport(port, baud)


#: 연결 재시도 간격(초). 마지막 값에서 멈춰 그 간격으로 계속한다. 호스트 박자라 기구 값이 아니다.
MOTION_CONNECT_BACKOFF_S = (1.0, 2.0, 4.0, 8.0, 16.0, 30.0)


class MotionConnectRetry:
    """시작 때 연결 확인에 실패한 모션 MCU를 배경 스레드에서 다시 연결한다.

    ``client.connect()``가 성공할 때까지 backoff 간격으로 부른다(설정 누락은 재시도로 풀리지 않아
    부르지 않는다). 그동안 ``client.not_ready_reason()``이 이유를 돌려주고 ActExecutor가 execute를
    ``motion_not_ready``로 거절한다 — 조용히 누름마다 실패하지 않는다.
    """

    def __init__(self, client, backoff_s: tuple[float, ...] | None = None) -> None:
        self._client = client
        self._backoff_s = backoff_s or MOTION_CONNECT_BACKOFF_S
        self._stop = threading.Event()
        self._thread = threading.Thread(target=self._loop, daemon=True, name="motion-connect-retry")
        self.attempts = 0
        self.connected = threading.Event()

    def start(self) -> "MotionConnectRetry":
        self._thread.start()
        return self

    def stop(self) -> None:
        self._stop.set()

    def join(self, timeout: float | None = None) -> None:
        self._thread.join(timeout)

    def _loop(self) -> None:
        from rpi.controller.serial_motion import MotionError

        index = 0
        while True:
            wait = self._backoff_s[min(index, len(self._backoff_s) - 1)]
            index += 1
            if self._stop.wait(wait):
                return
            self.attempts += 1
            try:
                status = self._client.connect()
            except (MotionError, RuntimeError, OSError) as exc:
                log.warning("motion MCU still not ready (retry %d, next in %.0fs): %s", self.attempts,
                            self._backoff_s[min(index, len(self._backoff_s) - 1)], exc)
                continue
            log.info("motion MCU connected on retry %d: state=%s homed=%s", self.attempts, status.state, status.homed)
            self.connected.set()
            return


#: act_main이 띄운 연결 재시도(없으면 None). 종료 때 멈춘다. 시험이 들여다본다.
_motion_retry: MotionConnectRetry | None = None


#: 포트 재연결 백오프와 감시 주기(초). 테스트에서 교체할 수 있다.
MOTION_REOPEN_BACKOFF_S = (0.5, 1.0, 2.0, 4.0, 8.0)
MOTION_WATCH_INTERVAL_S = 0.5


class MotionLinkWatch:
    """USB 재열거·EIO로 잃은 모션 포트를 설정 경로로 다시 열고 연결을 확인한다(2026-10-14, 보드 날 발견 1).

    전송(`ReopeningLineTransport`)이 끊김을 알리면 깨어나, 백오프에 맞춰 ``try_reopen`` → ``client.connect()``를 한다.
    그동안 ``client.not_ready_reason()``이 이유를 돌려주고 ActExecutor가 execute를 ``motion_not_ready``로 거절한다.
    다시 붙어도 이번 실행의 자동 재홈·재누름 차단은 그대로다(사람의 다음 요청에서만 풀림). **실물 재열거 미검증.**
    """

    def __init__(self, transport, client, interval_s: float | None = None) -> None:
        self._transport = transport
        self._client = client
        self._interval_s = MOTION_WATCH_INTERVAL_S if interval_s is None else interval_s
        self._stop = threading.Event()
        self._wake = threading.Event()
        self._thread = threading.Thread(target=self._loop, daemon=True, name="motion-link-watch")
        self.reconnects = 0

    def start(self) -> "MotionLinkWatch":
        self._thread.start()
        return self

    def stop(self) -> None:
        self._stop.set()
        self._wake.set()

    def wake(self) -> None:
        self._wake.set()

    def _loop(self) -> None:
        from rpi.controller.serial_motion import MotionError

        while not self._stop.is_set():
            self._wake.wait(self._interval_s)
            self._wake.clear()
            if self._stop.is_set():
                return
            if not getattr(self._client, "needs_reconnect", False):
                continue
            if self._transport.link_down_reason is not None and not self._transport.try_reopen():
                continue
            try:
                status = self._client.connect()
            except (MotionError, RuntimeError, OSError) as exc:
                log.warning("motion MCU not back yet after port loss: %s", exc)
                continue
            self.reconnects += 1
            log.warning("motion MCU reconnected after port loss: state=%s homed=%s (원점 전이면 누름 거절)",
                        status.state, status.homed)


#: act_main이 띄운 포트 감시(없으면 None). 종료 때 멈춘다. 시험이 들여다본다.
_motion_watch: MotionLinkWatch | None = None


def _motion_readiness(grbl: object) -> "Callable[[], str | None] | None":
    """모션 어댑터가 준비 이유를 알려 주면 그 함수를(없으면 None — mock은 늘 준비됨)."""
    reason = getattr(grbl, "not_ready_reason", None)
    return reason if callable(reason) else None


def _build_motion_log() -> "tuple[LineLog, TextIO] | None":
    """SIMPLELAY_MOTION_LOG_PATH가 있으면 모션 MCU 원시 줄 기록을 연다(기본 꺼짐).

    켜짐/꺼짐과 경로를 항상 시작 로그에 남긴다. jog CLI의 줄 형식을 그대로 쓰되 시각
    칸은 monotonic ns — 원시 기록기·progress 프레임과 같은 시각축이다.
    """
    path = os.getenv("SIMPLELAY_MOTION_LOG_PATH", "").strip()
    if not path:
        log.info("motion line log off (set SIMPLELAY_MOTION_LOG_PATH to append raw MCU serial lines)")
        return None
    import pathlib

    from rpi.tools.jog import LineLog

    target = pathlib.Path(path)
    target.parent.mkdir(parents=True, exist_ok=True)
    stream = open(target, "a", encoding="utf-8")
    log.info("motion line log ON -> %s (>> sent, << received, ## job markers; mono_ns time base)", target)
    return LineLog(stream, monotonic=True), stream


def _job_observer(recorder: "LiveRecorder | None", line_log: "LineLog | None"):
    """ActExecutor의 job_start/job_end를 모션 줄 기록과 원시 기록기에 같은 sequence_id로 찍는다."""
    if recorder is None and line_log is None:
        return None
    import json

    def observe(event: str, fields: dict) -> None:
        if line_log is not None:
            line_log.write("##", f"{event} {json.dumps(fields, ensure_ascii=False)}")
        if recorder is not None:
            note = f"sequence_id={fields.get('sequence_id')}"
            if "outcome" in fields:
                note += f" outcome={fields['outcome']}"
            recorder.recorder.mark(event, note)

    return observe


def _build_motion(on_event=None, line_log: "LineLog | None" = None) -> tuple[GrblClient, SafetyController]:
    """SIMPLELAY_MOTION_MODE=serial이면 모션 MCU 어댑터, 아니면(기본) mock.

    serial 어댑터는 **실물 미검증**이다. 포트·보드레이트가 없으면 시작을
    거절한다(추측한 장치로 열지 않는다). 기구·누름·타임아웃 값이 비어 있으면
    시작은 하되 누름마다 거절하고, 무엇이 비었는지 시작 로그에 남긴다.
    """
    mode = os.getenv("SIMPLELAY_MOTION_MODE", "mock").strip().lower() or "mock"
    if mode == "mock":
        log.info("MockGrblClient active (set SIMPLELAY_MOTION_MODE=serial for the motion MCU)")
        if line_log is not None:
            log.warning("motion line log has no MCU lines in mock mode (job markers only)")
        return MockGrblClient(), MockSafetyController()
    if mode != "serial":
        raise RuntimeError(f"unknown SIMPLELAY_MOTION_MODE={mode!r} (mock | serial)")

    from rpi.controller.serial_motion import (
        MotionConfig,
        MotionConfigError,
        MotionError,
        MotionSafetyController,
        ReopeningLineTransport,
        SerialMotionClient,
        heartbeat_off_warning,
    )

    port = os.getenv("SIMPLELAY_MOTION_PORT", "").strip()
    baud_raw = os.getenv("SIMPLELAY_MOTION_BAUD", "").strip()
    if not port or not baud_raw:
        raise RuntimeError(
            "SIMPLELAY_MOTION_MODE=serial에는 SIMPLELAY_MOTION_PORT와 "
            "SIMPLELAY_MOTION_BAUD가 필요합니다(기본값 없음)"
        )
    protocol = os.getenv("SIMPLELAY_MOTION_PROTOCOL", "line-json/v0").strip() or "line-json/v0"
    if protocol == "touchbridge-v2":
        from rpi.controller.touchbridge_motion import TouchBridgeConfig, TouchBridgeMotionClient

        config = TouchBridgeConfig.from_env()
        client_type = TouchBridgeMotionClient
    elif protocol == "line-json/v0":
        config = MotionConfig.from_env()
        client_type = SerialMotionClient
    else:
        raise RuntimeError(f"unknown SIMPLELAY_MOTION_PROTOCOL={protocol!r}")
    baud = int(baud_raw)
    if not port.startswith("/dev/serial/by-id/") and "://" not in port:  # socket:// 모의 보드는 USB가 아니다
        # 10/13 보드 날: 모터 전원 투입 때 ESP32가 ttyACM0 → ttyACM1로 다시 잡혀 실행기가 죽은 포트를 붙잡았다.
        log.warning("SIMPLELAY_MOTION_PORT=%s — USB 재열거 뒤 이름이 바뀔 수 있어요. "
                    "/dev/serial/by-id/… 경로를 쓰세요(docs/결선-운영-런북.md)", port)
    # 시작 때 못 열면 종전대로 기동 실패. 연 뒤에 잃으면(EIO·포트 사라짐) 닫고 같은 경로로 다시 연다.
    reopening = ReopeningLineTransport(lambda: _open_motion_transport(port, baud), describe=port,
                                       initial=_open_motion_transport(port, baud),
                                       backoff_s=MOTION_REOPEN_BACKOFF_S)
    transport = reopening
    if line_log is not None:
        from rpi.tools.jog import LoggingTransport

        transport = LoggingTransport(transport, line_log)
    client = client_type(transport, config, on_event=on_event)
    # 모의 보드(rpi/tools/touchbridge_sim.py)에 붙였으면 결과를 '연습'으로 남긴다 — 실제 누름 기록과 섞이지 않게(10/24).
    # 네트워크 주소(socket://)일 때만 받는다: USB 장치 경로는 언제나 실물이다.
    if "://" in port and os.getenv("SIMPLELAY_MOTION_SIMULATED", "").strip().lower() in ("1", "true", "yes"):
        from rpi.controller.models import ExecutionMode

        client.execution_mode = ExecutionMode.MOCK
        log.warning("motion %s는 모의 보드 — 결과를 연습(mock)으로 기록합니다", port)
    global _motion_watch
    if _motion_watch is not None:
        _motion_watch.stop()
    watch = MotionLinkWatch(reopening, client)

    def link_down(reason: str) -> None:
        client.note_link_down(reason)
        watch.wake()

    reopening.set_link_listener(link_down)
    _motion_watch = watch.start()
    warning = heartbeat_off_warning(config) if protocol == "line-json/v0" else None
    if warning:
        log.warning("%s", warning)
    global _motion_retry
    if _motion_retry is not None:
        _motion_retry.stop()
        _motion_retry = None
    try:
        status = client.connect()
        log.info("motion MCU on %s: state=%s homed=%s (실물 미검증 어댑터)", port, status.state, status.homed)
    except MotionConfigError as exc:
        # 설정 누락은 다시 시도해도 풀리지 않는다 — 준비 안 됨으로 남긴다.
        log.error("motion MCU status check impossible on %s: %s", port, exc)
    except (MotionError, RuntimeError, OSError) as exc:
        # 연결 확인 실패 = 준비 안 됨. 배경에서 다시 연결하고, 그동안 execute는 motion_not_ready로 거절한다.
        log.error("motion MCU status check failed on %s: %s — retrying in background", port, exc)
        _motion_retry = MotionConnectRetry(client).start()
    missing = config.missing_for_press(client.z_mode)
    if missing:
        log.warning("motion config incomplete — every press will be refused: %s", ", ".join(missing))
    return client, MotionSafetyController(client)


def _optional_float(name: str) -> float | None:
    raw = os.getenv(name, "").strip()
    if not raw:
        return None
    try:
        return float(raw)
    except ValueError as exc:
        raise RuntimeError(f"{name} 값을 숫자로 읽을 수 없습니다: {raw!r}") from exc


def _build_recorder(outlet=None) -> "LiveRecorder | None":
    """SIMPLELAY_RECORDER_PATH가 있으면 원시 기록기를 연다(기본 꺼짐).

    켜짐/꺼짐과 경로를 항상 시작 로그에 남긴다. 합성으로 대체된 입력은 경고로 남긴다 —
    기록 파일에서도 source가 ``mock_*``라 실측과 섞이지 않는다.
    """
    path = os.getenv("SIMPLELAY_RECORDER_PATH", "").strip()
    if not path:
        log.info("press recorder off (set SIMPLELAY_RECORDER_PATH to record raw samples around presses)")
        return None

    from rpi.verifier.recorder import LiveRecorder

    pre_s = _optional_float("SIMPLELAY_RECORDER_PRE_S")
    post_s = _optional_float("SIMPLELAY_RECORDER_POST_S")
    channel_raw = os.getenv("SIMPLELAY_RECORDER_ADC_CHANNEL", "0").strip() or "0"
    try:
        live = LiveRecorder(
            path,
            pre_s=pre_s,
            post_s=post_s,
            adc_gain=_optional_float("SIMPLELAY_RECORDER_ADC_GAIN"),
            adc_channel=int(channel_raw),
            audio=_flag("SIMPLELAY_RECORDER_AUDIO"),
            **({"power_sensor": outlet.sensor(), "power_mock": bool(outlet.mock),
                "power_reason": "콘센트 모듈(가짜 출력)" if outlet.mock else "콘센트 모듈 USB 시리얼"}
               if outlet is not None else {}),
        )
    except ValueError as exc:
        raise RuntimeError(f"recorder config invalid: {exc}") from exc
    window = f"window pre_s={pre_s} post_s={post_s}" if live.recorder.windowed else "no window (records everything)"
    log.info("press recorder ON -> %s (%s)", live.path, window)
    for choice in live.sources:
        if choice.mock:
            log.warning("press recorder source %s is MOCK (synthetic, not measured): %s", choice.kind, choice.reason)
        else:
            log.info("press recorder source %s is real: %s", choice.kind, choice.reason)
    return live


def _open_outlet_transport(port: str, baud: int):
    """콘센트 모듈 실기기 시리얼 전송. 테스트는 이 함수를 바꿔 끼운다."""
    from rpi.controller.serial_motion import PySerialLineTransport

    return PySerialLineTransport(port, baud)


#: act_main이 띄운 가짜 콘센트 모듈(SIMPLELAY_OUTLET_PORT=fake). 시험이 들여다본다.
_fake_outlet = None


def _press_reads_outlet() -> bool:
    """누르는 가전(전자레인지)의 CT 채널을 읽는 소비자가 있나: L3 real, 원시 기록기, 실물 모션의 정지 확인."""
    l3 = (os.getenv("SIMPLELAY_L3_MODE", "off") or "off").strip().lower()
    motion = (os.getenv("SIMPLELAY_MOTION_MODE", "mock") or "mock").strip().lower()
    return (l3 == "real" or bool(os.getenv("SIMPLELAY_RECORDER_PATH", "").strip())
            or motion == "serial")


def _outlet_consumers() -> tuple[str, ...]:
    """콘센트 전력을 읽을 가전 ID(중복 없음) — 누르는 가전 + SIMPLELAY_DONE_WATCH의 outlet 입력 가전."""
    from .services.appliance_done_watch import parse_done_watches

    consumers: list[str] = [_outlet_press_appliance()] if _press_reads_outlet() else []
    for spec in parse_done_watches(os.getenv("SIMPLELAY_DONE_WATCH")):
        if "power" in spec.inputs and spec.appliance_id not in consumers:
            consumers.append(spec.appliance_id)
    return tuple(consumers)


def _env_int(name: str, default: int) -> int:
    raw = os.getenv(name, "").strip()
    if not raw:
        return default
    try:
        return int(raw)
    except ValueError as exc:
        raise RuntimeError(f"{name} 값을 정수로 읽을 수 없습니다: {raw!r}") from exc

#: 갠트리가 누르고 릴레이가 끊는 가전 — L3·잔여 전류 꼬리·정지 확인·기록기가 이 가전의 CT 채널을 읽는다.
OUTLET_PRESS_APPLIANCE = "microwave"


def _outlet_press_appliance() -> str:
    """릴레이·기록기 대상 등록 ID. 미설정이면 기존 내장 전자레인지 ID를 유지한다."""
    from .models.act_messages import _APPLIANCE_ID

    target = os.getenv("SIMPLELAY_OUTLET_PRESS_APPLIANCE", OUTLET_PRESS_APPLIANCE).strip()
    if not _APPLIANCE_ID.fullmatch(target):
        raise RuntimeError("SIMPLELAY_OUTLET_PRESS_APPLIANCE에 유효한 가전 ID가 필요합니다")
    return target


def _outlet_estop_ignored() -> bool:
    return os.getenv("SIMPLELAY_OUTLET_IGNORE_ESTOP", "").strip() in ("1", "true", "yes")


def _outlet_channel_map():
    from rpi.verifier.outlet import outlet_channels_from_env

    return outlet_channels_from_env()


def _outlet_view(outlet, appliance_id: str):
    """콘센트 링크에서 가전 하나의 CT 채널 보기(없으면 None). 대응이 있는데 가전이 빠지면 RuntimeError."""
    if outlet is None:
        return None
    if not callable(getattr(outlet, "channel", None)):
        return outlet  # 이미 채널 보기(또는 시험용 대역)
    return outlet.channel(_outlet_channel_map().channel_for(appliance_id))


def _build_outlet():
    """SIMPLELAY_OUTLET_PORT가 있으면 콘센트 모듈 링크를 연다(없으면 None). **실물 미검증.**

    fake면 가짜 출력에 붙고 링크를 ``mock=True``로 표시한다. 연결 확인(부팅 배너·status)에 실패해도
    시작은 한다 — 샘플이 오지 않으면 L3가 '센서를 읽지 못함'으로 멈추므로 숨겨지지 않는다.
    """
    global _fake_outlet
    port = os.getenv("SIMPLELAY_OUTLET_PORT", "").strip()
    if not port:
        log.info("outlet module off (set SIMPLELAY_OUTLET_PORT for the ESP32 CT/relay module)")
        return None
    from rpi.verifier.outlet import OutletConfig, OutletError, OutletLink, require_outlet_channels

    config = OutletConfig.from_env()
    channels = _outlet_channel_map()
    consumers = _outlet_consumers()
    # 포트를 열기 전에 대응을 확인한다(평가 A1) — 두 가전이 채널 0을 같이 읽는 구성은 시작하지 않는다.
    require_outlet_channels(channels, consumers)
    if port.lower() == "fake":
        from rpi.tools.fake_outlet import open_fake_outlet

        # 릴레이 채널은 대응에서 베끼지 않는다(평가 A2) — 펌웨어처럼 기본 0, 다르면 env로 준다.
        count = _env_int("SIMPLELAY_FAKE_OUTLET_CHANNELS", max(channels.channels, default=0) + 1)
        relay_ch = _env_int("SIMPLELAY_FAKE_OUTLET_RELAY_CH", 0)
        pipe, _fake_outlet = open_fake_outlet(**({"channels": count, "relay_channel": relay_ch}
                                                 if count > 1 or relay_ch else {}))
        link = OutletLink(pipe.host, config, mock=True).start()
        log.warning("outlet module is FAKE (synthetic power, rpi/tools/fake_outlet.py) — "
                    "L3 results are marked mock")
    else:
        baud_raw = os.getenv("SIMPLELAY_OUTLET_BAUD", "").strip()
        if not baud_raw:
            raise RuntimeError("SIMPLELAY_OUTLET_PORT에는 SIMPLELAY_OUTLET_BAUD가 필요합니다(기본값 없음)")
        try:
            baud = int(baud_raw)
        except ValueError as exc:
            raise RuntimeError(f"SIMPLELAY_OUTLET_BAUD 값을 정수로 읽을 수 없습니다: {baud_raw!r}") from exc
        link = OutletLink(_open_outlet_transport(port, baud), config,
                          reopen=lambda: _open_outlet_transport(port, baud)).start()
        log.info("outlet module link on %s @ %d (실물 미검증)", port, baud)
    ready = link.wait_ready(3.0)
    if ready is None:
        log.error("outlet module did not answer (no ready banner / status) — power data will be "
                  "'stale' until it does")
    else:
        log.info("outlet module ready: %s", ready)
        problem = _check_outlet_channels(ready, channels, consumers)
        if problem is not None:
            link.close()
            raise RuntimeError(problem)
    if os.getenv("SIMPLELAY_OUTLET_RELAY_ON_START", "").strip() == "1":
        latched = link.module_estop
        if latched is None:
            # 배너에 estop이 없으면(옛 펌웨어·배너 놓침) status로 확인한다. 확인 못 하면 켜지 않는다.
            try:
                latched = link.status().get("estop") is not False
            except OutletError as exc:
                log.error("outlet status before relay_on failed — relay left OFF: %s", exc)
                latched = True
        if latched:
            log.error("outlet module reports a latched E-STOP — relay left OFF despite "
                      "SIMPLELAY_OUTLET_RELAY_ON_START=1 (clear it with POST /stop/ack on RPi5)")
        else:
            try:
                link.relay_on()
                log.warning("outlet relay ON at start (SIMPLELAY_OUTLET_RELAY_ON_START=1)")
            except OutletError as exc:
                log.error("outlet relay_on at start failed: %s", exc)
    else:
        log.warning("outlet relay left as the module booted (default OFF = appliance unpowered); "
                    "set SIMPLELAY_OUTLET_RELAY_ON_START=1 to switch it on at start")
    return link


def _check_outlet_channels(ready: dict, channels, consumers: "tuple[str, ...]" = ()) -> str | None:
    """모듈이 알린 채널 수·릴레이 채널이 SIMPLELAY_OUTLET_CHANNELS와 맞지 않으면 이유(맞으면 None).

    2026-10-06 평가 A2: 로그만 남기던 것을 시작 거절로 바꿨다(호출하는 쪽이 RuntimeError로 올린다).
    """
    from rpi.verifier.outlet import outlet_module_channel_problem

    count = ready.get("channels")
    if not channels.by_appliance and isinstance(count, int) and count > 1:
        log.warning("outlet module has %d CT channels but SIMPLELAY_OUTLET_CHANNELS is empty — "
                    "the single consumer reads channel 0", count)
    return outlet_module_channel_problem(ready, channels, consumers, _outlet_press_appliance())


def _outlet_readiness(outlet):
    """execute 전 콘센트 확인: 무응답 → 모듈이 (다시) 알린 채널 정보가 대응과 어긋남(평가 A2) 순."""
    from rpi.verifier.outlet import outlet_module_channel_problem

    channels = _outlet_channel_map()
    consumers = _outlet_consumers()

    def reason() -> str | None:
        offline = outlet.not_ready_reason()
        if offline is not None:
            return offline
        info = getattr(outlet, "module_info", None)
        return outlet_module_channel_problem(info, channels, consumers, _outlet_press_appliance())

    return reason


def _build_operation_verifier(outlet=None):
    """SIMPLELAY_L3_MODE로 L3 검증기를 고른다(기본 off). real은 콘센트 모듈이 없으면 거절한다.
    ``outlet``은 전자레인지 CT 채널 보기(`_outlet_view`)다."""
    from rpi.controller.power_operation import OutletOperationVerifier, operation_verifier_from_env

    fake = _fake_outlet if outlet is not None and getattr(outlet, "mock", False) else None
    if fake is not None:
        ch = getattr(outlet, "channel", 0)
        ch = ch if isinstance(ch, int) else 0

        def on_sequence_done() -> None:
            fake.start_run(ch=ch)
    verifier = operation_verifier_from_env(
        outlet=outlet, on_sequence_done=on_sequence_done if fake is not None else None)
    if verifier is None:
        log.info("L3 operation verifier off (set SIMPLELAY_L3_MODE=mock to rehearse; "
                 "result frames carry operation_confirmed=null)")
    elif isinstance(verifier, OutletOperationVerifier):
        if verifier.mock:
            log.warning("L3 operation verifier reads the FAKE outlet — results are marked mock")
        else:
            log.warning("L3 operation verifier reads the outlet module power stream (실물 미검증)")
    else:
        log.warning("L3 operation verifier is MOCK (synthetic power, outcome=%s) — "
                    "not evidence of real appliance operation", verifier.outcome)
    return verifier


def _build_target_binder(outlet, recorder: "LiveRecorder | None" = None):
    """실행 대상 → L3 판정기·잔여 전류 꼬리·정지 확인 채널 결속(2026-10-07, 평가 H3, target_binding.py).

    시작 때 확인은 종전과 같다: 모르는 SIMPLELAY_L3_MODE, real인데 콘센트 포트·링크가 없으면 거절.
    판정기는 대상마다 그 대상 CT 채널 보기로 처음 실행할 때 만든다.
    """
    from rpi.controller.power_operation import operation_verifier_from_env

    from .services.target_binding import (
        L3_NONE_TARGETS_ENV,
        TargetBinder,
        l3_mode_from_env,
        parse_l3_none_targets,
    )

    mode = l3_mode_from_env()
    mock_operation = None
    # off·mock 판정기, 모르는 값·real 설정 누락의 거절은 종전 함수가 맡는다.
    if mode != "real":
        mock_operation = _build_operation_verifier(None)
    elif outlet is None:
        operation_verifier_from_env(outlet=None)  # 포트·링크 없음 → RuntimeError(시작 거절)
    none_targets = parse_l3_none_targets(os.getenv(L3_NONE_TARGETS_ENV))
    if none_targets:
        log.warning("L3 power check skipped for %s (%s) — their results carry operation_confirmed=null",
                    ",".join(sorted(none_targets)), L3_NONE_TARGETS_ENV)

    tail_config = None
    if outlet is not None:
        from rpi.verifier.power_tail import TailConfig

        # 잔여 전류 설정 오류는 첫 실행까지 미루지 않고 시작할 때 거절한다.
        tail_config = TailConfig.from_env()

    def make_tail(view, operation):
        if not hasattr(operation, "last_verdict"):
            return None
        from .services.outlet_watch import OutletTailHook

        return OutletTailHook(view, operation, config=tail_config,
                              recorder=recorder.recorder if recorder is not None else None)

    return TargetBinder(
        l3_mode=mode if mode in ("off", "mock", "real") else "off",
        outlet=outlet,
        channels=_outlet_channel_map(),
        press_appliance=_outlet_press_appliance(),
        make_operation=lambda view, _ch: _build_operation_verifier(view),
        make_tail=make_tail if outlet is not None else None,
        mock_operation=mock_operation,
        l3_none_targets=none_targets,
    )


def _build_hold(grbl: object, raw_grbl: object, outlet=None, binder=None):
    """정지 대기·확인 주행 부품. mock 모션이면 모의 가전까지, 실제 어댑터면 move_to·press만.
    콘센트 모듈이 있으면 실제 어댑터의 가전 켜짐 확인을 **대기 계획 대상 가전의 CT 채널** 전력으로 한다
    (2026-10-07 평가 H3 — 전에는 늘 전자레인지 채널). 채널이 없는 대상은 '모름'(정지 미확인)."""
    from rpi.controller.mock import MockGrblClient as _Mock

    from rpi.controller.models import ExecutionMode

    from .services.stop_hold import mock_hold_hardware, real_hold_hardware

    if isinstance(raw_grbl, _Mock):
        log.info("stop hold: MOCK motion + mock appliance (SIMPLELAY_HOLD_MOCK_*)")
        return mock_hold_hardware()
    if getattr(raw_grbl, "execution_mode", None) is ExecutionMode.MOCK:
        # 모의 보드(SIMPLELAY_MOTION_SIMULATED, 10/24): 움직임은 모의 보드로 보내고 가전은 모의 가전 — 연습 대기가 실물처럼
        # 최대 대기 시간(30분)까지 남아 키오스크를 다시 켤 때마다 '연습이 끝났어요' 대기가 떴다. 모의 가전이 끝나면 대기도 끝난다.
        from .services.stop_hold import MockApplianceRun

        try:
            run_s = float(os.getenv("SIMPLELAY_HOLD_MOCK_RUN_S", "") or 30.0)
        except ValueError:
            run_s = 30.0
        log.info("stop hold: simulated motion board + mock appliance (%.0f s)", run_s)
        return real_hold_hardware(grbl, raw_grbl, probe_factory=lambda plan: MockApplianceRun(
            run_s, honors_stop=True, presses_needed=plan.stop_presses))
    if outlet is not None:
        from rpi.verifier.power_tail import TailConfig

        from .services.outlet_watch import OutletRunProbe

        tail_config = TailConfig.from_env()
        log.warning("stop hold: real motion adapter + outlet power probe on the hold target's CT channel "
                    "(실물 미검증)")
        if binder is None:  # 시험용 직접 호출 — 넘겨받은 채널 보기 하나
            return real_hold_hardware(grbl, raw_grbl,
                                      probe_factory=lambda plan: OutletRunProbe(outlet, tail_config))
        return real_hold_hardware(grbl, raw_grbl, probe_factory=lambda plan: binder.probe_for(
            plan.appliance_id, lambda view: OutletRunProbe(view, tail_config)))
    log.warning("stop hold: real motion adapter (move_to/press), no power reader — "
                "stop judgement stays 'unconfirmed' (실물 미검증)")
    return real_hold_hardware(grbl, raw_grbl)


def _is_serial_motion(raw_grbl: object) -> bool:
    from rpi.controller.motion_port import MotionClient

    return isinstance(raw_grbl, MotionClient)


def _build_dev_motion(raw_grbl: object):
    """실제 모션 어댑터(serial)일 때만 개발자 조작 서비스를 만든다(2026-10-10). mock이면 None — act_info에
    dev_motion_protocol을 싣지 않아 RPi5가 개발자 조작을 보내지 않는다."""
    if not _is_serial_motion(raw_grbl):
        return None
    from .services.dev_motion import DEV_JOG_STEP_CEILING_MM, DevMotionService

    log.warning("developer motion ops accepted on the serial motion adapter (dev_motion protocol, "
                "jog ceiling %g mm — 실물 미검증)", DEV_JOG_STEP_CEILING_MM)
    return DevMotionService(raw_grbl)


def _build_executor(
    reader: asyncio.StreamReader,
    writer: asyncio.StreamWriter,
    recorder: "LiveRecorder | None" = None,
    motion_log: "LineLog | None" = None,
    outlet=None,
    link_key: bytes | None = None,
) -> ActExecutor:
    """Wire up the executor with current adapters.

    GrblClient는 기본 mock. SIMPLELAY_MOTION_MODE=serial이면 모션 MCU 어댑터
    (실물 미검증)를 꽂는다. Verifier는 env로 실물 전환 가능. L3는 SIMPLELAY_L3_MODE.
    """
    # 데모 실패 주입(POST /demo/inject-failure → UART inject_failure)이 UART
    # 모드에서도 통하도록, RPi5와 동일하게 verifier를 래핑하고 같은 상태를
    # ActExecutor에 넘긴다 — 결선 리허설 장면이 실기기 구성에서도 성립한다.
    failure_state = DemoFailureState()
    # 시리얼을 열기 전에 끝나는 설정 검사가 좋지만, 모션보다 먼저 확인해 real L3 거절이
    # 모터 연결 시도보다 앞서게 한다. 전력 소비자(L3·꼬리·정지 확인)는 **실행 대상 가전의** CT 채널을
    # 읽는다(2026-10-07 평가 H3, target_binding.py) — 실행기가 execute마다 대상으로 고른다.
    binder = _build_target_binder(outlet, recorder)
    if recorder is None:
        # 줄 기록이 없으면 종전 호출 모양 그대로
        grbl, safety = _build_motion(**({"line_log": motion_log} if motion_log is not None else {}))
        readiness = _motion_readiness(grbl)
        raw_grbl = grbl
    else:
        from rpi.verifier.recorder import RecordingGrblClient, motion_event_hook

        # 모션 MCU 이벤트(mcu_press_start 등)는 어댑터 훅으로, 호스트 호출 시각은 래퍼로 찍는다.
        grbl, safety = _build_motion(on_event=motion_event_hook(recorder.recorder),
                                     **({"line_log": motion_log} if motion_log is not None else {}))
        readiness = _motion_readiness(grbl)
        raw_grbl = grbl
        grbl = RecordingGrblClient(grbl, recorder.recorder)
    controller = ClosedLoopController(
        grbl=grbl,
        verifier=FailureInjectionVerifier(_build_verifier(), failure_state),
        alerts=MockAlertSink(),
        safety=safety,
        # L3 판정기는 실행마다 대상으로 꽂는다(ActExecutor → use_operation).
        # L2(acceptance)는 운영 경로에 판정기가 없다 — 꽂지 않는다(인계 노트북-3 §C, 2026-10-07):
        # 누름 확인(L1) 뒤 바로 다음 단계로 가고, L2 재입력 정책은 타지 않는다.
        operation=None,
    )
    from .services.act_executor import progress_enabled_from_env

    log.info("progress frames %s (SIMPLELAY_ACT_PROGRESS; old RPi5 ignores them)",
             "ON" if progress_enabled_from_env() else "off")
    extra: dict = {}
    if readiness is not None:
        extra["readiness"] = readiness
    executor = ActExecutor(
        reader=reader,
        writer=writer,
        controller=controller,
        failure_state=failure_state,
        job_observer=_job_observer(recorder, motion_log),
        hold=_build_hold(grbl, raw_grbl, outlet, binder),
        target_binder=binder,
        dev_motion=_build_dev_motion(raw_grbl),
        link_key=link_key,
        # 정지 확인 단계(2026-10-13): 실제 모션 어댑터면 정지 보고가 MCU 응답·멈춤 확인을 읽는다. mock이면 None('보냄').
        motion_stop=raw_grbl if _is_serial_motion(raw_grbl) else None,
        **extra,
    )
    if outlet is not None:
        _wire_outlet_estop(outlet, executor)
    # 세트 보고가 원점·연결 캐시를 읽는 대상(읽기만 — 실행 경로는 위 인자들을 쓴다).
    executor.motion_client = raw_grbl
    return executor


def _wire_outlet_estop(outlet, executor: ActExecutor) -> None:
    """콘센트 모듈 ↔ 실행기 배선(이벤트는 이벤트 루프 스레드로 넘긴다).

    - ``estop``(버튼 이벤트, ready·status가 보고한 걸림) → ``handle_outlet_estop``: 호스트 걸림 + 구동부
      정지 + RPi5 알림. 모듈은 이미 스스로 릴레이를 열었다.
    - 해제 확인(``estop_ack``) 때 모듈 쪽 해제 → ``outlet.reset_estop_if_released``(버튼이 풀렸을 때만).
    - 모듈 무응답 → execute를 ``outlet_offline``으로 거절(``outlet.not_ready_reason``).
    - 배선 전에 이미 모듈이 걸림을 보고했으면(부팅 배너) 곧바로 걸린 채로 시작한다.
    실행 중인 이벤트 루프가 없으면(시험 등) 배선하지 않고 경고만 남긴다.
    """
    try:
        loop = asyncio.get_running_loop()
    except RuntimeError:
        log.warning("outlet estop events not wired to the executor (no running event loop)")
        return

    # 물리 비상정지 버튼을 쓰지 않는 구성(SIMPLELAY_OUTLET_IGNORE_ESTOP=1)이면
    # 모듈의 estop 알림/걸림을 실행기로 넘기지 않는다 (RPi5 팝업 방지).
    ignore_estop = _outlet_estop_ignored()
    if ignore_estop:
        log.warning("outlet module physical E-STOP ignored by configuration (SIMPLELAY_OUTLET_IGNORE_ESTOP=1)")

    def on_event(doc: dict) -> None:
        event = doc.get("event")
        source = doc.get("source") if isinstance(doc.get("source"), str) else "button"
        if event == "power_lost":
            # 재부팅으로 꺼진 릴레이 — 자동으로 켜지 않고 사람 확인까지 걸어 둔다(평가 A4).
            try:
                loop.call_soon_threadsafe(executor.handle_outlet_power_lost, source)
            except RuntimeError:
                executor.emergency_stop_sync("outlet_reboot")
            return
        if event != "estop":
            return
        if ignore_estop:
            log.info("outlet estop event ignored (SIMPLELAY_OUTLET_IGNORE_ESTOP=1)")
            return
        try:
            loop.call_soon_threadsafe(executor.handle_outlet_estop, source)
        except RuntimeError:  # 루프가 닫혔으면 이 스레드에서 구동부를 바로 멈춘다.
            log.error("outlet estop arrived after the event loop closed — stopping drive synchronously")
            executor.emergency_stop_sync(source)

    reset = getattr(outlet, "acknowledge_and_restore", None)
    executor.set_estop_reset(reset if callable(reset) else outlet.reset_estop_if_released)
    executor.set_outlet_readiness(_outlet_readiness(outlet))
    outlet.add_listener(on_event)
    if not ignore_estop and getattr(outlet, "module_estop", None) is True:
        loop.call_soon(executor.handle_outlet_estop, "ready")


class _RehearsalHooks:
    """UART 리허설 주입(2026-10-06) — RPi4가 가짜 콘센트(또는 콘센트 없음)·모의 모션일 때만 꽂는다.

    비상 버튼: 가짜 모듈이 있으면 그 버튼을 누른다 — 모듈 estop 이벤트 → 링크 → 실행기로 실물과 같은 길을 탄다.
    콘센트가 없으면 실행기의 ``handle_outlet_estop``을 바로 부르고 해제 때 버튼 상태만 흉내 낸다(시뮬레이터와 같다).
    가전 끝은 실행기의 ``inject_appliance_done``(출처 injected)이 맡는다.
    """

    def __init__(self) -> None:
        self._held = False

    def outlet_estop(self, executor: ActExecutor, hold_button: bool) -> None:
        fake = _fake_outlet
        if fake is not None:
            fake.press_estop()
            if not hold_button:
                fake.release_estop_button()
            return
        self._held = bool(hold_button)
        executor.set_estop_reset(lambda: (False, "estop_button_pressed") if self._held else (True, None))
        executor.handle_outlet_estop("button")

    def release_button(self, executor: ActExecutor) -> None:
        fake = _fake_outlet
        if fake is not None:
            fake.release_estop_button()
        self._held = False


def _describe_act(executor: ActExecutor, *, outlet_kind: str, motion_kind: str, outlet=None) -> None:
    """RPi5에 알릴 구성(``act_info``)을 채우고 리허설 주입을 열지 정한다(2026-10-06 평가 C1·B3, UART 리허설).

    ``done_watch``: SIMPLELAY_DONE_WATCH의 가전 ID — RPi5가 SIMPLELAY_ROUTINE_DONE_SENSORS·가전 목록과 대조한다.
    리허설은 모션이 mock이고 콘센트가 가짜이거나 없을 때만 연다(실물 판정 위에 주입을 얹지 않는다).
    """
    from .services.appliance_done_watch import parse_done_watches

    specs = parse_done_watches(os.getenv("SIMPLELAY_DONE_WATCH"))
    executor.act_info = {"done_watch": [spec.appliance_id for spec in specs],
                         "outlet": outlet_kind, "motion": motion_kind}
    motion_client = getattr(executor, "_motion_stop", None)
    if motion_client is not None:
        executor.act_info["motion_protocol"] = getattr(motion_client, "motion_protocol", "unknown")
    allowed = motion_kind == "mock" and outlet_kind in ("fake", "none")
    executor.set_rehearsal(_RehearsalHooks() if allowed else None)
    from .services.kit_identity import kit_reporter, load_kit_id

    executor.set_kit_report(kit_reporter(
        load_kit_id(), motion_kind=motion_kind, outlet_kind=outlet_kind,
        motion=getattr(executor, "motion_client", None), outlet=outlet,
        estop_ignored=_outlet_estop_ignored()))
    log.info("act_info: done_watch=%s outlet=%s motion=%s rehearsal=%s",
             executor.act_info["done_watch"], outlet_kind, motion_kind, "ON" if allowed else "off")


def _build_done_watch(outlet, executor: ActExecutor):
    """SIMPLELAY_DONE_WATCH가 있으면 가전 끝 관찰을 만든다(없으면 None). **실물 미검증.**

    outlet 입력은 그 가전의 CT 채널(SIMPLELAY_OUTLET_CHANNELS)을 읽는 스레드(`PowerCycleFeeder`)를 띄운다. mic 입력은
    위험 소리 감지 루프가 같은 마이크 프레임을 나눠 준다(`_maybe_start_danger_monitor`).
    반환: [(관찰, 전력 공급기 | None), …] — 가전마다 하나.
    """
    from rpi.verifier.cycle_end import CycleEndConfig
    from rpi.verifier.done_fusion import DoneFusionConfig
    from rpi.verifier.end_beep import EndBeepConfig

    from .services.appliance_done_watch import ApplianceDoneWatch, PowerCycleFeeder, parse_done_watches

    specs = parse_done_watches(os.getenv("SIMPLELAY_DONE_WATCH"))
    if not specs:
        log.info("appliance done watch off (set SIMPLELAY_DONE_WATCH=washer:outlet,mic;microwave:outlet)")
        return None
    if any("power" in spec.inputs for spec in specs) and outlet is None:
        raise RuntimeError("SIMPLELAY_DONE_WATCH에 outlet이 있으면 SIMPLELAY_OUTLET_PORT가 필요합니다")
    # 채널 대응을 먼저 모두 확인한다(하나라도 빠지면 스레드를 띄우기 전에 거절).
    views = {spec.appliance_id: _outlet_view(outlet, spec.appliance_id)
             for spec in specs if "power" in spec.inputs}
    beep = EndBeepConfig.from_env()
    loop = asyncio.get_running_loop()
    built = []
    try:
        for spec in specs:
            cycle = CycleEndConfig.for_appliance(spec.appliance_id)
            # 전력 끝은 settle_s 늦게 오므로 먼저 온 종료음이 짝을 기다릴 시간을 settle_s + 창으로 잡는다(env가 이긴다).
            base = DoneFusionConfig()
            # 쿨다운은 가전마다(평가 B2) — 전자레인지 두 번째 가열 끝을 버리지 않게 짧다(측정 필요).
            fusion = DoneFusionConfig.for_appliance(spec.appliance_id,
                                                    wait_s=max(base.wait_s, cycle.settle_s + base.window_s))
            view = views.get(spec.appliance_id)
            watch = ApplianceDoneWatch(
                spec, executor.thread_safe_done_emitter(loop), cycle_config=cycle, beep_config=beep,
                fusion_config=fusion,
                power_source="mock" if view is not None and getattr(view, "mock", False) else "real",
                beep_source="real")
            feeder = PowerCycleFeeder(view, watch).start() if view is not None else None
            built.append((watch, feeder))
            log.warning("appliance done watch on: %s inputs=%s ct_channel=%s event=%s "
                        "(실물 미검증, 기준값 측정 필요)", spec.appliance_id, ",".join(spec.inputs),
                        feeder.channel if feeder is not None else "-", watch.event)
    except BaseException:
        for _, feeder in built:
            if feeder is not None:
                feeder.stop()
        raise
    return built


def _maybe_start_danger_monitor(executor: ActExecutor, done_watches=None) -> "asyncio.Task[None] | None":
    """위험소리 감지 태스크 — 코드·테스트는 완성돼 있었지만 그동안 어느
    엔트리포인트도 기동하지 않아 /alerts가 실기기에서도 절대 울리지 않았다.

    검증용과 별개의 SounddeviceReader 인스턴스를 연다 — 같은 마이크에 입력
    스트림 2개가 공존하는지는 실기기에서 확인 필요(문제 시 프레임 팬아웃
    공유 리더로 교체).
    """
    danger = _flag("SIMPLELAY_DANGER_SOUND_ENABLED")
    listeners = [w.feed_audio for w in (done_watches or ()) if w.wants_beep]
    if not danger and not listeners:
        log.info(
            "DangerSoundMonitor off (set SIMPLELAY_DANGER_SOUND_ENABLED=true to enable)"
        )
        return None

    from rpi.verifier import SensorConfig
    from rpi.verifier.audio_sensor import SounddeviceReader

    from .services.danger_sound_monitor import DangerSoundMonitor

    reader = SounddeviceReader(SensorConfig().audio)
    monitor = DangerSoundMonitor(reader, executor, frame_listeners=listeners, danger=danger)
    log.info("DangerSoundMonitor active — alarm-sound detection %s, washer end beep %s",
             "on" if danger else "off", "on" if listeners else "off")
    return asyncio.create_task(monitor.run())


def _link_real_paths() -> list[str]:
    """이 실행기에서 켜진 실물 경로 — 하나라도 있으면 무인증 모의 설정(off_for_mock)으로 시작하지 않는다(2026-10-14)."""
    real = []
    motion = (os.getenv("SIMPLELAY_MOTION_MODE", "mock") or "mock").strip().lower() or "mock"
    if motion != "mock":
        real.append(f"SIMPLELAY_MOTION_MODE={motion}")
    outlet = os.getenv("SIMPLELAY_OUTLET_PORT", "").strip()
    if outlet and outlet.lower() != "fake":
        real.append("SIMPLELAY_OUTLET_PORT")
    if (os.getenv("SIMPLELAY_L3_MODE", "off") or "off").strip().lower() == "real":
        real.append("SIMPLELAY_L3_MODE=real")
    if _flag("SIMPLELAY_SENSORS_ENABLED"):
        real.append("SIMPLELAY_SENSORS_ENABLED")
    return real


async def _run() -> None:
    from rpi.services.link_auth import link_key_from_env

    # 짝 키를 먼저 확인한다 — 없거나 짧으면 시리얼을 열기 전에 시작을 거절한다(2026-10-12, 10-14 키 필수).
    link_key = link_key_from_env(real_paths=_link_real_paths())
    log.info("Opening %s at %d baud (link auth %s)", SERIAL_PORT, BAUD_RATE, "on" if link_key else "OFF")
    try:
        import serial_asyncio  # type: ignore[import-untyped]
    except ImportError:
        log.error(
            "pyserial-asyncio not installed.\n"
            "Install with:  pip install pyserial-asyncio\n"
            "Then retry:    python -m rpi4.act_main"
        )
        sys.exit(1)

    reader, writer = await serial_asyncio.open_serial_connection(
        url=SERIAL_PORT,
        baudrate=BAUD_RATE,
    )
    log.info("Serial open — waiting for RPi5 execute commands")
    outlet = _build_outlet()
    try:
        recorder = _build_recorder(_outlet_view(outlet, _outlet_press_appliance()))
    except BaseException:
        if outlet is not None:
            outlet.close()
        raise
    motion_log = _build_motion_log()
    try:
        executor = _build_executor(reader, writer, recorder, motion_log[0] if motion_log else None,
                                   outlet=outlet, link_key=link_key)
    except BaseException:
        if outlet is not None:
            outlet.close()
        if recorder is not None:
            recorder.close()
        if motion_log is not None:
            motion_log[1].close()
        raise
    if recorder is not None:
        recorder.start()
    motion_kind = (os.getenv("SIMPLELAY_MOTION_MODE", "mock") or "mock").strip().lower() or "mock"
    outlet_kind = "none" if outlet is None else ("fake" if getattr(outlet, "mock", False) else "real")
    _describe_act(executor, outlet_kind=outlet_kind, motion_kind=motion_kind, outlet=outlet)
    try:
        done = _build_done_watch(outlet, executor)
    except BaseException:
        if outlet is not None:
            outlet.close()
        raise
    monitor_task = _maybe_start_danger_monitor(executor, [w for w, _ in done] if done else None)
    try:
        await executor.run()
    finally:
        # run()이 취소가 아닌 이유(EOF 등)로 빠져나왔을 때도 진행 중이던
        # 물리 실행을 방치하지 않는다 — 이미 멈췄으면 즉시 반환한다.
        with contextlib.suppress(asyncio.CancelledError):
            await executor.shutdown()
        if monitor_task is not None:
            monitor_task.cancel()
            with contextlib.suppress(asyncio.CancelledError):
                await monitor_task
        for _, feeder in done or ():
            if feeder is not None:
                feeder.stop()
        if _motion_retry is not None:
            _motion_retry.stop()
        if _motion_watch is not None:
            _motion_watch.stop()
        close_motion = getattr(executor._motion_stop, "close", None)
        if callable(close_motion):
            close_motion()
        if recorder is not None:
            recorder.close()
        if motion_log is not None:
            motion_log[1].close()
        if outlet is not None:
            outlet.close()
        if _fake_outlet is not None:
            _fake_outlet.close()


if __name__ == "__main__":
    asyncio.run(_run())
