Seongwonp/Simplelay/rpi/services/esp_node_controller.py

"""HTTP-based ButtonSequenceController for one appliance's node (ESP32 next
to that appliance's RPi4 -- see long-term multi-node plan: RPi5 is one
central hub, an Act node is attached per appliance rather than co-located
with RPi5).

This is the dev-mode transport: RPi5 acts as the HTTP client and POSTs to a
small HTTP server the node runs, reusing the exact same request/response
style already used for the phone app. The production transport (ESP-NOW,
for demo-venue Wi-Fi independence) is a separate, not-yet-built
ButtonSequenceController -- swapping between them is meant to be a mode
selection, not a rewrite, so both need to keep satisfying this same
interface.

Unlike ActClientController (UART, needs a persistent connection and a
background event loop thread), plain HTTP request/response is inherently
one-shot, so this controller needs no background thread at all.
"""

from __future__ import annotations

import logging
from urllib.parse import urlparse, urlunparse

import httpx

from rpi.controller import ExecutionMode, ExecutionResult

from .aggregate_result import synthesize_execution_result

log = logging.getLogger(__name__)

# 노드 펌웨어의 긴급 정지 리스너는 항상 HTTP 포트 + 1 (firmware-node
# include/config.h의 STOP_PORT). 같은 포트를 못 쓰는 이유는 그쪽 주석 참고
# (단일 스레드 WebServer가 실행 블로킹 중 새 연결을 못 받음).
STOP_PORT_OFFSET = 1
STOP_REQUEST_TIMEOUT_SECONDS = 2.0

# 실행 응답 대기 — UART 경로(ActClientConfig)와 같은 산정식이어야 한다.
# 두 경로가 다른 시간에 포기하면 "한쪽은 실패로 보고, 다른 쪽은 계속 실행"이
# 된다. 노드 펌웨어의 대기 시간은 항상 이보다 짧게(먼저 504 회신) 잡는다.
EXECUTE_BASE_TIMEOUT_SECONDS = 30.0
EXECUTE_PER_BUTTON_SECONDS = 6.0

# 정지를 **생략해도 되는 유일한 경우**: 연결 자체가 성립하지 않은 예외들.
#
# 규칙을 이렇게 뒤집은 이유. 예전에는 "400/500은 실행이 시작되지 않았으니 정지가
# 불필요하다"고 판단했는데, 그건 노드 펌웨어가 지금 그렇게 짜여 있다는 것에 기댄
# 추론이다. 중간에 낀 프록시나 그 주소의 다른 기기가 답했다면, 혹은 펌웨어가 나중에
# 바뀌면 성립하지 않는다. 반면 연결이 못 이뤄졌다는 것은 우리 쪽에서 관측한 사실이고,
# 여기엔 자기충족적인 근거가 있다 -- **요청이 닿지 못했다면 정지도 닿지 못한다.**
# 죽은 노드에 정지를 쏘느라 실패마다 몇 초를 더 붙잡을 이유도 없다.
#
# 나머지는 전부 정지를 보낸다. 틀렸을 때의 대가가 비대칭이기 때문이다: 불필요한
# 정지는 유휴 RPi4가 무시하고 끝나지만(act_executor "abort received while idle"),
# 빠뜨린 정지는 화면이 실패라고 말하는 동안 실물이 계속 눌리는 상태로 남는다.
_UNDELIVERABLE = (
    httpx.ConnectError,      # TCP 연결 실패
    httpx.ConnectTimeout,    # 연결 수립 중 시간 초과
    httpx.PoolTimeout,       # 커넥션 풀에서 나가지도 못함
    httpx.UnsupportedProtocol,
    httpx.InvalidURL,        # HTTPError가 아니라 별도 계층이다
)


class EspNodeError(RuntimeError):
    """Raised when a node is unreachable or reports a non-2xx response."""
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
