Seongwonp/Simplelay/(commit log)

2026-07-22 SimpleLay 프로젝트 초기 구조
    - 정체성 정의: XY 갠트리(Touch Bridge 공유) + 라즈베리파이 검증/폐루프 레이어(신규)
    - reuse-boundary 문서로 재사용 vs 신규 구현 경계 명확화 (대회 정당성)
    - 폐루프 검증 설계, 아키텍처, 로드맵 문서화
    - rpi(verifier/controller/intent/api)·firmware·app 골격 생성
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2026-08-15 docs: 통신 프로토콜 명세, 버튼맵 JSON, 앱 메타데이터 추가
    - docs/protocol.md: BLE/UART 통신 포맷 정의 (앱↔ESP32↔RPi4↔RPiZero)
    - docs/button-maps/microwave.json: 전자레인지 버튼 그리드 JSON
    - app/appinfo.json: LG AI 네이티브 OS 앱 메타데이터 및 권한 선언
2026-08-15 fix: buttonLabels 전체 항목 추가, sensor 프로토콜에 completed_steps 반영, README 최신화
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2026-08-15 fix: 데모 모드 send no-op, BT 꺼짐 스캔 가드, 침묵 타이머 항상 onSilence 호출
2026-08-15 fix: startScan PlatformException을 catchError로 처리 (BT OFF 미처리 예외 제거)
2026-08-15 fix: scan() 시작 즉시 빈 목록 emit으로 BT OFF 시 로딩 스피너 무한 방지
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2026-08-15 test: Flutter 위젯·유닛 테스트 48개 추가
    - BleService 데모 모드 / 패킷 버퍼링 (9개)
    - Suggestion 모델 파싱 및 readableStep (4개)
    - SuggestionNotifier BLE 메시지 → 상태 (5개)
    - ExecutionStatusNotifier 센서/결과/긴급정지 (8개)
    - HomeScreen 연결 상태별 UI / 제안 목록 (9개)
    - SuggestionScreen 제안 표시 / 승인·거부 플로우 (7개)
    - StatusScreen 5개 phase별 UI (11개)
    - SettingsScreen 저장·스캔·데모 UI (9개)
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2026-08-15 feat(M1): 센서 모듈 구현 — 전류·음향 판정 + 복합 fusion (테스트 48개)
2026-08-15 feat(firmware): Phase B ESP32 펌웨어 스켈레톤 구현
    - platformio.ini: FireBeetle WROOM-32 보드, ArduinoJson v7, NimBLE-Arduino v1.4
    - include/config.h: BLE UUID, Serial2 핀(RX=16, TX=17), E-STOP(GPIO 33),
    센서 ADC(GPIO 36), ACS712-05B 캘리브레이션 상수
    - src/ble_bridge: NimBLE GATT 서버 (READ/WRITE/NOTIFY, MTU 512),
    command→intent / confirm→confirm / emergency_stop→estopFlag 라우팅
    - src/rpi_uart: Serial2 JSON 개행 구분 송수신, 라인 버퍼 기반 파싱
    sequence→suggestion / result/abort→App 포워딩
    - src/sensor_reader: ACS712-05B ADC 전류 계산 스텁 (음향 TODO Phase C)
    - src/estop: IRAM_ATTR ISR, GPIO 33 FALLING 인터럽트
    - src/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
2026-08-15 feat(rpi4): Phase C ESP32↔RPi4 UART 브릿지 구현
    messages.py: IntentMsg/ConfirmMsg/AbortMsg/SensorLogMsg 타입 + parse_message()
    sequence_store.py: asyncio.Lock 기반 pending 시퀀스 저장소 (put/pop/clear)
    bridge.py: UartBridge — asyncio StreamReader/Writer 기반 메시지 라우터
    - intent → intent.resolve() → sequence 응답 + store.put()
    - confirm(T) → controller.execute() → result + usage_log 기록
    - confirm(F) → abort 응답
    - abort → store.clear() + abort 에코
    - sensor_log → Phase C stub (로그만)
    main.py: SIMPLELAY_UART_PORT/BAUD 환경변수, pyserial-asyncio open_serial_connection
    테스트 17개 (86 전체 통과, 기존 69 회귀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
2026-08-15 feat(app): Phase D 앱 디자인 시스템 고도화
    theme/
    app_colors.dart: AppColors 토큰 (background/surfaceLow/surfaceHigh/primary/success/warning/danger/borderSubtle/onSurfaceMuted)
    app_text.dart: AppText 스타일 (heading/title/body/caption/sensor, tabularFigures)
    app_theme.dart: AppTheme.dark — ColorScheme.fromSeed copyWith, Card 테두리, FilledButton 52dp,
    NavigationBar indicator 18% primary, BottomSheet 24r, LinearProgressIndicator 6dp
    main.dart: 인라인 ThemeData → AppTheme.dark 단일화
    home_screen.dart:
    BLE 상태 카드 → AnimatedContainer (400ms easeOutCubic, 테두리 글로우)
    제안 카드 → _SlidingCard (fade+slide 350ms easeOutQuart)
    빈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
2026-08-15 feat(intent): LLM 의도 해석기 구현 (모델 출력 검증 + 규칙 기반 폴백)
    LlmIntentResolver가 모델 출력을 신뢰하지 않는 입력으로 다루도록 구현했다.
    JSON 파싱 실패, 미등록 버튼, 빈 시퀀스, 클라이언트 호출 예외를 모두 같은
    경로로 처리해 RuleBasedIntentResolver로 즉시 폴백한다.
    - HttpLlmClient: OpenAI 호환 chat-completions 엔드포인트 호출 (표준 라이브러리만 사용)
    - appliance.py: docs/button-maps의 버튼 맵을 읽어 검증용 버튼 어휘 생성
    - mock.py: 결정론적 MockLlmClient 테스트 더블 추가
2026-08-15 feat(api): 서비스 준비 상태 및 정상 종료 처리 추가
    SimpleLayService가 "프로세스 시작"과 "명령 수신 준비 완료"를 구분하도록
    확장했다. start_ready=False로 생성하면 mark_ready() 호출 전까지
    execute_purpose()가 ServiceNotReadyError를 던진다.
    request_shutdown()은 이후 들어오는 요청만 거부하고, 이미 진행 중인
    폐루프 실행(재시도 포함)은 끊기지 않고 끝까지 완료된다. 기존 호출부는
    기본값(start_ready=True)으로 동작이 그대로 유지된다.
2026-08-15 docs: RPi4/RPi5 보드 역할 정정 (RPi Zero는 실제로 안 씀)
    Interpret(의도 해석)는 RPi5, Act(폐루프 실행)는 RPi4가 맡는 것으로
    프로토콜·아키텍처 문서를 정정했다. 기존 문서에 있던 RPi Zero는
    실제 보유 하드웨어와 맞지 않아 전부 제거했다.
    architecture.md에 두 보드 간 IPC 방식이 아직 결정되지 않았고,
    현재 rpi/api/service.py는 두 계층이 한 프로세스에 있다고 가정한
    배선이라는 점도 남겨 뒀다.
2026-08-15 fix(deps): numpy를 pyproject.toml 의존성에 추가
2026-08-16 feat: 앱 고도화 + RPi 터치스크린 UI 구현
    Flutter 앱:
    - BLE 기기 ID/이름 SharedPreferences 영속 저장 (SavedDeviceNotifier)
    - 가전 버튼 맵 모델 추가 (전자레인지 4×3, 인덕션 3×4)
    - 가전 선택 저장 및 설정 화면 가전 섹션 추가
    - 제안 확인 화면에 버튼 맵 그리드 시각화 (순서 뱃지)
    - RPi FastAPI HTTP 직통 경로 추가 (http 패키지, RpiApiService)
    - 음성 화면 HTTP-first 전송 (BLE 폴백 유지)
    - 설정 화면 RPi URL 입력·연결 테스트 섹션 추가
    - 홈 화면 AppBar에 현재 가전 Chip 표시
    RPi 터치스크린:
    - 800×480 단일 HTML 키오스크 UI (rpi/touchscreen/index.html)
    - 대기 → 제안(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
2026-08-16 fix(app): 설정 화면 크래시와 센서 차트 미갱신 버그 수정
    - settings_screen.dart: ble_service.dart import 누락으로 컴파일 자체가
    실패하던 문제 수정
    - settings_screen.dart: RPi 서버 "저장" 버튼이 Row 안에서 무한 너비
    제약을 유발해 설정 화면 전체가 빈 화면으로 렌더링되던 문제 수정
    (고정 너비로 감쌈)
    - status_screen.dart: 센서 슬라이딩 윈도우가 List.filled(20, 0.0)로
    생성돼 고정 길이였던 탓에 값이 들어올 때마다 removeAt(0)이 예외를
    던지고 있던 문제 수정 (growable: true 추가) — 실행 상태 화면의
    전류/음향 막대 차트가 그동안 갱신되지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
2026-08-16 feat(touchscreen): RPi5 키오스크 UI를 Flutter 앱으로 포팅
    rpi/touchscreen/index.html(HTML/JS 프로토타입)의 4개 화면(대기/제안/
    실행중/완료)과 상태 전이·폴링 로직을 그대로 Flutter 앱으로 옮겼다.
    API 엔드포인트, 타이밍(2초 폴링, 10초 승인 대기, 3초 완료 후 복귀)
    전부 기존 설계와 동일하게 유지.
    폰 앱의 가전 버튼맵 모델과 동일한 데이터를 쓰고, 로컬 FastAPI 서버
    (rpi/api)를 그대로 호출하므로 백엔드 쪽은 변경 없음.
2026-08-16 feat(controller): GrblClient 첫 실제 구현체 — GPIO 페리페럴 D-Bus 어댑터
    internal-platformGpioClient가 버튼 누름을 GPIO 펄스(열기→값1→대기→값0→닫기)로
    표현하고, 플랫폼 CLI를 서브프로세스로 호출해 실행한다. 페리페럴은
    프로세스당 한 번만 활성화하고 이후 호출부터는 재사용한다.
    버튼→페리페럴 매핑은 이 모듈이 정하지 않고 호출자가 주입한다(실제
    배선이 아직 확정되지 않았기 때문). 서브프로세스 실행은 주입 가능해
    실제 장치 없이도 정상/오류 경로를 전부 테스트한다(신규 12개, 기존
    스위트 포함 전체 123개 통과).
    기존 C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
2026-08-16 docs: 온디바이스 vs 클라우드 추론 경계 정의
    의도 해석을 3단계로 정의: 규칙 매칭(온디바이스) → 온디바이스 소형
    모델(미구현) → 외부 API(선택, 기본 꺼짐, 앞 두 단계 실패시만). 판단
    기준은 지연시간·신뢰성·개인정보를 처리 능력보다 우선한다는 원칙.
    현재 LlmIntentResolver는 반대 순서(외부 먼저, 규칙은 폴백)로 짜여
    있어 이 결론과 어긋난다는 점을 남은 작업으로 기록해 둠 — 아직 실제
    서비스에 배선되기 전이라 코드 파손 위험 없이 고칠 수 있음.
    사용 패턴 학습, 음성인식(폰 OS 위임), 향후 카메라 인식·TTS 항목도
    같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
2026-08-16 feat(intent): 온디바이스 우선 순서로 리졸버를 조립하는 TieredIntentResolver 추가
    LlmIntentResolver 자체는 "모델 먼저, 실패시 규칙"으로 짜여 있어
    docs/inference-boundary.md의 결론(온디바이스 우선, 외부는 최후 수단)과
    순서가 반대다. 기존 클래스를 고치는 대신, 여러 IntentResolver를
    우선순위 순서대로 시도하는 조합기를 새로 추가해 해결했다.
    각 티어는 UnknownIntentError일 때만 다음 티어로 넘어가고, 그 외
    예외는 즉시 전파한다(실제 버그를 조용히 삼키지 않기 위함). 신규
    테스트 6개 포함 전체 129개 통과.
2026-08-16 fix(app): 제안 확인 화면에서 내부 버튼 코드(BT-08 등) 숨김
    단계 카드에 사람이 읽는 라벨과 내부 코드를 같이 보여주고 있었는데,
    사용자한테는 개발용 식별자가 그대로 노출되는 거라 라벨만 남김.
2026-08-16 feat(backend): 실행 진행 상황 실시간 추적 + 제안 단계 미리보기 추가
    - ClosedLoopController에 on_progress 콜백 추가, 스레드 안전한
    ExecutionProgressTracker로 실행 중 상태를 /status에서 폴링 가능하게 함
    - 존재하지 않는 센서 값(mA/dB)을 지어내는 대신, 실제로 존재하는 데이터만
    노출(현재 버튼/시도 횟수/완료 단계/검증 신뢰도)
    - 제안(suggestion)에도 실행될 버튼 시퀀스 미리보기(steps) 추가 —
    미리보기 실패가 제안 생성 자체를 막지 않도록 격리
    - 신규/기존 테스트 총 142개 전체 통과 확인
2026-08-16 docs(readme): 앱→RPi5→RPi4 흐름으로 아키텍처 다이어그램 최신화
    - 앱은 ESP32로 직접 가지 않음: ESP32는 BLE→Wi-Fi 폴백 브릿지일 뿐,
    모든 명령은 RPi5(Interpret)를 거쳐 RPi4(Act)로 위임됨을 명시
    - 옛 Arduino Uno GRBL/TB6600/NEMA17 표기를 실제 하드웨어(CoreXY +
    SwitchBot Z축 + 커스텀 PID 펌웨어)로 정정
    feat(app): 홈 화면 Chip을 가전명 대신 BLE 연결 상태로 변경
    - 특정 가전명을 헤더에 고정 표시하면 "범용 기기 호환" 컨셉과
    어긋나므로 연결됨/미연결 텍스트 + 색상(연결 시 success 그린)으로 교체
    - overflow ellipsis 추가로 잘림 방지
2026-08-16 fix(kiosk): 존재하지 않는 mA/dB 센서 필드 대신 실제 진행상황 필드 연동
    - KioskStatus가 current_ma/sound_db(백엔드에 없어 항상 null) 대신
    current_button/current_attempt/completed_steps/verification_confidence/
    verification_detail을 파싱하도록 수정
    - 실행 화면 우측 카드를 검증 신뢰도(%) + 재시도 횟수 카드로 교체,
    좌측 진행 라벨도 현재 버튼/시도 횟수를 실시간으로 표시
2026-08-16 feat(kiosk): 제안 화면 버튼맵에 승인 전 시퀀스 하이라이트 추가
    - KioskSuggestion에 steps(버튼 라벨 미리보기) 필드 추가 —
    /suggestions가 이제 이걸 내려주므로 그대로 소비
    - _ButtonGrid 매칭 기준을 id에서 label로 변경: 백엔드
    intent 해석기는 버튼을 코드(BT-xx)가 아니라 라벨 문자열
    ("해동" 등)로 돌려주기 때문에 id 매칭으로는 하이라이트가
    전혀 안 붙는 문제가 있었음
2026-08-16 feat(app): RPi HTTP 선제 제안을 폰 앱 화면에 실제로 연결
    - RpiSuggestion에 있던 dead code 상태를 해소: /suggestions 폴링
    결과가 이제 suggestionProvider에 실제로 합쳐져서 화면에 뜬다
    (지금까진 BLE로 밀어준 제안만 보였고, RPi5 패턴 학습 결과는
    HTTP 연결 시 화면에 뜰 방법이 아예 없었음)
    - SuggestionNotifier가 BLE·HTTP 출처를 분리 보관 후 병합 —
    한쪽 갱신이 다른 쪽 목록을 지우지 않음
    - Suggestion에 source(ble/http) 필드 추가, 승인/거부 시 실제
    출처에 맞는 채널로만 응답하도록 수정 — 기존엔 "HTTP URL이
    설정만 되어 있으면" 모든 제안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
2026-08-16 fix(rpi4): 실제 RPi4(Act) 실행기 구현 + rpi4/ 패키지 내 역할 오표기 정정
    - rpi4/services/bridge.py(UartBridge)는 사실 ESP32<->RPi5(Interpret)
    브릿지인데 rpi4/ 패키지 이름 때문에 RPi4 역할처럼 보였음 — 정작
    RPi5가 RPi4로 이미 해석된 시퀀스를 넘기는 쪽(Act) 코드는 없었음
    - protocol.md의 "UART 프로토콜 (RPi5 <-> RPi4)" 스펙대로 ActExecutor
    신규 구현: execute{sequence_id,buttons} 수신 → 폐루프 실행 →
    result{success,retry}/error 응답. UartBridge와 동일하게 duck-typed
    reader/writer라 시리얼 없이 테스트 가능, 전송 계층 교체도 저비용
    - 신규 진입점 rpi4/act_main.py 추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
2026-08-16 fix(app): 기존에 실패하던 테스트 18개 전부 수정 — UI가 앞서서 테스트가 못 따라간 것들
    두 가지 근본 원인:
    1. 뷰포트 밖 위젯은 Element가 아예 안 생김 — status_screen/suggestion_screen/
    settings_screen 모두 ListView라, 화면이 늘어나면서(센서 카드·버튼맵 그리드·
    RPi URL/가전종류/저장된 기기 섹션 추가) 긴급정지 버튼·승인/거부 버튼 같은
    하단 위젯이 기본 테스트 뷰포트(800x600)에서 안 잡혔음. 테스트 뷰포트를
    충분히 키워서 해결(각 파일에 헬퍼 추가)
    2. 파인더가 더 이상 유일하지 않음 — 버튼맵 그리드+타임라인이 같은 라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
2026-08-16 docs(architecture): RPi5-RPi4 IPC 방식 UART로 확정 기록
    주피터 클로드 2차 검토로 판단 근거(폐루프 레이턴시 결정론성, 시연장
    네트워크 무관) 검증받음. 예솔님과는 물리 배선 가능 여부만 확인하면 됨.
2026-08-16 feat(api): 의도 해석 우회하는 버튼 직접 실행 엔드포인트 추가
    사용자 정의 가전(기기 추가 플로우 1단계)은 규칙 기반 의도 해석기에
    목적→버튼 매핑이 없으므로, "우유 데워줘" 같은 자연어 대신 버튼
    시퀀스를 바로 넘겨 실행할 방법이 필요했음.
    - SimpleLayService.execute_buttons(buttons) 추가 — execute_purpose와
    동일한 폐루프 보장(재시도·검증)은 받지만 의도 해석 단계를 건너뜀.
    ready/running 가드 로직은 _guard_can_execute()로 공통화
    - 목적 문자열이 없어 패턴 학습용 사용 로그에는 남기지 않음(안 그러면
    서로 무관한 버튼 입력들이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
2026-08-16 feat(app): 기기 추가 플로우 1단계 — 사용자 정의 가전 데이터 모델 + 저장
    - ApplianceButton/ApplianceMap에 toJson/fromJson 추가. 아이콘은
    코드포인트로 직렬화하면 릴리즈 빌드 아이콘 트리셰이킹이 깨질 수
    있어서, 커스텀 가전은 고정 아이콘을 쓰고 저장 대상에서 제외
    - CustomAppliancesNotifier/customAppliancesProvider 신규 — SharedPreferences에
    JSON으로 저장. allAppliancesProvider가 내장(kAppliances) + 커스텀을 합침
    - selectedApplianceProvider가 저장된 선택값을 kAppliances뿐 아니라
    커스텀 목록까지 대조하도록 수정. CustomAppliancesNotifier의 비동기
    로딩이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
2026-08-16 feat(app): 기기 추가 플로우 2단계 — 버튼맵 그리드 에디터 화면
    - ApplianceEditorScreen 신규 (/appliance/new): 가전 이름 입력, 행/열
    스테퍼(1~6), 빈 칸 탭 → 버튼 이름 입력 다이얼로그로 추가/수정/삭제
    - 저장 시 이름·버튼 최소 1개 검증 후 customAppliancesProvider에 추가하고
    바로 선택 상태로 전환, 화면 닫힘
    - 설정 화면 가전 선택 섹션에 "새 가전 추가" 진입점 + 커스텀 가전 삭제(X) 추가
    - 테스트 7개 추가, 전체 87개 통과
2026-08-16 feat(app): 기기 추가 플로우 3단계 — 커스텀 가전 수동 실행 화면 연결
    - RpiApiService.executeButtons() 추가 (POST /execute-buttons 호출)
    - ManualControlScreen 신규 (/manual-control): 선택된 가전의 버튼
    그리드를 보여주고 탭 한 번 = 버튼 하나 즉시 실행. 실행 중엔 다른
    버튼 탭 무시(백엔드가 동시 실행을 막으므로 409 방지), 결과를
    2초간 체크/엑스 아이콘으로 표시 후 원상복구
    - RPi URL 미설정 시 설정 화면으로 안내하는 빈 상태 처리
    - 홈 화면 FAB이 선택된 가전의 isCustom에 따라 분기: 내장 가전은
    기존 "말하기"(음성), 사용자 정의 가전은 "버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
2026-08-16 style(app): 색상 팔레트 리디자인 + 신규 화면 카드 레이아웃 정리
    - 흔한 다크 배경(#0D1117)+시안(#4FC3F7) 조합 대신, 중성 다크 배경
    + 따뜻한 골드 포인트 컬러로 교체. 상태색(성공/경고/위험)도 골드와
    색상환에서 뚜렷이 구분되도록 재조정
    - 카드/버튼 모서리 반경 확대(16→20, 12→14)로 톤 다운
    - 가전 등록/수동 조작 화면을 카드로 감싸서 여백·위계 정리
2026-08-16 docs(hardware): CoreXY 구동부 설계 확정 문서화 — 가운데 개방형 + 홈 파킹
    여러 문서에 흩어져 있던 옛 구조(피니언/렉) 설명과 최신 CoreXY 결정이
    섞여 혼란스러웠던 걸 정리. 오늘 확정한 신규 사항도 반영:
    - 프레임 가운데를 개방해서 사용자가 수동으로 버튼을 누를 수 있게
    - 동작 완료 후 캐리지가 홈 포지션(버튼 적은 쪽 가장자리)으로 복귀
    - 예솔님 검토 필요 항목(홈 위치 선정, 프레임 강성, Z축 동반 파킹) 명시
2026-08-16 docs: 문서 전반의 옛 구조(GRBL/Arduino Uno/TB6600/NEMA17) 잔재 정리
    CoreXY 전환 이후에도 여러 문서에 옛 피니언/렉 레일 설계(GRBL 모션
    제어, TB6600 드라이버, NEMA17 스테퍼) 설명이 그대로 남아 실제 구현과
    어긋나 있었다. 전수 점검해서 정리:
    - esp32-firmware-spec.md: "ESP32가 G-code 조립해서 GRBL로 전달"하는
    전체 설계를 실제 역할(BLE↔UART 순수 릴레이)에 맞게 다시 작성
    - architecture.md: 데이터 흐름도를 RPi5/RPi4 분리 + 실제 액추에이터
    체인(Arduino+BLE 버튼 장치)으로 재작성, 결정 항목 최신화
    - closed-loop-design.md, reuse-boundary.md, roadmap.md: GRBL 관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
2026-08-16 feat(theme): 라이트/다크 모드 토글 + 키오스크 색상 동기화
    - AppColors: 라이트 팔레트 추가 (backgroundLight, primaryLight 등)
    warning 색상을 #E2793D → #F0B429 (골드와 색조 뚜렷이 구분)
    BuildContext 확장(AppColorsX)으로 모드별 색상 접근 헬퍼 추가
    - AppTheme: _build() 통합 메서드로 light/dark ThemeData 동시 생성
    라이트 모드: 크림 배경(#F4F1EB) + 다크 골드(#8B6010) 포인트
    - ThemeModeNotifier: SharedPreferences로 설정 영속 저장
    - main.dart: ConsumerWidget으로 변경, theme/darkTheme 모두 지정
    - settings_screen: 설정 최상단에 라이트/다크 토글 스위치 추가
    - KioskColors: AppColors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
2026-08-16 fix(touchscreen): Stack 안 콘텐츠가 화면을 안 채우던 레이아웃 버그 수정
    body의 Stack에서 메인 콘텐츠(AnimatedSwitcher)가 Positioned로 안
    감싸져 있어서, Stack의 기본 loose constraint 때문에 화면 전체가
    아니라 내용물 크기만큼만 렌더링되고 있었음. Positioned.fill로 감싸서
    항상 화면을 꽉 채우도록 수정. 실기기(터치스크린)에서도 영향 있었을
    버그라 스크린샷 작업과 별개로 고쳐야 했음.
2026-08-16 design(kiosk): 4개 화면 시각 계층 대폭 강화
    - 실행 화면: 현재 버튼명 44px hero container, 신뢰도 52px, 단계 배지 추가,
    재시도 시 경고 색상 전환으로 폐루프 재보정 상태 명확화
    - 대기 화면: 방사형 그라디언트 배경 + 이중 링 아이콘 + 시계 18px 확대
    - 제안 화면: 승인 버튼 glow 효과, 카운트다운 숫자 14px, 제안 제목 30px
    - 완료 화면: 원 144px, 텍스트 38px, 결과 색상 방사형 그라디언트 배경
    - 상단 진행 바: 4px 두께 + gold glow 효과
2026-08-16 refactor: 파일 구조화 — 뷰·위젯을 각 파일로 분리
    kiosk 앱:
    - kiosk_screen.dart → 상태 관리 + _TopProgressBar만 남김
    - widgets/kiosk/idle_view.dart → KioskIdleView
    - widgets/kiosk/suggestion_view.dart → KioskSuggestionView + _ButtonGrid
    - widgets/kiosk/executing_view.dart → KioskExecutingView + 하위 위젯들
    - widgets/kiosk/done_view.dart → KioskDoneView
    앱:
    - widgets/status_kpi_strip.dart → StatusKpiStrip + _KpiCard (신규)
    - status_screen.dart → StatusKpiStrip import 및 KPI 헤더 삽입
2026-08-16 design(home): AI 학습 통계 카드 추가
    홈 화면 BLE 카드 바로 아래에 LearningStatsCard 삽입 —
    제안 수, 평균 단계, 총 동작 수를 세 개의 pill로 표시.
    데이터가 없을 때는 '학습 중' 상태를 보여준다.
    위젯 파일: app/lib/widgets/learning_stats_card.dart
2026-08-16 fix(theme): 주요 화면 hardcoded Colors.white* → 테마 인식 토큰으로 교체
    home_screen:
    - FAB backgroundColor/foregroundColor → context.appPrimary / colorScheme.onPrimary
    - BleStatusCard 배경·테두리·아이콘 → context.appPrimary / appSurfaceLow / appBorderSubtle
    - SuggestionTile 아이콘·화살표 → context.appPrimary / context.appMuted
    status_screen:
    - 진행 바 배경 → colorScheme.surfaceContainerHigh
    - 진행 바 색상 → colorScheme.primary
    - StepTile 대기 아이콘 → context.appBorderSubtle
    - StepTile 타임라인 선 → context.appBorderSubtle
2026-08-16 docs: 스크린샷 정리 — 잘못 캡처된 파일 원본 복구
    Copilot이 app_settings/status/suggestion을 홈 화면으로 잘못 캡처함.
    cfae327에서 올바른 원본 복구. app_home.png는 새 골드 디자인 유지.
    app_home_light.png는 Flutter 스플래시로 캡처돼 app_home.png로 대체.
2026-08-16 docs(screenshots): 키오스크 화면 4종 골드 팔레트 목업으로 교체
    idle / suggestion / executing / done 4개 상태를 800×480 해상도,
    KioskColors 팔레트(골드 #D9A356, 세이지그린 #5FBF8F, 배경 #0C0E12)로 렌더링.
    0818_임베디드.pptx Slide 14 키오스크 2×2 그리드도 동일 이미지로 갱신.
2026-08-16 fix(app): StatusKpiStrip RenderFlex 오버플로우로 테스트 12개 연쇄 실패하던 버그 수정
    KPI 카드(진행/전류/음향) 안의 값+단위 Row가 카드 폭(~83px)을 넘는
    값(예: "3 / 3 단계")에서 최대 21px까지 오버플로우 — 렌더링 예외가
    같은 pump 사이클의 다른 위젯 테스트까지 연쇄로 실패시키고 있었다.
    FittedBox(scaleDown)로 감싸서 넘치는 대신 줄어들게 수정.
    전체 93개 테스트 통과 확인.
2026-08-16 fix(app): 설정 화면 라이트 모드 대비 버그 수정 + 앱 스크린샷 실기기로 재촬영
    - settings_screen.dart에 남아있던 하드코딩 Colors.white38/54/70/24를
    테마 인식 토큰(context.appMuted/appBorderSubtle, surfaceContainerHigh)
    으로 교체 — 다른 화면은 이미 정리됐는데 이 파일만 빠져 있었음.
    라이트 모드에서 RPi 서버 안내문·저장된 기기 텍스트가 거의 안 보일
    정도로 흐리게 나오던 문제
    - Android 에뮬레이터 실기기로 골드 테마 + 학습 통계 카드 + 새 가전
    추가 버튼까지 반영해서 6개 스크린샷 재촬영(홈/홈-빈상태/홈-라이트/
    설정/상태/제안 확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
2026-08-16 feat(app): 제안 데모 시나리오를 전자레인지 우유에서 에어컨 냉방으로 교체
    전자레인지에 우유 데우기 코스가 있다는 설정이 부자연스럽다는 피드백을
    반영해, 데모 시뮬레이션(제안 시뮬레이션 버튼)이 만드는 목데이터를
    무더위 상황에 어울리는 "냉방 시작" 시나리오로 바꿨다.
    - kAppliances에 에어컨(전원/온도-/온도+/냉방/제습/송풍/바람세기/예약/취소)
    가전을 새로 추가
    - demo_service.dart의 목데이터를 전자레인지 BT-08/03/05(우유→1분→시작)에서
    에어컨 AC-01/02/04(전원→온도-→냉방)으로 교체
    - suggestion.dart의 buttonLabels에 AC-01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
2026-08-16 docs(screenshots): 실행 상태 화면을 완료 상태로 재촬영
    에어컨 냉방 시나리오(AC-01/02/04) 실행 완료 후 KPI(전류/음향) 실측치가
    채워진 상태로 다시 찍어서, 대기 상태만 보여주던 기존 스크린샷보다
    기능을 더 잘 보여주도록 교체.
2026-08-16 feat(kiosk): 대기 화면을 탁상시계 스타일로 전면 교체
    가전 이름·아이콘 중심의 기존 idle 화면 대신, 큰 디지털 시계를
    전면에 배치하는 앰비언트 클락 UI로 변경.
    - 시:분 108px 골드 그라디언트 (상단 밝은 금 → 하단 primary)
    - 콜론 홀짝 초마다 opacity 0.25↔1.0 전환 (AnimatedOpacity)
    - 좌우 페이드 장식선으로 시계 강조
    - 초 표시 (16px, muted gold) 아래에 배치
    - 가전명·AI 모니터링 중·펄스 닷 → 하단 중앙 pill 배지로 이동
    - RPi 연결 상태는 최하단 작은 텍스트로 분리
2026-08-16 test(kiosk): 탁상시계형 대기화면 개편에 맞춰 위젯 테스트 갱신
    idle_view.dart가 "AI가 패턴을 학습하고 자동으로 제안합니다" 문구를 제거하고
    디지털 시계+날짜+모니터링 배지 구조로 바뀌면서 깨졌던 테스트를 새 배지
    문구("AI 모니터링 중") 기준으로 갱신.
2026-08-16 docs(screenshots): 키오스크 화면 4종 실행 상태로 재촬영
    탁상시계형 대기화면 개편(941e5ab) 이후 스크린샷이 갱신 안 되어 있었고,
    기존 제안 화면도 현재 버튼 배치와 안 맞는 예전 예시였음. 실제 앱을
    브라우저로 띄워 대기/제안/실행/완료 4단계를 모두 다시 찍었고, 제안
    시나리오도 현재 전자레인지 버튼 구성(해동/자동조리/시작)에 맞게 정리.
2026-08-17 docs(screenshots): 설정 화면 스크린샷에 에어컨 가전 추가 반영
    기존 app_settings.png가 에어컨 가전 추가(1061235) 이전 캡처라
    가전 종류에 전자레인지/인덕션만 보이던 문제를 재촬영으로 수정.
2026-08-17 refactor(kiosk): 대기 화면 극도로 단순화 — 시계 + 우하단 dot만
    배지·글로우·그라디언트·"AI 모니터링 중" 문구 전부 제거.
    날짜 + w300 오프화이트 시계(108px) + 콜론 페이드 블링크 + 5px dot만 남김.
2026-08-17 feat(voice): 사용자 정의 가전도 음성 명령으로 조작 가능하게 확장
    내장 가전(전자레인지/인덕션)만 서버 고정 규칙으로 음성 명령이 되던 것을,
    등록 시점에 정의한 버튼 라벨 어휘를 그대로 LLM에 넘겨 그 자리에서 해석하는
    방식으로 커스텀 가전까지 확장했다.
    - SimpleLayService.execute_purpose_for_appliance(purpose, known_buttons) 추가
    — 요청마다 즉석에서 LlmIntentResolver를 구성, 서버의 usage_log에도 정상 기록
    - POST /execute-for-appliance 신설 (LLM 미설정 503 / 해석 실패 422 / 동시실행 409)
    - rpi/api/deps.py: LLM 클라이언트를 SIMPLELAY_LLM_BASE_URL 등 환경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
2026-08-17 feat(kiosk): 수동 실행·DND·온습도·기구부 상태 4가지 기능 추가
    백엔드:
    - POST /dnd, DELETE /dnd — 방해 금지 설정/해제 (ProactiveSuggestionService에 DND 상태 추가, pending/create_suggestions에서 DND 중 빈 결과 반환)
    - GET /sensors — DHT22 온습도 데이터 (Mock 26.5°C · 58%, 실기기 교체 예정)
    - GET /health — actuator_ready(coreXY+SwitchBot), dnd_until 포함하는 HealthResponse로 개선
    Flutter:
    - KioskManualView: idle 화면 탭 → 가전 버튼 그리드 → 버튼 선택으로 즉시 실행
    - DND 오버레이: idle 화면 롱프레스 → 30분/1시간/2시간 선택 또는 해제
    - idle 화면에 온도·습도 표시 (날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
2026-08-17 feat(voice): 커스텀 가전 음성 명령의 온디바이스 LLM 백엔드 구현
    아침에 만든 HTTP 기반 LlmClient는 "요청 한 번 → JSON 응답 한 번"을
    가정했는데, 실기기 조사 결과 온보드 에이전트 서비스는 요청을 즉시
    접수만 하고 실제 응답은 비동기 스트림으로 보내는 구조였다. 이 새
    어댑터가 그 격차를 메운다.
    - Dbusinternal-platformLlmClient: 요청을 보내는 프로세스와 응답 스트림을 구독하는
    별도 프로세스를 같이 띄워서, 완료 표시까지 온 조각들을 순서대로
    이어붙여 하나의 응답으로 조립
    - 테스트는 실기기에서 직접 캡처한 응답 스트림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
2026-08-17 feat(app): 가전 등록 시 사진 위에 버튼 그리드를 겹쳐볼 수 있게 추가
    컴퓨터비전 없이 순수 기하학으로 처리한다 — 가전 사진을 찍으면 기존
    수동 그리드 에디터를 사진 위에 반투명으로 겹쳐서, 실제 버튼 배치를
    보면서 이름을 붙일 수 있다. 좌표 자동 인식은 안 하고(주피터 클로드가
    지적했던 캘리브레이션/렌즈왜곡 리스크 회피), "제안"만 자동화하고
    "확정"은 여전히 사용자가 직접.
    - PhotoService(image_picker 래퍼) + provider — VoiceService/BleService와
    같은 패턴으로 테스트에서 오버라이드 가능
    - 사진 없이도 기존 동작 그대로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
2026-08-17 feat(danger-sound): 위험소리 감지 DSP 1차 구현 + RPi4→RPi5 alert 채널 추가
    대역 에너지(2800-4200Hz) + 온셋 주기성 검사로 화재/가스 경보음을 완료음 같은
    유한 반복과 구분하는 DangerSoundDetector 구현. RPi4 ActExecutor에 자체발신
    alert/alert_cleared 메시지(엣지 트리거)를 추가해 RPi5로 즉시 푸시할 수 있게 함.
    RPi5 쪽 수신 클라이언트는 아직 없어 로드맵/개발현황에 남은 작업으로 명시.
2026-08-17 feat(uart): RPi5→RPi4 UART 클라이언트 구현 + SimpleLayService 실연결
    ActClient(RPi5측)를 ActExecutor(RPi4측)의 미러로 구현하고, 메모리 파이프로
    직접 연결해 두 구현이 실제로 상호운용되는지 통합 테스트로 검증. 동기↔비동기
    다리 역할의 ActClientController를 추가해 SIMPLELAY_ACT_MODE=uart 환경변수로
    SimpleLayService가 실제 RPi4에 연결되도록 배선(기본값은 여전히 로컬 mock).
    RPi4는 집계 결과(success/retry)만 보내므로 버튼별 실시간 진행상황은 이
    모드에서 비어 있음 — 의도적으로 선택한 범위(docs/roadmap.md M2).
2026-08-17 feat(intent): 온디바이스 벡터DB 유사도 매칭 리졸버 구현
    VectordbIntentResolver + VectordbClient(internal-platform 기반, 규칙기반과 LLM 리졸버
    사이의 빠른 오프라인 유사도 매칭 계층으로 TieredIntentResolver에 얹을 수
    있음). CreateDB/AddText/SearchText 호출은 D-Bus 스펙 문서의 예시를 따름 -
    AddText/SearchText의 실제 internal-platform 출력 포맷은 실기기 미검증이라 파싱 로직을
    독립 순수함수로 분리해 나중에 쉽게 교체 가능하게 함. 리졸버 자체 로직은
    fake client로 전부 테스트.
2026-08-17 feat(alerts): 위험소리 alert 표면화(GET /alerts) + 컨트롤러 팩토리 공유화
    DangerAlertStore가 RPi4 자체발신 alert/alert_cleared의 최신 상태를 보관하고
    GET /alerts로 노출. deps.py의 컨트롤러 선택 로직을
    rpi/services/controller_factory.py로 옮겨 향후 다른 진입점(ESP32 경로 등)에서도
    재사용 가능하게 정리.
    UartBridge(ESP32 경로)는 이번엔 배선 안 함 - rpi4/main.py와 rpi/main.py가
    RPi5에서 별도 프로세스로 뜨기 때문에, 둘 다 UART 모드를 켜면 같은 RPi5-RPi4
    물리 포트를 두 프로세스가 동시에 열려는 충돌이 생김. 프로세스 통합이나 포트
    중개자가 필요한 문제라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
2026-08-17 refactor(kiosk): 4개 화면 디자인 정리 + 위험소리 alert 오버레이 추가
    주피터 클로드 피드백 반영(대기 화면 센서 들썩임 수정, 완료 화면 gradient
    제거) + 제안/실행중 화면의 카드형 장식 제거하고 flat하게 재정리. 오늘 만든
    GET /alerts를 처음으로 UI에 연결 - 위험소리 감지 시 전체화면 오버레이,
    오탐 대비 확인 버튼(백엔드 상태는 유지, 화면에서만 숨김). kiosk_screen.dart를
    kiosk_phase/top_progress_bar/dnd_overlay/danger_alert_overlay로 분리.
2026-08-17 docs(screenshots): 키오스크 화면 4종 재촬영 (디자인 정리 반영)
    이전 촬영이 대기화면 극단순화 + 오늘 밤 디자인 정리(배지/글로우 제거,
    카드 flat화) 이전 버전이라 최신 상태로 갱신.
2026-08-17 fix(screenshots): 제안/실행중 키오스크 스크린샷 라벨 오류 수정
    직전 커밋에서 캡처-저장 사이 타이밍 갭 때문에 touchscreen_suggestion.png가
    실제로는 대기 화면을, touchscreen_executing.png가 완료 화면을 담고 있었음.
    각 상태 직후 바로 저장하고 즉시 검증하는 방식으로 다시 촬영해 교체.
2026-08-18 feat(multi-node): 가전별 노드 라우팅 계층 구현
    확정 아키텍처 반영(RPi5 중앙 허브 + 가전마다 RPi4/ESP32 노드). NodeRegistry가
    appliance_id -> 노드 컨트롤러를 관리하고, SimpleLayService가 요청에 실린
    appliance_id로 로컬 기본 컨트롤러 대신 등록된 노드로 라우팅한다. appliance_id가
    없거나 미등록이면 기존 동작 그대로라 완전히 하위호환.
    개발용 전송 구현체 EspNodeController(HTTP)를 추가하고, ActClientController와
    공유하던 "집계 결과 -> ExecutionResult" 변환 로직을 aggregate_result.py로 뽑아
    중복 제거. 노드 등록/조회/해제용 /nodes 엔드포인트 추가.
    ESP-NOW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
2026-08-18 docs(architecture): 다중 노드 아키텍처로 정정
    RPi5-RPi4가 같은 하우징에서 UART로 직결한다는 예전 가정을 폐기하고, 확정된
    아키텍처(RPi5 중앙 허브 1대 + 가전마다 RPi4/ESP32 노드 여러 대)를 반영. ESP32의
    두 가지 역할(폰 폴백 브릿지 vs 노드 무선 창구)을 구분해서 명시하고, 데이터 흐름
    다이어그램과 보드 분리 표, RPi-하드웨어 연결 체크리스트를 전부 갱신.
2026-08-18 feat(firmware): 가전 노드용 ESP32 펌웨어 스캐폴딩 (firmware-node/)
    기존 firmware/(폰 앱 BLE 폴백 브릿지)와 별개인 새 PlatformIO 프로젝트. WiFi로
    붙어서 POST /execute를 받고, RPi4로 UART execute를 보낸 뒤 result/error를
    기다렸다가 집계 결과(success/retry)로 응답 - rpi/services/esp_node_controller.py
    의 EspNodeController가 기대하는 그대로. RPi4가 자체발신하는 alert/alert_cleared도
    상시 흡수해서 GET /alerts로 노출.
    본선 데모용 ESP-NOW 전송은 아직 없음 - ExecuteHandler/AlertsHandler 콜백 인터페이스를
    전송 방식과 무관하게 고정해둬서 나중에 옆에 추가하기만 하면 됨. 이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
2026-08-18 feat(app+kiosk): 노드 등록 UI, 가전 전환, 온보딩 화면 추가
    키오스크
    - settings_overlay: 우하단 dot 3탭 진입, 가전 전환 칩 + ESP32 IP 등록/해제
    - idle_view: StatefulWidget 전환, 관리자 triple-tap 감지 (2초 내 3회)
    - kiosk_screen: _currentAppliance 런타임 전환, executeButtons에 appliance_id 전달
    - kiosk_api_service: NodeInfo 모델 + listNodes/registerNode/unregisterNode 추가
    폰 앱
    - onboarding_screen: 최초 실행 1회 표시 (onboarding_done prefs 기반)
    - main: 비동기 초기화, /onboarding initialLocation 분기
    - settings_screen: "ESP32 노드" 섹션 + _NodeEditSheet 바텀시트 (IP 입력·저장·해제)
    - rpi_api_service: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
2026-08-18 feat(rpi): DHT22 실연결 + actuator_ready GPIO placeholder + RPi5 배포 스크립트
    rpi/api/config.py (신규)
    - 환경변수 기반 GPIO 핀 설정 (SIMPLELAY_GPIO_ENABLED, DHT22_GPIO, HOME_X/Y/Z_GPIO)
    - 기본값 false → 개발 PC에서 mock 모드, 서비스 파일에서 true로 활성화
    rpi/services/dht22.py (신규)
    - adafruit-circuitpython-dht + BLINKA_LGPIO 백엔드 (RPi5)
    - 미설치/미연결/타이밍 오류 → (None, None) 반환, router에서 mock 값 fallback
    rpi/services/actuator.py (신규)
    - gpiozero Button으로 NC 홈 스위치 X·Y(·Z) 읽기
    - GPIO 미설정 → True(ready) fallback (개발 환경 안전)
    rpi/api/router.py
    - sensors(): Dht22Sens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
2026-08-18 feat(app): appliance_id를 실행 API 전 구간에 배선
    execute/executeButtons/executeForAppliance에 appliance_id 옵션 파라미터 추가,
    manual_control_screen·voice_screen 호출부에서 selectedApplianceProvider의
    appliance.id를 실어 보내도록 배선. 노드 등록(POST /nodes)만으로는 라우팅이
    안 되고 실행 요청에 appliance_id가 실려야 NodeRegistry가 실제로 등록된
    노드로 보낼 수 있어서 필요한 나머지 절반 — 노드 CRUD 자체는 이미 반영됨.
    docs/roadmap.md: 8/18 지도교수 미팅 반영 (하드웨어 우선 방향, Z축 모터 결정,
    다음 미팅 10/2)
2026-08-18 fix(app): eaecc02 리팩터로 깨진 테스트 11개 수리 + RpiUrlNotifier dispose 버그 수정
    - rpi_api_provider.dart: RpiUrlNotifier._load()가 await 이후 mounted 체크
    없이 state를 설정해서 컨테이너가 이미 dispose된 뒤 호출되면 크래시하던
    버그 수정 (suggestion_provider_test가 이 버그를 실제로 잡아냄)
    - settings_screen.dart가 "기기 이름" 필드를 걷어내고 RPi URL 섹션을
    고급 설정 토글 뒤로 옮겼는데(eaecc02) 테스트가 갱신 안 돼 있던 것 수정 —
    스낵바 없는 저장 흐름은 provider 상태 확인으로 재작성
    - home_screen.dart의 통합 연결 안내 문구가 BLE/RPi 카드 분리로 바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
2026-08-19 docs(개발현황): 전면 업데이트 — 멀티노드 아키텍처·Flutter 앱·RPi5 배포 반영
    2026-08-16 이후 추가된 전체 내용 반영:
    - 다중 노드 아키텍처 확정 (NodeRegistry, EspNodeController)
    - Flutter 키오스크 앱 완성 (4단계 화면, 관리자 설정 오버레이)
    - Flutter 폰 앱 온보딩·DND·노드 등록 추가
    - RPi5 배포 스크립트·systemd·GPIO 환경변수 표
    - Z축 SwitchBot 내부 모터 분리로 업데이트
    - API 엔드포인트 전체 목록, Provider 표, 폴더 구조 최신화
2026-08-20 docs(로드맵): 결선 10주 실행 계획 추가 — 코드 리뷰 반영, 스프린트별 완료 기준 정의
2026-08-20 fix(app): 릴리즈 빌드 네트워킹 수리 — INTERNET 권한 + cleartext HTTP 허용
    디버그 빌드는 Flutter 툴이 INTERNET/cleartext를 자동 주입해 정상 동작하는
    것처럼 보이지만, 릴리즈 APK에는 main 매니페스트에 직접 선언이 없으면
    RPi5 HTTP 통신이 전부 SocketException으로 실패한다.
2026-08-20 fix(app): BLE 데모 래치 해제 + 구독 누수 수리
    - connect()가 _isSimulated를 리셋하지 않아, 설정에서 시뮬레이션을 한 번
    누른 뒤 실제 ESP32에 연결하면 send()가 예외 없이 전부 무시되던 버그 수정
    - connectionState 리스너를 필드로 보관해 재연결 시 누적/dispose 누수 제거
    - scan() 타임아웃 지연 콜백이 dispose된 컨트롤러에 add하던 StateError 방지
2026-08-20 feat(rpi): 긴급 정지 실구현 — /stop이 실제로 실행을 멈춘다
    기존 /stop은 주석만 있는 no-op이라 UI가 '정지됨'을 표시해도 실행이
    계속되는 안전 결함이 있었다.
    - ClosedLoopController.request_stop(): threading.Event 기반 협조적 취소.
    버튼 사이 + 재시도 경계에서 확인, SAFETY_STOPPED로 안전 종료.
    유휴 상태의 stale 요청은 다음 execute() 시작 시 clear로 무해화
    - ActClientController.request_stop(): UART 모드에서 RPi4에 abort 전송
    (fire-and-forget, 프로토콜상 무응답 — 전송 실패는 로그)
    - SimpleLayService.emergency_stop(): 로컬 + 등록된 모든 노드 컨트롤러에
    정지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
2026-08-20 feat(rpi): 선제 제안 생성 배선 — 주기 스케줄러 + 시연용 수동 트리거
    create_suggestions()는 그동안 프로덕션 어디에서도 호출되지 않아
    GET /suggestions가 항상 빈 배열이었다(공감지능 전체가 죽은 코드).
    - FastAPI lifespan에서 60초 주기 패턴 감지 루프 가동 — 사용 이력이
    쌓이면 제안이 실제로 화면에 뜬다
    - POST /demo/suggest: 패턴 감지(이력 3회+시간대)를 우회해 제안을 즉시
    생성하는 시연용 트리거. 시간대 설정의 빈 구간(예: 오후 3시)에도 데모
    성립. 연타해도 pending 중복 없음, DND 중엔 409
    - reject를 서비스 메서드(ProactiveSuggestionSer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
2026-08-20 fix(kiosk+app): 지연 응답 유령 완료 화면 방지 + 제안 승인·거부 에러 표면화
    - 키오스크 _finishExecuting에 phase 가드 추가 — 정지/완료 후 뒤늦게
    도착한 approve·execute 응답이 idle 화면을 완료 화면으로 점프시키던
    레이스 차단 (_toDone과 동일한 가드로 대칭 맞춤)
    - 폰 앱 제안 승인·거부의 HTTP 예외를 사용자 언어로 표면화 — 기존엔
    uncaught로 화면이 안 닫히고 피드백이 없었다. 409(이미 실행 중)는
    별도 안내, 거부의 404(서버에 이미 없음)는 로컬 제거로 계속 진행
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2026-08-21 feat(rpi): 실행을 비동기 job 모델로 전환 — 즉시 job_id 반환 + /status 폴링
    동기 블로킹 실행은 실기기에서 구조적으로 파탄이었다: 버튼 시퀀스가
    수 초~수십 초(UART 35초) 걸리는데 클라이언트 타임아웃은 폰 8초·키오스크
    4초라, mock(즉시 완료)에서만 우연히 동작하고 실기기에선 클라이언트가
    전부 '실패'를 표시하는 동안 갠트리는 계속 움직였다.
    - /execute·/execute-buttons·/execute-for-appliance·approve가 의도 해석
    (즉시 실패 가능한 부분: 422/503/409)만 동기로 끝내고 물리 실행은
    백그라운드 스레드로 제출, JobAcceptedResponse{job_id} 즉시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
2026-08-21 feat(app+kiosk): 클라이언트를 job 모델로 전환 — /status 폴링 기반 상태 동기화
    폰 앱:
    - 실행 API 4종이 JobAccepted{jobId}를 받도록 전환, /status 파싱에
    job_id·last_job_id·total_steps·진행 필드 추가
    - ExecutionStatusNotifier.beginHttpJob: 1초 주기 /status 폴링으로 실행
    화면이 실제 진행·완료를 표시 (BLE-only 연결이 사라져 HTTP 실행 시
    '영원히 대기 중'이던 문제 해소). job_id 대조 완료 판정, 재진입 가드,
    30초 무응답 시 실패 탈출
    - 긴급 정지: HTTP 추적 중엔 서버 /stop 호출 후 폴링이 safety_stopped를
    받아 종료 표시 (성급한 '정지됨' 표시 제거)
    - 음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
2026-08-21 fix(app): Flutter 3.47 정합 — 설정 카드 Material화, 테스트 안정화, lock 갱신
    이 PC에 Flutter 3.47.1 + Android SDK 툴체인을 구축하고 전체 검증 수행.
    - _SettingCard의 배경색을 Container 데코레이션에서 Material로 이동 —
    ListTile이 색 있는 DecoratedBox에 싸이면 Flutter 3.4x부터 assertion으로
    터진다 (설정 화면 테스트 11개가 이것으로 실패했었음)
    - 제안 화면 에러 알림에 context.mounted 가드 (use_build_context_synchronously)
    - voice 테스트에 폴링 타이머 정리 pump 추가 (pending timer 방지)
    - pub get에 따른 pubspec.lock·analysis_options 자동 갱신
    검증: 폰 앱 flutter test 105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
2026-08-21 docs(devlog+로드맵): 2026-08-21 — 툴체인 구축·W1 job 모델 완료·전 스위트 통과 기록
    W0 체크리스트 5/5, W1 체크리스트 5/5 완료 표시.
    검증: pytest 336 · flutter test 105 · analyze 클린 · 릴리즈 APK 빌드 성공(52MB)
2026-08-21 fix(app): 라이트 모드 색상 수리 — Colors.white* 하드코딩을 테마 토큰으로
    크림색 라이트 배경에서 수동 조작 그리드·제안 버튼맵·시트 핸들이 거의
    보이지 않던 문제. AppColorsX에 밝기 대응 토큰 5종(appOverlayFaint·
    appBorderFaint·appOutline·appOnSurfaceSoft·appOnSurfaceFaint)을 추가하고
    수동조작·제안·설정·DND시트·가전등록 화면의 하드코딩을 교체.
    사진 위 오버레이(가전 등록 translucent 모드)의 흰색은 사진 대비용
    의도적 선택이라 유지. flutter test 105개 통과
2026-08-21 refactor(kiosk): 타이밍 상수 단일화 + API 생성자 주입 + phase 머신 테스트 5개
    - KioskTimings: 카운트다운 10초·done 복귀 3초·진행바 폴백 9초를 단일
    출처로 — 화면/위젯 3곳이 각자 하드코딩해 한쪽만 바꾸면 진행바가
    어긋나던 문제 제거 (HTML 포팅 때 이미 9초/8초로 어긋난 전력)
    - KioskScreen(api:)로 서비스 주입 가능 — 테스트 가능 설계로 전환
    (주입분은 dispose하지 않음)
    - phase 머신 위젯 테스트 신규 5개: 제안 전환 / 승인→실행→완료→idle
    복귀 / stale last_job_id 무시 / 폰 발 실행 이어받기 / 접수 실패
    즉시 탈출. analyze 클린, 테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
2026-08-21 feat(app): 가전 등록 사진 영구 저장 + 수동 조작 화면 사진 배경
    기존엔 사진이 image_picker 임시 캐시 경로로만 존재해 저장 시 버려졌다
    (재확인 화면에서 사진 소실 — 리뷰 중요 이슈).
    - ApplianceMap.photoPath 필드 추가(직렬화 포함), 저장 시 문서 폴더
    appliance_photos/{id}.jpg로 복사 (path_provider). 복사 실패는 등록을
    막지 않음
    - 가전 삭제 시 사진 파일도 best-effort 정리
    - 수동 조작 화면: 사진이 있으면 버튼 그리드 뒤에 실제 패널 사진 +
    가독성 스크림 표시 — 실제 버튼 배치를 보면서 누를 수 있다. 사진 위
    셀은 테마와 무관하게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
2026-08-21 feat(app): mDNS 의존 제거 — 앱 내 .local 조회 + 주소 직접 입력 동선 + URL 정규화
    Android 시스템 DNS는 simplelay.local(mDNS)을 해석하지 못해 기본 URL이
    대부분의 폰에서 영원히 unreachable이었다(치명 이슈 ②).
    - MdnsResolver: 앱이 직접 mDNS A 질의로 IP를 알아내고, 연결 확인 실패 시
    자동으로 URL을 IP로 교체 저장 (교체가 재확인을 트리거). 실패는 조용히
    주소 입력 동선으로 폴백. CHANGE_WIFI_MULTICAST_STATE 권한 추가
    - 홈 연결 카드에 '주소 입력' 버튼 — IP만 쳐도 저장 가능
    - normalizeRpiUrl: 스킴·포트 없는 입력('192.168.0.5')을 완전한 URL로
    중앙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
2026-08-21 feat(deploy): 키오스크 자동실행 + 배포 스크립트 정비 (Bookworm 대응)
    배포 체인이 백엔드만 설치하고 키오스크는 방치하던 문제(치명 이슈 ⑤의
    소프트웨어 절반) + 리뷰 지적 B7/B8/B10 수리:
    - simplelay-kiosk.service 신규: cage(Wayland 키오스크 컴포지터)가 tty1에서
    Chromium 전체화면(/ui)을 자동 실행. X11·데스크톱 불필요, 화면 절전 없음,
    크래시 시 자동 재시작. Flutter(elinux) 전환 시 ExecStart만 교체하면 되는
    구조 — W2 실기기 작업일의 전환 지점을 한 줄로 좁힘
    - setup_rpi.sh 6→8단계: apt-get update를 모든 install보다 먼저(B8),
    에러 출력 은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
2026-08-22 feat(intent): 규칙 사전 확충 + 발화 정규화 — 문자열 1개 의존 탈출
    음성 명령의 견고성이 '우유 데워줘' 정확 일치 하나에 걸려 있었다 —
    STT가 '우유 데워 줘'만 뱉어도 422였던 문제.
    - 매칭 키에서 공백·문장부호 제거 정규화 ('우유데워줘!' == '우유 데워줘')
    - 대표 발화 7종 + 별칭 21종 (멈춰줘→취소, 일분 돌려줘→1분 등).
    별칭은 기본 규칙 사용 시에만 — 규칙 직접 주입 호출자의 어휘는 불변침
    - 테스트 13케이스 추가, 전체 349 passed
2026-08-22 feat(rpi): SQLite 영속화 + 3계층 의도해석 실배선
    [영속화] 사용 이력·노드 등록이 전부 인메모리라 재시작 한 번에 패턴 학습
    데모와 키오스크 등록 ESP32 IP가 증발하던 문제:
    - SimpleLayDb(단일 SQLite, stdlib) + SqliteUsageLog(UsageLog 포트 구현)
    - NodeRegistry에 NodeStore 주입 — 시작 시 복원, 등록/해제 시 저장
    - SIMPLELAY_DB_PATH 환경변수 게이트(기존 GPIO_ENABLED 관례) — 미설정이면
    인메모리 유지라 개발·테스트 동작 불변, systemd 서비스가 경로 지정
    - pending 제안·last_result는 의도적으로 비영속(스케줄러 재생성/혼란 방지)
    [의도해석] 문서가 자랑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
2026-08-22 feat(security): API 키 인증 — 시연장 공유 Wi-Fi에서 무인증 액추에이터 구동 차단
    무인증 0.0.0.0:8000은 같은 Wi-Fi의 누구든 물리 버튼을 누르거나
    (POST /execute-buttons) 노드 등록을 바꿔 실행 트래픽을 가로챌 수 있었다.
    서버:
    - SIMPLELAY_API_KEY 설정 시 라우터 전체에 X-API-Key 요구
    (hmac.compare_digest 상수시간 비교). 미설정이면 기존처럼 개방
    - 루프백 클라이언트 면제 — 같은 보드의 키오스크는 키 배포 불필요
    - /health는 개방 유지 — 폰이 키 입력 전에 연결 확인(ping) 가능
    - 테스트 7개 (게이트·오류 키·루프백 면제·실행 경로 보호)
    폰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
2026-08-22 fix(app): BLE 폴백 실동작화 + 저장 기기 재연결 수리
    - 음성 명령의 BLE 폴백이 'rpiApi == null일 때만'이라는 도달 불가 조건에
    걸려 죽은 코드였다(URL은 첫 실행부터 항상 존재). 이제 서버 무응답
    (네트워크 실패)이면 BLE 연결 상태를 확인해 ESP32 릴레이로 폴백 전송하고
    '서버 응답이 없어 BLE로 전송했어요'를 안내 — 'Wi-Fi 끊고도 동작' 시연이
    실제로 성립한다. 서버가 살아서 거절한 4xx/5xx는 폴백하지 않음
    - 설정의 저장 기기 '재연결'이 스캔을 시작하지도 않고 결과 스트림을
    기다려 영원히 안 끝나던 버그 — 8초 스캔으로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
2026-08-22 fix(rpi): /sensors 응답에 mocked 플래그 — mock 폴백값을 실측인 척 반환하던 문제 수리
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2026-08-22 feat(rpi4): Act 보드에 실센서 배선 + UART abort 협조적 정지 완결
    W3 마지막 코드 항목 — '구현돼 있는데 안 꽂힌' 검증 계층 조립:
    - SIMPLELAY_SENSORS_ENABLED=true → SensorVerifier(ADS1115 전류 + 마이크
    음향 퓨전) 활성. 기본 false = MockVerifier 유지 — 센서 없는 보드에서
    실행 경로가 죽지 않는 offline-first 관례(GPIO_ENABLED와 동일)
    - SIMPLELAY_DANGER_SOUND_ENABLED=true → DangerSoundMonitor 상시 태스크
    기동. 코드·테스트는 완성돼 있었지만 어느 엔트리포인트도 띄우지 않아
    위험소리 alert가 실기기에서도 절대 발화할 수 없었다. 종료 시 정리 포함
    - _on_a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
2026-08-22 docs(로드맵): 심사 기준 정렬 — 실기기 1순위 확인 항목·협회 1차 방문·TTS 최우선·카메라 감지 검토 추가
2026-08-22 feat(rpi): 리허설 실패 주입 — 폐루프 재시도 장면을 원할 때 연출 (S1)
    결선 핵심 장면('일부러 실패시켜도 스스로 재시도')을 하드웨어 운에 맡기지
    않고 스크립트로 연출하는 장치.
    - POST /demo/inject-failure {button_index, attempts}: 다음 실행의 지정
    버튼 검증을 강제 실패. attempts 1~2 = 보정 재시도 후 성공, 3+ =
    재시도 소진 → 안전 정지. DELETE로 해제
    - FailureInjectionVerifier: verifier 래퍼라 mock/실센서 어느 쪽에도 적용.
    슬롯 추적은 '성공한 버튼 수' 기준(재시도 반복 호출과 정합). 1회용 —
    소진 시 자동 해제라 데모 뒤 실사용 무영향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
2026-08-22 feat(kiosk): 음성 안내(TTS) — 제안·실행 결과·위험 경보를 소리로 (S2 1/2)
    타깃 사용자(고령·저시력)가 화면을 보지 않아도 상태를 알 수 있게 한다.
    - KioskTtsService: espeak-ng CLI 프로세스 호출(-v ko, 느린 속도)
    — flutter_tts가 elinux 미지원이라 리눅스 CLI 직행. 러너 주입으로
    테스트 가능, 실패는 전부 삼킴(음성은 보조 채널, 기능을 막지 않음)
    - 발화 3지점: 제안 도착('…지금 실행할까요? 화면에서 승인해 주세요') /
    완료·실패('…완료되었습니다', 서버 유실은 별도 문장) / 위험 경보
    (엣지에서 1회만, DND보다 우선)
    - 설정 오버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
2026-08-22 feat(app): 실행 결과 음성 안내(flutter_tts) + 설정 토글 (S2 2/2)
    - AppTtsService: ko-KR, lazy 초기화, 새 발화 전 이전 발화 중단. 엔진
    부재·실패는 전부 삼킴(음성은 보조 채널)
    - 실행 완료/실패/중단·서버 무응답을 상태 전이 시점에 1회 발화 —
    HTTP 폴링 완료, 30초 무응답 탈출, BLE result 3경로 모두
    - 설정 '일반'에 음성 안내 토글(SharedPreferences, 타깃 사용자 특성상
    기본 켜짐). prefs 접근은 가드 — 설정 저장 실패가 앱을 못 죽이게
    - 테스트 2개(완료 발화·토글 오프 침묵), 전체 114개 통과
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2026-08-22 feat(kiosk): 접근성·터치 편의 — 히트박스·눌림 피드백·큰 글씨 모드 (S3 1/2)
    - 수동 조작 뒤로가기: 16px 아이콘 단독 히트박스 → 패딩 포함 52px +
    잉크 피드백 (고령 사용자가 맞추기 어렵던 지점)
    - 버튼 그리드 셀: GestureDetector → InkWell 잉크 피드백 — '눌렸는지
    모름'은 물리 버튼을 누르는 앱에서 오조작(연타)으로 이어진다
    - 큰 글씨 모드: 설정 토글 → 전 화면 텍스트 1.22배 (800x480에서
    오버플로 없는 안전 상한). 설정 오버레이는 스크롤 가능화로 오버플로
    원천 차단
    - 테스트 9개 전부 통과, analyze 클린
2026-08-22 fix(app): 접근성·터치 편의 + 사소 버그 4건 (S3 2/2)
    접근성·편의:
    - 수동 조작 셀: Material+InkWell 잉크 피드백 + 탭 순간 햅틱(시각
    비의존 확인 채널), 스크린리더에 버튼으로 인식
    - 마이크 버튼: Semantics(상태 포함 라벨) + 햅틱
    - 커스텀 가전 삭제: 확인 다이얼로그(버튼맵·사진 유실 경고) + 히트박스
    패딩 확대 — 14px 아이콘 오탭 즉시 삭제되던 문제
    사소 버그:
    - 홈 '말하기' FAB가 BLE 연결에만 묶여 RPi-only 상태에서 죽어 있던
    모순 — RPi 연결로도 활성화
    - 상태 화면 마지막 단계 뒤 연결선 제거 (index<99 항상 참이던 코드)
    - 제안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
2026-08-22 docs(접근성): 사용자 편의 가이드 체크리스트 — 공인 표준 4종을 앱·키오스크에 매핑
    KS X 3253(모바일 앱 접근성 19항목)·KS X 9211(무인정보단말기)·고령층
    친화 디지털 접근성 표준·WCAG 2.2/Material 터치 타깃을 조사해 항목별
    적용 현황(✅/⬜)으로 정리. S2 TTS·S3 접근성 패스가 표준 요구와 정합함을
    확인. 장애인협회 자문 지참용 + 발표 '고민의 깊이' 물증
2026-08-22 feat(rpi): 실행 이력 — job_history 저장 + GET /history (S4 1/2)
    '무엇을·언제·몇 번 재시도해서·어떻게 끝났는지'의 기록. 공감지능의 근거
    데이터를 사용자에게 보여주고, 실기기 검증 기간의 성공률·재시도 통계
    (발표 실험 근거)를 축적하는 기반.
    - JobHistoryEntry(버튼별 시도 횟수 포함, retry_count 계산) + 포트.
    저장은 UsageLog와 같은 패턴: SIMPLELAY_DB_PATH 있으면 SQLite
    (job_history 테이블, 재시작 유지), 없으면 인메모리 200건
    - SimpleLayService가 실행 완료·예외 종료 시 기록 (기록 실패는 실행을
    절대 못 막게 가드). 동기·비동기 경로 공용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
2026-08-22 feat(app): 실행 기록 타임라인 화면 (S4 2/2)
    홈 AppBar 기록 아이콘 → /history. 상태 아이콘(완료/안전 정지/실패),
    목적 또는 버튼 라벨 제목, '오늘 HH:mm' 시각, 그리고 이 화면의 존재
    이유인 '재시도 N회 후 성공' 배지 — 폐루프가 실패를 스스로 회복했다는
    증거를 사용자가 직접 본다. 당겨서 새로고침, 빈 상태·오류 상태 안내.
    위젯 테스트 3개, 전체 117 passed
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2026-08-22 feat(sse): 위험 경보·상태 변화 실시간 푸시 — GET /events + 키오스크 구독 (S5)
    위험 경보가 3초 폴링 주기만큼 늦게 뜨던 지연을 사실상 0으로.
    - GET /events (SSE): alert·status의 '변화'만 푸시 + 15초 keepalive.
    추가 의존성 없이 내부 300ms 변화 감지 루프(인메모리 읽기라 무비용).
    연결 직후 현재 상태 스냅샷 1회 전송. API 키 정책 동일 적용(루프백 면제)
    - 스트림 로직을 sse_event_lines(콜러블 주입)로 분리 — 무한 HTTP 스트림은
    TestClient가 종료 처리에서 hang하므로 제너레이터를 직접 단위 테스트
    (초기 스냅샷·변화 1회 푸시·keepal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
2026-08-23 feat(rpi): 공간 존재(presence) 스캐폴딩 — POST /presence + 부재 중 제안 보류 (S6 1/3)
    '공간 이해·초개인화' 심사 기준의 서버측 배선을 미리 완성 — 실기기 날에는
    RPi4 카메라 감지기(공개 tflite 모델)가 POST /presence만 호출하면 끝난다.
    - PresenceStore: TTL 60초 — 감지기 갱신 두절 시 unknown 복귀(죽은
    감지기의 마지막 '부재' 판정이 제안을 영구 차단하지 않게)
    - 부재 게이팅: SIMPLELAY_PRESENCE_GATING=true일 때만, 명시적 부재
    동안 '자동' 제안 생성 보류. unknown은 항상 허용(감지기는 부가 기능,
    제안의 전제가 아님). 데모 트리거·기존 pending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
2026-08-23 docs(개발현황): 실배선 기준 전면 재작성 (S6 2/3)
    '코드 완료'와 '실기기 검증 완료'를 구분하는 표기 원칙으로 재작성 —
    심사 질의에서 배선 안 된 것을 완성이라 부르는 리스크 제거. job 모델
    아키텍처, 기능 현황 표(19항목), API 표(신규 엔드포인트·인증 포함),
    환경변수 표, 테스트 수(391+117+11) 반영
2026-08-23 docs(데모): 결선 데모 시나리오 v1 (S6 3/3)
    5장면(음성 실행·선제 제안·실패→자가 회복·긴급 정지·위험소리) — 전 장면
    리허설 API로 재현 가능 + 장면별 실패 대응 카드. 입체 배치·TTS·큰 글씨
    전제(원거리 심사위원 10명), 사전 준비 커맨드, 예상 질문 대비 포함.
    실기기 검증 후 v2에서 /history 실측 수치 삽입
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2026-08-23 docs: CLAUDE.md — 작업 규칙 명문화 (LG 자료 로컬 전용·커밋 규칙·환경·아키텍처 요점)
    다른 기기(데스크탑)에서 Claude Code 세션을 이어갈 때 규칙이 자동
    로드되도록 저장소에 명문화. NDA 세부는 포함하지 않음 — 규칙과 절차만
2026-08-24 fix(safety): 교차 리뷰 치명 3건 — UART 실행 중 abort 수신·시퀀스 오인·정지 유실
    외부 교차 리뷰(Codex)에서 확인된 실 UART 경로의 안전 결함 수리.
    [#1 치명] RPi4가 실행 중에는 abort를 읽을 수 없었음
    - _on_execute가 to_thread를 그대로 await → 읽기 루프가 실행 완료까지
    정지 → 실행 도중 도착한 긴급 정지가 실행이 끝난 뒤에야 읽혔다
    ('실행 중 정지 불가'의 진짜 원인 — 기존 abort 배선을 무력화)
    - 실행을 asyncio.create_task로 분리, 루프는 즉시 다음 라인 수신.
    run() 취소 시 협조 정지 요청+task 취소, wait_idle() 헬퍼 추가
    - 회귀 테스트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
2026-08-24 fix(app+kiosk): 완료 판정 추월 레이스 — last_job_id를 running보다 먼저 (교차 리뷰 #4)
    내 job(J1) 완료 직후 다른 클라이언트의 J2가 시작되면 /status는
    {running:true, job_id:J2, last_job_id:J1}이 된다. running을 먼저 처리하던
    기존 로직은 J1의 완료를 영영 놓쳐 폰·키오스크가 영구 대기했다
    (서버 응답은 성공이라 30초 무응답 탈출도 발동 안 함).
    - 폰 상태 추적·키오스크 실행 폴링·수동 조작 대기 3곳 모두 완료 판정
    (lastJobId == 내 job)을 최우선으로 이동
    - 진행 갱신은 running && jobId == 내 job일 때만
    - 추가 방어: 내 job의 흔적이 연속 N회(폰 10·키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
2026-08-24 fix(rpi): 제안 승인·거부 원자화 - 거부된 제안이 동시 승인으로 실행되는 레이스 차단 (교차 리뷰 #8)
2026-08-24 feat(rpi): 실행 요청 입력 상한 + 노드 base_url 검증 (교차 리뷰 #9,#10)
    - 발화 200자, 실행 버튼 20개, 라벨 40자, known_buttons 50개, DND 24시간 상한
    - base_url은 http/https + 호스트 필수, 자격증명·비정상 포트 거부
2026-08-24 feat(rpi): 종료 정리 절차 + /health act_mode + 배포 env 템플릿 (교차 리뷰 #11,#12)
    - lifespan 종료 시 신규 차단 → 협조 정지 → 최대 5초 대기 → 컨트롤러·DB 정리
    - /health에 act_mode 노출: 실물 안 움직이는 모드 오설정을 curl 한 번으로 탐지
    - systemd EnvironmentFile + setup_rpi.sh가 /etc/simplelay/environment 템플릿 생성
2026-08-24 fix(rpi): UART 응답 타임아웃을 버튼 수에 비례해 동적 산정 (교차 리뷰 #6)
    - 고정 30s/35s는 6버튼 이상 정상 실행을 timeout으로 오판
    - timeout 시 abort 전송: 화면은 실패인데 실물은 계속 누르는 불일치 방지
    - 동기 브리지는 클라이언트 대기 + 5s 여유로 항상 나중에 포기
2026-08-24 feat(node): ESP 노드 긴급 정지 배선 (교차 리뷰 #7)
    - 펌웨어: STOP_PORT(HTTP+1) 원시 리스너 — /execute 블로킹 중에도 정지 수신, UART abort 전달
    - EspNodeController.request_stop(): 정지 포트로 POST, 실패는 로그만(브로드캐스트 보호)
2026-08-24 feat(rpi4): 데모 실패 주입을 UART 모드에도 배선 (교차 리뷰 #13)
    - inject_failure/clear_failure UART 메시지 신설 (abort처럼 단방향)
    - act_main이 FailureInjectionVerifier + DemoFailureState를 동일 배선
    - /demo/inject-failure가 로컬 무장 + UART 컨트롤러로 전달 (duck-type)
2026-08-24 docs(devlog): 교차 리뷰 Phase B 7건 수리 기록 + 테스트 수 갱신 (442)
2026-08-24 feat(rpi): SSE status 이벤트에 실행 진행 필드 추가 (교차 리뷰 #13)
    - current_button/current_attempt/completed_steps/total_steps — /status와 동일 의미
    - 진행 변화마다 변화 푸시로 흘러 키오스크 진행바가 폴링 지연 없이 갱신
    - payload 빌더를 모듈 함수로 분리해 단위테스트 3개 추가
2026-08-24 feat(kiosk): 설정 파일 영속화 - 재부팅에도 음성·큰 글씨·가전 유지 (교차 리뷰 #14)
    - KioskSettingsStore: ~/.simplelay-kiosk.json, dart:io만 사용(elinux 플러그인 의존 없음)
    - 손상·부재·쓰기실패 전부 기본값 폴백 - 설정 파일 때문에 키오스크가 못 뜨는 일 없음
    - 테스트 미주입 시 세션 한정(실파일 안 건드림), 프로덕션은 main.dart가 주입
2026-08-24 fix(kiosk): 11~12px 소형 폰트를 13~14px로 확대 (교차 리뷰 #16)
    - 안전 안내·자동닫힘 카운트다운 등 사용자향 텍스트 우선 14px
    - 큰 글씨 1.22배 결합 시 전 화면 800x480 오버플로 없음 회귀 테스트 추가
2026-08-24 fix(app): 음성 인식 오류를 즉시 복구하고 Phase C 완료
2026-08-24 fix(node): ESP 실행 타임아웃을 UART와 같은 산정식으로 통일하고 포기 시 정지 전송
    고정 10초 HTTP 타임아웃이 펌웨어의 30초 대기보다 짧아, RPi5가 실패로 보고한 뒤에도 노드와 RPi4가 계속 버튼을 눌렀다(화면과 실물 불일치).
    - EspNodeController: 30초 + 6초x버튼, 타임아웃/504 시 STOP_PORT로 abort
    - 펌웨어: 대기도 버튼 수 비례(기저 20초)로 RPi5보다 먼저 504 회신 + UART abort
2026-08-24 fix(rpi): UART 송신 실패 시 _pending이 남아 실행 경로가 영구히 막히던 문제
    _send()가 try 밖에 있어 drain() 실패 시 finally에 도달하지 못했다. 케이블 접촉 불량 한 번이 재부팅 전까지 모든 실행을 ActLinkBusyError로 거부시켰다.
2026-08-24 fix(rpi): 긴급 정지의 노드 전송을 락 밖에서 병렬로 수행
    락을 쥔 채 노드마다 순차 HTTP 정지를 보내, 죽은 노드 수만큼 실제 실행 노드의 정지가 지연되고 그동안 /status까지 막혔다.
    - 로컬 컨트롤러 정지는 락 안 유지(_begin_run의 reset_stop과 직렬화 필요)
    - 노드 정지는 병렬 전송 + 전체 상한 2.5초
2026-08-24 fix(rpi4): 종료 시 실행 스레드가 실제로 멈출 때까지 대기
    task.cancel()은 to_thread 안 동기 실행을 못 죽인다. 코루틴만 끝나 wait_idle이 완료로 보이는 동안 실물은 계속 눌렸다.
    - shutdown(): 정지 요청 후 shield로 실제 반환 대기, 유예 초과 시에만 취소
    - 반환값으로 물리 E-STOP이 필요한 상황을 구분
2026-08-24 fix(kiosk): 설정 저장을 원자적으로 바꾸고 실패를 감지 가능하게
    덮어쓰기 도중 정전이면 잘린 JSON이 남아 다음 부팅에 모든 설정이 기본값으로 돌아갔다. 저장 실패도 전부 삼켜 사용자는 저장된 줄 알았다.
    - 임시 파일 기록 후 교체 + .bak 복구 경로
    - save()가 성공 여부 반환, lastSaveFailed 노출
    - 배포 경로를 SIMPLELAY_KIOSK_SETTINGS로 명시(현재 디렉터리 폴백 회피)
2026-08-24 feat(rpi): UART 타임아웃을 env로 캘리브레이션 가능하게
    6초/버튼은 실측이 아닌 설계 추정치 - 실기기 측정값을 코드 수정 없이 반영할 수 있어야 한다. 잘못된 값은 기본값으로 폴백.
2026-08-24 fix(app): 음성 세션 세대 가드로 오류 후 침묵 타이머 재무장 차단
    엔진이 listen() 반환 전에 오류를 던지면 마지막 resetTimer가 취소된 타이머를 되살려 5초 뒤 빈 발화를 전송할 수 있었다.
2026-08-24 fix(node): 정지 포트가 TCP 연결만으로 실행을 끊지 않도록 요청 경로 확인
    시연장 공유 네트워크의 포트 스캔 한 번이 실행을 중단시킬 수 있었다. 요청 라인을 못 읽은 경우는 여전히 정지 쪽으로 판단한다.
2026-08-24 docs(devlog): 2차 교차 리뷰 치명 1 + 중요 3 + 사소 4 수리 기록
    재채점 8.0/10, 테스트 464/123/24. 실기기 검증일 항목 갱신(펌웨어 재플래시, 버튼 소요 p95 측정, UART 단선 리허설).
2026-08-25 feat(kiosk): 폐루프 재시도 연출 + 실패 화면 복구 동선 (디자인 리뷰)
    제품의 핵심 기술인 자동 보정이 14px 보조문구 한 줄이라, 몇 걸음만 떨어지면
    우측 '시도 횟수'가 1에서 2로 바뀌는 것으로만 보였다. 실패 화면도 성공과 같이
    3초 뒤 사라져 고령 사용자는 이유도 대처법도 모른 채 화면을 놓쳤다.
    - 재시도 중 '자동 보정 중'을 38px 앰버 배너로 승격 (liveRegion 포함)
    - 실패는 자동 복귀하지 않고 [다시 시도] [버튼으로 조작] [닫기] 제공
    - 실패 원인별 안내 문구 분리 (실행 확인 실패 / 연결 끊김 / 안전 정지)
    - 연결이 끊긴 경우엔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
2026-08-25 feat(kiosk): 제안 표시 시간 20초 기본·설정 가능 + 설정 진입 발견성 (디자인 리뷰)
    10초 안에 음성 안내를 듣고, 걸어와서, 읽고, 판단하고, 누르기까지는 고령
    사용자에게 짧다. 설정은 5px 점 3연타로만 열려 사실상 기능 은폐였다(#15).
    - 카운트다운 기본 20초, 설정에서 10/20/30초 선택 후 파일 영속화
    - 진행바가 설정값을 보도록 cdTotal 전달 (남은 시간과 바가 어긋나지 않게)
    - 대기 화면에 48px 톱니바퀴 노출, 열려면 2초 길게 누르기
    - 길게 누르기 타이밍은 Listener로 — GestureDetector로 하면 대기 화면의
    길게 누르기(방해 금지)가 제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
2026-08-25 fix(app): 터치 타깃 48dp 보정 + 라이트 모드 강조색 토큰화 + 소형 글씨 확대
    - minimumSize: Size.zero / shrinkWrap로 48dp 원칙을 우회하던 10곳 보정
    ('해제', '주소 입력', '재시도', '연결', '저장', BLE 재스캔 등)
    - AppColors.primary(다크 전용 골드) 직접 사용 34곳을 context.appPrimary로
    교체 — 라이트 모드에서 크림 배경 위 골드는 대비 약 2:1이었다
    - 제안 순서 배지 9px→12px(배지 16→20px), 학습 통계 라벨 10px→12px
    - 실행 기록의 '재시도 N회 후 성공' 배지 11px→13px + 테두리 추가:
    폐루프가 회복했다는 유일한 기록 증거인데 화면 미러링 시 읽히지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
2026-08-25 feat(app): 핵심 동선에 Semantics·liveRegion 추가 (디자인 리뷰)
    앱 전체 Semantics가 마이크 버튼 한 곳뿐이었다 — 색·크기로만 구분되던 상태가 보조기술에는 전달되지 않았다.
    - 상태 화면: liveRegion으로 실행 상태·재시도·진행 단계를 변화 시 낭독
    - 수동 조작 셀: 대기/누르는 중/눌림 확인/실패를 라벨로 구분
    - 접근성 회귀 테스트 추가
2026-08-25 fix(kiosk+docs): 위험 경보 문구 안전 우선으로 수정 + 디자인 문서 실제 팔레트 반영
    - "실제 상황인지 직접 확인해주세요"는 화재·가스 상황에서 고령 사용자를
    위험 쪽으로 보낼 수 있었다 → "안전한 곳으로 이동한 뒤 도움을 요청" 우선,
    오탐 안내는 그 다음으로. 확인 버튼도 '안내를 확인했습니다'로.
    - 음성 안내 문구도 같은 순서로 정렬
    - design-system.md가 초기 시안 팔레트(#4FC3F7/#0D1117)로 남아 있었다 →
    실제 골드 팔레트로 갱신, 라이트 팔레트와 토큰 사용 규칙 추가
    - kiosk_tts_service의 "세션 한정" 주석이 파일 영속화 후로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
2026-08-26 chore(repo): 발표자료 pptx/pdf를 gitignore에 추가
    리포에 커밋해야 할 pptx/pdf가 없는 반면 로컬 전용 자료가 이 형식으로 들어온다.
    확장자 단위로 막아 실수로 스테이징되는 경로를 없앤다(예외는 !경로로 개별 허용).
    이미 추적 중인 0818_임베디드.pptx는 gitignore가 소급 적용되지 않으므로 그대로 남는다
    - 추적 해제는 다른 기기의 작업 트리에서 파일이 삭제되는 영향이 있어 별도 판단.
2026-08-26 fix(rpi): 온디바이스 해석 계층 2종의 응답 처리 결함 수리
    인터페이스 명세와 대조해 실기기 없이도 확정 가능한 결함을 수리했다. 백엔드 464 → 475.
    벡터DB 경로
    - 검색 결과 파서가 metadata를 버리고 있었다. 리졸버는 metadata에서 버튼 시퀀스를
    읽으므로 실기기를 붙여도 이 계층은 항상 폴스루했다 — 사실상 무력화 상태였다.
    - 결과 한 건의 필드 순서는 id, metadata, originalData, score다. "id 다음 첫
    문자열이 originalData"로 보던 정규식은 metadata가 비어있지 않으면 metadata
    조각을 originalData로 잘못 집었다. 점수를 블록 경계로 삼아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
2026-08-26 docs(inference-boundary): 실제 배선 상태 반영 + 맥락 정보 항목 추가
    문서가 "온디바이스 추론 미구현, 규칙 단독 배선" 시점에 멈춰 있었다. 실제로는 3계층이
    조립돼 있고(유사도 → 규칙 → 대화형) 온디바이스 계층은 자체 모델이 아니라 기기가
    제공하는 기능에 배선돼 있다. 기본 상태에서 오프라인 완결이라는 성질은 그대로다.
    - 2단계를 "유사도 매칭"으로 정정하고 대화형 단계를 3단계로 분리(외부는 4단계로 밀림)
    - 현재 배선 절 신설, LlmIntentResolver의 내부 순서와 바깥 계층 순서의 관계를 명시
    - 6번 항목 신설: 기기가 관리하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
2026-08-26 docs: 8/26 작업 기록 + 공개 문서의 플랫폼 식별자 정리
    - devlog_2026-08-26 신설: 온디바이스 해석 계층 결함 4건 수리 경위와, 계층별 테스트가
    서로 모순된 가정 위에서 각각 통과하며 이음매를 비워둔 구조적 원인을 기록
    - 개발현황: 테스트 수 464 → 475, 최종 업데이트일 갱신, 의도 해석 행의 검증 상태 문구 정리
    - 개발현황 남은 작업: 실기기 검증 1순위를 "온디바이스 서비스를 부를 수 있는 기기와
    백엔드가 도는 기기가 같은가"로 교체. Python 런타임 확인은 그다음 순서로 내림 —
    기기가 다르면 런타임 유무와 무관하게 배선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
2026-08-26 test(repo): 벤더 고유 명칭 재유입을 막는 가드 테스트 추가
    한 번 청소하고 끝내면 시간이 지나며 다시 스며든다. 추적 중인(=공개되는) 파일만 훑어
    금지어가 허용되지 않은 위치에 나타나면 실패한다. 백엔드 475 → 477.
    - 금지어를 소스에 그대로 적으면 이 파일 자체가 유출이 되므로 조각으로 조립
    - 일반 용어는 의도적으로 제외: D-Bus(공개 표준), vector db(일반 용어),
    'internal-platform' 단독(무관한 오픈소스 선형대수 라이브러리와 겹침 — 벤더 네임스페이스 형태만 검사)
    - 영구 허용은 빌드·설치 요구사항인 곳만: flutter 크로스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
2026-08-26 refactor(rpi): 기기 D-Bus 서비스 주소를 소스에서 환경변수로 분리
    서비스 이름·오브젝트 경로·호출 CLI는 우리 코드의 일부가 아니라 배포되는 기기의
    성질인데 소스에 박혀 있었다. 리포가 특정 기기 빌드에 묶이고, 공개 저장소가 그
    식별자를 그대로 들고 있게 된다. 백엔드 477 → 478.
    - `rpi/dbus_env.py` 신설: 필수 값을 읽되 비어 있으면 어떤 변수를 어디에 넣어야
    하는지 짚으며 실패한다. 기본값을 두지 않은 건 의도 — 켜놓고 조용히 아무 일도
    일어나지 않는 상태가 가장 진단하기 어렵다
    - 오브젝트 경로는 서비스 이름에서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
2026-08-26 refactor: 벤더 브랜드에서 따온 우리 식별자 개명 + 부채 목록 해소
    우리가 지은 이름인데 벤더 제품명·CLI 이름을 그대로 물려받고 있었다. 공개 저장소에서
    검색 한 번이면 연결되는 흔적이라 기능 기준 이름으로 바꿨다. 동작 변경 없음, 백엔드 478 유지.
    파일
    - rpi/intent/dbus_(제품명).py -> rpi/intent/dbus_agent.py
    - rpi/controller/(CLI이름)_gpio.py -> rpi/controller/dbus_gpio.py
    - 대응 테스트 2개도 같이 이동(git mv로 이력 보존)
    클래스
    - 대화형 에이전트 클라이언트/설정/오류 3종 -> DbusAgent*
    - GPIO 어댑터 -> DbusGpioClient, 호출 오류 -> DbusCallError
    -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
2026-08-26 docs(devlog): 벤더 고유 명칭 제거 3단계 기록
    가드를 먼저 만들고 부채 목록을 줄여나간 순서와, 그 덕에 정리 중 두 번 잡힌 누락
    (네임스페이스의 슬래시 형태, 일부러 제외했던 플랫폼 이름)을 남긴다.
    서비스 주소를 환경으로 옮긴 것이 컴플라이언스만이 아니라 설계로도 나은 이유도 함께.
2026-08-26 docs(guard): 회사명 단독은 검사 대상이 아니라는 팀 결정 명시
    주최·후원 관계는 공개 정보이고 작업 규칙 문서도 그 표현을 쓴다. 근거를 안 적어두면
    나중에 '빠뜨린 것'으로 보고 추가하게 된다 — 막아야 할 것은 회사명이 아니라 내부
    구현 세부라는 기준을 가드 안에 남긴다. 네임스페이스 형태는 계속 잡는다.
2026-08-26 docs(결선로드맵): 이미 완료된 W7~8 항목 4건 반영 + 1순위 리스크 문구 교정
    선행 스프린트(S1·S2·S4·S5)에서 앞당겨 끝낸 리허설 실패주입·TTS·SSE·실행 히스토리가
    W7~8에 미완료로 남아 있었다. 코드로 존재를 확인하고 완료 표시. 완료된 것을 미완료로
    적어두면 발표 준비 때 남은 일을 과대평가하게 된다.
    1순위 리스크도 개발현황과 같은 문구로 맞췄다 - 'Python이 있는가'가 아니라 '백엔드가
    도는 기기와 온디바이스 서비스를 부를 수 있는 기기가 같은가'가 먼저다.
2026-08-29 docs(전력): 전력 버짓 문서 작성 + 확보 부품 반영
    예선 심사평 4개 중 유일하게 답이 없던 항목. 실측값은 조립 후에 나오지만, 설계 근거와
    산정 틀은 지금 확정할 수 있어 먼저 세웠다.
    - 12V 단일 입력 근거: 가전 옆에 붙는 제품이라 콘센트 하나로 끝나야 한다
    - 모터 레일과 로직 레일의 강압단 분리 — 모터 기동 시 전압 강하로 보드가 리셋되는
    임베디드 최다 고장 유형을 구조적으로 차단
    - **최악 조건은 "모터 2개 동시"로 확정.** CoreXY는 한 축만 움직이는 이동에서도 A·B가
    항상 함께 돌기 때문에(actuator-design.md) "한 번에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
2026-08-29 feat(firmware-node): 본선 데모용 ESP-NOW 전송 계층 (노드 쪽)
    시연장 공유 Wi-Fi 혼잡과 무관하게 통신하려는 것이 목적 — 공유기를 아예 거치지 않는다.
    `config.h`의 `ESPNOW_ENABLED`로 HTTP와 택일하며, 자동 폴백은 두지 않았다(어느 전송으로
    도는지 모호하면 시연장에서 원인을 못 좁힌다 — SIMPLELAY_ACT_MODE와 같은 원칙).
    - `transport.h` 신설: 실행/알림/정지 콜백 계약을 전송 밖으로 빼서 HTTP와 ESP-NOW가
    똑같이 쓴다. `main.cpp`의 실행 로직은 어느 전송이 붙었는지 몰라도 된다
    "전송만 갈아끼우면 된다"가 정확히는 성립하지 않았다. 두 가지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
2026-08-29 feat(intent): 유사도 계층 예시 시드 + 계층 순서 수리 (규칙 우선)
    유사도 계층은 조회만 배선돼 있고 예시를 채우는 쪽이 없어 계속 놀고 있었다.
    백엔드 478 → 490.
    **시드보다 순서 수리가 먼저였다.** deps.py만 유사도를 규칙보다 앞에 두고 있었는데
    (tiered.py docstring·roadmap·inference-boundary는 전부 규칙 우선), 먼저 성공한 계층이
    이기므로 그 상태에서는 유사도가 임계값만 넘기면 **정확한 규칙을 덮어쓴다**. 규칙으로
    끝날 문장까지 CLI 서브프로세스 왕복을 무는 비용도 있었다. 유사도가 항상 미스라
    드러나지 않았을 뿐, 예시를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
2026-08-29 feat(rpi): ESP-NOW 노드 컨트롤러 (RPi5 쪽, 게이트웨이 경유)
    ESP-NOW는 ESP32 라디오끼리만 통해서 RPi5가 직접 쓸 수 없다. UART로 붙은 ESP32가
    대신 쏴주는 구조이고, 그 역할은 기존 폰 BLE 폴백 브릿지가 겸한다(팀 결정 — 전용
    보드를 추가하지 않는 쪽). 백엔드 490 → 510.
    RPi5 --UART--> 게이트웨이 ESP32 --ESP-NOW--> 노드 ESP32 --UART--> RPi4
    겸용의 대가를 코드가 감당해야 한다: **같은 UART에 BLE 브릿지 트래픽이 함께 흐른다.**
    그래서 링크는 sequence_id가 자기 것이 아닌 줄과 JSON이 아닌 줄을 조용히 건너뛴다
    (테스트로 고정 — 남의 줄 3종을 섞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
2026-08-29 feat(firmware): ESP-NOW 게이트웨이 역할을 BLE 브릿지에 겸용
    ESP-NOW는 ESP32 라디오끼리만 통하는데 RPi5에는 그 라디오가 없다. 이미 UART로 붙어
    있는 폰 BLE 폴백 브릿지가 대신 쏴주면 전용 보드를 추가하지 않아도 된다(팀 결정 A안).
    RPi5 --UART--> 브릿지 ESP32(겸용) --ESP-NOW--> 노드 ESP32 --UART--> RPi4
    `ESPNOW_GATEWAY_ENABLED`로 켜고 끈다(기본 꺼짐). 전용 보드로 분리하고 싶어지면 이 값만
    옮기면 되고 나머지 코드는 그대로다 — 겸용 결정을 되돌릴 수 있게 남겨뒀다.
    - RPi5 UART에 node_execute / node_stop 처리를 얹었다. 기존 BLE 브릿지 메시지와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
2026-08-29 fix(transport): 바이트 예산을 전 구간 하나로 정의 + UART 잘림 차단
    교차 리뷰 치명 2. **한글이 UTF-8 3바이트인데 글자 수로 버퍼를 잡았다.**
    "버튼 20개 × 라벨 40자 = 800"이라고 근거를 적어놓고 바이트로 취급해서, 실제 최악값
    2,493바이트가 512바이트 UART와 1,280바이트 재조립 버퍼를 모두 넘겼다. 즉 분할·재조립을
    만든 이유였던 그 요청이 정작 UART에서 먼저 잘리고 있었다. 백엔드 510 → 520.
    - `MAX_EXECUTE_PAYLOAD_BYTES = 2560`을 스키마에 단일 기준값으로 두고, 실행 버튼 목록을
    **직렬화 바이트로** 검증한다. 현재 상한의 최악값(2,480B)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
2026-08-29 fix(rpi): 실행 중 긴급 정지가 락에 막히던 문제 — 쓰기/실행 락 분리
    교차 리뷰 치명 3. `execute()`가 응답 대기 내내 락을 쥐고 있고 `request_stop()`이 같은
    락을 요구해서, **실행 중에는 정지가 아예 나가지 않았다.** 실행이 끝나거나 타임아웃된
    뒤에야 전송된다 — 화면은 정지됐다고 돌아오는데 실물은 계속 누르는, 이 프로젝트에서
    가장 위험한 실패 모드다. 백엔드 520 → 522.
    정지를 확실히 보내려고 여기저기 배선해놓고, 정작 그 정지를 자기 락으로 막고 있었다.
    - `_write_lock`: 한 줄을 쓰는 동안만. 실행·정지가 공유하며 줄이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
2026-08-29 fix(node): 전송 배선·정지 반복·pending 경합 수리 (교차 리뷰 #1·#7·#8)
    백엔드 522 → 527.
    **#1 ESP-NOW가 프로덕션에 배선돼 있지 않았다.** `get_node_registry()`가 기본 HTTP
    컨트롤러를 그대로 써서, 펌웨어에서 ESP-NOW를 켜고 MAC을 등록해도 RPi5는 그 MAC을
    HTTP base_url로 취급했다 — 신규 전송이 단위 테스트에만 존재하고 프로덕션 요청은
    지나가지 않는 상태였다.
    - `SIMPLELAY_NODE_TRANSPORT=http|espnow`로 **명시적으로** 고른다. 주소 모양(URL이냐
    MAC이냐)으로 자동 감지하지 않는다 — 오타 하나가 조용히 다른 전송을 타면 시연장에서
    원인을 좁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
2026-08-29 docs(devlog): 8/29 ESP-NOW 구현 + 교차 리뷰 치명 5건 수리 기록
    한글을 글자 수로 세어 버퍼가 3배 모자랐던 것, 정지가 한쪽에서는 아예 안 나가고
    다른 쪽에서는 무한 반복되던 것, 신규 전송이 프로덕션에 배선돼 있지 않았던 것.
    이번에도 원인은 이음매였다 — 테스트가 데이터 손실을 정답으로 고정하고, 정지 테스트가
    시점을 확인하지 않고, 조립 지점을 지나는 테스트가 없었다. 527개 통과가 정확성의 근거가
    아니라는 점을 다시 기록한다.
    보류한 리뷰 지적(공유 UART 디멀티플렉서·ACK/상관관계·재조립 동기화)도 근거와 함께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
2026-08-29 fix(rpi): 게이트웨이 UART를 리더 스레드가 단독 소유하도록 분배
    같은 UART에 BLE 브릿지 트래픽이 함께 흐르는데, 실행 대기 루프가 포트를 직접 읽으며
    자기 것이 아닌 줄을 건너뛰었다. "무시"가 아니라 소비하고 버리는 것이어서, 실행 중에
    도착한 제안·센서 줄이 그대로 사라졌다.
    리더 스레드 하나가 모든 줄을 읽어 sequence_id로 대기 중인 실행에 전달하고, 임자 없는
    줄은 on_unclaimed_line 콜백으로 넘긴다. 대기는 threading.Event라 어떤 락도 잡지 않으므로
    실행 중 정지가 즉시 나가는 성질도 그대로 유지된다.
    테스트: 가짜 포트를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
2026-08-29 fix(firmware): ESP-NOW 응답에 요청 식별자를 실어 상관관계 확인
    게이트웨이는 발신 MAC과 "대기 중인가"만 보고 응답을 받아들였다. 포기한 요청의 지연
    응답이 바로 다음 요청의 결과로 둔갑할 수 있고, 그 경우 실패한 실행이 성공으로 보고된다
    (물리 버튼을 누르는 시스템에서 가장 나쁜 오보).
    - 게이트웨이: 실행 요청에 rid(=RPi5 sequence_id)를 싣고, 응답의 rid가 대기 중인 것과
    다르면 버린다. 대기는 유지해서 진짜 답이 오거나 마감이 실패로 끝내게 한다.
    요청 JSON 자체를 못 읽어 rid를 되돌릴 수 없는 오류 응답만 예외로 받는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
2026-08-29 fix(rpi): HTTP 노드 경로도 모호한 실패에서 정지를 보낸다
    규칙을 뒤집었다. 예전에는 "400/500은 실행이 시작되지 않았으니 정지 불필요"였는데,
    그건 노드 펌웨어가 지금 그렇게 짜여 있다는 것에 기댄 추론이다 -- 프록시나 그 주소의
    다른 기기가 답했거나 펌웨어가 바뀌면 성립하지 않는다.
    이제 정지를 생략하는 경우는 하나뿐이다: **연결 자체가 성립하지 않았을 때.**
    근거가 자기충족적이다 -- 요청이 닿지 못했다면 정지도 닿지 못한다. 죽은 노드에 정지를
    쏘느라 실패마다 2초를 더 붙잡을 이유도 없다.
    가장 큰 구멍은 요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
2026-08-29 fix(firmware): 재조립 버퍼의 소유 구간을 상태로 명시 + 늦은 조각이 뒤엎지 못하게
    수신 콜백은 Wi-Fi 태스크에서, poll()/dispatch는 Arduino loop 태스크에서 돈다. ESP32는
    듀얼코어라 둘이 다른 코어에서 동시에 실행될 수 있는데, 경계를 `volatile bool` 하나로
    표현하고 있었다 -- volatile은 원자성도 메모리 순서도 주지 않는다.
    더 큰 문제는 소유 구간이었다. _dispatchReady()가 맨 앞에서 버퍼를 "비었다"고 표시한 뒤
    실행 핸들러를 부르는데, 그 핸들러는 RPi4 응답을 최대 26초 기다린다. 그동안 수신부는
    _buffer를 자유롭게 덮어썼고, ArduinoJson은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
2026-08-29 fix(firmware): 실행 직전 정지 유실 + 응답 오귀속 (2차 교차 리뷰 치명 1·중요 4·6)
    **치명 — 승인 후 시작 전에 온 정지가 사라졌다.** 마지막 조각이 도착해 Ready가 된 직후
    정지 프레임이 오면, poll()이 그 정지를 먼저 꺼내 abort를 보내고(그런데 RPi4는 아직
    유휴라 무시) 곧바로 실행을 시작했다. 화면은 정지인데 실물이 그때부터 눌리기 시작한다.
    실행 도중의 정지는 대기 루프가 잡으므로, 남은 구멍이 정확히 이 구간이었다.
    이제 정지가 소비된 poll에서는 실행을 시작하지 않고 "stopped before execution"으로
    답한다 -- 조용히 버리면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
2026-08-29 fix(rpi): 물리 E-STOP 배선 + 링크 사망 전파 + 정지에 취소 대상 명시
    **치명 — 하드웨어 비상정지가 소프트웨어 정지에 연결돼 있지 않았다.** 게이트웨이 보드의
    E-STOP 버튼은 UART로 abort를 보내는데, RPi5에는 그 줄을 읽는 코드가 아예 없었다.
    디멀티플렉서가 임자 없는 줄을 콜백으로 넘기게 해뒀지만 프로덕션(_get_gateway_link)은
    콜백 없이 링크를 만들어서, 실제로는 debug 로그로 끝났다 -- 리더가 이미 소비했으므로
    다른 누구도 받을 수 없다. abort를 emergency_stop()에 연결했다.
    링크 단위 테스트는 콜백을 직접 주입해 검증하므로 이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
2026-08-29 docs: 2차 교차 리뷰 기록 — 수리가 만든 결함 2건 + ArduinoJson 전제 정정
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2026-08-29 fix(firmware): 첫 컴파일에서 드러난 오류 2종 수리
    PlatformIO를 설치해 처음으로 두 펌웨어를 빌드했다. 둘 다 **오늘 고친 부분이 아니라
    원래 있던 오류**다 -- 아무도 컴파일한 적이 없어서 드러나지 않았다.
    - `min(ESPNOW_MAX_PAYLOAD_BYTES, len - offset)`: 앞은 int 상수식, 뒤는 size_t라
    ESP32 코어 3.x가 쓰는 std::min이 템플릿 인자를 추론하지 못한다. Arduino의 min
    매크로가 살아있던 시절 코드를 그대로 옮겨온 자리다. 양쪽 펌웨어에 같이 있었다
    - `doc["buttons"].as<JsonArray>()`: onRpiMessage가 받는 문서가 const라 가변
    JsonArray를 꺼낼 수 없다. JsonArrayC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
2026-08-30 fix(app,kiosk): 명도 대비 미달 3건 수리 + 회귀 테스트
    고령자가 주 사용자인데 **가장 중요한 버튼 둘이 가장 안 보였다.** 전부 채도 있는 색
    위에 흰 글자를 얹었기 때문이다.
    - 키오스크 제안 승인(초록 + 흰 글자): 2.25:1 -> 9.34:1
    - 폰 긴급 정지(브릭 레드 + 흰 글자): 3.63:1 -> 5.78:1
    - 라이트 모드 캡션: 2.48:1 -> 6.36:1
    색이 아니라 글자색을 고쳤다. danger를 어둡게 바꾸면 다크 배경 위 '글자'로 쓰는 자리가
    5.31 -> 3.9로 같이 깨진다 -- 한 색이 면과 글자 두 역할을 겸할 수 없다. 골드 버튼은
    이미 검정 글자(9.32:1)를 쓰고 있었고 나머지 색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
2026-08-30 feat(app,kiosk): 제안 화면을 결재가 아니라 '무엇을 실행할지 확인'으로
    이 제품에서 사용자가 판단해야 하는 것은 "AI가 뭘 제안했나"가 아니라 **"내 가전의 어떤
    버튼을 대신 눌러줄 것인가, 그걸 맡길 것인가"**다. 그런데 화면은 스파클과 결재 용어를
    먼저 보여주고, 정작 눌릴 버튼 순서는 키오스크에 아예 없었다 — 제품의 차별점이 가장 잘
    드러나는 화면에서 그게 빠져 있었다.
    두 화면을 같은 순서로 맞췄다: 무엇을 → 어떤 순서로 → 할까 말까.
    - 제목: `{사용자가 했던 말}, 지금 할까요?` — purpose는 제품이 지어낸 문구가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
2026-08-30 feat(app,kiosk): 실행·완료·대기 화면을 숫자보다 '지금 무엇을 하는지' 중심으로
    교차 리뷰 지적 3~5번. 세 화면 모두 사용자가 판단할 수 없는 정보가 판단해야 할 정보보다
    크게 표시되고 있었다.
    **실행 화면 (키오스크)** — '검증 신뢰도 93%'가 눈에 띄었는데, 93%가 충분한 값인지
    사용자는 알 수 없다. 상태를 말로 두고(버튼 눌림: 확인됨/확인 중) 수치는 그 아래 근거로
    내렸다. 심사 시연에서 값어치가 있는 건 숫자 자체가 아니라 무엇을 근거로 확인했는가라,
    센서 상세와 신뢰도를 함께 근거 줄에 남긴다.
    긴급 정지가 가장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
2026-08-30 fix(app): 200% 확대에서 홈이 무너지던 문제 + 라이트 모드 상태색 대비
    **화면을 실제 이미지로 렌더해 보고서야 나온 결함들이다.** 여기까지 위젯 테스트는 전부
    통과하고 있었다 — "그 문구가 있다"까지만 확인하기 때문이다.
    - **200% 확대에서 홈 화면이 읽을 수 없었다.** 상태 카드가 `Row[아이콘, Expanded(텍스트),
    버튼, 버튼]`이라 확대하면 버튼들이 폭을 다 가져가고 텍스트가 한 글자씩 세로로
    쪼개졌다("RPi 서버 미설정"이 여섯 줄). 오버플로가 아니라 **압축**이라 레이아웃
    테스트가 잡지 못한다. 배율이 1.3을 넘으면 버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
2026-08-30 test(app): 제안·실행 화면도 확대 렌더로 확인 + 남은 '승인' 문구 정리
    홈에서 200% 확대가 무너진 원인이 다른 화면에도 있는지 확인했다 — 한 곳만 고치고
    넘어가면 같은 결함이 남는다. 제안 확인·실행 상태 화면을 보통 크기와 200%로 렌더해
    봤고, 둘 다 정상적으로 접혔다. 버튼맵도 확대에서 제대로 재배치된다.
    실행 화면 렌더를 보다가 '승인한 동작의 진행 상황이…'가 남아 있는 것을 발견해 함께
    정리했다. '승인'은 결재 용어라 화면에서 걷어내기로 한 말인데 안내 문구에 남아 있었다.
    '실행 요청을 보냈어요' / '실행을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
2026-08-30 docs: 8/30 작업 기록 — 펌웨어 첫 컴파일 + 디자인 개편 + 화면 렌더 검증
2026-08-31 feat(app,kiosk): 평소 글자 크기를 한 단계 올림 (고령 사용자 기준)
    주 사용자가 고령자인데 기본 크기가 Material 기본값 언저리였다. 그러면 "큰 글씨 모드를
    켜야만 읽히는 앱"이 되는데, 그 모드를 찾아 켜는 것부터가 장벽이다. 평소 크기 자체를
    올린다 — 교차 리뷰 권고값(폰 본문 18·보조 16, 키오스크 22~24)을 따랐다.
    - 폰: 본문 15 → 18, 보조 12 → 16, 소제목 18 → 20, 제목 24 → 26
    - 키오스크: 핵심 설명 17 → 22, 수동 조작 안내 15 → 20. 서서 조금 떨어져서 보는
    화면이라 그 거리에서 17px는 읽히지 않는다
    키운 뒤 렌더해 보니 두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
2026-08-31 feat(app): 보조 텍스트를 AAA(7:1)까지 + 주 행동 버튼을 가운데 크게
    **대비** — 실제 테마가 만들어내는 색까지 재보니 본문은 이미 14~17:1로 넉넉했다.
    부족한 건 보조 텍스트뿐이었다(라이트 6.36 / 다크 6.98). 그 둘만 7:1로 올렸다.
    이 앱의 캡션은 장식이 아니라 **버튼 순서와 상태 설명**을 담는다("우유 → 1분 추가 →
    시작"). 부차적이라고 아낄 자리가 아니다. 반면 상태를 알리는 채도색까지 7:1로 끌어
    올리면 색이 전부 탁해지므로 그쪽은 AA를 유지하고 색 외 단서(아이콘·문구)를 함께 둔다.
    이 방침을 대비 테스트에 상수로 적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
2026-08-31 fix(app): 제안 화면 버튼맵이 조작판처럼 보이던 문제
    교차 리뷰는 "지도와 순서 목록이 중복이니 지도를 접자"고 했는데, 렌더해서 보니 중복이
    아니다. 지도는 **가전 어디에 있는 버튼인가**(공간), 목록은 **어떤 순서인가**(시간)로
    서로 다른 정보다. 접으면 제품의 차별점이 시연에서 숨는다.
    다만 같은 지적의 두 번째 절반은 맞았다: 순서에 없는 버튼까지 테두리를 둘러서 전부
    눌러도 되는 버튼처럼 보였다. 실제로는 읽는 그림이라 눌러도 아무 일이 없다.
    - 순서에 든 버튼만 테두리를 준다. 나머지는 면만 남겨 배경으로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
2026-08-31 docs: 남겨뒀던 디자인 항목 4건 처리 기록 (2건은 보고 나서 판단이 바뀜)
2026-08-31 feat(rpi): Flutter 키오스크를 /kiosk에서 서빙 — 실기기 배포 준비
    **실기기에 옮기기 직전에 발견한 것**: 지금 배포되는 키오스크 화면은 Flutter 앱이
    아니다. simplelay-kiosk.service가 백엔드의 /ui(rpi/touchscreen/index.html, 906줄짜리
    구형 HTML)를 띄운다. 거기엔 아직 '✦ AI 제안'이 있고 8/30 접근성·카피 개편이 하나도
    반영돼 있지 않다. 로드맵에 'Flutter 키오스크 ipk 빌드'가 미완으로 남아 있던 항목이다.
    전환 경로로 elinux(ipk) 대신 **웹 빌드**를 골랐다. 실제로 빌드해 보고 정했다
    (36MB, 약 2분, 성공):
    - cage+Chromium 인프라가 이미 돌고 자동실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
2026-08-31 feat(intent): 온디바이스 D-Bus를 파이썬에서 직접 호출 (dbus-fast)
    실기기 정찰 결과, 우리 백엔드는 플랫폼 이미지가 아니라 그 위 파이썬 컨테이너로 올라간다
    (이미지의 python3은 AI 서비스 전용으로 격리돼 우리가 못 씀). 컨테이너 안에는 플랫폼
    D-Bus CLI 바이너리가 없으므로, 시스템 버스 소켓만 마운트하고 파이썬으로 직접 붙는다.
    이 경로가 실기기에서 실제로 붙는 것을 확인했다(2026-08-31, orchestrator introspect 성공).
    - `DbusFastVectordbClient` — 기존 CLI 클라이언트와 같은 VectordbSearcher Protocol을
    구현. resolver는 그대로 끼워진다. **반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
2026-08-31 fix(kiosk): Switch activeThumbColor -> activeColor (internal-platform Flutter 3.27.4 호환)
    flutter-internal-platform SDK가 Flutter 3.27.4라 activeThumbColor(신형 이름)가 없다. 개발
    Flutter는 더 최신이라 통과했지만 실기기 빌드에서 걸렸다. activeColor는 양쪽 다
    인식한다(개발 쪽은 deprecated info만). 실기기 첫 빌드에서 드러난 SDK 버전 차이.
2026-08-31 docs: 실기기 배포 완료 — 키오스크가 라즈베리파이5 화면에 표시됨
    오늘 목표(실기기 화면 표시) 달성. 실기기 캡처를 근거로 남긴다.
    - 온디바이스 의도 해석을 D-Bus 직접 호출(dbus-fast)로 전환 — 백엔드가 플랫폼 위
    파이썬 컨테이너로 올라가고, 컨테이너엔 D-Bus CLI가 없어 소켓으로 직접 붙는다.
    우리 클라이언트가 기대하는 인터페이스가 실기기 시그니처와 맞는 것도 확인
    - 네이티브 앱 빌드에서 SDK Flutter 3.27.4 호환성 1건 수리(activeThumbColor→activeColor)
    - 화면이 안 뜨던 원인 = 지급받은 검정 케이스 7인치 터치 디스플레이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
2026-08-31 fix(kiosk): 연결 안 됐으면 대기 화면 터치해도 조작 화면으로 안 간다
    사용자 혼란: "기기 연결도 안 됐는데 대기 화면 누르니까 전자레인지 조작판이 왜 뜨지?"
    대기 화면이 이미 "기기 연결이 필요해요"라고 말하는데, 눌렀더니 조작판이 뜨면 모순이다.
    게다가 연결 없이는 실제로 버튼도 못 누른다 -- 되지도 않는 조작 UI를 보여주는 셈.
    _toManual에 연결 게이트(_health.ok)를 걸었다. 미연결이면 터치해도 대기 화면 유지 ->
    "기기 연결이 필요해요" 안내가 그대로 이유가 된다. 연결되면 종전대로 조작 화면 진입.
    실기기(라즈베리파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
2026-08-31 fix(rpi): httpx를 런타임 필수 의존성으로 이동 (test extra->base)
    esp_node_controller가 httpx를 최상위 import하는데 base가 아닌 test extra에만
    있었다. 컨테이너/실기기처럼 test 의존성을 안 까는 환경에서 기동 시
    ModuleNotFoundError로 죽었다. 실제 런타임 의존성이므로 base로 옮긴다.
2026-08-31 feat(deploy): 백엔드를 rpi5 기기 컨테이너로 배포
    기기 python3은 온디바이스 AI 서비스 전용이라 우리가 못 쓴다. 그래서
    백엔드를 파이썬 컨테이너로 올리고 시스템 D-Bus 소켓만 마운트한다.
    - backend.Dockerfile: python:3.12-slim, 런타임 의존성 명시 설치(httpx 포함),
    rpi/rpi4만 COPY, uvicorn으로 0.0.0.0:8000 서빙
    - run_backend.sh: docker load 후 실행 — D-Bus 소켓·데이터 볼륨 마운트,
    --restart unless-stopped
    - .dockerignore: 이미지에 rpi/rpi4만. NDA 로컬 자료·대용량 전부 제외
    실기기(arm64)에서 컨테이너 기동 후 키오스크가 localhost:8000에 붙어
    연결 상태·제안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
2026-08-31 feat(app,kiosk,rpi): 전자레인지 코스를 실사용 빈도로 교체
    우유·자동조리 타일을 실제 자주 쓰는 즉석밥·냉동식품·라면으로 바꿨다.
    진짜 전자레인지엔 버튼이 십수 개지만 SimpleLay의 가치는 "그 중 실제로
    쓰는 것만 남기고 나머진 숨기는" 단순화다 — 그 원칙에 맞춰 대표 코스를
    빈도순으로 큐레이션했다. (우유는 물리 버튼/음성 규칙로는 남겨 두되 대표
    타일·데모 기본값·음성 예시에서는 내렸다.)
    버튼맵은 UI가 아니라 액추에이터가 누를 물리 버튼의 거울이라, 다섯 개
    진실원천을 함께 맞췄다:
    - docs/button-maps/microwave.json (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
2026-08-31 feat(rpi): 데모 페이싱 — mock 실행이 폐루프로 보이게 (env 게이트)
    mock 액추에이터는 즉시 끝나 "즉석밥 눌렀더니 순간 완료"로 보였다(실 HW·모터가
    아직 안 붙음). 실행 단계가 화면에 보이도록 지연만 주는 훅을 넣는다.
    - ClosedLoopController에 step_pacer 훅: 성공한 버튼마다 방금 보고한 진행 상태를
    잠깐 유지. 진행 이벤트(on_progress) 시퀀스는 불변 -- 지연만이라 기존 테스트 안전.
    - ports.py SleepingRetryWaiter: 재시도 사이에 쉬어 "재시도 중"도 보이게(실패 시연).
    - controller_factory: SIMPLELAY_DEMO_PACING(기본 꺼짐)이 켜질 때만 위 둘을 주입.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
2026-08-31 feat(app,kiosk,rpi): "다시 추천 안 함" — 사용자가 내린 루틴은 억제
    제안을 거절하면 지금까진 그 카드만 사라질 뿐, 이력이 남아 패턴이 같은 걸
    또 띄웠다. "제안하는 것"만큼 "싫다는 걸 기억하는 것"도 공감지능이라, 사용자가
    "다시 추천 안 함"을 고르면 그 루틴을 억제 목록에 넣어 다시 뜨지 않게 한다.
    거절을 버튼 2개로 나눔:
    - "이번만 넘기기" — 이번 카드만 dismiss (기존 동작)
    - "다시 추천 안 함" — 그 루틴을 억제(패턴이 재생성하지 않음). 같은 루틴의 다른
    pending 카드도 함께 내린다.
    - 백엔드: SuppressionStore 포트(인메모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
2026-08-31 feat(app,kiosk,rpi): 온습도 기반 에어컨 선제 제안 (센서 → 공감지능)
    패턴 제안이 "사용 이력"을 본다면, 이건 "지금 공간이 어떤가"(온습도)를 본다.
    쾌적 범위를 벗어나면(기본 28°C·70%) "에어컨 켤까요?"를 선제 제안한다 — 센서
    (공간 이해)와 선제 제안(공감지능)을 잇는 자리. 판단은 설명 가능한 임계값이다
    (AI 고도화가 아니라 기존 모듈 배선 — 지도교수 방침).
    - EnvironmentalSuggester: 주입된 센서 읽기로 냉방 후보 판단, 근거 문구 생성.
    ProactiveSuggestionService에 배선 — DND·억제·중복 가드를 그대로 탄다.
    - 에어컨 규칙: "에어컨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
2026-09-01 feat(rpi): 가전 레지스트리 — 서버가 가전 정의의 단일 진실원천이 된다
    가전 정의가 다섯 곳(button-maps·폰 하드코딩·폰 로컬 저장·키오스크 하드코딩·
    자연어 규칙)에 흩어져 있어 폰에서 가전을 추가해도 키오스크는 몰랐고, 버튼
    하나 바꾸는 데 다섯 파일을 맞춰야 했다(8/31 코스 교체가 실제 사례).
    - GET /appliances — 내장(전자레인지·인덕션) + 커스텀 목록
    - PUT /appliances/{id} — 폰 편집기 저장과 1:1 (upsert), 그리드 밖 좌표·중복
    위치는 422, 내장 id 덮어쓰기는 409
    - DELETE /appliances/{id} — 커스텀만, SQLite 영속(SIMPLELAY_DB_PATH)
    - 내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
2026-09-01 feat(app): 가전 편집기 저장·삭제를 서버 레지스트리와 동기화
    커스텀 가전이 폰 SharedPreferences에만 있어 키오스크는 존재를 몰랐다.
    저장 시 PUT /appliances/{id}, 삭제 시 DELETE로 서버에도 반영한다 —
    서버가 죽어 있어도 폰 로컬 동작은 그대로(best-effort), 연동 실패는
    "서버 연결 후 다시 저장하면 돼요" 안내만 남긴다.
2026-09-01 feat(kiosk): 가전 선택을 설정에서 수동 조작 진입 화면으로 — 서버 목록 연동
    설정 오버레이의 "제어 가전" 칩은 맥락 없는 UI였다("왜 여기 전자레인지가
    떠 있지?"). 게다가 하드코딩 2종뿐이라 폰에서 추가한 가전은 뜰 수 없었다.
    - 대기 화면 터치 → 가전이 여럿이면 큰 카드로 "어느 가전을 조작할까요?"
    (지난번 사용 가전에 배지), 하나뿐이면 바로 조작판 — NN/g의 "설정보다
    과업 흐름 안에서" 원칙
    - GET /appliances 1분 주기 수신 — 폰에서 등록한 커스텀 가전이 카드로 표시,
    서버 실패 시 내장 목록 폴백(오프라인 우선)
    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
2026-09-01 feat(rpi): 보호자 알림(care events) + 안부 신호 — 백엔드
    실패·위험소리·긴급정지가 키오스크(가전 옆)에만 표시됐다 — 정작 걱정하는
    보호자는 밖에 있다. GET /care-events로 폰이 읽어갈 알림 이력을 만든다.
    - CareEventStore: SQLite 영속(있으면), 실행 실패/긴급정지(사용자 중단과
    스스로 실패를 구분)/위험소리 rising edge를 기록
    - 안부 신호(quiet_routine): 평소 그 시간대에 3일 이상 쓰던 가전이 오늘
    시간대 종료까지 조용하면 하루 1회 알림 — 서울시 스마트플러그·한전
    안부든든과 같은 원리를 usage_log로 구현(스마트플러그 불필요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
2026-09-01 feat(app): 보호자 알림함 — 실패·위험소리·긴급정지·안부 신호를 폰에서
    키오스크(가전 옆)에만 뜨던 사건들을 보호자 폰으로 옮긴다.
    - 알림함 화면(/care): 종류별 아이콘+라벨(색만으로 구분 안 함), 카드형
    목록, 당겨서 새로고침, Semantics 라벨
    - 홈 AppBar 종 아이콘 + 안 읽은 개수 배지 (45초 폴링)
    - 읽음 기준(마지막 본 이벤트 id)은 기기에 저장 — 재시작에도 유지
    - 첫 진입 시 refresh를 기다린 뒤 읽음 처리 (cascade로 이어 부르면 빈
    목록에서 markAllSeen이 돌아 읽음이 안 되던 결함을 테스트가 잡음)
2026-09-01 feat(rpi): 보호자 알림 데모 트리거 — POST /demo/care-event
    안부 신호는 '시간대 종료+3일 루틴+오늘 미사용'이 조건이라 시연장에서 자연 발생이 어렵다. 다른 /demo/*와 같은 리허설 관례로 알림함·배지 장면을 원하는 시점에 연출한다.
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2026-09-01 fix(rpi): 3차 교차 리뷰 백엔드 수리 — 실행 게이트·원자성·dedupe·검증 강화
    치명: 삭제/미등록 appliance_id가 로컬 기본 컨트롤러로 폴백해 삭제된 가전의
    버튼 시퀀스가 다른 물리 가전에서 실행될 수 있었다 → 실행 3종에 레지스트리
    게이트(404). 레지스트리에 있는 커스텀의 로컬 폴백은 유지(8/31 에어컨 데모).
    - 레지스트리 DB 먼저 커밋: 실패 시 메모리·영속 상태 어긋남 방지 (#2)
    - 가전 삭제 시 노드 등록도 정리 — 유령 노드에 긴급 정지 가던 문제 (#4)
    - 버튼 id·라벨 중복 거부(라벨 기반 실행이라 구분 불가), icon 32자 (#5)
    - L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
2026-09-01 fix(kiosk): 삭제된 가전의 조작판 무효화 + 커스텀 가전 선택 재부팅 복원
    - 폰에서 삭제된 가전이 조작판에 남아 있으면 서버 게이트(404)에 걸리기
    전까지 화면과 실물이 어긋난다 — 목록 폴링이 조작 중 가전을 갱신하고,
    사라졌으면 선택 화면으로 되돌린다 (교차 리뷰 치명 #1 클라이언트측)
    - 저장된 가전 id를 내장 목록에서만 찾아 커스텀 선택이 재부팅마다 기본값
    으로 되돌아갔다 — 서버 목록 도착 시 마저 복원 (교차 리뷰 #6)
2026-09-01 fix(app): 알림 폴링 견고화 + 커스텀 가전 재동기화 수단 (3차 교차 리뷰)
    - careEvents 실패를 null로 — 일시적 통신 실패가 "알림 0건"으로 보여
    보고 있던 알림·배지가 사라지던 문제. 실패 시 기존 목록 유지 (#13)
    - refresh 재진입 가드 + 앱 백그라운드 시 폴링 중단, 복귀 시 즉시
    새로고침 — 이 기능은 "앱을 열면 확인하는 알림함"이며 원격 실시간
    푸시가 아님을 코드 주석으로 명시 (#14)
    - 설정에 "키오스크와 다시 동기화" — best-effort 동기화의 복구 수단이
    없었다(#3). 폰 기준으로 서버 커스텀 목록을 맞춘다: 로컬 전체 업서트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
2026-09-08 feat(kiosk): 15인치 1920x1080 대응 — 설계 캔버스 비율 확대
    새로 지급받은 15인치 패널(1920x1080, 터치 정상)에 대응. 기존 UI는 7인치
    800x480 기준으로 튜닝돼 있어 그대로 두면 콘텐츠가 화면 가운데 작은 섬처럼 남는다
    (PPI가 133 vs 147로 비슷해 글씨가 작아지는 게 아니라 화면만 넓어지는 상황).
    "더 많이"가 아니라 "더 크게"를 택했다. 빈 공간에 정보를 채우면 우리가 없애겠다던
    복잡함을 되살리는 자기부정이고, 대상이 고령·저시력 사용자라 글씨·버튼·터치타깃이
    함께 커지는 편이 접근성에 낫다.
    - KioskCanvas: 800x480 설계 캔버스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
2026-09-08 fix(test): 골든 5장을 현재 렌더 결과로 갱신 (환경 간 미세차)
    다른 환경에서 생성된 골든이 이 머신에서 미세하게 어긋났다. 실패 이미지를 확인한
    결과 차이는 **카드 테두리 안티에일리어싱과 아이콘 글리프 픽셀뿐**이고 문구·레이아웃
    차이는 없다(각 0.06~0.31%, 210~1206px). 내용 회귀가 아니라 래스터화 차이다.
    골든은 "현재 코드가 렌더하는 것"을 담아야 하므로 이 머신 기준으로 다시 뜬다.
    - app: home_dark / home_light / home_empty / home_large (아이콘 글리프 1개)
    - kiosk: appliance_select (카드 테두리)
    주의: 골든이 환경을 타는 구조라 다른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
2026-09-08 fix(kiosk): 15인치 테스트를 가전 선택 진입 흐름에 맞춤
    원격에서 수동 조작 진입 첫 화면이 '가전 선택'으로 바뀌었는데, 15인치 확대
    테스트는 여전히 KioskManualView를 기대하고 있었다(리베이스로 합쳐지며 어긋남).
    확대 변환을 통과한 탭이 히트테스트된다는 검증 의도는 그대로 두고 도착 화면만
    현재 흐름에 맞춘다.
2026-09-08 feat(app): 폐루프 증거를 실행 화면까지 배선 (현재 버튼·단계·센서 검증)
    서버는 current_button·total_steps·verification_confidence·verification_detail을
    보내는데 앱에서 끊겨 화면에 도착하지 못했다. API 서비스는 currentButton만 읽고,
    모델·provider엔 필드 자체가 없었다. 그 결과 이 제품의 차별점("실제 버튼을 누르고
    센서로 확인한다")이 가장 중요한 경로에서 안 보이고, 사용자에겐 "빙글빙글 돌다
    완료되는 앱"이었다. 키오스크는 이미 같은 정보를 보여주고 있어 그 구현을 기준으로 맞췄다.
    - RpiStatusResult: verification_confidence·detail 파싱 추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
2026-09-08 test(app): 폐루프 증거 실행 화면 골든 추가
    HTTP 경로(원시 mA/dB 없음)에서 센서 차트 대신 '무슨 버튼을 누르고 어떻게
    확인했는지'가 화면 중심을 차지하는지 눈으로 고정한다. 회귀 시 픽셀로 잡힌다.
2026-09-08 fix(app): 음성 실행 경계 — 듣기 종료와 실행 동의를 분리
    말하다 잠깐 멈춘 것(5초 침묵)이 곧바로 /execute로 나갔다. 물리 버튼을 대신
    누르는 기기에서 이건 되돌릴 수 없는 동작이고, 오인식을 고치거나 그만둘 자리도
    없었다. 침묵은 "듣기 종료"로만 처리하고, 실행 여부는 사용자가 인식 문장을 보고
    고르게 한다("이대로 실행 / 다시 말하기 / 취소").
    함께 고친 것:
    - 탭을 떠나도 마이크가 살아 있던 문제. 탭은 StatefulShellBranch라 화면을 떠나도
    위젯이 유지돼 dispose로는 잡히지 않는다. shell이 "지금 보이는 탭"을 알리고
    (curren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
2026-09-08 fix(app): 정지 동선 보존 — '확인 불가'를 실패와 분리
    통신이 끊기면 phase를 failed로 뭉개고 추적 대상(api·job_id)까지 지웠다.
    그 결과 화면은 정지 버튼을 감췄고, emergencyStop은 HTTP 경로를 잃어 BLE로
    빠졌다 — 가장 불안한 순간("무슨 일이 일어나는지 모르는 때")에 조작 수단이
    사라진 셈이다. **통신 실패는 물리 동작의 종료를 뜻하지 않는다.**
    - ExecutionPhase.unknown 추가. '확인 불가'는 실패가 아니라 모름이다.
    추적 대상은 남겨(_stopHttpTracking(keepTarget:)) 정지와 재확인이 계속
    가능하게 하고, 문구도 "연결이 끊겨 동작을 확인할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
2026-09-08 fix(app,rpi): 제안과 실행 대상 가전을 묶는다
    제안 모델에 대상 가전이 없어서, 화면은 **전역 선택 가전**으로 버튼 지도를
    그리고 승인 실행은 purpose만 넘겼다. 전자레인지를 고른 상태에서 냉방 제안을
    받으면 전자레인지 지도가 붙는다 — 화면이 보여준 것과 실제 눌릴 버튼 사이의
    계약이 빠져 있었다(오늘 추가한 온습도 기반 에어컨 제안으로 드러난 문제).
    - ProactiveSuggestion.appliance_id 추가. 환경 제안은 대상('aircon')을 들고
    다니고, approve/approve_submit이 그 값으로 실행한다 -- 전역 선택값이 그 사이
    바뀌어도 승인한 제안의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
2026-09-08 fix(app): 제안 화면 버튼 폭을 3:4로 — '이번만 넘기기' 줄바꿈 해소
    1:2 배분이라 기본 글씨에서도 단어 중간에서 줄바꿈됐다('이번만 넘/기기').
    문구는 키오스크와 같아야 손버릇이 생기므로, 축약 대신 폭을 키오스크와 같은
    비율(3:4)로 맞춘다.
2026-09-08 fix(app): 글자 200% 접근성 공백 — 오버플로 3곳·터치 목표·선택 시맨틱
    390x844에서 글자를 200%로 키우면 화면이 실제로 넘쳤다. 글씨를 키운 사용자일수록
    안내와 조작을 잃는 구조였다. 먼저 재현하는 테스트를 만들고(실화면을 실뷰포트에
    렌더 -- 오버플로는 렌더 예외로 드러난다) 고쳤다.
    재현·수정한 넘침:
    - 첫 실행 안내 423px, 음성 화면(긴 인식 문장) 182px: 본문을 스크롤 가능하게
    하고 주요 행동(시작하기 / 실행·취소)은 스크롤 밖에 고정해 항상 닿게 했다.
    시작 버튼의 고정 높이(52)는 하한(minimumSize)으로 바꿔 200%에서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
2026-09-08 fix(app): 홈에서 말·버튼 두 조작 경로를 항상 보이게
    주 행동이 가전 성격에 따라 하나만 떴다 — 내장 가전이면 '말로 조작하기',
    사용자 정의면 '버튼으로 조작'. 그래서 말이 잘 안 되거나 인식이 자꾸 실패하는
    사용자에게 다른 길이 화면에 없었고, 같은 시도를 반복하게 됐다. 복잡한 가전
    조작을 단순하게 만들겠다는 논지와 어긋난다.
    - 주 경로는 가전 성격에 맞추되, 다른 경로를 보조 행동으로 같은 자리(하단
    중앙)에 함께 둔다. 조용하되 발견은 되도록.
    - 쓸 수 없는 경로에는 이유를 붙인다('말로 조작 (연결 필요)').
    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
2026-09-08 docs: 앱 개선 백로그 신설 — 리뷰 Medium 잔여 + 의도적으로 남긴 것
    High 6건을 처리하면서 '아직 안 한 것'과 '왜 남겼는지'가 커밋 메시지에 흩어졌다.
    다음 세션이 다시 찾지 않도록 파일 단위로 모으고, 결선로드맵에서 링크한다.
    - A: 리뷰 Medium 5건(홈 정보구조·화면 인상·제안 근거·회복 동선·실제 색 대비)
    - B: 남긴 것 7건. 가장 큰 잔여는 사용 이력에 가전이 없어 패턴 제안이 대상
    가전을 모르는 것(B1). 데모 주입이 kDebugMode에만 걸린 것도 기록(B7).
    - C: HW 우선 원칙에 맞춘 권장 순서 / 리뷰 안티패턴은 '하지 않기로 한 것'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
2026-09-08 feat(rpi): 사용 이력에 대상 가전을 기록 — 패턴 제안이 대상을 알게
    이력에 목적·결과만 남아 패턴 제안은 자기 대상 가전을 몰랐고, 화면이
    현재 선택 가전으로 폴백해 그렸다. 가전 두 대를 함께 쓰기 시작하면
    "저녁마다 하던 그것"이 엉뚱한 버튼 지도를 달고 나온다.
    - UsageRecord.appliance_id 추가, 실행 경로(동기·비동기 job)에서 기록
    - SQLite usage_log에 열 추가 + 기존 DB용 ALTER 마이그레이션
    (파일을 지우게 하면 그동안 쌓인 학습 이력이 날아간다)
    - PatternDetector가 목적별 최근 실행 가전을 후보에 실어 보냄
    (최빈값이 아니라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
2026-09-08 fix(app): 제안 근거 문장과 실제 위젯 색 대비 (백로그 A3·A5)
    A3 — 왜 추천했는지, 안 받기의 결과가 어떻게 되는지
    - 서버가 주던 time_band·occurrences를 앱으로 옮기며 버리고 있었다
    → "최근 저녁 시간에 4번 하셨어요." 한 문장으로 표시
    - 데모 제안은 횟수를 지어내므로 그 문장을 만들지 않는다
    - 영구 억제를 지킬 수 있는 제안(서버 경로)에만 "다시 받지 않기"를 내건다
    BLE 경로에서는 "이번만 넘기기"와 같은 메시지라 약속을 지킬 수 없었다
    - 억제 직후 "앞으로 표시하지 않아요 · 되돌리기" 안내
    - 억제 목록의 불러오는 중 ·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
2026-09-08 fix(kiosk): 제안 근거를 폰과 같은 문장으로 — 시간대를 밝히고 데모는 비운다
    '이 시간대에 3번 하셨어요.'는 무슨 시간대인지 알려주지 않았고, 데모
    제안(횟수를 지어내는 경로)에서도 그대로 나와 화면이 사실이 아닌 말을
    했다. occurrences 기본값 1도 마찬가지 -- 횟수를 모르는 제안이
    '1번 하셨어요'라고 말했다.
    - time_band 파싱 + whyNow 한 문장(폰 models/suggestion.dart와 같은 규칙)
    - 데모·환경 제안은 근거 문장을 만들지 않는다(환경은 서버 reason을 쓴다)
    - occurrences 기본값 1 → 0
    골든 3장 갱신. 무관한 미사용 import 1건 정리.
2026-09-08 fix(app): 가짜 센서 주입을 명시적 데모 세션으로 제한 (백로그 B7)
    데모 실행 흐름(가짜 센서·가짜 성공)이 kDebugMode에만 걸려 있었다.
    실기기에 물린 디버그 빌드에서도 섞이므로, 실제로는 버튼이 안 눌린
    실행이 화면에서 성공으로 끝날 수 있었다 — 폐루프의 존재 이유가
    "눌림을 확인했는가"인데 그 확인을 화면이 위조하게 된다.
    - demoModeProvider 신설. 기본 꺼짐, --dart-define=SIMPLELAY_DEMO=true로
    기본값을 켤 수 있고 설정에서 토글(기기에 저장). 백엔드 SIMPLELAY_* 게이트와
    같은 규칙이다
    - 데모 섹션을 디버그 빌드 조건에서 고급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
2026-09-08 fix(app): 음성 인식 실패 자리에 두 경로를 남긴다 (백로그 B3·A1 문구)
    B3 — 실패를 스낵바로만 알리면 몇 초 뒤 사라지고 화면에는 "마이크를 눌러
    말해보세요"만 남는다. 사용자가 할 수 있는 일이 같은 시도의 반복뿐이었다.
    홈에서는 이미 두 경로를 항상 보이게 했는데(1b3211a) 정작 실패하는 화면이
    그 규칙을 안 따르고 있었다.
    - 실패 사유를 화면에도 남기고(권한·엔진 오류·듣기 종료 후 빈 인식)
    아래에 "버튼으로 조작 · 다시 말하기"를 함께 둔다
    - 다시 말하기를 누르면 안내가 걷힌다
    A1 문구 — 홈의 연결 카드가 /ping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
2026-09-08 feat(app): 앱을 다시 열어도 맡긴 작업을 이어서 확인 (백로그 A4 일부)
    실행은 수 초~수십 초 걸리고 그 사이 앱이 내려갈 수 있다(사용자가 홈으로
    나가거나 OS가 정리). 그때 job_id를 잃으면 물리 조작은 계속되는데 화면은
    "실행한 적 없음"으로 돌아온다 — 가전 앞에 서 있는 사람에게 가장 나쁜
    상태다. 폐루프가 확인해 준 결과도 함께 사라진다.
    - 실행 시작 시 job_id·이름을 기기에 남기고, 결말이 나면 지운다
    ('확인 불가'는 아직 결말이 아니므로 남긴다 — 다시 열면 또 확인해야 한다)
    - 앱 시작 시 남은 job을 되읽어 폴링을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
2026-09-08 feat(app): 실패한 이력에 어디서 멈췄는지와 다음 할 일 (백로그 A4 일부)
    폐루프는 버튼마다 눌림을 확인하고 필요하면 다시 누른다. 그 기록이
    이미 이력에 들어 있는데 화면은 결과 한 줄만 보여줬다 — 무엇이 안 됐는지
    알려주고 끝내면 사용자는 앱을 닫는 것 말고 할 게 없다.
    - 끝이 안 좋았던 실행(실패·안전 정지)에만 단계별 확인 결과를 편다
    (확인됨 / N번 만에 확인 / 확인 못 함). 성공한 이력은 그대로 한 줄 —
    전부 펼치면 목록이 다시 개발 도구처럼 보인다
    - 그 아래 '버튼으로 직접 조작' 한 줄
    '눌렀지만 확인 못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
2026-09-08 fix(rpi): pip install -e . 가 실패하던 pyproject 오류
    dependencies가 [project] 안의 배열이 아니라 [project.dependencies] 테이블로
    감싸여 있었다. setuptools가 "must be array"로 거절해 pip install -e . 이
    통째로 실패한다 — scripts/setup_rpi.sh:89가 그 명령으로 기기를 세팅하므로
    실기기 초기 설치 경로가 막혀 있었다. 개발 PC에서는 시스템 파이썬에 이미
    깔린 패키지로 테스트가 돌아 드러나지 않았다.
    - dependencies를 [project] 안으로
    - 빌드 백엔드는 setuptools인데 패키지 지정이 [tool.poetry]에 있었다 →
    [tool.setuptools.packages.find]로. 리포 루트에 app/·docs/ 등 비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
2026-09-08 마지막커밋: 문서 최신화 — 9/9 백로그 반영분 기록 (devlog · 현황 · 백로그 · CLAUDE.md)
    이번 세션에 처리한 것 (백로그 기준):
    - B1 사용 이력에 대상 가전 기록 → 패턴 제안이 대상을 안다 (a333583)
    - A3 제안 근거 문장 + 안 받기의 결과 / A5 실제 위젯 색 대비 (751de46)
    - 키오스크 제안 근거를 폰과 같은 규칙으로 (a98a04b)
    - B7 가짜 센서 주입을 명시적 데모 세션으로 (ca6cd85)
    - B3 음성 실패 자리에 두 경로 / A1 홈 연결 문구 과장 정정 (3f5f3f2)
    - A4 진행 중 job 보존 (73337ee) · 실패 이력 단계별 결과 (d8993f4)
    - pip install -e . 가 통째로 실패하던 pyp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
2026-09-09 fix(rpi): 실행 대상 가전 검증을 모든 진입점이 공유 (교차평가 R1)
    게이트가 라우터의 직접 실행 3개 경로에만 있었다. 제안 승인은
    approve_submit → submit_purpose → _controller_for로 곧장 내려가 검사를
    지나쳤다. 재현: 선풍기 제안 생성 → 선풍기 삭제 → 남은 제안 승인 →
    노드 없음 → 로컬 기본 컨트롤러 폴백 → 전자레인지 갠트리가 움직인다.
    라우터에 검사를 하나 더 붙이면 진입점이 늘 때마다 같은 구멍이 다시
    생긴다. 대상을 고르는 한 곳에서 거절한다.
    - 게이트를 SimpleLayService._controller_for로 이동. 6개 진입점
    (동기 3 · 비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
2026-09-09 fix(app): 모의 실행은 실제로 아무것도 보내지 않는다 (교차평가 R2)
    어제(B7) 데모 게이트가 막은 것은 BLE 가짜 센서 주입뿐이었다. HTTP 실행은
    그대로 서버로 나갔다. 데모 모드를 켜고 제안을 승인하면 실제 갠트리가
    움직이는데 화면은 "실제 조작이 아닙니다"라고 말했다 — 폐루프의 존재
    이유가 "눌림을 확인했는가"인데 그 확인을 화면이 뒤집는 셈이다.
    문구가 아니라 전송 경로에서 가른다:
    - SimulatedExecutionService — execute 3종·승인·그 job의 status만 흉내내고
    제안 목록·가전·이력·센서·stop()은 실제 서버에 그대로 위임한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
2026-09-09 fix(app): 동기화가 다른 폰의 가전을 지우지 않는다 (교차평가 R3)
    '키오스크와 다시 동기화'가 "폰이 원본"이라는 가정 위에 있었다. 서버에
    있는데 이 폰에 없는 커스텀 가전을 전부 유령으로 보고 지웠다. 폰 A에
    선풍기, 폰 B에 가습기를 등록한 뒤 A에서 동기화하면 B의 가습기와 그
    노드 등록이 사라진다.
    서버 목록에만 있다는 것은 "지워도 된다"가 아니라 "이 폰이 아직 못
    받았다"는 뜻이다. 두 방향을 갈랐다:
    - 올리기: 이 폰의 가전을 서버에 upsert (종전과 같음)
    - 내려받기: 서버에만 있는 가전은 지우지 않고 이 폰 목록에 더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
2026-09-09 fix(app): 추천 근거에서 "최근"을 뺀다 — 집계 범위와 말이 어긋났다 (교차평가 R5)
    패턴 감지에는 기간 창이 없다. 시간대만 맞으면 그 목적의 **전체 이력**을
    센다(rpi/intent/patterns.py). 그런데 어제 넣은 문구는 "최근 저녁 시간에
    4번 하셨어요"였다 — 화면이 집계 범위를 실제보다 좁게 말한 것이다.
    안부 신호의 14일 창과도 혼동된다.
    폰·키오스크 공통으로 "저녁 시간에 4번 하셨어요."로. 어느 시간대인지는
    남긴다(그건 실제 집계 기준이다).
    기간 창이 제품 규칙으로 필요해지면 서버 집계에 넣고 응답에 기간을
    실어 보낸 뒤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
2026-09-09 fix(app): 알림함의 못 불러온 것과 없는 것을 구분 (교차평가 R4)
    목록을 한 번도 못 받은 화면이 "아직 알림이 없어요"라고 단언했다. 이
    알림함이 다루는 것은 실행 실패·위험 신호음·안부 신호다 — 통신이 끊겨
    못 본 것을 "아무 일 없다"로 읽게 두면 이 기능이 존재하는 이유가 무너진다.
    - CareInboxStatus(loading·ready·failed·unconfigured) + 마지막 성공 확인 시각.
    서버 주소가 없는 것은 실패가 아니라 물어볼 곳이 없는 것이다
    - 실패해도 보던 목록은 유지하고 "새 알림을 확인하지 못했어요 · 다시
    불러오기"를 얹는다. 빈 목록에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
2026-09-09 docs: 교차 평가 R1~R5 반영 기록 (devlog · 계획 · 현황 · CLAUDE.md)
    - devlog_2026-09-09b.md 신설 — 항목별로 무엇이 문제였고 왜 그렇게 고쳤는지.
    R2·R5는 하루 전 내가 만든 결함이라는 것도 그대로 적었다
    - 교차평가-후속개발계획: "아직 수정하지 않았다"를 갱신하고 R1~R5에 커밋을
    연결. 실기기 검증이 필요한 항목은 완료로 바꾸지 않았다
    - 개발현황: 기능표에 실행 대상 게이트·모의 실행·다중 폰 동기화 추가,
    테스트 수 668/226/52
    - CLAUDE.md: 시작점 링크와 검증 기록을 이 기기에서 실제로 돌린 결과로
    갱신(골든 포함 여부 명시)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
2026-09-09 feat(rpi): 실험 기록 계측 — 실기기 검증 전에 세워두는 근거 (교차평가 F4)
    발표에서 주장할 수 있는 것은 기록한 것뿐이다. 지금 이력에는 무엇을·언제
    끝났고·버튼별 몇 번 시도했는지만 있어서, 실기기 실험을 시작하는 순간
    아쉬운 것들이 빠져 있다. 계획 문서가 이 항목을 "H1 전에"로 둔 이유다.
    - appliance_id — 가전마다 성공률이 다르다. 분모를 가르는 열쇠
    - execution_mode(real/mock) — 없으면 mock 실행이 실제 성공률에 섞인다.
    부풀리려 한 게 아니어도 결과는 같다. 판단 근거는 컨트롤러를 고르는
    근거(SIMPLELAY_ACT_MODE)와 같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
2026-09-09 fix(rpi): 실행 모드를 실제 실행 대상이 말하게 (F4 이음매)
    F4 첫 구현은 서비스 생성 시 SIMPLELAY_ACT_MODE 하나로 모드를 정해 두고
    모든 이력에 그 값을 찍었다. 그런데 실행 대상은 _controller_for()에서
    가전별 원격 노드로 바뀐다:
    ACT_MODE 미설정(=mock) + 선풍기는 원격 노드에 등록
    → 실제 원격 액추에이터가 버튼을 누름 → CSV에는 mock 으로 기록
    반대로 "원격이니까 real"도 똑같이 틀렸다. 원격 RPi4가 자기 안에서
    MockGrblClient를 돌리고 있을 수 있다 — 전송이 원격이라는 사실은 물리적으로
    눌렸는지에 대해 아무것도 말해주지 않는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
2026-09-09 feat(rpi): 등록 상태와 조작 가능 상태를 분리 (교차평가 F1)
    NodeRegistry는 주소만 안다. 주소가 등록돼 있으면 실행이 그 노드로 가고
    끝이라, 구조가 사실상 registered == operable 로 읽힌다. 실기기가 붙는
    순간 그 등식이 깨진다 — 주소는 맞는데 선이 안 꽂혀 있고, 전송은 되는데
    모터가 홈을 안 잡았고, 모터는 도는데 센서가 기준값을 안 잡았다. 그
    상태에서 실행을 받으면 갠트리가 엉뚱한 좌표를 누른다.
    heartbeat가 온다는 것은 전송이 살아 있다는 뜻일 뿐이다.
    - 내부는 네 축: transport · motion · sensor · calibration + 사유·확인 시각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
2026-09-09 fix(rpi): F1 마감 감사 — 노드 없는 커스텀 가전과 보정 버전 스냅샷
    1) 노드 없는 커스텀 가전이 로컬 갠트리로 흘렀다
    _require_ready가 "로컬 컨트롤러면 검사 대상 아님"으로 빠져나갔는데,
    노드 없는 커스텀 가전도 그 로컬 폴백으로 간다. 로컬 컨트롤러는 내장
    가전 위에 얹힌 갠트리라, 선풍기 시퀀스가 전자레인지의 엉뚱한 버튼을
    누른다 — R1이 막았던 물리 오라우팅이 다른 문으로 되돌아온 것이다.
    로컬 실행이 정당한 경우를 둘로 못 박았다: 내장 가전(그 갠트리가 곧
    자기 액추에이터다), 또는 SIMPLELAY_LOCAL_APPLIANCES에 명시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
2026-09-09 docs: F4·F1 반영 기록과 다음 작업 순서 갱신
    - devlog_2026-09-09c.md 신설 — F4 계측, F4 이음매(모드는 실행 대상이 말한다),
    F1 준비 상태 분리, F1 마감 감사 2건. 각 항목이 왜 그렇게 결정됐는지
    - 계획 문서: F1·F4를 완료(SW)로 표시하고 커밋 SHA 연결. F2를 다음으로,
    R3 잔여를 F2 범위로 흡수한다고 명시
    - 개발현황: 기능표에 실험 기록·가전 준비 상태 추가, API 표에 /history.csv와
    /readiness/{id}, 테스트 수 718/236/58
    - CLAUDE.md: 다음 작업 순서를 갈림길로(HW 있으면 H1, 없으면 F2),
    검증 기록을 이 기기 실제 실행 결과로
    완료의 경계를 문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
2026-09-09 feat(app): 실패한 동기화를 끝까지 다시 보내는 대기열 (교차평가 F2)
    R3에서 삭제는 기기에 남겨 재전송하게 했지만, **업로드 실패는 스낵바에서
    끝났다.** 서버가 꺼져 있을 때 등록한 가전은 사용자가 다시 동기화를
    기억해서 눌러 줘야만 올라갔고, 기억 못 하면 키오스크가 영영 몰랐다.
    그리고 대기열이 Set<String>(id만)이라 로컬에서 지운 뒤의 재전송을 복구할
    수 없었다 — 보낼 내용이 어디에도 없기 때문이다.
    - 순서 있는 operation 목록으로: op_id · appliance_id · 종류 · payload
    스냅샷 · 생성 시각. payload가 있어야 지운 뒤에도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
2026-09-09 docs: F2 반영 기록 — 순서 있는 영속 대기열과 충돌 규칙
    - devlog_2026-09-09d.md 신설 — 왜 Set<String>으로는 복구가 안 되는지,
    순서를 지키는 이유, 충돌을 조용히 덮어쓰지 않는 규칙, 고정한 8개 이음매
    - 계획 문서: F2를 완료(SW)로 표시하고 R3 잔여 흡수를 명시
    - 개발현황: 기능표에 동기화 대기열·편집 충돌 추가, 테스트 수 728/251/58
    - CLAUDE.md: 다음 작업을 H1(하드웨어 대기) 하나로, 위젯 테스트의
    runAsync 함정 기록
    완료의 경계:
    - F2는 소프트웨어 계약까지. 폰 2대로 실제 편집 충돌을 만들어 보는 검증은
    기기 두 대가 필요해 미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
2026-09-09 fix(app): F2 마감 감사 — 구버전 대기열·삭제 판 번호·충돌 뒤 차단
    1) 업데이트하면 미전송 삭제가 사라졌다
    _load()가 새 대기열만 읽어서, 예전 버전의 pending_appliance_deletes에
    남아 있던 삭제가 업데이트하는 순간 조용히 없어졌다 — 서버에는 유령 가전이
    남고 아무도 모른다. 새 대기열의 delete operation으로 옮기고, **저장이
    끝난 뒤에만** 옛 키를 지운다(순서를 뒤집으면 실패 시 양쪽 다 잃는다).
    2) 삭제에는 판 번호가 없었다
    "충돌은 서버 내용 유지"가 수정에만 걸린 반쪽 계약이었다. 폰 A가 판 1을
    본 뒤 폰 B가 2로 고쳐도, A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
2026-09-09 docs: F1·F2·F4가 만든 새 운영 단계를 배포·데모 문서에 반영
    준비 상태 게이트(F1)는 배포 절차에 **새 단계를 만든다**. 노드를 등록해도
    준비 상태를 보고받기 전까지 서버가 412로 거절하는데, 그 방법이 어디에도
    적혀 있지 않았다 — 하드웨어를 붙인 첫날 "아무것도 안 된다"의 1순위 원인이
    될 자리다.
    - 배포 체크리스트에 1-4절 신설: /readiness 보고 방법, 재시작하면 다시
    준비 안 됨으로 돌아간다는 사실(설계다), TTL, 노드 없는 커스텀 가전은
    SIMPLELAY_LOCAL_APPLIANCES로 밝혀야 실행된다는 것
    - 함정 목록에 두 줄 추가 — 원격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
2026-09-09 feat(rpi): 안부 확인 일시 중지 (교차평가 F5)
    안부 신호는 "평소 그 시간대에 쓰던 가전이 오늘 조용하다"를 알린다. 그런데
    집을 비운 것을 **아는** 날에도 그대로 울린다 — 여행, 입원, 자녀 집에 며칠.
    보호자는 이미 알고 있는 일로 알림을 받고, 며칠 이어지면 정작 진짜 신호가
    왔을 때 무시하게 된다. 안부 기능이 스스로를 무디게 만드는 것이다.
    제안 DND와는 다른 것이라 따로 뒀다. DND는 "지금 말 걸지 마"(분 단위)이고
    이건 "며칠간 조용한 게 정상이다"(날짜)이다. 하나로 묶으면 방해 금지 30분이
    안부 확인까지 꺼버리거나,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
2026-09-09 fix(app): 음성 파형을 실제 입력 음량에 연결 (백로그 A2)
    듣는 중 표시가 정해진 반복 애니메이션이었다. 마이크가 아무것도 못 듣고
    있어도 똑같이 춤을 춰서, 인식이 안 될 때 사용자가 "더 크게 말할지 /
    마이크가 죽었는지"를 판단할 근거를 화면이 지워버렸다. 잘 듣고 있다는
    인상만 남기고 사실은 아무것도 알려주지 않는 표시였다.
    - VoiceService.listen에 onSoundLevel을 추가해 엔진 음량을 그대로 넘긴다.
    세션 세대 검사는 onResult와 같다 -- 끝난 세션의 늦은 콜백이 다음 화면의
    파형을 흔들지 않게 한다.
    - _WaveVisualizer는 음량에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
2026-09-09 fix(rpi,app): F5 마감 감사 4건 — 상한·재시작·끝난 일시 중지·알림함 표시
    ① 상한이 화면에만 있었다
    "무기한은 두지 않는다"는 규칙을 날짜 선택기(90일)만 지키고 있었다.
    키오스크나 직접 호출은 2099년까지 쉬게 만들 수 있었고, 그건 곧 무기한
    이다. WellnessPause.MAX_DAYS로 계약에 옮기고 서버가 422로 거절한다.
    ② 재시작하면 쉬는 상태가 사라졌다
    메모리에만 있어서, 여행 이틀째의 재부팅 한 번으로 남은 닷새 동안 알림이
    다시 왔다 — 이 기능이 없애려던 바로 그 상황이다. settings 테이블(신규,
    CREATE TABLE IF NOT EX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
2026-09-09 perf(app): 음량 갱신이 음성 화면 전체를 다시 그리지 않게
    음량은 말하는 내내 초당 십수 번 온다. setState로 받으면 그때마다 화면
    전체가 다시 그려져 **정작 말하고 있는 순간에** 버벅인다. 다시 그릴 것은
    막대 다섯 개뿐이라 ValueNotifier + ValueListenableBuilder로 좁혔다.
    폰 270개 통과. 파형 계약 테스트 4개는 그대로 통과한다.
2026-09-09 docs: F5·음성 파형 반영 기록 — 쉬는 동안의 정직함과 파형의 근거
    - devlog e 신규: F5의 규칙(무기한 없음·실패/위험은 그대로)과 마감 감사 4건,
    파형을 실제 음량에 건 이유와 경계.
    - 배포 체크리스트 1-3: 재부팅 뒤 남는 것과 없어지는 것을 표로 갈랐다.
    F1 준비 상태는 없어지고 F5 쉬기는 남는다 — 잃었을 때 어느 쪽으로 틀리는지가
    기준이다. `SIMPLELAY_DB_PATH`가 없으면 F5도 인메모리라는 것을 적었다.
    - 데모 시나리오: "조용히 실패하는 것" 목록에 안부 확인 쉬기를 넣어 넷으로.
    켜져 있으면 다른 장면은 멀쩡한 채 안부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
2026-09-09 test(rpi): 이미 깔린 DB에 settings 테이블이 생겨도 이력이 남는지
    실기기에는 이미 이력이 쌓인 DB가 있다. settings는 F5에서 새로 생긴
    테이블이라, 그 DB를 열 때 만들어지되 기존 데이터를 건드리면 안 된다 —
    usage_log 마이그레이션 때와 같은 자리다.
    손상된 값이 저장돼 있을 때 쉬지 않는 쪽으로 떨어지는 것도 함께 박았다.
    못 읽는 값 때문에 안부 확인이 영영 꺼져 있는 것이 더 나쁘다.
    백엔드 756개 통과.
2026-09-09 test(rpi): 공개 리포 가드를 파일 이름과 문서·비밀 파일까지
    가드가 **파일 내용**만 봤다. 두 구멍이 있었다.
    1. 파일 **이름**도 공개된다. 내용이 깨끗해도 이름으로 샐 수 있었다.
    2. 바이너리는 `_terms_in`이 조용히 건너뛴다. 그래서 발표 자료·제공 문서
    한 장이 통째로 추적돼도 금지어 가드는 아무 말도 하지 않는다.
    `.gitignore`는 이미 추적 중인 파일을 지켜주지 않으므로, 무시 목록이 아니라
    `git ls-files`(실제로 공개되는 것)를 기준으로 본다. 문서·키 확장자
    (.pptx·.pdf·.docx·.env·.pem 등)가 새로 추적되면 실패한다.
    규칙보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
2026-09-09 feat(rpi): 정지 지연을 실제로 잴 수 있게 — 접수 시각을 남긴다 (H1 준비)
    `history_csv`의 설명은 "정지 지연을 뽑을 수 있다"고 말했지만, **뺄 수 있는
    열이 없었다.** 시작·종료 시각만으로는 "전체 얼마나 걸렸나"까지가 한계다.
    H1이 요구하는 다섯 지표 중 하나가 통째로 빠져 있던 셈이다.
    - `JobHistoryEntry.stop_requested_at` — 긴급 정지를 **접수한** 시각.
    정지로 끝난 실행에만 남긴다. 정지를 눌렀지만 실행이 이미 성공으로 끝났다면
    지연을 잰 것이 아니므로 비운다(빈 칸과 0초는 다른 뜻이다).
    - 연타하면 **첫** 요청을 남긴다 —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
2026-09-09 docs: 정지 지연을 어디까지 잰 것인지 문서에 못 박는다
    숫자 하나가 잘못 읽히면 발표에서 사실이 아닌 말을 하게 된다.
    `stop_latency_seconds`는 **서버 접수 → 실행 루프 종료**이고, 모터가 실제로
    서는 시간은 그 뒤에 더 붙는다.
    - 배포 체크리스트 1순위(정지): 세 시각을 표로 갈랐다. ①접수·②루프 종료는
    CSV에서 나오고 ③물리 동작 중단은 **아직 없다**(장치가 스스로 보고해야
    한다) — 그때까지는 눈·영상으로 재고 따로 적는다.
    - 데모 시나리오·개발현황·계획 문서(H1 항목, F4 행)에 같은 경계를 적었다.
2026-09-09 fix(rpi): 멈춘 뒤 예외로 끝난 실행도 '사용자 정지'로 기록한다
    컨트롤러가 예외를 던지는 경로(UART 단절 등)는 정지 여부를 소진하지 않고
    이력을 남겼다. 사용자가 긴급 정지를 누른 뒤 그 예외가 나면 **'재시도 소진'
    으로 기록돼** 실험에서 실패율 분모에 사용자 정지가 섞인다.
    오히려 진짜 하드웨어 장애일수록 이 경로로 끝나므로, 놓치면 안 되는
    표본에서 종료 사유가 틀리는 셈이었다. 정상 경로와 똑같이 스냅샷+소진해
    넘긴다.
    백엔드 767개 통과(+1).
2026-09-09 마지막커밋: 이번 세션 기록 마무리 — devlog e와 최종 검증 수치
    이번 세션에 한 것(`759ddec` → 이 커밋):
    - **F5 안부 확인 쉬기** (`4c2a4a5`) + 마감 감사 4건 (`d30a496`)
    상한을 서버 계약으로 / 재시작 뒤에도 유지 / 끝난 일시 중지의 날짜를 안 줌 /
    알림함이 쉬는 중임을 말함.
    - **음성 파형을 실제 음량에** (`fd74f0d` `7902338`) — 정해진 반복 애니메이션을
    걷어냈다. 값이 안 오면 흔들지 않는다.
    - **정지 지연 계측** (`123f0b6` `388b6d0`) — CSV 설명은 있었는데 뺄 열이
    없었다. 물리 정지 시각은 여전히 장치 보고 대기라는 것을 네 곳에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
2026-09-09 feat(app,kiosk): 팔레트를 크림+골드에서 흰 계열 바탕+인디고로
    크림 배경이 팔레트 전체를 눌러 왔다. 크림 위에서 앰버는 1.82:1, 그린은
    2.19:1이라 색마다 라이트 전용 변형을 어둡게 만들어야 했고(#8A5A00 올리브,
    #27694C 진초록), 라이트 모드의 "골드"는 사실 #8B6010 갈색이었다.
    탁해 보이던 원인이 배경 하나였다.
    - 바탕 #F4F6FA(푸른 기 도는 밝은 회색) + 카드 #FFFFFF. 카드가 테두리가
    아니라 밝기 차이와 그림자로 떠오른다.
    - 강조색 #3D47B8 / 다크 #96A2F5. 위험·주의가 둘 다 따뜻한 색이라 행동
    채널을 차가운 쪽에 두면 "눌러라"와 "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
2026-09-09 feat(app,kiosk): 홈과 탭바를 다시 짜고 강조색을 보라로
    참고한 UI 킷의 보라는 #5F33E2인데 흰 글자가 6.87:1이라 우리 기준 7:1에
    못 미친다. 색조는 두고 명도만 반 톤 내려 #5729D4로 넘겼다(7.86:1).
    다크는 #B9A6FF(검정 글자 9.96:1). 키오스크도 같은 값을 따른다.
    **탭바** — 주 행동을 가운데로 올렸다.
    예전에는 "말로 조작하기"가 탭바 위에 떠 있고 탭바에도 '음성' 탭이 따로
    있었다. 같은 일이 화면에 두 번 나오면서 어느 쪽을 눌러야 하는지가 흐려졌다.
    하나로 합쳐 가운데 원형 버튼으로 둔다.
    알림함도 앱바 구석의 작은 종에서 탭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
2026-09-09 fix(app,kiosk): AI 과장 문구 제거 · 센서 수치를 상세로 · 흑백 검토 도구
    디자인 재설계에 들어가기 전에, 레퍼런스 없이도 확실한 셋을 먼저 처리한다.
    **1. `AI` 문구** — 온디바이스 추론 3계층 중 1계층(규칙)만 켜져 있는데
    (docs/inference-boundary.md), 앱을 **처음 열 때 보는 문장**이 "AI가 상황을
    인식하고 가전을 대신 조작합니다"였다. 화면에서 가장 과장된 문구가 가장
    앞에 있었던 셈이다. 홈 문구는 A1에서 고쳤는데 온보딩만 남아 있었다.
    "복잡한 가전 버튼을 더 쉽게 조작하세요.
    말하거나 화면에서 고르면 대신 눌러드려요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
2026-09-09 docs: 미뤄둔 두 건을 백로그에 남긴다 (B8 긴급 정지 · B9 제안 용어)
    **B8** — 흑백 도구로 골든을 보니 긴급 정지가 평범한 채움 버튼과 구분되지
    않는다. 지금은 빨강 하나로만 구분하고 있어서, 색각 이상이나 저조도에서
    가장 안전이 걸린 컨트롤이 신호를 잃는다. 색으로 풀 문제가 아니라 형태로
    풀 문제라 재설계 단계 3으로 넘긴다. **확인창은 넣지 않는다** — 급할 때 한
    번 더 묻는 것은 안전장치가 아니라 지연이다. 안티패턴 목록에도 적었다.
    **B9** — `38a7a01`에서 `AI 제안`을 걷어내며 9곳을 `사용 습관 제안`으로
    기계적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
2026-09-09 feat(app): 가전 그림 컴포넌트 — 사진 → 실루엣 → 타이포 (재설계 단계 1)
    이 앱의 주인공은 앱이 아니라 그 집의 **실제 가전**이다. 참고한 UI 킷의
    완성도도 절반은 큰 제품 사진에서 나오는데, 우리에겐 아이콘 글리프뿐이라
    그 배치만 가져오면 그 자리가 빈 채로 남는다.
    `ApplianceMap.photoPath`가 이미 있으므로 사용자가 등록한 자기 집 가전
    사진을 핵심 화면에서 쓴다. 스톡 이미지보다 제품 논지에 맞고, "추상적인
    상태 정보가 중심"이라는 문제도 같이 푼다.
    표시 우선순위: 사진 → 중립 실루엣 → 이름 중심 타이포그래피.
    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
2026-09-09 feat(app): 홈을 가전 중심으로 다시 짠다 (재설계 단계 2)
    카드를 위에서부터 쌓던 구성을 걷어냈다. 구획은 카드가 아니라 제목과
    여백으로 나눈다 — 모든 것을 둥근 카드에 넣으면 정보의 깊이가 전부 같아
    보이고 화면에 편집 방향이 사라진다.
    가전 고르기 → 가전(사진·이름·지금 되는지) → 주 행동 → 제안 → 연결 상세
    - **가전이 화면의 주인공이 됐다.** 사진(없으면 실루엣)이 가장 큰 요소다.
    - 가전 고르기는 **넓은 색면이 아니라 테두리와 글자 굵기**로 선택을
    나타낸다. 색면으로 칠하면 화면에서 가장 강한 것이 "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
2026-09-09 fix(app): 홈에 남아 있던 생성형 시안 문법을 걷어낸다 (단계 2 마감)
    골든을 다시 놓고 보니 구조는 좋아졌지만 문법이 남아 있었다.
    **① 사진 없을 때의 큰 둥근 회색 배경판을 없앴다.** 그 안에 그림 하나를
    넣은 모양이 곧 "자리만 차지하는 플레이스홀더 카드"라, 걷어내려던 것이
    화면에서 가장 큰 요소로 돌아와 있었다. 실루엣을 바탕에 직접 앉힌다.
    **② 알약 버튼을 그만 쓴다.** 칩·배지도 알약이라 같은 형태가 반복되면서
    무엇이 주 행동인지 형태로 구분되지 않았다. 주 행동만 반경 16·높이 56의
    각진 면으로 두고, 칩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
2026-09-09 fix(rpi): readiness 테스트가 실행 날짜를 타던 것을 고친다
    오늘(9/10) 백엔드 7개가 깨져 있었다. 어제까지는 통과했다.
    원인: 이 파일은 판정을 `checked_at = _NOW`(2026-09-09 19:00 고정)로 만들어
    두는데, `ReadinessRegistry`를 **시계 없이** 만들어서 실제 시각을 쓴다.
    날짜가 바뀌자 TTL 10분을 넘겨 전부 만료됐고, `조작 가능`이어야 할 판정이
    `확인한 지 오래돼 다시 확인해야 해요`로 답하기 시작했다.
    파일 안에 이미 시계를 쥔 자리가 **한 곳** 있었고 거기엔 "시간을 쥐지 않으면
    이 테스트는 실행 시각에 따라 흔들린다"는 주석까지 달려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
2026-09-09 fix(rpi): 가전·노드가 바뀌면 준비 판정을 무효화한다
    `ReadinessRegistry.forget()`은 처음부터 있었지만 **저장소 전체에서 호출이
    0건**이었다. 그래서 세 경로가 위험한 상태를 남기고 있었다.
    **① 가전 삭제** — 지운 뒤 판정이 남는다. 같은 id로 다시 등록하면 확인한
    적 없는 `조작 가능`을 그대로 물려받는다. F1이 막으려던 바로 그 상황 --
    "등록됐다"를 "맡겨도 된다"로 취급하는 것 -- 이 삭제·재등록으로 되살아났다.
    **② 노드 주소 등록·교체** — 다른 기기로 갈아 끼워도 앞 기기의 판정이
    남는다. 새 기기의 버튼 좌표는 맞춘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
2026-09-09 fix(rpi): 정리 단계를 서로 독립적으로 — 노드 등록 부분 실패도 fail-closed
    앞 커밋(`06e52c0`)에서 "부가 작업 하나의 실패가 다른 정리를 막지 않는다"를
    **readiness 하나에만** 적용했다. 남은 두 자리를 닫는다.
    **① 가전 삭제 뒤 정리가 아직 한 덩어리였다.**
    try:
    nodes.unregister(id)
    suggestions.drop_for_appliance(id) # 앞이 던지면 여기가 통째로 생략
    finally:
    readiness.forget(id)
    `nodes.unregister()`가 던지면 판정은 지워지지만 **제안은 남는다.** 지운
    가전을 계속 권유하고, 승인하면 404로 거절된다.
    이제 세 단계를 각각 독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
2026-09-12 fix(app): 설정 — 앞 커밋에서 잘려 나간 제어 가전 구획 복구
    8a27616의 편집 스크립트가 연결 타일을 교체하면서 그 뒤에 있던
    _ApplianceSection 클래스까지 함께 잘라냈다. analyze 결과를 tail로 가려
    빨간 채로 푸시됐다. 직전 커밋의 블록을 그대로 되살렸고, 이번 커밋부터는
    analyze 오류 0·테스트 통과를 확인한 뒤에만 커밋한다.
    폰 308 통과(골든 49장 별도), analyze 신규 경고 0.
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2026-09-13 fix(kiosk): 방해 금지 선택지·취소를 48px 버튼으로, 위험 경보를 스크린리더가 바로 읽게 (D5)
    접근성 감사에서 찾은 결함.
    - 방해 금지: 선택지가 46px GestureDetector, '취소'는 13px 글자 하나라 고령
    사용자 기준 터치 크기(48px)에 못 미쳤고 스크린리더에 버튼으로 읽히지 않았다.
    선택지는 56px 버튼, 취소는 48px TextButton, 글자 18~24px. 문구는 그대로.
    - 위험 신호음 경보: liveRegion이 없어 떠올라도 스크린리더가 알리지 않았다.
    화면 모양은 그대로 두고 liveRegion 컨테이너로 감쌌다.
    - 감사 테스트: 방해 금지 터치 크기·동작, 경보 liveReg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
2026-09-13 fix(rpi): 준비 판정 무효화 테스트가 실행 날짜를 타지 않게 시계를 고정한다
    판정 시각은 _NOW(2026-09-10)로 고정했는데 레지스트리는 실제 시계를 써서,
    TTL 10분이 실행 날짜를 탔다. 2026-09-13에 이 파일 13개가 한꺼번에 깨졌다 --
    test_appliance_readiness.py에서 한 번 고친 것과 같은 결함을 이 파일에 다시
    넣었던 것이다. 테스트 픽스처에서 deps의 시계를 FixedClock(_NOW)으로 바꾼다.
    제품 코드 변경 없음.
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2026-09-13 fix(rpi): 개발자 세션 정지 경로 재작업 - 락 밖 디스패치, fault 잠금, 단조 시계
    후속 교차 리뷰 #2~#4. Phase 0의 submit()은 상태 락을 잡은 채 어댑터를
    호출해, 어댑터가 느리면 긴급 정지와 heartbeat 만료가 그 명령이 끝나기를
    기다렸다(즉시 반환하는 mock에서는 드러나지 않던 결함).
    - 어댑터 모션 호출을 상태 락 밖으로: 정지는 epoch를 올린 뒤 바로 어댑터에
    닿는다. 정지와 경합해 늦게 나간 명령은 epoch 불일치로 감지해 즉시
    재정지한다(stop_after_late_command) - 단순히 락 밖으로 옮기기만 하면
    생기는 "정지 후 늦은 명령 실행" 구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
2026-09-13 fix(rpi): 대상 없는 제안의 실행 차단 + 리허설 제안 대상 필수화 (B10 서버)
    appliance_id 없는 제안의 승인은 '기본 로컬 컨트롤러'로 흘러갔다 - 다중
    가전 이후 그 기본은 우연히 전자레인지일 뿐이라, 화면이 보여준 대상과
    기계가 움직이는 대상이 다를 수 있는 구멍이었다. 데모 편의라는 이유로
    일반 실행의 예외를 남기지 않는다(백로그 B10 결정).
    - 승인(approve/approve_submit)은 대상 없는 제안을 409로 거절한다.
    게이트를 소비하기 전에 거절하므로 카드는 pending으로 남아 화면이
    이유를 보여줄 수 있다
    - POST /demo/suggest의 appliance_id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
2026-09-13 fix(rpi): 0.0초 실행 시간이 결측으로 둔갑하던 falsy 비교 수리
    timedelta(0)은 파이썬에서 falsy다. mock 실행이 시계 한 틱 안에 끝나면
    duration이 0이 되고, `if e.duration` 비교가 그것을 '기록 없음'(None/"")
    으로 내보냈다 - /history 응답과 history.csv 둘 다. 실측 표본에서 0초와
    결측은 다른 데이터다(stop_latency는 이미 is not None으로 갈랐다).
    test_http_history_carries_the_execution_mode가 시계 해상도에 따라
    간헐적으로 빨개지던 원인 - 이번 세션 전체 실행에서 실제로 재현됐다.
2026-09-13 fix(kiosk): 대상 없는 제안 실행 잠금(B10) + 빈 가전 목록을 성공으로 반영(B11)
    B10 - 제안 화면: 대상을 못 찾는 제안은 '지금 실행'을 잠그고 이유를
    말한다("이 제안의 가전을 찾을 수 없어 실행할 수 없어요"). 서버도 대상
    없는 승인을 409로 거절하므로, 눌리는 버튼을 세워 두면 눌렀는데 아무
    일도 안 일어나는 화면이 된다. 넘기기/다시 추천 안 함은 그대로 열려
    있다. 재시도 콜백 등 다른 경로도 _onApprove 초입에서 같은 규칙으로
    막는다.
    B11 - listAppliances가 실패(null)와 성공한 빈 목록([])을 구분한다.
    실패를 빈 목록으로 표현하던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
2026-09-13 fix(rpi): 개발자 세션 안전 경합 마감 - stopping 상태, 예외 settle, start/close 원자화 (Phase 1.1)
    후속 교차 리뷰 1.1의 3건 - 전부 실결함 확인(오탐 없음).
    1. 정지 성공만으로 제어권을 반납하지 않는다. 어댑터 안에 진행 중인 명령이
    있으면 정지는 즉시 나가되 반납은 그 명령의 정리(settle)로 미룬다
    (stopping 상태 - 그동안 중재자 holder가 DEVELOPER로 남아 새 실행·새
    세션이 409). settle이 재정지를 확인한 뒤에야 반납한다. 기준은 "마지막
    호출이 stop이었다"가 아니라 "이전 명령이 다시 동작할 수 없는 상태".
    2. 어댑터 예외도 같은 s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
2026-09-13 fix(rpi): settle과 정지가 겹치는 경합 마감 - 정리 완료까지 점유 유지, 세대 확인 (Phase 1.2)
    후속 교차 리뷰 1.2 - Phase 1.1이 추가한 settle 자체의 경합. 실결함 확인.
    settle이 초입에서 _inflight=False로 내린 뒤 복구 정지(command_error)를
    기다렸다. 그 창에서 별도 긴급 정지가 "진행 중 명령 없음"으로 판단해
    제어권을 반납할 수 있었고, 이후 오래된 복구 정지의 실패가 세대 확인
    없이 현재 세션(새로 열린 B)을 닫고 제어권을 벗겨낼 수 있었다.
    - "아직 끝나지 않은 작업" = 명령 + 그 명령의 안전 정리. _inflight는
    settle의 단일 출구(_finish_sett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
2026-09-13 fix(rpi): 제어권 반납을 단일 판정점으로 - 정지 확인·진행 중 정지까지 조건화 (Phase 1.3)
    후속 교차 리뷰 1.3 - 정상 완료와 긴급 정지의 경합. 실결함 확인.
    stale=False 판정과 _finish_settle 사이에 긴급 정지가 끼면, 반납 위임
    표시(_release_pending)는 "반납 부탁"일 뿐 "정지 확인"이 아닌데도 settle이
    소비해서 - 정지 어댑터 호출이 아직 응답 대기 중인 채로 제어권이 넘어가고,
    그 정지가 늦게 실패하면 이미 새 실행이 돌고 있을 수 있었다.
    조건문 추가 대신 반납 판정을 _maybe_release_locked() 한곳으로 모았다.
    기준은 "누가 마지막으로 끝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
2026-09-13 fix(rpi): 판정 조건을 바꾸는 두 경계의 원자화 - fault 세대 해제, 정지 예약 (Phase 1.4)
    후속 교차 리뷰 1.4 - 단일 판정점(1.3)의 조건을 "바꾸는 작업"이 중간
    상태를 노출하던 두 곳. 실결함 확인.
    1. fault 세대 비교와 해제가 원자적이지 않았다: fault_reason 읽기,
    fault_seq 읽기, clear_fault()가 세 번의 별도 락이라 비교 직후 걸린
    새 fault를 오래된 정지의 성공 응답이 지울 수 있었다.
    → ControlArbiter.fault_snapshot()(reason+seq 동시 캡처)과
    clear_fault_if_matches(seq)(같은 락에서 대조+해제)로 교체.
    무조건 clear_fault()는 수동 개입·테스트 정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
2026-09-13 fix(rpi): 반환 판정과 실제 반환을 같은 임계구역으로 (Phase 1.5)
    후속 교차 리뷰 1.5 - 마지막 반환 단계의 같은 종류 경합. 실결함 확인.
    _maybe_release_locked()가 락 안에서 판정하고 arbiter.release()는 락을
    놓은 뒤 호출했다. 판정과 반환 사이에 새 긴급 정지가 예약되면, 과거
    판정대로 반환해 정지 진행 중 새 실행이 제어권을 얻을 수 있었다 - 판정
    당시의 안전이 반환 시점까지 유지된다는 보장이 없었다.
    _maybe_release_locked()가 판정·상태 갱신·중재자 반환까지 한 임계구역에서
    끝낸다. 중재자 락은 콜백 없는 최내곽(leaf)이라 기존 개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
2026-09-13 feat(rpi): 개발자 API 계약 - 별도 토큰·세션 소유권·빈도 제한·상태 코드 (Phase 2, mock 전용)
    개발자 모드 Phase 2 첫 단계. 화면에서 숨기는 것이 아니라 서버가 접근을
    강제한다. 실물 어댑터 허용·범용 셸 콘솔은 범위 밖.
    접근 제한 (rpi/api/dev_router.py)
    - SIMPLELAY_DEV_MODE가 아니면 /dev/* 전부 404
    - 켜져 있어도 SIMPLELAY_DEV_TOKEN(16자 이상)이 없으면 503 - fail closed
    - 개발자 토큰은 일반 API 키와 별개 권한이고 루프백도 면제하지 않는다
    - 클라이언트별 인증 실패 한도 도달 시 창이 지날 때까지 맞는 토큰도 429
    - mock이 아닌 매니저가 물려 있으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
2026-09-13 fix(rpi): 개발자 세션 게시와 요청 중복 방지 계약 보완
2026-09-13 fix(app): 개발자 콘솔 지연 응답과 정지 상태 처리 보완
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2026-09-13 fix(rpi): 실행 상한을 비동기 실행 합류점에서 검사한다
    동기 실행만 해석 결과의 버튼 개수·바이트 상한을 다시 검사했다. 실제 HTTP
    경로인 /execute와 제안 승인은 submit_purpose → _submit으로 내려가 검사를
    지나쳤다. LLM 해석을 켠 구성에서 모델이 폭주하면 상한 없는 물리 실행이 된다.
    - 검사를 _submit 합류점으로 옮겨 네 비동기 진입점이 모두 지나게 했다.
    대상 확정·제어권 획득보다 먼저 거절하므로 제어권이 남지 않는다.
    - 동기 execute_buttons도 같은 검사를 받는다.
    - 제안 승인 라우터가 해석 거절(ValueError 계열)을 500 대신 422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
2026-09-13 fix(rpi): /stop이 이벤트 루프를 막지 않게 하고 노드별 전달 결과를 드러낸다
    async 핸들러가 동기 정지 브로드캐스트를 직접 불러, 응답 없는 노드를 전체
    상한(2.5초)까지 기다리는 동안 /status·SSE·다른 API가 모두 멈췄다. 응답은
    was_running만 담아 정지 요청이 닿지 않은 노드를 알 수 없었다.
    - 서비스 정지를 스레드로 넘기고, 개발자 세션 정지를 노드 브로드캐스트
    뒤가 아니라 동시에 보낸다(두 경로는 서로의 락을 잡지 않는다).
    - 응답에 nodes_requested·nodes_acknowledged·nodes_unconfirmed를 더했다.
    기존 필드는 그대로라 ok만 보던 폰·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
2026-09-13 fix(rpi): 홈 스위치를 읽을 수 없으면 준비 안 됨으로 닫는다
    GPIO를 켠 구성에서 초기화 실패·읽기 오류 때 is_ready()가 True를 돌려줬다.
    개발 PC용 폴백이 실기기에서 위험 쪽으로 열린 것이다 — 스위치를 못 읽었는데
    갠트리가 홈에 있다고 /health가 말했다.
    - 초기화 실패·읽기 오류·기한(0.2초) 초과·bool이 아닌 값은 모두 False.
    None이 `not None`으로 홈으로 읽히던 경로도 닫았다.
    - 판독은 데몬 스레드에서 기한을 두고 기다린다. 이전 읽기가 끝나지 않았으면
    새 스레드를 띄우지 않고 닫는다(폴링마다 스레드가 쌓이지 않게).
    - 일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
2026-09-13 feat(rpi): 원시 센서 기록기 — ADC·음향 레벨·누름 이벤트를 단조 시각 CSV로
    하드웨어 수령 직후 임계값을 믿기 전에 값부터 보기 위한 최소 도구다
    (docs/하드웨어-연결-설계.md §4·§6).
    - 기록: ADC 정수 판독값·전압, 음향 블록 RMS·피크·샘플 수,
    press_start/press_end/marker/error 이벤트. 모든 행에 monotonic_ns.
    - 판정 없음: 임계값·눌림·성공 판정을 넣지 않았고 rpi.verifier를 import하지
    않는다(테스트로 고정).
    - ADC gain은 기본값을 두지 않는다 — 영점 전압과 범위가 안 맞으면 포화된다.
    - 판독 오류는 error 이벤트로 남기고 계속 기록한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
2026-09-13 docs: 하드웨어 수령 전 준비 마감 기록(devlog s), 검증 968/340/90, 기록기 연결
    - devlog s: 홈 스위치 fail-closed, 원시 센서 기록기, README 정리, 실측 기록표와
    각 검증 경계(기록기 실기기 입력부 미검증).
    - 하드웨어 연결 설계 §6이 실제 기록 도구와 실측 기록표를 가리킨다.
    - CLAUDE.md: 시작점 갱신, 소프트웨어 사전 준비 마감, 최신 검증 기록.
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2026-09-15 fix(rpi): 모델 HTTP 호출에 User-Agent 명시
    - 게이트웨이 앞단 방화벽이 파이썬 기본 User-Agent(Python-urllib)를 403(error 1010)으로
    막아, 키가 맞아도 호출이 통째로 실패하던 문제
    - 회귀 테스트는 수정 전 코드에서 실패함을 확인
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2026-09-16 fix(rpi): 보정 저장 게이트 — 요청이 검증을 무르게 만들지 못하게
    기준점으로 구한 변환을 버튼 mm로 저장하는 경로에 검증 구멍이 세 개 있었다.
    - 허용 오차(max_rms_mm·max_point_error_mm)를 요청이 그대로 정했다. 큰 값을
    보내면 오차가 수백 mm인 변환도 통과해 저장됐다. 이제 서버 기본값이 상한이고
    요청은 더 엄격하게만 만들 수 있다.
    - 최소 개수(affine 3점·homography 4점)로 맞추면 잔차가 항상 0이라 임계값을
    통과해도 검증이 아니다. 기준점 하나를 잘못 찍어도 그대로 저장됐다. 이제
    잉여 점이 없으면 거절한다(변환 수식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
2026-09-16 fix(rpi): L3 기준선을 누르기 전부터 잡고, 판정 대기 중 정지를 본다
    전력 판정의 기준선은 '상승 직전 대기 샘플의 중앙값'인데, 어댑터가 시퀀스를
    다 넣은 뒤에 첫 샘플을 읽었다. 실기기 센서는 과거 샘플을 돌려주지 않으므로
    조작 전 구간이 통째로 비고, 실제로 가전이 돌기 시작해도 '기준선 없음'으로
    실패한다. L3는 자동 재시도가 없는 층이라 이 오판정이 곧바로 안전 정지와
    사람 호출이 된다.
    - OperationVerifier에 begin_observation() 훅(기본 no-op)을 두고, 컨트롤러가
    첫 누름 전에 부른다. 전력 어댑터는 기준선 창만큼 대기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
2026-09-16 fix(app): 사진을 보내기 전에 매번 동의를 받고, 어디로 가는지 밝힌다
    조작부 사진은 서버를 거쳐 인터넷의 외부 인식 서비스로 나간다. 그런데 확인
    창은 '적어 둔 버튼이 있을 때'만 떴다 — 버튼을 아직 안 적은 새 가전에서는
    탭 한 번에 사진이 전송됐다. 안내 문구에도 '외부·인터넷'이라는 말이 없었다.
    - 전송 전 확인 창을 항상 띄운다. 제목은 '사진을 외부 인식 서비스로 보낼까요?',
    본문은 전송 사실을 먼저 적고 적어 둔 버튼이 있으면 바뀐다는 것도 함께 알린다.
    - 버튼 아래 안내를 '인터넷의 외부 인식 서비스'로 고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
2026-09-16 fix(rpi): 기준선 수집 중 정지 관측, 0 임계값을 기본값으로 갈아끼우지 않기
    Copilot CLI 교차 리뷰에서 나온 두 건이다.
    - begin_observation()이 기준선 창을 채우는 동안 정지 요청을 보지 않아, 아직
    누르기 전인데도 정지 처리가 폴링 상한만큼 늦어질 수 있었다.
    - 오차 임계값에 0을 보내면 `or` 기본값으로 조용히 바뀌어, 호출부는 자기가
    보낸 기준으로 저장됐다고 믿게 된다. 이제 그대로 넘겨 422로 거절한다.
    회귀 2건. 수정 전 코드에서 둘 다 실패하는 것을 확인했다.
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2026-09-16 fix(rpi): 내장 가전 보정도 판 번호로 동시 수정을 막는다
    사용자 정의 가전 보정은 expected_revision을 비교했지만 내장 가전(전자레인지 등)은
    그 검사를 건너뛰고, 응답 판 번호도 항상 0이었다. 폰 두 대가 같은 판을 보고
    차례로 보정하면 나중 것이 앞의 좌표를 조용히 덮었다.
    - 내장 가전 보정에 판 번호를 두고, 저장마다 올린다. 요청 판과 다르면 409.
    - 판 번호를 보정 기록에 함께 저장해 재시작 뒤에도 유지한다. 판 번호가 없는
    옛 기록은 1판으로 읽는다(보정이 한 번은 저장됐다는 뜻).
    회귀 2건(동시 보정 충돌, 재시작 뒤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
2026-09-16 fix(rpi): 사진 인식 응답 본문에 크기 상한을 둔다
    인식 서비스 응답을 response.read()로 통째로 읽었다. 게이트웨이가 폭주해 거대한
    본문을 보내면 그대로 서버 메모리에 올라간다(RPi5에서 서버 전체가 흔들릴 수 있다).
    - 상한(1 MB)보다 1바이트 더 읽고, 넘으면 502로 끝낸다. 버튼 목록 JSON은 수 KB다.
    회귀 1건: 상한의 3배 본문에서 상한+1 이상 읽지 않고 거절. 읽기 상한만 되돌린
    변형(무제한 read)에서 실패하는 것을 확인했다.
2026-09-16 fix(rpi): 사진 인식 호출에 시간당 상한을 둔다
    API 키가 기본으로 꺼져 있어, 같은 망의 누구든 /panel-scan을 반복 호출해 공유
    크레딧을 소진시킬 수 있었다. 동시 1건 게이트만 있고 총량 제한은 없었다.
    - 인식 서비스로 나간 요청을 한 시간 창으로 세고, 상한을 넘으면 요청을 보내지
    않고 429로 거절한다. 기본 20회, SIMPLELAY_VISION_MAX_PER_HOUR로 조정
    (잘못된 값·1 미만은 기본값).
    - 실패한 요청도 센다 — 크레딧·한도를 쓸 수 있고, 실패를 반복해 상한을 우회하지 못하게.
    - 게이트는 프로세스 안 상태라 테스트마다 비운다(서버는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
2026-09-16 fix(rpi): 사진 인식 응답을 끝까지 나눠 읽고 누적 크기로만 상한을 본다
    Copilot CLI 교차 리뷰 지적이다. 크기 상한을 둘 때 read(limit+1)을 한 번만 불렀는데,
    read(n)은 '최대 n바이트'라 청크 전송·부분 읽기에서는 한 번에 다 오지 않는다.
    정상 크기 응답이 잘려 '응답을 읽을 수 없어요'로 실패할 수 있었다.
    - EOF까지 나눠 읽고, 누적이 상한을 넘는 순간 멈춘다(넘었는지 알 수 있게 1바이트 더).
    회귀 1건: 한 번에 7바이트씩만 돌려주는 정상 응답을 끝까지 읽는다. 수정 전 코드에서
    실패하는 것을 확인했다. 기존 상한 초과 테스트도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
2026-09-16 fix(kiosk): 사용자 문구를 해요체로 통일
    - 대기 화면 '조작 가능'을 폰과 같은 '조작할 수 있어요'로.
    - 위험 경보 화면·음성 안내, 실행 실패 음성, 설정 설명, 가전 선택 낭독 문구의
    합쇼체를 해요체로. 뜻은 바꾸지 않았다.
    - 골든 4장(대기·큰 글씨 대기·15인치 대기·15인치 위험 경보) 갱신.
2026-09-16 fix(app): 홈 연결 경고를 정도에 따라 자리 잡고, 문구를 해요체로 통일
    - 서버에 닿지 않으면 연결 경고를 가전보다 위에 둔다. 예전에는 맨 아래에 있었다.
    - 서버는 끊기고 예비 연결로만 닿으면 상태 줄을 '예비 연결로 조작할 수 있어요',
    경고를 '제안·기록이 멈췄어요'(주의색)로. 같은 화면에 '조작 가능'과
    '연결 설정이 필요해요'가 함께 떠서 어느 쪽을 믿을지 알 수 없던 문제.
    - 예비 연결만 꺼졌으면 경고색 대신 아래에 '예비 연결 꺼짐'. 펼쳐도 연결된
    서버를 다시 카드로 말하지 않는다.
    - 실행 실패·중단, 정지 요청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
2026-09-16 feat(kiosk): 실행 화면에 버튼판을 두고 긴급 정지를 짙은 빨강으로
    화면 평가 4순위(키오스크) 중 실행 화면.
    - 정지 하나만 있어 비어 있던 오른쪽 칸(240→300)에 대상 가전의 버튼판을 그리고,
    지금 누르는 버튼만 채운 면·흰 두꺼운 테두리로(재시도는 주의색). 누를 수 없는 그림이다.
    - 서버는 버튼 이름만 준다. 대상 가전에서 그 이름이 정확히 한 번 나올 때만 자리를
    가리키고, 없거나 여럿이면 그리지 않는다.
    - 긴급 정지: 연한 붉은색+검정 글자 → 짙은 빨강(#A8201A)+흰 글자(7.3:1), 외곽선 유지.
    - 테스트 3건(수정 전 코드에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
2026-09-16 style(app): 실행 화면 긴급 정지를 키오스크와 같은 짙은 빨강으로
    - 연한 레드(#EF6E64)+검정 글자 → 짙은 빨강(AppColors.stop #A8201A)+흰 글자(7.3:1).
    키오스크 KioskColors.stop과 같은 값이고, 두 테마에서 같은 면을 쓴다.
    - 정지 기호·두꺼운 외곽선은 그대로. 색 확인을 기존 모양 테스트에 더했다(수정 전
    코드에서 실패 확인). 골든 8장 갱신.
2026-09-16 feat(kiosk): 수동 조작 판을 남는 자리만큼 키우고, 재시도 진행 칸을 주의색으로
    - 수동 조작 칸이 124x66 고정이라 3열 판이 가운데 좁게만 차고 15인치에서 양옆이
    크게 비었다. 자리에 맞춰 키우되 하한은 예전 크기, 상한은 200x96(설계 캔버스).
    칸이 넉넉하면 글자를 20→24. 자리가 모자라면 예전처럼 스크롤된다.
    - 실행 화면 진행 막대의 지금 칸 테두리를 재시도 중에는 주의색으로(상태 구절·버튼판과
    같은 색, 폰과 같은 규칙).
    - 테스트 2건(수정 전 코드·색을 되돌린 변형에서 실패 확인). 골든 5장 갱신.
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2026-09-17 fix(rpi): L3 판정 기준을 마지막 단계의 첫 누름으로, 누르는 동안의 공백에도 기준선 유지
    - 기준선을 누르기 전에 잡으면서 5초 제한까지 누르기 전부터 흘러, 기구 이동·누름에
    시간이 걸리면 정상 가동도 '확인 안 됨'으로 안전 정지하던 결함
    - 컨트롤러가 누르기 직전마다 note_press로 알리고, 검증기는 샘플을 이어 넣어 단계의
    첫 누름 시각을 기준으로 삼음(L1 재시도는 첫 누름 기준 유지)
    - 판정기: 읽지 못한 공백 뒤에는 마지막 대기 구간을 기준선으로 유지(끊김 없이 읽을
    때 동작은 같음). 마지막 단계를 누르기 전부터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
2026-09-17 fix(rpi): 대표 명령 '우유 데워줘'를 없애고 '즉석밥 데워줘'로 통일
    '우유 데워줘' 규칙은 해동 → 시간 90초 → 시작이었는데 내장 전자레인지 버튼판에
    '시간 90초'가 없다. 서버가 좌표를 찾지 못하고 화면 버튼판도 가리킬 자리가 없었다.
    키오스크 골든은 입력을 '1분'으로 바꿔 이 불일치를 가리고 있었다(로그 ac #4).
    실제 사용과도 거리가 있어 팀 확인으로 규칙·별칭을 지웠다.
    - 보호 테스트: 전자레인지 규칙의 모든 버튼 이름이 내장 전자레인지 버튼판에 있다
    (에어컨 규칙 제외). 수정 전 규칙에서 {'우유 데워줘': ['시간 9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
2026-09-17 fix(app): 홈이 서버 '확인 중'을 끊김으로 보지 않는다
    앱을 켜면 주소를 불러오고(unconfigured) 핑을 보내는(checking) 몇 초가 있는데,
    홈은 connected가 아니면 모두 끊김으로 봐서 켤 때마다 빨간 '연결 설정이 필요해요'가
    맨 위에 잠깐 떴다(로그 ac #5).
    - 맨 위 경고는 닿지 않는다고 확인된 경우(unreachable)만. 확인 중에는 가전 상태 줄이
    '연결을 확인하고 있어요', 예비 연결이 꺼졌으면 아래에 조용히 '예비 연결 꺼짐'.
    - 주소는 불러온 뒤 항상 기본값이 들어가므로 unconfigured는 시작 직후 상태다.
    - 테스트 도우미 FixedRpiConnection(스스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
2026-09-17 fix(rpi): 사진 인식 시간당 상한 0을 '끔'으로 처리
    SIMPLELAY_VISION_MAX_PER_HOUR=0을 기본값 20으로 바꿔, 끄려고 적은 설정이 오히려
    시간당 20번을 열었다(로그 ac 5단계). 0이면 인식 서비스로 보내지 않고 503
    '설정으로 꺼져 있어요'. 음수·숫자가 아닌 값·빈 값은 그대로 기본값 20.
    - 상한이 세는 것을 문서와 맞춤: '나간 요청'이 아니라 '보내려 한 시도'(연결 실패 포함).
    로그 z의 표현은 이 커밋과 로그 ad로 정정한다.
    - 테스트: 0이면 503·호출 0회(수정 전 코드와 0→기본값 변형에서 실패 확인),
    잘못된 값 목록에서 0을 빼고 1.5를 넣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
2026-09-17 fix(app): 버튼판 순서 배지가 큰 글씨에서 숫자를 자르지 않게
    배지 높이가 20으로 고정돼 200% 글씨에서 숫자(높이 34)가 배지 밖으로 잘렸다
    (로그 ac 5단계, 리뷰 지적을 테스트로 먼저 확인). 최소 20x20만 두고 글자에 맞춰
    늘어나게 했다. 보통 크기에서는 모양이 같아 골든 변화 없음.
    테스트 1건(수정 전 코드에서 34 > 20.5로 실패 확인). 폰 372 통과, 골든 51 비교 통과.
2026-09-17 style(kiosk): 실행 화면 버튼판을 누를 수 있는 버튼처럼 칠하지 않는다
    버튼판의 칸이 수동 조작 칸과 같은 면색·테두리라 눌러도 되는 버튼으로 보였다
    (로그 ac 리뷰 지적, 골든으로 확인). 지금 누르는 칸만 면을 채우고, 나머지는 면 없이
    옅은 윤곽만 둔다.
    테스트 1건(수정 전 코드에서 실패 확인). 키오스크 119 통과, 골든 4장 갱신·재비교 통과.
2026-09-17 docs: 로그 ac 2~6단계 기록(devlog ad), 진행 중 표시 정리, 깨진 Flutter 경로 수리
    - devlog ad: 6커밋 단계별 기록, 로그 ab·z 주장 정정, 검증(백엔드 1,252 · 폰 372 ·
    키오스크 119, 골든 51·26), Copilot 교차 리뷰 결함 없음, 남은 것.
    - CLAUDE.md: '지금 진행 중'을 끝난 상태와 대표 명령(즉석밥 데워줘)으로, 시작점에 로그 ad,
    최신 검증 기록. 9/16 문서 수정 때 이스케이프로 깨진 Flutter 경로 줄을 지우고,
    환경 항목에 데스크톱·노트북 경로를 나눠 적었다.
    - 개발현황: 최종 업데이트·검증 수치.
2026-09-17 fix(app,kiosk): 긴급 정지 뒤 장치가 멈췄다고 단정하지 않는다
    서버가 확인하는 것은 실행 루프가 끝났다는 것(safety_stopped)까지고, 모터가
    물리적으로 멈췄는지는 아직 아무 센서도 확인하지 않는다(정지 지연 ③ 실측 대기).
    그런데 키오스크는 '안전하게 멈췄어요'라고 말했다(Copilot 평가 지적).
    - 키오스크 결과 화면: 큰 글자 '멈췄어요' → '실행을 멈췄어요', 정지 안내
    '안전하게 멈췄어요' → '실행을 멈췄어요. 장치가 완전히 멈췄는지 확인한 뒤 다시 시도해 주세요.'
    - 폰: safety_stopped 메시지에 '장치가 멈췄는지 확인해 주세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
2026-09-27 fix(app): 서버 가전 재조회 중 선택 유지, 재연결 시 목록·준비 상태 재조회
    - 저장된 선택은 서버 목록이 확정(loaded)됐는데도 없을 때만 잊는다. 조회 중·
    조회 실패는 일시 상태로 보고 유지해 같은 서버를 다시 받으면 고른 가전으로
    돌아간다. 서버 변경 시 로딩 중 선택은 비고 새 목록에 없으면 정리된다.
    - 연결이 끊겼다 돌아오면 성공했던 목록도 다시 받아 can_execute·readiness를
    갱신한다. 이전 세대 응답 폐기는 그대로다.
    - 회귀 테스트 4건 추가(로딩 중 선택 복원, 실패 후 복원, 확정 목록에서 삭제,
    재연결 재조회). 앱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
2026-09-28 feat: 하드웨어 수령 전 SW 준비 — 모션 어댑터·CoreXY 변환·센서 기록기·디지털 트윈·펌웨어 빌드 고정
    - rpi/controller: SerialMotionClient(줄 단위 JSON, 실물 미검증), kinematics(CoreXY 변환, 미실측 값은 거절)
    - PressCommand x_mm/y_mm/press_ms 추가, RPi5→RPi4 execute.targets 계약 추가
    - rpi/verifier/recorder: 판정 없는 원시 센서 기록기
    - /simulator/twin: CoreXY 디지털 트윈(실행 추종·미리보기, 개념 모션)
    - firmware/firmware-node: 플랫폼 고정(코어 3.3.12), IDF 5.5 콜백 수정, secrets.ini 분리, ESP-NOW env 추가
    - devlog 3건, protocol.md 갱신
2026-09-28 fix(rpi): 디지털 트윈 리뷰 반영 — 모션 동기화·CoreXY 벨트·판정 문구·하드웨어 요약
    - 서버 동기화: 대기열이 밀리면 이동·누름 시간을 줄여 따라잡고, 결과가 먼저 와도
    재생 중에는 "모션 재생 중 · 서버 결과 도착"으로 보류. 정지 시 Z 복귀 후 서버의
    마지막 누름 위치로 정렬·고정하고 기록(애니메이션은 결과를 만들지 않음)
    - CoreXY 벨트: 캐리지·갠트리 끝 풀리를 지나는 실제 배치로 매 프레임 다시 그림,
    모터 A/B 아래 모서리 고정, A만/B만 회전 대각선 데모, 갠트리 반투명·버튼 아래
    - 판정·조작: abort 후 성공은 "정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
2026-09-28 feat(rpi): 홈·조그 CLI와 act_main 원시 기록기 배선 (실물 미검증)
    - python -m rpi.tools.jog: status/home/jog/goto/press/stop/reset/raw, REPL과 -c 일괄 실행
    - 어댑터 거절(홈 전·소프트 리밋·설정 미입력)을 그대로 출력, 자동 홈 없음, --log 줄 기록
    - --fake-mcu 리허설: 가짜 MCU를 rpi/tools/fake_mcu.py로 옮겨 시험과 공유
    - SIMPLELAY_RECORDER_PATH로 누름 주변 원시 기록(기본 꺼짐), 합성 입력은 mock_* 표시·경고
    - 하드웨어 도착 첫날 순서를 devlog에 정리
2026-09-28 fix: 본선 준비 결함 4건 — 웹 키오스크 dart:io 분리·배포 base href·무키 LAN 차단·UART 결과 outcome
    - 키오스크: 설정 저장·음성 안내의 dart:io를 *_io/*_web 조건부 import로 분리(웹은 localStorage·speechSynthesis),
    웹 SSE도 같은 오리진 사용, 경계 회귀 테스트 추가. Chromium은 --incognito 대신 전용 프로필
    - deploy_kiosk.ps1: --base-href /kiosk/ 빌드와 복사 전 확인, PowerShell 5.1 파싱용 UTF-8 BOM
    - 인증: SIMPLELAY_API_KEY 미설정 시 루프백만 허용, LAN 개방은 SIMPLELAY_ALLOW_UNAUTHENTICATED=1 명시(기동 경고)
    - UART result에 outcome(success/failed/stopped/safety_stop) 추가, 없으면 succe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
2026-09-28 test(app,kiosk): 9/27~30 화면 변경분 골든 갱신 + 데스크톱 시뮬레이터 실행 항목
    - 노트북에서 폰트 경로 문제로 비교하지 못한 골든(인계 B)을 데스크톱에서 갱신·재비교.
    폰 22장·키오스크 13장: 실행 환경 배너, 제안 카드의 '30분 쉬기·동작 바꾸기', 완료 화면
    모의 표시, 생활 습관·실행 기록 문구. 갱신 이미지는 직접 확인.
    - .claude/launch.json에 `python -m rpi.simulator_main --port 8765` 항목.
    이 기기 검증: 백엔드 1,844 · RPi4 128 · 폰 423 · 키오스크 153 · 공용 패키지 5 통과(골든 제외),
    골든 폰 53·키오스크 32 비교 통과, analyze error·warning 0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
2026-09-29 fix(rpi): ThinQ 목적 경로 카드도 승인 결속 — 생성 시 명령 확정·승인 시 지문 재대조
    패턴·환경·데모 카드가 ThinQ 경로 가전을 가리키면 카드를 만들 때 명령을 확정해
    commands에 싣고, 승인 시 목적을 다시 해석해 지문이 다르면 ApprovalMismatchError(409)로
    실행하지 않는다. execute_purpose/submit_purpose의 ThinQ 분기가 버리던 승인 인자를
    _submit_thinq_purpose가 받아 대조한다. 회귀 테스트 4건(3건 수정 전 실패 확인).
    백엔드 1,848 통과, 모의 클라이언트 기준.
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2026-09-29 feat(app,kiosk): 시연 gap G4·G5 화면 — ThinQ 가전 배지·버튼 격자 숨김, 다단계 실행 단계별 결과
    G5: Appliance.controlPath(기본 physical). 폰 홈·수동 조작·설정 칩, 키오스크 가전 선택에
    ThinQ 배지(시나리오 카드 배지를 RouteBadge로 공용화). ThinQ면 버튼 격자·사진 채우기·BLE 폴백 없음.
    G4: GET /scenarios/last-run을 읽어 끝난 job과 job_id가 같고 2단계 이상일 때만 폰 상태 화면·
    키오스크 완료 화면에 단계별(경로·실행 환경·확인 수준·결과) 목록. 접수 불명은 올리지 않는다.
    회귀 테스트 폰 8건·키오스크 8건(수정 전 실패 확인, 불일치 건은 검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
2026-09-29 fix(firmware-motion,rpi4): 첫날 위험 보완 — 원점 개루프·스톨, 포트 리셋·ready 배너·재연결, 태스크 워치독·정지 유지, 사다리꼴 궤적·PID, 알람 때 Z 후퇴
    - 원점 복귀: 개루프 듀티 프로파일(HOME_DUTY_*), HOME_STALL_MS 스톨 알람, 단계별 거리·시간 예산(static_assert로 HOME_MAX_MS 이하)
    - 호스트 연결: DTR/RTS를 열기 전에 내리고 흐름 제어 끔, 부트 잡음 무시, ready 배너 대기·status backoff 재시도,
    동작 중 ready는 MotionReset. act_main 배경 재연결 + 준비 전 execute는 motion_not_ready 오류 프레임
    - 펌웨어: esp_timer 제어 태스크(CONTROL_HZ) + 정적 뮤텍스, esp_tas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
2026-09-30 fix(app): 안드로이드 빌드 실패 수리 — colors.xml 주석 안 '--'(XML 주석 금지 문자열)를 '—'로
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2026-09-30 fix(app): 허브 주소를 저장해도 "허브에 닿지 않아요"가 남던 결함 — 주소 변경 확인을 서비스 재생성 뒤로 미루고 최신 확인만 상태에 쓴다
    주소 변경 리스너가 check()를 바로 불러, 공급자가 갱신되기 전의 옛 서비스(옛 주소·시작 직후 null)로 핑했고
    그 늦은 실패가 저장 버튼의 성공 결과를 덮었다. 재시도를 눌러야만 "허브 연결됨"으로 바뀌었다(에뮬레이터 확인).
    리스너는 microtask로 미루고, 확인마다 번호를 매겨 최신 확인만 상태를 쓰게 했다. mDNS 조회가 사용자가 바꾼 주소를 덮지 않는다.
    회귀 테스트 hub_address_save_test(수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
2026-10-01 fix(app): 허브 화면이 설정을 읽기 전에 열리면 API 키가 지워지던 결함 — 늦게 올라온 값은 손대지 않은 칸만 채우고, 저장은 고친 칸만
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2026-10-01 fix(연결): 인증 상태와 자동 발견 주소를 구분해요
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2026-10-01 보드 점검 응답 보존과 대상 복구·계정 판정 수정
2026-10-05 fix(deploy): 기기 이미지에 qrcode[pil] 추가 — 짝짓기(pairing)가 import해 없으면 RPi5 백엔드가 기동하지 못한다
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2026-10-05 fix(kiosk): 노트북 UX 변경 검증 — 큰 글씨 잘림·"모름" 라벨 넘침 수리, 바뀐 문구로 테스트 갱신, 골드 강조색 골든
    노트북은 위젯 테스트를 돌리지 못한 채 문구·배치를 바꿨다(6b19c2d·65dfba0·1dbd55c·eb0ada6). 데스크톱에서 실패 9건을 분류했다.
    실제 결함: 연결 아이콘 "모름" 라벨이 두 줄로 넘쳐 42px 넘침(가장자리 48px 안전 여백 테스트도 이것 때문에 실패) → 24px 한 줄.
    큰 글씨(1.22) 평소 화면에서 경고 카드·습도·가전 상태가 잘리고, 보통 크기에서 가전 이름이 "전자레…"로 잘리고,
    큰 글씨 동작 중 화면에서 모의 안내가 스크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
2026-10-05 fix(app): 노트북 UX 변경 검증 — 가전 추가 닫기가 입력 보호를 건너뛰던 결함 수리, 바뀐 문구로 테스트 갱신, 골드 강조색 골든
    노트북은 위젯 테스트를 돌리지 못한 채 문구·화면을 바꿨다. 데스크톱에서 실패 9건을 분류했다.
    실제 결함 1건: 가전 추가 마법사의 닫기 버튼이 context.pop()으로 PopScope를 건너뛰어 입력을 확인 없이 버렸다
    → Navigator.maybePop()으로 입력 보호 대화상자를 거치게 했다(ux_input_test가 그대로 통과).
    테스트 결함 1건: app_shell_test가 데모 모드 저장을 가짜 시계 위에서 기다리다 멈췄다 → 상태를 직접 켜고 개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
2026-10-05 fix(app): 기록 줄의 ThinQ 접수 불명 문장을 자연스럽게 — '경로 ThinQ · 확인 받았는지…' → 'ThinQ · 가전이 받았는지 확인이 필요해요'(받음·확인·실패로 읽히지 않게 유지)
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2026-10-05 fix(app): 모의 ThinQ 기록의 큰 문장을 '모의 상태만 확인했어요(실제 가전 아님)'로, '실기기 실행' → '실제 장치로 실행'(센서·기구 검증으로 읽히지 않게)
2026-10-05 fix(kiosk): '실기기 실행' → '실제 장치로 실행' — 실행 환경 표시가 센서·기구 검증처럼 읽히지 않게
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2026-10-05 fix(outlet,motion): 교차 리뷰 안전 결함 수리 — 비상정지 래치(RPi4·ESP32 재부팅 보존·사람 확인 해제), 콘센트 끊김 감지, 0 W 날조·중복 줄 신선도, 솔레노이드 사전 확인
    Copilot CLI와 별도 검토가 6d18bf5·d41a5fb를 리뷰해 찾은 결함을 고친다(devlog 'outlet-module' 끝 표).
    - H1(재현됨): 콘센트 버튼 비상정지 뒤에도 다음 execute가 갠트리를 움직였다 → RPi4 estop_latched가 execute·verify_pass를
    거절(estop_latched), 정지 대기 해제 대기 중 틈도 막음. RPi5 POST /stop/ack(같은 API 키) → UART estop_ack → 버튼이 풀렸을 때만
    콘센트 estop_reset. /status.estop_latched·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
2026-10-06 fix(rpi,rpi4,outlet,deploy): 재평가 결함 수리 — CT 채널 매핑·릴레이 채널 불일치 기동 거절, 단일 입력 완료 단정 금지, 루틴 중복·정지 취소, 래치 재연결 공지, 배포 장치·의존성, UART 리허설
    Copilot CLI(54/100)·별도 평가(약 61/100)가 찾은 결함을 고친다. 항목별 수정 전 실패 줄은 docs/devlog_2026-10-06-eval-fixes.md.
    - A1/A2: 콘센트를 2개 이상 가전이 쓰는데 SIMPLELAY_OUTLET_CHANNELS가 비거나 빠지면, 릴레이 채널≠전자레인지 채널, 없는 채널 매핑이면
    RPi4 기동 거절(전자레인지 끝이 세탁 알림을 울리던 결함). 가짜 콘센트는 매핑에서 relay_ch를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
2026-10-06 fix(kiosk): /ambient 일시 실패 때 마지막 안내를 10분까지 유지 — 키오스크 242·골든 41
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2026-10-06 fix(kiosk,app): 완료 화면 질문 반복·모의 과장 문구 수리(S11)
    실패널 리허설에서 완료 화면이 루틴 카드의 질문을 되풀이하고, 모의 실행인데
    '버튼 조작을 마쳤어요'·'누름 장치의 응답을 받았어요'로 단정하던 것을 고쳤다.
    폰 기록의 모의 행도 같은 기준으로 맞췄다. 키오스크 1.8.0.
2026-10-06 fix(rpi): 보드 점검 D-Bus 자동 기동 금지 플래그 이름 수리
    dbus_fast의 이름은 NO_AUTOSTART인데 NO_AUTO_START를 써서 RPi5 실행에서 D-Bus 점검이
    전부 미측정이 됐다. 테스트의 가짜 플래그도 같은 틀린 이름이라 가려졌다 — 실제 라이브러리
    이름을 확인하는 테스트를 더했다.
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2026-10-06 fix(kiosk,app): 모의 결과의 가전 동작·상태 확인 문구를 모의로 표시
    모의 실행에서 operation_confirmed=true면 '가전 동작도 확인했어요', state_confirmed면
    '상태 확인됨'으로 보이던 것을 모드를 먼저 보고 '모의 동작 판정 · 실제 가전 아님'·
    '모의 상태 확인'으로 바꿨다(교차 리뷰 HIGH·MEDIUM). 키오스크 1.8.1.
2026-10-06 fix(rpi): UART 링크 끊김 뒤 재연결·래치 재확인, 모의 보관 위치 검증
    RPi4 실행기가 재시작되면 socket:// 시리얼이 끊긴 채 남아 다음 실행이 실패했다.
    끊김을 감지하면 대기 요청을 즉시 실패시키고 래치를 '확인하는 중'으로 되돌린 뒤
    백오프로 다시 열고 hello로 상태를 다시 받은 다음에만 실행을 연다.
    시뮬레이터 보관 위치는 범위·간격을 만족하는 후보를 고르고 없으면 계획을 만들지 않는다.
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2026-10-06 fix(rpi): UART 첫 연결 실패에도 백엔드 기동, 연결 전 실행 거절
    첫 연결도 끊김 뒤 재연결과 같은 백오프로 백그라운드에서 다시 시도한다. 연결 전에는
    '누름 장치 연결 안 됨'으로 실행을 거절하고 /health actuator_ready=false, /status
    actuator_link_up, /connections 누름 장치 항목에 상태를 보인다. 래치는 hello 응답 전까지
    '확인하는 중'으로 둔다.
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2026-10-06 docs: git 이력 발표 자료 제거 완료 기록 — 다른 클론은 reset 필요
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2026-10-06 fix(kiosk): 평소 화면 여백 늘리고 보조 정보 줄임, 비상정지 띠에서 날씨 줄 잘림 수리
    실패널에서 띠가 뜨면 날씨 줄이 반쯤 잘렸다. 오른쪽 열이 필요한 높이를 재서 다 안 들어가면
    날씨 줄을 빼고, 화면 전체를 덜 빽빽하게(여백 28→44, 날씨·알림·가전 글자 축소, 최소 18) 바꿨다.
    고령 사용자 최소 글자(14pt 환산)는 시험으로 고정. 키오스크 1.8.2.
2026-10-06 fix(rpi): 센서 검증을 누름 단위 관측 구간으로 — 첫 실행 기준선·오래된 소리·센서 단절 구분(H1·H2)
    누름 직전 기준선, 누름 중 연속 수집, 누름 뒤 종료를 한 구간으로 묶었다. 기본 설정 첫 버튼이
    기준선이 차지 않아 안전 정지되던 결함, 큐가 차면 새 프레임을 버려 오래된 소리로 판정하던 결함을
    고쳤고, 센서를 읽을 수 없으면 무음·0과 구분해 판정 없이 안전 정지한다. 임계값은 실측 필요.
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2026-10-06 docs,fix(rpi): 심사 평가 수리 — L1 진리표를 실제 동작으로, 센서 위치 통일, README·과장 문구, 끊긴 커밋 해시 교체
    L1은 전류 판정이고 음향은 보조 신뢰도다(기본 가중치에서 음향 단독은 불통과) — 진리표·문서를
    실제 동작으로 맞추고 시험으로 고정했다. 이력 재작성으로 끊긴 문서 속 커밋 해시 239개를
    같은 제목의 새 해시로 바꿨다. UART 리허설 404 상충과 키오스크 버전도 정리했다.
2026-10-06 fix(rpi4,rpi): 실행 대상과 CT 채널 결속, 센서 설정 일관성 검사(H3·M2), L2 운영 경로 미연결 명시(M1)
    실행 명령에 대상 ID를 필수로(execute 프로토콜 2) 넣고, 대상별로 CT 채널·L3·정지 판정을 고른다.
    전자레인지 채널 변화로 세탁기·인터폰 실행이나 정지가 확인되던 결함을 막았다. 매핑 없는 대상에
    real L3면 누르기 전에 거절한다. 센서가 켜졌을 때만 영전류점·ADC 범위 모순을 기동 전에 거절한다
    (값은 실측 필요). L2는 실제 수신 판정 근원이 없어 연결하지 않고 계약·모의 시험까지로 둔다.
2026-10-06 fix(rpi),docs: 장애 복구 결과표와 상황별 모의 시험, 모션 MCU 재부팅 뒤 같은 실행의 자동 원점·재누름 차단(F)
    8가지 장애 상황마다 자동 재전송·재개가 없는지와 무엇이 막히는지 실제 배선으로 시험했다.
    자동 원점이 켜져 있으면 누름 중 MCU 재부팅 뒤 같은 실행이 원점 복귀 후 다시 눌러 성공으로
    끝나던 결함을 고쳤다 — 새 실행이나 명시적 원점 전까지 누름을 거절한다. 실물 정지 지연은 미측정.
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2026-10-06 fix(rpi4,rpi): 교차 리뷰 수리 — 꼬리 설정 오류는 기동 때 거절·결속 예외에도 루프 유지, 옛 RPi4 결과는 동작 확인 모름, 대기 대상 불일치는 거절 응답
    남은 리뷰 항목은 devlog에 후속으로 기록했다.
2026-10-07 fix(app): 서버에만 있는 가전도 홈·루틴에 표시
    폰이 직접 저장한 가전만 목록에 올라 서버로 등록한 전자레인지·세탁기·인터폰이 홈에 안 보였고
    루틴 목록에는 가전 이름 대신 내부 ID가 보였다. 서버 사용자 가전을 표시 전용으로 합쳐 보인다
    (폰 저장·동기화 대기열에는 넣지 않음, 지운 가전은 되살리지 않음).
2026-10-07 fix(app): 홈의 설정 카드를 한 장으로 묶어 가전 목록이 첫 화면에 보이게
    설정이 남은 가전이 둘 이상이면 '설정이 남은 가전 N개' 카드 하나와 '설정 이어하기'로 묶고,
    목록은 아래 시트에서 연다. 위치가 없는 가전은 확인 요청을 보내지 않는다.
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2026-10-07 fix(app): 실행 상태 화면이 루틴 카드의 질문을 되풀이하지 않게
    승인 뒤 상태 화면 부제가 "'아침 데우기' 루틴을 실행할까요?"로 남던 것을 키오스크(15ac5b6)와
    같은 규칙으로 "'아침 데우기' 루틴"처럼 평서형으로 바꿨다(실기기 증거 수집 중 발견).
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2026-10-07 fix(rpi): 전류 관측 스레드의 이전 세대 결과 격리
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2026-10-07 fix(rpi): 모션 통신 오류 뒤 같은 실행 재누름 차단
2026-10-07 fix(rpi): 원점과 XY 이동 뒤 Z 직전으로 관측 시작 제한
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2026-10-08 fix(verifier): 기록기 관측 순서와 센서 표본 검증 보완
2026-10-08 fix(uart): 쓰기 단절 복구와 실행 프로토콜 사전 검사
2026-10-08 fix(deploy): 시연 대상 결속과 센서 의존성 및 검증 문구 정리
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2026-10-08 fix(app): 음성 정지 — 정지 요청 실패를 성공으로 보지 않음, 서버 실행 상태로 듣기, 최종 인식으로만 정지
    정지 HTTP가 실패해도 보낸 것으로 처리해 같은 실행에서 다시 "멈춰"를 무시하던 결함(HIGH),
    키오스크·루틴에서 시작한 실행을 못 보던 결함과 상태 조회 실패 때 듣기가 남던 결함(MEDIUM),
    엔진이 끝나도 "듣는 중"이 남고 부분 인식 "그만"으로 "그만 데워줘" 전에 정지가 나가던 결함(LOW).
2026-10-08 fix(rpi): 응답 기한 초과 뒤 abort 쓰기 실패 시 CancelledError 대신 기한 초과 오류 유지
    wait_for가 이미 취소한 대기 future에서 exception()을 불러 CancelledError가 execute·verify_pass
    밖으로 새던 것을 막았다(평가 1회차 LOW).
2026-10-08 fix(app): 음성 정지 — 침묵 종료를 오류로 세지 않음, 모의 BLE 정지를 성공으로 보지 않음, 실행이 바뀌면 다시 들음
    긴 대기 중 no_match·speech_timeout이 쌓여 마이크가 조용히 닫히던 결함(평가 1회차 MEDIUM),
    모의 BLE에서 아무것도 보내지 않고 성공 처리하던 결함, 음성으로 멈춘 직후 시작한 다음 실행의
    '멈춰'를 무시하던 결함(LOW)을 고쳤다. 실행 식별은 폰 sequenceId → 서버 job_id 순.
2026-10-08 fix(app): 상태 조회 한 번 실패로 이미 음성 정지한 같은 실행에 마이크를 다시 열지 않음
    마지막으로 보낸 정지의 실행 식별을 기억해, 같은 실행이면 정지 표시를 유지한다(평가 2회차 LOW).
    긴 실행 중 인식 세션 재시작 상한이 없는 점은 실기기 시작음·배터리 확인 필요로 기록.
2026-10-08 fix(rpi): 늦게 실패한 옛 링크의 쓰기가 새로 이은 링크를 끊지 않게
    쓰기 시작 때의 writer·reader를 잡아 두고, 그 writer가 아직 현재 링크일 때만 링크를 내린다.
    끊김을 두 번 세거나 재연결 뒤 새 링크의 래치·act_info를 비우던 것을 막았다(평가 2회차 LOW).
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2026-10-12 fix(firmware): CH340 보드 업로드 속도를 115200으로 고정
    고속 업로드에서 'Serial data stream stopped'로 실패하는 보드가 있었다. 팀원 ESP32(D0WD-V3)에
    첫 확인용 빌드를 구워 시작 메시지와 상태 출력을 확인했다(모터 미구동).
2026-10-12 fix(firmware): PWM 채널을 명시해 붙이고 실패하면 hw_init으로 기동 거절
    모터 A·B는 LEDC 채널 0·1, 솔레노이드는 채널 7로 고정했다(Arduino-ESP32 3.x ledcAttachChannel).
    붙이기에 실패하면 움직이지 않고 hw_init으로 멈춘다.
    10/12 실물 첫 시험에서 모터 B가 안 돌던 원인은 이 코드가 아니라 B 제어선 접촉 불량이었다(다시 꽂아 해결).
    두 빌드(esp32dev·esp32dev_bringup) 컴파일 성공, bringup 빌드는 실물 보드에서 기동 확인.
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2026-10-12 feat(app): 개발자 도구 조그를 방향 패드와 이동량 선택(1·2·5mm)으로
    위 y+·아래 y−·왼쪽 x−·오른쪽 x+ 패드, 이동량은 서버 max_jog_mm 이하만 고를 수 있다.
    누를 때마다 한 번만 보낸다(반복 없음). 모의 서버의 Z 조그 줄은 유지.
    시험: 방향 패드가 고른 이동량으로 보내고 상한 넘는 값은 없음(수정 전 코드에서 실패 확인).
    앱 백그라운드 시험은 프레임이 꺼진 상태라 다른 애니메이션에 기대 우연히 통과하던 것을
    강제 프레임으로 고쳤다. 폰 580 통과(골든 제외), analyze error·warning 0.
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2026-10-12 fix(link): RPi5↔RPi4 무선 링크에 TCP keepalive — 죽은 연결을 붙잡아 다시 잇지 못하던 결함
    RPi4 랜선을 뽑고 Wi-Fi로 돌릴 때 백엔드를 재시작하자 RPi4 socat이 죽은 연결을 계속 붙잡아
    새 연결을 받지 못했다(실행기를 재시작해야 붙음). 양쪽에 keepalive(5 s 뒤 2 s × 3 ≈ 11 s)를 켠다.
    - RPi4 run_act.sh: socat TCP-LISTEN에 keepalive → 끝나면 restart 정책이 다시 세운다.
    - RPi5: socket:// 링크면 밑 소켓에 keepalive → 읽기 오류로 기존 재연결 경로를 탄다.
    시험 2+1건(수정 전 코드에서 실패 확인).
2026-10-12 fix(app): 개발자 탭 입구가 '실제로 움직이지 않습니다'로 단정하던 문구 수리
    10/10부터 서버 설정에 따라 실제 장치로 갈 수 있는데 입구는 늘 모의라고 말했다. 입구는 서버 상태를
    모르므로 '모의 또는 실제 장치, 들어가면 표시'로 바꾼다(안쪽 배지는 서버 응답 기준 그대로).
    시험 1건 갱신(수정 전 코드에서 실패 확인), 골든 55 통과, analyze error·warning 0.
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2026-10-13 docs: 10/13 정지 확인 단계 — 수정 전 실패 확인·시험 수·실측 계획 G3 두 구간, 다음 보드 날 함께 배포
2026-10-13 fix(rpi): 가전 목록과 GET /readiness의 준비 판정을 한 함수로 — 끊긴 노드·비상정지 사유 일치
    노드가 끊긴 내장 가전이 /readiness에서 can_execute=true·빈 사유로 나오고, 비상정지 걸림 사유가 빠지던 불일치를 고친다. 실행 경로(_route_to·_require_ready)와 같은 순서로 판정하며 모의·로컬 정상 경로는 그대로 실행된다.
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2026-10-13 docs: 10/13 폰 UI B안 — 수정 전 실패 확인·시험 수·미검증과 남은 일
2026-10-13 fix(dev): 모의 개발자 정지 문구에 '모의 장치에서'를 붙임 — 실물 확인과 구분
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2026-10-13 fix(app): 확인 주행 기록 없음을 '확인 주행 전'으로 단정하지 않고 '확인 주행 기록이 없어요'로
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2026-10-13 fix(app): 확인 주행 응답에 state가 없거나 모르는 값이면 실패가 아니라 모름으로
2026-10-13 fix(app): 설정 카드의 '모의 주행을 확인했어요'는 모의 완료에만 — 실패·진행 중은 타일과 같은 문장
2026-10-13 fix(app): 허브 재연결 때 확인 주행을 다시 묻고, 다시 묻는 동안은 예전 결과 대신 모름으로
2026-10-13 fix(app): 연결 유지 중 걸림·링크가 바뀌면 홈이 가전 준비 판정을 다시 받는다
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2026-10-13 fix(app): 앱을 다시 열면 저장된 주소로 연결 확인을 하지 않아 '허브 확인 중'에 머물던 결함
2026-10-13 fix(app): 실행을 시작한 뒤 '확인'이 처리된 승인 화면('제안을 찾을 수 없어요')으로 돌아가던 결함
    승인 화면에서 실행 상태 화면으로 갈 때 쌓지 않고 바꿔 끼운다(pushReplacement). 확인·닫기는 실행을 시작한 곳(홈·루틴 목록·편집기 — 모두 runRoutineNow)으로 돌아간다. 시험: 홈·루틴 목록 출발 2건, 수정 전 2건 실패.
2026-10-13 fix(app): 실행이 끝난 뒤 기록 탭이 '아직 실행 기록이 없어요'로 남던 결함
    기록 탭은 IndexedStack에 남아 처음 받은 목록을 계속 썼다. 실행이 끝나면(완료·실패·확인 못 함) 그리고 기록 탭에 들어갈 때 기록을 다시 받는다. 허브 연결이 없으면 '기록 없음' 대신 불러오지 못했다고 말한다. 시험 3건, 수정 전 3건 실패.
2026-10-13 fix(app): 승인·실행 상태 화면의 '물리 버튼'·'모의 실행기 응답' 칩을 사람 말로
    기록 문구 규칙과 같은 원칙. 물리 경로는 '버튼을 대신 눌러요'(승인 화면·단계 줄), 실행 상태 결과 칩의 물리 경로는 결과 문장과 겹쳐 뺀다(ThinQ는 유지). 모의 보고는 '연습(모의) 결과', 근거 없음은 '눌렸는지 확인하지 못했어요'(모의면 앞에 연습(모의)). 모의/실제 구분·확인 수준은 그대로, 정지 문구는 건드리지 않음. 새 시험 6건 중 5건 수정 전 실패(ThinQ 칩 유지는 보존 시험), 기존 시험 기대 문구 3곳 갱신.
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2026-10-13 fix: 이전 정지의 늦은 보고가 새 실행에 섞이지 않게 정지를 실행에 결속
    서버는 정지 요청 때 실행 세대·job을 잡아 두고, 보고를 기다리는 사이 새 실행이
    시작됐으면 /status에 남기지 않는다. /stop 응답에 stop_job_id, /status에
    last_stop_job_id를 싣고, RPi4 링크는 정지마다 보고 핸들을 돌려줘 연속 정지가
    서로의 보고를 읽지 않는다. 폰은 정지 요청 때의 실행이 그대로일 때만, 서버가
    같은 job을 멈췄다고 할 때만 정지 단계를 화면에 반영한다(외부 평가 H1).
2026-10-13 fix: 결과가 먼저 오고 정지 확인 단계가 늦게 오면 같은 실행의 화면 문구를 고친다
    폰·키오스크는 정지로 끝난 실행의 단계가 아직 없으면 /status를 1초 간격으로
    최대 3번만 다시 물어, 같은 job의 단계가 오면 결과 문장(키오스크는 정지 줄)만
    고친다. 음성은 다시 말하지 않는다. 폰의 정지 응답이 결과 뒤에 오면 결과 문장을
    덮지 않고 같은 job의 단계만 싣는다. 다른 단말 정지·옛 RPi4(보고 없음)·새 실행
    시작·다른 job의 단계를 시험으로 고정했다. 정지 전송은 이 대기와 무관하다(외부 평가 M1).
2026-10-13 fix: 가전 동작 확인 문구는 L3 판정 출처가 실측일 때만
    실물 모션이어도 RPi4의 L3 입력은 따로 모의일 수 있어(L3_MODE=mock) 폰 실행 상태
    화면·키오스크 완료 화면이 "가전 동작도 확인했어요"라고 말하던 것을 고친다.
    출처 real만 실제 동작 확인(확인 아이콘·색), mock이면 모의 판정, 출처를 모르면
    단정하지 않는다. 키오스크 동작 중 화면의 전력 판정 줄도 같은 규칙. 이 모순을
    기대하던 기존 시험을 고치고 출처(real·mock·모름) × 모션 모드 교차 시험을
    더했다(외부 평가 M5).
2026-10-13 fix(app): 실패한 실행을 '시작하지 못했어요'+다시 시도로 단정하지 않는다
    실패(outcome=failed)만으로는 시작하지 않았는지 알 수 없다 — 접수된 뒤 일부
    버튼을 누르고 실패했을 수 있다. 미전송 근거(receipt=not_dispatched)가 있을
    때만 보내지 못했다고 하고 다시 시도를 권한다. 접수됨·부분 실행·원인 불명은
    기록 화면과 같은 근거 수준("끝까지 실행하지 못했어요. 가전 상태를 확인해 주세요.")
    으로 낮추고 다시 시도를 권하지 않는다. ThinQ도 같은 규칙(외부 평가 M4).
2026-10-13 fix(app): 같은 주소·키로 허브가 꺼졌다 켜지면 연결 상태가 따라온다
    연결 판정이 처음·주소/키 변화·사용자 확인 때만이라 허브 전원이 끊겼다 돌아와도
    '연결됨'에 머물러 확인 주행 조회가 다시 묻지 않았다. 기존 5초 /status 조회
    (비상정지 걸림 조회)의 통신 결과를 연결 상태에 반영한다 — 연속 2번 닿지 않으면
    '닿지 않음', 다시 닿으면 '연결됨'. 허브가 오류 코드로 답한 것은 닿은 것, 키
    거절은 연결 판정에 맡긴다. 새 화면·새 조회 없음. 실제 연결 provider와 가짜
    HTTP로 꺼짐→켜짐→확인 주행 재조회를 시험한다(외부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
2026-10-13 fix(app): 실행 중에는 마이크 권한 창을 띄우지 않는다 — 권한이 있을 때만 음성 정지
    첫 실행 중 음성 '멈춰' 듣기가 엔진을 처음 열면서 OS 마이크 권한 창이 실행·정지
    화면을 가렸다. 팀 결정 전 기본 규칙: 실행 중 '멈춰' 듣기는 마이크 권한이 이미
    있을 때만(묻지 않는 확인) 시작하고, 없으면 이번 실행은 조용히 건너뛴다. 화면
    정지 버튼은 그대로다. 권한 요청은 기존 '말로 조작하기' 마이크 버튼이 한다 —
    거기서 허용하면 다음 실행부터 듣는다. 새 화면·설정 없음. 미허용·거부·허용
    시험(외부 평가 M3).
2026-10-13 fix(app): 실행 상태 화면의 '다시 시도'도 미전송 근거가 있을 때만
    결과 문장(e3001d5)과 같은 규칙으로, 실패한 실행의 아래 버튼·안내가 receipt=
    not_dispatched일 때만 '다시 시도'와 '다시 실행해 주세요'를 낸다. 접수됨·원인
    불명이면 '확인'만 둔다. 안전 정지는 종전대로. 골든 status_failed 장면의 문장을
    새 실패 문장으로 바꿨다(골든 이미지는 데스크톱에서 갱신, 외부 평가 M4 보완).
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2026-10-13 fix(app): 루틴 '단계'와 실행 조작 진행을 다른 말로, 숫자와 단위는 붙여 줄바꿈
    홈·루틴 목록의 "전자레인지 3단계"는 루틴 단계 수이고, 실행 상태 화면의 진행은
    이 실행의 조작 진행(서버 total_steps)이라 같은 '단계'로 부르면 헷갈린다. 실행 화면
    진행을 "조작 N개 중 K개"로 바꾸고, 숫자와 단위 사이에 단어 결합 문자(U+2060)를
    넣어 큰 글씨에서 숫자와 단위가 다른 줄로 떨어지지 않게 했다. 결합 문자가 없으면
    나뉘는 폭이 있음을 TextPainter 시험으로 확인했다(외부 평가 L3).
2026-10-13 fix(app): 멈춤 확인 문장의 ms가 모션 보드 응답 지연임을 밝힌다
    ack_ms는 정지를 보낸 뒤 모션 보드가 응답하기까지(sent→mcu_ack)이지 엔코더로
    멈춤을 확인하기까지가 아니다. "멈춘 것을 확인했어요 (9 ms)"는 9 ms 만에 멈춤을
    확인했다고 읽혀, verified 문장을 "멈춘 것을 확인했어요 (모션 보드 응답 9 ms)"로
    고쳤다. 키오스크의 같은 문장은 이번 허용 범위 밖이라 남은 일로 적는다(외부 평가 L2).
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2026-10-13 fix(app): /stop 응답의 명시적 null stop_job_id를 옛 서버 호환으로 받지 않는다
    새 서버는 실행 중이 아니던 정지에 stop_job_id를 null로 보낸다. StopOutcome에
    필드 존재 여부를 남겨, 필드가 없는 옛 응답만 종전처럼 싣고 새 서버는 같은
    job일 때만 단계를 싣는다. 없음·null·다른 job·같은 job을 실행 중·결과 뒤 두
    경로에서 실제 API 파서와 notifier로 시험한다. protocol.md 문장도 맞춘다.
2026-10-13 fix(rpi4): 연속 abort의 정지 보고를 각자 보낸 MCU 정지에 묶는다
    confirm_stop이 인자 없이 최신 전역 정지 기록을 읽어, 첫 정지를 확인하는 사이
    두 번째 MCU 정지가 나가면 첫 보고에 두 번째 정지의 단계가 실렸다.
    SerialMotionClient는 정지 기록을 id별로 남기고 last_stop_id를 알리며,
    confirm_stop/wait_stop_ack(stop_id=)는 그 정지의 기록만 돌려준다(없으면 대신
    하지 않음). 실행기는 정지 전송 직전·직후 id로 확인 함수를 묶고(run·dev·hold
    drive·dev_motion stop), 새 MCU 정지가 없으면 sent까지만 말한다. 두 abort를
    실제 ActExecutor→SerialMotionClient→FakeMcu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
2026-10-13 fix(app): 허브가 200으로 답한 형식 오류를 통신 단절로 세지 않는다
    주기 /status 조회에서 hold_state 숫자 같은 필드 타입 오류(TypeError)는
    FormatException이 아니어서 실패 두 번이면 '닿지 않음'으로 내려갔다.
    hubStatus는 HTTP 응답을 받은 뒤의 해석 실패를 모두 FormatException으로
    알리고, 주기 조회는 이를 닿은 것으로 센다. 타입 오류·목록 본문 응답을
    여러 번 받아도 연결됨에 머무는 시험을 더했다.
2026-10-13 fix(kiosk): 멈춤 확인 정지 줄의 ms가 모션 보드 응답 지연임을 밝힌다
    ack_ms는 정지를 보낸 뒤 모션 보드 응답까지이지 멈춤 확인까지가 아니다.
    키오스크 verified 문장을 폰과 같은 '멈춘 것을 확인했어요 (모션 보드 응답 n ms)'로,
    ms가 없으면 숫자 없이 둔다. 문장·완료 화면·후속 조회 시험 기대를 고쳤다.
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2026-10-13 test(rpi): 공기청정기 연결 끊김·제어 거절을 SDK 끝-끝으로 정직하게 표시
    모의 클라우드에 제어 거절 장애를 넣고, 닫을 때 열린 keep-alive 연결까지 끊어 실제 끊김과 같게 했다. 끊김은 412 또는 보내기 전 조회 실패(failed/not_dispatched), 거절은 failed/accepted와 이유·코드. 조회 실패 이유 문구에 연결 끊김을 밝힌다.
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2026-10-13 docs: devlog 91개를 docs/devlog/, 옛 인계·폐기 문서·개편 전 캡처 40개를 docs/archive/로 옮기고 poetry.lock 삭제
    삭제가 아니라 보관(git mv, 이름 그대로). 링크 수정은 다음 커밋.
2026-10-13 docs: 옮긴 devlog·보관 문서의 링크·경로 언급을 고치고 문서 링크 시험 추가
    - 상대 링크 300곳·경로 언급 26곳(CLAUDE.md·README·docs·코드 주석·펌웨어 README/ini) 일괄 수정
    - 옮기기 전부터 깨져 있던 링크 1곳(저장소 밖 조사 보고서) 링크를 풀고 저장소 밖 자료로 표기
    - rpi/tests/test_doc_links.py: 추적 중인 md의 상대 링크가 추적 파일을 가리키는지 검사(외부 URL·앵커·코드 제외, 허용 목록 없음)
2026-10-13 docs: 본선 시연 계획 v4와 CT 조리 판정 실측 칸, v3는 보관
    - docs/본선-시연-계획-v4.md: 제안 거절 → 조리 승인·CT 확인 → 공기청정기 + 다음부터 자동으로 → 같은 조건 재실행 → 기록·끄기 → 일부 실패. 실제 성공한 것과 검증 대기 장면을 표로 나눔(장면 단위 실물 성공 0)
    - docs/실측-기록표.md §6: 짧은 가열·가열 중 전력 감소·중간 취소·종료 후 팬 동작, 시작·완료 판정 시각
    - v3를 docs/archive로 옮기고 머리에 v4로 대체 표시, 링크·시험 경로 수정, CLAUDE.md 시연 기준 줄을 v4로
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2026-10-13 fix(rpi4): 멈춤 확인을 '같은 값 두 번 연속'까지 다시 묻고 기한 0.5 s로 — 이동 중 정지가 늘 mcu_ack에 머물던 결함
    10/13 실물(벨트 없이 모터 축, 이동 시작 약 88 ms 뒤 정지 n=10): 정지 응답 뒤 첫 status(+27 ms)와 0.1 s 뒤
    status의 엔코더가 관성으로 1~7카운트 달라 첫 확인이 늘 실패했다(멈춤은 약 0.15 s 안). status를 0.05 s마다
    물어 두 번 연속 같으면 verified, 0.5 s 안에 못 보면 mcu_ack와 이유. 정지→MCU 응답은 중앙 10.6 ms·최대 11.0 ms라
    0.3 s 기한은 유지. 시험 2건(수정 전 실패 확인), 백엔드+rpi4 2,773 통과.
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2026-10-13 fix(rpi): 서버 정지 문장 verified도 '(모션 보드 응답 n ms)' — 'n ms 만에 멈춤'으로 읽히던 것
    10/13 실물: ack_ms 약 11 ms(보낸 뒤 모션 보드 응답), 멈춤 확인은 약 160 ms. 폰·키오스크는 이미 고쳤고
    서버 /dev/stop 문장만 '멈춘 것을 확인했어요 (11 ms)'였다. 시험 1건(수정 전 실패 확인), 백엔드+rpi4 2,774 통과.
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2026-10-13 fix(rpi): 자동 실행 경계 — 판단 뒤 설정이 바뀌면 옛 내용을 보내지 않고 보내기 직전 재검사
    - 실행 게이트에서 규칙이 켜져 있는지만 보던 것을 판단 때 지문과 같은지까지 본다(값 바꾸고 다시 허용해도 옛 명령은 안 나감)
    - ThinQ 단계를 클라우드로 보내기 직전에 한 번 더 확인(dispatch_guard), 걸리면 not_dispatched로 남기고 기록을 '막힘'으로
    - 시험: 허용 실행은 이 사건 1회·같은 사건 재수신 0회(A1), 대기 중 끄기·값 변경·게이트 뒤 끄기(A2), 동시 2회 도착 시 모의 클라우드 제어 1회(A3), 재시작 뒤 같은 사건 재실행 없음(DB 처리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
2026-10-13 fix(rpi): CT 끝 사건을 '조리 완료'로 말하지 않음 — '가열 종료 감지(조리 완료가 아닐 수 있음)'
    - 지금 판정(cycle_end)은 취소·문 열림으로 끝난 가열과 정상 종료를 구분하지 못한다(코드 확인)
    - 카드 근거·시나리오 이름·자동 실행 조건·결과 알림·막힘 이유 문구를 가열 종료 감지 수준으로 낮춤
    - 실측 기록표 §6 C를 C1 취소 버튼·C2 문 열림으로 나누고 구분 근거 칸 추가, v4 시연 계획 표현 기준 추가
2026-10-13 fix: 모션 걸림·재시작·기한 초과·준비 안 됨은 재시도 없이 멈추고 원인을 그대로 보고
    - 폐루프가 모션 알람(stall 등)·MCU 재시작·기한 초과·준비 안 됨·시리얼 끊김을 재시도 오류로 보고 두 번 더 시도하던 것을 즉시 종료로
    - 결과에 실제 시도 수와 원인(abort_reason: motion_alarm: stall 등)을 싣고 RPi4 결과 프레임 → RPi5 /status last_abort_reason·/history abort_reason(종료 사유 motion_aborted, DB 열 추가)
    - 폰·키오스크: '눌림을 확인하지 못해' 대신 '모터가 걸려 멈췄어요. 다시 누르지 않았어요' 계열, 다시 시도 권하지 않음
    - 원점 전·재시작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
2026-10-13 fix: 키오스크가 짧은 실행·정지·다음 실행을 놓치지 않고, 자동 실행 결과를 한 줄로 알림
    - 서버 last_job_id가 바뀌면(폴링 사이에 시작해 끝난 0.45 s 실행·다른 단말 정지) 그 결과를 완료 화면으로 띄움, 켜기 전 결과는 띄우지 않음
    - 실패 완료 화면에서도 /status를 봐서 폰이 시작한 다음 실행과 그 정지를 이어서 보임
    - /status last_auto_run(자동 실행 결과: 대상·설정·값·확인 수준·실행 환경) 추가, 키오스크는 평소·완료 화면 위 한 줄로만 알림(실행·동작 중 화면의 정지 버튼·상태를 가리지 않음)
    - 문장: 상태 재조회 확인 '공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
2026-10-13 fix(rpi4): USB 재열거로 모션 포트를 잃으면 닫고 설정 경로로 다시 열기
    - 쓰기·읽기 EIO·포트 사라짐이면 포트를 닫고 끊김으로 표시(죽은 포트를 붙잡지 않음), 감시 스레드가 설정 경로를 0.5→1→2→4→8초 백오프로 다시 열고 연결 확인
    - 다시 붙기 전에는 준비 안 됨(motion_not_ready·이유)으로 보고, 이번 실행의 자동 재홈·재누름 차단은 그대로
    - SIMPLELAY_MOTION_PORT가 /dev/serial/by-id/ 경로가 아니면 시작 로그에 경고, 런북 §3-4·§5-3에 by-id 사용과 전원 분리 확인 추가
    - 가짜 시리얼(끊기는 포트·재열거 중 열기 실패)로만 시험 — 실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
2026-10-13 fix(app): 큰 글꼴 승인 화면 아래 고정 영역 줄이기, 홈 루틴·제안 카드 접근성 노드와 이름
    - 글꼴 1.5배 이상이면 승인 화면 아래 고정 영역에 실행·다음에(·다음부터도 자동으로)만 두고 안내 줄·30분 쉬기·바꾸기·다시 받지 않기는 본문 끝으로(360×780·2.0에서 고정 영역 35% 미만)
    - 홈 루틴(큰 카드·간결한 행)마다 이름·부제를 제 접근성 노드로 — 세 루틴 글이 한 노드로 묶여 읽히던 것
    - 홈 제안 카드 버튼 접근성 이름에 대상 포함('아침 데우기 실행하기'·'아침 데우기 다음에')
    - 위젯 시험: 360×780 textScaler 2.0 고정 영역 높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
2026-10-13 fix(app): 홈 루틴 줄·가전 타일 상태가 낱말 중간에서 꺾이지 않게('1단 / 계'·'주 / 세요')
    - 같은 낱말 안의 한글 음절·숫자 사이에 단어 결합 문자(U+2060)를 넣는 keepWordsTogether — 숫자와 단위 사이에 쓰던 방식을 낱말 전체로
    - 홈 큰 루틴 카드·간결한 행의 부제, 가전 타일 상태 줄에 적용(접근성 이름은 원문)
    - 시험: 여러 폭에서 '1단계'·'전자레인지'·'주세요'가 갈리지 않음, 홈 렌더 확인. 타일 글을 그대로 찾던 기존 시험 5곳은 결합 문자를 넣은 글로 비교
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2026-10-13 fix(rpi): 자동 실행 재판정을 ThinQ 조회 뒤 전송 직전 경계까지 — 대기 중 끄기·변경·삭제면 보내지 않음(3차 H1)
2026-10-13 fix: 전체 정지가 끼면 진행 중이던 '다음부터 자동으로'가 규칙을 다시 켜지 않음 — 허용 시작 세대를 저장까지, 이번 실행과 자동 허용 실패를 나눠 응답(3차 H2)
2026-10-13 fix: 자동 실행 사건 나이를 이 허브 시계로 옮긴 끝 시각 기준으로 — RPi4 시계 기준점(clock_probe/clock_ref), 근거 없으면 보류, 전송 직전 재확인(3차 M1)
2026-10-13 fix(rpi): 자동 실행 결과에 job을 만들 때의 대상·동작·설정값 사본 — 보낸 뒤 편집·삭제·이름 변경에도 덮지 않음(3차 M2)
2026-10-13 fix(rpi): 기존 /thinq/devices·이벤트·장애 주입 응답도 기기 ID 원문 대신 key·가전 ID(3차 M3)
2026-10-13 fix(rpi): 이력 없이 습관을 단정하지 않음 — 첫 가열 종료 카드는 '공기청정기 풍량을 강으로 바꿀까요?'와 감지 근거만, 승인 기록이 있을 때만 횟수(3차 M4)
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2026-10-13 docs: 시험명·규약을 검사 범위로 좁힘 — 승인 화면 '스크롤 후 가리지 않고 접근', 키오스크 'running을 못 봐도 마지막 결과', /status last_job_id·last_auto_run(마지막 1건·첫 조회 제외·비영속) 규약, 10/14 devlog 수정 전 실패 문장(3차 L3)
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2026-10-13 fix(rpi): 규칙 판정용 메모리 사본과 DB 쓰기를 나눠 정지가 규칙 저장을 기다리지 않음(4차 H-N2)
    규칙 저장소를 불변 사본 교체 방식으로 바꿔 get·list는 잠금 없이 읽고, DB 쓰기는 별도 잠금에서 가장 새 사본을 쓴다. 실행 게이트(서비스 잠금 안)가 다른 요청의 DB 쓰기 대기에 묶이지 않아 /stop의 request_stop이 바로 불린다. 시험: DB 쓰기 대기 중 다시 허용 + 실행 게이트 + 전체 정지 교차에서 request_stop 0.5초 안(수정 전 3초 안에 불리지 않음).
2026-10-13 fix: /stop 응답과 규칙 끄기 영속화를 분리, 폰은 늦은 정지 응답 실패로 확인한 정지 결과를 덮지 않음(4차 M-N3)
    비상정지의 규칙 끄기는 메모리에서 바로 효력, DB 쓰기·알림함 기록은 뒤에서(3회 재시도). 내구성 경계: 규칙 저장 세션 표시(auto_rules_session)가 열린 채 다른 프로세스면 지난 종료가 깨끗하지 않은 것으로 보고 켜진 규칙을 끈 채 시작, 서버 종료는 남은 쓰기를 마친 뒤에만 표시를 닫는다. 폰: 같은 job 결과가 이미 왔으면 /stop 실패가 문장을 덮지 않고, 시간 초과는 '응답을 받지 못했어요(확인 중)'로 미전송과 구분.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
2026-10-13 fix(rpi): 자동 실행 전송 개시와 철회를 공통 전송권으로 직렬화(4차 H-N1)
    최종 재판정은 전송권 확인을 돌려주고, ThinQ controller가 POST 바로 앞(정지 확인과 같은 잠금)에서 부른다. 끄기·값 바꾸기·삭제·비상정지의 규칙 끄기는 같은 메모리 잠금 안에서 메모리를 바꾸므로, 재판정 반환 뒤 끝난 철회는 전송을 막고, 전송 개시 뒤의 철회는 응답 in_flight_notice로 '이미 보낸 명령은 취소되지 않아요'를 알린다. 네트워크 응답까지 잠그지 않는다. 시험(공식 SDK→모의 클라우드): 재판정 반환 → 끄기/값/삭제 응답 완료 → POST 시도면 POS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
2026-10-13 fix(rpi): 시각 기준점에 유효 기간·상대 드리프트 상한·주기 재탐침(4차 M-N1)
    기준점은 SIMPLELAY_EVENT_CLOCK_REF_MAX_AGE_S(기본 600초)까지만 쓰고, 그 안에서는 SIMPLELAY_EVENT_CLOCK_DRIFT_PPM(기본 500ppm, 측정 필요) x 기준점-사건 간격만큼 끝 시각을 이르게(나이를 길게) 옮긴다. 불확실성이 SIMPLELAY_EVENT_CLOCK_MAX_UNCERTAINTY_S(기본 1초)를 넘으면 보류. RPi5는 연결이 유지되는 동안 SIMPLELAY_EVENT_CLOCK_REFRESH_S(기본 60초)마다 다시 탐침하고 끊기면 멈춘다. 시험: 400ppm 빠른 RPi4·120.05초 사건 차단(수정 전 보냄), 700초 유지한 연결 보류 뒤 재탐침하면 보냄,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
2026-10-13 fix(rpi): 허용 전후 판단을 허브 단조 시계 축으로, 재시작 뒤에는 그 전에 끝난 가열 보류(4차 M-N2)
    이 프로세스에서 허용한 규칙은 허용 순간의 허브 단조 시각, DB에서 불러온 허용은 이 프로세스(사건 시계)가 시작한 순간을 경계로 삼아 사건 끝 시각(같은 축)과 비교한다. 벽시계(UTC) 보정·NTP에 흔들리지 않고, 재시작 전에 끝난 가열은 허용 전후를 단정하지 않고 보류. 시험: 허용 뒤 벽시계 +60초(허용 전 사건 차단, 수정 전 보냄)·-60초(허용 뒤 사건 보냄, 수정 전 막음)·재시작 전/뒤 사건. 기존 시험 1건은 허용 시각을 허브 시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
2026-10-13 fix(deploy): by-id 모션·콘센트 포트는 /dev를 잇고 USB 시리얼만 허용 — 재열거 뒤 다시 열기가 컨테이너에서 막히던 결함
    10/14 실물: ESP32 USB를 뽑았다 꽂자(ttyACM0→1) 실행기가 'motion port lost'를 알고 by-id로 다시 열려 했지만,
    --device로 넘긴 장치는 컨테이너를 띄운 순간의 장치 번호(166:0)에 고정돼 'could not open port'가 반복됐다.
    by-id·by-path 경로면 --device 대신 -v /dev:/dev와 --device-cgroup-rule(ttyACM 166·ttyUSB 188)을 준다.
    고친 뒤 실물: 뽑았다 꽂음 → 'motion port reopened' → MCU ready → 'reconnected after port loss(homed=False)',
    실행기 재시작 없음. 시험 1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
2026-10-13 fix(rpi): 날씨 최신 발표가 아직 없으면(03 NO_DATA) 바로 앞 발표로 한 번만 다시 조회 — 자정 무렵 키오스크 날씨가 비던 결함
    10/14 00:03 실물: 23:00 발표를 물었더니 기상청이 03(NO_DATA), 20:00 발표는 정상(1016줄). 발표 뒤 10분 가정이
    늘 맞지 않아 그 시간대에는 예보를 못 받았고, 백엔드를 다시 띄운 뒤라 남은 예보도 없어 키오스크에 날씨가 없었다.
    다른 오류는 다시 묻지 않는다. 시험 2건(대체 1건은 수정 전 실패 확인), 백엔드+rpi4 전체 통과.
2026-10-13 fix(rpi): 날씨 NO_DATA 대체를 앞 발표 최대 3개까지 — 자정 무렵 20:00도 비고 17:00만 있던 실물
    00:03에는 20:00이 있었지만 00:10에는 20:00도 NO_DATA, 17:00만 정상이었다(기상청 응답이 들쭉날쭉).
    한 번 대체로는 부족해 최대 3번(9시간 전 발표까지) 거슬러 묻고, 다른 오류는 다시 묻지 않는다.
    시험 2건(수정 전 실패 확인), 백엔드+rpi4 2,864 통과.
2026-10-13 fix(kiosk): 냉정 평가(56점) 수리 — 시스템어·모의 표기·정지 ms 제거, 정지·걸림 뒤 확인 칩 숨김, 사용자 정지는 중립색·닫기, 설정은 회색 아이콘
    - '물리 버튼'·'모의 실행기 응답'·'확인 근거 없음'·'실행 환경 미확인'·'실제 장치로 실행' 제거, 연습이면 '연습 모드'만
    - 정지 줄 '멈춘 것을 확인했어요'(ms는 화면에서 뺌), mcu_ack '정지 신호가 전달됐어요' — 세 단계 판정은 그대로
    - 사용자 정지·모터 걸림 뒤 '눌렸는지 확인 못 했어요' 칩 숨김, 보내지 않은 단계는 '누르지 않음'
    - 사용자 정지: 손바닥·회색, 주버튼 닫기, 반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
2026-10-13 fix(rpi): 냉정 평가 수리 — 키오스크 한 줄이 '보냈지만 확인 못 함'을 '끝까지 되지 않았어요'로 단정하던 것, 자동 실행 규칙 문장 짧게·원시값 노출 없음
    - ambient: unconfirmed는 '○○가 바뀌었는지 확인하지 못했어요', 실패·안전 정지는 '○○ 작업이 멈췄어요 · 기계를 봐 주세요',
    사용자 정지는 줄 없음, '확인이 필요해요.' 앞머리 삭제(outcome_of 의미는 그대로)
    - auto_rules: 조건 '전자레인지가 멈추면', 동작 '공기청정기 풍량 강으로', 대상 없을 때 원시 action 대신 사람 말,
    꺼짐 사유 짧게. 지문·안전 판정은 손대지 않음(단서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
2026-10-13 fix(app): 냉정 평가 수리 — 내가 실행한 루틴은 '실행 확인'(근거·쉬기·다시 받지 않기 숨김), 정지·걸림 뒤 확인 칩 숨김, 모의 표기 한 번, 홈 소음·중복 정리
    - 승인 화면: 안심 문장 2개·'버튼을 대신 눌러요' 칩 삭제, '승인하면 할 일' → '누를 버튼'
    - 정지·모터 걸림 뒤 '눌렸는지 확인하지 못했어요' 칩 숨김, 보내지 않은 단계 '누르지 않음'
    - 누름 장치 목록은 설정에서 개발자 탭으로(타일·상세·설정 상태 모순 해소), 준비된 타일 상태 줄 비움
    - 기록: 연습 표기 한 줄, 질문형 제목을 평서문으로, 모의 다음 행동 줄 삭제
    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
2026-10-13 fix: 수리 뒤 실물 캡처에서 남은 두 곳 — 대상 없는 규칙에 'air_purifier'가 보이던 것·옛 긴 꺼짐 사유, 연습 기록의 '명령을 보냈어요' 설명 줄
    - 서버: 대상 가전이 없으면 종류 이름(공기청정기), 10/14 전에 저장된 꺼짐 사유는 보여 줄 때 지금 짧은 문장으로(저장값 그대로)
    - 폰: 연습(모의) 기록은 '연습 · 가전에 보내지 않았어요' 한 줄만, 서버 설명 줄을 겹치지 않음
    시험: 수정 전 실패 확인(서버 1·폰 1), 백엔드+rpi4 2,868, 폰 786(골든 제외), 골든 55, analyze error·warning 0.
2026-10-14 fix(kiosk): 승인 카드 '경로 확인 필요' 회귀 수리 — 버튼 누름엔 칩 없이, 정말 모르는 경로만 경고
    10/14 재평가: 'physical' 칩을 지우면서 routeLabel이 null이 되자 모든 버튼 단계에 '경로 확인 필요'가 붙었다.
    버튼 누름은 칩 없이, 모르는 경로는 경고 유지. 사용자가 직접 실행한 루틴은 근거 줄을 숨기고 자동 제안은
    그대로 보인다(폰과 같은 기준), 목록 제목은 버튼만이면 '누를 버튼' 아니면 '할 일'.
    완료 문구는 확신 수준을 올리지 않음: '끝났다는 보고를 받았어요'(모름), '누름 장치가 다 눌렀다고 알려 왔어요'(실제 보고).
    시험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
2026-10-14 fix(app): 사용자 정지 문장에서 ms 제거(개발자 도구만 유지), 실제/연습 모름은 일반 화면 띠 생략·기록에는 한 줄 유지
    - 정지: '멈춘 것을 확인했어요' / '정지 신호가 전달됐어요'(키오스크와 같음). ms·'모션 보드'는 detail=true(개발자 도구)만
    - '실행 환경 미확인' 띠는 실행 상태 화면에서 생략하되, 기록·단계 결과에는 '실제 기기 동작 여부를 확인하지 못했어요'
    를 남겨 실제 성공처럼 보이지 않게(F4 경계). 연습 표시는 그대로
    - 옛 계약(모름이면 줄 없음)을 고정하던 시험은 새 계약으로 수정
    시험: 수정 전 실패 확인(정지 문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
2026-10-14 fix(rpi): ThinQ 이미 목표값이면 보내지 않음 — 결과를 확인한 사실만큼 네 경우로
    - 보내기 전 조회에서 이미 목표값: 제어 요청 0회, succeeded·not_dispatched·already_at_target,
    "이미 강풍으로 설정돼 있어요. 변경 명령을 보내지 않았어요."
    - 보내기 전 다른 값 → 재조회 목표값: state_confirmed, "강풍으로 바꿨어요."
    - 보내기 전 조회 실패·값 없음 → 최대 1회 전송, 재조회 목표값: state_confirmed_unknown_before,
    "강풍으로 설정된 것을 확인했어요."('바꿨어요' 금지). 원격 제어 확인이 필요한 세탁기는 종전대로 보내지 않음
    - 보낸 뒤 확인 실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
2026-10-14 fix(app): ThinQ 결과 문장을 확인한 사실만큼 — 이미 목표값은 성공·변경 명령 보내지 않음
    - 실행 상태: 서버 문장 그대로("이미 강풍으로 설정돼 있어요. 변경 명령을 보내지 않았어요." /
    "강풍으로 바꿨어요." / "강풍으로 설정된 것을 확인했어요."), 모의는 '모의 · … 실제 가전은 조작하지 않았어요.'
    - 확인 칩: '이미 그 설정이라 보내지 않음'·'설정된 것 확인됨'(모의는 '모의 · …')
    - 기록: 이미 목표값을 '보내지 않았어요·연결 확인'으로 말하지 않음, 미확인은 '설정이 바뀌었는지 확인하지 못했어요'
    - 같은 문장을 결과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
2026-10-14 fix(kiosk): 자동 실행 한 줄·완료 화면이 이미 목표값을 실패·미확인·변경으로 말하지 않게
    - 자동 실행 한 줄: "공기청정기는 이미 강풍으로 설정돼 있어요. 변경 명령을 보내지 않았어요",
    전 값 모름은 "…강풍으로 설정된 것을 확인했어요", 바꿈은 "공기청정기를 강풍으로 바꿨어요"(서버 value_phrase,
    옛 서버는 종전 문장), 연습은 ' · 연습 모드' 유지
    - 완료 화면: 이미 목표값은 '이미 그 설정이에요'+서버 문장, 실제 실행의 작은 글자는 확인한 사실만큼
    - 확인 칩·음성 안내 폰과 같은 규칙. 새 화면 없음
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2026-10-14 fix(thinq): 사전 상태 조회를 클라우드가 코드로 거절하면 값 모름이어도 보내지 않음 — 끊김·해석 실패만 1회 전송
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2026-10-14 fix(app): 제안 확인 아래 고정 영역은 실행·다음에만 — 쉬기·동작 바꾸기·다시 받지 않기는 '더 보기', 버튼 배치는 펼치기
    대상·누를 순서·막힌 이유·모의 표시는 그대로 보이고, 자동 실행 카드의 세 갈래(이번만 실행·다음부터도 자동으로·안 할래요)는
    고정 영역에 남는다. 골든 5장 갱신(suggestion·suggestion_large·suggestion_long·suggestion_long_large·lt_suggestion).
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2026-10-14 fix(kiosk): 결과 화면의 큰 체크는 상태 재조회·실측 동작 확인일 때만, 제안 화면은 질문·선택 버튼을 가장 크게
    보고만 받음·실행 환경 모름·연습 성공은 중립 아이콘(i)과 흰 글자로 — 문장이 '확인하지 못했어요'인데 초록 체크가
    성공을 단정하던 것을 고친다. 제안 화면은 선택 버튼 26pt·최소 72, 버튼 순서·할 일 20pt, 근거는 두 줄까지.
    골든 9장 갱신.
2026-10-14 fix(app): 루틴 탭 '추천'을 '예시 루틴'으로 — 미리 만든 템플릿을 개인 습관 추천처럼 부르지 않는다
    빈 목록 문장과 템플릿 행 낭독('예시 루틴 · 이름. 고쳐서 저장하면 내 루틴이 돼요')도 같은 이름으로. 골든 변화 없음.
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2026-10-14 docs: 비교 과업 조건표·【기입】 일정표, 도구 사용 고지 역할 구분, 상용품 공개 사양 근거
    - 제출 전 검증 과업 §1: 조건별 반복 수·성공 기준·오류 검출 기준 표, 정답은 영상·관찰 기록의 사람 판정, 문 열림을 시작 전(C3a)·가열 중(C3b)으로 분리
    - 조건 ②는 RPi4 env(L3 off·가열 종료 감지 끔)만 바꾸고 비상정지·걸림·이동 한계는 유지됨을 코드로 확인해 절차로 적음(코드 수정 없음)
    - §5 서류 【기입】 칸 K1~K11과 닫을 과업·담당·목표일
    - 도구 사용 고지 초안: 커밋 표기 정책과 별개, 배포·측정의 도구 실행/사람 관찰·판정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
2026-10-14 fix(kiosk): 제안 근거를 두 줄로 줄여도 '조리 완료가 아닐 수 있어요'는 늘 보이는 줄로, 긴 근거는 펼쳐 읽기, 낭독은 전체 근거
2026-10-14 fix(app): 승인 화면 '더 보기' 낭독 이름을 '제안 옵션 더 보기'로, 목록을 고르지 않고 닫으면 초점을 그 버튼으로 되돌림
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2026-10-14 fix(rpi): 링크 키 필수 — 키가 없으면 RPi4 실행기·RPi5 백엔드(uart)가 링크를 열기 전에 시작 거절, 무인증은 SIMPLELAY_LINK_AUTH=off_for_mock 명시 모의 구성에서만(모션 serial·실물 콘센트·L3 real·실센서·개발자 실물 조작과 함께면 거절), 기존 무인증 시험은 명시 모의로 분리
2026-10-14 fix(rpi): 루프백 인증 면제에 출처 확인 — 설정된 키오스크 주소(SIMPLELAY_KIOSK_ORIGINS) 기준, 요청 Host로 허용 출처를 만들지 않음, Origin: null·다른 사이트 Origin·Sec-Fetch-Site cross-site/same-site는 403(제어 호출 0회), 헤더 없는 로컬 프로세스(네이티브 키오스크·진단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
2026-10-14 fix: 공개 /health는 생존·버전만 — 준비 상태·잠시 쉬기·조용한 시간은 인증 경로 /health/detail로 옮기고 폰·키오스크 사용처도 이전, 받지 못하면 준비됨·꺼짐으로 보지 않음(키오스크는 조용한 시간 '모름'이면 일반 안내 소리를 쉼, 폰 잠시 쉬기는 마지막 값 유지)
2026-10-14 fix(deploy): RPi4 링크 포트 선점 완화 — SIMPLELAY_LINK_ALLOW_FROM(RPi5 IPv4)을 두면 socat이 그 주소의 연결만 받음(range=/32), 비우면 종전과 같음, IPv4가 아니면 컨테이너를 세우지 않음(실기기 미검증)
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2026-10-14 fix(rpi): 루틴 초안 — 잠시 쉬기·매일 조용한 시간 모두 루틴 탭을 직접 열면 기존 초안이 보이고 저장됨(팝업·소리·전환 없음), 새 초안은 쉬는 동안 만들지 않음(한 번 내놓은 초안 기록을 DB에 영속)
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2026-10-14 fix(deploy): 업데이트 전 서버의 잠시 쉬기 끝 시각이 UTC 'Z' 꼴이면 이어받지 못하던 것 — 추출 패턴에 Z 허용
    보드의 업데이트 전 서버(568f995)에 잠시 쉬기를 켜고 공개 /health를 읽으니 '...T11:13:36.620005Z' 꼴이었다.
    추출 패턴에 Z가 없어 기기에서는 늘 '확인하지 못함 — 재설정 필요'가 됐을 것이다.
    시험: 배포 스크립트 Z 꼴(수정 전 실패), 서버가 Z 꼴을 옛 범위로 이어받음(고정 — 서버는 원래 받았다).
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2026-10-14 fix(rpi): 설정 저장이 DB에서 멈춘 동안 정지가 막히던 것 — 판정 사본과 영속 쓰기 분리, 이벤트 루프의 동기 DB 입출력 제거, 저장 실패를 응답으로 구분
    - 조용한 시간·잠시 쉬기: 불변 사본을 잠금 없이 읽고, 바꾸기는 메모리에 먼저 적용한 뒤 저장 잠금에서 가장 새 값을 쓴다(SnapshotSetting). 시작 게이트·전송권 확인이 DB 대기를 가진 잠금을 기다리지 않는다(H-R1)
    - POST·DELETE /dnd·PUT /quiet-hours: 메모리 적용은 바로, 저장은 이벤트 루프 밖. 응답에 persisted(true/false/null)·session_only(M-R1)
    - 동기 DB·네트워크 입출력을 하던 async 라우터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
2026-10-14 fix(app,kiosk): 잠시 쉬기·조용한 시간 저장 실패(persisted=false)면 '지금만 적용'을 알린다
    - 문장: 저장하지 못해 지금만 적용돼요. 허브를 다시 켜면 이전 설정으로 돌아가요.
    - 폰: 잠시 쉬기 시트(켜기·해제)·홈 해제·조용한 시간 줄. 키오스크: 방해 금지 창
    - true·null·필드 없음(옛 서버)은 알리지 않는다. 시험 폰 +6·키오스크 +6
2026-10-14 docs: 10/14 HIGH 재확인 수리 기록 — 정지 진입 지연(개발 PC)·동기 입출력 라우터 전수 점검표·저장 결과 계약(persisted·session_only)·재시작 정책, eval4-fix '잠금 안은 메모리 판정뿐' 범위 주석, 인계 §8-13
2026-10-14 fix(rpi): 공유 스레드 풀 고갈·저장소 잠금 대기가 정지를 막던 것, 동시 변경이 지운 루틴을 되살리던 것, 설정 응답의 판 어긋남
    - 정지 전용 실행 줄(stop_lane): /stop·/dev/stop의 인증·서비스 의존성을 async로, 정지 작업은 전용 실행기에서 — AnyIO 기본 토큰·asyncio 기본 실행기가 DB 대기로 차도 줄을 서지 않는다
    - 가전 목록·보호자 알림·루틴 저장소: 읽기를 DB 쓰기 잠금에서 분리(DB 먼저 규칙·판 번호 검사 유지) — ThinQ 상태·목록, 키오스크 /ambient, 초안 저장이 이벤트 루프에서 기다리지 않는다
    - 루틴 켜기는 최신 루틴의 enabled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
2026-10-14 fix(rpi): 재시작 직후 최초 초기화가 이벤트 루프를 막아 정지가 들어오지 못하던 것
    - 제안 갱신·안부 루프: 서비스 최초 생성까지 스레드 안에서(to_thread 인자로 부르면 루프에서 만들어졌다)
    - async 라우터(루틴 실행 기록·트리거 기록·지금 실행·시나리오·조용한 시간·자동 허용)의 첫 생성을 build_off_loop로 — 이미 있으면 메모리 확인뿐
    - 실행·제안 서비스·DB 싱글턴: 겹친 최초 생성을 하나로(_built_once, lru_cache와 같은 cache_clear·cache_info)
    - 확인 주행 실행기 생성도 lambda 안으로
    - 시험 11개: 제안 서비스 캐시가 빈 채 첫 요청 8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
2026-10-15 fix(rpi): 비상정지 걸림이면 ThinQ 직접·승인 명령도 보내지 않음, RPi5 배포에 ThinQ SDK·PAT·클라이언트 ID
    외부 검토 H1·H2. 받을 때 412, 보내기 직전 not_dispatched(전원 끄기 예외 없음). 이미지에 thinqconnect 1.0.14, run_backend.sh가 데이터 폴더 thinq/의 PAT·클라이언트 ID 경로를 넘긴다. 실물: 이미 목표값 0회 전송, 꺼짐 상태 풍량 변경은 클라우드 거절(2304). 백엔드 3,178 통과.
2026-10-15 fix(app): ThinQ 검토 반영 — 결과 모름 문구·요청 중 잠금·전원 꺼짐 표시·연결 상태 구분
    - 상태 카드: 시간 초과·연결 오류는 '보내지 못했어요' 대신 결과 모름 + 다시 읽기,
    요청 중 칩 잠금, 409·412·422·423은 허브 이유 그대로
    - 전원 꺼짐이면 켜기만 두고 풍량·운전 모드 줄을 숨김(자동으로 켜지 않음), 미세먼지 없음 이유 한 줄
    - 읽은 시각 'HH:MM 업데이트', 칩·시각 읽는 이름(풍량 자동·운전 모드 자동 등)
    - LG ThinQ 연결: 확인 중·확인 실패·ThinQ 꺼짐(404)을 구분, thinqOverview는 404만 null
    - 찾은 가전 안내·오늘 사용(ThinQ 직접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
2026-10-15 docs: UI 동결 해제(10/15 사용자 결정) — 사용자 편의 화면·문구 수정 허용
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2026-10-15 fix(rpi4): 재부팅 걸림 뒤 비상 버튼이 이어지면 해제 확인이 콘센트 전원을 다시 켜던 것(B11)
    콘센트 모듈 재부팅으로 power_lost가 선 뒤 비상 버튼(estop 이벤트·status 보고)이 이어지면
    power_lost가 남아 해제 확인 때 릴레이를 다시 켰다. 비상 버튼 걸림에서 power_lost·relay_expected_on을
    지우고, 실행기는 재부팅 걸림 위의 모듈 보고를 새 비상 버튼 걸림으로 바꿔 '다시 켜져' 문장을 남기지 않는다.
    재현 시험 2건은 수정 전 코드에서 실패(릴레이 켜짐·원인 그대로), 재부팅 단독 복구 회귀 시험 1건 추가.
2026-10-15 fix(rpi): 키오스크·폰이 그대로 보이는 서버·RPi4 문장을 용어표로 통일(§6)
    허브→SimpleLay 본체, 누름 장치→작은 팔(장치), 콘센트 모듈·플러그→가전 콘센트 장치, 비상정지가 걸려 있어요→
    비상 버튼이 눌려 있어요, 보관 위치→제자리, 버튼 좌표→버튼 자리, 실행기·이쪽 센서 같은 내부 말 제거, 주어(작은 팔/가전) 명시.
    습관 제안 근거는 '{시간대}에 자주 하셔서 여쭤봐요 · 최근 N일 중 D일 사용'. 판정·코드 값·필드는 그대로이고
    재부팅 걸림 문장의 '다시 켜져' 표시는 유지. 기존 시험 기대 문구 갱신 + 용어 고정 시험 8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
2026-10-15 fix(kiosk): 결과·정지 대기·비상 버튼 화면 문구 — 확인한 만큼만, 주어는 작은 팔, 할 일 한 가지
    키오스크 문구 개선 계획 1단계(§2-1~2-3, B2·B7·B9).
    - 완료: 성공 제목은 확인 수준만큼('버튼을 다 눌렀어요' · 실행 환경 모름은 '작은 팔이 다 눌렀다고 알려 왔어요'),
    바로 아래 '가전이 움직이는지는 직접 봐 주세요'. 전력 확인이면 '{가전}의 전력 사용이 늘었어요. 원하는 동작인지는 직접 봐 주세요'.
    실패 가장 큰 글자 '가전을 먼저 봐 주세요', 단추 '처음 화면으로'(채움)·'다시 시도'(테두리)·'화면으로 조작하기'(글자).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
2026-10-15 fix(kiosk): 실행·연습 화면 문구 — 지금 몇 번째 버튼인지, 숫자 대신 무엇을 보는지
    키오스크 문구 개선 계획 2단계(§3-1·§3-2, B1).
    - B1: '총 2단계 중 0단계'(끝낸 수를 썼다) → '누를 버튼 2개 중 1번째'(지금 번호 = 끝낸 수 + 1), 끝나면 'N개 모두 눌렀어요'.
    스크린리더 문장도 같은 번호. 단계 수를 모르면 '버튼 N개를 눌렀어요'.
    - 상태 구절: '눌림 확인 중' → '제대로 눌렸는지 확인하는 중', '보정 후 다시 시도 중' → '자리를 맞춰 다시 누르는 중'
    · '눌렸는지 확인되지 않아 한 번 더 눌러요'(안전하다고 말하지 않는다 — 열린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
2026-10-15 fix(kiosk): 쉬운 말 — SimpleLay 본체·제안 잠시 쉬기·다시 확인하기, 루틴은 버튼 수, 잘림 고침
    키오스크 문구 개선 계획 3단계(§1 용어표·§4, B3·B4·B5·B8·B10).
    - 허브 → SimpleLay 본체(연결 창에 한 번 풀어 씀: '부엌에 둔, 이 화면이 달린 상자'), 누름 장치 → 작은 팔 장치,
    플러그 → 가전 콘센트 장치. 연결 창 단추 '다시 연결하기' → '다시 확인하기'(재연결 명령이 아니다).
    - B4: 연결 창 글자 33 → 24, 화면 높이 안에서 스크롤하고 막대가 보인다.
    - 방해 금지 → 제안 잠시 쉬기(창 제목, 범위 줄은 늘), 해제 → '다시 제안 받기',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
2026-10-15 fix(app): 결과·정지 문장은 확인한 만큼, '연습'으로 통일, 키오스크 이름과 이어 주기(안 A)
    키오스크 문구 개선 계획 §8 안 A — 폰은 이름 바꾸기 없이 결과·정지 문장(원칙 0-1~3)과 '연습/모의'만 맞춘다.
    - 정지 결과: '실행을 멈췄어요. …'를 앞에 붙이지 않는다(보냄에서도 멈춘 것처럼 읽혔다).
    verified '누름 장치가 멈췄어요 + 이미 켜졌다면 정지·취소 버튼을 직접', mcu_ack '정지 신호를 받았어요 — 멈췄는지는 확인 못 했어요',
    sent '멈추라고 보냈어요 — 멈췄는지 아직 몰라요', 단계 모름 '정지 요청으로 실행이 끝났어요'.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
2026-10-15 fix(deploy): 보드 이미지 빌드 스크립트에도 ThinQ SDK 고정 버전 — Dockerfile만 고쳐 실제 보드 이미지에 빠지던 것
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2026-10-15 test(rpi): 모든 HTTP 경로의 API 키 검사 누락을 막는 인증 범위 시험
    rpi.main.app의 경로 전체를 펼쳐 의존성 나무에 require_api_key가 없는 경로를
    허용 목록(/health·/ui·/kiosk 안내·/twin 화면 파일·/pair 연결 창) 밖에서 찾으면 실패한다.
    허용 목록의 연결 창 열기·승인은 _local_screen이 걸려 있는지도 본다.
    펼치기가 판 변경으로 깨져 0개를 검사하지 않도록 OpenAPI 동작 전부·보호 경로 하한(100)을 함께 본다.
    수정 전 실패 확인: 실제 앱에 키 검사 없는 라우터를 붙이면 'POST /dummy/run: require_api_key 없음'으로 실패.
    프레임워크 문서 경로(/docs·/r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
2026-10-15 fix(rpi): 접수 뒤·보내기 전 정지가 사라지던 문제(G2) — 보내기 직전 정지 확인, RPi4 실행 표지 결속
    - RPi5 _run_buttons가 실행 대상에 넘기기 직전 이번 실행의 정지 기록을 본다. 있으면 보내지 않고
    stopped·수신 not_dispatched로 이력·보호자 알림·완료 이벤트를 남긴다(stopped_before_dispatch).
    - ActClientController: reset_stop(실행 시작)·request_stop이 정지 표시를 관리하고, execute가 이벤트 루프 안에서
    줄을 쓰기 직전에 다시 본다 — 확인 뒤·줄 쓰기 전에 온 정지도 보내지 않는다.
    - 이중 방어(하위 호환): 실행 표지 run_ref를 abort·execute에 싣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
2026-10-15 fix(rpi): 승인·루틴·시나리오 물리 단계의 링크 끊김이 결과 없이 끝나던 문제(G1) — '눌렸는지 모름'으로 기록
    - _run_physical_step이 실행 대상 예외(링크 끊김·응답 없음)를 잡아 수신 unknown·확인 없음·unconfirmed 결과를 만든다.
    이력·보호자 알림·완료 이벤트를 남기고 /status의 last_*를 이 job의 것으로 바꾼다. 남은 단계는 보내지 않고
    자동으로 다시 누르지 않는다.
    - 직접 경로(G5 문구): 동작은 그대로, '완료하지 못했어요'·재시도 소진 대신 같은 '미확인' 분류·문장으로 남긴다
    (_record_unconfirmed_physical 공용).
    - /status·SSE: 물리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
2026-10-15 fix(rpi): G2 보내기 전 정지 표시를 실행 표지(run_ref)에 묶음 — 실행 시작 없이 쓰는 링크에서 정지가 다음 실행을 막던 문제
    01590aa의 정지 표시는 reset_stop(서비스 실행 시작)이 지울 때까지 남아, 서비스를 거치지 않고 링크를 직접 쓰는 곳
    (시뮬레이터 직접 호출)에서 정지 뒤 다음 실행을 '보내지 않음'으로 끝냈다(전체 시험 test_simulator_controller 1건).
    정지 표시를 그 실행의 표지에 묶는다 — 쉬는 중 정지는 옛 표지라 다음 실행을 막지 않고, 표지가 없는 호출은 종전 그대로.
    서비스 경로의 동작(접수 뒤·보내기 전 정지는 보내지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
2026-10-15 fix(rpi): 엔코더가 죽어도 '멈춤 확인(verified)'이 뜨던 문제(G11) — 이번 실행에 엔코더가 바뀐 것을 본 경우에만
    - SerialMotionClient가 위치 보고마다 축별로 기준값에서 바뀌었는지(엔코더 생존 근거)를 모으고, move 명령으로 이번 실행에
    움직여야 했던 축을 기록한다. 정지 뒤 같은 값 두 번이어도 움직여야 했던 축마다 근거가 있어야 verified, 아니면 mcu_ack와
    "엔코더 움직임을 확인할 수 없어 멈춤은 확인하지 못했어요".
    - 근거는 reset_stop(새 실행·개발자 조작)마다 새로 센다. 원점 복귀·MCU 재시작·포트 잃음의 카운트 초기화는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
2026-10-15 feat: 꺼진 공기청정기 + 공기 나쁨 → '공기청정기를 켤까요?' 제안(전원만) — ThinQ 앱 공기질 센서 '항상' 설정이면 꺼져도 값이 와서 판독, 폰 카드 꺼짐 안내 수정, 모의·가짜 클라우드 센서 '항상' 선택, 절차서·환경변수·devlog 갱신
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2026-10-16 fix(rpi,app): 안전 빈칸 G3·G7 — 루틴 구간 사이 정지가 다음 구간으로 이어지지 않게(/stop 루틴 먼저·대기 뒤 재확인·구간 시작 관문), 정지어('멈춰'·'그만'·'정지')는 버튼 누름 대신 정지(서버 /execute·폰 홈 음성)
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2026-10-16 fix(rpi,rpi4): 안전 빈칸 G5 — 실행 중 RPi5→RPi4 생존 신호, 끊기면 RPi4가 스스로 정지(motion_link_lost), RPi5는 '눌렸는지 확인하지 못했어요'(미확인)로 기록, 재접속 뒤 보호자 알림
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2026-10-16 fix(rpi,rpi4): 안전 빈칸 G4·G9 — 잠금 대기 뒤 정지면 쓰기 직전 재확인으로 전송 0회, 정지 대기 해제 대기가 abort 수신을 막지 않게 / G10 정지 의미 차이 문서·회귀 시험 고정 / 솔레노이드 안전 전달표, 런북·시연 v4·제출 체크리스트 정합
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2026-10-16 fix(rpi,rpi4): R1 같은 버튼 두 번 누름 — 토글·미상 버튼은 '확인 안 됨'일 때 자동 재누름(L1·L2) 없이 미확인으로 남기고, 시간 버튼 등 명시한 버튼만 재시도 유지(버튼 성질을 RPi4까지 전달) / 제출 초안 현행화 — Codex 작업이 사용 한도로 최종 보고 전 중단, 전체 시험은 통과(검토 남음)
2026-10-16 fix(rpi): 등록만 하고 아직 안 쓴 노드가 있으면 모터 정지가 노드 컨트롤러 생성을 기다리던 것 — request_stop을 노드 목록보다 먼저
    노드 레지스트리는 처음 쓰는 노드의 컨트롤러(HTTP 클라이언트)를 get()에서 만든다. 정지 경로가 서비스 잠금 안에서
    노드 목록을 모은 뒤 모터 request_stop을 불러, 그 생성 시간(데스크톱 약 230 ms, 시험에서 0.4 s 흉내)만큼 정지가 늦었다.
    같은 잠금 안에서 모터 정지를 먼저 부르고 노드 목록은 그 뒤에 모은다 — 노드에도 정지는 그대로 간다.
    시험: 수정 전 실패(675 ms) → 수정 뒤 0.02 ms, 노드 등록 중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
2026-10-16 fix(deploy): 백엔드 컨테이너가 UTC로 돌아 루틴 시각·조용한 시간이 9시간 늦게 맞던 것 — 호스트 시간대를 TZ로 넘김
    보드에서 '금 19:35' 루틴을 만들었는데 19:35에 카드가 뜨지 않았다 — 컨테이너 시각이 10:35(UTC)였다. 시험은 시계를
    고정해 이 차이를 보지 못했다. run_backend.sh가 호스트 /etc/localtime의 지역 이름(못 읽으면 Asia/Seoul)을 -e TZ로 넘기고,
    env 파일에 TZ= 줄이 있으면 그 값을 따른다. 이미지에 시간대 데이터가 있음을 보드에서 확인(KST).
    시험: 시간대 전달(수정 전 실패), env 파일 우선, 배포 스크립트 15 통과.
2026-10-16 fix(deploy): 시간대 출력 줄이 두 번 찍히던 것, devlog에 시각 루틴 실물 확인(19:41 키오스크 카드 → 승인 → 공기청정기 꺼짐 state_confirmed)
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2026-10-16 fix(app): 자동 실행 허용 확인 시트가 서버 caveat 문장을 따른다 — 시각 규칙에 조리 문장이 나오지 않게
    칸이 없으면(옛 서버) 지금의 가열 종료 문장, null이면 숨김. 제안 카드·루틴 목록 다시 허용 두 곳 모두.
    시험: 시각 규칙 문장·null 숨김(수정 전 실패 확인), 폰 895 통과(골든 제외)·골든 55, analyze error·warning 0.
2026-10-16 fix(deploy): 배포할 때마다 허용한 자동 실행이 꺼지던 것 — 옛 컨테이너를 docker stop(종료 신호)으로 먼저 세운 뒤 지운다
    run_backend.sh가 docker rm -f로 바로 죽여 서버가 정상 종료 표시를 남기지 못했고, 다음 기동에서 '허브가 갑자기 꺼짐'으로
    보고 허용한 자동 실행을 모두 껐다(2026-10-16 리허설 전환 배포 뒤 '저녁 공기청정기 켜기'가 꺼짐으로 확인).
    시험: stop이 rm보다 먼저(수정 전 실패), 배포 스크립트 16 통과.
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2026-10-16 fix(deploy): 서버가 열린 연결을 끝없이 기다리다 강제 종료돼 자동 실행이 풀리던 것 — uvicorn 정상 종료 기한 5초
    docker stop을 보내도 uvicorn이 'Waiting for connections to close'에서 키오스크·폰의 연결 유지를 기다리다 15초에
    강제로 죽어 정상 종료 처리(정상 종료 표시)에 닿지 못했다(보드 로그 확인). --timeout-graceful-shutdown 5를
    보드 빌드·Dockerfile 시작 명령에 넣었다. 보드 실물: 허용 → 다시 배포(12초) 뒤에도 '자동 실행 켜짐' 유지(수정 전에는
    '허브가 갑자기 꺼져서 자동 실행을 껐어요'). 시험: 두 시작 명령에 기한(수정 전 실패), 배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
2026-10-16 fix(rpi): 재시작해도 같은 시각 회차 카드를 다시 띄우지 않고, 기록은 실행할 때의 가전 이름을 남긴다
    - 시각 루틴의 '이미 띄운 회차'를 DB 설정 한 칸(routine_time_fired)에 저장 — 10분 창 안 재시작에서 두 번 실행되던 결함
    - job_history에 appliance_name 열 추가, GET /history가 돌려준다(옛 기록은 null)
2026-10-16 fix(app): 기록 화면이 실행할 때의 가전 이름을 먼저 쓴다 — 나중에 모의로 바꿔도 실제 실행이 '(모의)'로 보이지 않게
2026-10-16 fix(rpi): 제안 근거 문구가 누가 승인했는지 단정하지 않는다 — '최근 기록: 이 제안 승인 N번'
2026-10-16 fix: '다음 실행' 카드가 자동 실행이 켜진 루틴을 '승인 후 실행'이라 하던 모순 — 서버가 auto·오늘/내일을 주고 폰이 그대로 쓴다
2026-10-16 fix(app): 실행 상태·기록·ThinQ 연결 화면 정리 — 한 단계 진행 막대·중복 '닫기' 빼기, 연습 기록은 중립 아이콘, 모델 코드 숨김, '빼기'는 테두리 버튼
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2026-10-16 fix(kiosk): 연습 띠를 경로를 가리지 않는 말로 — '연습 중 · 실제 가전에는 보내지 않아요'(ThinQ 연습에 '누르지'가 뜨던 것)
2026-10-16 fix(kiosk): 시나리오 승인 카드의 근거를 오른쪽 칸('할 일' 아래)으로 — 15.8형에서 왼쪽 칸 아래로 근거 둘째 줄이 잘리던 것
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2026-10-16 fix(kiosk): 승인 카드의 '[시연 데이터]'를 큰 질문에서 위 띠('제안 · 시연 데이터')로, 할 일의 '(모의)' 반복 제거 · 전력 확인 결과 제목을 '전력 변화 확인'으로(띠·본문과 같은 수준). 골든 2장 갱신
2026-10-16 fix(app): 홈 큰 카드는 설정이 필요한 가전의 루틴을 건너뛴다 — 첫 화면 첫 버튼이 실행할 수 없는 루틴이던 것
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2026-10-16 fix(kiosk): '다음 루틴' 줄을 어절 단위로 줄바꿈 — 실패널에서 '공기청/정기'처럼 끊기던 것
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2026-10-16 fix(kiosk): 실행 중 큰 버튼 이름 위에 '지금 누르는 버튼'(연습은 '지금 차례인 버튼') 이름표 — 따옴표 친 큰 글자의 뜻이 안 보이던 것. 골든 7장 갱신
2026-10-16 fix(kiosk): 연습 실패 화면에 이유 한 줄(눌림 확인 못 함·결과 못 받음 등) — '실제 가전은 누르지 않았어요'만 있던 것. 골든 1장 갱신
2026-10-16 fix(app): 기록 제목은 한 일만, 출처(자동 실행·루틴)는 시각 줄로 — 발화문·'…' 루틴·'자동 실행 · …' 세 형식이 섞이던 것(모르는 출처는 붙이지 않음)
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2026-10-16 fix(app): 설정이 필요한 가전의 루틴은 홈·루틴 탭에서 '실행하기'를 끄고 이유를 말한다, 루틴 탭을 '자동 실행 규칙'·'내 루틴 목록' 머리말로 나눔
2026-10-16 fix(kiosk): 전력 확인 결과 띠를 '전력 확인'으로(제목과 같은 수준), 실행 중 이름표를 시제 없는 '이번 버튼'으로, 공기 머리말에 가전 '종합' 등급임을 밝힘. 골든 9장 갱신
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2026-10-16 fix(kiosk): 눌렸는지 모르는 결과를 빨간 '실패' 대신 앰버 '확인 필요'·물음표로, 정지 확인 못 함 화면이 대신 누른 버튼을 실제 이름('취소')으로, 밤 예보의 맑음은 달 아이콘. 골든 5장 갱신
2026-10-16 fix(app): 홈 큰 카드는 직접 실행 루틴을 먼저(시각 루틴은 저절로 돈다), 설정이 필요한 루틴 행은 맨 아래로
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2026-10-16 fix(rpi): 복약 안내 템플릿이 화면에 없는 '확인' 버튼을 누르라고 하던 것 — '아직 안 드셨으면 지금 챙겨 드세요'
2026-10-16 fix(app): 큰 문장·경고 줄을 어절 단위로 줄바꿈('동/작을'·'버/튼' 방지), 시험 도우미 findPlainText(결합 문자 무시)
2026-10-16 fix(kiosk): 승인 주 버튼 '시작' → '지금 실행'(가전 버튼 이름과 겹침), 결과 화면을 만지면 자동 복귀 멈춤, 스크롤 막대가 글자를 가리지 않게 자리 비움, 날씨 안내가 있어도 다음 루틴 줄이 잘리지 않게(예보 먼저 접고 큰 글씨는 짧은 문장·자리 없으면 숨김). 골든 갱신
2026-10-16 fix(rpi): 키오스크 안내 카드에는 알림 루틴의 안내 문장만 — "루틴 '…' · 직접 실행을 눌렀어요 — …" 기록 형식이 실패널에 그대로 뜨던 것(폰 알림함은 전체 문장 유지)
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2026-10-16 fix(app): 루틴 탭 설정 안내는 앰버(오류 빨강과 분리), 탭 제목을 홈과 같은 굵은 제목, 이미 목표값 기록은 한 번만·중립 아이콘, 홈의 설정 필요 루틴은 '설정하기'로 바로. 골든 17장 갱신
2026-10-16 fix(kiosk): 잠시 쉬기 '취소'를 테두리 버튼으로. 골든 2장 갱신
2026-10-16 fix(app): 설정 행 부제를 어절 단위로 줄바꿈('키오스크에서/는' 방지), '시간 고르기'·'쉬기'를 테두리 버튼으로. 골든 갱신
2026-10-16 fix(kiosk): 질문이 이미 루틴 이름을 말하면 위 '내 루틴 …' 줄을 되풀이하지 않는다(실패널에서 발견)
2026-10-16 fix(app): 허브 연결됨 점을 중립색으로(주행동 갈색과 분리), '루틴 N개 더 보기'를 테두리 버튼+화살표로. 골든 갱신
2026-10-16 fix(kiosk): 연결 창 넓히고 어절 줄바꿈(스크롤 없이 다 보임), 다시 시도 경고를 어느 가전에나 맞는 말로, 큰 글씨 ThinQ 상세는 조작을 먼저, 다음 루틴 줄은 시각·이름 두 줄. 골든 갱신
2026-10-16 fix(app): 거절 버튼을 키오스크와 같은 '이번엔 안 할게요'로·제안 버튼은 늘 세로, 루틴 탭 설정 필요 루틴은 아래로·'설정하기', 앱바 제목 굵게, '키오스크에 다시 보내기', 설정 '내 가전'에 ThinQ 가전·이유·화살표. 골든 갱신
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2026-10-16 fix(kiosk): 위쪽 아이콘 아래 이름(설정·제안 쉬기·와이파이·작은 팔·콘센트), 큰 글씨 실행·연결 창·제안 단추·결과 제목 잘림과 어긋남, 끝의 짧은 두 낱말 묶기, 연습·ThinQ 읽은 시각·다시 시도 경고 문구. 골든 갱신
2026-10-16 fix(app): 루틴 탭 실행하기를 홈과 같은 테두리 버튼으로, 설정 부제 어절 줄바꿈·작은 글자 12→14, '세기 바꾸기'→'풍량 바꾸기', '센서 기록 보기'→'전류·소리 기록 보기', ThinQ 읽은 시각 'HH:MM에 읽음', 다시 시도 경고 괄호 없이. 골든 갱신
2026-10-17 fix(app): 홈 큰 카드에 '바로 실행할 수 있는 루틴'(왜 맨 위인지), 설정 내 가전의 지울 수 있는 줄도 화살표
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2026-10-17 fix(kiosk): 뒤로 단추에 흰 화살표·'뒤로' 글자, 공기질에 미세먼지 등급(종합 등급 근거), 큰 글씨 결과 자동 복귀 20초, 제안 쉬는 중 칩이 설정·연결 아이콘을 밀지 않게, 비상 중 정지 단추 흐린 테두리·이유 한 줄, 끝줄 외톨이 낱말 묶기, 제안 근거 한 문장. 골든 갱신
2026-10-17 fix(app): 기록 시각 줄에 출처를 늘(자동 실행·루틴·직접 실행), 설정 내 가전에 '설정이 필요해요'와 지우기·화살표 간격. 골든 갱신
2026-10-17 fix(kiosk): 종합 공기질이 보이는 먼지 등급보다 나쁘면 '종합은 가전이 여러 센서로 매긴 등급'을 밝힌다(실패널에서 모두 좋음인데 종합 보통)
2026-10-17 fix(kiosk): 공기 줄을 늘 세 줄 안에 — 두 먼지 등급이 같으면 한 줄, 종합 출처 문장을 짧게(실패널에서 넷째 줄이 잘림, 시험으로 재현)
2026-10-17 fix(kiosk): 두 먼지 등급이 같으면 '미세·초미세먼지 모두 좋음' — 실패널 글꼴에서 값까지 넣은 줄 끝이 잘렸다
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2026-10-17 fix(rpi): 시각 규칙 자동 실행 기록을 루틴 이름으로(자동 실행 · '아침 공기청정기 끄기' 루틴) — 루틴 탭과 기록이 이어지게
2026-10-17 fix(app): 동작을 확인 못 한 물리 기록은 중립 아이콘, '재시도 N회 후 성공' → 'N번 더 눌러 마쳤어요', 홈 루틴 줄은 셋까지. 골든 갱신
2026-10-17 fix(kiosk): 사용자가 멈춘 결과에는 '다시 시도'를 두지 않는다(다시 누를 위험), 큰 글씨 결과는 결과 원을 빼 이름 줄까지 스크롤 없이. 골든 갱신
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2026-10-17 fix(app): 조용한 시간 줄에 겹치는 자동 실행을 이름·시각으로(켜면 건너뛰는 것 미리, 끝 시각은 제외 — 서버 판정과 같게), 내 가전 지우기·화살표 간격 40
2026-10-17 fix(app): 내 가전 부제를 어절 단위로 줄바꿈('버 / 튼' 방지, 실화면에서 발견). 골든 갱신
2026-10-17 fix(app): 루틴 탭 시각 규칙 카드에도 조용한 시간과 겹침 한 줄(켜짐이면 앰버), 설정 조용한 시간 줄은 겹침 경고를 범위 설명보다 먼저
2026-10-17 fix(rpi): 다음 실행이 조용한 시간 안이면 quiet_skip·'조용한 시간이라 건너뜀'(규칙 카드는 건너뛴다는데 다음 실행은 실행이라 했다)
2026-10-17 fix(kiosk): 다음 루틴이 조용한 시간이라 건너뛰면 첫 줄 '· 조용한 시간', 둘째 줄 '· 건너뜀'(줄 길이 그대로)
2026-10-17 fix(app): 제안 잠시 쉬기 길이마다 그 안에 드는 자동 실행을 이름·시각으로, 조용한 시간 미리 알림은 꺼져 있으면 회색(앰버는 실제로 건너뛸 때만)
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2026-10-17 fix(kiosk): 키오스크 문구를 쉬운 말 사전대로 바꿈 — 본체·작은 팔·콘센트·LG 가전·연습
    - 이름 통일: SimpleLay 본체 → 본체, 작은 팔 장치 → 작은 팔, 가전 콘센트(장치) → 콘센트,
    ThinQ → LG 가전(배지·경로), 짚다 → 누르다(연습), 해제 → 풀기, 풍량 → 바람 세기,
    다시 읽기·다시 확인하기 → 새로 보기, 근거 → 이유, 순서·근거 보기 → 자세히 보기,
    제안 잠시 쉬기 → 잠시 쉬기, 정지 대기 → 작동 중, 확인 필요·확인 불가 → 봐 주세요·몰라요
    - 결과 화면: 결과 한 줄 + 할 일 한 줄. 이름은 '이름 — ' 머리 대신 따로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
2026-10-17 fix(rpi): 서버 사용자 문장을 쉬운 말로 — 본체·작은 팔·콘센트·LG 가전·연습, 결과 한 줄 + 할 일 한 줄
    - 연결 창·키오스크 안내 카드·자동 실행 규칙(사유·알림·단서)·제안 이유·공기질 이유·ThinQ 결과·비상정지 문장
    - '허브'·'모의'·'시연'·'CT'·'L3'·'상태 재조회'·'변경 명령'·예외 클래스·거절 코드·초 단위 숫자를 화면 문장에서 뺌
    - '—'·괄호·'·'로 잇던 문장을 마침표 두 문장으로, 같은 경고는 한 번
    - 사실은 유지: 가열 종료는 '조리 완료가 아닐 수 있어요'(키오스크 일치 낱말), 미확인은 '몰라요'와 다시 보내지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
2026-10-17 fix(app): 폰 화면 문구를 쉬운 말 사전대로 바꾼다
    - 이름 통일: 허브·서버·키오스크 → 본체(본체 화면), 누름 장치·모션/모터 보드·노드 → 작은 팔,
    콘센트 모듈 → 콘센트, ThinQ → LG 가전(앱은 LG 앱), 모의·데모·시연 → 연습,
    방해 금지 → 잠시 쉬기, 확인 주행 → 시험 이동, 쉬는 자리 → 기다리는 자리,
    풍량 → 바람 세기, 다시 읽기 → 새로 보기, 근거 → 이유, 허브 키 → 연결 비밀번호,
    예비 연결·BLE·스캔 → 블루투스 연결·찾기, 루틴 녹화 → 누르는 순서 저장, 단계 → 할 일
    - 결과 문장(command_result·display_status):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
2026-10-17 fix(rpi): 서버 남은 문장 쉬운 말 2차 — 자동 실행 규칙 조각·누름 결과·루틴 진행·LG 오류·연습 장치
    - 자동 실행 규칙: '언제'·'무엇을' 조각을 해요체로('전자레인지가 데우기를 멈추면', '매일 밤 10시에',
    '공기청정기 바람을 세게 해요', '공기청정기를 켜요'). '풍량'·'전원 켜기'·'23:00이 되면'을 쓰지 않는다
    - 시나리오 이름에서 화살표를 뺌('데우기 멈추면 공기청정기' 등), 직접 끈 사유는 '자동 실행을 꺼 두셨어요.'(옛 저장값은 보여 줄 때만 바꿈)
    - 누름 결과 문장: '작은 팔 장치'·괄호·'· 정지 요청 있음' 꼬리·검증 층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
2026-10-17 fix(app): LG 공기청정기 바람 세기 이름을 버튼·본체 문장과 같게 약·중·강으로
    - 지금 상태 줄·고르는 칩·확인 질문·루틴 단계 문장 모두 '약풍·중풍·강풍' 대신 '약·중·강'
2026-10-17 fix(kiosk): 결과 띠는 됐어요·확인해 주세요 두 말, 작은 팔 끊김 때 타일 '지금 못 써요', 대기 화면 정렬·다음 루틴 카드
    평가 3차 지적 수리(키오스크 3단계).
    - 결과 띠 말은 '됐어요'(실제 확인)와 '확인해 주세요'(그 밖 모름·주의·실패)만. 봐 주세요·몰라요·주의·못 했어요·결과 혼용 제거
    (색은 그대로 — 실패·안전 정지 빨강, 모름 앰버, 연습 청록). 같은 말 두 번 금지는 제목을 바꿔 지킨다
    (LG 가전 확인 '설정이 됐어요' → '가전 설정을 확인했어요'). 정지 미확인 띠도 같은 말
    - 누름 보고만: 띠 '확인해 주세요', 제목 '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
2026-10-17 fix(rpi): 쉬운 말 3차 — '풍량'을 '바람 세기'로(옛 질문 기록 호환), 규칙 이름은 시나리오 ID로, 기록 제목 문체 정리
    - 공기청정기 바람 세기 기능 이름 '풍량' → '바람 세기', 값은 폰·키오스크 버튼과 같은 '약·중·강'('강풍'·'약풍' 이름 뺌).
    결과 문장은 '바람 세기 강으로 바꿨어요'·'이미 바람 세기 강으로 설정돼 있어요. 그래서 보내지 않았어요'·
    '바람 세기 강으로 설정된 것을 확인했어요' — 클라이언트가 가르는 낱말('이미'·'보내지 않았어요'·'설정된 것을 확인'·'바꿨어요')은 그대로
    - cook_done_air 질문 '공기청정기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
2026-10-17 fix(app): 평가 3차 — 설정 안내는 확인 카드 한 곳, 루틴 단위·아이콘·기록 제목 규칙, 본체 시각 그대로
    - 홈: '설정이 필요해요'는 확인 카드 한 줄(가전 이름 포함)에서만. 가전 타일은 느낌표 아이콘 점 + 낭독 이름,
    상태 줄은 늘 한 줄(모르면 '눌러서 조작하기'·'눌러서 설정하기'), 최소 높이를 없애 내용대로. 루틴 타일 경고 줄 삭제.
    - 루틴 탭: 행의 경고 두 줄 삭제('설정하기' 단추만), 다음 실행은 작은 한 줄(큰 시각은 홈에만),
    단위는 키오스크와 같은 '버튼 N번'·'LG 가전 설정 N번'.
    - 루틴 아이콘 = 대상 가전 아이콘(여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
2026-10-17 fix(rpi): 쉬운 말 4차 — '콘센트'를 '전기 플러그'로, '보냈어요' 계열을 사람 말로, 옛 바람 세기 기록 제목, '자동으로 하기'
    - 사전 변경: 사용자에게 보이는 서버·RPi4 문장의 '콘센트' → '전기 플러그'(가족은 '콘센트'를 벽 콘센트로 읽음).
    연결 창 제목·설명·할 일, 비상 버튼 해제 사유, 전원 꺼짐 걸림 문장('다시 켜져'는 그대로), 연습 장치 문장,
    자동으로 하기 막힘 사유, 실행 전 전기 플러그 무응답 사유(초 숫자·괄호는 로그 몫으로)
    - 기계 말투: '정지 명령을 보냈어요' → '멈추는 중이에요. 멈췄는지 기계를 봐 주세요'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
2026-10-17 fix(app): 평가 4차 — 줄바꿈 사고 없애기, 개발자 시점 문장·자동 계열 이름 통일, 설정 '생활 습관'·알림만 루틴 배지
    - 줄바꿈: 설정 행은 이름·값이 한 줄에 다 들어갈 때만 나란히, 아니면 값을 이름 아래 한 줄로('생활 습관 알아가/기'·
    '읽지 않은 알림/4건' 방지). 짧은 말·숫자+단위·가운뎃점을 붙이는 keepPhrasesTogether(보통 글씨에서는 'LG 가전 설정 1번'
    같은 묶음 통째). 홈 확인 카드·설정 카드·연결 칩·루틴 이름·세그먼트·음성 안내 문장에 낱말 단위 줄바꿈. 홈 '내 루틴'
    제목과 '루틴 더 보기'는 들어갈 때만 나란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
2026-10-17 fix(kiosk): 평가 4차 — 비상 버튼 때 칩·타일, 한 글자 줄바꿈, 사람 말투·제목 ~하기, 연습 한 문장, 평소 화면 시각·타일
    평가 4차 지적 수리(키오스크 4단계).
    - A. 비상 버튼이 눌려 있으면 상태 칩이 '모두 정상'이 아니라 띠와 같은 말(빨강 '비상 버튼이 눌려 있어요'),
    작은 팔 가전 타일은 '지금 못 써요'(작은 팔 끊김과 같은 처리). 칩·못 쓰는 타일을 누르면 띠의 풀기 안내.
    KioskEstopScope가 띠 제목을 함께 넘긴다. LG 가전 타일은 그대로
    - B. 줄바꿈: 루틴 카드는 이름 위·'버튼 3번' 아래로, 잠시 쉬기 창·띠·결과·LG 상세·수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
2026-10-17 fix(kiosk): 평가 5차 — 같은 말 두 번 없애기, 실패 화면 제목+할 일·한 번 더 하기, 연습 한 줄, 평소 화면 빈 가운데·4개 타일, 제안 제목 어구 묶기, 휴대폰 앱
    평가 5차 지적 수리(키오스크 5단계).
    - 같은 말 두 번: 비상 버튼(전기 플러그 걸림 포함) 띠가 있으면 상태 칩은 빨강 아이콘만(누르는 자리 52, 누르면 풀기 안내).
    LG 가전 상세(연습)는 조작 칸 위 연습 안내 한 곳 — 지금 상태 칸의 '연습 화면이에요. 진짜 값이 아니에요'를 뺐다.
    연습 실패는 '연습이 중간에 멈췄어요' 한 줄(아래 '연습 누르기를 끝내지 못했어요' 없음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
2026-10-17 fix(app): 평가 5차 — 기록 배지는 됐어요·봐 주세요·못 했어요·연습 넷만, 전기와 소리 기록은 개발자 모드일 때만
2026-10-17 fix(app): 평가 5차 — 수동 조작·할까요? 화면 낱말 중간 줄바꿈 없애기
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2026-10-17 fix(kiosk): 평가 6차 — 가전 타일 상태 띠(폰과 같은 구조·설정 필요 판정), 공기청정기·선풍기 아이콘, '누를 버튼 N개'·LG 가전 결과 말, 연습 동작 중 제목·할 일 한 줄
    평가 6차 지적 수리(키오스크 6단계, 폰 948d7c3과 같은 시각 언어).
    - 가전 타일: 회색 '눌러 드려요' 반복 대신 타일 아래 상태 띠(색 면 + 아이콘 + 짧은 말). 준비됐어요(회색, 서버가
    operable·실행 가능이라 말한 때만) · 켜져 있어요(초록, 읽은 켜짐만) · 작동 중/바꾸는 중(파랑) · 설정이 필요해요·
    연결이 안 돼요·확인해 주세요(주황) · 지금 못 써요(비상 버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
2026-10-17 fix(app): 평가 6차 — 루틴 줄 오른쪽 '지금 하기 >'·'다음' 배지·왼쪽 가전 아이콘, 끈 규칙 한 줄, 조용한 시간 경고는 실제로 건너뛸 때만, 됐어요 기호 하나, '자리 확인'·'가전 다시 불러오기', 보조 글씨 한 단계 진하게·홈 가전 두 줄
2026-10-17 fix(kiosk): 평가 7차 — 실행·결과 화면 왼쪽 아래 누를 순서(✓ 즉석밥 — ② 시작), 버튼 이름 따옴표 대신 '시작 버튼', 비상 정지 대기에 직접 누를 칸 표시, 연결 문제 칩 아래 '눌러서 해결 방법 보기', 본체에 닿지 않으면 '모두 정상' 대신 '본체와 연결이 끊겼어요', 잠시 쉬기 = 일시정지·조용한 시간 = 달 아이콘, 눌렸는지 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
2026-10-17 fix(app): 평가 7차 — 루틴 줄 '지금 하기 >'는 모든 줄 이름 옆 같은 자리·시각은 이름 위 작은 '매일 오전 7:00'(홈 다음 예정도 오전/오후), 가전 띠 문장형('켜져 있어요'·'설정이 필요해요'), 기록 멈춤 배지 '멈췄어요'·'스스로 멈췄어요'와 루틴 출처('허락하고 실행'·'자동으로'), 조용한 시간=달·잠시 쉬기=일시정지 App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
2026-10-17 fix(app): 평가 8차 — 루틴 줄 끝 ⋮ 없앰(편집·지우기는 줄을 눌러 들어가는 편집 화면, 지우기 확인 그대로)으로 이름 390dp 한 줄·큰 글씨 최대 두 줄, 이름과 같은 말인 부제 숨김, '다음' 배지는 시각 줄 옆, 위 탭 글은 큰 글씨에서도 한 줄, 폰이 만드는 시각은 모두 '오전 7:00'·'오후 10:04'(기록·조용한 시간·잠시 쉬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
2026-10-17 fix(kiosk): 평가 8차 — 끝난 정지 결과는 '작은 팔이 멈췄어요'(엔코더 확인)·'작은 팔이 멈췄는지 몰라요' 둘뿐이고 정지 보고를 기다리는 몇 초만 '멈추는 중이에요'(처음 화면 단추 숨김, 결과는 보고가 온 때 음성 한 번), 정지 미확인 대기의 버튼판은 '직접 누를 버튼이에요'+취소 칸 주의색·'작은 팔도 취소 버튼을 눌렀지만 눌렸는지 확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
2026-10-17 fix(rpi): 평가 8차 — 자동 실행 규칙 이름을 문장으로('데우기가 끝나면 공기청정기 세게')
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2026-10-18 fix(app): 평가 10차 — 루틴 목록 한 줄 구성·자동으로 해요 표시, 기록 출처 말·봐 주세요 까닭, 홈 자리 확인 한 문장, 설정 까닭·새로 보기 단추, 편집 '끝나면', 직접 누르기 빈 칸 점선
    - 루틴 목록: 모든 줄이 이름 → 아래 한 줄 '언제 · 무슨 가전'('매일 오전 7:00 · 공기청정기'), '지금 하기'는 이름 줄 같은 높이,
    '다음'·'자동으로 해요'(본체 /routines/next의 auto)·'알려 드려요' 배지는 그 줄 끝(큰 글씨에서 시각과 이름 사이에 혼자 서지 않음)
    - 자동으로 하기: 머리 안내 낱말 단위 줄바꿈, 사용자가 끈 규칙은 짧은 '꺼 둠'
    - 기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
2026-10-18 fix(kiosk): 평가 10차 — LG 가전 화면을 하려는 일로(명령 낱말 제거·가운데 한 열·정지 뜻 한 줄), 이어받은 LG 가전 실행·꺼진 타일·비구름 아이콘·마침표 규칙
    - 보내는 중: '공기청정기를 켜고 있어요'·'바람을 세게 바꾸고 있어요', 위 띠에 동작('공기청정기 켜기'), 한 열 가운데 배치
    (정지 단추 자리·크기 그대로), 정지 옆 '멈추면 더 보내지 않아요 / 이미 바뀐 설정은 그대로일 수 있어요'(서버 /stop 동작 그대로)
    - 결과: 확인됨 아래 줄 '공기청정기에서 확인했어요', 확인 못 함 '켜 달라고 했어요 / 켜졌는지는 아직 몰라요'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
2026-10-18 fix(rpi): 지금 날씨 아이콘은 지금 하늘만 — 강수확률만 높은 칸을 비로 그리지 않음(평가 11차)
2026-10-18 fix(app): 평가 11차 — 루틴 줄 끝 '다음·자동'은 칩 대신 작은 글자, 오른쪽 '지금 하기 >'·'설정하기 >' 같은 꼴, 자동 규칙 스위치와 겹친 칩 제거, 홈 위 카드에서 가전 전원 빼기·안 본 알림 종류 말하기, 설정 LG 가전 부제·다시 보내기 단추 이름
2026-10-18 fix(kiosk): 평가 11차 — 예보 칸 한 꼴·결과 화면 나가는 단추 하나·LG 가전 확인 못 함 제목에 가전 이름·연습 대기 한 문장·LG 가전 조작 상태 한 번·아이콘 통일
    - 시간대 예보: 모든 칸 '아이콘 + 기온', 강수확률('비 70%')은 기온 아래 작은 둘째 줄. 안내 카드 아래 좁은 꼴은
    줄 높이를 글자 크기로 묶어 다음 루틴 카드와 함께여도 예보가 접히지 않게. 다음 루틴 카드 높이 계산에서
    작은 글이 다음 줄로 갈 때 아래 여백(4)을 빠뜨려 카드 아래 테두리가 잘리던 것도 고침.
    - 결과 화면 나가는 단추: LG 가전 결과의 '× 닫기'를 다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
2026-10-18 fix(rpi): /ambient 응답 모델에 지금 날씨 칸(now) — 모델이 걸러 내 키오스크가 3시간 칸으로만 날씨를 보였다
2026-10-18 fix(app): 평가 12차 — 기록 '버튼은 다 눌렀어요, 움직이는지 봐 주세요'·LG 가전 기록은 가전 아이콘과 'LG 가전' 출처, 홈 가전 칸 '버튼 자리를 다시 맞춰 주세요', 설정 LG 가전 부제 두 줄·'본체 화면에 반영하기'는 보낼 것이 있을 때만, 안 본 알림 줄에 본체가 실제로 보내는 종류(자동·루틴 안내·루틴 멈춤) 반영
2026-10-18 fix(kiosk): 평가 12차 — 연습 대기 '처음 화면으로'·결과 보조 단추 한 꼴과 한 번 더 하기 묶음·공기 나쁨 할 일 한 줄·예보 줄 넓은 글꼴 대응
    - 연습 대기(모의): '처음 화면으로' 주 단추(왼쪽 아래), 정지 단추 자리·이름 그대로. 나가면 같은 연습 대기를
    평소 화면이 다시 띄우지 않는다(서버 대기는 그대로, 정지를 보내지 않음). 실제 대기에는 나가는 단추 없음.
    기다리는 칸은 진행색 채움 대신 흰 테.
    - 실패·사용자 정지 결과: 보조 단추 '작은 팔로 골라 누르기'를 두 화면 같은 테두리 꼴로, '한 번 더 하기'는
    안내 문장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
2026-10-18 feat(rpi): 다음 루틴 한 번 건너뛰기 — POST /routines/next/skip·unskip, 그 회차만 카드·자동 실행 없이 기록, 재시작 뒤에도 유지
2026-10-18 feat(app): 다음 루틴 '오늘은 건너뛰기' — 홈 '지금 우리 집' 다음 예정 줄과 루틴 탭 '다음' 줄에 단추, 본체 말(skip_action_label·skip_label) 그대로 '오늘은 건너뛰어요'와 되돌리기, 확인 창 없이 중복 요청 막기, 실패 스낵바·409면 다시 받기, 조용한 시간 회차·옛 본체는 단추 없음
2026-10-18 feat(kiosk): 처음 화면 시계 아래 다음 루틴 줄·'오늘은 건너뛰기', 공기 줄은 나쁠 때만
    - 공기 줄은 나쁨·매우 나쁨일 때만 보이고 공기청정기 전원 말은 뺐다(가전 타일이 말한다). 평소·공기청정기 없는 집은 줄이 없다.
    - 오른쪽 큰 다음 루틴 카드를 없애고 시계 아래에 담담한 줄: '오후 10시 · 저녁 공기청정기 켜기' + 작은 '자동으로 해요'.
    한 줄에 안 들어가면 시각 뒤에서만 줄을 바꾼다. 오른쪽은 날씨 안내 + 예보가 쓰고, 자리가 남으면 예보를 보통 꼴로.
    - '오늘은 건너뛰기' 테두리 단추(높이 48) — POST /routines/next/skip·un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
2026-10-18 fix(app): 평가 13차 — 안 본 알림 이름 하나('안 본 알림 N건', 홈·설정·탭 같은 말)와 볼 것이 섞였을 때만 경고색·한 마디, LG 가전 자동 실행은 가전 아이콘·'자동 · LG 가전', 기록 출처 '화면에서 골라 누름'·'바로 실행'과 가운뎃점 줄 머리 막기, 알림 문장 '밤 10시'도 '오후 10:00' 꼴
2026-10-18 fix(kiosk): 처음 화면 다음 루틴은 작은 머리말 '자동 루틴'·작은 글자 '오늘은 건너뛰기', 지금 날씨는 예보 첫 칸, 평가 13차
    - 다음 루틴: '자동으로 해요' 대신 작은 머리말(서버 auto면 '자동 루틴', 카드로 묻는 루틴은 '물어볼 루틴', 조용한 시간은 '다음 루틴').
    시각은 분까지 '오후 10:00'(폰과 같은 꼴). '오늘은 건너뛰기'·'오늘은 건너뛰어요 · 되돌리기'는 머리말과 같은 작은 회색 글자
    단추(테두리 없음, 누르는 자리 48 이상). 큰 글씨 시계 하한 52→44.
    - 날씨: 날짜 옆 아이콘·기온을 빼고 예보 줄 첫 칸 '지금'(지금 + 3칸, 없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
2026-10-18 fix(rpi): 습관 제안 근거를 '최근 28일 중 3일, 아침에 하셨어요'로 — '자주 하셔서 여쭤봐요' 번역투 없애기, 평가 14차
2026-10-18 fix(kiosk): 평가 14차 — LG 가전 결과는 상자·큰 원 없이 왼쪽 정렬 '가전에서 확인했어요', 공기 나쁨 줄에 할 일 작은 글자 단추, 상태 칩 '기기 모두 정상'·비상 띠 아래 글자 없는 칩 없앰, 비 오면 인사말 뺌, 연습 띠 안 테두리 칩 없앰, 정지 안내 한 줄·'버튼'으로 통일, 누름 보고만은 폰과 같은 '가전이 움직이는지 봐 주세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
    - '오늘은 건너뛰기'는 사용자 결정대로 지금 모양(작은 회색 굵은 글자) 유지, 지키는 시험 추가
    - 제안 근거 대체문 '아침에 3번 하셨어요', 연습을 마친 대기의 정지 안내 문장 뺌
    - 공기 할 일 단추는 시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
2026-10-18 fix(deploy): 컨테이너 재시작 정책 always — 손으로 멈춘 컨테이너가 재부팅 뒤 안 떠 키오스크가 안 나온 일(10/18), 키오스크 마우스 커서 숨김
2026-10-18 fix(app): 평가 14차 — 기록은 연달아 같은 일·같은 결과를 한 줄로 묶고('3번 못 했어요', 펼치면 회차마다) 실패 줄에 기록 문장 그대로의 이유, 성공 줄은 칩 없이 확인 수준에 근거한 짧은 말('켜짐 확인'), 회색 원·회차마다 'LG 가전' 없음, 이름은 낱말 묶음 줄바꿈 / 루틴 탭은 시각 루틴 규칙을 루틴 줄 '자동'(꺼지면 '자동 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
2026-10-18 fix(kiosk): 처음 화면 어둡게는 매일 조용한 시간에만 — 잠시 쉬기에는 어둡게 하지 않음
2026-10-18 fix(rpi): 평가 15차 — 키오스크 '지금' 칸과 날씨 안내가 같은 '지금'을 쓴다
    지금 칸은 지난 정시 칸(없으면 앞뒤 30분 안)만 — 예전 앞뒤 90분은 오후 2:21에 3시 칸(비)을
    '지금'으로 그려 '오후 3시부터 비' 안내와 엇갈렸다(실패널). 안내 문장도 같은 칸을 지금으로 보고,
    그 칸에 강수형태가 있을 때만 '지금 비가 와요'라고 한다.
2026-10-18 fix(app): 평가 15차 — 홈 가전 카드 아이콘 바탕 없앰(상태는 띠), '확인이 필요해요'는 못 한 일을 무엇인지 한 줄('못 한 일 1건: 공기청정기 바람 중간으로 하기')·나머지는 '안 본 알림 N건' 따로, 큰 글씨 설정 줄은 '설정 N개 남았어요' / 자동 규칙 탭은 면 없는 줄+구분선·쉬운 안내, 루틴 '자동'은 밑줄 없이 48dp 칸,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
2026-10-18 fix(kiosk): 평가 15차 — 결과 화면 주 단추 하나·같은 자리, 정지 미확인엔 다시 멈추기, 지금 날씨 정의 맞춤
    - 지금 칸: 서버가 now 키를 보내면 그 값만(null이면 지금 칸 없음), 키가 없는 옛 서버만 3시간 칸 대체
    - 결과 화면 아래 줄: '처음 화면으로'는 한 모양(흰 채움·집 아이콘)·한 자리(왼쪽 아래), 보조 단추는 같은 폭·높이·
    오른쪽 끝(넘치면 아래 한 줄을 반씩), 정지 대기 미확인은 같은 모양 보조 크기
    - 안전: 작은 팔이 멈췄는지 모르는 정지 결과는 '작은 팔로 골라 누르기' 대신 정지 자리의 '다시 멈추기'(/stop 재전송)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
2026-10-18 fix(app): 평가 16차 — 홈 '못 한 일'은 기록과 같은 이름·'번'('못 한 일: 공기청정기 바람 중간으로 하기 (3번)', 본체 요약 '바람 세기 중'도 같은 이름), 나머지는 '그 밖에 안 본 알림 N건'(설정 전체 수와 세는 대상 구분) / 기록 거절 이유는 가전 이름이 주어(꺼짐 근거 있을 때만 '꺼져 있어서', 아니면 '지금은 바꿀 수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
2026-10-18 fix(kiosk): 평가 16차 — 정지 단추 이름 낱말 단위 줄바꿈('다시 / 멈추기')·큰 글씨 정지 미확인 골든에 다시 멈추기, 자동 루틴 한 줄(조금 넘치면 살짝 줄이고 길면 이름만 말줄임), 정지 미확인 대기에서 작은 팔이 제자리(parked)면 다시 멈추기 대신 '정지'와 손으로 누를 안내·주어 하나로, 연습 마친 대기 '연습이 끝났어요'·칸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
2026-10-18 fix(kiosk): 평가 17차 — 결과 화면 한 틀(왼쪽 정렬·큰 결과 원 없앰·띠 오른쪽에 늘 가전·할 일 이름, 본문 이름 줄 없음, 두 줄 단추는 같은 폭 격자, 정지 확인 기다림은 띠 '멈추는 중'·돌아가는 원 없음), 수동 화면 뒤로 단추와 버튼판 같은 왼쪽 선·제목 '내' 뺌, 예보 칸 머리 같은 글자 크기·비 확률 줄 자리 늘 유지, 날씨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
2026-10-18 fix(app): 평가 17차 — 루틴 줄은 이름 바로 아래 설명(자동 48dp 칸은 줄 높이를 늘리지 않는 투명 확장)·'다음'·'자동'은 이름 옆 작은 표지(설명 줄은 '매일 오후 10:00 · 공기청정기'만)·큰 글씨 '지금 하기' 들여쓰기 맞춤 / 기록 큰 글씨 '바로 실행' 한 덩어리·본문과 칩 '봐 주세요' 중복 없앰·볼 것 칩이 제목을 꺾으면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
2026-10-18 fix(kiosk): 결과 문구를 확인 수준에 맞춤 — 전력 실측만 '<가전 이름>이 켜졌어요', 근거 칩·음성은 '전기를 쓰기 시작했어요', 제출용 실제 구성 골든 3장
    - 작은 팔 성공 제목: L3 실측(출처 real)만 '전자레인지가 켜졌어요'처럼 가전 이름, 작은 팔 보고·누름 센서·연습 값은 '버튼은 다 눌렀어요'
    - 확인 근거 칩·음성 문장의 operation_confirmed는 폰과 같은 '가전이 전기를 쓰기 시작했어요'
    - 확인 수준별 제목 표를 시험으로 고정(kiosk_honest_wording_test), '준비됐어요'는 서버 판정 operable+실행 가능일 때만인 것도 고정
    - 제출용 골든(kiosk1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
2026-10-18 fix(app): 모르는 상태를 확인한 것처럼 말하지 않게 — 실행 중 판정 없으면 '다 누르면 결과를 알려 드려요', 보호자 알림 끊김·실패는 '못 불러왔어요', 제출용 실제 구성 골든 3장
    - 실행 중: 서버가 눌림 판정(누름 센서)을 보내지 않으면(지금 실물 구성) '버튼이 눌렸는지 보고 있어요' 대신 '다 누르면 결과를 알려 드려요'
    - 설정 보호자 알림: '새 알림이 없어요'는 본체 연결·조회 성공·0건일 때만. 본체 끊김(전에 받은 0건이 남아도)·조회 실패는 LG 가전 줄과 같은 '못 불러왔어요', 첫 조회 전은 '알아보고 있어요'
    - 자동 규칙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
2026-10-18 fix(rpi): 자동 규칙 이름 '전자레인지가 멈추면 공기청정기 세게'(가열 종료 감지는 조리 완료가 아닐 수 있음), 연습 구성의 작은 팔·전기 플러그 제목에서 '준비됐어요'·'연결돼 있어요'를 빼고 연습이라고
    - cook_done_air 이름: '데우기가 끝나면'은 다 데운 것처럼 읽혔다 — 멈춘 것이 근거라 '멈추면'(조건 문장과 같은 뜻). 이름은 시나리오 ID로 정해져 저장된 규칙도 바뀐다
    - 연결 항목(연습): '작은 팔이 준비됐어요' → '작은 팔은 연습 중이에요', '전기 플러그가 연결돼 있어요' → '전기 플러그는 연습 중이에요'(id·state·source는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
2026-10-18 fix(rpi): 사용자에게 보이는 서버·RPi4 문장의 '작은 팔'을 '누름 장치'로(조사 맞춤), 쉬운 말 금지어를 '작은 팔'로 바꾸고 rpi·rpi4 소스에 옛 이름이 다시 들어오지 않게 시험 추가
2026-10-18 fix(app): 폰 화면 문장의 '작은 팔'을 '누름 장치'로, 쉬운 말 사전 시험의 금지어를 '누름 장치'에서 '작은 팔'로, 골든 갱신
2026-10-18 fix(kiosk): 키오스크 화면 문장의 '작은 팔'을 '누름 장치'로, 금지어 시험에 '작은 팔' 추가·'누름 장치' 해제, 골든 갱신(줄바꿈 변화 없음)
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2026-10-18 fix(kiosk): 휴리스틱 평가 — 모름 결과는 '가전을 보고 알려 주세요' 두 답 단추, 처음 화면으로는 보조, 비상 띠·칩·타일 글자 키우기, 멈추는 중 진행 표시, 직접 누르기 빈 칸·사용 방법·LG 가전 타일·연습 정지 정리
    - 눌렸는지 모름·LG 가전 켜졌는지 모름·본체 끊김·버튼 누름 보고만: '움직였어요 / 안 움직였어요'(LG 가전은 켜졌어요·꺼졌어요·바뀌었어요) 대등한 큰 두 단추(O·X), '처음 화면으로'는 테두리 보조
    - '안 …' 뒤 '손으로 할게요'(앞)·'한 번 더 하기'(확인 창, 같은 버튼 경고 그대로) — 다시 누르기를 가장 쉬운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
2026-10-18 fix(app): 휴리스틱 평가 — 루틴 '지금 하기' 확인 시트, 홈 실패 경고·해야 할 일 분리, 기록 다음 행동·못 한 일만, 연습 가전 표지, 시각 루틴 스위치, 사용 방법, 원격 보호자 문구
    - 루틴 '지금 하기'(루틴 탭·홈·편집기·기록 다시 해 보기)는 먼저 묻는다: '지금 30초 데우기를 할까요? 전자레인지 버튼 2개를 눌러요'
    (LG 가전만이면 할 일 이름, 연습 가전만이면 '연습으로 해 볼까요?'), 취소·지금 하기 대등. 고른 뒤 경로(승인 카드 → 승인 화면)는 그대로
    - 홈: 실패 경고만 맨 위 따로(할 일 단추 '기록 보기'는 못 한 일만 거른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
2026-10-18 fix(app): 휴리스틱 평가 — 골든 갱신(홈 실패 경고·해야 할 일·말로 하기, 루틴 스위치·작은 지금 하기·고치기, 기록 못 한 일만·확인 필요, 설정 배너·사용 방법, 원격 보호자 문구), 새 골든 확인 시트·사용 방법
2026-10-18 fix(kiosk): 사용 방법의 음성 정지 문구를 실물 확인 범위로 낮춤 — 폰 실행 화면 정지로
2026-10-18 fix(kiosk): 결선 모의 평가 — 전력 확인 근거 줄, 실행 단계 문구, 보조 글씨 키우기, 경보 119, 연습 실패 띠·단추 격자, 연결 문제 줄, 직접 누르기 판 폭
    - 완료(전력 실측 L3 real만): 제목 아래 '전기를 쓰기 시작한 걸 확인했어요'(본문·흰 글자), 그 아래 '원하는 대로 됐는지 봐 주세요'
    - 실행 중: 서버 진행 보고가 누른 뒤 확인 결과를 실어 오면 '눌렀어요, 확인 중이에요', 버튼만 오면 '누르고 있어요'
    (다시 누르는 중·연습 문구는 그대로)
    - 제안 자동 닫힘은 키오스크 타이머 — 기본 40초(선택 20·40·60), 남은 초를 오른쪽에 크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
2026-10-18 fix(app): 결선 모의 평가 — 홈 연습 가전은 '연습해 보기' 구역으로, 루틴 줄의 '고치기' 단추 빼고 표지 뜻 한 줄
    - 홈 가전: 연습 가전(이름 '(연습)'·데모)은 실제 가전 아래 '연습해 보기' 머리말 구역으로 분리(이름 데이터는 그대로).
    실제 '세탁기'와 'LG 세탁기'(연습)가 나란히 놓이지 않는다. '가전 추가'는 실제 가전 구역 끝
    - 루틴 탭: 줄마다 되풀이되던 '고치기' 단추를 빼고 줄 누르기(>)로만 고친다 — 스위치가 있는 줄도 오른쪽 끝 >
    (큰 글씨에서 스위치가 단추 줄로 내려간 줄은 이름 칸 때문에 생략). '지금 하기'만 작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
2026-10-18 fix(kiosk): 접근성 감사 — 한 번 더 하기 토글 경고, 제안 시간 연장, 자동 복귀 남은 초, 조용한 시간 대비, 가족이 설정해요, 확인 필요 제목 색, 연습 세탁기, 제안 버튼판 안내, 큰 글씨 상태 줄, 경고 띠 하나로
    - 한 번 더 하기 확인 창: 다시 누를 버튼이 서버 버튼 데이터 behavior=toggle이면 '가전이 이미 켜졌다면 다시 누르면 꺼질 수 있어요', 아니면 일반 경고 그대로
    - 제안 화면: 만지면 남은 시간이 처음 길이로, '시간 더 주기'(+60초, 화면 타이머만)
    - 성공 결과·LG 가전 결과: 'N초 뒤 처음 화면으로 돌아가요'(실제 남은 초, 본문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
2026-10-18 fix(app): 접근성 감사 — 루틴 스위치 켜짐/꺼짐 글자, 설정 탭 숫자 배지, 고른 탭 굵게+밑줄, 연습 세탁기 이름, 확인 전이에요 물음표
    - 내 루틴·자동 규칙 스위치 바로 아래 '켜짐'/'꺼짐'(색만으로 말하지 않는다, 이름 칸 폭은 그대로)
    - 설정 탭 빨간 점 → 안 본 알림 수 숫자 배지(99건 넘으면 99+)
    - 내 루틴/자동 규칙 탭: 고른 탭은 굵은 글자 + 밑줄
    - 연습 가전 화면 이름 '연습 세탁기'(키오스크와 같은 규칙, 서버 이름 데이터는 그대로) — 홈·설정·상세·루틴 확인
    - 연습 가전 '확인 전이에요' 띠 아이콘은 본체와 같은 물음표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
2026-10-18 fix(app): 출시 검토 — 실행 화면 제목은 할 일 이름·따옴표 없는 버튼·세로 누를 순서, 설정 탭 배지는 볼 것만, 기록 LG 가전은 구름 표식, 연습 가전 LG 표기 빼기, 새 루틴 여백, 연결됨 초록 점
2026-10-18 fix(kiosk): 출시 검토 — 연습 실패는 청록, 실행 중 누를 순서를 제목 아래 크게·안내 한 줄, 지금 못 써요 한 모양, 날씨 칸 높이 맞춤, 버튼 없는 자리 흐린 글자, 가전 고르기 이름 낱말 줄바꿈, 확인 필요 번호 안내 잘림 방지
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2026-10-18 fix(rpi): LG 가전 음성 명령의 띄어쓰기 차이를 무시 — '공기 청정기 켜 줘'가 422로 거절되던 것(10/19 실기기)
2026-10-18 fix(kiosk): 가전 타일 단순화 — 상태 글자 띠 없이 아이콘·이름만, 문제 있을 때만 오른쪽 위 '!'·'?'·톱니 표시와 말풍선, LG 가전 전원은 아이콘 밝기, '못 써요'를 '쓸 수 없어요'로(사용자 결정 10/19)
2026-10-18 fix(app): 알림함 카드 머리 줄 — 오늘이 아닌 날짜 시각이 길어지면 줄이 넘치던 것
2026-10-18 fix(app): 가전 타일 단순화 — 상태 글자 띠 없이 아이콘·이름만, 문제 있을 때만 오른쪽 위 '!'·'?'·톱니 표시와 말풍선(본체와 같은 문장), LG 가전 전원은 아이콘 밝기, '못 써요'를 '쓸 수 없어요'로(사용자 결정 10/19)
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2026-10-18 fix(kiosk): 지난 일 확인·움직임 답을 본체에 적고 다른 기기에서 확인한 실패는 지난 일 줄·가전 칸 표시에서 내림(사용자 보고 10/19)
2026-10-18 fix(app): 홈 못 한 일 경고 — '기록 보기'로 보면 본체에 확인을 적어 경고·설정 탭 배지가 사라지고, 키오스크에서 확인한 실패도 뜨지 않음(사용자 보고 10/19)
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2026-10-18 fix(kiosk): 가전 타일 밝기 = 켜짐·작동 중 — 흰 아이콘·이름은 읽은 켜짐·지금 실행 중일 때만, 그 밖은 흐린 회색(고대비 포함 4.5:1 이상), 문제 표시라고 따로 흐리게 하지 않고 카드 면 그대로(사용자 결정 10/19 두 번째)
    - 누름 장치 가전은 켜짐을 읽을 수 없어 실행 중일 때만 밝게, 가열 감지 근거는 아직 화면에 오지 않아 짐작하지 않음
    - 화면 읽기 상태 말: 쉬는 누름 장치 가전 '작동 중 아님' 추가
    - 새 단정 시험 kiosk_tile_power_1019_test(옛 코드에서 5건 실패 확인), 기존 시험은 새 결정에 맞게, 골든 갱신
2026-10-18 fix(app): 가전 타일 밝기 = 켜짐·작동 중 — 본문 글자색 아이콘·이름은 읽은 켜짐·지금 실행 중일 때만, 그 밖은 흐린 회색(다크·라이트 카드 위 4.5:1 이상), 강조색 대신, 키오스크와 같은 규칙(사용자 결정 10/19 두 번째)
    - 새 단정 시험 tile_power_1019_phone_test(옛 코드에서 6건 실패 확인), 기존 시험은 새 결정에 맞게, 골든 갱신
    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
2026-10-19 feat(rpi): 음성 해석 규칙 계층 보강 — 말 다듬기·같은 뜻 사전 한 표, '혹시 이것?' 자모 후보, 못 알아들으면 422에 후보·동작 목록
    - rpi/intent/normalize.py: 공백·문장부호·군말·끝 어미('해 줘/해 주세요/줄래/할래') 다듬기, 가전 이름·끝 동작 별칭.
    규칙 계층(rules.py)·LG 가전 목적 비교(bindings)·사용자 등록 기능 이름이 같은 다듬기를 쓴다. 부정('켜지 마')·
    다듬은 결과가 정지어인 말은 일치시키지 않는다. 사전에 없는 말은 짐작하지 않는다.
    - rpi/intent/voice_lexicon.py: 별칭·어미·반대 뜻 묶음·부정 꼴·후보 기준을 데이터 표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
2026-10-19 fix(app): 못 알아들은 말이면 본체가 준 '혹시 이것인가요?' 후보와 할 수 있는 일을 버튼으로 — 고르면 바로 실행하지 않고 '이대로 실행할까요?'부터, 옛 서버는 종전 안내
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2026-10-19 fix(app): 실행 화면 누르는 순서가 '1번째 버튼'만 보이던 것 — 폴링에서 본 지금 버튼을 칸 번호에 묶어 기억하고 끝나면 본체 누른 순서 이름을 써서 키오스크와 같은 이름으로, 못 본 칸만 번호
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2026-10-19 fix(rpi): 대상 없는 실행도 누름 장치 대상 판정을 거친다 — 내장 갠트리 가전으로 풀어 목록에 없으면 412(검토 10/19 #1)
2026-10-19 fix(rpi): /acks는 사람이 본 것만 덮는다 — 실행 답은 그 실행만, 화면에 보인 번호까지만, 시각 대신 알림 번호, 단계 기록 번호는 실행 번호도 함께(검토 10/19 #2·#3·#4·#10)
2026-10-19 fix(rpi): 루틴 건너뛰기·회차 표시 저장을 스냅숏과 한 저장 잠금 안에서 — 동시 요청이면 옛 값이 마지막에 남던 것(검토 10/19 #8)
2026-10-19 fix(kiosk): LG 가전 보내는 중 정지 안내를 사실대로 — '정지를 누르면 더 보내지 않아요. 이미 보낸 것은 되돌리지 못할 수 있어요'(두 줄, 칸 안에 들어감)
2026-10-19 fix(kiosk): '눌렀어요, 확인 중이에요'는 마지막 버튼 확인 결과일 때만 — 앞 버튼 확인 결과가 남아 두 번째 버튼을 누르러 가는 동안에도 보이던 것, 그동안은 '누르고 있어요'
2026-10-19 fix(kiosk): 건너뛴 다음 루틴을 한 번만 말한다 — 머리말 '자동 루틴 · 오늘은 안 해요'와 끝 줄 '오늘은 건너뛰어요'가 겹치던 것, 끝 줄은 '되돌리기'만
2026-10-19 fix(kiosk): 누름 장치 끊김 칩의 가전 수와 '쓸 수 없어요' 표시는 누름 장치가 누르는 가전만 — LG 가전·연습 가전·누름 장치가 위에 없는 가전 제외, 실내 온습도는 실측일 때만 보이는지 시험으로 고정
2026-10-19 fix(app): 건너뛴 다음 루틴의 '되돌리기'를 작은 회색 굵은 글자만으로 — 표시 '오늘은 건너뛰어요'와 같은 무게로 한 번 더 말하던 것, '오늘은 건너뛰기' 모양은 그대로
2026-10-19 fix(kiosk): /acks에는 화면에 보인 그 실행 하나만 적는다 — 실행 번호를 모르는 지난 일 '확인'이 맨 failures_seen을 보내 본체의 못 한 일·최근 실행 기록 전체를 '봤다'로 올리던 것(검토 10/19 /acks 계약)
2026-10-19 fix(app): '기록 보기'는 화면에 보인 것만 /acks에 적는다 — 경고에 보인 가장 새 못 한 일 번호(failures_seen_id)와 기록 화면에 보인 실행(seen_job_ids)만, 맨 failures_seen이 폰이 받아 오지 않은 실패·실행까지 '봤다'로 올리던 것. 확인 여부는 본체가 주는 번호로 견주고 옛 본체만 시각으로(검토 10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
2026-10-19 fix(rpi): /thinq/power·/thinq/air 칸마다 그 가전의 실행 환경을 싣는다 — 서버 전체 값 하나만 실어 실제 모드 안 연습 세탁기 칸이 연습 값인지 알 수 없던 것, 맨 위 값은 그대로(검토 10/19 #7)
2026-10-19 fix(rpi): 여러 단계 실행의 실행 환경은 보낸 단계로만 정하고 실제로 보낸 단계가 있으면 real — 보내지 않은 뒷단계(연습·모의)가 /status 값을 덮어써 실제 가전이 바뀌었을 수 있는 실행이 '연습'으로 보이던 것(검토 10/19 #6)
2026-10-19 fix(rpi): 날씨 '지금' 칸이 지금보다 뒤의 정시 칸이면 그 칸의 강수확률 비를 '○시부터 비 예보'로 말한다 — 지금 칸이라 보지 않고 앞으로 칸도 아니라 비 소식을 아무 데서도 말하지 않던 것, '지금 비가 와요'는 종전대로 강수형태가 있을 때만(검토 10/19 #12)
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2026-10-19 fix(kiosk): '한 번 더 하기' 확인 창 — 성질을 모르는 버튼(unknown)·버튼판에서 찾지 못한 버튼도 토글과 같은 경고 '이미 켜졌다면 다시 누르면 꺼질 수 있어요'를 보인다 — 토글로 밝혀진 버튼만 경고해 두 번 누르면 되돌아갈 수 있는 버튼에 일반 경고만 나오던 것, 되풀이해도 같은 버튼(idempotent)만이면 일반 경고 그대로(검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
2026-10-19 fix(kiosk): 사람 확인 답(봤어요·움직였어요·안 움직였어요)을 본체 /acks 목록에 나타나거나 POST가 실패할 때까지 화면에 지킨다 — 10초마다 읽는 /acks가 POST보다 먼저 오면 본체의 옛 목록으로 덮어써 가전 칸 '!'이 다시 뜨던 것, 적지 못하면 화면의 답을 거두고 본체 목록을 다시 읽는다(검토 10/19 #9)
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2026-10-19 fix(app): 가전 추가 저장 실패 문장을 단추 바로 위에, 저장 중에는 '저장하는 중…' — 목록 맨 아래에 붙어 단추 띠에 가려 저장이 안 된 줄 몰랐다(실화면 10/19)
2026-10-19 fix(app): 가전 추가 사진을 찍자마자 이 폰 문서 폴더로 옮긴다 — 저장 단계까지 캐시에 두다가 그사이 비워져 사진 없이 등록됐다(실화면 10/19: 상세·위치 맞추기에서 사진 자리가 검게 비었다), 못 옮기면 그렇다고 말한다
2026-10-19 fix(app): 이름과 방이 모두 같은 가전은 등록하지 않는다 — 가전 추가·버튼판 등록 모두 이름 칸 아래에 말하고 막는다, 처음 채운 이름이 겹치면 비워 둔다(실화면 10/19: 세탁기 둘이 설정 목록·상세·'설정이 남은 가전'에서 갈리지 않았다)
2026-10-19 fix(app): 등록된 가전의 버튼 자리를 다시 맞출 때 제목은 '버튼 자리 맞추기', 저장되지 않는 이름·방·종류 칸은 빼고 이름만 보인다, 아무것도 안 바꾸고 닫으면 묻지 않는다(실화면 10/19)
2026-10-19 fix(app): 가전 추가 2~4단계에서 시스템 뒤로 가기는 한 단계 앞으로 — 등록 전체를 닫으려고 물었다(실화면 10/19), X는 그대로 물어보고 닫는다
2026-10-19 fix(app): 가전 추가 막히는 자리마다 다음 할 일을 쉬운 말로 — 본체가 자리 확인을 못 받으면 '자리 확인 없이 끝내기'로(서버의 '갠트리' 문장 대신), 연결이 없으면 시작할 때와 저장 실패 때 말하고, 기다리는 자리는 네 귀퉁이 안쪽(귀퉁이를 버튼·기다리는 자리 단계에도 그린다), 크기를 몰라 못 넘어가면 위에서 말하고, '기타'는 이름으로 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
2026-10-19 fix(app): LG 가전 찾기에서 찾은 것이 모두 이미 추가됐으면 새로 찾은 것이 없다고 말하고 '다시 찾기'를 늘 둔다 — 실패할 때만 있어 LG 앱에 새로 등록한 가전을 불러올 길이 없었다(실화면 10/19)
2026-10-19 fix(app): 본체 목록을 받을 때 내용이 같아도 판 번호는 본체를 따른다 — '본체 화면에 반영하기'가 본체 판을 올린 뒤 옛 판을 들고 있어 다음 지우기가 '다른 기기에서 먼저 변경'으로 거절되고 폰에서만 지워졌다(실화면 10/19)
2026-10-19 fix(app): 본체에 못 보낸 변경이 판 번호만 어긋나 거절되면 본체 판으로 한 번 더 보낸다 — 내용(이름·버튼·종류·정지 버튼·사진 위 자리)이 본 그대로일 때만, 지우기는 지울 때 본 정의를 함께 남긴다, '다시 하기'가 같은 옛 판을 되풀이해 끝나지 않고 지운 가전이 본체에 남았다(실화면 10/19)
2026-10-19 fix(app): 같은 이름 경고의 예시를 적은 이름으로 — 인덕션을 적었는데 '예: 세탁기 2'라고 했다(실화면 10/19)
2026-10-19 fix(rpi): 단계 확인 뒤·보내기 전에 받은 정지면 ThinQ 명령을 보내지 않는다 — 보내기 직전 확인(실행기에 넘기기 전·조회 뒤 POST 직전 잠금 안)이 비상정지 걸림과 함께 이번 실행 정지 표시도 보고, 결과는 '멈춤·보내지 않음'
2026-10-19 fix(rpi4): 이 실행의 생존 신호만 감시 시각을 새로 적고, 실행 중 hello는 링크 끊김으로 멈춘다 — RPi5가 실행을 포기하고 다시 이은 뒤 오는 시계 탐침·hello가 버려진 실행을 살려 남은 버튼을 누르던 것(구동 정지, motion_link_lost)
2026-10-19 fix(rpi): 누름이 끝난 뒤 기록(사용 기록·이력·알림·상태 갱신) 고장을 로그로만 남긴다 — 성공한 실행이 '연결이 끊겨 눌렸는지 몰라요'로 기록되던 것, 컨트롤러 예외만 '눌렸는지 모름'
2026-10-19 fix(rpi): RPi4가 누르기 전에 분명히 거절한 실행(busy·estop_latched·motion_not_ready·대상 결속·hold_busy·dev_busy 등)은 보내지 않음·실패와 쉬운 이유로 남긴다 — '연결이 끊겨 눌렸는지 몰라요'와 보호자 '모름' 알림으로 적던 것
2026-10-19 fix(rpi4): 정지·알람·원점 없음(자동 원점 꺼짐)이면 누르기 전에 준비 안 됨('원점을 다시 잡아야 해요')으로 거절하고, 자동 원점이면 정지 뒤 새로 승인된 다음 실행이 원점부터 잡는다 — 정지 뒤 준비됐다며 받고 누를 때마다 실패하던 것, 정지된 그 실행 안 재홈은 여전히 없음, 개발자 원점 잡기는 연결 확인만
2026-10-19 fix(rpi): /stop이 단계 사이 정지 표시를 먼저 세우고 로컬 정지·노드 목록 고장을 따로 감싼다 — 앞의 호출이 예외를 올리면 정지 표시·다른 노드·ThinQ 정지가 빠지던 것
2026-10-19 fix(rpi): 응답 기한 초과 뒤 정지를 구동부 범위(scope=drive)와 그 실행 표지(run_ref)로 보낸다 — 맨 abort가 정지 버튼 위 대기 중인 RPi4에서 가전 정지 버튼을 누를 수 있던 것
2026-10-19 fix(rpi): ThinQ '보냄' 표시와 POST 사이에 다른 호출을 두지 않는다 — 상태 기억 지우기를 마지막 정지 확인 앞으로 옮겨, 그 틈의 정지가 '취소 못 함'을 듣고도 명령이 나가던 것을 '보내기 전 취소'로
2026-10-19 fix(rpi): ThinQ 결과의 실행 환경(실제/연습)을 명령 시작 때 그 가전의 값으로 정한다 — 확인 조회 중 실제↔연습으로 다시 묶이면 결과가 바뀐 값으로 적히던 것
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2026-10-19 fix(rpi): 카드의 '다음부터도 자동으로' 허용이 그 사이 지우거나 끈 규칙을 되살리지 않게 — 읽은 규칙을 철회와 같은 잠금 안에서 그대로인지 보고 저장(검토 10/19 #2)
2026-10-19 fix(rpi): 자동 실행의 같은 사건 키에 RPi4 시계 식별자를 넣음 — RPi4를 다시 켠 뒤 같은 끝 시각으로 온 진짜 새 사건을 '이미 처리함'으로 막지 않게, 옛 프레임은 예전 키 그대로(검토 10/19 #6)
2026-10-19 fix(rpi): 루틴이 첫 구간의 끝을 그 실행 자신의 기록으로 기다림 — 끝난 뒤 다른 실행이 먼저 시작되면 마지막 실행 번호가 넘어가 '됐는지 몰라요'로 끝나던 것(검토 10/19 #3)
2026-10-19 fix(rpi): 루틴 맨 앞 안내를 첫 장치 구간을 보내기 전에 알림함에 남김 — 동기 실행이면 첫 구간이 끝난 뒤에야 남던 것(검토 10/19 #5)
2026-10-19 fix(rpi): 시각 루틴 회차는 카드·자동 실행 결과가 난 뒤에 '띄웠다'로 저장하고 예외면 되돌림 — 그 사이 예외로 카드 없이 회차가 영영 쓰이던 것(검토 10/19 #4)
2026-10-19 fix(rpi): 벽시계가 잠깐 앞으로 튀어도 앞으로 올 회차의 '건너뛰기'를 지우지 않음 — 정리는 회차 시각이 7일 지난 것만, 건너뛰기는 그 회차에서 쓰고 지움(검토 10/19 #7)
2026-10-19 fix(rpi): 내장 가전 보정 좌표와 정지·보관 위치를 한 트랜잭션으로 저장 — 뒤 저장이 실패하면 다음 기동이 새 정지 위치와 옛 보정을 함께 쓰던 것(검토 10/19 #8)
2026-10-19 fix(rpi): 가전 삭제 뒤 뒷정리가 실패해도 삭제는 성공으로 답함 — 이미 지운 가전에 500을 줘 '안 지워졌다'로 읽히고 다시 지우면 404던 것, 실패는 로그로(검토 10/19 #9)
2026-10-19 fix(rpi): 옛 앱용 '못 한 일 본 시각'을 못 한 일 종류의 알림으로만 셈 — 다른 종류의 늦은 시각으로 '봤다'를 넓히던 것(검토 10/19 #10)
2026-10-19 fix(rpi): 승인 카드를 만든 때의 대상 가전 설정(판 번호·보정 버전·ThinQ 기기)에 묶음 — 승인 전 다시 보정하거나 ThinQ 기기가 바뀌면 실행 시작 게이트 안에서도 대조해 재승인, 새 좌표·기기로 실행되던 것(검토 10/19 #1)
2026-10-19 fix(app): 본체 가전 정의에서 폰이 고치지 않는 필드(다이얼·누름 시간·동작 성격·목적·모르는 키)를 받은 그대로 다시 올림 — 동기화 PUT이 다이얼을 기본 누름 버튼으로, 목적을 빈 값으로 덮던 것(검토 10/19). mm 좌표·정지·보관은 본체가 이어받게 싣지 않음
2026-10-19 fix(app): 가전 추가·버튼 자리 다시 맞추기의 매핑 저장에 '내가 본 판'을 실음 — 새 가전은 방금 등록이 돌려준 판, 다시 맞추기는 연 가전의 판. 판을 싣지 않아 본체의 충돌 보호(409)를 건너뛰던 것, 거절되면 '다른 기기' 대신 다음 할 일을 말함(검토 10/19)
2026-10-19 fix(app): 새 가전 등록 뒤 버튼 자리 저장이 거절·실패하면 방금 올린 등록을 그 판으로 되돌림 — 자리 없는 가전이 본체에 남던 것, 되돌리지 못하면 남았을 수 있다는 말과 할 일을 덧붙임(검토 10/19)
2026-10-19 fix(app): 누름 장치가 어디 있는지는 본체가 준 기본 가전 판정으로 아는 만큼만 말함 — 대상 목록이 비었으면 '어느 가전 위에도 없어요', 모르면 '이 가전 위에 없어요'. 늘 '다른 가전 위에 있어요'라고 하던 것(검토 10/19)
2026-10-19 fix(rpi): 화면에 가는 본체 문장의 겹친 조사·속말을 쉬운 말로 — '보관 위치이(가) 프레임 밖이에요(331, 228mm)'·'갠트리 이동 범위(소프트 리밋)'처럼 처음 쓰는 사람이 못 읽던 것(첫 사용 점검 10/19)
    - 조사 고르기를 rpi/josa.py 하나로 모음(끝 받침·괄호·따옴표·숫자 읽는 소리, ㄹ 뒤 '로'). 루틴·ThinQ·알림이 쓰던 같은 함수는 이것을 씀
    - 가전 추가(사진 매핑)·정지 버튼/기다리는 자리 검증·자리 확인·사진 인식 안내를 폰 화면의 말(버튼판 네 귀퉁이·기다리는 자리·누름 장치)과 다음 할 일로 바꿈. mm 좌표·설정 이름은 화면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
2026-10-19 fix(rpi): 폰이 보낸 가전의 놓인 곳(location)을 저장하고 돌려줌 — 본체 사본으로 바꿀 때 방 이름이 사라지던 것
    - PUT /appliances/{id}에 선택 필드 location(40자까지). 보내지 않은 옛 폰의 저장은 저장된 값을 이어받고, 빈 문자열은 지움
    - GET /appliances·저장 응답에 location(없으면 null), DB 행에는 값이 있을 때만 실음(옛 행과 같은 모양)
2026-10-19 fix(rpi): 루틴이 자기 구간의 실행 기록을 번호로 찾음 — 한 번 확인하는 사이에 다른 실행까지 끝나면 '마지막 기록'이 그 실행이라 앞 구간 기록이 가려져 '됐는지 몰라요'로 끝나던 남은 경합(검토 10/19 #3 후속)
    - 실행 서비스가 최근 32건의 기록을 실행 번호별로 남기고 run_record(job_id)로 줌(마지막 기록과 같은 잠금 안에서 함께 바꿈)
    - 루틴 실행기 _await_job이 번호별 기록을 먼저 보고, 없는 옛 서비스면 종전대로 마지막 기록을 봄
2026-10-19 fix(app): 본체가 누를 장치가 없다고 판정한 가전은 상세 맨 위에 쉬운 말·누름 장치가 있는 곳·할 일을 먼저 보이고 '누를까요?'를 묻지 않음 — 폰에서 추가한 가전은 이 폰 저장분에 판정이 없어 물은 뒤에야 412로 거절되던 것. 자리 확인 거절('갠트리에 연결되지 않았')도 누르기까지 안 된다고 말함(검토 10/19)
2026-10-19 fix(app): 폰이 추적하지 않는 실행(키오스크·루틴·정지 버튼 위 대기)을 음성 '멈춰'로 멈추면 정지 단계 문장을 '듣는 중' 줄 자리에 잠시 보임 — 아무것도 안 보여 멈추라고 갔는지 몰랐던 것, 못 보냈거나 답이 없으면 그렇다고 말함(검토 10/19)
2026-10-19 fix(app): 앱 기본 문구를 한국어로(SDK 동봉 flutter_localizations) — 화면 낭독이 뒤로 가기·지우기·닫기를 'Back'·'Delete'·'Dismiss'로 읽던 것(접근성 검토 10/19)
2026-10-19 fix(app): 다른 폰이 없어도 나오는 두 문장을 중립으로 — '다른 폰에서 바꾼 것이 있어' → '본체에 저장된 내용과 달라서', '다른 폰에서 지웠거나' → '지워졌거나 이 폰이 목록을 아직 못 받았을 수'(검토 10/19)
2026-10-19 fix(app): 자리 확인 거절을 지금 본체 문장('이 가전 위에는 누름 장치가 없어…')으로도 알아봄 — 본체 쉬운 말 바꾸기(c4c6f106) 뒤 옛 '갠트리' 문장만 찾아 '처음 누를 때 지켜봐 주세요'로 떨어지던 것
2026-10-19 fix(app): 가전 등록·동기화 PUT에 사용자가 적은 방(location)을 실음 — 본체 사본으로 바꿀 때 방 이름이 사라지던 것
    - registerAppliance·registerApplianceStrict 둘 다 location을 늘 싣는다. 비우면 빈 문자열로 보내 본체 값도 지운다(빼면 본체가 옛 방을 이어받음)
    - 옛 본체는 모르는 키를 무시한다(등록 요청 모델이 extra를 막지 않음)
2026-10-19 fix(app): 실행 상태 화면 낭독 문장에 마침표가 겹치지 않게 — '…누르지 않았어요.. 됐어요'처럼 마침표로 끝난 문장 뒤에 '. '를 또 붙이던 것(에뮬레이터 점검 10/19)
2026-10-19 fix(app): 가전 편집기의 방 입력을 20자까지로(가전 추가 마법사와 같게) — 본체가 40자 넘는 방을 거절(422)해 길게 적으면 등록·동기화가 계속 실패하던 것
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2026-10-19 fix(rpi): 모션 응답을 기다리는 사이 정지가 오면 늦은 ok를 성공으로 받지 않고 STOPPED 유지 — 정지 뒤 도착한 같은 id의 ok로 READY가 되어 재홈을 건너뛰던 것(검토 10/19)
2026-10-19 fix(rpi): 대상 없는 실행도 좌표·보정 버전·버튼 성질·정지 대기 계획·상태 표시를 내장 갠트리 가전으로 잡음 — 누름 장치 판정만 전자레인지로 풀고 좌표는 비워 좌표가 필요한 실제 실행 대상이 좌표 없이 받던 것(검토 10/19)
2026-10-19 fix(rpi): 여러 단계 실행이 정지로 남은 단계를 보내지 않으면 그 실행의 /status·이력을 '멈춤·보내지 않음'으로 함께 바꾸고, 보내지 않은 단계는 표시 대상·경로를 바꾸지 않음 — 실행 기록에만 남아 /status가 첫 단계 성공·직전 실행을 보이던 것(검토 10/19)
2026-10-19 fix(rpi): ThinQ 단계가 시작 게이트에서 본 기기 ID를 들고 가 보내기 바로 앞까지 같은 연결인지 다시 봄 — 그 사이 연결을 지우거나 다른 기기로 바꾸면 지워진·옛 기기나 승인하지 않은 기기로 보내던 것(검토 10/19)
2026-10-19 fix(rpi): 대상 없는 실행의 내장 갠트리 가전 풀이를 가전 개념이 있는 구성에만 — 레지스트리 없는 구성은 상태 대상이 종전대로 비어 있음(앞 커밋 보완)
2026-10-19 fix(rpi): 루틴 정지는 그 루틴 구간의 실행일 때만 장치를 멈춤 — 구간이 끝난 뒤 순서기가 알아채기 전에 시작된 상관없는 실행에 긴급 정지를 보내던 것(검토 10/19)
2026-10-19 fix(rpi): 사이클 끝 판정에서 끊김이 확정 전 운전 후보도 버림 — 후보 뒤 끊김을 지나 다시 ≥운전 하한 샘플이 오면 보지 못한 시간으로 운전 확정·가짜 가열 종료가 나던 것(검토 10/19)
2026-10-19 fix(rpi): 전력 동작 확인에서 유지 확인 중 샘플 끊김이 max_sample_gap_s를 넘으면 유지를 다시 셈 — 높음·CT 끊김·높음 두 샘플로 시작 확정(완료 확정)이 나던 것(검토 10/19, 기본 0.5초는 추측/측정 필요)
2026-10-19 fix(rpi): 확인 주행이 일반 실행과 같은 기계 제어권 중재자를 주행 내내 잡음 — 실행 중 여부를 본 뒤 중재자 밖에서 돌아 그 사이 시작한 일반 실행과 같은 모션을 동시에 움직일 수 있던 것(검토 10/19)
2026-10-19 fix(rpi4): 확인 주행에도 실행과 같은 생존 신호·링크 감시 — 확인 주행은 heartbeat를 보내지 않고 RPi4도 감시를 켜지 않아 링크가 끊겨도 RPi4가 계속 움직이던 것(검토 10/19, 선택 필드 heartbeat_s라 옛 판과 호환, RPi4·RPi5 같은 커밋 배포)
2026-10-19 fix(rpi): 자동 실행 규칙의 정지 뒤 되돌리기·무효화 끄기를 전송권 잠금 안 비교 후 저장으로 — 읽어 둔 옛 사본을 무조건 저장해 그 사이 끝난 삭제를 되살리거나 바꾼 값·새 허용을 덮던 것(검토 10/19)
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2026-10-19 fix(rpi): 루틴 정지의 내 실행 확인과 긴급 정지 등록을 실행 서비스 잠금 하나 안에서 — 상태를 읽고 잠금을 놓은 뒤 정지에서 다시 잡아 그 사이 루틴 구간이 끝나고 시작된 다른 실행을 멈출 수 있던 것(검토 10/19, stop_if_owned 추가·정지 의미는 그대로)
2026-10-19 fix(rpi): 확인 주행(자리 확인)이 제어권을 잡고 있을 때 개발자 세션 시작 거절을 일반 실행과 같은 execution_busy로 — '이전 세션의 정지를 정리하는 중'(stopping)으로 알리고 상태도 쉬는 중으로 보이던 것(검토 10/19)
2026-10-19 fix(rpi): 확인 주행이 제어권을 잡고 있을 때 중재자 거절 문장을 '자리 확인이 진행 중'으로 — '일반 실행이 진행 중'이라 무엇이 도는지 알 수 없던 것(검토 10/19)
2026-10-19 fix(app): 본체에서 지운 가전을 폰에서도 빼고 그 가전의 대기 작업을 버림 — 본체 API로 지운 세탁기·인터폰이 폰에 '설정이 남았어요'·'본체에 보낼 것 N건'으로 영영 남고 고치기가 409로 매번 거절되던 것(본체가 본 적 있는 가전만, 폰에서만 만든 가전은 그대로)
2026-10-19 fix(app): 실패·확인 못 함 결과는 본 사실 한 문장 뒤 할 일 한 가지를 크게, 다시 하기 주의는 늘 보이고 나머지는 '더 볼 것' 뒤로 — 결과 문장 전체와 근거 줄을 한꺼번에 늘어놓아 눈이 어둡거나 나이 든 사용자에게 많던 것(심사 의견 10/19, 볼 것은 키오스크 첫 줄과 같게, 화면 읽기는 전부)
2026-10-19 fix(kiosk): 확인 못 함 순서 안내는 할 일 한 가지만 크게 먼저, 나머지는 '더 볼 것' 뒤로 — 가전 화면·누름 장치 자리·손으로 누르기를 한꺼번에 보여 많던 것(심사 의견 10/19, 정지 확인 못 함 안내는 안전이라 접지 않음, 화면 읽기는 모든 단계)
2026-10-19 fix(app): 루틴 줄 표지를 줄이고 켜진 자동(옅은 면·번개)과 오늘 건너뜀(흐린 테두리·빈 달력)을 모양으로 가름 — 같은 테두리 글자가 색으로만 갈리고, 스위치 '꺼짐'과 같은 뜻의 '꺼 둠' 표지가 겹치던 것(낭독은 그대로)
2026-10-19 fix(kiosk): 정지(/stop) 응답의 4xx·5xx를 실패로 — 본체가 거절한 정지를 보낸 것처럼 보이던 것, 실행 화면은 정지 단추를 그대로 두고 '정지가 닿지 않았어요'·닿으면 '멈추는 중'을 띠로 말한다(검토 10/19)
2026-10-19 fix(app): 재시작 복원이 주소를 기다리는 사이 새 실행이 시작되면 옛 job을 이어붙이지 않음 — BLE 실행은 HTTP job 표시를 남기지 않아, 늦게 준비된 주소가 옛 job으로 새 실행 화면을 덮고 정지는 옛 job을 겨누던 것(검토 10/19, 실행 세대 번호·대기 구독 닫기)
2026-10-19 fix(app): BLE 실행 프레임은 이 폰이 BLE 실행을 시작한 뒤에만, 결과는 실행 번호가 정확히 같을 때만 받음 — 쉬는 화면에서 늦게 온 다른 실행의 결과·센서가 '끝났어요'·'하는 중'으로 바꾸던 것(검토 10/19)
2026-10-19 fix(kiosk): 실행 접수에 관문·세대 — 직접 누르기 확인을 두 번 누르면 요청이 둘 나가 둘째의 409가 실행 중인 첫 실행을 정지 화면 없는 실패 화면 뒤에 숨기던 것, 확인 창은 첫 누름에서 바로 닫고 응답은 자기 세대일 때만 화면·job을 바꾼다(검토 10/19)
2026-10-19 fix(app): 블루투스 정지를 못 보내면 설정된 본체로 정지를 보내고, 그것도 못 보내면 못 보냈다고 말하며 실행 화면을 남김 — 끊긴 블루투스의 예외가 새어 나가 아무 문구 없이 실행이 계속되고, 연습 연결은 보낸 것이 없는데 '멈추라고 했어요'라고 하던 것(검토 10/19)
2026-10-19 fix(kiosk): 접수 응답(job_id) 전에 누른 정지를 job이 오는 대로 다시 보낸다 — 실행 화면이 /approve·/execute-buttons 응답보다 먼저 떠, 그 사이 정지가 본체에 실행이 없을 때 닿고 뒤늦게 접수된 실행은 그대로 돌던 것, 그동안 '멈추는 중'(검토 10/19)
2026-10-19 fix(app): 가전 동기화는 끝난 작업만 지금의 대기열에서 빼고, 보내는 사이 저장한 변경도 같은 패스에서 이어 보냄 — 앞 작업 응답을 기다리는 사이 저장한 변경을 동기화가 처음 본 목록으로 대기열을 바꿔 써 기기 저장에서도 잃던 것(검토 10/19, 본체에서 지운 가전 걸러내기도 지금 대기열 기준)
2026-10-19 fix(app): 판만 어긋났는지와 병합의 '같은 정의'를 본체와 맞추는 필드 전부(놓인 곳·종류·조작 경로·버튼·사진 위 자리·정지 버튼·목적)로 견줌 — 이름·격자·버튼만 봐서 다른 기기가 바꾼 놓인 곳·목적을 판만 받고 옛 화면에 두거나 새 판으로 옛 내용을 다시 보내 덮던 것(검토 10/19, 사진·판·준비 상태는 제외)
2026-10-19 fix(app): 가전 고치기(PUT)가 성공하면 본체가 돌려준 판을 대기열에서 빼기 전에 받아 둠 — 판을 버려, 이어진 목록 조회가 실패하면 다음 고치기가 이 폰이 방금 한 고치기와 충돌하던 것(검토 10/19, 같은 판 위의 이 폰 가전·뒤 작업만 판을 따라감, 내용은 그대로)
2026-10-19 fix(app): 직접 누르기에서 정한 시간 안에 결과를 못 보면 실패가 아니라 '아직 모름'으로 두고 그 job을 계속 지켜보며, 같은 버튼은 확인을 받은 뒤에만 다시 보냄 — 45초 뒤 실패 표지로 버튼이 풀려 아직 돌거나 이미 눌린 버튼을 한 번 더 누를 수 있던 것(검토 10/19)
2026-10-19 fix(app): 본체에서 지운 가전을 가리키는 루틴은 내부 ID 대신 '지운 가전'으로 보임 — 루틴 목록·홈 루틴 칸·루틴 편집·'끝나면' 조건에 'washer · 누를 버튼 3개'처럼 가전·버튼 ID가 그대로 나오던 것(평가 10/19, 편집의 버튼은 '버튼 N개', 지운 루틴은 '앞 루틴이 끝나면')
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2026-10-19 fix(app): 루틴 탭에서 건너뛴 회차 표지는 이름 옆이 아니라 '되돌리기'와 한 줄('지금 하기' 위) — 이름 옆 '오늘은 건너뛰어요'·'자동 꺼짐'이 두 줄로 쌓이고 '되돌리기'가 '지금 하기' 아래 혼자 떨어져 무엇을 되돌리는지 몰랐던 것(평가 10/19, 표지·낭독은 그대로)
2026-10-19 fix(rpi): 실행기 시작·모션 포트 재연결 뒤에는 모션 보드의 homed 보고를 믿지 않고 원점을 다시 잡은 뒤에만 준비됨 — 보드 전원은 그대로인 채 실행기만 다시 시작했거나 포트만 다시 붙으면 그사이 손으로 옮긴 캐리지를 원점 확인 없이 저장 좌표로 움직이던 것(검토 10/19)
    - 자동 원점이 켜져 있으면 새로 승인된 다음 실행의 첫 누름이 원점부터, 꺼져 있으면 준비 안 됨('원점을 다시 잡아야 해요')
    - 포트를 잃었던 그 실행 안에서는 여전히 재홈하지 않음(_reset_mid_run 그대로), 개발자 원점 잡기는 그대로
    - 회귀 시험 5건(수정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
2026-10-19 fix(kiosk): 처음 화면 건너뛴 다음 루틴의 '되돌리기'를 머리말 '○○ 루틴 · 오늘은 안 해요' 끝에 붙임 — 시각·이름 줄 아래 혼자 떨어져 무엇을 되돌리는지 몰랐던 것(평가 10/19 실패널, 작은 회색 굵은 글자·누르는 높이 48 그대로, 폭이 모자라면 종전 자리, 골든 kiosk15_idle_next_skipped 갱신)
2026-10-19 fix(app): 버튼 누르기 결과를 last_outcome으로 가름 — last_status만 보고 사람이 멈춘 것·스스로 멈춘 것·못 한 것·확인 못 한 것을 모두 같은 빨간 '눌렸는지 몰라요'로 보이던 것(검토 10/19, resultKindOf)
2026-10-19 fix(rpi): 이미 접수한 제안 승인을 다시 보내면 같은 실행 번호를 200으로 돌려줌 — 승인이 소비되고 실행이 접수됐는데 응답만 잃으면 재시도가 409만 받아 job_id를 알 수 없던 것(검토 10/19 A, 접수 뒤 기록 실패가 승인을 되돌리지 않게)
2026-10-19 fix(rpi): 실행 스레드 시작이 실패하면 시작 게이트('실행 중'·제어권)를 한 잠금 안에서 되돌리고, 루틴 순서기 스레드 시작 실패는 루틴을 멈춰 끝내며 접수한 실행 번호를 그대로 돌려줌 — 서비스가 영영 바쁨으로 남거나 이미 접수한 승인이 되돌려지던 것(검토 10/19 B)
2026-10-19 fix(rpi): 루틴 맨 앞 안내를 실행 시작 게이트를 통과한 뒤에만, 첫 구간을 보내기 전에 남김 — 접수 전에 남겨 첫 구간이 거절(바쁨·준비 전·승인 바뀜)되면 안내만 남고 다시 승인할 때마다 같은 안내가 쌓이던 것(검토 10/19 C)
2026-10-19 fix(rpi): /acks 저장이 실패하면 응답에 persisted: false를 실음(200 유지, 저장소 없으면 null) — 저장 실패를 삼켜 '저장됨'과 구별할 수 없던 것(검토 10/19 D, GET 응답 모양은 그대로)
2026-10-19 test(rpi): 이미 접수한 제안의 재승인이 409 대신 같은 실행 번호를 받는 계약으로 리허설·수정 승인 시험을 맞춤(검토 10/19 A)
2026-10-19 fix(kiosk): 접수 응답을 잃으면 '시작됐을 수 있어요'로 정지 단추를 두고 본체에서 실행을 이어받으며, 접수 전에 누른 정지는 그 실행이 끝나거나 본체가 쉴 때까지 다시 보냄
    /approve·/execute-buttons 응답이 시간 초과·끊김·5xx로 오지 않으면 바로 결과 화면으로 가 정지 단추가 사라졌고,
    접수 전에 누른 정지는 성공 응답에서만 한 번 다시 보냈다 — 본체가 이미 접수했으면 짧은 실행이 정지를 무시하고 끝날 수 있었다.
    이어받기(_toExecuting)도 남은 정지를 지웠다(검토 10/19 코어 4차 #1·#3 키오스크).
    - 분명한 거절(4xx)만 종전처럼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
2026-10-19 fix(kiosk): 지난 일 '확인'을 본체가 적지 못하면(POST 실패, 본체 목록에도 없음) 화면이 먼저 지운 지난 일 줄을 되살림
    화면은 '확인'을 누르는 순간 지난 일 줄을 지웠고, POST /acks가 실패하면 본체 목록을 다시 읽어 표시만 거뒀다 —
    지운 줄은 되살릴 길이 없어 키오스크만 '확인함'이고 폰은 여전히 못 한 일이었다(검토 10/19 코어 4차 #11 키오스크).
    누를 때 보인 지난 일을 들고 있다가, 본체 목록을 읽었는데 그 답이 없을 때만 되살린다. 목록을 못 읽으면(옛 본체·끊김) 종전처럼 화면에서만 닫는다.
2026-10-19 fix(app): 버튼 누르기 접수 답이 사라지면 '모름'으로 두고 같은 버튼은 확인 뒤에만, 정지는 그 본체로 남김 — 시간 초과·연결 끊김을 '못 함'으로 보고 버튼을 풀어, 본체가 이미 누르기 시작한 버튼을 확인 없이 또 보낼 수 있었고 정지 띠도 없던 것(검토 10/19, 상태로 돌고 있는 실행을 찾으면 이어서 봄)
2026-10-19 fix(app): 제안 승인 응답을 잃으면 '시작됐는지 몰라요'로 정지를 남기고 같은 승인을 다시 물어(이미 승인된 카드면 본체가 같은 실행 번호를 줌) 또는 상태로 그 실행을 이어서 봄 — '본체에 보내지 못했어요'라고 하고 본체가 이미 시작한 실행을 놓쳐 멈출 길이 없던 것(검토 10/19)
2026-10-19 fix(app): 블루투스로 정지를 보낸 뒤에도 같은 실행의 결과가 올 때까지 '모름' 단계로 정지 띠·음성 정지를 남김 — 정지 프레임이 건너간 것만으로 끝난 단계가 돼, 정지가 본체까지 닿지 않았어도 다시 멈출 길이 없던 것(검토 10/19)
2026-10-19 fix(app): 남은 실행에 받은 본체 주소를 함께 남기고 이어서 보기·정지는 그 본체로만 함 — 본체 주소를 바꾼 뒤 앱을 다시 열면 옛 본체의 실행을 새 본체로 이어 보고, 모름이 되면 새 본체에 전체 정지를 보내 상관없는 실행을 멈출 수 있던 것(검토 10/19, 옛 기록은 지금 본체로)
2026-10-19 fix(app): 지난 본체를 모르거나 다른 본체 같으면 본체에 없는 맞춘 가전·대기 작업을 지우지 않음 — 주소 기록이 없으면 같은 본체로 쳐 새(빈) 본체에 붙자마자 모두 지웠고, 첫 맞춤이 받아 온 그 본체 가전이 다음 맞춤에서 '겹침'으로 잡혀 결국 지웠던 것(검토 10/19, 그 주소는 '모름'으로 적어 두고 맞춘 가전이 모두 본체에 있게 되면 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
2026-10-19 fix(app): 가전 대기열을 줄마다 따로 읽어 멀쩡한 변경은 남기고 못 읽는 줄은 따로 옮겨 둠 — 한 줄이 깨지면 전체 읽기가 멈춰 빈 대기열로 시작했고, 다음 변경 저장이 그 빈 목록으로 덮어써 보내지 못한 고치기·지우기를 모두 잃던 것(검토 10/19, 옛 삭제 옮기기 실패도 읽기를 막지 않게)
2026-10-19 fix(app): '확인함'은 보내기 전에 기기에 남기고 본체가 저장했다고 답한 뒤에만 지움 — 기록 화면이 보내기 전에 '봤다' 대기를 내려 보내기가 실패하면 확인이 사라졌고, 본체가 저장하지 못했다고 답해도(persisted: false) 그대로 끝났던 것(검토 10/19, 다음 알림 조회 때 다시 보냄, 실행은 최근 200건)
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2026-10-19 fix(rpi): 제안 승인을 접수하는 동안 다시 보낸 승인이 기다렸다가 같은 실행 번호를 받게 함 — 승인 소비와 영수증 사이에 틈이 있어 접수 중 재요청은 409('이미 승인')만 받아 실행 번호를 알 수 없던 것(검토 10/19, 접수 중 표시를 승인 소비와 같은 잠금에 걸고, 접수 실패면 표시를 거두고 기다리던 요청에 같은 오류, 카드는 다시 승인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
2026-10-19 fix(app): 실행 요청(승인·말·버튼)은 보내기 전에 '보내는 중'으로 들어가 정지 띠를 남기고, 그사이 누른 정지는 job_id가 오거나 복구가 실행을 찾으면 한 번 더 보냄 — 접수 답을 기다리는 동안(최대 시간 초과까지) 실행 상태가 없어 본체가 이미 움직여도 멈출 길이 없었고, 접수보다 먼저 닿은 정지는 '하던 일 없음'으로 끝났던 것(검토 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
2026-10-19 fix(app): 말로 본체에 보낸 뒤 답 없이 실패하면 블루투스로 같은 말을 다시 보내지 않고 '모름'으로 두어 정지를 남김 — 응답 받는 중 끊김(ClientException) 등은 본체가 이미 받아 눌렀을 수 있는데 '닿지 못함'으로 보고 블루투스로 또 보내 두 번 눌리거나 켠 것을 도로 끌 수 있던 것(검토 10/19, 같은 요청을 가려낼 요청 번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
2026-10-19 fix(app): 가전 상세의 누르기도 답이 없으면 '보내지 못했어요' 대신 '모름'으로 정지를 남기고 같은 버튼은 다시 누를지부터 물음 — 본체가 받아 눌렀는데 답만 잃으면 정지 없이 다시 누를 수 있어 켜기·끄기 버튼이 도로 꺼질 수 있던 것(검토 10/19, 수동 조작 화면과 같은 규칙)
2026-10-19 fix(app): '확인함' 대기열의 더하기·저장·보내기를 한 줄로 세움 — 홈의 '못 한 일 봤다'와 기록 화면의 '실행 봤다'가 거의 함께 불리면 둘 다 옛 대기열을 읽고 서로 다른 목록을 저장해 한쪽 확인이 사라졌고, 보내는 중에 더한 확인은 보내지도 않고 실패로 끝났던 것(검토 10/19, 기기에서 한 번 읽은 뒤에는 메모리 대기열이 기준)
2026-10-19 fix(app): 가전 추가의 등록·자리 저장이 답 없이 실패하면 본체 목록에서 이 가전을 찾아 맞춘 뒤 알리거나 되돌림 — 본체는 해 놓고 답만 잃으면 실패로 알리고 정리도 건너뛰어 본체에만 자리 없는 가전이 남거나, 자리를 저장한 가전을 폰이 받지 않았던 것(검토 10/19, 등록이 있으면 이어서 자리 저장·저장됐으면 그 정의를 받음·아니면 본 판으로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
2026-10-19 fix(kiosk): 접수 응답을 잃은 실행을 요청 번호로 찾아 그때 도는 남의 실행을 이어받지 않게 함 — 응답이 끊기면 /status에서 도는 실행을 무엇이든 내 것으로 보고 그 결과를 보이며 접수 전에 누른 정지를 그 실행에 다시 보냈던 것(검토 10/19 코어 5차 #3, 승인·직접 누르기마다 client_request_id, GET /jobs/b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
2026-10-19 fix(kiosk): 내 실행의 진행·결과를 실행 번호로 물어(GET /jobs/{job_id}) 그사이 다른 실행이 끝나도 내 결과를 잃지 않게 함 — /status의 마지막 한 건만 보아 내 실행이 끝난 뒤 폰·자동 실행이 시작해 끝나면 몇 번 뒤 '어떻게 됐는지 몰라요'로 빠졌던 것(검토 10/19 코어 5차 #4, 비상정지·대기·자동 실행·정지 재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
2026-10-19 fix(kiosk): '확인'·'움직였어요/안 움직였어요' 답을 본체가 적을 때까지 지키고 연결이 돌아오면 다시 보냄 — POST /acks가 한 번 실패하면 답을 버려 끊긴 동안 답한 확인이 본체에 끝내 남지 않았고, 연결이 돌아오면 가전 칸 '!'과 폰 경고가 다시 떴던 것(검토 10/19 코어 5차 #9, POST 성공 또는 GET /acks에 같은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
2026-10-19 fix(app): 실행 요청(승인·말·버튼·가전 말)에 요청 번호(client_request_id)를 싣고, 접수 답을 잃으면 그 번호로 본체에 내 실행을 물음 — 답을 잃은 뒤 그냥 돌고 있는 실행을 따라가 자동 실행·다른 단말의 실행을 내 것으로 보이고 정지로 그 실행을 멈출 수 있던 것(검토 10/19, GET /jobs/by-request — 찾으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
2026-10-19 fix(app): 내 실행의 진행·결과를 실행 번호로 물어(GET /jobs/{job_id}) 그사이 다른 실행이 끝나도 내 결과를 잃지 않게 함 — /status의 마지막 한 건만 보아 내 실행이 끝난 뒤 키오스크·자동 실행이 시작해 끝나면 폴링 몇 번 뒤 '어떻게 됐는지 몰라요'로 빠졌던 것(검토 10/19 코어 5차 #4, 실행 화면·정지 확인 단계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
2026-10-19 fix(app): 음성 화면의 말 예시를 LG 가전 종류에 맞춤 — 공기청정기 화면에도 '예: 즉석밥 데워줘'가 보여 받지 않는 말을 가르치던 것(첫 사용자 검토 10/19 #10, 공기청정기 '켜 줘'·세탁기 '세탁 시작해 줘', 이름 없는 '켜 줘'는 본체가 받지 않아 종류 이름을 붙임)
2026-10-19 fix(app): 옛 본체가 말을 못 알아들으면(422) 그 말을 지우고 '다시 말하기'·'버튼으로 하기'를 화면에 남김 — 금방 사라지는 안내만 띄우고 못 알아들은 말이 '이대로 실행' 앞에 그대로 남아 같은 말을 또 보내기 쉬웠던 것(첫 사용자 검토 10/19 #12, 새 본체의 후보 안내는 그대로)
2026-10-19 fix(app): 첫 안내의 단추를 '본체 연결하기'로 바꿔 연결 화면을 열고, 연결을 마치고 돌아와야 홈으로 감 — '본체 연결'을 말하면서 '시작하기'는 연결 없이 홈으로만 가 처음 쓰는 사람이 연결한 줄 알았던 것(첫 사용 검토 10/19 #1, 연결 화면 '확인'이 연결을 마쳤다고 알림, 본체가 아직 없으면 '나중에 연결할게요'로 종전처럼 홈)
2026-10-19 fix(app): 폰 연결 화면은 'QR을 휴대폰 카메라로 찍어 주세요'부터 말하고 본체 주소·여섯 자리 코드 칸은 'QR을 찍을 수 없나요?'를 눌러야 펼침 — 본체 주소와 '여섯 자리 코드 또는 QR 연결 주소'를 한꺼번에 물어 처음 쓰는 사람이 무엇을 적을지 몰랐던 것(첫 사용 검토 10/19 #8, QR로 받았으면 '연결 요청하기'만, 적은 값이 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
2026-10-19 fix(app): 잠시 쉬기 줄과 시간 고르기 창에 '직접 하기와 정지는 그대로예요.'를 함께 적음 — '묻지도, 자동으로 하지도 않아요'만 있어 정지까지 막히는 줄로 읽히고 조용한 시간 설명과도 달랐던 것(첫 사용자 검토 10/19 #14)
2026-10-19 fix(app): 사진 위 버튼·정지·기다리는 자리 표시의 누르는 자리를 48×48로 넓힘(그림 크기는 그대로) — 버튼 44·기다리는 자리 40이라 접근성 최소 48dp보다 작았던 것(첫 사용 검토 10/19 #16)
2026-10-19 fix(app): 잠시 쉬기 시간 고르기 창을 밀어 볼 수 있게 함 — 큰 글씨(200%)·작은 화면에서 건너뛰는 일이 여럿이면 창이 넘쳐 아래 선택지와 '그만 쉬기'가 잘렸던 것(첫 사용자 검토 10/19 #15)
2026-10-19 fix(app): 조용한 시간 줄에 '시간 바꾸기' 버튼을 보이게 둠 — 시각은 줄 전체를 눌러야 바뀌는데 보이는 것은 켜기 스위치뿐이라 처음 쓰는 사람이 기본 시각으로만 켰던 것(첫 사용자 검토 10/19 #13, 같은 시작·끝 시각 고르기를 엶, 스위치는 켜고 끄기만)
2026-10-19 fix(app): 가전 추가 첫 단계에서 본체와 연결되지 않았으면 다음으로 가지 않고 '본체 연결하기'로 연결 화면을 엶 — 연결이 없다는 말만 하고 넘어가게 둬 사진·귀퉁이·버튼을 다 고른 뒤 저장에서야 막혔던 것(첫 사용 검토 10/19 #5, 연결 화면에 다녀와도 찍은 사진과 적은 이름은 그대로, 연결되면 바로 다음으로)
2026-10-19 fix(app): 자동 실행 허용 시트에서 무엇을 허락하는지 한 문장으로 말함 — '다음부터 자동으로'를 묻는 자리에 '버튼 누르기는 매번 허락을 받아요'만 있어 무엇이 자동이 되는지 헷갈렸던 것(첫 사용자 검토 10/19 #18, 허락은 위에 적은 일에만·버튼 누르기는 매번 물어봄 — 본체가 누르기 자동 규칙을 받지 않으므로 누르기 루틴용 다른 시트는 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
2026-10-19 fix(app): 가전 추가에서 정지 버튼이나 기다리는 자리 없이 저장하려 하면 생기는 일(멈춰 달라고 해도 가전의 정지 버튼을 못 누름)을 말하고 묻고, 정지 단계 안내의 '나중에 정해도 돼요'를 뺌 — 안심시키는 말에 처음 쓰는 사람이 둘을 건너뛰고 가전이 도는 중에야 알았던 것(첫 사용 검토 10/19 #3, 막지는 않음: 켜고 끄는 버튼 하나뿐인 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
2026-10-19 fix(app): 사진 위 귀퉁이 표시를 화면 읽기에서 '1번 귀퉁이'로 읽음 — 가전 추가 화면은 '귀퉁이'라고 하는데 낭독만 '모서리 1'이라 사진 모서리로 읽힐 수 있던 것(첫 사용 검토 10/19 #4 중 말 맞추기만, 화면 읽기로 자리를 고르는 조작은 새 기능이라 하지 않음)
2026-10-19 fix(app): 묻지 않고 자동으로 하게 하는 길을 루틴 편집기와 빈 '자동 규칙' 탭에서 쉬운 말로 알림 — 실행 방식에 '물어보고 하기'·'알림만'뿐이고 빈 탭은 '할까요? 카드'라고만 해 길을 찾지 못했던 것(첫 사용자 검토 10/19 #2, 편집기는 본체가 자동 규칙으로 받는 모양 — 시각·물어보고 하기·LG 가전 한 단계 — 일 때만, 저장 직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
2026-10-19 fix(kiosk): 버튼 누르기 확인 창을 화면 읽기에도 창으로 — 색만 덮어 화면 읽기가 창 뒤 판 버튼까지 읽고 누를 수 있던 것(첫 사용 검토 10/19 #17, 뒤 판 읽기를 막고 이름 있는 한 화면으로 읽으며 처음 머무는 곳은 실물을 움직이지 않는 '그만두기')
2026-10-19 fix(kiosk): 눌렸는지 모를 때의 물음을 '전자레인지 화면·불빛·소리가 바뀌었나요?'로 — '움직였나요?'는 '30초'만 누른 뒤처럼 화면·불빛만 바뀌는 때에 무엇을 보고 답할지 헷갈렸던 것(첫 사용 검토 10/19 #11, 답 단추 '바뀌었어요 / 안 바뀌었어요', 골든 8장 갱신)
2026-10-19 fix(kiosk): 내 가전 판의 루틴 칸 아래 말을 '여러 버튼을 한 번에 맡기려면 휴대폰 앱에서 루틴을 만들어요'로 — 판의 버튼은 하나씩 묻고 하나씩 눌러 '30초 → 시작'이 확인·결과를 두 번 거치는데, 한 번 묻고 한 번에 맡기는 길(루틴)이 있다는 것을 몰랐던 것(첫 사용 검토 10/19 #6 중 길 알리기만, 판에서 여러 버튼을 골라 한 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
2026-10-19 fix(kiosk): 응답을 잃은 접수를 찾지 못하고 결과 화면으로 갈 때 남은 정지를 버린다 — 옛 본체(요청 번호 조회 없음)에서 세 번 쉬거나 통신이 오래 끊겨 포기해도 정지 표시가 남아, 20초 안에 폰·자동 실행이 시작한 남의 실행을 결과 화면이 이어받으면서 /stop을 보냈던 것(검토 10/19 코어 6차 #1)
2026-10-19 fix(kiosk): 잠시 쉬기 요청이 오가는 동안 다른 시간·끝내기·닫기를 막는다 — 응답 전에 30분과 1시간을 잇달아 누르면 요청이 겹쳐 먼저 끝난 응답이 창을 닫고 늦게 끝난 쪽 시간이 남았던 것(검토 10/19 코어 6차 #11, 뒤 화면으로 탭이 새지 않게 바탕 탭은 흡수)
2026-10-19 fix(kiosk): 잠시 쉬기를 보내지 못하면 창을 두고 '잠시 쉬기를 보내지 못했어요. 연결을 확인하고 다시 눌러 주세요.'를 알린다 — 통신 끊김을 삼키고 창을 닫은 채 아무 말도 하지 않았고, 본체 오류 응답(4xx·5xx)도 옛 서버처럼 받아들여 쉬는 줄 알았던 것(검토 10/19 코어 6차 #12 키오스크 쪽, 오류 응답은 KioskApiExc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
2026-10-19 fix(app): 늦게 온 옛 보냄의 답·답 없음이 새 보냄을 덮지 않게, 접수 답을 기다리는 사이 승인·버튼을 다시 보내지 않게 — 앞 요청이 늦게 끝나면 새 실행과 그 정지 대상이 사라지고, 늦은 답 없음은 보낸 적 없는 요청 번호를 지어 번호 조회를 막던 것(검토 10/19 core6 2)
2026-10-19 fix(app): 답을 모르는 보냄의 '다시 확인'도 요청 번호로 찾게 — 번호 조회를 몇 번 못 한 뒤 다시 확인을 누르면 전체 상태로 넘어가 자동 실행·다른 단말의 실행을 내 실행으로 잡고 정지가 그 실행을 겨누던 것(본체가 조회를 모른다고 답했을 때만 상태로, 검토 10/19 core6 3)
2026-10-19 fix(app): '다음부터도 자동으로' 승인에도 요청 번호(client_request_id)를 싣는다 — 답을 잃고 다시 물으면 첫 요청이 카드를 써 버려 404가 나고 이미 끝난 실행은 찾을 길이 없어 모름에 머물던 것(새 본체가 같은 번호에 같은 실행을 돌려주는 변경과 짝, 옛 본체는 필드를 무시, 검토 10/19 core6 4)
2026-10-19 fix(rpi): '이번에 실행하고 다음부터 자동으로' 승인에 재요청 영수증 — 선택 client_request_id를 받아 같은 번호의 재요청은 대기 중 제안 확인보다 먼저 같은 묶음 응답(job_id·rule·auto_allow)을, 번호 없는 재요청은 이미 접수한 실행 번호와 저장된 자동 허용 결과·지금 규칙 상태를 돌려준다 — 첫 요청이 제안을 소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
2026-10-19 fix(app): 가전 맞추기가 병합 조회 중에 쌓인 고치기를 놓치거나 본체 옛 내용으로 덮지 않게 — 패스가 대기열을 다 본 뒤 저장한 고치기는 그 패스의 답만 받고 보내지지 않았고, 병합은 패스 처음의 대기열로 견줘 방금 고친 가전을 덮었다(그 패스 뒤 한 번 더 돌고 병합은 지금 대기열·가전을 본다, 검토 10/19 core6 5)
2026-10-19 fix(app): 다시 맞추기의 답을 잃었을 때 본체의 자리가 보낸 자리와 같을 때만 저장된 것으로 받는다 — 판이 오르고 자리가 있기만 하면 그사이 다른 폰이 저장한 자리를 이 폰의 저장으로 받아 '저장했어요'로 넘어가던 것(사진 크기·귀퉁이·버튼 자리·기다리는 자리·정지 버튼을 견줌, 검토 10/19 core6 6)
2026-10-19 fix(app): 자리 확인 상태를 한 번에 하나만 묻고 멈춘 뒤 온 답은 받지 않는다 — 답을 기다리지 않고 0.8초마다 물어 요청이 겹쳤고, 끝남을 받고 멈춘 뒤 늦게 온 앞 답('하는 중')이 덮어 '끝내기'가 영영 막히던 것(검토 10/19 core6 7)
2026-10-19 fix(app): 폰 연결이 승인된 뒤 저장·연결 확인이 실패해도 기다림을 끝낸다 — 조회 타이머를 먼저 멈춘 뒤 던지면 넓은 catch가 삼켜 '기다리는 중'이 남고 다시 요청·입력이 모두 막히던 것(키를 저장했으면 연결된 화면으로, 못 했으면 새 코드로 다시 하라고 알림, 검토 10/19 core6 8)
2026-10-19 fix(app): 버튼 누르기 화면이 결과를 따로 묻지 않고 공용 실행 상태가 그 요청 번호로 끝내는 것을 본다 — 접수 답을 잃은 누름은 공용 상태가 요청 번호로 찾아 끝내도 '다시 누를까요?' 잠금이 풀리지 않았고(core6 9), 화면이 같은 job을 0.5초마다 또 묻다 45초 뒤에는 기한 없이 2초마다 물어 본체가 잊은 job을 끝없이 물었다(c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
2026-10-19 fix(app): 잠시 쉬기·그만 쉬기를 보내지 못하면 창을 두고 '보내지 못했어요. 연결을 확인하고 다시 눌러 주세요.'를 알린다 — 창을 먼저 닫고 기다려 통신 끊김·본체 거절 예외가 새고 아무 말 없이 끝나 쉬는 줄 알았던 것(본체가 받은 뒤에만 닫고 보내는 동안 다른 선택을 막음, 본체 주소가 없어도 보내지 못함으로, 홈 배너의 그만 쉬기도 같은 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
2026-10-19 fix(app): 버튼 누르기 화면의 같은 버튼 다시 보냄 잠금을 공용 실행 상태에서 읽는다 — 잠금이 화면 안에만 있어 나갔다 다시 들어오면 아직 모르는 누름의 같은 버튼을 확인 없이 새 요청 번호로 또 보냈던 것(요청 번호·가전·버튼 이름으로 찾고, 다시 들어오면 '아직 결과를 몰라요'를 다시 말하고 끝나면 결과를 말함, 앞 누름의 접수 답을 기다리는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
2026-10-19 fix(rpi): 루틴 승인의 첫 실행 번호를 GET /jobs로 물으면 루틴 전체 수명과 결과를 돌려준다 — 첫 구간만 끝나도 '끝남·성공'으로 보여 뒤 구간이 실패·정지해도 클라이언트가 루틴이 다 된 줄 알던 것(루틴이 도는 동안 running·finished=false, 끝나면 모든 구간이 성공일 때만 성공, routine_run_id 등 추가, /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
2026-10-19 fix(rpi): 폰 연결 결과 조회가 키를 준 뒤에도 받았음 알림 전까지 같은 키를 돌려준다 — 첫 응답에서 토큰을 지워 그 응답을 잃은 폰은 영영 404였던 것(선택 POST /pair/ack로 일찍 끝냄, 창 5분·폰 하나·코드 5회 제한은 그대로, 허브 화면은 한 번 보냈으면 consumed, 계약을 pairing.py 머리에, 검토 10/19)
2026-10-19 fix(rpi): ThinQ 직접 명령이 선택 client_request_id를 받아 같은 번호로 다시 보내면 같은 job_id를 돌려준다 — 접수 응답을 잃은 폰이 다시 보내면 같은 명령을 한 번 더 보냈고 자기 실행 번호도 찾지 못하던 것(실행 경로와 같은 영수증 장부, GET /jobs/by-request로도 찾음, 번호 없으면 종전 그대로, 검토 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
2026-10-19 fix(app): 루틴 승인의 실행을 루틴 전체가 끝날 때까지 하는 중으로 보이고 정지는 그 루틴만 멈추는 경로로 보낸다 — 본체가 루틴 첫 번호를 루틴 전체 수명(running·finished=false)으로 알려도 폰은 지금 구간을 말하지 않았고 구간 칸 수를 루틴 칸에 실었으며, 정지는 늘 본체 전체 /stop이었던 것(routine_run_id가 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
2026-10-19 fix(app): 폰 연결 키와 주소를 이 폰에 저장한 뒤 본체에 받았음(POST /pair/ack)을 알린다 — 본체가 받았음 알림 전까지 같은 키를 돌려주게 됐는데 폰이 알리지 않아 창이 끝날 때까지 그 토큰으로 키를 다시 받을 수 있었던 것(저장 못 했으면 알리지 않음, 옛 본체 404·끊김은 무시, 결과 응답을 잃으면 같은 토큰으로 다시 물어 키를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
2026-10-19 fix(kiosk): LG 가전 직접 조작에 요청 번호를 싣고 응답을 잃으면 그 번호로 찾는다 — 응답을 잃은 조작은 '됐는지 몰라요'만 말해 본체가 이미 보낸 명령의 실행 화면(정지·결과)을 잃었고, 확인 단추를 빨리 두 번 누르면 같은 조작이 두 번 나가던 것
    - 조작마다 새 client_request_id, 확인 창 닫기와 함께 보내는 중으로 바꾸고 보내는 동안 다시 누름을 받지 않음
    - 시간 초과·끊김·5xx면 GET /jobs/by-request로 찾아 접수됐으면 그 실행 화면으로, 본체가 모르는 번호면 '본체가 받지 못했어요'
    - 옛 본체(번호 조회 없음)·조회 실패는 종전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
2026-10-19 fix(kiosk): 폰 연결 화면이 허브가 키를 보낸(consumed) 뒤에는 묻기·초 세기를 멈추고 '폰에 연결 정보를 보냈어요'를 남긴다 — 허브는 이제 받았음 알림 전까지 창을 열어 두므로 화면이 계속 묻다 창이 끝나면 '연결 시간이 지났어요. 새 코드를 받아 주세요'로 바뀌어 이미 연결된 폰을 다시 연결하라는 말이 되던 것(폰은 창이 열린 동안 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
2026-10-19 fix(app): ThinQ 직접 명령을 보내기 전에 '보내는 중'으로 두고 요청 번호(client_request_id)를 실어, 답을 잃으면 다시 보내지 않고 GET /jobs/by-request로 본체가 받은 실행을 찾는다 — 답을 기다리는 사이 실행 상태가 없어 정지·다른 실행 막기가 없었고, 답을 잃으면 '바뀌었는지 몰라요'만 말하고 자기 실행을 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
2026-10-19 fix(kiosk): 루틴 실행은 끝날 때까지 하는 중으로 보이고 지금 차례를 말하며 정지는 그 루틴만 멈추는 경로로 먼저 보낸다 — 구간 사이 기다림에 앞 구간 버튼을 '누르고 있어요'로 보였고, 다음 구간에 앞 구간의 누른 버튼·칸 수가 섞였으며, 실행 번호 조회가 잠깐 실패하면 /status의 구간 번호를 남의 실행으로 세다 '어떻게 됐는지 몰라요'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
    - GET /jobs의 routine_run_id·routine_segment·routine_segment_job_id·finished를 읽는다(옛 본체는 null — 종전 그대로)
    - '루틴 N번째 차례' 한 줄, 구간 사이는 '다음 차례를 기다리는 중'(정지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
2026-10-19 fix(rpi): /status가 루틴이 도는 동안 루틴 첫 번호·상태·구간 순번·구간 번호를 싣고 GET /jobs/{구간 번호}도 그 루틴의 첫 번호를 싣는다 — 쉬다가 2번째 이후 구간에서 루틴을 알아챈 클라이언트가 그 구간 번호만 알아 구간 하나가 끝나면 루틴이 이어 가는데도 '끝났어요'로 말하던 것(선택 필드 routine_run_id·routi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
2026-10-19 fix(kiosk): 본체에서 이어받은 실행이 루틴이면 루틴 첫 번호(routine_run_id)를 따라가 루틴 전체가 끝날 때까지 하는 중으로 보이고 정지는 그 루틴만 멈추는 경로로 보낸다 — 쉬다가 2번째 이후 구간에서 알아챈 키오스크가 그 구간 번호만 따라가 구간 하나가 끝나면 루틴이 이어 가는데도 결과 화면으로 갔던 것(/status의 routin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
2026-10-19 fix(app): 루틴의 2번째 이후 구간에서 실행을 알아채면 루틴 첫 번호(routine_run_id)로 갈아타 루틴이 다 끝날 때까지 하는 중으로 보이고 정지는 그 루틴만 멈춘다 — 답을 모르는 보냄을 /status로 찾거나 구간 번호를 따라가던 폰이 구간 하나의 끝을 '끝났어요'로 말하고 구간 사이 기다림(running=false)은 알아채지 못하던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
2026-10-19 fix(app): 정지·성공 뜻에 닿는 문구를 기준대로 고침 — '멈춰'라고 말하면 정지를 보내요(멈춘다고 단정하지 않음), 음성 버튼 읽는 이름은 듣기 끝내기/말하기 시작(듣기 끝내기를 '정지'로 부르지 않음), 기록 결과 꼬리표는 '켜진 걸 봤어요'처럼 본 것으로, 누가 시켰는지 표시는 '화면에서 직접 골랐어요'·'직접 고른 버튼', 같은 버튼이 한 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
2026-10-19 fix(kiosk): 정지·성공 의미에 닿는 문구 다듬기 — 안 닿은 정지·모름·비상 정지 풀기 문구를 사실 그대로
    - 정지 대기 띠: '작동 끝' → '기다림이 끝났어요'(조리 완료로 읽히지 않게), '멈추기 실패'·'누름 장치 문제' → '정지가 안 닿았어요'·'누름 장치에 문제가 있어요'
    - '…버튼이 눌렸는지 확인이 안 됐어요' → '…눌렸는지 몰라요'(뜻 그대로)
    - 다시 하기 경고: '같은 버튼을 또 누르게 돼요' → '같은 버튼이 한 번 더 눌려요'
    - 비상 정지 풀기 결과: 빨간 버튼과 화면 '풀기'를 구별하고 무엇이 걸렸는지 적음
    - 제안 도착 소리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
2026-10-19 fix(rpi): 서버가 화면에 보내는 문구 셋을 기준대로 고침 — 이어받은 범위 문장의 이름을 '방해 금지'로, 루틴 카드를 못 만든 까닭을 '방해 금지나 조용한 시간이라 지금은 묻지 않아요'로(어느 기능 때문인지 이름으로), 다음 실행 표시 '건너뜀'을 '건너뛰었어요'로(UX 문구 기준 4-2·3-6, 키 suggestion_pause·/dnd는 그대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
2026-10-19 fix(app): '잠시 쉬기'를 '방해 금지'로 이름을 바꾸고 범위 문장을 이름 곁에 늘 둠 — 설정 줄·시간 고르기 창·홈 배너가 '새 제안과 자동으로 하는 일을 잠시 쉬어요'(이어받은 옛 설정은 '새 제안만 쉬어요. 자동으로 하는 일은 그대로 해요')와 '직접 하기와 정지는 그대로예요'를 함께 말하고, 켜짐은 '방해 금지 켜짐'·'켜져 있어요', 끄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
2026-10-19 fix(app): 처음 연결·홈 문구를 기준대로 고침 — 첫 인사는 '반가워요. SimpleLay예요', 연결용이 아닌 QR은 그 사실과 다시 찍을 일을, '코드'는 '여섯 자리 숫자', 메뉴 순서는 '설정'을 누르고 '휴대폰 연결하기'를, 'QR 없이 주소와 숫자로 연결하기', 상태말은 '찾고 있어요'·'불러오고 있어요'·'남았어요', '멈췄어요'가 정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
2026-10-19 fix(kiosk): '잠시 쉬기' 문구를 '방해 금지'로 되돌리고 범위 문장을 늘 보이게, 설정 창에서는 빼고 조용한 시간만
    - 이름: 메뉴·창·위 줄 칩·화면 읽기·생활 습관 창을 '방해 금지'로(갤럭시 표기대로 띄어 씀). 끄는 단추는 '방해 금지 끄기'
    - 범위 문장(이름을 되돌린 조건): '새 제안과 자동으로 하는 일을 잠시 쉬어요. 직접 누르기와 정지는 그대로 돼요.'를 창과 메뉴 줄에 늘 둔다 — 메뉴 줄 아래 글은 이 줄만 말줄임 없이 다 보인다(KioskSheetRow.subMaxLines)
    - 이어받은 옛 범위(suggestions_only)는 '새 제안만 쉬어요. 자동으로 하는 일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
2026-10-19 fix(kiosk): 사용 방법 문구를 처음 쓰는 어르신 기준 여섯 장으로 — 처음 화면·누름 장치·LG 가전·멈추기·'몰라요'의 뜻·물어볼 곳
    - 한 장에 두세 문장, 버튼 이름은 화면에 적힌 그대로('메뉴'·'지금 하기'·'정지')
    - 누름 장치: '…만 묻지 않아요'가 거꾸로 읽혀 '자동으로 하라고 허락해 둔 일만 묻지 않고 해요'로
    - LG 가전: 늘 사람이 봐야 하는 것처럼 읽히지 않게 '바뀐 걸 보면 알려 드려요. 모르면 가전을 직접 봐 주세요'
    - 멈추기: 안 멈추면 가전 전원을 직접 끄라고 더함. 휴대폰 음성 정지는 실물 미확인이라 계속 넣지 않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
2026-10-19 fix(kiosk): 처음 화면·제안·휴대폰 연결·설정 문구를 할 일이 보이는 쉬운 말로
    - 결과 띠 '확인 필요' → '살펴볼 게 있어요'(결과인지 할 일인지 헷갈리던 말 — 기준 문서 안 '봐 주세요'는 바로 아래 문장과 겹치고 '봐 주세요' 되풀이 금지 시험에 걸려 바꿈)
    - 위 줄 문제 칩 '연결 확인 필요 N' → '연결 N곳을 봐 주세요'
    - 제안: '누르지 않으면 하지 않아요' → "'지금 하기'를 누르지 않으면 아무것도 안 해요", 가전을 못 찾으면 휴대폰 앱에서 보라고 덧붙임, 칩 '경로 모름' → '어떻게 할지 몰라요'
    - 준비 안 됨·못 바꿈: '아직 쓸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
2026-10-19 fix(app): 실행 상태·제안·루틴 문구를 기준대로 고침 — 상태말은 '하고 있어요'·'누르고 있어요'로, '확인이 필요해요'·'확인 필요'는 할 일 '봐 주세요'로(결과인지 할 일인지 헷갈리던 것, 기록 칩은 '봐 주세요 · 2번'), 끝난 화면 단추 '확인'은 하는 일대로 '닫기', '시도'는 '누르기', 빈 상태 화면은 무엇을 하면 채워지는지, 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
2026-10-19 fix(kiosk): 실행·결과·LG 가전·생활 습관 화면의 상태 문구를 해요체 동사로
    - 실행 중: '준비 중'·'…누르는 중'·'…연습 중' → '…하고 있어요', 띠 '실행 중' → '하고 있어요', '다음 차례를 기다리고 있어요', '눌렀어요, 확인하고 있어요'
    - 다시 누르기: '자리를 맞춰 다시 누르고 있어요'·'N번째 누르기'(번역투 '시도' 대신, 다시 누른다는 뜻은 숨기지 않음 — R1)
    - 타일 화면 읽기: '바꾸고 있어요'·'작동하고 있어요', 영어식 '작동 중 아님' → '지금 누르고 있지 않아요'(가전이 꺼졌다고 단정하지 않음)
    - 결과 순서 안내: 명사형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
2026-10-19 fix(app): 가전·설정·말로 하기 문구를 기준대로 고침 — '삭제'는 '지우기'와 지우면 무엇이 함께 지워지는지, '시도할게요'는 할 일 그대로, '외부 인식 서비스'는 '인터넷 사진 읽기 서비스', '선택'은 '안 해도 돼요', 버튼 '수정'·'제거'·'배치'는 '고치기'·'지우기'·'자리', 사진 인식 결과의 '은(는)'은 받침대로, '반영하기'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
2026-10-19 fix(rpi): 서버 안내 문구의 줄인 끝 '~됐어요'를 풀어 씀 — '접수되었어요'·'바뀌었어요'·'거절되었어요'·'인식되었어요'(UX 문구 기준 R12)
2026-10-19 fix(kiosk): 결과 띠·한 단어 결과 문구를 짧은 명사로 — '됐어요'는 '완료', '못 했어요'·'멈췄어요'·'몰라요'는 '실패'·'멈춤'·'확인 못 함', LG 가전 '다 됐어요'는 '끝남', '설정이 됐어요'는 '가전 설정을 마쳤어요'·'설정을 확인했어요'(증거 수준 그대로, UX 문구 기준 R12)
2026-10-19 fix(app): 기록 배지·연결 상태·한 단어 결과 문구를 짧은 명사로, 설명 문장은 풀어 쓴 해요체로 — '됐어요'는 '완료', '못 했어요'·'멈췄어요'·'몰라요'는 '실패'·'멈춤'·'확인 못 함', '연결됐어요'는 '연결됨', '다 됐어요'는 '끝남', '아직 준비가 안 됐어요'는 '아직 준비되지 않았어요', '아직 안 돼요'는 '아직 할 수 없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
2026-10-20 fix(kiosk): 문구 — 공기질 카드 머리말에서 '루틴' 빼기(루틴 카드에만 '루틴')
    실물 10/20: 공기질 제안(air_quality_power_on·air_quality_high, 사용자 루틴 아님) 카드 머리말이
    '루틴 공기가 나빠요'로 보였다. 시나리오 이름은 서버가 정한 이유 머리말이라 그대로('공기가 나빠요') 두고,
    '루틴'은 routine_id가 있는 카드의 '내 루틴' 줄에만 남긴다. 회귀 시험은 수정 전 실패 확인.
2026-10-20 fix(app): '지금 하기' 직후 '이 물음을 찾을 수 없어요'가 잠깐 보이지 않게
    실물 폰 10/20: 승인한 카드는 목록에서 바로 빠져, 상태 화면으로 넘어가는 사이(약 0.5초) 옛 화면이
    '찾을 수 없어요'를 그렸다. 이 화면이 방금 맡긴 카드 번호를 적어 두고, 그 카드면 빈 화면(제목만)을 그린다.
    다른 이유로 사라진 카드는 지금처럼 안내한다. 회귀 시험(전환 동안 매 프레임)은 수정 전 실패 확인. devlog 포함.
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2026-10-22 fix(motion): 개발자 좌표 탐색에서 부분 이동 후 원점 유지
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2026-10-23 fix(ui): 촬영 전 결과 안내와 기록 표시 정리
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2026-10-23 fix(kiosk): 처음 화면 '무엇을 할까요?'는 폰 홈과 같은 후보만 — 시각 예약·꺼짐·알림만 루틴 제외(실패널에서 저녁 예약 루틴이 나옴), 부제는 무엇을 하는지 한 줄
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2026-10-23 fix(app): 첫 사용 평가 반영 — 누름 장치가 끊기면 버튼판을 흐리게·이유를 화면에, 실행 확인 창도 미리 막고 이유, 오늘 사용 줄은 동작 이름, 다른 곳에서 시작한 실행에도 홈 정지 줄(POST /stop)
2026-10-23 fix(kiosk): '무엇을 할까요?'는 지금 쓸 수 있는 동작을 먼저, 없으면 실행하기를 막고 이유를 적는다
2026-10-23 fix(kiosk): 막힌 '무엇을 할까요?' 카드는 '지금은 쓸 수 없어요'만 짧게 — 이유는 위 안내 띠, 화면 읽기에는 이유까지(실패널에서 잘림)
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2026-10-24 fix(app): 2차 첫 사용 평가 반영 — 홈 대표 동작도 막히면 '지금은 쓸 수 없어요'·흐린 실행하기, 누름 장치가 끊기면 위치 대신 끊김을 말함, 사용 방법의 멈추는 방법이 화면 읽기에 빠지던 것
2026-10-24 fix(kiosk): 2차 첫 사용 평가 반영 — 막힌 대표 동작은 '해결 방법 보기', 손으로 누르기 화면의 버튼 그림은 실제 가전 위치 그림으로(화면 단추처럼 보이지 않게), 사용 방법에 기록·자동 실행 끄기는 휴대폰 앱 안내
2026-10-24 fix(rpi): Touch Bridge 어댑터를 HW 담당 최신 스케치와 줄 단위 대조 — 접수 전 누름 거절은 '안 눌림', 접수 뒤 오류·무응답·정지는 '눌렸는지 모름', 요청하지 않은 STOPPED는 motion_stopped(재시도 금지)
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2026-10-24 fix(app): 3차 첫 사용 평가 반영 — 실제 본체 모양(needs_setup + 끊김 이유)에서도 위치 대신 끊김, 저장한 동작 목록의 막힌 '지금 하기', 스위치 이름 통일(자동 실행 허용/루틴 켜기)·자동 루틴 설명, 사용 방법 따옴표(화면 읽기 덤프 누락)
2026-10-24 fix(kiosk): 버튼판 빈 칸의 '버튼 없음' 글자 제거(자리만 유지)
2026-10-24 fix(kiosk): 리뷰 수리 — 계속 조작 결과·조작판에서도 정지 대기 화면으로(결과는 종전 복귀 시간 뒤), 끊긴 채 답하면 처음 화면·두 번 기록 막기, 루틴 카드 문맥 정리, 해결 방법 보기는 막힌 가전, 확인 창도 현재 팔레트, 정지 단추 테두리 대비, 루틴 trigger 형식 방어
2026-10-24 fix(rpi): 건너뛴 뒤 다음 실행 요일 말 — 다음 달력 주만 '다음 주 X요일', 그 뒤는 날짜
2026-10-24 fix(kiosk): 막힌 대표 동작 카드는 제목 한 줄·'지금은 쓸 수 없어요' 두 줄까지(실패널에서 잘림)
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2026-10-24 fix(kiosk): 화면 전수 점검 반영 — 진행 중 색을 청록으로(연습은 폰과 같은 파랑), 주 단추 청록 통일, 비상 띠 닫기 대비, 고대비 가전 칸 글자, 큰 글씨 정지 단추·학습 창·준비 안 된 버튼판 잘림, 가전 칸 주황 테두리 제거; 제출 렌더 갱신
2026-10-24 fix(app): 4차 첫 사용 평가 반영 — 자동 실행 허용 중이면 편집 화면도 '묻지 않고 하기'로(모순 제거), 설정에 누름 장치 연결 상태, 홈에 정지 위치 안내 한 줄, 버튼판 설명, 기기 추가 '다음'이 막힌 이유
2026-10-24 fix(kiosk): 안내 띠가 있으면 막힌 대표 동작 카드에 '해결 방법 보기'를 겹쳐 두지 않음(카드를 누르면 같은 도움말)
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2026-10-24 fix(kiosk): 메뉴·설정·확인 창이 뜨면 아래 탭을 숨기고 가장자리 띠까지 어둡게(창 마지막 줄이 탭에 가려 잘림, 막이 안쪽만 덮음), 메뉴 단추는 햄버거, 탭 줄 바탕을 화면 바탕과 같게
2026-10-24 fix(kiosk): 창이 뜨면 화면 바탕도 막 색 — 맨 위 진행 막대 자리·캔버스 가장자리에 밝은 선이 남던 것
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2026-10-24 fix(rpi): Touch Bridge 어댑터 — 지난 정지 표시로 다음 실행을 거절하지 않음(정지·개발자 세션 종료 한 번 뒤 일반 실행이 늘 막히던 것, 모의 보드 시험에서 발견), 표시는 실행 시작의 reset_stop이 지움
2026-10-24 fix(kiosk): 연습 결과를 사람이 닫으면 같은 실행의 연습 대기 화면을 다시 띄우지 않음(실제 실행의 대기는 그대로) — 모의 보드 시험에서 '연습이 끝났어요' 뒤 대기 화면이 다시 뜸
2026-10-24 fix(kiosk): 닫은 연습 대기가 다른 가전 실행(공기청정기 켜기) 뒤 다시 뜨던 것 — 대기는 그 가전의 실행으로 구분, 서버 '지금' 날씨가 없으면 가장 가까운 예보를 '시각 예보'로 보여 날씨 줄이 사라지지 않게
2026-10-24 fix(rpi4): 모의 보드일 때 정지 대기의 가전 확인은 모의 가전 — 연습 대기가 실물처럼 30분 남아 키오스크를 다시 켤 때마다 떴다
2026-10-24 fix(kiosk): 승인 '지금 하기'가 웹에서 본체에 닿지 않고 회색 화면 — 요청 번호의 1<<32가 웹에서 0, 카드를 내린 한 프레임에도 무너지지 않게
2026-10-24 fix(kiosk): 직접 눌러 본 점검 10건 — 버튼판 맨 아랫줄이 탭에 가림, 빈 '내 루틴', 계속 조작은 쓰던 버튼판으로, 준비 안 된 버튼판 흐리게, 루틴 실행 버튼 수, 내가 누른 실행 확인은 '확인'·쉬운 말, 기록에 연습·결과 함께·누른 버튼 이름, 사용 방법을 탭에 맞게, 창이 뜨면 뒤 화면을 화면 읽기에서 가림·닫기 이름, 전기 플러그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
2026-10-24 fix(kiosk): 연습 대기는 연습 결과 화면·조작판을 덮지 않음 — '연습을 마쳤어요' 뒤 '연습이 끝났어요 · 취소 위에서 기다리는 중'이 또 뜨던 것(실제 대기·사람 확인 대기는 그대로)
2026-10-24 fix(rpi): 승인·루틴 실행 진행의 전체 단계 수를 실제 누름 수로(명령 1개에 버튼 2개면 2), 여러 명령이면 완료 수를 이어서
2026-10-24 fix(kiosk): 2차 점검 — 큰 글씨 저장된 동작이 탭 아래로 밀림, 가전·자동 실행·기록 탭에도 메뉴, 큰 글씨 메뉴 마지막 줄 잘림, 건너뛴 뒤 다음 시각, 내가 시작한 확인 카드에도 버튼판 그림
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2026-10-25 fix(kiosk): 같은 가전으로 돌아가는 결과 화면 단추를 '확인'·'홈 화면' 둘로(사용자 결정 — 세 단추가 어수선, 가전 바꾸기는 아래 가전 탭)
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2026-10-25 fix(rpi): 키오스크 소리는 본체가 보드 스피커로 직접 — POST /tts/play(알림음·말을 한 줄로 차례대로), 보드 소리 서버 소켓을 컨테이너에 넘기고 이미지에 paplay
    키오스크 앱은 격리 사용자로 돌아 보드 재생 도구를 못 써 음성·알림음을 받아 와도 소리가 나지 않았다.
2026-10-25 fix(kiosk): 음성·알림음은 본체에 틀어 달라고(POST /tts/play), '시간 더 주기'는 5분까지만(다 차면 단추 숨김 — 막 누르면 3,000초를 넘었다)
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2026-10-25 fix(rpi): 음성 안내는 받자마자 만들기 시작(딩동 뒤 3초 기다림 없앰), 만든 음성은 보드에 남겨 재시작 뒤에도 바로
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2026-10-25 fix(rpi): 키오스크에 보이는 서버 문장 다듬기 — '그래서 하지 않았어요' 덧붙임 빼기, '멈추기'→'정지', '다음 할 일을 멈췄어요'→'다음 단계는 시작하지 않았어요', '전기 플러그'→'콘센트'(RPi4에서 오는 문장·재시작 잠금 판별 문장은 그대로)
2026-10-25 fix(kiosk): 어색한 문장 약 70곳 다듬기 — 가전을 사람처럼 부르던 말('켜 달라고 했어요'→'켜기 명령을 보냈어요'), '됐는지'→'바뀌었는지·결과를', '답'→'응답', '쉬어요'→'띄우지 않아요', 띠는 명사('주의'·'대기 끝남'), 확인 못 한 결과는 '확인했어요'라고 하지 않음(시험)
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2026-10-25 fix(kiosk): 실패널 점검 수리 — 날씨 창 '받은 예보' 시각을 한국 시각으로(UTC 그대로 '오전 2시'), 꺼진 설정 스위치를 또렷하게, 제안 질문 '즉석밥 데우기를 지금 할까요?'(쉼표 빼기), 꺼진 공기청정기는 '지금 잘 때 운전' 대신 '운전 모드', 버튼판 '실제 ○○ 버튼과 같은 배치예요', 도움말 '누름 장치가 버튼을 눌러요'·'화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
2026-10-25 fix(kiosk): '가전' 탭 화면에서 '뒤로' 빼기 — 탭 화면이라 아래 탭으로 오간다(사용자 10/25)
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2026-10-25 fix(kiosk): 보드 빌드 환경 Flutter에 없는 activeThumbColor 대신 thumbColor — 10/25 낮 키오스크 빌드 두 번이 조용히 실패해 패널에 옛 판이 남아 있었다; 얇은 연결 알림에 맞춰 골든 7장 갱신
2026-10-25 fix(rpi): 기상특보 구역 표가 .gitignore(data/)에 걸려 커밋·배포되지 않았다 — rpi/services/weather/warn_zones.json으로 옮김(보드에서 특보가 늘 비어 있었다)
2026-10-25 fix(kiosk): 실패널 점검 — 자리 비움 화면은 까만 화면 대신 짙은 회색에 시계·날짜(사용자 10/26), 가장자리까지 같은 색; 돌아왔을 때 인사는 작게 날짜·메뉴 사이로; 휴대폰 연결 화면 할 일 글이 오른쪽 끝에서 잘리던 것
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2026-10-25 fix(kiosk): 자리 비움 화면 동안 뒤 처음 화면을 그리지 않는다(Offstage) — 덮기만 하면 가장자리에 밝은 선이 비쳤다
2026-10-25 fix(kiosk): 자리 비움 시계 화면 글자의 노란 밑줄 — 화면 틀 밖으로 옮기며 기본 글자 모양이 빠졌다, Material로 감쌈
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2026-10-25 fix(kiosk): 쉬는 시계 화면의 '사람이 보이면 다시 켜져요' 안내 글 빼기 — 실제 제품 시계처럼(사용자 10/26)
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2026-10-25 fix(app): 말로 하기 화면 다듬기 — 아래 탭 누르면 이동(홈 포함), 생각하는 동안 가운데 한 상태만, 확인 단추 '아니요|네' 나란히, 홈에서 열면 가전을 정하지 않고 '무엇을 할까요?'(정해진 가전 없이 보내고 못 알아들으면 모든 가전에서 고른 뒤 확인)
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2026-10-26 fix(habit): 평일 습관은 평일 루틴으로 맡기고, 주말을 지나 본 뒤에만 평일·주말로 가른다
    맡긴 루틴이 늘 매일로 저장돼 평일 습관이 주말에도 돌던 문제를 고친다. 첫날~마지막 날 사이에
    다른 종류의 날을 건너뛴 적이 있어야 평일·주말로 보고, 키오스크 단추·확인 칸도 같은 말을 쓴다.
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2026-10-26 fix(kiosk): 폰에서 말한 내용 확인 카드가 떠 있는 동안 아래 메뉴바를 숨긴다
    카드를 둔 채 다른 탭으로 넘어가지 않게 하고, 답하거나 폰에서 정하면 다시 보인다.
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2026-10-26 fix(deploy): RPi5 재부팅 뒤 인터넷 — 백엔드 DNS를 본체 resolved로, Wi-Fi 기본 경로 감시 컨테이너
    connman이 도커 가상 연결에 기본 경로를 넣어 Wi-Fi 길을 가리고, resolv.conf가 비어 LG 서버를 못 찾던 문제.
    다른 경로는 지우지 않고 wlan0 기본 경로만 앞세운다(한꺼번에 지우면 Wi-Fi가 끊김).
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2026-10-26 feat(dev): 개발자 도구 기록에 보낸 명령·보드 응답, 범위 밖 거절은 바로 쉬운 말로, 원점 바로 아래 목표는 0으로
    보드가 ERROR_LIMIT로 거절한 이동이 앱에서 타임아웃처럼 보이던 것을 고친다. -0.1~0mm 목표는 0으로 보낸다.
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2026-10-26 fix(readiness): 인터넷 확인이 IPv6 주소를 먼저 받으면 ValueError로 '안 됨'이 되던 것을 고치고 핫스팟 지연에 맞춰 1.5초로
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2026-10-26 fix(voice): 본체 음성 인식 서버를 컨테이너 안에서 돌리고 녹음·인식만 호스트에서, 녹음은 SIGINT로 멈춰 wav 머리를 지킨다
    본체에 python이 없고, nsenter -p로 띄운 parecord를 끊으면 nsenter만 죽어 파일이 비었다(보드 확인).
    무음 3초 → no_speech로 거름(지어내기 없음).
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2026-10-28 fix(ui): 본체 연결 안내와 음성 입력 표시 개선
2026-10-28 fix(motion): 단독 누름과 좌표 기준·통신 진단 개선
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2026-10-31 fix(kit): 물리 비상 버튼 안내 줄 빼기 — 버튼을 달지 않으므로 준비 상태와 세트 찾기에 보이지 않게
    정지는 화면·앱의 정지를 쓴다. 실행기의 버튼 처리 코드와 시험은 그대로 둔다.
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2026-11-02 fix(ct): 전력으로 본 사용은 시간과 가동 시간만 직접 사용으로 알림 — 불필요한 설명 문구 제거
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2026-11-02 fix(rpi): 개발자 모드에서도 내장 가전을 숨기고 온습도 센서 미연결이 다른 API를 막지 않게
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2026-11-03 fix(kiosk): 제안 카드 신호 칩이 잘리지 않게 왼쪽 칸에 두고 '시간 더 주기'를 정확히 1분으로
    화면을 만질 때 남은 시간을 처음 길이로 되돌린 값에 1분이 더해져 늘 100초가 되던 것을 고치고,
    1분이 넘는 남은 시간은 분·초로 표시한다.
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2026-11-03 fix(presentation): 외부 평가 반영 — 본 발표 8분 30초, 확인 범위 장, 단정 문장 축소
    실제 사례 두 장을 합치고 기술 상세(구성도·CT 측정)는 부록으로 옮긴다.
    '어디까지 확인했나' 장에 기록 기간·기기 수·응답 수·CT 4/4·누름 개선 중을 적는다.
2026-11-03 fix(rpi): 꺼진 공기청정기에는 가열 종료 뒤 바람 세기 대신 켜기를 묻는다
    꺼진 공기청정기에 풍량 변경을 보내면 클라우드가 거절한다. 이미 읽어 둔 전원 상태가 꺼짐이면
    '켤까요?' 카드를 띄우고, 자동 실행 규칙은 보내지 않고 이유를 남긴다. 상태를 모르면 종전과 같다.
2026-11-03 fix(kiosk): 시나리오 제안 카드의 경고·이유 줄이 잘리지 않게 배치
    시나리오 이름을 상단 띠로 올리고 이유 줄의 중복 단서를 빼며, 넘치는 칸만 스크롤하고 아래를 흐리게 한다.
2026-11-03 fix(presentation): 2차 평가 반영 — 확인 범위 정확히, 비교 문장 좁힘, 예상 질문 부록
    습관 카드 대본은 실제 캡처가 있을 때만 날짜를 말하고, 전자레인지 4회는 사람이 시작한 가열의 끝 판정임을 먼저 밝힌다.
    무대와 대본 장 목록이 어긋나면 발표자 창에 경고를 띄운다.
2026-11-03 fix(presentation): 3차 평가 반영 — 누름 확인 범위 통일, 10월 28일 기록 중심, 안 되면 대사
    누름 장치는 위치 이동까지, 전자레인지는 사람이 시작한 가열 네 번의 끝 판정까지로 모든 장을 맞춘다.
    시연 장마다 실패 때 할 말을 발표자 창에 따로 보이고 예상 질문을 15개로 늘린다.
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2026-11-03 fix(rpi): 실행기가 모의 모션이면 누름 장치를 연결됨 대신 연습 모드로 표시
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2026-11-03 fix(kiosk): 시간 더 주기를 누르는 동안 카운트다운이 지나도 누르기 전 남은 시간에 1분을 더한다
2026-11-03 fix(rpi): 돌아왔을 때 제안 문구와 이름 수정
2026-11-03 fix(rpi): 루틴·제안 안내 문구 수정
2026-11-03 fix(kiosk): 결과·제안 화면 문구 수정
2026-11-03 fix(kiosk): 처음 화면 경고 띠·다음 루틴·공기질 문구 수정
2026-11-03 fix(kiosk): LG 가전 결과 화면 문구 수정
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2026-11-03 fix(app): 승인·결과·설정 화면 문구 수정
2026-11-03 fix(app): 블루투스 연결 안내 문구 수정
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2026-11-03 fix(app): 제안·본체 화면 문구 수정
2026-11-03 fix(kiosk): 제안 질문을 되묻는 말로 수정
2026-11-03 fix(rpi): 보드 누름 명령 답 기다리는 시간 늘리기
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2026-11-04 fix(rpi): 불을 끈 직후 어두워 사람을 놓쳐도 수면 모드 제안
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2026-11-05 fix(rpi4): 확인 주행 시작 때 지난 정지 표시를 실제 모션 어댑터까지 지운다
2026-11-05 fix(rpi4): 정지 버튼 위 대기 중 개발자 정지가 가전 정지 누름을 끊지 않게
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
