Seongwonp/Simplelay/(notices)

Notices in the files:
docs/음성-의도-해석-조사-2026-10-19.md:
- **데이터셋:** 3i4K는 한국어 짧은 발화 약 6.1만 개를 7개 의도 유형(명령·질문 등)으로 나눈 것으로(CC BY-SA 4.0), 가전 동작 분류가 아니라 문장 유형 분류다([TFDS kor_3i4k](https://www.tensorflow.org/datasets/community_catalog/huggingface/kor_3i4k?hl=tr)).
